andrewpaterson/658-Computer/Pictures/HCP65 Tester.jpg

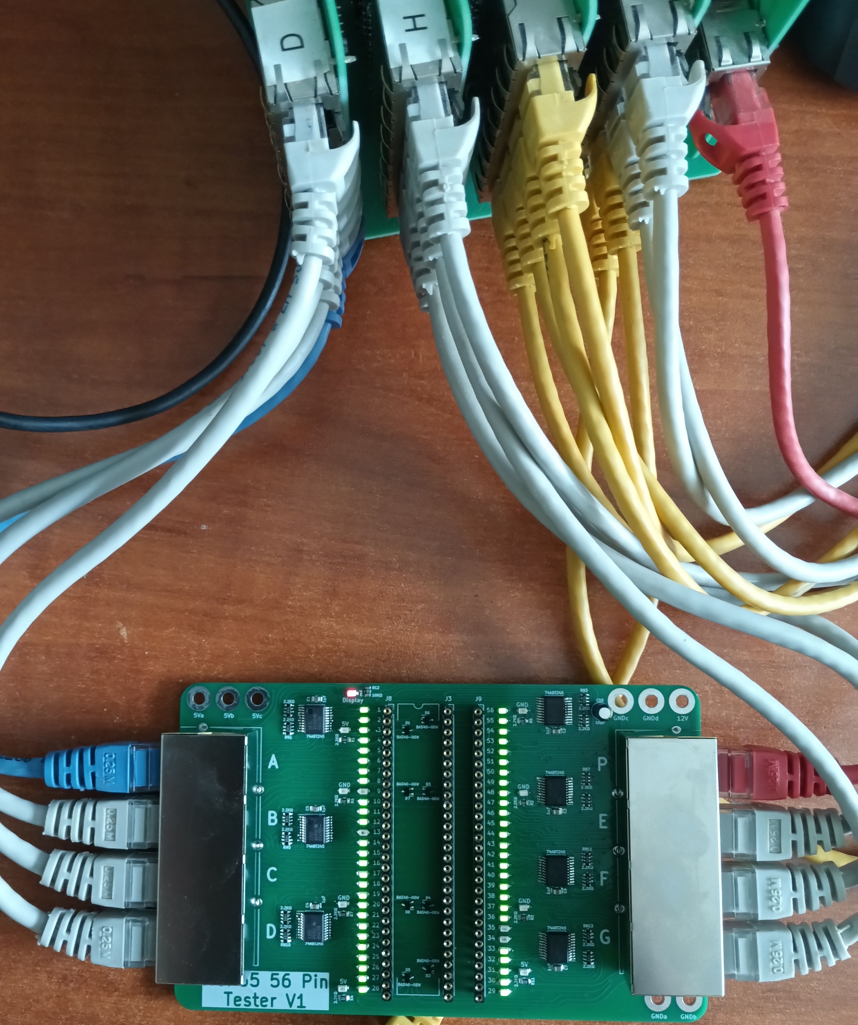
Pictures/HCP65 Tester.jpg
