andrewpaterson/658-Computer/Pictures/Debug Display/Instruction Debug.png

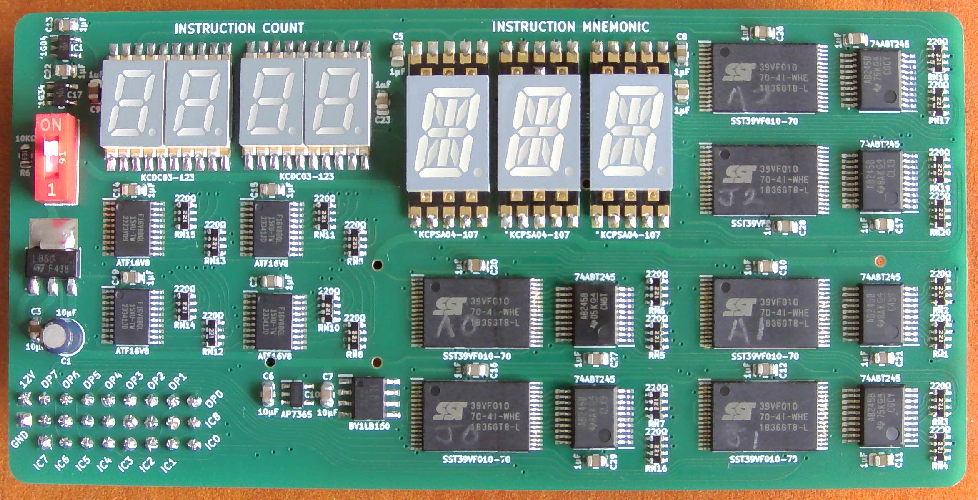
Pictures/Debug Display/Instruction Debug.png
