andrewpaterson/658-Computer/Kicad/Keypad/Keypad Din Pins.txt

brown  - GND
yellow - PL
red    - D0
blue   - CK
white  - VDD

   5V * 3     1 * PL
    white      yellow
     Q * 5 2 4 * CP
      red  *  blue
         GND
         brown
