andrewpaterson/658-Computer/Documents/HCP65/Mainboard Small.png

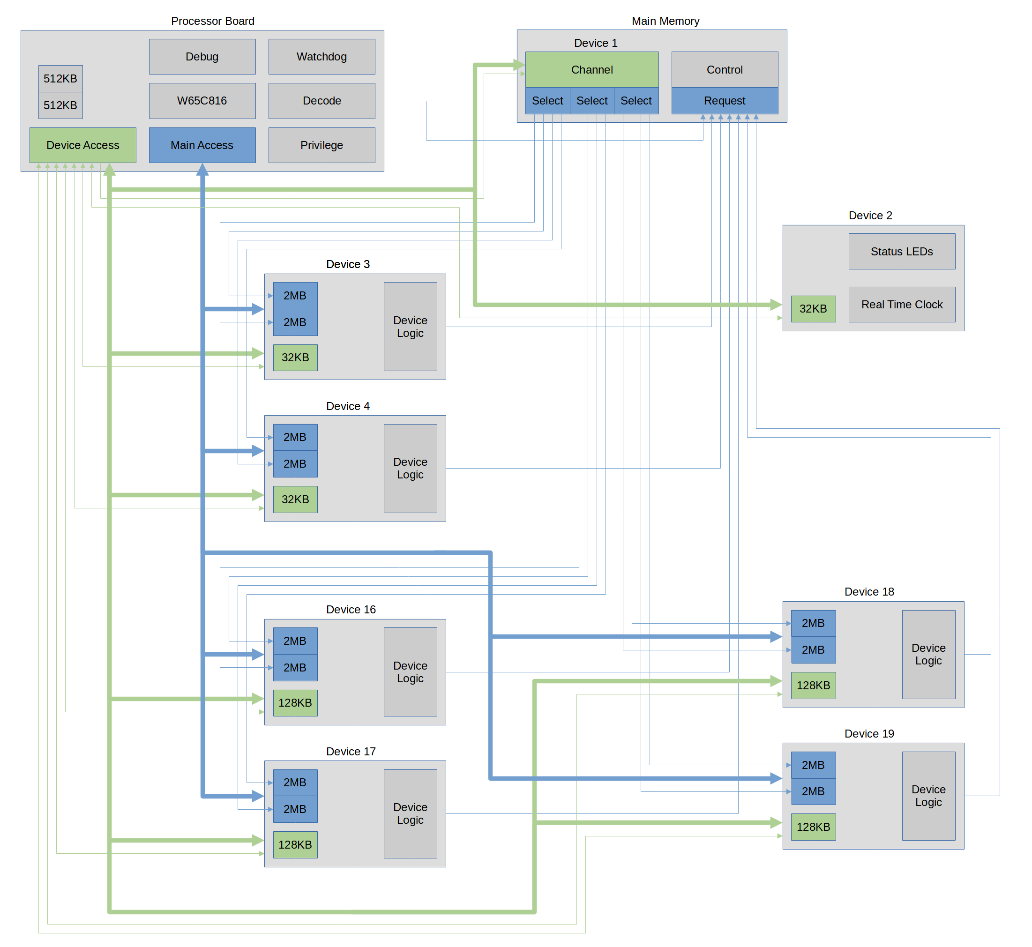
Documents/HCP65/Mainboard Small.png
