andrewpaterson/658-Computer/Documents/NAND ABT.png

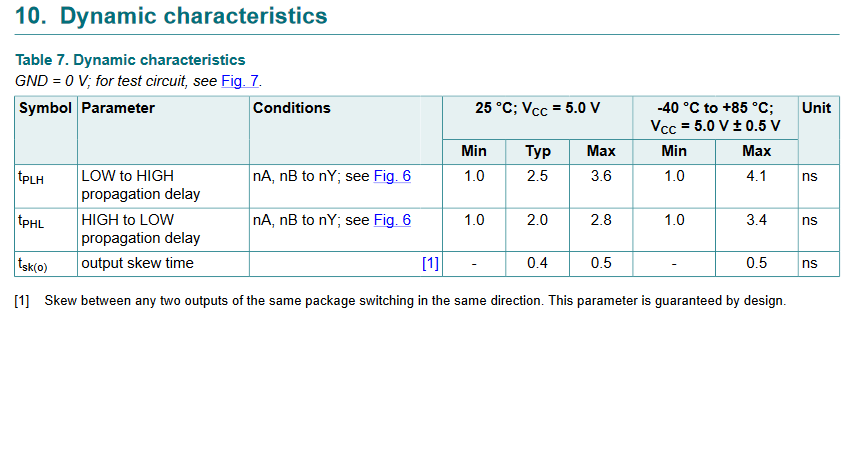
Documents/NAND ABT.png
