andrewpaterson/658-Computer/Documents/NAND AC.png

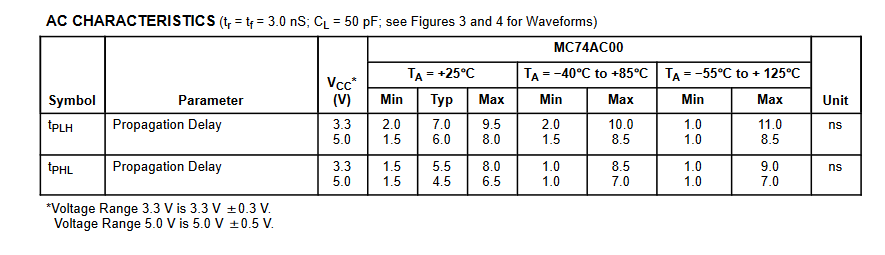
Documents/NAND AC.png
