andrewpaterson/658-Computer/Documents/NAND ACT.png

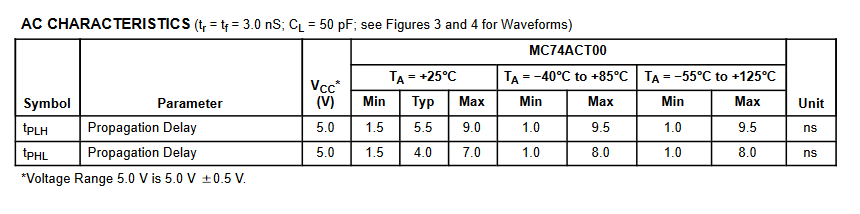
Documents/NAND ACT.png
