andrewpaterson/658-Computer/Documents/NAND AHC and AHCT.png

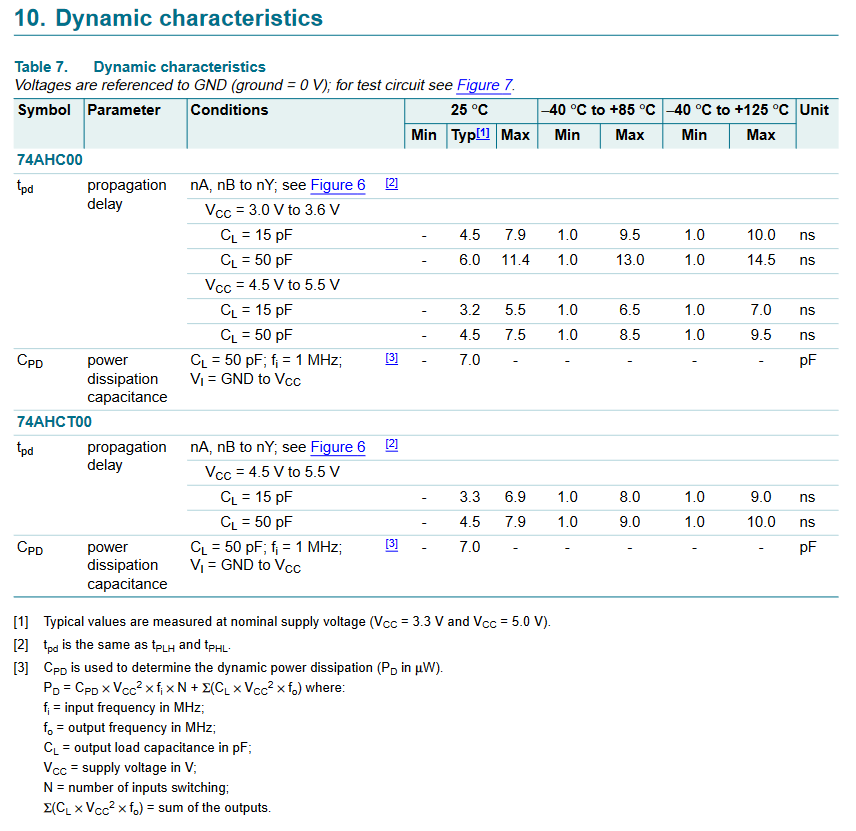
Documents/NAND AHC and AHCT.png
