andrewpaterson/658-Computer/Documents/NAND ALVC.png

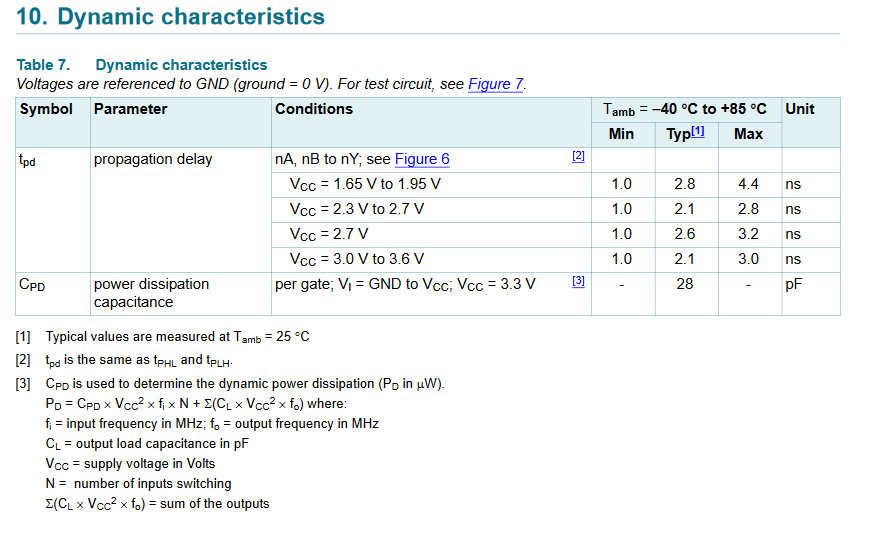
Documents/NAND ALVC.png
