andrewpaterson/658-Computer/Documents/NAND F.png

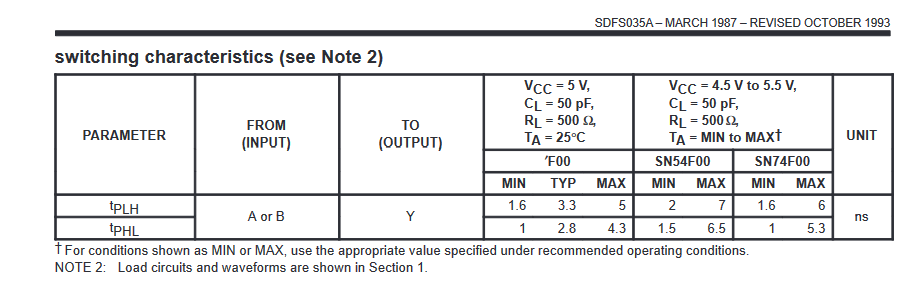
Documents/NAND F.png
