andrewpaterson/658-Computer/Documents/NAND HC and HCT.png

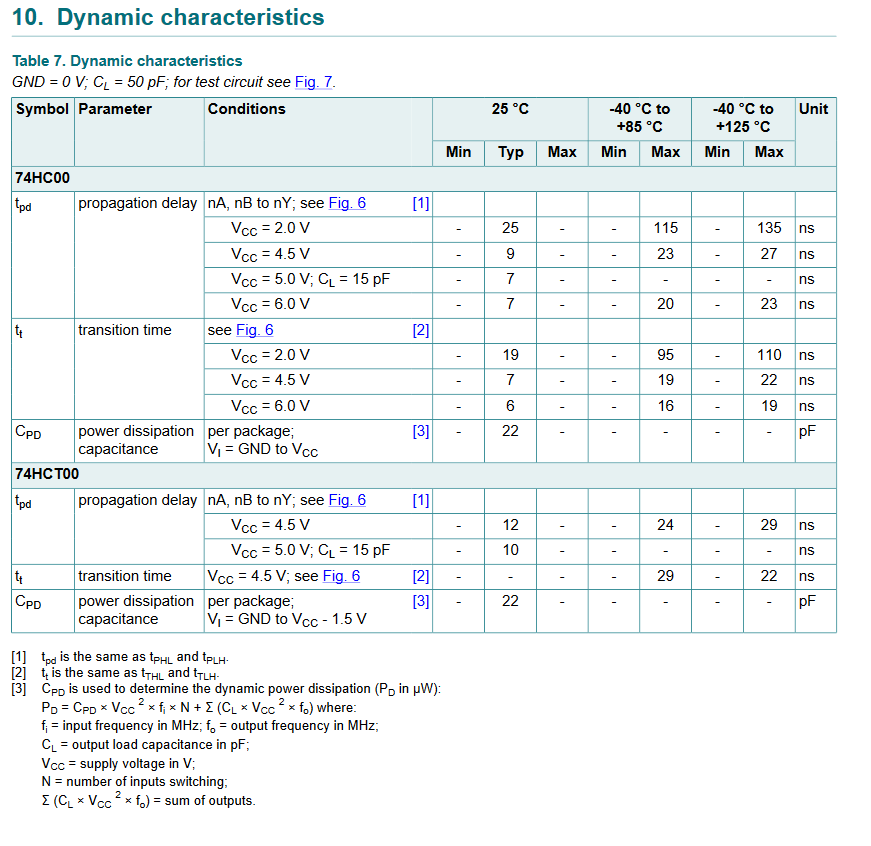
Documents/NAND HC and HCT.png
