andrewpaterson/658-Computer/Documents/NAND LCX.png

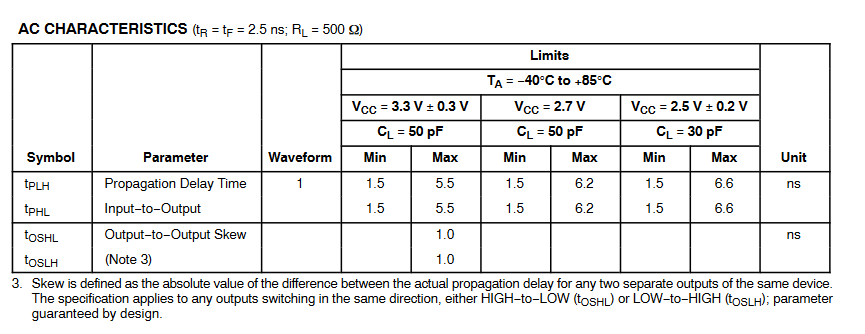
Documents/NAND LCX.png
