andrewpaterson/658-Computer/Documents/NAND LV.png

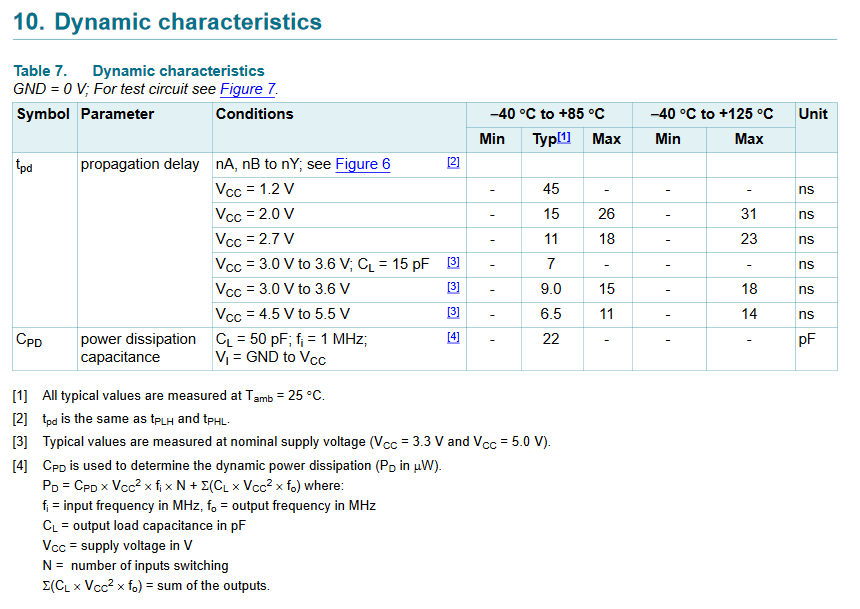
Documents/NAND LV.png
