andrewpaterson/658-Computer/Documents/NAND LVC.png

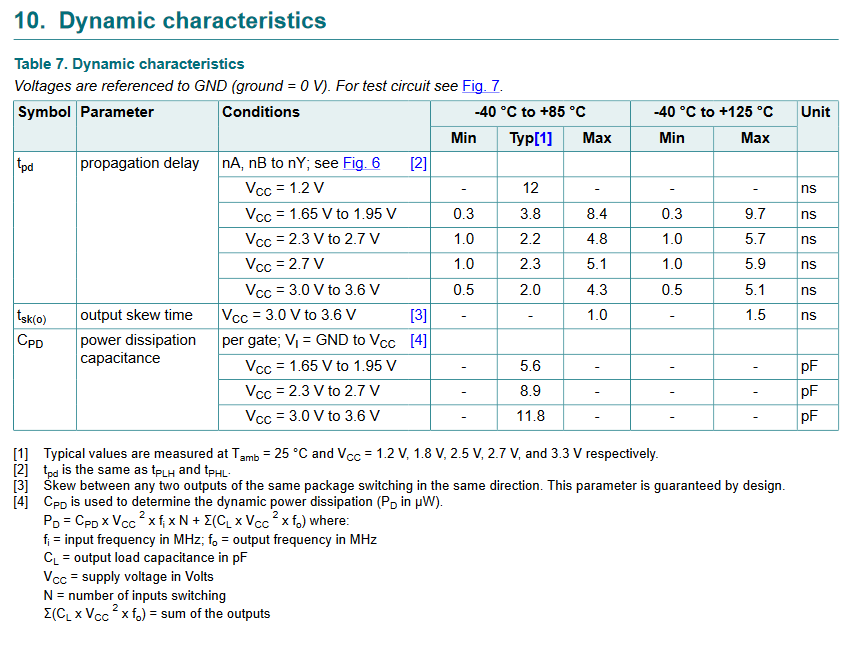
Documents/NAND LVC.png
