andrewpaterson/658-Computer/Documents/NAND VHC.png

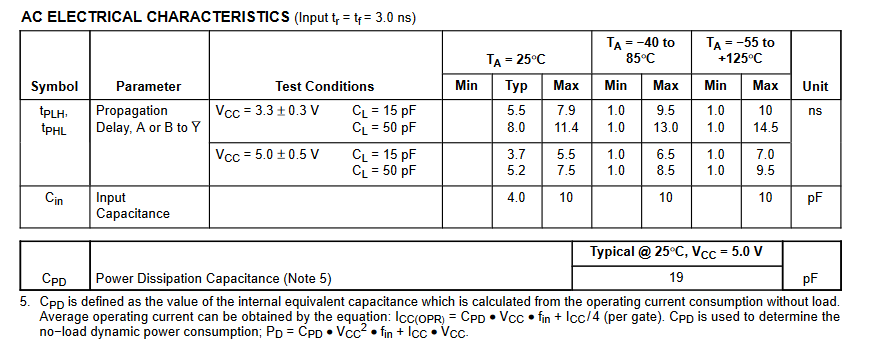
Documents/NAND VHC.png
