andrewpaterson/658-Computer/Documents/NAND VHCT.png

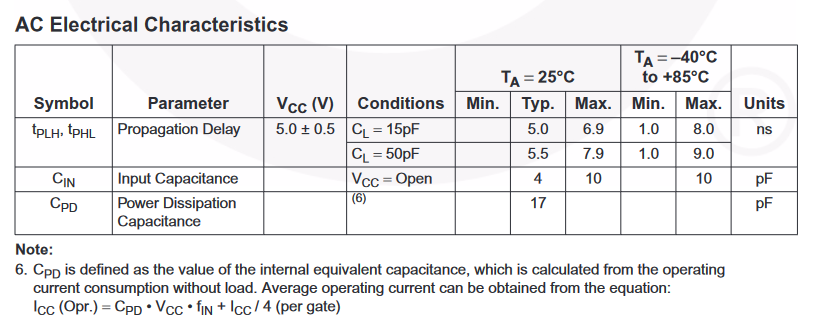
Documents/NAND VHCT.png
