andrewpaterson/658-Computer/Kicad/Computer/Main/Mainboard Small/Mainboard Small - Populated.png

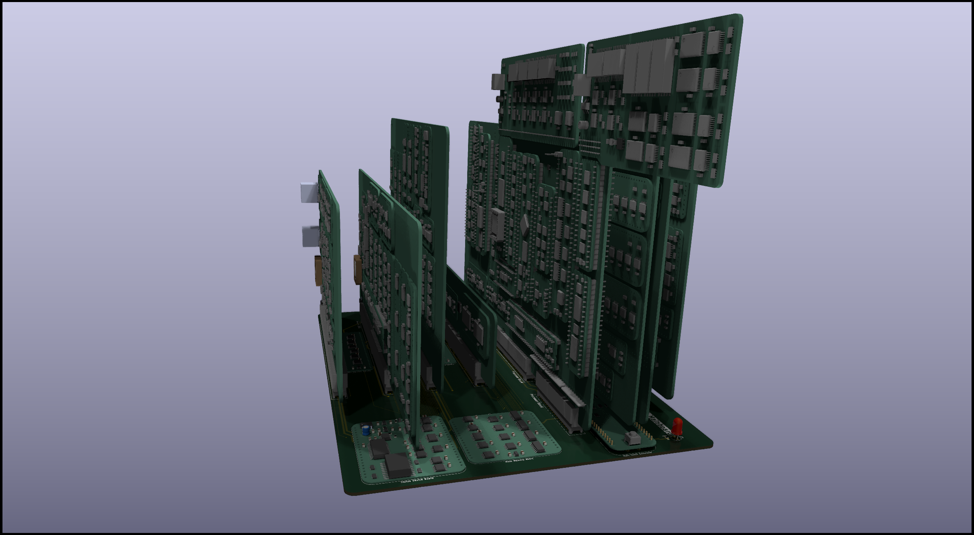
Kicad/Computer/Main/Mainboard Small/Mainboard Small - Populated.png
