andrewpaterson/658-Computer/Pictures/3 Input Or Gare - Source 3V.png

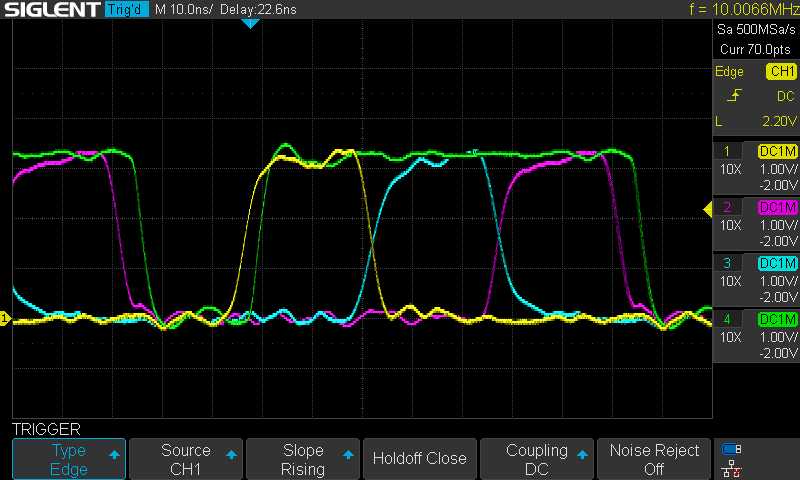
Pictures/3 Input Or Gare - Source 3V.png
