andrewpaterson/658-Computer/Pictures/3 Input Or Gare - Source 5V.png

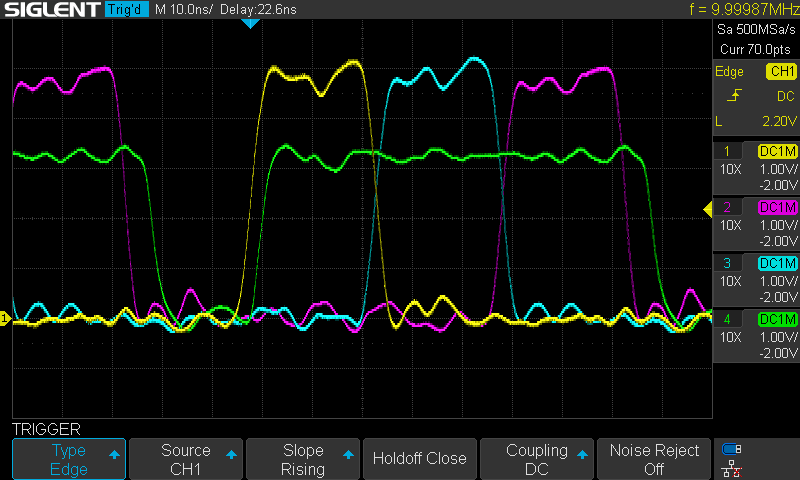
Pictures/3 Input Or Gare - Source 5V.png
