andrewpaterson/658-Computer/Pictures/7 Segment Reader.png

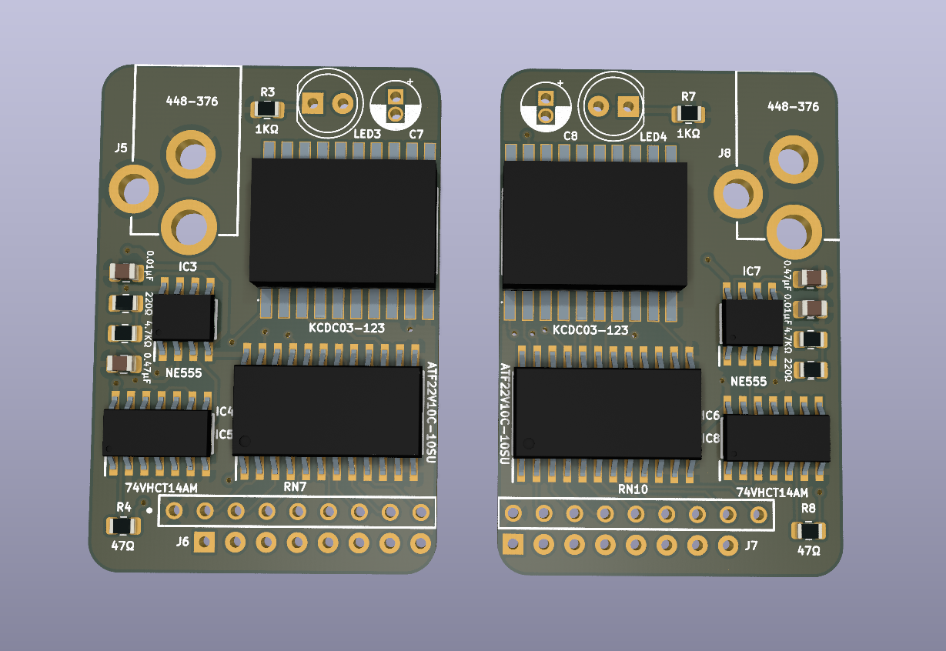
Pictures/7 Segment Reader.png
