andrewpaterson/658-Computer/Pictures/300Hz No Schmitt.png

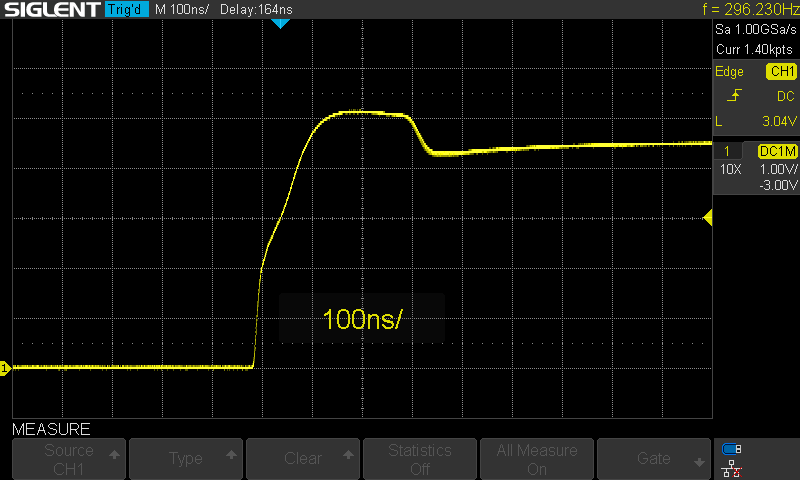
Pictures/300Hz No Schmitt.png
