andrewpaterson/658-Computer/Pictures/300Hz with Schmitt.png

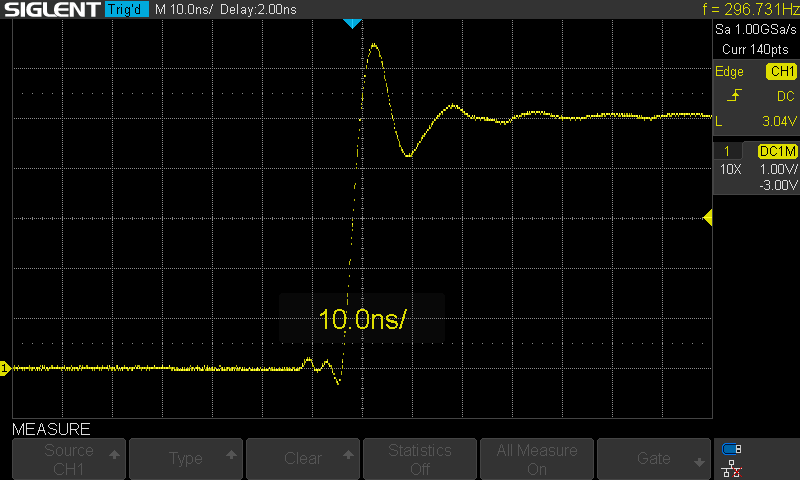
Pictures/300Hz with Schmitt.png
