andrewpaterson/658-Computer/Pictures/300Hz.png

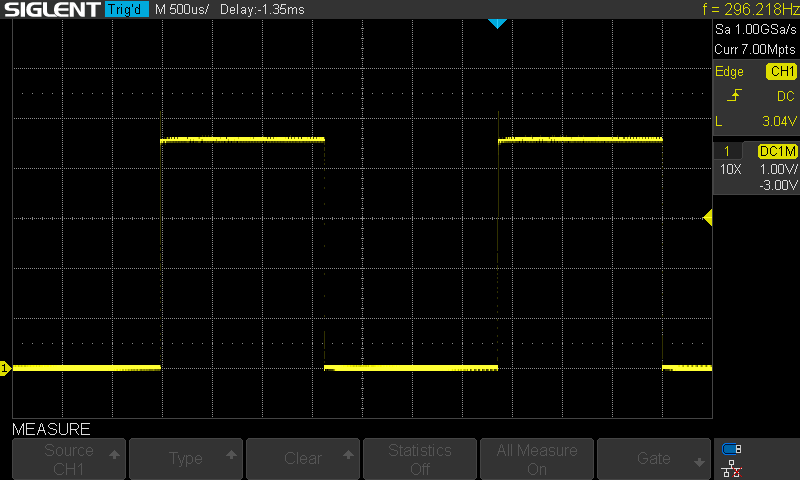
Pictures/300Hz.png
