andrewpaterson/658-Computer/Pictures/400x300 Ref2.png

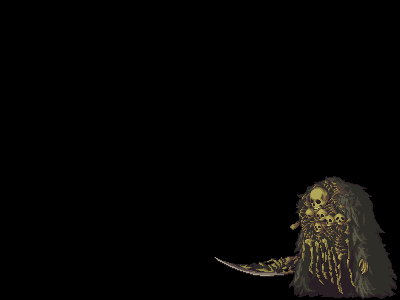
Pictures/400x300 Ref2.png
