andrewpaterson/658-Computer/Pictures/400x300 Ref3.png

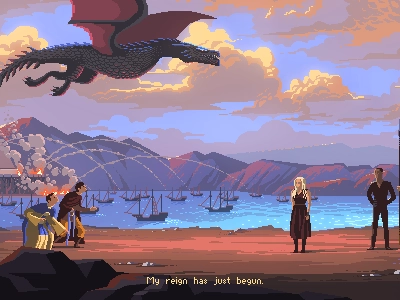
Pictures/400x300 Ref3.png
