andrewpaterson/658-Computer/Pictures/400x300 Ref4.png

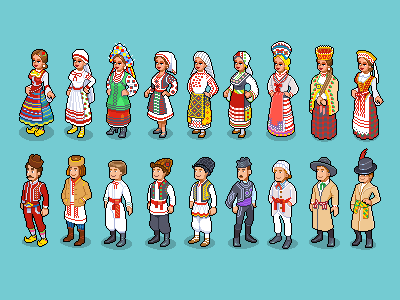
Pictures/400x300 Ref4.png
