andrewpaterson/658-Computer/Pictures/816 Bodge Board V1 - important stuff.png

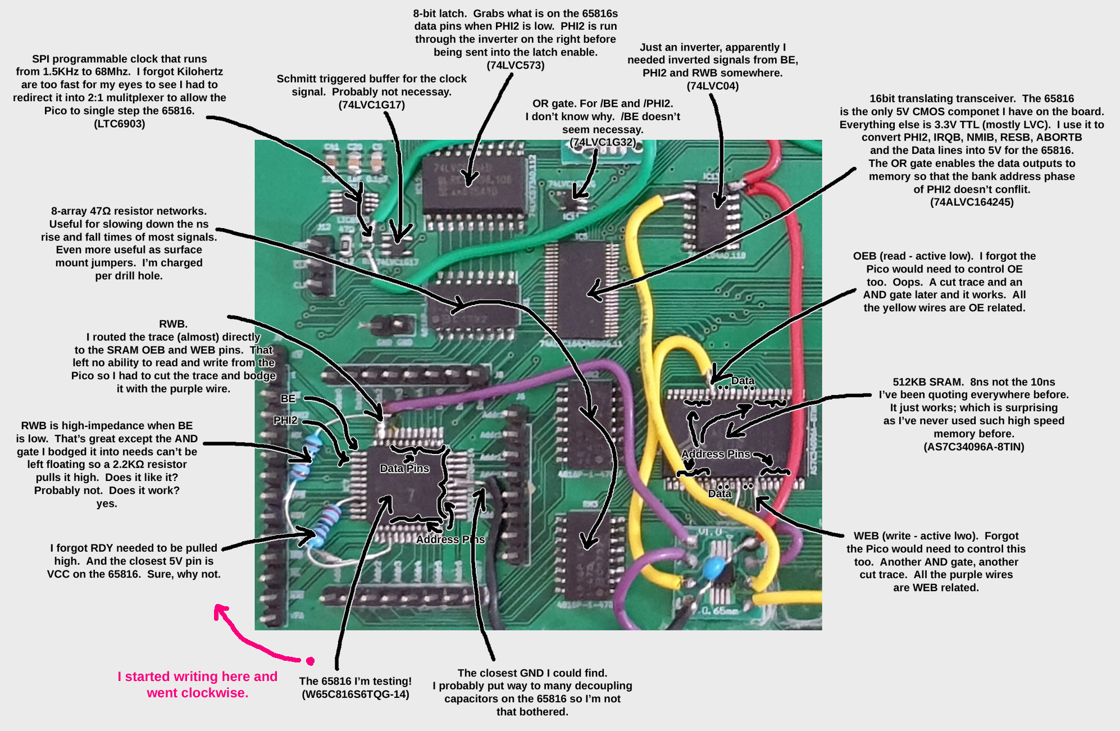
Pictures/816 Bodge Board V1 - important stuff.png
