andrewpaterson/658-Computer/Pictures/816 bodge board V1 running.jpg

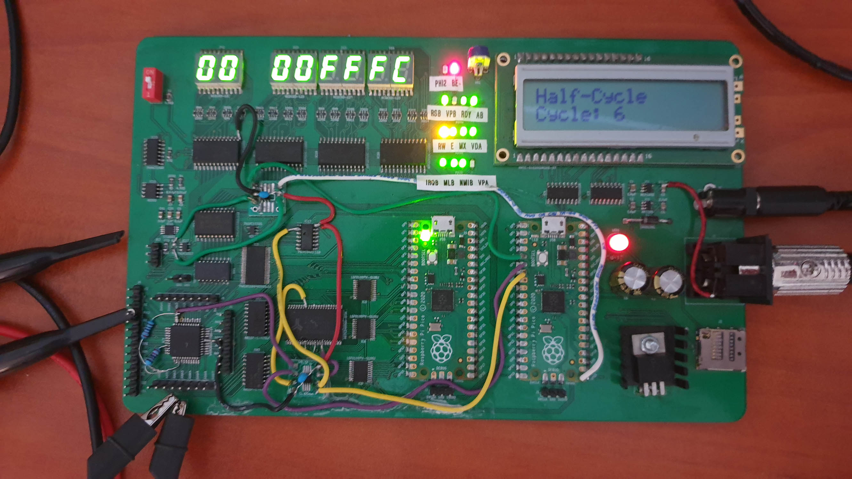
Pictures/816 bodge board V1 running.jpg
