andrewpaterson/658-Computer/Pictures/816 bodge board V1 unpopulated.jpg

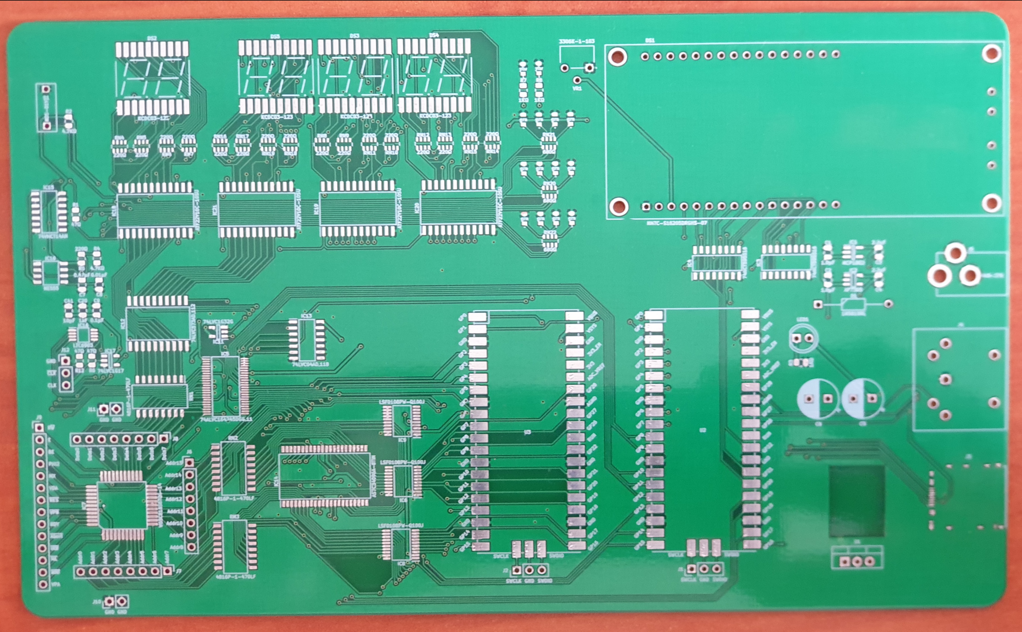
Pictures/816 bodge board V1 unpopulated.jpg
