andrewpaterson/658-Computer/Pictures/20220211_165340.jpg

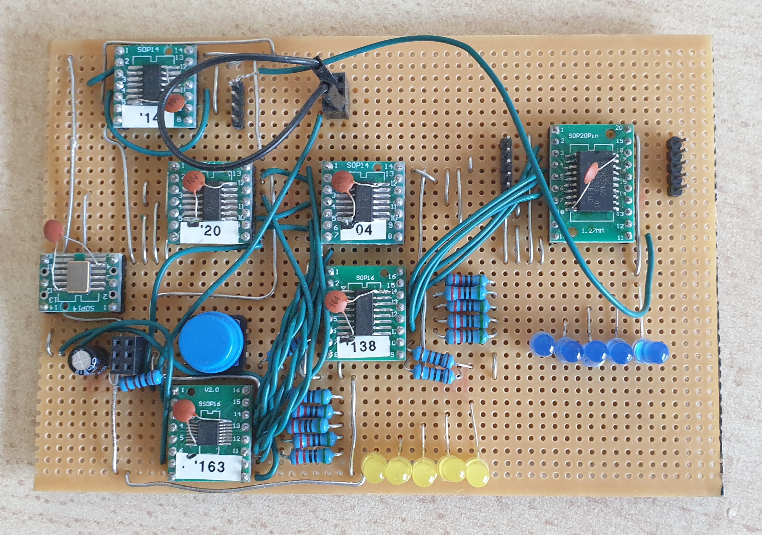
Pictures/20220211_165340.jpg
