andrewpaterson/658-Computer/Pictures/20220607_114405.jpg

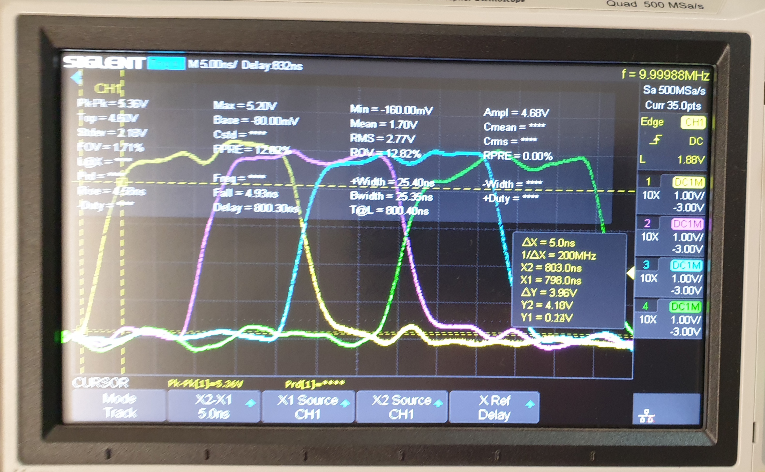
Pictures/20220607_114405.jpg
