andrewpaterson/658-Computer/Pictures/Address Decode.png

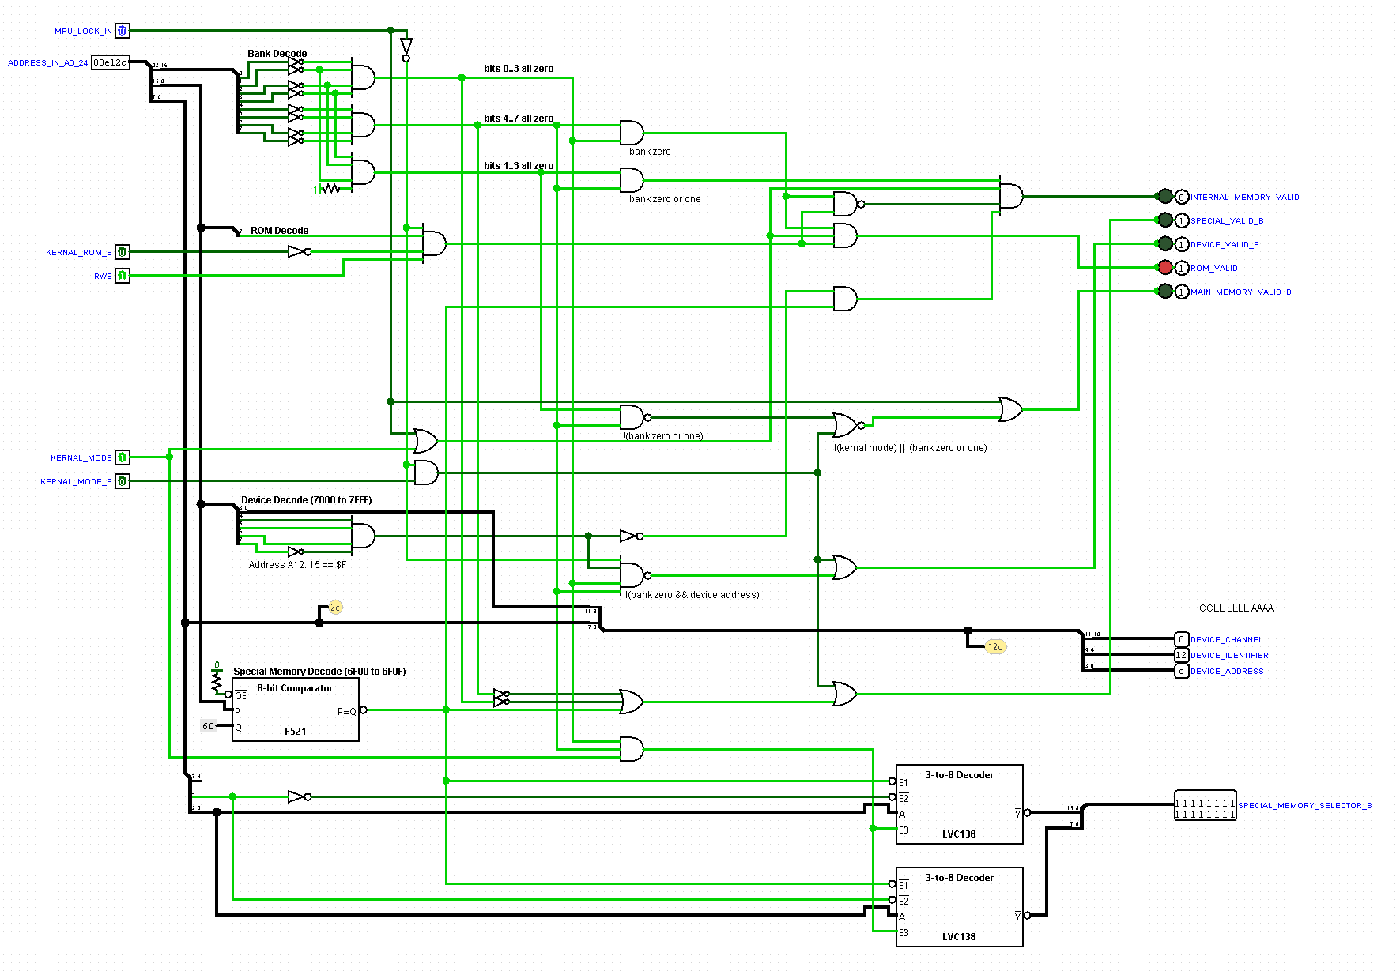
Pictures/Address Decode.png
