andrewpaterson/658-Computer/Pictures/Address Predecode.png

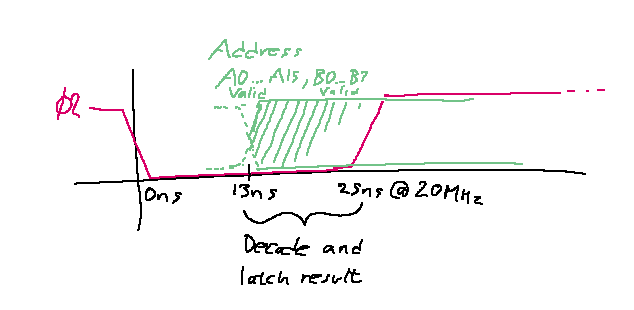
Pictures/Address Predecode.png
