andrewpaterson/658-Computer/Pictures/Apple II/Apple II Rev0 - partially populated.jpg

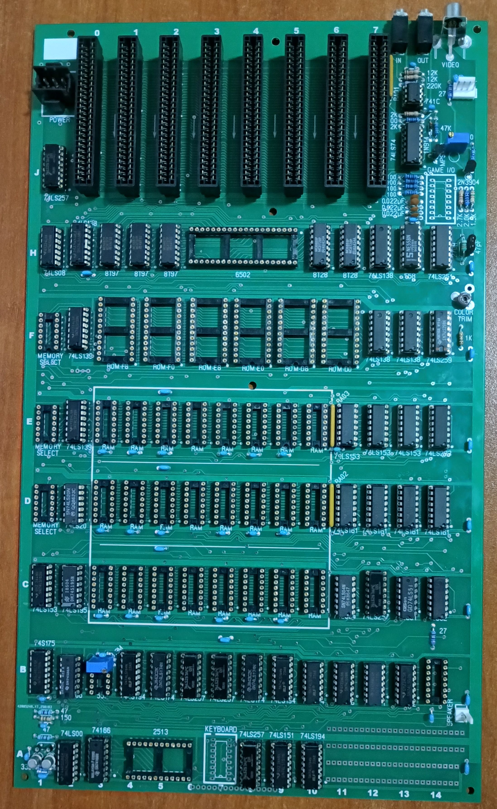
Pictures/Apple II/Apple II Rev0 - partially populated.jpg
