andrewpaterson/658-Computer/Pictures/Audio DAC schematic 2.png

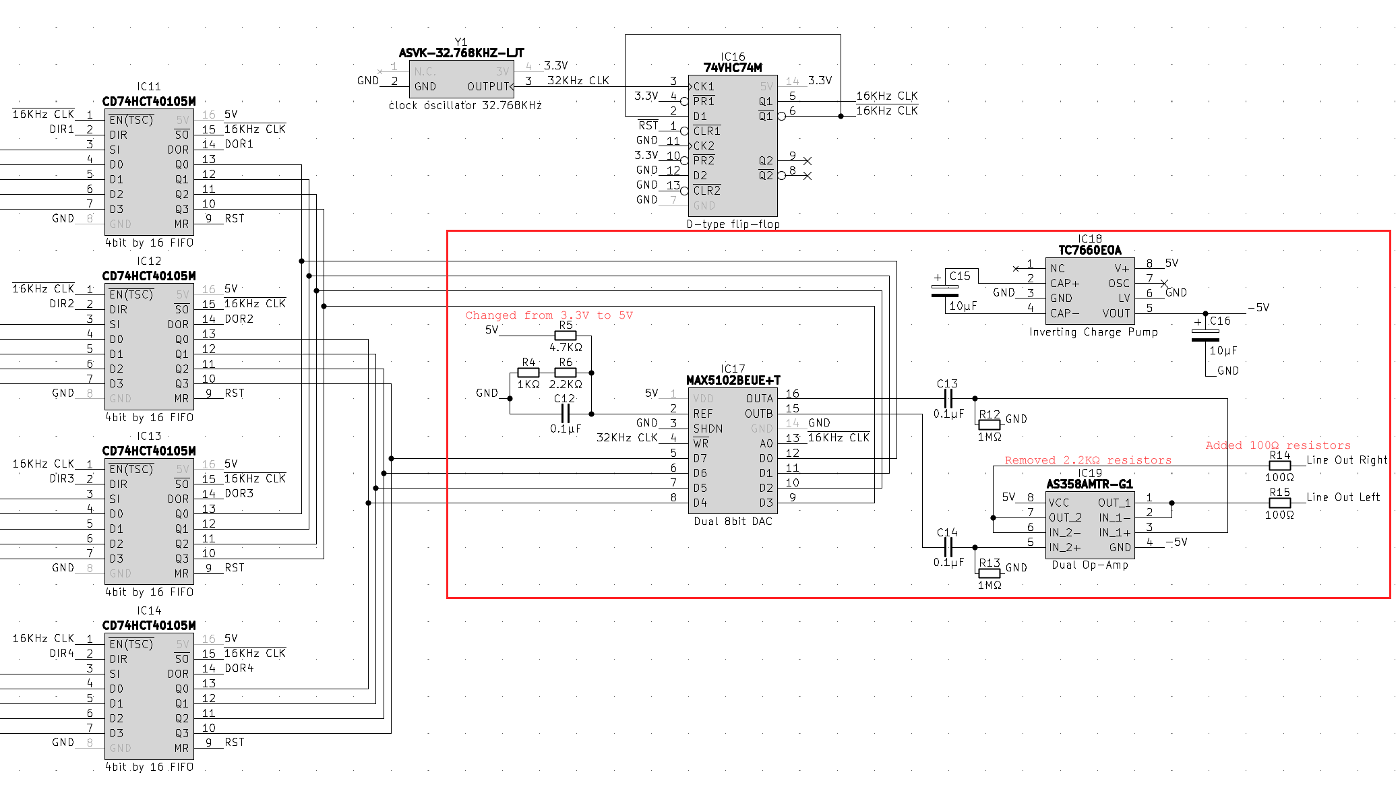
Pictures/Audio DAC schematic 2.png
