andrewpaterson/658-Computer/Pictures/Audio DAC schematic.png

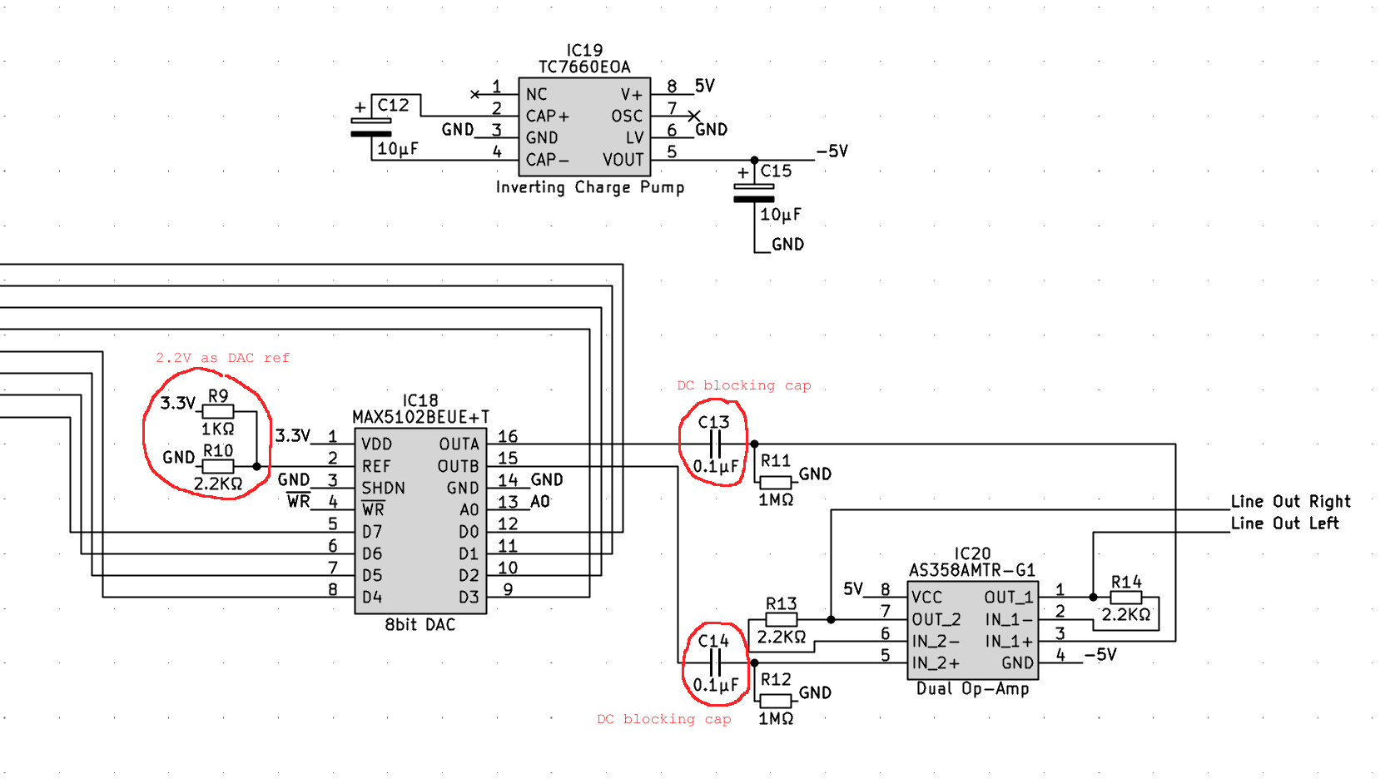
Pictures/Audio DAC schematic.png
