andrewpaterson/658-Computer/Pictures/Audio DAC waveform.jpg

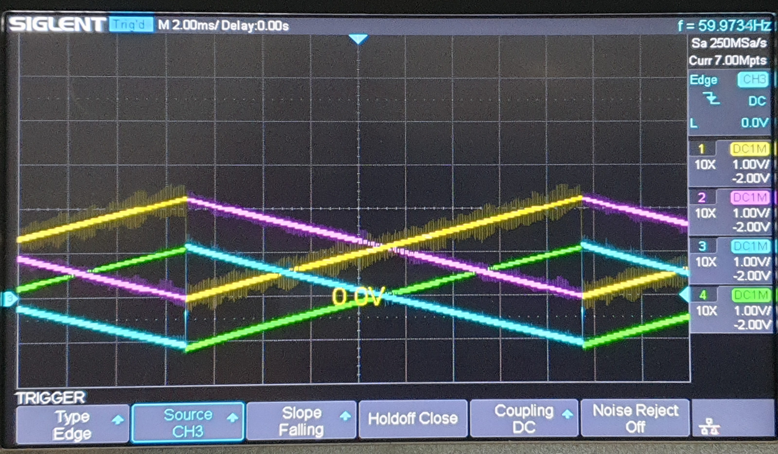
Pictures/Audio DAC waveform.jpg
