andrewpaterson/658-Computer/Pictures/Audo DAC boad.jpg

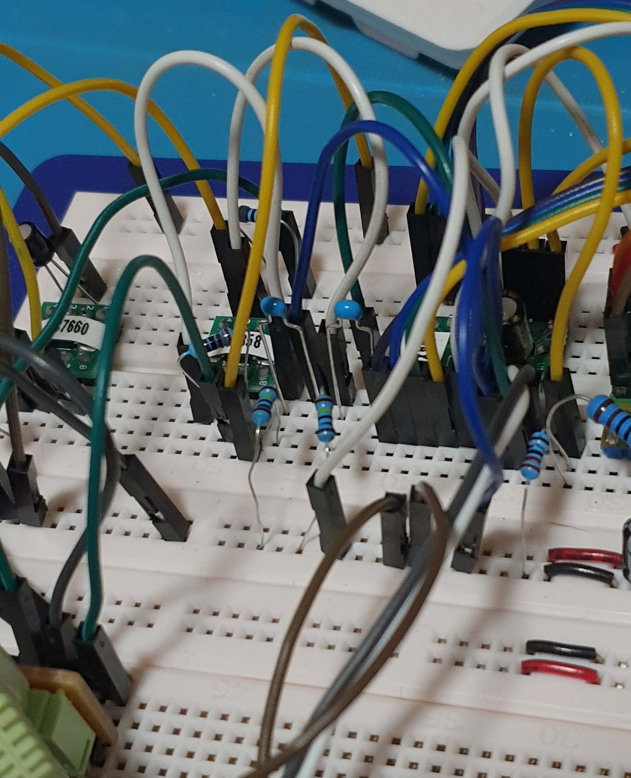
Pictures/Audo DAC boad.jpg
