andrewpaterson/658-Computer/Pictures/Bank is Zero Latch.png

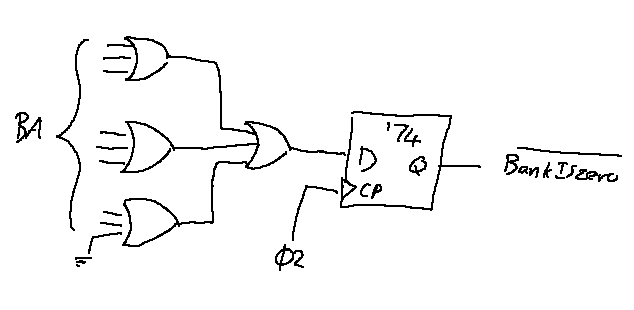
Pictures/Bank is Zero Latch.png
