andrewpaterson/658-Computer/Pictures/Blitter Board.png

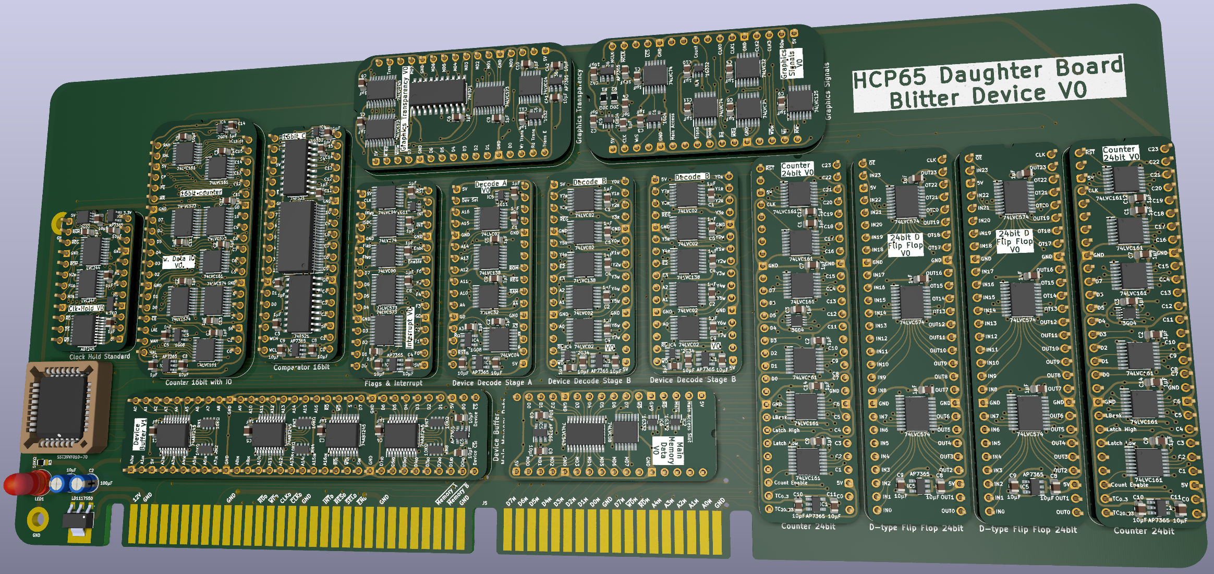
Pictures/Blitter Board.png
