andrewpaterson/658-Computer/Pictures/Block Diagram/Bigger Block Diagram.png

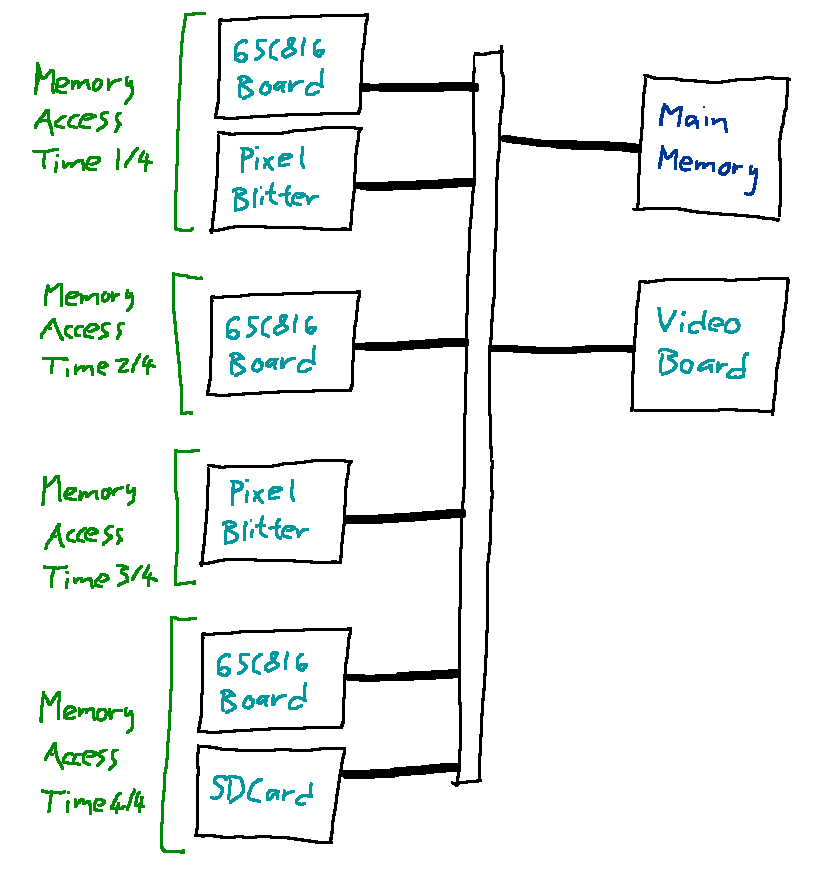
Pictures/Block Diagram/Bigger Block Diagram.png
