andrewpaterson/658-Computer/Pictures/Block Diagram/Sorta Block Diagram.png

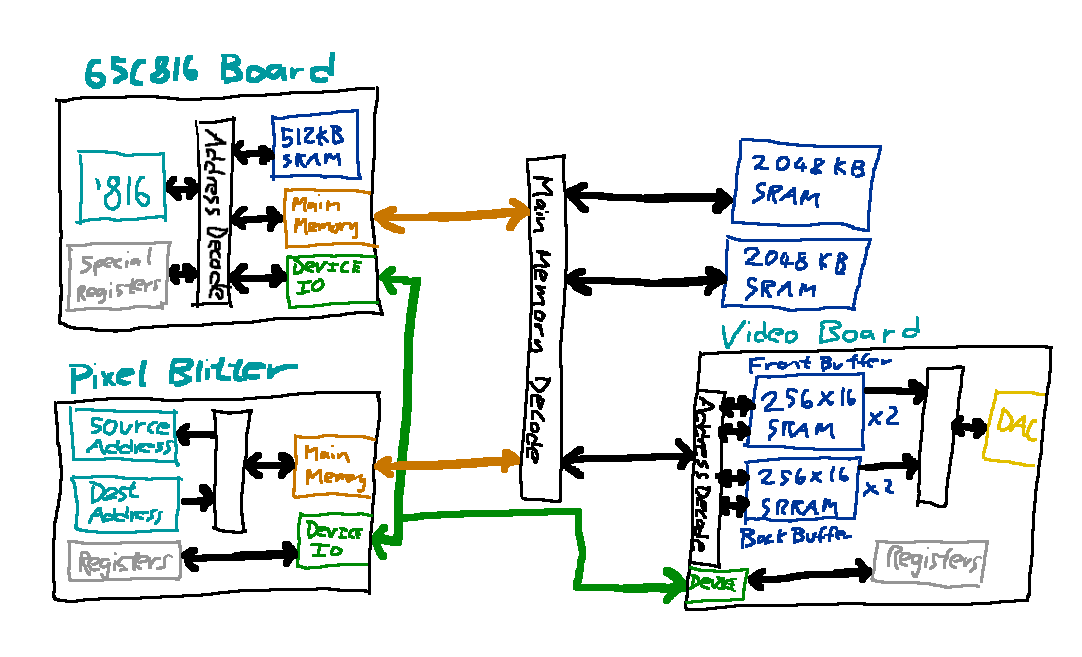
Pictures/Block Diagram/Sorta Block Diagram.png
