andrewpaterson/658-Computer/Pictures/Block Diagram/Timing.png

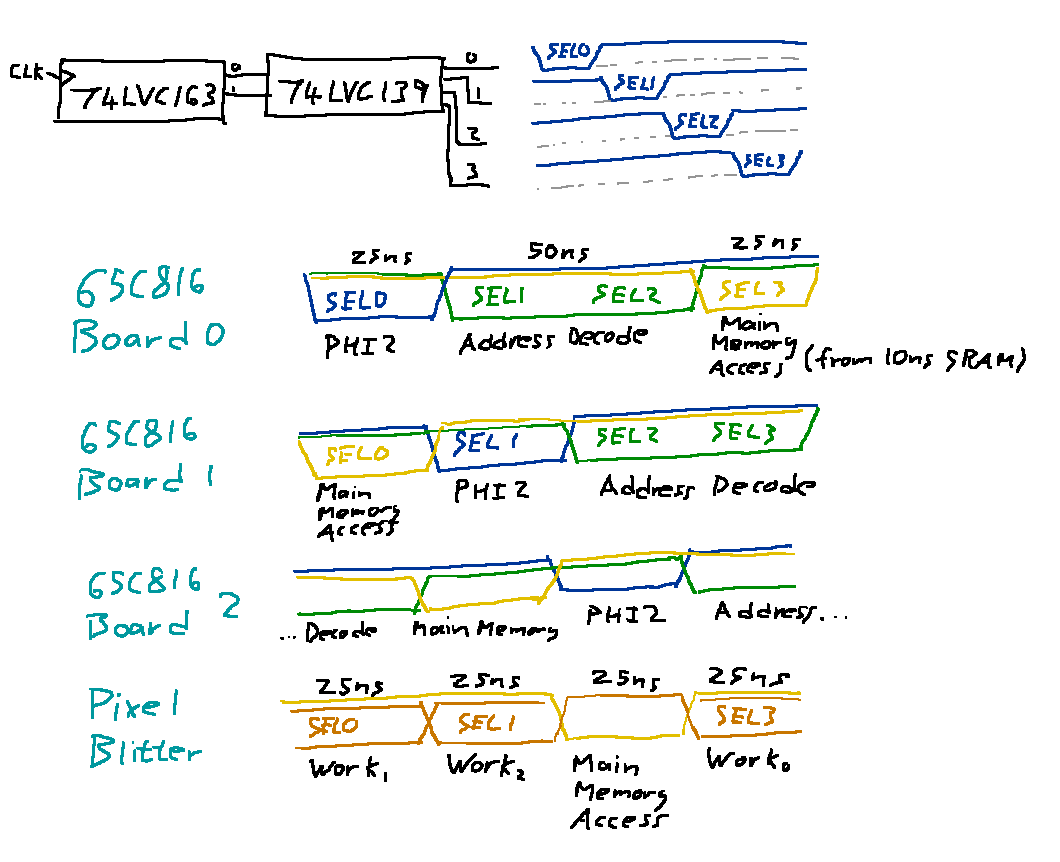
Pictures/Block Diagram/Timing.png
