andrewpaterson/658-Computer/Pictures/Buffered Timer.jpg

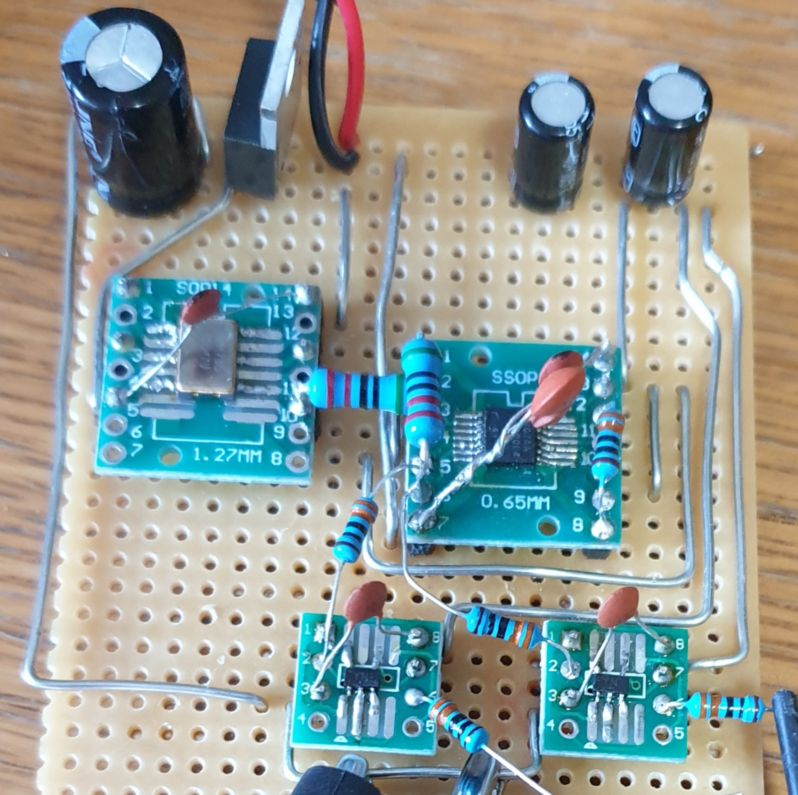
Pictures/Buffered Timer.jpg
