andrewpaterson/658-Computer/Pictures/Calling Conventiion/Function Call.png

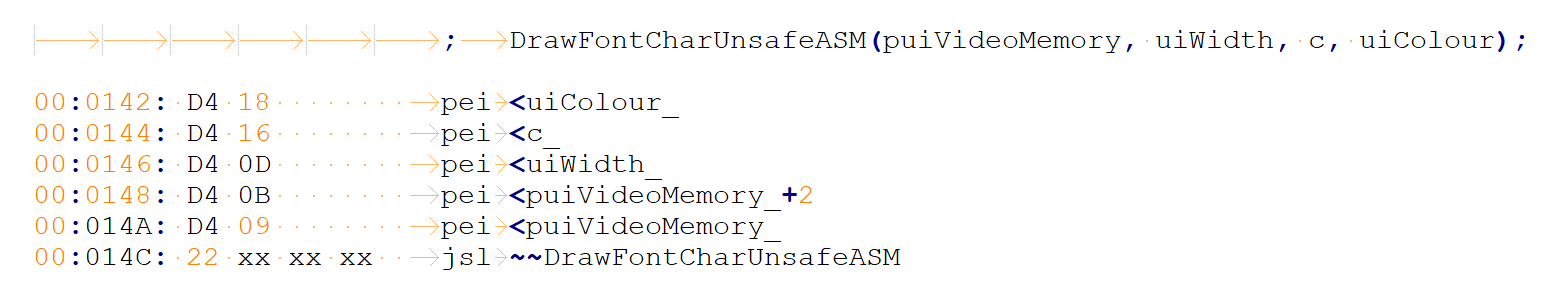
Pictures/Calling Conventiion/Function Call.png
