andrewpaterson/658-Computer/Pictures/Calling Conventiion/Function Cleanup.png

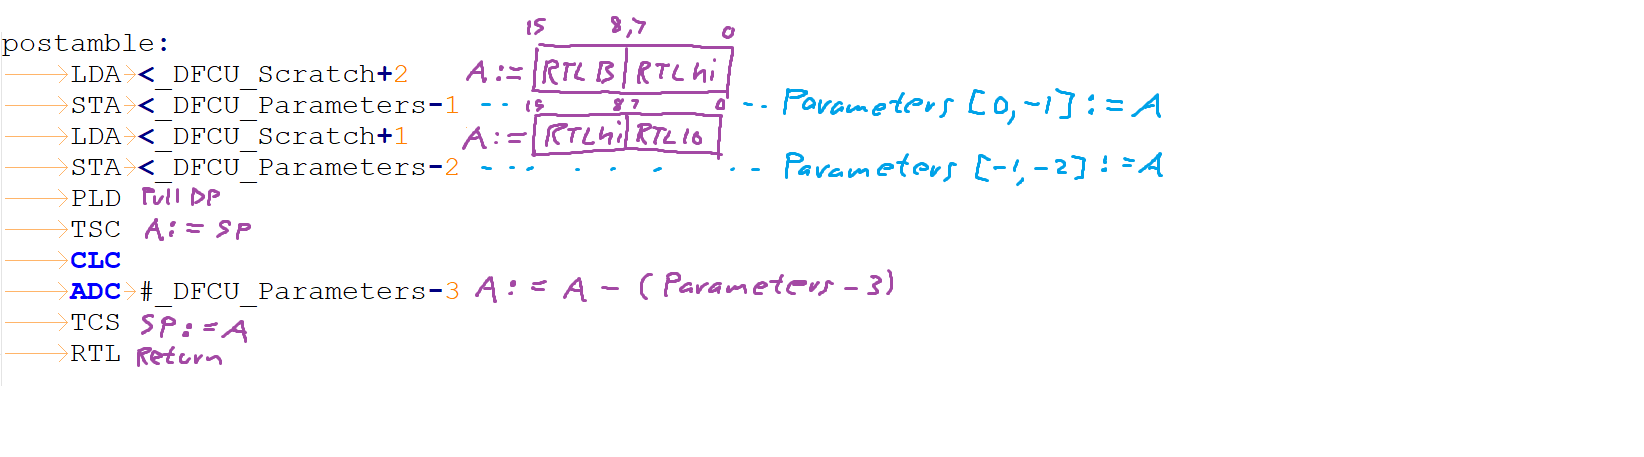
Pictures/Calling Conventiion/Function Cleanup.png
