andrewpaterson/658-Computer/Pictures/Calling Conventiion/Function Definition.png

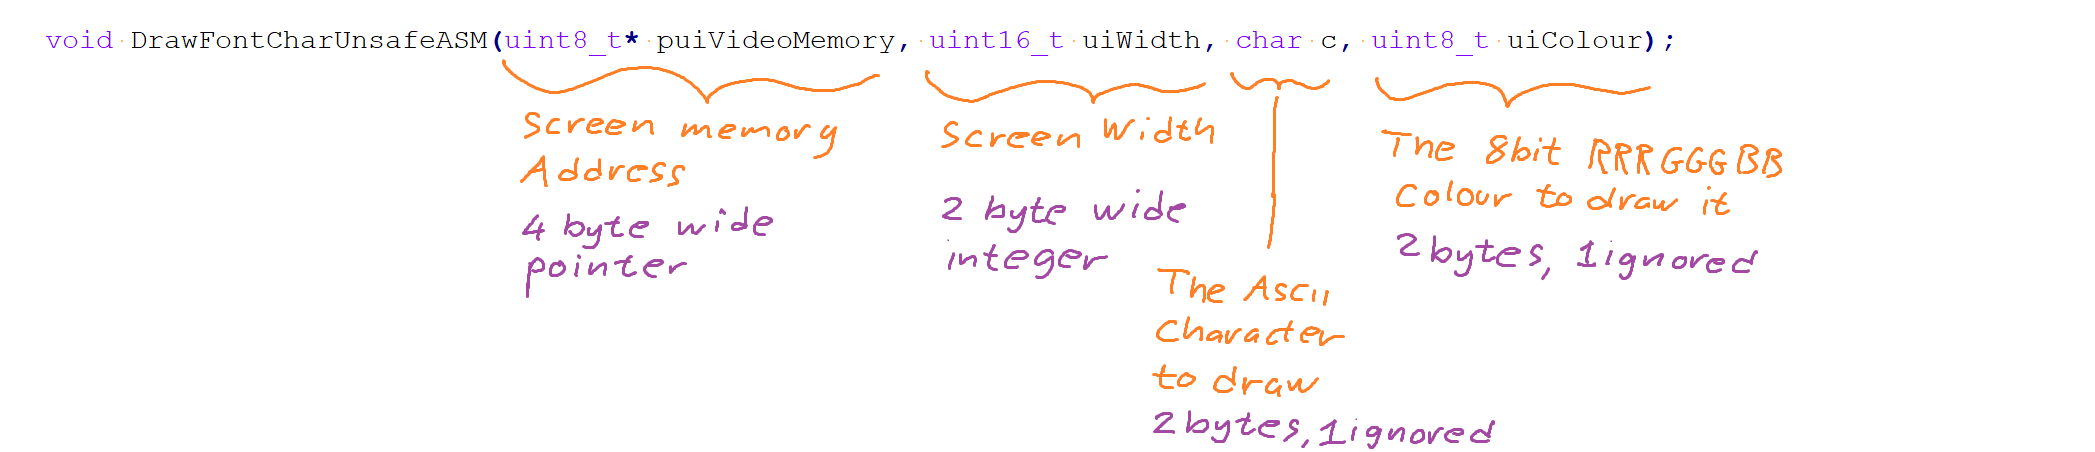
Pictures/Calling Conventiion/Function Definition.png
