andrewpaterson/658-Computer/Pictures/Calling Conventiion/Function Stack After Cleanup.png

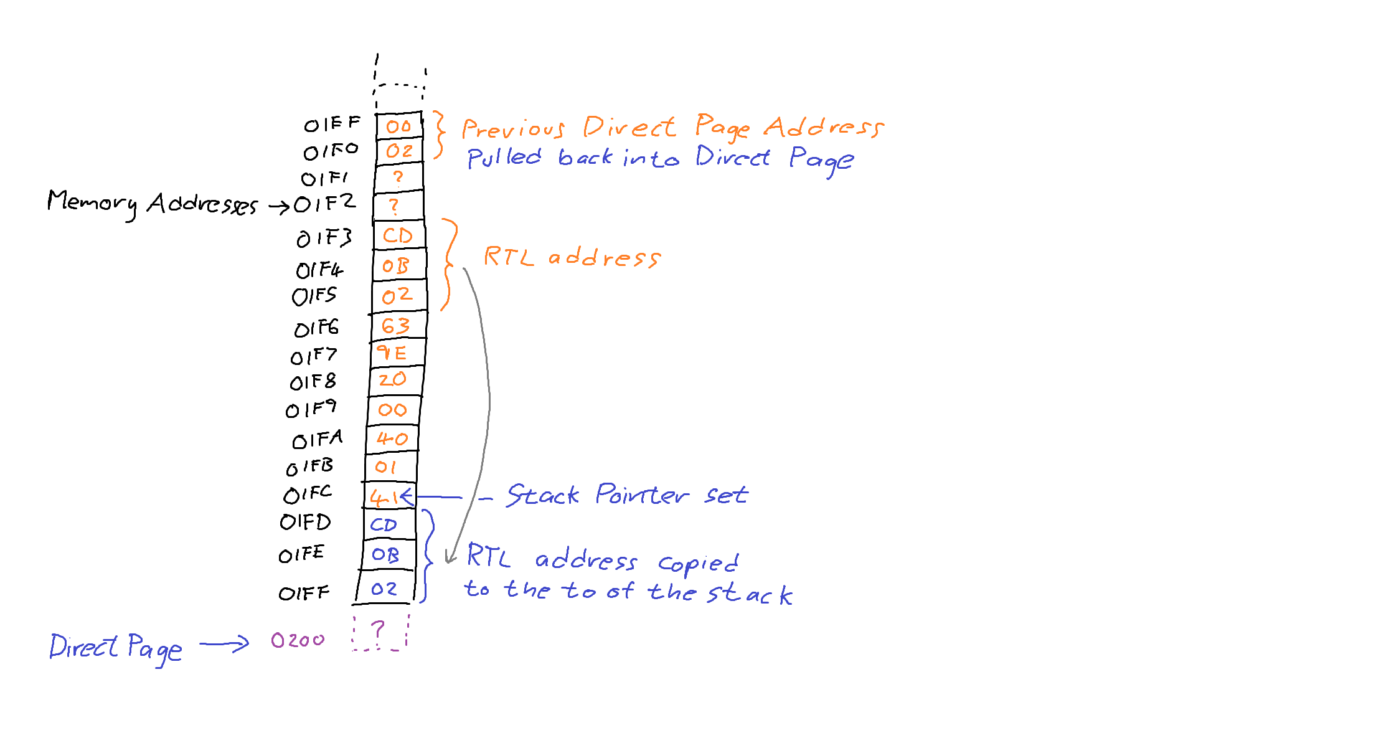
Pictures/Calling Conventiion/Function Stack After Cleanup.png
