andrewpaterson/658-Computer/Pictures/Clock Hold.png

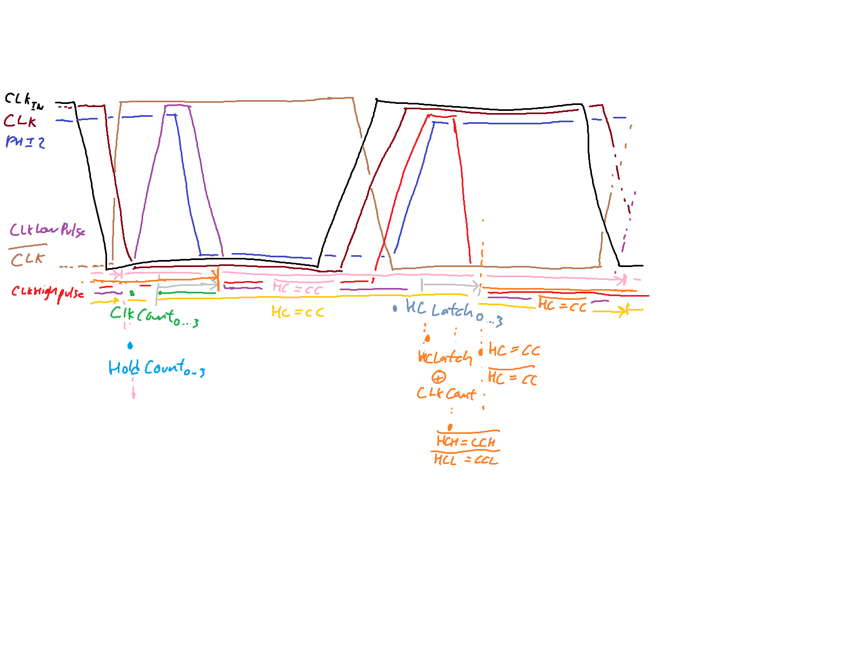
Pictures/Clock Hold.png
