andrewpaterson/658-Computer/Pictures/Coprocessor/Coprocessor Board - Additional.png

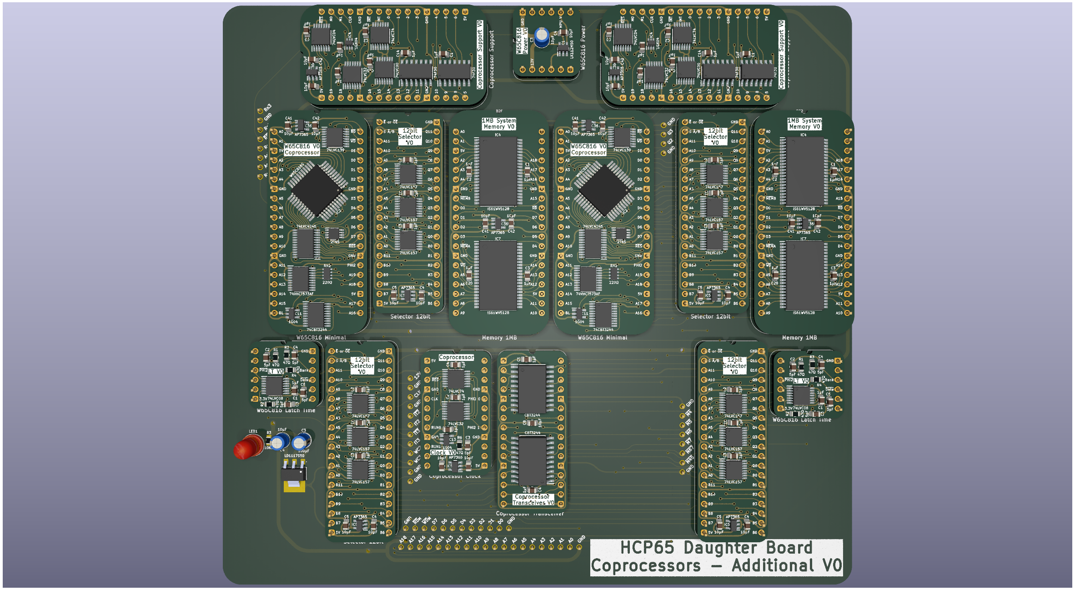
Pictures/Coprocessor/Coprocessor Board - Additional.png
