andrewpaterson/658-Computer/Pictures/EPM570 Programmer PCB.png

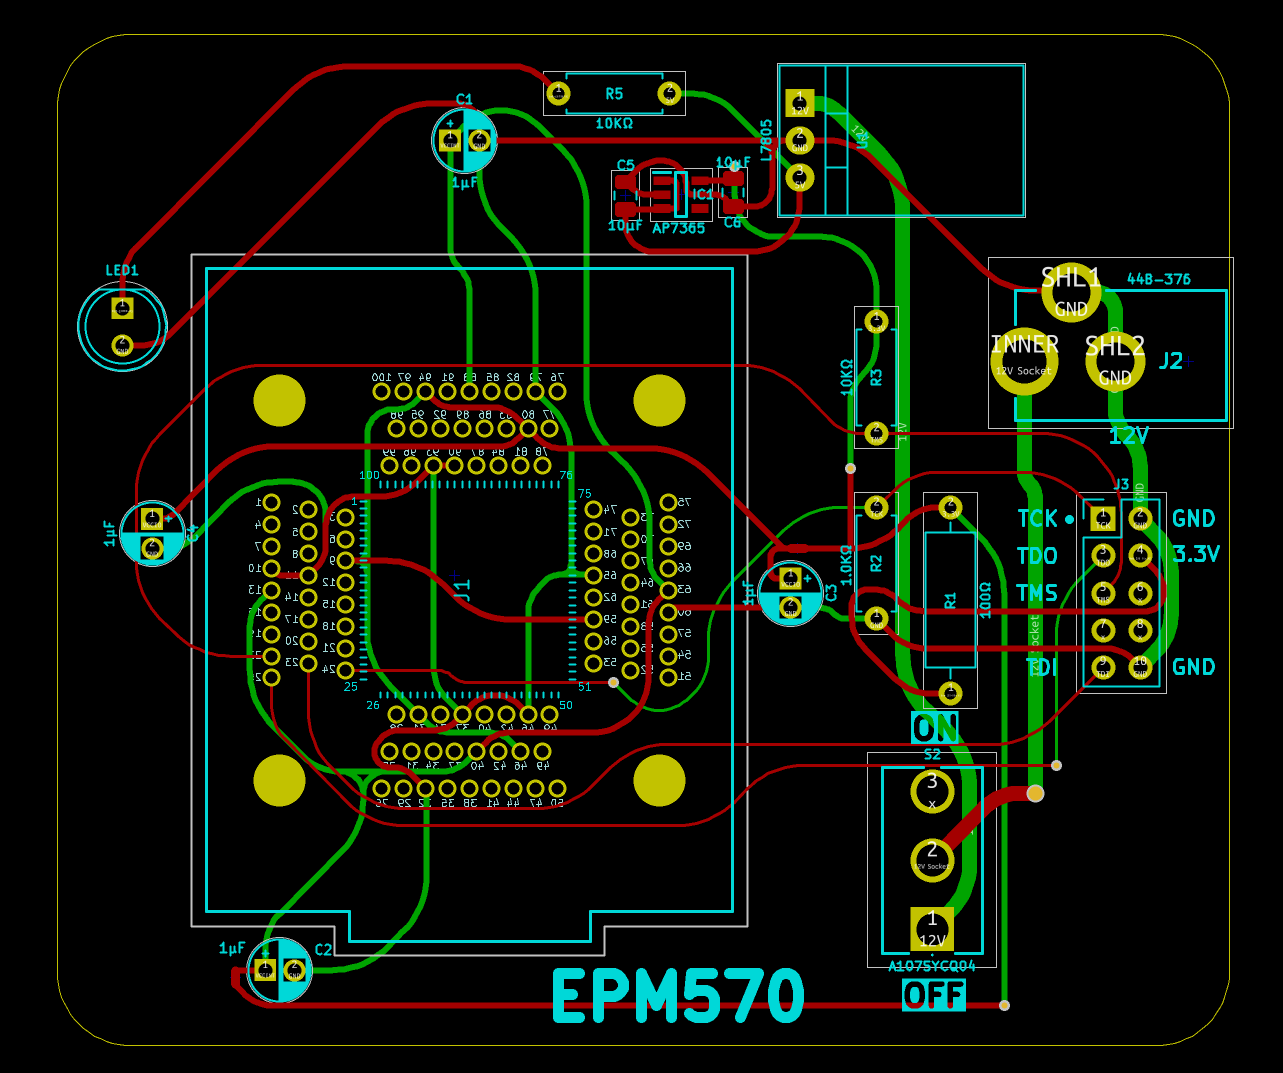
Pictures/EPM570 Programmer PCB.png
