andrewpaterson/658-Computer/Pictures/EPM570 Programmer Schematic.png

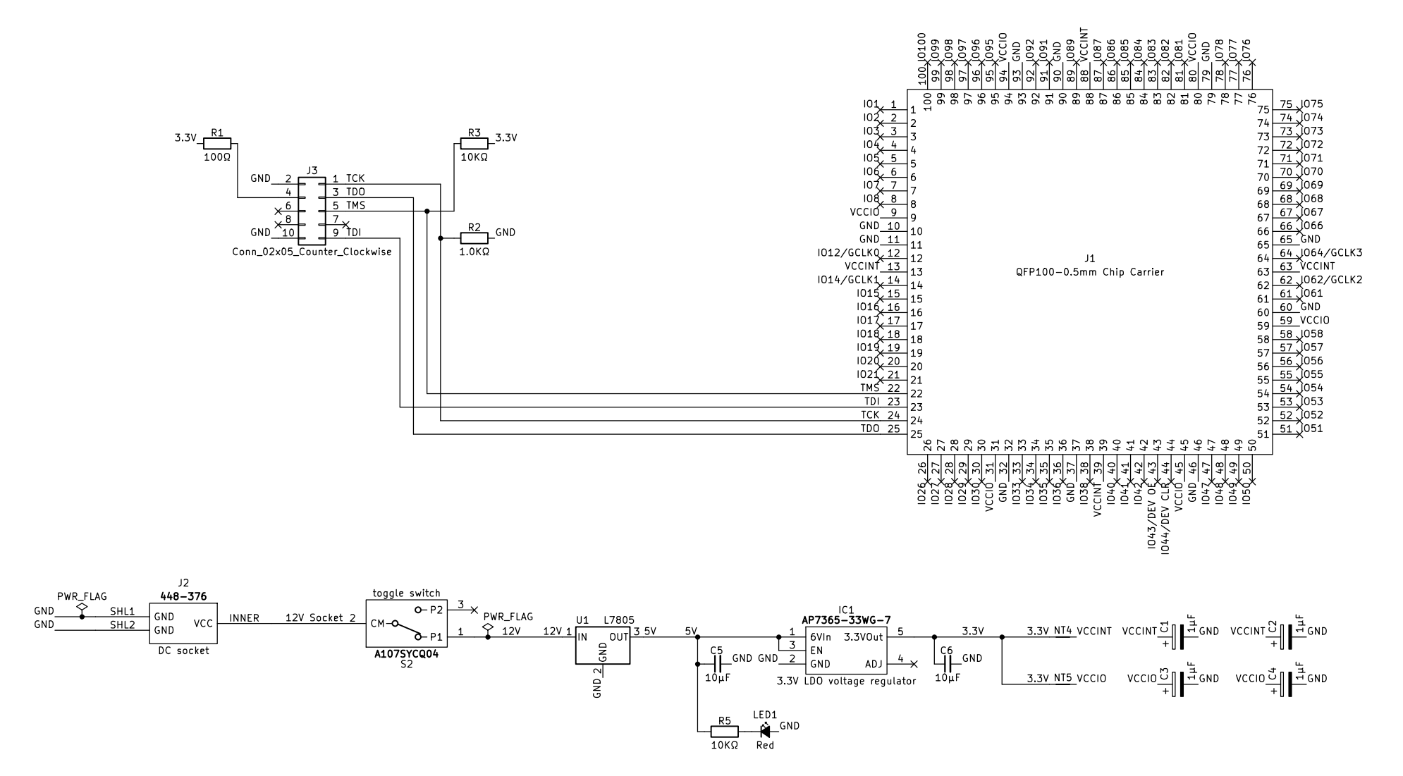
Pictures/EPM570 Programmer Schematic.png
