andrewpaterson/658-Computer/Pictures/EPM570 Programmer.jpg

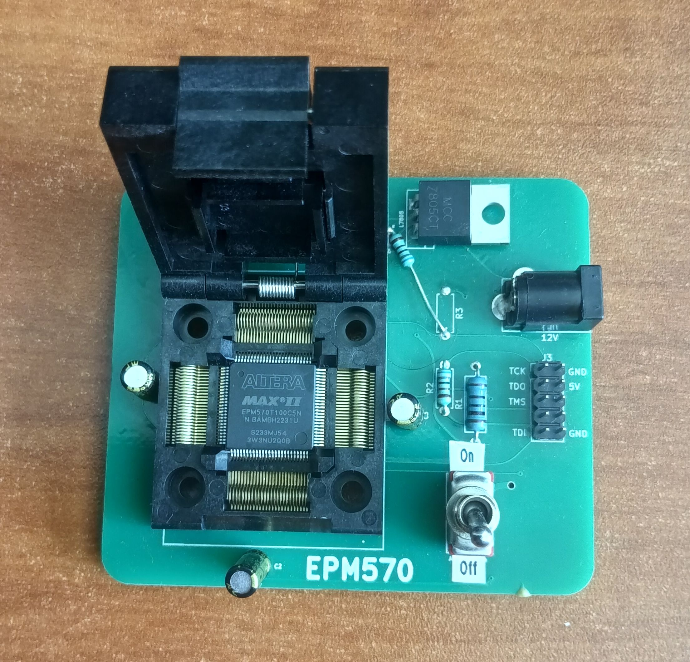
Pictures/EPM570 Programmer.jpg
