andrewpaterson/658-Computer/Pictures/HCP65 MPU NMI/Kernal Mode Entry.png

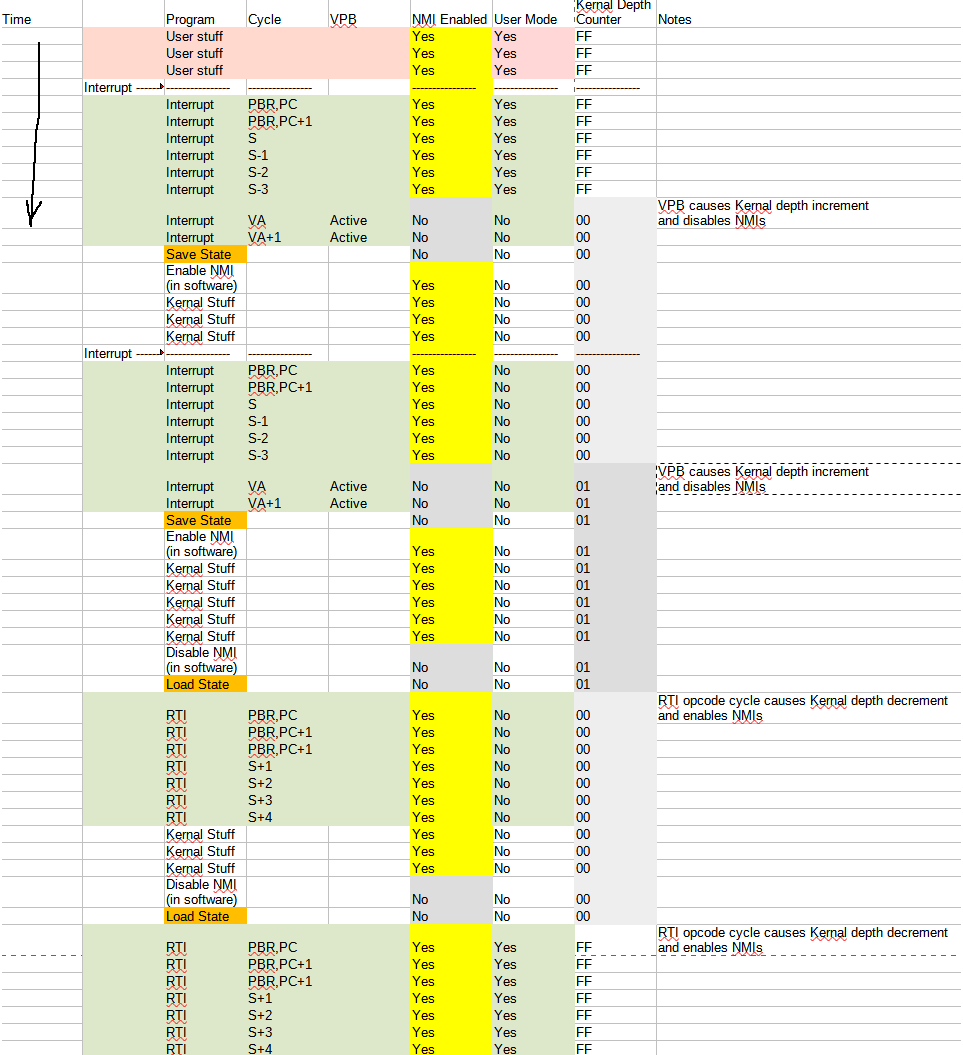
Pictures/HCP65 MPU NMI/Kernal Mode Entry.png
