andrewpaterson/658-Computer/Pictures/HCP65 MPU NMI/MPU NMI DIP render.png

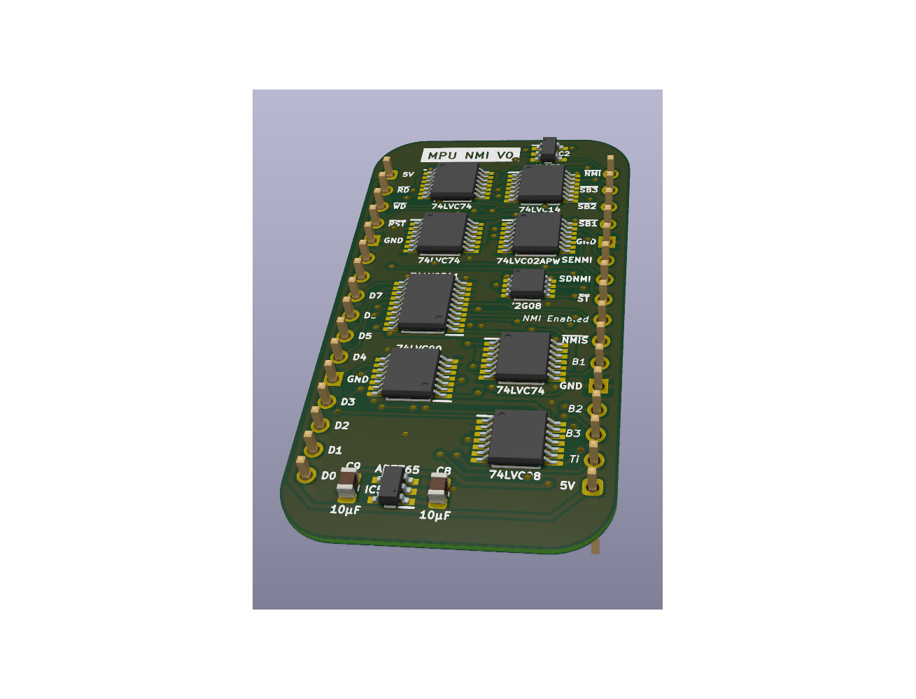
Pictures/HCP65 MPU NMI/MPU NMI DIP render.png
