andrewpaterson/658-Computer/Pictures/HCP65 MPU NMI/NMI Mask.png

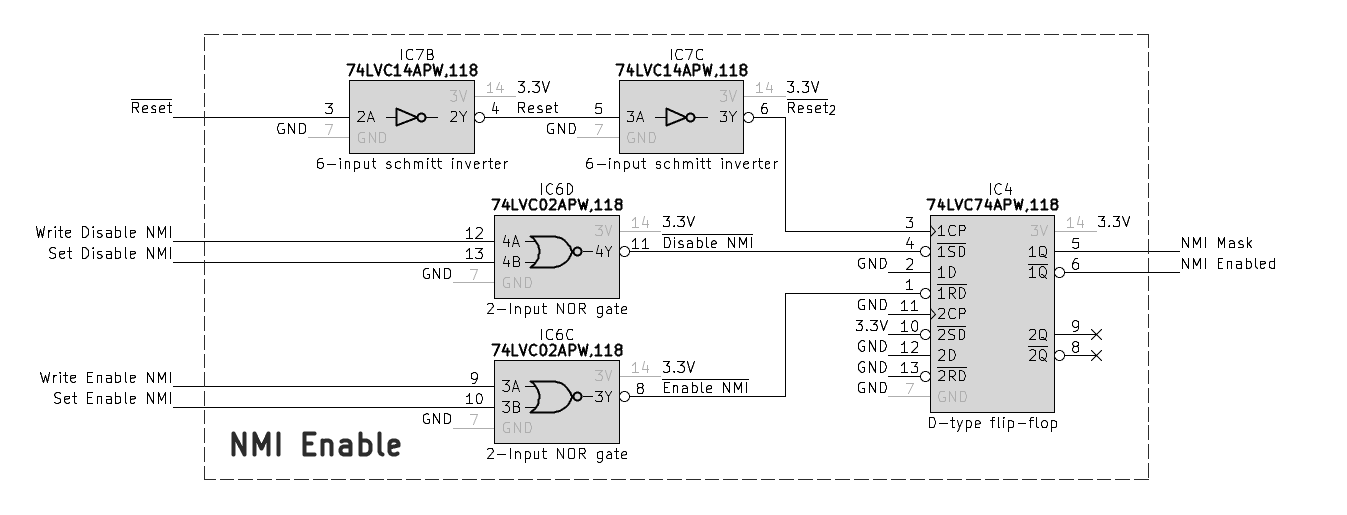
Pictures/HCP65 MPU NMI/NMI Mask.png
