andrewpaterson/658-Computer/Pictures/HCP65 MPU NMI/NMI Signal.png

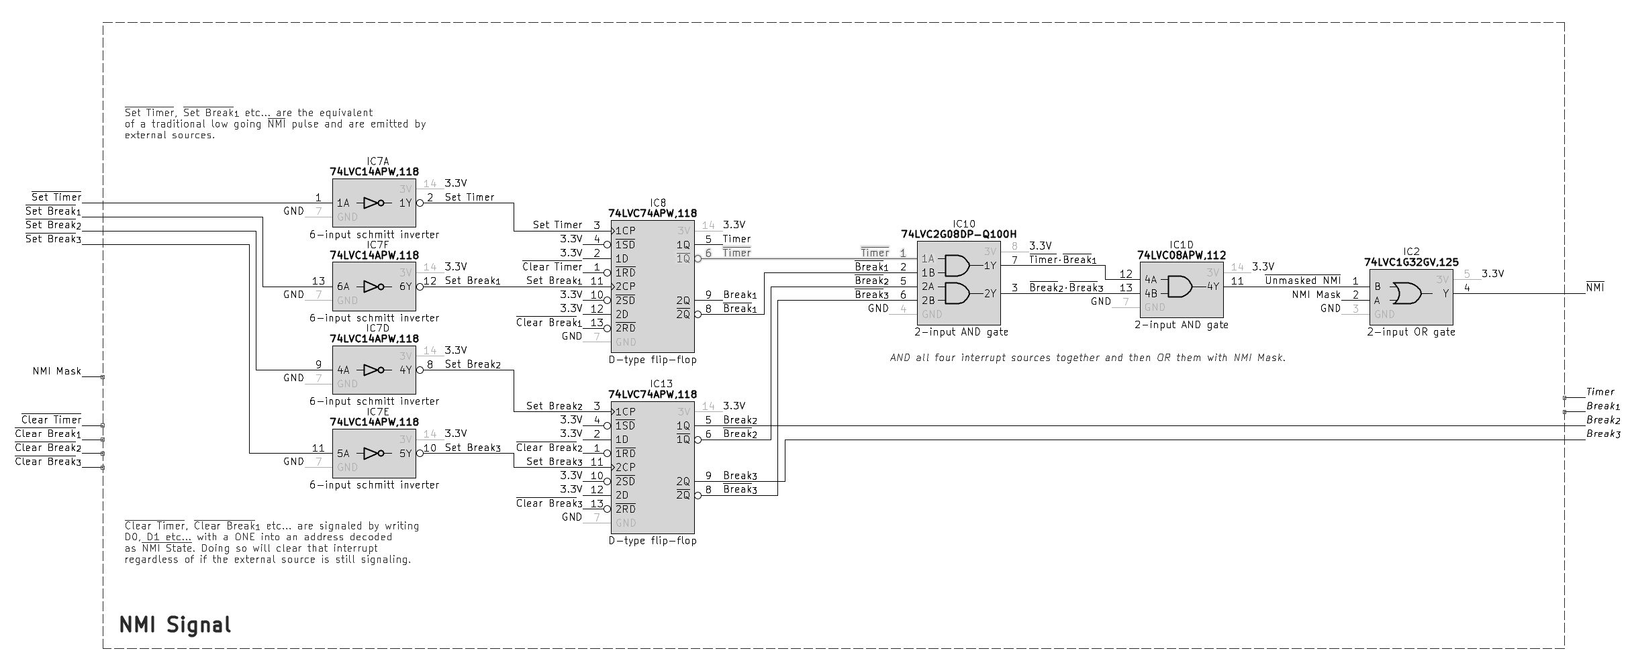
Pictures/HCP65 MPU NMI/NMI Signal.png
