andrewpaterson/658-Computer/Pictures/HCP65 Processor Board.jpg

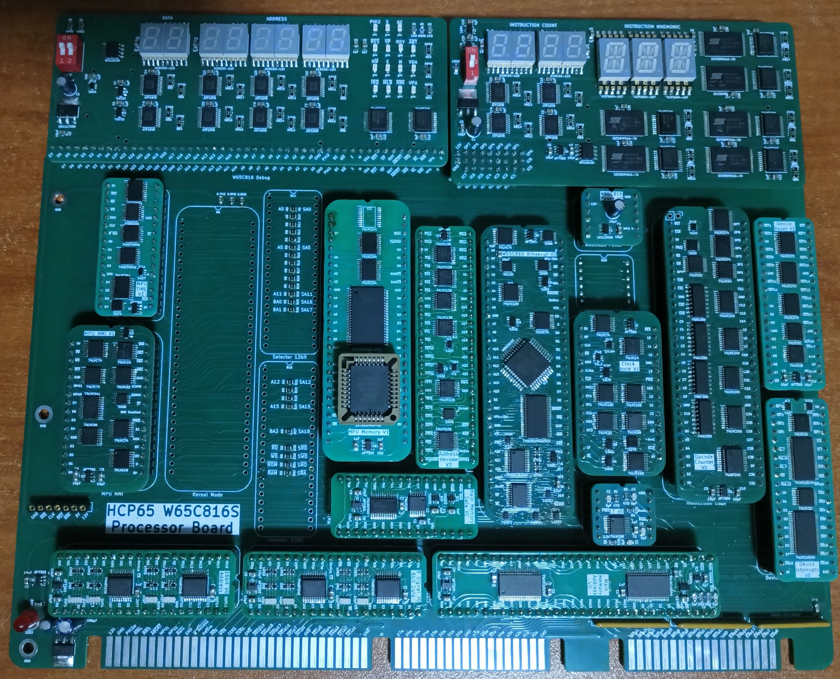
Pictures/HCP65 Processor Board.jpg
