andrewpaterson/658-Computer/Pictures/HCP65.png

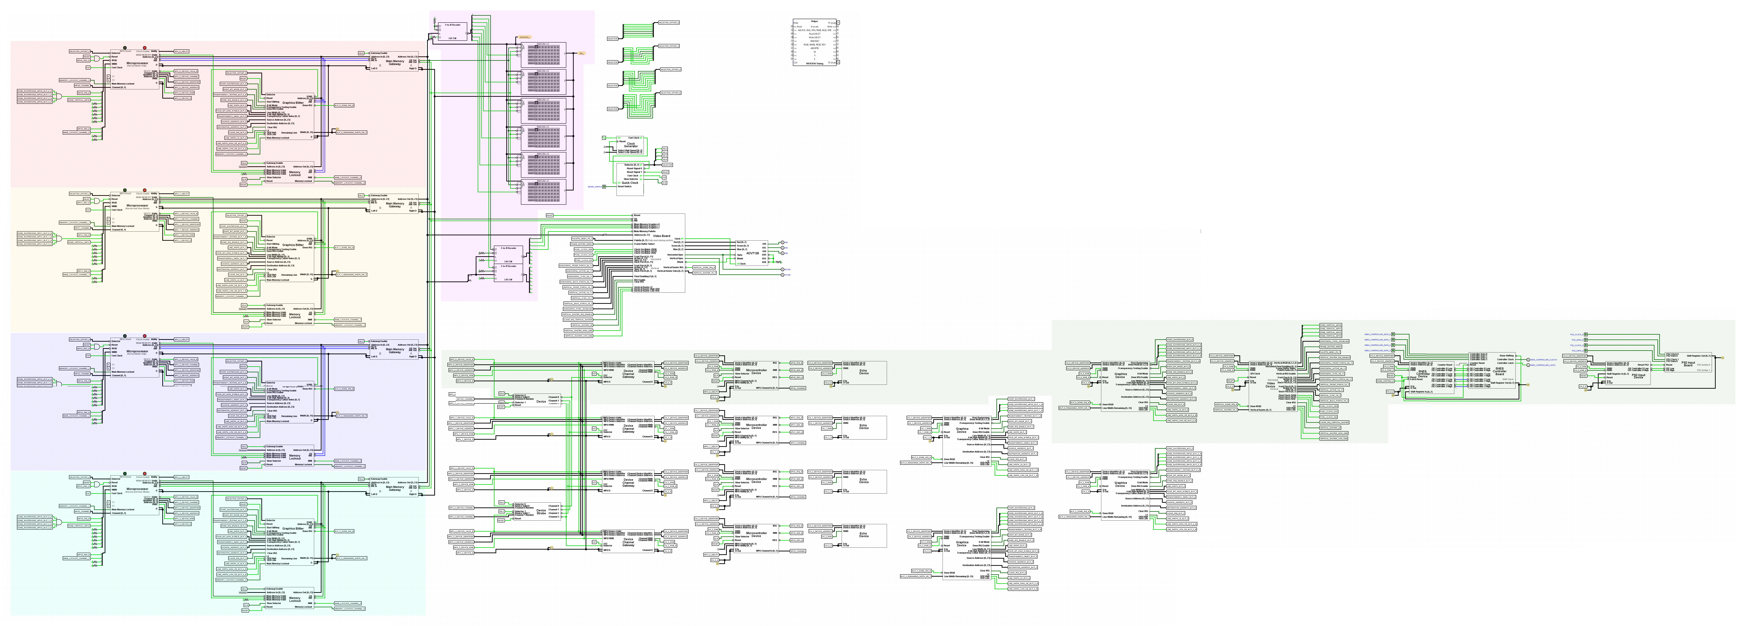
Pictures/HCP65.png
