andrewpaterson/658-Computer/Pictures/LogicimPaths.png

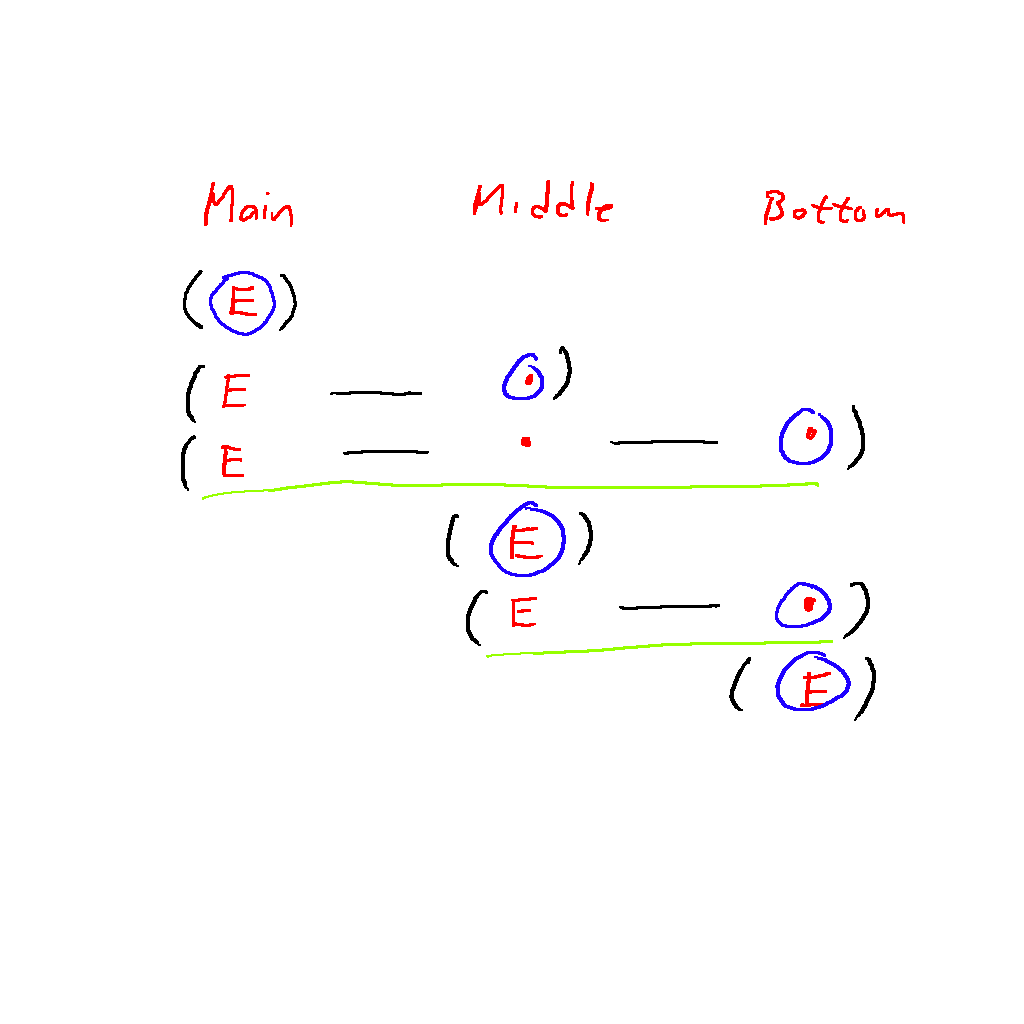
Pictures/LogicimPaths.png
