andrewpaterson/658-Computer/Pictures/LSF0102 Circuit.jpg

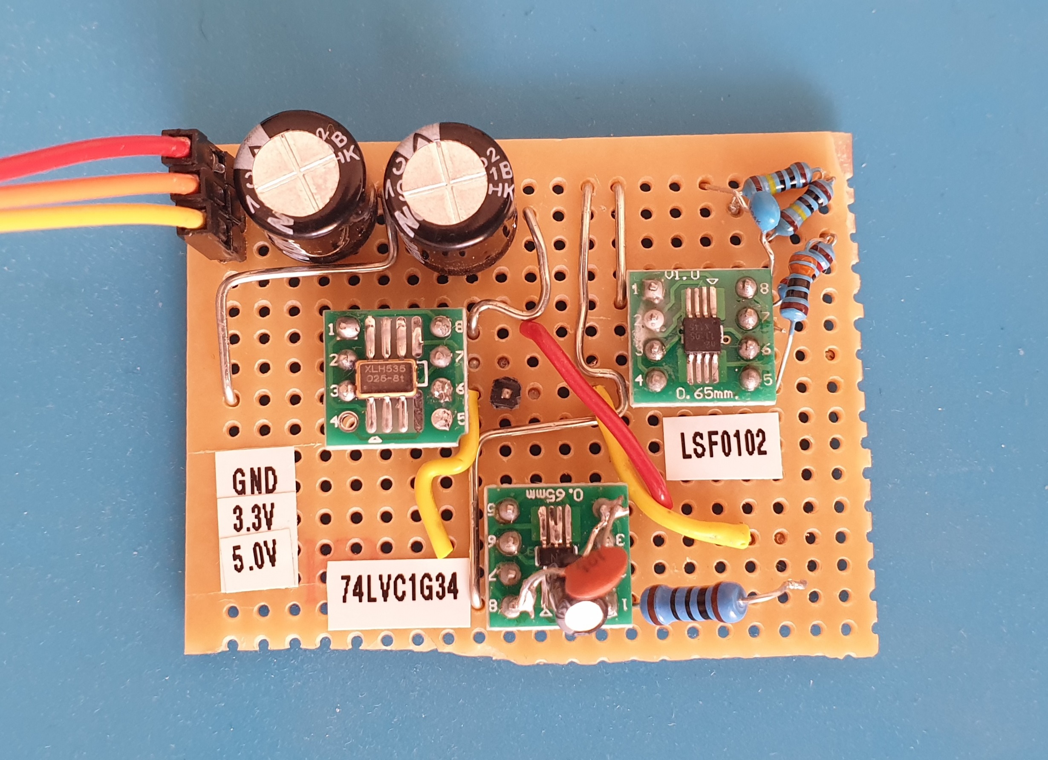
Pictures/LSF0102 Circuit.jpg
