andrewpaterson/658-Computer/Pictures/LSF0102 Connected.png

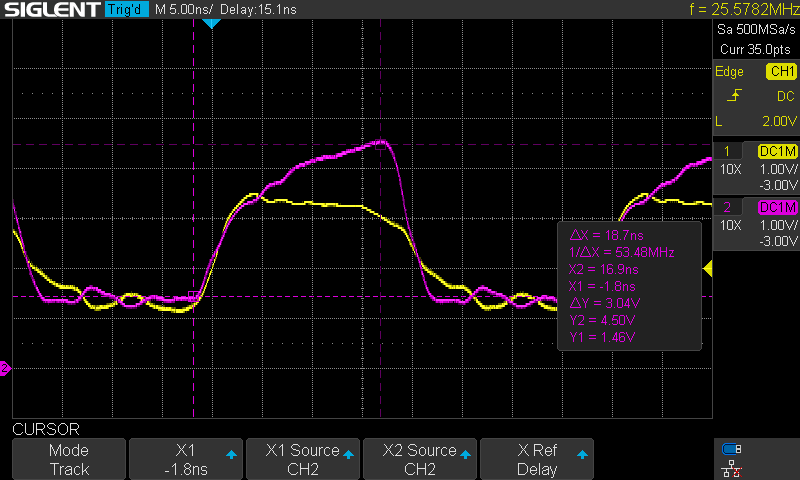
Pictures/LSF0102 Connected.png
