andrewpaterson/658-Computer/Pictures/LSF0102 Disconnected.png

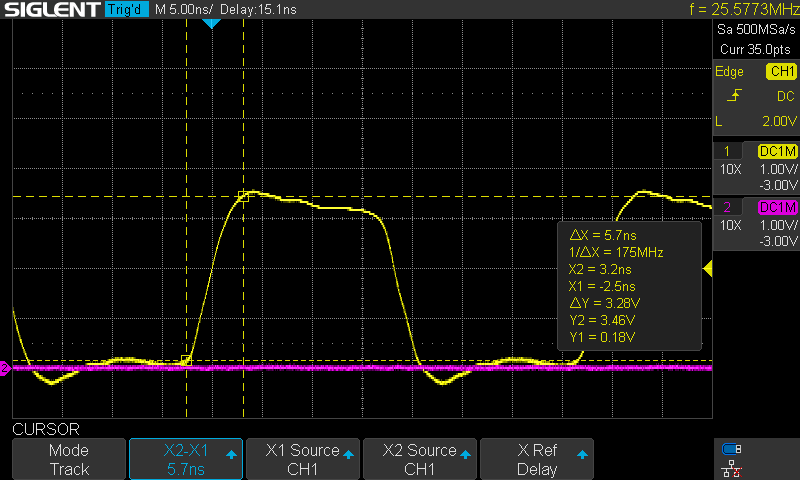
Pictures/LSF0102 Disconnected.png
