andrewpaterson/658-Computer/Pictures/LSF0102.png

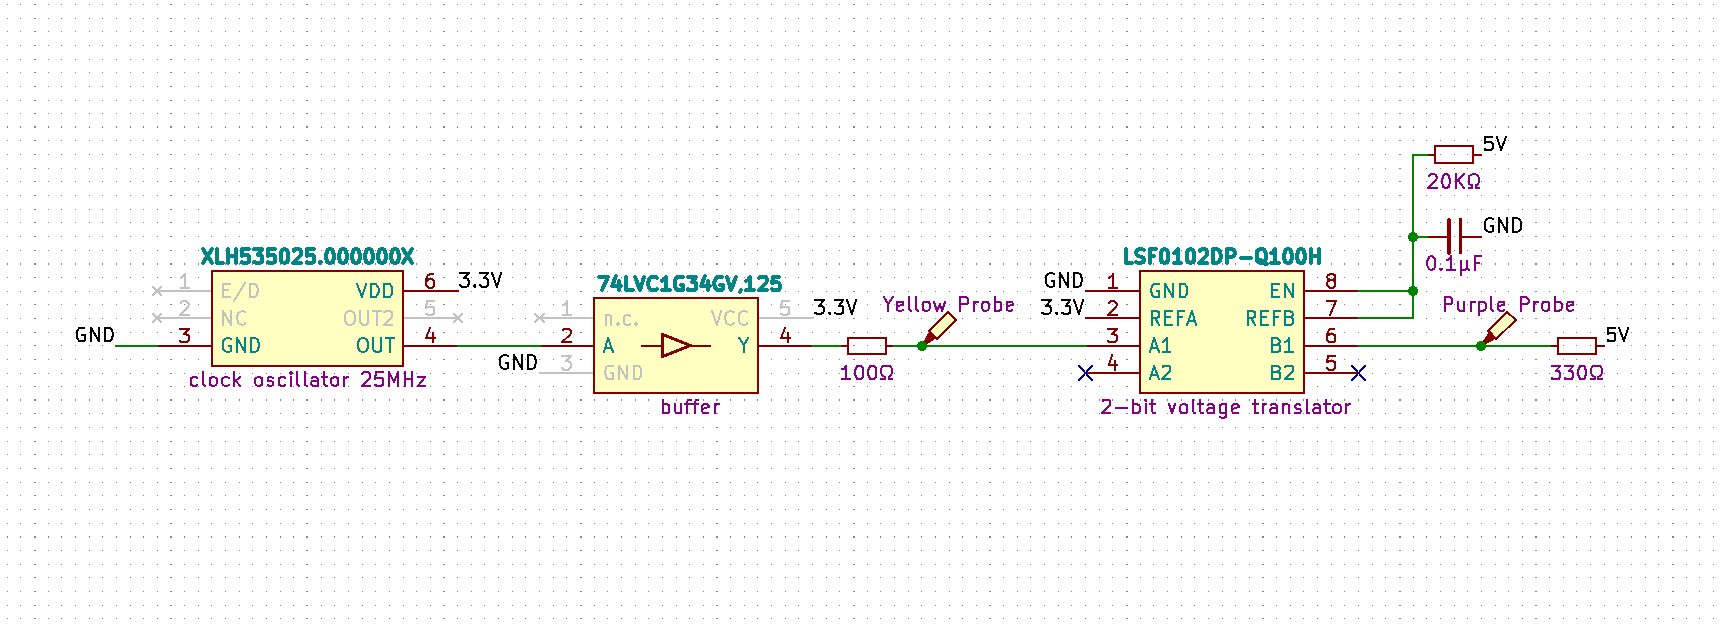
Pictures/LSF0102.png
