andrewpaterson/658-Computer/Pictures/LSF0204.jpg

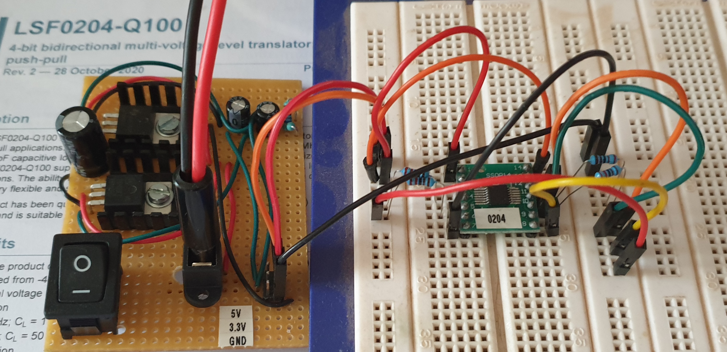
Pictures/LSF0204.jpg
