andrewpaterson/658-Computer/Pictures/LSF0204.png

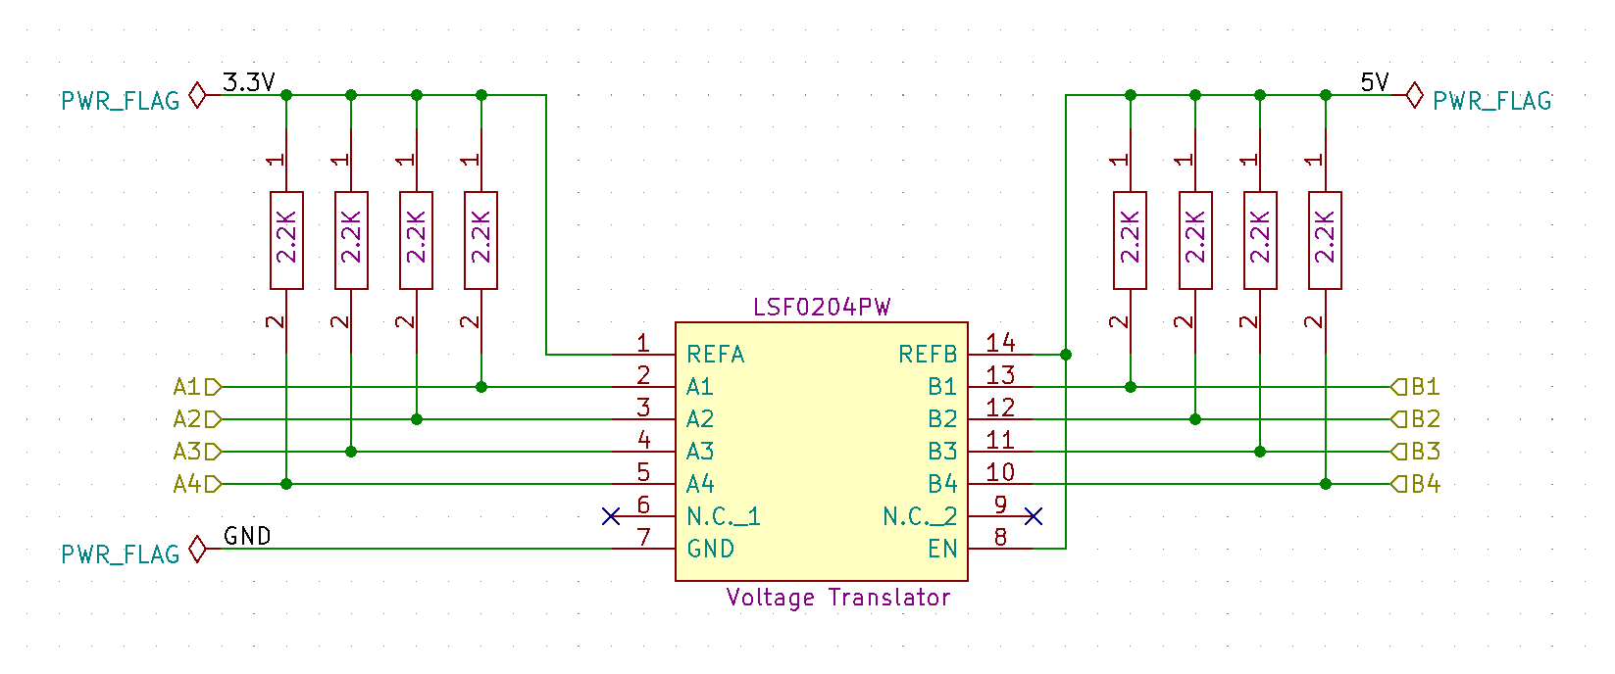
Pictures/LSF0204.png
