andrewpaterson/658-Computer/Pictures/Mainboard Full.png

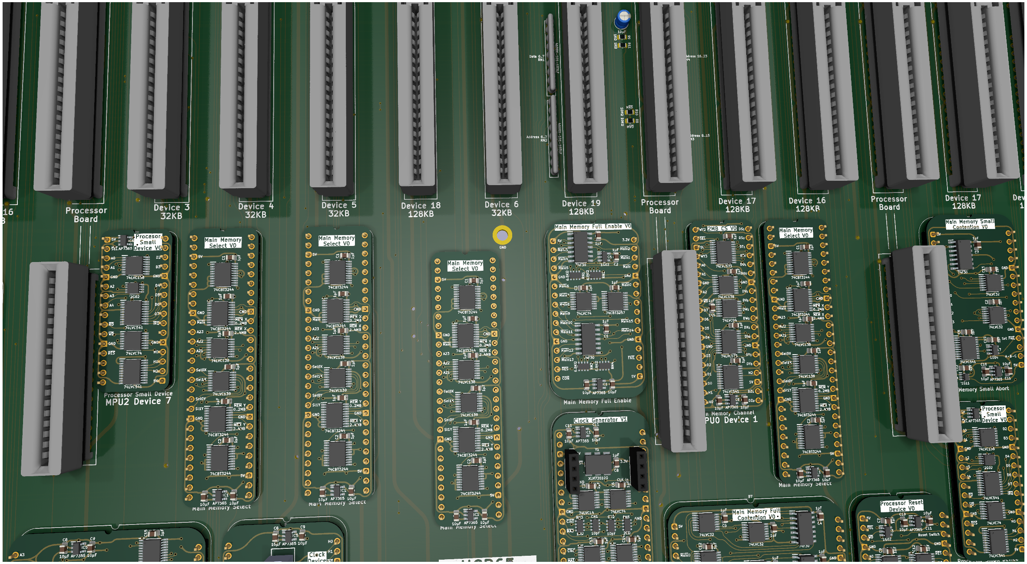
Pictures/Mainboard Full.png
