andrewpaterson/658-Computer/Pictures/Mainboard Small.png

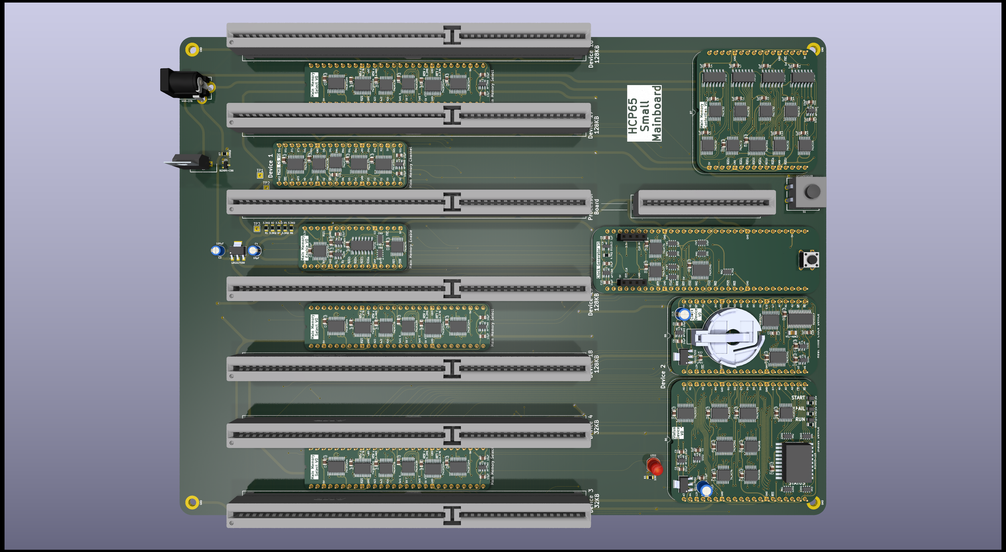
Pictures/Mainboard Small.png
