andrewpaterson/658-Computer/Pictures/Memory Map (Andre)y.png

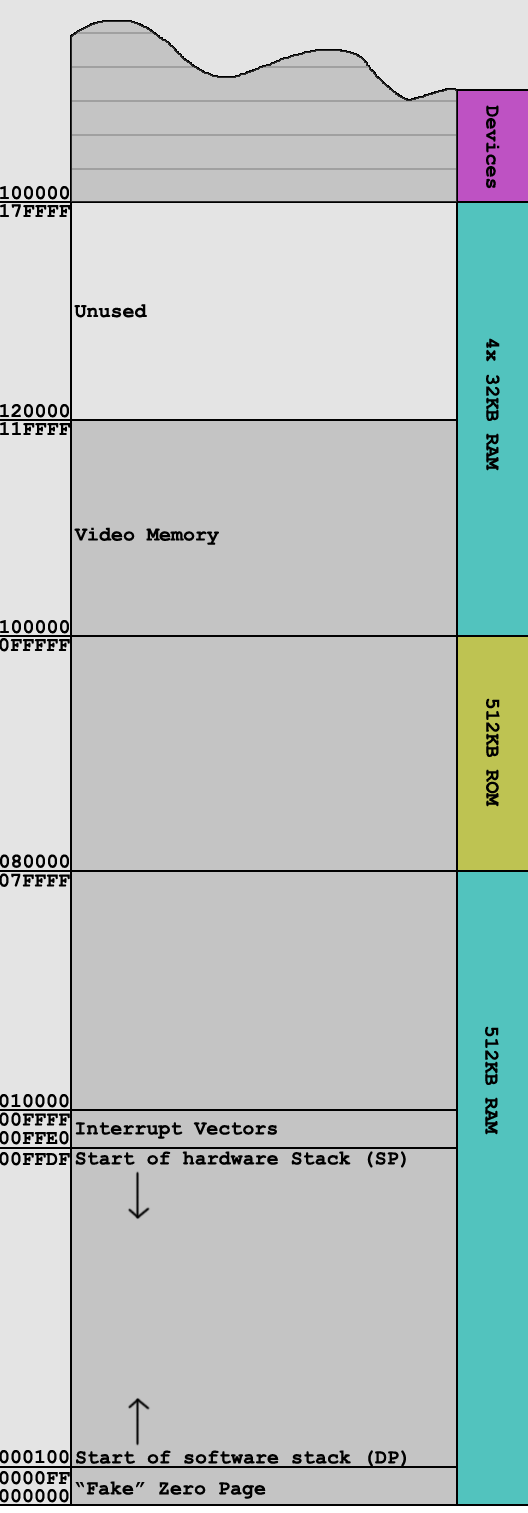
Pictures/Memory Map (Andre)y.png
