andrewpaterson/658-Computer/Pictures/Memory Map.png

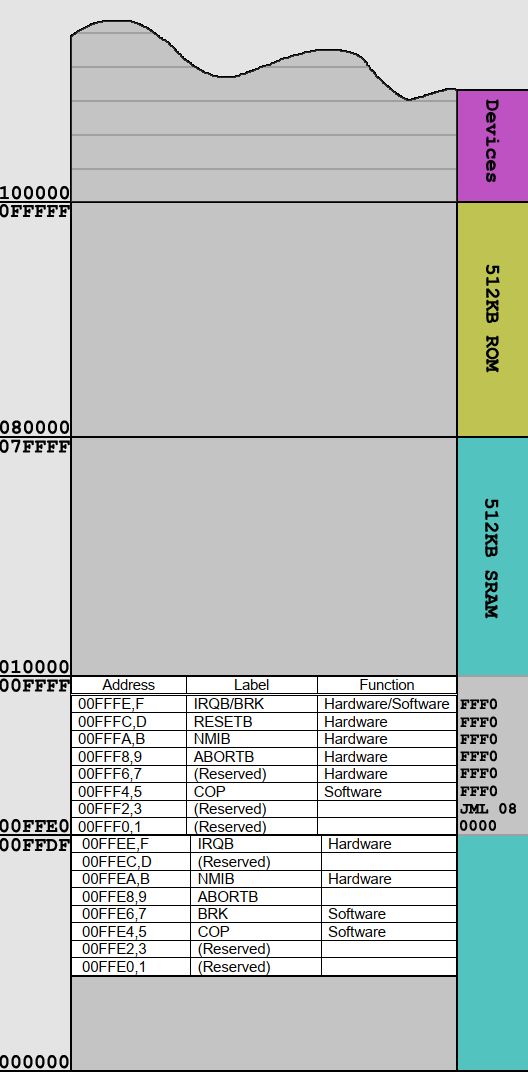
Pictures/Memory Map.png
