andrewpaterson/658-Computer/Pictures/MPU Kernal Only.png

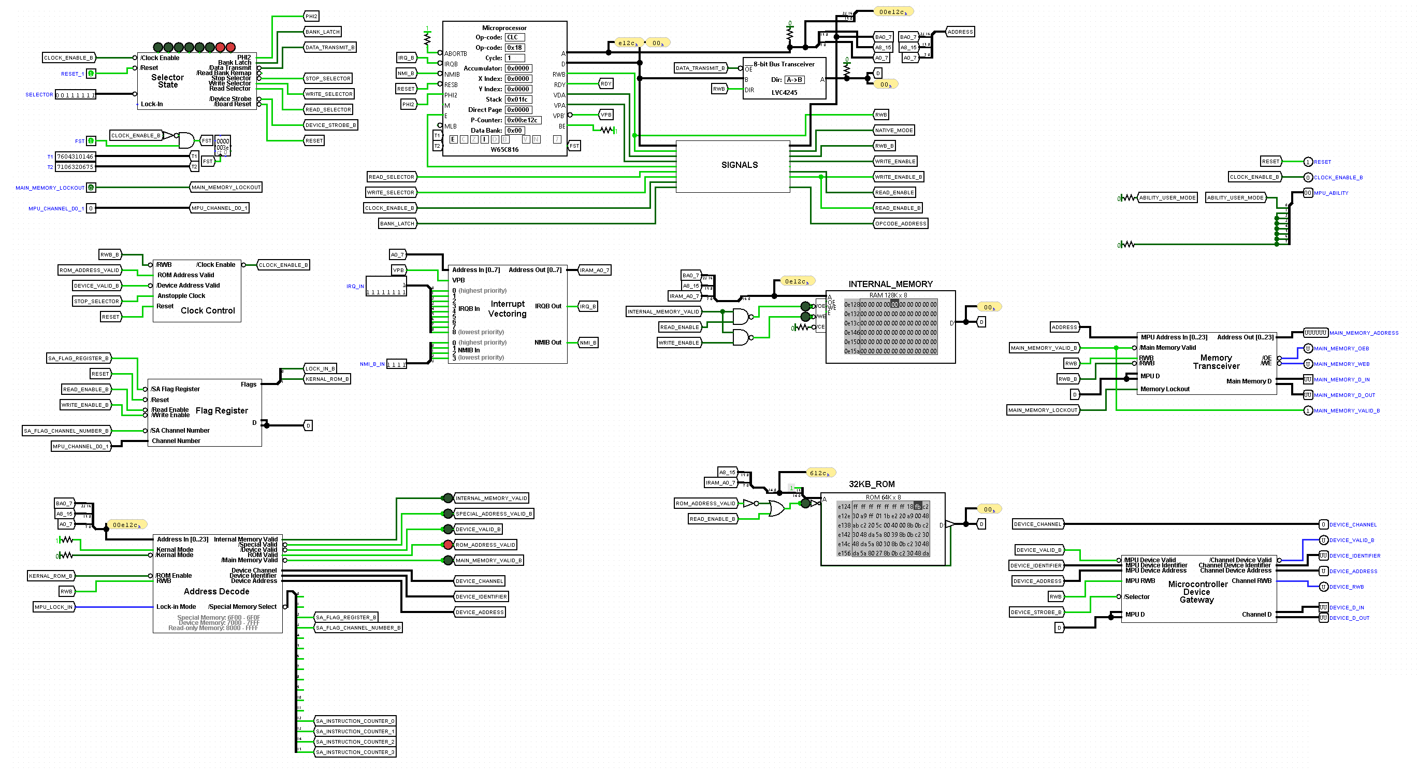
Pictures/MPU Kernal Only.png
