andrewpaterson/658-Computer/Pictures/PHI2 Timing.png

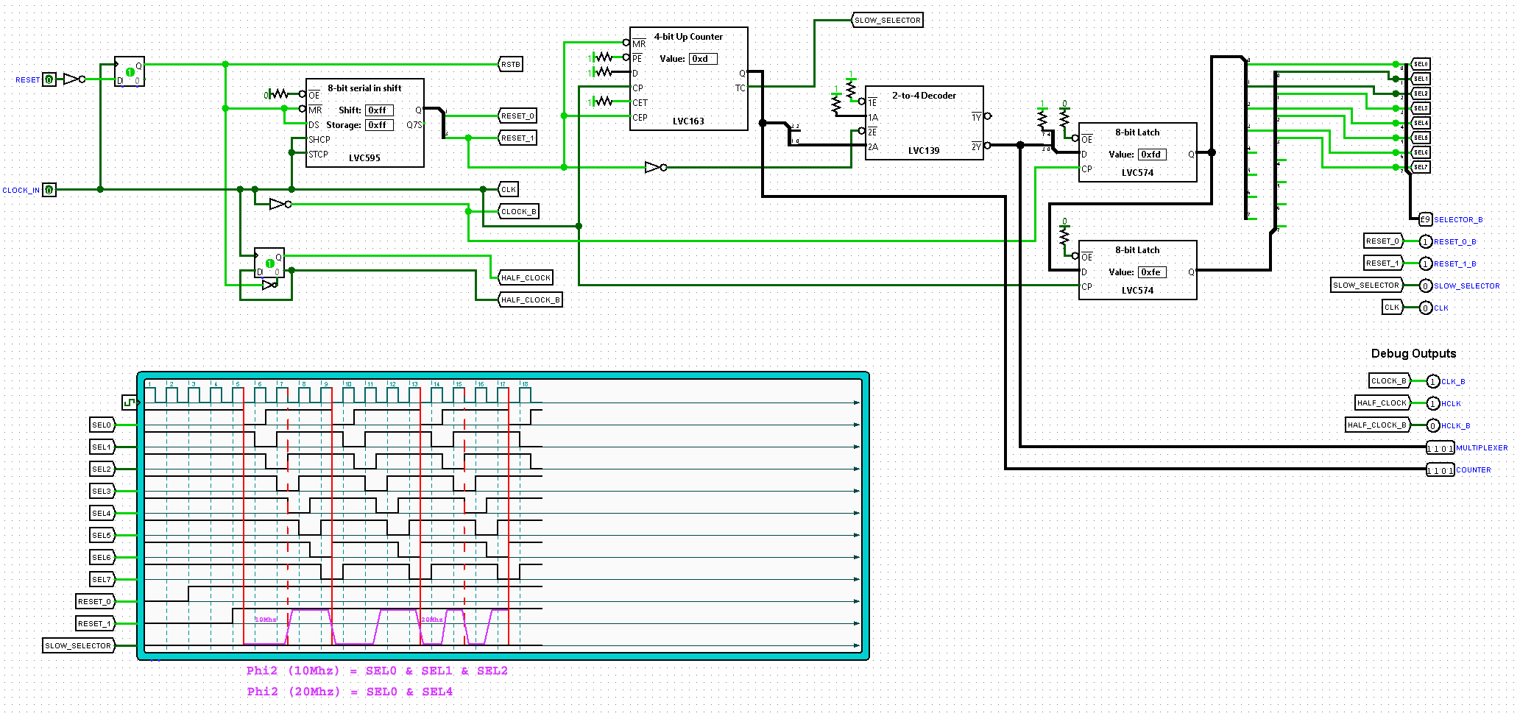
Pictures/PHI2 Timing.png
