andrewpaterson/658-Computer/Pictures/Pico to Pi Connection.png

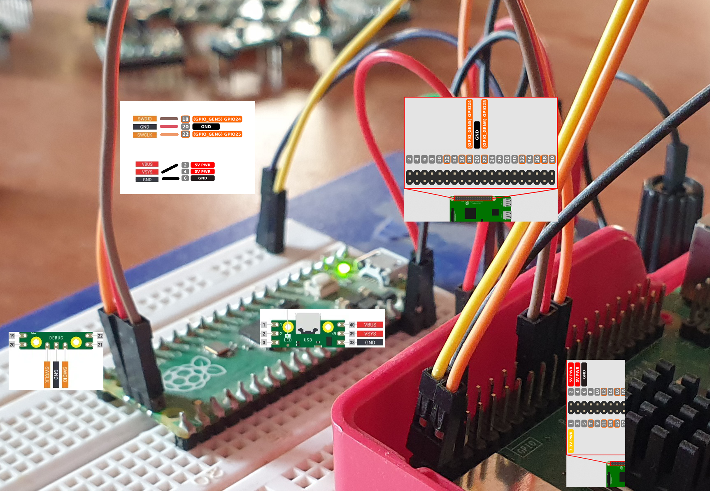
Pictures/Pico to Pi Connection.png
