andrewpaterson/658-Computer/Pictures/Processor Board V2-2.png

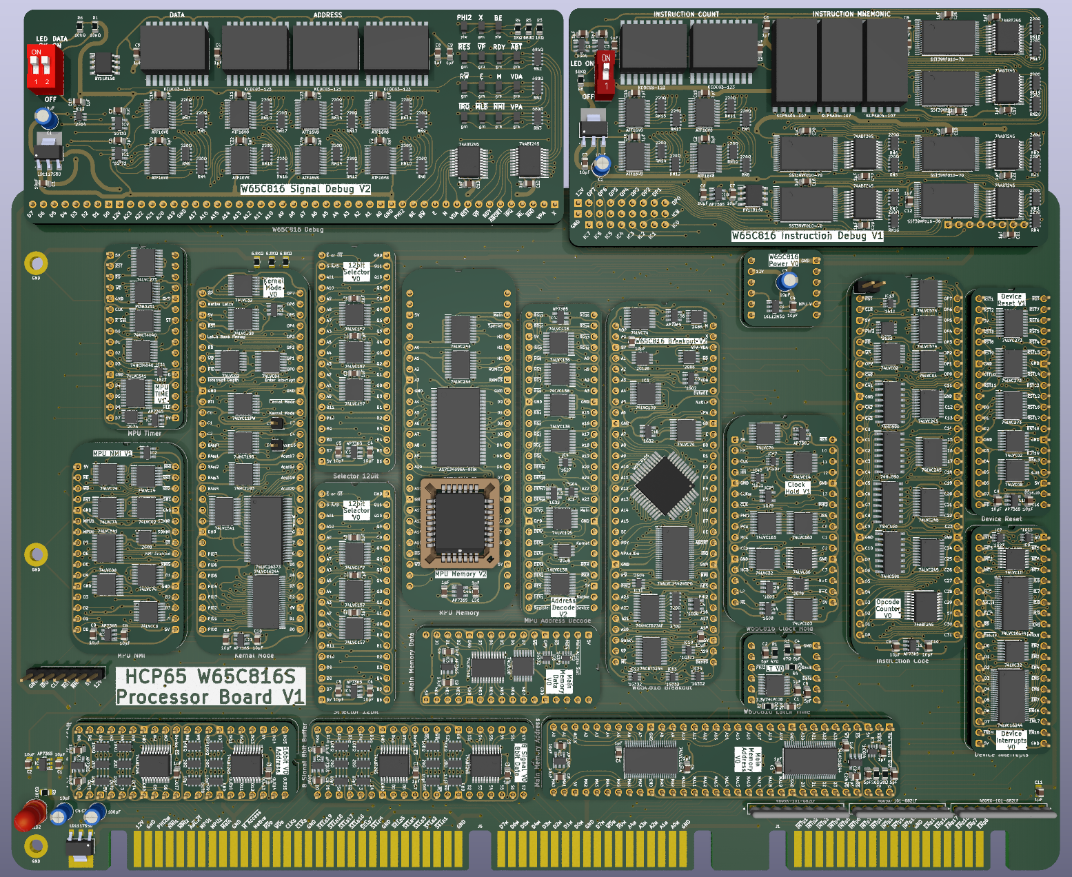
Pictures/Processor Board V2-2.png
