andrewpaterson/658-Computer/Pictures/Putty/Github-New-ssh-key.png

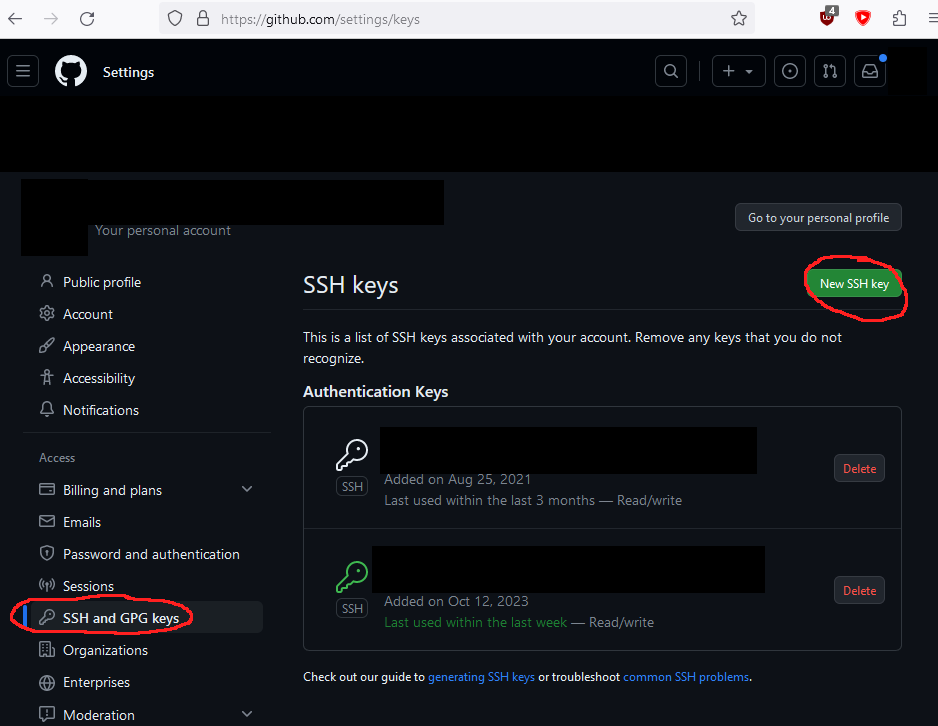
Pictures/Putty/Github-New-ssh-key.png
