andrewpaterson/658-Computer/Pictures/Putty/Github-Paste-key.png

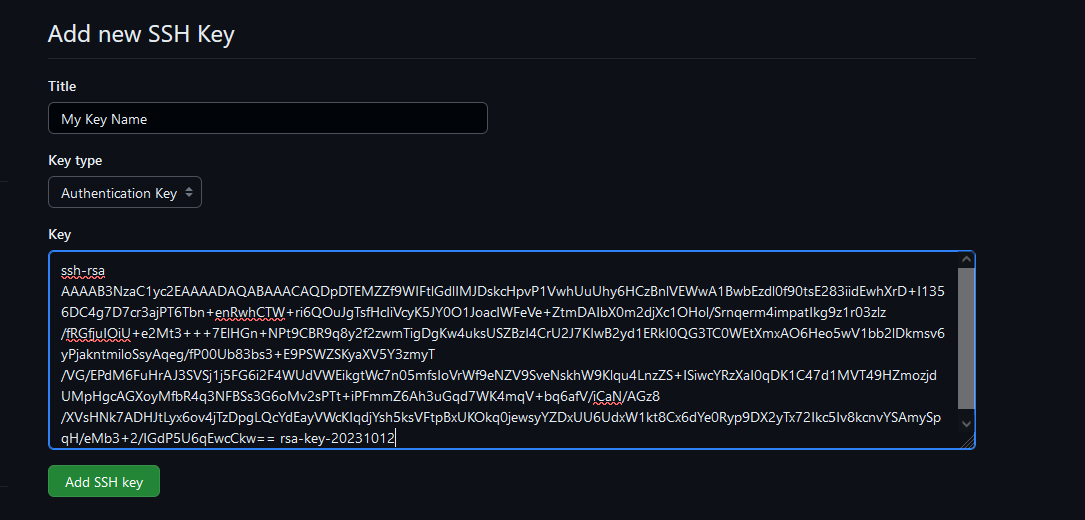
Pictures/Putty/Github-Paste-key.png
