andrewpaterson/658-Computer/Pictures/Putty/Pageant-Add-key.png

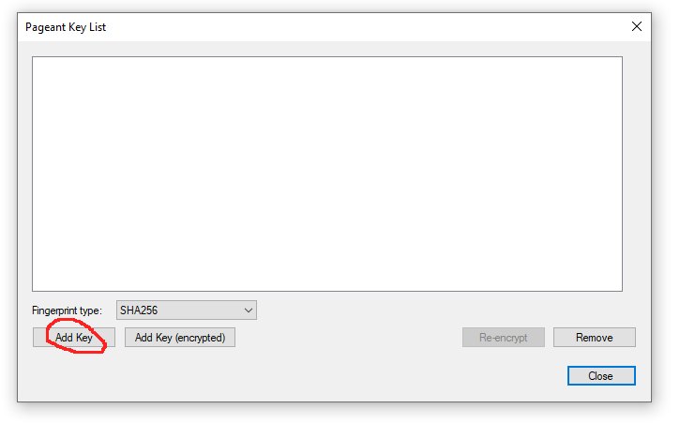
Pictures/Putty/Pageant-Add-key.png
