andrewpaterson/658-Computer/Pictures/Putty/Pageant-done.png

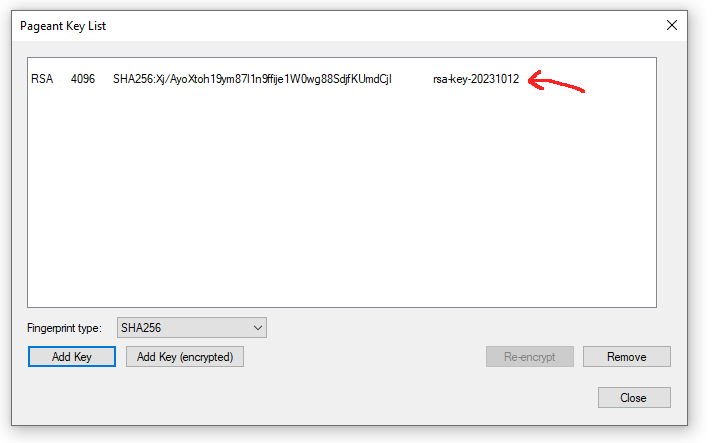
Pictures/Putty/Pageant-done.png
