andrewpaterson/658-Computer/Pictures/Putty/Pageant-Taskbar.png

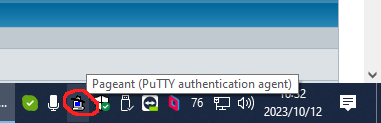
Pictures/Putty/Pageant-Taskbar.png
