andrewpaterson/658-Computer/Pictures/Putty/PuttyGen-Copy-public-key.png

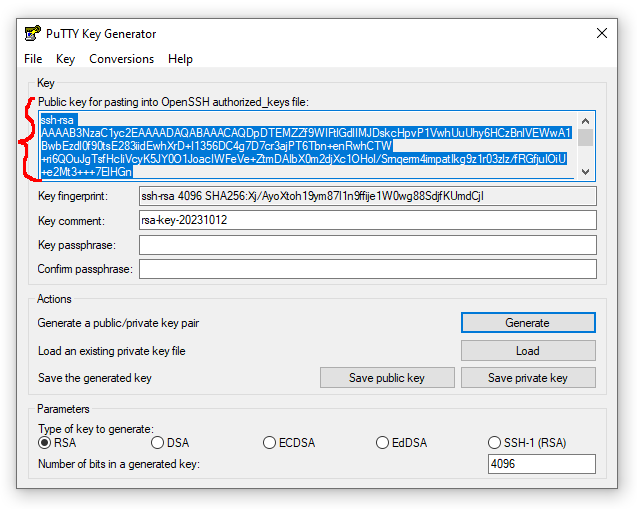
Pictures/Putty/PuttyGen-Copy-public-key.png
