andrewpaterson/658-Computer/Pictures/Putty/PuttyGen-Export-private-key.png

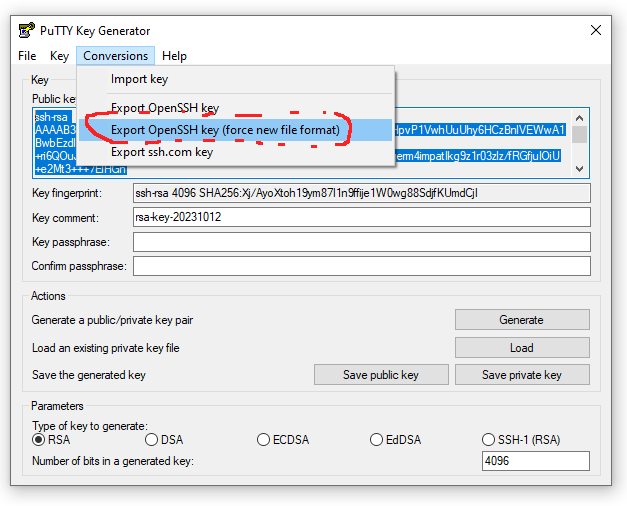
Pictures/Putty/PuttyGen-Export-private-key.png
