andrewpaterson/658-Computer/Pictures/Putty/PuttyGen-Generate.png

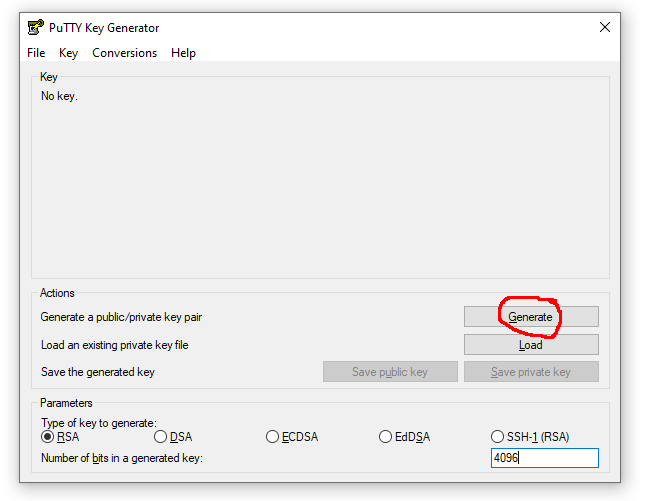
Pictures/Putty/PuttyGen-Generate.png
