andrewpaterson/658-Computer/Pictures/Read Data Hold Time.png

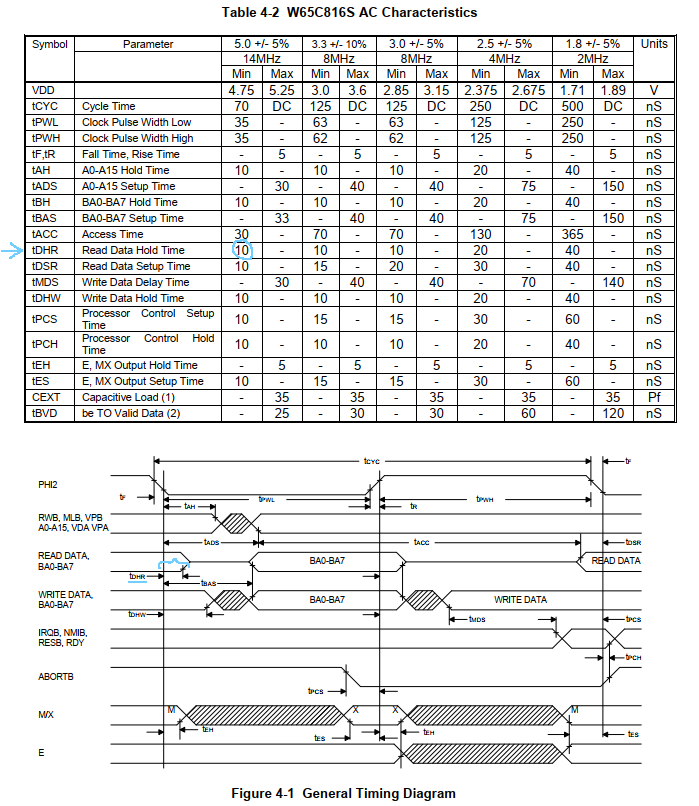
Pictures/Read Data Hold Time.png
