andrewpaterson/658-Computer/Pictures/Read Write 139.png

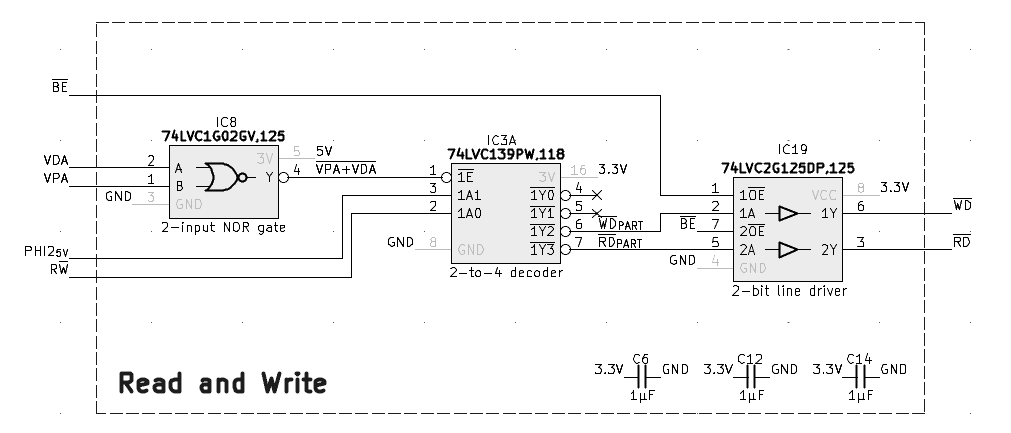
Pictures/Read Write 139.png
