andrewpaterson/658-Computer/Pictures/Reset Long Vector.png

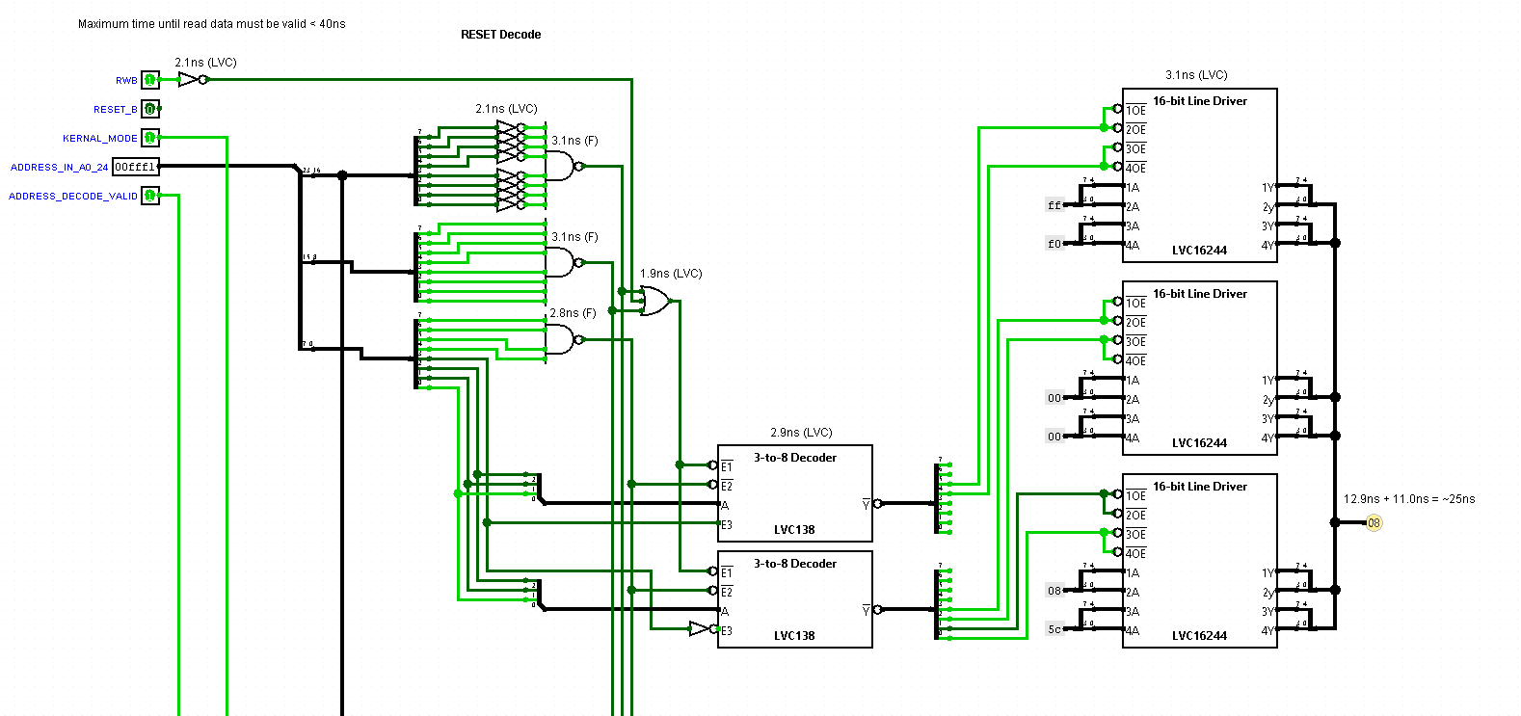
Pictures/Reset Long Vector.png
