andrewpaterson/658-Computer/Pictures/Reset/65C816 Reset.png

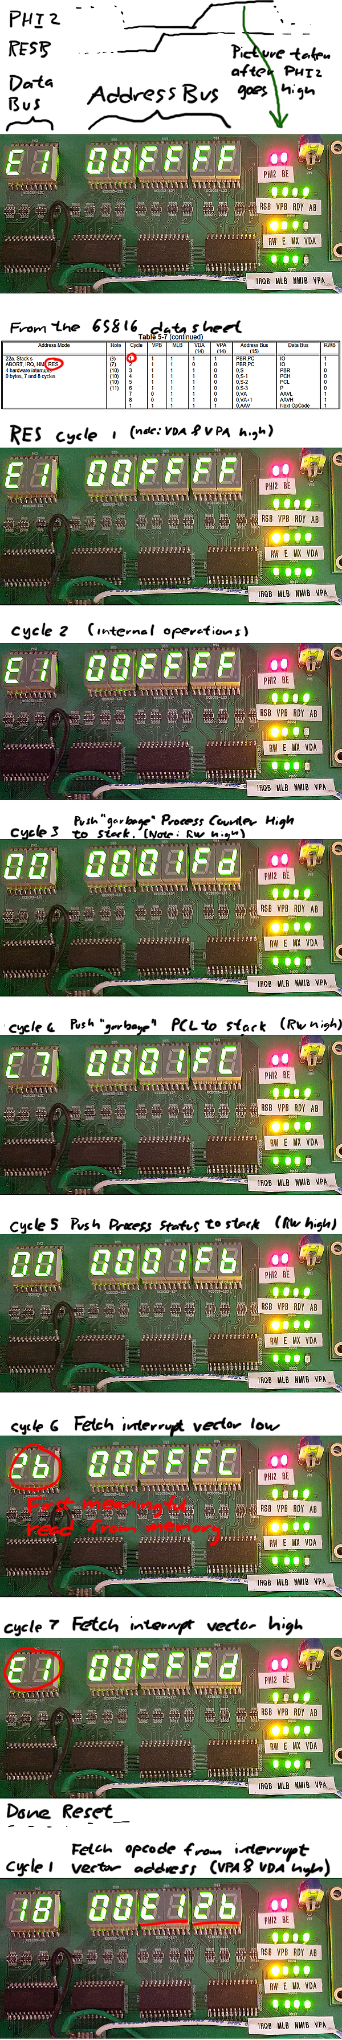
Pictures/Reset/65C816 Reset.png
