andrewpaterson/658-Computer/Pictures/Reset/20230302_093954.jpg

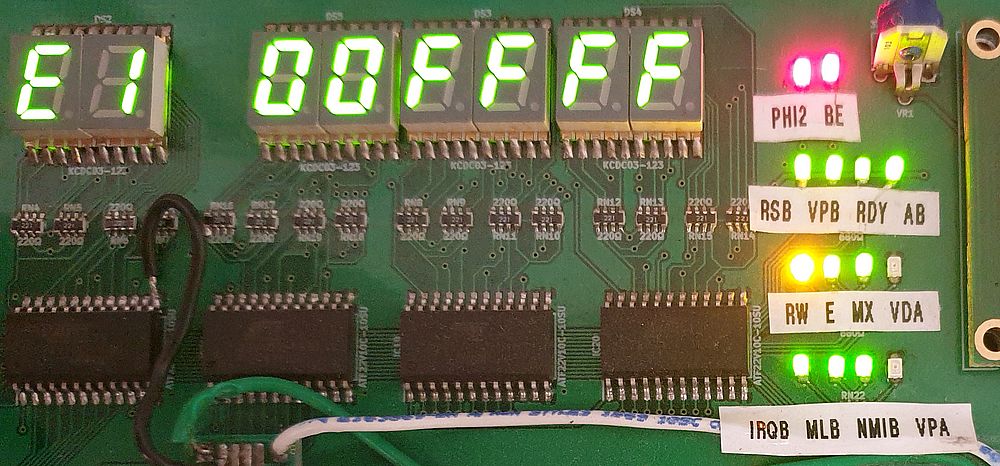
Pictures/Reset/20230302_093954.jpg
