andrewpaterson/658-Computer/Pictures/Reset/20230302_094029.jpg

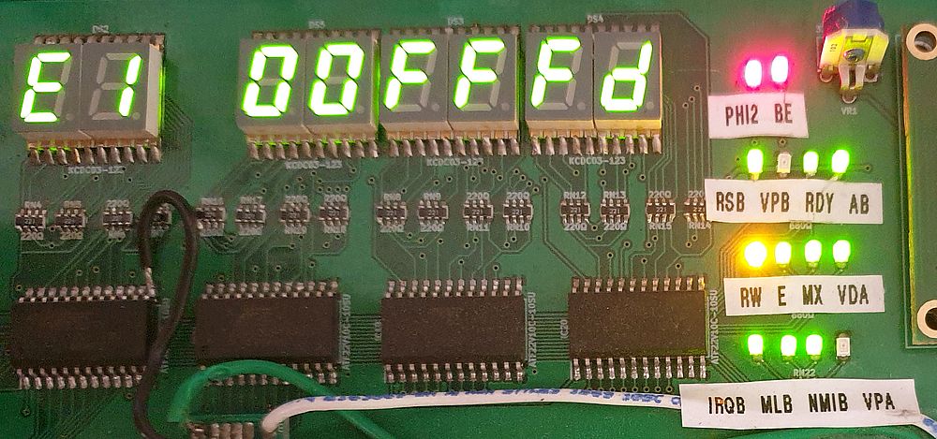
Pictures/Reset/20230302_094029.jpg
