andrewpaterson/658-Computer/Pictures/Reset/20230302_094040.jpg

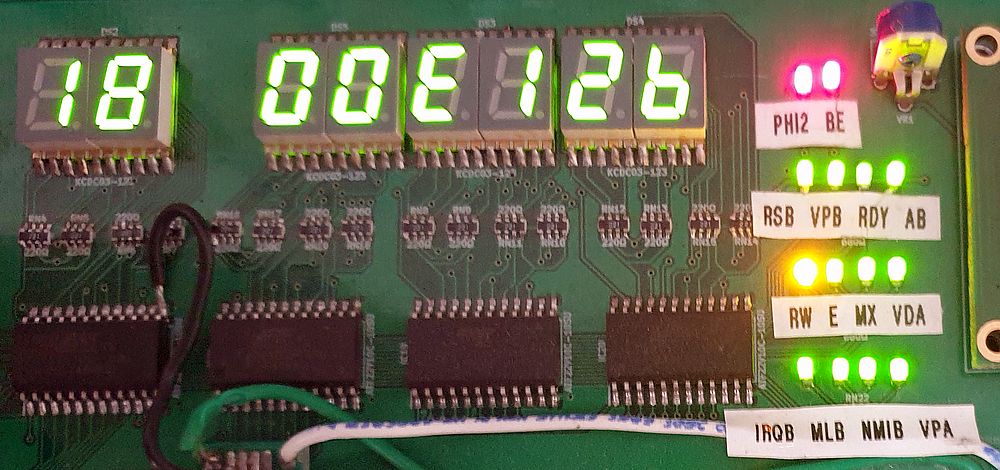
Pictures/Reset/20230302_094040.jpg
