andrewpaterson/658-Computer/Pictures/SD Card Board - back.png

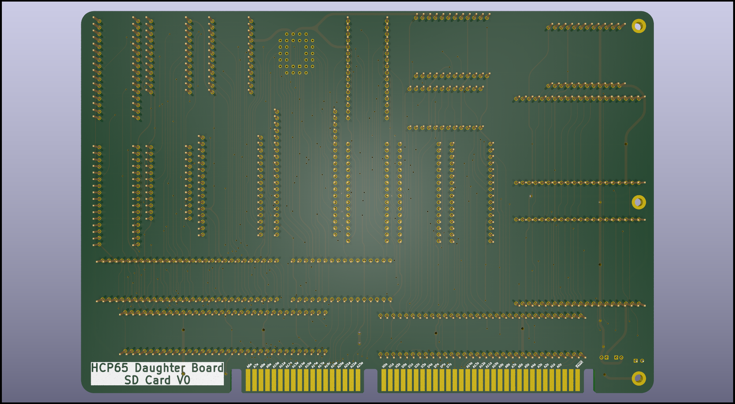
Pictures/SD Card Board - back.png
