andrewpaterson/658-Computer/Pictures/SD Card Board - no mess.png

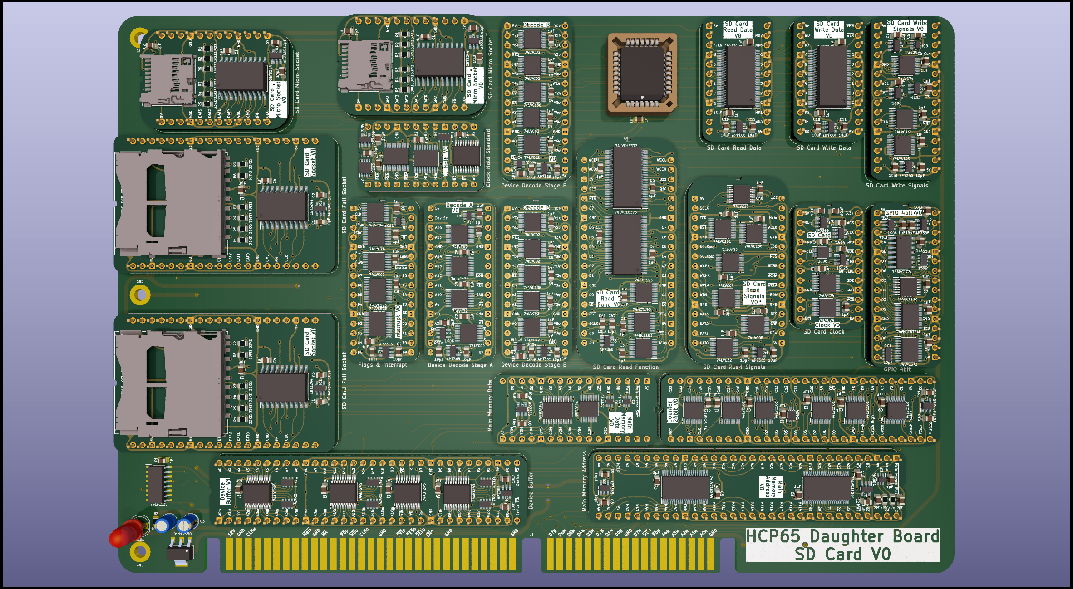
Pictures/SD Card Board - no mess.png
