andrewpaterson/658-Computer/Pictures/SD Card/SD Card Bus Timing.png

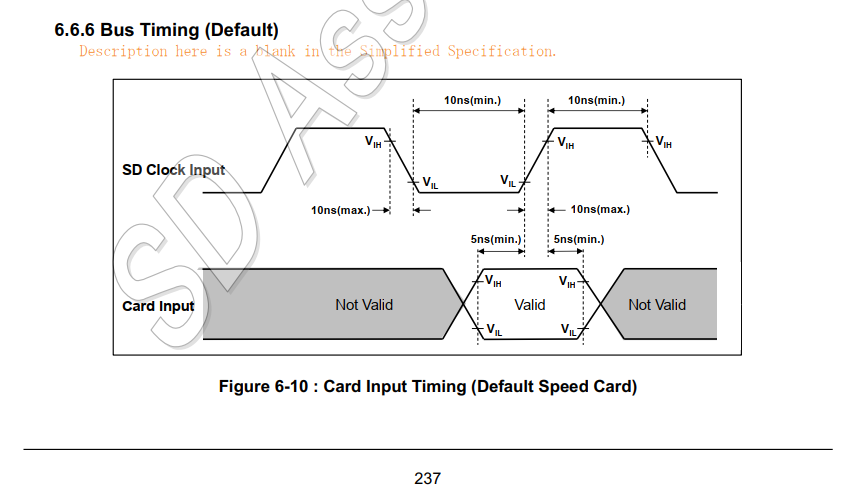
Pictures/SD Card/SD Card Bus Timing.png
