andrewpaterson/658-Computer/Pictures/SD Card/SD Card Cmd8 Detail.png

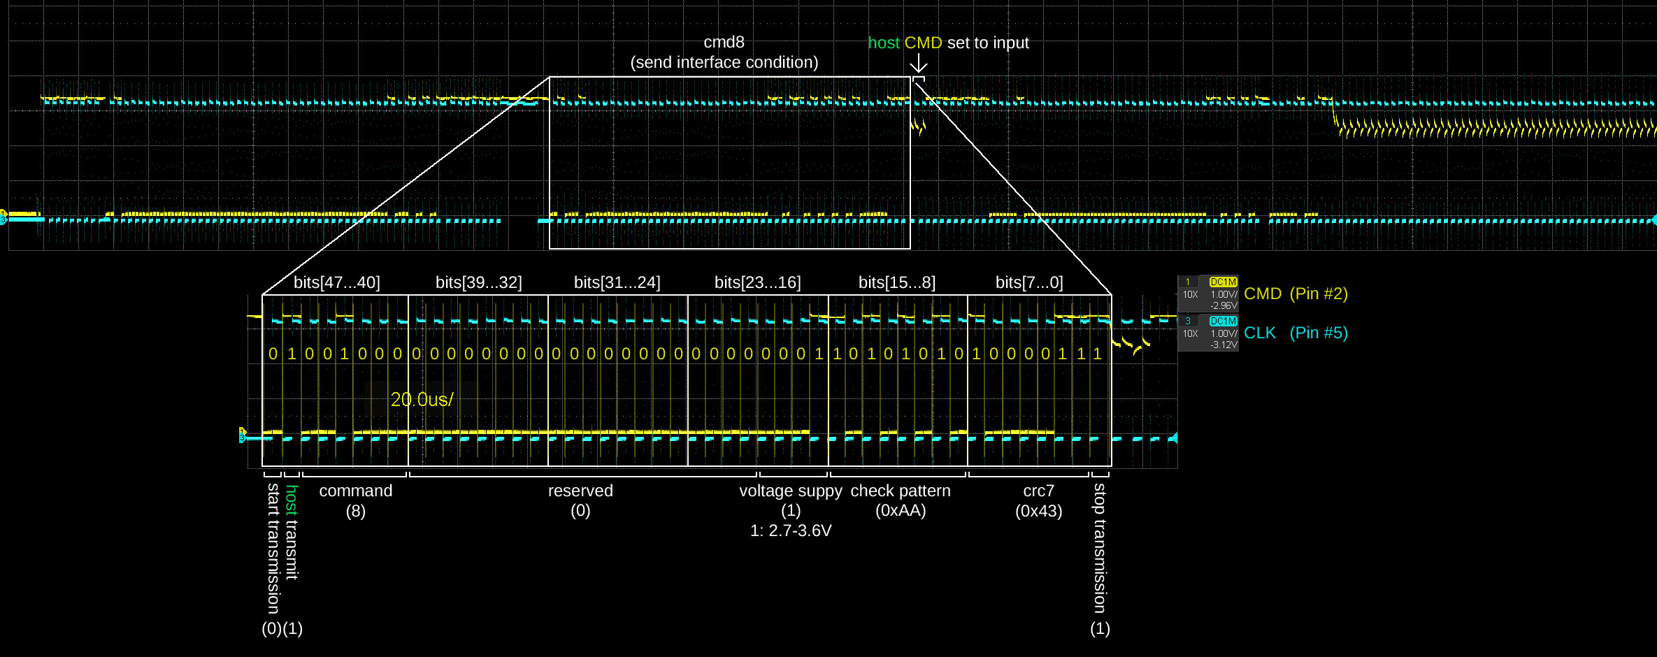
Pictures/SD Card/SD Card Cmd8 Detail.png
