andrewpaterson/658-Computer/Pictures/SD Card/SD Card Command Circuirt CRC Calculated.png

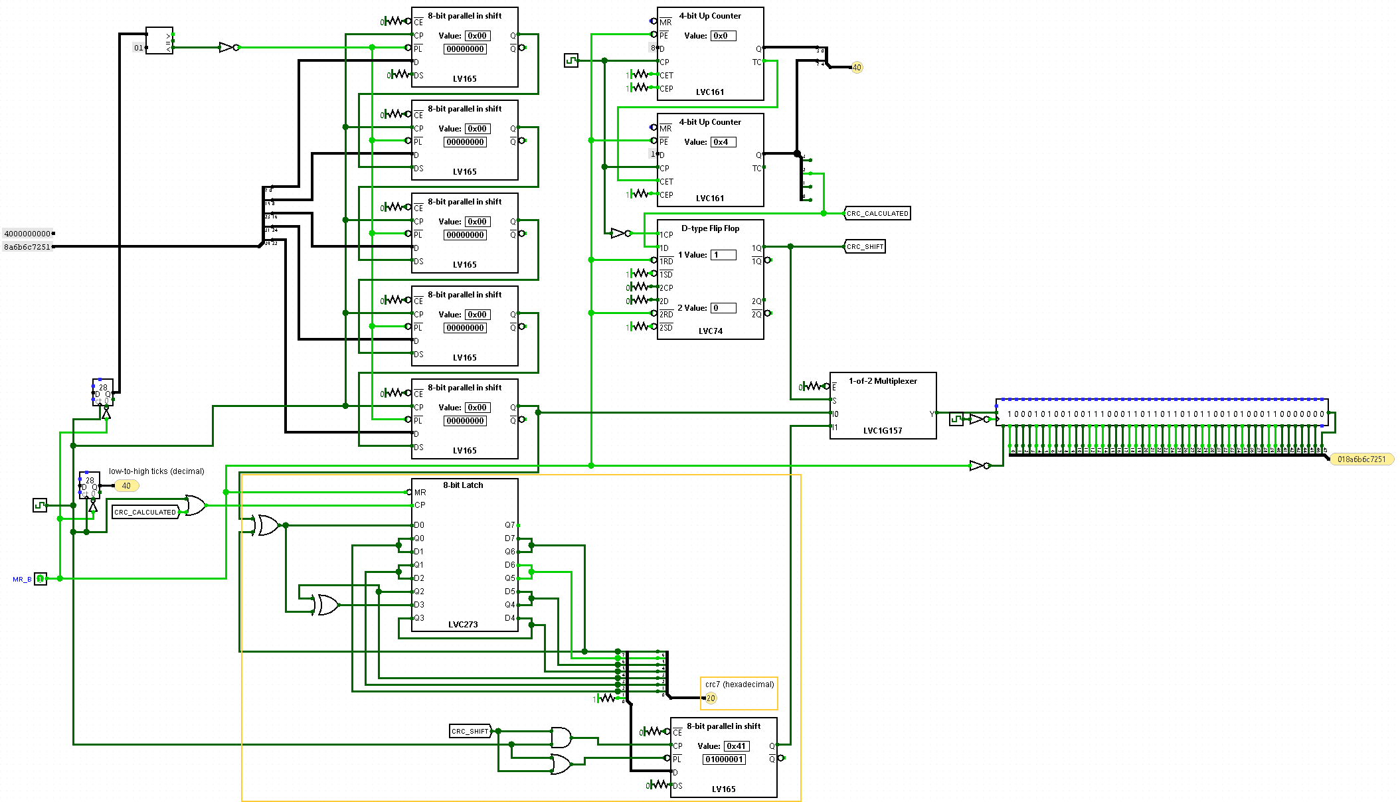
Pictures/SD Card/SD Card Command Circuirt CRC Calculated.png
