andrewpaterson/658-Computer/Pictures/SD Card/SD Card Command Format.png

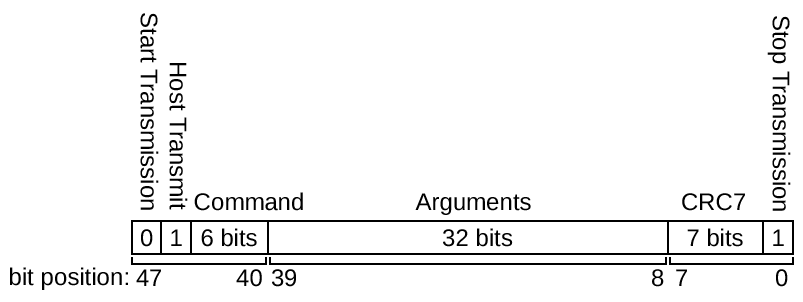
Pictures/SD Card/SD Card Command Format.png
