andrewpaterson/658-Computer/Pictures/SD Card/SD Card Initialistion Flow.png

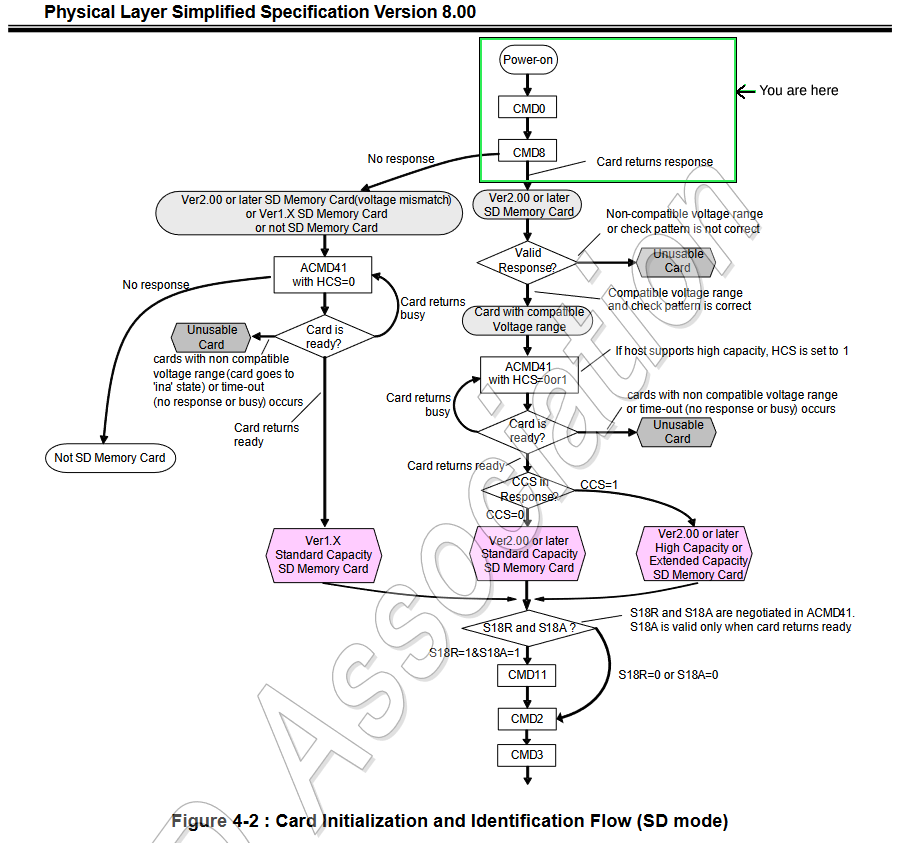
Pictures/SD Card/SD Card Initialistion Flow.png
