andrewpaterson/658-Computer/Pictures/SD Card/SD Card Pins.png

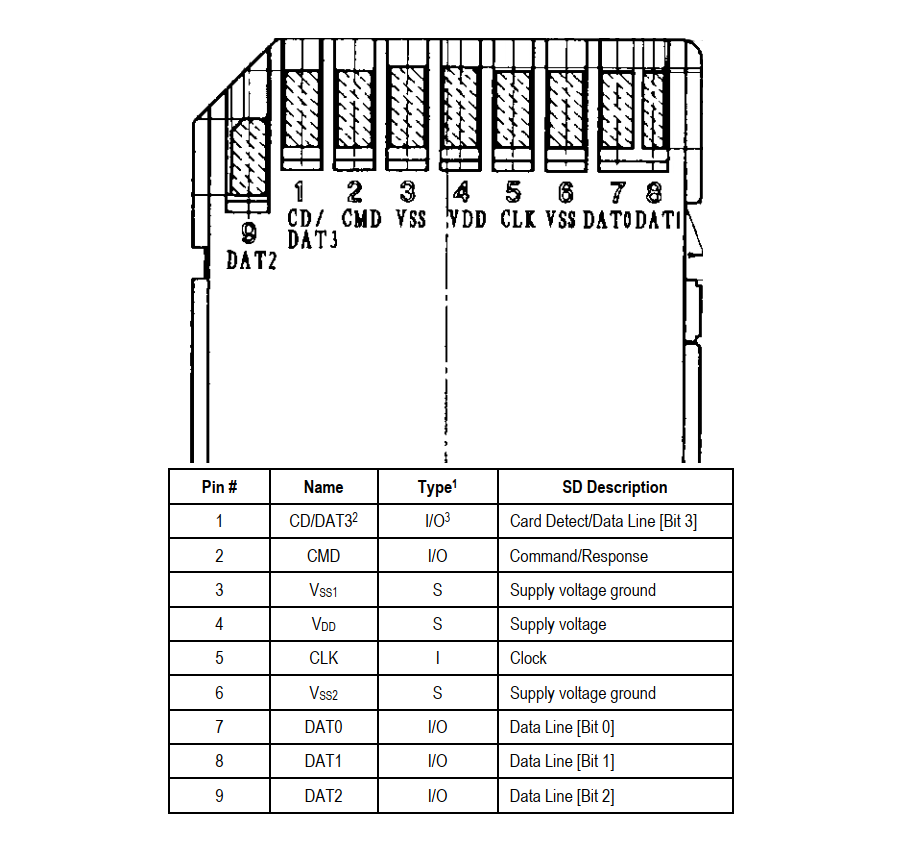
Pictures/SD Card/SD Card Pins.png
