andrewpaterson/658-Computer/Pictures/SD Card/SD Card Read Timing.png

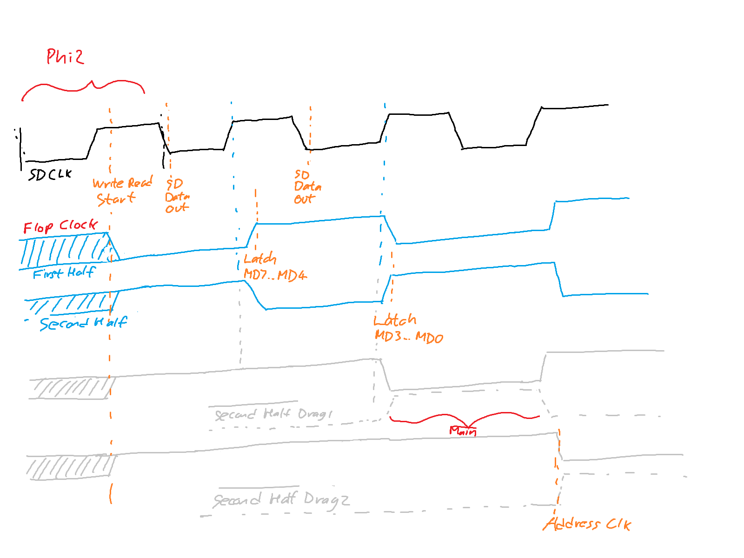
Pictures/SD Card/SD Card Read Timing.png
