andrewpaterson/658-Computer/Pictures/Small Signal Delay/Pic1 Schematic.png

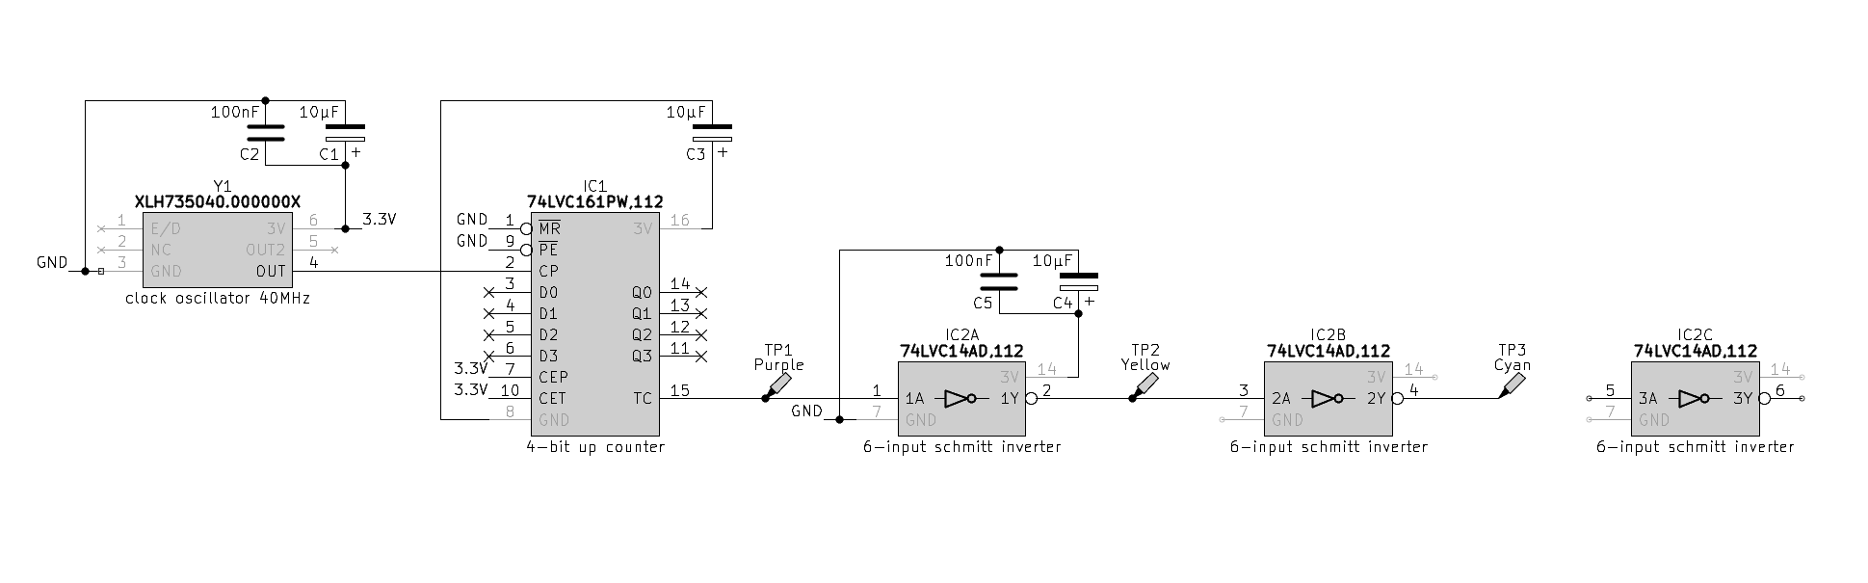
Pictures/Small Signal Delay/Pic1 Schematic.png
