andrewpaterson/658-Computer/Pictures/Small Signal Delay/Pic1 Trace.jpg

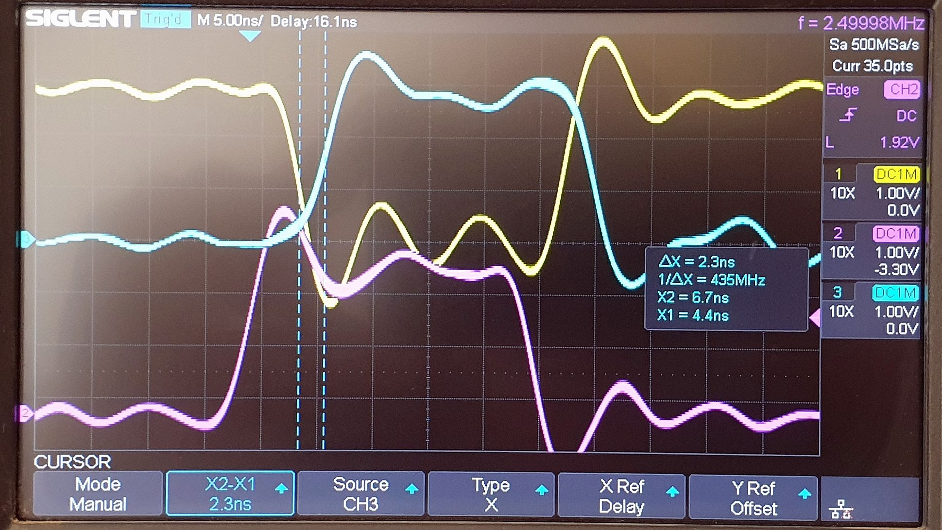
Pictures/Small Signal Delay/Pic1 Trace.jpg
