andrewpaterson/658-Computer/Pictures/Small Signal Delay/Pic2 Trace.jpg

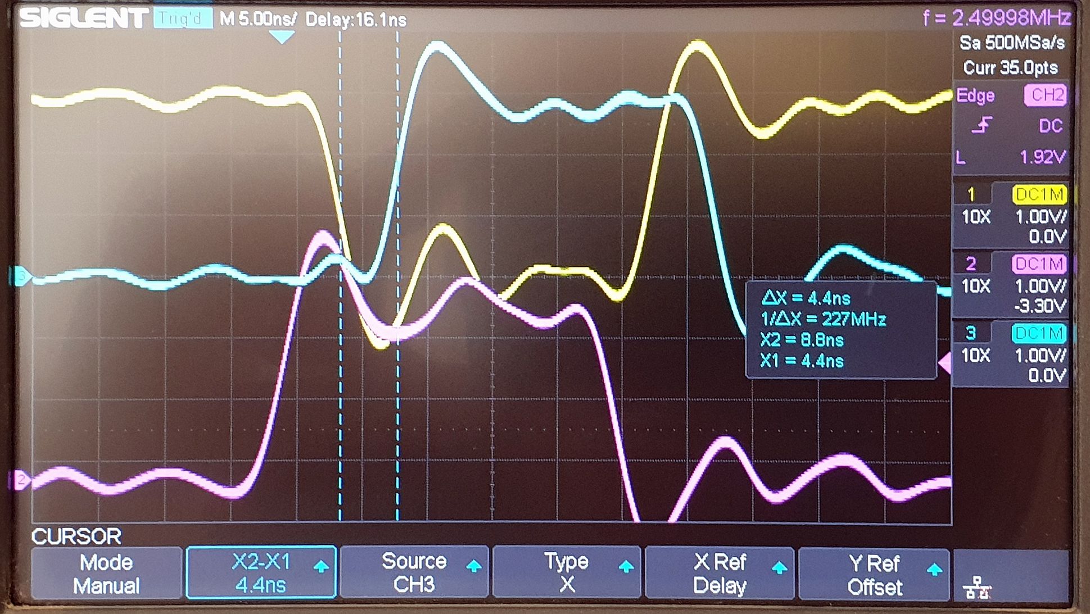
Pictures/Small Signal Delay/Pic2 Trace.jpg
