andrewpaterson/658-Computer/Pictures/Small Signal Delay/Pic3 Trace.jpg

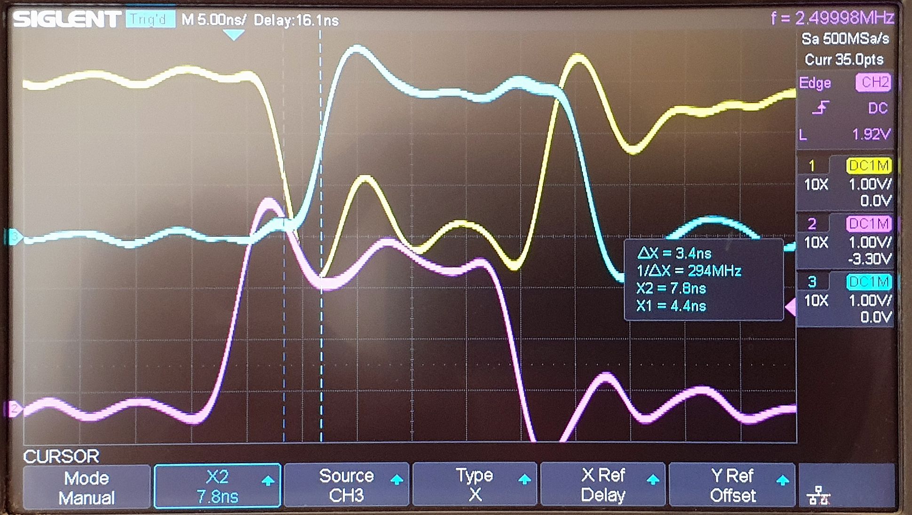
Pictures/Small Signal Delay/Pic3 Trace.jpg
