andrewpaterson/658-Computer/Pictures/Small Signal Delay/Pic4 Trace.jpg

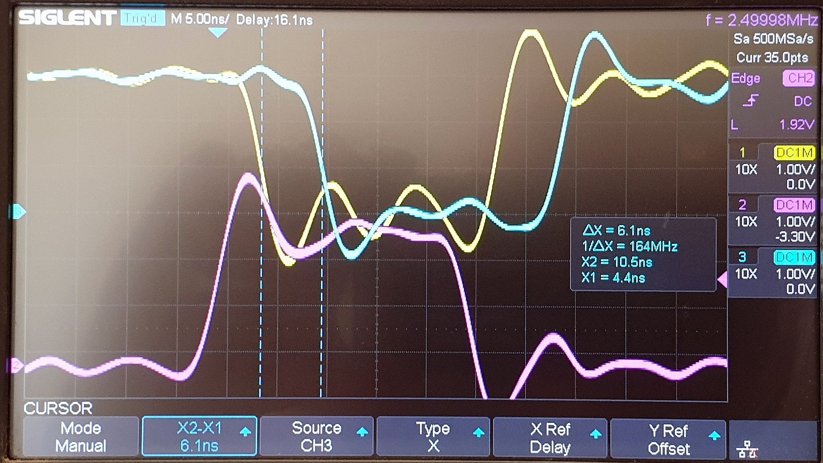
Pictures/Small Signal Delay/Pic4 Trace.jpg
