andrewpaterson/658-Computer/Pictures/Small Signal Delay/Pic5 Trace.jpg

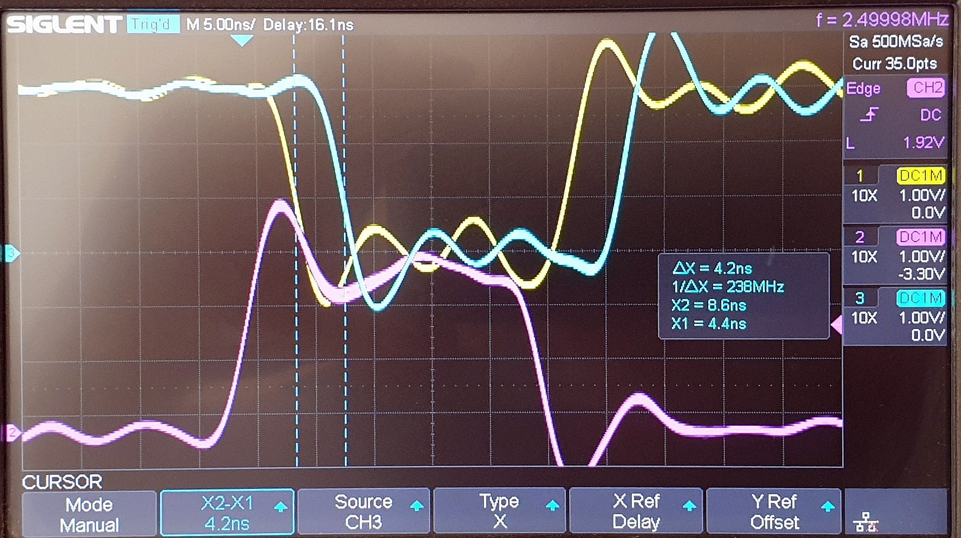
Pictures/Small Signal Delay/Pic5 Trace.jpg
