andrewpaterson/658-Computer/Pictures/Small Signal Delay/Pic6 Breadboard.jpg

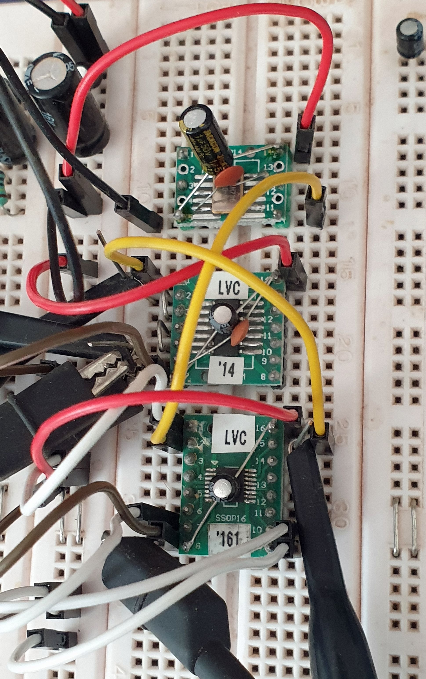
Pictures/Small Signal Delay/Pic6 Breadboard.jpg
