andrewpaterson/658-Computer/Pictures/Small Signal Delay/Pic7 Trace.jpg

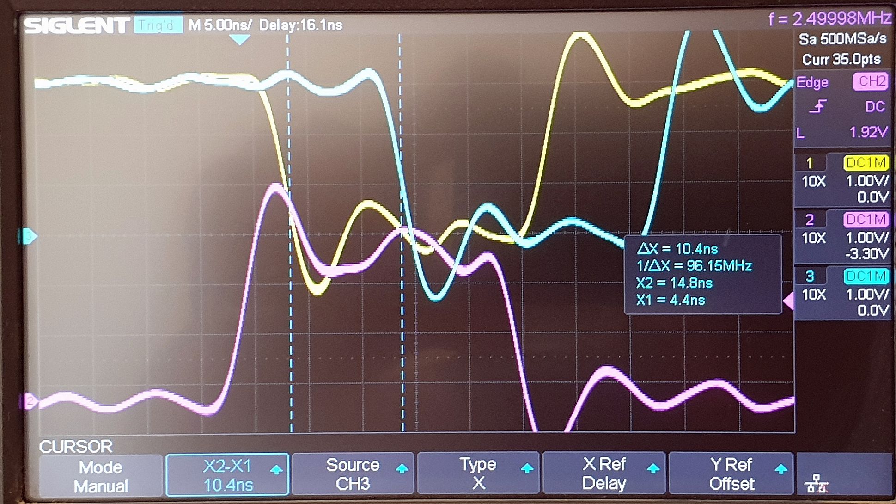
Pictures/Small Signal Delay/Pic7 Trace.jpg
