andrewpaterson/658-Computer/Pictures/SNES Controller.png

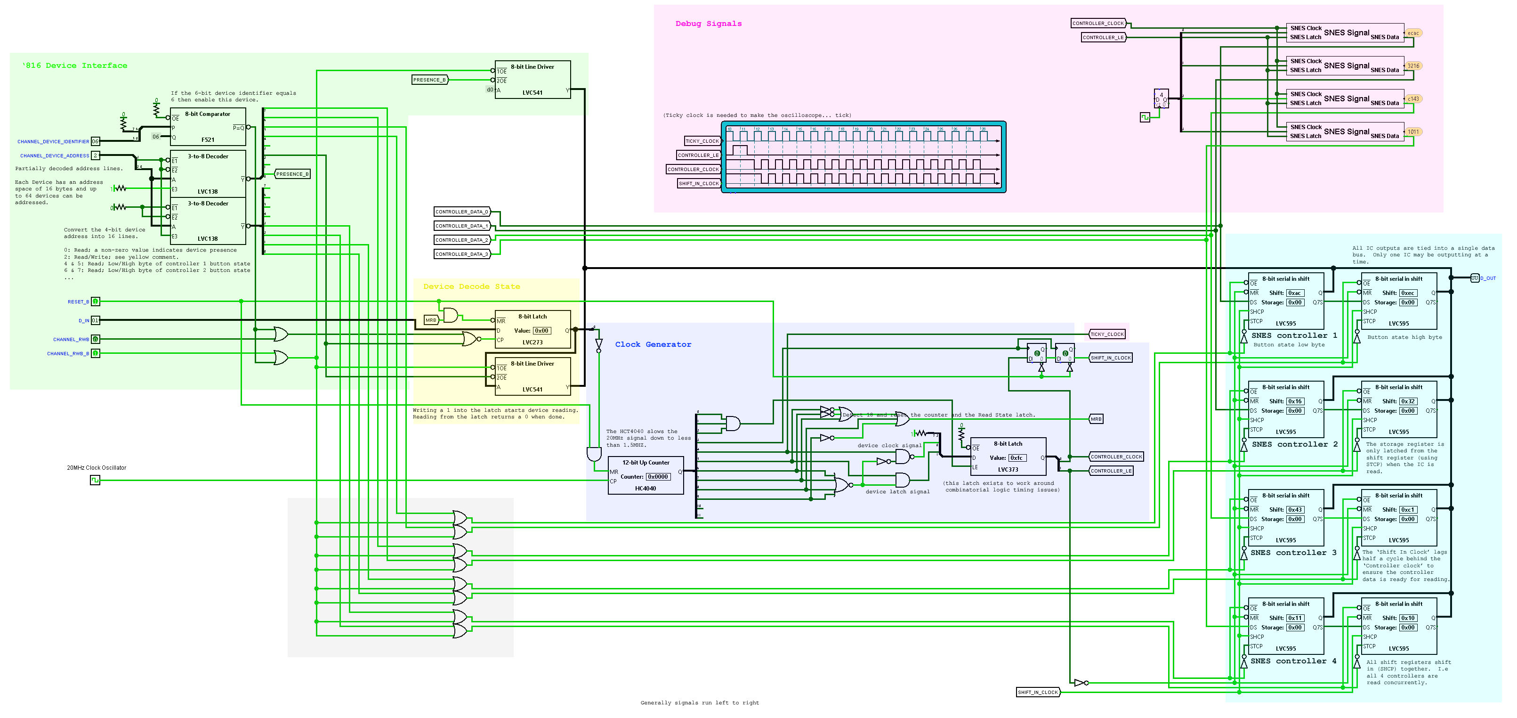
Pictures/SNES Controller.png
