andrewpaterson/658-Computer/Pictures/SO MANY FIFOS.png

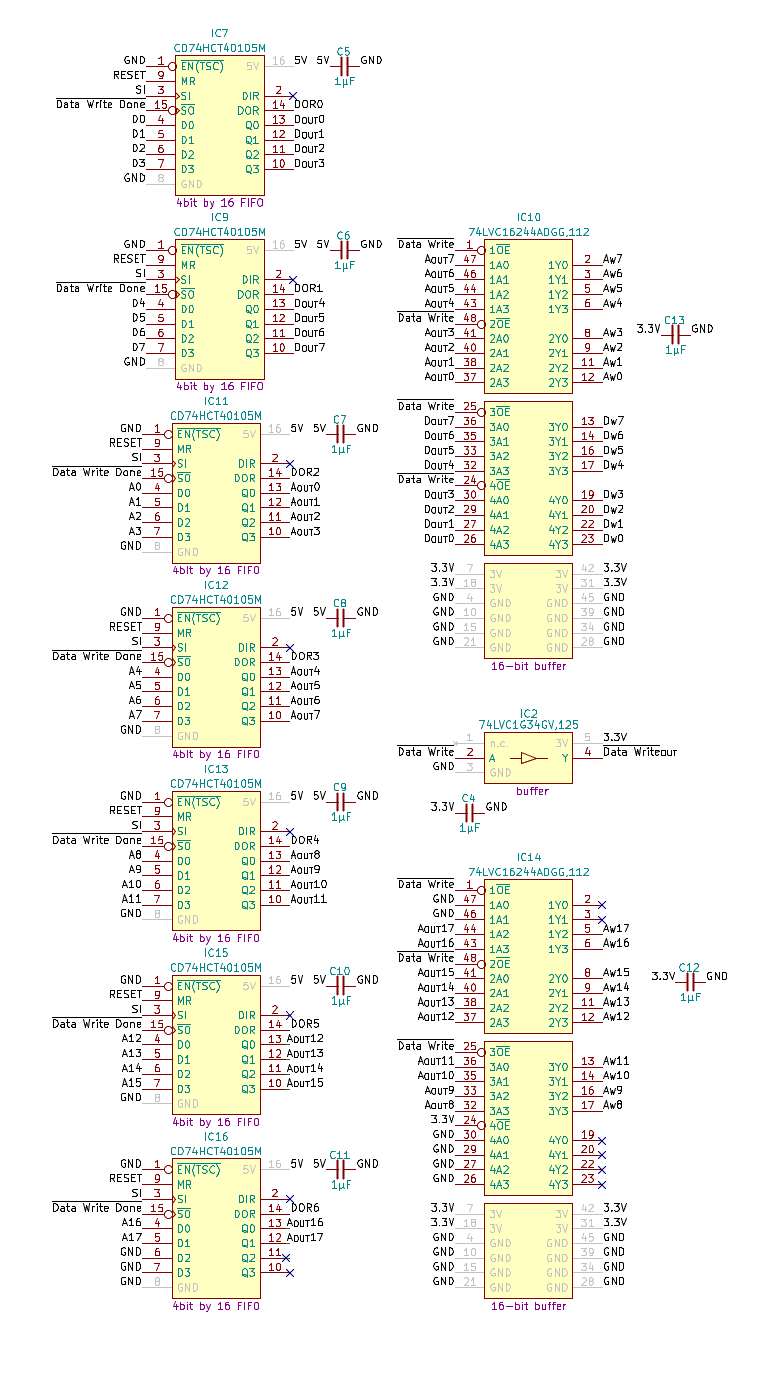
Pictures/SO MANY FIFOS.png
