andrewpaterson/658-Computer/Pictures/Sound Buffer Device.jpg

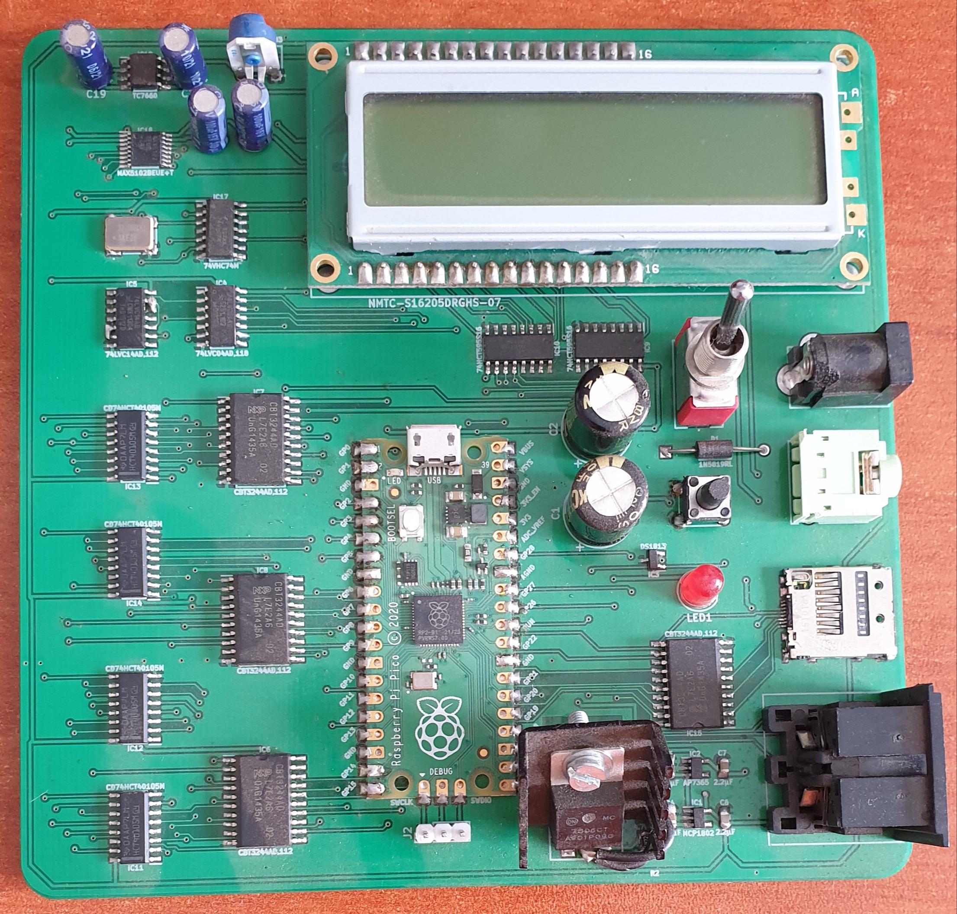
Pictures/Sound Buffer Device.jpg
