andrewpaterson/658-Computer/Pictures/Sprite Stretching 1.png

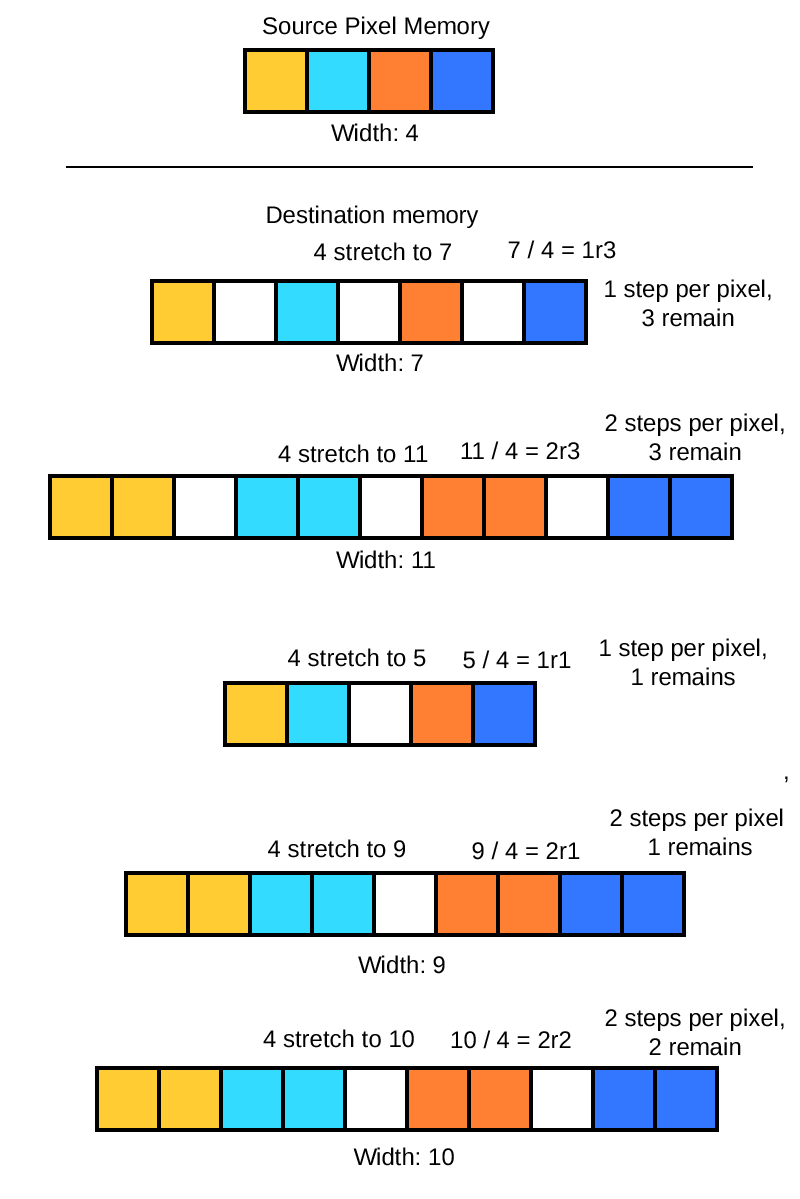
Pictures/Sprite Stretching 1.png
