andrewpaterson/658-Computer/Pictures/Sprite Stretching 2.png

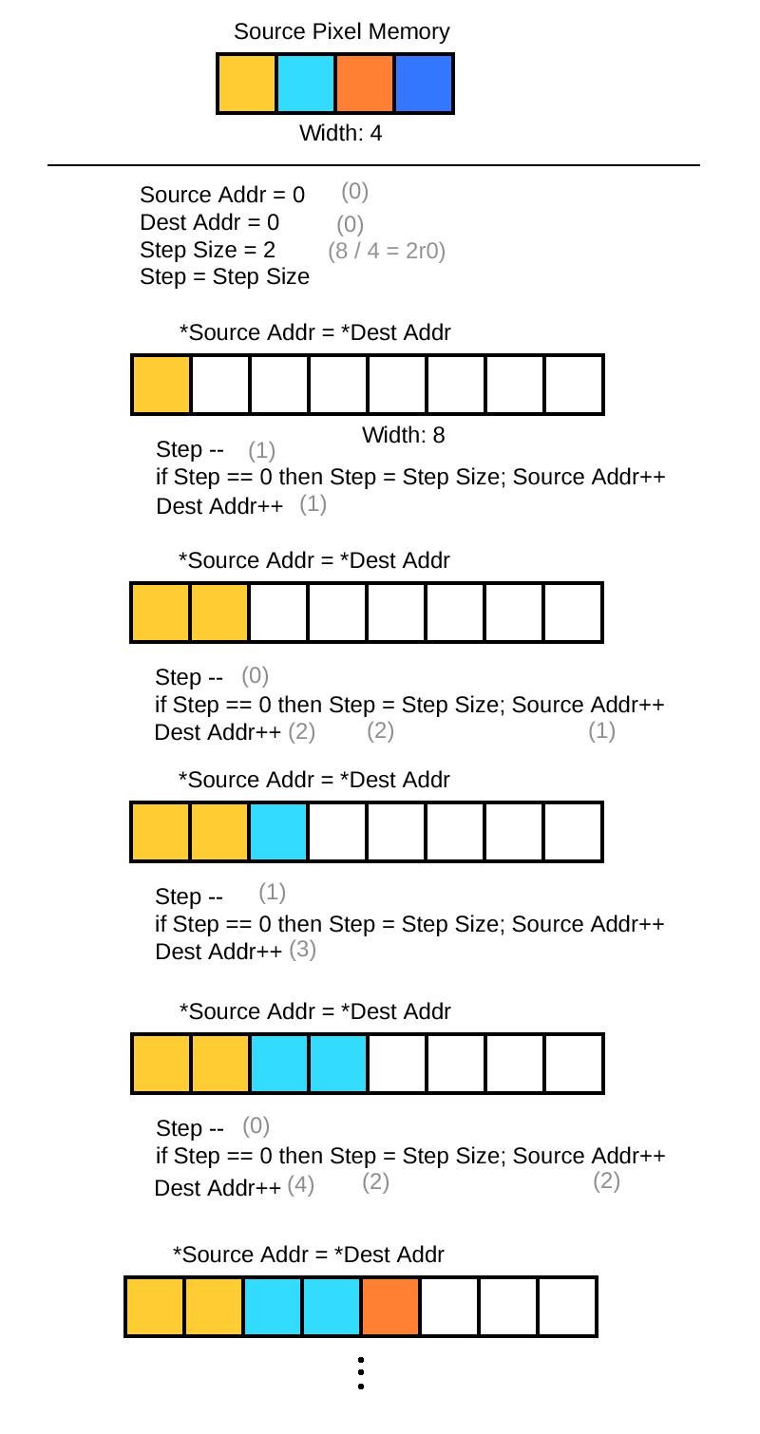
Pictures/Sprite Stretching 2.png
