andrewpaterson/658-Computer/Pictures/Sprite Stretching 3.png

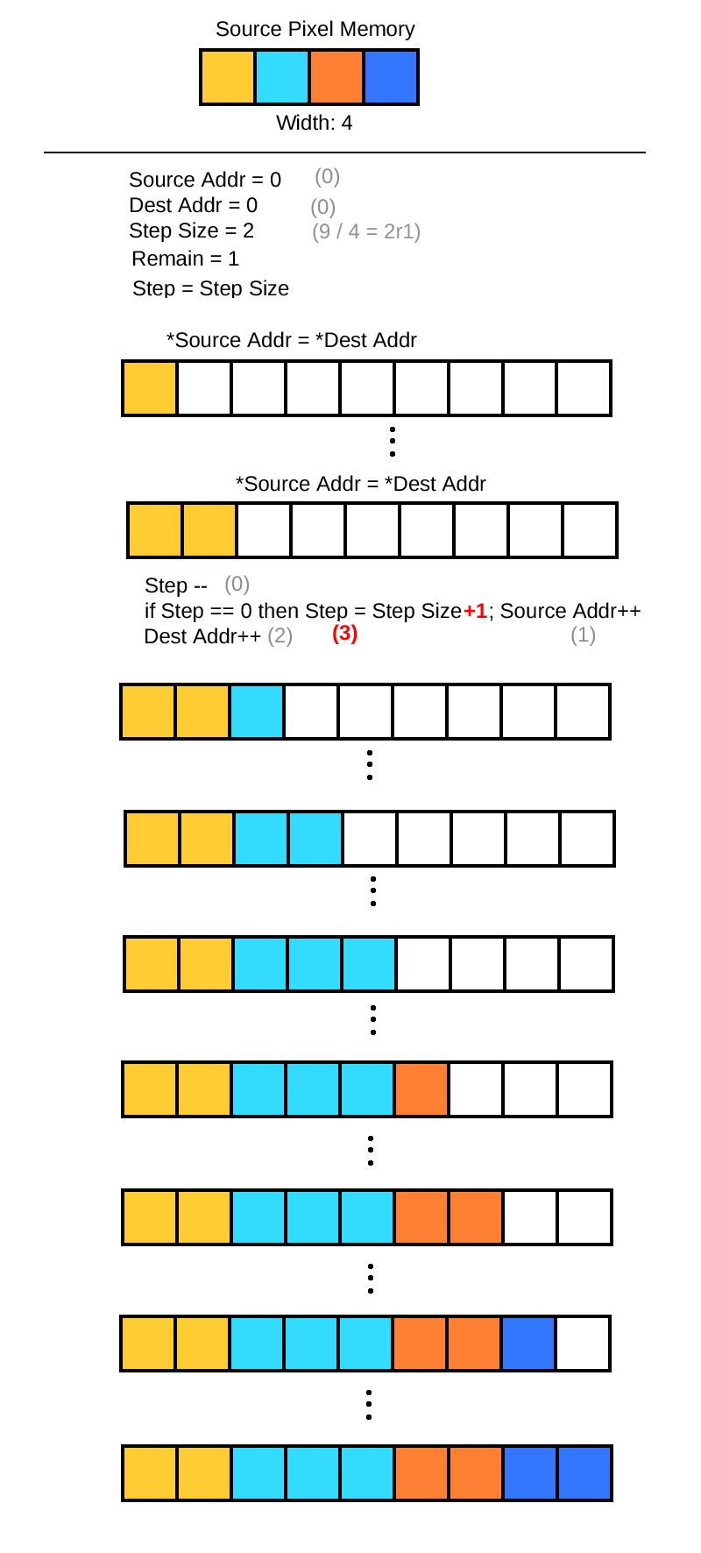
Pictures/Sprite Stretching 3.png
