andrewpaterson/658-Computer/Pictures/Sprite Stretching 5.png

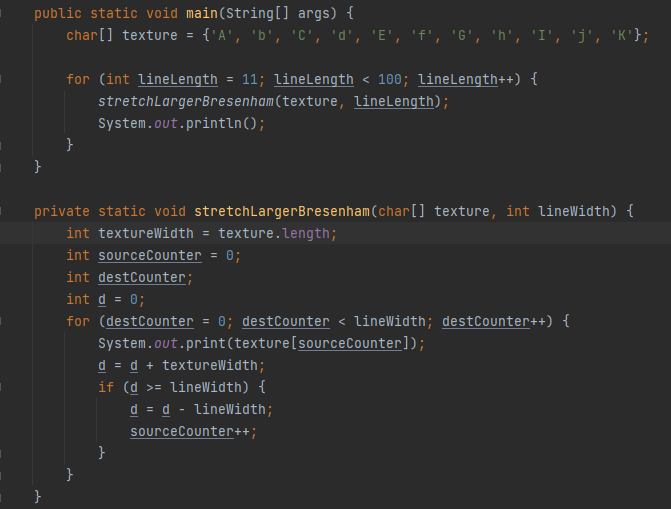
Pictures/Sprite Stretching 5.png
