andrewpaterson/658-Computer/Pictures/Sprite Stretching 7.png

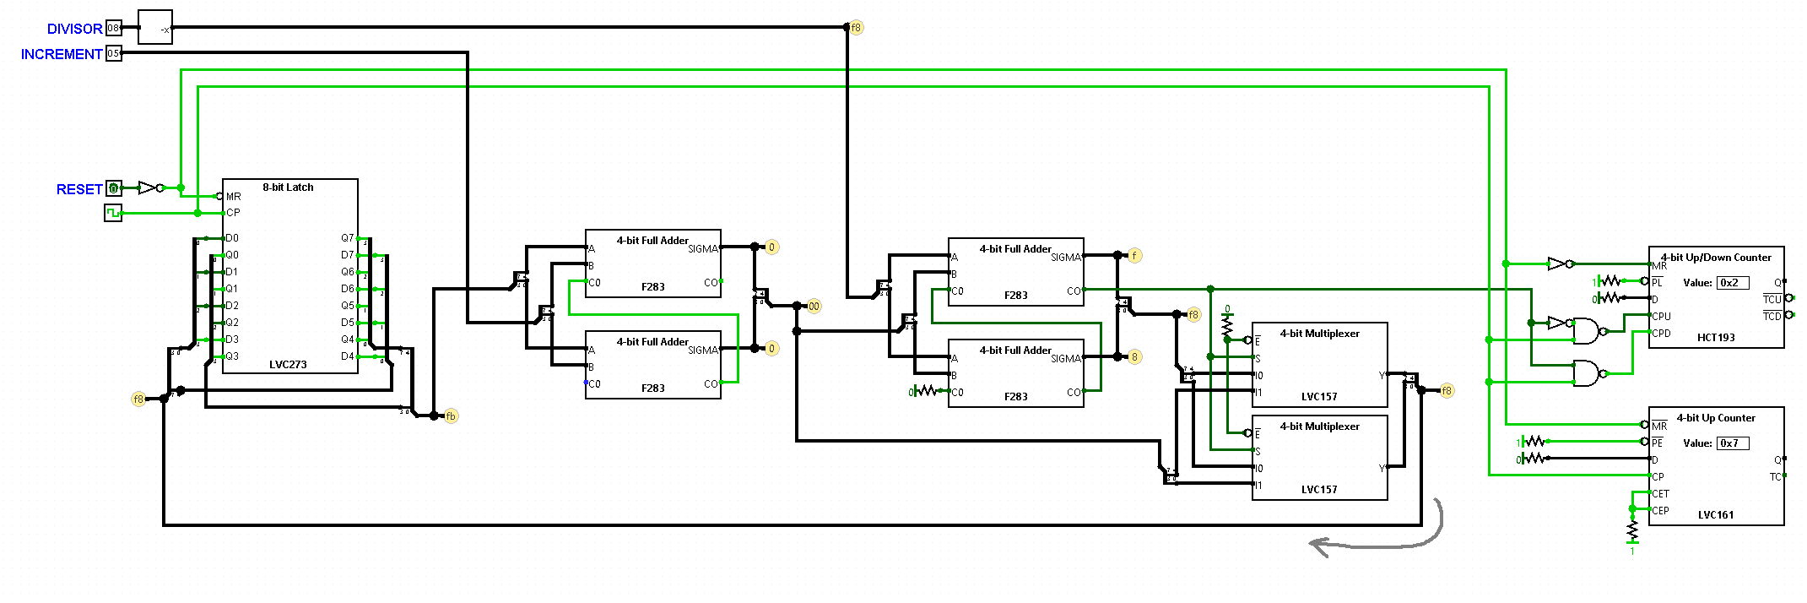
Pictures/Sprite Stretching 7.png
