andrewpaterson/658-Computer/Pictures/Sprite Stretching 8.png

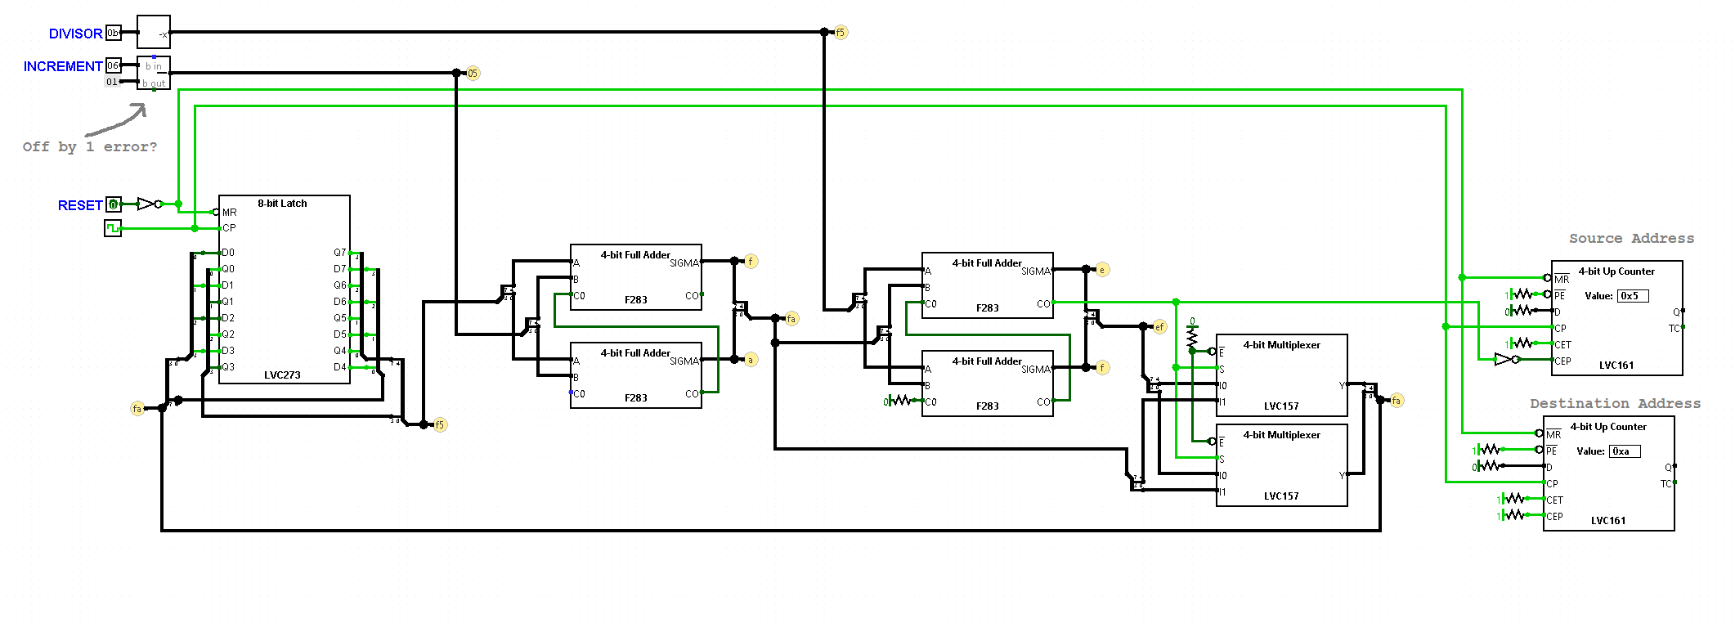
Pictures/Sprite Stretching 8.png
