andrewpaterson/658-Computer/Pictures/Sprite Stretching 9.png

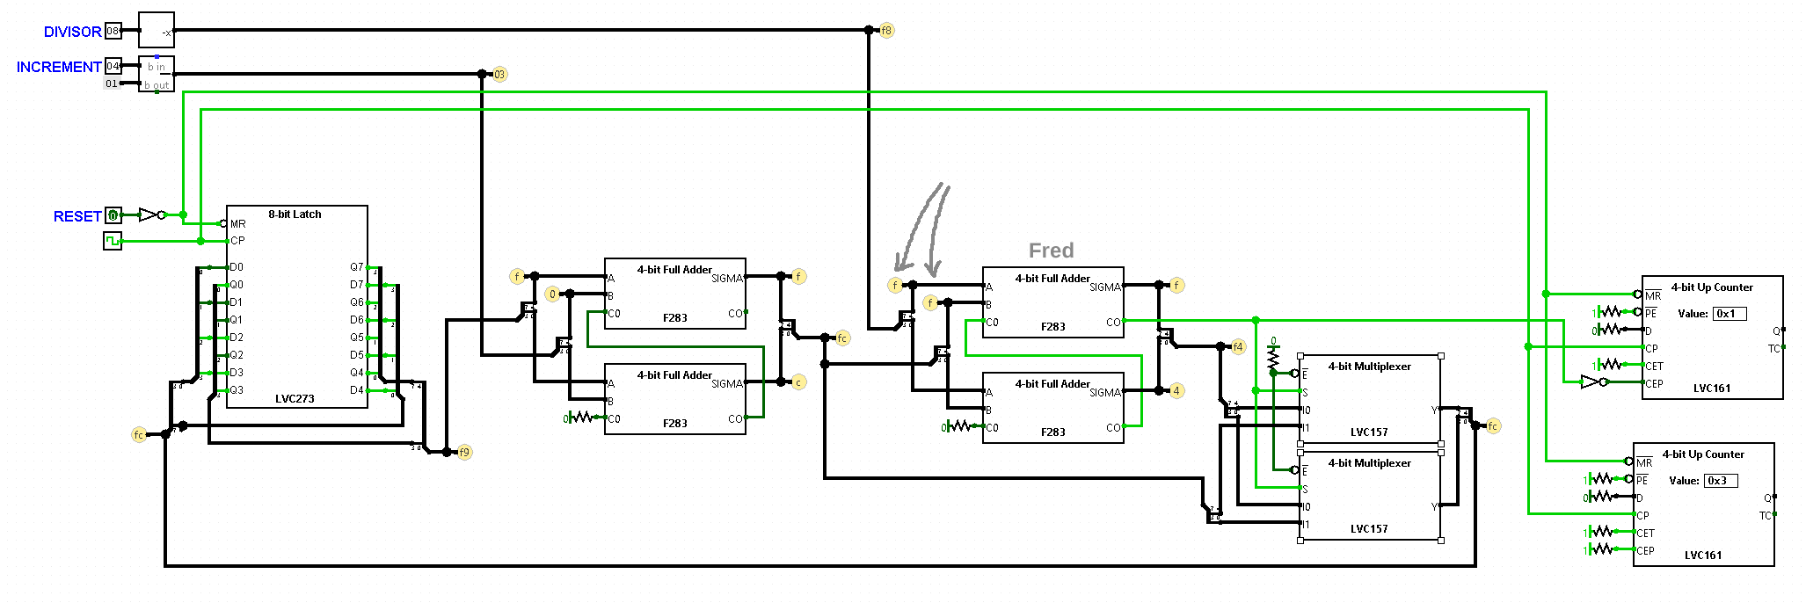
Pictures/Sprite Stretching 9.png
