andrewpaterson/658-Computer/Pictures/Sprite Stretching A.png

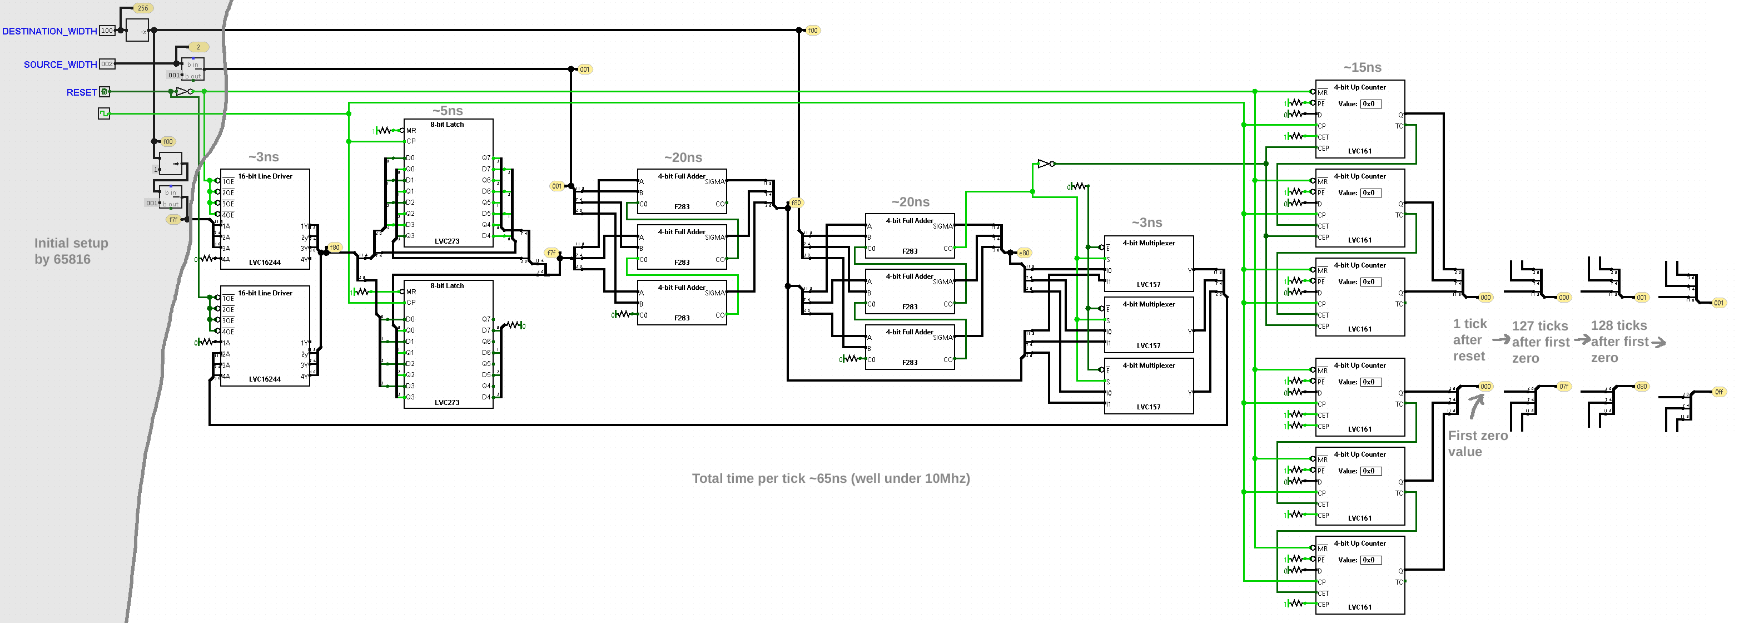
Pictures/Sprite Stretching A.png
