andrewpaterson/658-Computer/Pictures/Sprite Stretching B.png

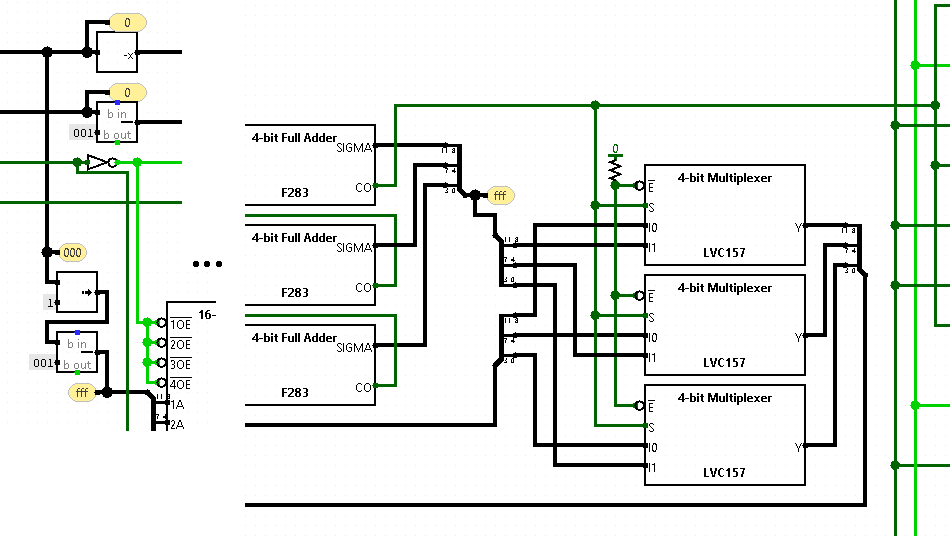
Pictures/Sprite Stretching B.png
