andrewpaterson/658-Computer/Pictures/Sprite Stretching C.png

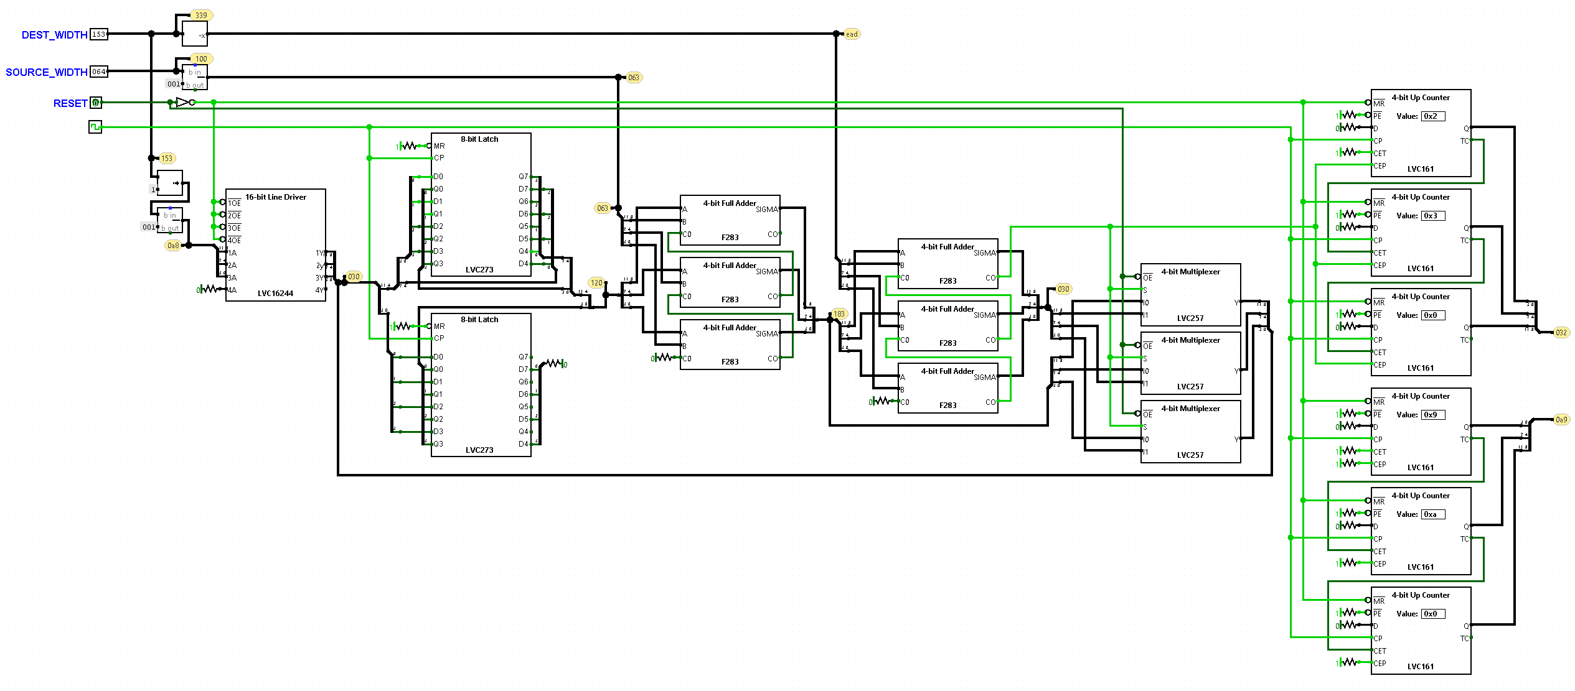
Pictures/Sprite Stretching C.png
