andrewpaterson/658-Computer/Pictures/Stripboard.jpg

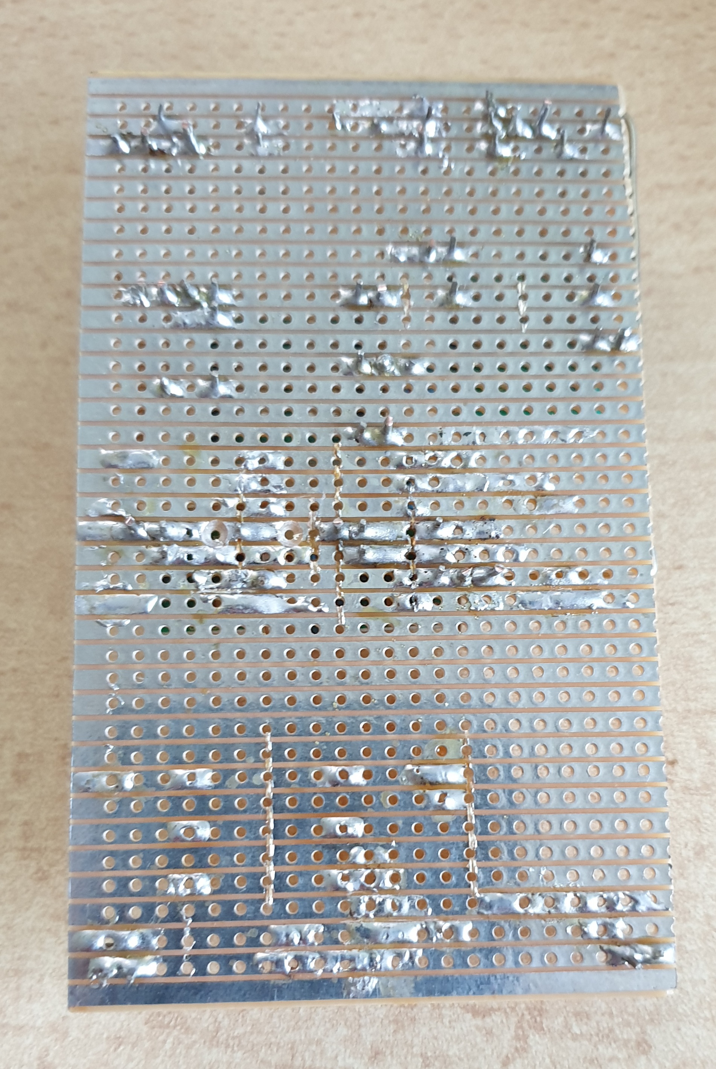
Pictures/Stripboard.jpg
