andrewpaterson/658-Computer/Pictures/Timing.png

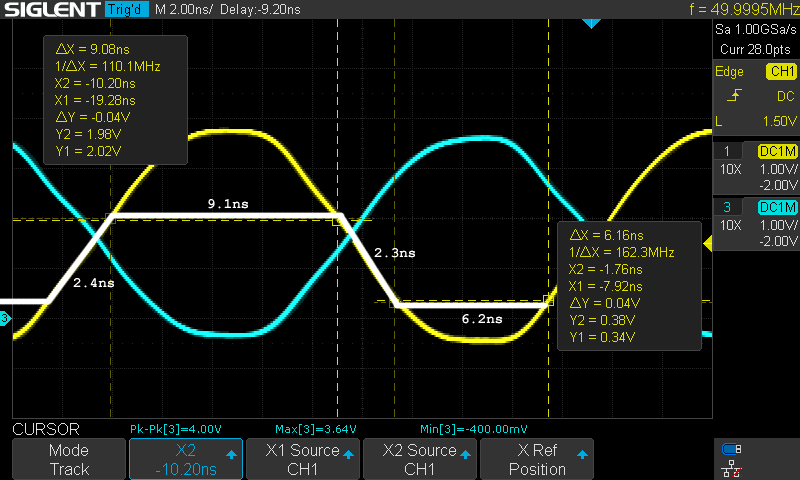
Pictures/Timing.png
