andrewpaterson/658-Computer/Pictures/Tomb Raider 512x384.png

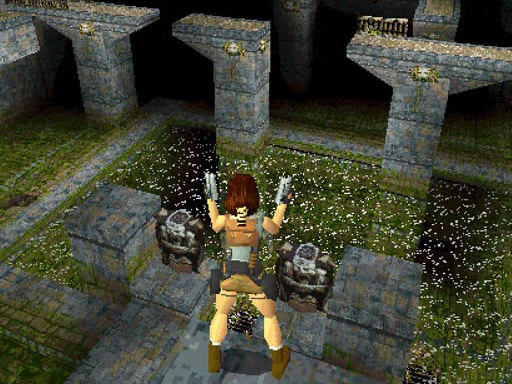
Pictures/Tomb Raider 512x384.png
