andrewpaterson/658-Computer/Pictures/USB Blasters.jpg

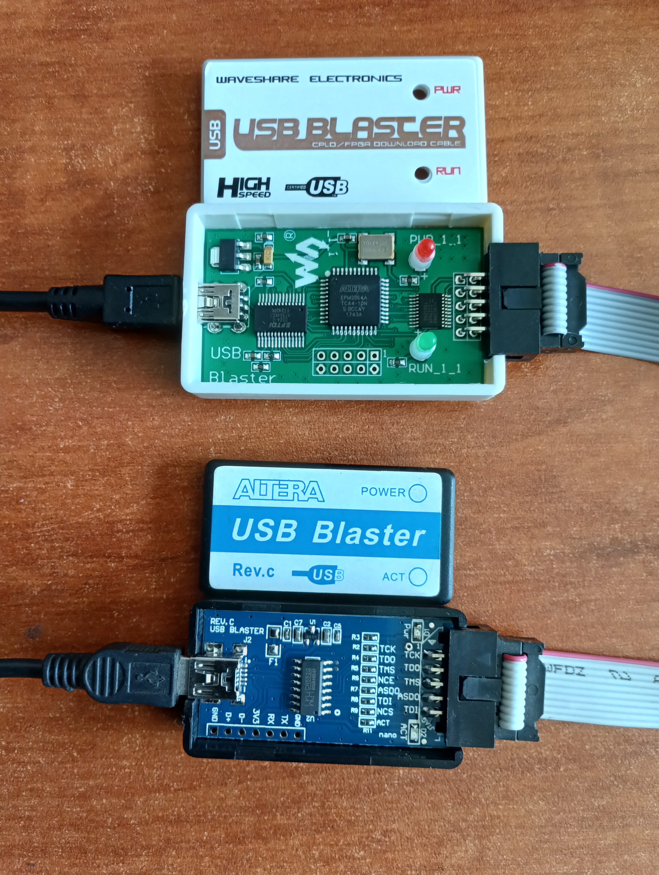
Pictures/USB Blasters.jpg
