andrewpaterson/658-Computer/Pictures/Video Card/Memory Front Copper.png

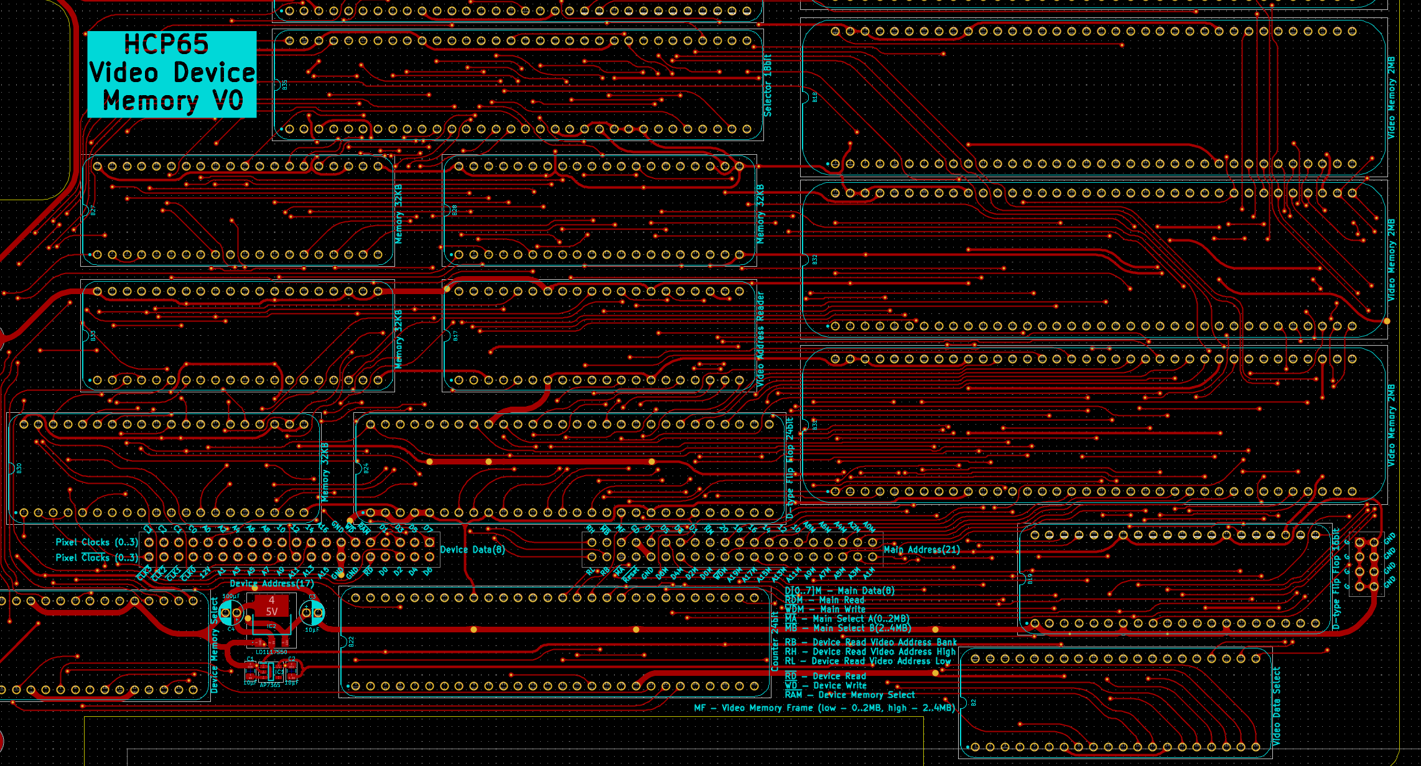
Pictures/Video Card/Memory Front Copper.png
