andrewpaterson/658-Computer/Pictures/Video Card/Memory Render.png

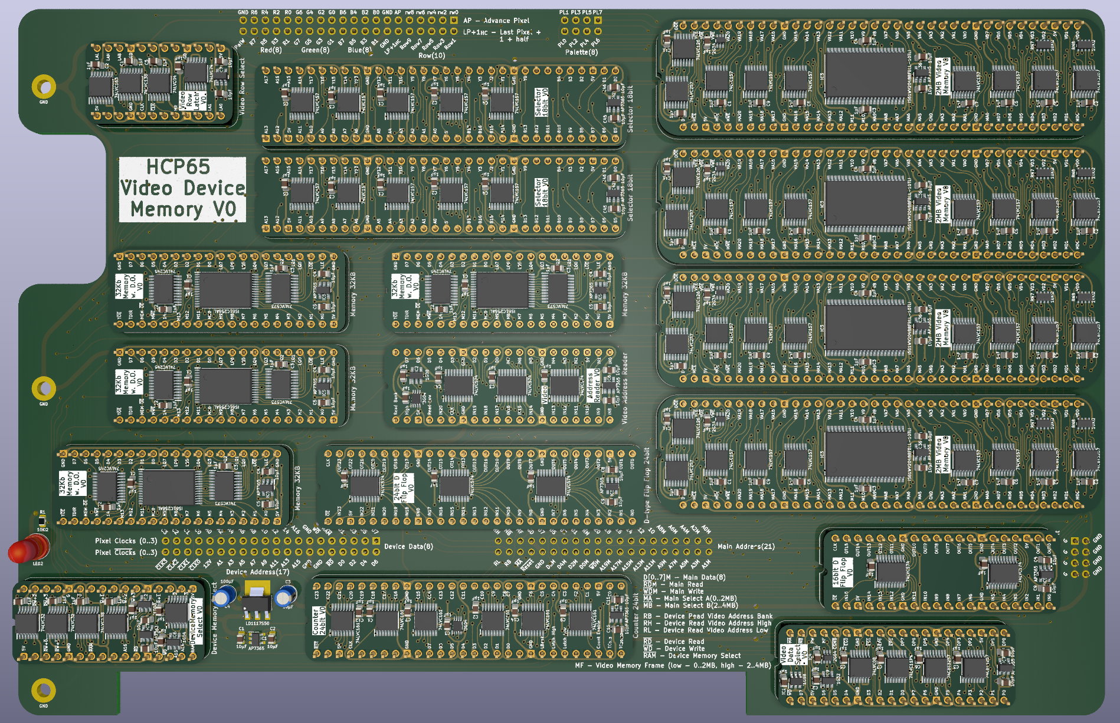
Pictures/Video Card/Memory Render.png
