andrewpaterson/658-Computer/Pictures/Video Card/Signals Front Copper.png

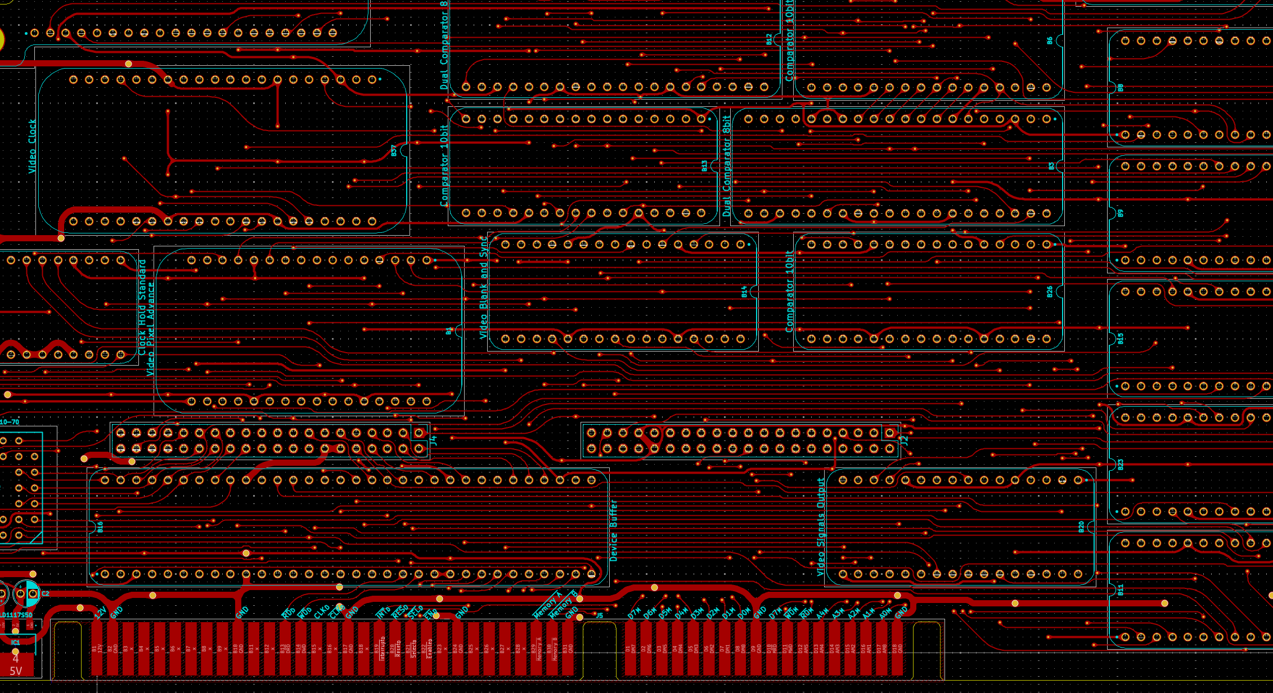
Pictures/Video Card/Signals Front Copper.png
