andrewpaterson/658-Computer/Pictures/Video Card/Signals Render.png

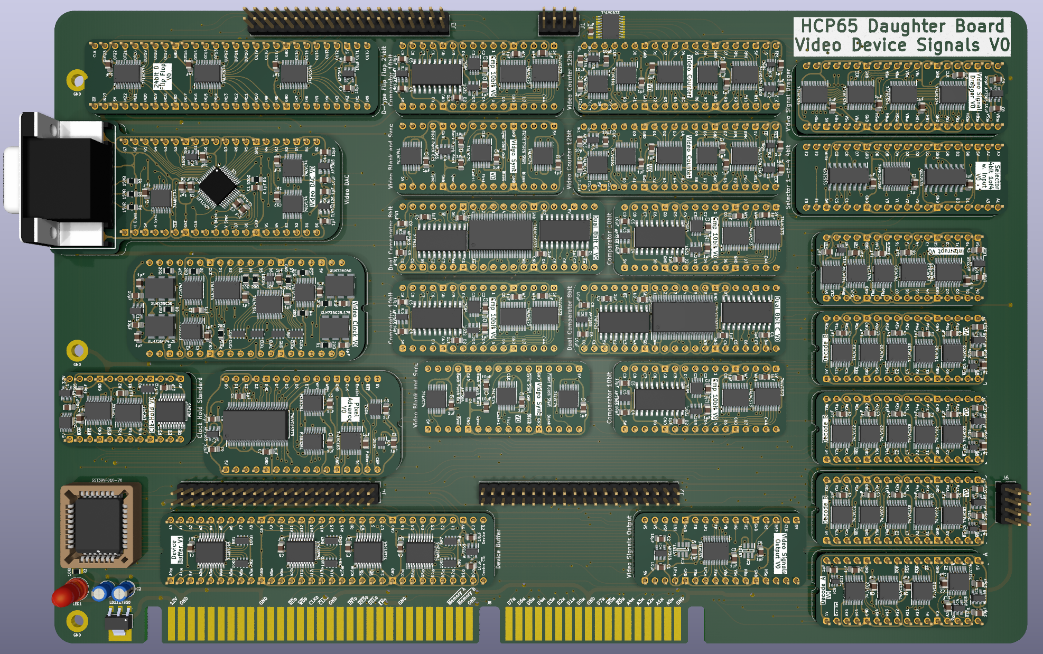
Pictures/Video Card/Signals Render.png
