andrewpaterson/658-Computer/Pictures/Video Write Waiting.png

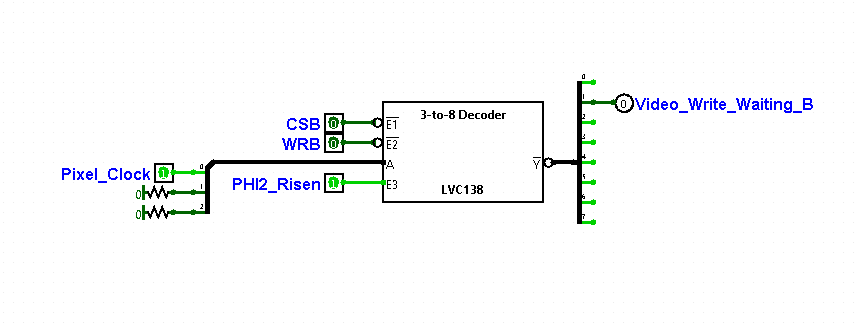
Pictures/Video Write Waiting.png
