andrewpaterson/658-Computer/Pictures/W65C51 Status Register.png

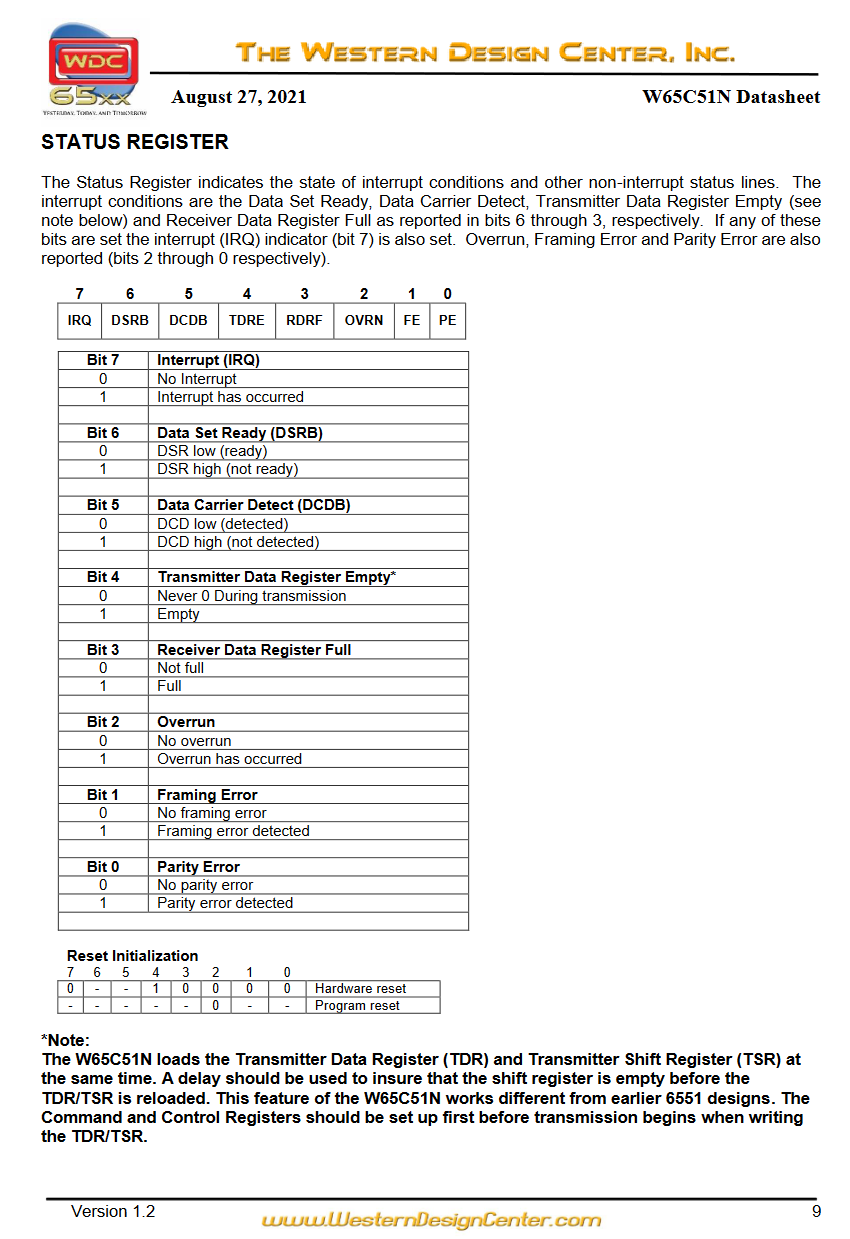
Pictures/W65C51 Status Register.png
