andrewpaterson/658-Computer/Pictures/W65C134.png

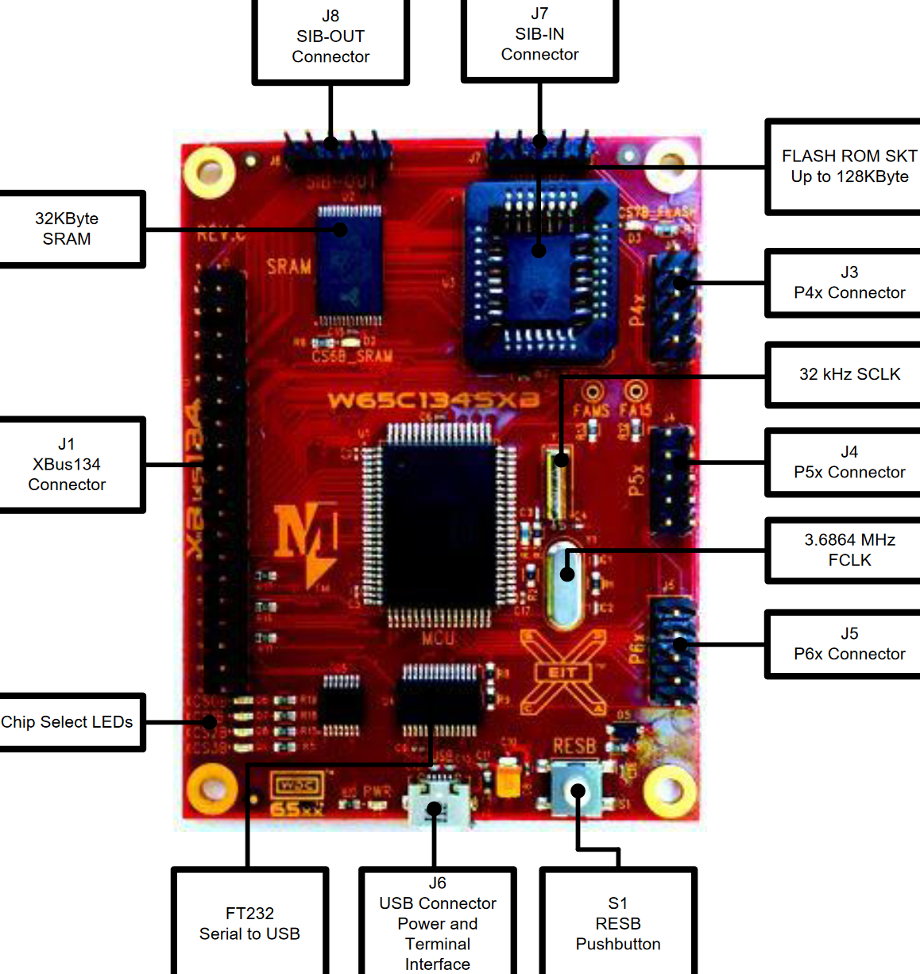
Pictures/W65C134.png
