andrewpaterson/658-Computer/Pictures/W65C265.png

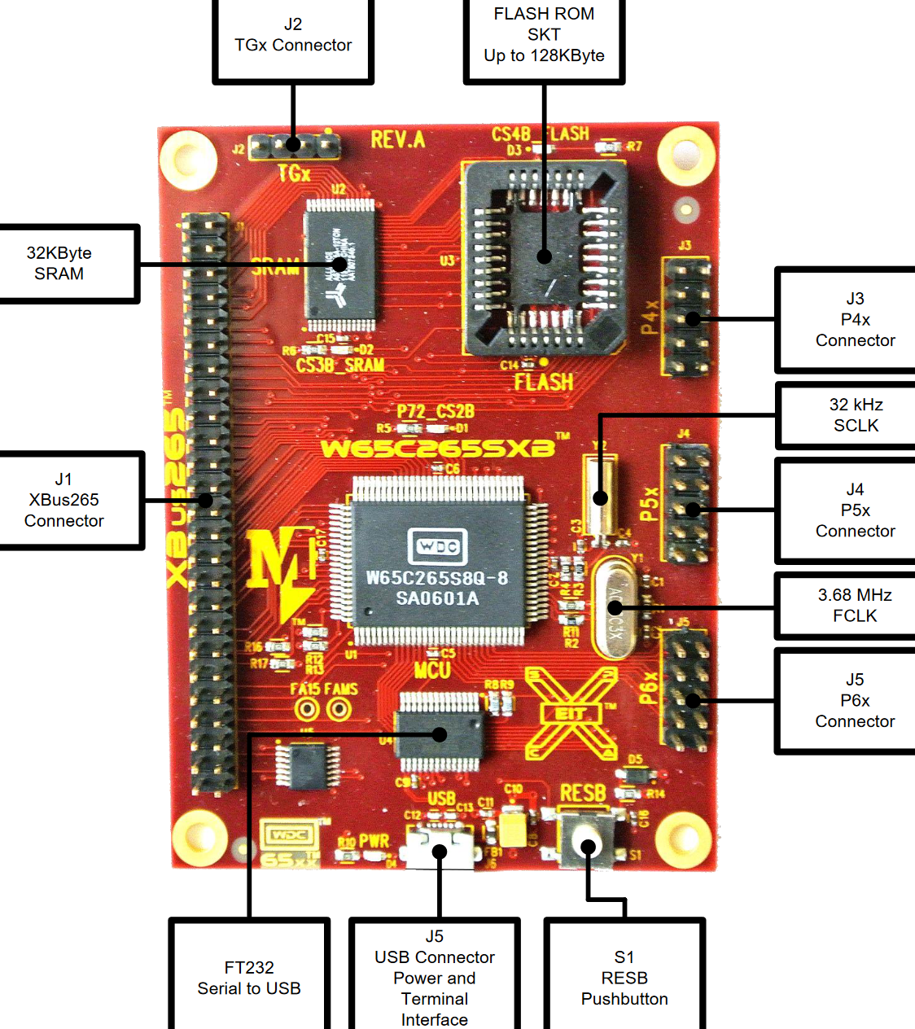
Pictures/W65C265.png
