andrewpaterson/658-Computer/Pictures/W65C816S Footprint.png

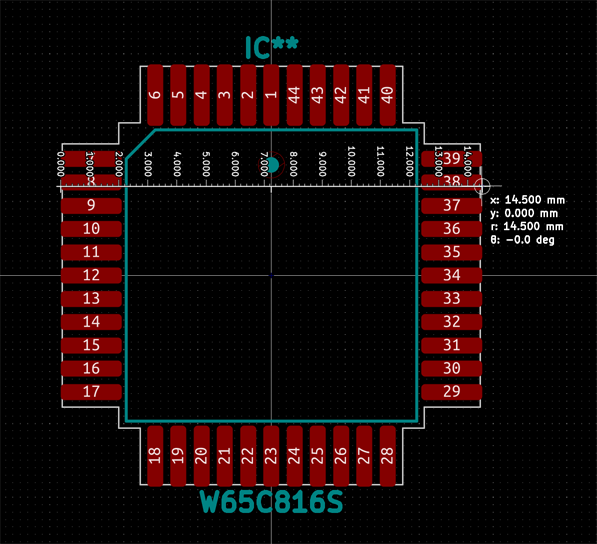
Pictures/W65C816S Footprint.png
