andrewpaterson/658-Computer/Pictures/Zener Protection.png

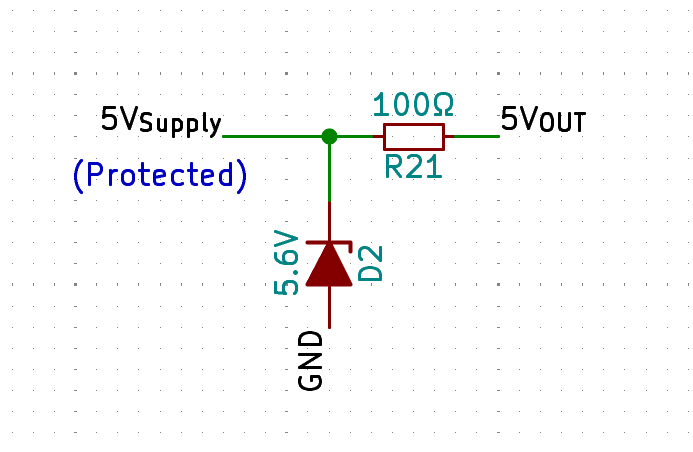
Pictures/Zener Protection.png
