andrewpaterson/658-Computer/W65C64/Addressing Modes.png

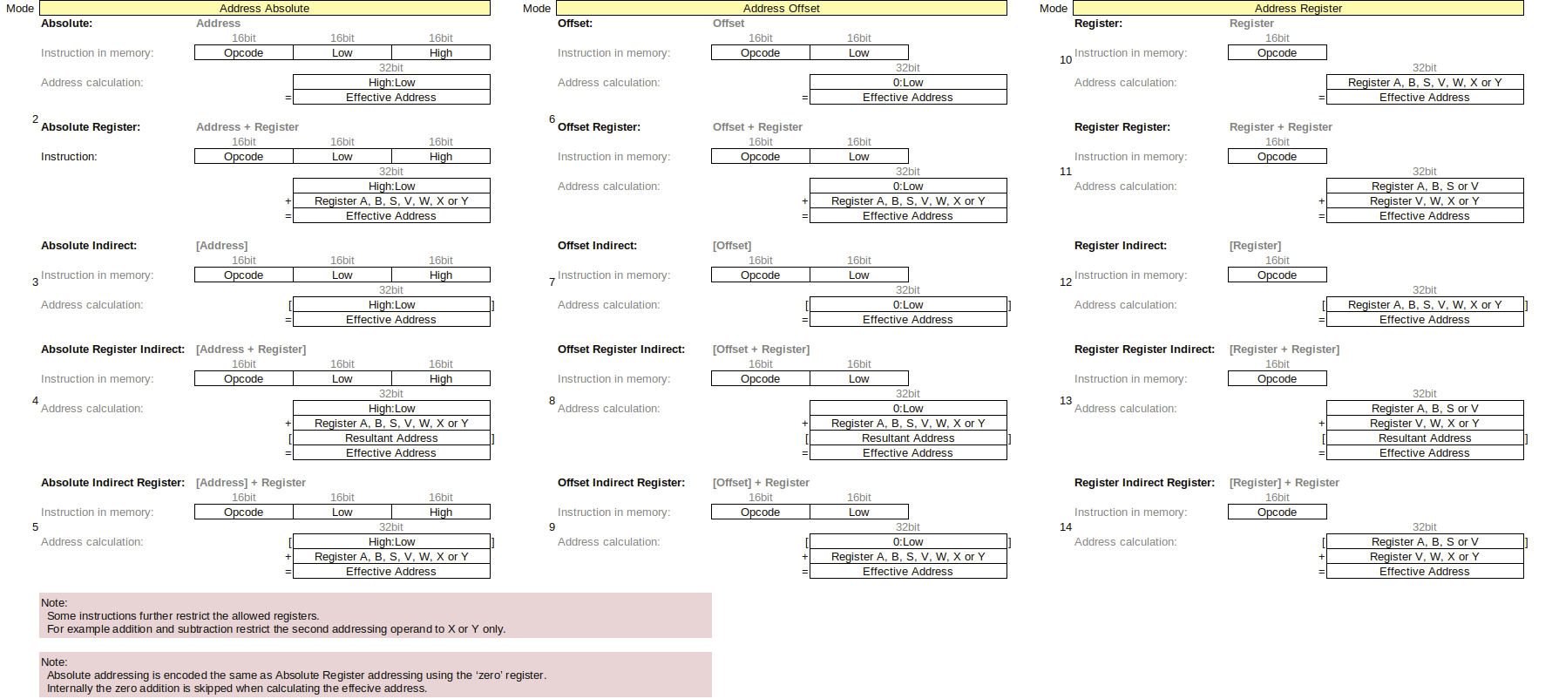
W65C64/Addressing Modes.png
