andrewpaterson/658-Computer/W65C64/Opcode Encoding.png

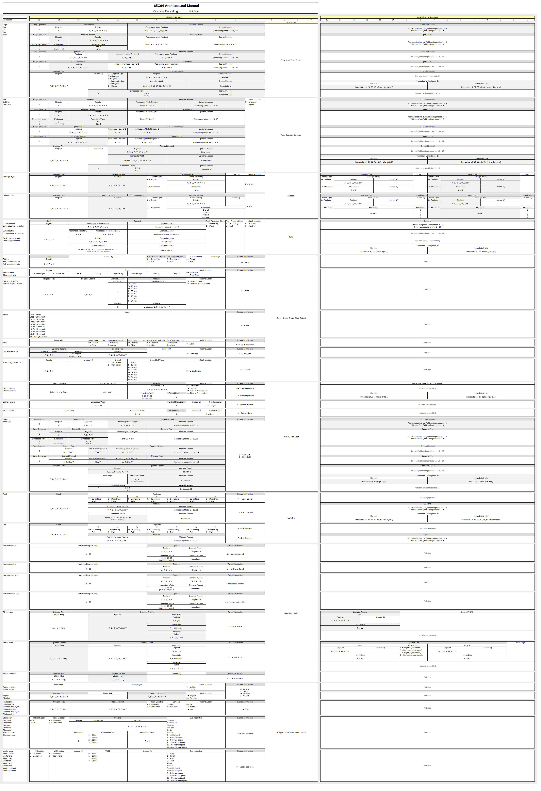
W65C64/Opcode Encoding.png
