andrewpaterson/658-Computer/W65C64/Operand Mode Encoding.png

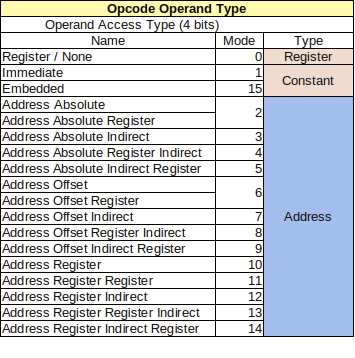
W65C64/Operand Mode Encoding.png
