andrewpaterson/658-Computer/W65C64/Partial Multiplication.png

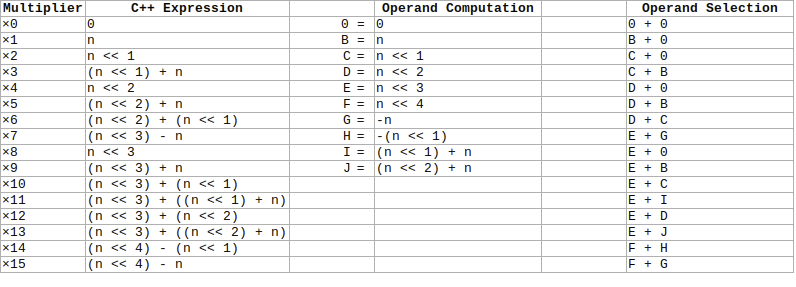
W65C64/Partial Multiplication.png
