andrewpaterson/658-Computer/W65C64/Registers.png

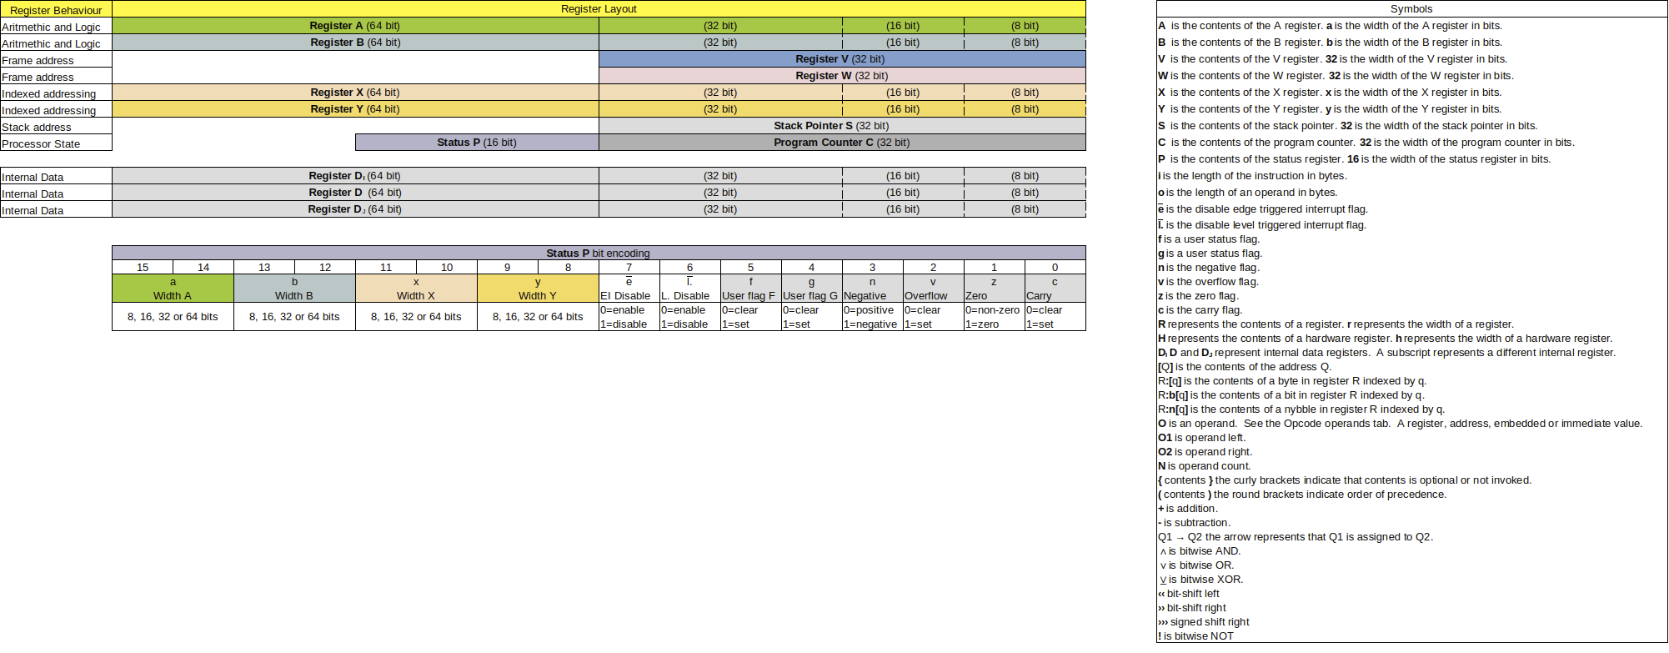
W65C64/Registers.png
