andrewpaterson/658-Computer/W65C64/System Block Diagram.png

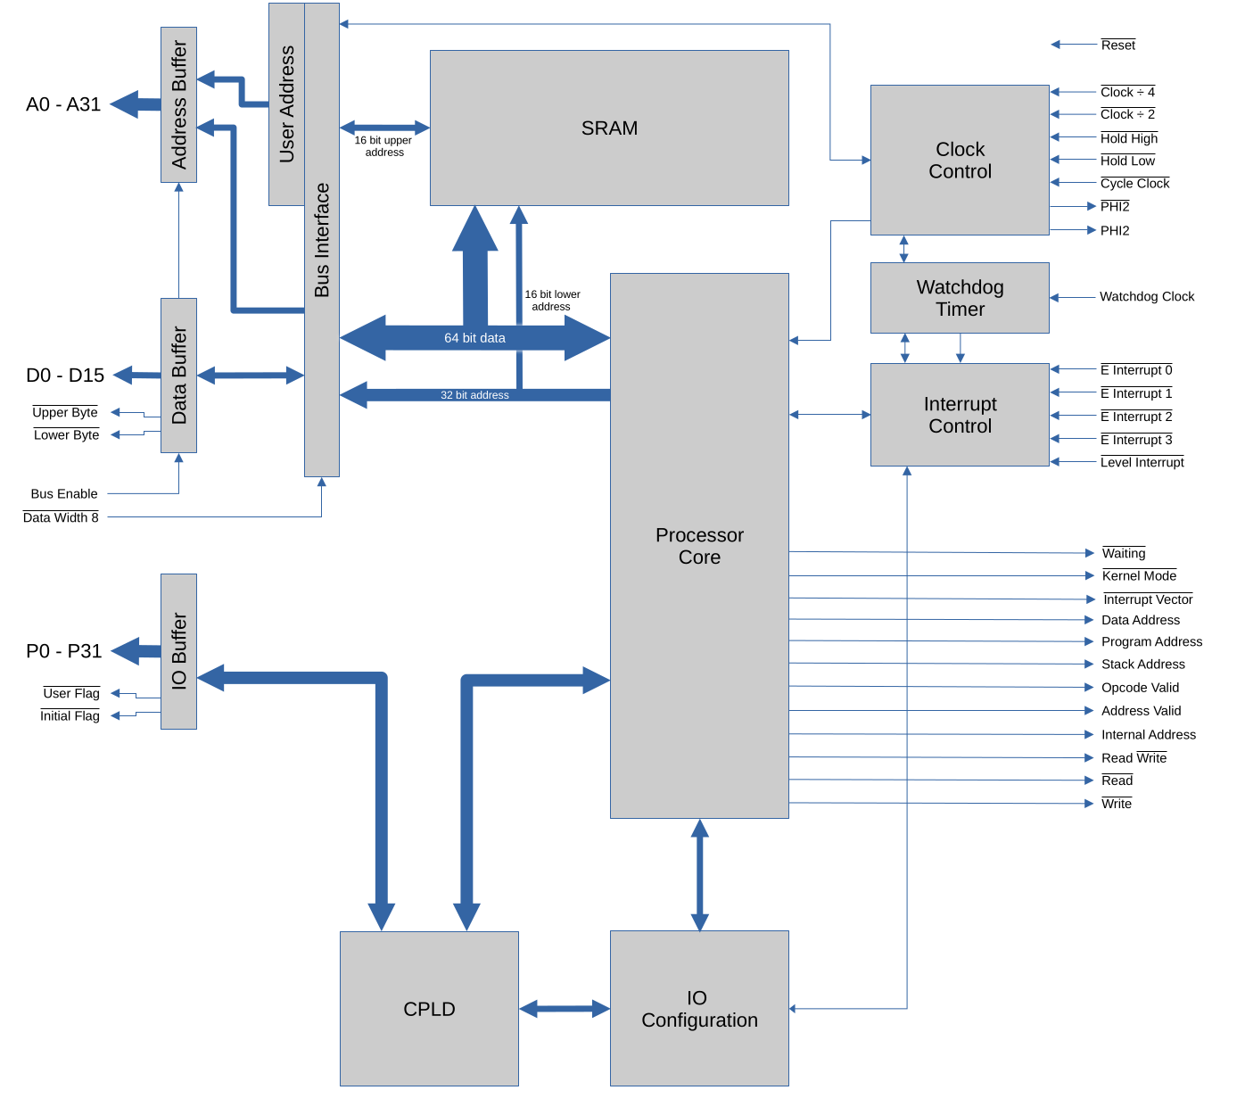
W65C64/System Block Diagram.png
