andrewpaterson/658-Computer/Apple II/Apple II BOM.ods

PART | QUANITTY | Andrew | VENDOR | PART # | COMMENT
2513 | 1 |  |  | GI RO3-2513 | char rom - GI RO3-2513 CGR-001
8T28 | 2 | On Order | UNICORN | 8T28 | transciever(MC6889)
555 | 1 | Hundreds | UNICORN | NE555N | timer
741 | 1 | On Order | UNICORN | LM741N | opamp
74LS00 | 1 |  | UNICORN | 74LS00 | nand gate
74LS02 | 2 | On Order | UNICORN | 74LS02 | nor gate
74LS04 | 1 | 10 | UNICORN | 74LS04 | hex inverter
74LS08 | 2 | On Order | UNICORN | 74LS08 | quad and gate
74LS11 | 1 |  | UNICORN | 74LS11 | 3 input and gate
74LS139 | 2 | On Order | UNICORN | 74LS139 | dual 2-4 decoder
74LS151 | 1 |  | UNICORN | 74LS151 | 8-1 mux
74LS161 | 4 | On Order | UNICORN | 74LS161 | 4 bit counter
74LS174 | 2 | On Order | UNICORN | 74LS174 | HEX d Flip flop
74LS20 | 1 | Hundreds | UNICORN | 74LS20 | dual 4 input NAND gate 296-3669-2-ND
74LS251 | 1 |  | UNICORN | 74LS251 | 8 input mux
74LS257 | 5 | On Order | UNICORN | 74LS257 | 2:1 mux
74LS32 | 1 |  | UNICORN | 74LS32 | quad 2 input or gate
74LS74 | 2 | On Order | UNICORN | 74LS74 | dual D- flip flop
mem sel hdr caps | 3 |  | Digikey | A106-ND | 14 pin cover
memory select headers | 3 |  | Digikey | A102AE-ND | 14 pin header
ROM | 6 | 10 |  |  | pull from scraped Apple Iis or ROM cards
6502 | 1 | On Order | UNICORN | 6502 | processor
74LS259 | 1 |  | UNICORN | 74LS259 | 74LS259(9334) - first version used 74LS259
4116 RAM | 24 | On Order | UNICORN | 4116 | 200ns or faster
74LS138 | 4 | On Order | UNICORN | 74LS138
74LS153 | 4 | On Order | UNICORN | 74LS153
74LS194 | 3 | On Order | UNICORN | 74LS194
74LS283 | 1 |  | UNICORN | 74LS283
74LS51 | 1 |  | UNICORN | 74LS51
74S175 | 1 |  | UNICORN | 74S175 | "S" type quad D- flip flop
558 | 1 | On Order | UNICORN | NE558N | NE558(quad timer)
74166 | 1 | On Order | UNICORN | 74166 | original 74XX series
74S195 | 1 | On Order | UNICORN | 74S195 | "S" type
74S86 | 1 | On Order | UNICORN | 74S86 | "S" type
8T97 | 3 | On Order | UNICORN | 8T97 | driver(Alt-MC6887)
16 pin socket | 63 | On Order | UNICORN | MT16 | machine pin for better reliability than original
14 pin socket | 15 | On Order | UNICORN | MT14
8 pin socket | 2 | On Order | UNICORN | MT8
24 pin socket | 7 | On Order | UNICORN | MT24
40 pin socket | 1 | On Order | UNICORN | MT40
AMP 640500-1 | 1 |  | Digikey | A14206-ND | power connector (only comes in red these days)
casette In/Out | 2 |  | Digikey | CP-3502N-ND | CUI- (I think originals were threaded, these are not)
video 4 pin header | 1 |  | UNICORN | COMH10 | MOLEX KK series - break off length
speaker header | 1 |  | UNICORN | COMH10 | MOLEX KK series - break off length
video jack | 1 |  | Digikey | 902K-ND | keystone #902
50 pin card edge | 8 | On Order |  | 345-050-524-202 | card edge sockets EDAC 345-050-524-202 (green) (395-xx is black)
GAME I/O | 1 |  |  |  | see sockets
keyboard | 1 |  |  |  | see sockets
2N4258 PNP transistor | 2 | On Order |  |  | 2N3906 works if 2n4258 not found
2n3904 transistor | 3 | On Order | UNICORN | 2N3904 | clock/video
MPSA13 darlington trans | 1 | On Order | UNICORN | MPSA13 | speaker
