andrewpaterson/658-Computer/W65C64/65C64 Instruction Architecture.xlsx

Sheet: Pinout
Pin number | Pin name | Electrical | W65C816 | Description
1 | A2 | Output, Hi-Z | A2 | A0 – A31: Address bus.
2 – 5 | A3 – A6 | Output, Hi-Z | A3 – A5
6 | VSS | Power |  | Processor ground voltage.
7 | A7 | Output, Hi-Z | A7
8 | A8 | Output, Hi-Z | A8
9 | VDD | Power |  | Processor positive voltage.
10 | A9 | Output, Hi-Z | A8 – A14
11 – 16 | A8 – A14 | Output, Hi-Z | A15
17 | VSS | Power
18 | A16 | Output, Hi-Z | BA0
19 | A17 | Output, Hi-Z | BA1
20 | VDD | Power
21 | A18 | Output, Hi-Z | BA2
22 – 30 | A19 – A27 | Output, Hi-Z | BA3 – BA7
31 | VSSIO | Power |  | Programmable IO ground voltage.
32 | A28 | Output, Hi-Z
33 | A29 | Output, Hi-Z
34 | VDDIO | Power
35 | A30 | Tri-state
36 | A31 | Tri-state
37 | P0 | Tri-state |  | P0 – P31: Programmable IO pins.
38 – 45 | P1 – P8 | Tri-state
46 | VDD | Power
47 | P9 | Tri-state
48 | P10 | Tri-state
49 | VSS | Power
50 | P11 | Tri-state
51 – 52 | P12 – P13 | Tri-state
53 | VDD | Power
54 | P14 | Tri-state
55 | P15 | Tri-state
56 | VSS | Power
57 | P16 | Tri-state
58 – 72 | P17 – P31 | Tri-state
73 | Clock ÷ 4 | Input |  | Pull low to divide the processor clock by 4.
74 | Clock ÷ 2 | Input |  | Pull low to divide the processor clock by 2, pull both low to divide by 8.
75 | VDDIO | Power |  | Programmable IO positive voltage
76 | Waiting | Output | RDY (output) | Low indicates the processor is stalled.
77 | Interrupt Vector | Output | VPB | Low indicates an interrupt address is being read.
78 | VSSIO | Power
79 | VSS | Power
80 | E Interrupt 3 | Input |  | Pulse low for an edge triggered interrupt.
81 | E Interrupt 2 | Input
82 | VDD | Power
83 | E Interrupt 1 | Input
84 | E Interrupt 0 | Input | NMIB
85 | Reset | Input | RESB | Pull low to hold the processor in reset.
86 | Level Interrupt | Input | IRQB | Pull low for a level triggered interrupt.
87 | PHI2 | Output |  | Inverted actual processor clock output
88 | PHI2 | Output |  | Actual processor clock output (includes clock division and holding).
89 | VSS | Power
90 | Cycle Clock | Input | PHI2 | Processor clock input.
91 | Write | Output, Hi-Z |  | Low indicates a write.
92 | VDD | Power
93 | Read | Output, Hi-Z |  | Low indicates a read. Neither Read nor Write low indicates no bus access.
94 | RWB | Output, Hi-Z | RWB | High indicates a read, low indicates a write.
95 | Internal Address | Output |  | High indicates internal SRAM is being addressed.
96 | Address Valid | Output |  | High indicates an external address is being addressed.
97 | Opcode Valid | Output |  | High indicates an instruction opcode is being read.
98 | Program Address | Output | VPA | High indicates instruction operands are being read.
99 | Stack Address | Output |  | High indicates the stack is being addressed.
100 | Data Address | Output | VDA | High indicates data is being addressed, neither instruction nor stack.
101 | Initial Flag | Output |  | Programmable pin set low on Reset.
102 | User Flag | Output |  | Programmable pin set high on Reset.
103 | Kernel Mode | Output |  | Low indicates the processor is in kernel mode, high indicates user mode.
104 | Bus Enable | Input | BE | Pull low set the pins A0 – A31, D0 – D15, Read, Write and RWB high impedance.
105 | Watchdog Clock | Input |  | Watchdog clock input, typically 32Khz.
106 | Data Width 8 | Input |  | Pull low to set the databus width to 8 bits, pins D8 – D15 are set high impedance.
107 | Hold High | Input | RDY (input) | Hold low to stop the processor clock from transitioning low.
108 | Hold Low | Input |  | Hold high to stop the processor clock from transitioning high.
116 | VSS | Power
119 | VDD | Power
123 | Lower Byte | Output, Hi-Z |  | Low indicates databus pins D0 – D7 are valid.
124 | Upper Byte | Output, Hi-Z |  | Low indicates databus pins D8 – D15 are valid.
125 | VSS | Power
126 | D0 | Tri-state | D0 | D0 – D15: databus.
127 | D1 | Tri-state | D1
128 | VDD | Power
129 | D2 | Tri-state | D2
130 – 142 | D3 – D15 | Tri-state | D3 – D7
143 | A1 | Output, Hi-Z | A1
144 | A0 | Output, Hi-Z | A0

Sheet: Registers
Register Behaviour | Register Layout |  |  |  |  |  |  |  |  |  |  |  |  |  |  |  | Symbols
Aritmethic and Logic | Register A (64 bit) |  |  |  |  |  |  |  | (32 bit) |  |  |  | (16 bit) |  | (8 bit) |  | A is the contents of the A register. a is the width of the A register in bits.
Aritmethic and Logic | Register B (64 bit) |  |  |  |  |  |  |  | (32 bit) |  |  |  | (16 bit) |  | (8 bit) |  | B is the contents of the B register. b is the width of the B register in bits.
Frame address |  |  |  |  |  |  |  |  | Register V (32 bit) |  |  |  |  |  |  |  | V is the contents of the V register. 32 is the width of the V register in bits.
Frame address |  |  |  |  |  |  |  |  | Register W (32 bit) |  |  |  |  |  |  |  | W is the contents of the W register. 32 is the width of the W register in bits.
Indexed addressing | Register X (64 bit) |  |  |  |  |  |  |  | (32 bit) |  |  |  | (16 bit) |  | (8 bit) |  | X is the contents of the X register. x is the width of the X register in bits.
Indexed addressing | Register Y (64 bit) |  |  |  |  |  |  |  | (32 bit) |  |  |  | (16 bit) |  | (8 bit) |  | Y is the contents of the Y register. y is the width of the Y register in bits.
Stack address |  |  |  |  |  |  |  |  | Stack Pointer S (32 bit) |  |  |  |  |  |  |  | S is the contents of the stack pointer. 32 is the width of the stack pointer in bits.
Processor State |  |  |  |  | Status P (16 bit) |  |  |  | Program Counter C (32 bit) |  |  |  |  |  |  |  | C is the contents of the program counter. 32 is the width of the program counter in bits.
 |  |  |  |  |  |  |  |  |  |  |  |  |  |  |  |  | P is the contents of the status register. 16 is the width of the status register in bits.
Internal Data | Register DI (64 bit) |  |  |  |  |  |  |  | (32 bit) |  |  |  | (16 bit) |  | (8 bit) |  | i is the length of the instruction in bytes.
Internal Data | Register D (64 bit) |  |  |  |  |  |  |  | (32 bit) |  |  |  | (16 bit) |  | (8 bit) |  | o is the length of an operand in bytes.
Internal Data | Register DJ (64 bit) |  |  |  |  |  |  |  | (32 bit) |  |  |  | (16 bit) |  | (8 bit) |  | e is the disable edge triggered interrupt flag.
 |  |  |  |  |  |  |  |  |  |  |  |  |  |  |  |  | l. is the disable level triggered interrupt flag.
 |  |  |  |  |  |  |  |  |  |  |  |  |  |  |  |  | f is a user status flag.
 | Status P bit encoding |  |  |  |  |  |  |  |  |  |  |  |  |  |  |  | g is a user status flag.
 | 15 | 14 | 13 | 12 | 11 | 10 | 9 | 8 | 7 | 6 | 5 | 4 | 3 | 2 | 1 | 0 | n is the negative flag.
 | a |  | b |  | x |  | y |  | e | l. | f | g | n | v | z | c | v is the overflow flag.
 | Width A |  | Width B |  | Width X |  | Width Y |  | EI Disable | L. Disable | User flag F | User flag G | Negative | Overflow | Zero | Carry | z is the zero flag.
 | 8, 16, 32 or 64 bits |  | 8, 16, 32 or 64 bits |  | 8, 16, 32 or 64 bits |  | 8, 16, 32 or 64 bits |  | 0=enable | 0=enable | 0=clear | 0=clear | 0=positive | 0=clear | 0=non-zero | 0=clear | c is the carry flag.
 |  |  |  |  |  |  |  |  | 1=disable | 1=disable | 1=set | 1=set | 1=negative | 1=set | 1=zero | 1=set | R represents the contents of a register. r represents the width of a register.
 |  |  |  |  |  |  |  |  |  |  |  |  |  |  |  |  | H represents the contents of a hardware register. h represents the width of a hardware register.
 |  |  |  |  |  |  |  |  |  |  |  |  |  |  |  |  | DI D and DJ represent internal data registers. A subscript represents a different internal register.
 |  |  |  |  |  |  |  |  |  |  |  |  |  |  |  |  | E represents an embedded value
 |  |  |  |  |  |  |  |  |  |  |  |  |  |  |  |  | [Q] is the contents of the address Q.
 |  |  |  |  |  |  |  |  |  |  |  |  |  |  |  |  | R:[q] is the contents of a byte in register R indexed by q.
 |  |  |  |  |  |  |  |  |  |  |  |  |  |  |  |  | R:b[q] is the contents of a bit in register R indexed by q.
 |  |  |  |  |  |  |  |  |  |  |  |  |  |  |  |  | R:n[q] is the contents of a nybble in register R indexed by q.
 |  |  |  |  |  |  |  |  |  |  |  |  |  |  |  |  | O is an operand. See the Opcode operands tab. A register, address, embedded or immediate value.
 |  |  |  |  |  |  |  |  |  |  |  |  |  |  |  |  | O1 is operand left.
 |  |  |  |  |  |  |  |  |  |  |  |  |  |  |  |  | O2 is operand right.
 |  |  |  |  |  |  |  |  |  |  |  |  |  |  |  |  | N is operand count.
 |  |  |  |  |  |  |  |  |  |  |  |  |  |  |  |  | { contents } the curly brackets indicate that contents is optional or not invoked.
 |  |  |  |  |  |  |  |  |  |  |  |  |  |  |  |  | ( contents ) the round brackets indicate order of precedence.
 |  |  |  |  |  |  |  |  |  |  |  |  |  |  |  |  | + is addition.
 |  |  |  |  |  |  |  |  |  |  |  |  |  |  |  |  | - is subtraction.
 |  |  |  |  |  |  |  |  |  |  |  |  |  |  |  |  | Q1 → Q2 the arrow represents that Q1 is assigned to Q2.
 |  |  |  |  |  |  |  |  |  |  |  |  |  |  |  |  | ∧is bitwise AND.
 |  |  |  |  |  |  |  |  |  |  |  |  |  |  |  |  | ∨is bitwise OR.
 |  |  |  |  |  |  |  |  |  |  |  |  |  |  |  |  | ⊻is bitwise XOR.
 |  |  |  |  |  |  |  |  |  |  |  |  |  |  |  |  | ‹‹ bit-shift left
 |  |  |  |  |  |  |  |  |  |  |  |  |  |  |  |  | ›› bit-shift right
 |  |  |  |  |  |  |  |  |  |  |  |  |  |  |  |  | ››› signed shift right
 |  |  |  |  |  |  |  |  |  |  |  |  |  |  |  |  | = is equal (flags only)
 |  |  |  |  |  |  |  |  |  |  |  |  |  |  |  |  | != is not equal (flags only)
 |  |  |  |  |  |  |  |  |  |  |  |  |  |  |  |  | ! is bitwise NOT

Sheet: Instructions
65C64 Architectural Manual
Instruction Set |  |  |  |  |  |  |  | V0.1 Prelim
 | Instruction |  |  |  |  | Instruction class | W65C816 | Behaviour | Flags Affected | Notes
 |  |  | 4 bits | 1 or 2 bits | 1 or 2 bits
 | Instruction Name | Mnemonic | Instruction code | Extend code | Sub code
0 | Copy (zero extend) | cpy | 0 |  | 0 | Logical | lda ldx ldy sta stx sty stz | O2 → O1 | n, z
1 | Copy (sign extend) |  |  |  | 1 |  |  | O2:s → O1 | n, z | Sign or zero extension only applies to the second operand, when it is narrower than the operation (the width of the register operand, or 32 bits without one). The first operand is never extended.
2 | And (zero extend) | and | 1 |  | 0 |  | and | O1 ∧ O2 → O1 | n, z
3 | And (sign extend) |  |  |  | 1 |  |  | O1 ∧ O2:s → O1 | n, z
4 | Or (zero extend) | or | 2 |  | 0 |  | ora tsb | O1 ∨ O2 → O1 | n, z
5 | Or (sign extend) |  |  |  | 1 |  |  | O1 ∨ O2:s → O1 | n, z
6 | Xor (zero extend) | xor | 3 |  | 0 |  | eor | O1 ⊻ O2 → O1 | n, z
7 | Xor (sign extend) |  |  |  | 1 |  |  | O1 ⊻ O2:s → O1 | n, z
8 | Test (zero extend) | tst | 4 |  | 0 |  | bit | O1 ∧ O2 | n, z
9 | Test (sign extend) |  |  |  | 1 |  |  | O1 ∧ O2:s | n, z
10 | Add (unsigned) | add | 5 |  | 0 | Arithmetic | adc inc inx iny | O1 + O2 → O1 | n, v, z, c
11 | Add (signed) |  |  |  | 1 |  |  | O1 + O2:s → O1 | n, v, z, c
12 | Subtract (unsigned) | sub | 6 |  | 0 |  | sbc dec dex dey | O1 - O2 → O1 | n, v, z, c
13 | Subtract (signed) |  |  |  | 1 |  |  | O1 - O2:s → O1 | n, v, z, c
14 | Compare (unsigned) | cmp | 7 |  | 0 |  | cmp cpx cpy | O1 - O2 | n, v, z, c | v is set as by subtract (and c is not borrow), so a signed comparison can branch on n ≠ v (braso (n, v)).
15 | Compare (signed) |  |  |  | 1 |  |  | O1 - O2:s | n, v, z, c
16 | Subcopy bytes | scp | 9 |  | 0 | Logical | tax tay tcd tcs tdc tsc tsx txa | R1:[O1]...R1:[O1+N] → R2:[O2]...R2:[O2+N] | n, z | Copies bytes from the index in the first register to the second register for count bytes, index incrementing. Subcopy ignores the set width of a register. Source bytes past 63 read as 0 and destination bytes past 63 are dropped. n and z are set from the second register at its width.
17 | Subcopy bytes |  |  |  |  |  | txs txy tya tyx tdc xba
18 | Subcopy bits | scb |  |  | 1 |  |  | R1:b[O1]...R1:b[O1+N] → R2:b[O2]...R2:b[O2+N] | n, z | Copies bits from index in first register to second register for count bits, index incrementing. Subcopy ignores the set width of a register. Source bits past 63 read as 0 and destination bits past 63 are dropped. n and z are set from the second register at its width.
19 | Jump absolute | jmp | 10 |  | 0 | Flow | jmp | {P → [S]; S-2 → S}; O2 → C
20 | Jump absolute subroutine | jsr |  |  |  |  | jsr | C+i → C; C→ [S]; S-4 → S; {P → [S]; S-2 → S}; O2 → C |  | The processor status P can be optionally pushed on any stack by the Jump instruction
21 | Jump relative | bra |  |  | 1 |  |  | C+i → C; {P → [S]; S-2 → S}; C + O2 → C |  | The processor count C is taken as the opcode of the next instruction before relative adjustment
22 | Jump relative subroutine | brsr |  |  |  |  |  | C+i → C; C→ [S]; S-4 → S; {P → [S]; S-2 → S}; C + O2 → C
23 | Push processor state | psh |  |  |  | State | php | P → [S]; S-2 → S
24 | Push program count | psh |  |  |  |  |  | C → [S]; S-4 → S
25 | Return | ret | 11 | 0 | 0 | Flow | rts rtl | {S+2 → S; [S] → P}; S+4 → S; [S] → C | n, v, z, c, f, g, a, b, x, y, e, l.
26 | Pull processor state | pul |  |  |  | State | plp | S+2 → S; [S] → P | n, v, z, c, f, g, a, b, x, y, e, l.
27 | Return from interrupt | rti |  |  | 1 | Flow | rti | S+2 → S; [S] → P; S+4 → S; [S] → C | n, v, z, c, f, g, a, b, x, y, e, l. | Subtracts 1 from the interrupt depth. e and l come back with P. The stack can be S, V, W or Y.
28 | Set state bits | sep |  | 1 | 0 | State | sep sec sei | P∨E → P | n, v, z, c, f, g, e, l.
29 | Clear state bits | cep |  |  | 1 |  | rep clc | P∧!E → P | n, v, z, c, f, g, e, l.
30 | Set register width | wth |  |  | 2 |  | rep sep cli clv | O → r | a, b, x, y
31 | Set two register widths | wtth |  |  | 3 |  |  | O2 → r1; O2 → r2 | a, b, x, y
32 | Break | brk |  | 2 |  | Flow | brk cop | C+i → C; C → [S]; S-4 → S; P → [S]; S-2 → S; [vector] → C |  | Vector n (0 to 1023) is at FFFF:F000 + 4n. Adds 1 to the interrupt depth. Unlike an interrupt, brk leaves e and l as they are.
33 | Stop | stp |  | 3 | 0 |  | stp wai | 1 → Clock |  | Without wake bits the processor stops until reset. With wake bits (l, e0 to e3) it waits for one of those interrupts, even a disabled one: an enabled interrupt is taken (with C after stp), a disabled one continues after stp.
34 | Get register width | gwth |  |  | 2 | State |  | 8r → R; {8r - 1 → R} |  | The width in bits, or one less with gwth R, (Q, -1) (see the ror example).
35 | Extend register width | wthx |  |  | 3 |  |  | xR:[O-r...O] → R; O → r
36 | Branch on set | bras | 12 | 0 1 | 1 | Flow | bcs beq bvs bmi | C+i → C; if p {C + O2 → C}
37 | Branch on clear | brac |  |  | 0 |  | bcc bpl bvc bne | C+i → C; if !p {C + O2 → C}
38 | Branch on set and set | brasa |  |  | 2 |  |  | C+i → C; if {p∧p} {C + O2 → C}
39 | Branch on set xor set | braso |  |  | 3 |  |  | C+i → C; if {p⊻p} {C + O2 → C}
40 | Branch always | bra |  |  | 1 |  | bra brl | C+i → C; C + O2 → C
41 | No operation | nop |  |  | 0 |  | nop wdm | wait O2
42 | Branch on equal | brae |  | 2 | 0 |  |  | C+i → C; if (p1 = p2) {C + O2 → C}
43 | Branch on not equal | brane |  |  | 1 |  |  | C+i → C; if (p1 != p2) {C + O2 → C}
44 | Copy Extend (zero extend) | cpyx |  | 3 |  | Logical |  | O2:o → R | n, z | Copy a value of a given width in memory into a register zero extended. With swap the register's low o bits (zero extended when o is wider than the register) are written to memory. A value wider than the register is truncated. n and z are set from the value copied.
45 | Push register to | psh | 13 | 0 |  | State (compound) | pha phx phy phd | {A → [S]; S-a → S}; {B → [S]; S-b → S};… {Y → [S]; S-y → S}; | n, z | Pushed in the order A, B, S, V, W, X, Y, each at its width, with the values from before the stack register moves. n and z are set from the last register pushed.
46 | Pull into register | pul |  | 2 |  |  | pla pld plx ply | {S+a → S; [S] → A}; {S+b → S; [S] → B};… {S+y → S; [S] → Y}; | n, z | Pulled in the order Y, X, W, V, S, B, A (the reverse), each at its width. n and z are set from the last register pulled.
47 | Push operand to | psh |  | 1 |  | State | pea pei per | O2 → [S]; S-o → S |  | An immediate is pushed at its own width; the value at an address is pushed as 32 bits.
48 | Pull into address | pul |  | 3 |  |  |  | S+o → S; [S] → O2 |  | Always pulls 32 bits.
49 | Multiply | mul | 14 | 0 | 0 | Arithmetic (partial) |  | See sheet ‘Multiplication’; {C+i → C} | v, z | W must be assigned 0 initially. A and B are multiplicands. Y contains the result when v is set. Repeat partial multiply whilst v is not set. z set indicates Y is zero. W counts B’s nybbles, two a step, so there is a step for each byte of B. The first step clears Y, and the product is truncated to Y’s width.
50 | Divide | div |  |  | 1 |  |  | See sheet ‘Division’; {C+i → C} | v, z, c | W must be assigned 0 initially. A is the divisor and Y the dividend. B is the top half of the dividend: usually 0, but any value below A divides B and Y together, (B << Y’s width) + Y. Y contains the quotient and B the remainder when v is set. Repeat partial divide whilst v is not set. z set indicates Y is zero. c clear indicates B is zero. W counts Y’s nybbles, one a step. The remainder is truncated to B’s width every step. Dividing by 0 gives quotient nybbles of 15.
51 | Negate | neg |  |  | 2 | Arithmetic |  | 0 - R2:s → R1 | n, z
52 | Absolute | abs |  |  | 3 |  |  | abs(R2:s) → R1 | n, z | n set indicates the register was negative before absolute. Really scraping out cycles at this point (as a support instruction to multiply and divide) so I’m not sure negate or absolute are worth the space.
53 | Find set bit | fsbi |  | 1 | 0 | Logical |  | if c {N+1 → N}; while R:b[N] = 0, N+1 → N | v, c | Scan first register from bit indexed by count register in direction until bit in first is high. Pre-increment count if c set. v set indicates no more bits. c is always set. When nothing is found the count is one past the end: the width in units going up, all ones going down.
54 | Find clear bit | fcbi |  |  |  |  |  | if c {N+1 → N}; while R:b[N] = 1, N+1 → N | v, c | First register index zero (first[0]) is the least significant bit.
55 | Find non-zero nybble | fsny |  |  | 2 |  |  | if c {N+1 → N}; while ∨R:n[N] = 0, N+1 → N | v, c | Scan first register from nybble indexed by count register in direction until any bit in nybble is high.
56 | Find zero nybble | fcny |  |  |  |  |  | if c {N+1 → N}; while ∧R:n[N] = 1, N+1 → N | v, c | Scan first register from nybble indexed by count register in direction until any bit in nybble is low.
57 | Find non-zero byte | fsby |  |  | 3 |  |  | if c {N+1 → N}; while ∨R:[N] = 0, N+1 → N | v, c | Scan first register from byte indexed by count register in direction until any bit in byte is high.
58 | Find zero byte | fcby |  |  |  |  |  | if c {N+1 → N}; while ∧R:[N] = 1, N+1 → N | v, c | Note all examples assume LSB to MSB. The opposite direction is also possible. Scan is only over the width of the bits in the first register.
59 | Shift left | shl |  | 2 |  | Logical | asl | O1 ‹‹ O2 → O1 | z, c, v | c is set to O1:b[o1] after shifting. v is set to O1:b[o1+1] after shifting. A shift of 0 clears c and v.
60 | Shift right | shr |  | 3 |  |  | lsr | O1 ›› O2 → O1 | n, z, c, v | c is set to O1:b[-1] after shifting. v is set to O1:b[-2] after shifting. n is set to O1:b[o1-1] before shifting. A shift of 0 clears c and v.
61 | Block copy | bcpy | 8 | 2 | 0 | Logical (partial) |  | R → [V]; A-1 → A; V+r → V; {C+i → C} | v | Store R into [V]. Increment V, decrement A. v set indicates A is negative after decrement. It never stops early (its stop bits are ignored).
62 | Block and | band |  |  | 2 |  |  | [V] ∧R → [V]; A-1 → A; V+r → V; {C+i → C} | n, v, z | Load [V] into D. And D with R. Store D into [V]. Increment V, decrement A. v set indicates A is negative after decrement. z set indicates D was 0. n indicates D was negative. Every block and vector operation but bcpy repeats (C stays on the opcode) until v is set or, if stopping is allowed, its stop condition (z set, z clear, n set or n clear) holds.
63 | Block test | btst |  |  | 3 |  |  | [V] ∧R; A-1 → A; V+r → V; {C+i → C} | n, v, z | Load [V] into D. And D with R. Increment V, decrement A. v set indicates A is negative after decrement. z set indicates D was 0. n indicates D was negative.
64 | Block or | bor |  |  | 4 |  |  | [V] ∨R → [V]; A-1 → A; V+r → V; {C+i → C} | n, v, z
65 | Block xor | bxor |  |  | 5 |  |  | [V] ⊻R → [V]; A-1 → A; V+r → V; {C+i → C} | n, v, z
66 | Block add | badd |  |  | 6 | Arithmetic (partial) |  | [V] + R → [V]; A-1 → A; V+r → V; {C+i → C} | n, v, z
67 | Block subtract | bsub |  |  | 8 |  |  | [V] - R → [V]; A-1 → A; V+r → V; {C+i → C} | n, v, z | Load [V] into D. Subtract R from D. Store D into [V]. Increment V, decrement A. v set indicates A is negative after decrement. z set indicates D was 0. n indicates D was negative.
68 | Block compare | bcmp |  |  | 10 |  |  | [V] - R; A-1 → A; V+r → V; {C+i → C} | n, v, z | Load [V] into D. Subtract R from D. Increment V, decrement A. v set indicates A is negative after decrement. z set indicates D was 0. n indicates D was negative.
69 | Block precopy | bpcpy |  |  | 12 | Logical (partial) |  | [V]; R → [V]; A-1 → A; V+r → V; {C+i → C} | n, v, z | Load [V] into D. z set indicates D was 0. n indicates D was negative. Store R into [V]. Increment V, decrement A. v set indicates A is negative after decrement.
70 | Block preand | bpand |  |  | 13 |  |  | [V] ∧R → [V]; A-1 → A; V+r → V; {C+i → C} | n, v, z | Load [V] into D. z set indicates D was 0. n indicates D was negative. And D with R. Store D into [V]. Increment V, decrement A. v set indicates A is negative after decrement.
71 | Block preor | bpor |  |  | 14 |  |  | [V] ∨R → [V]; A-1 → A; V+r → V; {C+i → C} | n, v, z
72 | Block prexor | bpxor |  |  | 15 |  |  | [V] ⊻R → [V]; A-1 → A; V+r → V; {C+i → C} | n, v, z
73 | Vector copy | vcpy |  | 3 | 0 | Logical (partial) |  | [W] → [V]; A-1 → A; V+o → V; W+o → W; {C+i → C} | n, v, z | Load [W] into D. Store D into [V]. Increment V, Increment W, decrement A. v set indicates A is negative after decrement. z set indicates D was 0. n indicates D was negative. Like the block operations, it repeats until v is set or an allowed stop condition holds.
74 | Vector invert | vnot |  |  | 1 |  |  | ![W] → [V]; A-1 → A; V+o → V; W+o → W; {C+i → C} | n, v, z | Load [W] into D. Invert D. Store D into [V]. Increment V, Increment W, decrement A. v set indicates A is negative after decrement. z set indicates D was 0. n indicates D was negative.
75 | Vector and | vand |  |  | 2 |  |  | [V] ∧[W] → [V]; A-1 → A; V+o → V; W+o → W; {C+i → C} | n, v, z | Load [W] into DI. Load [V] into DJ. And DI with DJ. Store DJ into [V]. Increment V, increment W, decrement A. v set indicates A is negative after decrement. z set indicates DJ was 0. n indicates DJ was negative.
76 | Vector test | vtst |  |  | 3 |  |  | [V] ∧[W]; A-1 → A; V+o → V; W+o → W; {C+i → C} | n, v, z
77 | Vector or | vor |  |  | 4 |  |  | [V] ∨[W] → [V]; A-1 → A; V+o → V; W+o → W; {C+i → C} | n, v, z
78 | Vector xor | vxor |  |  | 5 |  |  | [V] ⊻[W] → [V]; A-1 → A; V+o → V; W+o → W; {C+i → C} | n, v, z
79 | Vector add | vadd |  |  | 6 | Arithmetic (partial) |  | [V] + [W] → [V]; A-1 → A; V+o → V; W+o → W; {C+i → C} | n, v, z
80 | Vector subtract | vsub |  |  | 8 |  |  | [V] - [W] → [V]; A-1 → A; V+o → V; W+o → W; {C+i → C} | n, v, z
81 | Vector compare | vcmp |  |  | 10 |  |  | [V] - [W]; A-1 → A; V+o → V; W+o → W; {C+i → C} | n, v, z
82 | Vector precopy | vpcpy |  |  | 12 | Logical (partial) |  | [V]; [W] → [V]; A-1 → A; V+o → V; W+o → W; {C+i → C} | n, v, z | Load [W] into DI. Load [V] into DJ. z set indicates DJ was 0. n indicates DJ was negative. Store DI into [V]. Increment V, Increment W, decrement A. v set indicates A is negative after decrement.
83 | Vector preand | vpand |  |  | 13 |  |  | [V] ∧[W] → [V]; A-1 → A; V+o → V; W+o → W; {C+i → C} | n, v, z
84 | Vector preor | vpor |  |  | 14 |  |  | [V] ∨[W] → [V]; A-1 → A; V+o → V; W+o → W; {C+i → C} | n, v, z
85 | Vector prexor | vpxor |  |  | 15 |  |  | [V] ⊻[W] → [V]; A-1 → A; V+o → V; W+o → W; {C+i → C} | n, v, z
86 | Set hardware all | hws | 15 | 0 |  | Hardware |  | R → H
87 | Get hardware all | hwg |  | 1 |  |  |  | H → R
88 | Set hardware bits | hwsp |  | 2 |  |  |  | H∨O2 → H
89 | Clear hardware bits | hwcp |  | 3 |  |  |  | H∧!O2 → H
90 | Bit to status | bist |  | 4 |  | State |  | R:b[N] → p | n, v, z, c, f, g
91 | Status to bit | stab |  | 5 |  |  |  | p → R:b[N]; {p → R:b[N±1] … R:b[N±(count-1)]} |  | With a repeat the flag is written to count bits (a register, or 0 to 63) from bit N up or down. Bits outside 0 to 63 are dropped and the register’s width is ignored; 32 or more bits take a cycle more.
92 | Copy Extend (sign extend) | cpyx |  | 6 |  | Logical |  | O2:o:s → R | n, z | Copy a value of a given width (8, 16 or 32 bits) in memory into a register sign extended. A value wider than the register is truncated. n and z are set from the value copied. There is no sign extending copy into memory; use the zero extending cpyx.
93 | Status to status | stat |  | 7 |  | State |  | p → p | n, v, z, c, f, g
 | Note: Where different instructions appear to have the same bit encodings then somewhere else in the opcode is a distinguishing bit.
 | Note: Branch always and Jump relative are have identical functionality if their operand is an immediate value.
 | Note: The following W65C816 instructions are missing a one-to-one match with the 65C64 They can be sythesised:
 | rol | stat f, c shl A, 1 stab (A, 0), f |  |  |  | Copy carry (c) into user flag (f). Shift A left inserting zero on the right. Copy f into A at bit position 0.
 | ror | stat f, c gwth X, (A, -1) shr A, 1 stab (A, X), f |  |  |  | Copy c into f. Get width of A (in bits -1) into X. Shift A right inserting zero on the left. Copy f into A at bit position X.
 | mvn | vcpy W, V, -1, A, 8 |  |  |  | Copy value in address contained in W to address contained in V, decrement W, decrement V, decrement A and set n from A. Branch if negative is not set back to vcpy.
 | mvp | vcpy W, V, +1, A, 8 |  |  |  | Copy value in address contained in W to address contained in V, increment W, increment V, decrement A and set n from A. Branch if negative is not set back to vcpy.
 | trb | xor A, -1 and [M], A |  |  |  | Assign A with not A. Copy value in memory address M into internal register D, and A with D assign to D, copy D into address M.
 | or they need to be fully implemented in source:
 | cld
 | sed
 | or they are meaningless outside of the W65C816 processor.
 | phb phk plb xce

Sheet: Addressing modes
Mode | Address Absolute |  |  |  |  | Mode | Address Offset |  |  |  |  | Mode | Address Register
2 | Absolute: | Address |  |  |  | 6 | Offset: | Offset |  |  |  | 10 | Register: | Register
 |  | 16bit | 16bit | 16bit |  |  |  | 16bit | 16bit |  |  |  |  | 16bit
 | Instruction in memory: | Opcode | Low | High |  |  | Instruction in memory: | Opcode | Low |  |  |  | Instruction in memory: | Opcode
 |  |  | 32bit |  |  |  |  |  | 32bit |  |  |  |  |  | 32bit
 | Address calculation: |  | High:Low | Addr LW |  |  | Address calculation: |  | 0:Low | Addr LW |  |  | Address calculation: |  | Register A, B, S, V, W, X or Y
 |  | = | Effective Address |  |  |  |  | = | Effective Address |  |  |  |  | = | Effective Address
 | Absolute Register: | Address + Register |  |  |  |  | Offset Register: | Offset + Register |  |  |  | 11 | Register Register: | Register + Register
 |  | 16bit | 16bit | 16bit |  |  |  | 16bit | 16bit |  |  |  |  | 16bit
 | Instruction: | Opcode | Low | High |  |  | Instruction in memory: | Opcode | Low |  |  |  | Instruction in memory: | Opcode
 |  |  | 32bit |  |  |  |  |  | 32bit |  |  |  |  |  | 32bit
 |  |  | High:Low | Addr LW |  |  | Address calculation: |  | 0:Low | Addr LW |  |  | Address calculation: |  | Register A, B, S or V
 |  | + | Register A, B, S, V, W, X or Y |  |  |  |  | + | Register A, B, S, V, W, X or Y |  |  |  |  | + | Register V, W, X or Y
 |  | = | Effective Address |  |  |  |  | = | Effective Address |  |  |  |  | = | Effective Address
3 | Absolute Indirect: | [Address] |  |  |  | 7 | Offset Indirect: | [Offset] |  |  |  | 12 | Register Indirect: | [Register]
 |  | 16bit | 16bit | 16bit |  |  |  | 16bit | 16bit |  |  |  |  | 16bit
 | Instruction in memory: | Opcode | Low | High |  |  | Instruction in memory: | Opcode | Low |  |  |  | Instruction in memory: | Opcode
 |  |  | 32bit |  |  |  |  |  | 32bit |  |  |  |  |  | 32bit
 | Address calculation: | [ | High:Low | Addr LW | ] |  | Address calculation: | [ | 0:Low | Addr LW | ] |  | Address calculation: | [ | Register A, B, S, V, W, X or Y |  | ]
 |  | = | Effective Address |  |  |  |  | = | Effective Address |  |  |  |  | = | Effective Address
4 | Absolute Register Indirect: | [Address + Register] |  |  |  | 8 | Offset Register Indirect: | [Offset + Register] |  |  |  | 13 | Register Register Indirect: | [Register + Register]
 |  | 16bit | 16bit | 16bit |  |  |  | 16bit | 16bit |  |  |  |  | 16bit
 | Instruction in memory: | Opcode | Low | High |  |  | Instruction in memory: | Opcode | Low |  |  |  | Instruction in memory: | Opcode
 |  |  | 32bit |  |  |  |  |  | 32bit |  |  |  |  |  | 32bit
 | Address calculation: |  | High:Low | Addr LW |  |  | Address calculation: |  | 0:Low | Addr LW |  |  | Address calculation: |  | Register A, B, S or V
 |  | + | Register A, B, S, V, W, X or Y |  |  |  |  | + | Register A, B, S, V, W, X or Y |  |  |  |  | + | Register V, W, X or Y
 |  | [ | Resultant Address | Addr LW | ] |  |  | [ | Resultant Address | Addr LW | ] |  |  | [ | Resultant Address | Addr LW | ]
 |  | = | Effective Address |  |  |  |  | = | Effective Address |  |  |  |  | = | Effective Address
5 | Absolute Indirect Register: | [Address] + Register |  |  |  | 9 | Offset Indirect Register: | [Offset] + Register |  |  |  | 14 | Register Indirect Register: | [Register] + Register
 |  | 16bit | 16bit | 16bit |  |  |  | 16bit | 16bit |  |  |  |  | 16bit
 | Instruction in memory: | Opcode | Low | High |  |  | Instruction in memory: | Opcode | Low |  |  |  | Instruction in memory: | Opcode
 |  |  | 32bit |  |  |  |  |  | 32bit |  |  |  |  |  | 32bit
 | Address calculation: | [ | High:Low | Addr LW | ] |  | Address calculation: | [ | 0:Low | Addr LW | ] |  | Address calculation: | [ | Register A, B, S or V |  | ]
 |  | + | Register A, B, S, V, W, X or Y |  |  |  |  | + | Register A, B, S, V, W, X or Y |  |  |  |  | + | Register V, W, X or Y
 |  | = | Effective Address |  |  |  |  | = | Effective Address |  |  |  |  | = | Effective Address
 | Note: Some instructions further restrict the allowed registers. For example addition and subtraction restrict the second addressing operand to X or Y only.
 | Note: Absolute addressing is encoded the same as Absolute Register addressing using the ‘zero’ register. Internally the zero addition is skipped when calculating the effecive address.
 |  | Minimal Addressing Modes
 |  | Encoding | Mode
 | Address Absolute | 0 | 2
 |  | 1 | 3
 |  | 2 | 4
 | Address Offset | 3 | 6
 |  | 4 | 7
 |  | 5 | 8
 | Address Register | 6 | 10
 |  | 7 | 12
 | Note: The minimal addressing modes reduce the 4 bit (full) addressing modes to a selection that map into 3 bits. Minimal adressing modes drop Indrect Register modes and two Register modes.

Sheet: Opcode encoding
 |  |  |  |  |  |  | 65C64 Architectural Manual
 |  |  |  |  |  |  | Opcode Encoding |  | V0.1 Prelim
 | Opcode bit encoding |  |  |  |  |  |  |  |  |  |  |  |  |  |  |  | Operand 16 bit encoding
Instruction | 15 | 14 | 13 | 12 | 11 | 10 | 9 | 8 | 7 | 6 | 5 | 4 | 3 | 2 | 1 | 0 | 15 | 14 | 13 | 12 | 11 | 10 | 9 | 8 | 7 | 6 | 5 | 4 | 3 | 2 | 1 | 0
 |  |  |  |  |  |  |  |  |  |  |  |  | Instruction
Copy | Swap Operands | Operand First |  |  |  | Operand Second |  |  |  |  |  |  | Copy, And, Test, Or, Xor |  |  |  | Operand Second
And | 0 | Register | Register |  |  | Addressing Mode Register |  |  | Operand Access |  |  |  |  |  |  |  | Address absolute low (addressing modes 2 – 5) Address offset (addressing modes 6 – 9)
Or |  | 0 | A, B, S, V, W, X or Y |  |  | None, A, B, S, V, W, X or Y |  |  | Addressing Mode: 2 – 10, 12
Xor
Test | Swap Operands | Operand Second |  |  |  | Operand First |  |  |  |  |  |  |  |  |  |  | Operand First
 | 1 | Register | Register |  |  | Addressing Mode Register |  |  | Operand Access |  |  |  |  |  |  |  | Address absolute low (addressing modes 2 – 5) Address offset (addressing modes 6 – 9)
 |  | 0 | 0, A, B, S, V, W, X or Y |  |  | None, A, B, S, V, W, X or Y |  |  | Addressing Mode: 2 – 10, 12
 | Embedded Value | Embedded | Embedded Value
 | 1 | 1 (implies swap) | -8 to -1
 | 0 |  | 1 to 8
 | Swap Operands | Operand First |  |  | Operand Second |  |  |  |  |  |  |  |  |  |  |  | Operand Second
 | 0 | Register |  |  | Addressing Mode Register 2 |  | Addressing Mode Register 1 |  | Operand Access |  |  |  |  |  |  |  | Not read (addressing modes 11, 13 – 14)
 |  | A, B, S, V, W, X or Y |  |  | V, W, X or Y |  | A, B, S or V |  | Addressing Mode: 11, 13 – 14
 | Swap Operands | Operand Second |  |  | Operand First |  |  |  |  |  |  |  |  |  |  |  | Operand First
 | 1 | Register |  |  | Addressing Mode Register 2 |  | Addressing Mode Register 1 |  | Operand Access |  |  |  |  |  |  |  | Not read (addressing modes 11, 13 – 14)
 |  | 0, A, B, S, V, W, X or Y |  |  | V, W, X or Y |  | A, B, S or V |  | Addressing Mode: 11, 13 – 14
 | Operand First |  |  | Operand Second |  |  |  |  |  |  |  |  |  |  |  |  | Operand Second
 | Register |  |  | Unused (2) | Register Sign | Register |  |  | Operand Access |  |  |  |  |  |  |  | Not read (addressing mode 0)
 | A, B, S, V, W, X or Y |  |  |  | 0 = Unsigned | 0, A, B, S, V, W, X, or Y |  |  | Register: 0
 |  |  |  |  | 1 = Signed
 |  |  |  |  | Immediate Sign | Immediate Width |  |  | Operand Access |  |  |  |  |  |  |  | Immediate Value (mode 1)
 |  |  |  |  | 0 = Unsigned | Unused, 8, 16, 24, 32, 40, 48, 64 |  |  | Immediate: 1 |  |  |  |  |  |  |  | Not read |  |  |  |  |  |  |  | Immediate 8 bits
 |  |  |  |  | 1 = Signed |  |  |  |  |  |  |  |  |  |  |  | Immediate 16, 24, 32, 40, 48, 64 bits (byte 1) |  |  |  |  |  |  |  | Immediate 16, 24, 32, 40, 48, 64 bits (low byte)
 |  |  |  | Embedded Value |  |  |  |  | Operand Access |  |  |  |  |  |  |  | Not read (embedded mode 15)
 |  |  |  | 0 | 1 to 16 |  |  |  | Embedded: 15
 |  |  |  | 1 | -16 to -1
Add | Swap Operands | Operand First |  |  |  | Operand Second |  |  |  |  |  | Sub Instruction | Add, Subtract, Compare |  |  |  | Operand Second
Subtract | 0 | Register | Register |  |  | Addressing Mode Register |  | Operand Access |  |  |  | 0 = Unsigned |  |  |  |  | Address absolute low (addressing modes 2 – 5) Address offset (addressing modes 6 – 9)
Compare |  | 0 | A, B, S, V, W, X or Y |  |  | None, V, X or Y |  | Addressing Mode: 2 – 10, 12 |  |  |  | 1 = Signed
 | Swap Operands | Operand Second |  |  |  | Operand First |  |  |  |  |  |  |  |  |  |  | Operand First
 | 1 | Register | Register |  |  | Addressing Mode Register |  | Operand Access |  |  |  |  |  |  |  |  | Address absolute low (addressing modes 2 – 5) Address offset (addressing modes 6 – 9)
 |  | 0 | 0, A, B, S, V, W, X or Y |  |  | None, V, X or Y |  | Addressing Mode: 2 – 10, 12
 | Embedded Value | Embedded | Embedded Value
 | 0 | 1 (implies swap) | 1 to 8
 | 1 |  | -8 to -1
 | Swap Operands | Operand First |  |  | Operand Second |  |  |  |  |  |  |  |  |  |  |  | Operand Second
 | 0 | Register |  |  | Addr Mode Register 2 | Addressing Mode Register 1 |  | Operand Access |  |  |  |  |  |  |  |  | Not read (addressing modes 11, 13 – 14)
 |  | A, B, S, V, W, X or Y |  |  | X or Y | A, B, S or V |  | Addressing Mode: 11, 13 – 14
 | Swap Operands | Operand Second |  |  | Operand First |  |  |  |  |  |  |  |  |  |  |  | Operand First
 | 1 | Register |  |  | Addr Mode Register 2 | Addressing Mode Register 1 |  | Operand Access |  |  |  |  |  |  |  |  | Not read (addressing modes 11, 13 – 14)
 |  | 0, A, B, S, V, W, X or Y |  |  | X or Y | A, B, S or V |  | Addressing Mode: 11, 13 – 14
 | Operand First |  |  | Operand Second |  |  |  |  |  |  |  |  |  |  |  |  | Operand Second
 | Register |  |  | Unused (2) | Register |  |  | Operand Access |  |  |  |  |  |  |  |  | Not read (addressing modes 11, 13 – 14)
 | A, B, S, V, W, X or Y |  |  |  | 0, A, B, S, V, W, X, or Y |  |  | Register: 0
 |  |  |  |  | Immediate Width |  |  | Operand Access |  |  |  |  |  |  |  |  | Immediate Value (mode 1)
 |  |  |  |  | Unused, 8, 16, 24, 32, 40, 48, 64 |  |  | Immediate: 1 |  |  |  |  |  |  |  |  | Not read |  |  |  |  |  |  |  | Immediate 8 bits
 |  |  |  |  |  |  |  |  |  |  |  |  |  |  |  |  | Immediate 16, 24, 32, 40, 48, 64 bits (byte 1) |  |  |  |  |  |  |  | Immediate 16, 24, 32, 40, 48, 64 bits (low byte)
 |  |  |  | Embedded Value |  |  |  | Operand Access |  |  |  |  |  |  |  |  | Not read (embedded mode 15)
 |  |  |  | 0 | 1 to 8 |  |  | Embedded: 15
 |  |  |  | 1 | -8 to -1
Subcopy bytes | Operand First |  |  | Operand Second |  |  | Operand Widths |  |  |  | Unused (2) | Sub Instruction | Subcopy |  |  |  | Operand First |  |  |  |  |  |  | Unused (2) | Operand Second |  |  |  |  |  |  | Unused (2)
 | Register |  |  | Register |  |  | Width Style | Width (in bytes) |  |  |  | 0 = bytes |  |  |  |  | Index Style | Index (in bytes) |  |  |  |  |  |  | Index Style | Index (in bytes)
 | A, B, S, V, W, X or Y |  |  | A, B, S, V, W, X or Y |  |  | 0 = Register | Register |  |  |  |  |  |  |  |  | 0 = Register | Register |  |  | Unused (8) |  |  |  | 0 = Register | Register |  |  | Unused (8)
 |  |  |  |  |  |  |  | A, B, S, V, W, X or Y |  |  |  |  |  |  |  |  |  | A, B, S, V, W, X or Y |  |  |  |  |  |  |  | A, B, S, V, W, X or Y
 |  |  |  |  |  |  | 1 = Embedded | Embedded |  |  |  |  |  |  |  |  | 1 = Embedded | Embedded |  |  | Unused (8) |  |  |  | 1 = Embedded | Embedded |  |  | Unused (8)
 |  |  |  |  |  |  |  | 1 to 8 |  |  |  |  |  |  |  |  |  | 0 to 7 |  |  |  |  |  |  |  | 0 to 7
Subcopy bits | Operand First |  |  | Operand Second |  | Operand Widths | Operand Widths |  |  |  |  | 1 = bits |  |  |  |  | Operand First |  |  |  |  |  |  | Operand Widths | Operand Second |  |  |  |  |  |  | Operand Widths
 | Register |  |  | Register |  |  | Width Style | Width (in bits) |  |  | Unused (2) |  |  |  |  |  | Index Style | Index (in bits) |  |  |  |  |  | Unused (2) | Index Style | Index (in bits) |  |  |  |  |  | Unused (2)
 | A, B, S, V, W, X or Y |  |  | A, B, S, V, W, X or Y |  |  | 0 = Register | Register |  |  |  |  |  |  |  |  | 0 = Register | Register |  |  | Unused (8) |  |  |  | 0 = Register | Register |  |  | Unused (8)
 |  |  |  |  |  |  |  | A, B, S, V, W, X or Y |  |  |  |  |  |  |  |  |  | A, B, S, V, W, X or Y |  |  |  |  |  |  |  | A, B, S, V, W, X or Y
 |  |  |  |  |  |  | 1 = Embedded | Embedded |  |  |  |  |  |  |  |  | 1 = Embedded | Embedded |  |  |  |  |  | Embedded | 1 = Embedded | Embedded |  |  |  |  |  | Embedded
 |  |  |  |  |  |  |  | 1 to 16 |  |  |  |  |  |  |  |  |  | 0 to 63 |  |  |  |  |  | 0 |  | 0 to 63 |  |  |  |  |  | 0
 |  |  |  |  |  |  |  | 17 to 32 |  |  |  |  |  |  |  |  |  |  |  |  |  |  |  | 1 |  |  |  |  |  |  |  | 0
 |  |  |  |  |  |  |  | 33 to 48 |  |  |  |  |  |  |  |  |  |  |  |  |  |  |  | 0 |  |  |  |  |  |  |  | 1
 |  |  |  |  |  |  |  | 49 to 64 |  |  |  |  |  |  |  |  |  |  |  |  |  |  |  | 1 |  |  |  |  |  |  |  | 1
 | Stack |  | Operand |  |  |  |  |  |  | Push Processor State | Push Program Count | Sub Instruction | Jump |  |  |  | Operand
Jump absolute | Register |  | Addressing Mode Register |  |  | Operand Access |  |  |  | 0 = Do nothing | 0 = Do nothing | 0 = Absolute |  |  |  |  | Address low (addressing modes 2 – 5) Offset (addressing modes 6 – 9)
Jump absolute subroutine | S, V, W or Y |  | 0, A, B, S, V, W, X or Y |  |  | Addressing Mode: 2 – 10, 12 |  |  |  | 1 = Push | 1 = Push | 1 = Relative
Jump relative |  |  | Addr Mode Register 2 | Addressing Mode Register 1 |  | Operand Access |  |  |  |  |  |  |  |  |  |  | Not read (addressing modes 11, 13 – 14)
Jump relative subroutine |  |  | X or Y | A, B, S or V |  | Addressing Mode: 11, 13 – 14
Push processor state |  |  | Register |  |  | Operand Access |  |  |  |  |  |  |  |  |  |  | Not read (addressing mode 0)
Push program count |  |  | A, B, S, V, W, X, or Y |  |  | Register: 0
 |  |  | Immediate Width |  |  | Operand Access |  |  |  |  |  |  |  |  |  |  | Immediate Value (mode 1)
 |  |  | No jump, 8, 16, 24, 32, unused, unused, unused (relative signed, absolute unsigned) |  |  | Immediate: 1 |  |  |  |  |  |  |  |  |  |  | Not read |  |  |  |  |  |  |  | Immediate 8 bits
 |  |  |  |  |  |  |  |  |  |  |  |  |  |  |  |  | Immediate 16, 24, 32 bits (byte 1) |  |  |  |  |  |  |  | Immediate 16, 24, 32 bits (low byte)
 | Stack |  | Unused (16) |  |  |  | Pull Processor State | Pull Program Count | Sub Instruction | Unused (2) | Extend Instruction |  | Return, State, Break, Stop, Extend |  |  |  | Not read
Return | Register |  |  |  |  |  | 0 = Do nothing | 0 = Do nothing | 0 = Return |  | 0 = Return
Return from interrupt | S, V, W or Y |  |  |  |  |  | 1 = Pull | 1 = Pull | 1 = RTI
Pull processor state
 | Status |  | Status |  |  |  |  |  | Sub Instruction |  | Extend Instruction |  |  |  |  |  | Not read
Set state bits | EI Disable (ed) | L.Disable (id) | Flag (f) | Flag (g) | Negative (n) | Overflow (v) | Zero (z) | Carry (c) | 0 = Set State |  | 1 = State
Clear state bits |  |  |  |  |  |  |  |  | 1 = Clear State
 | Register First |  | Register Second |  | Operand Access | Operand |  |  | Sub Instruction
Set register width | A, B, X, Y |  | A, B, X, Y |  | Embedded | Embedded Value |  |  | 2 = Set First Width
Set two register widths |  |  |  |  | 1 | 1 = 8 bits |  |  | 3 = Set First, Second Width
 |  |  |  |  |  | 2 = 16 bits
 |  |  |  |  |  | 3 = 32 bits
 |  |  |  |  |  | 4 = 32 bits
 |  |  |  |  |  | 5 = 64 bits
 |  |  |  |  |  | 6 = 64 bits
 |  |  |  |  |  | 7 = 64 bits
 |  |  |  |  |  | 8 = 64 bits
 |  |  |  |  | Register | Register
 |  |  |  |  | 0 | Unused, A, B, S, V, W, X, or Y
 | Vector |  |  |  |  |  |  |  |  |  | Extend Instruction |  |  |  |  |  | Not read
Break | 1023 = Reset |  |  |  |  |  |  |  |  |  | 2 = Break
 | 1022 = EInterrupt0
 | 1021 = EInterrupt1
 | 1020 = EInterrupt2
 | 1019 = EInterrupt3
 | 1018 = L.Interrupt
 | 1017 = HInterrupt0
 | 1016 = HInterrupt1
 | 1015 = HInterrupt2
 | 0 to 1014 (Software)
 | Unused (8) |  |  | Allow Wake on EInt3 | Allow Wake on EInt2 | Allow Wake on EInt1 | Allow Wake on EInt0 | Allow Wake on L.Int | Sub Instruction |  | Extend Instruction |  |  |  |  |  | Not read
Stop |  |  |  | 0 = Disallow | 0 = Disallow | 0 = Disallow | 0 = Disallow | 0 = Disallow | 0 = Stop |  | 3 = Stop (Kernel only)
 |  |  |  | 1 = Allow | 1 = Allow | 1 = Allow | 1 = Allow | 1 = Allow
 | Operand Second |  |  | Operand First |  |  | Unused (8) |  | Sub Instruction |  | Extend Instruction |  |  |  |  |  | Not read
Get register width | Register (to query) |  | Decrement | Register |  |  |  |  | 2 = Get width |  | 3 = Get Width
 | A, B, X, Y |  | 0 = Do nothing | A, B, S, V, W, X or Y
 |  |  | 1 = Decrement
 | Register |  | Unused (4) |  | Extend | Embedded Value |  |  | Sub Instruction |  | 3 = Extend |  |  |  |  |  | Not read
Extend register width | A, B, X, Y |  |  |  | 0 = Zero extend | 1 = 8 bits |  |  | 3 = Extend width
 |  |  |  |  | 1 = Sign extend | 2 = 16 bits
 |  |  |  |  |  | 3 = 32 bits
 |  |  |  |  |  | 4 = 32 bits
 |  |  |  |  |  | 5 = 64 bits
 |  |  |  |  |  | 6 = 64 bits
 |  |  |  |  |  | 7 = 64 bits
 |  |  |  |  |  | 8 = 64 bits
Branch on set | Status Flag First |  |  | Status Flag Second |  | Operand |  |  | Sub Instruction |  | Extend Instruction |  | Branch, Nop, Copy Extend |  |  |  | Immediate Value (extend instruction)
Branch on clear | 0, 1, c, z, n, v, f or g |  |  | c, z, n or v |  | Embedded Value |  |  | 0 = First Clear |  | 0 = Branch Qualified |  |  |  |  |  | Not read (embedded)
 |  |  |  |  |  | 2, 4, 6, 8, -4, -6, -8, -10 |  |  | 1 = First Set
 |  |  |  |  |  |  |  |  | 2 = (First ∧ Second) Set
 |  |  |  |  |  | Immediate Width |  | Extend Instruction | 3 = (First ⊻ Second) Set |  | 1 = Branch Qualified |  |  |  |  |  | Not read |  |  |  |  |  |  |  | Immediate 8 bits
 |  |  |  |  |  | 8, 16, 24, 32 (always signed) |  | 0 |  |  |  |  |  |  |  |  | Immediate 16, 24, 32 bits (byte 1) |  |  |  |  |  |  |  | Immediate 16, 24, 32 bits (low byte)
Branch always | Embedded Value |  |  |  |  |  |  | Extend Instruction | Unused (2) | Sub Instruction | 1 = Branch Always |  |  |  |  |  | Not read (embedded)
 | -64 to 63 |  |  |  |  |  |  | 1 |  | 0 = Always
No operation | Unused (16) |  |  |  | Embedded Value |  |  | Extend Instruction | Unused (2) | Sub Instruction | 1 = Branch Never |  |  |  |  |  | Not read (embedded)
 |  |  |  |  | 1 to 8 |  |  | 1 |  | 1 = Never
Branch on equal | Status Flag First |  |  | Status Flag Second |  |  | Operand |  | Embedded | Sub Instruction | Extend Instruction |  |  |  |  |  | Immediate Value (extend instruction)
Branch on not equal | c, z, n, v, f or g |  |  | c, z, n, v, f or g |  |  | Embedded Value |  | 1 | 0 = Equal | 2 = Branch Qualified |  |  |  |  |  | Not read (embedded)
 |  |  |  |  |  |  | -8, -4, 4, 8 |  |  | 1 = Not Equal
 |  |  |  |  |  |  | Immediate Width |  | 0 |  |  |  |  |  |  |  | Not read |  |  |  |  |  |  |  | Immediate 8 bits
 |  |  |  |  |  |  | 8, 16, 24, 32 (always signed) |  |  |  |  |  |  |  |  |  | Immediate 16, 24, 32 bits (byte 1) |  |  |  |  |  |  |  | Immediate 16, 24, 32 bits (low byte)
Copy Extend | Swap Operands | Operand First |  | Operand Second |  |  |  |  | Data Width |  | Extend Instruction |  |  |  |  |  | Operand Second
 | 0 | Register |  | Addressing Mode Register |  | Operand Access |  |  | 8, 16, 32, 64 |  | 3 = Copy Extend |  |  |  |  |  | Address absolute low (minimal addressing modes 0 – 2) Address offset (minimal addressing modes 3 – 5)
 |  | A, B, X or Y |  | None, V, X or Y |  | Minimal Addressing Mode: 0 – 7
 | Swap Operands | Operand Second |  | Operand First |  |  |  |  |  |  |  |  |  |  |  |  | Operand First
 | 1 | Register |  | Addressing Mode Register |  | Operand Access |  |  |  |  |  |  |  |  |  |  | Address absolute low (minimal addressing modes 0 – 2) Address offset (minimal addressing modes 3 – 5)
 |  | A, B, X or Y |  | None, V, X or Y |  | Minimal Addressing Mode: 0 – 7
Push | Stack |  |  | Registers |  |  |  |  |  |  | Extend Instruction |  | Push, Pull |  |  |  | Not read (registers)
 | A, B, S, V, W, X or Y |  |  | Y | X | W | V | S | B | A | 0 = Push Register
 |  |  |  | 0 = Do nothing | 0 = Do nothing | 0 = Do nothing | 0 = Do nothing | 0 = Do nothing | 0 = Do nothing | 0 = Do nothing
 |  |  |  | 1 = Push | 1 = Push | 1 = Push | 1 = Push | 1 = Push | 1 = Push | 1 = Push
 |  |  |  | Operand |  |  |  |  |  |  | 1 = Push Operand |  |  |  |  |  | Operand
 |  |  |  | Addressing Mode Register |  |  | Operand Access |  |  |  |  |  |  |  |  |  | Address absolute low (addressing modes 2 – 5) Address offset (addressing modes 6 – 9)
 |  |  |  | 0, A, B, S, V, W, X or Y |  |  | Addressing Mode: 2 – 10, 12
 |  |  |  | Immediate Width |  |  | Operand Access |  |  |  |  |  |  |  |  |  | Immediate Value (mode 1)
 |  |  |  | Unused, 8, 16, 24, 32, 40, 48, 64 (always unsigned) |  |  | Immediate: 1 |  |  |  |  |  |  |  |  |  | Not read |  |  |  |  |  |  |  | Immediate 8 bits
 |  |  |  |  |  |  |  |  |  |  |  |  |  |  |  |  | Immediate 16, 24, 32, 40, 48, 64 bits (byte 1) |  |  |  |  |  |  |  | Immediate 16, 24, 32, 40, 48, 64 bits (low byte)
Pull | Stack |  |  | Registers |  |  |  |  |  |  | 2 = Pull Register |  |  |  |  |  | Not read (registers)
 | A, B, S, V, W, X or Y |  |  | Y | X | W | V | S | B | A
 |  |  |  | 0 = Do nothing | 0 = Do nothing | 0 = Do nothing | 0 = Do nothing | 0 = Do nothing | 0 = Do nothing | 0 = Do nothing
 |  |  |  | 1 = Pull | 1 = Pull | 1 = Pull | 1 = Pull | 1 = Pull | 1 = Pull | 1 = Pull
 |  |  |  | Operand |  |  |  |  |  |  | 3 = Pull Operand |  |  |  |  |  | Operand
 |  |  |  | Addressing Mode Register |  |  | Operand Access |  |  |  |  |  |  |  |  |  | Address absolute low (addressing modes 2 – 5) Address offset (addressing modes 6 – 9)
 |  |  |  | 0, A, B, S, V, W, X or Y |  |  | Addressing Mode: 2 – 10, 12
Hardware set all | Hardware Register Index |  |  |  |  |  | Operand |  |  | Extend Instruction |  |  | Hardware, State, Copy Extend |  |  |  | Not read
 | 0 – 63 |  |  |  |  |  | Register |  | Operand Access | 0 = Hardware Set all
 |  |  |  |  |  |  | A, B, X, or Y |  | Register: 0
 |  |  |  |  |  |  | Immediate Width |  | Operand Access
 |  |  |  |  |  |  | 8, 16, 32, 64 (always unsigned) |  | Immediate: 1
Hardware get all | Hardware Register Index |  |  |  |  |  | Operand |  |  | Extend Instruction |  |  |  |  |  |  | Not read
 | 0 – 63 |  |  |  |  |  | Register |  | Operand Access | 1 = Hardware Get all
 |  |  |  |  |  |  | A, B, X, or Y |  | Register: 0
Hardware set bits | Hardware Register Index |  |  |  |  |  | Operand |  |  | Extend Instruction |  |  |  |  |  |  | Not read
 | 0 – 63 |  |  |  |  |  | Register |  | Operand Access | 2 = Hardware Set bits
 |  |  |  |  |  |  | A, B, X, or Y |  | Register: 0
 |  |  |  |  |  |  | Immediate Width |  | Operand Access
 |  |  |  |  |  |  | 8, 16, 32, 64 (always unsigned) |  | Immediate: 1
Hardware clear bits | Hardware Register Index |  |  |  |  |  | Operand |  |  | Extend Instruction |  |  |  |  |  |  | Not read
 | 0 – 63 |  |  |  |  |  | Register |  | Operand Access | 3 = Hardware Clear bits
 |  |  |  |  |  |  | A, B, X, or Y |  | Register: 0
 |  |  |  |  |  |  | Immediate Width |  | Operand Access
 |  |  |  |  |  |  | 8, 16, 32, 64 (always unsigned) |  | Immediate: 1
Bit to status | Operand First |  |  | Operand Second |  |  |  |  |  | Extend Instruction |  |  |  |  |  |  | Operand Second |  |  |  |  |  | Unused (1024)
 | Status Flag |  |  | Register |  |  | Index Style |  |  | 4 = Bit to status |  |  |  |  |  |  | Index
 | c, z, n, v, f or g |  |  | A, B, S, V, W, X or Y |  |  | Register |  |  |  |  |  |  |  |  |  | Register |  |  | Unused (8)
 |  |  |  |  |  |  | 7 = Register |  |  |  |  |  |  |  |  |  | A, B, S, V, W, X or Y
 |  |  |  |  |  |  | Immediate |  |  |  |  |  |  |  |  |  | Immediate
 |  |  |  |  |  |  | 6 = Immediate |  |  |  |  |  |  |  |  |  | 0 to 63
 |  |  |  |  |  |  | Embedded |  |  |  |  |  |  |  |  |  | Not read (embedded)
 |  |  |  |  |  |  | Index
 |  |  |  |  |  |  | 0, 1, 2, 3, 4 or 5
Status to bit | Operand Second |  |  | Operand First |  |  |  |  |  | Extend Instruction |  |  |  |  |  |  | Operand First |  |  |  |  |  |  |  |  |  |  |  |  |  | Unused (4)
 | Status Flag |  |  | Register |  |  | Index Style |  |  | 5 = Status to bit |  |  |  |  |  |  | Index |  |  |  |  |  | Repeat Style |  | Repeat
 | 0, 1, c, z, n, v, f or g |  |  | A, B, S, V, W, X or Y |  |  | Register |  |  |  |  |  |  |  |  |  | Register |  |  | Unused (8) |  |  | 0 = Register (increment) |  | Register |  |  | Unused (8)
 |  |  |  |  |  |  | 7 = Register |  |  |  |  |  |  |  |  |  | A, B, S, V, W, X or Y |  |  |  |  |  | 1 = Immediate (increment) |  | A, B, S, V, W, X or Y
 |  |  |  |  |  |  |  |  |  |  |  |  |  |  |  |  |  |  |  |  |  |  | 2 = Register (decrement)
 |  |  |  |  |  |  | Immediate |  |  |  |  |  |  |  |  |  | Immediate |  |  |  |  |  | 3 = Immediate (decrement) |  | Immediate
 |  |  |  |  |  |  | 6 = Immediate |  |  |  |  |  |  |  |  |  | 0 to 63 |  |  |  |  |  |  |  | 0 to 63
 |  |  |  |  |  |  | Embedded |  |  |  |  |  |  |  |  |  | Not read (embedded)
 |  |  |  |  |  |  | Index
 |  |  |  |  |  |  | 0, 1, 2, 3, 4 or 5
Copy Extend | Operand First |  | Operand Second |  |  |  |  | Data Width |  | Extend Instruction |  |  |  |  |  |  | Operand Second
 | Register |  | Addressing Mode Register |  | Operand Access |  |  | 8, 16, 32 |  | 6 = Copy Extend |  |  |  |  |  |  | Address absolute low (minimal addressing modes 0 – 2) Address offset (minimal addressing modes 3 – 5)
 | A, B, X or Y |  | None, V, X or Y |  | Minimal Addressing Mode: 0 – 7
Status to status | Operand First |  |  | Operand Second |  |  | Unused (8) |  |  | Extend Instruction |  |  |  |  |  |  | Not read
 | Status Flag |  |  | Status Flag |  |  |  |  |  | 7 = Status to status
 | c, z, n, v, f or g |  |  | c, z, n, v, f or g
Multiply | Unused (8) |  |  | Unused (32) |  |  |  |  | Sub Instruction |  | Extend Instruction |  | Multiply, Divide, Find, Shift |  |  |  | Not read
Divide |  |  |  |  |  |  |  |  | 0 = Multiply |  | 0 = Multiply 0 = Divide 0 = Absolute 0 = Negate
 |  |  |  |  |  |  |  |  | 1 = Divide
Negate | Operand First |  |  | Unused (4) |  | Operand Second |  |  | Sub Instruction |  |  |  |  |  |  |  | Not read
Absolute | A, B, S, V, W, X or Y |  |  |  |  | A, B, S, V, W, X or Y |  |  | 2 = Negate
 |  |  |  |  |  |  |  |  | 3 = Absolute
Find set bit | Operand |  |  | Index |  |  | Count Direction | Compare | Sub Instruction |  | Extend Instruction |  |  |  |  |  | Not read
Find clear bit | A, B, S, V, W, X or Y |  |  | A, B, S, V, W, X or Y |  |  | 0 = Increment | 0 = Zero | 0 = bit |  | 1 = Find
Find non-zero nybble |  |  |  |  |  |  | 1 = Decrement | 1 = Not zero | 1 = crumb
Find zero nybble |  |  |  |  |  |  |  |  | 2 = nybble
Find non-zero byte |  |  |  |  |  |  |  |  | 3 = byte
Find zero byte
Shift left | Swap Operands | Operand First |  |  | Operand Second |  |  |  |  |  | Extend Instruction |  |  |  |  |  | Operand Second
Shift right | 0 | Register | Register |  | Addressing Mode Register |  | Operand Access |  |  |  | 2 = Shift Left 3 = Shift Right |  |  |  |  |  | Address absolute low (addressing modes 2 – 5) Address offset (addressing modes 6 – 9)
 |  | 0 | A, B, S, V |  | None, V, X or Y |  | Addressing Mode: 2 – 10, 12
 | Swap Operands | Operand Second |  |  | Operand First |  |  |  |  |  |  |  |  |  |  |  | Operand First
 | 1 | Register | Register |  | Addressing Mode Register |  | Operand Access |  |  |  |  |  |  |  |  |  | Address absolute low (addressing modes 2 – 5) Address offset (addressing modes 6 – 9)
 |  | 0 | A, B, S, V |  | None, V, X or Y |  | Addressing Mode: 2 – 10, 12
 | Embedded Value | Embedded | Embedded Value
 | 0 | 1 (implies swap) | 1 to 4
 | 1 |  | 5 to 8
 | Swap Operands | Operand First |  | Operand Second |  |  |  |  |  |  |  |  |  |  |  |  | Operand Second
 | 0 | Register |  | Addr Mode Register 2 | Addressing Mode Register 1 |  | Operand Access |  |  |  |  |  |  |  |  |  | Not read (addressing modes 11, 13 – 14)
 |  | A, B, X or Y |  | X or Y | A, B, S or V |  | Addressing Mode: 11, 13 – 14
 | Swap Operands | Operand Second |  | Operand First |  |  |  |  |  |  |  |  |  |  |  |  | Operand First
 | 1 | Register |  | Addr Mode Register 2 | Addressing Mode Register 1 |  | Operand Access |  |  |  |  |  |  |  |  |  | Not read (addressing modes 11, 13 – 14)
 |  | A, B, X or Y |  | X or Y | A, B, S or V |  | Addressing Mode: 11, 13 – 14
 | Operand First |  |  | Operand Second |  |  |  |  |  |  |  |  |  |  |  |  | Operand Second
 | A, B, S, V, W, X or Y |  |  | Register |  |  | Operand Access |  |  |  |  |  |  |  |  |  | Not read (addressing modes 11, 13 – 14)
 |  |  |  | 0, A, B, S, V, W, X, or Y |  |  | Register: 0
 |  |  |  | Unused (4) |  | Immediate Width | Operand Access |  |  |  |  |  |  |  |  |  | Immediate Value (mode 1)
 |  |  |  |  |  | 8, 16 (always unsigned) | Immediate: 1 |  |  |  |  |  |  |  |  |  | Not read |  |  |  |  |  |  |  | Immediate 8 bits
 |  |  |  |  |  |  |  |  |  |  |  |  |  |  |  |  | Immediate 16 bits (high byte) |  |  |  |  |  |  |  | Immediate 16 bits (low byte)
 |  |  |  | Embedded Value |  |  | Operand Access |  |  |  |  |  |  |  |  |  | Not read (embedded mode 15)
 |  |  |  | 0 | 1 to 4 |  | Embedded: 15
 |  |  |  | 1 | 5 to 8
Block copy | V Direction | Allow Stop | Stop Style |  | Operand |  |  | Sub Instruction |  |  |  | Extend Instruction | Block, Vector |  |  |  | Not read
Block and | 0 = Increment | 0 = Run to completion | 0 = Stop on zero |  | B, S, V, W, X or Y |  |  | 0 = Copy |  |  |  | 0 = Block operation
Block test | 1 = Decrement | 1 = Stop on … | 1 = Stop on not zero |  |  |  |  | 1 = Unused
Block or |  |  | 2 = Stop on negative |  |  |  |  | 2 = And
Block xor |  |  | 3 = Stop on not negative |  |  |  |  | 3 = Test
Block add |  |  |  |  |  |  |  | 4 = Or
Block subtract |  |  |  |  |  |  |  | 5 = Xor
Block compare |  |  |  |  |  |  |  | 6 = Add
 |  |  |  |  |  |  |  | 7 = Unused
 |  |  |  |  |  |  |  | 8 = Subtract
 |  |  |  |  |  |  |  | 9 = Unused
 |  |  |  |  |  |  |  | 10 = Compare
 |  |  |  |  |  |  |  | 11 = Unused
 |  |  |  |  |  |  |  | 12 = Read Copy
 |  |  |  |  |  |  |  | 13 = Read And
 |  |  |  |  |  |  |  | 14 = Read Or
 |  |  |  |  |  |  |  | 15 = Read Xor
Vector copy | V Direction | Allow Stop | Stop Style |  | W Direction | Width |  | Sub Instruction |  |  |  | Extend Instruction |  |  |  |  | Not read
Vector invert | 0 = Increment | 0 = Run to completion | 0 = Stop on zero |  | 0 = Increment | 0 = 8 bits |  | 0 = Copy |  |  |  | 1 = Vector operation
Vector and | 1 = Decrement | 1 = Stop on … | 1 = Stop on not zero |  | 1 = Decrement | 1 = 16 bits |  | 1 = Invert
Vector test |  |  | 2 = Stop on negative |  |  | 2 = 32 bits |  | 2 = And
Vector or |  |  | 3 = Stop on not negative |  |  | 3 = 64 bits |  | 3 = Test
Vector xor |  |  |  |  |  |  |  | 4 = Or
Vector add |  |  |  |  |  |  |  | 5 = Xor
Vector subtract |  |  |  |  |  |  |  | 6 = Add
Vector compare |  |  |  |  |  |  |  | 7 = Unused
 |  |  |  |  |  |  |  | 8 = Subtract
 |  |  |  |  |  |  |  | 9 = Unused
 |  |  |  |  |  |  |  | 10 = Compare
 |  |  |  |  |  |  |  | 11 = Unused
 |  |  |  |  |  |  |  | 12 = Read Copy
 |  |  |  |  |  |  |  | 13 = Read And
 |  |  |  |  |  |  |  | 14 = Read Or
 |  |  |  |  |  |  |  | 15 = Read Xor

Sheet: Operand encoding
Opcode Operand Type
Operand Access Type (4 bits)
Name | Mode | Type
Register / None | 0 | Register
Immediate | 1 | Constant
Embedded | 15
Address Absolute | 2 | Address
Address Absolute Register
Address Absolute Indirect | 3
Address Absolute Register Indirect | 4
Address Absolute Indirect Register | 5
Address Offset | 6
Address Offset Register
Address Offset Indirect | 7
Address Offset Register Indirect | 8
Address Offset Indirect Register | 9
Address Register | 10
Address Register Register | 11
Address Register Indirect | 12
Address Register Register Indirect | 13
Address Register Indirect Register | 14

Sheet: Memory map
Address |  | Purpose | Notes
FFFF: | FFFF | Reset | Top of addressable memory. Top of external memory. Reset vector address high byte (3)
FFFF: | FFFE | Reset | Reset vector address byte 2
FFFF: | FFFD | Reset | Reset vector address byte 1
FFFF: | FFFC | Reset | Reset vector address low byte (0). Low level triggered reset
FFFF: | FFF8 | EInterrupt0 | Interrupt vector address. Negative edge triggered interrupt, basically NMIB but there are situations in which it can be masked
FFFF: | FFF4 | EInterrupt1 | …
FFFF: | FFF0 | EInterrupt2 | …
FFFF: | FFEC | EInterrupt3 | …
FFFF: | FFE8 | L.Interrupt | Interrupt vector address. Low level triggered interrupt, an equivalent to IRQB
FFFF: | FFE4 | HInterrupt0 | Hardware triggered interrupt 0.
FFFF: | FFE0 | HInterrupt1
FFFF: | FFDC | HInterrupt2
FFFF: | FFD8 | Soft Interrupt0 | Software triggered interrupt 0.
FFFF: | FFD4 | Soft Interrupt1 | Software triggered interrupt 1.
FFFF: | FFD0 | Soft Interrupt2
 | ...
FFFF: | F000 | Soft Interrupt1014 | Software triggered interrupt 1014.
0100: | 0000 |  | Bottom of external memory
00FF: | FFFF |  | Top of internal memory
 | ...
0040: | FFFF | User bank map | Default user bank map. User bank high byte (1). Default map for process ID FF, bank FF
0040: | FFFE | User bank map | User bank low byte (0)
0040: | FFFD | User bank map | High byte. Default map for process ID FF, bank FE
0040: | FFFC | User bank map | Low byte. Default map for process ID FF, bank FE
 | ...
0020: | 0001 | User bank map | High byte. Default map for process ID 00, bank 00
0020: | 0000 | User bank map | Low byte. Default map for process ID 00, bank 00
 | ...
0001: | FFFF | Stack | Default stack pointer (S). Stack address high byte (3)
0001: | FFFE |  | Stack address byte 2
0001: | FFFD |  | Stack address byte 1
0001: | FFFC |  | Stack address low byte (0)
 | ...
0000: | 0000 |  | Bottom of internal memory

Sheet: Memory bank remapping
Lookup = (Process ID * Bank Width + Bank) * 2 |  |  |  |  |  |  |  |  |  |  |  |  |  | Initial Address on address bus: 02:6FE7 remaps to 05:65E7
Example: | Process ID [1], Bank Width [1024], Bank [2] = (1 * 1024 + 2) * 2 = 1026 * 2 = 2052
 | 16 bit Value in address 2025 → 5
 | Initial Address on address bus: 02:6FE7 remaps to 05:65E7
Example: | Bank Width | 4 | bits | 16 | possible values
 |  | Bank
 | Address | 6 | :23A6
 | Process ID | 4
 | Remap: | 140
 | Remapped Address: | C4 | :23A6
 | Bank → | 0 |  | 1 |  | 2 |  | 3 |  | 4 |  | 5 |  | 6 |  | 7 |  | 8 |  | 9 |  | 10 |  | 11 |  | 12 |  | 13 |  | 14 |  | 15
Process ID | Memory Address | 0 | 1 | 2 | 3 | 4 | 5 | 6 | 7 | 8 | 9 | 10 | 11 | 12 | 13 | 14 | 15 | 16 | 17 | 18 | 19 | 20 | 21 | 22 | 23 | 24 | 25 | 26 | 27 | 28 | 29 | 30 | 31
0 | 0
1 | 32
2 | 64
3 | 96
4 | 128 |  |  |  |  |  |  |  |  |  |  |  |  | C4
5 | 160
6 | 192
7 | 224
8 | 256
9 | 288
10 | 320
11 | 352
12 | 384
13 | 416
14 | 448
15 | 480
16 | 512
17 | 544
18 | 576

Sheet: Hardware registers
Register Index | Register Width | Purpose
0 | 32bit | Get / Set interrupt count depth (> 0 is kernel mode)
1 | none | Reset instruction count
2 | 32bit | Get instruction count low (latches count)
3 | 32bit | Get instruction count high
4 | none | Rest clock tick count
5 | 32bit | Get clock tick count low (latches count)
6 | 32bit | Get clock tick count high
7 | bool | Get / Set Internal SRAM enable
8 | 8bit | Get / Set clock multiplier for internal operations
9 | 8bit | Get / Clear NMI waiting
10 | bool | Get / Set Watchdog timer enable
11 | 16bit | Get / Set watchdog clock rate selector
12 | 32bit | Set CPLD transient fuse
13 | none | Reset all CPLD transient fuses
14 | bool | Get / Set GPIO enable
15 | 32bit | Get GPIO pin values
16 | 8bit | Get / Set Initial flag (include high on invalid address)
17 | bool | Get / Set User flag
18 | 32bit | Get / Set Interrupt vector offset
19 | bool | Get / Set Enabled User Mode Bank remapping
20 | 16bit | Get / Set User Mode Bank width (256 is 16MB, 512 is 32MB etc…)
21 | 32bit | Get / Set memory bank remapping offset
22 | 16bit | Get / Set User process ID
23 | 32bit | Get / Set CPLD bits

Sheet: Example Block Move
 | Address | Instruction | Instruction Width | Left Operand Access | Right Operand Access | Cycles | Comment
 |  |  |  |  |  |  | V is the source address; A is the destination address; W is the number of bytes to copy (a multiple of 8)
 |  |  |  |  |  |  | The loop copies from offset W down to offset 8 (z is set when W reaches 0), so V and A start 8 below the source and destination
Setup:
 | 0 | wth A, 32 | 2 | Register | Embedded 4 | 1 | Set A width to 32 bits (A holds the destination address)
 | 2 | wth B, 64 | 2 | Register | Embedded 8 | 1 | Set B width to 64 bits
 | 4 | pul (A, V, W), S | 2 | Register | Multi Register | 7 | Pull using stack S into registers in order W, V, A. 1 + 2 words each (S aligned)
Loop:
 | 6 | cpy B, V+W | 2 | Register | Address Register Register | 5 | Copy into B the 64 bit value in address V+W. 1 + 4 words
 | 8 | cpy A+W, B | 2 | Register | Address Register Register | 5 | Copy B into address A+W. 1 + 4 words
 | 10 | sub W, 8 | 2 | Register | Embedded 8 | 1 | Decrement W by 8
 | 12 | brac z, -8 | 2 | Status | Embedded -8 | 1 | Branch back to Loop: if zero flag (z) is not set.
Done: | 14
Copies 8 bytes in 12 cycles (5 + 5 + 1 + 1, aligned, 16 bit data bus): 1.50 cycles per byte
 |  |  |  |  |  |  | W is the source address; V is the destination address; A + 1 is the number of 64 bit values to copy
Setup:
 | 0 | wtth (X, Y), 32 | 2 | Multi Register | Embedded 4 | 1
 | 2 | wth A, 32 | 2 | Register | Embedded 4 | 1
 | 4 | pul (A, V, W), S | 2 | Register | Multi Register | 7 | Pull using stack S into registers in order W, V, A. 1 + 2 words each (S aligned)
Loop:
 | 6 | vcpy W, V, +1, A, 64 | 2 | VWA |  | 9 | Copy the 64 bit value in address W into address V. Increment W by 8. Increment V by 8. Decrement A by 1. v is set when A is negative; vcpy repeats until then. 1 + 4 reads + 4 writes
Done: | 8
Copies 8 bytes in 9 cycles (aligned, 16 bit data bus): 1.13 cycles per byte

Sheet: Example VM fetch
Address | Instruction | Instruction Width | Left Operand Access | Right Operand Access | Cycles | Comment
 |  |  |  |  |  | Assume A is 32 but
0 | cpy A, [regPC:16] | 4 | Register | Address Offset | 3 | Load A with 32 bit value in 16 bit address regPC.
4 | shl A, 1 | 2 | Register | Embedded 1 | 1 (2) | Multiply A by 2 (shift left).
6 | add [regPC:16], 1 | 4 | Address Offset | Embedded 1 | 3 | Increment regPC by one
10 | jmp A | 2 | Register |  | 2 | Jump to address in register A.
 |  |  |  |  | 8 | 9 cycles in external memory

Sheet: Example Arithmetic Shift
 | Address | Instruction | Instruction Width | Left Operand Access | Right Operand Access | Cycles | Comment
 |  |  |  |  |  |  | A is the register to be shifted, X is the number of bits to shift.
Setup:
 | 0 | shr A, X | 2 | Register | Register | 2 | Set n if A is negative. Shift A right by X bits. (n is set before A is shifted)
 | 2 | gwth Y, (A, -1) | 2 | Register | Register | 2 | Copy the highest bit index of A (a) into Y.
 | 4 | stab (A, Y, X, -1), n | 4 | Multi Register | Status | 3 | Copy n into A at bit index Y for X bits decrementing Y. 3 cycles if less than 32 bits are repeated, 4 cycles if 32 or more bits.
Done: | 8 |  |  |  |  | 7

Sheet: Multiplication
Multiplier |  | Expression |  | Operand Computation | Operand Selection |  | Instruction | Cyle | Multiplicand | Multiplier | Result | Internal | D0 | D1 | A << 1 | A << 2 | A << 3 | A << 4 | -A | -(A << 1) | (A << 1)+A | (A << 2)+A | Selection | Sum | Y:n[W] + D1 | W == (b * 2) | Complete | Width A | Width B | Width Y
×0 | $0 | 0 | o0 = | 0 | 0 + 0 |  |  |  | A | B | Y | W |  |  | oC | oD | oE | oF | oG | oH | oI | oJ |  |  |  |  | v | a | b | y
×1 | $1 | A | oA = | A | A + 0 | Set A and B to 16 bit width (4 nybbles) | wtth (A, B), 16 |  |  |  |  |  |  |  |  |  |  |  |  |  |  |  |  |  |  |  |  | 2 | 2
×2 | $2 | A << 1 | oC = | A << 1 | C + 0 | Set Y to 32 bit width | wth Y, 32 |  |  |  |  |  |  |  |  |  |  |  |  |  |  |  |  |  |  |  |  | 2 | 2 | 4
×3 | $3 | (A << 1) + A | oD = | A << 2 | C + A | Pull A and B from the stack | pul A, B | all | $6A8 | $7C |  |  |  |  |  |  |  |  |  |  |  |  |  |  |  |  |  | 2 | 2 | 4
×4 | $4 | A << 2 | oE = | A << 3 | D + 0 | Zero W | cpy w, 0 | all | $6A8 | $7C |  | 0 |  |  |  |  |  |  |  |  |  |  |  |  |  |  |  | 2 | 2 | 4
×5 | $5 | (A << 2) + A | oF = | A << 4 | D + A | Multiply cycle 0 (initialisation) | mul A, B, W, Y | 0 | $6A8 | $7C | 0 | 0 | B:n[W] → |  |  |  |  |  |  |  |  |  |  |  |  | 0 |  | 2 | 2 | 4
×6 | $6 | (A << 2) + (A << 1) | oG = | -A | D + C | Multiply cycle 1 (selection and summation) |  | 1 | $6A8 | $7C | 4FE0 | 1 | $C | 4FE0 | D50 | 1AA0 | 3540 | 9270 | F958 | F2B0 | 13F8 | 2148 | 3540 + 1AA0 | 4FE0 | 4FE0 | 0 |  | 2 | 2 | 4
×7 | $7 | (A << 3) - A | oH = | -(A << 1) | E + G | Multiply cycle 0 | mul A, B, W, Y | 0 | $6A8 | $7C | 4FE0 | 1 | B:n[W] → |  |  |  |  |  |  |  |  |  |  |  |  | 0 | 0 | 2 | 2 | 4
×8 | $8 | A << 3 | oI = | (A << 1) + A | E + 0 | Multiply cycle 1 |  | 1 | $6A8 | $7C | 33960 | 2 | $7 | 33960 | D50 | 1AA0 | 3540 | 9270 | F958 | F2B0 | 13F8 | 2148 | 3540 + F958 | 2E98 | 33960 | 0 | 0 | 2 | 2 | 4
×9 | $9 | (A << 3) + A | oJ = | (A << 2) + A | E + A | Multiply cycle 0 | mul A, B, W, Y | 0 | $6A8 | $7C | 33960 | 2 | B:n[W] → |  |  |  |  |  |  |  |  |  |  |  |  | 0 | 0 | 2 | 2 | 4
×10 | $A | (A << 3) + (A << 1) |  |  | E + C | Multiply cycle 1 |  | 1 | $6A8 | $7C | 33960 | 3 | $C | 33960 | D50 | 1AA0 | 3540 | 9270 | F958 | F2B0 | 13F8 | 2148 | 0 + 0 | 0 | 33960 | 0 | 0 | 2 | 2 | 4
×11 | $B | (A << 3) + ((A << 1) + A) |  |  | E + I | Multiply cycle 0 | mul A, B, W, Y | 0 | $6A8 | $7C | 33960 | 3 | B:n[W] → |  |  |  |  |  |  |  |  |  |  |  |  | 0 | 0 | 2 | 2 | 4
×12 | $C | (A << 3) + (A << 2) |  |  | E + D | Multiply cycle 1 |  | 1 | $6A8 | $7C | 33960 | 4 | $7 | 33960 | D50 | 1AA0 | 3540 | 9270 | F958 | F2B0 | 13F8 | 2148 | 0 + 0 | 0 | 33960 | 1 | 1 | 2 | 2 | 4
×13 | $D | (A << 3) + ((A << 2) + A) |  |  | E + J | Return from subroutine | rts | all | $6A8 | $7C | 33960 | 4 |  |  |  |  |  |  |  |  |  |  |  |  |  |  | 1 | 2 | 2 | 4
×14 | $E | (A << 4) - (A << 1) |  |  | F + H
×15 | $F | (A << 4) - A |  |  | F + G

Sheet: Division
Dividend | Divisor | Quotient | Remainder
20 | 1 | 20 | 0
20 | 2 | 10 | 0
20 | 3 | 6 | 2
20 | 4 | 5 | 0
20 | 5 | 4 | 0
20 | 6 | 3 | 2
20 | 7 | 2 | 6
20 | 8 | 2 | 4
20 | 9 | 2 | 2
20 | 10 | 2 | 0
20 | 11 | 1 | 9
20 | 12 | 1 | 8
20 | 13 | 1 | 7
20 | 14 | 1 | 6 |  | 0 | 8 | 7 | r2
20 | 15 | 1 | 5 | 9 | 7 | 8
20 | 16 | 1 | 4
19 | 1 | 19 | 0 |  | 7 | 8 | 5
19 | 2 | 9 | 1
19 | 3 | 6 | 1 |  |  | 6 | 5
19 | 4 | 4 | 3
19 | 5 | 3 | 4
19 | 6 | 3 | 1
19 | 7 | 2 | 5
19 | 8 | 2 | 3
19 | 9 | 2 | 1
19 | 10 | 1 | 9
19 | 11 | 1 | 8
19 | 12 | 1 | 7
19 | 13 | 1 | 6
19 | 14 | 1 | 5
19 | 15 | 1 | 4
19 | 16 | 1 | 3
18 | 1 | 18 | 0
18 | 2 | 9 | 0
18 | 3 | 6 | 0
18 | 4 | 4 | 2
18 | 5 | 3 | 3
18 | 6 | 3 | 0
18 | 7 | 2 | 4
18 | 8 | 2 | 2
18 | 9 | 2 | 0
18 | 10 | 1 | 8
18 | 11 | 1 | 7
18 | 12 | 1 | 6
18 | 13 | 1 | 5
18 | 14 | 1 | 4
18 | 15 | 1 | 3
18 | 16 | 1 | 2
17 | 1 | 17 | 0
17 | 2 | 8 | 1
17 | 3 | 5 | 2
17 | 4 | 4 | 1
17 | 5 | 3 | 2
17 | 6 | 2 | 5
17 | 7 | 2 | 3
17 | 8 | 2 | 1
17 | 9 | 1 | 8
17 | 10 | 1 | 7
17 | 11 | 1 | 6
17 | 12 | 1 | 5
17 | 13 | 1 | 4
17 | 14 | 1 | 3
17 | 15 | 1 | 2
17 | 16 | 1 | 1
16 | 1 | 16 | 0
16 | 2 | 8 | 0
16 | 3 | 5 | 1
16 | 4 | 4 | 0
16 | 5 | 3 | 1
16 | 6 | 2 | 4
16 | 7 | 2 | 2
16 | 8 | 2 | 0
16 | 9 | 1 | 7
16 | 10 | 1 | 6
16 | 11 | 1 | 5
16 | 12 | 1 | 4
16 | 13 | 1 | 3
16 | 14 | 1 | 2
16 | 15 | 1 | 1
16 | 16 | 1 | 0
15 | 1 | 15 | 0
15 | 2 | 7 | 1
15 | 3 | 5 | 0
15 | 4 | 3 | 3
15 | 5 | 3 | 0
15 | 6 | 2 | 3
15 | 7 | 2 | 1
15 | 8 | 1 | 7
15 | 9 | 1 | 6
15 | 10 | 1 | 5
15 | 11 | 1 | 4
15 | 12 | 1 | 3
15 | 13 | 1 | 2
15 | 14 | 1 | 1
15 | 15 | 1 | 0
15 | 16 | 0 | 15
14 | 1 | 14 | 0
14 | 2 | 7 | 0
14 | 3 | 4 | 2
14 | 4 | 3 | 2
14 | 5 | 2 | 4
14 | 6 | 2 | 2
14 | 7 | 2 | 0
14 | 8 | 1 | 6
14 | 9 | 1 | 5
14 | 10 | 1 | 4
14 | 11 | 1 | 3
14 | 12 | 1 | 2
14 | 13 | 1 | 1
14 | 14 | 1 | 0
14 | 15 | 0 | 14
14 | 16 | 0 | 14
13 | 1 | 13 | 0
13 | 2 | 6 | 1
13 | 3 | 4 | 1
13 | 4 | 3 | 1
13 | 5 | 2 | 3
13 | 6 | 2 | 1
13 | 7 | 1 | 6
13 | 8 | 1 | 5
13 | 9 | 1 | 4
13 | 10 | 1 | 3
13 | 11 | 1 | 2
13 | 12 | 1 | 1
13 | 13 | 1 | 0
13 | 14 | 0 | 13
13 | 15 | 0 | 13
13 | 16 | 0 | 13
