andrewpaterson/658-Computer/Apple II/Apple II BOM.png

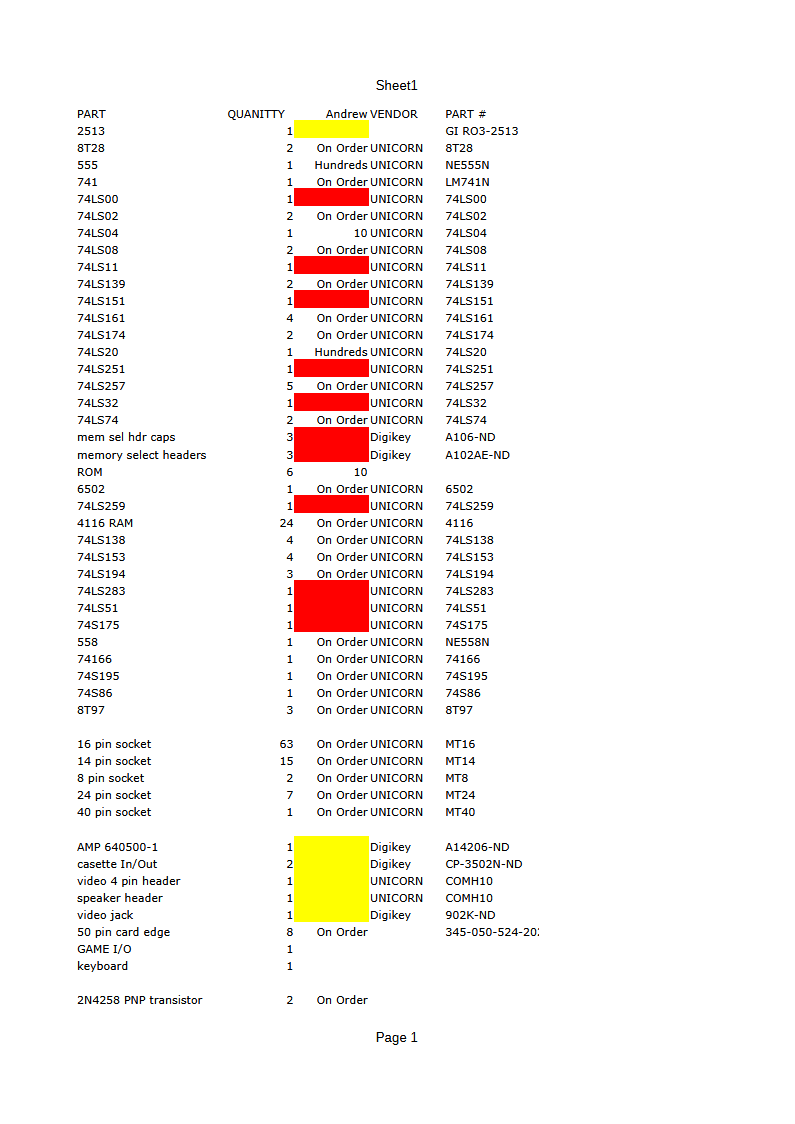
Apple II/Apple II BOM.png
