andrewpaterson/658-Computer/Kicad/Computer/MPU/HCP65 Main Memory Data/Main Memory Data.step

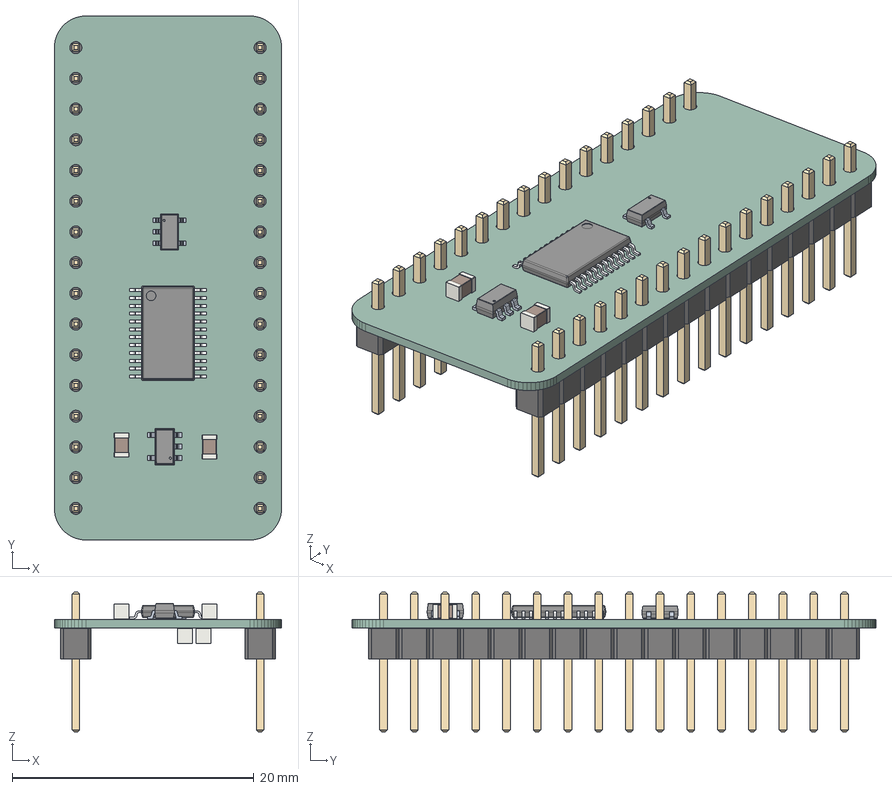
[picture p157: CAD file, 2023-12-05]
Kicad/Computer/MPU/HCP65 Main Memory Data/Main Memory Data.step
18.8 x 43.3 x 11.5 mm
HCP65 Main Memory Data PCB
