andrewpaterson/658-Computer/Kicad/Computer/Component Boards/Address Buffer/Address Buffer.step

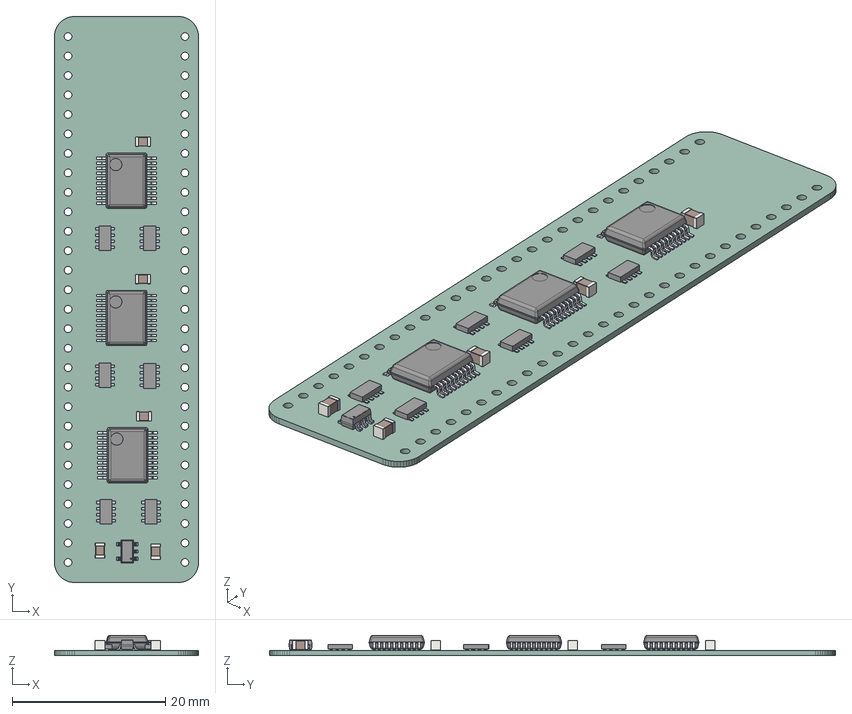
[picture p158: CAD file, 2023-11-19]
Kicad/Computer/Component Boards/Address Buffer/Address Buffer.step
18.8 x 73.8 x 2.63 mm
Address Buffer PCB
