andrewpaterson/658-Computer/Kicad/Computer/Component Boards/GPIO 16bit/GPIO 16bit.step

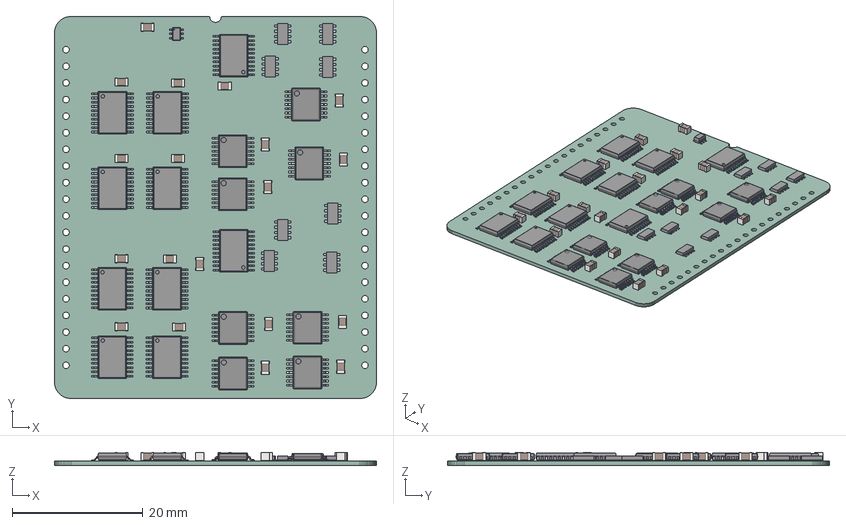
[picture p159: CAD file, 2024-02-10]
Kicad/Computer/Component Boards/GPIO 16bit/GPIO 16bit.step
49.3 x 58.4 x 1.98 mm
GPIO 16bit PCB
