andrewpaterson/658-Computer/Kicad/Computer/Main/Clock Generator/Clock Generator.step

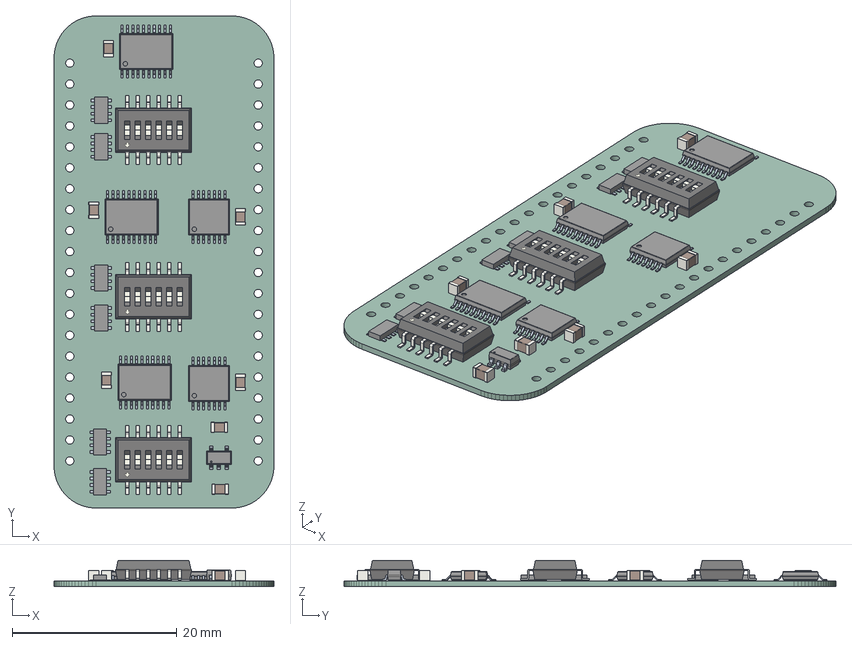
[picture p160: CAD file, 2023-11-19]
Kicad/Computer/Main/Clock Generator/Clock Generator.step
26.7 x 59.7 x 3.18 mm
Clock Hold Select PCB
