andrewpaterson/658-Computer/Kicad/Computer/PS2/PS2 FIFO/PS2 FIFO.step

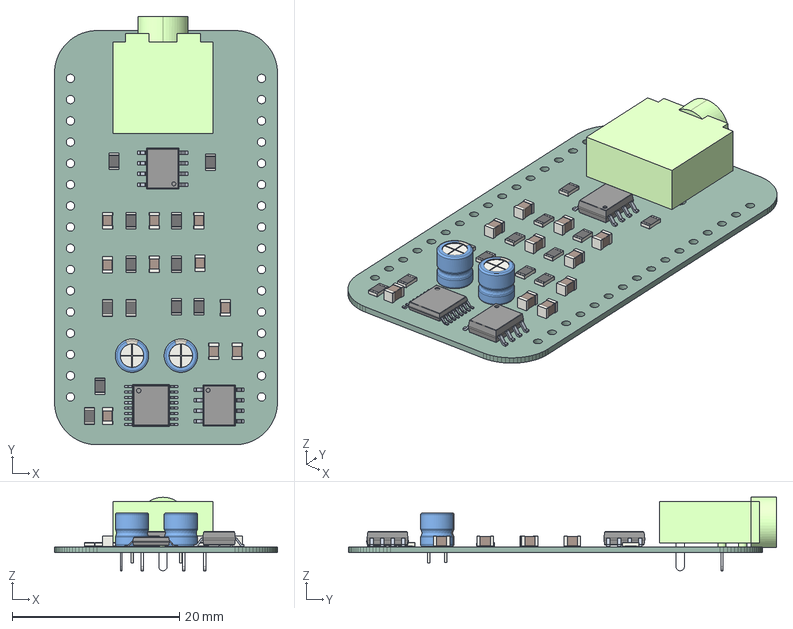
[picture p161: CAD file, 2023-10-10]
Kicad/Computer/PS2/PS2 FIFO/PS2 FIFO.step
26.7 x 51.2 x 8.80 mm
Audio DAC PCB
