andrewpaterson/658-Computer/Kicad/Computer/VIA/VIA Clock Control/VIA Clock Control.step

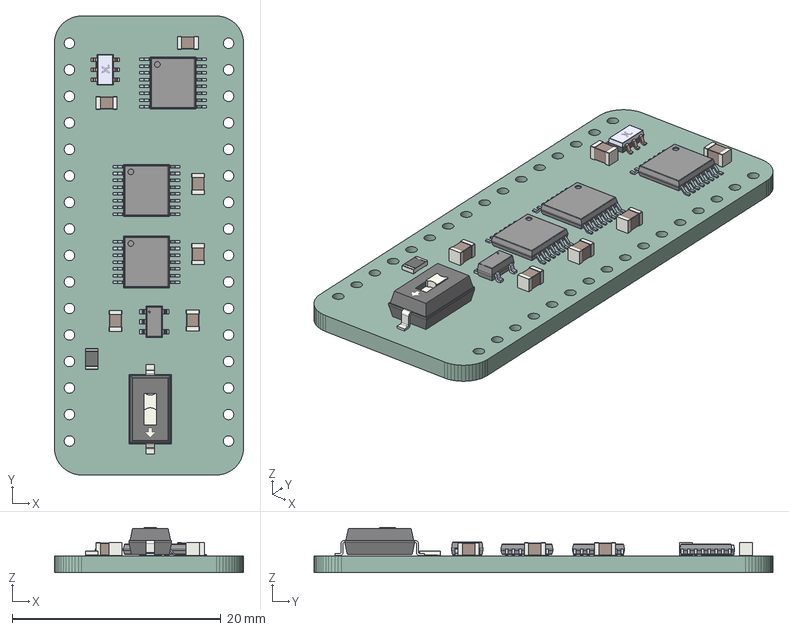
[picture p162: CAD file, 2023-10-23]
Kicad/Computer/VIA/VIA Clock Control/VIA Clock Control.step
18.1 x 44.0 x 4.33 mm
VIA Clock Control PCB
