andrewpaterson/658-Computer/Kicad/Computer/Video/Pixel Doubler/Pixel Doubler.step

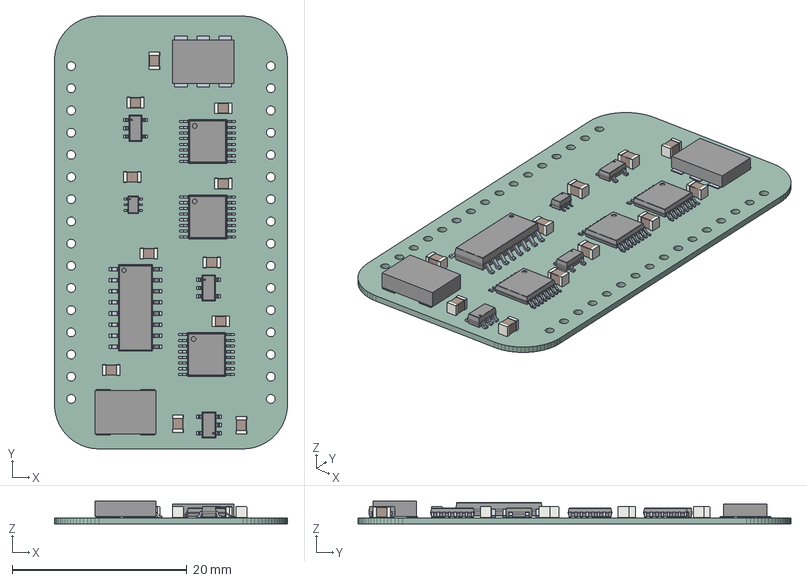
[picture p163: CAD file, 2023-10-11]
Kicad/Computer/Video/Pixel Doubler/Pixel Doubler.step
26.7 x 49.5 x 2.63 mm
Sound Clock PCB
