andrewpaterson/658-Computer/Kicad/Computer/Video/Video Address Counter/Video Address Counter.step

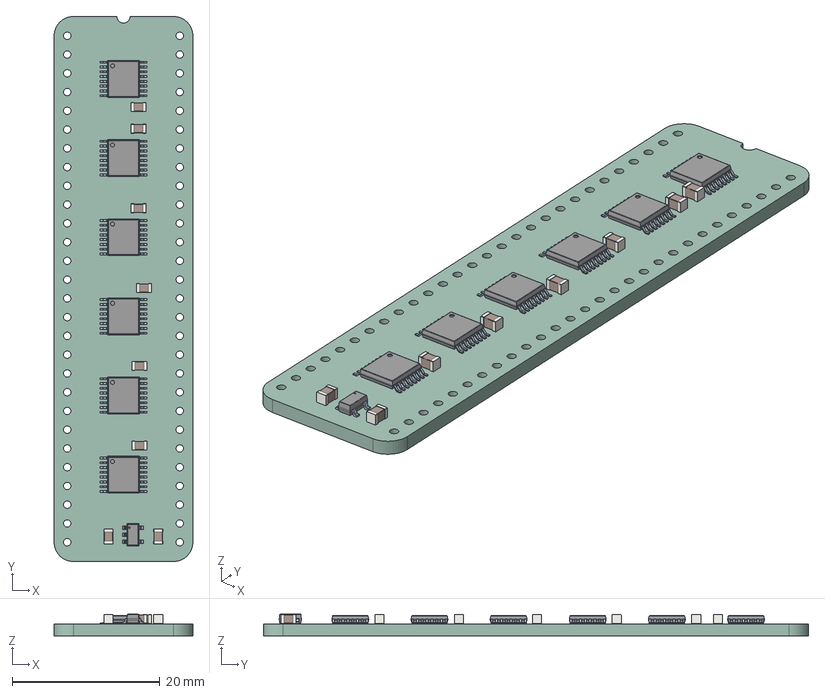
[picture p164: CAD file, 2024-06-30]
Kicad/Computer/Video/Video Address Counter/Video Address Counter.step
18.8 x 73.8 x 2.95 mm
C_0805_2012Metric x 8
ASSEMBLY x 7
Video Address Counter_PCB
