andrewpaterson/658-Computer/(list of files, cad)

Other CAD files:
WDC/SimpleC/main.obj
Test658/Test658Kernal.obj
TestHCP65.0/TestHCP650.obj
WDC/TestASM/TestArithmetic.obj
Test658/Test658User.obj
WDC/TestASM/Test65816.obj
