andrewpaterson/658-Computer/Pictures/816BodgeBoardOperation.png

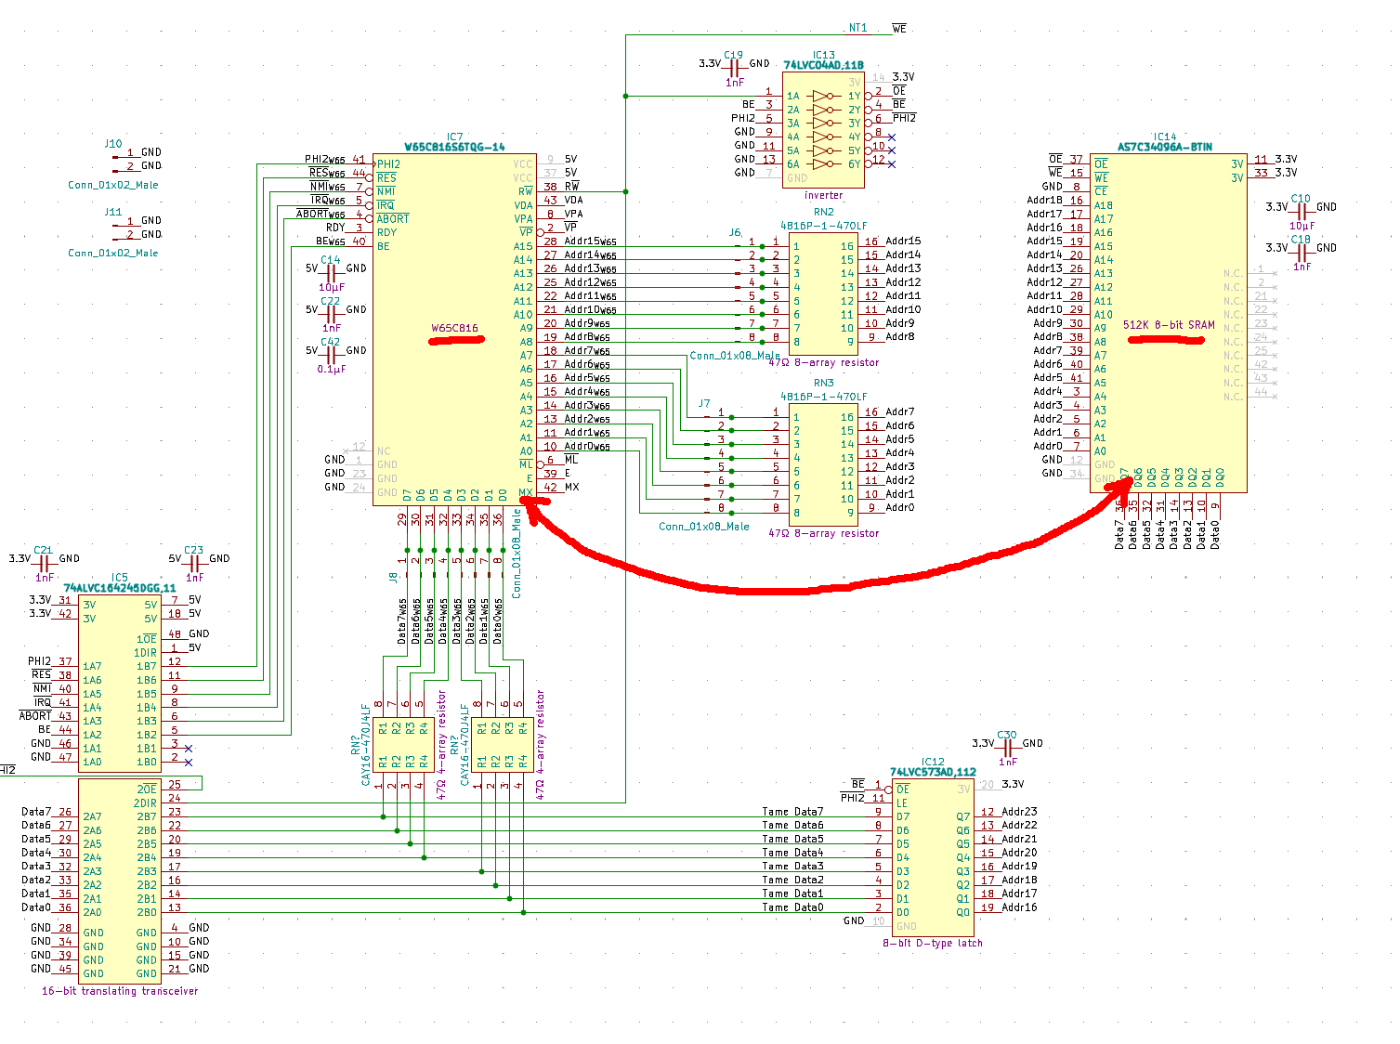
Pictures/816BodgeBoardOperation.png
