andrewpaterson/658-Computer/Pictures/Calling Conventiion/Function Setup.png

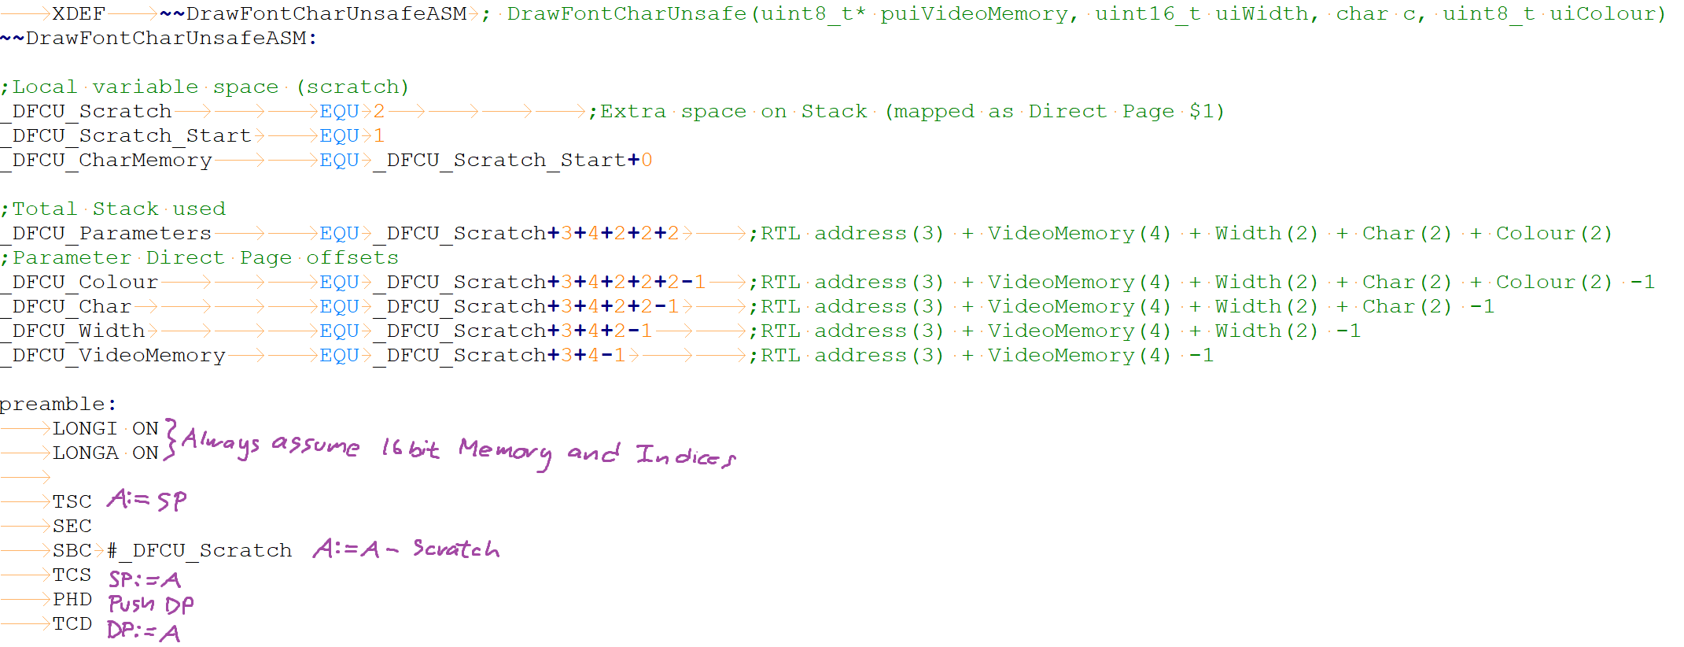
Pictures/Calling Conventiion/Function Setup.png
