andrewpaterson/658-Computer/Pictures/Calling Conventiion/Function Stack after Setup.png

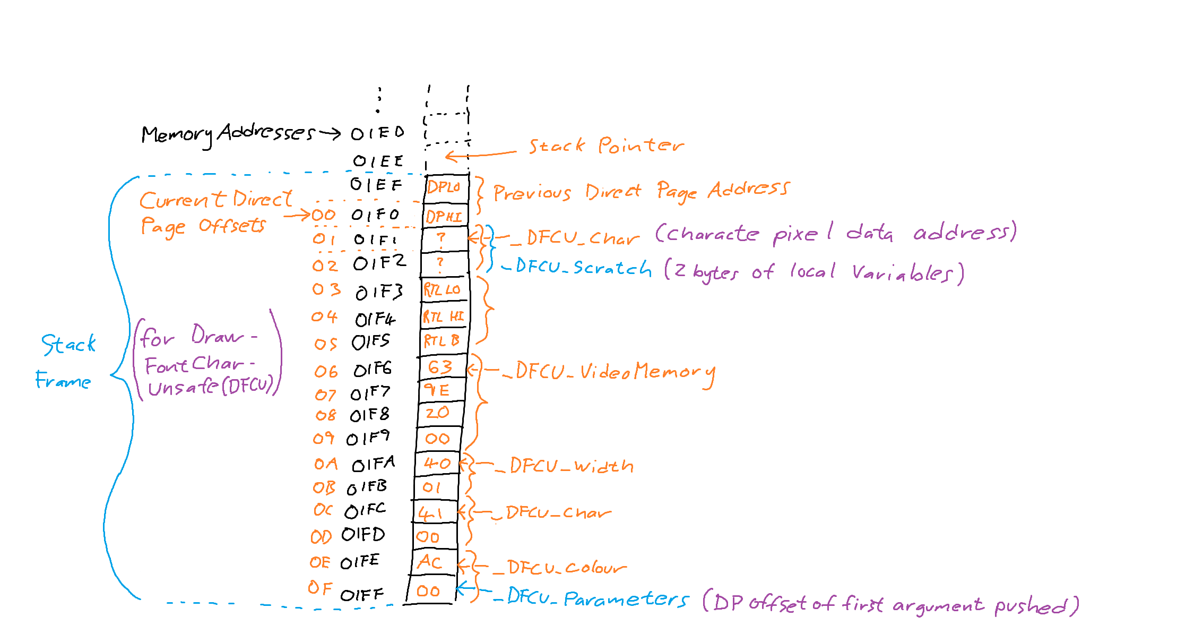
Pictures/Calling Conventiion/Function Stack after Setup.png
