andrewpaterson/658-Computer/Pictures/Calling Conventiion/Function Stack before Setup.png

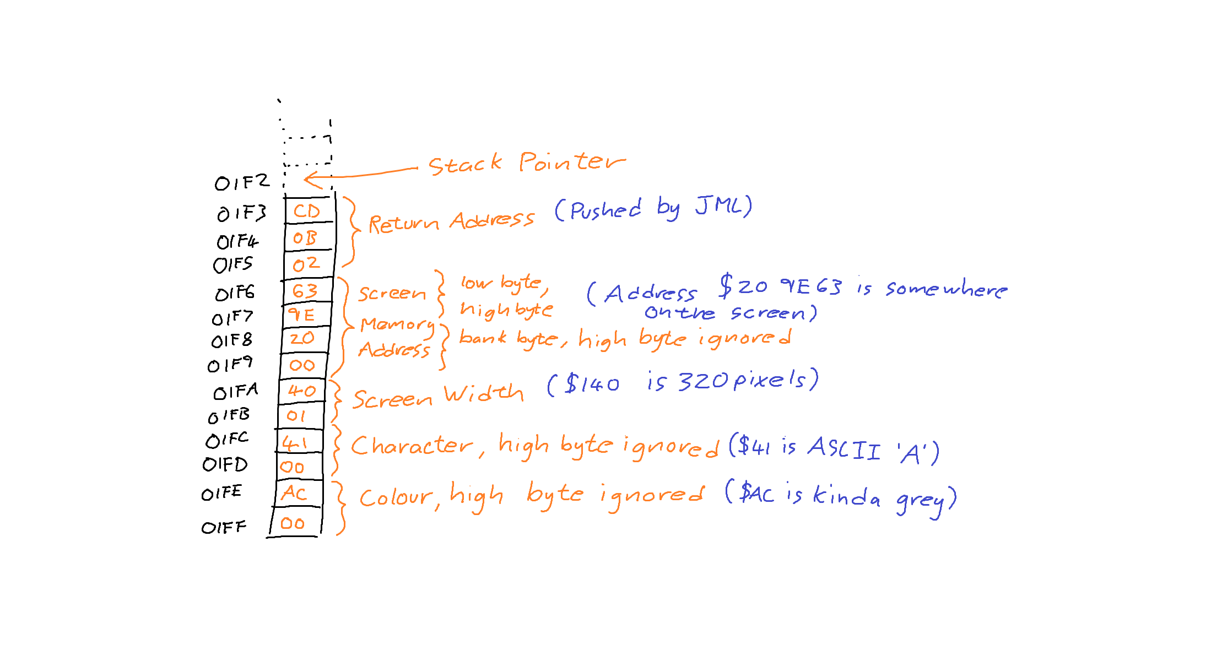
Pictures/Calling Conventiion/Function Stack before Setup.png
