andrewpaterson/658-Computer/Pictures/Calling Conventiion/PEA Instruction.png

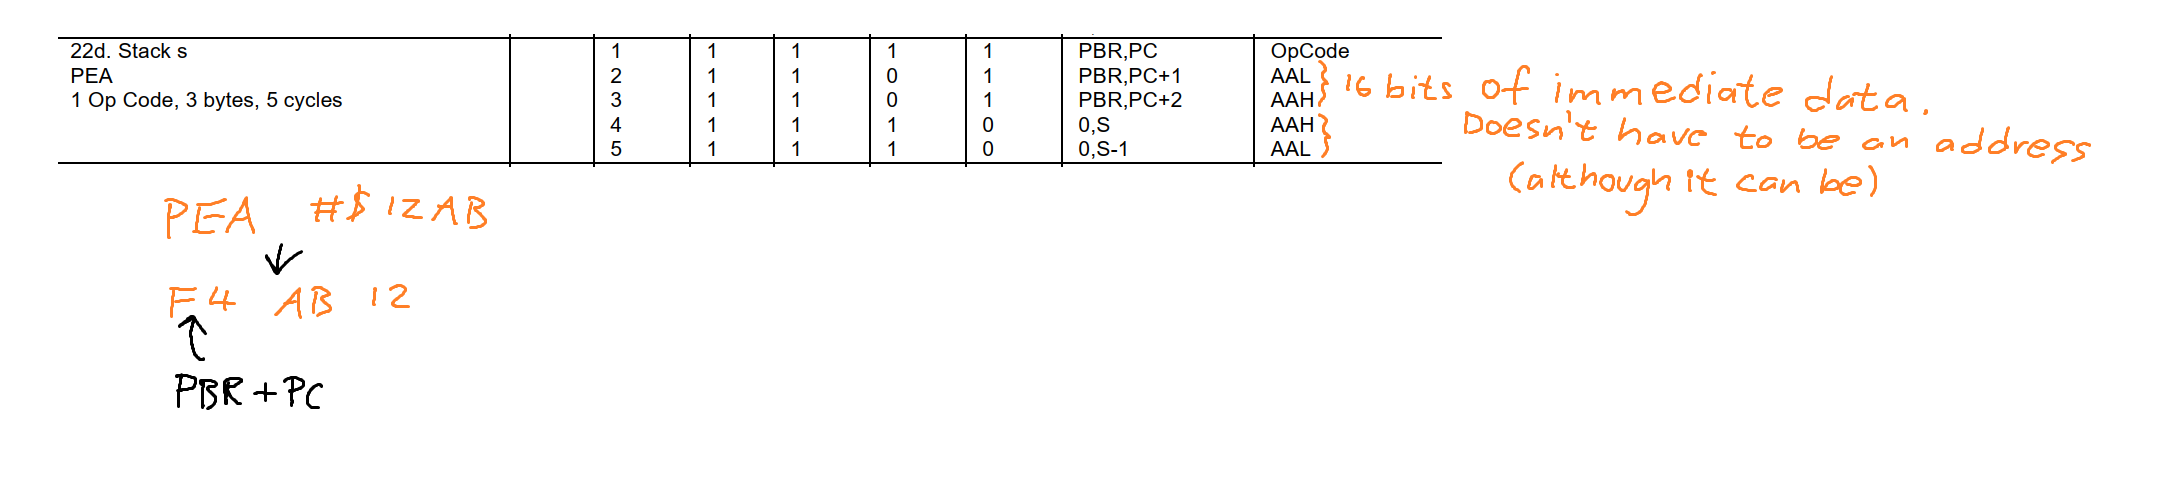
Pictures/Calling Conventiion/PEA Instruction.png
