andrewpaterson/658-Computer/Pictures/Calling Conventiion/PEI Instruction.png

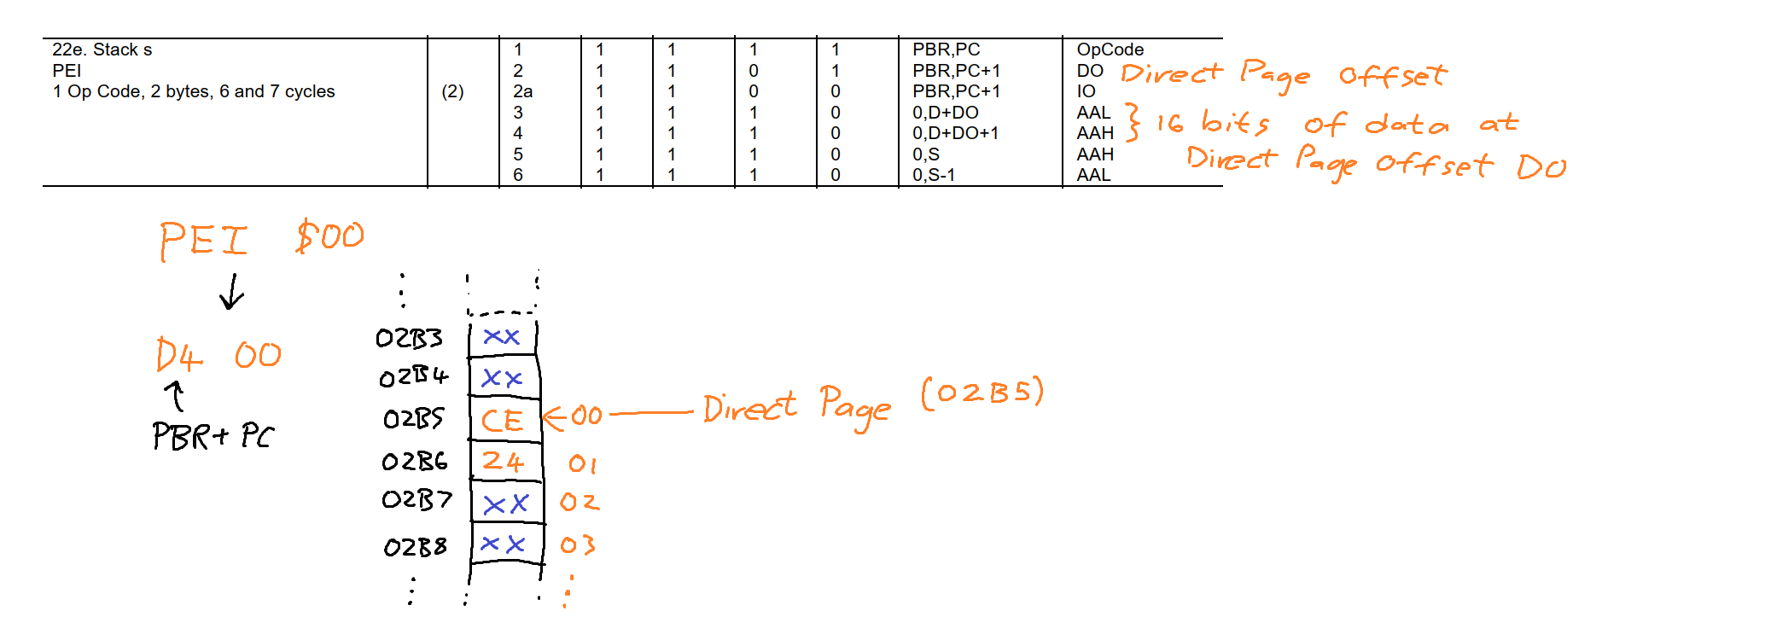
Pictures/Calling Conventiion/PEI Instruction.png
