andrewpaterson/658-Computer/W65C64/Instruction Set - sample.png

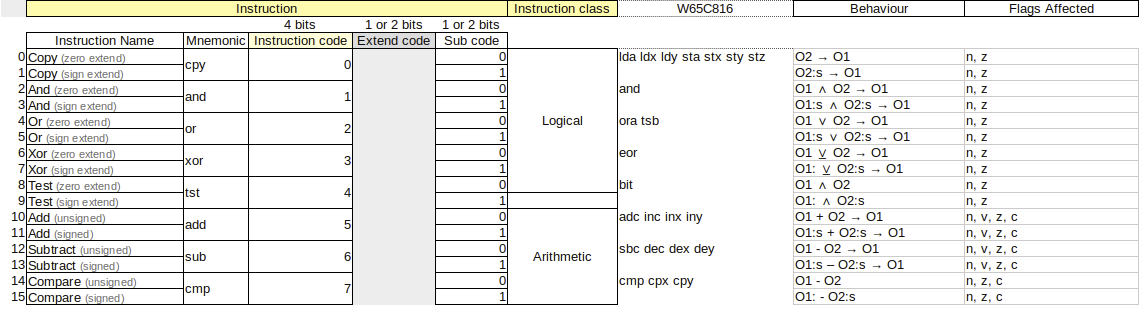
W65C64/Instruction Set - sample.png
