andrewpaterson/658-Computer/W65C64/Instruction Set.png

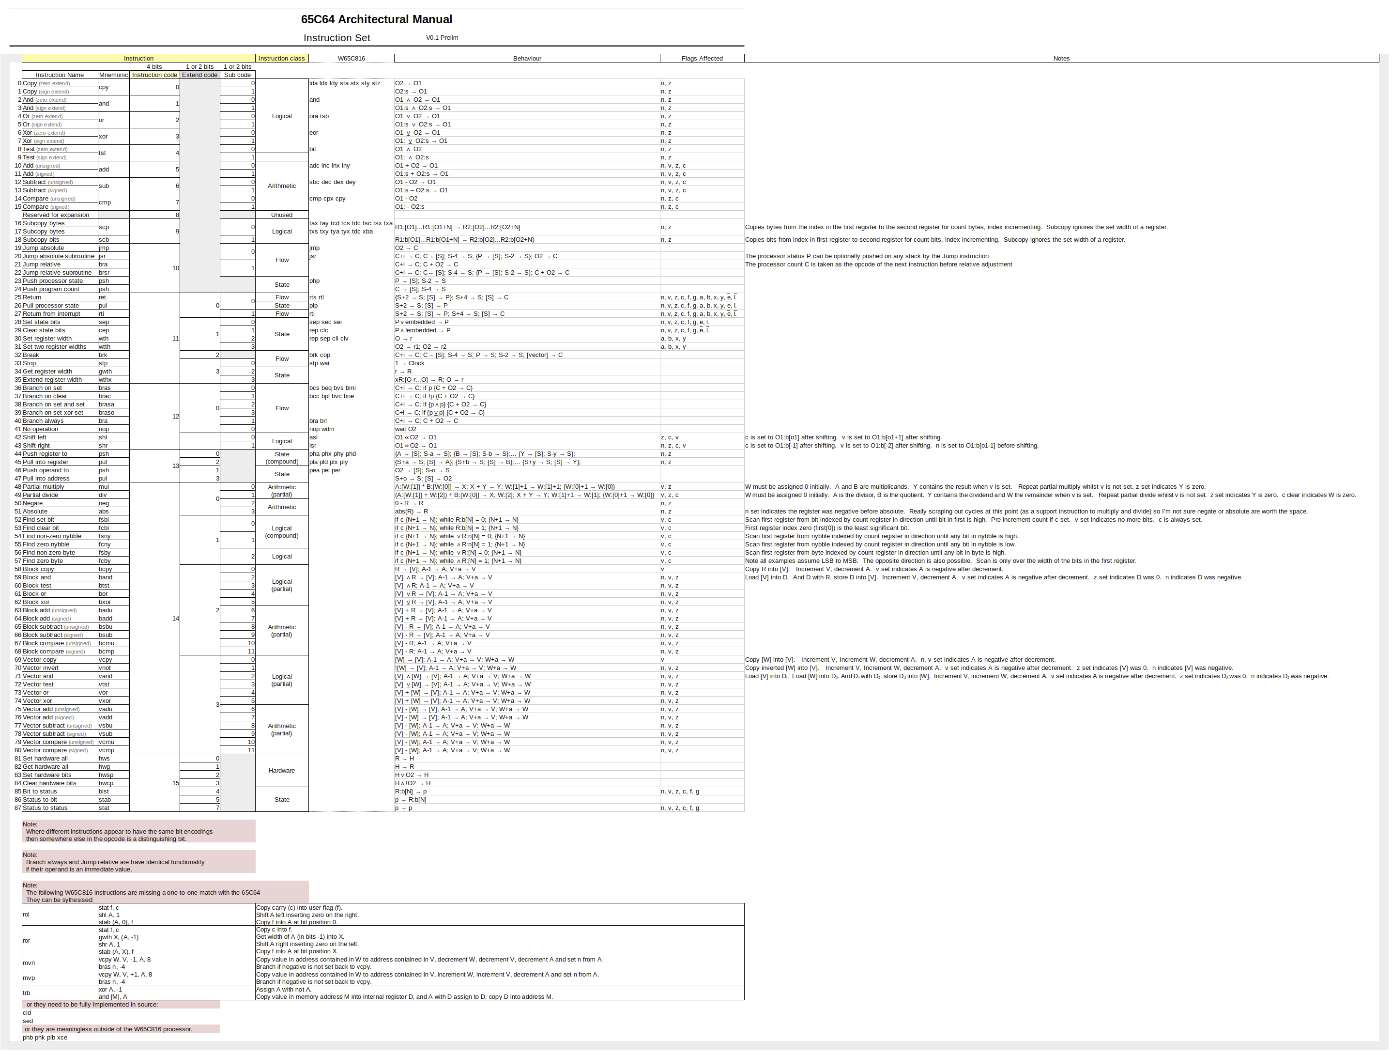
W65C64/Instruction Set.png
