andrewpaterson/658-Computer/Kicad/Pico/40 Pin Tester Initialisation.txt

#Power board
P5a1
PGb1

#Standard power
PGd1
P5c1

#All Power
#0111 1101 1111 1011 1011 0111 1101 1111 1011 1011
O7DFBB7DFBB

#Standard Power
#1111 1101 1111 1011 1011 1111 1101 1111 1011 1011
OFDFBBFDFBB

#Write All
WFFFFFFFFFF
