andrewpaterson/658-Computer/Pictures/Calling Conventiion/PEA Result.png

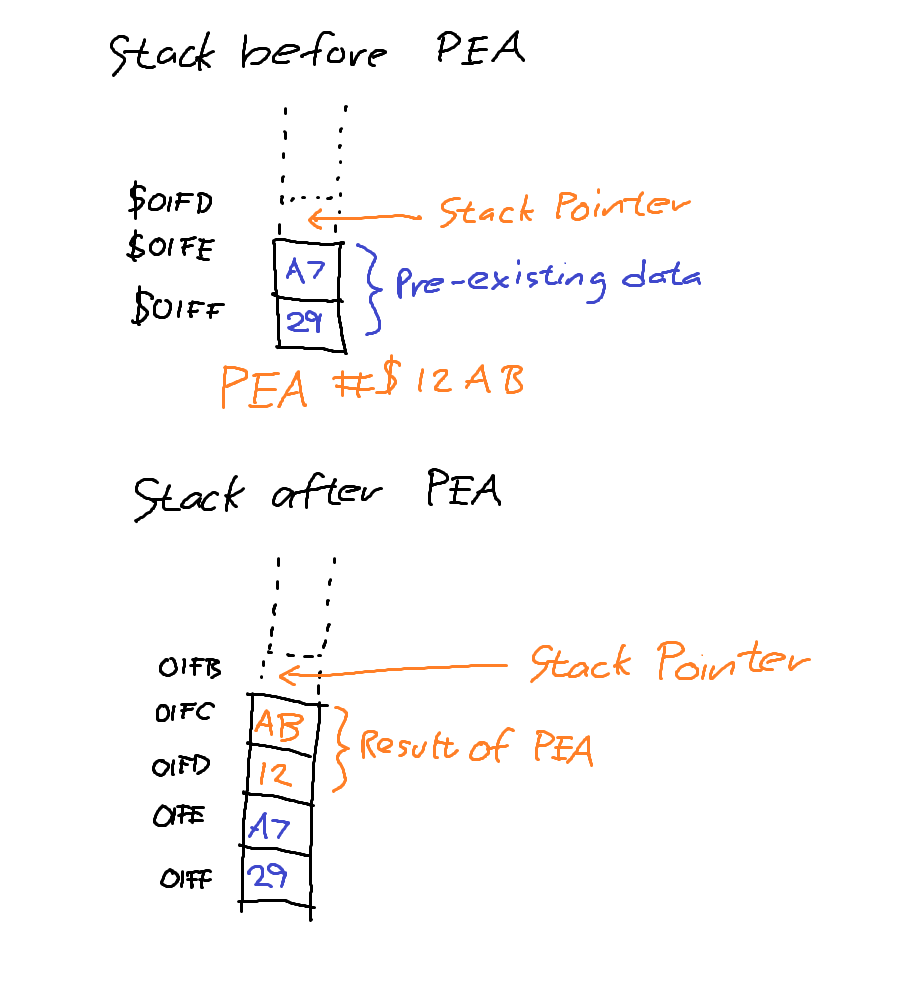
Pictures/Calling Conventiion/PEA Result.png
