andrewpaterson/658-Computer/Pictures/Calling Conventiion/PEI Result.png

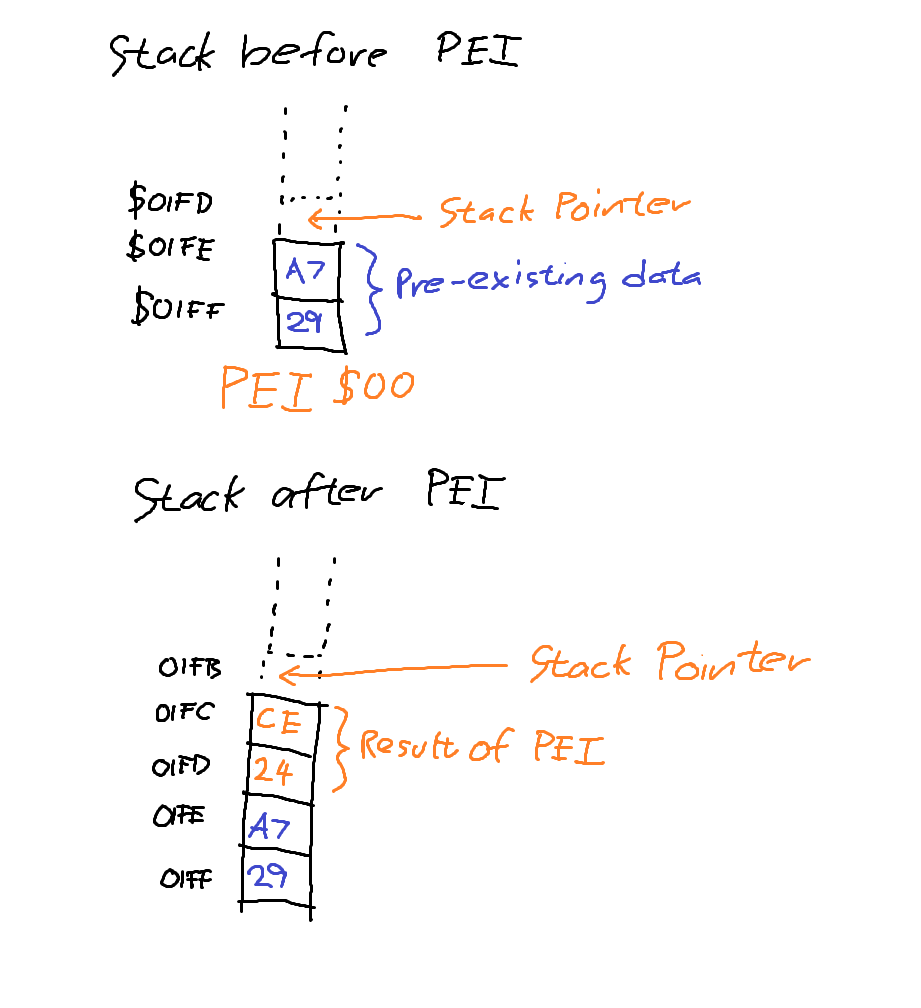
Pictures/Calling Conventiion/PEI Result.png
