andrewpaterson/658-Computer/Logicim/src/net/logicim/test/Todo.txt

Mouse move during click must discard double click
Keyboard shortcuts requiring the edit window must not work when not in the window
Two identical traces in a bus show as a single trace
Update subcircuit view pins should cause subcircuit instances to be recreated
Pin outputs forced editable
Flip component
User error messages
Constants
Probes
Drive strength / pull resistors
Change logic gate
74LVC4245
SRAM
Drag wires on move
