andrewpaterson/658-Computer/Pictures/Debug Display/Front Gerbers.png

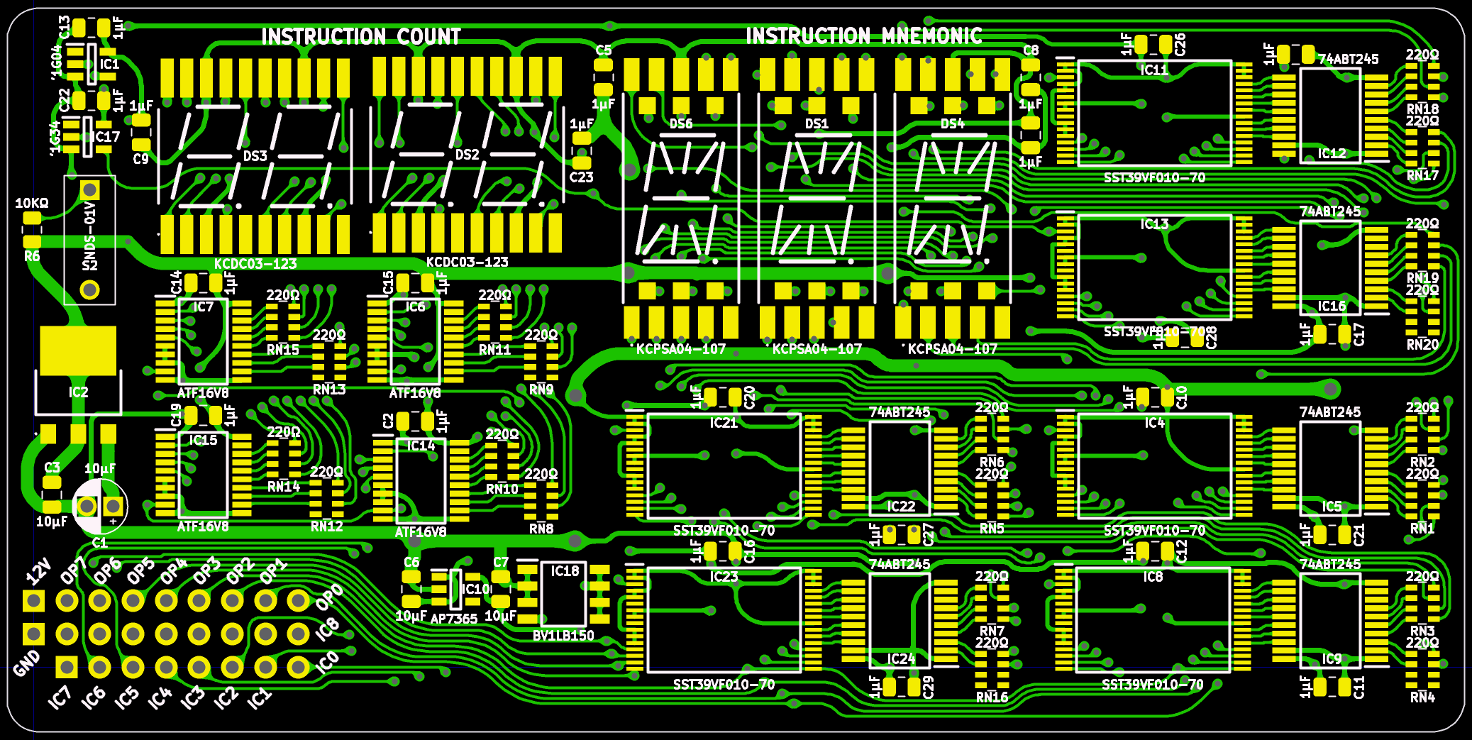
Pictures/Debug Display/Front Gerbers.png
