andrewpaterson/658-Computer/Pictures/Debug Display/Signal Debug.png

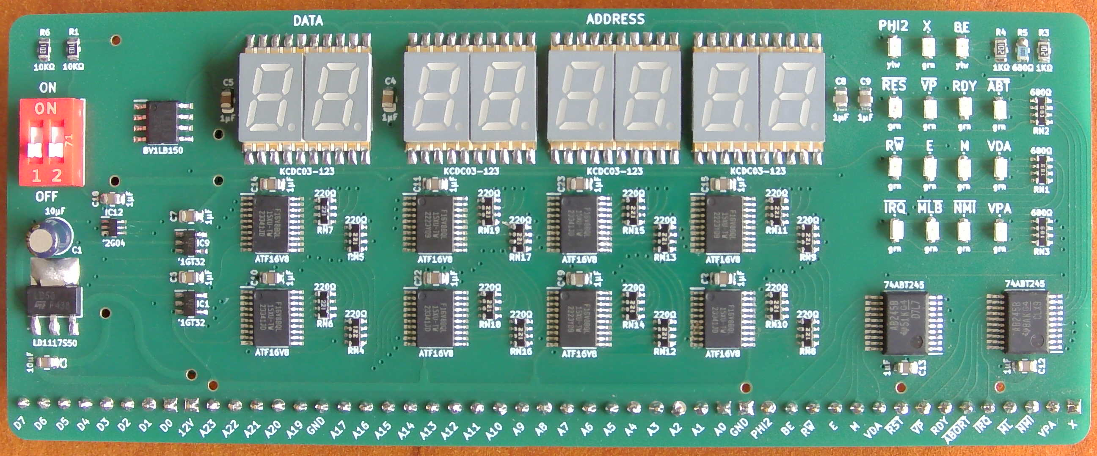
Pictures/Debug Display/Signal Debug.png
