andrewpaterson/658-Computer/Pictures/Video Card/Memory Schematic - BW.pdf

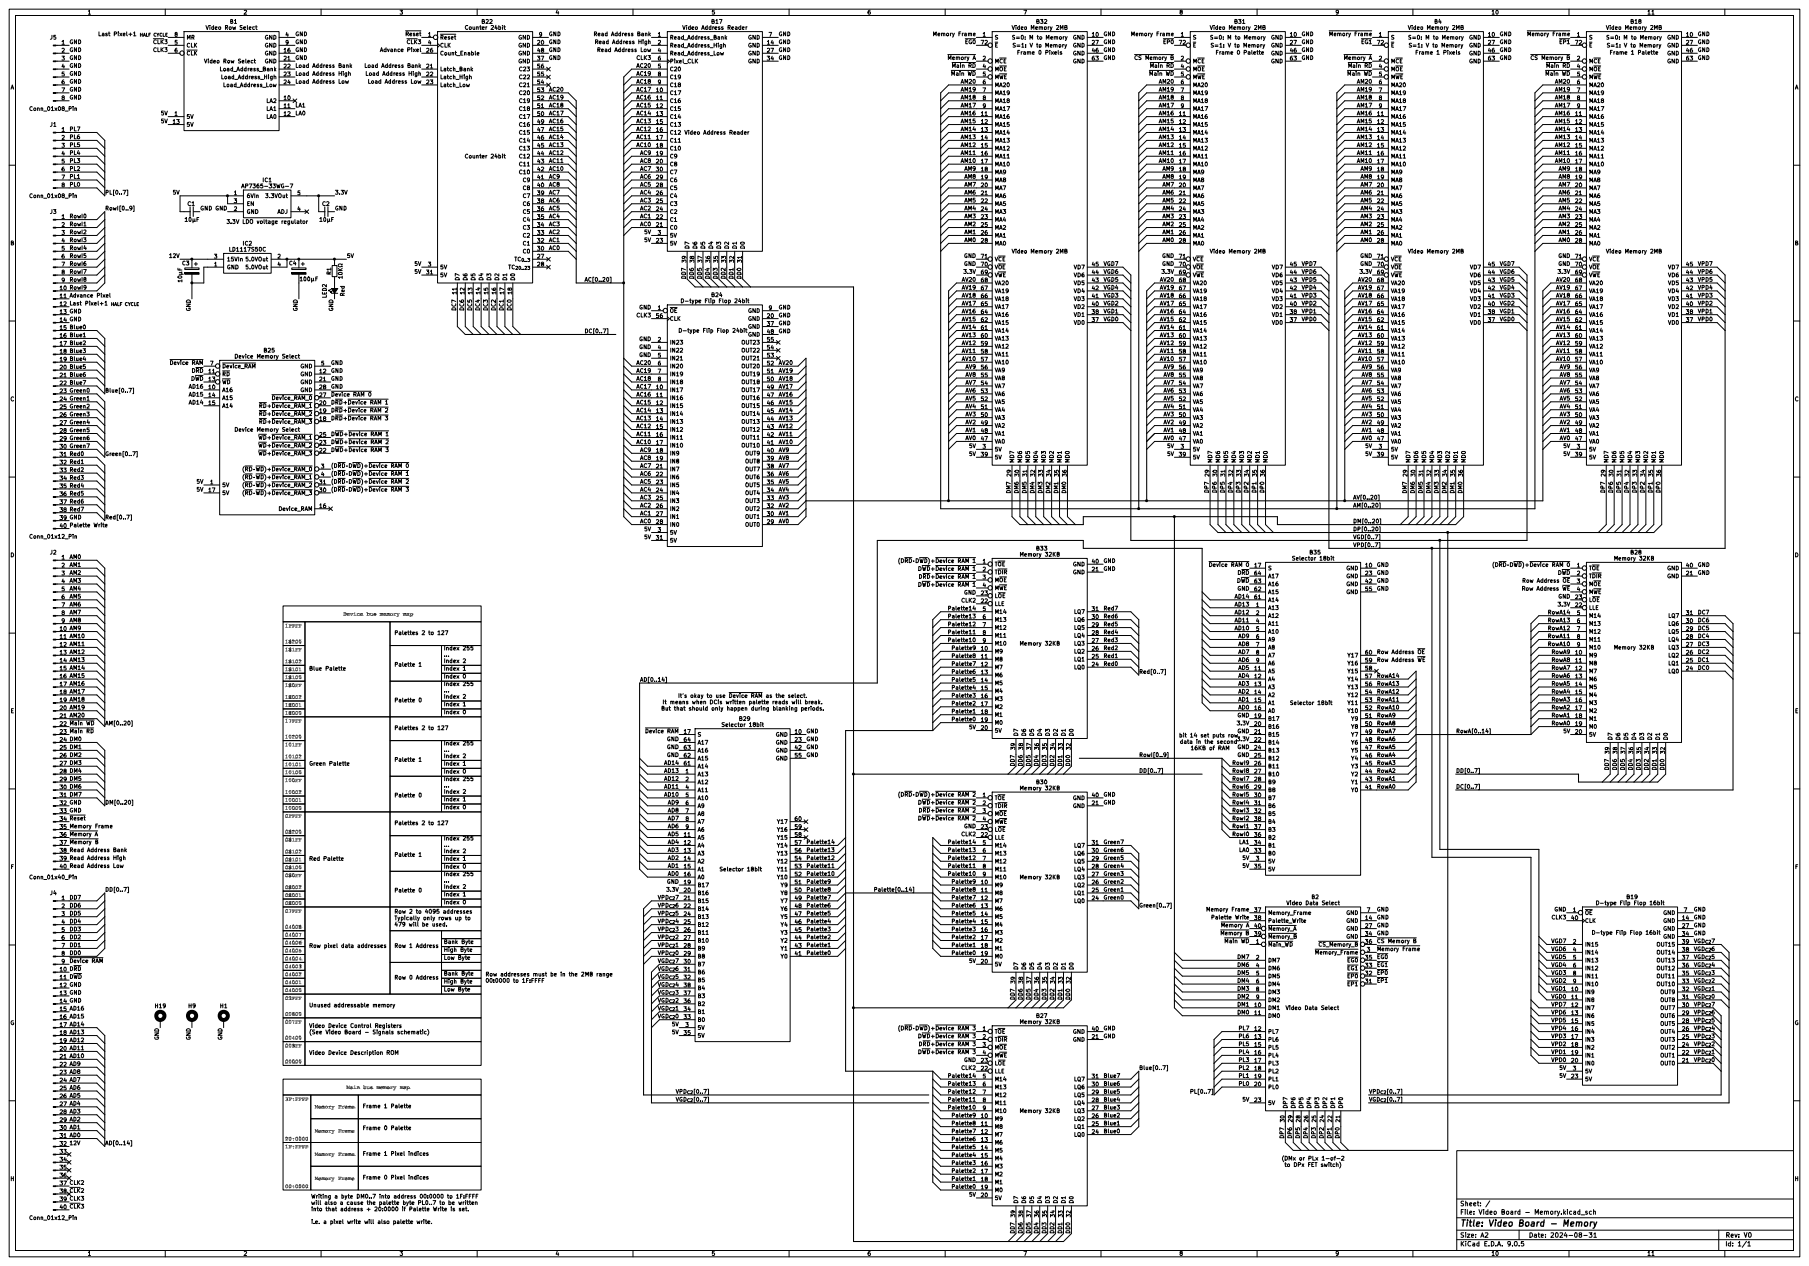
[picture p177: page 1]
