andrewpaterson/658-Computer/Pictures/Video Card/Memory Schematic.pdf

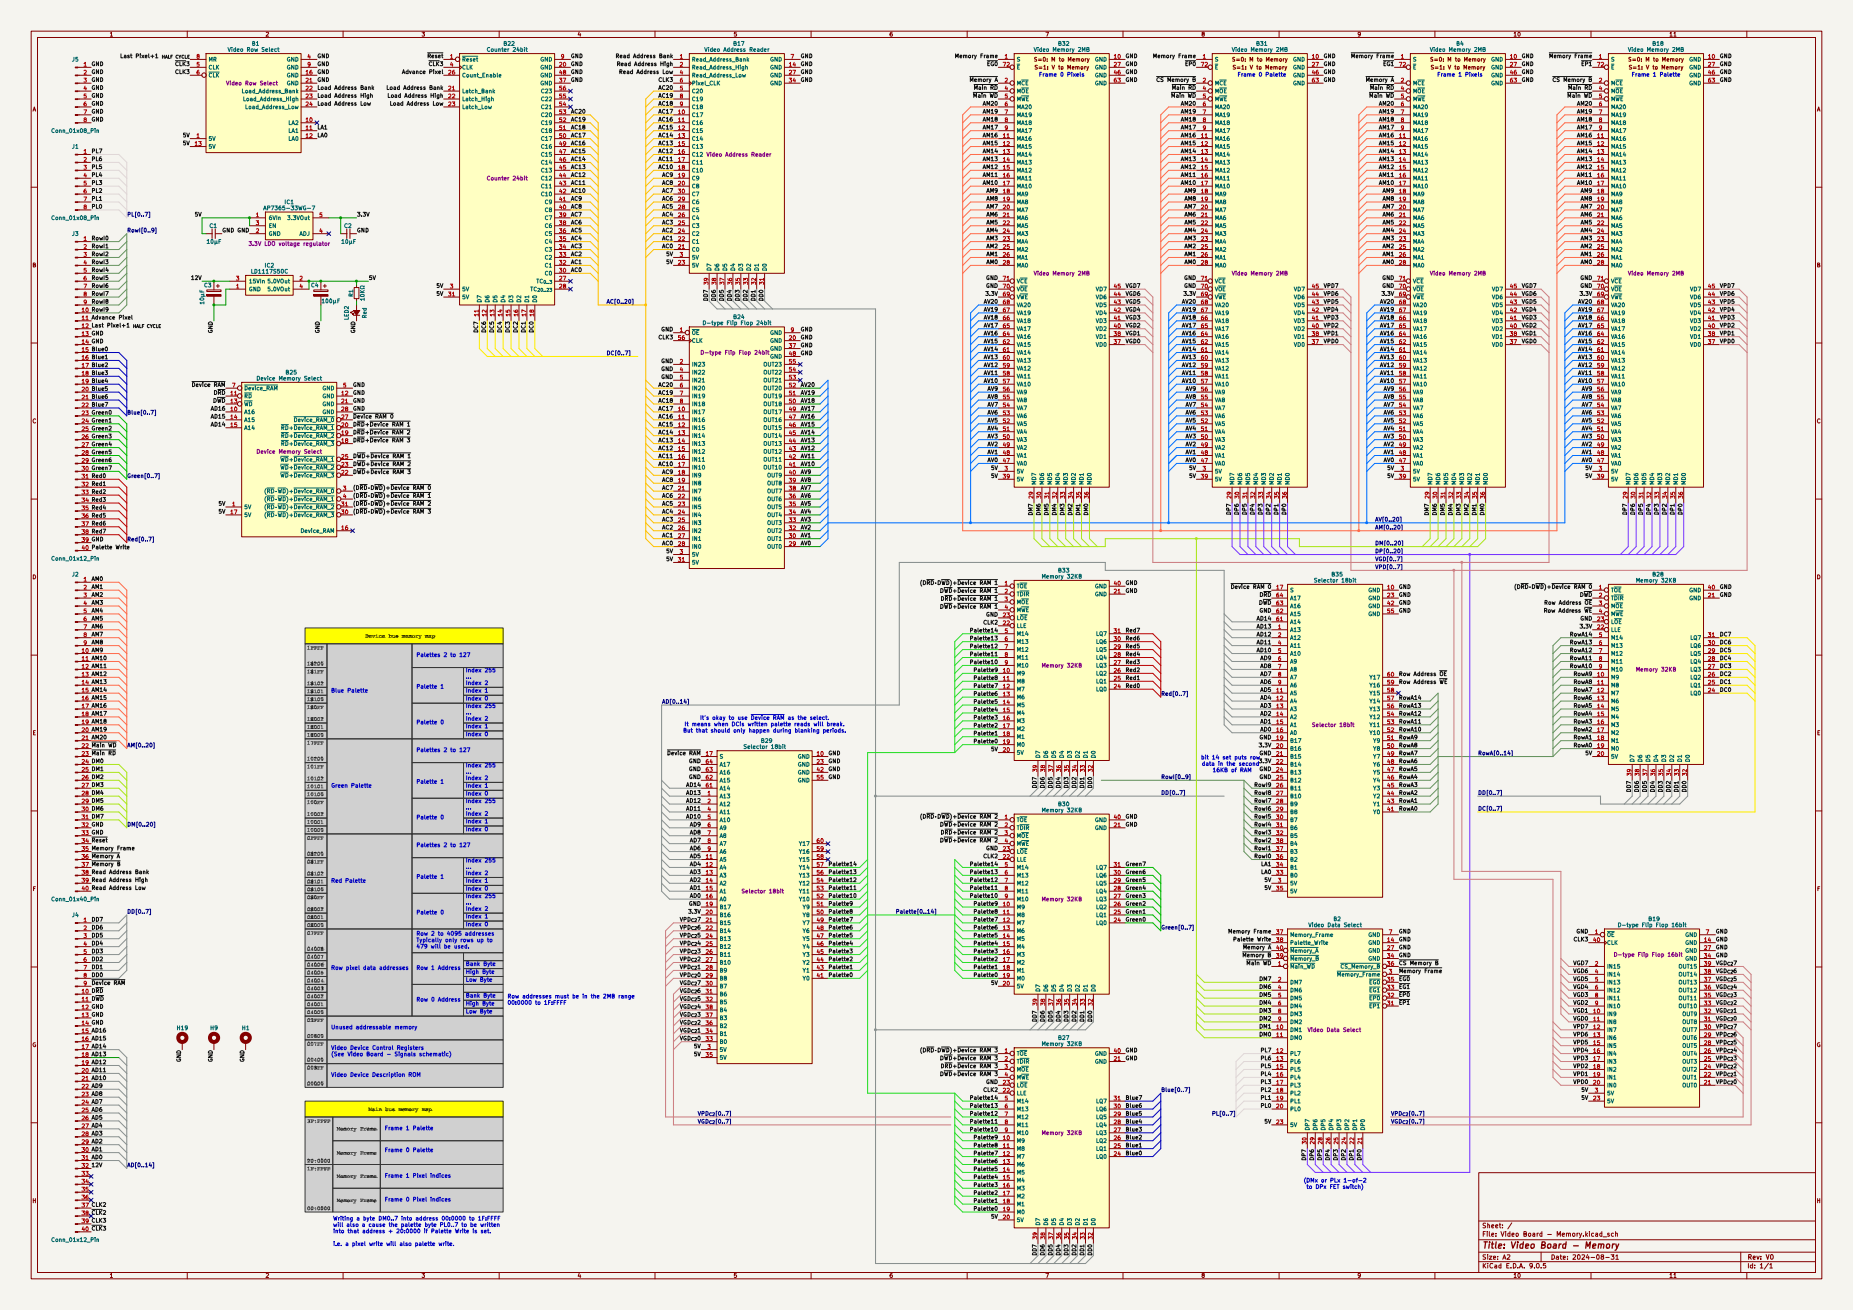
[picture p178: page 1]
