andrewpaterson/658-Computer/Pictures/Video Card/Signals Schematic - BW.pdf

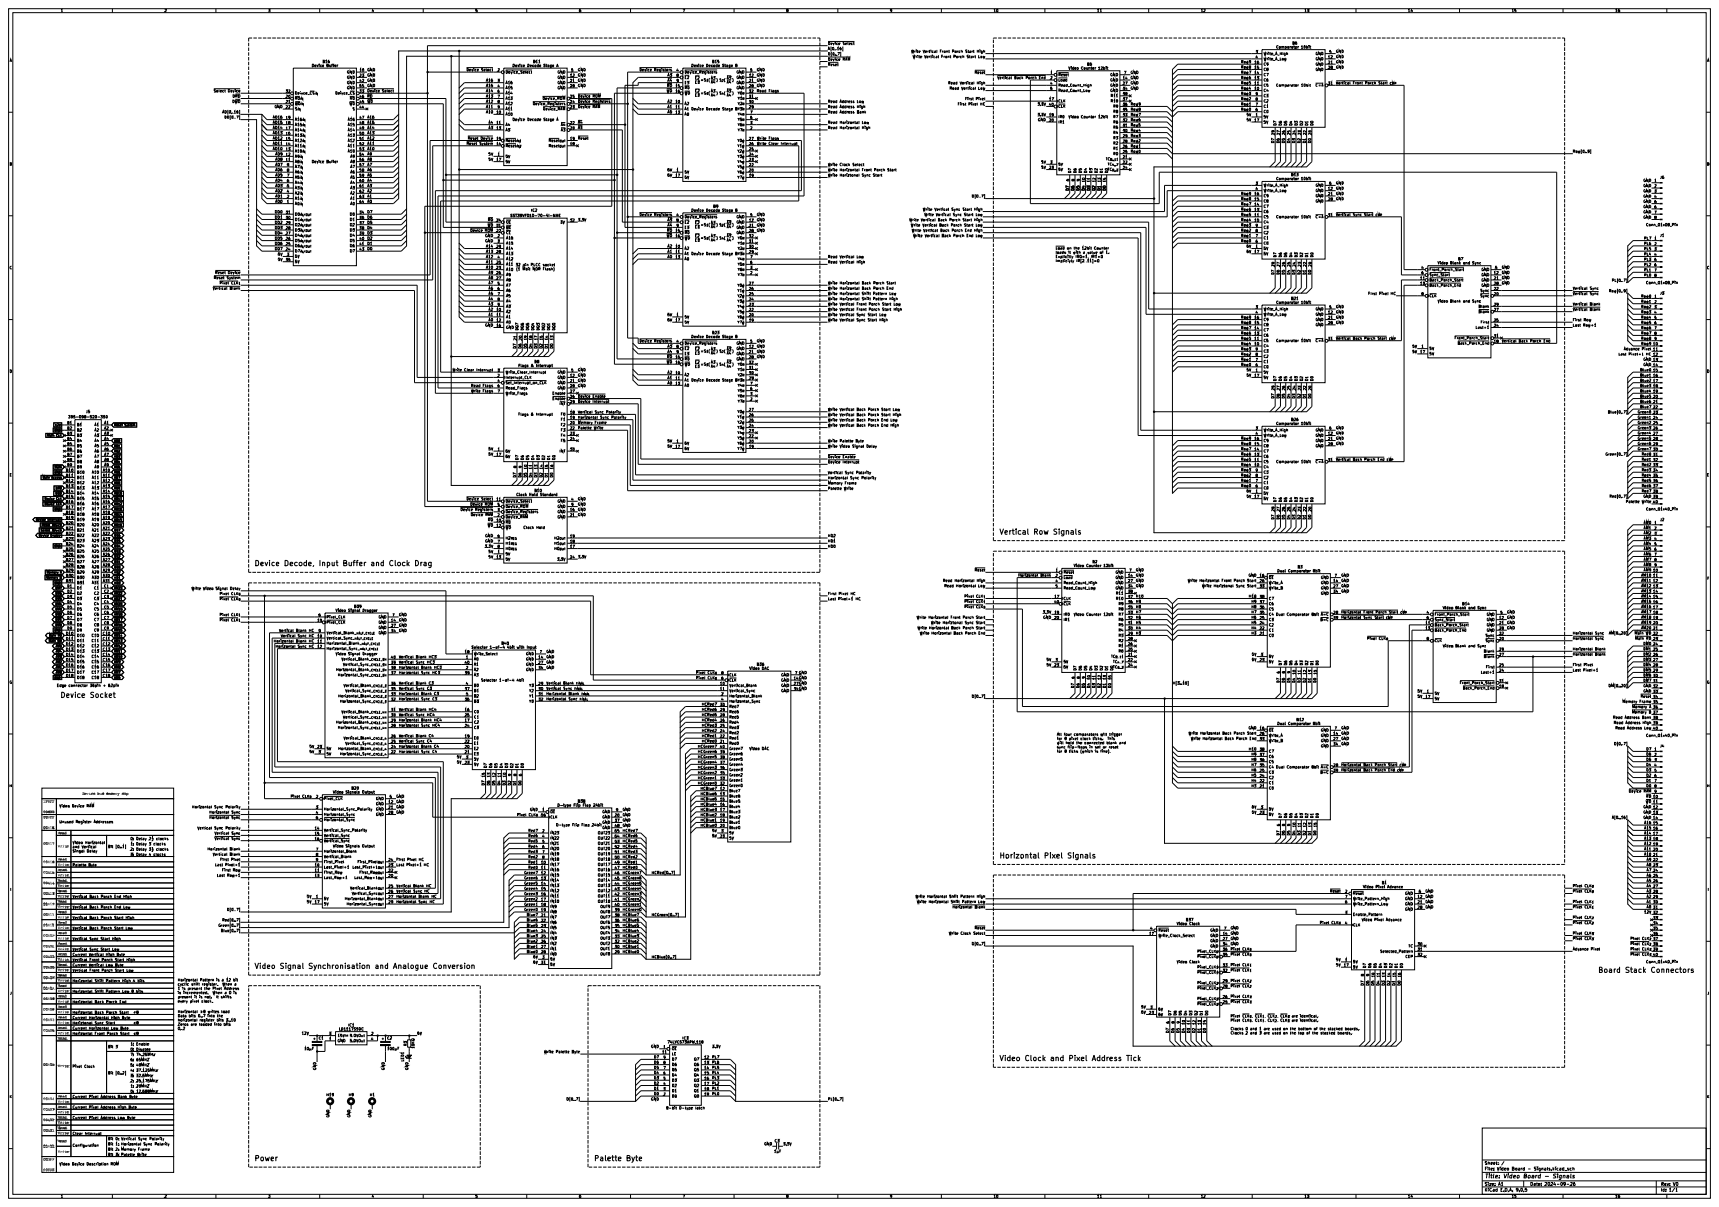
[picture p179: page 1]
