andrewpaterson/658-Computer/Pictures/Video Card/Signals Schematic.pdf

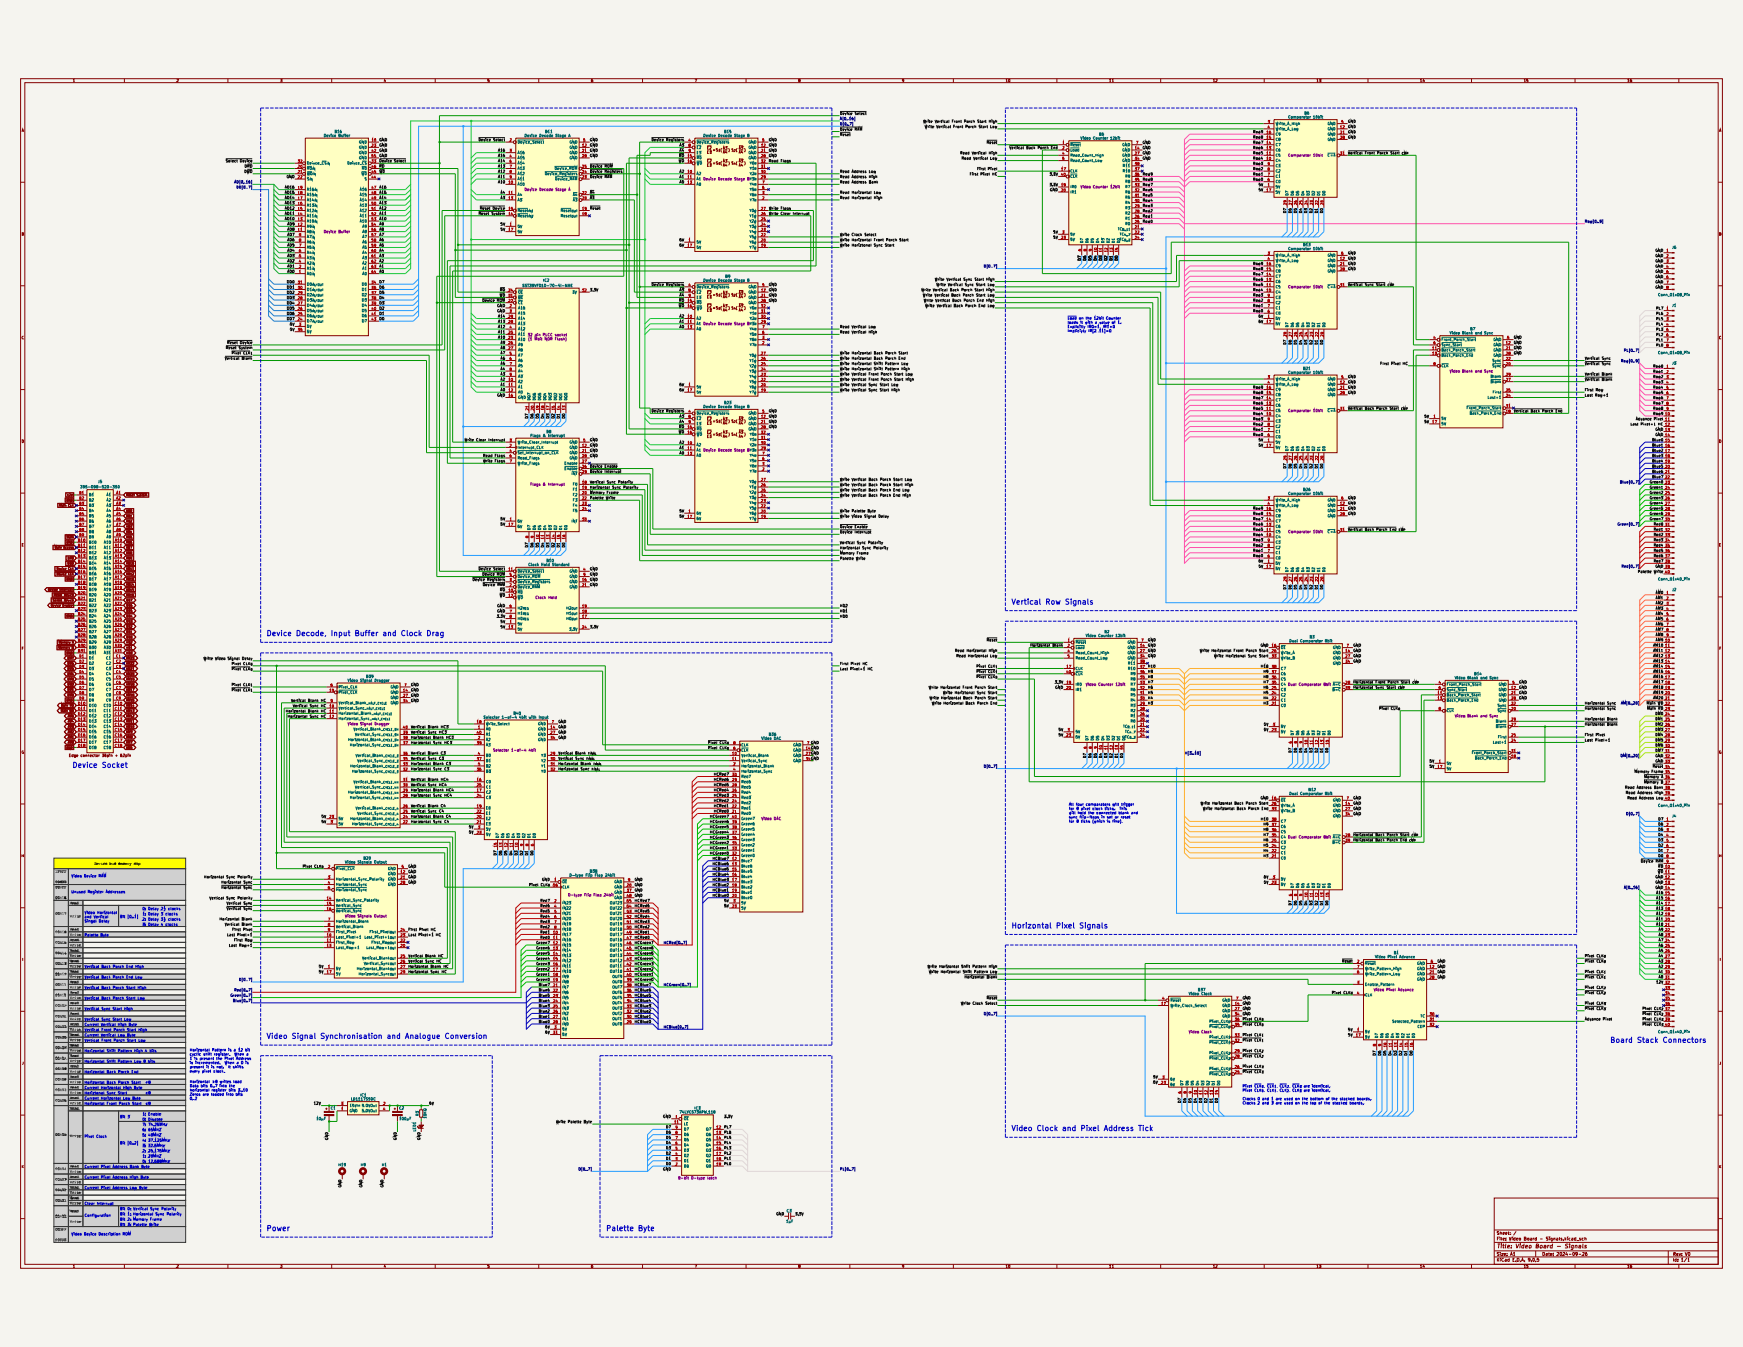
[picture p180: page 1]
