andrewpaterson/658-Computer/Pictures/HCP65 MPU NMI/HCP65 MPU NMI.pdf

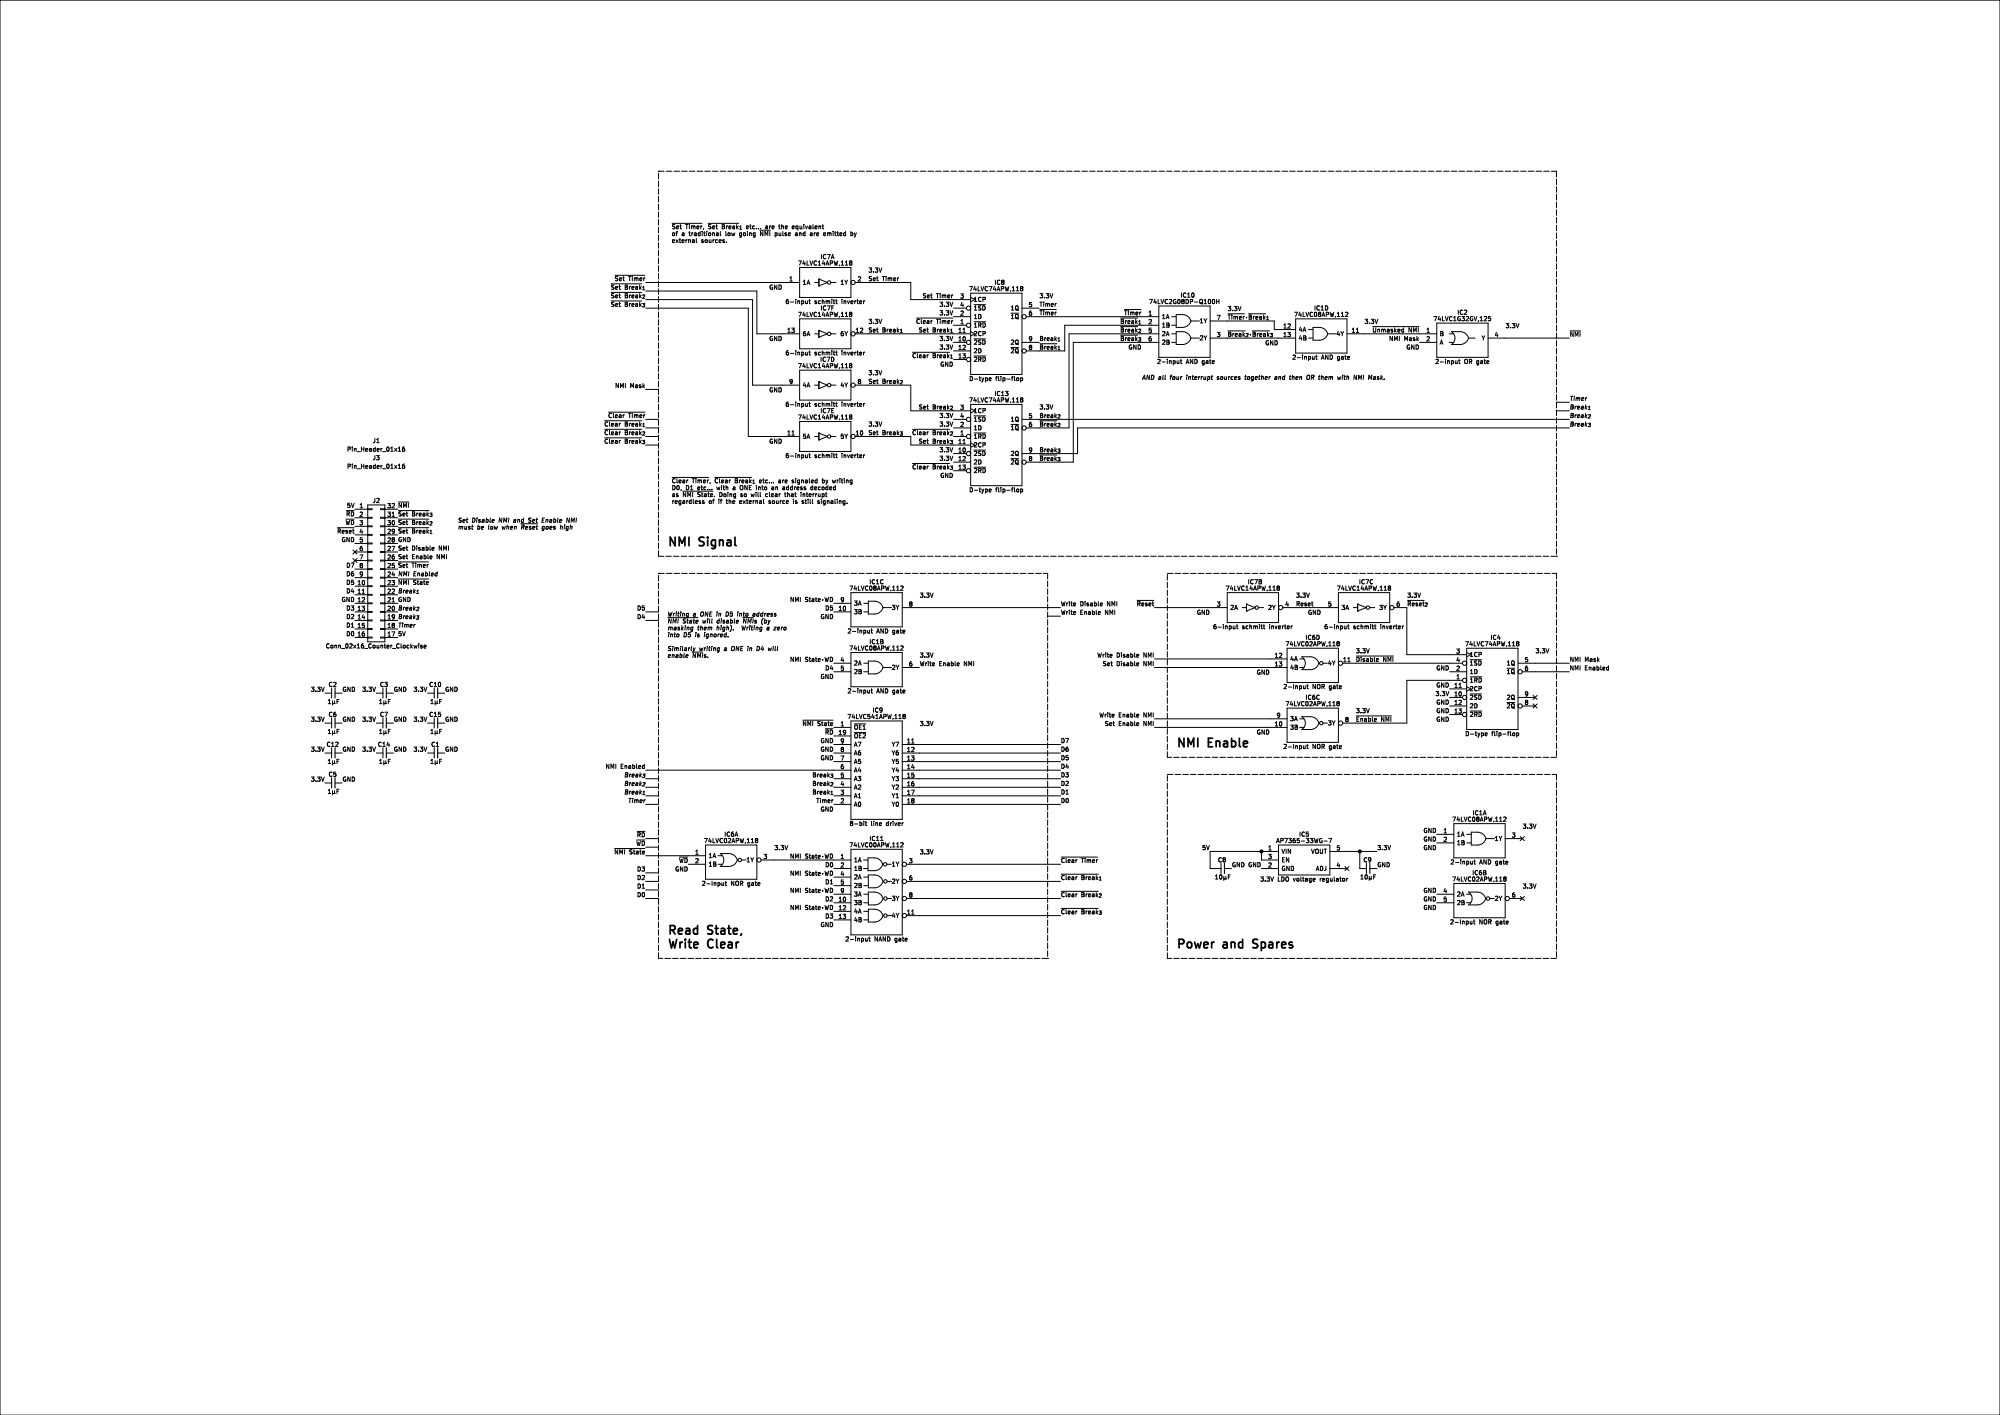
[picture p181: page 1]
