andrewpaterson/658-Computer/Documents/HCP65/Device Decode A/Device Decode Stage A - Grey.pdf

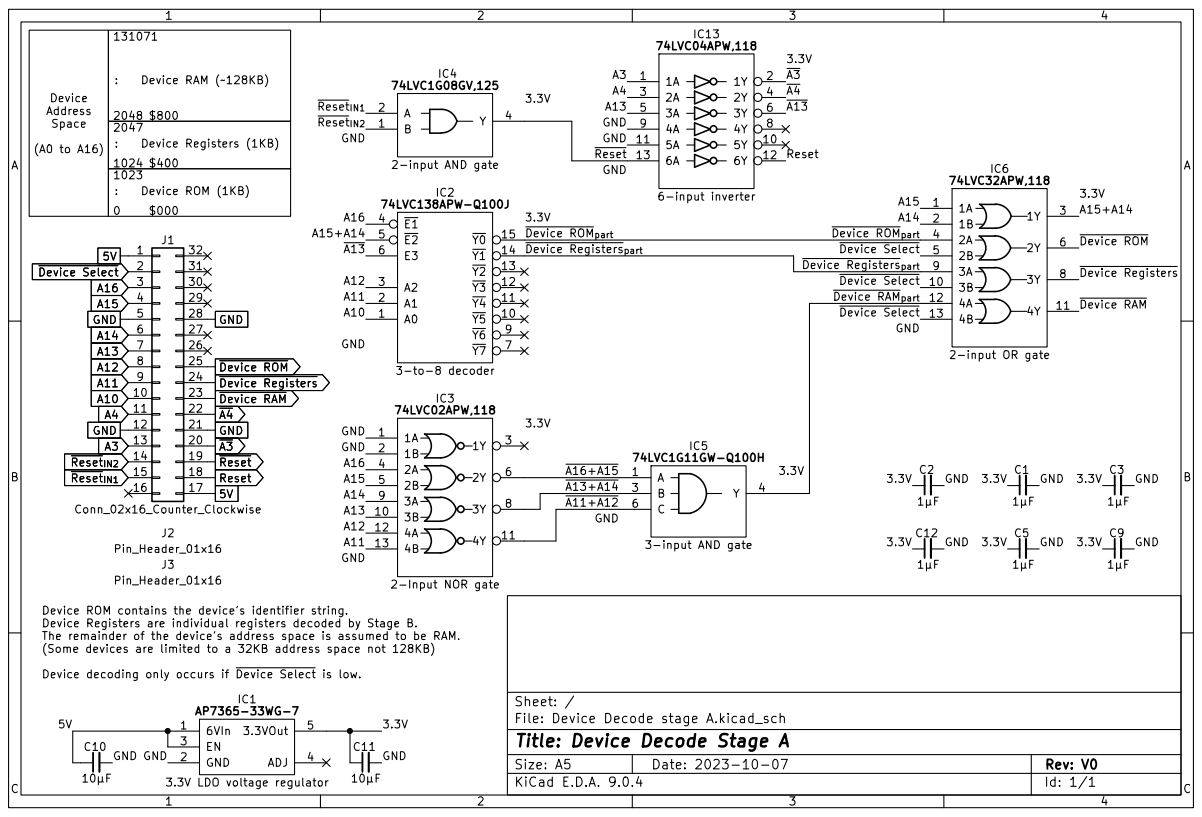
[picture p182: page 1]
