andrewpaterson/658-Computer/Documents/HCP65/Device Decode A/Device Decode Stage A.pdf

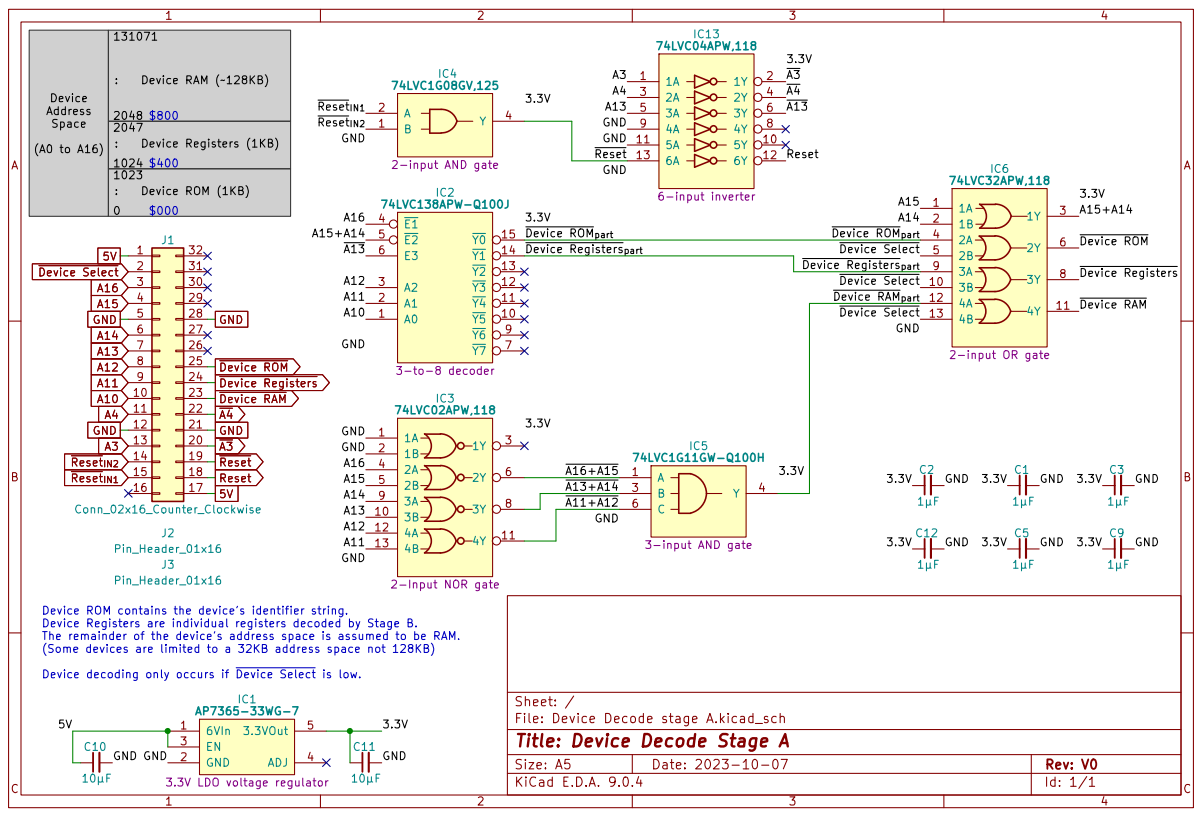
[picture p183: page 1]
