andrewpaterson/658-Computer/Documents/HCP65/Device Decode B/Device Decode Stage B - Grey.pdf

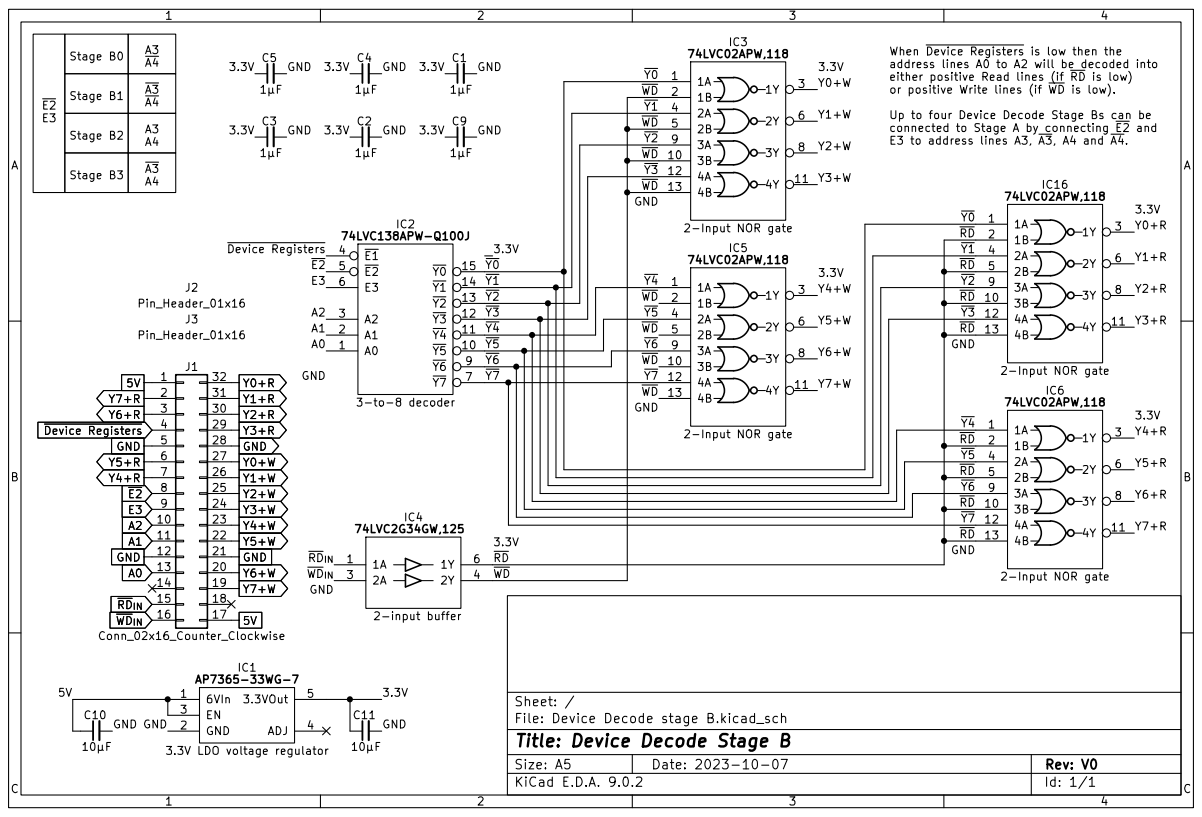
[picture p184: page 1]
