andrewpaterson/658-Computer/Documents/HCP65/Device Decode B/Device Decode Stage B.pdf

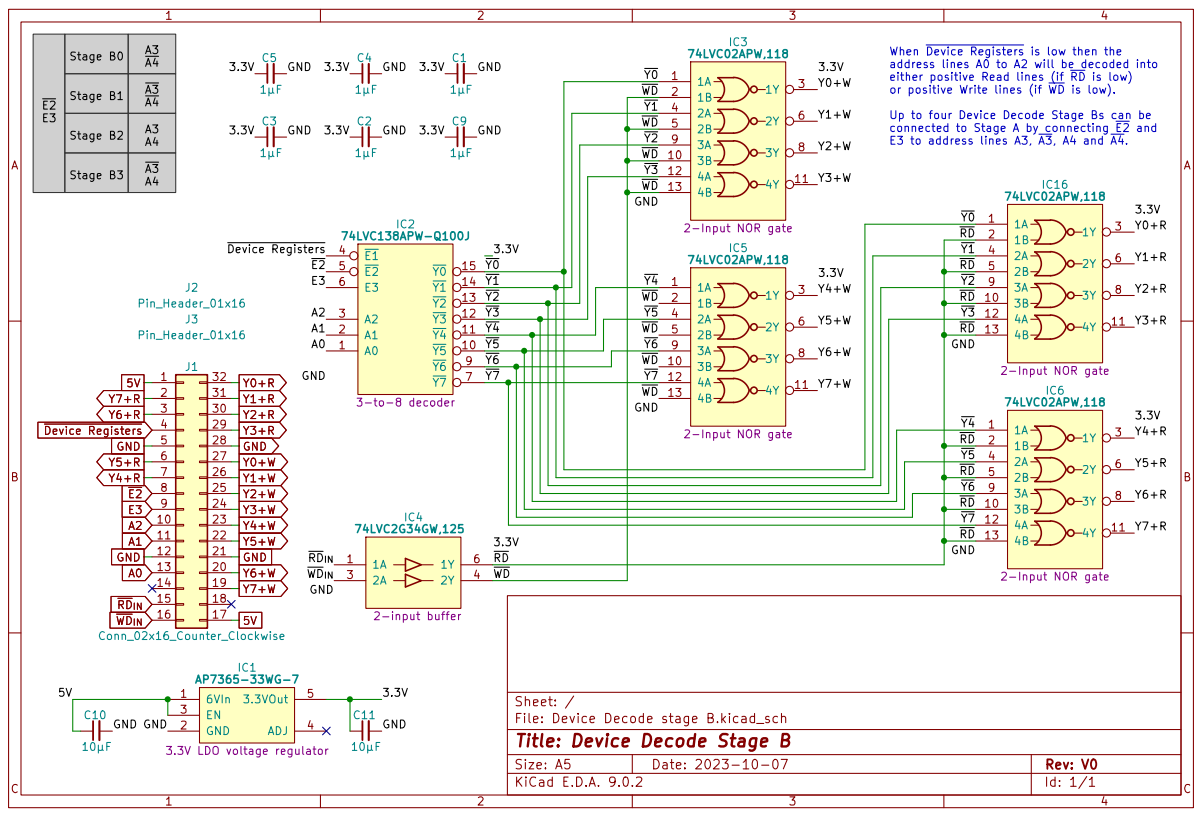
[picture p185: page 1]
