andrewpaterson/658-Computer/(list of files, drawings)

Other design files:
DivideBy3Clock.circ
Kicad/Computer/MPU Breakout/temp-freerouting.dsn
Kicad/Computer/PS2/PS2 Timing/temp-freerouting.dsn
Kicad/Computer/VIA/VIA Board/temp-freerouting.dsn
Kicad/Old/Computer/MPU Breakout/temp-freerouting.dsn
LED Display/LED_Display.circ
logi65816/demo.circ
logi65816/Test.circ
logi65816/W65C816_Default.circ
Logisim/658_Computer.bak.circ
Logisim/658_Computer.circ
Logisim/658_CPU_Evolution2.circ
Logisim/658_Test.circ
Logisim/DataEnable.circ
Logisim/DeviceDecode.circ
Logisim/DivideBy3.circ
Logisim/NotNANDvsOR.circ
Logisim/Simple_65816.circ
Logisim/TimerSwitch.circ
Logisim/Video.circ
