andrewpaterson/658-Computer/Kicad/Computer/Main/Main Memory Channel/Main Memory Channel.kicad_pcb

## KiCad design Kicad/Computer/Main/Main Memory Channel/Main Memory Channel.kicad_pcb (2026-10-31)

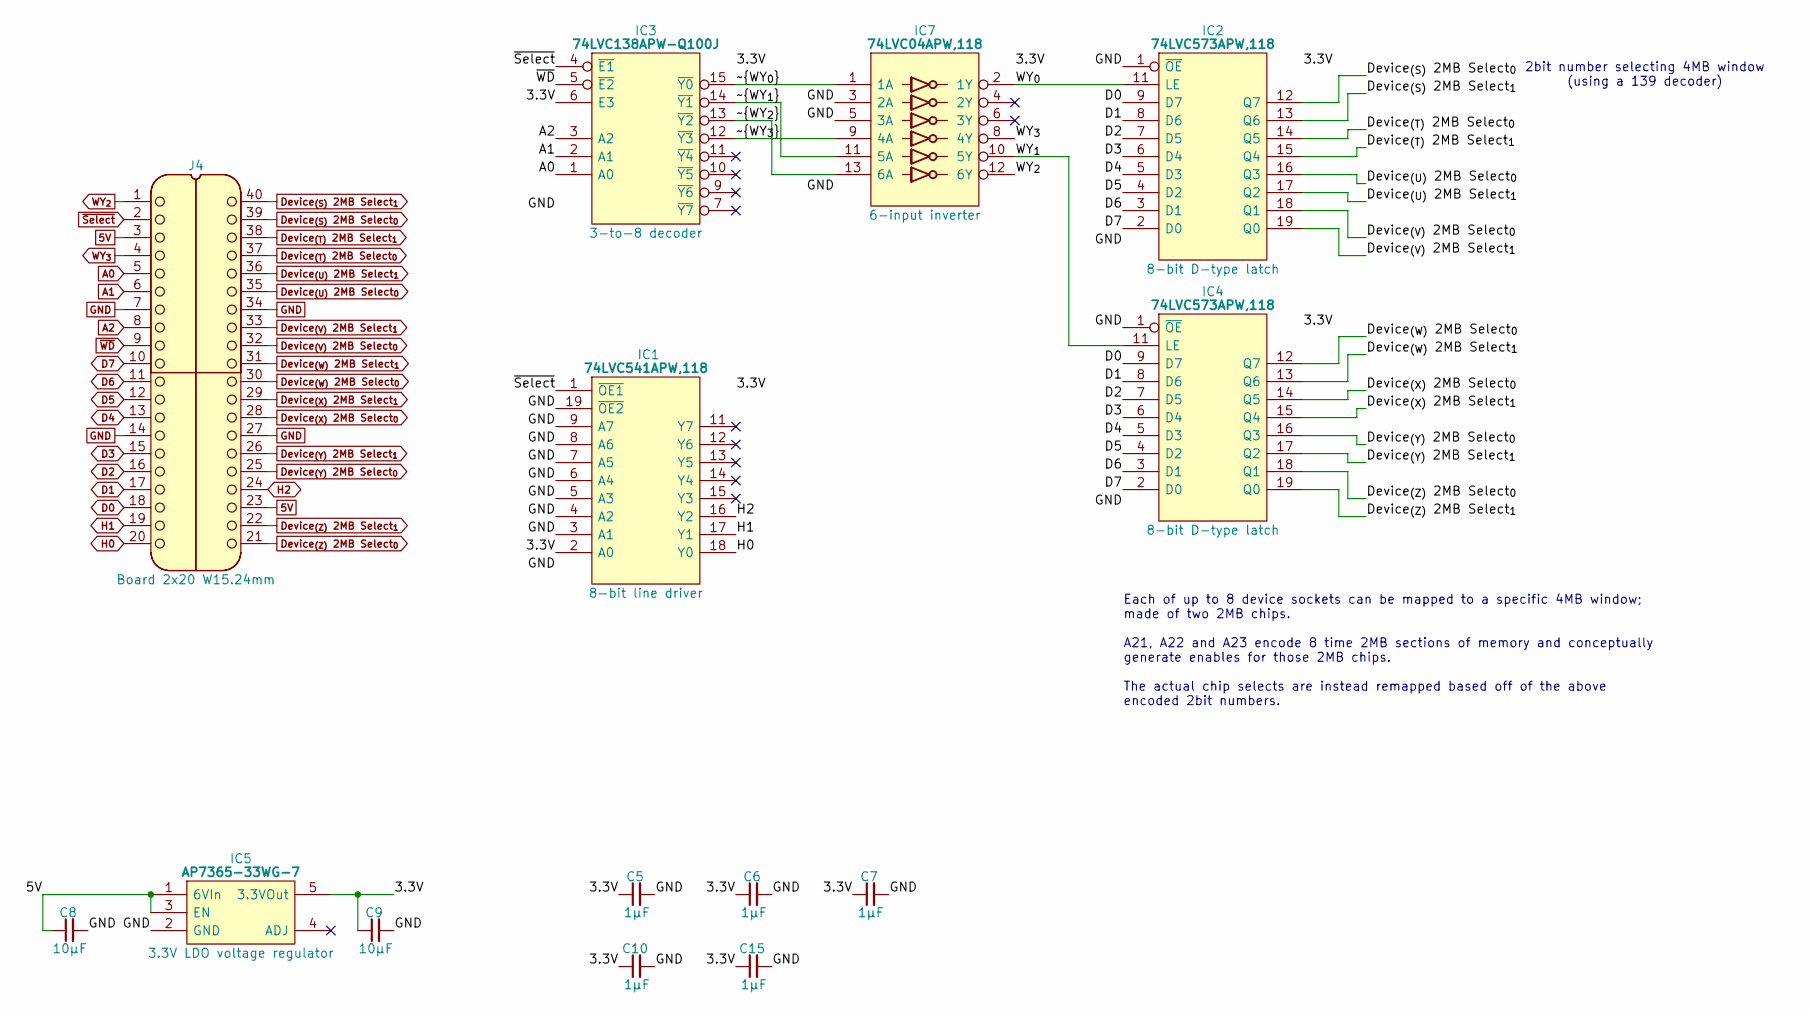
[picture p186: schematic Main Memory Channel.kicad_sch]

Parts:
C5, C6, C7, C10, C15: 1μF; C_0805
C8, C9: 10µF; C_0805
IC1: 74LVC541APW,118; SOP65P640X110-20N; Mouser Part Number 771-74LVC541APW-T
IC2, IC4: 74LVC573APW,118; SOP65P640X110-20N; Mouser Part Number 771-74LVC573APW-T
IC3: 74LVC138APW-Q100J; SOP65P640X110-16N; Mouser Part Number 771-74LVC138APWQ100J
IC5: AP7365-33WG-7; SOT95P285X130-5N; Manufacturer_Part_Number AP7365-33WG-7; Mouser Part Number 621-AP7365-33WG-7
IC7: 74LVC04APW,118; SOP65P640X110-14N; Manufacturer_Part_Number 74LVC04APW,118; Mouser Part Number 771-74LVC04APW-T
J4: Board 2x20 W15.24mm; DIP-40_Board_W15.24mm

Connections:
5V: C8.1, IC5.1 (6VIn), IC5.3 (EN), J4.3, J4.23
/3.3V: C5.1, C6.1, C7.1, C9.1, C10.1, C15.1, IC1.2 (A0), IC1.20 (3V), IC2.20 (3V), IC3.6 (E3), IC3.16 (3V), IC4.20 (3V), IC5.5 (3.3VOut), IC7.14 (3V)
/WY_{0}: IC2.11 (LE), IC7.2 (1Y)
/WY_{1}: IC4.11 (LE), IC7.10 (5Y)
/~WY_{0}: IC3.15 (~Y0), IC7.1 (1A)
/~WY_{1}: IC3.14 (~Y1), IC7.11 (5A)
/~WY_{2}: IC3.13 (~Y2), IC7.13 (6A)
/~WY_{3}: IC3.12 (~Y3), IC7.9 (4A)
A0: IC3.1 (A0), J4.5
A1: IC3.2 (A1), J4.6
A2: IC3.3 (A2), J4.8
D0: IC2.9 (D7), IC4.9 (D7), J4.18
D1: IC2.8 (D6), IC4.8 (D6), J4.17
D2: IC2.7 (D5), IC4.7 (D5), J4.16
D3: IC2.6 (D4), IC4.6 (D4), J4.15
D4: IC2.5 (D3), IC4.5 (D3), J4.13
D5: IC2.4 (D2), IC4.4 (D2), J4.12
D6: IC2.3 (D1), IC4.3 (D1), J4.11
D7: IC2.2 (D0), IC4.2 (D0), J4.10
Device_{(S)} 2MB Select_{0}: IC2.12 (Q7), J4.39
Device_{(S)} 2MB Select_{1}: IC2.13 (Q6), J4.40
Device_{(T)} 2MB Select_{0}: IC2.14 (Q5), J4.37
Device_{(T)} 2MB Select_{1}: IC2.15 (Q4), J4.38
Device_{(U)} 2MB Select_{0}: IC2.16 (Q3), J4.35
Device_{(U)} 2MB Select_{1}: IC2.17 (Q2), J4.36
Device_{(V)} 2MB Select_{0}: IC2.18 (Q1), J4.32
Device_{(V)} 2MB Select_{1}: IC2.19 (Q0), J4.33
Device_{(W)} 2MB Select_{0}: IC4.12 (Q7), J4.30
Device_{(W)} 2MB Select_{1}: IC4.13 (Q6), J4.31
Device_{(X)} 2MB Select_{0}: IC4.14 (Q5), J4.28
Device_{(X)} 2MB Select_{1}: IC4.15 (Q4), J4.29
Device_{(Y)} 2MB Select_{0}: IC4.16 (Q3), J4.25
Device_{(Y)} 2MB Select_{1}: IC4.17 (Q2), J4.26
Device_{(Z)} 2MB Select_{0}: IC4.18 (Q1), J4.21
Device_{(Z)} 2MB Select_{1}: IC4.19 (Q0), J4.22
GND: C5.2, C6.2, C7.2, C8.2, C9.2, C10.2, C15.2, IC1.3 (A1), IC1.4 (A2), IC1.5 (A3), IC1.6 (A4), IC1.7 (A5), IC1.8 (A6), IC1.9 (A7), IC1.10 (GND), IC1.19 (~OE2), IC2.1 (~OE), IC2.10 (GND), IC3.8 (GND), IC4.1 (~OE), IC4.10 (GND), IC5.2 (GND), IC7.3 (2A), IC7.5 (3A), IC7.7 (GND), J4.7, J4.14, J4.27, J4.34
H0: IC1.18 (Y0), J4.20
H1: IC1.17 (Y1), J4.19
H2: IC1.16 (Y2), J4.24
WY_{2}: IC7.12 (6Y), J4.1
WY_{3}: IC7.8 (4Y), J4.4
~Select: IC1.1 (~OE1), IC3.4 (~E1), J4.2
~WD: IC3.5 (~E2), J4.9

Notes on the sheet:
Each of up to 8 device sockets can be mapped to a specific 4MB window; made of two 2MB chips. A21, A22 and A23 encode 8 time 2MB sections of memory and conceptually generate enables for those 2MB chips. The actual chip selects are instead remapped based off of the above encoded 2bit numbers.
2bit number selecting 4MB window (using a 139 decoder)

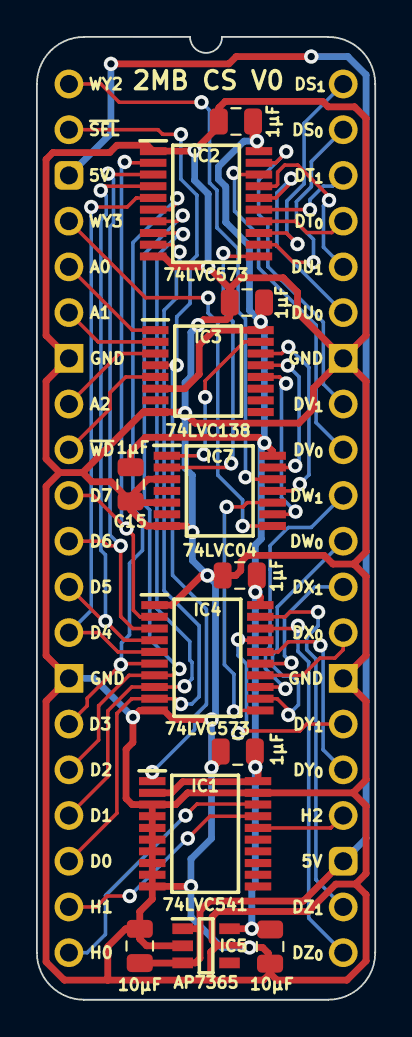
[picture p187: board Main Memory Channel.kicad_pcb from above]

Board: 2 copper layers, 18.8 x 53.5 mm, 14 parts (0 on the bottom side), 43 nets.
