andrewpaterson/658-Computer/Kicad/Computer/Audio/Audio Clock/Audio Clock.kicad_pcb

## KiCad design Kicad/Computer/Audio/Audio Clock/Audio Clock.kicad_pcb (2026-10-31)

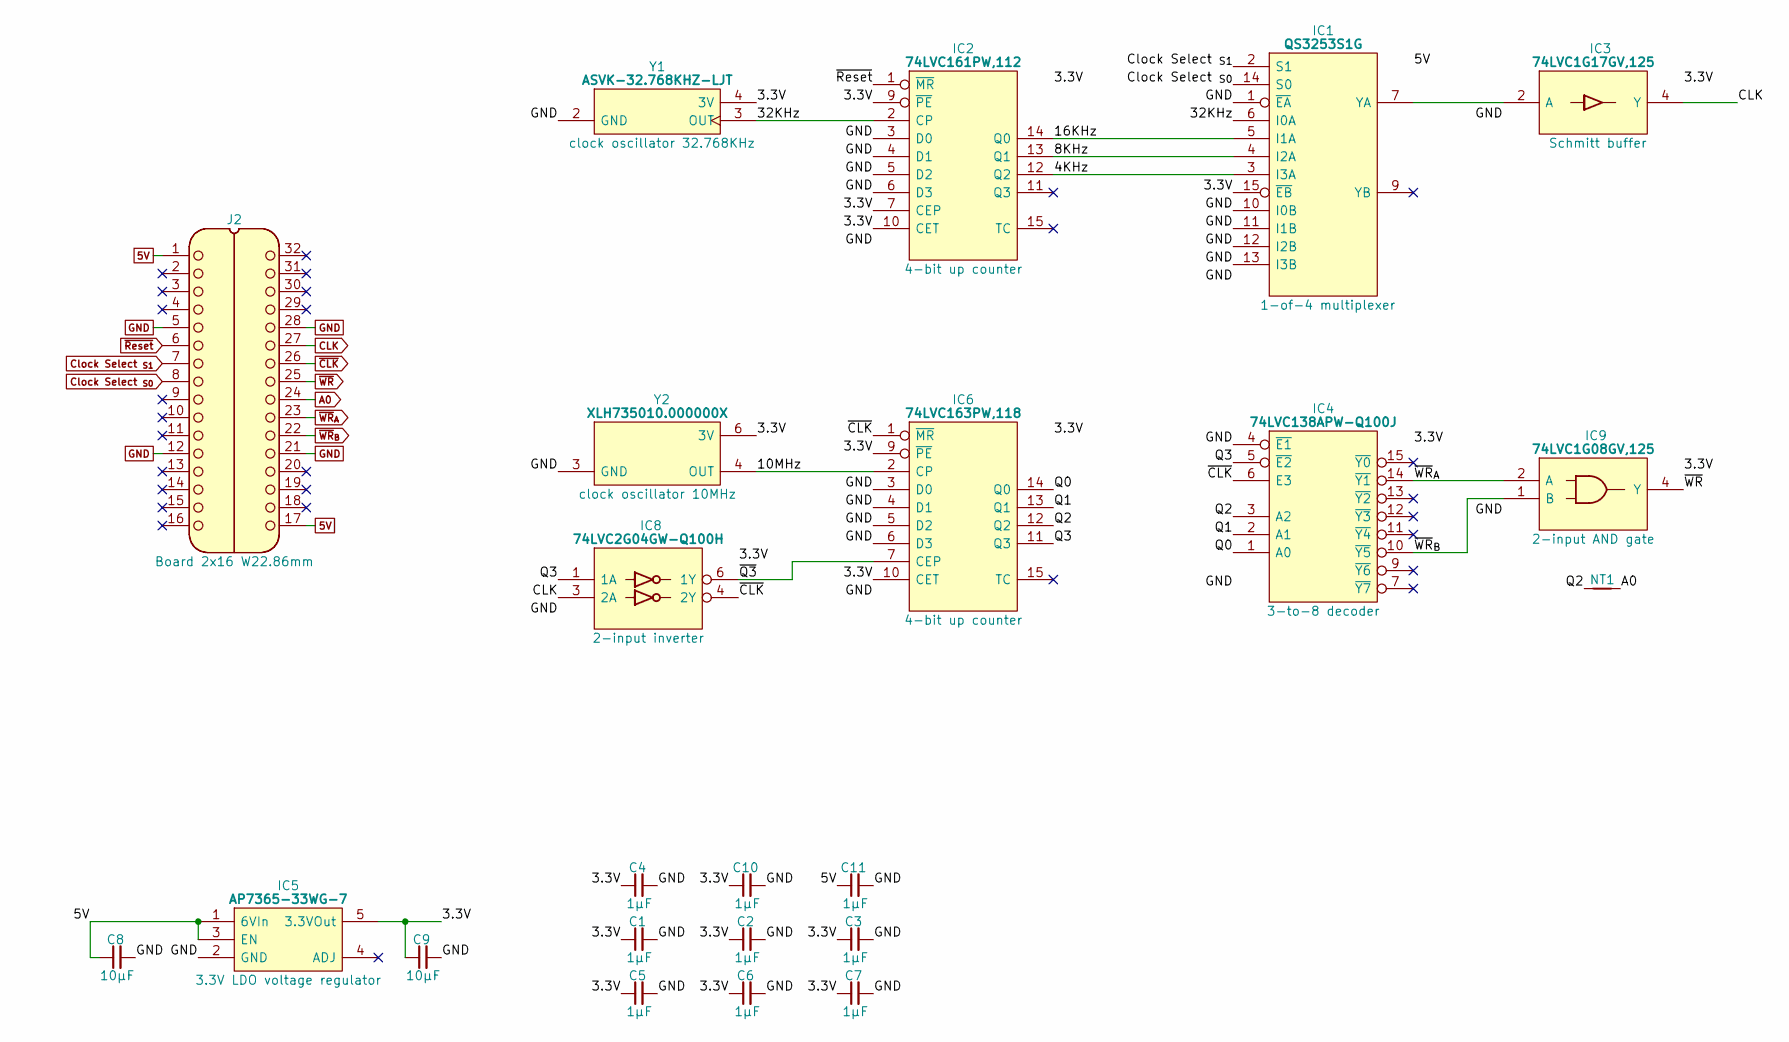
[picture p188: schematic Audio Clock.kicad_sch]

Parts:
C1, C2, C3, C4, C5, C6, C7, C10, C11: 1μF; C_0805
C8, C9: 10µF; C_0805
IC1: QS3253S1G; SOIC127P602X173-16N; Manufacturer_Part_Number QS3253S1G
IC2: 74LVC161PW,112; SOP65P640X110-16N; Mouser Part Number 771-LVC161PW112
IC3: 74LVC1G17GV,125; SOT95P275X110-5N; Manufacturer_Part_Number 74LVC1G17GV,125
IC4: 74LVC138APW-Q100J; SOP65P640X110-16N; Mouser Part Number 771-74LVC138APWQ100J
IC5: AP7365-33WG-7; SOT95P285X130-5N; Manufacturer_Part_Number AP7365-33WG-7; Mouser Part Number 621-AP7365-33WG-7
IC6: 74LVC163PW,118; SOP65P640X110-16N; Mouser Part Number 771-74LVC163PW-T
IC8: 74LVC2G04GW-Q100H; SOP65P210X110-6N; Manufacturer_Part_Number 74LVC2G04GW-Q100H; Mouser Part Number 771-74LVC2G04GWQ100H
IC9: 74LVC1G08GV,125; SOT95P275X110-5N; Manufacturer_Part_Number 74LVC1G08GV,125; Mouser Part Number 771-74LVC1G08GV
J2: Board 2x16 W22.86mm; DIP-32_Board_W22.86mm
NT1: NetTie; NetTie-2_SMD_Pad0.5mm
Y1: ASVK-32.768KHZ-LJT; ASVK32768KHZLJT; Manufacturer_Part_Number ASVK-32.768KHZ-LJT; Mouser Part Number 815-ASVK-32.768KLJT
Y2: XLH735010.000000X; XLH735100000000I; Manufacturer_Part_Number XLH735010.000000X; Mouser Part Number 972-XLH735010000000X

Connections:
5V: C8.1, C11.1, IC1.16 (5V), IC5.1 (6VIn), IC5.3 (EN), J2.1, J2.17
/3.3V: C1.1, C2.1, C3.1, C4.1, C5.1, C6.1, C7.1, C9.1, C10.1, IC1.15 (~EB), IC2.7 (CEP), IC2.9 (~PE), IC2.10 (CET), IC2.16 (3V), IC3.5 (3V), IC4.16 (3V), IC5.5 (3.3VOut), IC6.9 (~PE), IC6.10 (CET), IC6.16 (3V), IC8.5 (3V), IC9.5 (3V), Y1.4 (3V), Y2.6 (3V)
/4KHz: IC1.3 (I3A), IC2.12 (Q2)
/8KHz: IC1.4 (I2A), IC2.13 (Q1)
/10MHz: IC6.2 (CP), Y2.4 (OUT)
/16KHz: IC1.5 (I1A), IC2.14 (Q0)
/32KHz: IC1.6 (I0A), IC2.2 (CP), Y1.3 (OUT)
/Q0: IC4.1 (A0), IC6.14 (Q0)
/Q1: IC4.2 (A1), IC6.13 (Q1)
/Q2: IC4.3 (A2), IC6.12 (Q2), NT1.1
/Q3: IC4.5 (~E2), IC6.11 (Q3), IC8.1 (1A)
/~Q3: IC6.7 (CEP), IC8.6 (1Y)
A0: J2.24, NT1.2
CLK: IC3.4 (Y), IC8.3 (2A), J2.27
Clock Select _{S0}: IC1.14 (S0), J2.8
Clock Select _{S1}: IC1.2 (S1), J2.7
GND: C1.2, C2.2, C3.2, C4.2, C5.2, C6.2, C7.2, C8.2, C9.2, C10.2, C11.2, IC1.1 (~EA), IC1.8 (GND), IC1.10 (I0B), IC1.11 (I1B), IC1.12 (I2B), IC1.13 (I3B), IC2.3 (D0), IC2.4 (D1), IC2.5 (D2), IC2.6 (D3), IC2.8 (GND), IC3.3 (GND), IC4.4 (~E1), IC4.8 (GND), IC5.2 (GND), IC6.3 (D0), IC6.4 (D1), IC6.5 (D2), IC6.6 (D3), IC6.8 (GND), IC8.2 (GND), IC9.3 (GND), J2.5, J2.12, J2.21, J2.28, Y1.2 (GND), Y2.3 (GND)
unnamed: IC1.7 (YA), IC3.2 (A)
~CLK: IC4.6 (E3), IC6.1 (~MR), IC8.4 (2Y), J2.26
~Reset: IC2.1 (~MR), J2.6
~WR: IC9.4 (Y), J2.25
~WR_{A}: IC4.14 (~Y1), IC9.2 (A), J2.23
~WR_{B}: IC4.10 (~Y5), IC9.1 (B), J2.22

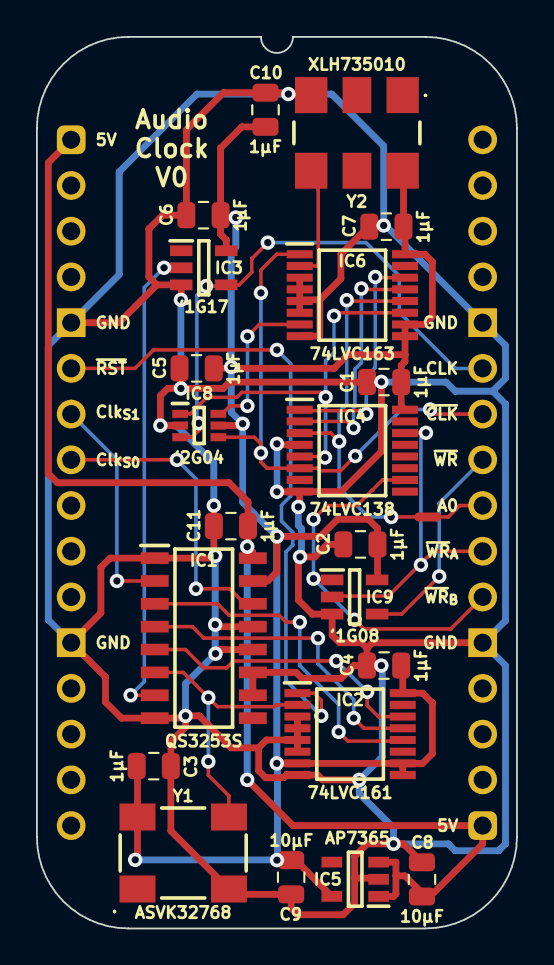
[picture p189: board Audio Clock.kicad_pcb from above]

Board: 2 copper layers, 26.7 x 49.5 mm, 23 parts (0 on the bottom side), 23 nets.
