andrewpaterson/658-Computer/Kicad/Computer/Processor/HCP65 Kernal Mode/HCP65 Kernal Mode.kicad_pcb

## KiCad design Kicad/Computer/Processor/HCP65 Kernal Mode/HCP65 Kernal Mode.kicad_pcb (2026-10-31)

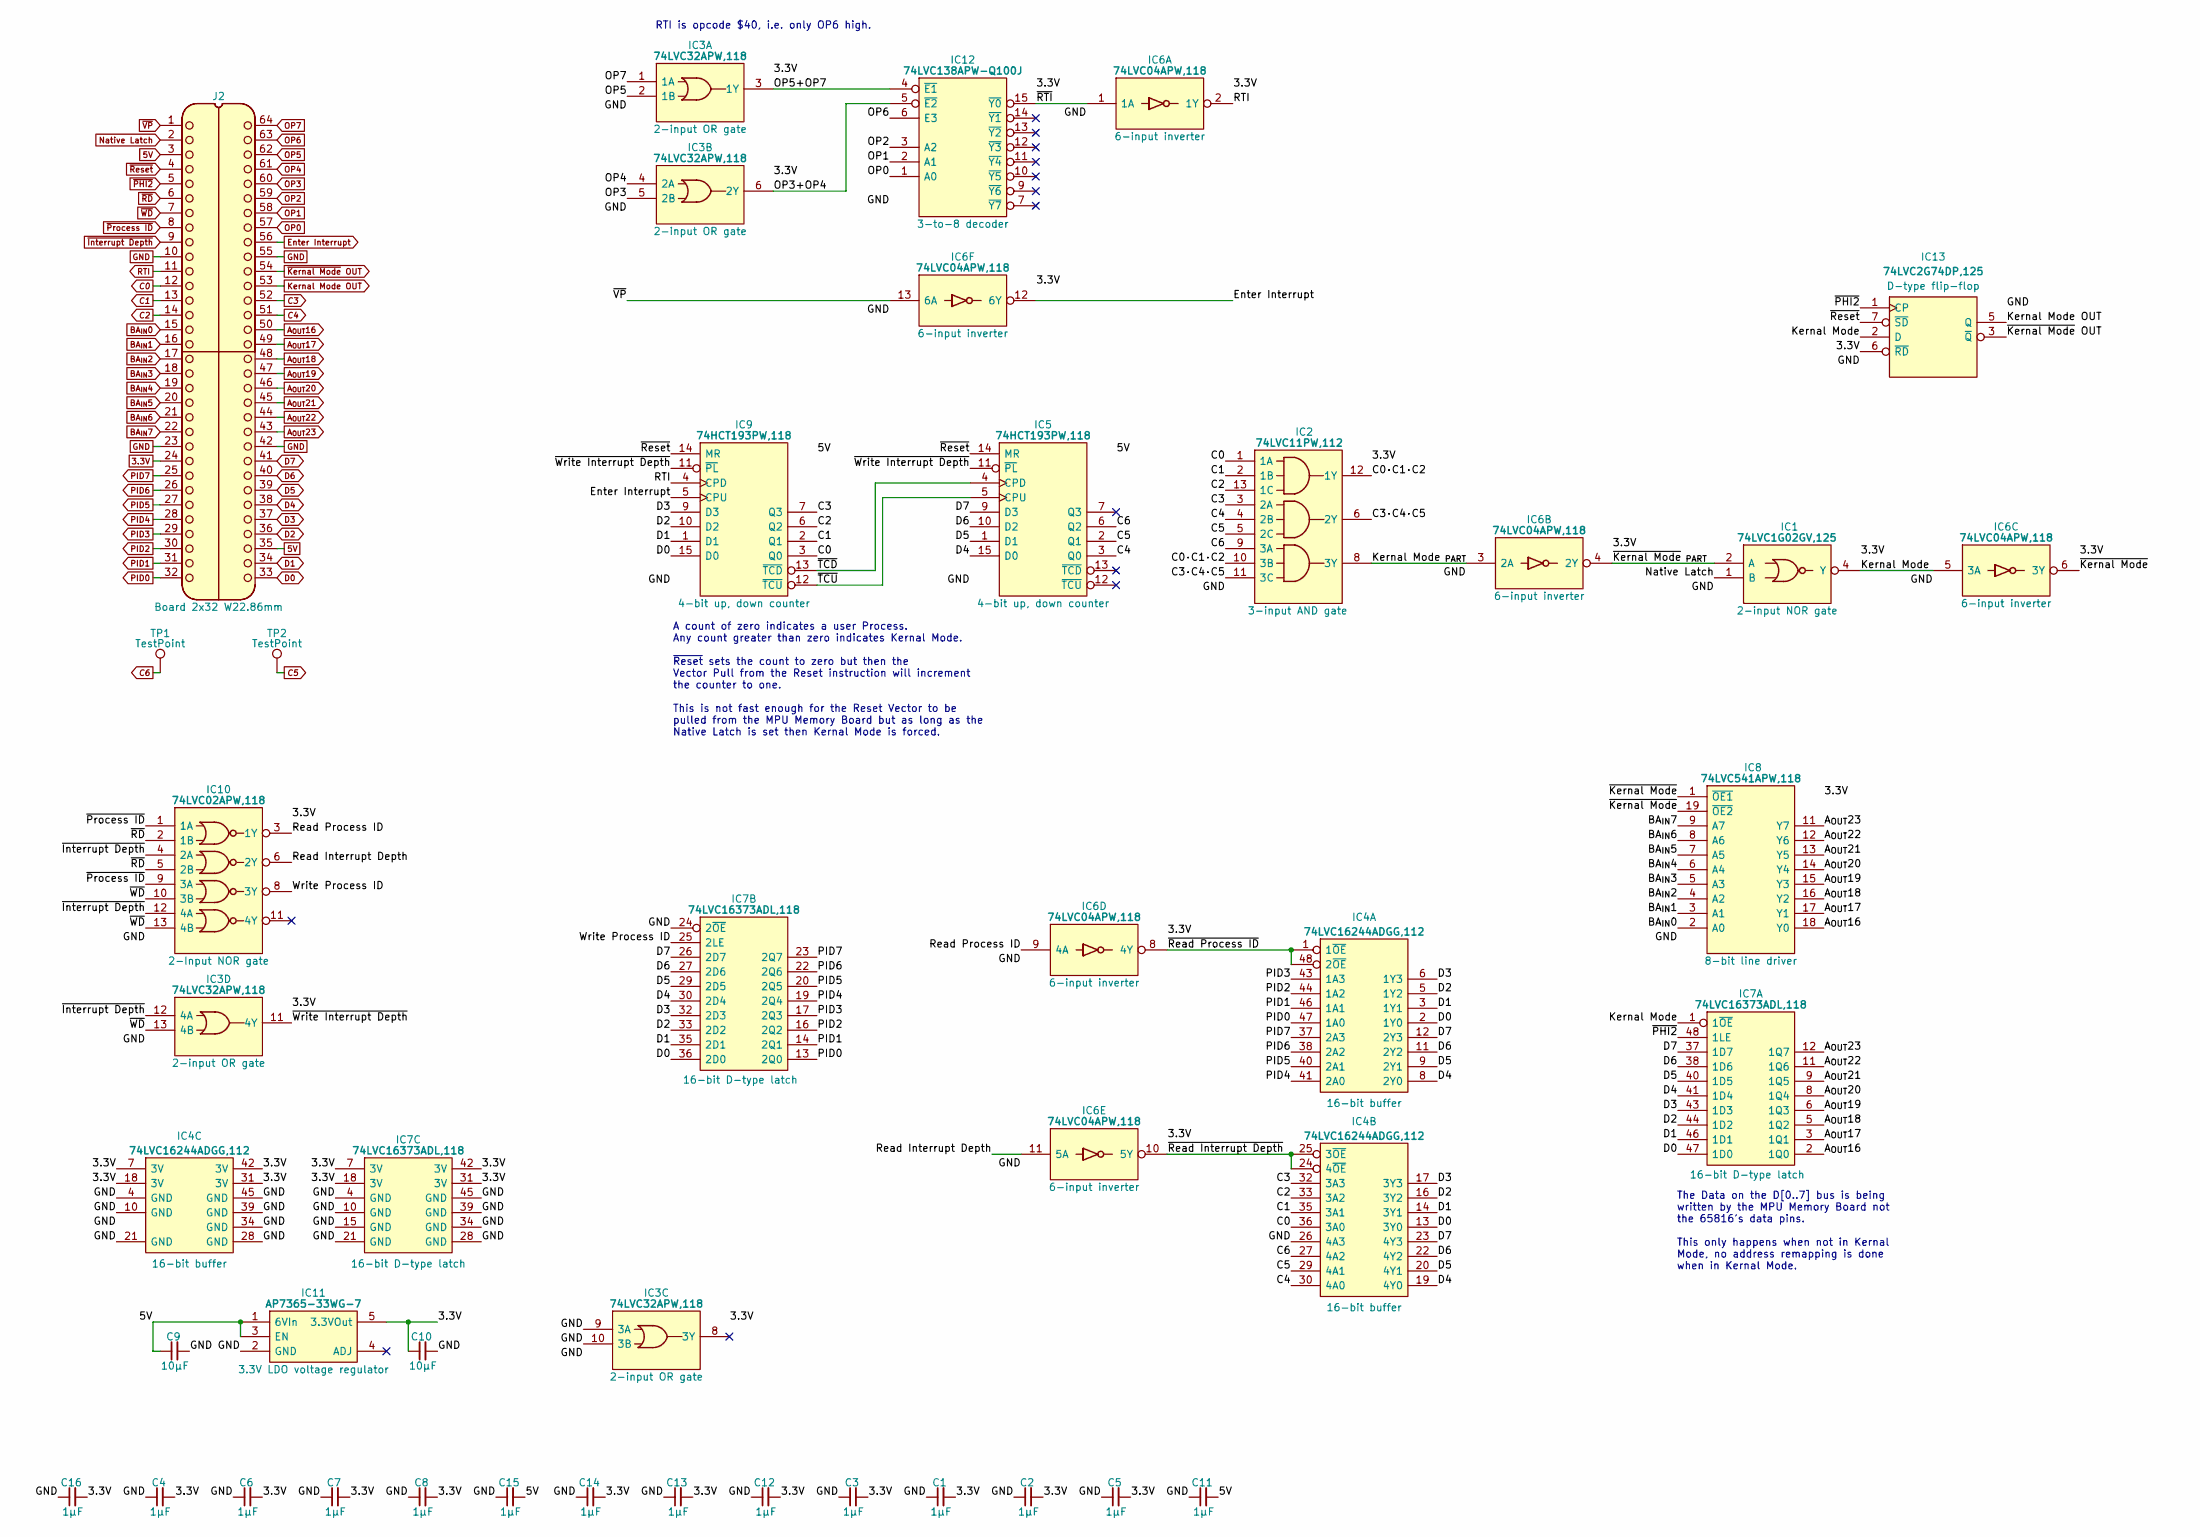
[picture p190: schematic HCP65 Kernal Mode.kicad_sch, Kernal Mode]

Parts:
C1, C2, C3, C4, C5, C6, C7, C8, C11, C12, C13, C14, C15, C16: 1μF; C_0805
C9, C10: 10μF; C_0805
IC1: 74LVC1G02GV,125; SOT95P275X110-5N; Manufacturer_Part_Number 74LVC1G02GV,125; Mouser Part Number 771-LVC1G02GV125
IC2: 74LVC11PW,112; SOP65P640X110-14N; Mouser Part Number 771-LVC11PW112
IC3: 74LVC32APW,118; SOP65P640X110-14N; Manufacturer_Part_Number 74LVC32APW,118; Mouser Part Number 771-74LVC32APW-T
IC4: 74LVC16244ADGG,112; 74LVC16244ADGG112; Manufacturer_Part_Number 74LVC16244ADGG,112; Mouser Part Number 771-74LVC16244DG
IC5, IC9: 74HCT193PW,118; SOP65P640X110-16N; Manufacturer_Part_Number 74HCT193PW,118; Mouser Part Number 771-HCT193PW118
IC6: 74LVC04APW,118; SOP65P640X110-14N; Manufacturer_Part_Number 74LVC04APW,118; Mouser Part Number 771-74LVC04APW-T
IC7: 74LVC16373ADL,118; SOP64P1025X280-48N; Mouser Part Number 771-LVC16373ADL118
IC8: 74LVC541APW,118; SOP65P640X110-20N; Mouser Part Number 771-74LVC541APW-T
IC10: 74LVC02APW,118; SOP65P640X110-14N; Mouser Part Number 771-74LVC02APW-T
IC11: AP7365-33WG-7; SOT95P285X130-5N; Manufacturer_Part_Number AP7365-33WG-7; Mouser Part Number 621-AP7365-33WG-7
IC12: 74LVC138APW-Q100J; SOP65P640X110-16N; Mouser Part Number 771-74LVC138APWQ100J
IC13: 74LVC2G74DP,125; SOP65P400X110-8N; Manufacturer_Part_Number 74LVC2G74DP,125; Mouser Part Number 771-74LVC2G74DP-G
J2: Board 2x32 W22.86mm; DIP-64_Board_W22.86mm
TP1, TP2: TestPoint; PinHeader_1x01_P2.54mm_Vertical

Connections:
3.3V: C1.2, C2.2, C3.2, C4.2, C5.2, C6.2, C7.2, C8.2, C10.1, C12.2, C13.2, C14.2, C16.2, IC1.5 (3V), IC2.14 (3V), IC3.14 (3V), IC4.7 (3V), IC4.18 (3V), IC4.31 (3V), IC4.42 (3V), IC6.14 (3V), IC7.7 (3V), IC7.18 (3V), IC7.31 (3V), IC7.42 (3V), IC8.20 (3V), IC10.14 (3V), IC11.5 (3.3VOut), IC12.16 (3V), IC13.6 (~RD), J2.24
5V: C9.1, C11.2, C15.2, IC5.16 (5V), IC9.16 (5V), IC11.1 (6VIn), IC11.3 (EN), J2.3, J2.35
/C0·C1·C2: IC2.10 (3B), IC2.12 (1Y)
/C3·C4·C5: IC2.6 (2Y), IC2.11 (3C)
/Kernal Mode: IC1.4 (Y), IC6.5 (3A), IC7.1 (1~OE), IC13.2 (D)
/Kernal Mode_{ PART}: IC2.8 (3Y), IC6.3 (2A)
/OP3+OP4: IC3.6 (2Y), IC12.5 (~E2)
/OP5+OP7: IC3.3 (1Y), IC12.4 (~E1)
/Read Interrupt Depth: IC6.11 (5A), IC10.6 (2Y)
/Read Process ID: IC6.9 (4A), IC10.3 (1Y)
/Write Process ID: IC7.25 (2LE), IC10.8 (3Y)
/~Kernal Mode: IC6.6 (3Y), IC8.1 (~OE1), IC8.19 (~OE2)
/~Kernal Mode_{ PART}: IC1.2 (A), IC6.4 (2Y)
/~RTI: IC6.1 (1A), IC12.15 (~Y0)
/~Read Interrupt Depth: IC4.24 (4~OE), IC4.25 (3~OE), IC6.10 (5Y)
/~Read Process ID: IC4.1 (1~OE), IC4.48 (2~OE), IC6.8 (4Y)
/~TCD: IC5.4 (CPD), IC9.13 (~TCD)
/~TCU: IC5.5 (CPU), IC9.12 (~TCU)
/~Write Interrupt Depth: IC3.11 (4Y), IC5.11 (~PL), IC9.11 (~PL)
A_{OUT}16: IC7.2 (1Q0), IC8.18 (Y0), J2.50
A_{OUT}17: IC7.3 (1Q1), IC8.17 (Y1), J2.49
A_{OUT}18: IC7.5 (1Q2), IC8.16 (Y2), J2.48
A_{OUT}19: IC7.6 (1Q3), IC8.15 (Y3), J2.47
A_{OUT}20: IC7.8 (1Q4), IC8.14 (Y4), J2.46
A_{OUT}21: IC7.9 (1Q5), IC8.13 (Y5), J2.45
A_{OUT}22: IC7.11 (1Q6), IC8.12 (Y6), J2.44
A_{OUT}23: IC7.12 (1Q7), IC8.11 (Y7), J2.43
BA_{IN}0: IC8.2 (A0), J2.15
BA_{IN}1: IC8.3 (A1), J2.16
BA_{IN}2: IC8.4 (A2), J2.17
BA_{IN}3: IC8.5 (A3), J2.18
BA_{IN}4: IC8.6 (A4), J2.19
BA_{IN}5: IC8.7 (A5), J2.20
BA_{IN}6: IC8.8 (A6), J2.21
BA_{IN}7: IC8.9 (A7), J2.22
C0: IC2.1 (1A), IC4.36 (3A0), IC9.3 (Q0), J2.12
C1: IC2.2 (1B), IC4.35 (3A1), IC9.2 (Q1), J2.13
C2: IC2.13 (1C), IC4.33 (3A2), IC9.6 (Q2), J2.14
C3: IC2.3 (2A), IC4.32 (3A3), IC9.7 (Q3), J2.52
C4: IC2.4 (2B), IC4.30 (4A0), IC5.3 (Q0), J2.51
C5: IC2.5 (2C), IC4.29 (4A1), IC5.2 (Q1), TP2.1 (1_1)
C6: IC2.9 (3A), IC4.27 (4A2), IC5.6 (Q2), TP1.1 (1_1)
D0: IC4.2 (1Y0), IC4.13 (3Y0), IC7.36 (2D0), IC7.47 (1D0), IC9.15 (D0), J2.33
D1: IC4.3 (1Y1), IC4.14 (3Y1), IC7.35 (2D1), IC7.46 (1D1), IC9.1 (D1), J2.34
D2: IC4.5 (1Y2), IC4.16 (3Y2), IC7.33 (2D2), IC7.44 (1D2), IC9.10 (D2), J2.36
D3: IC4.6 (1Y3), IC4.17 (3Y3), IC7.32 (2D3), IC7.43 (1D3), IC9.9 (D3), J2.37
D4: IC4.8 (2Y0), IC4.19 (4Y0), IC5.15 (D0), IC7.30 (2D4), IC7.41 (1D4), J2.38
D5: IC4.9 (2Y1), IC4.20 (4Y1), IC5.1 (D1), IC7.29 (2D5), IC7.40 (1D5), J2.39
D6: IC4.11 (2Y2), IC4.22 (4Y2), IC5.10 (D2), IC7.27 (2D6), IC7.38 (1D6), J2.40
D7: IC4.12 (2Y3), IC4.23 (4Y3), IC5.9 (D3), IC7.26 (2D7), IC7.37 (1D7), J2.41
Enter Interrupt: IC6.12 (6Y), IC9.5 (CPU), J2.56
GND: C1.1, C2.1, C3.1, C4.1, C5.1, C6.1, C7.1, C8.1, C9.2, C10.2, C11.1, C12.1, C13.1, C14.1, C15.1, C16.1, IC1.3 (GND), IC2.7 (GND), IC3.7 (GND), IC3.9 (3A), IC3.10 (3B), IC4.4 (GND), IC4.10 (GND), IC4.15 (GND), IC4.21 (GND), IC4.26 (4A3), IC4.28 (GND), IC4.34 (GND), IC4.39 (GND), IC4.45 (GND), IC5.8 (GND), IC6.7 (GND), IC7.4 (GND), IC7.10 (GND), IC7.15 (GND), IC7.21 (GND), IC7.24 (2~OE), IC7.28 (GND), IC7.34 (GND), IC7.39 (GND), IC7.45 (GND), IC8.10 (GND), IC9.8 (GND), IC10.7 (GND), IC11.2 (GND), IC12.8 (GND), IC13.4 (GND), IC13.8 (3V), J2.10, J2.23, J2.42, J2.55
Kernal Mode OUT: IC13.5 (Q), J2.53
Native Latch: IC1.1 (B), J2.2
OP0: IC12.1 (A0), J2.57
OP1: IC12.2 (A1), J2.58
OP2: IC12.3 (A2), J2.59
OP3: IC3.5 (2B), J2.60
OP4: IC3.4 (2A), J2.61
OP5: IC3.2 (1B), J2.62
OP6: IC12.6 (E3), J2.63
OP7: IC3.1 (1A), J2.64
PID0: IC4.47 (1A0), IC7.13 (2Q0), J2.32
PID1: IC4.46 (1A1), IC7.14 (2Q1), J2.31
PID2: IC4.44 (1A2), IC7.16 (2Q2), J2.30
PID3: IC4.43 (1A3), IC7.17 (2Q3), J2.29
PID4: IC4.41 (2A0), IC7.19 (2Q4), J2.28
PID5: IC4.40 (2A1), IC7.20 (2Q5), J2.27
PID6: IC4.38 (2A2), IC7.22 (2Q6), J2.26
PID7: IC4.37 (2A3), IC7.23 (2Q7), J2.25
RTI: IC6.2 (1Y), IC9.4 (CPD), J2.11
~Interrupt Depth: IC3.12 (4A), IC10.4 (2A), IC10.12 (4A), J2.9
~Kernal Mode OUT: IC13.3 (~Q), J2.54
~PHI2: IC7.48 (1LE), IC13.1 (CP), J2.5
~Process ID: IC10.1 (1A), IC10.9 (3A), J2.8
~RD: IC10.2 (1B), IC10.5 (2B), J2.6
~Reset: IC5.14 (MR), IC9.14 (MR), IC13.7 (~SD), J2.4
~VP: IC6.13 (6A), J2.1
~WD: IC3.13 (4B), IC10.10 (3B), IC10.13 (4B), J2.7

Notes on the sheet:
RTI is opcode $40, i.e. only OP6 high.
The Data on the D[0..7] bus is being written by the MPU Memory Board not the 65816's data pins. This only happens when not in Kernal Mode, no address remapping is done when in Kernal Mode.
A count of zero indicates a user Process. Any count greater than zero indicates Kernal Mode. ~{Reset} sets the count to zero but then the Vector Pull from the Reset instruction will increment the counter to one. This is not fast enough for the Reset Vector to be pulled from the MPU Memory Board but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

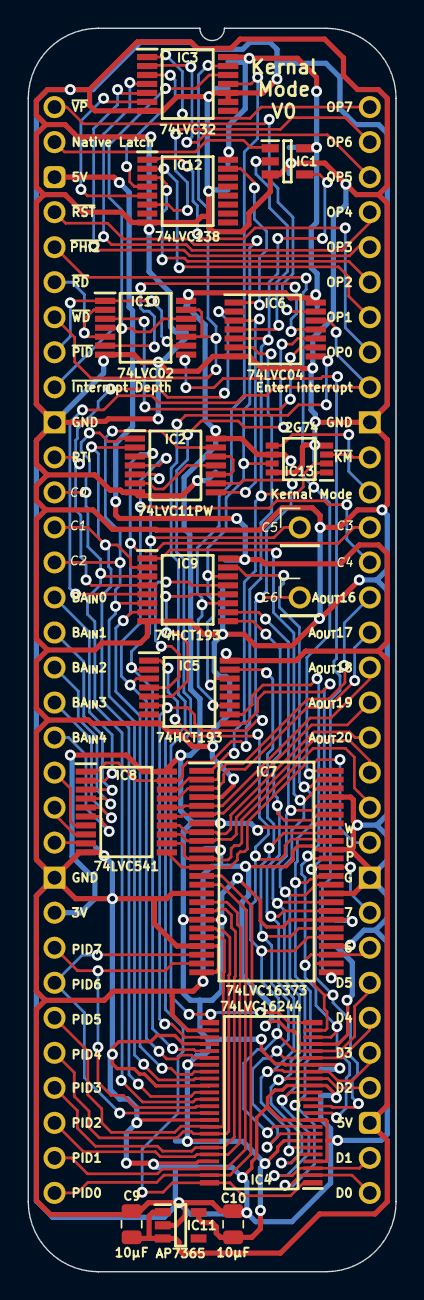
[picture p191: board HCP65 Kernal Mode.kicad_pcb from above]

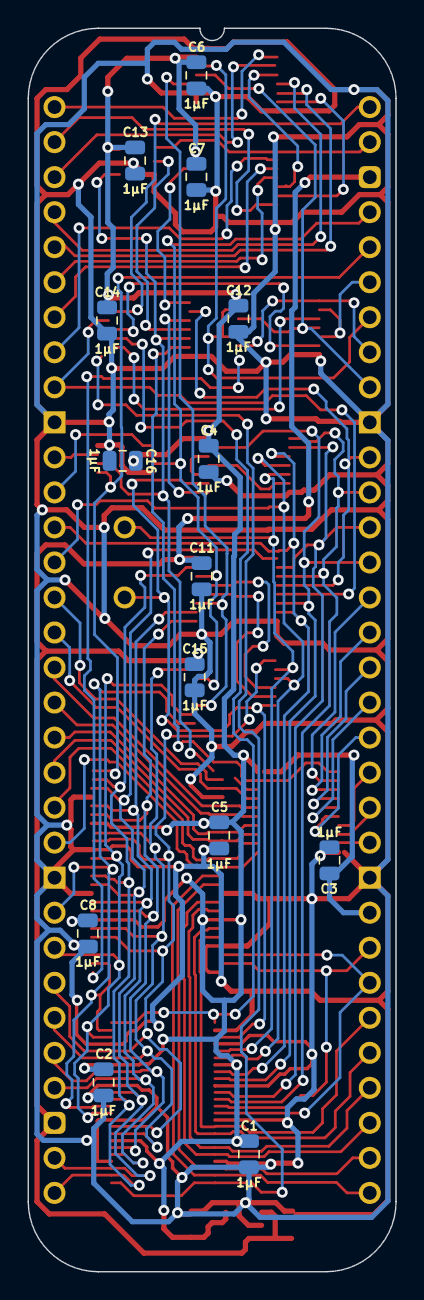
[picture p192: board HCP65 Kernal Mode.kicad_pcb from below]

Board: 2 copper layers, 26.7 x 90.2 mm, 32 parts (14 on the bottom side), 79 nets.
