andrewpaterson/658-Computer/Kicad/W65C64/W65C64.kicad_pcb

## KiCad design Kicad/W65C64/W65C64.kicad_pcb (2026-09-09)

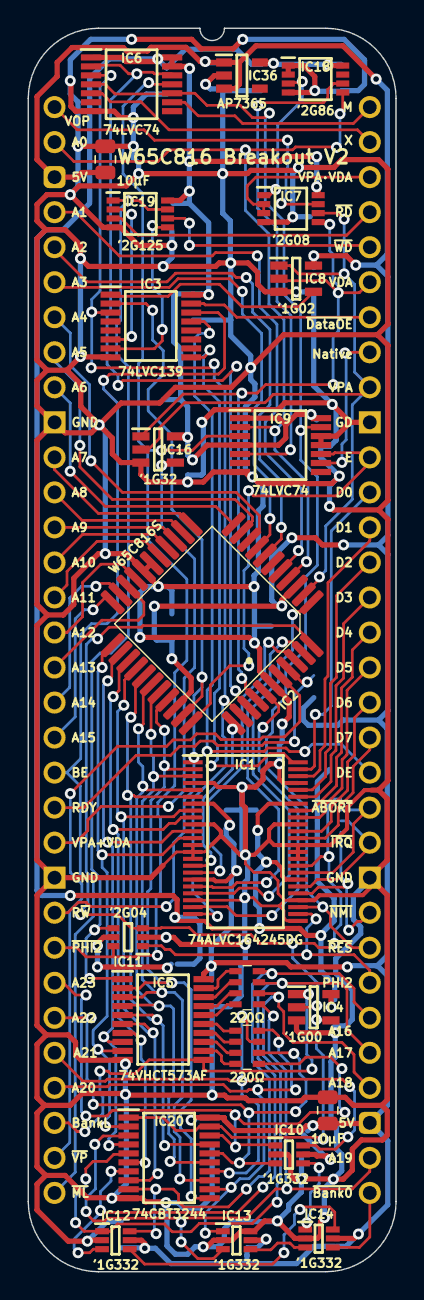
[picture p193: board W65C64.kicad_pcb from above]

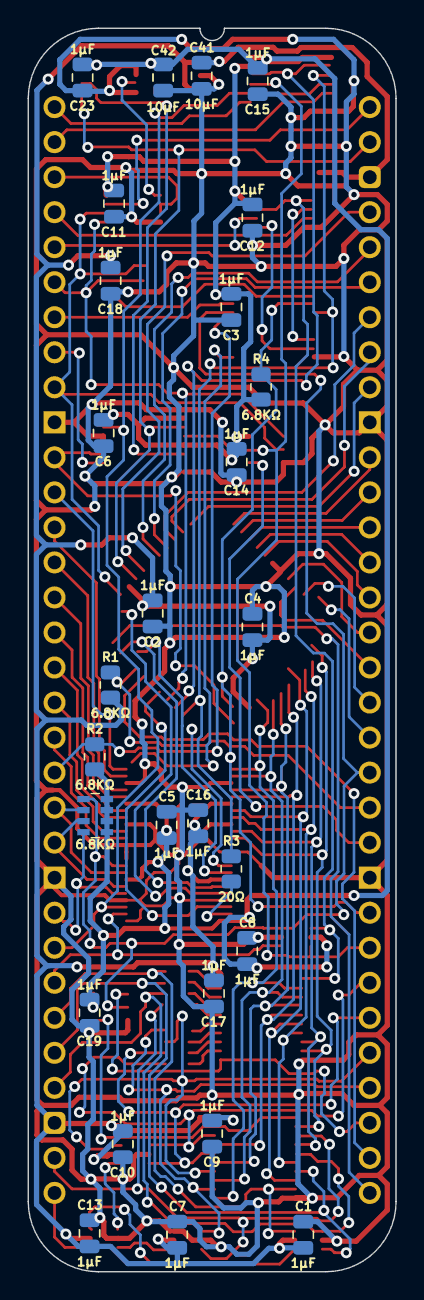
[picture p194: board W65C64.kicad_pcb from below]

Board: 2 copper layers, 26.7 x 90.2 mm, 51 parts (27 on the bottom side), 96 nets.

Parts:
C1, C2, C3, C4, C5, C6, C7, C8, C9, C10, C11, C12, C13, C14, C15, C16, C17, C18, C19, C23: 1μF; C_0805
C20, C21, C41, C42: 10μF; C_0805
IC1: 74ALVC164245DGG,11; SOP50P810X120-48N
IC2: W65C816S6TQG-14; W65C816 PLCC 0.8mm 44 Pin
IC3: 74LVC139PW,118; SOP65P640X110-16N
IC4: 74LVC1G00GV,125; SOT95P275X110-5N
IC5: 74VHCT573AFT; SOP65P640X120-20N
IC6, IC9: 74LVC74APW,118; SOP65P640X110-14N
IC7: 74LVC2G08DP-Q100H; SOP65P400X110-8N
IC8: 74LVC1G02GV,125; SOT95P275X110-5N
IC10, IC12, IC13, IC14: SN74LVC1G332DCKRG4; SOT65P210X110-6N
IC11: 74LVC2G04GW-Q100H; SOP65P210X110-6N
IC16: 74LVC1G32GV,125; SOT95P275X110-5N
IC18: 74LVC2G86DP,125; SOP65P400X110-8N
IC19: 74LVC2G125DP,125; SOP65P400X110-8N
IC20: SN74CBT3244CPWR; SOP65P640X120-20N
IC36: AP7365-33WG-7; SOT95P285X130-5N
J7: Board 2x32 W22.86mm; DIP-64_Board_W22.86mm
R1, R2, R4: 6.8KΩ; R_0805
R3: 20Ω; R_0805
RN1, RN2: CAY16-221J4LF; CAY16-F4
RN4: CAY16-472J4LF; CAY16-F4

Connections:
5V: C1.1, C2.1, C4.1, C7.1, C9.1, C10.1, C13.1, C16.1, C17.1, C18.1, C20.1, C21.1, C41.1, IC1.7 (5V), IC1.18 (5V), IC2.9 (VCC), IC2.37 (VCC), IC5.20 (5V), IC8.5 (3V), IC10.5 (3V), IC12.5 (3V), IC13.5 (3V), IC14.5 (3V), IC20.20 (5V), IC36.1 (6VIn), IC36.3 (EN), J7.3, J7.35, R1.1
/3.3V: C3.1, C5.1, C6.1, C8.1, C11.1, C12.1, C14.1, C15.1, C19.1, C23.1, C42.1, IC1.24 (2DIR), IC1.31 (3V), IC1.42 (3V), IC3.16 (3V), IC4.5 (3V), IC6.1 (~1RD), IC6.13 (~2RD), IC6.14 (3V), IC7.8 (3V), IC9.1 (~1RD), IC9.4 (~1SD), IC9.14 (3V), IC11.5 (3V), IC16.5 (3V), IC18.8 (VCC), IC19.8 (VCC), IC36.5 (3.3VOut), R2.1, R4.1, RN4.1 (R1), RN4.2 (R2), RN4.3 (R3), RN4.4 (R4)
/A0_{CHANGE}: IC7.1 (1A), IC18.3 (2Y)
/A0_{PREV}: IC9.5 (1Q), IC18.6 (2B)
/BA0+BA1+BA2: IC12.4 (Y), IC14.6 (C)
/BA3+BA4: IC13.4 (Y), IC14.3 (B)
/BA5+BA6+BA7: IC10.4 (Y), IC14.1 (A)
/BE_{5V}: IC1.16 (2B2), IC2.40 (BE)
/D0_{65}: IC1.2 (1B0), IC2.36 (D0), IC5.2 (D0), IC20.11 (2A1)
/D0_{VHC}: IC5.19 (Q0), RN2.1 (R1)
/D1_{65}: IC1.3 (1B1), IC2.35 (D1), IC5.3 (D1), IC20.13 (2A2)
/D1_{VHC}: IC5.18 (Q1), RN2.2 (R2)
/D2_{65}: IC1.5 (1B2), IC2.34 (D2), IC5.4 (D2), IC20.15 (2A3)
/D2_{VHC}: IC5.17 (Q2), RN2.3 (R3)
/D3_{65}: IC1.6 (1B3), IC2.33 (D3), IC5.5 (D3), IC20.17 (2A4)
/D3_{VHC}: IC5.16 (Q3), RN2.4 (R4)
/D4_{65}: IC1.8 (1B4), IC2.32 (D4), IC5.6 (D4), IC20.8 (1A4)
/D4_{VHC}: IC5.15 (Q4), RN1.1 (R1)
/D5_{65}: IC1.9 (1B5), IC2.31 (D5), IC5.7 (D5), IC20.6 (1A3)
/D5_{VHC}: IC5.14 (Q5), RN1.2 (R2)
/D6_{65}: IC1.11 (1B6), IC2.30 (D6), IC5.8 (D6), IC20.4 (1A2)
/D6_{VHC}: IC5.13 (Q6), RN1.3 (R3)
/D7_{65}: IC1.12 (1B7), IC2.29 (D7), IC5.9 (D7), IC20.2 (1A1)
/D7_{VHC}: IC5.12 (Q7), RN1.4 (R4)
/FET ~OE: IC4.4 (Y), IC20.1 (1~OE), IC20.19 (2~OE)
/MX: IC2.42 (MX), IC6.2 (1D), IC6.12 (2D)
/PHI2_{5V}: IC2.41 (PHI2), IC3.3 (1A1), IC6.3 (1CP), R3.2
/~ABORT_{5V}: IC1.17 (2B3), IC2.4 (~ABORT)
/~BE: IC5.1 (~OE), IC11.4 (2Y), IC19.1 (1~OE), IC19.7 (2~OE)
/~DE: IC1.48 (1~OE), IC3.9 (~2Y3)
/~IRQ_{5V}: IC1.19 (2B4), IC2.5 (~IRQ)
/~NMI_{5V}: IC1.20 (2B5), IC2.7 (~NMI)
/~RD_{PART}: IC3.7 (~1Y3), IC19.5 (2A)
/~RES_{5V}: IC1.22 (2B6), IC2.44 (~RES)
/~VPA+VDA: IC3.1 (~1E), IC8.4 (Y)
/~WD_{PART}: IC3.6 (~1Y2), IC19.2 (1A)
A0: IC2.10 (A0), IC9.2 (1D), IC18.5 (2A), J7.2
A1: IC2.11 (A1), J7.4
A2: IC2.13 (A2), J7.5
A3: IC2.14 (A3), J7.6
A4: IC2.15 (A4), J7.7
A5: IC2.16 (A5), J7.8
A6: IC2.17 (A6), J7.9
A7: IC2.18 (A7), J7.11
A8: IC2.19 (A8), J7.12
A9: IC2.20 (A9), J7.13
A10: IC2.21 (A10), J7.14
A11: IC2.22 (A11), J7.15
A12: IC2.25 (A12), J7.16
A13: IC2.26 (A13), J7.17
A14: IC2.27 (A14), J7.18
A15: IC2.28 (A15), J7.19
Address Valid: IC16.4 (Y), J7.22
BA0: IC12.6 (C), IC20.9 (2B1), J7.38, RN2.8 (R1)
BA1: IC12.3 (B), IC20.7 (2B2), J7.37, RN2.7 (R2)
BA2: IC12.1 (A), IC20.5 (2B3), J7.36, RN2.6 (R3)
BA3: IC13.3 (B), IC20.3 (2B4), J7.34, RN2.5 (R4)
BA4: IC13.1 (A), IC20.12 (1B4), J7.29, RN1.8 (R1)
BA5: IC10.6 (C), IC20.14 (1B3), J7.28, RN1.7 (R2)
BA6: IC10.3 (B), IC20.16 (1B2), J7.27, RN1.6 (R3)
BA7: IC10.1 (A), IC20.18 (1B1), J7.26, RN1.5 (R4)
BE: IC1.33 (2A2), IC3.14 (2A0), IC4.2 (A), IC11.3 (2A), J7.20, RN4.5 (R4)
Bank Latch: IC4.1 (B), IC5.11 (LE), J7.30
D0: IC1.47 (1A0), J7.53
D1: IC1.46 (1A1), J7.52
D2: IC1.44 (1A2), J7.51
D3: IC1.43 (1A3), J7.50
D4: IC1.41 (1A4), J7.49
D5: IC1.40 (1A5), J7.48
D6: IC1.38 (1A6), J7.47
D7: IC1.37 (1A7), J7.46
DE: IC3.13 (2A1), J7.45, R2.2
E: IC2.39 (E), IC9.10 (~2SD), J7.54
GND: C1.2, C2.2, C3.2, C4.2, C5.2, C6.2, C7.2, C8.2, C9.2, C10.2, C11.2, C12.2, C13.2, C14.2, C15.2, C16.2, C17.2, C18.2, C19.2, C20.2, C21.2, C23.2, C41.2, C42.2, IC1.4 (GND), IC1.10 (GND), IC1.13 (2B0), IC1.14 (2B1), IC1.15 (GND), IC1.21 (GND), IC1.25 (2~OE), IC1.28 (GND), IC1.34 (GND), IC1.35 (2A1), IC1.36 (2A0), IC1.39 (GND), IC1.45 (GND), IC2.1 (GND), IC2.23 (GND), IC2.24 (GND), IC3.8 (GND), IC4.3 (GND), IC5.10 (GND), IC6.7 (GND), IC7.4 (GND), IC8.3 (GND), IC9.7 (GND), IC9.11 (2CP), IC9.12 (2D), IC10.2 (GND), IC11.2 (GND), IC12.2 (GND), IC13.2 (GND), IC13.6 (C), IC14.2 (GND), IC16.3 (GND), IC18.1 (1A), IC18.2 (1B), IC18.4 (GND), IC19.4 (GND), IC20.10 (GND), IC36.2 (GND), J7.10, J7.23, J7.42, J7.55
M: IC6.9 (2Q), J7.64
Native Latch: IC9.9 (2Q), J7.57
unnamed: IC1.23 (2B7), R3.1
Opcode Valid: IC7.7 (1Y), J7.1
PHI2: IC1.26 (2A7), IC11.1 (1A), J7.39
RDY: IC2.3 (RDY), J7.21, R1.2
R~W: IC1.1 (1DIR), IC2.38 (R~W), IC3.2 (1A0), J7.24, R4.2
VDA: IC2.43 (VDA), IC7.5 (2A), IC8.2 (A), IC16.1 (B), J7.59
VPA: IC2.8 (VPA), IC7.6 (2B), IC8.1 (B), IC16.2 (A), J7.56
VPA·VDA: IC7.2 (1B), IC7.3 (2Y), J7.62
X: IC6.5 (1Q), J7.63
~ABORT: IC1.32 (2A3), J7.44, RN4.6 (R3)
~BANK 0: IC14.4 (Y), J7.33
~Data Output: IC3.15 (~2E), J7.58
~IRQ: IC1.30 (2A4), J7.43, RN4.7 (R2)
~ML: IC2.6 (~ML), J7.32
~NMI: IC1.29 (2A5), J7.41, RN4.8 (R1)
~PHI2: IC6.11 (2CP), IC9.3 (1CP), IC11.6 (1Y), J7.25
~RD: IC19.3 (2Y), J7.61
~Reset: IC1.27 (2A6), IC6.4 (~1SD), IC6.10 (~2SD), IC9.13 (~2RD), J7.40
~VP: IC2.2 (~VP), J7.31
~WD: IC19.6 (1Y), J7.60
