andrewpaterson/658-Computer/Kicad/Pico/GPIO Address Decode/GPIO Address Decode.kicad_pcb

## KiCad design Kicad/Pico/GPIO Address Decode/GPIO Address Decode.kicad_pcb (2026-08-24)

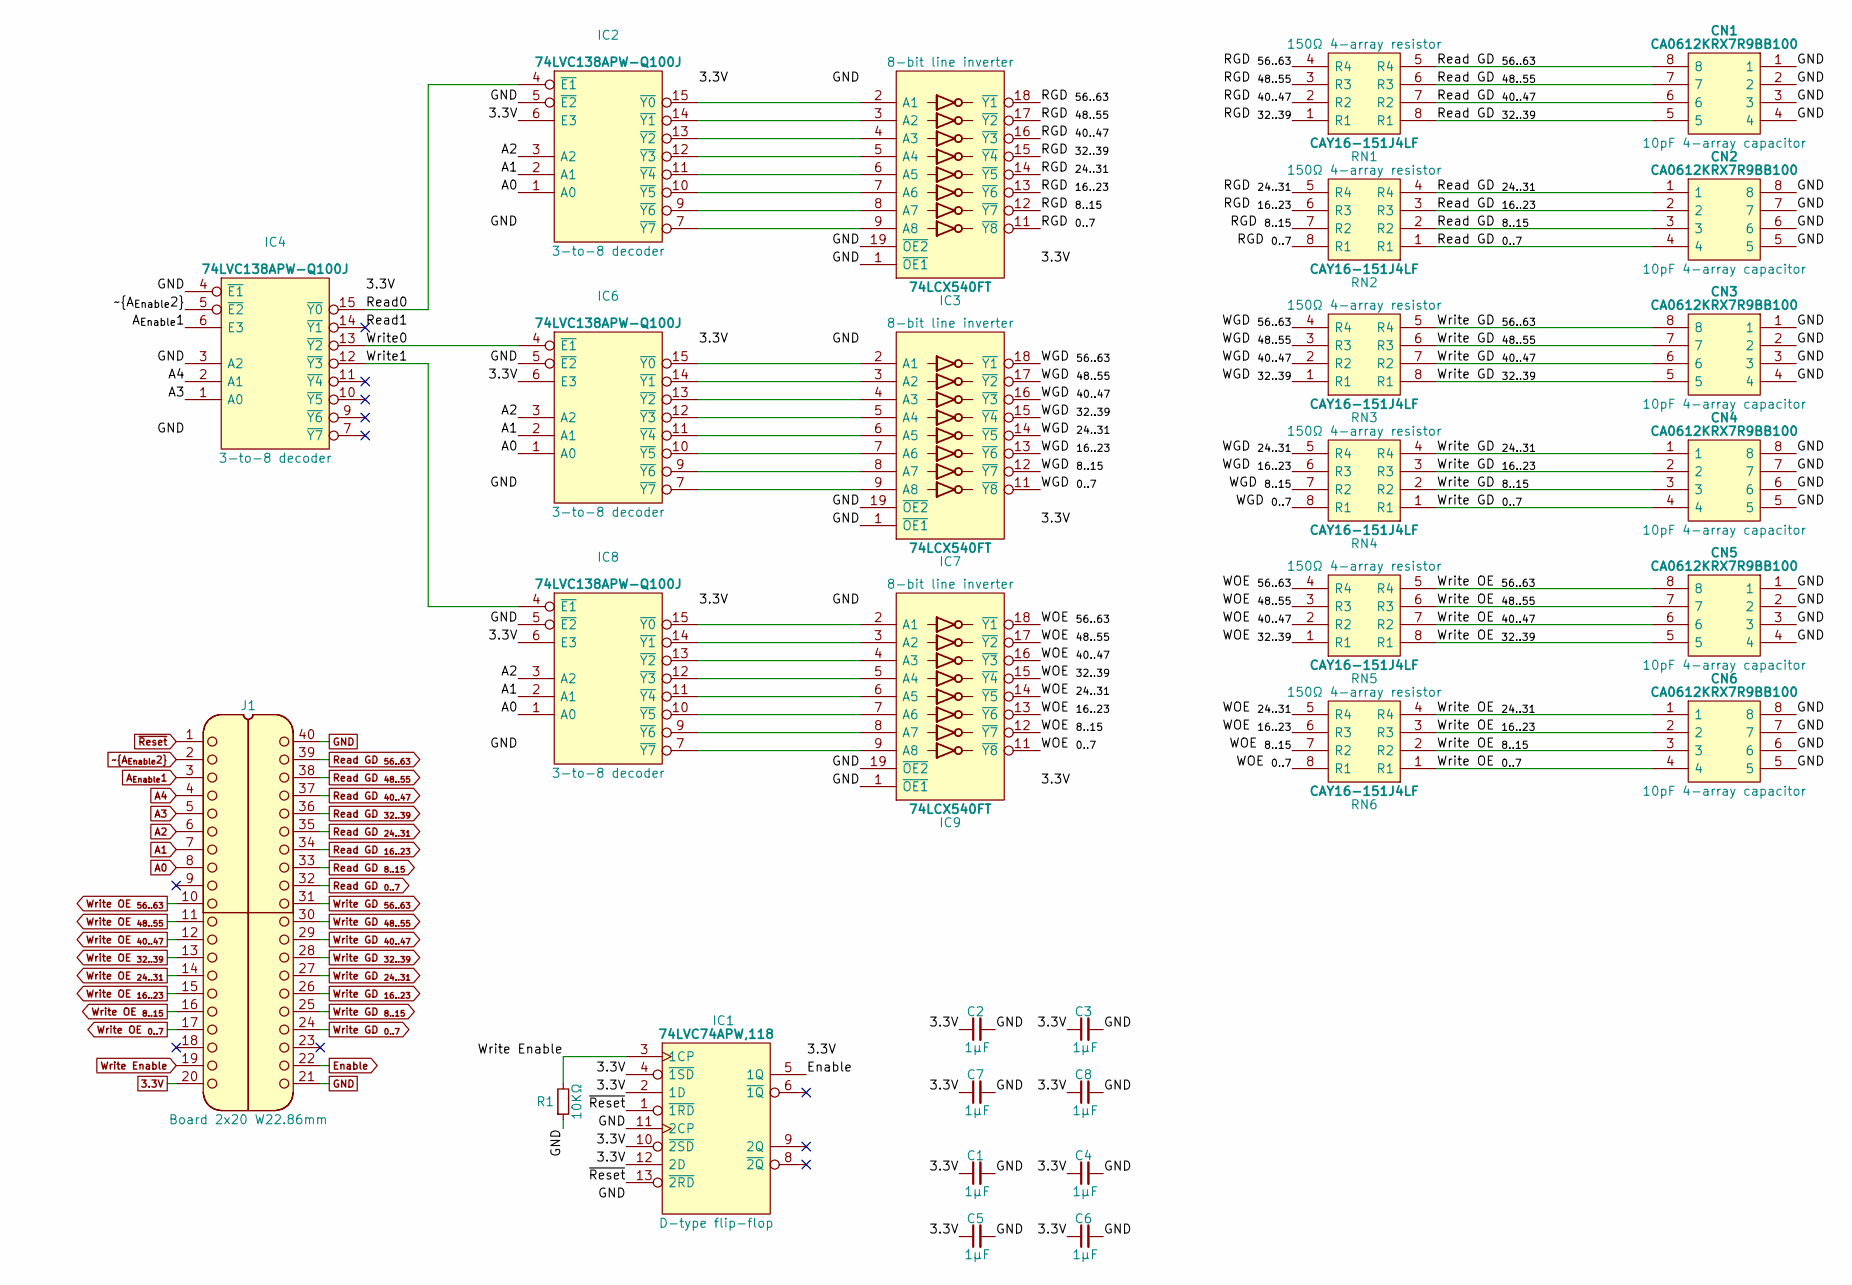
[picture p195: schematic GPIO Address Decode.kicad_sch]

Parts:
C1, C2, C3, C4, C5, C6, C7, C8: 1μF; C_0805
CN1, CN2, CN3, CN4, CN5, CN6: CA0612KRX7R9BB100; Manufacturer_Part_Number CA0612KRX7R9BB102; Mouser Part Number 603-CA612KRX7R9BB102
IC1: 74LVC74APW,118; SOP65P640X110-14N; Mouser Part Number 771-74LVC74APW-T
IC2, IC4, IC6, IC8: 74LVC138APW-Q100J; SOP65P640X110-16N; Mouser Part Number 771-74LVC138APWQ100J
IC3, IC7, IC9: 74LCX540FT; SOP65P640X120-20N; Manufacturer_Part_Number 74LCX540FT; Mouser Part Number 757-74LCX540FT
J1: Board 2x20 W22.86mm; DIP-40_Board_W22.86mm
R1: 10KΩ; R_0805
RN1, RN2, RN3, RN4, RN5, RN6: CAY16-151J4LF; CAY16-J4; Manufacturer_Part_Number CAY16-151J4LF; Mouser Part Number 652-CAY16-151J4LF

Connections:
3.3V: C1.1, C2.1, C3.1, C4.1, C5.1, C6.1, C7.1, C8.1, IC1.2 (1D), IC1.4 (~1SD), IC1.10 (~2SD), IC1.12 (2D), IC1.14 (3V), IC2.6 (E3), IC2.16 (3V), IC3.20 (3V), IC4.16 (3V), IC6.6 (E3), IC6.16 (3V), IC7.20 (3V), IC8.6 (E3), IC8.16 (3V), IC9.20 (3V), J1.20
/RGD _{0..7}: IC3.11 (~Y8), RN2.8 (R1)
/RGD _{8..15}: IC3.12 (~Y7), RN2.7 (R2)
/RGD _{16..23}: IC3.13 (~Y6), RN2.6 (R3)
/RGD _{24..31}: IC3.14 (~Y5), RN2.5 (R4)
/RGD _{32..39}: IC3.15 (~Y4), RN1.1 (R1)
/RGD _{40..47}: IC3.16 (~Y3), RN1.2 (R2)
/RGD _{48..55}: IC3.17 (~Y2), RN1.3 (R3)
/RGD _{56..63}: IC3.18 (~Y1), RN1.4 (R4)
/Read0: IC2.4 (~E1), IC4.15 (~Y0)
/Read1: IC4.14 (~Y1)
/WGD _{0..7}: IC7.11 (~Y8), RN4.8 (R1)
/WGD _{8..15}: IC7.12 (~Y7), RN4.7 (R2)
/WGD _{16..23}: IC7.13 (~Y6), RN4.6 (R3)
/WGD _{24..31}: IC7.14 (~Y5), RN4.5 (R4)
/WGD _{32..39}: IC7.15 (~Y4), RN3.1 (R1)
/WGD _{40..47}: IC7.16 (~Y3), RN3.2 (R2)
/WGD _{48..55}: IC7.17 (~Y2), RN3.3 (R3)
/WGD _{56..63}: IC7.18 (~Y1), RN3.4 (R4)
/WOE _{0..7}: IC9.11 (~Y8), RN6.8 (R1)
/WOE _{8..15}: IC9.12 (~Y7), RN6.7 (R2)
/WOE _{16..23}: IC9.13 (~Y6), RN6.6 (R3)
/WOE _{24..31}: IC9.14 (~Y5), RN6.5 (R4)
/WOE _{32..39}: IC9.15 (~Y4), RN5.1 (R1)
/WOE _{40..47}: IC9.16 (~Y3), RN5.2 (R2)
/WOE _{48..55}: IC9.17 (~Y2), RN5.3 (R3)
/WOE _{56..63}: IC9.18 (~Y1), RN5.4 (R4)
/Write0: IC4.13 (~Y2), IC6.4 (~E1)
/Write1: IC4.12 (~Y3), IC8.4 (~E1)
A0: IC2.1 (A0), IC6.1 (A0), IC8.1 (A0), J1.8
A1: IC2.2 (A1), IC6.2 (A1), IC8.2 (A1), J1.7
A2: IC2.3 (A2), IC6.3 (A2), IC8.3 (A2), J1.6
A3: IC4.1 (A0), J1.5
A4: IC4.2 (A1), J1.4
A_{Enable}1: IC4.6 (E3), J1.3
Enable: IC1.5 (1Q), J1.22
GND: C1.2, C2.2, C3.2, C4.2, C5.2, C6.2, C7.2, C8.2, CN1.1, CN1.2, CN1.3, CN1.4, CN2.5, CN2.6, CN2.7, CN2.8, CN3.1, CN3.2, CN3.3, CN3.4, CN4.5, CN4.6, CN4.7, CN4.8, CN5.1, CN5.2, CN5.3, CN5.4, CN6.5, CN6.6, CN6.7, CN6.8, IC1.7 (GND), IC1.11 (2CP), IC2.5 (~E2), IC2.8 (GND), IC3.1 (~OE1), IC3.10 (GND), IC3.19 (~OE2), IC4.3 (A2), IC4.4 (~E1), IC4.8 (GND), IC6.5 (~E2), IC6.8 (GND), IC7.1 (~OE1), IC7.10 (GND), IC7.19 (~OE2), IC8.5 (~E2), IC8.8 (GND), IC9.1 (~OE1), IC9.10 (GND), IC9.19 (~OE2), J1.21, J1.40, R1.1
unnamed: IC2.15 (~Y0), IC3.2 (A1)
unnamed: IC2.14 (~Y1), IC3.3 (A2)
unnamed: IC2.13 (~Y2), IC3.4 (A3)
unnamed: IC2.12 (~Y3), IC3.5 (A4)
unnamed: IC2.11 (~Y4), IC3.6 (A5)
unnamed: IC2.10 (~Y5), IC3.7 (A6)
unnamed: IC2.9 (~Y6), IC3.8 (A7)
unnamed: IC2.7 (~Y7), IC3.9 (A8)
unnamed: IC6.15 (~Y0), IC7.2 (A1)
unnamed: IC6.14 (~Y1), IC7.3 (A2)
unnamed: IC6.13 (~Y2), IC7.4 (A3)
unnamed: IC6.12 (~Y3), IC7.5 (A4)
unnamed: IC6.11 (~Y4), IC7.6 (A5)
unnamed: IC6.10 (~Y5), IC7.7 (A6)
unnamed: IC6.9 (~Y6), IC7.8 (A7)
unnamed: IC6.7 (~Y7), IC7.9 (A8)
unnamed: IC8.15 (~Y0), IC9.2 (A1)
unnamed: IC8.14 (~Y1), IC9.3 (A2)
unnamed: IC8.13 (~Y2), IC9.4 (A3)
unnamed: IC8.12 (~Y3), IC9.5 (A4)
unnamed: IC8.11 (~Y4), IC9.6 (A5)
unnamed: IC8.10 (~Y5), IC9.7 (A6)
unnamed: IC8.9 (~Y6), IC9.8 (A7)
unnamed: IC8.7 (~Y7), IC9.9 (A8)
Read GD _{0..7}: CN2.4, J1.32, RN2.1 (R1)
Read GD _{8..15}: CN2.3, J1.33, RN2.2 (R2)
Read GD _{16..23}: CN2.2, J1.34, RN2.3 (R3)
Read GD _{24..31}: CN2.1, J1.35, RN2.4 (R4)
Read GD _{32..39}: CN1.5, J1.36, RN1.8 (R1)
Read GD _{40..47}: CN1.6, J1.37, RN1.7 (R2)
Read GD _{48..55}: CN1.7, J1.38, RN1.6 (R3)
Read GD _{56..63}: CN1.8, J1.39, RN1.5 (R4)
Write Enable: IC1.3 (1CP), J1.19, R1.2
Write GD _{0..7}: CN4.4, J1.24, RN4.1 (R1)
Write GD _{8..15}: CN4.3, J1.25, RN4.2 (R2)
Write GD _{16..23}: CN4.2, J1.26, RN4.3 (R3)
Write GD _{24..31}: CN4.1, J1.27, RN4.4 (R4)
Write GD _{32..39}: CN3.5, J1.28, RN3.8 (R1)
Write GD _{40..47}: CN3.6, J1.29, RN3.7 (R2)
Write GD _{48..55}: CN3.7, J1.30, RN3.6 (R3)
Write GD _{56..63}: CN3.8, J1.31, RN3.5 (R4)
Write OE _{0..7}: CN6.4, J1.17, RN6.1 (R1)
Write OE _{8..15}: CN6.3, J1.16, RN6.2 (R2)
Write OE _{16..23}: CN6.2, J1.15, RN6.3 (R3)
Write OE _{24..31}: CN6.1, J1.14, RN6.4 (R4)
Write OE _{32..39}: CN5.5, J1.13, RN5.8 (R1)
Write OE _{40..47}: CN5.6, J1.12, RN5.7 (R2)
Write OE _{48..55}: CN5.7, J1.11, RN5.6 (R3)
Write OE _{56..63}: CN5.8, J1.10, RN5.5 (R4)
~A_{Enable2}: IC4.5 (~E2), J1.2
~Reset: IC1.1 (~1RD), IC1.13 (~2RD), J1.1

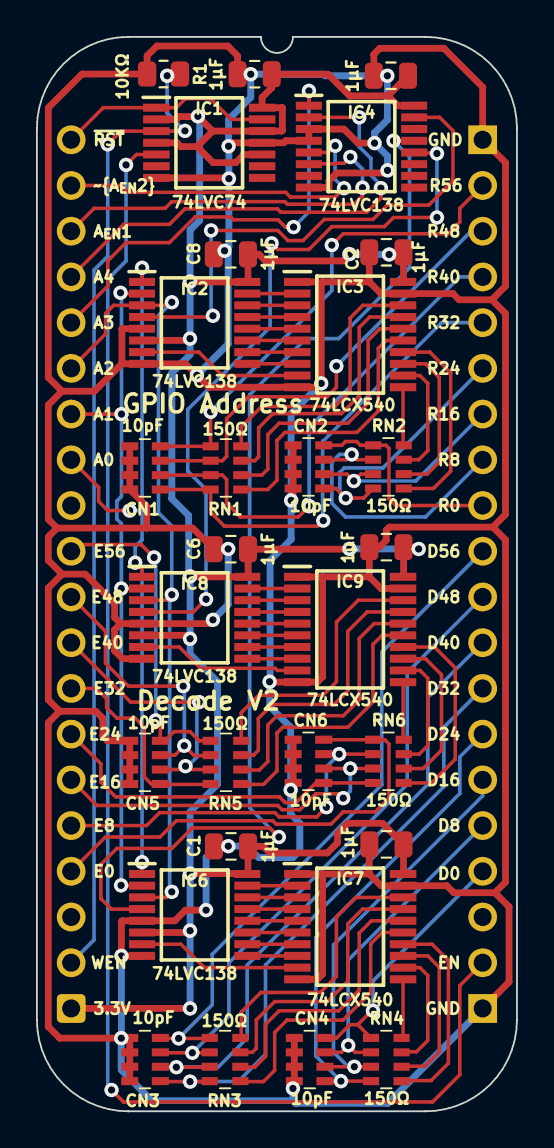
[picture p196: board GPIO Address Decode.kicad_pcb from above]

Board: 2 copper layers, 26.7 x 59.7 mm, 30 parts (0 on the bottom side), 87 nets.
