andrewpaterson/658-Computer/Kicad/Pico/SDRAM/SDRAM.kicad_pcb

## KiCad design Kicad/Pico/SDRAM/SDRAM.kicad_pcb (2026-08-24)

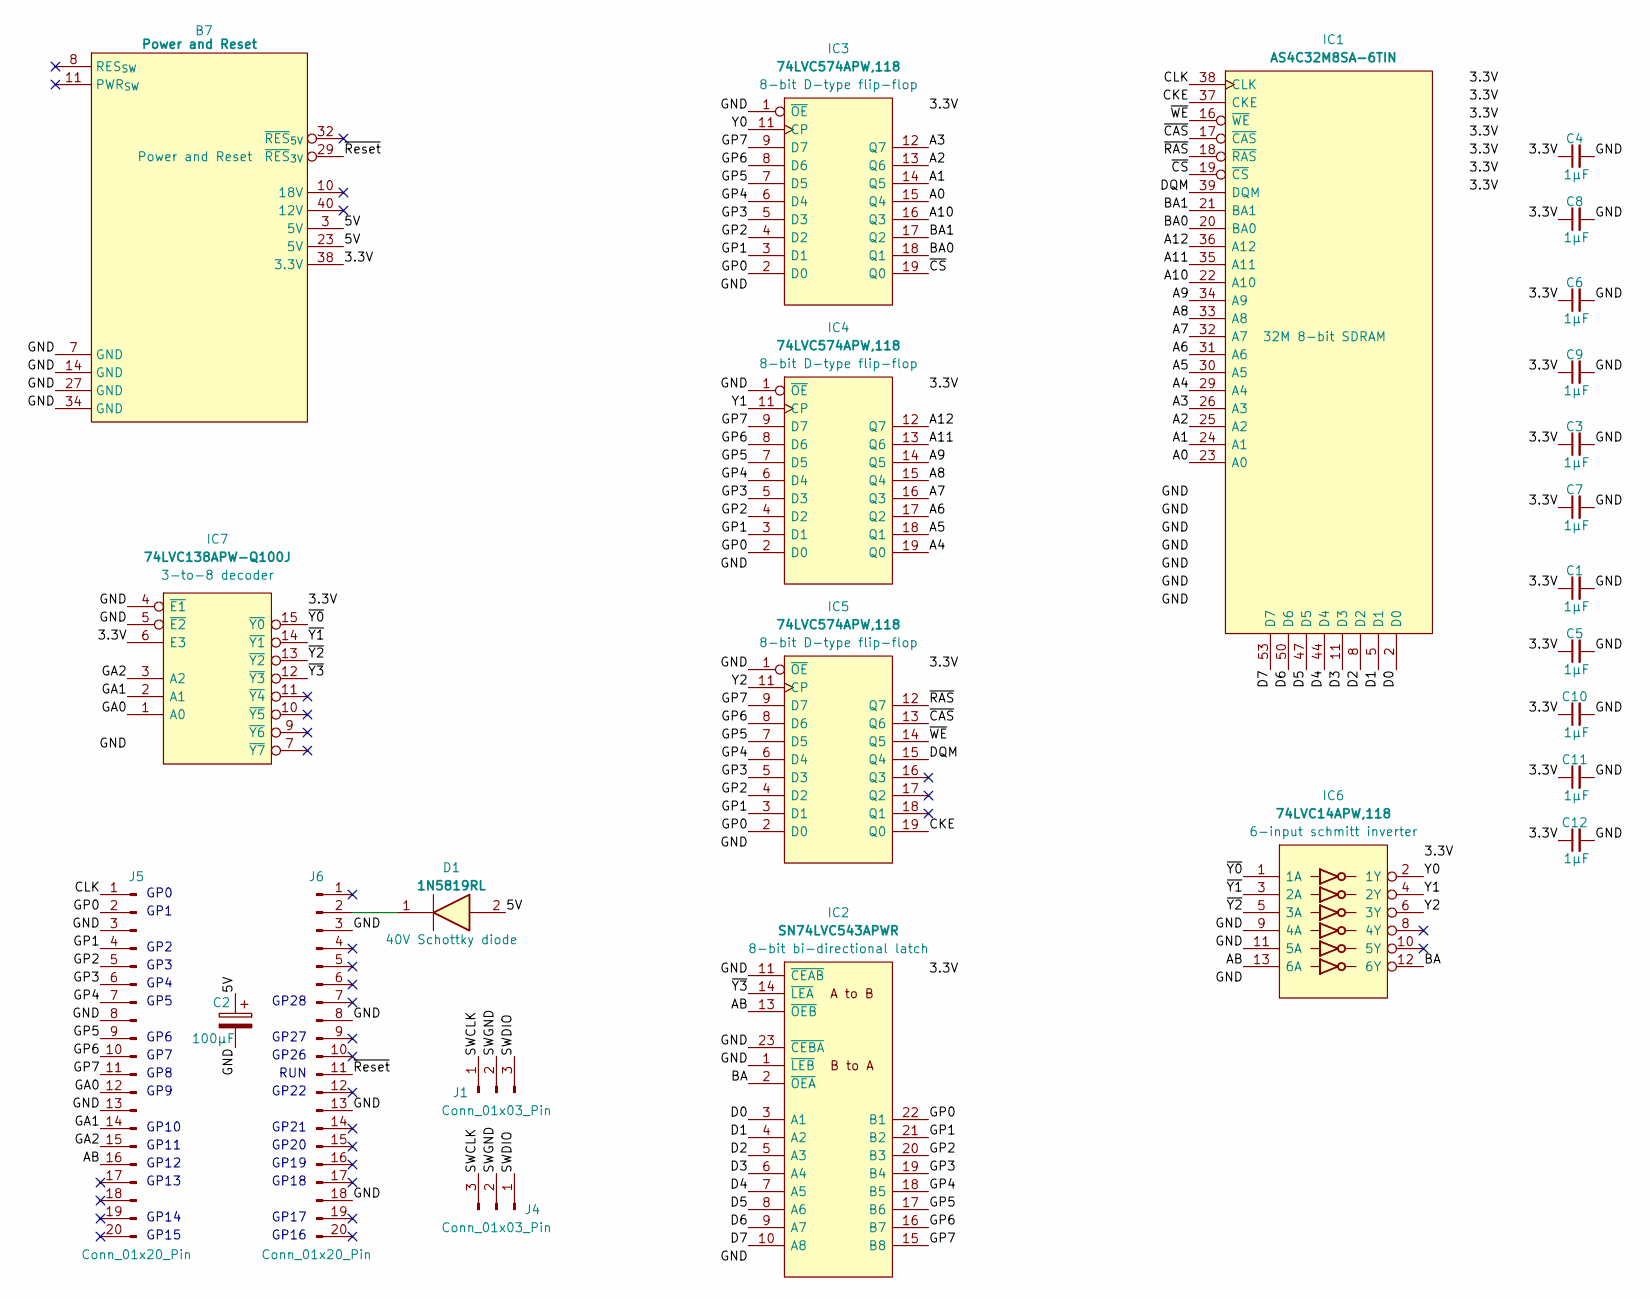
[picture p197: schematic SDRAM.kicad_sch, SDRAM Test Board]

Parts:
B7: Power and Reset; HCP65_Power_and_Reset
C1, C3, C4, C5, C6, C7, C8, C9, C10, C11, C12: 1μF; C_0805
C2: 100μF; CP_Radial_D6.3mm_P2.50mm
D1: 1N5819RL; DIOAD1414W86L464D238; Manufacturer_Part_Number 1N5819RL; Mouser Part Number 511-1N5819-TR
IC1: AS4C32M8SA-6TIN; SOP80P1176X120-54N; Manufacturer_Part_Number AS4C32M8SA-6TIN
IC2: SN74LVC543APWR; SOP65P640X120-24N; Mouser Part Number 595-SN74LVC543APWR
IC3, IC4, IC5: 74LVC574APW,118; SOP65P640X110-20N; Manufacturer_Part_Number 74LVC574APW,118; Mouser Part Number 771-74LVC574APW-T
IC6: 74LVC14APW,118; SOP65P640X110-14N; Manufacturer_Part_Number 74LVC14APW,118; Mouser Part Number 771-74LVC14APW-T
IC7: 74LVC138APW-Q100J; SOP65P640X110-16N; Mouser Part Number 771-74LVC138APWQ100J
J1: Conn_01x03_Pin; PinSocket_1x03_P2.54mm_Vertical
J4: Conn_01x03_Pin; PinHeader_1x03_P2.54mm_Horizontal
J5, J6: Conn_01x20_Pin; PinSocket_1x20_P2.54mm_Vertical

Connections:
/3.3V: B7.38 (3.3V), C1.1, C3.1, C4.1, C5.1, C6.1, C7.1, C8.1, C9.1, C10.1, C11.1, C12.1, IC1.1 (3V), IC1.3 (VDDQ), IC1.9 (VDDQ), IC1.14 (3V), IC1.27 (3V), IC1.43 (VDDQ), IC1.49 (VDDQ), IC2.24 (3V), IC3.20 (3V), IC4.20 (3V), IC5.20 (3V), IC6.14 (3V), IC7.6 (E3), IC7.16 (3V)
/5V: B7.3 (5V), B7.23 (5V), C2.1, D1.2
/A0: IC1.23 (A0), IC3.15 (Q4)
/A1: IC1.24 (A1), IC3.14 (Q5)
/A2: IC1.25 (A2), IC3.13 (Q6)
/A3: IC1.26 (A3), IC3.12 (Q7)
/A4: IC1.29 (A4), IC4.19 (Q0)
/A5: IC1.30 (A5), IC4.18 (Q1)
/A6: IC1.31 (A6), IC4.17 (Q2)
/A7: IC1.32 (A7), IC4.16 (Q3)
/A8: IC1.33 (A8), IC4.15 (Q4)
/A9: IC1.34 (A9), IC4.14 (Q5)
/A10: IC1.22 (A10), IC3.16 (Q3)
/A11: IC1.35 (A11), IC4.13 (Q6)
/A12: IC1.36 (A12), IC4.12 (Q7)
/AB: IC2.13 (~OEB), IC6.13 (6A), J5.16
/BA: IC2.2 (~OEA), IC6.12 (6Y)
/BA0: IC1.20 (BA0), IC3.18 (Q1)
/BA1: IC1.21 (BA1), IC3.17 (Q2)
/CKE: IC1.37 (CKE), IC5.19 (Q0)
/CLK: IC1.38 (CLK), J5.1
/D0: IC1.2 (D0), IC2.3 (A1)
/D1: IC1.5 (D1), IC2.4 (A2)
/D2: IC1.8 (D2), IC2.5 (A3)
/D3: IC1.11 (D3), IC2.6 (A4)
/D4: IC1.44 (D4), IC2.7 (A5)
/D5: IC1.47 (D5), IC2.8 (A6)
/D6: IC1.50 (D6), IC2.9 (A7)
/D7: IC1.53 (D7), IC2.10 (A8)
/DQM: IC1.39 (DQM), IC5.15 (Q4)
/GA0: IC7.1 (A0), J5.12
/GA1: IC7.2 (A1), J5.14
/GA2: IC7.3 (A2), J5.15
/GND: B7.7 (GND), B7.14 (GND), B7.27 (GND), B7.34 (GND), C1.2, C2.2, C3.2, C4.2, C5.2, C6.2, C7.2, C8.2, C9.2, C10.2, C11.2, C12.2, IC1.6 (VSSQ), IC1.12 (VSSQ), IC1.28 (GND), IC1.41 (GND), IC1.46 (VSSQ), IC1.52 (VSSQ), IC1.54 (GND), IC2.1 (~LEB), IC2.11 (~CEAB), IC2.12 (GND), IC2.23 (~CEBA), IC3.1 (~OE), IC3.10 (GND), IC4.1 (~OE), IC4.10 (GND), IC5.1 (~OE), IC5.10 (GND), IC6.7 (GND), IC6.9 (4A), IC6.11 (5A), IC7.4 (~E1), IC7.5 (~E2), IC7.8 (GND), J5.3, J5.8, J5.13, J6.3, J6.8, J6.13, J6.18
/GP0: IC2.22 (B1), IC3.2 (D0), IC4.2 (D0), IC5.2 (D0), J5.2
/GP1: IC2.21 (B2), IC3.3 (D1), IC4.3 (D1), IC5.3 (D1), J5.4
/GP2: IC2.20 (B3), IC3.4 (D2), IC4.4 (D2), IC5.4 (D2), J5.5
/GP3: IC2.19 (B4), IC3.5 (D3), IC4.5 (D3), IC5.5 (D3), J5.6
/GP4: IC2.18 (B5), IC3.6 (D4), IC4.6 (D4), IC5.6 (D4), J5.7
/GP5: IC2.17 (B6), IC3.7 (D5), IC4.7 (D5), IC5.7 (D5), J5.9
/GP6: IC2.16 (B7), IC3.8 (D6), IC4.8 (D6), IC5.8 (D6), J5.10
/GP7: IC2.15 (B8), IC3.9 (D7), IC4.9 (D7), IC5.9 (D7), J5.11
/SWCLK: J1.1, J4.3
/SWDIO: J1.3, J4.1
/SWGND: J1.2, J4.2
/Y0: IC3.11 (CP), IC6.2 (1Y)
/Y1: IC4.11 (CP), IC6.4 (2Y)
/Y2: IC5.11 (CP), IC6.6 (3Y)
/~CAS: IC1.17 (~CAS), IC5.13 (Q6)
/~CS: IC1.19 (~CS), IC3.19 (Q0)
/~RAS: IC1.18 (~RAS), IC5.12 (Q7)
/~Reset: B7.29 (~RES_{3V}), J6.11
/~WE: IC1.16 (~WE), IC5.14 (Q5)
/~Y0: IC6.1 (1A), IC7.15 (~Y0)
/~Y1: IC6.3 (2A), IC7.14 (~Y1)
/~Y2: IC6.5 (3A), IC7.13 (~Y2)
/~Y3: IC2.14 (~LEA), IC7.12 (~Y3)
unnamed: D1.1, J6.2

Notes on the sheet:
GP15
GP7
GP27
GP5
GP11
GP26
GP8
GP28
GP16
GP22
GP14
GP4
GP21
GP20
GP9
GP12
GP17
GP3
RUN
GP10
GP1
GP18
GP2
GP6
GP13
GP0
GP19

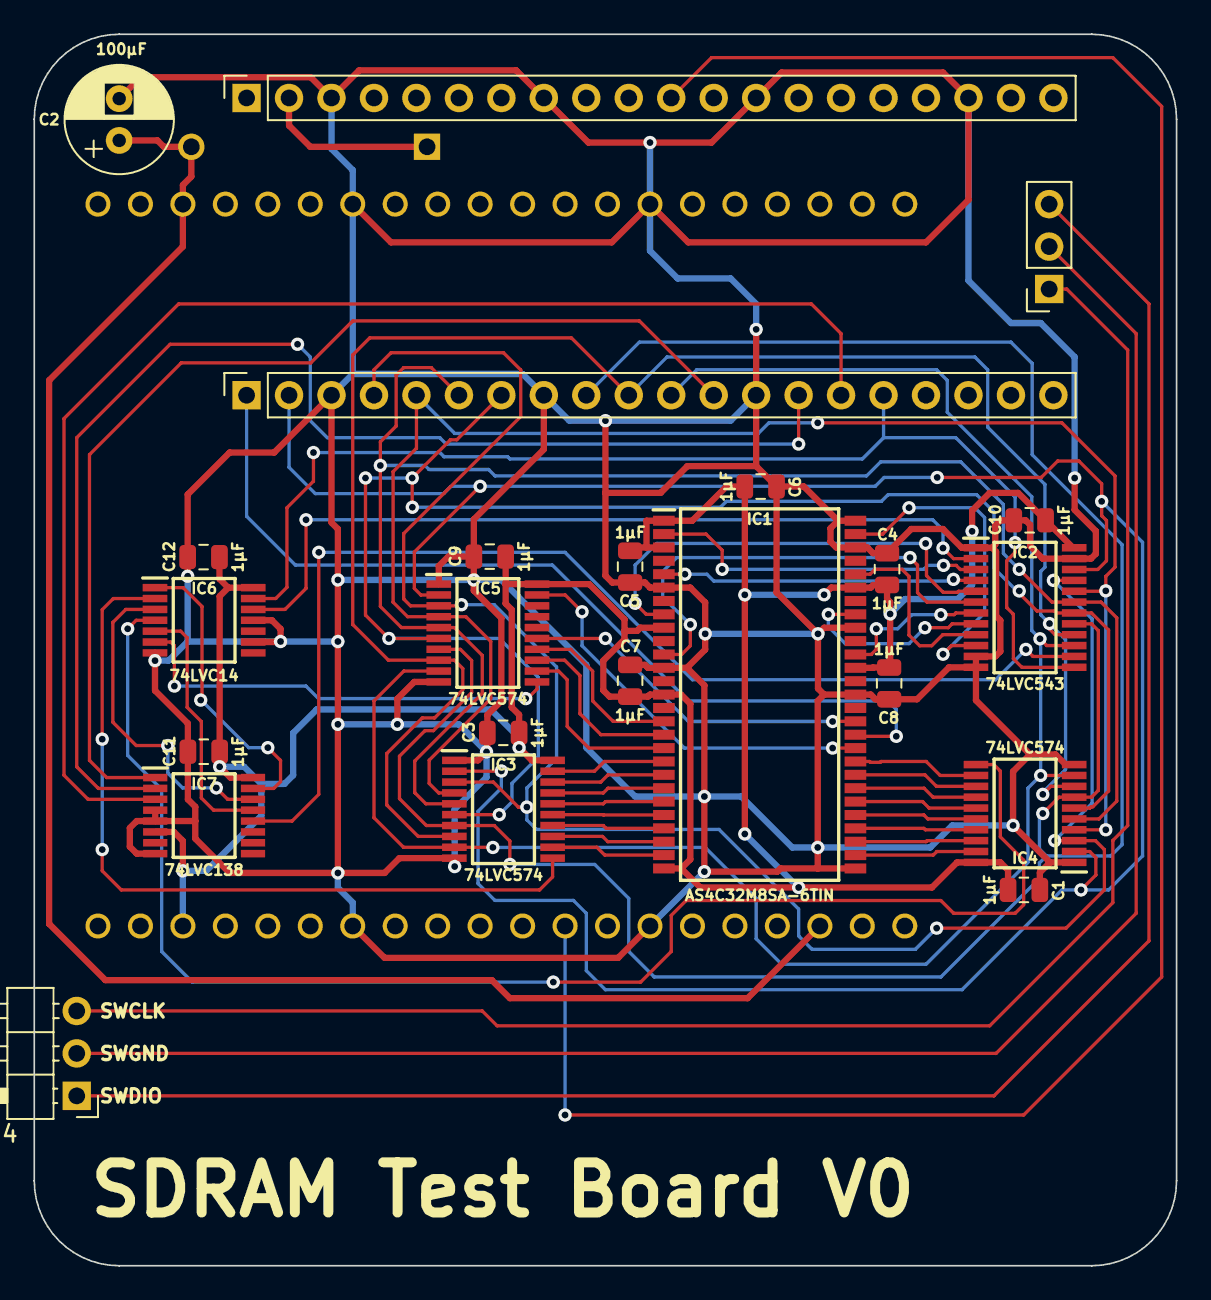
[picture p198: board SDRAM.kicad_pcb from above]

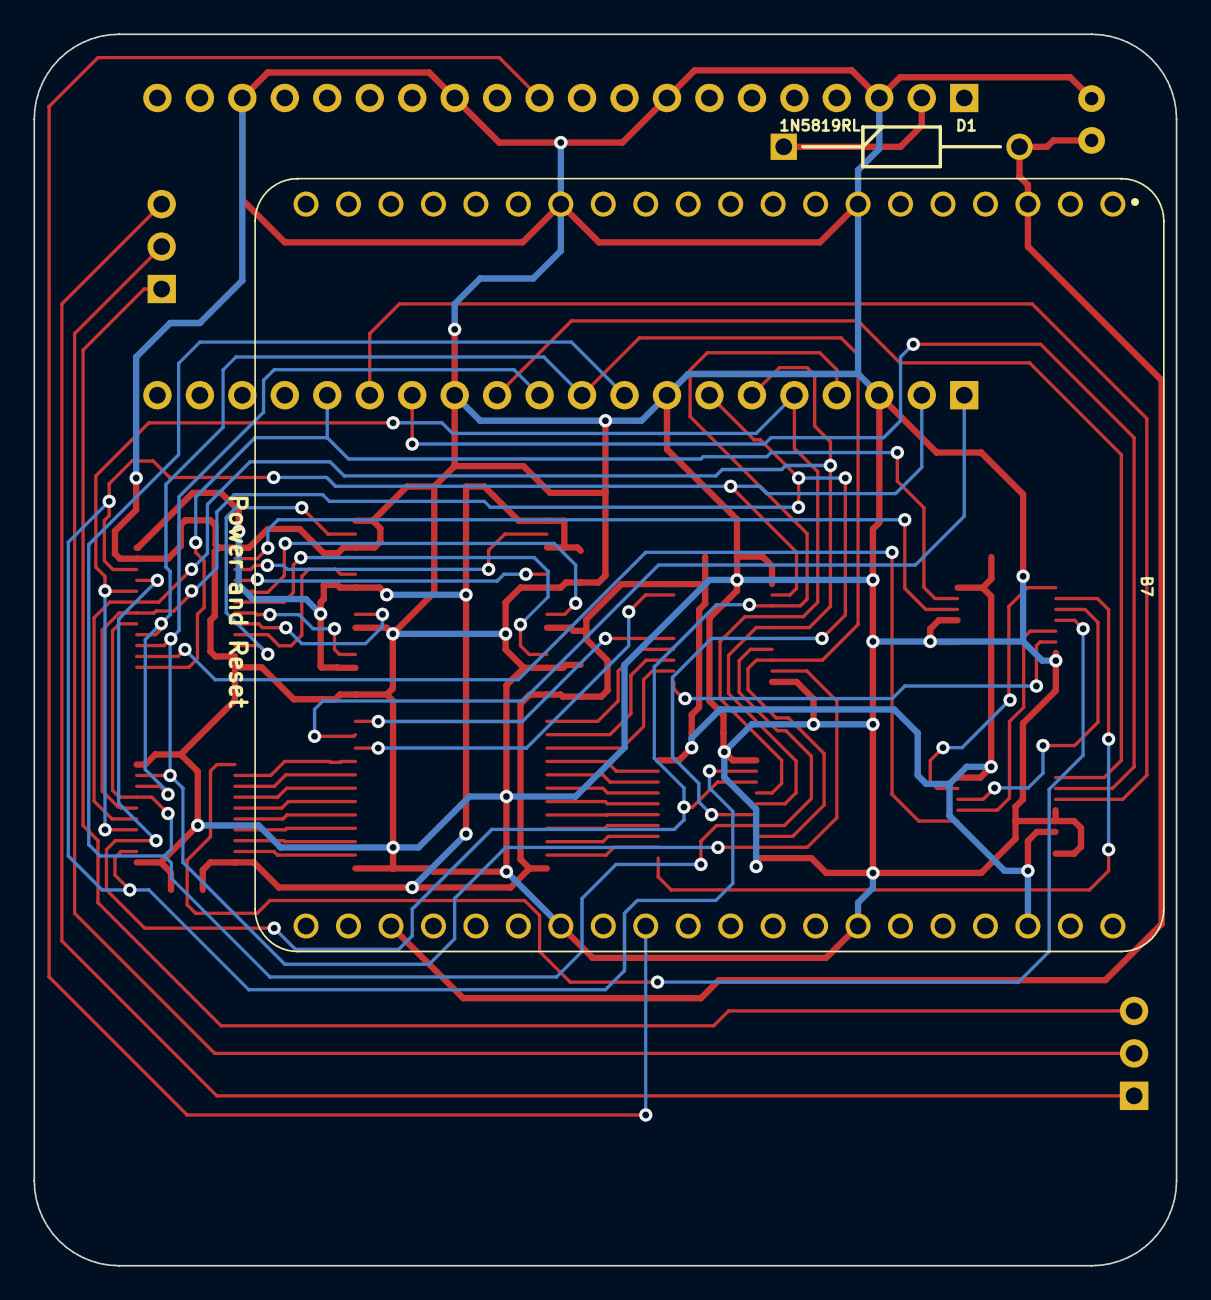
[picture p199: board SDRAM.kicad_pcb from below]

Board: 2 copper layers, 68.3 x 73.7 mm, 25 parts (2 on the bottom side), 58 nets.
