andrewpaterson/658-Computer/Kicad/Pico/GPIO Controller Board/GPIO Controller Board.kicad_pcb

## KiCad design Kicad/Pico/GPIO Controller Board/GPIO Controller Board.kicad_pcb (2026-07-19)

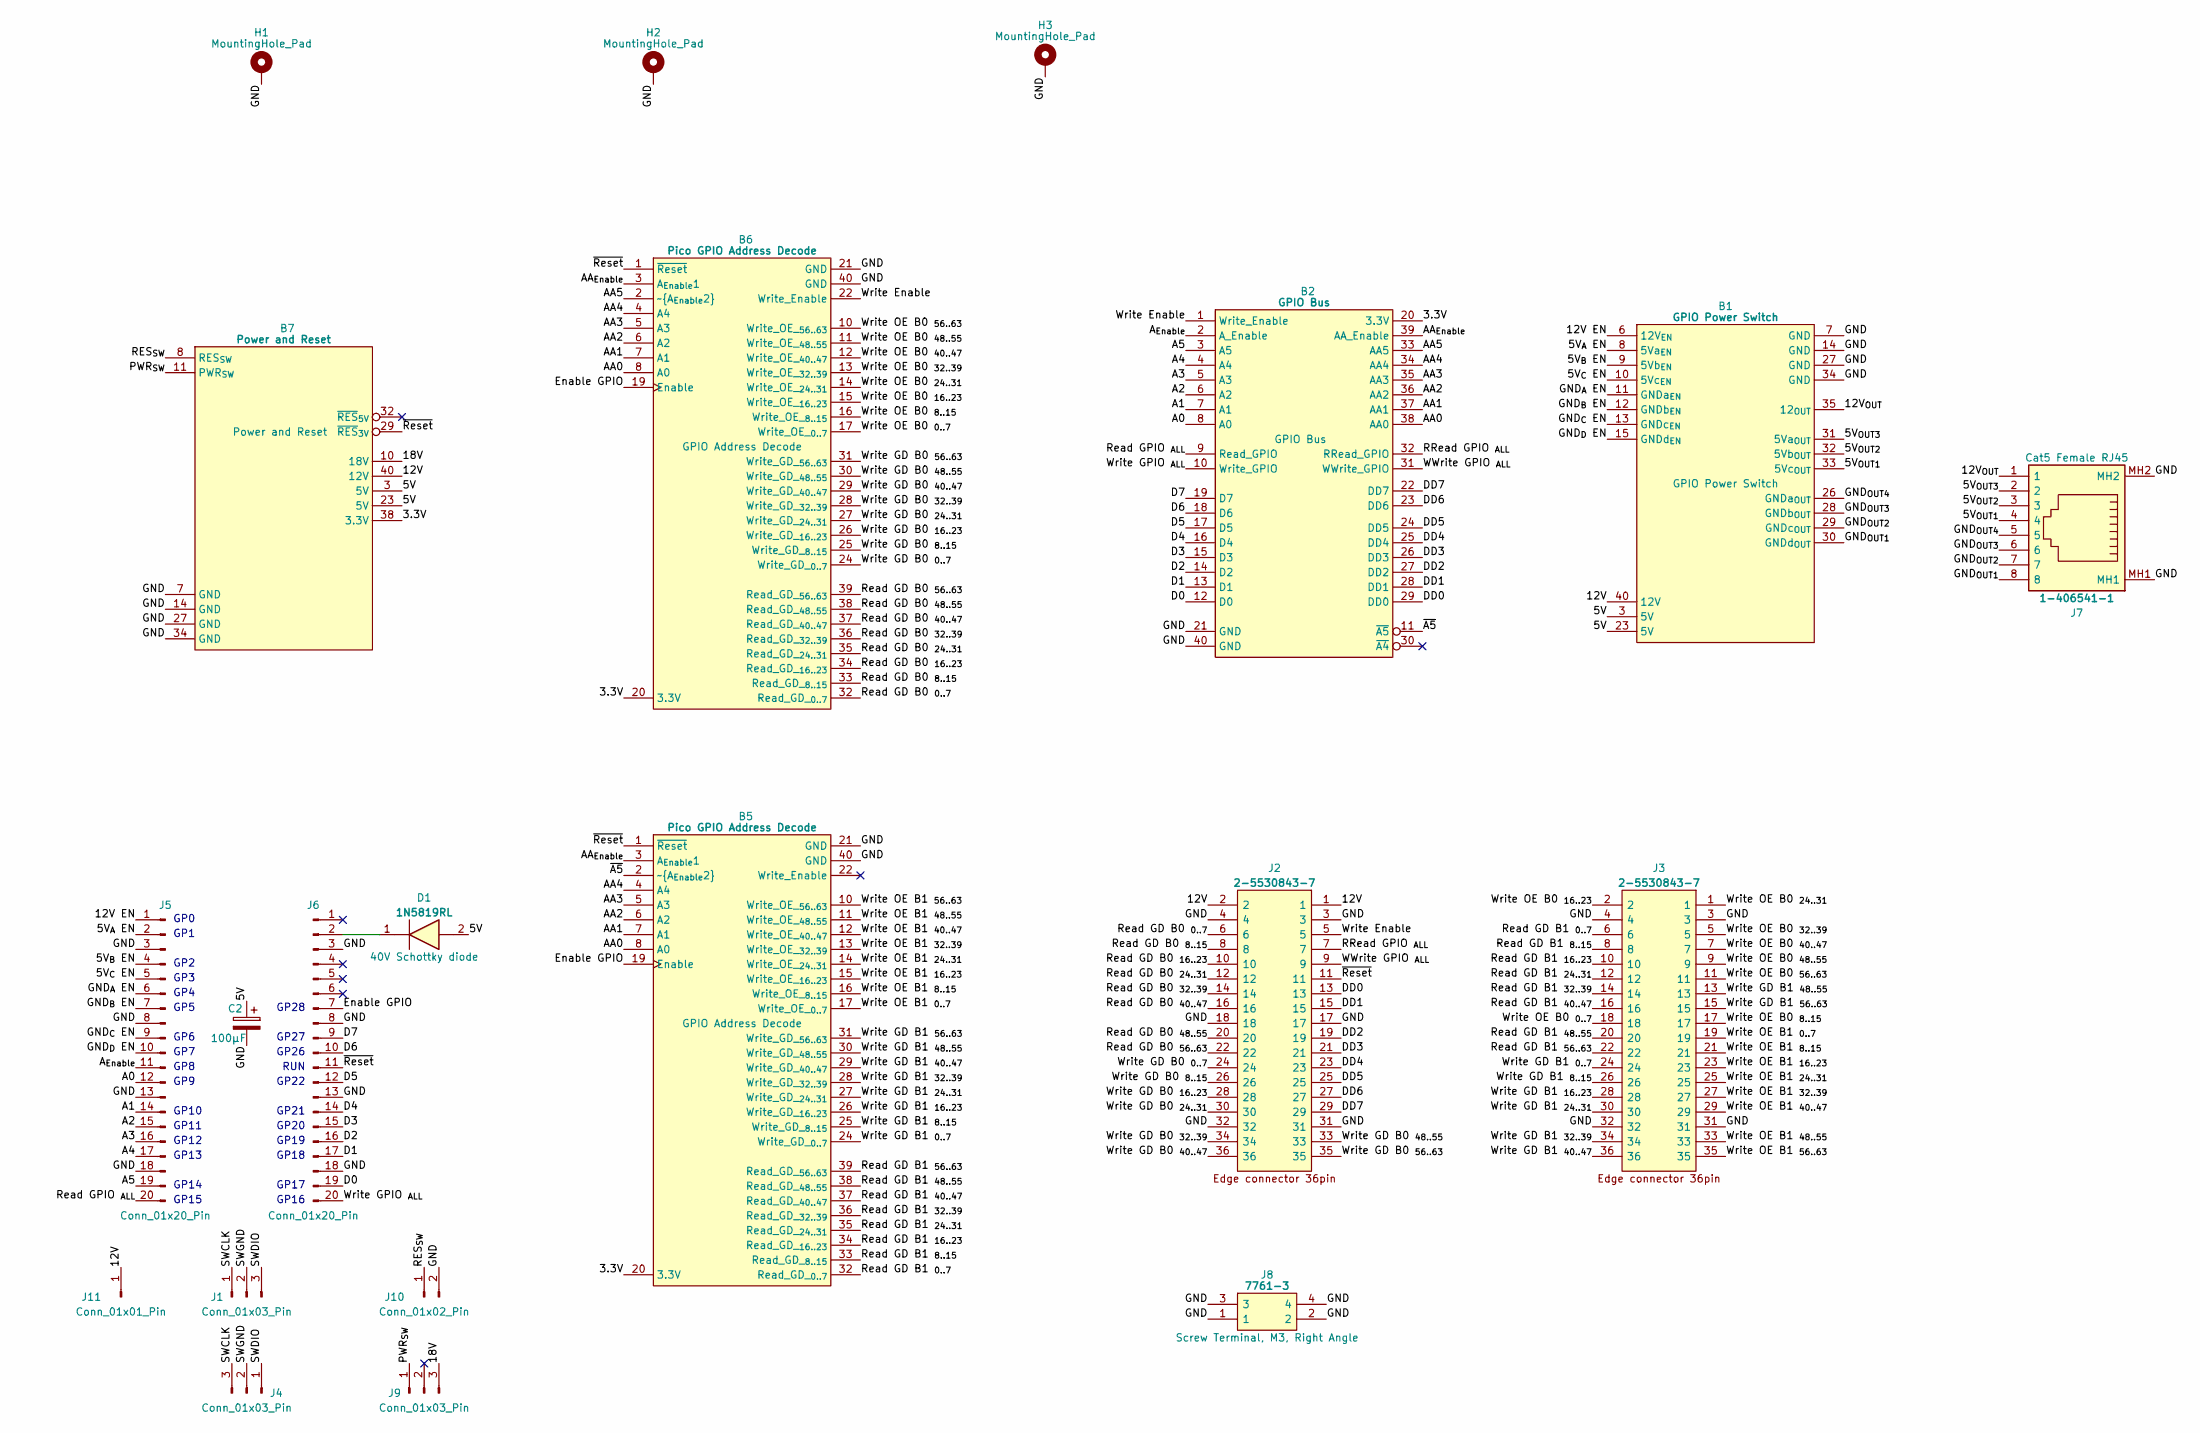
[picture p200: schematic GPIO Controller Board.kicad_sch]

Parts:
B1: GPIO Power Switch; HCP65_GPIO_Power_Switch
B2: GPIO Bus; HCP65_GPIO_Bus
B5, B6: Pico GPIO Address Decode; HCP65_GPIO_Address_Decode
B7: Power and Reset; HCP65_Power_and_Reset
C2: 100μF; CP_Radial_D6.3mm_P2.50mm
D1: 1N5819RL; DIOAD1414W86L464D238; Manufacturer_Part_Number 1N5819RL; Mouser Part Number 511-1N5819-TR
H1, H2, H3: MountingHole_Pad; MountingHole_3.2mm_M3_Pad
J1: Conn_01x03_Pin; PinSocket_1x03_P2.54mm_Vertical
J2, J3: 2-5530843-7; 36pin Edge Connector; Manufacturer_Part_Number 2-5530843-7; Mouser Part Number 571-2-5530843-7
J4: Conn_01x03_Pin; PinHeader_1x03_P2.54mm_Horizontal
J5, J6: Conn_01x20_Pin; PinSocket_1x20_P2.54mm_Vertical
J7: 1-406541-1; 1-406541-1_1; Manufacturer_Part_Number 1-406541-1; Mouser Part Number 571-1-406541-1
J8: 7761-3; 77613; Manufacturer_Part_Number 7761-3
J9: Conn_01x03_Pin; PinHeader_1x03_P2.54mm_Vertical
J10: Conn_01x02_Pin; PinHeader_1x02_P2.54mm_Vertical
J11: Conn_01x01_Pin; PinSocket_1x01_P2.54mm_Vertical

Connections:
/3.3V: B2.20 (3.3V), B5.20 (3.3V), B6.20 (3.3V), B7.38 (3.3V)
/5V: B1.3 (5V), B1.23 (5V), B7.3 (5V), B7.23 (5V), C2.1, D1.2
/5V_{A} EN: B1.8 (5Va_{EN}), J5.2
/5V_{B} EN: B1.9 (5Vb_{EN}), J5.4
/5V_{C} EN: B1.10 (5Vc_{EN}), J5.5
/5V_{OUT1}: B1.33 (5Vc_{OUT}), J7.4
/5V_{OUT2}: B1.32 (5Vb_{OUT}), J7.3
/5V_{OUT3}: B1.31 (5Va_{OUT}), J7.2
/12V: B1.40 (12V), B7.40 (12V), J2.1, J2.2, J11.1
/12V EN: B1.6 (12V_{EN}), J5.1
/12V_{OUT}: B1.35 (12_{OUT}), J7.1
/18V: B7.10 (18V), J9.3
/A0: B2.8 (A0), J5.12
/A1: B2.7 (A1), J5.14
/A2: B2.6 (A2), J5.15
/A3: B2.5 (A3), J5.16
/A4: B2.4 (A4), J5.17
/A5: B2.3 (A5), J5.19
/AA0: B2.38 (AA0), B5.8 (A0), B6.8 (A0)
/AA1: B2.37 (AA1), B5.7 (A1), B6.7 (A1)
/AA2: B2.36 (AA2), B5.6 (A2), B6.6 (A2)
/AA3: B2.35 (AA3), B5.5 (A3), B6.5 (A3)
/AA4: B2.34 (AA4), B5.4 (A4), B6.4 (A4)
/AA5: B2.33 (AA5), B6.2 (~A_{Enable2})
/AA_{Enable}: B2.39 (AA_Enable), B5.3 (A_{Enable}1), B6.3 (A_{Enable}1)
/A_{Enable}: B2.2 (A_Enable), J5.11
/D0: B2.12 (D0), J6.19
/D1: B2.13 (D1), J6.17
/D2: B2.14 (D2), J6.16
/D3: B2.15 (D3), J6.15
/D4: B2.16 (D4), J6.14
/D5: B2.17 (D5), J6.12
/D6: B2.18 (D6), J6.10
/D7: B2.19 (D7), J6.9
/DD0: B2.29 (DD0), J2.13
/DD1: B2.28 (DD1), J2.15
/DD2: B2.27 (DD2), J2.19
/DD3: B2.26 (DD3), J2.21
/DD4: B2.25 (DD4), J2.23
/DD5: B2.24 (DD5), J2.25
/DD6: B2.23 (DD6), J2.27
/DD7: B2.22 (DD7), J2.29
/Enable GPIO: B5.19 (Enable), B6.19 (Enable), J6.7
/GND: B1.7 (GND), B1.14 (GND), B1.27 (GND), B1.34 (GND), B2.21 (GND), B2.40 (GND), B5.21 (GND), B5.40 (GND), B6.21 (GND), B6.40 (GND), B7.7 (GND), B7.14 (GND), B7.27 (GND), B7.34 (GND), C2.2, H1.1, H2.1, H3.1, J2.3, J2.4, J2.17, J2.18, J2.31, J2.32, J3.3, J3.4, J3.31, J3.32, J5.3, J5.8, J5.13, J5.18, J6.3, J6.8, J6.13, J6.18, J7.MH1, J7.MH2, J8.1, J8.2, J8.3, J8.4, J10.2
/GND_{A} EN: B1.11 (GNDa_{EN}), J5.6
/GND_{B} EN: B1.12 (GNDb_{EN}), J5.7
/GND_{C} EN: B1.13 (GNDc_{EN}), J5.9
/GND_{D} EN: B1.15 (GNDd_{EN}), J5.10
/GND_{OUT1}: B1.30 (GNDd_{OUT}), J7.8
/GND_{OUT2}: B1.29 (GNDc_{OUT}), J7.7
/GND_{OUT3}: B1.28 (GNDb_{OUT}), J7.6
/GND_{OUT4}: B1.26 (GNDa_{OUT}), J7.5
/PWR_{SW}: B7.11 (PWR_{SW}), J9.1
/RES_{SW}: B7.8 (RES_{SW}), J10.1
/RRead GPIO _{ALL}: B2.32 (RRead_GPIO), J2.7
/Read GD B0 _{0..7}: B6.32 (Read_GD__{0..7}), J2.6
/Read GD B0 _{8..15}: B6.33 (Read_GD__{8..15}), J2.8
/Read GD B0 _{16..23}: B6.34 (Read_GD__{16..23}), J2.10
/Read GD B0 _{24..31}: B6.35 (Read_GD__{24..31}), J2.12
/Read GD B0 _{32..39}: B6.36 (Read_GD__{32..39}), J2.14
/Read GD B0 _{40..47}: B6.37 (Read_GD__{40..47}), J2.16
/Read GD B0 _{48..55}: B6.38 (Read_GD__{48..55}), J2.20
/Read GD B0 _{56..63}: B6.39 (Read_GD__{56..63}), J2.22
/Read GD B1 _{0..7}: B5.32 (Read_GD__{0..7}), J3.6
/Read GD B1 _{8..15}: B5.33 (Read_GD__{8..15}), J3.8
/Read GD B1 _{16..23}: B5.34 (Read_GD__{16..23}), J3.10
/Read GD B1 _{24..31}: B5.35 (Read_GD__{24..31}), J3.12
/Read GD B1 _{32..39}: B5.36 (Read_GD__{32..39}), J3.14
/Read GD B1 _{40..47}: B5.37 (Read_GD__{40..47}), J3.16
/Read GD B1 _{48..55}: B5.38 (Read_GD__{48..55}), J3.20
/Read GD B1 _{56..63}: B5.39 (Read_GD__{56..63}), J3.22
/Read GPIO _{ALL}: B2.9 (Read_GPIO), J5.20
/SWCLK: J1.1, J4.3
/SWDIO: J1.3, J4.1
/SWGND: J1.2, J4.2
/WWrite GPIO _{ALL}: B2.31 (WWrite_GPIO), J2.9
/Write Enable: B2.1 (Write_Enable), B6.22 (Write_Enable), J2.5
/Write GD B0 _{0..7}: B6.24 (Write_GD__{0..7}), J2.24
/Write GD B0 _{8..15}: B6.25 (Write_GD__{8..15}), J2.26
/Write GD B0 _{16..23}: B6.26 (Write_GD__{16..23}), J2.28
/Write GD B0 _{24..31}: B6.27 (Write_GD__{24..31}), J2.30
/Write GD B0 _{32..39}: B6.28 (Write_GD__{32..39}), J2.34
/Write GD B0 _{40..47}: B6.29 (Write_GD__{40..47}), J2.36
/Write GD B0 _{48..55}: B6.30 (Write_GD__{48..55}), J2.33
/Write GD B0 _{56..63}: B6.31 (Write_GD__{56..63}), J2.35
/Write GD B1 _{0..7}: B5.24 (Write_GD__{0..7}), J3.24
/Write GD B1 _{8..15}: B5.25 (Write_GD__{8..15}), J3.26
/Write GD B1 _{16..23}: B5.26 (Write_GD__{16..23}), J3.28
/Write GD B1 _{24..31}: B5.27 (Write_GD__{24..31}), J3.30
/Write GD B1 _{32..39}: B5.28 (Write_GD__{32..39}), J3.34
/Write GD B1 _{40..47}: B5.29 (Write_GD__{40..47}), J3.36
/Write GD B1 _{48..55}: B5.30 (Write_GD__{48..55}), J3.13
/Write GD B1 _{56..63}: B5.31 (Write_GD__{56..63}), J3.15
/Write GPIO _{ALL}: B2.10 (Write_GPIO), J6.20
/Write OE B0 _{0..7}: B6.17 (Write_OE__{0..7}), J3.18
/Write OE B0 _{8..15}: B6.16 (Write_OE__{8..15}), J3.17
/Write OE B0 _{16..23}: B6.15 (Write_OE__{16..23}), J3.2
/Write OE B0 _{24..31}: B6.14 (Write_OE__{24..31}), J3.1
/Write OE B0 _{32..39}: B6.13 (Write_OE__{32..39}), J3.5
/Write OE B0 _{40..47}: B6.12 (Write_OE__{40..47}), J3.7
/Write OE B0 _{48..55}: B6.11 (Write_OE__{48..55}), J3.9
/Write OE B0 _{56..63}: B6.10 (Write_OE__{56..63}), J3.11
/Write OE B1 _{0..7}: B5.17 (Write_OE__{0..7}), J3.19
/Write OE B1 _{8..15}: B5.16 (Write_OE__{8..15}), J3.21
/Write OE B1 _{16..23}: B5.15 (Write_OE__{16..23}), J3.23
/Write OE B1 _{24..31}: B5.14 (Write_OE__{24..31}), J3.25
/Write OE B1 _{32..39}: B5.13 (Write_OE__{32..39}), J3.27
/Write OE B1 _{40..47}: B5.12 (Write_OE__{40..47}), J3.29
/Write OE B1 _{48..55}: B5.11 (Write_OE__{48..55}), J3.33
/Write OE B1 _{56..63}: B5.10 (Write_OE__{56..63}), J3.35
/~A5: B2.11 (~A5), B5.2 (~A_{Enable2})
/~Reset: B5.1 (~Reset), B6.1 (~Reset), B7.29 (~RES_{3V}), J2.11, J6.11
unnamed: D1.1, J6.2

Notes on the sheet:
GP15
GP7
GP27
GP5
GP11
GP26
GP8
GP28
GP16
GP22
GP14
GP4
GP21
GP20
GP9
GP12
GP17
GP3
RUN
GP10
GP1
GP18
GP2
GP6
GP13
GP0
GP19

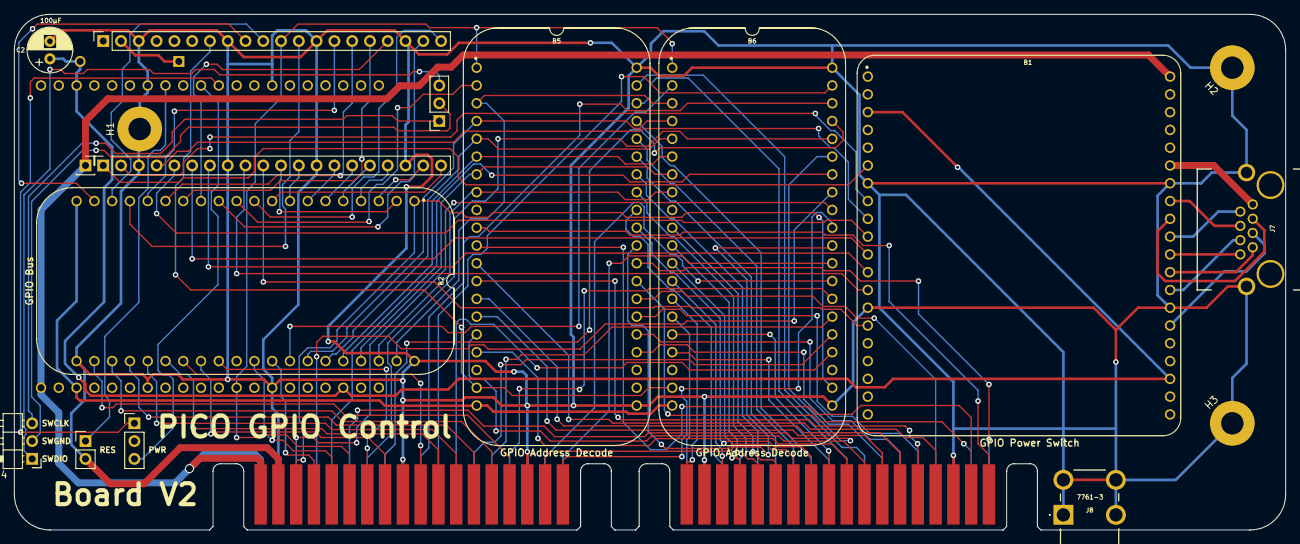
[picture p201: board GPIO Controller Board.kicad_pcb from above]

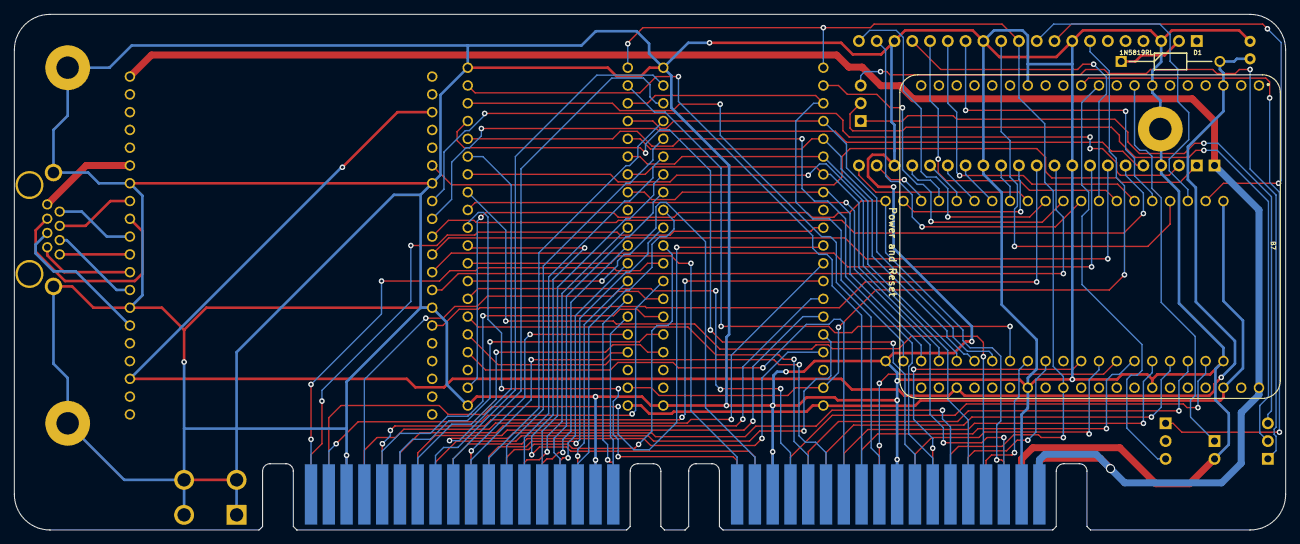
[picture p202: board GPIO Controller Board.kicad_pcb from below]

Board: 2 copper layers, 181.6 x 73.7 mm, 21 parts (2 on the bottom side), 113 nets.
