andrewpaterson/658-Computer/Kicad/Pico/HCP65 64 Pin Tester/HCP65 64 Pin Tester.kicad_pcb

## KiCad design Kicad/Pico/HCP65 64 Pin Tester/HCP65 64 Pin Tester.kicad_pcb (2026-07-19)

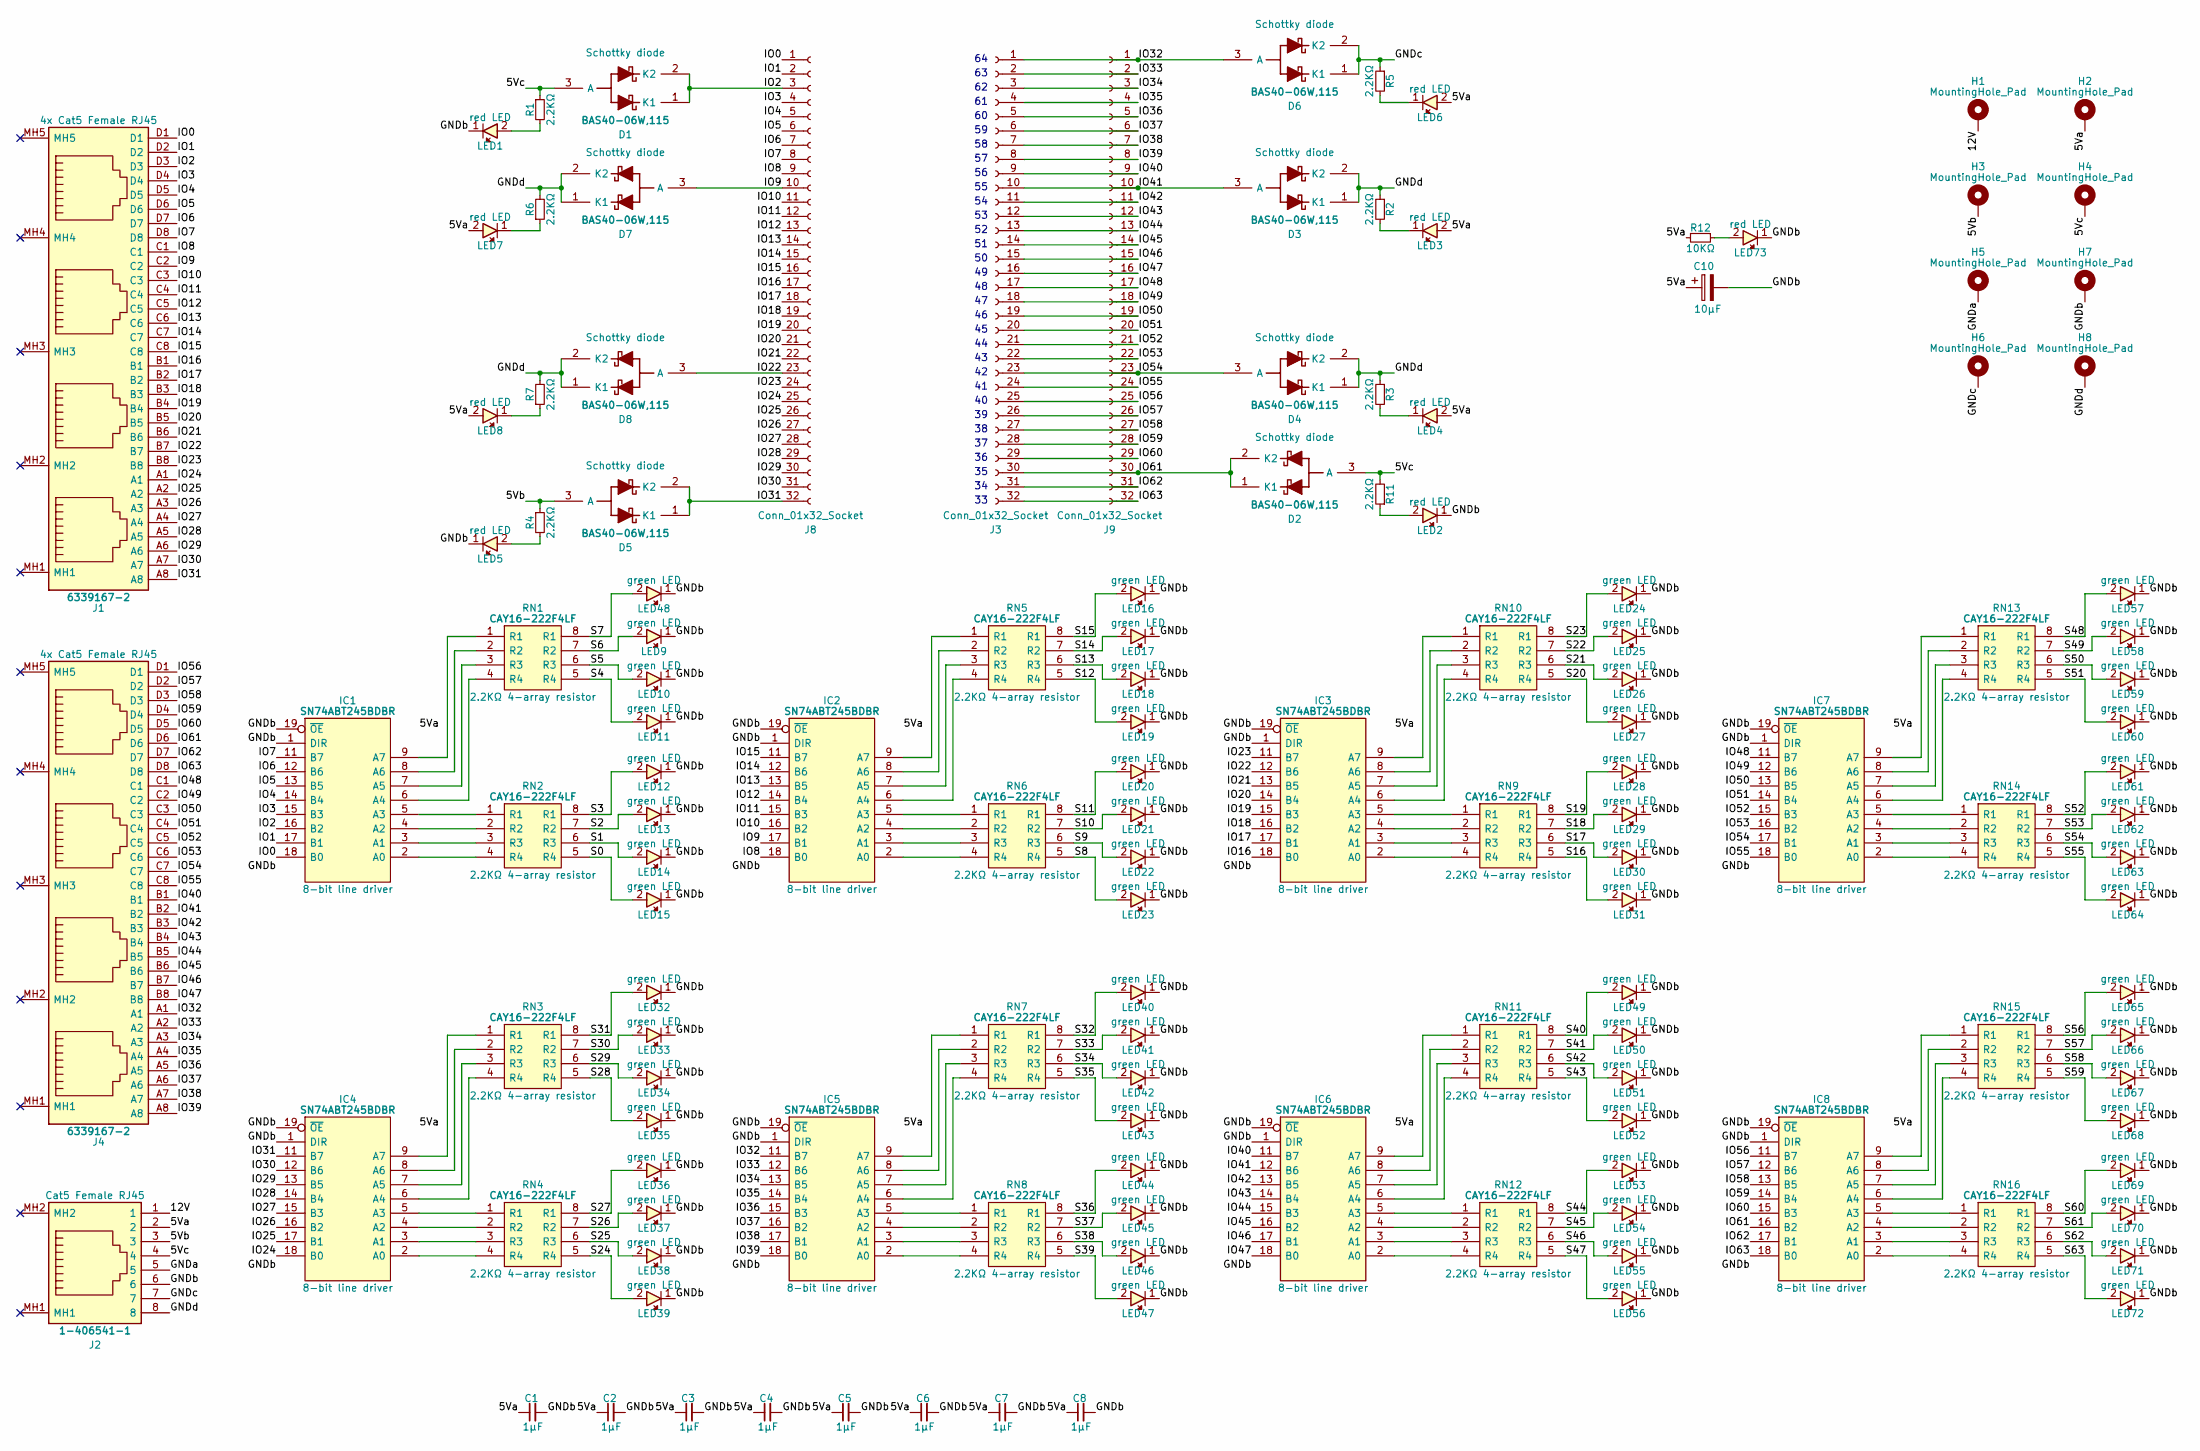
[picture p203: schematic HCP65 64 Pin Tester.kicad_sch, HCP65 64pin Component Tester]

Parts:
C1, C2, C3, C4, C5, C6, C7, C8: 1μF; C_0805
C10: 10μF; CP_Radial_D4.0mm_P2.00mm
D1, D2, D3, D4, D5, D6, D7, D8: BAS40-06W,115; SOT65P210X110-3N; Manufacturer_Part_Number BAS40-06W,115; Mouser Part Number 771-BAS40-06W115
H1, H2, H3, H4, H5, H6, H7, H8: MountingHole_Pad; MountingHole_3.2mm_M3_Pad
IC1, IC2, IC3, IC4, IC5, IC6, IC7, IC8: SN74ABT245BDBR; SOP65P780X200-20N; Manufacturer_Part_Number SN74ABT245BDBR; Mouser Part Number 595-SN74ABT245BDBR
J1, J4: 6339167-2; 63391672; Manufacturer_Part_Number 6339167-2; Mouser Part Number 571-6339167-2
J2: 1-406541-1; 1-406541-1_1; Manufacturer_Part_Number 1-406541-1; Mouser Part Number 571-1-406541-1
J3, J8, J9: Conn_01x32_Socket; PinSocket_1x32_P2.54mm_Vertical
LED1, LED2, LED3, LED4, LED5, LED6, LED7, LED8, LED73: 150224SS73100; 150224SS73100A; Manufacturer_Part_Number 150224SS73100; Mouser Part Number 710-150224SS73100
LED9, LED10, LED11, LED12, LED13, LED14, LED15, LED16, LED17, LED18, LED19, LED20, LED21, LED22, LED23, LED24, LED25, LED26, LED27, LED28, LED29, LED30, LED31, LED32, LED33, LED34, LED35, LED36, LED37, LED38, LED39, LED40, LED41, LED42, LED43, LED44, LED45, LED46, LED47, LED48, LED49, LED50, LED51, LED52, LED53, LED54, LED55, LED56, LED57, LED58, LED59, LED60, LED61, LED62, LED63, LED64, LED65, LED66, LED67, LED68, LED69, LED70, LED71, LED72: 150224VS73100A; Manufacturer_Part_Number 150224VS73100A; Mouser Part Number 710-150224VS73100A
R1, R2, R3, R4, R5, R6, R7, R11: 2.2KΩ; R_0805
R12: 10KΩ; R_0805
RN1, RN2, RN3, RN4, RN5, RN6, RN7, RN8, RN9, RN10, RN11, RN12, RN13, RN14, RN15, RN16: CAY16-222F4LF; CAY16-J4; Manufacturer_Part_Number CAY16-222F4LF; Mouser Part Number 652-CAY16-2201F4LF

Connections:
/5Va: C1.1, C2.1, C3.1, C4.1, C5.1, C6.1, C7.1, C8.1, C10.1, H2.1, IC1.20 (5V), IC2.20 (5V), IC3.20 (5V), IC4.20 (5V), IC5.20 (5V), IC6.20 (5V), IC7.20 (5V), IC8.20 (5V), J2.2, LED3.2, LED4.2, LED6.2, LED7.2, LED8.2, R12.1
/5Vb: D5.3 (A), H3.1, J2.3, R4.1
/5Vc: D1.3 (A), D2.3 (A), H4.1, J2.4, R1.1, R11.2
/12V: H1.1, J2.1
/GNDa: H5.1, J2.5
/GNDb: C1.2, C2.2, C3.2, C4.2, C5.2, C6.2, C7.2, C8.2, C10.2, H7.1, IC1.1 (DIR), IC1.10 (GND), IC1.19 (~OE), IC2.1 (DIR), IC2.10 (GND), IC2.19 (~OE), IC3.1 (DIR), IC3.10 (GND), IC3.19 (~OE), IC4.1 (DIR), IC4.10 (GND), IC4.19 (~OE), IC5.1 (DIR), IC5.10 (GND), IC5.19 (~OE), IC6.1 (DIR), IC6.10 (GND), IC6.19 (~OE), IC7.1 (DIR), IC7.10 (GND), IC7.19 (~OE), IC8.1 (DIR), IC8.10 (GND), IC8.19 (~OE), J2.6, LED1.1, LED2.1, LED5.1, LED9.1, LED10.1, LED11.1, LED12.1, LED13.1, LED14.1, LED15.1, LED16.1, LED17.1, LED18.1, LED19.1, LED20.1, LED21.1, LED22.1, LED23.1, LED24.1, LED25.1, LED26.1, LED27.1, LED28.1, LED29.1, LED30.1, LED31.1, LED32.1, LED33.1, LED34.1, LED35.1, LED36.1, LED37.1, LED38.1, LED39.1, LED40.1, LED41.1, LED42.1, LED43.1, LED44.1, LED45.1, LED46.1, LED47.1, LED48.1, LED49.1, LED50.1, LED51.1, LED52.1, LED53.1, LED54.1, LED55.1, LED56.1, LED57.1, LED58.1, LED59.1, LED60.1, LED61.1, LED62.1, LED63.1, LED64.1, LED65.1, LED66.1, LED67.1, LED68.1, LED69.1, LED70.1, LED71.1, LED72.1, LED73.1
/GNDc: D6.1 (K1), D6.2 (K2), H6.1, J2.7, R5.1
/GNDd: D3.1 (K1), D3.2 (K2), D4.1 (K1), D4.2 (K2), D7.1 (K1), D7.2 (K2), D8.1 (K1), D8.2 (K2), H8.1, J2.8, R2.1, R3.1, R6.2, R7.2
/IO0: IC1.18 (B0), J1.D1, J8.1
/IO1: IC1.17 (B1), J1.D2, J8.2
/IO2: D1.1 (K1), D1.2 (K2), IC1.16 (B2), J1.D3, J8.3
/IO3: IC1.15 (B3), J1.D4, J8.4
/IO4: IC1.14 (B4), J1.D5, J8.5
/IO5: IC1.13 (B5), J1.D6, J8.6
/IO6: IC1.12 (B6), J1.D7, J8.7
/IO7: IC1.11 (B7), J1.D8, J8.8
/IO8: IC2.18 (B0), J1.C1, J8.9
/IO9: D7.3 (A), IC2.17 (B1), J1.C2, J8.10
/IO10: IC2.16 (B2), J1.C3, J8.11
/IO11: IC2.15 (B3), J1.C4, J8.12
/IO12: IC2.14 (B4), J1.C5, J8.13
/IO13: IC2.13 (B5), J1.C6, J8.14
/IO14: IC2.12 (B6), J1.C7, J8.15
/IO15: IC2.11 (B7), J1.C8, J8.16
/IO16: IC3.18 (B0), J1.B1, J8.17
/IO17: IC3.17 (B1), J1.B2, J8.18
/IO18: IC3.16 (B2), J1.B3, J8.19
/IO19: IC3.15 (B3), J1.B4, J8.20
/IO20: IC3.14 (B4), J1.B5, J8.21
/IO21: IC3.13 (B5), J1.B6, J8.22
/IO22: D8.3 (A), IC3.12 (B6), J1.B7, J8.23
/IO23: IC3.11 (B7), J1.B8, J8.24
/IO24: IC4.18 (B0), J1.A1, J8.25
/IO25: IC4.17 (B1), J1.A2, J8.26
/IO26: IC4.16 (B2), J1.A3, J8.27
/IO27: IC4.15 (B3), J1.A4, J8.28
/IO28: IC4.14 (B4), J1.A5, J8.29
/IO29: IC4.13 (B5), J1.A6, J8.30
/IO30: IC4.12 (B6), J1.A7, J8.31
/IO31: D5.1 (K1), D5.2 (K2), IC4.11 (B7), J1.A8, J8.32
/IO32: D6.3 (A), IC5.11 (B7), J3.1, J4.A1, J9.1
/IO33: IC5.12 (B6), J3.2, J4.A2, J9.2
/IO34: IC5.13 (B5), J3.3, J4.A3, J9.3
/IO35: IC5.14 (B4), J3.4, J4.A4, J9.4
/IO36: IC5.15 (B3), J3.5, J4.A5, J9.5
/IO37: IC5.16 (B2), J3.6, J4.A6, J9.6
/IO38: IC5.17 (B1), J3.7, J4.A7, J9.7
/IO39: IC5.18 (B0), J3.8, J4.A8, J9.8
/IO40: IC6.11 (B7), J3.9, J4.B1, J9.9
/IO41: D3.3 (A), IC6.12 (B6), J3.10, J4.B2, J9.10
/IO42: IC6.13 (B5), J3.11, J4.B3, J9.11
/IO43: IC6.14 (B4), J3.12, J4.B4, J9.12
/IO44: IC6.15 (B3), J3.13, J4.B5, J9.13
/IO45: IC6.16 (B2), J3.14, J4.B6, J9.14
/IO46: IC6.17 (B1), J3.15, J4.B7, J9.15
/IO47: IC6.18 (B0), J3.16, J4.B8, J9.16
/IO48: IC7.11 (B7), J3.17, J4.C1, J9.17
/IO49: IC7.12 (B6), J3.18, J4.C2, J9.18
/IO50: IC7.13 (B5), J3.19, J4.C3, J9.19
/IO51: IC7.14 (B4), J3.20, J4.C4, J9.20
/IO52: IC7.15 (B3), J3.21, J4.C5, J9.21
/IO53: IC7.16 (B2), J3.22, J4.C6, J9.22
/IO54: D4.3 (A), IC7.17 (B1), J3.23, J4.C7, J9.23
/IO55: IC7.18 (B0), J3.24, J4.C8, J9.24
/IO56: IC8.11 (B7), J3.25, J4.D1, J9.25
/IO57: IC8.12 (B6), J3.26, J4.D2, J9.26
/IO58: IC8.13 (B5), J3.27, J4.D3, J9.27
/IO59: IC8.14 (B4), J3.28, J4.D4, J9.28
/IO60: IC8.15 (B3), J3.29, J4.D5, J9.29
/IO61: D2.1 (K1), D2.2 (K2), IC8.16 (B2), J3.30, J4.D6, J9.30
/IO62: IC8.17 (B1), J3.31, J4.D7, J9.31
/IO63: IC8.18 (B0), J3.32, J4.D8, J9.32
/S0: LED15.2, RN2.5 (R4)
/S1: LED14.2, RN2.6 (R3)
/S2: LED13.2, RN2.7 (R2)
/S3: LED12.2, RN2.8 (R1)
/S4: LED11.2, RN1.5 (R4)
/S5: LED10.2, RN1.6 (R3)
/S6: LED9.2, RN1.7 (R2)
/S7: LED48.2, RN1.8 (R1)
/S8: LED23.2, RN6.5 (R4)
/S9: LED22.2, RN6.6 (R3)
/S10: LED21.2, RN6.7 (R2)
/S11: LED20.2, RN6.8 (R1)
/S12: LED19.2, RN5.5 (R4)
/S13: LED18.2, RN5.6 (R3)
/S14: LED17.2, RN5.7 (R2)
/S15: LED16.2, RN5.8 (R1)
/S16: LED31.2, RN9.5 (R4)
/S17: LED30.2, RN9.6 (R3)
/S18: LED29.2, RN9.7 (R2)
/S19: LED28.2, RN9.8 (R1)
/S20: LED27.2, RN10.5 (R4)
/S21: LED26.2, RN10.6 (R3)
/S22: LED25.2, RN10.7 (R2)
/S23: LED24.2, RN10.8 (R1)
/S24: LED39.2, RN4.5 (R4)
/S25: LED38.2, RN4.6 (R3)
/S26: LED37.2, RN4.7 (R2)
/S27: LED36.2, RN4.8 (R1)
/S28: LED35.2, RN3.5 (R4)
/S29: LED34.2, RN3.6 (R3)
/S30: LED33.2, RN3.7 (R2)
/S31: LED32.2, RN3.8 (R1)
/S32: LED40.2, RN7.8 (R1)
/S33: LED41.2, RN7.7 (R2)
/S34: LED42.2, RN7.6 (R3)
/S35: LED43.2, RN7.5 (R4)
/S36: LED44.2, RN8.8 (R1)
/S37: LED45.2, RN8.7 (R2)
/S38: LED46.2, RN8.6 (R3)
/S39: LED47.2, RN8.5 (R4)
/S40: LED49.2, RN11.8 (R1)
/S41: LED50.2, RN11.7 (R2)
/S42: LED51.2, RN11.6 (R3)
/S43: LED52.2, RN11.5 (R4)
/S44: LED53.2, RN12.8 (R1)
/S45: LED54.2, RN12.7 (R2)
/S46: LED55.2, RN12.6 (R3)
/S47: LED56.2, RN12.5 (R4)
/S48: LED57.2, RN13.8 (R1)
/S49: LED58.2, RN13.7 (R2)
/S50: LED59.2, RN13.6 (R3)
/S51: LED60.2, RN13.5 (R4)
/S52: LED61.2, RN14.8 (R1)
/S53: LED62.2, RN14.7 (R2)
/S54: LED63.2, RN14.6 (R3)
/S55: LED64.2, RN14.5 (R4)
/S56: LED65.2, RN15.8 (R1)
/S57: LED66.2, RN15.7 (R2)
/S58: LED67.2, RN15.6 (R3)
/S59: LED68.2, RN15.5 (R4)
/S60: LED69.2, RN16.8 (R1)
/S61: LED70.2, RN16.7 (R2)
/S62: LED71.2, RN16.6 (R3)
/S63: LED72.2, RN16.5 (R4)
unnamed: IC1.2 (A0), RN2.4 (R4)
unnamed: IC1.3 (A1), RN2.3 (R3)
unnamed: IC1.4 (A2), RN2.2 (R2)
unnamed: IC1.5 (A3), RN2.1 (R1)
unnamed: IC1.6 (A4), RN1.4 (R4)
unnamed: IC1.7 (A5), RN1.3 (R3)
unnamed: IC1.8 (A6), RN1.2 (R2)
unnamed: IC1.9 (A7), RN1.1 (R1)
unnamed: IC2.2 (A0), RN6.4 (R4)
unnamed: IC2.3 (A1), RN6.3 (R3)
unnamed: IC2.4 (A2), RN6.2 (R2)
unnamed: IC2.5 (A3), RN6.1 (R1)
unnamed: IC2.6 (A4), RN5.4 (R4)
unnamed: IC2.7 (A5), RN5.3 (R3)
unnamed: IC2.8 (A6), RN5.2 (R2)
unnamed: IC2.9 (A7), RN5.1 (R1)
unnamed: IC3.2 (A0), RN9.4 (R4)
unnamed: IC3.3 (A1), RN9.3 (R3)
unnamed: IC3.4 (A2), RN9.2 (R2)
unnamed: IC3.5 (A3), RN9.1 (R1)
unnamed: IC3.6 (A4), RN10.4 (R4)
unnamed: IC3.7 (A5), RN10.3 (R3)
unnamed: IC3.8 (A6), RN10.2 (R2)
unnamed: IC3.9 (A7), RN10.1 (R1)
unnamed: IC4.2 (A0), RN4.4 (R4)
unnamed: IC4.3 (A1), RN4.3 (R3)
unnamed: IC4.4 (A2), RN4.2 (R2)
unnamed: IC4.5 (A3), RN4.1 (R1)
unnamed: IC4.6 (A4), RN3.4 (R4)
unnamed: IC4.7 (A5), RN3.3 (R3)
unnamed: IC4.8 (A6), RN3.2 (R2)
unnamed: IC4.9 (A7), RN3.1 (R1)
unnamed: IC5.2 (A0), RN8.4 (R4)
unnamed: IC5.3 (A1), RN8.3 (R3)
unnamed: IC5.4 (A2), RN8.2 (R2)
unnamed: IC5.5 (A3), RN8.1 (R1)
unnamed: IC5.6 (A4), RN7.4 (R4)
unnamed: IC5.7 (A5), RN7.3 (R3)
unnamed: IC5.8 (A6), RN7.2 (R2)
unnamed: IC5.9 (A7), RN7.1 (R1)
unnamed: IC6.2 (A0), RN12.4 (R4)
unnamed: IC6.3 (A1), RN12.3 (R3)
unnamed: IC6.4 (A2), RN12.2 (R2)
unnamed: IC6.5 (A3), RN12.1 (R1)
unnamed: IC6.6 (A4), RN11.4 (R4)
unnamed: IC6.7 (A5), RN11.3 (R3)
unnamed: IC6.8 (A6), RN11.2 (R2)
unnamed: IC6.9 (A7), RN11.1 (R1)
unnamed: IC7.2 (A0), RN14.4 (R4)
unnamed: IC7.3 (A1), RN14.3 (R3)
unnamed: IC7.4 (A2), RN14.2 (R2)
unnamed: IC7.5 (A3), RN14.1 (R1)
unnamed: IC7.6 (A4), RN13.4 (R4)
unnamed: IC7.7 (A5), RN13.3 (R3)
unnamed: IC7.8 (A6), RN13.2 (R2)
unnamed: IC7.9 (A7), RN13.1 (R1)
unnamed: IC8.2 (A0), RN16.4 (R4)
unnamed: IC8.3 (A1), RN16.3 (R3)
unnamed: IC8.4 (A2), RN16.2 (R2)
unnamed: IC8.5 (A3), RN16.1 (R1)
unnamed: IC8.6 (A4), RN15.4 (R4)
unnamed: IC8.7 (A5), RN15.3 (R3)
unnamed: IC8.8 (A6), RN15.2 (R2)
unnamed: IC8.9 (A7), RN15.1 (R1)
unnamed: LED1.2, R1.2
unnamed: LED2.2, R11.1
unnamed: LED3.1, R2.2
unnamed: LED4.1, R3.2
unnamed: LED5.2, R4.2
unnamed: LED6.1, R5.2
unnamed: LED7.1, R6.1
unnamed: LED8.1, R7.1
unnamed: LED73.2, R12.2

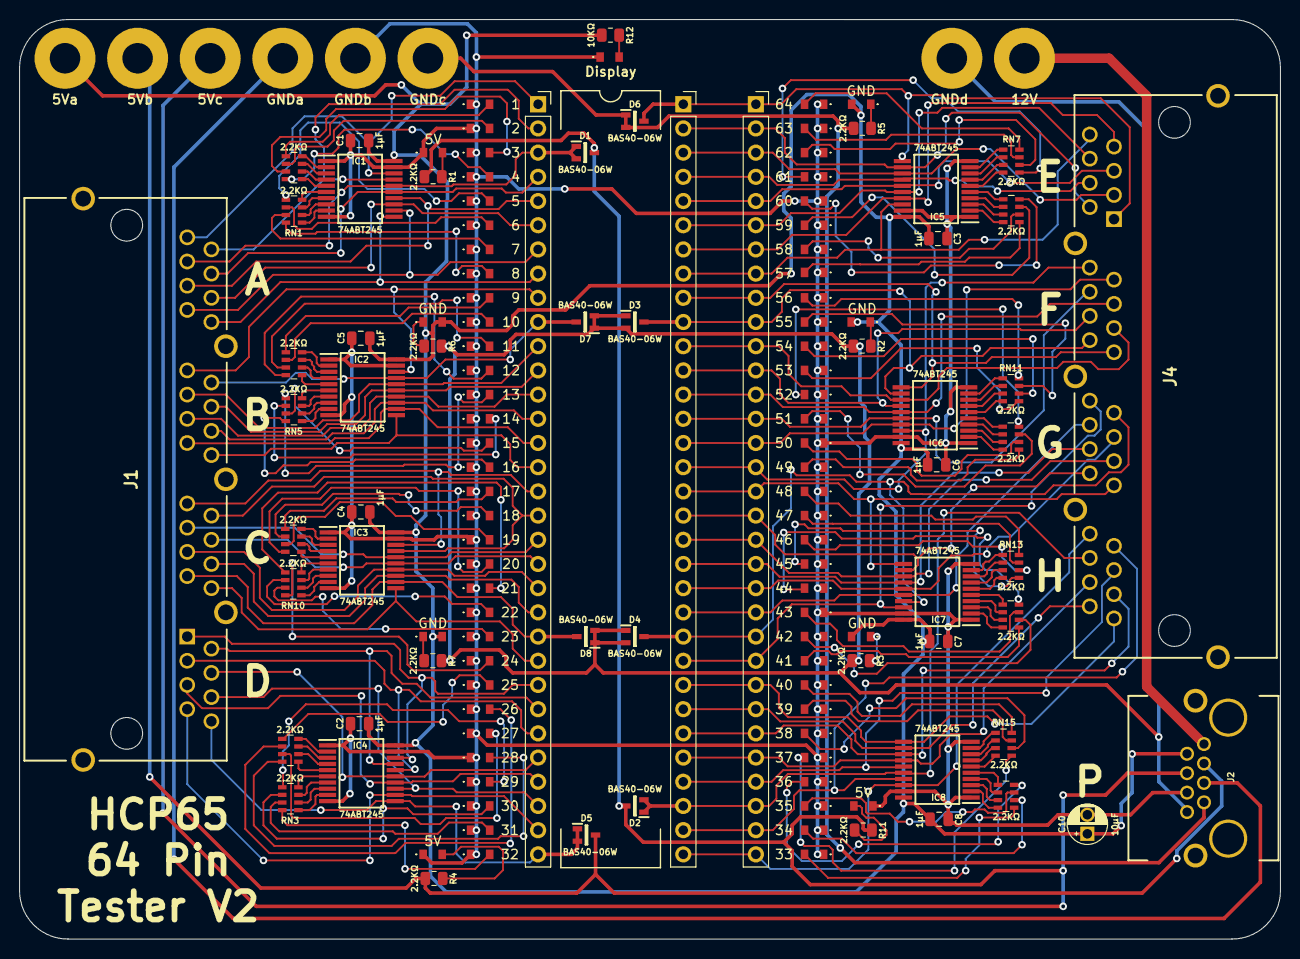
[picture p204: board HCP65 64 Pin Tester.kicad_pcb from above]

Board: 2 copper layers, 132.4 x 96.5 mm, 137 parts (0 on the bottom side), 209 nets.
