andrewpaterson/658-Computer/Kicad/Pico/GPIO Bus/GPIO Bus.kicad_pcb

## KiCad design Kicad/Pico/GPIO Bus/GPIO Bus.kicad_pcb (2026-07-19)

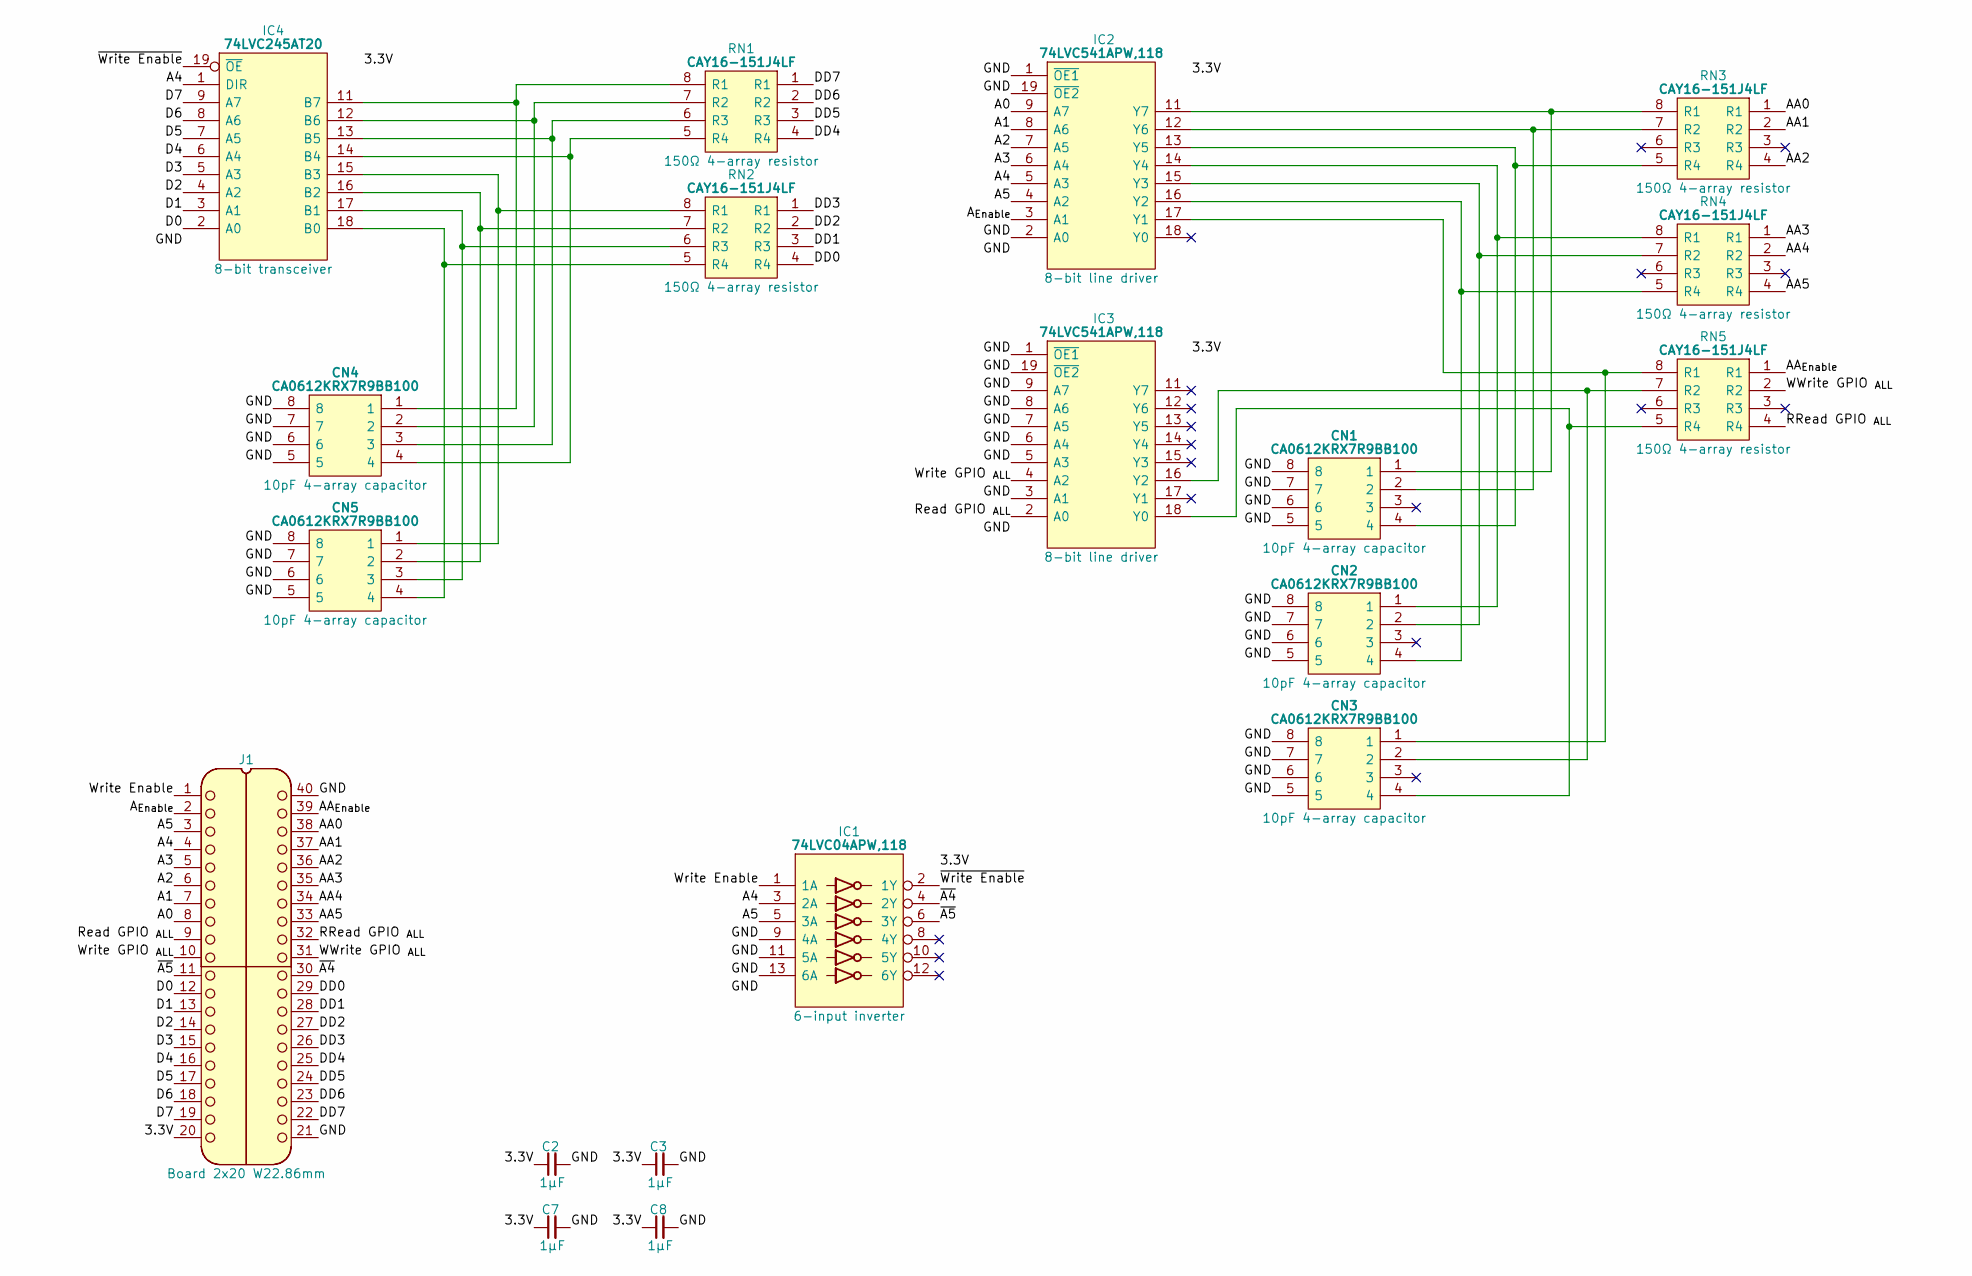
[picture p205: schematic GPIO Bus.kicad_sch]

Parts:
C2, C3, C7, C8: 1μF; C_0805
CN1, CN2, CN3, CN4, CN5: CA0612KRX7R9BB100; Manufacturer_Part_Number CA0612KRX7R9BB102; Mouser Part Number 603-CA612KRX7R9BB102
IC1: 74LVC04APW,118; SOP65P640X110-14N; Manufacturer_Part_Number 74LVC04APW,118; Mouser Part Number 771-74LVC04APW-T
IC2, IC3: 74LVC541APW,118; SOP65P640X110-20N; Mouser Part Number 771-74LVC541APW-T
IC4: 74LVC245AT20; SOP65P640X120-20N; Manufacturer_Part_Number 74LVC245AT20-13; Mouser Part Number 621-74LVC245AT20-13
J1: Board 2x20 W22.86mm; DIP-40_Board_W22.86mm
RN1, RN2, RN3, RN4, RN5: CAY16-151J4LF; CAY16-J4; Manufacturer_Part_Number CAY16-151J4LF; Mouser Part Number 652-CAY16-151J4LF

Connections:
/3.3V: C2.1, C3.1, C7.1, C8.1, IC1.14 (3V), IC2.20 (3V), IC3.20 (3V), IC4.20 (3V), J1.20
/A0: IC2.9 (A7), J1.8
/A1: IC2.8 (A6), J1.7
/A2: IC2.7 (A5), J1.6
/A3: IC2.6 (A4), J1.5
/A4: IC1.3 (2A), IC2.5 (A3), IC4.1 (DIR), J1.4
/A5: IC1.5 (3A), IC2.4 (A2), J1.3
/AA0: J1.38, RN3.1 (R1)
/AA1: J1.37, RN3.2 (R2)
/AA2: J1.36, RN3.4 (R4)
/AA3: J1.35, RN4.1 (R1)
/AA4: J1.34, RN4.2 (R2)
/AA5: J1.33, RN4.4 (R4)
/AA_{Enable}: J1.39, RN5.1 (R1)
/A_{Enable}: IC2.3 (A1), J1.2
/D0: IC4.2 (A0), J1.12
/D1: IC4.3 (A1), J1.13
/D2: IC4.4 (A2), J1.14
/D3: IC4.5 (A3), J1.15
/D4: IC4.6 (A4), J1.16
/D5: IC4.7 (A5), J1.17
/D6: IC4.8 (A6), J1.18
/D7: IC4.9 (A7), J1.19
/DD0: J1.29, RN2.4 (R4)
/DD1: J1.28, RN2.3 (R3)
/DD2: J1.27, RN2.2 (R2)
/DD3: J1.26, RN2.1 (R1)
/DD4: J1.25, RN1.4 (R4)
/DD5: J1.24, RN1.3 (R3)
/DD6: J1.23, RN1.2 (R2)
/DD7: J1.22, RN1.1 (R1)
/GND: C2.2, C3.2, C7.2, C8.2, CN1.5, CN1.6, CN1.7, CN1.8, CN2.5, CN2.6, CN2.7, CN2.8, CN3.5, CN3.6, CN3.7, CN3.8, CN4.5, CN4.6, CN4.7, CN4.8, CN5.5, CN5.6, CN5.7, CN5.8, IC1.7 (GND), IC1.9 (4A), IC1.11 (5A), IC1.13 (6A), IC2.1 (~OE1), IC2.2 (A0), IC2.10 (GND), IC2.19 (~OE2), IC3.1 (~OE1), IC3.3 (A1), IC3.5 (A3), IC3.6 (A4), IC3.7 (A5), IC3.8 (A6), IC3.9 (A7), IC3.10 (GND), IC3.19 (~OE2), IC4.10 (GND), J1.21, J1.40
/RRead GPIO _{ALL}: J1.32, RN5.4 (R4)
/Read GPIO _{ALL}: IC3.2 (A0), J1.9
/WWrite GPIO _{ALL}: J1.31, RN5.2 (R2)
/Write Enable: IC1.1 (1A), J1.1
/Write GPIO _{ALL}: IC3.4 (A2), J1.10
/~A4: IC1.4 (2Y), J1.30
/~A5: IC1.6 (3Y), J1.11
/~Write Enable: IC1.2 (1Y), IC4.19 (~OE)
unnamed: CN3.1, IC2.17 (Y1), RN5.8 (R1)
unnamed: CN2.4, IC2.16 (Y2), RN4.5 (R4)
unnamed: CN2.2, IC2.15 (Y3), RN4.7 (R2)
unnamed: CN2.1, IC2.14 (Y4), RN4.8 (R1)
unnamed: CN1.4, IC2.13 (Y5), RN3.5 (R4)
unnamed: CN1.2, IC2.12 (Y6), RN3.7 (R2)
unnamed: CN1.1, IC2.11 (Y7), RN3.8 (R1)
unnamed: CN3.4, IC3.18 (Y0), RN5.5 (R4)
unnamed: CN3.2, IC3.16 (Y2), RN5.7 (R2)
unnamed: CN5.4, IC4.18 (B0), RN2.5 (R4)
unnamed: CN5.3, IC4.17 (B1), RN2.6 (R3)
unnamed: CN5.2, IC4.16 (B2), RN2.7 (R2)
unnamed: CN5.1, IC4.15 (B3), RN2.8 (R1)
unnamed: CN4.4, IC4.14 (B4), RN1.5 (R4)
unnamed: CN4.3, IC4.13 (B5), RN1.6 (R3)
unnamed: CN4.2, IC4.12 (B6), RN1.7 (R2)
unnamed: CN4.1, IC4.11 (B7), RN1.8 (R1)

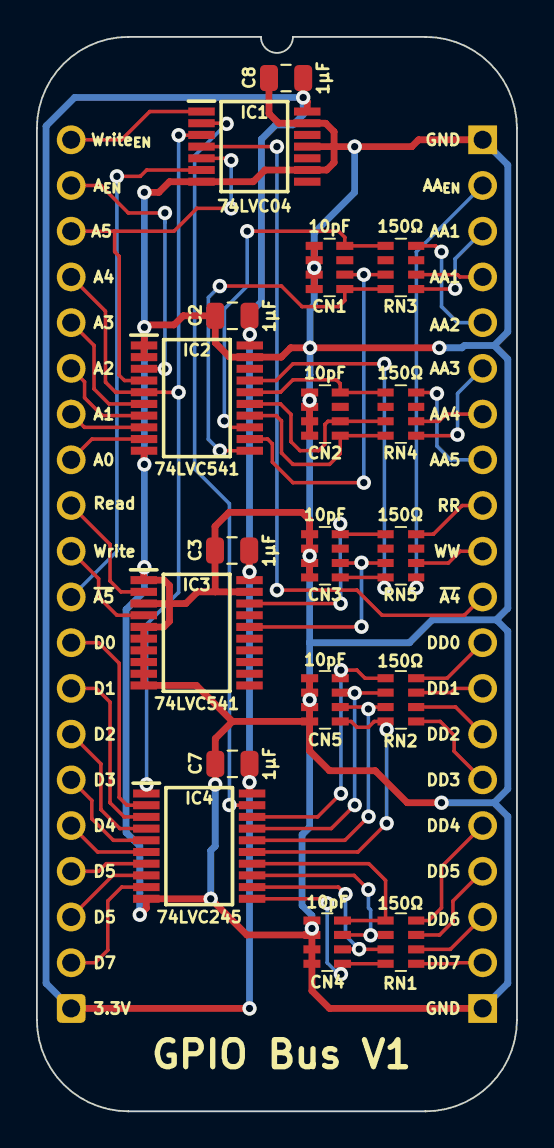
[picture p206: board GPIO Bus.kicad_pcb from above]

Board: 2 copper layers, 26.7 x 59.7 mm, 19 parts (0 on the bottom side), 57 nets.
