andrewpaterson/658-Computer/Kicad/Pico/GPIO 32bit Board/GPIO 32bit Board.kicad_pcb

## KiCad design Kicad/Pico/GPIO 32bit Board/GPIO 32bit Board.kicad_pcb (2026-07-12)

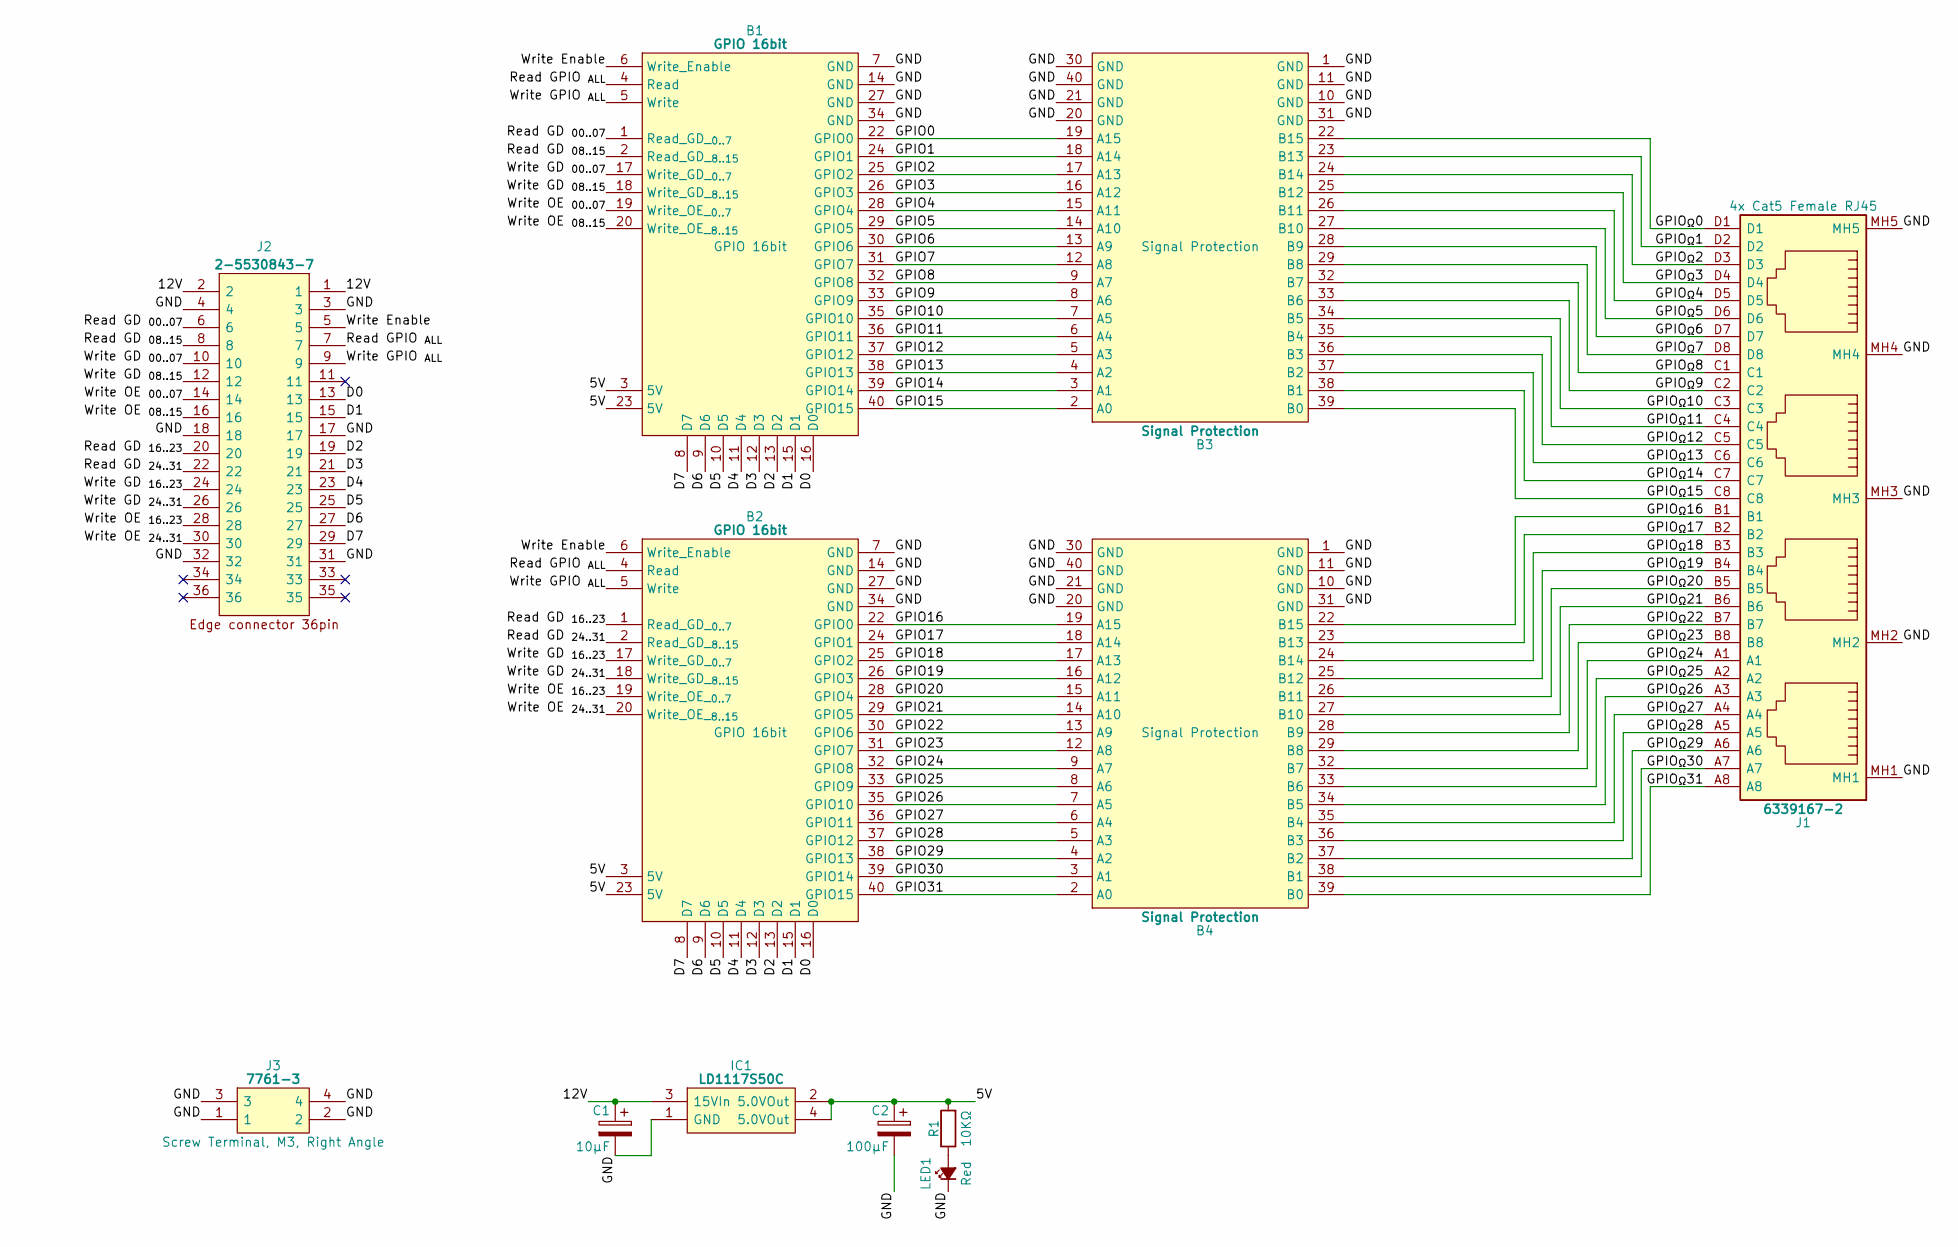
[picture p207: schematic GPIO 32bit Board.kicad_sch]

Parts:
B1, B2: GPIO 16bit; HCP65_GPIO_16bit
B3, B4: Signal Protection; HCP65_Signal_Protection
C1: 10μF; CP_Radial_D4.0mm_P2.00mm
C2: 100μF; CP_Radial_D4.0mm_P2.00mm
IC1: LD1117S50C; LD1117S33C; Manufacturer_Part_Number LD1117S50C
J1: 6339167-2; 63391672; Manufacturer_Part_Number 6339167-2; Mouser Part Number 571-6339167-2
J2: 2-5530843-7; 36pin Edge Connector; Manufacturer_Part_Number 2-5530843-7; Mouser Part Number 571-2-5530843-7
J3: 7761-3; 77613; Manufacturer_Part_Number 7761-3
LED1: Red; LED_D5.0mm
R1: 10KΩ; R_Axial_DIN0204_L3.6mm_D1.6mm_P5.08mm_Horizontal

Connections:
/5V: B1.3 (5V), B1.23 (5V), B2.3 (5V), B2.23 (5V), C2.1, IC1.2 (5.0VOut), IC1.4 (5.0VOut), R1.2
/12V: C1.1, IC1.3 (15VIn), J2.1, J2.2
/D0: B1.16 (D0), B2.16 (D0), J2.13
/D1: B1.15 (D1), B2.15 (D1), J2.15
/D2: B1.13 (D2), B2.13 (D2), J2.19
/D3: B1.12 (D3), B2.12 (D3), J2.21
/D4: B1.11 (D4), B2.11 (D4), J2.23
/D5: B1.10 (D5), B2.10 (D5), J2.25
/D6: B1.9 (D6), B2.9 (D6), J2.27
/D7: B1.8 (D7), B2.8 (D7), J2.29
/GND: B1.7 (GND), B1.14 (GND), B1.27 (GND), B1.34 (GND), B2.7 (GND), B2.14 (GND), B2.27 (GND), B2.34 (GND), B3.1 (GND), B3.10 (GND), B3.11 (GND), B3.20 (GND), B3.21 (GND), B3.30 (GND), B3.31 (GND), B3.40 (GND), B4.1 (GND), B4.10 (GND), B4.11 (GND), B4.20 (GND), B4.21 (GND), B4.30 (GND), B4.31 (GND), B4.40 (GND), C1.2, C2.2, IC1.1 (GND), J1.MH1, J1.MH2, J1.MH3, J1.MH4, J1.MH5, J2.3, J2.4, J2.17, J2.18, J2.31, J2.32, J3.1, J3.2, J3.3, J3.4, LED1.1 (K)
/GPIO0: B1.22 (GPIO0), B3.19 (A15)
/GPIO1: B1.24 (GPIO1), B3.18 (A14)
/GPIO2: B1.25 (GPIO2), B3.17 (A13)
/GPIO3: B1.26 (GPIO3), B3.16 (A12)
/GPIO4: B1.28 (GPIO4), B3.15 (A11)
/GPIO5: B1.29 (GPIO5), B3.14 (A10)
/GPIO6: B1.30 (GPIO6), B3.13 (A9)
/GPIO7: B1.31 (GPIO7), B3.12 (A8)
/GPIO8: B1.32 (GPIO8), B3.9 (A7)
/GPIO9: B1.33 (GPIO9), B3.8 (A6)
/GPIO10: B1.35 (GPIO10), B3.7 (A5)
/GPIO11: B1.36 (GPIO11), B3.6 (A4)
/GPIO12: B1.37 (GPIO12), B3.5 (A3)
/GPIO13: B1.38 (GPIO13), B3.4 (A2)
/GPIO14: B1.39 (GPIO14), B3.3 (A1)
/GPIO15: B1.40 (GPIO15), B3.2 (A0)
/GPIO16: B2.22 (GPIO0), B4.19 (A15)
/GPIO17: B2.24 (GPIO1), B4.18 (A14)
/GPIO18: B2.25 (GPIO2), B4.17 (A13)
/GPIO19: B2.26 (GPIO3), B4.16 (A12)
/GPIO20: B2.28 (GPIO4), B4.15 (A11)
/GPIO21: B2.29 (GPIO5), B4.14 (A10)
/GPIO22: B2.30 (GPIO6), B4.13 (A9)
/GPIO23: B2.31 (GPIO7), B4.12 (A8)
/GPIO24: B2.32 (GPIO8), B4.9 (A7)
/GPIO25: B2.33 (GPIO9), B4.8 (A6)
/GPIO26: B2.35 (GPIO10), B4.7 (A5)
/GPIO27: B2.36 (GPIO11), B4.6 (A4)
/GPIO28: B2.37 (GPIO12), B4.5 (A3)
/GPIO29: B2.38 (GPIO13), B4.4 (A2)
/GPIO30: B2.39 (GPIO14), B4.3 (A1)
/GPIO31: B2.40 (GPIO15), B4.2 (A0)
/GPIO_{Ω}0: B3.22 (B15), J1.D1
/GPIO_{Ω}1: B3.23 (B13), J1.D2
/GPIO_{Ω}2: B3.24 (B14), J1.D3
/GPIO_{Ω}3: B3.25 (B12), J1.D4
/GPIO_{Ω}4: B3.26 (B11), J1.D5
/GPIO_{Ω}5: B3.27 (B10), J1.D6
/GPIO_{Ω}6: B3.28 (B9), J1.D7
/GPIO_{Ω}7: B3.29 (B8), J1.D8
/GPIO_{Ω}8: B3.32 (B7), J1.C1
/GPIO_{Ω}9: B3.33 (B6), J1.C2
/GPIO_{Ω}10: B3.34 (B5), J1.C3
/GPIO_{Ω}11: B3.35 (B4), J1.C4
/GPIO_{Ω}12: B3.36 (B3), J1.C5
/GPIO_{Ω}13: B3.37 (B2), J1.C6
/GPIO_{Ω}14: B3.38 (B1), J1.C7
/GPIO_{Ω}15: B3.39 (B0), J1.C8
/GPIO_{Ω}16: B4.22 (B15), J1.B1
/GPIO_{Ω}17: B4.23 (B13), J1.B2
/GPIO_{Ω}18: B4.24 (B14), J1.B3
/GPIO_{Ω}19: B4.25 (B12), J1.B4
/GPIO_{Ω}20: B4.26 (B11), J1.B5
/GPIO_{Ω}21: B4.27 (B10), J1.B6
/GPIO_{Ω}22: B4.28 (B9), J1.B7
/GPIO_{Ω}23: B4.29 (B8), J1.B8
/GPIO_{Ω}24: B4.32 (B7), J1.A1
/GPIO_{Ω}25: B4.33 (B6), J1.A2
/GPIO_{Ω}26: B4.34 (B5), J1.A3
/GPIO_{Ω}27: B4.35 (B4), J1.A4
/GPIO_{Ω}28: B4.36 (B3), J1.A5
/GPIO_{Ω}29: B4.37 (B2), J1.A6
/GPIO_{Ω}30: B4.38 (B1), J1.A7
/GPIO_{Ω}31: B4.39 (B0), J1.A8
/Read GD _{00..07}: B1.1 (Read_GD__{0..7}), J2.6
/Read GD _{08..15}: B1.2 (Read_GD__{8..15}), J2.8
/Read GD _{16..23}: B2.1 (Read_GD__{0..7}), J2.20
/Read GD _{24..31}: B2.2 (Read_GD__{8..15}), J2.22
/Read GPIO _{ALL}: B1.4 (Read), B2.4 (Read), J2.7
/Write Enable: B1.6 (Write_Enable), B2.6 (Write_Enable), J2.5
/Write GD _{00..07}: B1.17 (Write_GD__{0..7}), J2.10
/Write GD _{08..15}: B1.18 (Write_GD__{8..15}), J2.12
/Write GD _{16..23}: B2.17 (Write_GD__{0..7}), J2.24
/Write GD _{24..31}: B2.18 (Write_GD__{8..15}), J2.26
/Write GPIO _{ALL}: B1.5 (Write), B2.5 (Write), J2.9
/Write OE _{00..07}: B1.19 (Write_OE__{0..7}), J2.14
/Write OE _{08..15}: B1.20 (Write_OE__{8..15}), J2.16
/Write OE _{16..23}: B2.19 (Write_OE__{0..7}), J2.28
/Write OE _{24..31}: B2.20 (Write_OE__{8..15}), J2.30
unnamed: LED1.2 (A), R1.1

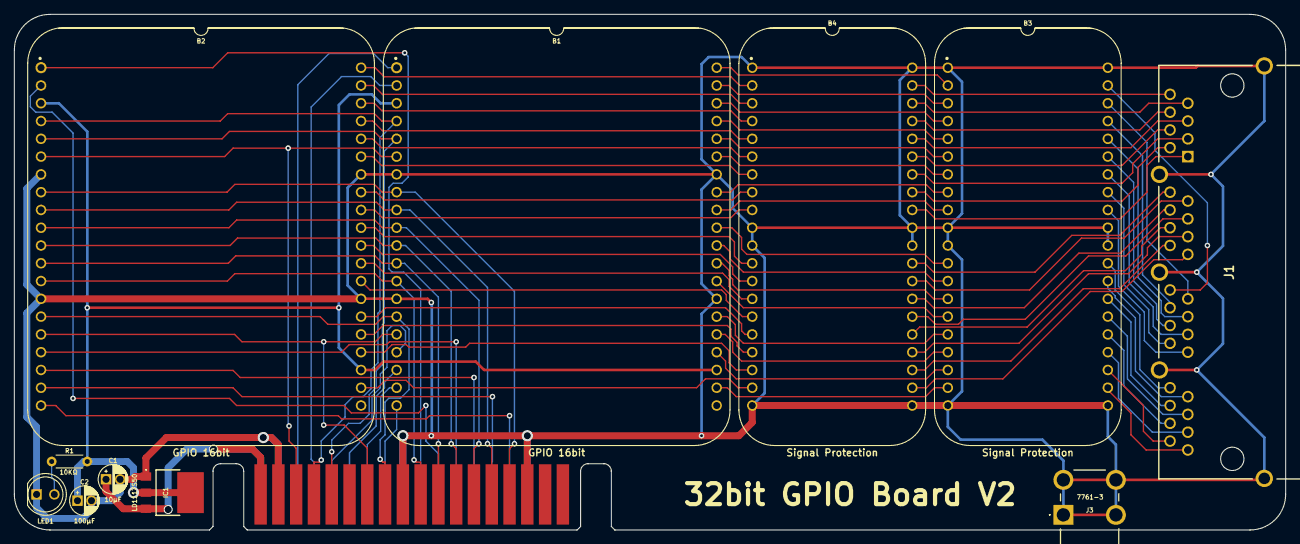
[picture p208: board GPIO 32bit Board.kicad_pcb from above]

Board: 2 copper layers, 181.6 x 73.7 mm, 12 parts (0 on the bottom side), 91 nets.
