andrewpaterson/658-Computer/Kicad/Computer/Component Boards/GPIO 16bit/GPIO 16bit.kicad_pcb

## KiCad design Kicad/Computer/Component Boards/GPIO 16bit/GPIO 16bit.kicad_pcb (2026-07-12)

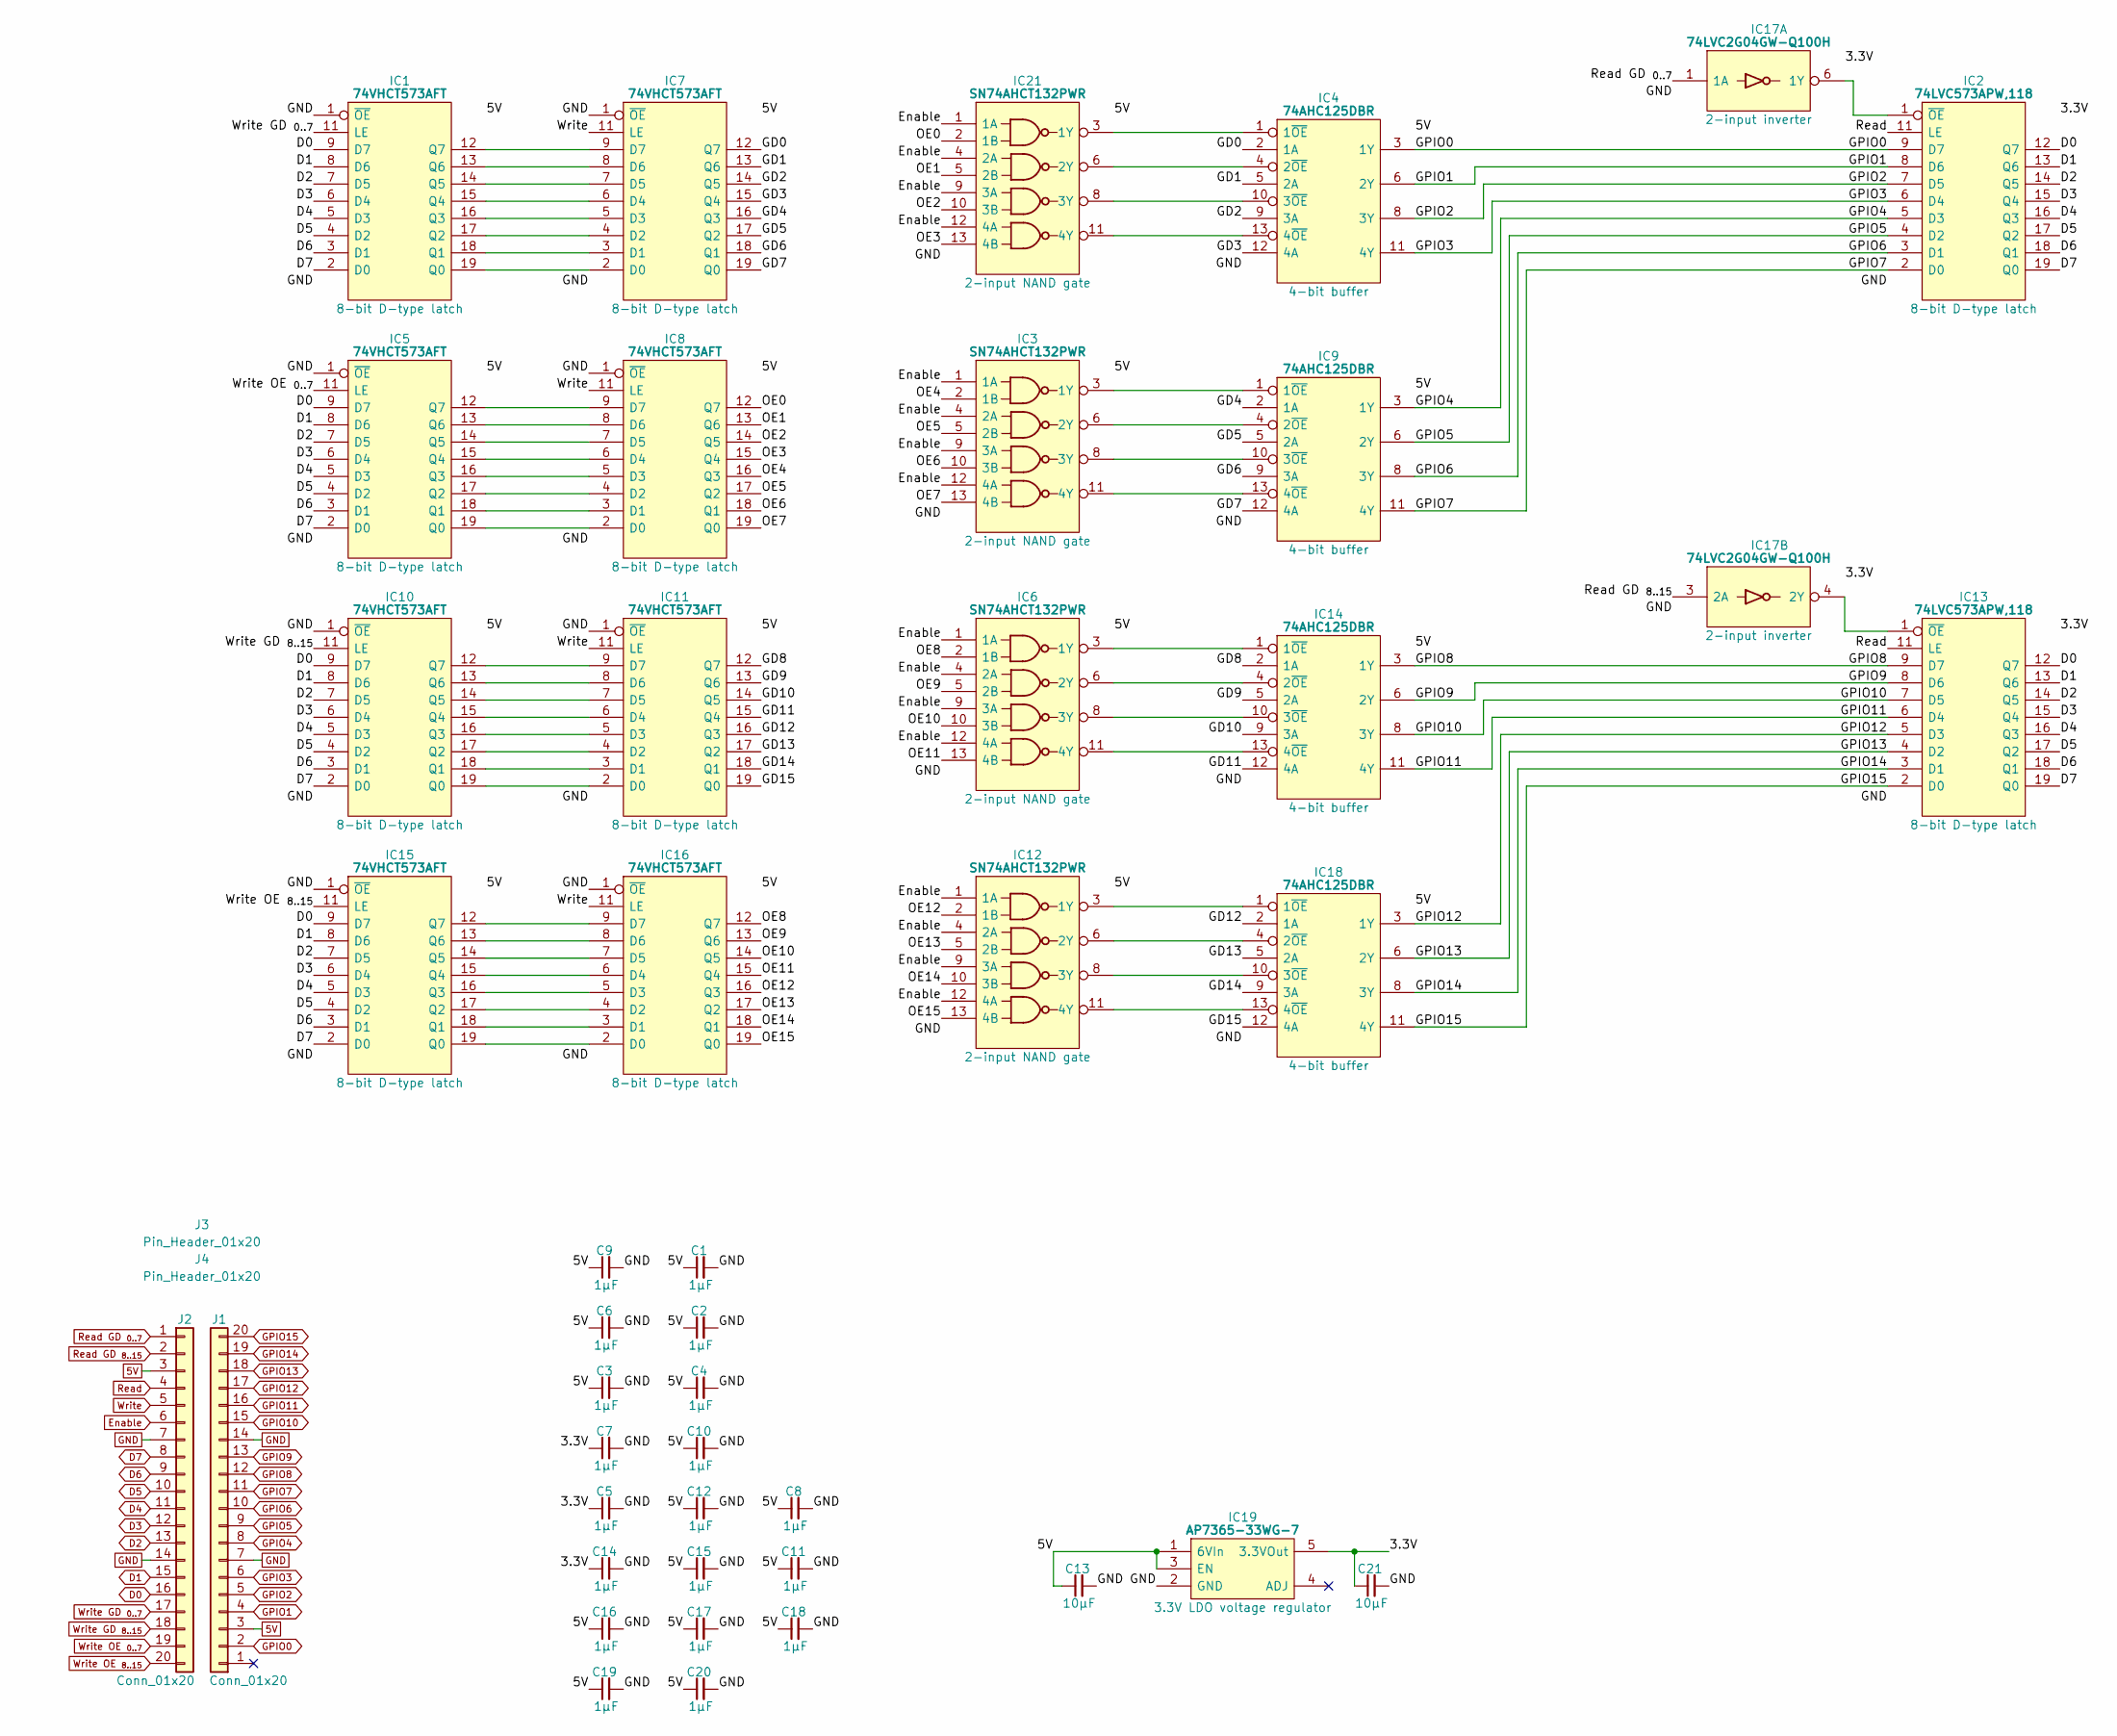
[picture p209: schematic GPIO 16bit.kicad_sch]

Parts:
C1, C2, C3, C4, C5, C6, C7, C8, C9, C10, C11, C12, C14, C15, C16, C17, C18, C19, C20: 1μF; C_0805
C13, C21: 10µF; C_0805
IC1, IC5, IC7, IC8, IC10, IC11, IC15, IC16: 74VHCT573AFT; SOP65P640X120-20N; Manufacturer_Part_Number 74VHCT573AFT; Mouser Part Number N/A
IC2, IC13: 74LVC573APW,118; SOP65P640X110-20N; Mouser Part Number 771-74LVC573APW-T
IC3, IC6, IC12, IC21: SN74AHCT132PWR; SOP65P640X120-14N; Manufacturer_Part_Number SN74AHCT132PWR; Mouser Part Number 595-SN74AHCT132PWR
IC4, IC9, IC14, IC18: 74AHC125DBR; SOP65P780X200-14N; Manufacturer_Part_Number SN74AHC125DBR; Mouser Part Number 595-SN74AHC125DBR
IC17: 74LVC2G04GW-Q100H; SOP65P210X110-6N; Manufacturer_Part_Number 74LVC2G04GW-Q100H; Mouser Part Number 771-74LVC2G04GWQ100H
IC19: AP7365-33WG-7; SOT95P285X130-5N; Manufacturer_Part_Number AP7365-33WG-7; Mouser Part Number 621-AP7365-33WG-7
J1, J2: Conn_01x20; SIP_20_Pins
J3, J4: Pin_Header_01x20; PinHeader_1x20_P2.54mm_Vertical

Connections:
5V: C1.1, C2.1, C3.1, C4.1, C6.1, C8.1, C9.1, C10.1, C11.1, C12.1, C13.1, C15.1, C16.1, C17.1, C18.1, C19.1, C20.1, IC1.20 (5V), IC3.14 (5V), IC4.14 (VCC), IC5.20 (5V), IC6.14 (5V), IC7.20 (5V), IC8.20 (5V), IC9.14 (VCC), IC10.20 (5V), IC11.20 (5V), IC12.14 (5V), IC14.14 (VCC), IC15.20 (5V), IC16.20 (5V), IC18.14 (VCC), IC19.1 (6VIn), IC19.3 (EN), IC21.14 (5V), J1.3, J2.3
/3.3V: C5.1, C7.1, C14.1, C21.1, IC2.20 (3V), IC13.20 (3V), IC17.5 (3V), IC19.5 (3.3VOut)
/GD0: IC4.2 (1A), IC7.12 (Q7)
/GD1: IC4.5 (2A), IC7.13 (Q6)
/GD2: IC4.9 (3A), IC7.14 (Q5)
/GD3: IC4.12 (4A), IC7.15 (Q4)
/GD4: IC7.16 (Q3), IC9.2 (1A)
/GD5: IC7.17 (Q2), IC9.5 (2A)
/GD6: IC7.18 (Q1), IC9.9 (3A)
/GD7: IC7.19 (Q0), IC9.12 (4A)
/GD8: IC11.12 (Q7), IC14.2 (1A)
/GD9: IC11.13 (Q6), IC14.5 (2A)
/GD10: IC11.14 (Q5), IC14.9 (3A)
/GD11: IC11.15 (Q4), IC14.12 (4A)
/GD12: IC11.16 (Q3), IC18.2 (1A)
/GD13: IC11.17 (Q2), IC18.5 (2A)
/GD14: IC11.18 (Q1), IC18.9 (3A)
/GD15: IC11.19 (Q0), IC18.12 (4A)
/OE0: IC8.12 (Q7), IC21.2 (1B)
/OE1: IC8.13 (Q6), IC21.5 (2B)
/OE2: IC8.14 (Q5), IC21.10 (3B)
/OE3: IC8.15 (Q4), IC21.13 (4B)
/OE4: IC3.2 (1B), IC8.16 (Q3)
/OE5: IC3.5 (2B), IC8.17 (Q2)
/OE6: IC3.10 (3B), IC8.18 (Q1)
/OE7: IC3.13 (4B), IC8.19 (Q0)
/OE8: IC6.2 (1B), IC16.12 (Q7)
/OE9: IC6.5 (2B), IC16.13 (Q6)
/OE10: IC6.10 (3B), IC16.14 (Q5)
/OE11: IC6.13 (4B), IC16.15 (Q4)
/OE12: IC12.2 (1B), IC16.16 (Q3)
/OE13: IC12.5 (2B), IC16.17 (Q2)
/OE14: IC12.10 (3B), IC16.18 (Q1)
/OE15: IC12.13 (4B), IC16.19 (Q0)
D0: IC1.9 (D7), IC2.12 (Q7), IC5.9 (D7), IC10.9 (D7), IC13.12 (Q7), IC15.9 (D7), J2.16
D1: IC1.8 (D6), IC2.13 (Q6), IC5.8 (D6), IC10.8 (D6), IC13.13 (Q6), IC15.8 (D6), J2.15
D2: IC1.7 (D5), IC2.14 (Q5), IC5.7 (D5), IC10.7 (D5), IC13.14 (Q5), IC15.7 (D5), J2.13
D3: IC1.6 (D4), IC2.15 (Q4), IC5.6 (D4), IC10.6 (D4), IC13.15 (Q4), IC15.6 (D4), J2.12
D4: IC1.5 (D3), IC2.16 (Q3), IC5.5 (D3), IC10.5 (D3), IC13.16 (Q3), IC15.5 (D3), J2.11
D5: IC1.4 (D2), IC2.17 (Q2), IC5.4 (D2), IC10.4 (D2), IC13.17 (Q2), IC15.4 (D2), J2.10
D6: IC1.3 (D1), IC2.18 (Q1), IC5.3 (D1), IC10.3 (D1), IC13.18 (Q1), IC15.3 (D1), J2.9
D7: IC1.2 (D0), IC2.19 (Q0), IC5.2 (D0), IC10.2 (D0), IC13.19 (Q0), IC15.2 (D0), J2.8
Enable: IC3.1 (1A), IC3.4 (2A), IC3.9 (3A), IC3.12 (4A), IC6.1 (1A), IC6.4 (2A), IC6.9 (3A), IC6.12 (4A), IC12.1 (1A), IC12.4 (2A), IC12.9 (3A), IC12.12 (4A), IC21.1 (1A), IC21.4 (2A), IC21.9 (3A), IC21.12 (4A), J2.6
GND: C1.2, C2.2, C3.2, C4.2, C5.2, C6.2, C7.2, C8.2, C9.2, C10.2, C11.2, C12.2, C13.2, C14.2, C15.2, C16.2, C17.2, C18.2, C19.2, C20.2, C21.2, IC1.1 (~OE), IC1.10 (GND), IC2.10 (GND), IC3.7 (GND), IC4.7 (GND), IC5.1 (~OE), IC5.10 (GND), IC6.7 (GND), IC7.1 (~OE), IC7.10 (GND), IC8.1 (~OE), IC8.10 (GND), IC9.7 (GND), IC10.1 (~OE), IC10.10 (GND), IC11.1 (~OE), IC11.10 (GND), IC12.7 (GND), IC13.10 (GND), IC14.7 (GND), IC15.1 (~OE), IC15.10 (GND), IC16.1 (~OE), IC16.10 (GND), IC17.2 (GND), IC18.7 (GND), IC19.2 (GND), IC21.7 (GND), J1.7, J1.14, J2.7, J2.14
GPIO0: IC2.9 (D7), IC4.3 (1Y), J1.2
GPIO1: IC2.8 (D6), IC4.6 (2Y), J1.4
GPIO2: IC2.7 (D5), IC4.8 (3Y), J1.5
GPIO3: IC2.6 (D4), IC4.11 (4Y), J1.6
GPIO4: IC2.5 (D3), IC9.3 (1Y), J1.8
GPIO5: IC2.4 (D2), IC9.6 (2Y), J1.9
GPIO6: IC2.3 (D1), IC9.8 (3Y), J1.10
GPIO7: IC2.2 (D0), IC9.11 (4Y), J1.11
GPIO8: IC13.9 (D7), IC14.3 (1Y), J1.12
GPIO9: IC13.8 (D6), IC14.6 (2Y), J1.13
GPIO10: IC13.7 (D5), IC14.8 (3Y), J1.15
GPIO11: IC13.6 (D4), IC14.11 (4Y), J1.16
GPIO12: IC13.5 (D3), IC18.3 (1Y), J1.17
GPIO13: IC13.4 (D2), IC18.6 (2Y), J1.18
GPIO14: IC13.3 (D1), IC18.8 (3Y), J1.19
GPIO15: IC13.2 (D0), IC18.11 (4Y), J1.20
unnamed: IC1.19 (Q0), IC7.2 (D0)
unnamed: IC1.18 (Q1), IC7.3 (D1)
unnamed: IC1.17 (Q2), IC7.4 (D2)
unnamed: IC1.16 (Q3), IC7.5 (D3)
unnamed: IC1.15 (Q4), IC7.6 (D4)
unnamed: IC1.14 (Q5), IC7.7 (D5)
unnamed: IC1.13 (Q6), IC7.8 (D6)
unnamed: IC1.12 (Q7), IC7.9 (D7)
unnamed: IC3.3 (1Y), IC9.1 (1~OE)
unnamed: IC3.6 (2Y), IC9.4 (2~OE)
unnamed: IC3.8 (3Y), IC9.10 (3~OE)
unnamed: IC3.11 (4Y), IC9.13 (4~OE)
unnamed: IC5.19 (Q0), IC8.2 (D0)
unnamed: IC5.18 (Q1), IC8.3 (D1)
unnamed: IC5.17 (Q2), IC8.4 (D2)
unnamed: IC5.16 (Q3), IC8.5 (D3)
unnamed: IC5.15 (Q4), IC8.6 (D4)
unnamed: IC5.14 (Q5), IC8.7 (D5)
unnamed: IC5.13 (Q6), IC8.8 (D6)
unnamed: IC5.12 (Q7), IC8.9 (D7)
unnamed: IC10.19 (Q0), IC11.2 (D0)
unnamed: IC10.18 (Q1), IC11.3 (D1)
unnamed: IC10.17 (Q2), IC11.4 (D2)
unnamed: IC10.16 (Q3), IC11.5 (D3)
unnamed: IC10.15 (Q4), IC11.6 (D4)
unnamed: IC10.14 (Q5), IC11.7 (D5)
unnamed: IC10.13 (Q6), IC11.8 (D6)
unnamed: IC10.12 (Q7), IC11.9 (D7)
unnamed: IC12.3 (1Y), IC18.1 (1~OE)
unnamed: IC12.6 (2Y), IC18.4 (2~OE)
unnamed: IC12.8 (3Y), IC18.10 (3~OE)
unnamed: IC12.11 (4Y), IC18.13 (4~OE)
unnamed: IC13.1 (~OE), IC17.4 (2Y)
unnamed: IC6.3 (1Y), IC14.1 (1~OE)
unnamed: IC6.6 (2Y), IC14.4 (2~OE)
unnamed: IC6.8 (3Y), IC14.10 (3~OE)
unnamed: IC6.11 (4Y), IC14.13 (4~OE)
unnamed: IC15.19 (Q0), IC16.2 (D0)
unnamed: IC15.18 (Q1), IC16.3 (D1)
unnamed: IC15.17 (Q2), IC16.4 (D2)
unnamed: IC15.16 (Q3), IC16.5 (D3)
unnamed: IC15.15 (Q4), IC16.6 (D4)
unnamed: IC15.14 (Q5), IC16.7 (D5)
unnamed: IC15.13 (Q6), IC16.8 (D6)
unnamed: IC15.12 (Q7), IC16.9 (D7)
unnamed: IC2.1 (~OE), IC17.6 (1Y)
unnamed: IC4.1 (1~OE), IC21.3 (1Y)
unnamed: IC4.4 (2~OE), IC21.6 (2Y)
unnamed: IC4.10 (3~OE), IC21.8 (3Y)
unnamed: IC4.13 (4~OE), IC21.11 (4Y)
Read: IC2.11 (LE), IC13.11 (LE), J2.4
Read GD _{0..7}: IC17.1 (1A), J2.1
Read GD _{8..15}: IC17.3 (2A), J2.2
Write: IC7.11 (LE), IC8.11 (LE), IC11.11 (LE), IC16.11 (LE), J2.5
Write GD _{0..7}: IC1.11 (LE), J2.17
Write GD _{8..15}: IC10.11 (LE), J2.18
Write OE _{0..7}: IC5.11 (LE), J2.19
Write OE _{8..15}: IC15.11 (LE), J2.20

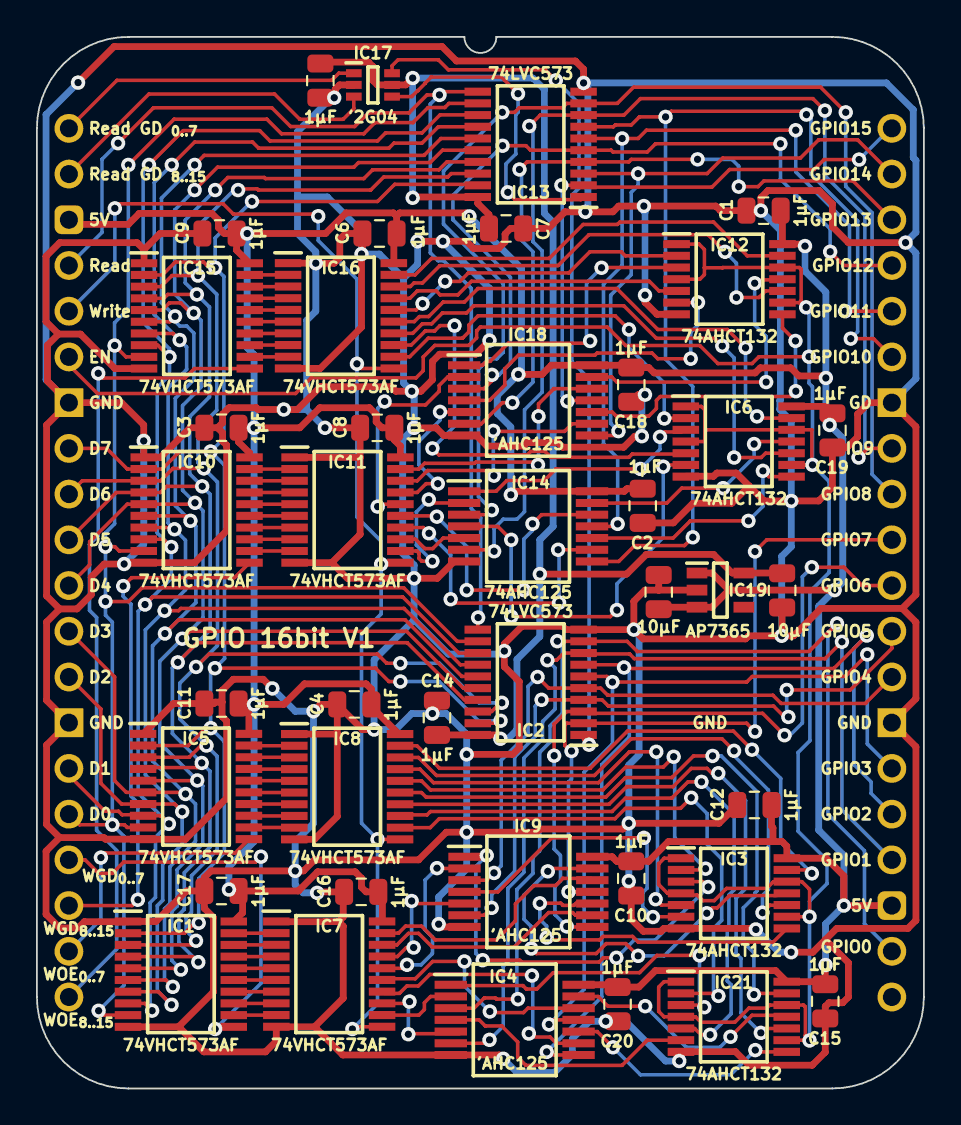
[picture p210: board GPIO 16bit.kicad_pcb from above]

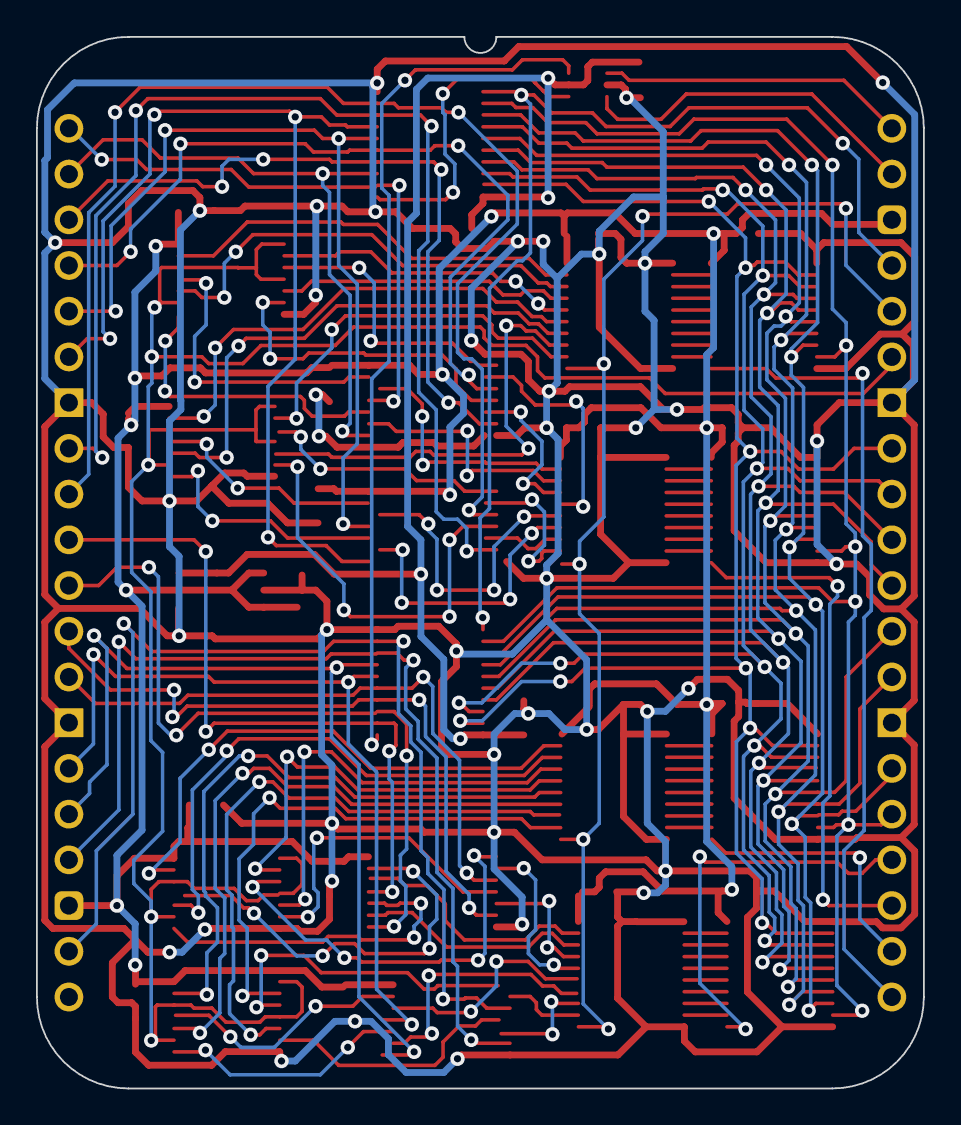
[picture p211: board GPIO 16bit.kicad_pcb from below]

Board: 2 copper layers, 49.3 x 58.4 mm, 45 parts (4 on the bottom side), 118 nets.
