andrewpaterson/658-Computer/Kicad/Pico/HCP65 Wide Analyser/HCP65 Wide Analyser.kicad_pcb

## KiCad design Kicad/Pico/HCP65 Wide Analyser/HCP65 Wide Analyser.kicad_pcb (2026-07-01)

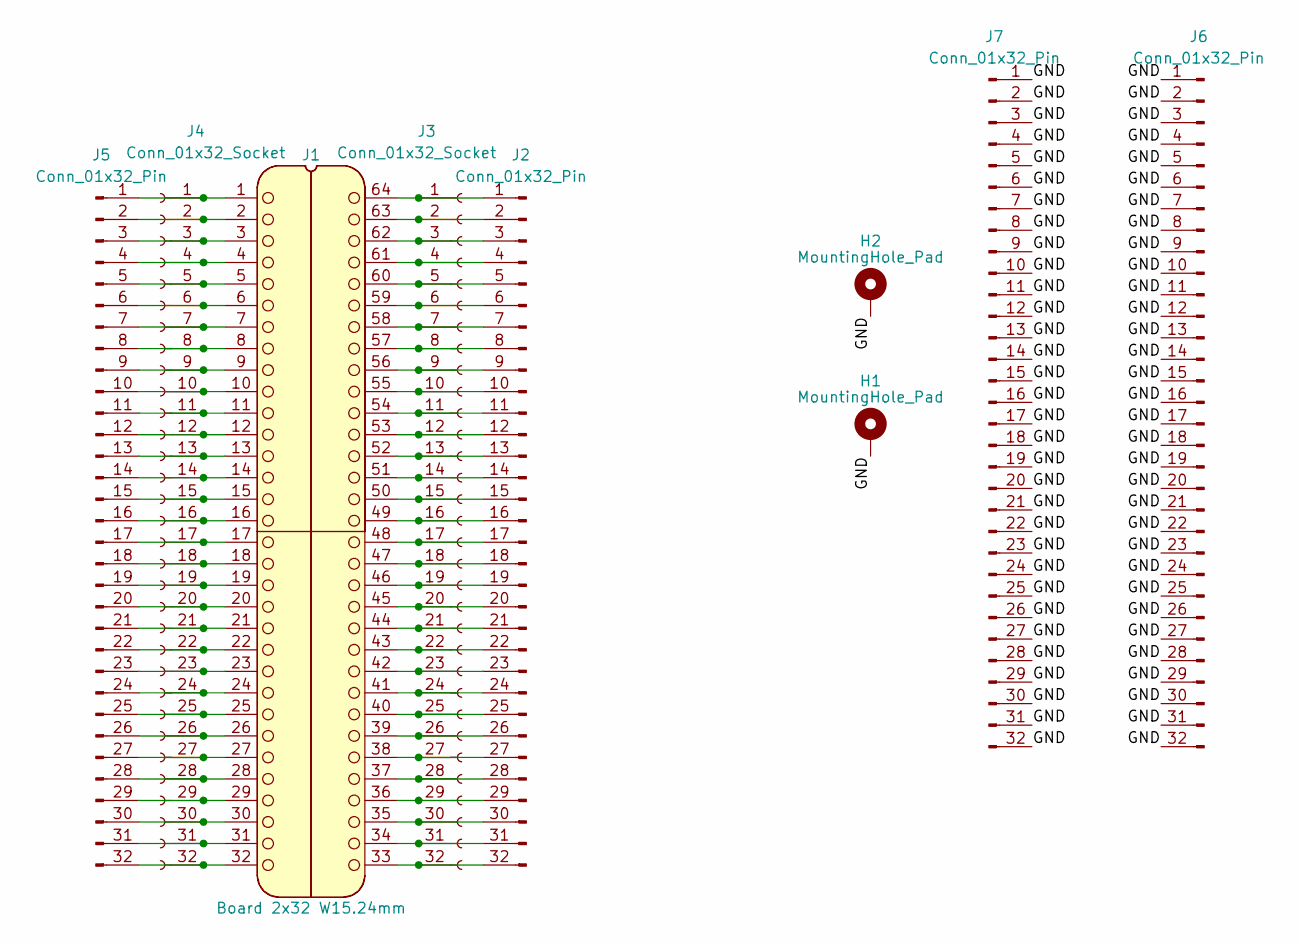
[picture p212: schematic HCP65 Wide Analyser.kicad_sch, Wide Logic Analyser Extension]

Parts:
H1, H2: MountingHole_Pad; MountingHole_3.2mm_M3_Pad
J1: Board 2x32 W15.24mm; DIP-64_Board_W22.86mm_Nak
J2, J5, J6, J7: Conn_01x32_Pin; PinHeader_1x32_P2.54mm_Vertical
J3, J4: Conn_01x32_Socket; PinSocket_1x32_P2.54mm_Vertical

Connections:
/GND: H1.1, H2.1, J6.1, J6.2, J6.3, J6.4, J6.5, J6.6, J6.7, J6.8, J6.9, J6.10, J6.11, J6.12, J6.13, J6.14, J6.15, J6.16, J6.17, J6.18, J6.19, J6.20, J6.21, J6.22, J6.23, J6.24, J6.25, J6.26, J6.27, J6.28, J6.29, J6.30, J6.31, J6.32, J7.1, J7.2, J7.3, J7.4, J7.5, J7.6, J7.7, J7.8, J7.9, J7.10, J7.11, J7.12, J7.13, J7.14, J7.15, J7.16, J7.17, J7.18, J7.19, J7.20, J7.21, J7.22, J7.23, J7.24, J7.25, J7.26, J7.27, J7.28, J7.29, J7.30, J7.31, J7.32
unnamed: J1.64, J2.1, J3.1
unnamed: J1.63, J2.2, J3.2
unnamed: J1.62, J2.3, J3.3
unnamed: J1.61, J2.4, J3.4
unnamed: J1.60, J2.5, J3.5
unnamed: J1.59, J2.6, J3.6
unnamed: J1.58, J2.7, J3.7
unnamed: J1.57, J2.8, J3.8
unnamed: J1.56, J2.9, J3.9
unnamed: J1.55, J2.10, J3.10
unnamed: J1.54, J2.11, J3.11
unnamed: J1.53, J2.12, J3.12
unnamed: J1.52, J2.13, J3.13
unnamed: J1.51, J2.14, J3.14
unnamed: J1.50, J2.15, J3.15
unnamed: J1.49, J2.16, J3.16
unnamed: J1.48, J2.17, J3.17
unnamed: J1.47, J2.18, J3.18
unnamed: J1.46, J2.19, J3.19
unnamed: J1.45, J2.20, J3.20
unnamed: J1.44, J2.21, J3.21
unnamed: J1.43, J2.22, J3.22
unnamed: J1.42, J2.23, J3.23
unnamed: J1.41, J2.24, J3.24
unnamed: J1.40, J2.25, J3.25
unnamed: J1.39, J2.26, J3.26
unnamed: J1.38, J2.27, J3.27
unnamed: J1.37, J2.28, J3.28
unnamed: J1.36, J2.29, J3.29
unnamed: J1.35, J2.30, J3.30
unnamed: J1.34, J2.31, J3.31
unnamed: J1.33, J2.32, J3.32
unnamed: J1.1, J4.1, J5.1
unnamed: J1.2, J4.2, J5.2
unnamed: J1.3, J4.3, J5.3
unnamed: J1.4, J4.4, J5.4
unnamed: J1.5, J4.5, J5.5
unnamed: J1.6, J4.6, J5.6
unnamed: J1.7, J4.7, J5.7
unnamed: J1.8, J4.8, J5.8
unnamed: J1.9, J4.9, J5.9
unnamed: J1.10, J4.10, J5.10
unnamed: J1.11, J4.11, J5.11
unnamed: J1.12, J4.12, J5.12
unnamed: J1.13, J4.13, J5.13
unnamed: J1.14, J4.14, J5.14
unnamed: J1.15, J4.15, J5.15
unnamed: J1.16, J4.16, J5.16
unnamed: J1.17, J4.17, J5.17
unnamed: J1.18, J4.18, J5.18
unnamed: J1.19, J4.19, J5.19
unnamed: J1.20, J4.20, J5.20
unnamed: J1.21, J4.21, J5.21
unnamed: J1.22, J4.22, J5.22
unnamed: J1.23, J4.23, J5.23
unnamed: J1.24, J4.24, J5.24
unnamed: J1.25, J4.25, J5.25
unnamed: J1.26, J4.26, J5.26
unnamed: J1.27, J4.27, J5.27
unnamed: J1.28, J4.28, J5.28
unnamed: J1.29, J4.29, J5.29
unnamed: J1.30, J4.30, J5.30
unnamed: J1.31, J4.31, J5.31
unnamed: J1.32, J4.32, J5.32

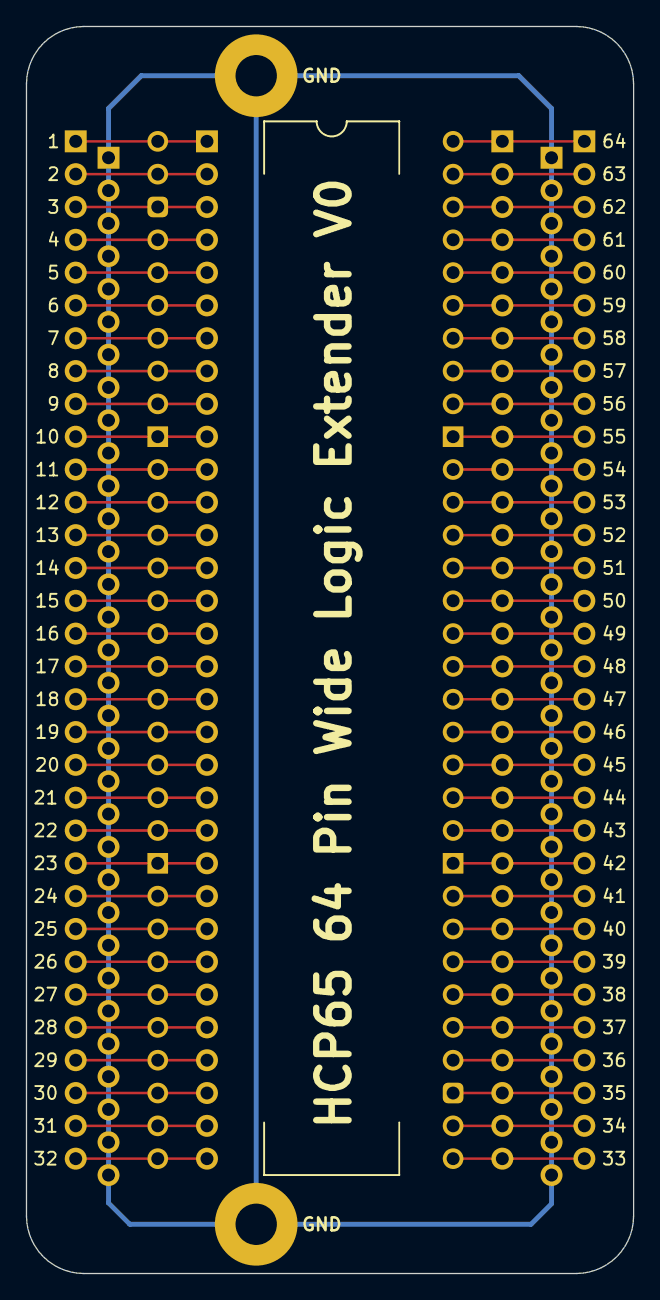
[picture p213: board HCP65 Wide Analyser.kicad_pcb from above]

Board: 2 copper layers, 47.0 x 96.5 mm, 9 parts (0 on the bottom side), 65 nets.
