andrewpaterson/658-Computer/Kicad/Computer/Graphics/Graphics Board/Graphics Board.kicad_pcb

## KiCad design Kicad/Computer/Graphics/Graphics Board/Graphics Board.kicad_pcb (2026-07-01)

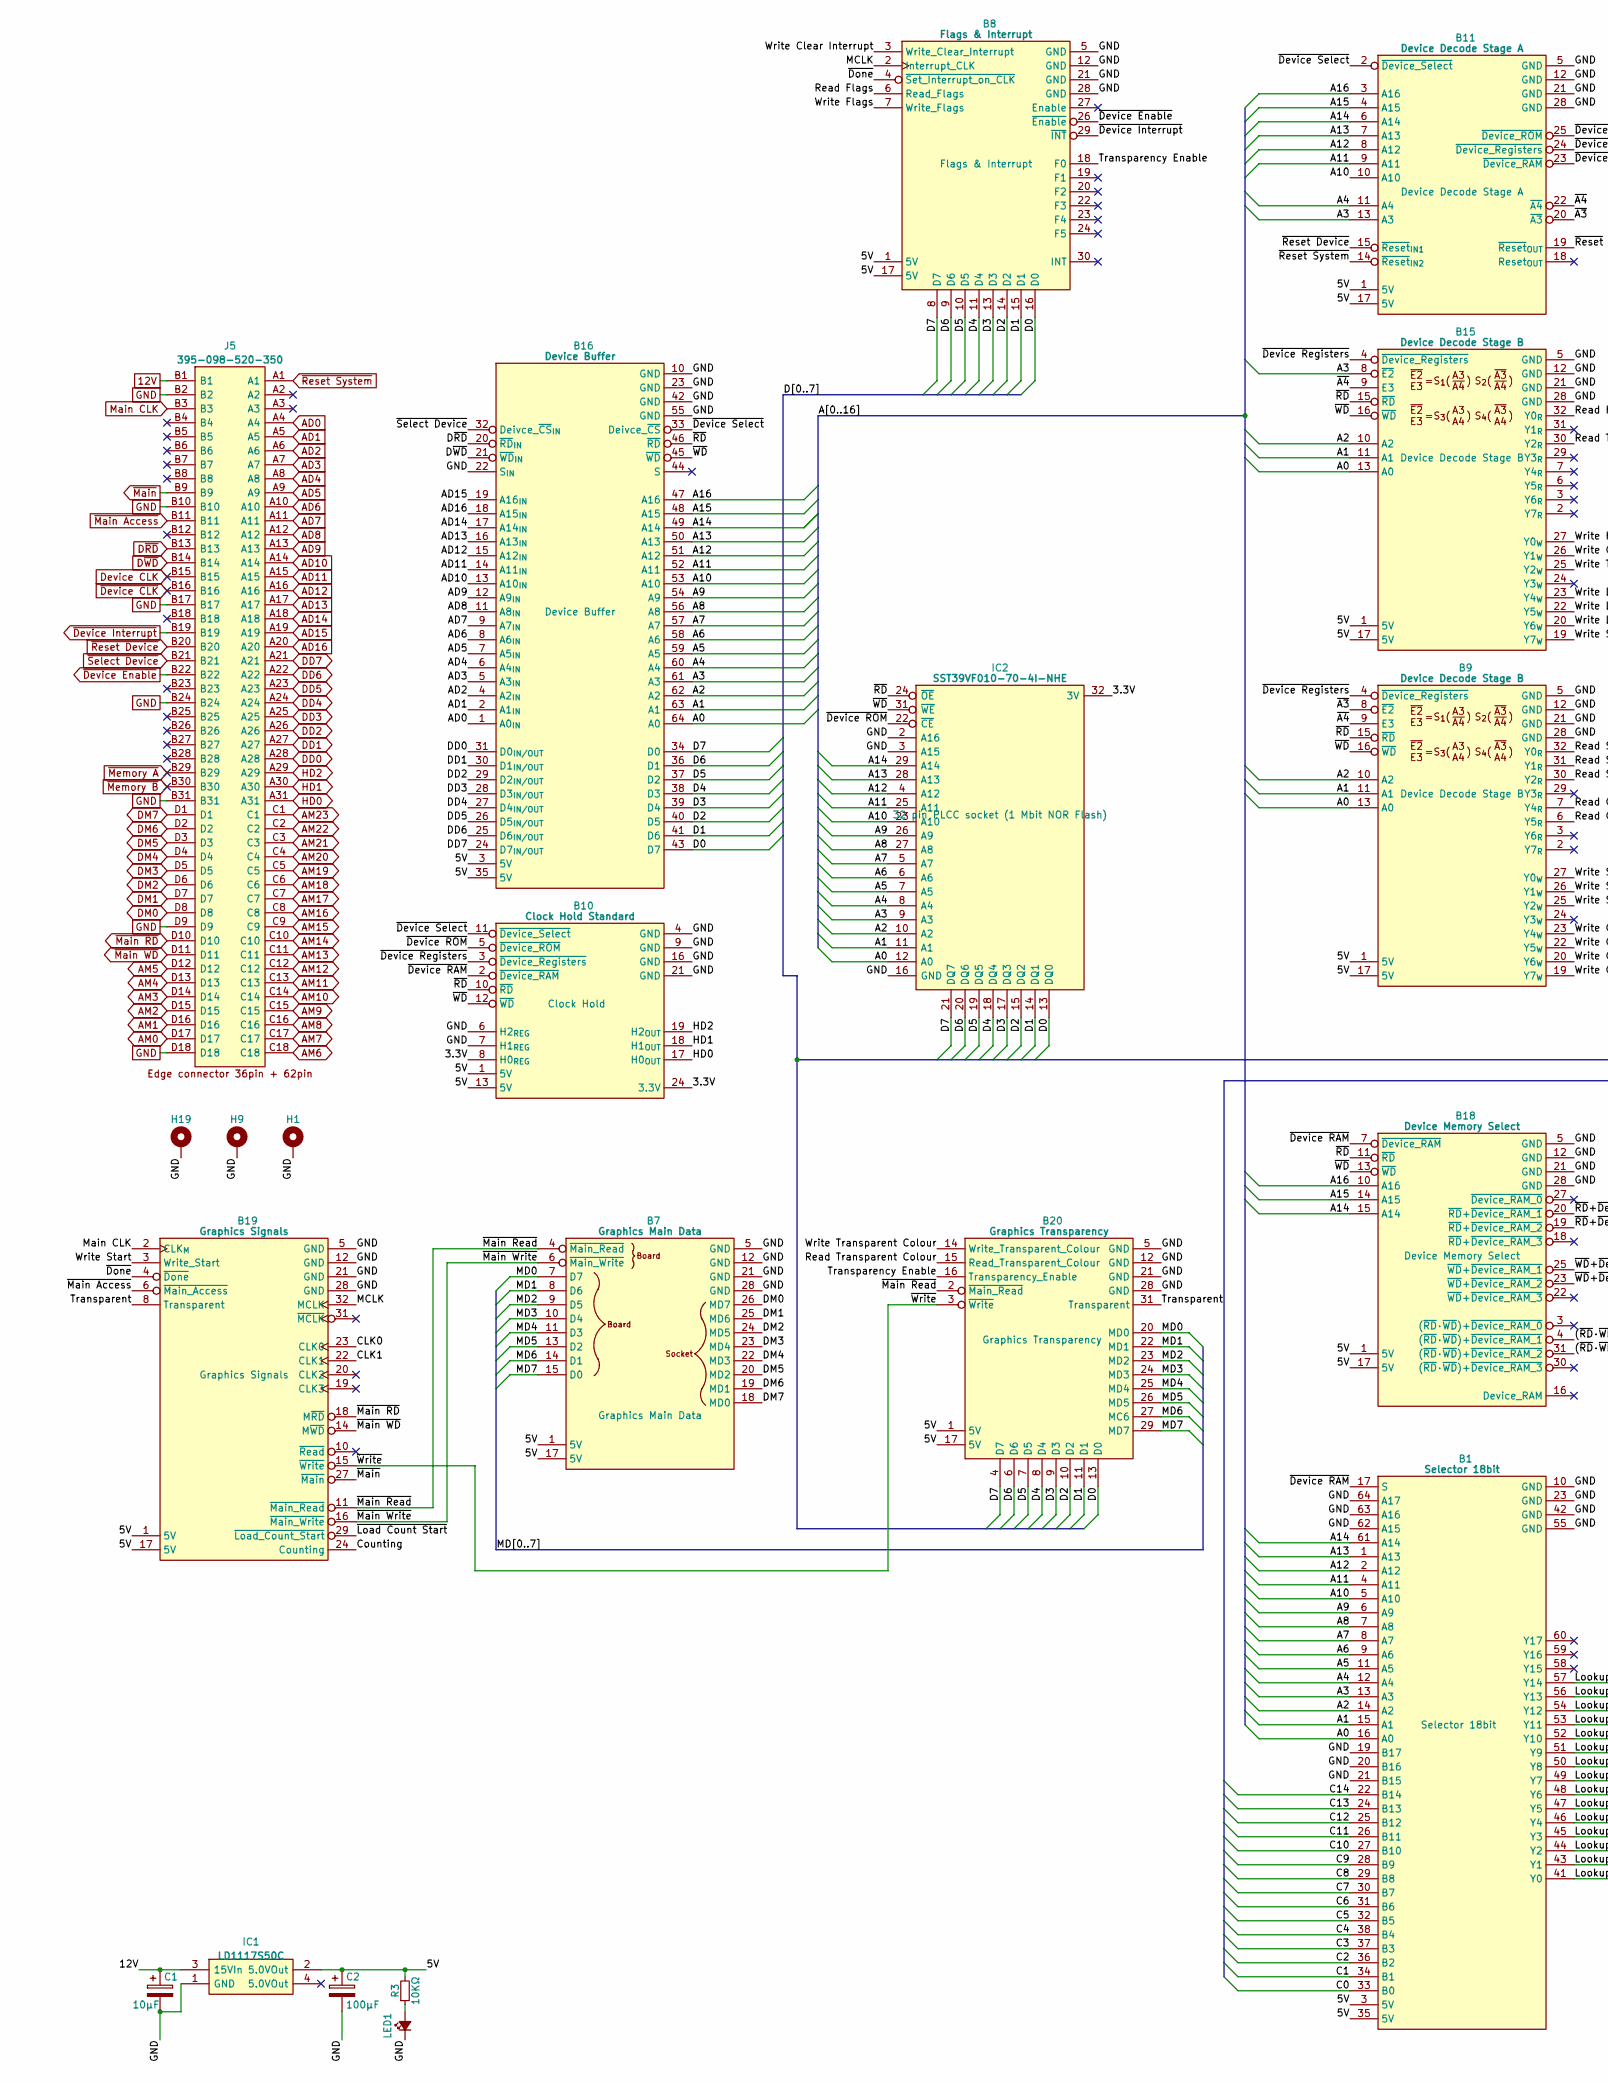
[picture p214: schematic Graphics Board.kicad_sch, part in row 1, column 1]

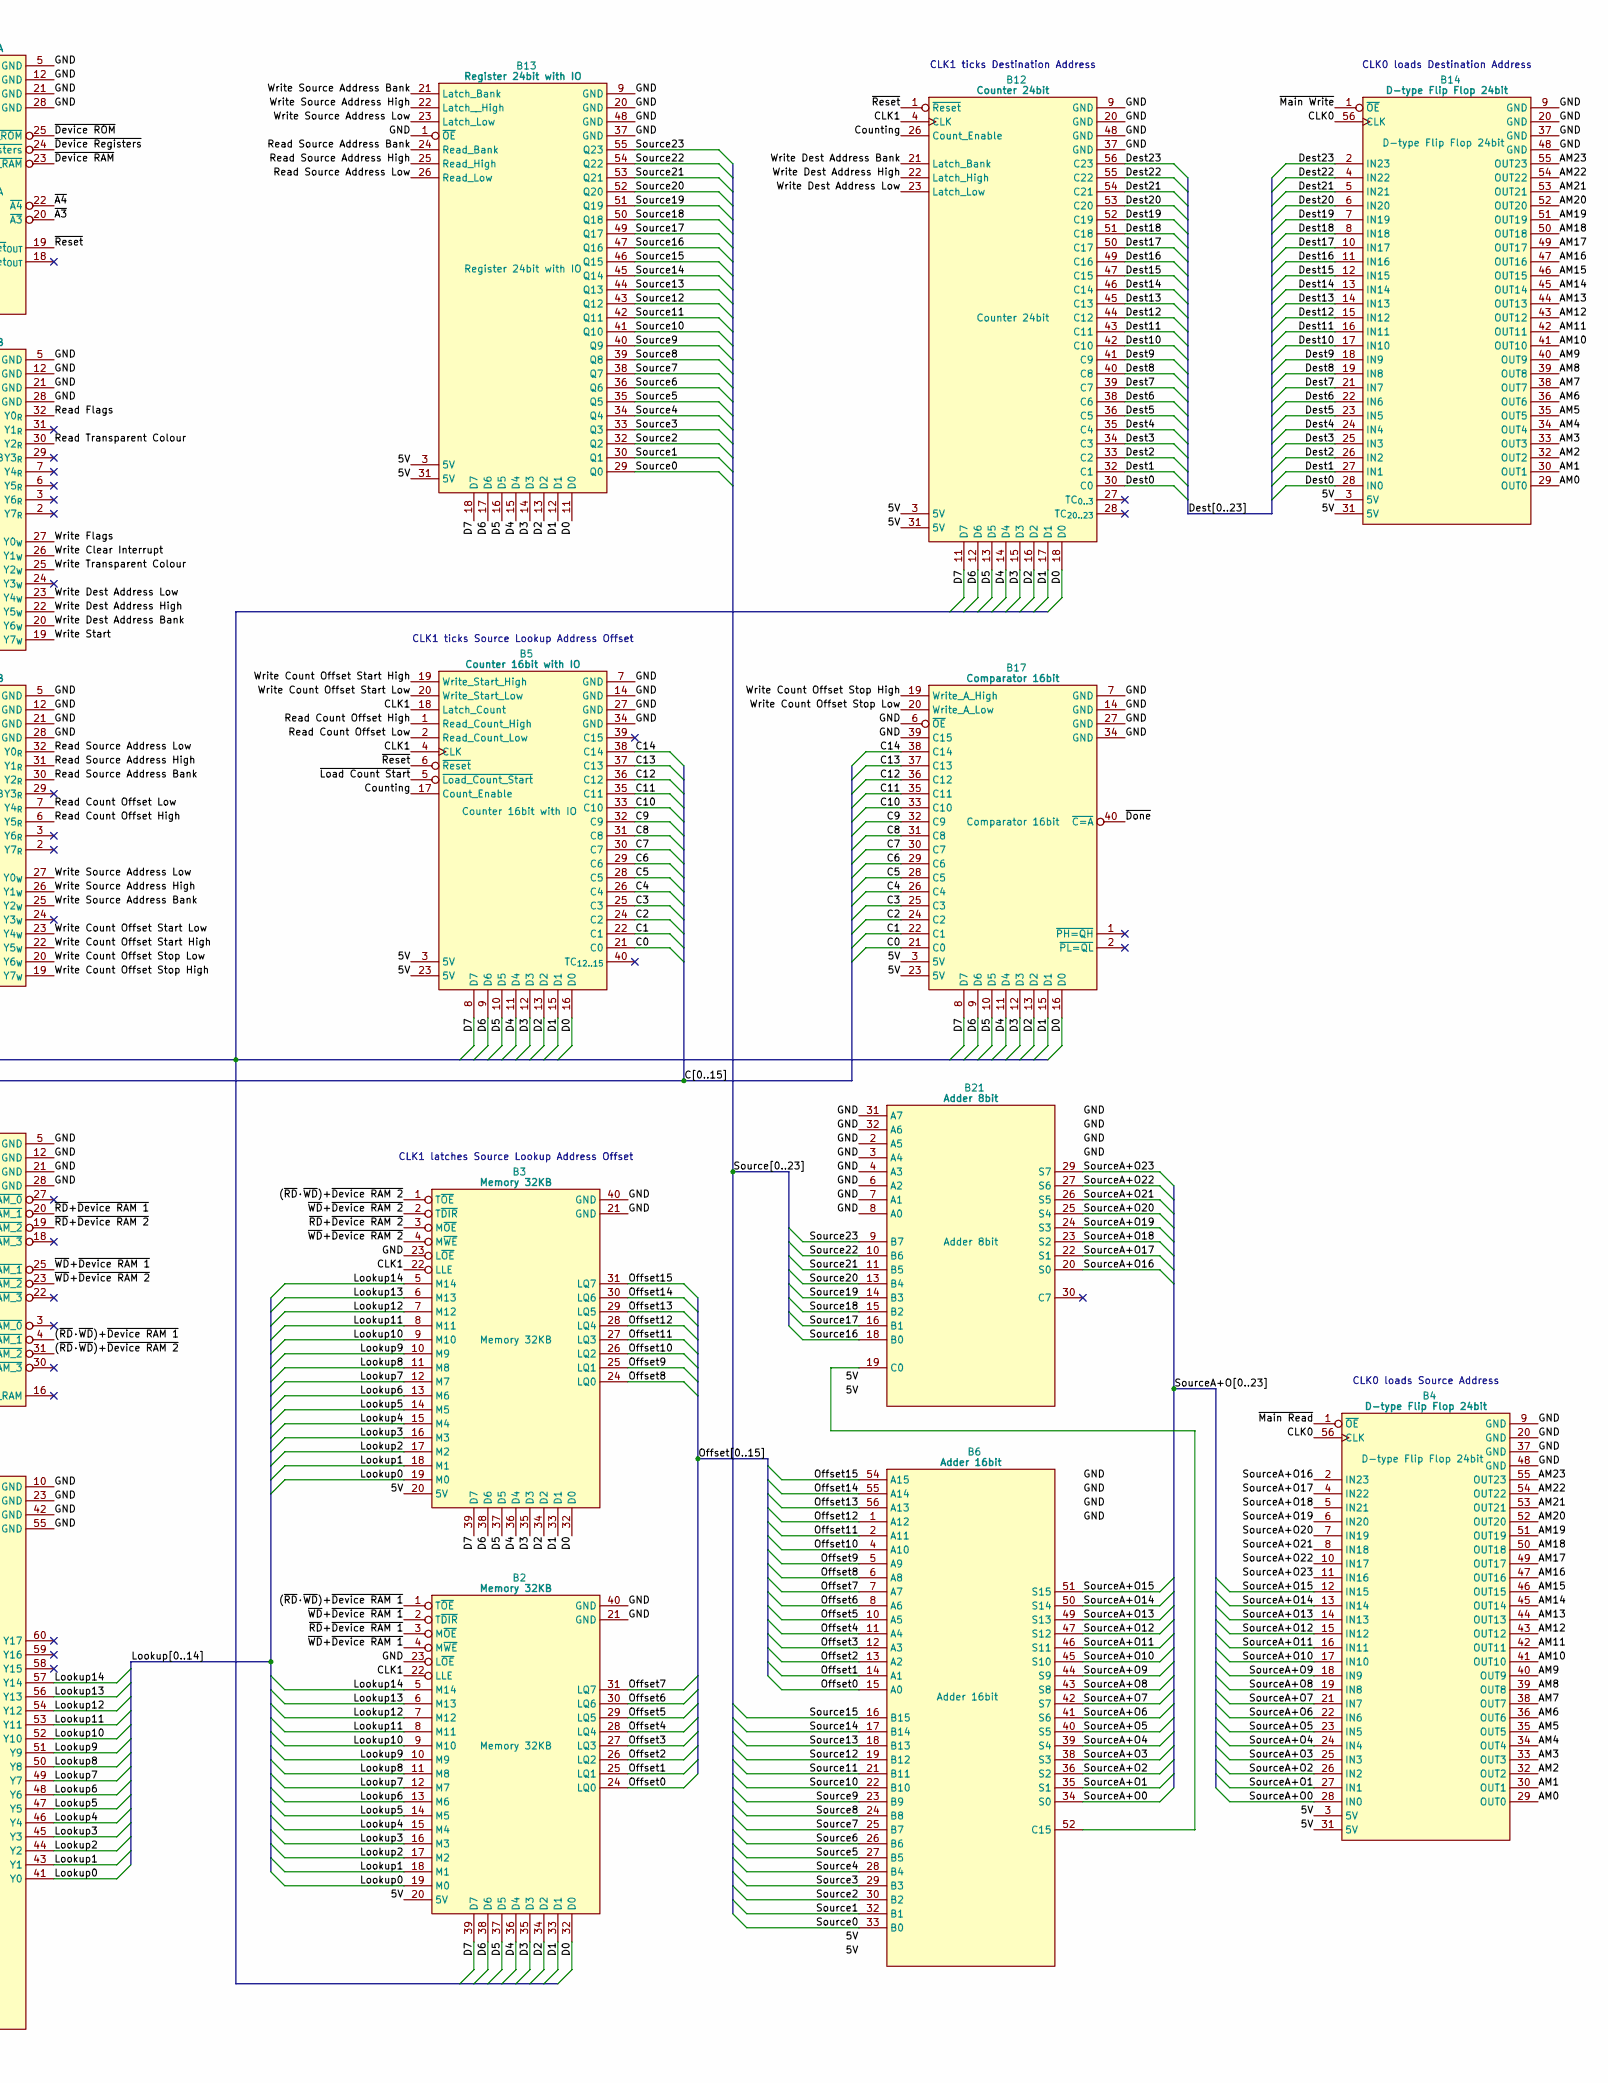
[picture p215: schematic Graphics Board.kicad_sch, part in row 1, column 2]

Parts:
B1: Selector 18bit; HCP65_Selector_18bit
B2, B3: Memory 32KB; HCP65_Memory_32KB_With_Latch
B4, B14: D-type Flip Flop 24bit; HCP65_D_Flip_Flop_24bit
B5: Counter 16bit with IO; HCP65_Counter_16bit_DIO
B6: Adder 16bit; HCP65_Adder_16bit
B7: Graphics Main Data; HCP65_Graphics_Main_Data
B8: Flags & Interrupt; HCP65_Flags_Interrupt
B9, B15: Device Decode Stage B; HCP65_Device_Decode_Stage_B
B10: Clock Hold Standard; HCP65_Clock_Hold_Standard
B11: Device Decode Stage A; HCP65_Device_Decode_Stage_A
B12: Counter 24bit; HCP65_Counter_24bit
B13: Register 24bit with IO; HCP65_Register_24bit_DIO
B16: Device Buffer; HCP65_Device_Buffer
B17: Comparator 16bit; HCP65_Comparator_16bit
B18: Device Memory Select; HCP65_Video_Device_RAM_Select
B19: Graphics Signals; HCP65_Graphics_Signals
B20: Graphics Transparency; HCP65_Graphics_Transparency
B21: Adder 8bit; HCP65_Adder_8bit
C1: 10μF; CP_Radial_D4.0mm_P2.00mm
C2: 100μF; CP_Radial_D4.0mm_P2.00mm
H1, H9, H19: MountingHole_Pad; HCP65_MountingHole_M3_
IC1: LD1117S50C; LD1117S33C; Manufacturer_Part_Number LD1117S50C
IC2: SST39VF010-70-4I-NHE; 5408803224008; Manufacturer_Part_Number SST39VF010-70-4I-NHE
J5: 395-098-520-350; 98pin Edge Connector; Manufacturer_Part_Number 395-098-520-350; Mouser Part Number 587-395-098-520-350
LED1: LED; LED_D5.0mm
R3: 10KΩ; R_0805

Connections:
12V: C1.1, IC1.3 (15VIn), J5.B1
/3.3V: B10.8 (H0_{REG}), B10.24 (3.3V), IC2.32 (3V)
/5V: B1.3 (5V), B1.35 (5V), B2.20 (5V), B3.20 (5V), B4.3 (5V), B4.31 (5V), B5.3 (5V), B5.23 (5V), B6.3 (5V), B6.31 (5V), B7.1 (5V), B7.17 (5V), B8.1 (5V), B8.17 (5V), B9.1 (5V), B9.17 (5V), B10.1 (5V), B10.13 (5V), B11.1 (5V), B11.17 (5V), B12.3 (5V), B12.31 (5V), B13.3 (5V), B13.31 (5V), B14.3 (5V), B14.31 (5V), B15.1 (5V), B15.17 (5V), B16.3 (5V), B16.35 (5V), B17.3 (5V), B17.23 (5V), B18.1 (5V), B18.17 (5V), B19.1 (5V), B19.17 (5V), B20.1 (5V), B20.17 (5V), B21.1 (5V), B21.17 (5V), C2.1, IC1.2 (5.0VOut), R3.2
/(~RD·~WD)+~Device RAM 1: B2.1 (T~OE), B18.4 ((~RD·~WD)+~Device_RAM_1)
/(~RD·~WD)+~Device RAM 2: B3.1 (T~OE), B18.31 ((~RD·~WD)+~Device_RAM_2)
/A0: B1.16 (A0), B9.13 (A0), B15.13 (A0), B16.64 (A0), IC2.12 (A0)
/A1: B1.15 (A1), B9.11 (A1), B15.11 (A1), B16.63 (A1), IC2.11 (A1)
/A2: B1.14 (A2), B9.10 (A2), B15.10 (A2), B16.62 (A2), IC2.10 (A2)
/A3: B1.13 (A3), B11.13 (A3), B15.8 (~E2), B16.61 (A3), IC2.9 (A3)
/A4: B1.12 (A4), B11.11 (A4), B16.60 (A4), IC2.8 (A4)
/A5: B1.11 (A5), B16.59 (A5), IC2.7 (A5)
/A6: B1.9 (A6), B16.58 (A6), IC2.6 (A6)
/A7: B1.8 (A7), B16.57 (A7), IC2.5 (A7)
/A8: B1.7 (A8), B16.56 (A8), IC2.27 (A8)
/A9: B1.6 (A9), B16.54 (A9), IC2.26 (A9)
/A10: B1.5 (A10), B11.10 (A10), B16.53 (A10), IC2.23 (A10)
/A11: B1.4 (A11), B11.9 (A11), B16.52 (A11), IC2.25 (A11)
/A12: B1.2 (A12), B11.8 (A12), B16.51 (A12), IC2.4 (A12)
/A13: B1.1 (A13), B11.7 (A13), B16.50 (A13), IC2.28 (A13)
/A14: B1.61 (A14), B11.6 (A14), B16.49 (A14), B18.15 (A14), IC2.29 (A14)
/A15: B11.4 (A15), B16.48 (A15), B18.14 (A15)
/A16: B11.3 (A16), B16.47 (A16), B18.10 (A16)
/C0: B1.33 (B0), B5.21 (C0), B17.21 (C0)
/C1: B1.34 (B1), B5.22 (C1), B17.22 (C1)
/C2: B1.36 (B2), B5.24 (C2), B17.24 (C2)
/C3: B1.37 (B3), B5.25 (C3), B17.25 (C3)
/C4: B1.38 (B4), B5.26 (C4), B17.26 (C4)
/C5: B1.32 (B5), B5.28 (C5), B17.28 (C5)
/C6: B1.31 (B6), B5.29 (C6), B17.29 (C6)
/C7: B1.30 (B7), B5.30 (C7), B17.30 (C7)
/C8: B1.29 (B8), B5.31 (C8), B17.31 (C8)
/C9: B1.28 (B9), B5.32 (C9), B17.32 (C9)
/C10: B1.27 (B10), B5.33 (C10), B17.33 (C10)
/C11: B1.26 (B11), B5.35 (C11), B17.35 (C11)
/C12: B1.25 (B12), B5.36 (C12), B17.36 (C12)
/C13: B1.24 (B13), B5.37 (C13), B17.37 (C13)
/C14: B1.22 (B14), B5.38 (C14), B17.38 (C14)
/CLK0: B4.56 (CLK), B14.56 (CLK), B19.23 (CLK0)
/CLK1: B2.22 (LLE), B3.22 (LLE), B5.4 (CLK), B5.18 (Latch_Count), B12.4 (CLK), B19.22 (CLK1)
/Counting: B5.17 (Count_Enable), B12.26 (Count_Enable), B19.24 (Counting)
/D0: B2.32 (D0), B3.32 (D0), B5.16 (D0), B8.16 (D0), B12.18 (D0), B13.11 (D0), B16.43 (D7), B17.16 (D0), B20.13 (D0), IC2.13 (DQ0)
/D1: B2.33 (D1), B3.33 (D1), B5.15 (D1), B8.15 (D1), B12.17 (D1), B13.12 (D1), B16.41 (D6), B17.15 (D1), B20.11 (D1), IC2.14 (DQ1)
/D2: B2.34 (D2), B3.34 (D2), B5.13 (D2), B8.14 (D2), B12.16 (D2), B13.13 (D2), B16.40 (D5), B17.13 (D2), B20.10 (D2), IC2.15 (DQ2)
/D3: B2.35 (D3), B3.35 (D3), B5.12 (D3), B8.13 (D3), B12.15 (D3), B13.14 (D3), B16.39 (D4), B17.12 (D3), B20.9 (D3), IC2.17 (DQ3)
/D4: B2.36 (D4), B3.36 (D4), B5.11 (D4), B8.11 (D4), B12.14 (D4), B13.15 (D4), B16.38 (D3), B17.11 (D4), B20.8 (D4), IC2.18 (DQ4)
/D5: B2.37 (D5), B3.37 (D5), B5.10 (D5), B8.10 (D5), B12.13 (D5), B13.16 (D5), B16.37 (D2), B17.10 (D5), B20.7 (D5), IC2.19 (DQ5)
/D6: B2.38 (D6), B3.38 (D6), B5.9 (D6), B8.9 (D6), B12.12 (D6), B13.17 (D6), B16.36 (D1), B17.9 (D6), B20.6 (D6), IC2.20 (DQ6)
/D7: B2.39 (D7), B3.39 (D7), B5.8 (D7), B8.8 (D7), B12.11 (D7), B13.18 (D7), B16.34 (D0), B17.8 (D7), B20.4 (D7), IC2.21 (DQ7)
/Dest0: B12.30 (C0), B14.28 (IN0)
/Dest1: B12.32 (C1), B14.27 (IN1)
/Dest2: B12.33 (C2), B14.26 (IN2)
/Dest3: B12.34 (C3), B14.25 (IN3)
/Dest4: B12.35 (C4), B14.24 (IN4)
/Dest5: B12.36 (C5), B14.23 (IN5)
/Dest6: B12.38 (C6), B14.22 (IN6)
/Dest7: B12.39 (C7), B14.21 (IN7)
/Dest8: B12.40 (C8), B14.19 (IN8)
/Dest9: B12.41 (C9), B14.18 (IN9)
/Dest10: B12.42 (C10), B14.17 (IN10)
/Dest11: B12.43 (C11), B14.16 (IN11)
/Dest12: B12.44 (C12), B14.15 (IN12)
/Dest13: B12.45 (C13), B14.14 (IN13)
/Dest14: B12.46 (C14), B14.13 (IN14)
/Dest15: B12.47 (C15), B14.12 (IN15)
/Dest16: B12.49 (C16), B14.11 (IN16)
/Dest17: B12.50 (C17), B14.10 (IN17)
/Dest18: B12.51 (C18), B14.8 (IN18)
/Dest19: B12.52 (C19), B14.7 (IN19)
/Dest20: B12.53 (C20), B14.6 (IN20)
/Dest21: B12.54 (C21), B14.5 (IN21)
/Dest22: B12.55 (C22), B14.4 (IN22)
/Dest23: B12.56 (C23), B14.2 (IN23)
/Lookup0: B1.41 (Y0), B2.19 (M0), B3.19 (M0)
/Lookup1: B1.43 (Y1), B2.18 (M1), B3.18 (M1)
/Lookup2: B1.44 (Y2), B2.17 (M2), B3.17 (M2)
/Lookup3: B1.45 (Y3), B2.16 (M3), B3.16 (M3)
/Lookup4: B1.46 (Y4), B2.15 (M4), B3.15 (M4)
/Lookup5: B1.47 (Y5), B2.14 (M5), B3.14 (M5)
/Lookup6: B1.48 (Y6), B2.13 (M6), B3.13 (M6)
/Lookup7: B1.49 (Y7), B2.12 (M7), B3.12 (M7)
/Lookup8: B1.50 (Y8), B2.11 (M8), B3.11 (M8)
/Lookup9: B1.51 (Y9), B2.10 (M9), B3.10 (M9)
/Lookup10: B1.52 (Y10), B2.9 (M10), B3.9 (M10)
/Lookup11: B1.53 (Y11), B2.8 (M11), B3.8 (M11)
/Lookup12: B1.54 (Y12), B2.7 (M12), B3.7 (M12)
/Lookup13: B1.56 (Y13), B2.6 (M13), B3.6 (M13)
/Lookup14: B1.57 (Y14), B2.5 (M14), B3.5 (M14)
/MCLK: B8.2 (Interrupt_CLK), B19.32 (MCLK)
/MD0: B7.7 (D7), B20.20 (MD0)
/MD1: B7.8 (D6), B20.22 (MD1)
/MD2: B7.9 (D5), B20.23 (MD2)
/MD3: B7.10 (D4), B20.24 (MD3)
/MD4: B7.11 (D3), B20.25 (MD4)
/MD5: B7.13 (D2), B20.26 (MD5)
/MD6: B7.14 (D1), B20.27 (MC6)
/MD7: B7.15 (D0), B20.29 (MD7)
/Offset0: B2.24 (LQ0), B6.15 (A0)
/Offset1: B2.25 (LQ1), B6.14 (A1)
/Offset2: B2.26 (LQ2), B6.13 (A2)
/Offset3: B2.27 (LQ3), B6.12 (A3)
/Offset4: B2.28 (LQ4), B6.11 (A4)
/Offset5: B2.29 (LQ5), B6.10 (A5)
/Offset6: B2.30 (LQ6), B6.8 (A6)
/Offset7: B2.31 (LQ7), B6.7 (A7)
/Offset8: B3.24 (LQ0), B6.6 (A8)
/Offset9: B3.25 (LQ1), B6.5 (A9)
/Offset10: B3.26 (LQ2), B6.4 (A10)
/Offset11: B3.27 (LQ3), B6.2 (A11)
/Offset12: B3.28 (LQ4), B6.1 (A12)
/Offset13: B3.29 (LQ5), B6.56 (A13)
/Offset14: B3.30 (LQ6), B6.55 (A14)
/Offset15: B3.31 (LQ7), B6.54 (A15)
/Read Count Offset High: B5.1 (Read_Count_High), B9.6 (Y5_{R})
/Read Count Offset Low: B5.2 (Read_Count_Low), B9.7 (Y4_{R})
/Read Flags: B8.6 (Read_Flags), B15.32 (Y0_{R})
/Read Source Address Bank: B9.30 (Y2_{R}), B13.24 (Read_Bank)
/Read Source Address High: B9.31 (Y1_{R}), B13.25 (Read_High)
/Read Source Address Low: B9.32 (Y0_{R}), B13.26 (Read_Low)
/Read Transparent Colour: B15.30 (Y2_{R}), B20.15 (Read_Transparent_Colour)
/Source0: B6.33 (B0), B13.29 (Q0)
/Source1: B6.32 (B1), B13.30 (Q1)
/Source2: B6.30 (B2), B13.32 (Q2)
/Source3: B6.29 (B3), B13.33 (Q3)
/Source4: B6.28 (B4), B13.34 (Q4)
/Source5: B6.27 (B5), B13.35 (Q5)
/Source6: B6.26 (B6), B13.36 (Q6)
/Source7: B6.25 (B7), B13.38 (Q7)
/Source8: B6.24 (B8), B13.39 (Q8)
/Source9: B6.23 (B9), B13.40 (Q9)
/Source10: B6.22 (B10), B13.41 (Q10)
/Source11: B6.21 (B11), B13.42 (Q11)
/Source12: B6.19 (B12), B13.43 (Q12)
/Source13: B6.18 (B13), B13.44 (Q13)
/Source14: B6.17 (B14), B13.45 (Q14)
/Source15: B6.16 (B15), B13.46 (Q15)
/Source16: B13.47 (Q16), B21.18 (B0)
/Source17: B13.49 (Q17), B21.16 (B1)
/Source18: B13.50 (Q18), B21.15 (B2)
/Source19: B13.51 (Q19), B21.14 (B3)
/Source20: B13.52 (Q20), B21.13 (B4)
/Source21: B13.53 (Q21), B21.11 (B5)
/Source22: B13.54 (Q22), B21.10 (B6)
/Source23: B13.55 (Q23), B21.9 (B7)
/SourceA+O0: B4.28 (IN0), B6.34 (S0)
/SourceA+O1: B4.27 (IN1), B6.35 (S1)
/SourceA+O2: B4.26 (IN2), B6.36 (S2)
/SourceA+O3: B4.25 (IN3), B6.38 (S3)
/SourceA+O4: B4.24 (IN4), B6.39 (S4)
/SourceA+O5: B4.23 (IN5), B6.40 (S5)
/SourceA+O6: B4.22 (IN6), B6.41 (S6)
/SourceA+O7: B4.21 (IN7), B6.42 (S7)
/SourceA+O8: B4.19 (IN8), B6.43 (S8)
/SourceA+O9: B4.18 (IN9), B6.44 (S9)
/SourceA+O10: B4.17 (IN10), B6.45 (S10)
/SourceA+O11: B4.16 (IN11), B6.46 (S11)
/SourceA+O12: B4.15 (IN12), B6.47 (S12)
/SourceA+O13: B4.14 (IN13), B6.49 (S13)
/SourceA+O14: B4.13 (IN14), B6.50 (S14)
/SourceA+O15: B4.12 (IN15), B6.51 (S15)
/SourceA+O16: B4.2 (IN23), B21.20 (S0)
/SourceA+O17: B4.4 (IN22), B21.22 (S1)
/SourceA+O18: B4.5 (IN21), B21.23 (S2)
/SourceA+O19: B4.6 (IN20), B21.24 (S3)
/SourceA+O20: B4.7 (IN19), B21.25 (S4)
/SourceA+O21: B4.8 (IN18), B21.26 (S5)
/SourceA+O22: B4.10 (IN17), B21.27 (S6)
/SourceA+O23: B4.11 (IN16), B21.29 (S7)
/Transparency Enable: B8.18 (F0), B20.16 (Transparency_Enable)
/Transparent: B19.8 (Transparent), B20.31 (Transparent)
/Write Clear Interrupt: B8.3 (Write_Clear_Interrupt), B15.26 (Y1_{W})
/Write Count Offset Start High: B5.19 (Write_Start_High), B9.22 (Y5_{W})
/Write Count Offset Start Low: B5.20 (Write_Start_Low), B9.23 (Y4_{W})
/Write Count Offset Stop High: B9.19 (Y7_{W}), B17.19 (Write_A_High)
/Write Count Offset Stop Low: B9.20 (Y6_{W}), B17.20 (Write_A_Low)
/Write Dest Address Bank: B12.21 (Latch_Bank), B15.20 (Y6_{W})
/Write Dest Address High: B12.22 (Latch_High), B15.22 (Y5_{W})
/Write Dest Address Low: B12.23 (Latch_Low), B15.23 (Y4_{W})
/Write Flags: B8.7 (Write_Flags), B15.27 (Y0_{W})
/Write Source Address Bank: B9.25 (Y2_{W}), B13.21 (Latch_Bank)
/Write Source Address High: B9.26 (Y1_{W}), B13.22 (Latch__High)
/Write Source Address Low: B9.27 (Y0_{W}), B13.23 (Latch_Low)
/Write Start: B15.19 (Y7_{W}), B19.3 (Write_Start)
/Write Transparent Colour: B15.25 (Y2_{W}), B20.14 (Write_Transparent_Colour)
/~A3: B9.8 (~E2), B11.20 (~A3)
/~A4: B9.9 (E3), B11.22 (~A4), B15.9 (E3)
/~Device RAM: B1.17 (S), B10.2 (~Device_RAM), B11.23 (~Device_RAM), B18.7 (~Device_RAM)
/~Device ROM: B10.5 (~Device_ROM), B11.25 (~Device_ROM), IC2.22 (~CE)
/~Device Registers: B9.4 (~Device_Registers), B10.3 (~Device_Registers), B11.24 (~Device_Registers), B15.4 (~Device_Registers)
/~Device Select: B10.11 (~Device_Select), B11.2 (~Device_Select), B16.33 (Deivce_~CS)
/~Done: B8.4 (~Set_Interrupt_on_CLK), B17.40 (~C=A), B19.4 (~Done)
/~Load Count Start: B5.5 (~Load_Count_Start), B19.29 (~Load_Count_Start)
/~Main Read: B4.1 (~OE), B7.4 (~Main_Read), B19.11 (~Main_Read), B20.2 (~Main_Read)
/~Main Write: B7.6 (~Main_Write), B14.1 (~OE), B19.16 (~Main_Write)
/~RD: B9.15 (~RD), B10.10 (~RD), B15.15 (~RD), B16.46 (~RD), B18.11 (~RD), IC2.24 (~OE)
/~RD+~Device RAM 1: B2.3 (M~OE), B18.20 (~RD+~Device_RAM_1)
/~RD+~Device RAM 2: B3.3 (M~OE), B18.19 (~RD+~Device_RAM_2)
/~Reset: B5.6 (~Reset), B11.19 (~Reset_{OUT}), B12.1 (~Reset)
/~WD: B9.16 (~WD), B10.12 (~WD), B15.16 (~WD), B16.45 (~WD), B18.13 (~WD), IC2.31 (~WE)
/~WD+~Device RAM 1: B2.2 (T~DIR), B2.4 (M~WE), B18.25 (~WD+~Device_RAM_1)
/~WD+~Device RAM 2: B3.2 (T~DIR), B3.4 (M~WE), B18.23 (~WD+~Device_RAM_2)
/~Write: B19.15 (~Write), B20.3 (~Write)
AD0: B16.1 (A0_{IN}), J5.A4
AD1: B16.2 (A1_{IN}), J5.A5
AD2: B16.4 (A2_{IN}), J5.A6
AD3: B16.5 (A3_{IN}), J5.A7
AD4: B16.6 (A4_{IN}), J5.A8
AD5: B16.7 (A5_{IN}), J5.A9
AD6: B16.8 (A6_{IN}), J5.A10
AD7: B16.9 (A7_{IN}), J5.A11
AD8: B16.11 (A8_{IN}), J5.A12
AD9: B16.12 (A9_{IN}), J5.A13
AD10: B16.13 (A10_{IN}), J5.A14
AD11: B16.14 (A11_{IN}), J5.A15
AD12: B16.15 (A12_{IN}), J5.A16
AD13: B16.16 (A13_{IN}), J5.A17
AD14: B16.17 (A14_{IN}), J5.A18
AD15: B16.19 (A16_{IN}), J5.A19
AD16: B16.18 (A15_{IN}), J5.A20
AM0: B4.29 (OUT0), B14.29 (OUT0), J5.D17
AM1: B4.30 (OUT1), B14.30 (OUT1), J5.D16
AM2: B4.32 (OUT2), B14.32 (OUT2), J5.D15
AM3: B4.33 (OUT3), B14.33 (OUT3), J5.D14
AM4: B4.34 (OUT4), B14.34 (OUT4), J5.D13
AM5: B4.35 (OUT5), B14.35 (OUT5), J5.D12
AM6: B4.36 (OUT6), B14.36 (OUT6), J5.C18
AM7: B4.38 (OUT7), B14.38 (OUT7), J5.C17
AM8: B4.39 (OUT8), B14.39 (OUT8), J5.C16
AM9: B4.40 (OUT9), B14.40 (OUT9), J5.C15
AM10: B4.41 (OUT10), B14.41 (OUT10), J5.C14
AM11: B4.42 (OUT11), B14.42 (OUT11), J5.C13
AM12: B4.43 (OUT12), B14.43 (OUT12), J5.C12
AM13: B4.44 (OUT13), B14.44 (OUT13), J5.C11
AM14: B4.45 (OUT14), B14.45 (OUT14), J5.C10
AM15: B4.46 (OUT15), B14.46 (OUT15), J5.C9
AM16: B4.47 (OUT16), B14.47 (OUT16), J5.C8
AM17: B4.49 (OUT17), B14.49 (OUT17), J5.C7
AM18: B4.50 (OUT18), B14.50 (OUT18), J5.C6
AM19: B4.51 (OUT19), B14.51 (OUT19), J5.C5
AM20: B4.52 (OUT20), B14.52 (OUT20), J5.C4
AM21: B4.53 (OUT21), B14.53 (OUT21), J5.C3
AM22: B4.54 (OUT22), B14.54 (OUT22), J5.C2
AM23: B4.55 (OUT23), B14.55 (OUT23), J5.C1
DD0: B16.31 (D0_{IN/OUT}), J5.A28
DD1: B16.30 (D1_{IN/OUT}), J5.A27
DD2: B16.29 (D2_{IN/OUT}), J5.A26
DD3: B16.28 (D3_{IN/OUT}), J5.A25
DD4: B16.27 (D4_{IN/OUT}), J5.A24
DD5: B16.26 (D5_{IN/OUT}), J5.A23
DD6: B16.25 (D6_{IN/OUT}), J5.A22
DD7: B16.24 (D7_{IN/OUT}), J5.A21
DM0: B7.26 (MD7), J5.D8
DM1: B7.25 (MD6), J5.D7
DM2: B7.24 (MD5), J5.D6
DM3: B7.23 (MD4), J5.D5
DM4: B7.22 (MD3), J5.D4
DM5: B7.20 (MD2), J5.D3
DM6: B7.19 (MD1), J5.D2
DM7: B7.18 (MD0), J5.D1
Device CLK: J5.B15
D~RD: B16.20 (~RD_{IN}), J5.B13
D~WD: B16.21 (~WD_{IN}), J5.B14
GND: B1.10 (GND), B1.19 (B17), B1.20 (B16), B1.21 (B15), B1.23 (GND), B1.42 (GND), B1.55 (GND), B1.62 (A15), B1.63 (A16), B1.64 (A17), B2.21 (GND), B2.23 (L~OE), B2.40 (GND), B3.21 (GND), B3.23 (L~OE), B3.40 (GND), B4.9 (GND), B4.20 (GND), B4.37 (GND), B4.48 (GND), B5.7 (GND), B5.14 (GND), B5.27 (GND), B5.34 (GND), B6.9 (GND), B6.20 (GND), B6.37 (GND), B6.48 (GND), B7.5 (GND), B7.12 (GND), B7.21 (GND), B7.28 (GND), B8.5 (GND), B8.12 (GND), B8.21 (GND), B8.28 (GND), B9.5 (GND), B9.12 (GND), B9.21 (GND), B9.28 (GND), B10.4 (GND), B10.6 (H2_{REG}), B10.7 (H1_{REG}), B10.9 (GND), B10.16 (GND), B10.21 (GND), B11.5 (GND), B11.12 (GND), B11.21 (GND), B11.28 (GND), B12.9 (GND), B12.20 (GND), B12.37 (GND), B12.48 (GND), B13.1 (~OE), B13.9 (GND), B13.20 (GND), B13.37 (GND), B13.48 (GND), B14.9 (GND), B14.20 (GND), B14.37 (GND), B14.48 (GND), B15.5 (GND), B15.12 (GND), B15.21 (GND), B15.28 (GND), B16.10 (GND), B16.22 (S_{IN}), B16.23 (GND), B16.42 (GND), B16.55 (GND), B17.6 (~OE), B17.7 (GND), B17.14 (GND), B17.27 (GND), B17.34 (GND), B17.39 (C15), B18.5 (GND), B18.12 (GND), B18.21 (GND), B18.28 (GND), B19.5 (GND), B19.12 (GND), B19.21 (GND), B19.28 (GND), B20.5 (GND), B20.12 (GND), B20.21 (GND), B20.28 (GND), B21.2 (A5), B21.3 (A4), B21.4 (A3), B21.5 (GND), B21.6 (A2), B21.7 (A1), B21.8 (A0), B21.12 (GND), B21.21 (GND), B21.28 (GND), B21.31 (A7), B21.32 (A6), C1.2, C2.2, H1.1 (GND), H9.1 (GND), H19.1 (GND), IC1.1 (GND), IC2.2 (A16), IC2.3 (A15), IC2.16 (GND), J5.B2, J5.B10, J5.B17, J5.B24, J5.B31, J5.D9, J5.D18, LED1.1 (K)
HD0: B10.17 (H0_{OUT}), J5.A31
HD1: B10.18 (H1_{OUT}), J5.A30
HD2: B10.19 (H2_{OUT}), J5.A29
Main CLK: B19.2 (CLK_{M}), J5.B3
unnamed: B6.52 (C15), B21.19 (C0)
unnamed: LED1.2 (A), R3.1
~Device CLK: J5.B16
~Device Enable: B8.26 (~Enable), J5.B22
~Device Interrupt: B8.29 (~INT), J5.B19
~Main Access: B19.6 (~Main_Access), J5.B11
~Main RD: B19.18 (M~RD), J5.D10
~Main WD: B19.14 (M~WD), J5.D11
~Main: B19.27 (~Main), J5.B9
~Memory A: J5.B29
~Memory B: J5.B30
~Reset Device: B11.15 (~Reset_{IN1}), J5.B20
~Reset System: B11.14 (~Reset_{IN2}), J5.A1
~Select Device: B16.32 (Deivce_~CS_{IN}), J5.B21

Notes on the sheet:
CLK1 ticks Source Lookup Address Offset
CLK0 loads Destination Address
CLK1 ticks Destination Address
CLK0 loads Source Address
CLK1 latches Source Lookup Address Offset

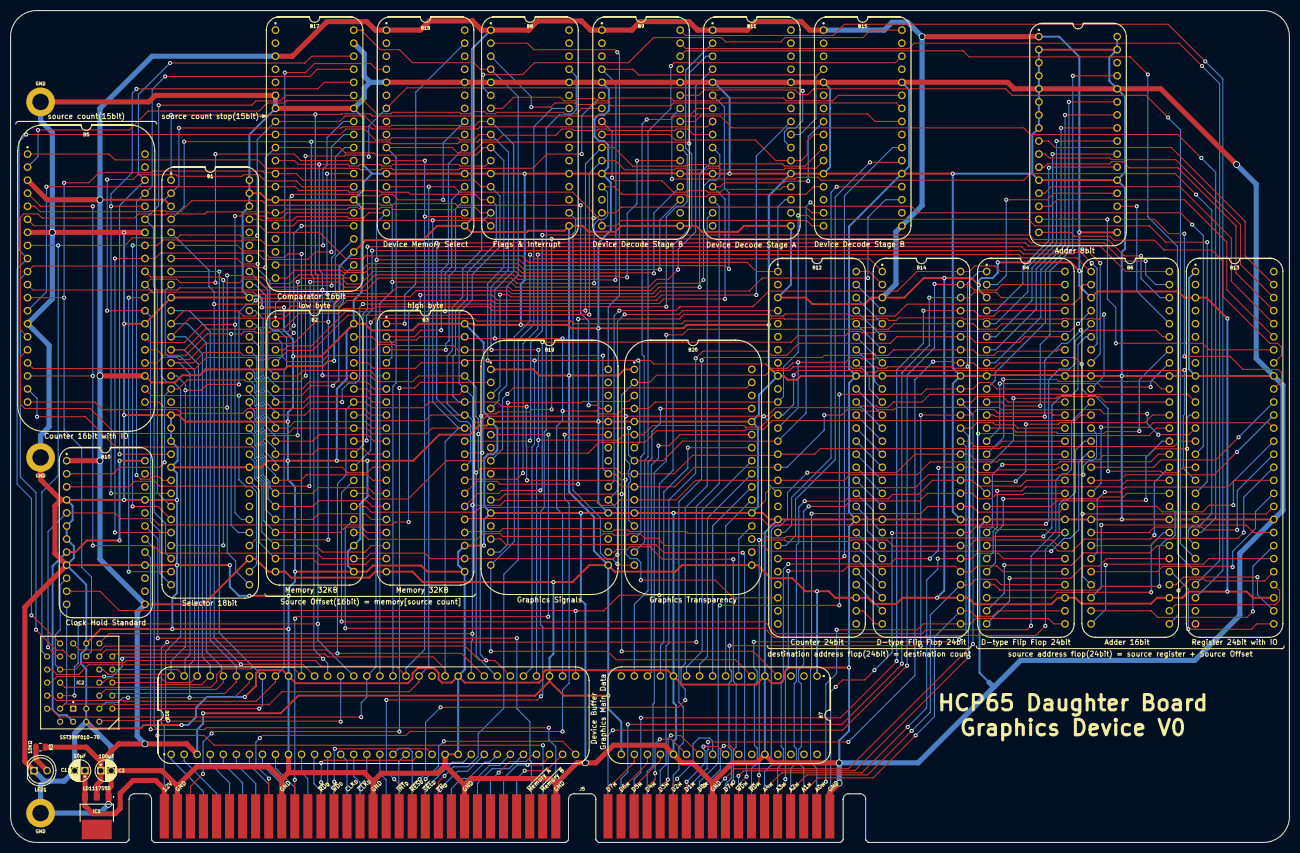
[picture p216: board Graphics Board.kicad_pcb from above]

Board: 2 copper layers, 248.9 x 161.9 mm, 31 parts (0 on the bottom side), 276 nets.
