andrewpaterson/658-Computer/Kicad/Computer/Power/Power and Reset/Power and Reset.kicad_pcb

## KiCad design Kicad/Computer/Power/Power and Reset/Power and Reset.kicad_pcb (2026-07-01)

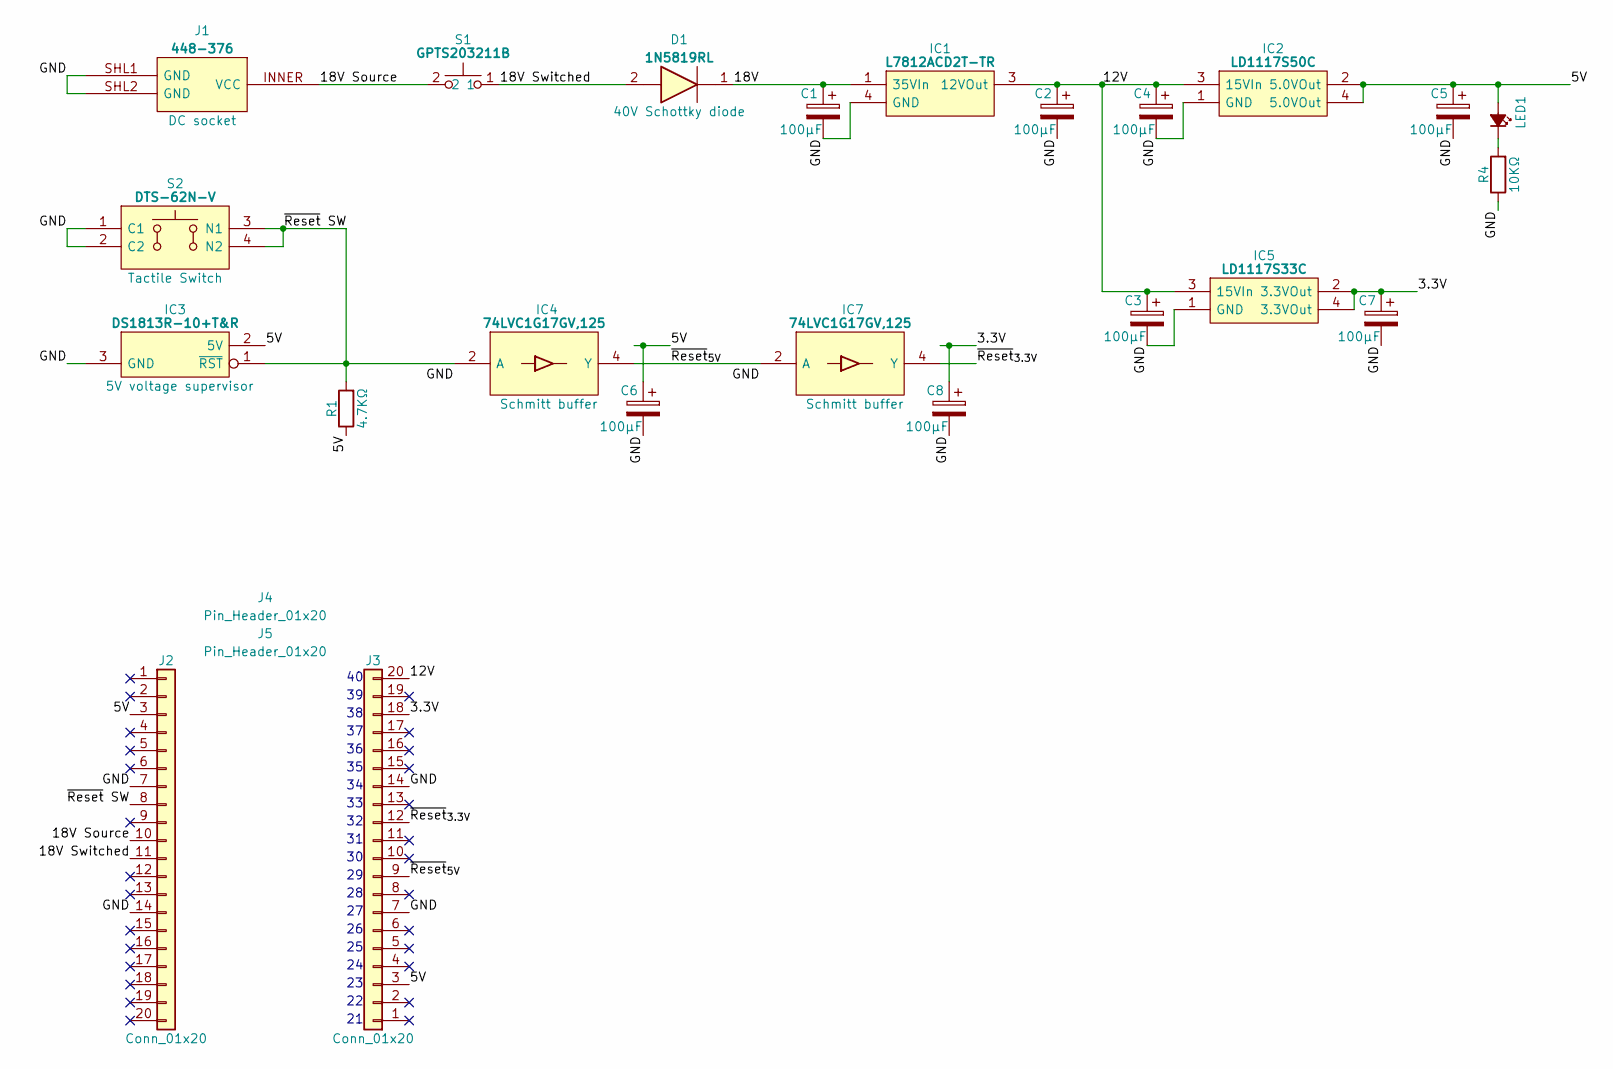
[picture p217: schematic Power and Reset.kicad_sch]

Parts:
C1, C2, C3, C4, C5, C6, C7, C8: 100μF; CP_Radial_D6.3mm_P2.50mm
D1: 1N5819RL; DIOAD1414W86L464D238; Manufacturer_Part_Number 1N5819RL; Mouser Part Number 511-1N5819-TR
IC1: L7812ACD2T-TR; TO254P1542X460-3N; Manufacturer_Part_Number L7812ACD2T-TR
IC2: LD1117S50C; LD1117S33C; Manufacturer_Part_Number LD1117S50C
IC3: DS1813R-10+T&R; SOT95P237X112-3N; Mouser Part Number 700-DS1813R-10T&R
IC4, IC7: 74LVC1G17GV,125; SOT95P275X110-5N; Manufacturer_Part_Number 74LVC1G17GV,125
IC5: LD1117S33C; Manufacturer_Part_Number LD1117S33C
J1: 448-376; 448376; Manufacturer_Part_Number 448-376
J2, J3: Conn_01x20; SIP_20_Pins
J4, J5: Pin_Header_01x20; PinHeader_1x20_P2.54mm_Vertical
LED1: LED_Small_Filled; LED_D5.0mm
R1: 4.7KΩ; R_Axial_DIN0204_L3.6mm_D1.6mm_P5.08mm_Horizontal
R4: 10KΩ; R_Axial_DIN0204_L3.6mm_D1.6mm_P5.08mm_Horizontal
S1: GPTS203211B; Manufacturer_Part_Number GPTS203211B; Mouser Part Number 629-GPTS203211B
S2: DTS-62N-V; DTS62NV; Manufacturer_Part_Number DTS-62N-V; Mouser Part Number 113-DTS-62N-V

Connections:
/3.3V: C7.1, C8.1, IC5.2 (3.3VOut), IC5.4 (3.3VOut), IC7.5 (3V), J3.18
/5V: C5.1, C6.1, IC2.2 (5.0VOut), IC2.4 (5.0VOut), IC3.2 (5V), IC4.5 (3V), J2.3, J3.3, LED1.2 (A), R1.1
/12V: C2.1, C3.1, C4.1, IC1.3 (12VOut), IC2.3 (15VIn), IC5.3 (15VIn), J3.20
/18V: C1.1, D1.1, IC1.1 (35VIn)
/18V Source: J1.INNER (VCC), J2.10, S1.2
/18V Switched: D1.2, J2.11, S1.1
/GND: C1.2, C2.2, C3.2, C4.2, C5.2, C6.2, C7.2, C8.2, IC1.4 (GND), IC2.1 (GND), IC3.3 (GND), IC4.3 (GND), IC5.1 (GND), IC7.3 (GND), J1.SHL1 (GND), J1.SHL2 (GND), J2.7, J2.14, J3.7, J3.14, R4.1, S2.1 (C1), S2.2 (C2)
/~Reset SW: IC3.1 (~RST), IC4.2 (A), J2.8, R1.2, S2.3 (N1), S2.4 (N2)
/~Reset_{3.3V}: IC7.4 (Y), J3.12
/~Reset_{5V}: IC4.4 (Y), IC7.2 (A), J3.9
unnamed: LED1.1 (K), R4.2

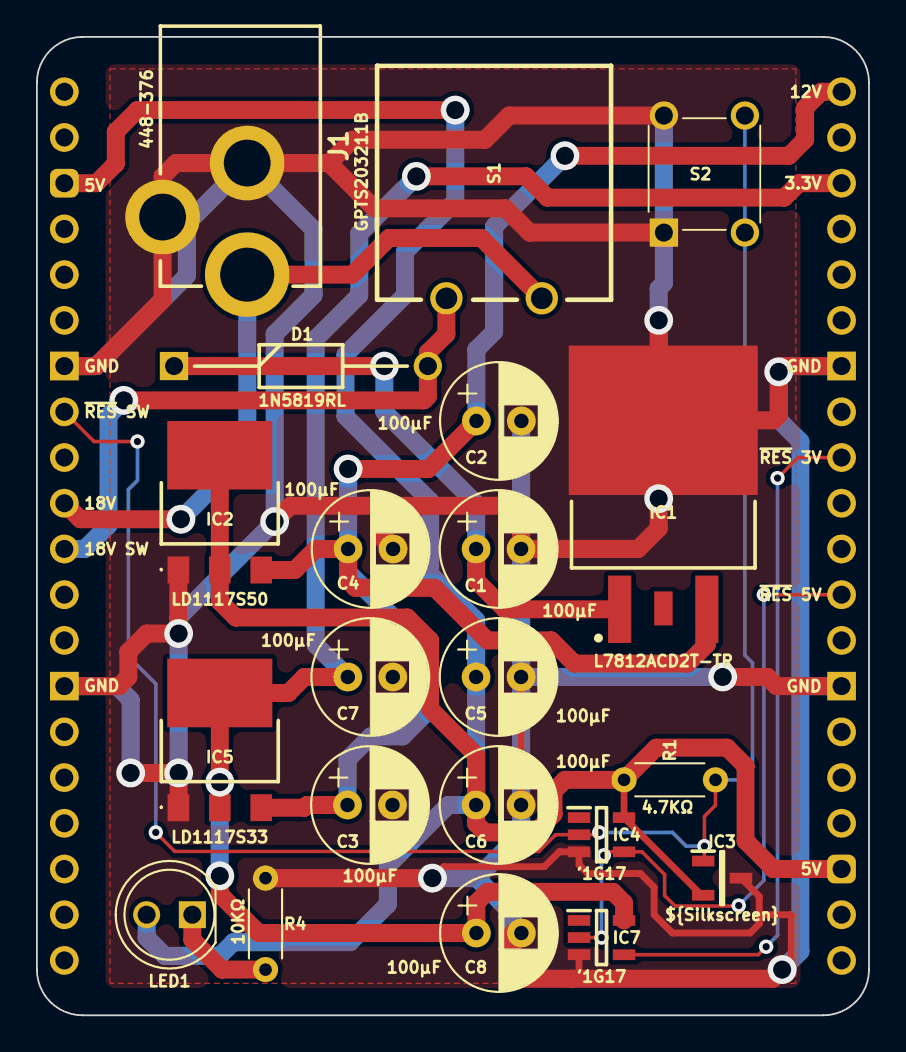
[picture p218: board Power and Reset.kicad_pcb from above]

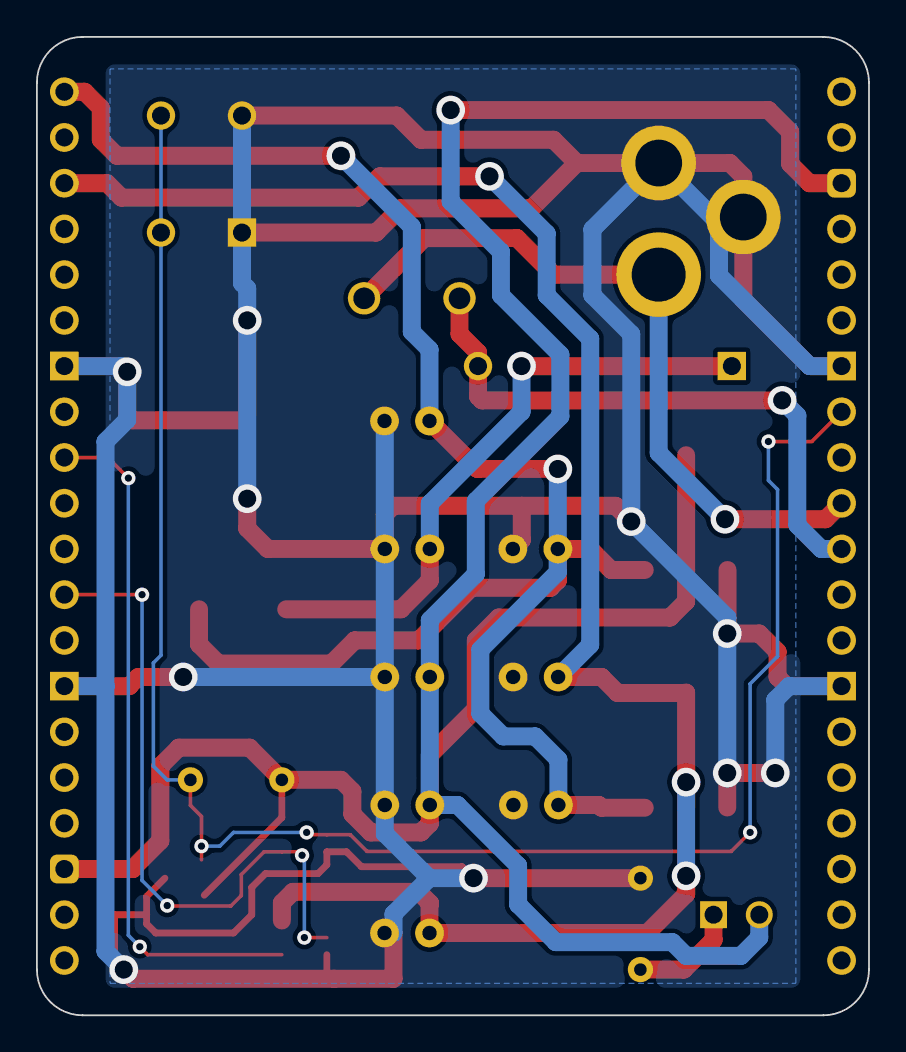
[picture p219: board Power and Reset.kicad_pcb from below]

Board: 2 copper layers, 46.2 x 54.4 mm, 25 parts (2 on the bottom side), 11 nets.
