andrewpaterson/658-Computer/Kicad/Computer/Processor/Clock Hold V1 to V2/Clock Hold V1 to V2.kicad_pcb

## KiCad design Kicad/Computer/Processor/Clock Hold V1 to V2/Clock Hold V1 to V2.kicad_pcb (2026-04-28)

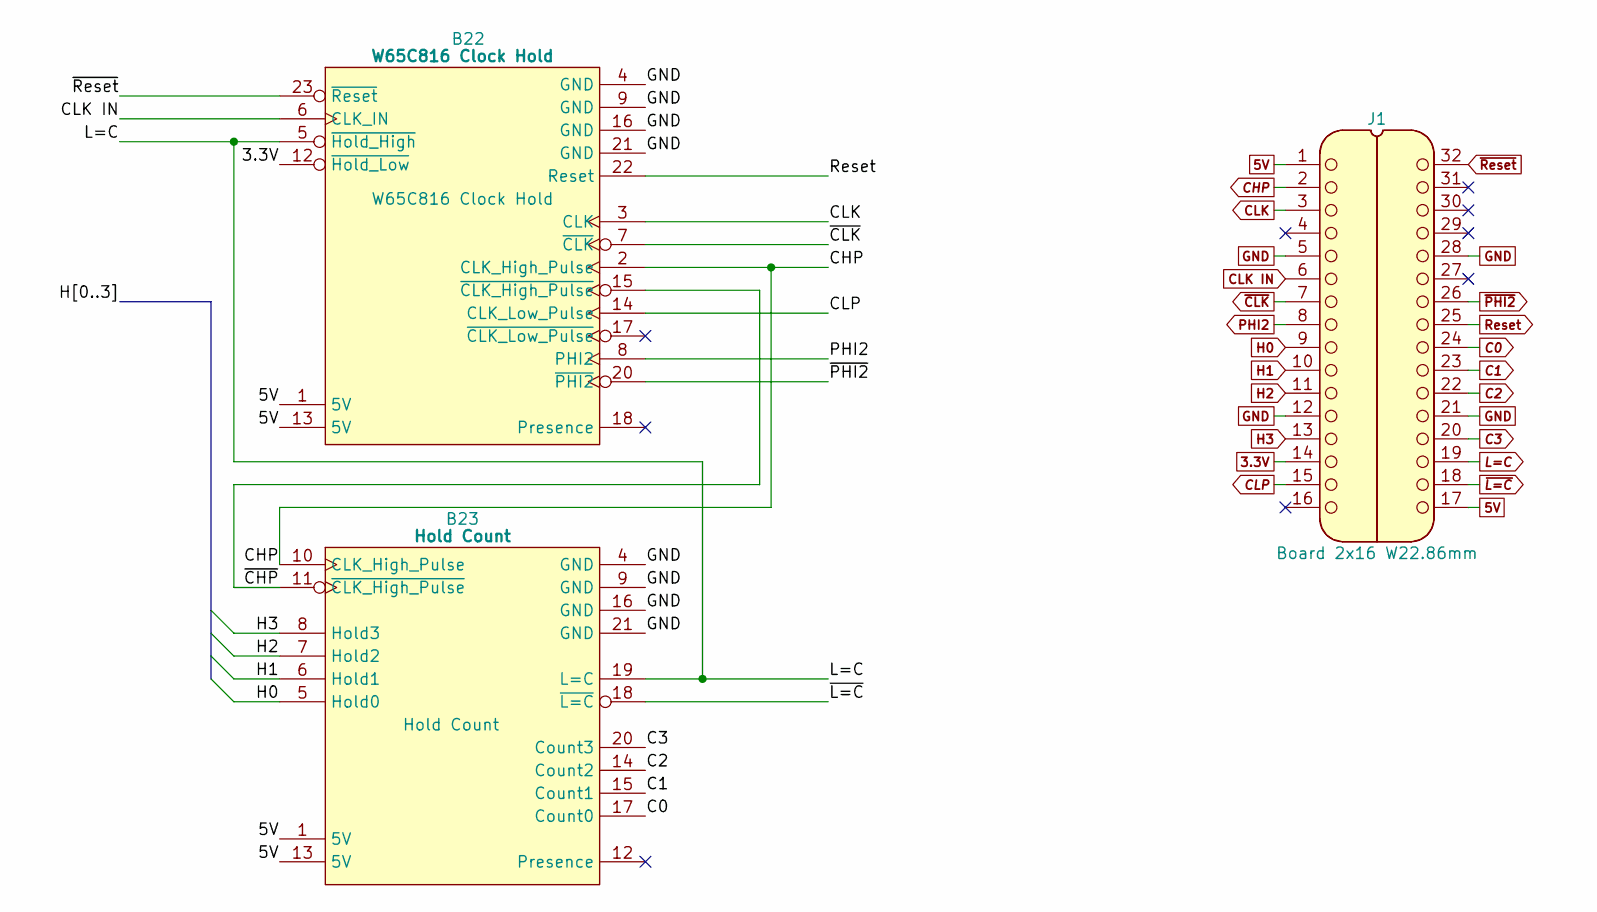
[picture p220: schematic Clock Hold V1 to V2.kicad_sch, W65C816 Clock Hold]

Parts:
B22: W65C816 Clock Hold; HCP65_W65C816_Clock_Hold
B23: Hold Count; HCP65_Hold_Count
J1: Board 2x16 W22.86mm; DIP-32_Board_W22.86mm_Nak

Connections:
3.3V: B22.12 (~Hold_Low), J1.14
5V: B22.1 (5V), B22.13 (5V), B23.1 (5V), B23.13 (5V), J1.1, J1.17
/~CHP: B22.15 (~CLK_High_Pulse), B23.11 (~CLK_High_Pulse)
C0: B23.17 (Count0), J1.24
C1: B23.15 (Count1), J1.23
C2: B23.14 (Count2), J1.22
C3: B23.20 (Count3), J1.20
CHP: B22.2 (CLK_High_Pulse), B23.10 (CLK_High_Pulse), J1.2
CLK: B22.3 (CLK), J1.3
CLK IN: B22.6 (CLK_IN), J1.6
CLP: B22.14 (CLK_Low_Pulse), J1.15
GND: B22.4 (GND), B22.9 (GND), B22.16 (GND), B22.21 (GND), B23.4 (GND), B23.9 (GND), B23.16 (GND), B23.21 (GND), J1.5, J1.12, J1.21, J1.28
H0: B23.5 (Hold0), J1.9
H1: B23.6 (Hold1), J1.10
H2: B23.7 (Hold2), J1.11
H3: B23.8 (Hold3), J1.13
L=C: B22.5 (~Hold_High), B23.19 (L=C), J1.19
PHI2: B22.8 (PHI2), J1.8
Reset: B22.22 (Reset), J1.25
~CLK: B22.7 (~CLK), J1.7
~L=C: B23.18 (~L=C), J1.18
~PHI2: B22.20 (~PHI2), J1.26
~Reset: B22.23 (~Reset), J1.32

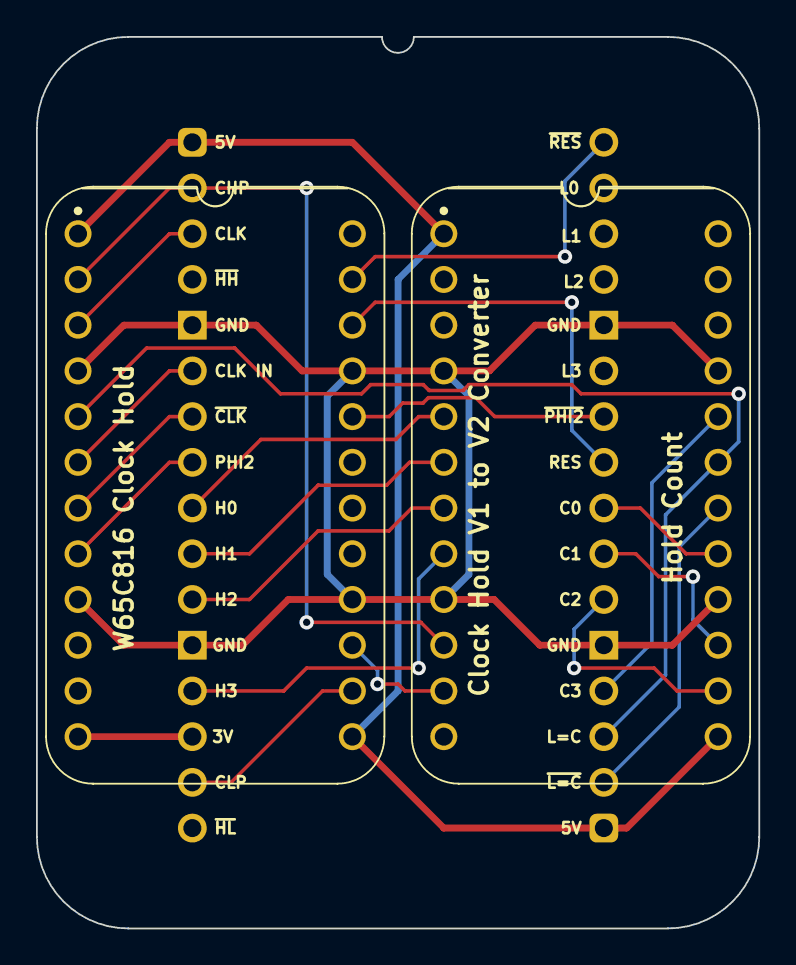
[picture p221: board Clock Hold V1 to V2.kicad_pcb from above]

Board: 2 copper layers, 40.1 x 49.5 mm, 3 parts (0 on the bottom side), 23 nets.
