andrewpaterson/658-Computer/Kicad/Computer/Processor/W65C816 Clock Hold/W65C816 Clock Hold.kicad_pcb

## KiCad design Kicad/Computer/Processor/W65C816 Clock Hold/W65C816 Clock Hold.kicad_pcb (2026-04-28)

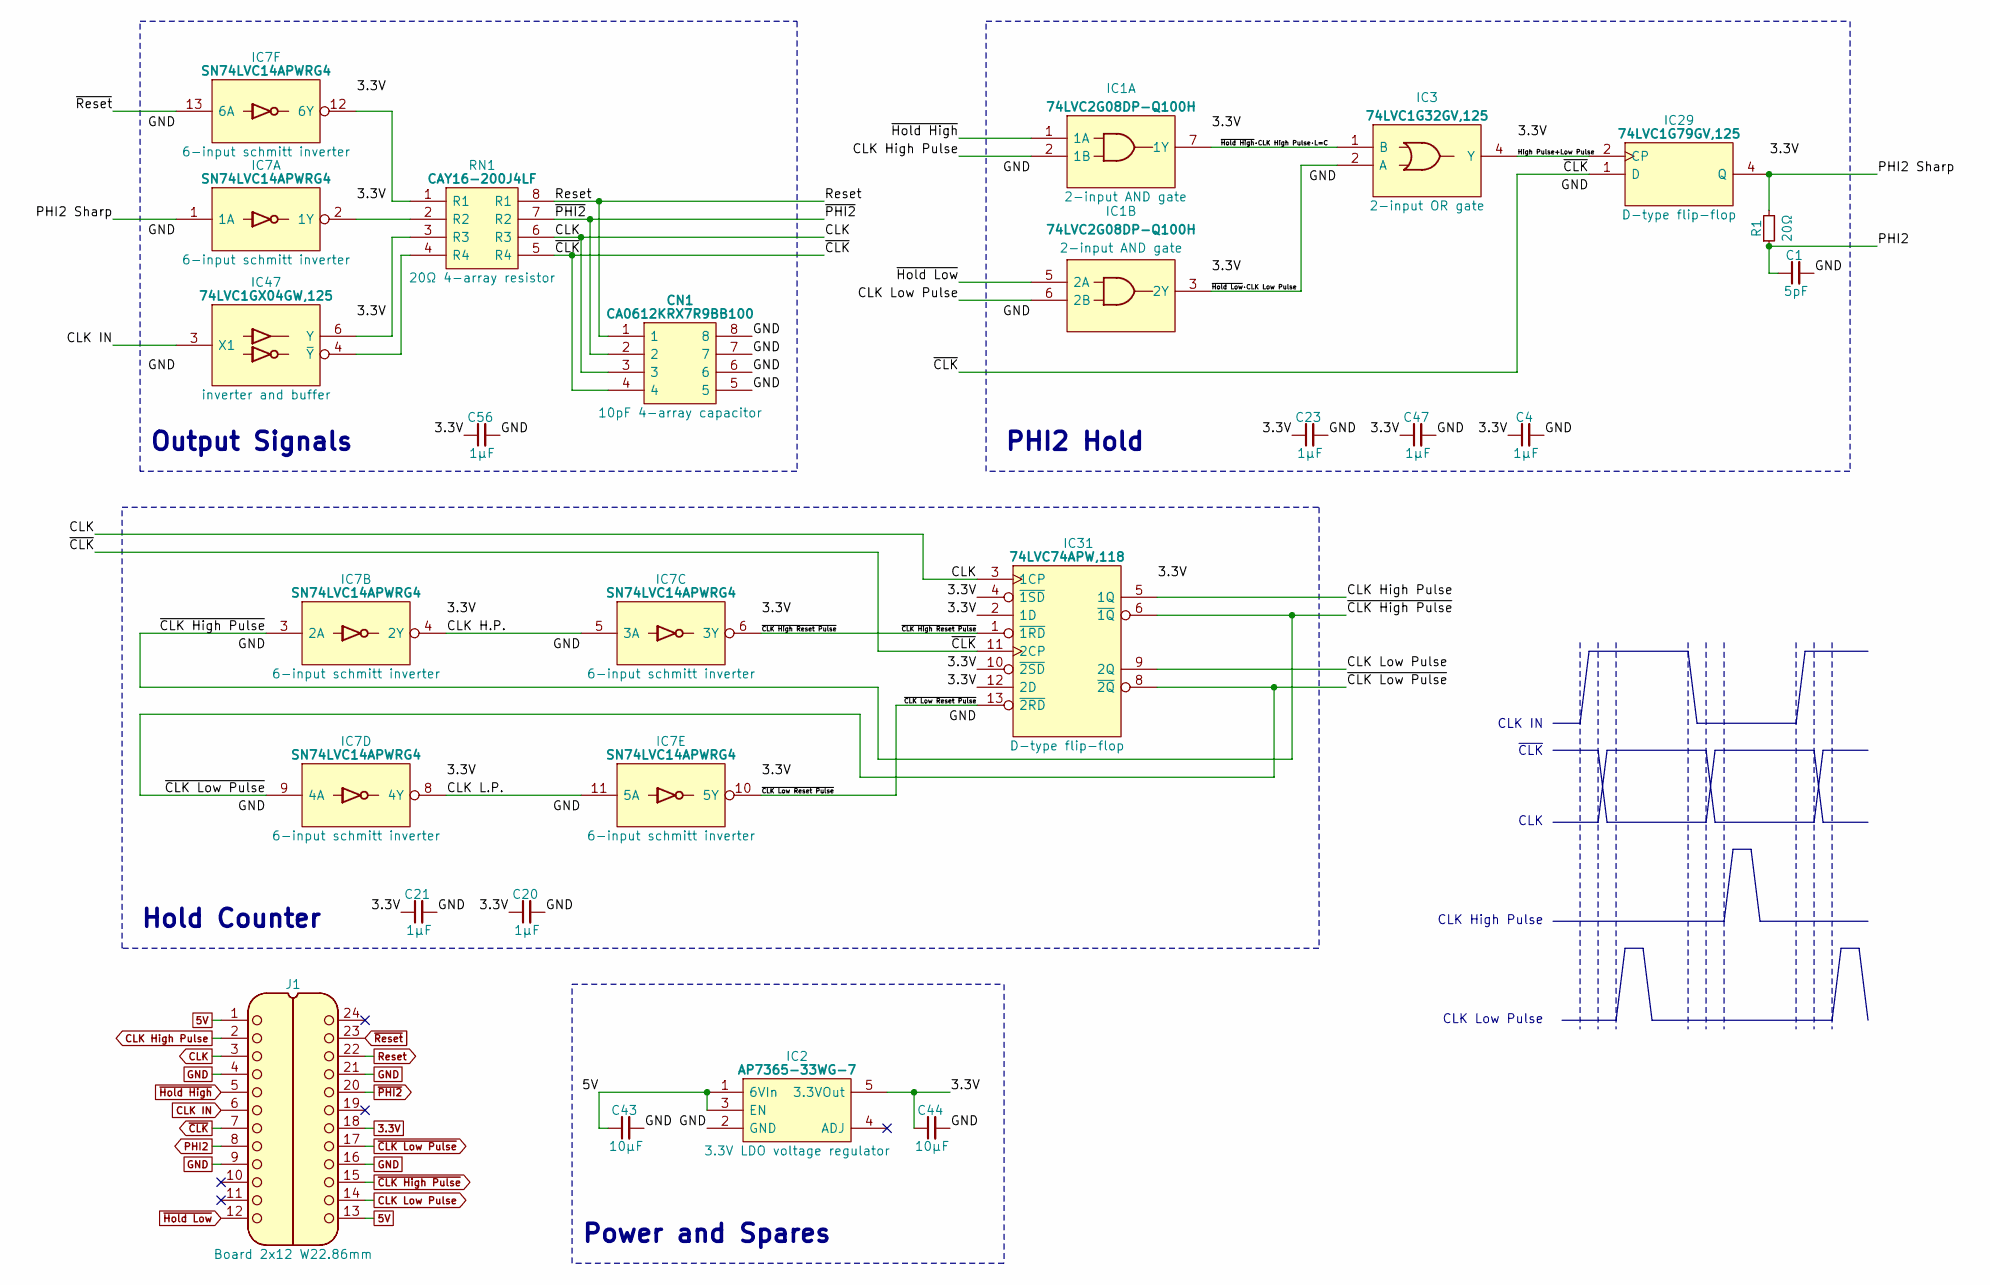
[picture p222: schematic W65C816 Clock Hold.kicad_sch]

Parts:
C1: 5pF; C_0805
C4, C20, C21, C23, C47, C56: 1μF; C_0805
C43, C44: 10μF; C_0805
CN1: CA0612KRX7R9BB100; Manufacturer_Part_Number CA0612KRX7R9BB102; Mouser Part Number 603-CA612KRX7R9BB102
IC1: 74LVC2G08DP-Q100H; SOP65P400X110-8N; Manufacturer_Part_Number 74LVC2G08DP-Q100H; Mouser Part Number 771-74LVC2G08DPQ100H
IC2: AP7365-33WG-7; SOT95P285X130-5N; Manufacturer_Part_Number AP7365-33WG-7; Mouser Part Number 621-AP7365-33WG-7
IC3: 74LVC1G32GV,125; SOT95P275X110-5N; Manufacturer_Part_Number 74LVC1G32GV,125; Mouser Part Number 771-LVC1G32GV125
IC7: SN74LVC14APWRG4; SOP65P640X110-14N; Manufacturer_Part_Number SN74LVC14APWRG4; Mouser Part Number SN74LVC14APWRG4
IC29: 74LVC1G79GV,125; SOT95P275X110-5N; Mouser Part Number 771-LVC1G79GV125
IC31: 74LVC74APW,118; SOP65P640X110-14N; Mouser Part Number 771-74LVC74APW-T
IC47: 74LVC1GX04GW,125; SOP65P210X110-6N; Manufacturer_Part_Number 74LVC1GX04GW,125; Mouser Part Number 771-74LVC1GX04GW-G
J1: Board 2x12 W22.86mm; DIP-24_Board_W15.24mm
R1: 20Ω; R_0805
RN1: CAY16-200J4LF; CAY16-F4; Manufacturer_Part_Number CAY16-331J4LF; Mouser Part Number 652-CAY16-331J4LF

Connections:
3.3V: C4.1, C20.1, C21.1, C23.1, C44.1, C47.1, C56.1, IC1.8 (3V), IC2.5 (3.3VOut), IC3.5 (3V), IC7.14 (3V), IC29.5 (3V), IC31.2 (1D), IC31.4 (~1SD), IC31.10 (~2SD), IC31.12 (2D), IC31.14 (3V), IC47.5 (3V), J1.18
5V: C43.1, IC2.1 (6VIn), IC2.3 (EN), J1.1, J1.13
/CLK H.P.: IC7.4 (2Y), IC7.5 (3A)
/CLK L.P.: IC7.8 (4Y), IC7.11 (5A)
/High Pulse+Low Pulse: IC3.4 (Y), IC29.2 (CP)
/PHI2 Sharp: IC7.1 (1A), IC29.4 (Q), R1.2
/~CLK High Reset Pulse: IC7.6 (3Y), IC31.1 (~1RD)
/~CLK Low Reset Pulse: IC7.10 (5Y), IC31.13 (~2RD)
/~Hold High·CLK High Pulse·L=C: IC1.7 (1Y), IC3.1 (B)
/~Hold Low·CLK Low Pulse: IC1.3 (2Y), IC3.2 (A)
CLK: CN1.3, IC31.3 (1CP), J1.3, RN1.6 (R3)
CLK High Pulse: IC1.2 (1B), IC31.5 (1Q), J1.2
CLK IN: IC47.3 (X1), J1.6
CLK Low Pulse: IC1.6 (2B), IC31.9 (2Q), J1.14
GND: C1.2, C4.2, C20.2, C21.2, C23.2, C43.2, C44.2, C47.2, C56.2, CN1.5, CN1.6, CN1.7, CN1.8, IC1.4 (GND), IC2.2 (GND), IC3.3 (GND), IC7.7 (GND), IC29.3 (GND), IC31.7 (GND), IC47.2 (GND), J1.4, J1.9, J1.16, J1.21
unnamed: IC7.2 (1Y), RN1.2 (R2)
unnamed: IC7.12 (6Y), RN1.1 (R1)
unnamed: IC47.6 (Y), RN1.3 (R3)
unnamed: IC47.4 (~Y), RN1.4 (R4)
PHI2: C1.1, J1.8, R1.1
Reset: CN1.1, J1.22, RN1.8 (R1)
~CLK High Pulse: IC7.3 (2A), IC31.6 (~1Q), J1.15
~CLK Low Pulse: IC7.9 (4A), IC31.8 (~2Q), J1.17
~CLK: CN1.4, IC29.1 (D), IC31.11 (2CP), J1.7, RN1.5 (R4)
~Hold High: IC1.1 (1A), J1.5
~Hold Low: IC1.5 (2A), J1.12
~PHI2: CN1.2, J1.20, RN1.7 (R2)
~Reset: IC7.13 (6A), J1.23

Notes on the sheet:
CLK IN
Output Signals
CLK High Pulse
Power and Spares
CLK
PHI2 Hold
~{CLK}
CLK Low Pulse
Hold Counter

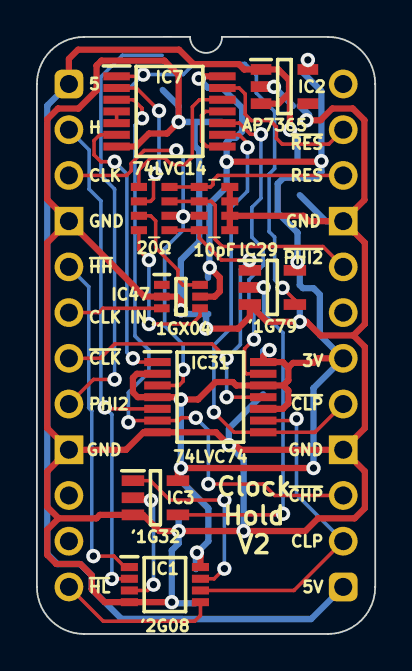
[picture p223: board W65C816 Clock Hold.kicad_pcb from above]

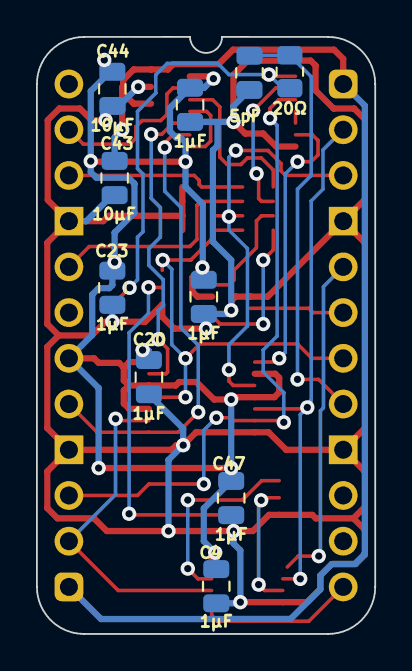
[picture p224: board W65C816 Clock Hold.kicad_pcb from below]

Board: 2 copper layers, 18.8 x 33.2 mm, 20 parts (10 on the bottom side), 28 nets.
