andrewpaterson/658-Computer/Kicad/Computer/Main/Status Device/Status Device.kicad_pcb

## KiCad design Kicad/Computer/Main/Status Device/Status Device.kicad_pcb (2026-03-22)

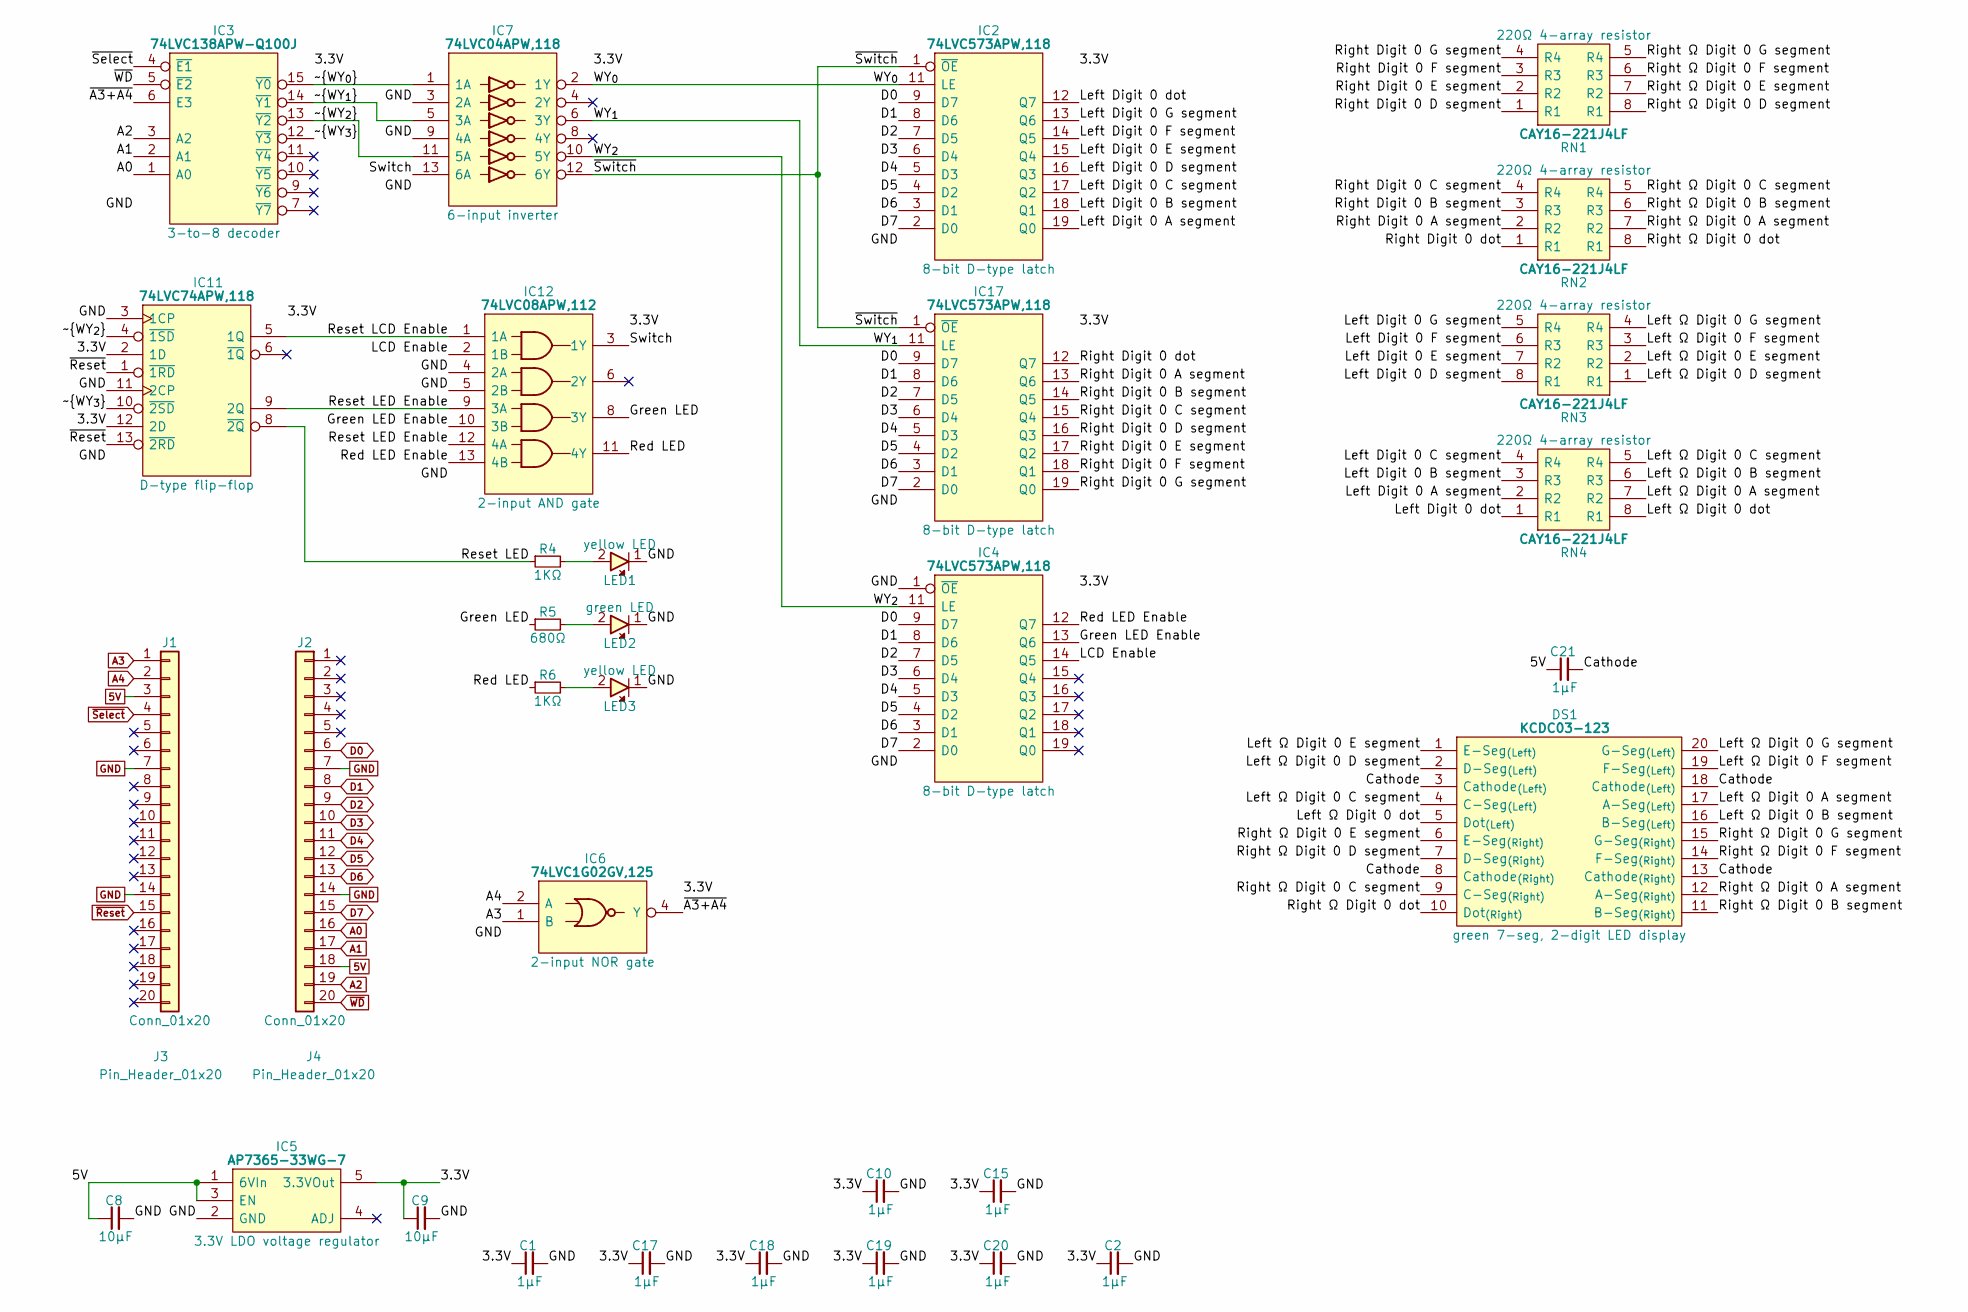
[picture p232: schematic Status Device.kicad_sch]

Parts:
C1, C2, C10, C15, C17, C18, C19, C20: 1μF; C_0805
C8, C9: 10µF; C_0805
C21: 1µF; C_0805
DS1: KCDC03-123; KCDC03123; Manufacturer_Part_Number KCDC03-123; Mouser Part Number N/A
IC2, IC4, IC17: 74LVC573APW,118; SOP65P640X110-20N; Mouser Part Number 771-74LVC573APW-T
IC3: 74LVC138APW-Q100J; SOP65P640X110-16N; Mouser Part Number 771-74LVC138APWQ100J
IC5: AP7365-33WG-7; SOT95P285X130-5N; Manufacturer_Part_Number AP7365-33WG-7; Mouser Part Number 621-AP7365-33WG-7
IC6: 74LVC1G02GV,125; SOT95P275X110-5N; Manufacturer_Part_Number 74LVC1G02GV,125; Mouser Part Number 771-LVC1G02GV125
IC7: 74LVC04APW,118; SOP65P640X110-14N; Manufacturer_Part_Number 74LVC04APW,118; Mouser Part Number 771-74LVC04APW-T
IC11: 74LVC74APW,118; SOP65P640X110-14N; Mouser Part Number 771-74LVC74APW-T
IC12: 74LVC08APW,112; SOP65P640X110-14N; Manufacturer_Part_Number 74LVC08APW,112; Mouser Part Number 771-74LVC08APW
J1, J2: Conn_01x20; SIP_20_Pins
J3, J4: Pin_Header_01x20; PinHeader_1x20_P2.54mm_Vertical
LED1, LED3: 150224YS73100A; 150224BS73100A
LED2: 150224VS73100A; Manufacturer_Part_Number 150224VS73100A; Mouser Part Number 710-150224VS73100A
R4, R6: 1KΩ; R_0805
R5: 680Ω; R_0805
RN1, RN2, RN3, RN4: CAY16-221J4LF; CAY16-F4; Manufacturer_Part_Number CAY16-221J4LF; Mouser Part Number 652-CAY16-221J4LF

Connections:
5V: C8.1, C21.1, IC5.1 (6VIn), IC5.3 (EN), J1.3, J2.18
/3.3V: C1.1, C2.1, C9.1, C10.1, C15.1, C17.1, C18.1, C19.1, C20.1, IC2.20 (3V), IC3.16 (3V), IC4.20 (3V), IC5.5 (3.3VOut), IC6.5 (3V), IC7.14 (3V), IC11.2 (1D), IC11.12 (2D), IC11.14 (3V), IC12.14 (3V), IC17.20 (3V)
/Cathode: C21.2, DS1.3 (Cathode_{(Left)}), DS1.8 (Cathode_{(Right)}), DS1.13 (Cathode_{(Right)}), DS1.18 (Cathode_{(Left)})
/Green LED: IC12.8 (3Y), R5.1
/Green LED Enable: IC4.13 (Q6), IC12.10 (3B)
/LCD Enable: IC4.14 (Q5), IC12.2 (1B)
/Left Digit 0 A segment: IC2.19 (Q0), RN4.2 (R2)
/Left Digit 0 B segment: IC2.18 (Q1), RN4.3 (R3)
/Left Digit 0 C segment: IC2.17 (Q2), RN4.4 (R4)
/Left Digit 0 D segment: IC2.16 (Q3), RN3.8 (R1)
/Left Digit 0 E segment: IC2.15 (Q4), RN3.7 (R2)
/Left Digit 0 F segment: IC2.14 (Q5), RN3.6 (R3)
/Left Digit 0 G segment: IC2.13 (Q6), RN3.5 (R4)
/Left Digit 0 dot: IC2.12 (Q7), RN4.1 (R1)
/Left Ω Digit 0 A segment: DS1.17 (A-Seg_{(Left)}), RN4.7 (R2)
/Left Ω Digit 0 B segment: DS1.16 (B-Seg_{(Left)}), RN4.6 (R3)
/Left Ω Digit 0 C segment: DS1.4 (C-Seg_{(Left)}), RN4.5 (R4)
/Left Ω Digit 0 D segment: DS1.2 (D-Seg_{(Left)}), RN3.1 (R1)
/Left Ω Digit 0 E segment: DS1.1 (E-Seg_{(Left)}), RN3.2 (R2)
/Left Ω Digit 0 F segment: DS1.19 (F-Seg_{(Left)}), RN3.3 (R3)
/Left Ω Digit 0 G segment: DS1.20 (G-Seg_{(Left)}), RN3.4 (R4)
/Left Ω Digit 0 dot: DS1.5 (Dot_{(Left)}), RN4.8 (R1)
/Red LED: IC12.11 (4Y), R6.1
/Red LED Enable: IC4.12 (Q7), IC12.13 (4B)
/Reset LCD Enable: IC11.5 (1Q), IC12.1 (1A)
/Reset LED: IC11.8 (~2Q), R4.1
/Reset LED Enable: IC11.9 (2Q), IC12.9 (3A), IC12.12 (4A)
/Right Digit 0 A segment: IC17.13 (Q6), RN2.2 (R2)
/Right Digit 0 B segment: IC17.14 (Q5), RN2.3 (R3)
/Right Digit 0 C segment: IC17.15 (Q4), RN2.4 (R4)
/Right Digit 0 D segment: IC17.16 (Q3), RN1.1 (R1)
/Right Digit 0 E segment: IC17.17 (Q2), RN1.2 (R2)
/Right Digit 0 F segment: IC17.18 (Q1), RN1.3 (R3)
/Right Digit 0 G segment: IC17.19 (Q0), RN1.4 (R4)
/Right Digit 0 dot: IC17.12 (Q7), RN2.1 (R1)
/Right Ω Digit 0 A segment: DS1.12 (A-Seg_{(Right)}), RN2.7 (R2)
/Right Ω Digit 0 B segment: DS1.11 (B-Seg_{(Right)}), RN2.6 (R3)
/Right Ω Digit 0 C segment: DS1.9 (C-Seg_{(Right)}), RN2.5 (R4)
/Right Ω Digit 0 D segment: DS1.7 (D-Seg_{(Right)}), RN1.8 (R1)
/Right Ω Digit 0 E segment: DS1.6 (E-Seg_{(Right)}), RN1.7 (R2)
/Right Ω Digit 0 F segment: DS1.14 (F-Seg_{(Right)}), RN1.6 (R3)
/Right Ω Digit 0 G segment: DS1.15 (G-Seg_{(Right)}), RN1.5 (R4)
/Right Ω Digit 0 dot: DS1.10 (Dot_{(Right)}), RN2.8 (R1)
/Switch: IC7.13 (6A), IC12.3 (1Y)
/WY_{0}: IC2.11 (LE), IC7.2 (1Y)
/WY_{1}: IC7.6 (3Y), IC17.11 (LE)
/WY_{2}: IC4.11 (LE), IC7.10 (5Y)
/~A3+A4: IC3.6 (E3), IC6.4 (Y)
/~Switch: IC2.1 (~OE), IC7.12 (6Y), IC17.1 (~OE)
/~WY_{0}: IC3.15 (~Y0), IC7.1 (1A)
/~WY_{1}: IC3.14 (~Y1), IC7.5 (3A)
/~WY_{2}: IC3.13 (~Y2), IC7.11 (5A), IC11.4 (~1SD)
/~WY_{3}: IC3.12 (~Y3), IC11.10 (~2SD)
A0: IC3.1 (A0), J2.16
A1: IC3.2 (A1), J2.17
A2: IC3.3 (A2), J2.19
A3: IC6.1 (B), J1.1
A4: IC6.2 (A), J1.2
D0: IC2.9 (D7), IC4.9 (D7), IC17.9 (D7), J2.6
D1: IC2.8 (D6), IC4.8 (D6), IC17.8 (D6), J2.8
D2: IC2.7 (D5), IC4.7 (D5), IC17.7 (D5), J2.9
D3: IC2.6 (D4), IC4.6 (D4), IC17.6 (D4), J2.10
D4: IC2.5 (D3), IC4.5 (D3), IC17.5 (D3), J2.11
D5: IC2.4 (D2), IC4.4 (D2), IC17.4 (D2), J2.12
D6: IC2.3 (D1), IC4.3 (D1), IC17.3 (D1), J2.13
D7: IC2.2 (D0), IC4.2 (D0), IC17.2 (D0), J2.15
GND: C1.2, C2.2, C8.2, C9.2, C10.2, C15.2, C17.2, C18.2, C19.2, C20.2, IC2.10 (GND), IC3.8 (GND), IC4.1 (~OE), IC4.10 (GND), IC5.2 (GND), IC6.3 (GND), IC7.3 (2A), IC7.7 (GND), IC7.9 (4A), IC11.3 (1CP), IC11.7 (GND), IC11.11 (2CP), IC12.4 (2A), IC12.5 (2B), IC12.7 (GND), IC17.10 (GND), J1.7, J1.14, J2.7, J2.14, LED1.1, LED2.1, LED3.1
unnamed: LED1.2, R4.2
unnamed: LED2.2, R5.2
unnamed: LED3.2, R6.2
~Reset: IC11.1 (~1RD), IC11.13 (~2RD), J1.15
~Select: IC3.4 (~E1), J1.4
~WD: IC3.5 (~E2), J2.20

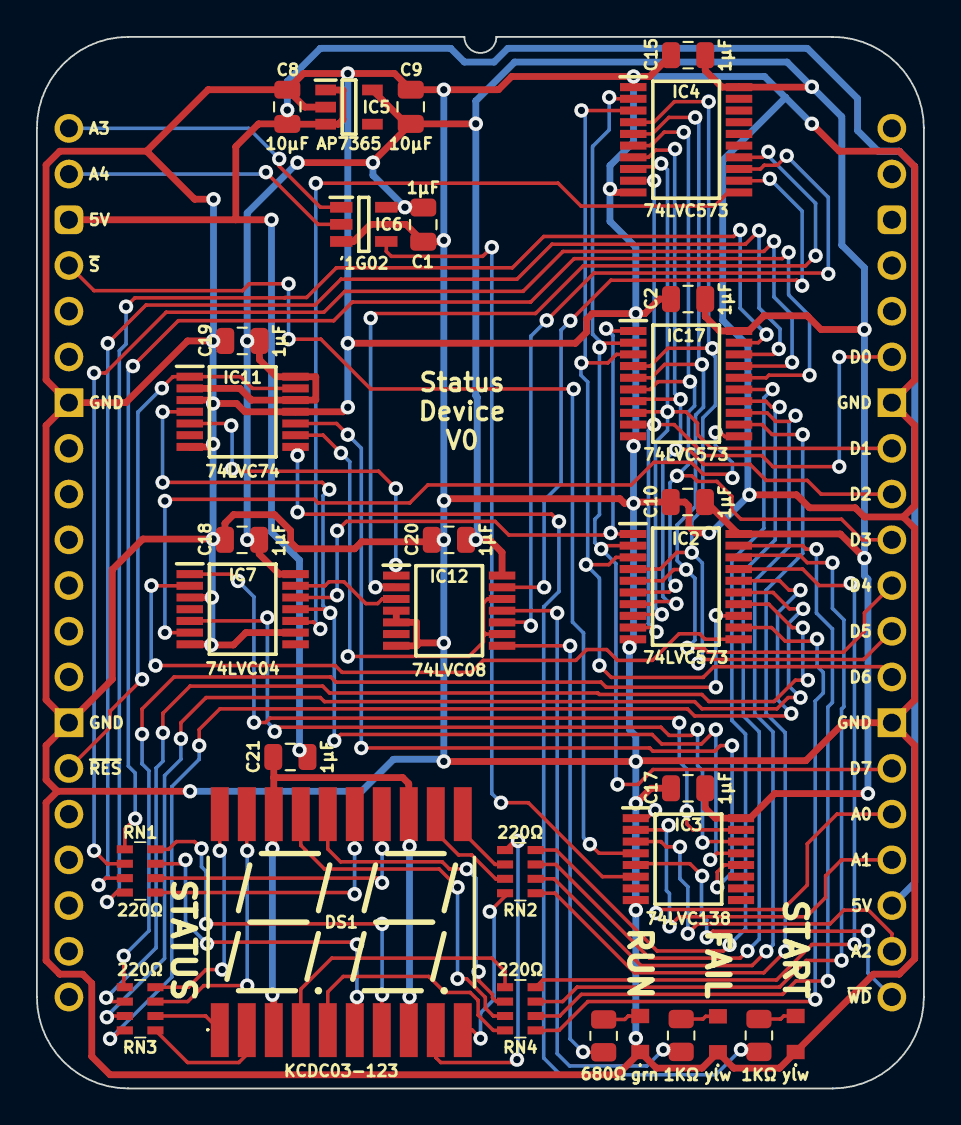
[picture p233: board Status Device.kicad_pcb from above]

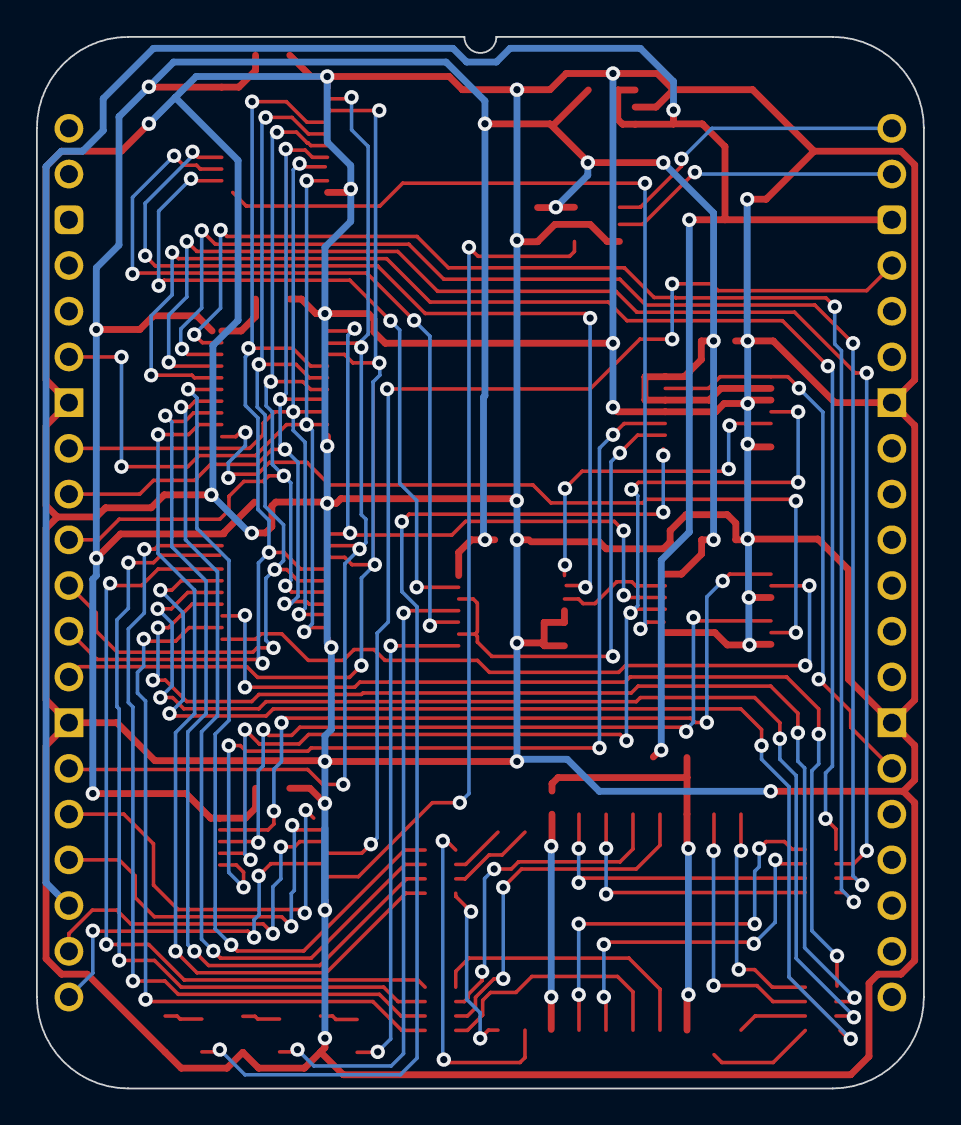
[picture p234: board Status Device.kicad_pcb from below]

Board: 2 copper layers, 49.3 x 58.4 mm, 35 parts (2 on the bottom side), 73 nets.
