andrewpaterson/658-Computer/Kicad/Computer/UART/UART Signals/UART Signals.kicad_pcb

## KiCad design Kicad/Computer/UART/UART Signals/UART Signals.kicad_pcb (2026-03-04)

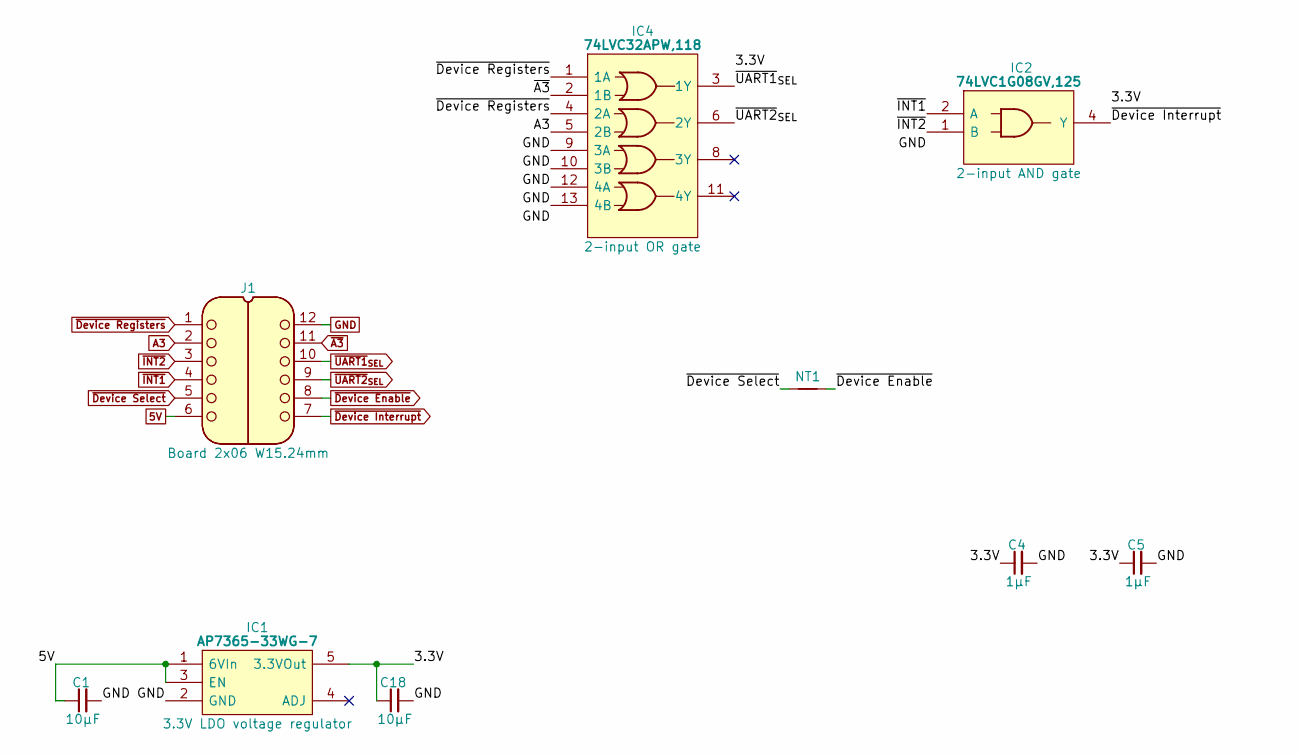
[picture p235: schematic UART Signals.kicad_sch]

Parts:
C1, C18: 10µF; C_0805
C4, C5: 1μF; C_0805
IC1: AP7365-33WG-7; SOT95P285X130-5N; Manufacturer_Part_Number AP7365-33WG-7; Mouser Part Number 621-AP7365-33WG-7
IC2: 74LVC1G08GV,125; SOT95P275X110-5N; Manufacturer_Part_Number 74LVC1G08GV,125; Mouser Part Number 771-74LVC1G08GV
IC4: 74LVC32APW,118; SOP65P640X110-14N; Manufacturer_Part_Number 74LVC32APW,118; Mouser Part Number 771-74LVC32APW-T
J1: Board 2x06 W15.24mm; DIP-12_Board_W15.24mm_Alt
NT1: NetTie; NetTie-2_SMD_Pad0.5mm

Connections:
5V: C1.1, IC1.1 (6VIn), IC1.3 (EN), J1.6
/3.3V: C4.1, C5.1, C18.1, IC1.5 (3.3VOut), IC2.5 (3V), IC4.14 (3V)
A3: IC4.5 (2B), J1.2
GND: C1.2, C4.2, C5.2, C18.2, IC1.2 (GND), IC2.3 (GND), IC4.7 (GND), IC4.9 (3A), IC4.10 (3B), IC4.12 (4A), IC4.13 (4B), J1.12
~A3: IC4.2 (1B), J1.11
~Device Enable: J1.8, NT1.2
~Device Interrupt: IC2.4 (Y), J1.7
~Device Registers: IC4.1 (1A), IC4.4 (2A), J1.1
~Device Select: J1.5, NT1.1
~INT1: IC2.2 (A), J1.4
~INT2: IC2.1 (B), J1.3
~UART1_{SEL}: IC4.3 (1Y), J1.10
~UART2_{SEL}: IC4.6 (2Y), J1.9

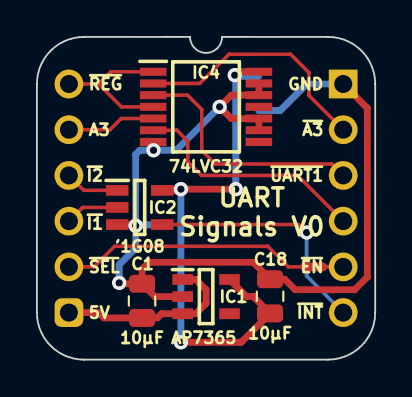
[picture p236: board UART Signals.kicad_pcb from above]

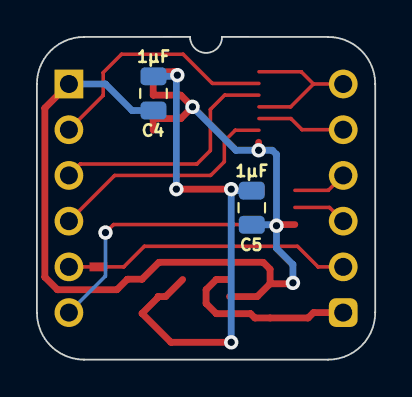
[picture p237: board UART Signals.kicad_pcb from below]

Board: 2 copper layers, 18.8 x 17.9 mm, 9 parts (2 on the bottom side), 13 nets.
