andrewpaterson/658-Computer/Kicad/Computer/UART/UART Board/UART Board.kicad_pcb

## KiCad design Kicad/Computer/UART/UART Board/UART Board.kicad_pcb (2026-03-04)

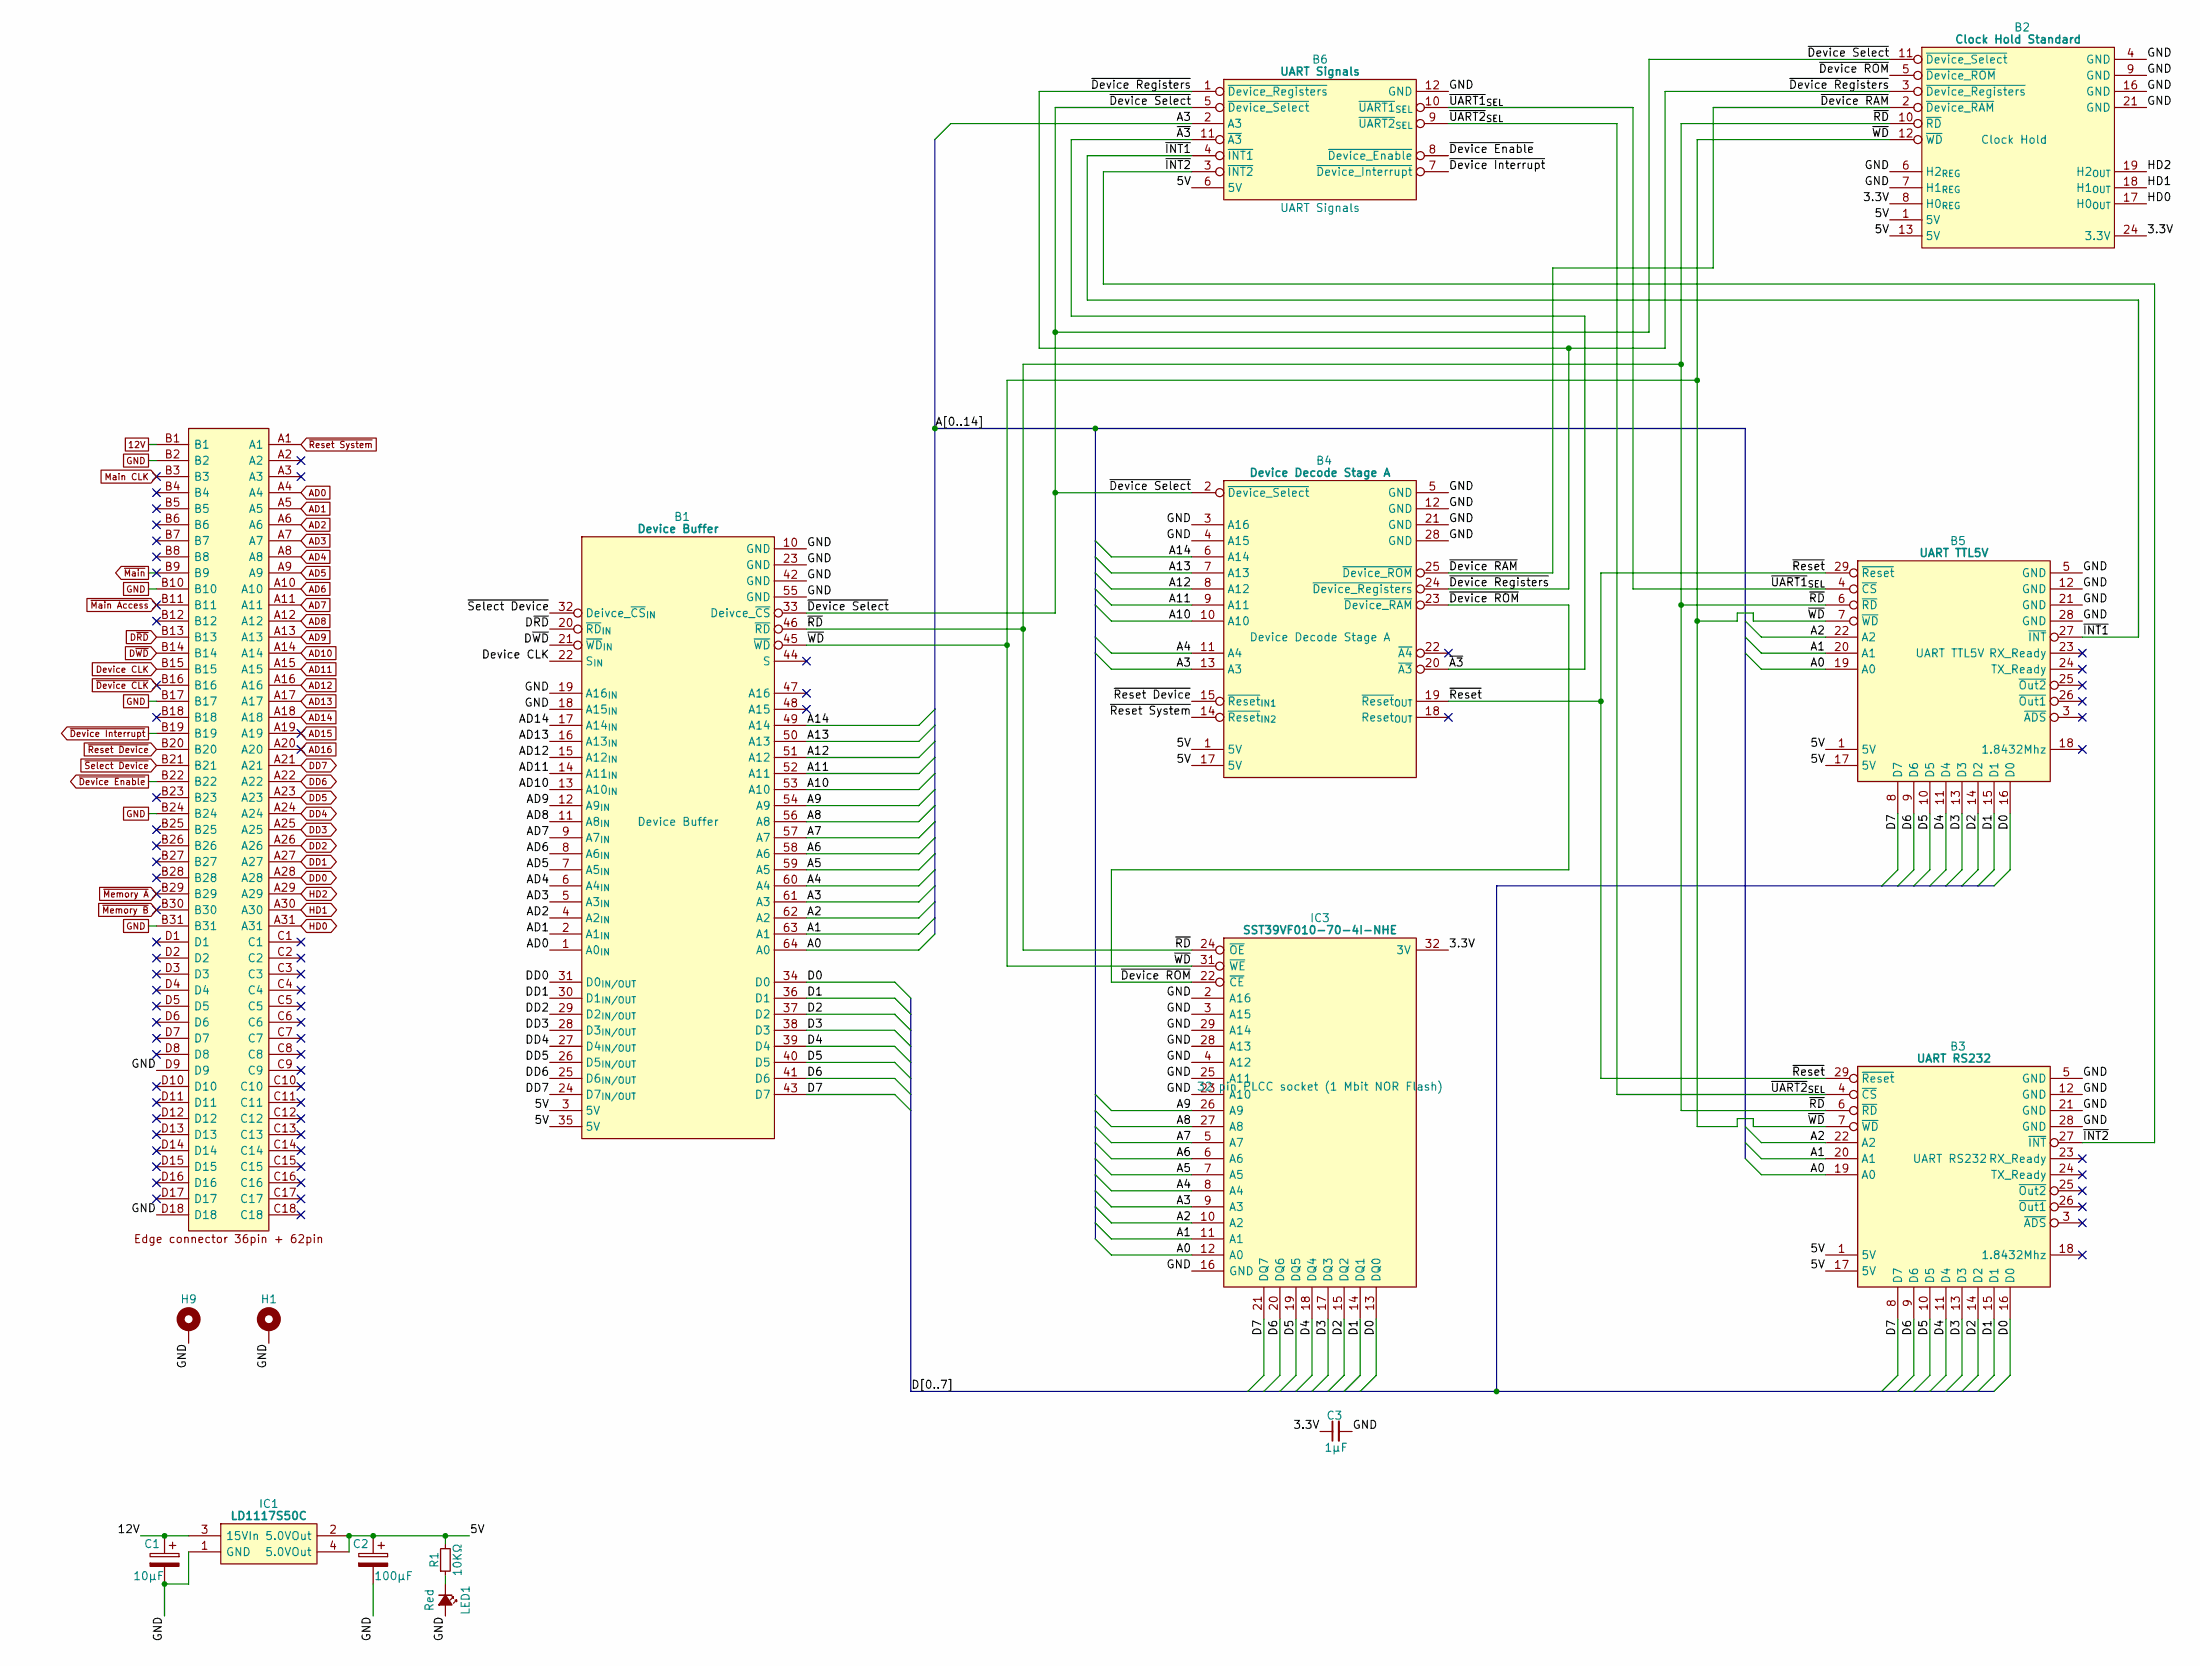
[picture p238: schematic UART Board.kicad_sch, HCP65 UART Board]

Parts:
B1: Device Buffer; HCP65_Device_Buffer
B2: Clock Hold Standard; HCP65_Clock_Hold_Standard
B3: UART RS232; HCP65_RS232_UART
B4: Device Decode Stage A; HCP65_Device_Decode_Stage_A
B5: UART TTL5V; HCP65_TTL5V_UART
B6: UART Signals; HCP65_UART_Signals
C1: 10μF; CP_Radial_D4.0mm_P2.00mm
C2: 100μF; CP_Radial_D4.0mm_P2.00mm
C3: 1μF; C_0805
H1, H9: MountingHole_Pad; HCP65_MountingHole_M3_
IC1: LD1117S50C; LD1117S33C; Manufacturer_Part_Number LD1117S50C
IC3: SST39VF010-70-4I-NHE; 5408803224008; Manufacturer_Part_Number SST39VF010-70-4I-NHE
J5: 395-098-520-350; 98pin Edge Connector; Manufacturer_Part_Number 395-098-520-350; Mouser Part Number 587-395-098-520-350
LED1: Red; LED_D5.0mm
R1: 10KΩ; R_0805

Connections:
12V: C1.1, IC1.3 (15VIn), J5.B1
/3.3V: B2.8 (H0_{REG}), B2.24 (3.3V), C3.1, IC3.32 (3V)
/5V: B1.3 (5V), B1.35 (5V), B2.1 (5V), B2.13 (5V), B3.1 (5V), B3.17 (5V), B4.1 (5V), B4.17 (5V), B5.1 (5V), B5.17 (5V), B6.6 (5V), C2.1, IC1.2 (5.0VOut), IC1.4 (5.0VOut), R1.2
/A0: B1.64 (A0), B3.19 (A0), B5.19 (A0), IC3.12 (A0)
/A1: B1.63 (A1), B3.20 (A1), B5.20 (A1), IC3.11 (A1)
/A2: B1.62 (A2), B3.22 (A2), B5.22 (A2), IC3.10 (A2)
/A3: B1.61 (A3), B4.13 (A3), B6.2 (A3), IC3.9 (A3)
/A4: B1.60 (A4), B4.11 (A4), IC3.8 (A4)
/A5: B1.59 (A5), IC3.7 (A5)
/A6: B1.58 (A6), IC3.6 (A6)
/A7: B1.57 (A7), IC3.5 (A7)
/A8: B1.56 (A8), IC3.27 (A8)
/A9: B1.54 (A9), IC3.26 (A9)
/A10: B1.53 (A10), B4.10 (A10)
/A11: B1.52 (A11), B4.9 (A11)
/A12: B1.51 (A12), B4.8 (A12)
/A13: B1.50 (A13), B4.7 (A13)
/A14: B1.49 (A14), B4.6 (A14)
/D0: B1.34 (D0), B3.16 (D0), B5.16 (D0), IC3.13 (DQ0)
/D1: B1.36 (D1), B3.15 (D1), B5.15 (D1), IC3.14 (DQ1)
/D2: B1.37 (D2), B3.14 (D2), B5.14 (D2), IC3.15 (DQ2)
/D3: B1.38 (D3), B3.13 (D3), B5.13 (D3), IC3.17 (DQ3)
/D4: B1.39 (D4), B3.11 (D4), B5.11 (D4), IC3.18 (DQ4)
/D5: B1.40 (D5), B3.10 (D5), B5.10 (D5), IC3.19 (DQ5)
/D6: B1.41 (D6), B3.9 (D6), B5.9 (D6), IC3.20 (DQ6)
/D7: B1.43 (D7), B3.8 (D7), B5.8 (D7), IC3.21 (DQ7)
/~A3: B4.20 (~A3), B6.11 (~A3)
/~Device RAM: B2.2 (~Device_RAM), B4.25 (~Device_ROM)
/~Device ROM: B2.5 (~Device_ROM), B4.23 (~Device_RAM), IC3.22 (~CE)
/~Device Registers: B2.3 (~Device_Registers), B4.24 (~Device_Registers), B6.1 (~Device_Registers)
/~Device Select: B1.33 (Deivce_~CS), B2.11 (~Device_Select), B4.2 (~Device_Select), B6.5 (~Device_Select)
/~INT1: B5.27 (~INT), B6.4 (~INT1)
/~INT2: B3.27 (~INT), B6.3 (~INT2)
/~RD: B1.46 (~RD), B2.10 (~RD), B3.6 (~RD), B5.6 (~RD), IC3.24 (~OE)
/~Reset: B3.29 (~Reset), B4.19 (~Reset_{OUT}), B5.29 (~Reset)
/~UART1_{SEL}: B5.4 (~CS), B6.10 (~UART1_{SEL})
/~UART2_{SEL}: B3.4 (~CS), B6.9 (~UART2_{SEL})
/~WD: B1.45 (~WD), B2.12 (~WD), B3.7 (~WD), B5.7 (~WD), IC3.31 (~WE)
AD0: B1.1 (A0_{IN}), J5.A4
AD1: B1.2 (A1_{IN}), J5.A5
AD2: B1.4 (A2_{IN}), J5.A6
AD3: B1.5 (A3_{IN}), J5.A7
AD4: B1.6 (A4_{IN}), J5.A8
AD5: B1.7 (A5_{IN}), J5.A9
AD6: B1.8 (A6_{IN}), J5.A10
AD7: B1.9 (A7_{IN}), J5.A11
AD8: B1.11 (A8_{IN}), J5.A12
AD9: B1.12 (A9_{IN}), J5.A13
AD10: B1.13 (A10_{IN}), J5.A14
AD11: B1.14 (A11_{IN}), J5.A15
AD12: B1.15 (A12_{IN}), J5.A16
AD13: B1.16 (A13_{IN}), J5.A17
AD14: B1.17 (A14_{IN}), J5.A18
AD15: J5.A19
AD16: J5.A20
DD0: B1.31 (D0_{IN/OUT}), J5.A28
DD1: B1.30 (D1_{IN/OUT}), J5.A27
DD2: B1.29 (D2_{IN/OUT}), J5.A26
DD3: B1.28 (D3_{IN/OUT}), J5.A25
DD4: B1.27 (D4_{IN/OUT}), J5.A24
DD5: B1.26 (D5_{IN/OUT}), J5.A23
DD6: B1.25 (D6_{IN/OUT}), J5.A22
DD7: B1.24 (D7_{IN/OUT}), J5.A21
Device CLK: B1.22 (S_{IN}), J5.B15
D~RD: B1.20 (~RD_{IN}), J5.B13
D~WD: B1.21 (~WD_{IN}), J5.B14
GND: B1.10 (GND), B1.18 (A15_{IN}), B1.19 (A16_{IN}), B1.23 (GND), B1.42 (GND), B1.55 (GND), B2.4 (GND), B2.6 (H2_{REG}), B2.7 (H1_{REG}), B2.9 (GND), B2.16 (GND), B2.21 (GND), B3.5 (GND), B3.12 (GND), B3.21 (GND), B3.28 (GND), B4.3 (A16), B4.4 (A15), B4.5 (GND), B4.12 (GND), B4.21 (GND), B4.28 (GND), B5.5 (GND), B5.12 (GND), B5.21 (GND), B5.28 (GND), B6.12 (GND), C1.2, C2.2, C3.2, H1.1 (GND), H9.1 (GND), IC1.1 (GND), IC3.2 (A16), IC3.3 (A15), IC3.4 (A12), IC3.16 (GND), IC3.23 (A10), IC3.25 (A11), IC3.28 (A13), IC3.29 (A14), J5.B2, J5.B10, J5.B17, J5.B24, J5.B31, J5.D9, J5.D18, LED1.2 (A)
HD0: B2.17 (H0_{OUT}), J5.A31
HD1: B2.18 (H1_{OUT}), J5.A30
HD2: B2.19 (H2_{OUT}), J5.A29
Main CLK: J5.B3
unnamed: LED1.1 (K), R1.1
~Device CLK: J5.B16
~Device Enable: B6.8 (~Device_Enable), J5.B22
~Device Interrupt: B6.7 (~Device_Interrupt), J5.B19
~Main Access: J5.B11
~Main: J5.B9
~Memory A: J5.B29
~Memory B: J5.B30
~Reset Device: B4.15 (~Reset_{IN1}), J5.B20
~Reset System: B4.14 (~Reset_{IN2}), J5.A1
~Select Device: B1.32 (Deivce_~CS_{IN}), J5.B21

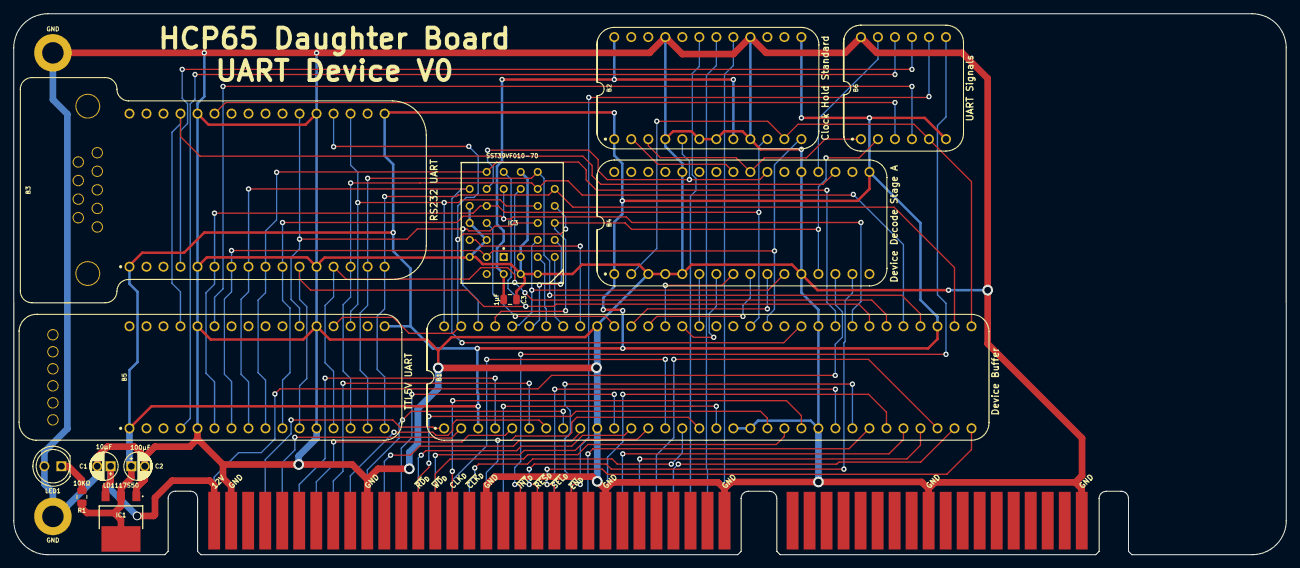
[picture p239: board UART Board.kicad_pcb from above]

Board: 2 copper layers, 190.0 x 80.8 mm, 16 parts (0 on the bottom side), 74 nets.
