andrewpaterson/658-Computer/Kicad/Boards/Blank/Board 2x36 W22.86/Board 2x36 W22.86.kicad_pcb

## KiCad design Kicad/Boards/Blank/Board 2x36 W22.86/Board 2x36 W22.86.kicad_pcb (2026-03-04)

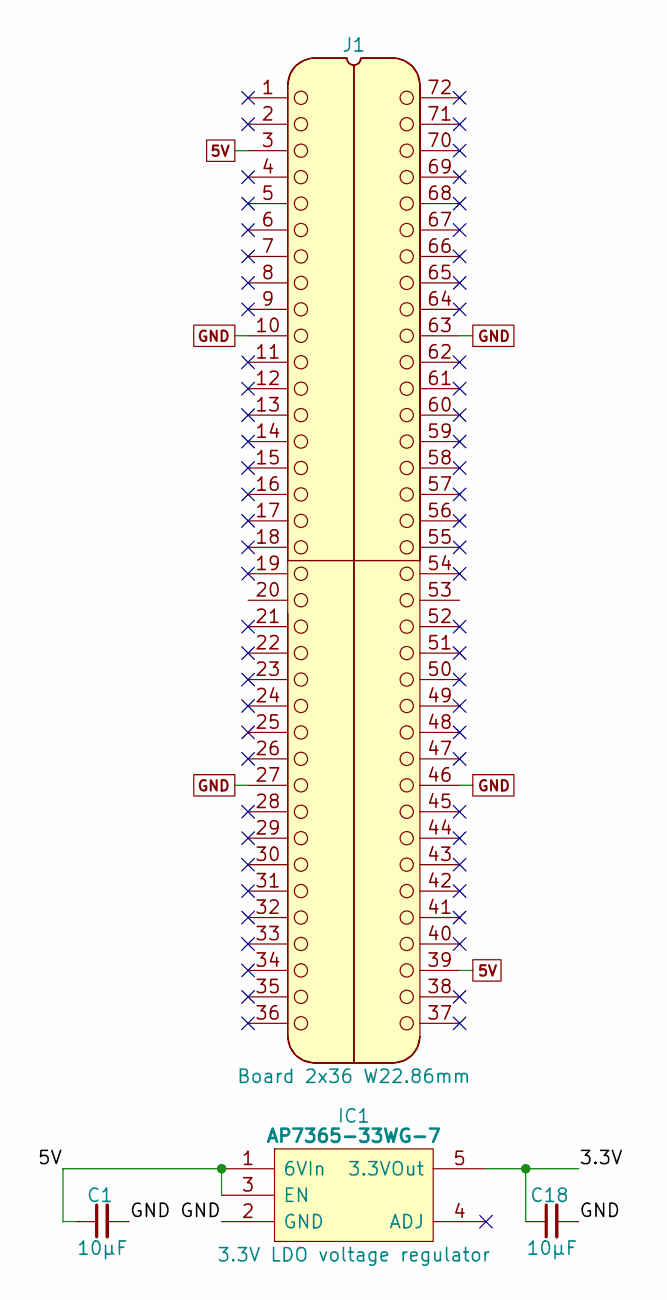
[picture p242: schematic Board 2x36 W22.86.kicad_sch, Board 2x36 W22.86mm]

Parts:
C1, C18: 10µF; C_0805
IC1: AP7365-33WG-7; SOT95P285X130-5N; Manufacturer_Part_Number AP7365-33WG-7; Mouser Part Number 621-AP7365-33WG-7
J1: Board 2x36 W22.86mm; DIP-72_Board_W22.86mm

Connections:
5V: C1.1, IC1.1 (6VIn), IC1.3 (EN), J1.3, J1.39
/3.3V: C18.1, IC1.5 (3.3VOut)
GND: C1.2, C18.2, IC1.2 (GND), J1.10, J1.27, J1.46, J1.63

Board: 2 copper layers, 4 parts (0 on the bottom side), 3 nets, no tracks yet.
