andrewpaterson/658-Computer/Kicad/Computer/Async FIFO Write/Asyncronous Write FIFO.kicad_sch

## KiCad design Kicad/Computer/Async FIFO Write/Asyncronous Write FIFO.kicad_sch (2024-06-30)

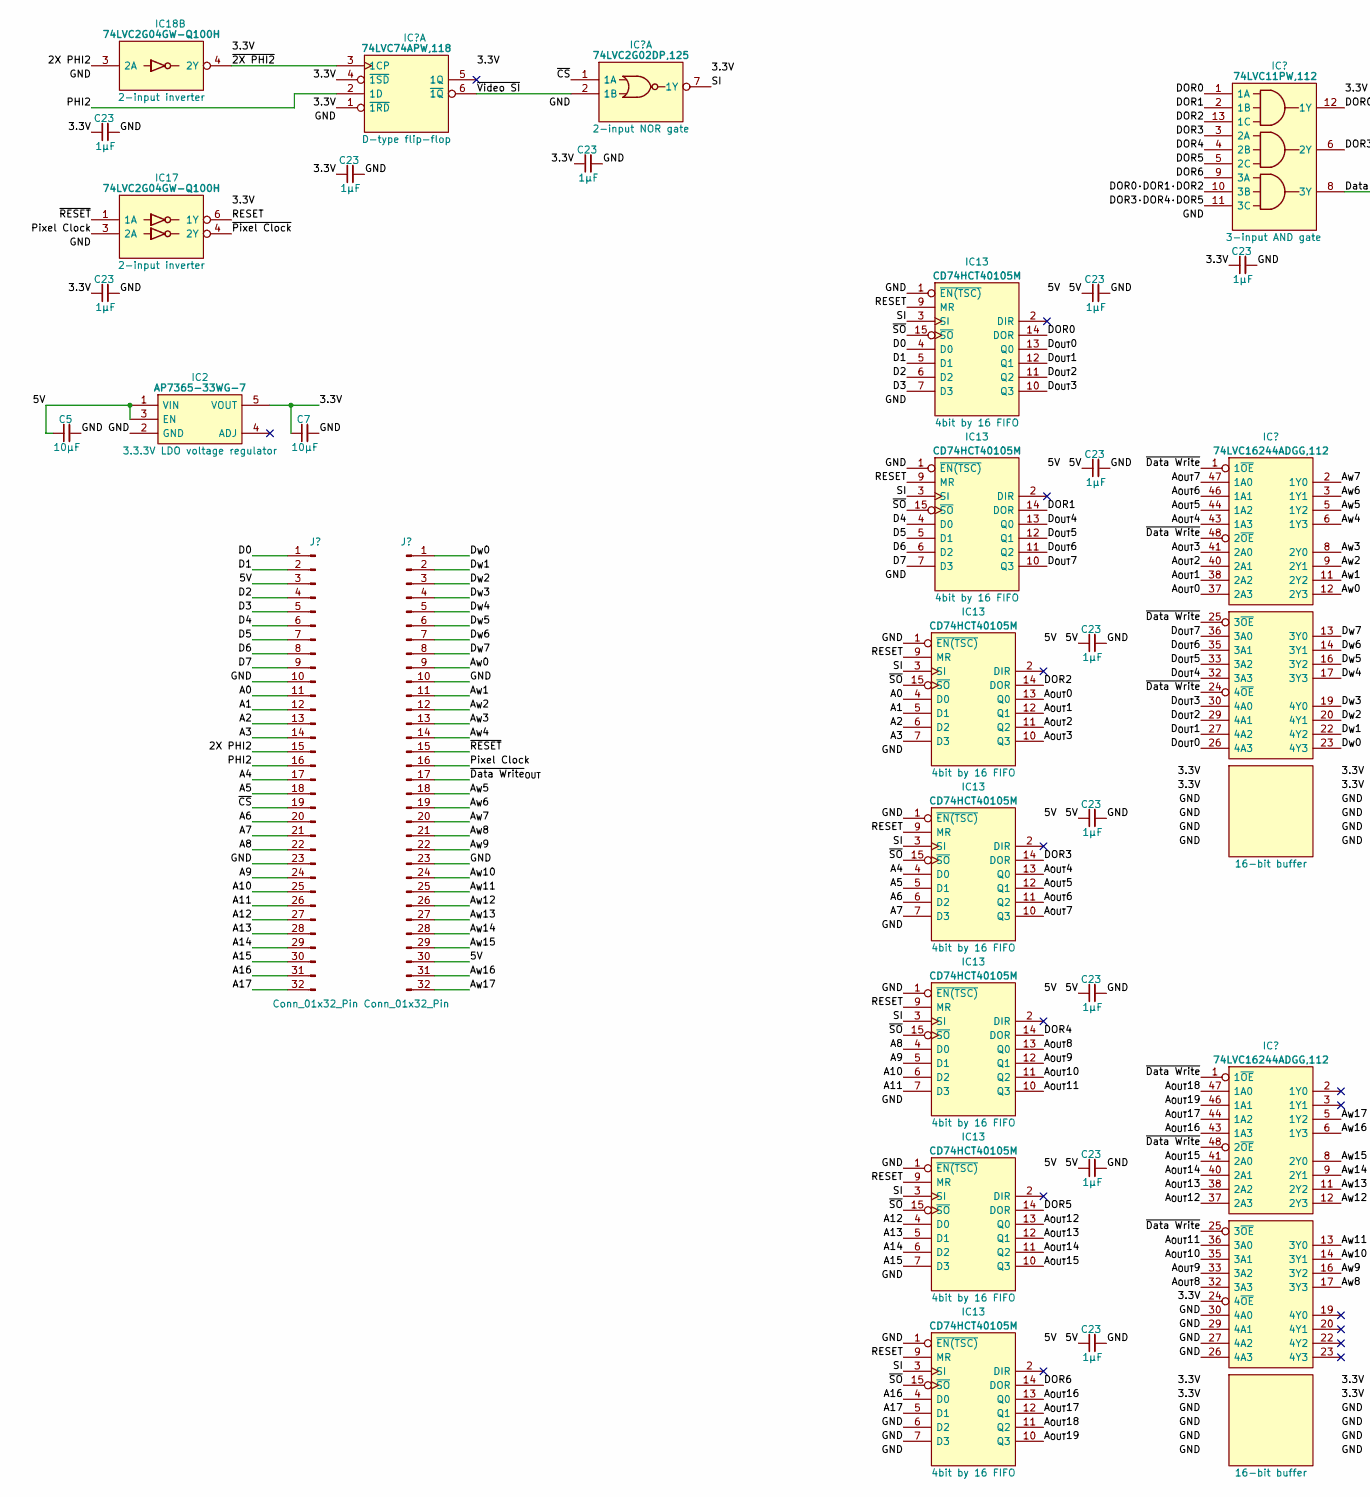
[picture p251: schematic Asyncronous Write FIFO.kicad_sch, part in row 1, column 1]

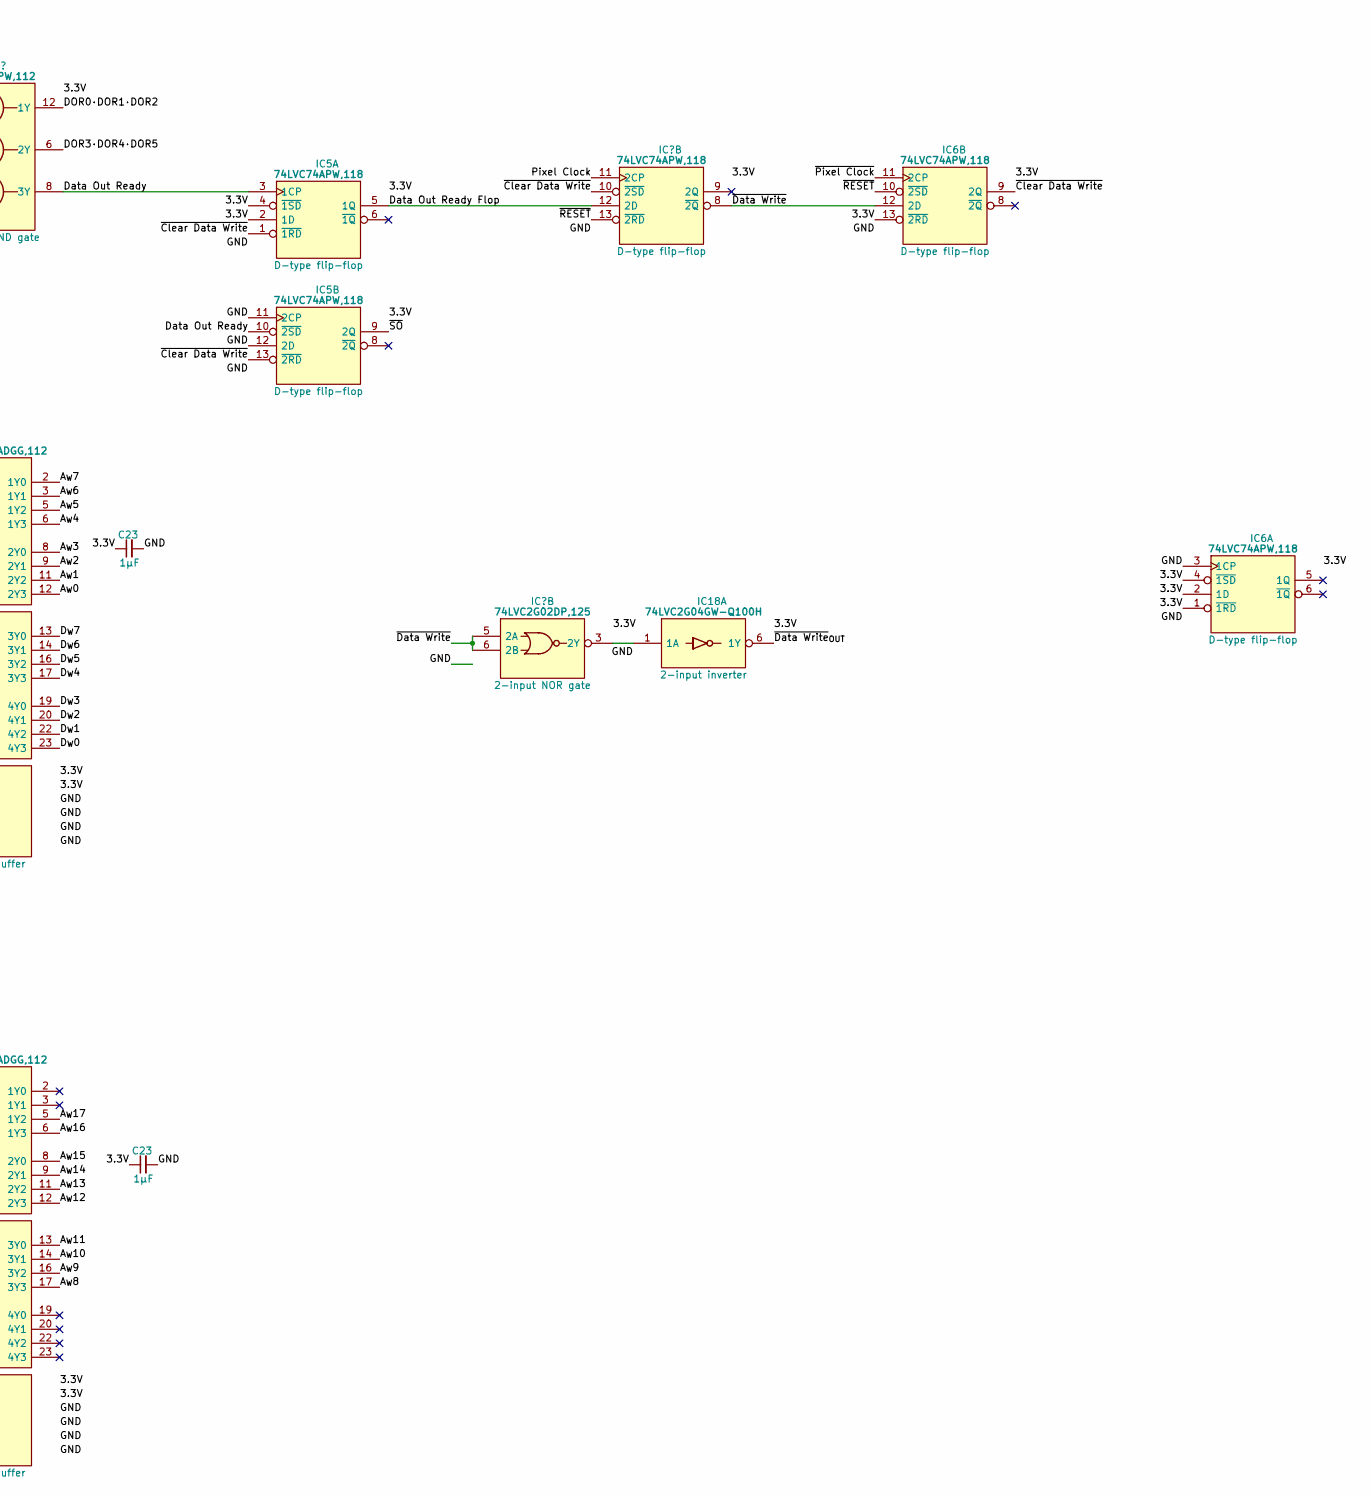
[picture p252: schematic Asyncronous Write FIFO.kicad_sch, part in row 1, column 2]

Parts:
C5, C7: 10µF; C_0805
C23: 1μF; C_0805
IC1: 74LVC11PW,112; SOP65P640X110-14N; Mouser Part Number 771-LVC11PW112
IC2: AP7365-33WG-7; SOT95P285X130-5N; Manufacturer_Part_Number AP7365-33WG-7; Mouser Part Number 621-AP7365-33WG-7
IC3, IC5, IC6: 74LVC74APW,118; SOP65P640X110-14N; Mouser Part Number 771-74LVC74APW-T
IC4: 74LVC2G02DP,125; SOP65P400X110-8N; Mouser Part Number 771-LVC2G02DP125
IC10, IC14: 74LVC16244ADGG,112; 74LVC16244ADGG112; Manufacturer_Part_Number 74LVC16244ADGG,112; Mouser Part Number 771-74LVC16244DG
IC13: CD74HCT40105M; SOIC127P600X175-16N; Manufacturer_Part_Number CD74HCT40105M; Mouser Part Number 595-CD74HCT40105M
IC17, IC18: 74LVC2G04GW-Q100H; SOP65P210X110-6N; Manufacturer_Part_Number 74LVC2G04GW-Q100H; Mouser Part Number 771-74LVC2G04GWQ100H
J1, J2: Conn_01x32_Pin; PinHeader_1x32_P2.54mm_Vertical

Connections:
2X PHI2: IC18.3 (2A), J1.15
3.3V: C7.1, C23.1, IC1.14 (3V), IC2.5 (VOUT), IC3.1 (~1RD), IC3.4 (~1SD), IC3.14 (3V), IC4.8 (3V), IC5.2 (1D), IC5.4 (~1SD), IC5.14 (3V), IC6.1 (~1RD), IC6.2 (1D), IC6.4 (~1SD), IC6.13 (~2RD), IC6.14 (3V), IC10.7 (3V), IC10.18 (3V), IC10.31 (3V), IC10.42 (3V), IC14.7 (3V), IC14.18 (3V), IC14.24 (4~OE), IC14.31 (3V), IC14.42 (3V), IC17.5 (3V), IC18.5 (3V)
5V: C5.1, C23.1, IC2.1 (VIN), IC2.3 (EN), IC13.16 (5V), J1.3, J2.30
A0: IC13.4 (D0), J1.11
A1: IC13.5 (D1), J1.12
A2: IC13.6 (D2), J1.13
A3: IC13.7 (D3), J1.14
A4: IC13.4 (D0), J1.17
A5: IC13.5 (D1), J1.18
A6: IC13.6 (D2), J1.20
A7: IC13.7 (D3), J1.21
A8: IC13.4 (D0), J1.22
A9: IC13.5 (D1), J1.24
A10: IC13.6 (D2), J1.25
A11: IC13.7 (D3), J1.26
A12: IC13.4 (D0), J1.27
A13: IC13.5 (D1), J1.28
A14: IC13.6 (D2), J1.29
A15: IC13.7 (D3), J1.30
A16: IC13.4 (D0), J1.31
A17: IC13.5 (D1), J1.32
A_{OUT}0: IC10.37 (2A3), IC13.13 (Q0)
A_{OUT}1: IC10.38 (2A2), IC13.12 (Q1)
A_{OUT}2: IC10.40 (2A1), IC13.11 (Q2)
A_{OUT}3: IC10.41 (2A0), IC13.10 (Q3)
A_{OUT}4: IC10.43 (1A3), IC13.13 (Q0)
A_{OUT}5: IC10.44 (1A2), IC13.12 (Q1)
A_{OUT}6: IC10.46 (1A1), IC13.11 (Q2)
A_{OUT}7: IC10.47 (1A0), IC13.10 (Q3)
A_{OUT}8: IC13.13 (Q0), IC14.32 (3A3)
A_{OUT}9: IC13.12 (Q1), IC14.33 (3A2)
A_{OUT}10: IC13.11 (Q2), IC14.35 (3A1)
A_{OUT}11: IC13.10 (Q3), IC14.36 (3A0)
A_{OUT}12: IC13.13 (Q0), IC14.37 (2A3)
A_{OUT}13: IC13.12 (Q1), IC14.38 (2A2)
A_{OUT}14: IC13.11 (Q2), IC14.40 (2A1)
A_{OUT}15: IC13.10 (Q3), IC14.41 (2A0)
A_{OUT}16: IC13.13 (Q0), IC14.43 (1A3)
A_{OUT}17: IC13.12 (Q1), IC14.44 (1A2)
A_{OUT}18: IC13.11 (Q2), IC14.47 (1A0)
A_{OUT}19: IC13.10 (Q3), IC14.46 (1A1)
A_{W}0: IC10.12 (2Y3), J2.9
A_{W}1: IC10.11 (2Y2), J2.11
A_{W}2: IC10.9 (2Y1), J2.12
A_{W}3: IC10.8 (2Y0), J2.13
A_{W}4: IC10.6 (1Y3), J2.14
A_{W}5: IC10.5 (1Y2), J2.18
A_{W}6: IC10.3 (1Y1), J2.19
A_{W}7: IC10.2 (1Y0), J2.20
A_{W}8: IC14.17 (3Y3), J2.21
A_{W}9: IC14.16 (3Y2), J2.22
A_{W}10: IC14.14 (3Y1), J2.24
A_{W}11: IC14.13 (3Y0), J2.25
A_{W}12: IC14.12 (2Y3), J2.26
A_{W}13: IC14.11 (2Y2), J2.27
A_{W}14: IC14.9 (2Y1), J2.28
A_{W}15: IC14.8 (2Y0), J2.29
A_{W}16: IC14.6 (1Y3), J2.31
A_{W}17: IC14.5 (1Y2), J2.32
D0: IC13.4 (D0), J1.1
D1: IC13.5 (D1), J1.2
D2: IC13.6 (D2), J1.4
D3: IC13.7 (D3), J1.5
D4: IC13.4 (D0), J1.6
D5: IC13.5 (D1), J1.7
D6: IC13.6 (D2), J1.8
D7: IC13.7 (D3), J1.9
DOR0: IC1.1 (1A), IC13.14 (DOR)
DOR0·DOR1·DOR2: IC1.10 (3B), IC1.12 (1Y)
DOR1: IC1.2 (1B), IC13.14 (DOR)
DOR2: IC1.13 (1C), IC13.14 (DOR)
DOR3: IC1.3 (2A), IC13.14 (DOR)
DOR3·DOR4·DOR5: IC1.6 (2Y), IC1.11 (3C)
DOR4: IC1.4 (2B), IC13.14 (DOR)
DOR5: IC1.5 (2C), IC13.14 (DOR)
DOR6: IC1.9 (3A), IC13.14 (DOR)
D_{OUT}0: IC10.26 (4A3), IC13.13 (Q0)
D_{OUT}1: IC10.27 (4A2), IC13.12 (Q1)
D_{OUT}2: IC10.29 (4A1), IC13.11 (Q2)
D_{OUT}3: IC10.30 (4A0), IC13.10 (Q3)
D_{OUT}4: IC10.32 (3A3), IC13.13 (Q0)
D_{OUT}5: IC10.33 (3A2), IC13.12 (Q1)
D_{OUT}6: IC10.35 (3A1), IC13.11 (Q2)
D_{OUT}7: IC10.36 (3A0), IC13.10 (Q3)
D_{W}0: IC10.23 (4Y3), J2.1
D_{W}1: IC10.22 (4Y2), J2.2
D_{W}2: IC10.20 (4Y1), J2.3
D_{W}3: IC10.19 (4Y0), J2.4
D_{W}4: IC10.17 (3Y3), J2.5
D_{W}5: IC10.16 (3Y2), J2.6
D_{W}6: IC10.14 (3Y1), J2.7
D_{W}7: IC10.13 (3Y0), J2.8
Data Out Ready: IC1.8 (3Y), IC5.3 (1CP), IC5.10 (~2SD)
Data Out Ready Flop: IC3.12 (2D), IC5.5 (1Q)
GND: C5.2, C7.2, C23.2, IC1.7 (GND), IC2.2 (GND), IC3.7 (GND), IC4.4 (GND), IC5.7 (GND), IC5.11 (2CP), IC5.12 (2D), IC6.3 (1CP), IC6.7 (GND), IC10.4 (GND), IC10.10 (GND), IC10.15 (GND), IC10.21 (GND), IC10.28 (GND), IC10.34 (GND), IC10.39 (GND), IC10.45 (GND), IC13.1 (~EN(TSC)), IC13.6 (D2), IC13.7 (D3), IC13.8 (GND), IC14.4 (GND), IC14.10 (GND), IC14.15 (GND), IC14.21 (GND), IC14.26 (4A3), IC14.27 (4A2), IC14.28 (GND), IC14.29 (4A1), IC14.30 (4A0), IC14.34 (GND), IC14.39 (GND), IC14.45 (GND), IC17.2 (GND), IC18.2 (GND), J1.10, J1.23, J2.10, J2.23
unnamed: IC4.3 (2Y), IC18.1 (1A)
PHI2: IC3.2 (1D), J1.16
Pixel Clock: IC3.11 (2CP), IC17.3 (2A), J2.16
RESET: IC13.9 (MR), IC17.6 (1Y)
SI: IC4.7 (1Y), IC13.3 (SI)
~2X PHI2: IC3.3 (1CP), IC18.4 (2Y)
~CS: IC4.1 (1A), J1.19
~Clear Data Write: IC3.10 (~2SD), IC5.1 (~1RD), IC5.13 (~2RD), IC6.9 (2Q)
~Data Write: IC3.8 (~2Q), IC4.5 (2A), IC4.6 (2B), IC6.12 (2D), IC10.1 (1~OE), IC10.24 (4~OE), IC10.25 (3~OE), IC10.48 (2~OE), IC14.1 (1~OE), IC14.25 (3~OE), IC14.48 (2~OE)
~Data Write_{OUT}: IC18.6 (1Y), J2.17
~Pixel Clock: IC6.11 (2CP), IC17.4 (2Y)
~RESET: IC3.13 (~2RD), IC6.10 (~2SD), IC17.1 (1A), J2.15
~SO: IC5.9 (2Q), IC13.15 (~SO)
~Video SI: IC3.6 (~1Q), IC4.2 (1B)
