andrewpaterson/658-Computer/Kicad/Computer/Async FIFO Write/Asyncronous Write PHI2 Hold.kicad_sch

## KiCad design Kicad/Computer/Async FIFO Write/Asyncronous Write PHI2 Hold.kicad_sch (2024-06-30)

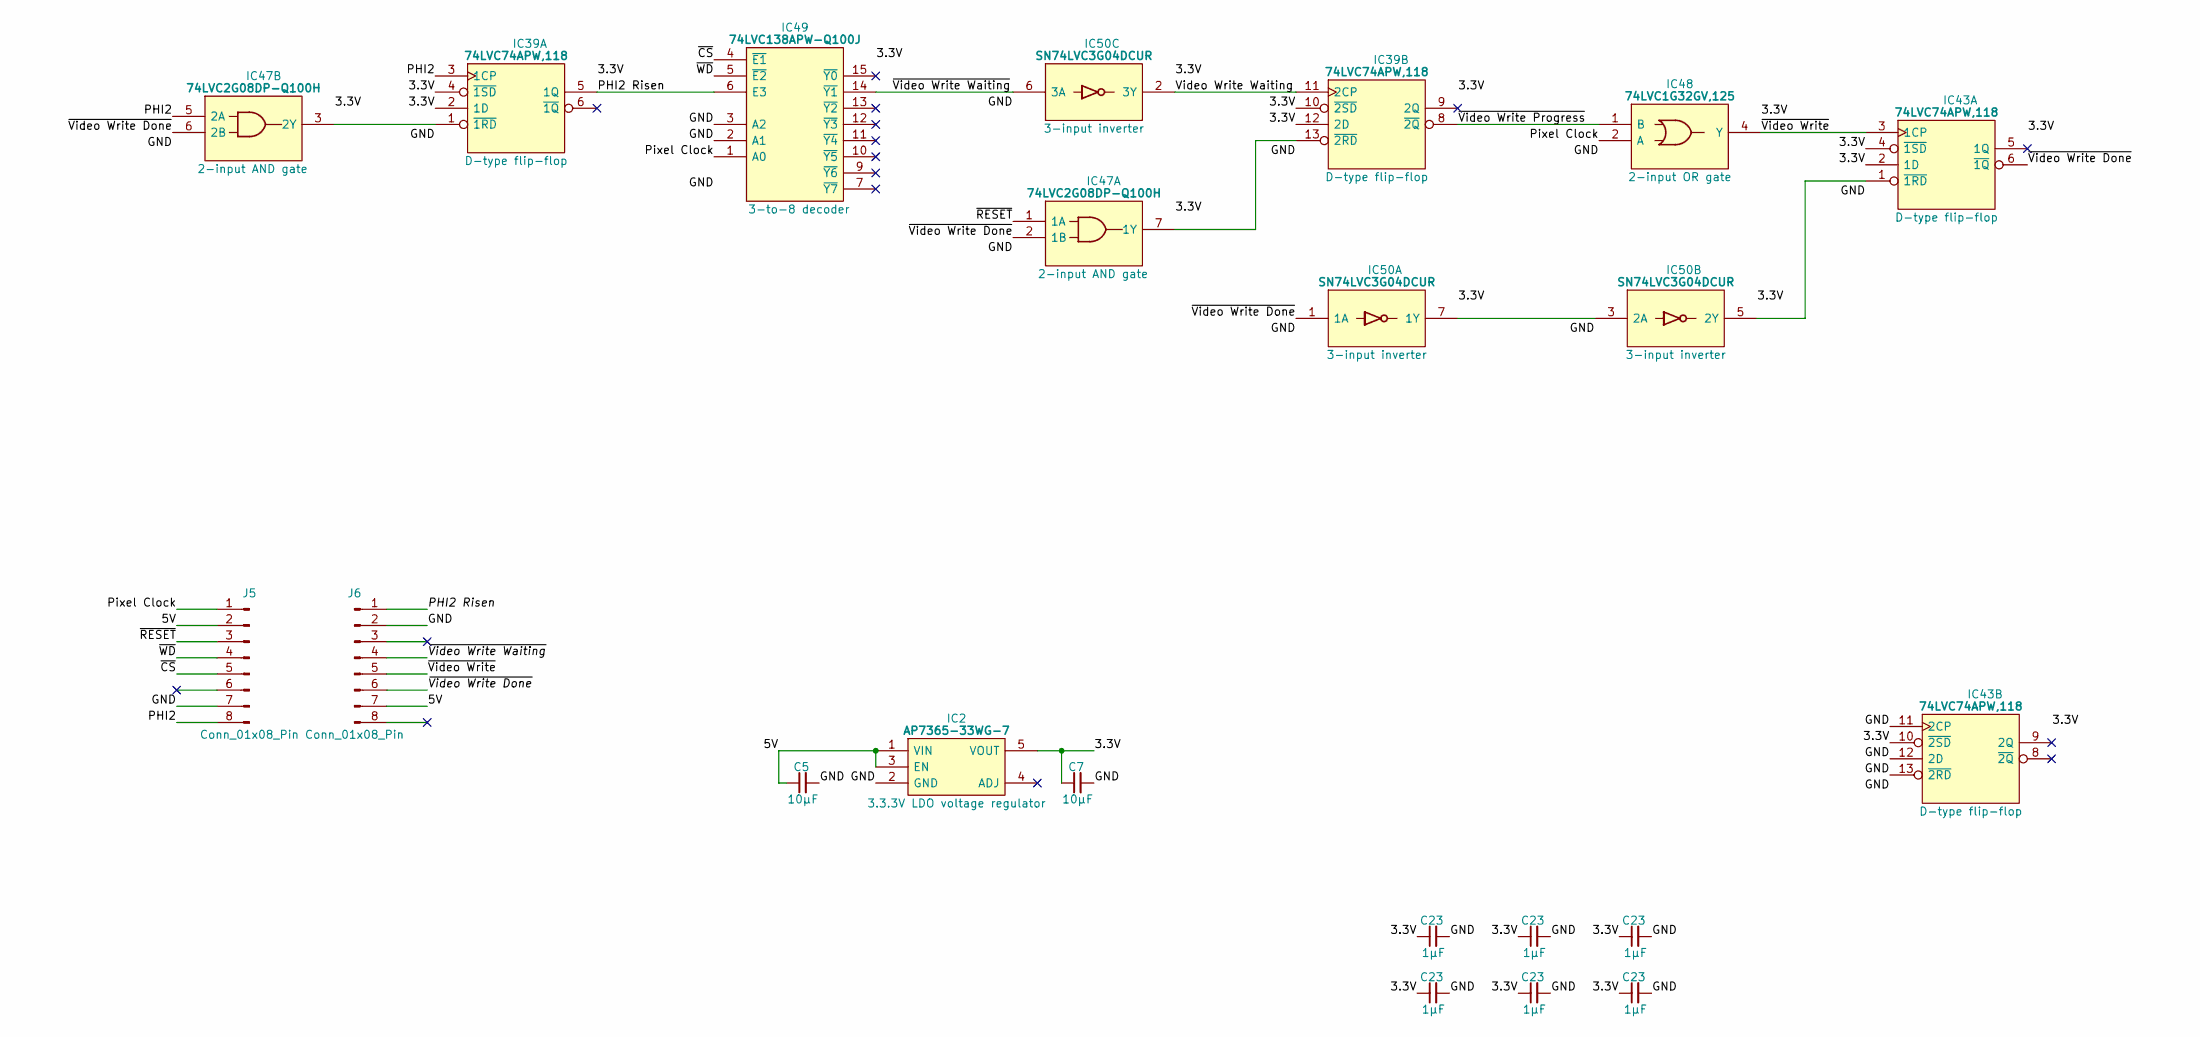
[picture p253: schematic Asyncronous Write PHI2 Hold.kicad_sch]

Parts:
C5, C7: 10µF; C_0805
C23: 1μF; C_0805
IC2: AP7365-33WG-7; SOT95P285X130-5N; Manufacturer_Part_Number AP7365-33WG-7; Mouser Part Number 621-AP7365-33WG-7
IC39, IC43: 74LVC74APW,118; SOP65P640X110-14N; Mouser Part Number 771-74LVC74APW-T
IC47: 74LVC2G08DP-Q100H; SOP65P400X110-8N; Manufacturer_Part_Number 74LVC2G08DP-Q100H; Mouser Part Number 771-74LVC2G08DPQ100H
IC48: 74LVC1G32GV,125; SOT95P275X110-5N; Manufacturer_Part_Number 74LVC1G32GV,125; Mouser Part Number 771-LVC1G32GV125
IC49: 74LVC138APW-Q100J; SOP65P640X110-16N; Mouser Part Number 771-74LVC138APWQ100J
IC50: SN74LVC3G04DCUR; SOP50P310X90-8N; Manufacturer_Part_Number SN74LVC3G04DCUR; Mouser Part Number 595-SN74LVC3G04DCUR
J5, J6: Conn_01x08_Pin; PinHeader_1x08_P2.54mm_Vertical

Connections:
3.3V: C7.1, C23.1, IC2.5 (VOUT), IC39.2 (1D), IC39.4 (~1SD), IC39.10 (~2SD), IC39.12 (2D), IC39.14 (3V), IC43.2 (1D), IC43.4 (~1SD), IC43.10 (~2SD), IC43.14 (3V), IC47.8 (3V), IC48.5 (3V), IC49.16 (3V), IC50.8 (3V)
5V: C5.1, IC2.1 (VIN), IC2.3 (EN), J5.2, J6.7
GND: C5.2, C7.2, C23.2, IC2.2 (GND), IC39.7 (GND), IC43.7 (GND), IC43.11 (2CP), IC43.12 (2D), IC43.13 (~2RD), IC47.4 (GND), IC48.3 (GND), IC49.2 (A1), IC49.3 (A2), IC49.8 (GND), IC50.4 (GND), J5.7, J6.2
unnamed: IC39.1 (~1RD), IC47.3 (2Y)
unnamed: IC39.13 (~2RD), IC47.7 (1Y)
unnamed: IC43.1 (~1RD), IC50.5 (2Y)
unnamed: IC50.3 (2A), IC50.7 (1Y)
PHI2: IC39.3 (1CP), IC47.5 (2A), J5.8
PHI2 Risen: IC39.5 (1Q), IC49.6 (E3), J6.1
Pixel Clock: IC48.2 (A), IC49.1 (A0), J5.1
Video Write Waiting: IC39.11 (2CP), IC50.2 (3Y)
~CS: IC49.4 (~E1), J5.5
~RESET: IC47.1 (1A), J5.3
~Video Write Done: IC43.6 (~1Q), IC47.2 (1B), IC47.6 (2B), IC50.1 (1A), J6.6
~Video Write Progress: IC39.8 (~2Q), IC48.1 (B)
~Video Write Waiting: IC49.14 (~Y1), IC50.6 (3A), J6.4
~Video Write: IC43.3 (1CP), IC48.4 (Y), J6.5
~WD: IC49.5 (~E2), J5.4
