andrewpaterson/658-Computer/Kicad/Computer/MPU Breakout/Address Decode Board.kicad_sch

## KiCad design Kicad/Computer/MPU Breakout/Address Decode Board.kicad_sch (2023-11-14)

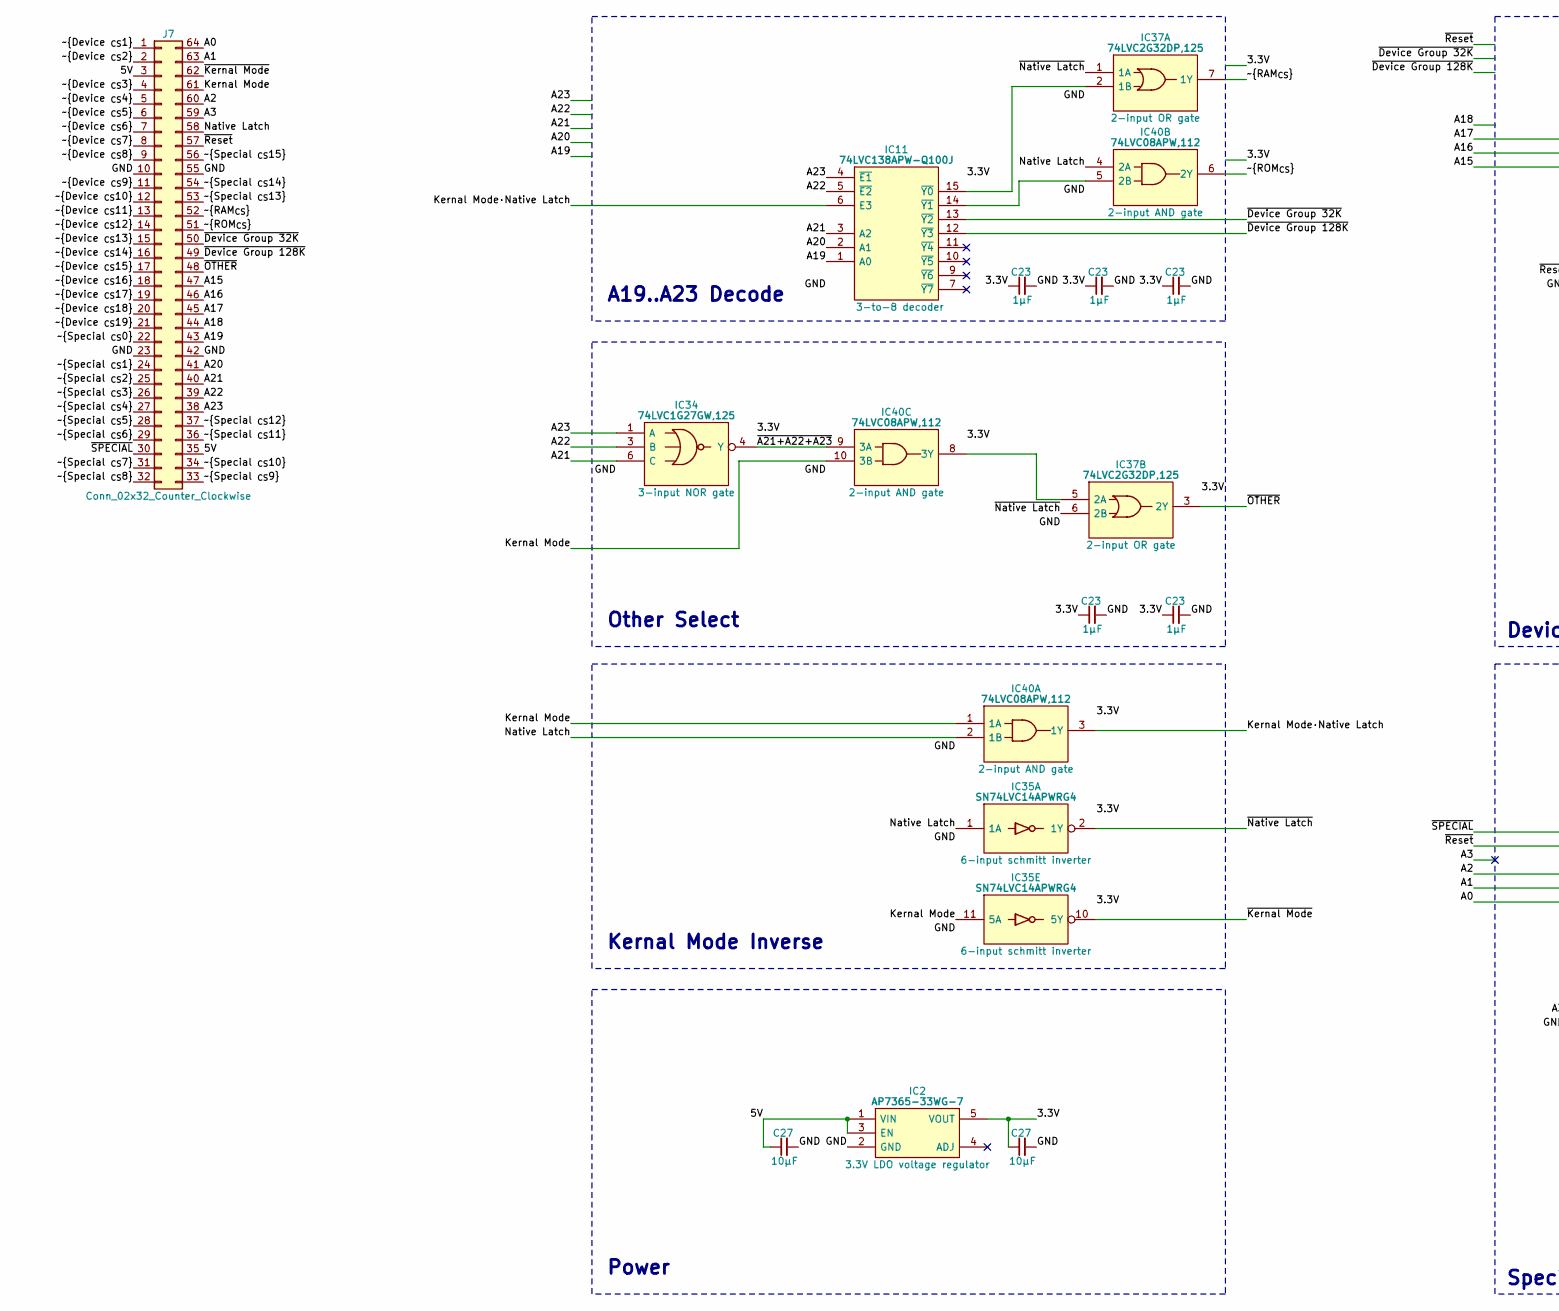
[picture p254: schematic Address Decode Board.kicad_sch, part in row 1, column 1]

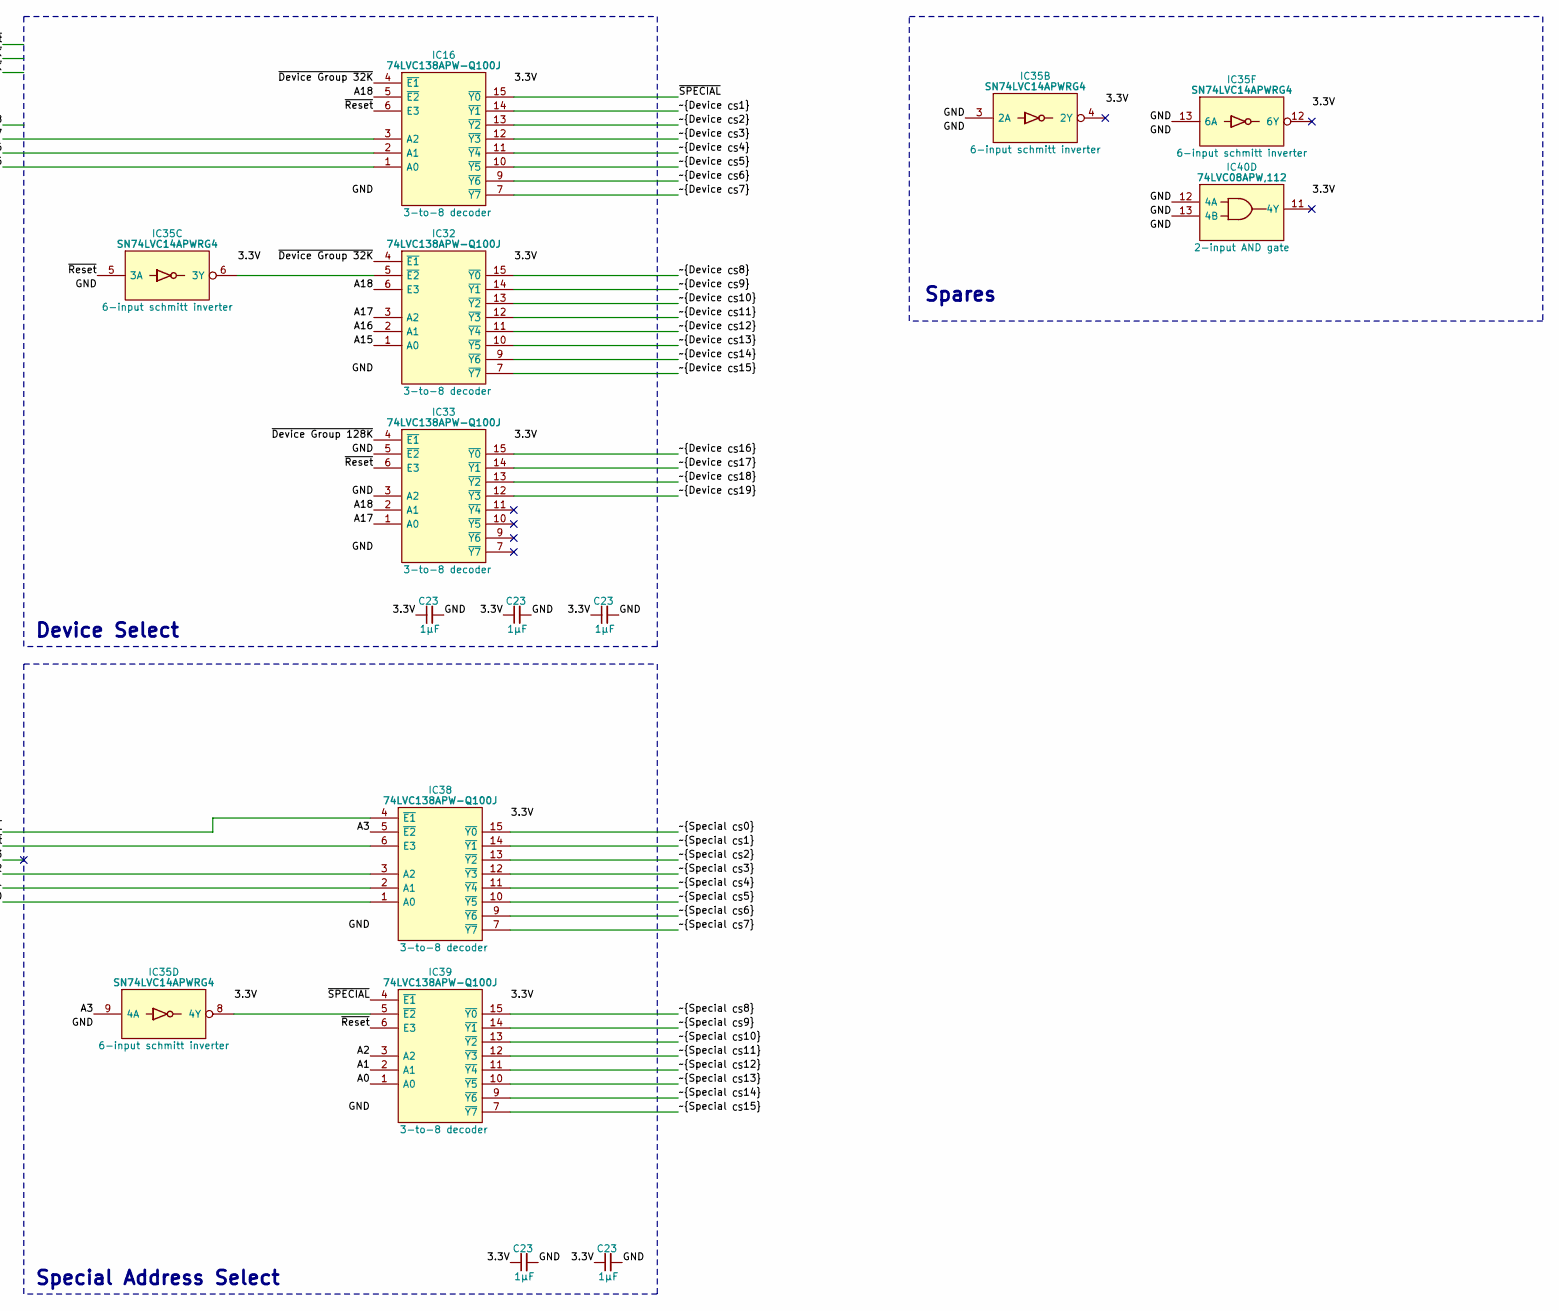
[picture p255: schematic Address Decode Board.kicad_sch, part in row 1, column 2]

Parts:
C23: 1μF; C_0805
C27: 10μF; C_0805
IC2: AP7365-33WG-7; SOT95P285X130-5N; Manufacturer_Part_Number AP7365-33WG-7; Mouser Part Number 621-AP7365-33WG-7
IC11, IC16, IC32, IC33, IC38, IC39: 74LVC138APW-Q100J; SOP65P640X110-16N; Mouser Part Number 771-74LVC138APWQ100J
IC34: 74LVC1G27GW,125; SOP65P210X110-6N; Mouser Part Number 771-74LVC1G27GW125
IC35: SN74LVC14APWRG4; SOP65P640X110-14N; Manufacturer_Part_Number SN74LVC14APWRG4; Mouser Part Number SN74LVC14APWRG4
IC37: 74LVC2G32DP,125; SOP65P400X110-8N; Manufacturer_Part_Number 74LVC2G32DP,125; Mouser Part Number 771-LVC2G32DP125
IC40: 74LVC08APW,112; SOP65P640X110-14N; Manufacturer_Part_Number 74LVC08APW,112; Mouser Part Number 771-74LVC08APW
J7: Conn_02x32_Counter_Clockwise; DIP-64_Board_W22.86mm

Connections:
3.3V: C23.1, C27.1, IC2.5 (VOUT), IC11.16 (3V), IC16.16 (3V), IC32.16 (3V), IC33.16 (3V), IC34.5 (3V), IC35.14 (3V), IC37.8 (VCC), IC38.16 (3V), IC39.16 (3V), IC40.14 (3V)
5V: C27.1, IC2.1 (VIN), IC2.3 (EN), J7.3, J7.35
A0: IC38.1 (A0), IC39.1 (A0), J7.64
A1: IC38.2 (A1), IC39.2 (A1), J7.63
A2: IC38.3 (A2), IC39.3 (A2), J7.60
A3: IC35.9 (4A), IC38.5 (~E2), J7.59
A15: IC16.1 (A0), IC32.1 (A0), J7.47
A16: IC16.2 (A1), IC32.2 (A1), J7.46
A17: IC16.3 (A2), IC32.3 (A2), IC33.1 (A0), J7.45
A18: IC16.5 (~E2), IC32.6 (E3), IC33.2 (A1), J7.44
A19: IC11.1 (A0), J7.43
A20: IC11.2 (A1), J7.41
A21: IC11.3 (A2), IC34.6 (C), J7.40
A22: IC11.5 (~E2), IC34.3 (B), J7.39
A23: IC11.4 (~E1), IC34.1 (A), J7.38
GND: C23.2, C27.2, IC2.2 (GND), IC11.8 (GND), IC16.8 (GND), IC32.8 (GND), IC33.3 (A2), IC33.5 (~E2), IC33.8 (GND), IC34.2 (GND), IC35.3 (2A), IC35.7 (GND), IC35.13 (6A), IC37.4 (GND), IC38.8 (GND), IC39.8 (GND), IC40.7 (GND), IC40.12 (4A), IC40.13 (4B), J7.10, J7.23, J7.42, J7.55
Kernal Mode: IC35.11 (5A), IC40.1 (1A), IC40.10 (3B), J7.61
Kernal Mode·Native Latch: IC11.6 (E3), IC40.3 (1Y)
Native Latch: IC35.1 (1A), IC40.2 (1B), IC40.4 (2A), J7.58
unnamed: IC11.14 (~Y1), IC40.5 (2B)
unnamed: IC11.15 (~Y0), IC37.2 (1B)
unnamed: IC32.5 (~E2), IC35.6 (3Y)
unnamed: IC35.8 (4Y), IC39.5 (~E2)
unnamed: IC37.5 (2A), IC40.8 (3Y)
~A21+A22+A23: IC34.4 (Y), IC40.9 (3A)
~Device Group 32K: IC11.13 (~Y2), IC16.4 (~E1), IC32.4 (~E1), J7.50
~Device Group 128K: IC11.12 (~Y3), IC33.4 (~E1), J7.49
~Device _{CS1}: IC16.14 (~Y1), J7.1
~Device _{CS2}: IC16.13 (~Y2), J7.2
~Device _{CS3}: IC16.12 (~Y3), J7.4
~Device _{CS4}: IC16.11 (~Y4), J7.5
~Device _{CS5}: IC16.10 (~Y5), J7.6
~Device _{CS6}: IC16.9 (~Y6), J7.7
~Device _{CS7}: IC16.7 (~Y7), J7.8
~Device _{CS8}: IC32.15 (~Y0), J7.9
~Device _{CS9}: IC32.14 (~Y1), J7.11
~Device _{CS10}: IC32.13 (~Y2), J7.12
~Device _{CS11}: IC32.12 (~Y3), J7.13
~Device _{CS12}: IC32.11 (~Y4), J7.14
~Device _{CS13}: IC32.10 (~Y5), J7.15
~Device _{CS14}: IC32.9 (~Y6), J7.16
~Device _{CS15}: IC32.7 (~Y7), J7.17
~Device _{CS16}: IC33.15 (~Y0), J7.18
~Device _{CS17}: IC33.14 (~Y1), J7.19
~Device _{CS18}: IC33.13 (~Y2), J7.20
~Device _{CS19}: IC33.12 (~Y3), J7.21
~Kernal Mode: IC35.10 (5Y), J7.62
~Native Latch: IC35.2 (1Y), IC37.1 (1A), IC37.6 (2B)
~OTHER: IC37.3 (2Y), J7.48
~RAM_{CS}: IC37.7 (1Y), J7.52
~ROM_{CS}: IC40.6 (2Y), J7.51
~Reset: IC16.6 (E3), IC33.6 (E3), IC35.5 (3A), IC38.6 (E3), IC39.6 (E3), J7.57
~SPECIAL: IC16.15 (~Y0), IC38.4 (~E1), IC39.4 (~E1), J7.30
~Special _{CS0}: IC38.15 (~Y0), J7.22
~Special _{CS1}: IC38.14 (~Y1), J7.24
~Special _{CS2}: IC38.13 (~Y2), J7.25
~Special _{CS3}: IC38.12 (~Y3), J7.26
~Special _{CS4}: IC38.11 (~Y4), J7.27
~Special _{CS5}: IC38.10 (~Y5), J7.28
~Special _{CS6}: IC38.9 (~Y6), J7.29
~Special _{CS7}: IC38.7 (~Y7), J7.31
~Special _{CS8}: IC39.15 (~Y0), J7.32
~Special _{CS9}: IC39.14 (~Y1), J7.33
~Special _{CS10}: IC39.13 (~Y2), J7.34
~Special _{CS11}: IC39.12 (~Y3), J7.36
~Special _{CS12}: IC39.11 (~Y4), J7.37
~Special _{CS13}: IC39.10 (~Y5), J7.53
~Special _{CS14}: IC39.9 (~Y6), J7.54
~Special _{CS15}: IC39.7 (~Y7), J7.56

Notes on the sheet:
Spares
A19..A23 Decode
Device Select
Special Address Select
Kernal Mode Inverse
Power
Other Select
