andrewpaterson/658-Computer/Kicad/Computer/MPU Breakout/Clock Control Board.kicad_sch

## KiCad design Kicad/Computer/MPU Breakout/Clock Control Board.kicad_sch (2023-11-14)

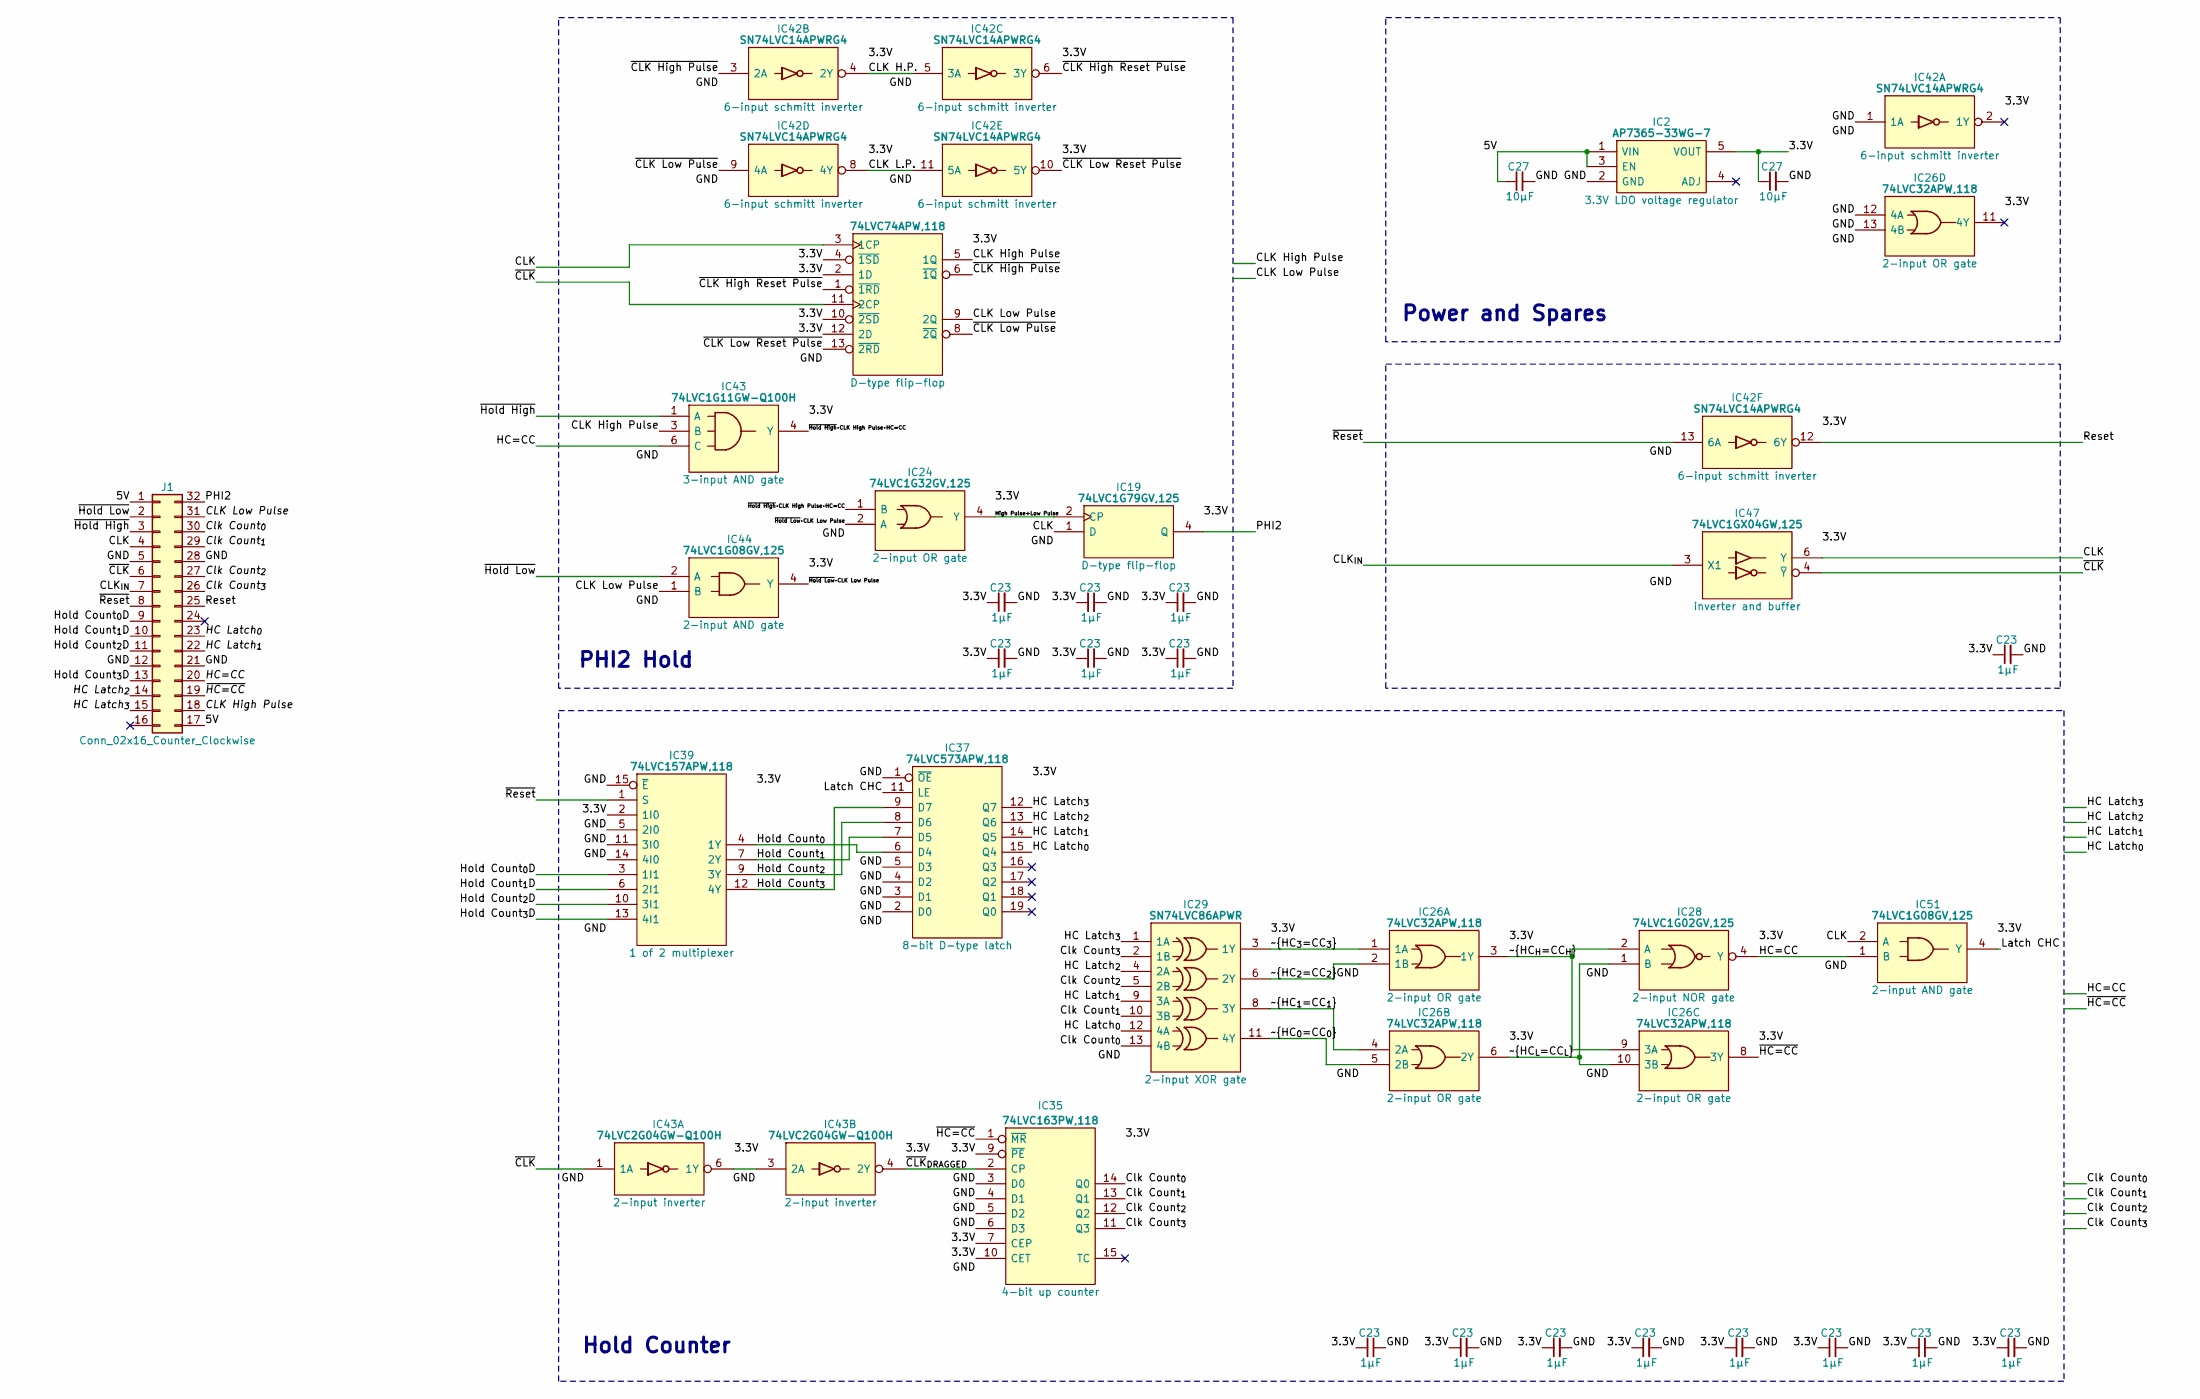
[picture p256: schematic Clock Control Board.kicad_sch]

Parts:
C23: 1μF; C_0805
C27: 10μF; C_0805
IC2: AP7365-33WG-7; SOT95P285X130-5N; Manufacturer_Part_Number AP7365-33WG-7; Mouser Part Number 621-AP7365-33WG-7
IC7: 74LVC74APW,118; SOP65P640X110-14N; Mouser Part Number 771-74LVC74APW-T
IC19: 74LVC1G79GV,125; SOT95P275X110-5N; Mouser Part Number 771-LVC1G79GV125
IC24: 74LVC1G32GV,125; SOT95P275X110-5N; Manufacturer_Part_Number 74LVC1G32GV,125; Mouser Part Number 771-LVC1G32GV125
IC26: 74LVC32APW,118; SOP65P640X110-14N; Manufacturer_Part_Number 74LVC32APW,118; Mouser Part Number 771-74LVC32APW-T
IC28: 74LVC1G02GV,125; SOT95P275X110-5N; Manufacturer_Part_Number 74LVC1G02GV,125; Mouser Part Number 771-LVC1G02GV125
IC29: SN74LVC86APWR; SOP65P640X120-14N; Manufacturer_Part_Number SN74LVC86APWR; Mouser Part Number 595-SN74LVC86APWR
IC35: 74LVC163PW,118; SOP65P640X110-16N; Mouser Part Number 771-74LVC163PW-T
IC37: 74LVC573APW,118; SOP65P640X110-20N; Mouser Part Number 771-74LVC573APW-T
IC39: 74LVC157APW,118; SOP65P640X110-16N; Mouser Part Number 771-74LVC157APW-T
IC42: SN74LVC14APWRG4; SOP65P640X110-14N; Manufacturer_Part_Number SN74LVC14APWRG4; Mouser Part Number SN74LVC14APWRG4
IC43: 74LVC2G04GW-Q100H; SOP65P210X110-6N; Manufacturer_Part_Number 74LVC2G04GW-Q100H; Mouser Part Number 771-74LVC2G04GWQ100H
IC44, IC51: 74LVC1G08GV,125; SOT95P275X110-5N; Manufacturer_Part_Number 74LVC1G08GV,125; Mouser Part Number 771-74LVC1G08GV
IC47: 74LVC1GX04GW,125; SOP65P210X110-6N; Manufacturer_Part_Number 74LVC1GX04GW,125; Mouser Part Number 771-74LVC1GX04GW-G
J1: Conn_02x16_Counter_Clockwise; DIP-32_Board_W22.86mm

Connections:
3.3V: C23.1, C27.1, IC2.5 (VOUT), IC7.2 (1D), IC7.4 (~1SD), IC7.10 (~2SD), IC7.12 (2D), IC7.14 (3V), IC19.5 (3V), IC24.5 (3V), IC26.14 (3V), IC28.5 (3V), IC29.14 (3V), IC35.7 (CEP), IC35.9 (~PE), IC35.10 (CET), IC35.16 (3V), IC37.20 (3V), IC39.2 (1I0), IC39.16 (3V), IC42.14 (3V), IC43.5 (3V), IC44.5 (3V), IC47.5 (3V), IC51.5 (3V)
5V: C27.1, IC2.1 (VIN), IC2.3 (EN), J1.1, J1.17
CLK: IC7.3 (1CP), IC19.1 (D), IC47.6 (Y), IC51.2 (A), J1.4
CLK H.P.: IC42.4 (2Y), IC42.5 (3A)
CLK High Pulse: IC7.5 (1Q), IC43.3 (B), J1.18
CLK L.P.: IC42.8 (4Y), IC42.11 (5A)
CLK Low Pulse: IC7.9 (2Q), IC44.1 (B), J1.31
CLK_{IN}: IC47.3 (X1), J1.7
Clk Count_{0}: IC29.13 (4B), IC35.14 (Q0), J1.30
Clk Count_{1}: IC29.10 (3B), IC35.13 (Q1), J1.29
Clk Count_{2}: IC29.5 (2B), IC35.12 (Q2), J1.27
Clk Count_{3}: IC29.2 (1B), IC35.11 (Q3), J1.26
GND: C23.2, C27.2, IC2.2 (GND), IC7.7 (GND), IC19.3 (GND), IC24.3 (GND), IC26.7 (GND), IC26.12 (4A), IC26.13 (4B), IC28.3 (GND), IC29.7 (GND), IC35.3 (D0), IC35.4 (D1), IC35.5 (D2), IC35.6 (D3), IC35.8 (GND), IC37.1 (~OE), IC37.2 (D0), IC37.3 (D1), IC37.4 (D2), IC37.5 (D3), IC37.10 (GND), IC39.5 (2I0), IC39.8 (GND), IC39.11 (3I0), IC39.14 (4I0), IC39.15 (~E), IC42.1 (1A), IC42.7 (GND), IC43.2 (GND), IC44.3 (GND), IC47.2 (GND), IC51.3 (GND), J1.5, J1.12, J1.21, J1.28
HC Latch_{0}: IC29.12 (4A), IC37.15 (Q4), J1.23
HC Latch_{1}: IC29.9 (3A), IC37.14 (Q5), J1.22
HC Latch_{2}: IC29.4 (2A), IC37.13 (Q6), J1.14
HC Latch_{3}: IC29.1 (1A), IC37.12 (Q7), J1.15
HC=CC: IC28.4 (Y), IC43.6 (C), IC51.1 (B), J1.20
High Pulse+Low Pulse: IC19.2 (CP), IC24.4 (Y)
Hold Count_{0}: IC37.6 (D4), IC39.4 (1Y)
Hold Count_{0}D: IC39.3 (1I1), J1.9
Hold Count_{1}: IC37.7 (D5), IC39.7 (2Y)
Hold Count_{1}D: IC39.6 (2I1), J1.10
Hold Count_{2}: IC37.8 (D6), IC39.9 (3Y)
Hold Count_{2}D: IC39.10 (3I1), J1.11
Hold Count_{3}: IC37.9 (D7), IC39.12 (4Y)
Hold Count_{3}D: IC39.13 (4I1), J1.13
Latch CHC: IC37.11 (LE), IC51.4 (Y)
unnamed: IC43.3 (B), IC43.6 (C)
PHI2: IC19.4 (Q), J1.32
Reset: IC42.12 (6Y), J1.25
~CLK High Pulse: IC7.6 (~1Q), IC42.3 (2A)
~CLK High Reset Pulse: IC7.1 (~1RD), IC42.6 (3Y)
~CLK Low Pulse: IC7.8 (~2Q), IC42.9 (4A)
~CLK Low Reset Pulse: IC7.13 (~2RD), IC42.10 (5Y)
~CLK: IC7.11 (2CP), IC43.1 (A), IC47.4 (~Y), J1.6
~CLK_{DRAGGED}: IC35.2 (CP), IC43.4 (Y)
~HC=CC: IC26.8 (3Y), IC35.1 (~MR), J1.19
~HC_{0=CC_{0}}: IC26.5 (2B), IC29.11 (4Y)
~HC_{1=CC_{1}}: IC26.4 (2A), IC29.8 (3Y)
~HC_{2=CC_{2}}: IC26.2 (1B), IC29.6 (2Y)
~HC_{3=CC_{3}}: IC26.1 (1A), IC29.3 (1Y)
~HC_{H=CC_{H}}: IC26.3 (1Y), IC26.9 (3A), IC28.2 (A)
~HC_{L=CC_{L}}: IC26.6 (2Y), IC26.10 (3B), IC28.1 (B)
~Hold High: IC43.1 (A), J1.3
~Hold High·CLK High Pulse·HC=CC: IC24.1 (B), IC43.4 (Y)
~Hold Low: IC44.2 (A), J1.2
~Hold Low·CLK Low Pulse: IC24.2 (A), IC44.4 (Y)
~Reset: IC39.1 (S), IC42.13 (6A), J1.8

Notes on the sheet:
Hold Counter
PHI2 Hold
Power and Spares
