andrewpaterson/658-Computer/Kicad/Computer/MPU Breakout/Memory Board.kicad_sch

## KiCad design Kicad/Computer/MPU Breakout/Memory Board.kicad_sch (2023-10-27)

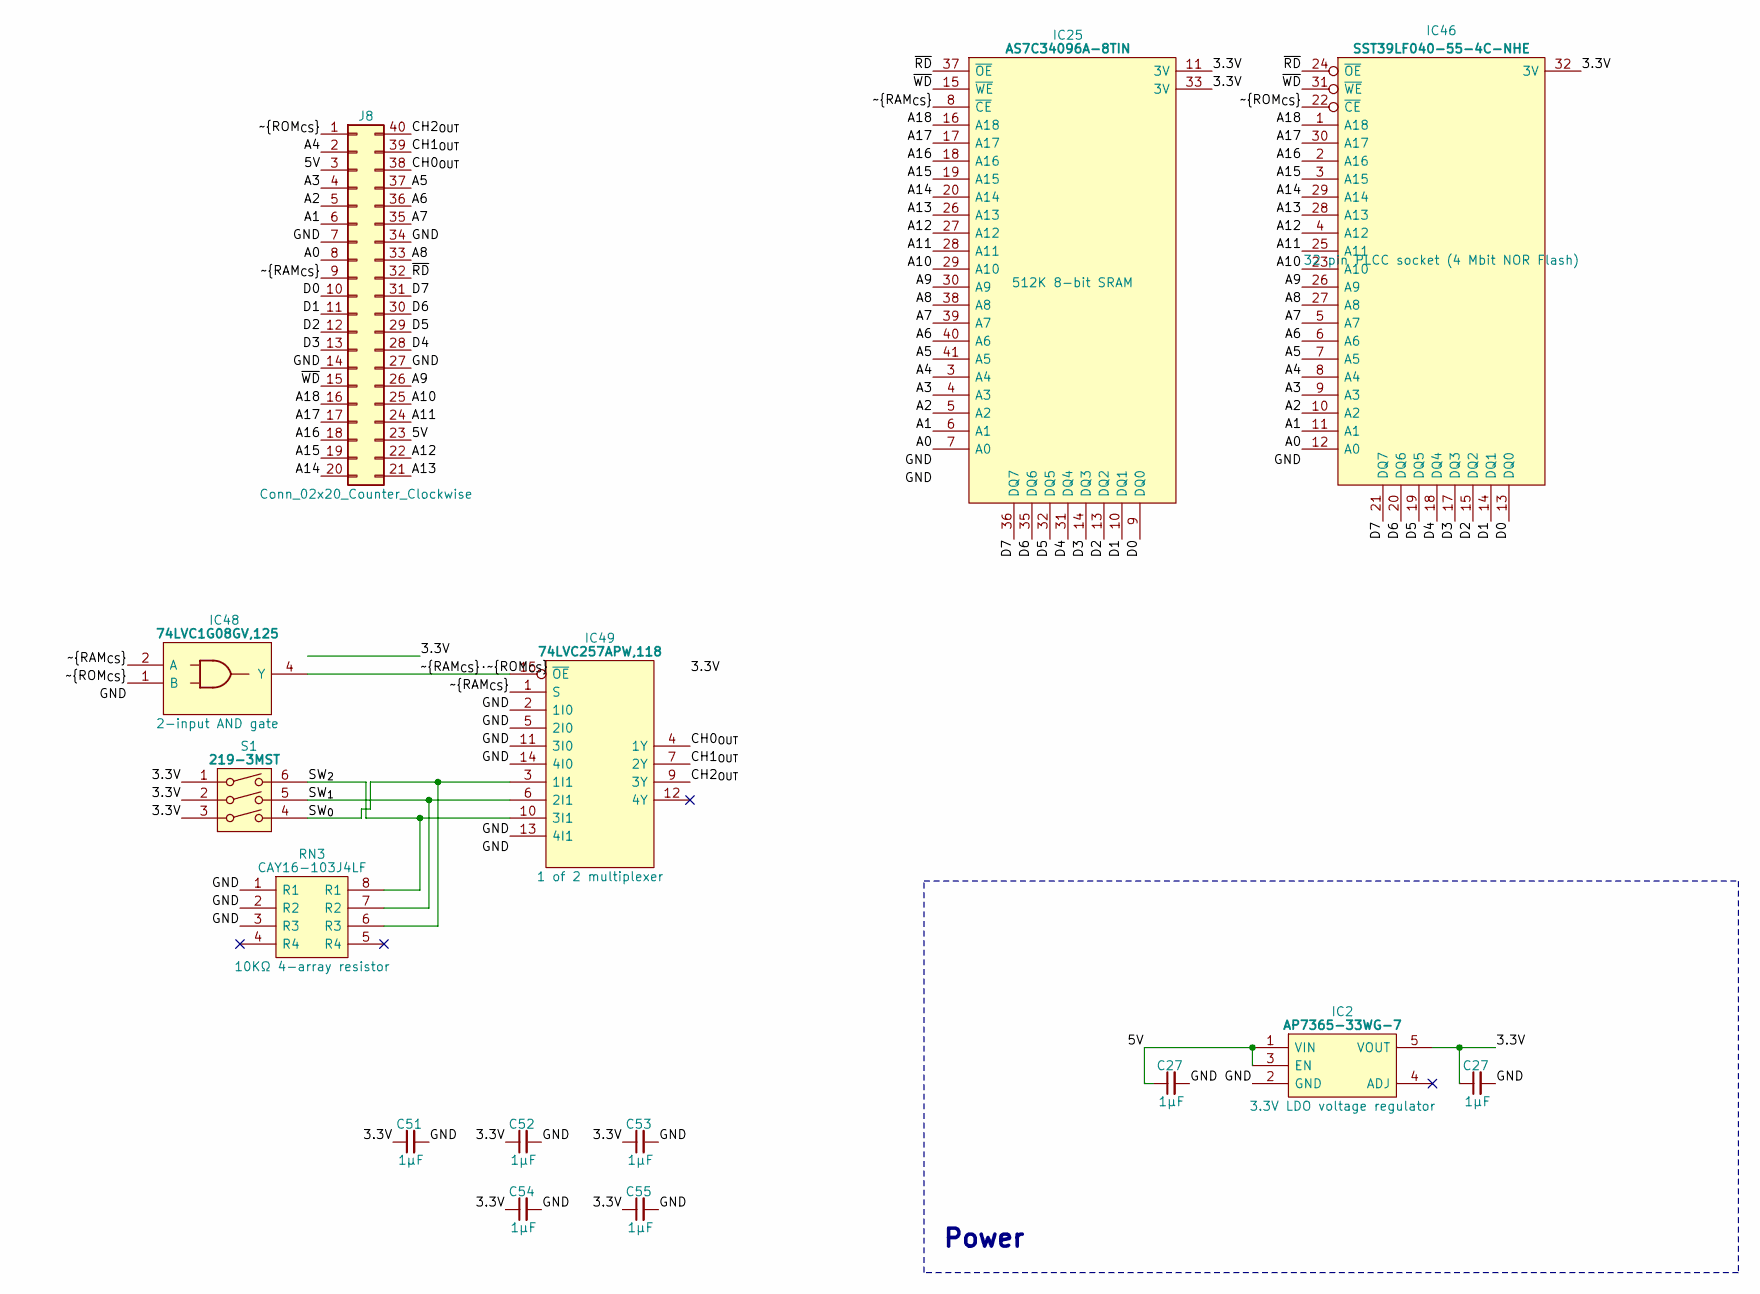
[picture p257: schematic Memory Board.kicad_sch]

Parts:
C27, C51, C52, C53, C54, C55: 1μF; C_0805
IC2: AP7365-33WG-7; SOT95P285X130-5N; Manufacturer_Part_Number AP7365-33WG-7; Mouser Part Number 621-AP7365-33WG-7
IC25: AS7C34096A-8TIN; SOP80P1176X120-44N; Manufacturer_Part_Number AS7C34096A-8TIN; Mouser Part Number 913-AS7C34096A-8TIN
IC46: SST39LF040-55-4C-NHE; 5408803224008; Manufacturer_Part_Number SST39LF040-55-4C-NHE
IC48: 74LVC1G08GV,125; SOT95P275X110-5N; Manufacturer_Part_Number 74LVC1G08GV,125; Mouser Part Number 771-74LVC1G08GV
IC49: 74LVC257APW,118; SOP65P640X110-16N; Mouser Part Number 771-74LVC257APW-T
J8: Conn_02x20_Counter_Clockwise; DIP-40_Board_W22.86mm
RN3: CAY16-103J4LF; CAY16-J4; Manufacturer_Part_Number CAY16-103J4LF; Mouser Part Number 652-CAY16-103J4LF
S1: 219-3MST; SOIC127P844X265-6N; Manufacturer_Part_Number 218-6LPST; Mouser Part Number 774-2186LPST

Connections:
3.3V: C27.1, C51.1, C52.1, C53.1, C54.1, C55.1, IC2.5 (VOUT), IC25.11 (3V), IC25.33 (3V), IC46.32 (3V), IC48.5 (3V), IC49.16 (3V), S1.1, S1.2, S1.3
5V: C27.1, IC2.1 (VIN), IC2.3 (EN), J8.3, J8.23
A0: IC25.7 (A0), IC46.12 (A0), J8.8
A1: IC25.6 (A1), IC46.11 (A1), J8.6
A2: IC25.5 (A2), IC46.10 (A2), J8.5
A3: IC25.4 (A3), IC46.9 (A3), J8.4
A4: IC25.3 (A4), IC46.8 (A4), J8.2
A5: IC25.41 (A5), IC46.7 (A5), J8.37
A6: IC25.40 (A6), IC46.6 (A6), J8.36
A7: IC25.39 (A7), IC46.5 (A7), J8.35
A8: IC25.38 (A8), IC46.27 (A8), J8.33
A9: IC25.30 (A9), IC46.26 (A9), J8.26
A10: IC25.29 (A10), IC46.23 (A10), J8.25
A11: IC25.28 (A11), IC46.25 (A11), J8.24
A12: IC25.27 (A12), IC46.4 (A12), J8.22
A13: IC25.26 (A13), IC46.28 (A13), J8.21
A14: IC25.20 (A14), IC46.29 (A14), J8.20
A15: IC25.19 (A15), IC46.3 (A15), J8.19
A16: IC25.18 (A16), IC46.2 (A16), J8.18
A17: IC25.17 (A17), IC46.30 (A17), J8.17
A18: IC25.16 (A18), IC46.1 (A18), J8.16
CH0_{OUT}: IC49.4 (1Y), J8.38
CH1_{OUT}: IC49.7 (2Y), J8.39
CH2_{OUT}: IC49.9 (3Y), J8.40
D0: IC25.9 (DQ0), IC46.13 (DQ0), J8.10
D1: IC25.10 (DQ1), IC46.14 (DQ1), J8.11
D2: IC25.13 (DQ2), IC46.15 (DQ2), J8.12
D3: IC25.14 (DQ3), IC46.17 (DQ3), J8.13
D4: IC25.31 (DQ4), IC46.18 (DQ4), J8.28
D5: IC25.32 (DQ5), IC46.19 (DQ5), J8.29
D6: IC25.35 (DQ6), IC46.20 (DQ6), J8.30
D7: IC25.36 (DQ7), IC46.21 (DQ7), J8.31
GND: C27.2, C51.2, C52.2, C53.2, C54.2, C55.2, IC2.2 (GND), IC25.12 (GND), IC25.34 (GND), IC46.16 (GND), IC48.3 (GND), IC49.2 (1I0), IC49.5 (2I0), IC49.8 (GND), IC49.11 (3I0), IC49.13 (4I1), IC49.14 (4I0), J8.7, J8.14, J8.27, J8.34, RN3.1 (R1), RN3.2 (R2), RN3.3 (R3)
SW_{0}: IC49.3 (1I1), RN3.6 (R3), S1.4
SW_{1}: IC49.6 (2I1), RN3.7 (R2), S1.5
SW_{2}: IC49.10 (3I1), RN3.8 (R1), S1.6
~RAM_{CS}: IC25.8 (~CE), IC48.2 (A), IC49.1 (S), J8.9
~RAM_{CS}·~ROM_{CS}: IC48.4 (Y), IC49.15 (~OE)
~RD: IC25.37 (~OE), IC46.24 (~OE), J8.32
~ROM_{CS}: IC46.22 (~CE), IC48.1 (B), J8.1
~WD: IC25.15 (~WE), IC46.31 (~WE), J8.15

Notes on the sheet:
Power
