andrewpaterson/658-Computer/Kicad/Computer/MPU Breakout/W65C816 Breakout Board.kicad_sch

## KiCad design Kicad/Computer/MPU Breakout/W65C816 Breakout Board.kicad_sch (2023-11-14)

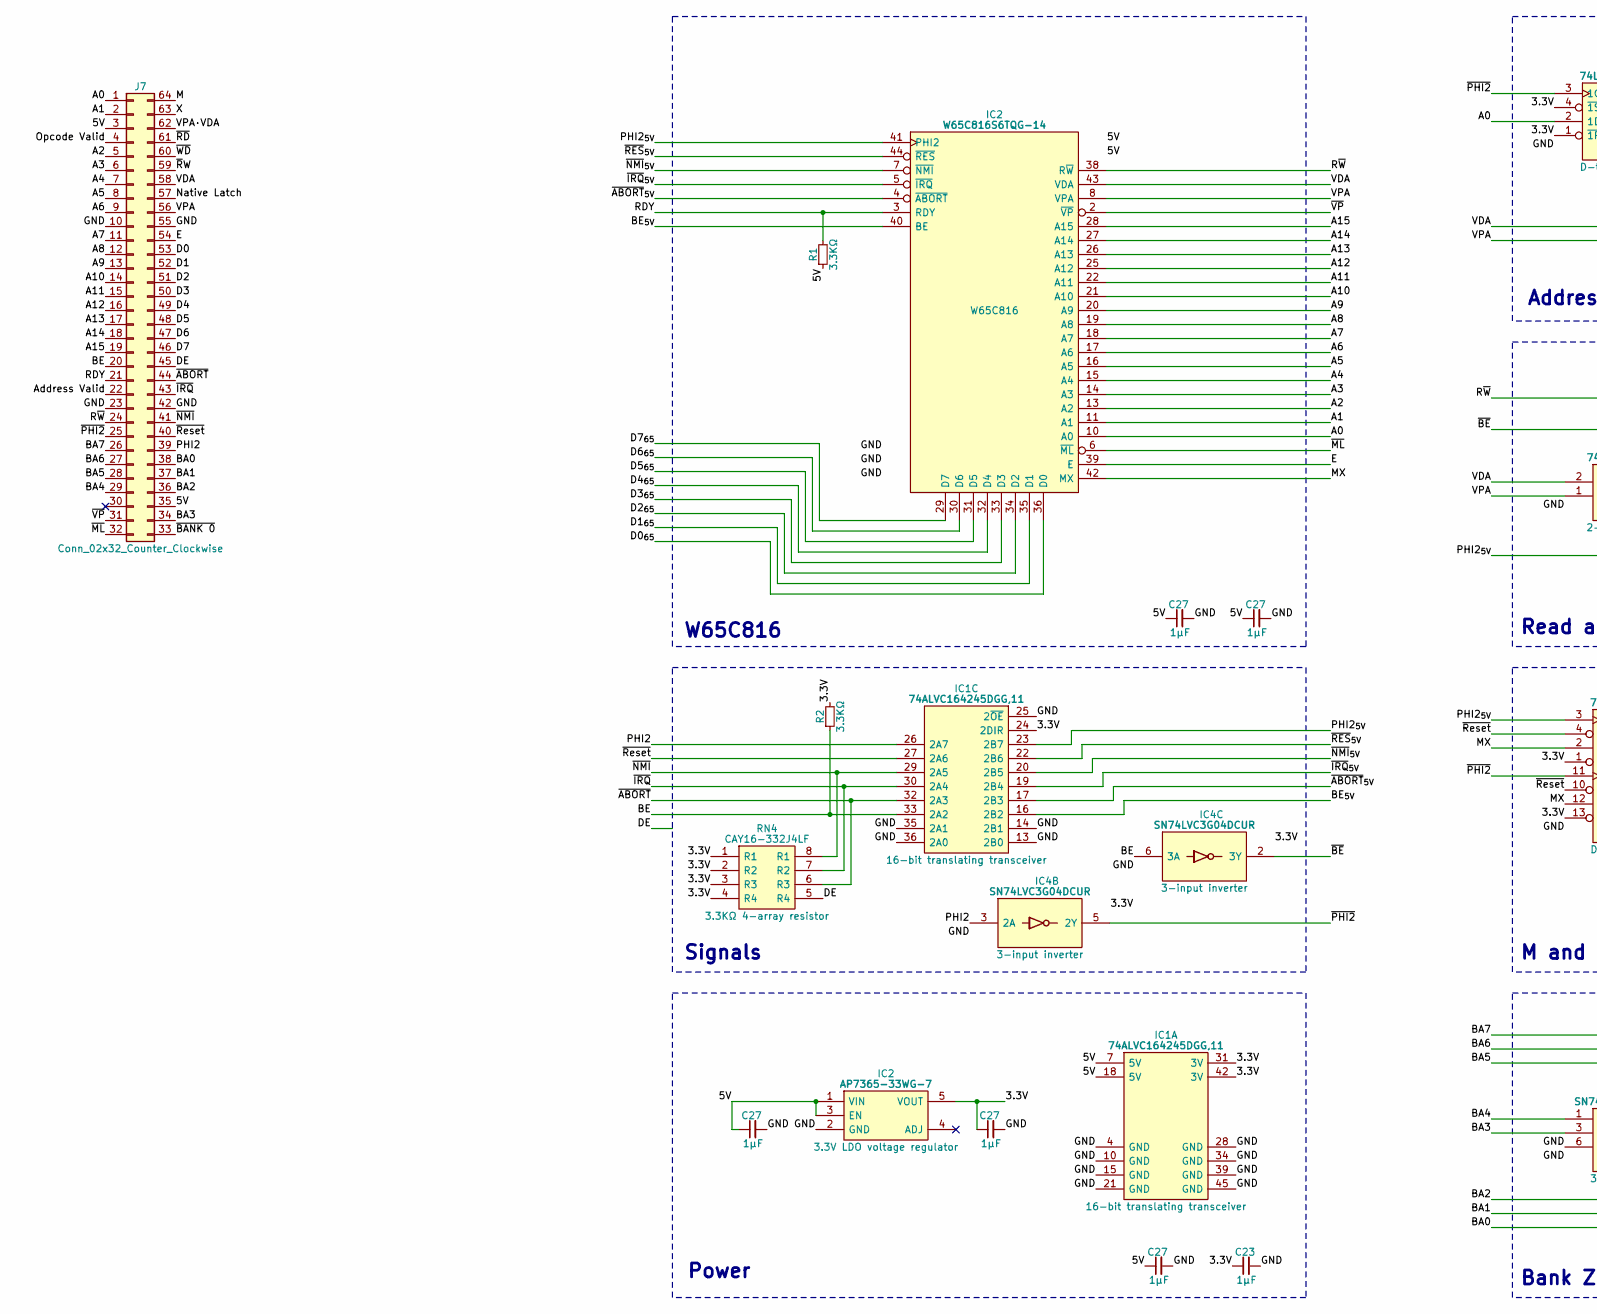
[picture p258: schematic W65C816 Breakout Board.kicad_sch, part in row 1, column 1]

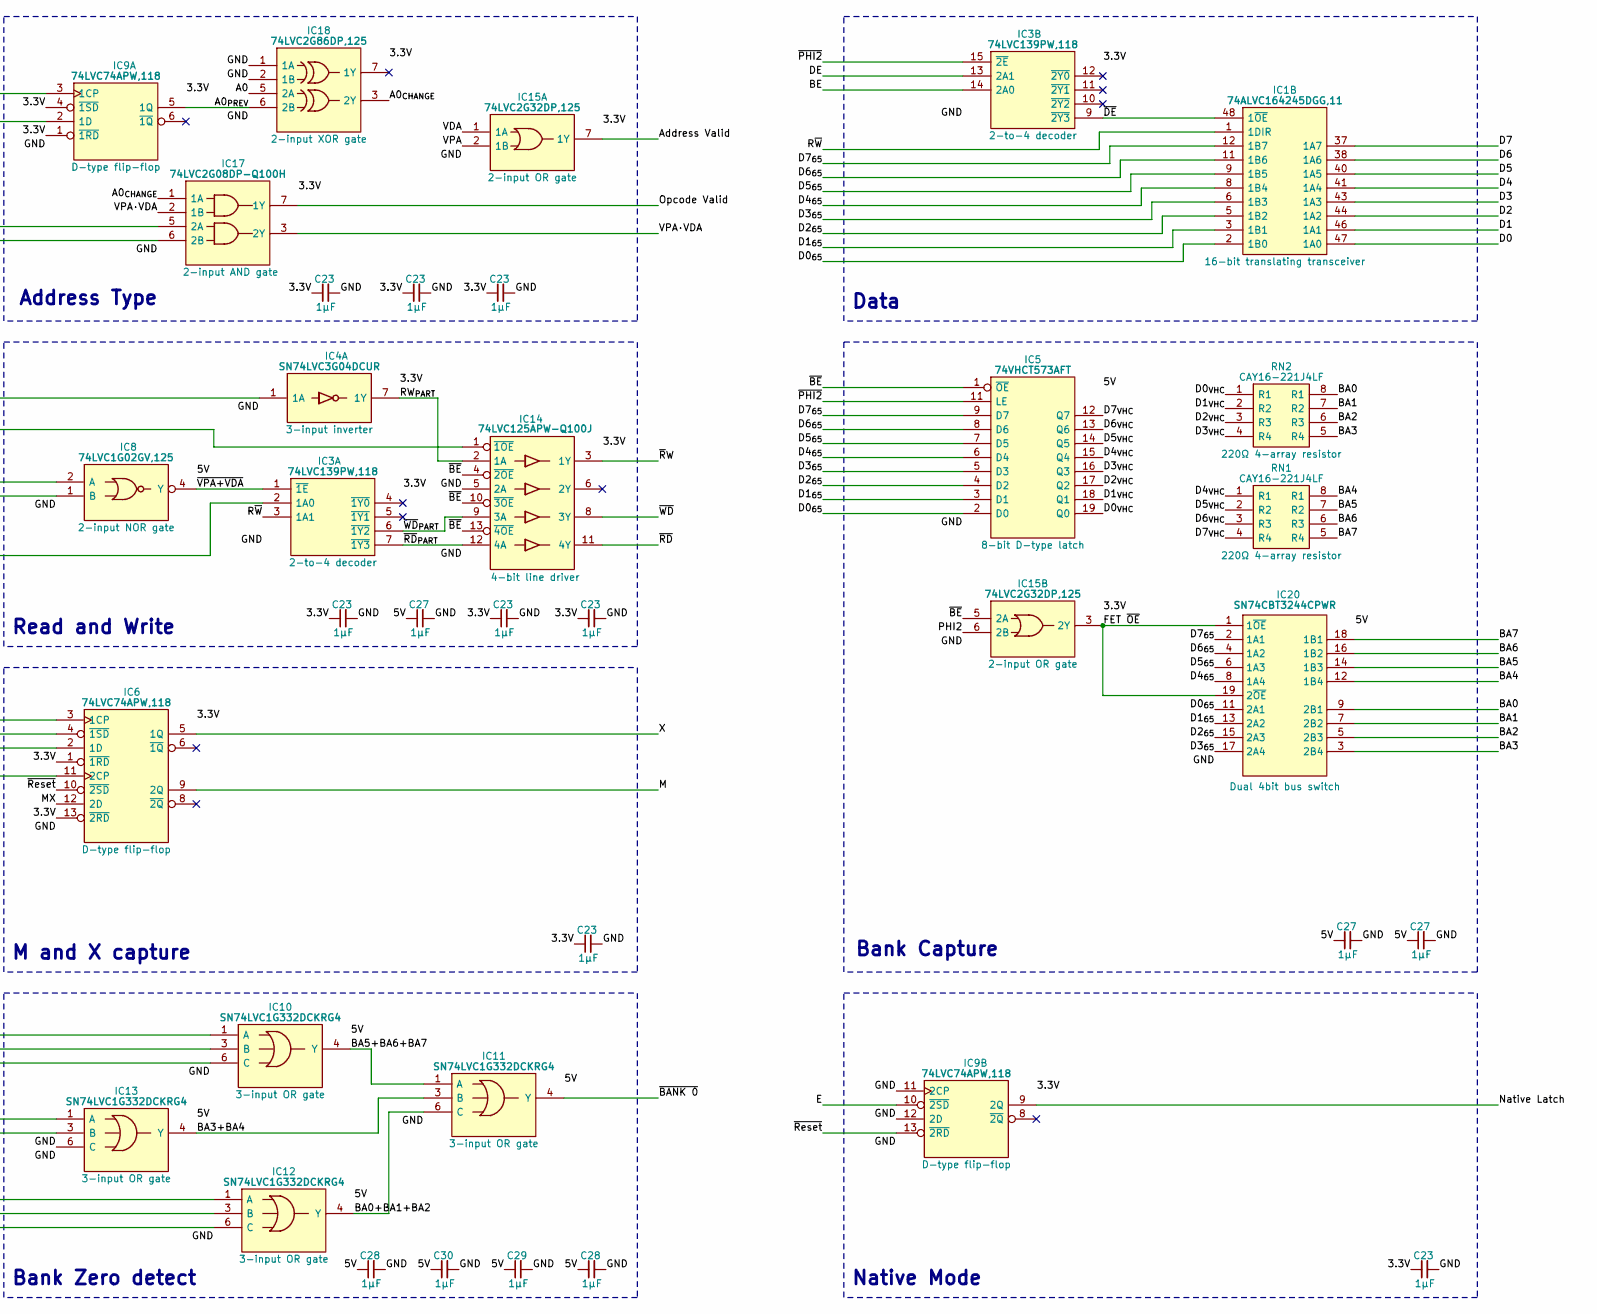
[picture p259: schematic W65C816 Breakout Board.kicad_sch, part in row 1, column 2]

Parts:
C23, C27, C28, C29, C30: 1μF; C_0805
IC1: 74ALVC164245DGG,11; SOP50P810X120-48N; Mouser Part Number 771-74ALVC164245
IC2: W65C816S6TQG-14; W65C816 PLCC 0.8mm 44 Pin; Mouser Part Number 955-W65C816S6TQG-14
IC3: 74LVC139PW,118; SOP65P640X110-16N
IC4: SN74LVC3G04DCUR; SOP50P310X90-8N; Manufacturer_Part_Number SN74LVC3G04DCUR; Mouser Part Number 595-SN74LVC3G04DCUR
IC5: 74VHCT573AFT; SOP65P640X120-20N; Manufacturer_Part_Number 74VHCT573AFT; Mouser Part Number N/A
IC6, IC9: 74LVC74APW,118; SOP65P640X110-14N; Mouser Part Number 771-74LVC74APW-T
IC8: 74LVC1G02GV,125; SOT95P275X110-5N; Manufacturer_Part_Number 74LVC1G02GV,125; Mouser Part Number 771-LVC1G02GV125
IC10, IC11, IC12, IC13: SN74LVC1G332DCKRG4; SOT65P210X110-6N; Mouser Part Number 595-LVC1G332DCKRG4
IC14: 74LVC125APW-Q100J; SOP65P640X110-14N; Manufacturer_Part_Number 74LVC125APW-Q100J; Mouser Part Number 771-74LVC125APWQ100J
IC15: 74LVC2G32DP,125; SOP65P400X110-8N; Manufacturer_Part_Number 74LVC2G32DP,125; Mouser Part Number 771-LVC2G32DP125
IC17: 74LVC2G08DP-Q100H; SOP65P400X110-8N; Manufacturer_Part_Number 74LVC2G08DP-Q100H; Mouser Part Number 771-74LVC2G08DPQ100H
IC18: 74LVC2G86DP,125; SOP65P400X110-8N; Manufacturer_Part_Number 74LVC2G86DP,125; Mouser Part Number 771-LVC2G86DP125
IC20: SN74CBT3244CPWR; SOP65P640X120-20N; Manufacturer_Part_Number SN74CBT3244CPWR; Mouser Part Number 595-SN74CBT3244CPWR
J7: Conn_02x32_Counter_Clockwise; DIP-64_Board_W22.86mm
R1, R2: 3.3KΩ; R_0805
RN1, RN2: CAY16-221J4LF; CAY1647R0F4LF; Manufacturer_Part_Number CAY16-221J4LF; Mouser Part Number 652-CAY16-221J4LF
RN4: CAY16-332J4LF; CAY16332J4LF

Connections:
3.3V: C23.1, C27.1, IC1.24 (2DIR), IC1.31 (3V), IC1.42 (3V), IC2.5 (VOUT), IC3.16 (3V), IC4.8 (3V), IC6.1 (~1RD), IC6.13 (~2RD), IC6.14 (3V), IC9.1 (~1RD), IC9.4 (~1SD), IC9.14 (3V), IC14.14 (3V), IC15.8 (VCC), IC17.8 (3V), IC18.8 (VCC), R2.2, RN4.1 (R1), RN4.2 (R2), RN4.3 (R3), RN4.4 (R4)
5V: C27.1, C28.1, C29.1, C30.1, IC1.7 (5V), IC1.18 (5V), IC2.1 (VIN), IC2.3 (EN), IC2.9 (VCC), IC2.37 (VCC), IC5.20 (5V), IC8.5 (3V), IC10.5 (3V), IC11.5 (3V), IC12.5 (3V), IC13.5 (3V), IC20.20 (5V), J7.3, J7.35, R1.1
A0: IC2.10 (A0), IC9.2 (1D), IC18.5 (2A), J7.1
A0_{CHANGE}: IC17.1 (1A), IC18.3 (2Y)
A0_{PREV}: IC9.5 (1Q), IC18.6 (2B)
A1: IC2.11 (A1), J7.2
A2: IC2.13 (A2), J7.5
A3: IC2.14 (A3), J7.6
A4: IC2.15 (A4), J7.7
A5: IC2.16 (A5), J7.8
A6: IC2.17 (A6), J7.9
A7: IC2.18 (A7), J7.11
A8: IC2.19 (A8), J7.12
A9: IC2.20 (A9), J7.13
A10: IC2.21 (A10), J7.14
A11: IC2.22 (A11), J7.15
A12: IC2.25 (A12), J7.16
A13: IC2.26 (A13), J7.17
A14: IC2.27 (A14), J7.18
A15: IC2.28 (A15), J7.19
Address Valid: IC15.7 (1Y), J7.22
BA0: IC12.6 (C), IC20.9 (2B1), J7.38, RN2.8 (R1)
BA0+BA1+BA2: IC11.6 (C), IC12.4 (Y)
BA1: IC12.3 (B), IC20.7 (2B2), J7.37, RN2.7 (R2)
BA2: IC12.1 (A), IC20.5 (2B3), J7.36, RN2.6 (R3)
BA3: IC13.3 (B), IC20.3 (2B4), J7.34, RN2.5 (R4)
BA3+BA4: IC11.3 (B), IC13.4 (Y)
BA4: IC13.1 (A), IC20.12 (1B4), J7.29, RN1.8 (R1)
BA5: IC10.6 (C), IC20.14 (1B3), J7.28, RN1.7 (R2)
BA5+BA6+BA7: IC10.4 (Y), IC11.1 (A)
BA6: IC10.3 (B), IC20.16 (1B2), J7.27, RN1.6 (R3)
BA7: IC10.1 (A), IC20.18 (1B1), J7.26, RN1.5 (R4)
BE: IC1.33 (2A2), IC3.14 (2A0), IC4.6 (3A), J7.20, R2.1
BE_{5V}: IC1.16 (2B2), IC2.40 (BE)
D0: IC1.47 (1A0), J7.53
D0_{65}: IC1.2 (1B0), IC2.36 (D0), IC5.2 (D0), IC20.11 (2A1)
D0_{VHC}: IC5.19 (Q0), RN2.1 (R1)
D1: IC1.46 (1A1), J7.52
D1_{65}: IC1.3 (1B1), IC2.35 (D1), IC5.3 (D1), IC20.13 (2A2)
D1_{VHC}: IC5.18 (Q1), RN2.2 (R2)
D2: IC1.44 (1A2), J7.51
D2_{65}: IC1.5 (1B2), IC2.34 (D2), IC5.4 (D2), IC20.15 (2A3)
D2_{VHC}: IC5.17 (Q2), RN2.3 (R3)
D3: IC1.43 (1A3), J7.50
D3_{65}: IC1.6 (1B3), IC2.33 (D3), IC5.5 (D3), IC20.17 (2A4)
D3_{VHC}: IC5.16 (Q3), RN2.4 (R4)
D4: IC1.41 (1A4), J7.49
D4_{65}: IC1.8 (1B4), IC2.32 (D4), IC5.6 (D4), IC20.8 (1A4)
D4_{VHC}: IC5.15 (Q4), RN1.1 (R1)
D5: IC1.40 (1A5), J7.48
D5_{65}: IC1.9 (1B5), IC2.31 (D5), IC5.7 (D5), IC20.6 (1A3)
D5_{VHC}: IC5.14 (Q5), RN1.2 (R2)
D6: IC1.38 (1A6), J7.47
D6_{65}: IC1.11 (1B6), IC2.30 (D6), IC5.8 (D6), IC20.4 (1A2)
D6_{VHC}: IC5.13 (Q6), RN1.3 (R3)
D7: IC1.37 (1A7), J7.46
D7_{65}: IC1.12 (1B7), IC2.29 (D7), IC5.9 (D7), IC20.2 (1A1)
D7_{VHC}: IC5.12 (Q7), RN1.4 (R4)
DE: IC3.13 (2A1), J7.45, RN4.5 (R4)
E: IC2.39 (E), IC9.10 (~2SD), J7.54
FET ~OE: IC15.3 (2Y), IC20.1 (1~OE), IC20.19 (2~OE)
GND: C23.2, C27.2, C28.2, C29.2, C30.2, IC1.4 (GND), IC1.10 (GND), IC1.13 (2B0), IC1.14 (2B1), IC1.15 (GND), IC1.21 (GND), IC1.25 (2~OE), IC1.28 (GND), IC1.34 (GND), IC1.35 (2A1), IC1.36 (2A0), IC1.39 (GND), IC1.45 (GND), IC2.1 (VIN), IC2.2 (GND), IC2.23 (GND), IC2.24 (GND), IC3.8 (GND), IC4.4 (GND), IC5.10 (GND), IC6.7 (GND), IC8.3 (GND), IC9.7 (GND), IC9.11 (2CP), IC9.12 (2D), IC10.2 (GND), IC11.2 (GND), IC12.2 (GND), IC13.2 (GND), IC13.6 (C), IC14.5 (2A), IC14.7 (GND), IC15.4 (GND), IC17.4 (GND), IC18.1 (1A), IC18.2 (1B), IC18.4 (GND), IC20.10 (GND), J7.10, J7.23, J7.42, J7.55
M: IC6.9 (2Q), J7.64
MX: IC2.42 (MX), IC6.2 (1D), IC6.12 (2D)
Native Latch: IC9.9 (2Q), J7.57
Opcode Valid: IC17.7 (1Y), J7.4
PHI2: IC1.26 (2A7), IC4.3 (2A), IC15.6 (2B), J7.39
PHI2_{5V}: IC1.23 (2B7), IC2.41 (PHI2), IC3.2 (1A0), IC6.3 (1CP)
RDY: IC2.3 (EN), J7.21, R1.2
RW_{PART}: IC4.7 (1Y), IC14.2 (1A)
R~W: IC1.1 (1DIR), IC2.38 (R~W), IC3.3 (1A1), IC4.1 (1A), J7.24
VDA: IC2.43 (VDA), IC8.2 (A), IC15.1 (1A), IC17.5 (2A), J7.58
VPA: IC2.8 (VPA), IC8.1 (B), IC15.2 (1B), IC17.6 (2B), J7.56
VPA·VDA: IC17.2 (1B), IC17.3 (2Y), J7.62
X: IC6.5 (1Q), J7.63
~ABORT: IC1.32 (2A3), J7.44, RN4.6 (R3)
~ABORT_{5V}: IC1.17 (2B3), IC2.4 (ADJ)
~BANK 0: IC11.4 (Y), J7.33
~BE: IC4.2 (3Y), IC5.1 (~OE), IC14.1 (~1OE), IC14.4 (~2OE), IC14.10 (~3OE), IC14.13 (~4OE), IC15.5 (2A)
~DE: IC1.48 (1~OE), IC3.9 (~2Y3)
~IRQ: IC1.30 (2A4), J7.43, RN4.7 (R2)
~IRQ_{5V}: IC1.19 (2B4), IC2.5 (VOUT)
~ML: IC2.6 (~ML), J7.32
~NMI: IC1.29 (2A5), J7.41, RN4.8 (R1)
~NMI_{5V}: IC1.20 (2B5), IC2.7 (~NMI)
~PHI2: IC3.15 (~2E), IC4.5 (2Y), IC5.11 (LE), IC6.11 (2CP), IC9.3 (1CP), J7.25
~RD: IC14.11 (4Y), J7.61
~RD_{PART}: IC3.7 (~1Y3), IC14.12 (4A)
~RES_{5V}: IC1.22 (2B6), IC2.44 (~RES)
~Reset: IC1.27 (2A6), IC6.4 (~1SD), IC6.10 (~2SD), IC9.13 (~2RD), J7.40
~RW: IC14.3 (1Y), J7.59
~VPA+VDA: IC3.1 (~1E), IC8.4 (Y)
~VP: IC2.2 (GND), J7.31
~WD: IC14.8 (3Y), J7.60
~WD_{PART}: IC3.6 (~1Y2), IC14.9 (3A)

Notes on the sheet:
Data
Bank Zero detect
Read and Write
Bank Capture
Address Type
M and X capture
Power
W65C816
Native Mode
Signals
