andrewpaterson/658-Computer/Kicad/Computer/Standard PCB/Standard PCB.kicad_sch

## KiCad design Kicad/Computer/Standard PCB/Standard PCB.kicad_sch (2023-11-26)

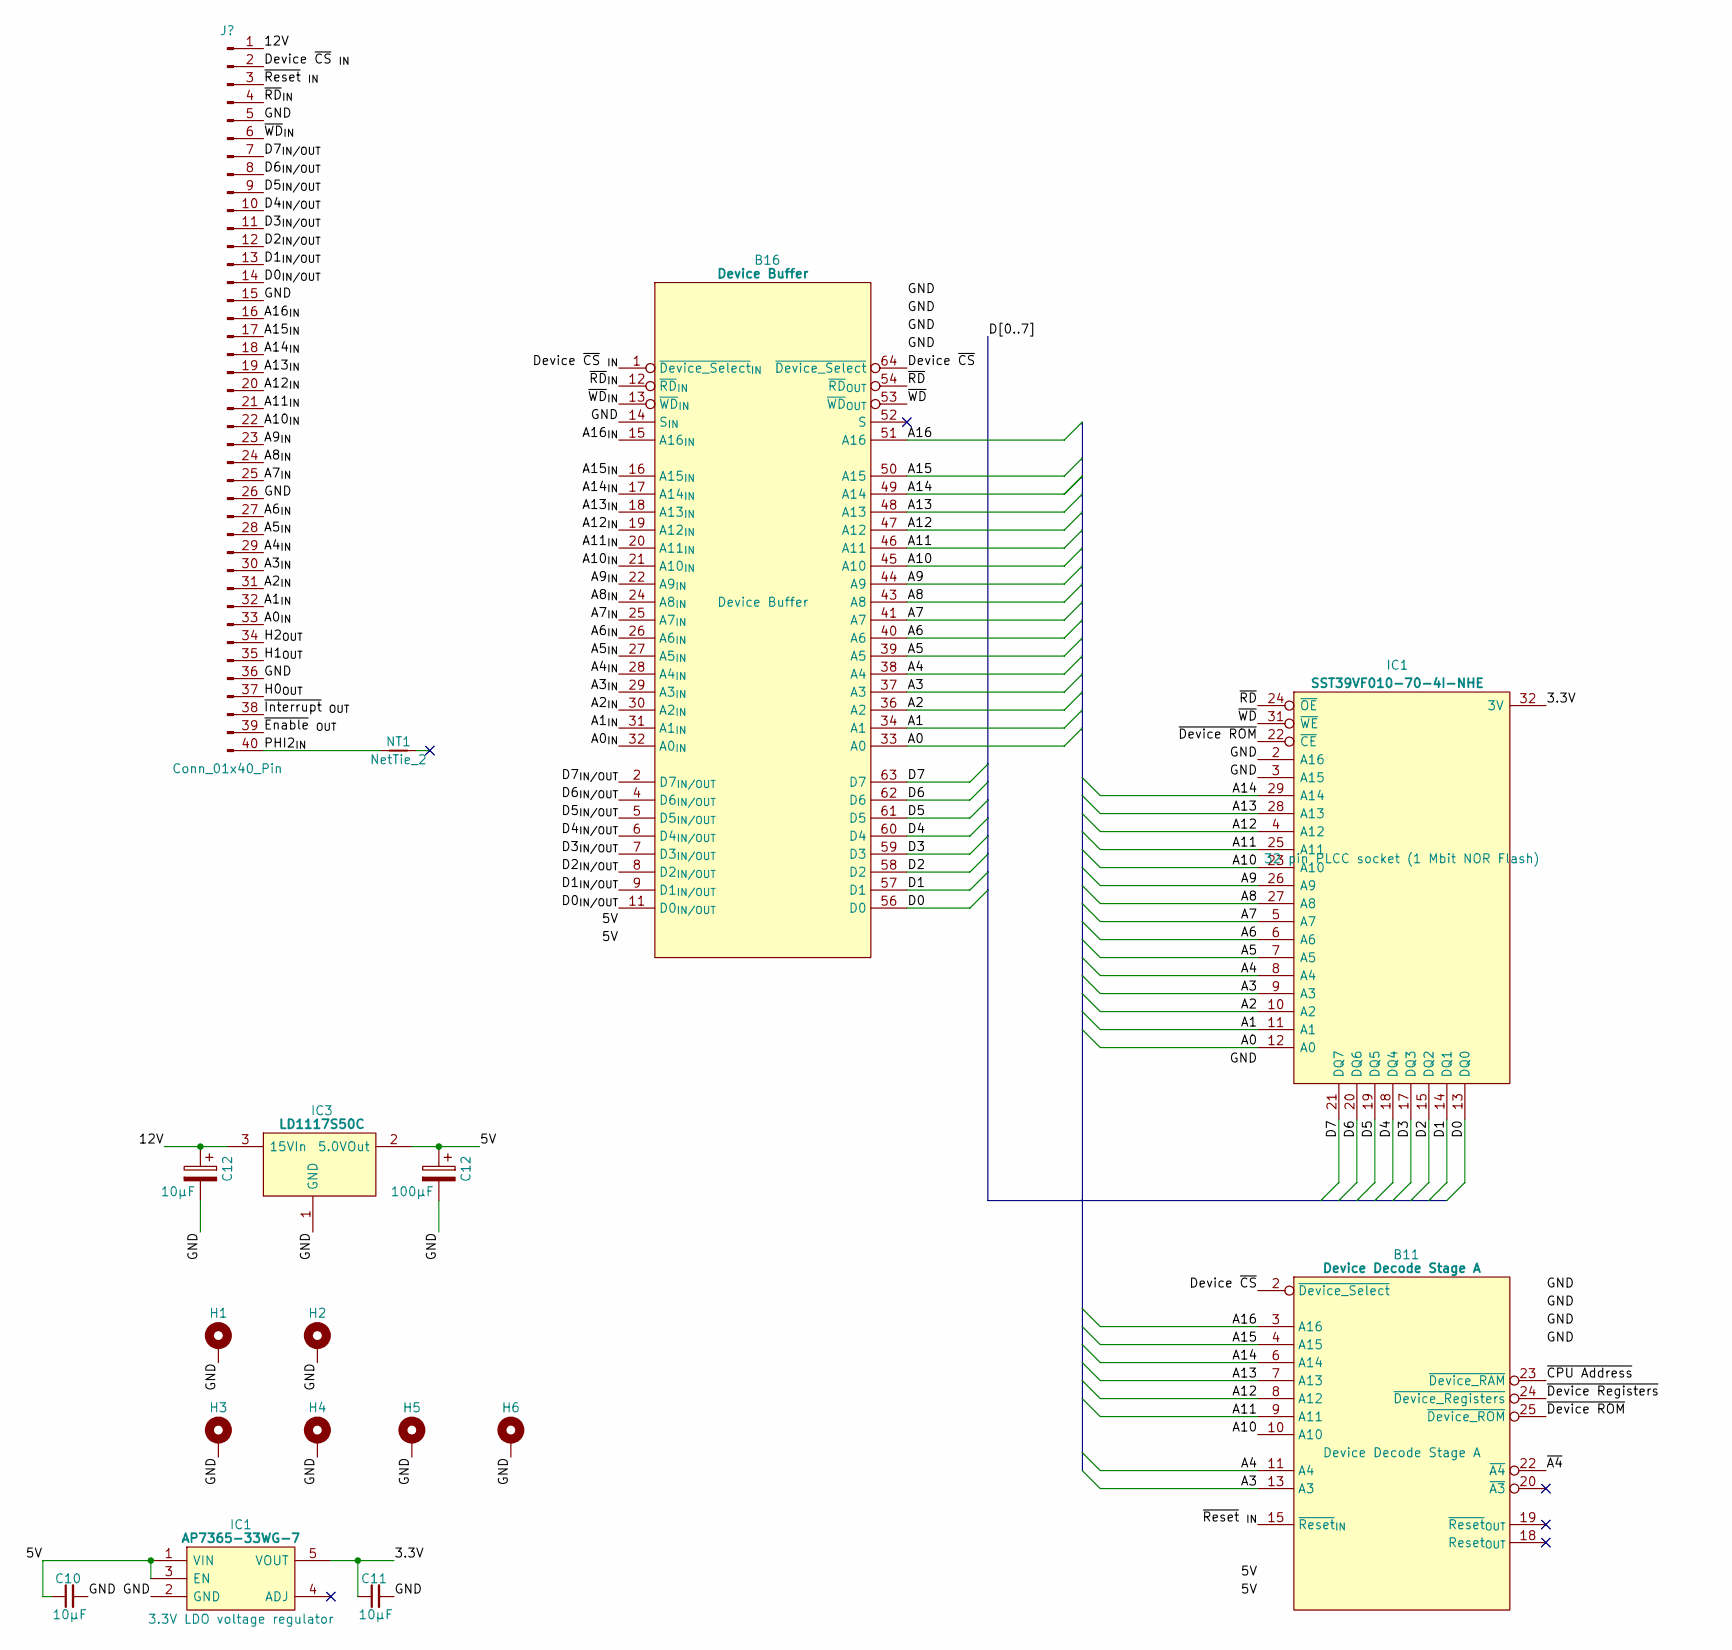
[picture p260: schematic Standard PCB.kicad_sch]

Parts:
B11: Device Decode Stage A; HCP65_Device_Decode_Stage_A
B16: Device Buffer; HCP65_Device_Buffer
C10, C11: 10µF; C_0805
C12: C_Polarized; CP_Radial_D4.0mm_P2.00mm
H1, H2, H3, H4, H5, H6: MountingHole_Pad; HCP65_MountingHole_M3_
IC1: AP7365-33WG-7; SOT95P285X130-5N; Manufacturer_Part_Number AP7365-33WG-7; Mouser Part Number 621-AP7365-33WG-7
IC3: LD1117S50C; LD1117S33C; Manufacturer_Part_Number LD1117S50C
J1: Conn_01x40_Pin; PinHeader_1x40_P2.54mm_Vertical
NT1: NetTie_2; NetTie-2_SMD_Pad0.5mm

Connections:
3.3V: C11.1, IC1.5 (A7), IC1.32 (3V)
5V: B11.1 (5V), B11.17 (5V), B16.3 (5V), B16.35 (5V), C10.1, C12.1, IC1.1 (N.C.), IC1.3 (A15), IC3.2 (5.0VOut)
12V: C12.1, IC3.3 (15VIn), J1.1
A0: B16.33 (A0), IC1.12 (A0)
A0_{IN}: B16.32 (A0_{IN}), J1.33
A1: B16.34 (A1), IC1.11 (A1)
A1_{IN}: B16.31 (A1_{IN}), J1.32
A2: B16.36 (A2), IC1.10 (A2)
A2_{IN}: B16.30 (A2_{IN}), J1.31
A3: B11.13 (A3), B16.37 (A3), IC1.9 (A3)
A3_{IN}: B16.29 (A3_{IN}), J1.30
A4: B11.11 (A4), B16.38 (A4), IC1.8 (A4)
A4_{IN}: B16.28 (A4_{IN}), J1.29
A5: B16.39 (A5), IC1.7 (A5)
A5_{IN}: B16.27 (A5_{IN}), J1.28
A6: B16.40 (A6), IC1.6 (A6)
A6_{IN}: B16.26 (A6_{IN}), J1.27
A7: B16.41 (A7), IC1.5 (A7)
A7_{IN}: B16.25 (A7_{IN}), J1.25
A8: B16.43 (A8), IC1.27 (A8)
A8_{IN}: B16.24 (A8_{IN}), J1.24
A9: B16.44 (A9), IC1.26 (A9)
A9_{IN}: B16.22 (A9_{IN}), J1.23
A10: B11.10 (A10), B16.45 (A10), IC1.23 (A10)
A10_{IN}: B16.21 (A10_{IN}), J1.22
A11: B11.9 (A11), B16.46 (A11), IC1.25 (A11)
A11_{IN}: B16.20 (A11_{IN}), J1.21
A12: B11.8 (A12), B16.47 (A12), IC1.4 (A12)
A12_{IN}: B16.19 (A12_{IN}), J1.20
A13: B11.7 (A13), B16.48 (A13), IC1.28 (A13)
A13_{IN}: B16.18 (A13_{IN}), J1.19
A14: B11.6 (A14), B16.49 (A14), IC1.29 (A14)
A14_{IN}: B16.17 (A14_{IN}), J1.18
A15: B11.4 (A15), B16.50 (A15)
A15_{IN}: B16.16 (A15_{IN}), J1.17
A16: B11.3 (A16), B16.51 (A16)
A16_{IN}: B16.15 (A16_{IN}), J1.16
D0: B16.56 (D0), IC1.13 (DQ0)
D0_{IN/OUT}: B16.11 (D0_{IN/OUT}), J1.14
D1: B16.57 (D1), IC1.14 (DQ1)
D1_{IN/OUT}: B16.9 (D1_{IN/OUT}), J1.13
D2: B16.58 (D2), IC1.15 (DQ2)
D2_{IN/OUT}: B16.8 (D2_{IN/OUT}), J1.12
D3: B16.59 (D3), IC1.17 (DQ3)
D3_{IN/OUT}: B16.7 (D3_{IN/OUT}), J1.11
D4: B16.60 (D4), IC1.18 (DQ4)
D4_{IN/OUT}: B16.6 (D4_{IN/OUT}), J1.10
D5: B16.61 (D5), IC1.19 (DQ5)
D5_{IN/OUT}: B16.5 (D5_{IN/OUT}), J1.9
D6: B16.62 (D6), IC1.20 (DQ6)
D6_{IN/OUT}: B16.4 (D6_{IN/OUT}), J1.8
D7: B16.63 (D7), IC1.21 (DQ7)
D7_{IN/OUT}: B16.2 (D7_{IN/OUT}), J1.7
Device ~CS: B11.2 (~Device_Select), B16.64 (~Device_Select)
Device ~CS _{IN}: B16.1 (~Device_Select_{IN}), J1.2
GND: B11.5 (GND), B11.12 (GND), B11.21 (GND), B11.28 (GND), B16.10 (GND), B16.14 (S_{IN}), B16.23 (GND), B16.42 (GND), B16.55 (GND), C10.2, C11.2, C12.2, H1.1, H2.1, H3.1, H4.1, H5.1, H6.1, IC1.2 (A16), IC1.3 (A15), IC1.16 (GND), IC3.1 (GND), J1.5, J1.15, J1.26, J1.36
H0_{OUT}: J1.37
H1_{OUT}: J1.35
H2_{OUT}: J1.34
PHI2_{IN}: J1.40, NT1.1
~A4: B11.22 (~A4)
~CPU Address: B11.23 (~Device_RAM)
~Device ROM: B11.25 (~Device_ROM), IC1.22 (~CE)
~Device Registers: B11.24 (~Device_Registers)
~Enable _{OUT}: J1.39
~Interrupt _{OUT}: J1.38
~RD: B16.54 (~RD_{OUT}), IC1.24 (~OE)
~RD_{IN}: B16.12 (~RD_{IN}), J1.4
~Reset _{IN}: B11.15 (~Reset_{IN}), J1.3
~WD: B16.53 (~WD_{OUT}), IC1.31 (~WE)
~WD_{IN}: B16.13 (~WD_{IN}), J1.6
