andrewpaterson/658-Computer/Kicad/Computer/VIA Device/W65C22 Breakout Board.kicad_sch

## KiCad design Kicad/Computer/VIA Device/W65C22 Breakout Board.kicad_sch (2023-10-03)

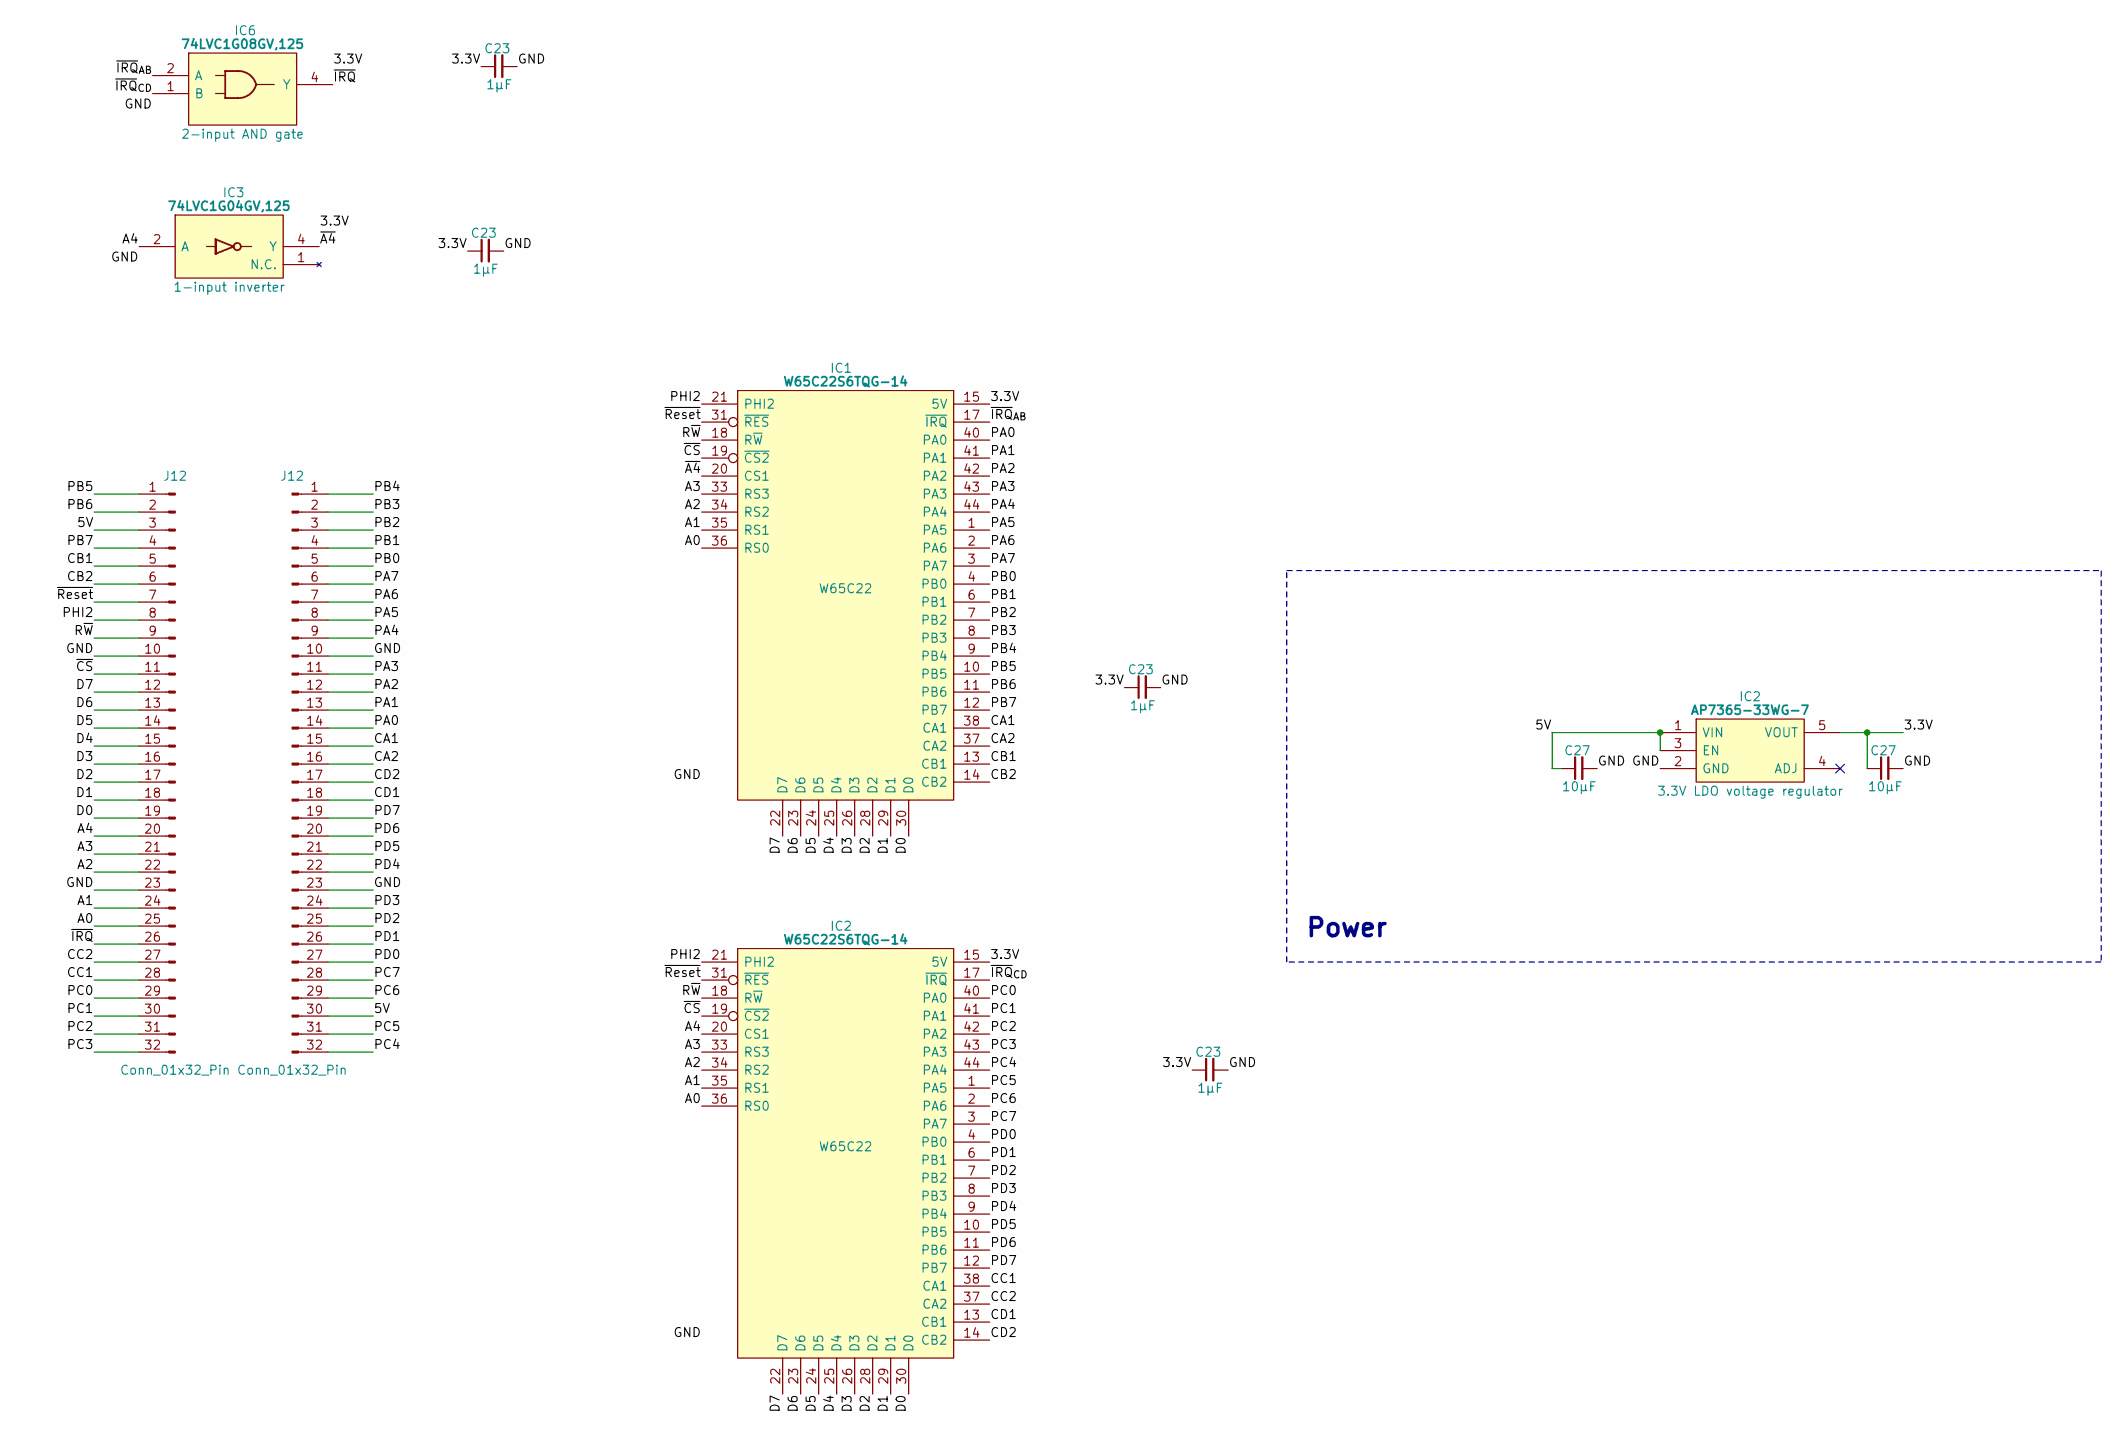
[picture p263: schematic W65C22 Breakout Board.kicad_sch]

Parts:
C23: 1μF; C_0805
C27: 10μF; C_0805
IC1: W65C22S6TQG-14; QFP80P1320X1320X270-44N; Mouser Part Number 955-W65C22S6TQG-14
IC2: AP7365-33WG-7; SOT95P285X130-5N; Manufacturer_Part_Number AP7365-33WG-7; Mouser Part Number 621-AP7365-33WG-7
IC3: 74LVC1G04GV,125; SOT95P275X110-5N; Manufacturer_Part_Number 74LVC1G04GV,125; Mouser Part Number 771-74LVC1G04GV
IC6: 74LVC1G08GV,125; SOT95P275X110-5N; Manufacturer_Part_Number 74LVC1G08GV,125; Mouser Part Number 771-74LVC1G08GV
J12: Conn_01x32_Pin; PinHeader_1x32_P2.54mm_Vertical

Connections:
3.3V: C23.1, C27.1, IC1.15 (5V), IC2.5 (N.C.), IC2.15 (5V), IC3.5 (3V), IC6.5 (3V)
5V: C27.1, IC2.1 (PA5), IC2.3 (PA7), J12.3, J12.30
A0: IC1.36 (RS0), IC2.36 (RS0), J12.25
A1: IC1.35 (RS1), IC2.35 (RS1), J12.24
A2: IC1.34 (RS2), IC2.34 (RS2), J12.22
A3: IC1.33 (RS3), IC2.33 (RS3), J12.21
A4: IC2.20 (CS1), IC3.2 (A), J12.20
CA1: IC1.38 (CA1), J12.15
CA2: IC1.37 (CA2), J12.16
CB1: IC1.13 (CB1), J12.5
CB2: IC1.14 (CB2), J12.6
CC1: IC2.38 (CA1), J12.28
CC2: IC2.37 (CA2), J12.27
CD1: IC2.13 (CB1), J12.18
CD2: IC2.14 (CB2), J12.17
D0: IC1.30 (D0), IC2.30 (D0), J12.19
D1: IC1.29 (D1), IC2.29 (D1), J12.18
D2: IC1.28 (D2), IC2.28 (D2), J12.17
D3: IC1.26 (D3), IC2.26 (D3), J12.16
D4: IC1.25 (D4), IC2.25 (D4), J12.15
D5: IC1.24 (D5), IC2.24 (D5), J12.14
D6: IC1.23 (D6), IC2.23 (D6), J12.13
D7: IC1.22 (D7), IC2.22 (D7), J12.12
GND: C23.2, C27.2, IC1.39 (GND), IC2.2 (PA6), IC2.39 (GND), IC3.3 (GND), IC6.3 (GND), J12.10, J12.23
PA0: IC1.40 (PA0), J12.14
PA1: IC1.41 (PA1), J12.13
PA2: IC1.42 (PA2), J12.12
PA3: IC1.43 (PA3), J12.11
PA4: IC1.44 (PA4), J12.9
PA5: IC1.1 (PA5), J12.8
PA6: IC1.2 (PA6), J12.7
PA7: IC1.3 (PA7), J12.6
PB0: IC1.4 (PB0), J12.5
PB1: IC1.6 (PB1), J12.4
PB2: IC1.7 (PB2), J12.3
PB3: IC1.8 (PB3), J12.2
PB4: IC1.9 (PB4), J12.1
PB5: IC1.10 (PB5), J12.1
PB6: IC1.11 (PB6), J12.2
PB7: IC1.12 (PB7), J12.4
PC0: IC2.40 (PA0), J12.29
PC1: IC2.41 (PA1), J12.30
PC2: IC2.42 (PA2), J12.31
PC3: IC2.43 (PA3), J12.32
PC4: IC2.44 (PA4), J12.32
PC5: IC2.1 (PA5), J12.31
PC6: IC2.2 (PA6), J12.29
PC7: IC2.3 (PA7), J12.28
PD0: IC2.4 (PB0), J12.27
PD1: IC2.6 (PB1), J12.26
PD2: IC2.7 (PB2), J12.25
PD3: IC2.8 (PB3), J12.24
PD4: IC2.9 (PB4), J12.22
PD5: IC2.10 (PB5), J12.21
PD6: IC2.11 (PB6), J12.20
PD7: IC2.12 (PB7), J12.19
PHI2: IC1.21 (PHI2), IC2.21 (PHI2), J12.8
R~W: IC1.18 (R~W), IC2.18 (R~W), J12.9
~A4: IC1.20 (CS1), IC3.4 (Y)
~CS: IC1.19 (~CS2), IC2.19 (~CS2), J12.11
~IRQ: IC6.4 (Y), J12.26
~IRQ_{AB}: IC1.17 (~IRQ), IC6.2 (A)
~IRQ_{CD}: IC2.17 (~IRQ), IC6.1 (B)
~Reset: IC1.31 (~RES), IC2.31 (~RES), J12.7

Notes on the sheet:
Power
