andrewpaterson/658-Computer/Kicad/Desk Lamp/Battery Charger/Battery Charger.kicad_sch

## KiCad design Kicad/Desk Lamp/Battery Charger/Battery Charger.kicad_sch (2024-05-20)

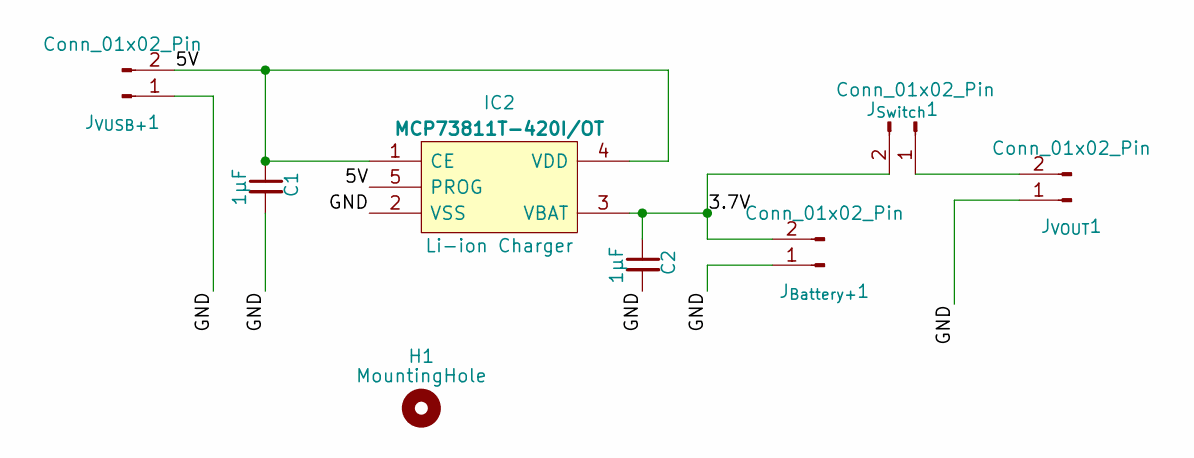
[picture p264: schematic Battery Charger.kicad_sch]

Parts:
C1, C2: 1μF; C_0805
H1: MountingHole; MountingHole_3.2mm_M3
IC2: MCP73811T-420I/OT; SOT95P270X145-5N; Manufacturer_Part_Number MCP73811T-420I/OT; Mouser Part Number 579-MCP73811T-420IOT
J_{Battery+}1: Conn_01x02_Pin; PinHeader_1x02_P2.54mm_Vertical
J_{Switch}1: Conn_01x02_Pin; PinHeader_1x02_P2.54mm_Vertical
J_{VOUT}1: Conn_01x02_Pin; PinHeader_1x02_P2.54mm_Vertical
J_{VUSB+}1: Conn_01x02_Pin; PinHeader_1x02_P2.54mm_Vertical

Connections:
3.7V: C2.1, IC2.3 (VBAT), J_{Battery+}1.2, J_{Switch}1.2
5V: C1.1, IC2.1 (CE), IC2.4 (VDD), IC2.5 (PROG), J_{VUSB+}1.2
GND: C1.2, C2.2, IC2.2 (VSS), J_{Battery+}1.1, J_{VOUT}1.1, J_{VUSB+}1.1
unnamed: J_{Switch}1.1, J_{VOUT}1.2
