andrewpaterson/658-Computer/Kicad/Desk Lamp/Lamp LED/Lamp LED.kicad_sch

## KiCad design Kicad/Desk Lamp/Lamp LED/Lamp LED.kicad_sch (2024-05-20)

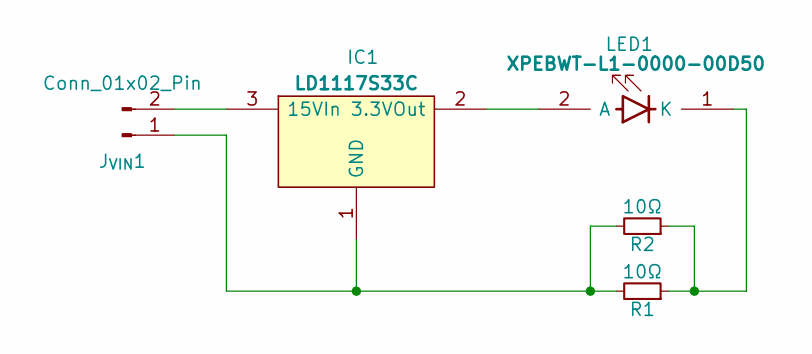
[picture p265: schematic Lamp LED.kicad_sch]

Parts:
IC1: LD1117S33C; Manufacturer_Part_Number LD1117S33C
J_{VIN}1: Conn_01x02_Pin; PinHeader_1x02_P2.54mm_Vertical
LED1: XPEBWT-L1-0000-00D50; XPEBWTL1000000D50; Mouser Part Number 941-XPEBWTL1000D50
R1, R2: 10Ω; R_0805

Connections:
unnamed: IC1.1 (GND), J_{VIN}1.1, R1.2, R2.2
unnamed: IC1.2 (3.3VOut), LED1.2 (A)
unnamed: IC1.3 (15VIn), J_{VIN}1.2
unnamed: LED1.1 (K), R1.1, R2.1
