andrewpaterson/658-Computer/Kicad/Desk Lamp/USB Connector/USB Connector.kicad_sch

## KiCad design Kicad/Desk Lamp/USB Connector/USB Connector.kicad_sch (2024-05-20)

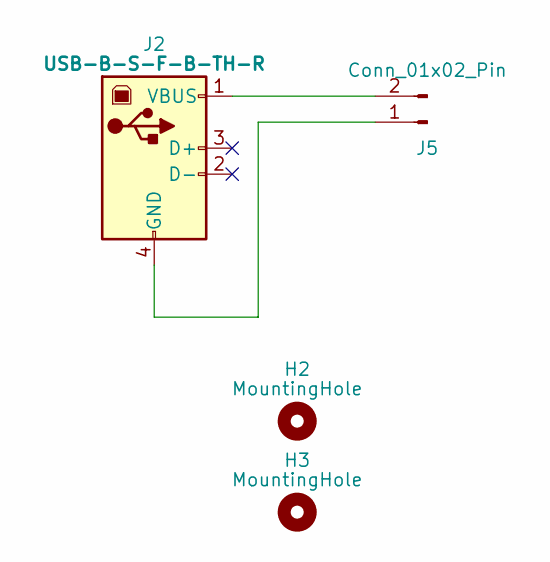
[picture p266: schematic USB Connector.kicad_sch]

Parts:
H2, H3: MountingHole; MountingHole_2.5mm
J2: USB-B-S-F-B-TH-R; USBBSFBTHR; Manufacturer_Part_Number USB-B-S-F-B-TH-R; Mouser Part Number 200-USBBSFBTHR
J5: Conn_01x02_Pin; PinHeader_1x02_P2.54mm_Vertical

Connections:
unnamed: J2.1 (VBUS), J5.2
unnamed: J2.4 (GND), J5.1
