andrewpaterson/658-Computer/Kicad/Programmers/EPM7032S Programmer/EPM7032S Programmer.kicad_sch

## KiCad design Kicad/Programmers/EPM7032S Programmer/EPM7032S Programmer.kicad_sch (2025-06-08)

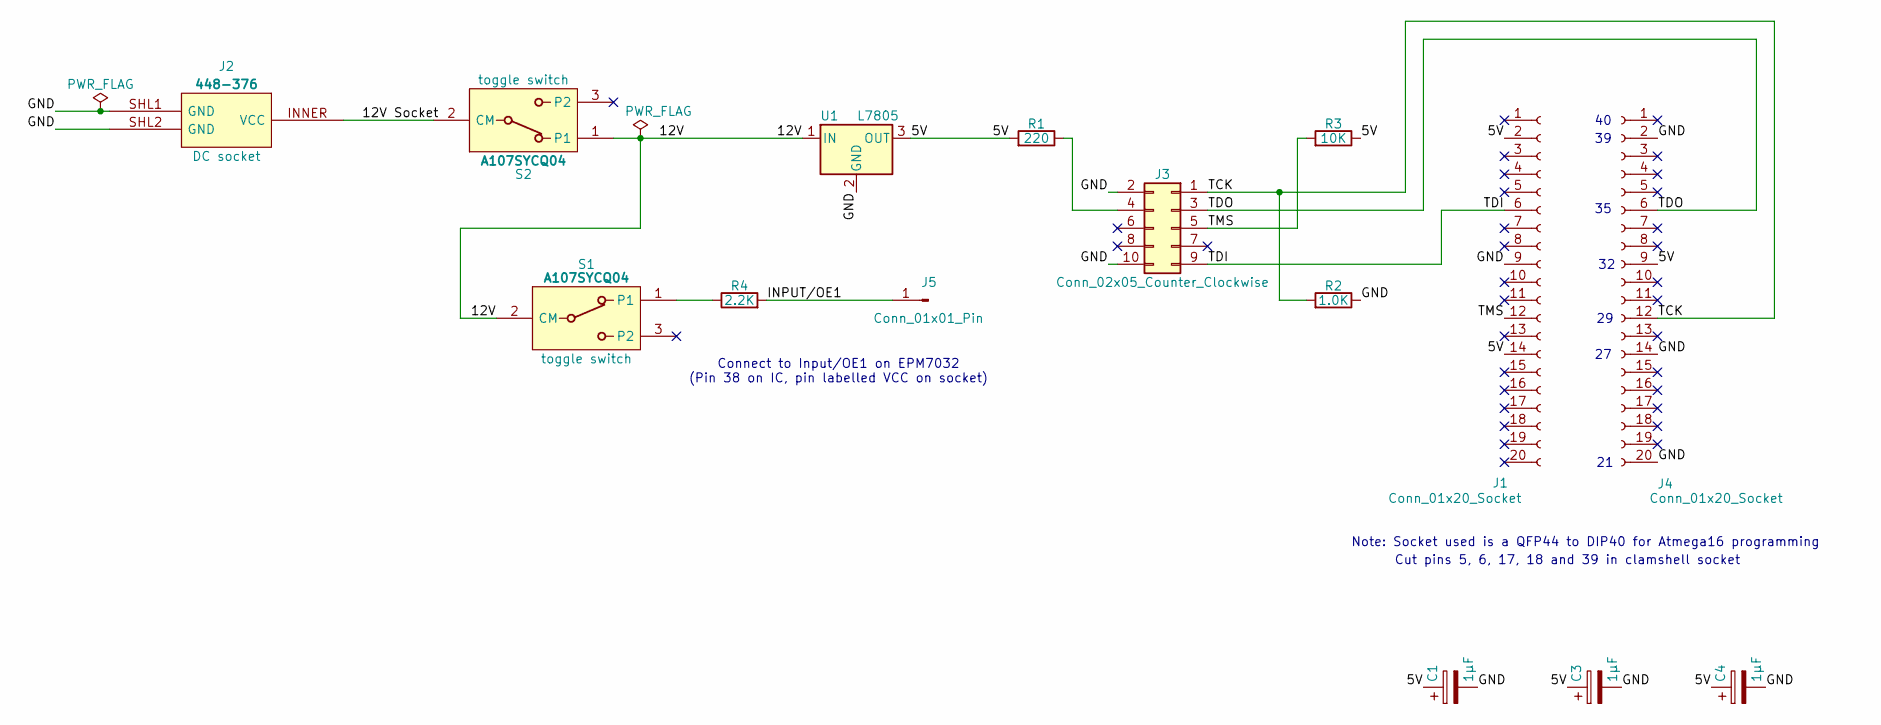
[picture p268: schematic EPM7032S Programmer.kicad_sch]

Parts:
C1, C3, C4: 1μF; CP_Radial_D4.0mm_P2.00mm
J1, J4: Conn_01x20_Socket; PinSocket_1x20_P2.54mm_Vertical
J2: 448-376; 448376; Manufacturer_Part_Number 448-376
J3: Conn_02x05_Counter_Clockwise; PinHeader_2x05_P2.54mm_Vertical
J5: Conn_01x01_Pin; PinHeader_1x01_P2.54mm_Vertical
R1: 220; R_Axial_DIN0309_L9.0mm_D3.2mm_P12.70mm_Horizontal
R2: 1.0K; R_Axial_DIN0207_L6.3mm_D2.5mm_P7.62mm_Horizontal
R3: 10K; R_Axial_DIN0207_L6.3mm_D2.5mm_P7.62mm_Horizontal
R4: 2.2K; R_Axial_DIN0207_L6.3mm_D2.5mm_P7.62mm_Horizontal
S1, S2: A107SYCQ04; Manufacturer_Part_Number A107SYCQ04; Mouser Part Number 506-5-1825137-1
U1: L7805; TO-220-3_Vertical

Connections:
5V: C1.1, C3.1, C4.1, J1.2, J1.14, J4.9, R1.2, R3.1, U1.3 (OUT)
12V: S1.2 (CM), S2.1, U1.1 (IN)
12V Socket: J2.INNER (VCC), S2.2 (CM)
GND: C1.2, C3.2, C4.2, J1.9, J2.SHL1 (GND), J2.SHL2 (GND), J3.2, J3.10, J4.2, J4.14, J4.20, R2.1, U1.2 (GND)
INPUT/OE1: J5.1, R4.2
unnamed: J3.4, R1.1
unnamed: R4.1, S1.1
TCK: J3.1, J4.12, R2.2
TDI: J1.6, J3.9
TDO: J3.3, J4.6
TMS: J1.12, J3.5, R3.2

Notes on the sheet:
Note: Socket used is a QFP44 to DIP40 for Atmega16 programming
Connect to Input/OE1 on EPM7032 (Pin 38 on IC, pin labelled VCC on socket)
Cut pins 5, 6, 17, 18 and 39 in clamshell socket
