andrewpaterson/658-Computer/Kicad/Programmers/EPM7160S Programmer/EPM7160S Programmer.kicad_sch

## KiCad design Kicad/Programmers/EPM7160S Programmer/EPM7160S Programmer.kicad_sch (2025-06-08)

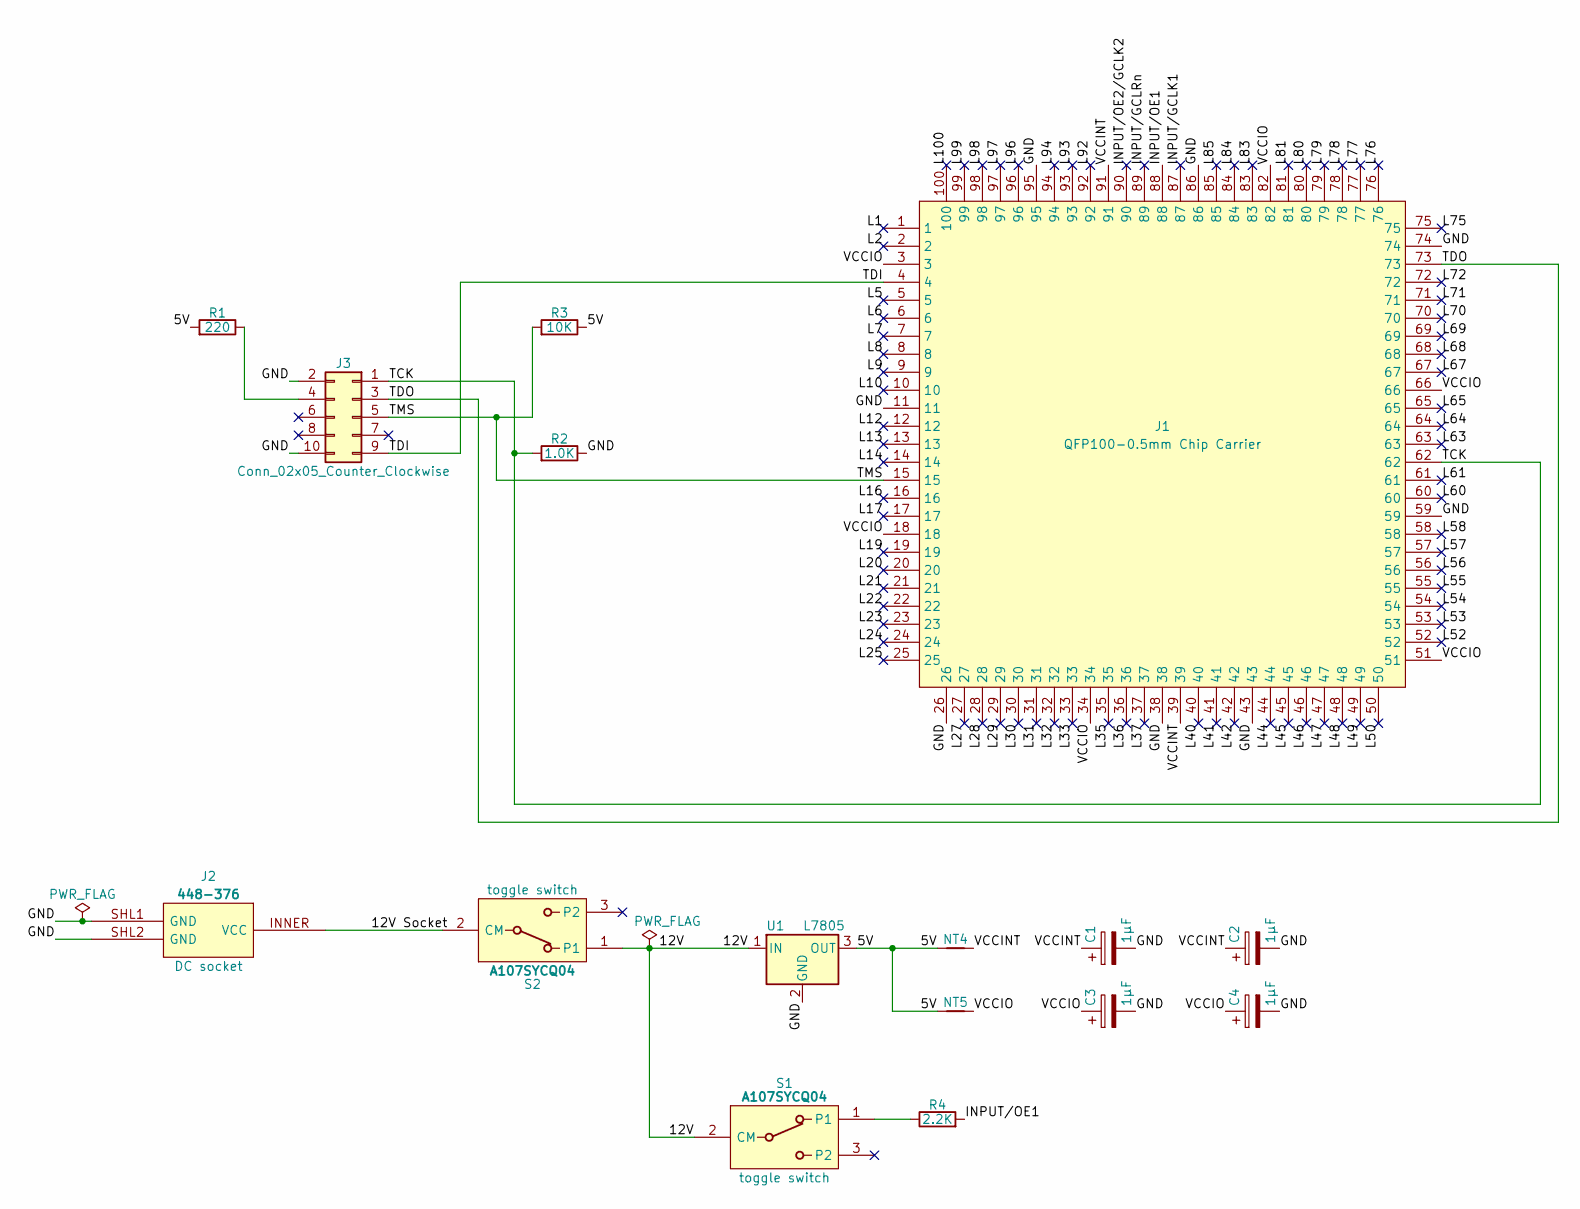
[picture p269: schematic EPM7160S Programmer.kicad_sch]

Parts:
C1, C2, C3, C4: 1μF; CP_Radial_D4.0mm_P2.00mm
J1: AllSocket-QFP-100-14X14-0.5-Clamshell
J2: 448-376; 448376; Manufacturer_Part_Number 448-376
J3: Conn_02x05_Counter_Clockwise; PinHeader_2x05_P2.54mm_Vertical
NT4, NT5: NetTie_2; NetTie-2_SMD_Pad0.5mm
R1: 220; R_Axial_DIN0309_L9.0mm_D3.2mm_P12.70mm_Horizontal
R2: 1.0K; R_Axial_DIN0207_L6.3mm_D2.5mm_P7.62mm_Horizontal
R3: 10K; R_Axial_DIN0207_L6.3mm_D2.5mm_P7.62mm_Horizontal
R4: 2.2K; R_Axial_DIN0207_L6.3mm_D2.5mm_P7.62mm_Horizontal
S1, S2: A107SYCQ04; Manufacturer_Part_Number A107SYCQ04; Mouser Part Number 506-5-1825137-1
U1: L7805; TO-220-3_Vertical

Connections:
5V: NT4.1, NT5.1, R1.2, R3.1, U1.3 (OUT)
12V: S1.2 (CM), S2.1, U1.1 (IN)
12V Socket: J2.INNER (VCC), S2.2 (CM)
GND: C1.2, C2.2, C3.2, C4.2, J1.11, J1.26, J1.38, J1.43, J1.59, J1.74, J1.86, J1.95, J2.SHL1 (GND), J2.SHL2 (GND), J3.2, J3.10, R2.1, U1.2 (GND)
INPUT/GCLK1: J1.87
INPUT/GCLRn: J1.89
INPUT/OE1: J1.88, R4.2
INPUT/OE2/GCLK2: J1.90
L1: J1.1
L2: J1.2
L5: J1.5
L6: J1.6
L7: J1.7
L8: J1.8
L9: J1.9
L10: J1.10
L12: J1.12
L13: J1.13
L14: J1.14
L16: J1.16
L17: J1.17
L19: J1.19
L20: J1.20
L21: J1.21
L22: J1.22
L23: J1.23
L24: J1.24
L25: J1.25
L27: J1.27
L28: J1.28
L29: J1.29
L30: J1.30
L31: J1.31
L32: J1.32
L33: J1.33
L35: J1.35
L36: J1.36
L37: J1.37
L40: J1.40
L41: J1.41
L42: J1.42
L44: J1.44
L45: J1.45
L46: J1.46
L47: J1.47
L48: J1.48
L49: J1.49
L50: J1.50
L52: J1.52
L53: J1.53
L54: J1.54
L55: J1.55
L56: J1.56
L57: J1.57
L58: J1.58
L60: J1.60
L61: J1.61
L63: J1.63
L64: J1.64
L65: J1.65
L67: J1.67
L68: J1.68
L69: J1.69
L70: J1.70
L71: J1.71
L72: J1.72
L75: J1.75
L76: J1.76
L77: J1.77
L78: J1.78
L79: J1.79
L80: J1.80
L81: J1.81
L83: J1.83
L84: J1.84
L85: J1.85
L92: J1.92
L93: J1.93
L94: J1.94
L96: J1.96
L97: J1.97
L98: J1.98
L99: J1.99
L100: J1.100
unnamed: J3.4, R1.1
unnamed: R4.1, S1.1
TCK: J1.62, J3.1, R2.2
TDI: J1.4, J3.9
TDO: J1.73, J3.3
TMS: J1.15, J3.5, R3.2
VCCINT: C1.1, C2.1, J1.39, J1.91, NT4.2
VCCIO: C3.1, C4.1, J1.3, J1.18, J1.34, J1.51, J1.66, J1.82, NT5.2
