andrewpaterson/658-Computer/Kicad/Tester/Bus Tester/Left_Handed_Bus 7_Segment.kicad_sch

## KiCad design Kicad/Tester/Bus Tester/Left_Handed_Bus 7_Segment.kicad_sch (2024-11-29)

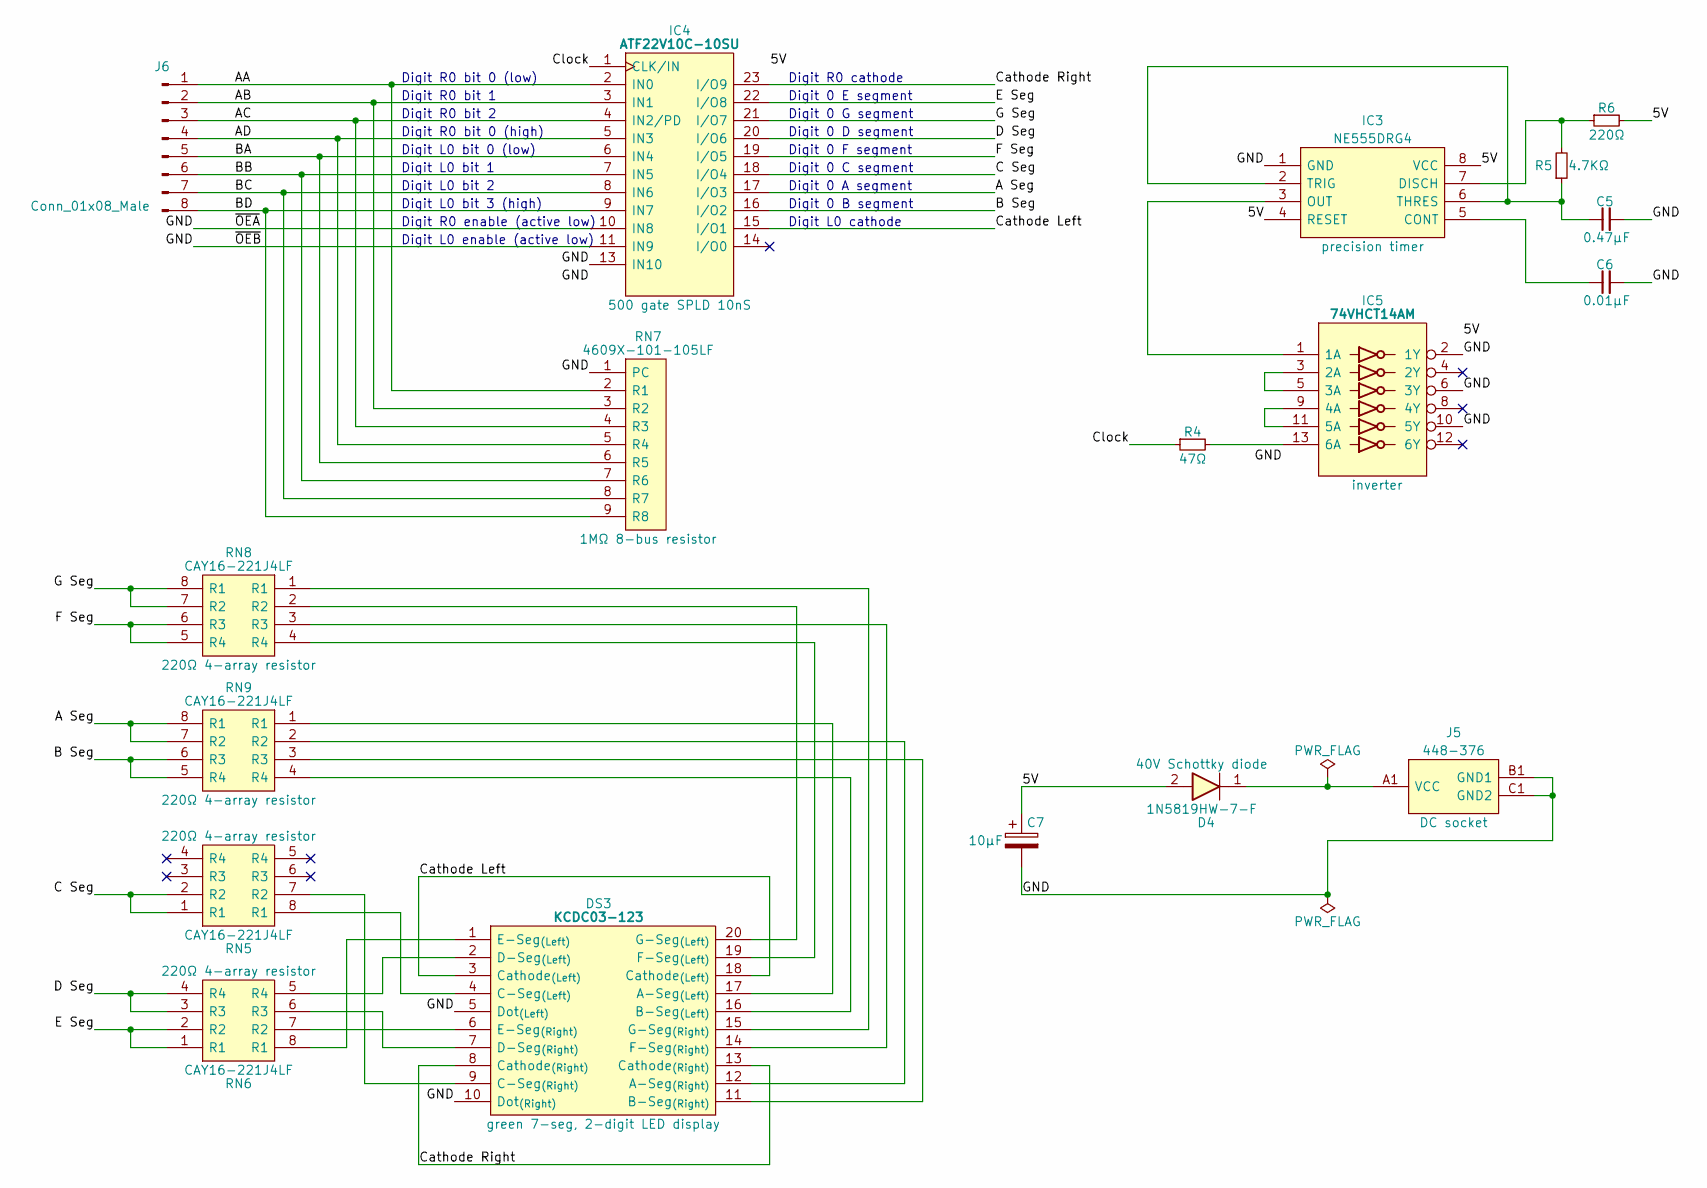
[picture p270: schematic Left_Handed_Bus 7_Segment.kicad_sch]

Parts:
C5, C6: C_0805
C7: C_Polarized; CP_Radial_D4.0mm_P1.50mm
D4: 1N5819HW-7-F; SOD3716X145N; Manufacturer_Part_Number 1N5819HW-7-F; Mouser Part Number 621-1N5819HW-F
DS3: KCDC03-123; KCDC03123; Manufacturer_Part_Number KCDC03-123; Mouser Part Number N/A
IC3: NE555DRG4; SOIC127P600X175-8N; Mouser Part Number 595-NE555DRG4
IC4: ATF22V10C-10SU; SOIC127P1032X265-24N; Manufacturer_Part_Number ATF22V10C-10SU; Mouser Part Number 556-ATF22V10C-10SU
IC5: 74VHCT14AM; SOIC127P600X175-14N; Manufacturer_Part_Number 74VHCT14AM; Mouser Part Number 512-74VHCT14AM
J5: 448-376; 448376; Manufacturer_Part_Number 448-376
J6: Conn_01x08_Male; PinHeader_1x08_P2.54mm_Vertical
R4, R5, R6: R_0805
RN5, RN6, RN8, RN9: CAY16-221J4LF; CAY1647R0F4LF; Manufacturer_Part_Number CAY16-221J4LF; Mouser Part Number 652-CAY16-221J4LF
RN7: 4609X-101-105LF; 4609X; Manufacturer_Part_Number 4609X-101-105LF; Mouser Part Number 652-4609X-1LF-1M

Connections:
5V: C7.1, D4.2, IC3.4 (RESET), IC3.8 (VCC), IC4.24 (5V), IC5.14 (5V), R6.2
A Seg: IC4.17 (I/O3), RN9.7 (R2), RN9.8 (R1)
AA: IC4.2 (IN0), J6.1, RN7.2 (R1)
AB: IC4.3 (IN1), J6.2, RN7.3 (R2)
AC: IC4.4 (IN2/PD), J6.3, RN7.4 (R3)
AD: IC4.5 (IN3), J6.4, RN7.5 (R4)
B Seg: IC4.16 (I/O2), RN9.5 (R4), RN9.6 (R3)
BA: IC4.6 (IN4), J6.5, RN7.6 (R5)
BB: IC4.7 (IN5), J6.6, RN7.7 (R6)
BC: IC4.8 (IN6), J6.7, RN7.8 (R7)
BD: IC4.9 (IN7), J6.8, RN7.9 (R8)
C Seg: IC4.18 (I/O4), RN5.1 (R1), RN5.2 (R2)
Cathode Left: DS3.3 (Cathode_{(Left)}), DS3.18 (Cathode_{(Left)}), IC4.15 (I/O1)
Cathode Right: DS3.8 (Cathode_{(Right)}), DS3.13 (Cathode_{(Right)}), IC4.23 (I/O9)
Clock: IC4.1 (CLK/IN), R4.1
D Seg: IC4.20 (I/O6), RN6.3 (R3), RN6.4 (R4)
E Seg: IC4.22 (I/O8), RN6.1 (R1), RN6.2 (R2)
F Seg: IC4.19 (I/O5), RN8.5 (R4), RN8.6 (R3)
G Seg: IC4.21 (I/O7), RN8.7 (R2), RN8.8 (R1)
GND: C5.2, C6.2, C7.2, DS3.5 (Dot_{(Left)}), DS3.10 (Dot_{(Right)}), IC3.1 (GND), IC4.10 (IN8), IC4.11 (IN9), IC4.12 (GND), IC4.13 (IN10), IC5.2 (1Y), IC5.6 (3Y), IC5.7 (GND), IC5.10 (5Y), J5.B1 (GND1), J5.C1 (GND2), RN7.1 (PC)
unnamed: C5.1, IC3.2 (TRIG), IC3.6 (THRES), R5.1
unnamed: C6.1, IC3.5 (CONT)
unnamed: D4.1, J5.A1 (VCC)
unnamed: DS3.1 (E-Seg_{(Left)}), RN6.8 (R1)
unnamed: DS3.2 (D-Seg_{(Left)}), RN6.5 (R4)
unnamed: DS3.4 (C-Seg_{(Left)}), RN5.8 (R1)
unnamed: DS3.6 (E-Seg_{(Right)}), RN6.7 (R2)
unnamed: DS3.7 (D-Seg_{(Right)}), RN6.6 (R3)
unnamed: DS3.9 (C-Seg_{(Right)}), RN5.7 (R2)
unnamed: DS3.11 (B-Seg_{(Right)}), RN9.3 (R3)
unnamed: DS3.12 (A-Seg_{(Right)}), RN9.2 (R2)
unnamed: DS3.14 (F-Seg_{(Right)}), RN8.3 (R3)
unnamed: DS3.15 (G-Seg_{(Right)}), RN8.1 (R1)
unnamed: DS3.16 (B-Seg_{(Left)}), RN9.4 (R4)
unnamed: DS3.17 (A-Seg_{(Left)}), RN9.1 (R1)
unnamed: DS3.19 (F-Seg_{(Left)}), RN8.4 (R4)
unnamed: DS3.20 (G-Seg_{(Left)}), RN8.2 (R2)
unnamed: IC3.3 (OUT), IC5.1 (1A)
unnamed: IC3.7 (DISCH), R5.2, R6.1
unnamed: IC5.3 (2A), IC5.5 (3A)
unnamed: IC5.9 (4A), IC5.11 (5A)
unnamed: IC5.13 (6A), R4.2

Notes on the sheet:
Digit R0 bit 0 (low)
Digit 0 A segment
Digit R0 bit 1
Digit L0 enable (active low)
Digit L0 cathode
Digit 0 D segment
Digit 0 F segment
Digit L0 bit 3 (high)
Digit 0 G segment
Digit L0 bit 0 (low)
Digit R0 enable (active low)
Digit L0 bit 1
Digit 0 B segment
Digit R0 bit 2
Digit R0 bit 0 (high)
Digit 0 E segment
Digit L0 bit 2
Digit 0 C segment
Digit R0 cathode
