andrewpaterson/658-Computer/Kicad/Tester/Bus Tester/Left_Handed_Bus.kicad_sch

## KiCad design Kicad/Tester/Bus Tester/Left_Handed_Bus.kicad_sch (2024-11-29)

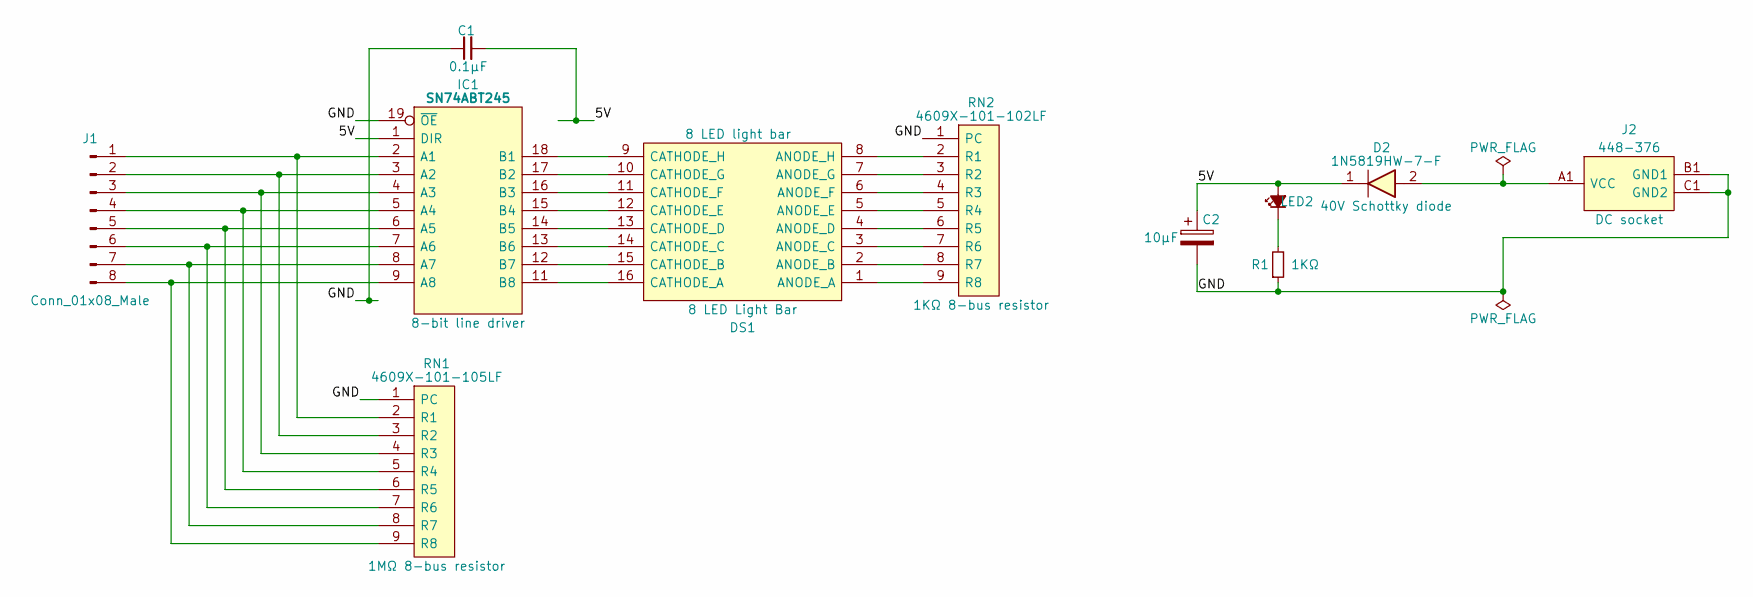
[picture p271: schematic Left_Handed_Bus.kicad_sch]

Parts:
C1: C_0805
C2: C_Polarized; CP_Radial_D4.0mm_P1.50mm
D2: 1N5819HW-7-F; SOD3716X145N; Manufacturer_Part_Number 1N5819HW-7-F; Mouser Part Number 621-1N5819HW-F
DS1: 8 LED Light Bar; DIP8LEDBAR; Manufacturer_Part_Number HDSP-4830; Mouser Part Number 630-HDSP-4830
IC1: SN74ABT245; SOP65P780X200-20N; Manufacturer_Part_Number SN74ABT245BDBR; Mouser Part Number 595-SN74ABT245BDBR
J1: Conn_01x08_Male; PinHeader_1x08_P2.54mm_Vertical
J2: 448-376; 448376; Manufacturer_Part_Number 448-376
LED2: LED_Small_Filled; LED_D5.0mm
R1: R_0805
RN1: 4609X-101-105LF; 4609X; Manufacturer_Part_Number 4609X-101-105LF; Mouser Part Number 652-4609X-1LF-1M
RN2: 4609X-101-102LF; 4609X; Manufacturer_Part_Number 4609X-101-102LF; Mouser Part Number 652-4609X-1LF-1K

Connections:
5V: C1.2, C2.1, D2.1, IC1.1 (DIR), IC1.20 (5V), LED2.2 (A)
GND: C1.1, C2.2, IC1.10 (GND), IC1.19 (~OE), J2.B1 (GND1), J2.C1 (GND2), R1.1, RN1.1 (PC), RN2.1 (PC)
unnamed: D2.2, J2.A1 (VCC)
unnamed: DS1.1 (ANODE_A), RN2.9 (R8)
unnamed: DS1.2 (ANODE_B), RN2.8 (R7)
unnamed: DS1.3 (ANODE_C), RN2.7 (R6)
unnamed: DS1.4 (ANODE_D), RN2.6 (R5)
unnamed: DS1.5 (ANODE_E), RN2.5 (R4)
unnamed: DS1.6 (ANODE_F), RN2.4 (R3)
unnamed: DS1.7 (ANODE_G), RN2.3 (R2)
unnamed: DS1.8 (ANODE_H), RN2.2 (R1)
unnamed: DS1.9 (CATHODE_H), IC1.18 (B1)
unnamed: DS1.10 (CATHODE_G), IC1.17 (B2)
unnamed: DS1.11 (CATHODE_F), IC1.16 (B3)
unnamed: DS1.12 (CATHODE_E), IC1.15 (B4)
unnamed: DS1.13 (CATHODE_D), IC1.14 (B5)
unnamed: DS1.14 (CATHODE_C), IC1.13 (B6)
unnamed: DS1.15 (CATHODE_B), IC1.12 (B7)
unnamed: DS1.16 (CATHODE_A), IC1.11 (B8)
unnamed: IC1.2 (A1), J1.1, RN1.2 (R1)
unnamed: IC1.3 (A2), J1.2, RN1.3 (R2)
unnamed: IC1.4 (A3), J1.3, RN1.4 (R3)
unnamed: IC1.5 (A4), J1.4, RN1.5 (R4)
unnamed: IC1.6 (A5), J1.5, RN1.6 (R5)
unnamed: IC1.7 (A6), J1.6, RN1.7 (R6)
unnamed: IC1.8 (A7), J1.7, RN1.8 (R7)
unnamed: IC1.9 (A8), J1.8, RN1.9 (R8)
unnamed: LED2.1 (K), R1.2
