andrewpaterson/658-Computer/Kicad/Tester/LCD 14 Segment Tester/LCD 14 Segment Tester.kicad_sch

## KiCad design Kicad/Tester/LCD 14 Segment Tester/LCD 14 Segment Tester.kicad_sch (2025-06-27)

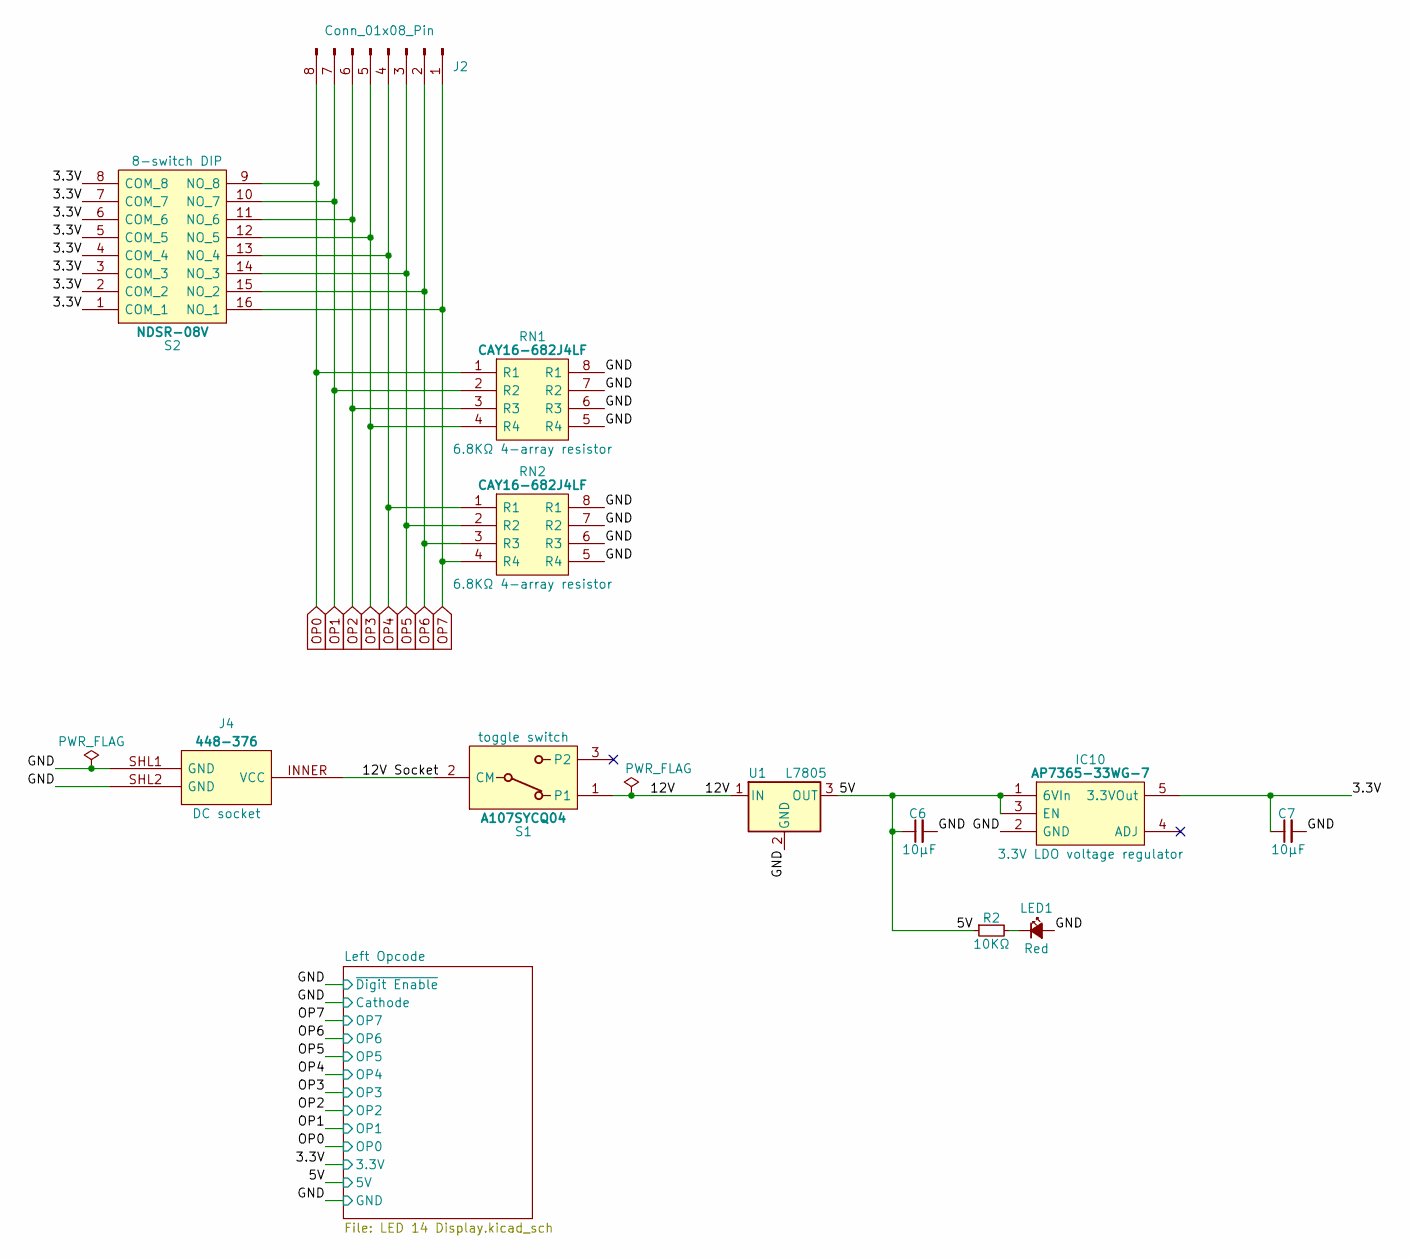
[picture p272: schematic LCD 14 Segment Tester.kicad_sch]

Parts:
C6, C7: 10µF; C_0805
IC10: AP7365-33WG-7; SOT95P285X130-5N; Manufacturer_Part_Number AP7365-33WG-7; Mouser Part Number 621-AP7365-33WG-7
J2: Conn_01x08_Pin; PinHeader_1x08_P2.54mm_Vertical
J4: 448-376; 448376; Manufacturer_Part_Number 448-376
LED1: Red; LED_D5.0mm
R2: 10KΩ; R_0805
RN1, RN2: CAY16-682J4LF; CAY16-J4
S1: A107SYCQ04; Manufacturer_Part_Number A107SYCQ04; Mouser Part Number 506-5-1825137-1
S2: NDSR-08V; DIPS762W77P254L2168H585Q16N; Manufacturer_Part_Number NDSR-08-V
U1: L7805; TO-220-3_Vertical

Connections:
3.3V: C7.1, IC10.5 (3.3VOut), S2.1 (COM_1), S2.2 (COM_2), S2.3 (COM_3), S2.4 (COM_4), S2.5 (COM_5), S2.6 (COM_6), S2.7 (COM_7), S2.8 (COM_8)
5V: C6.1, IC10.1 (6VIn), IC10.3 (EN), R2.1, U1.3 (OUT)
12V: S1.1, U1.1 (IN)
12V Socket: J4.INNER (VCC), S1.2 (CM)
GND: C6.2, C7.2, IC10.2 (GND), J4.SHL1 (GND), J4.SHL2 (GND), LED1.2 (A), RN1.5 (R4), RN1.6 (R3), RN1.7 (R2), RN1.8 (R1), RN2.5 (R4), RN2.6 (R3), RN2.7 (R2), RN2.8 (R1), U1.2 (GND)
unnamed: LED1.1 (K), R2.2
OP0: J2.8, RN1.1 (R1), S2.9 (NO_8)
OP1: J2.7, RN1.2 (R2), S2.10 (NO_7)
OP2: J2.6, RN1.3 (R3), S2.11 (NO_6)
OP3: J2.5, RN1.4 (R4), S2.12 (NO_5)
OP4: J2.4, RN2.1 (R1), S2.13 (NO_4)
OP5: J2.3, RN2.2 (R2), S2.14 (NO_3)
OP6: J2.2, RN2.3 (R3), S2.15 (NO_2)
OP7: J2.1, RN2.4 (R4), S2.16 (NO_1)
