andrewpaterson/658-Computer/Kicad/Tester/LCD Bus Reader/LCD Bus Reader.kicad_sch

## KiCad design Kicad/Tester/LCD Bus Reader/LCD Bus Reader.kicad_sch (2024-05-20)

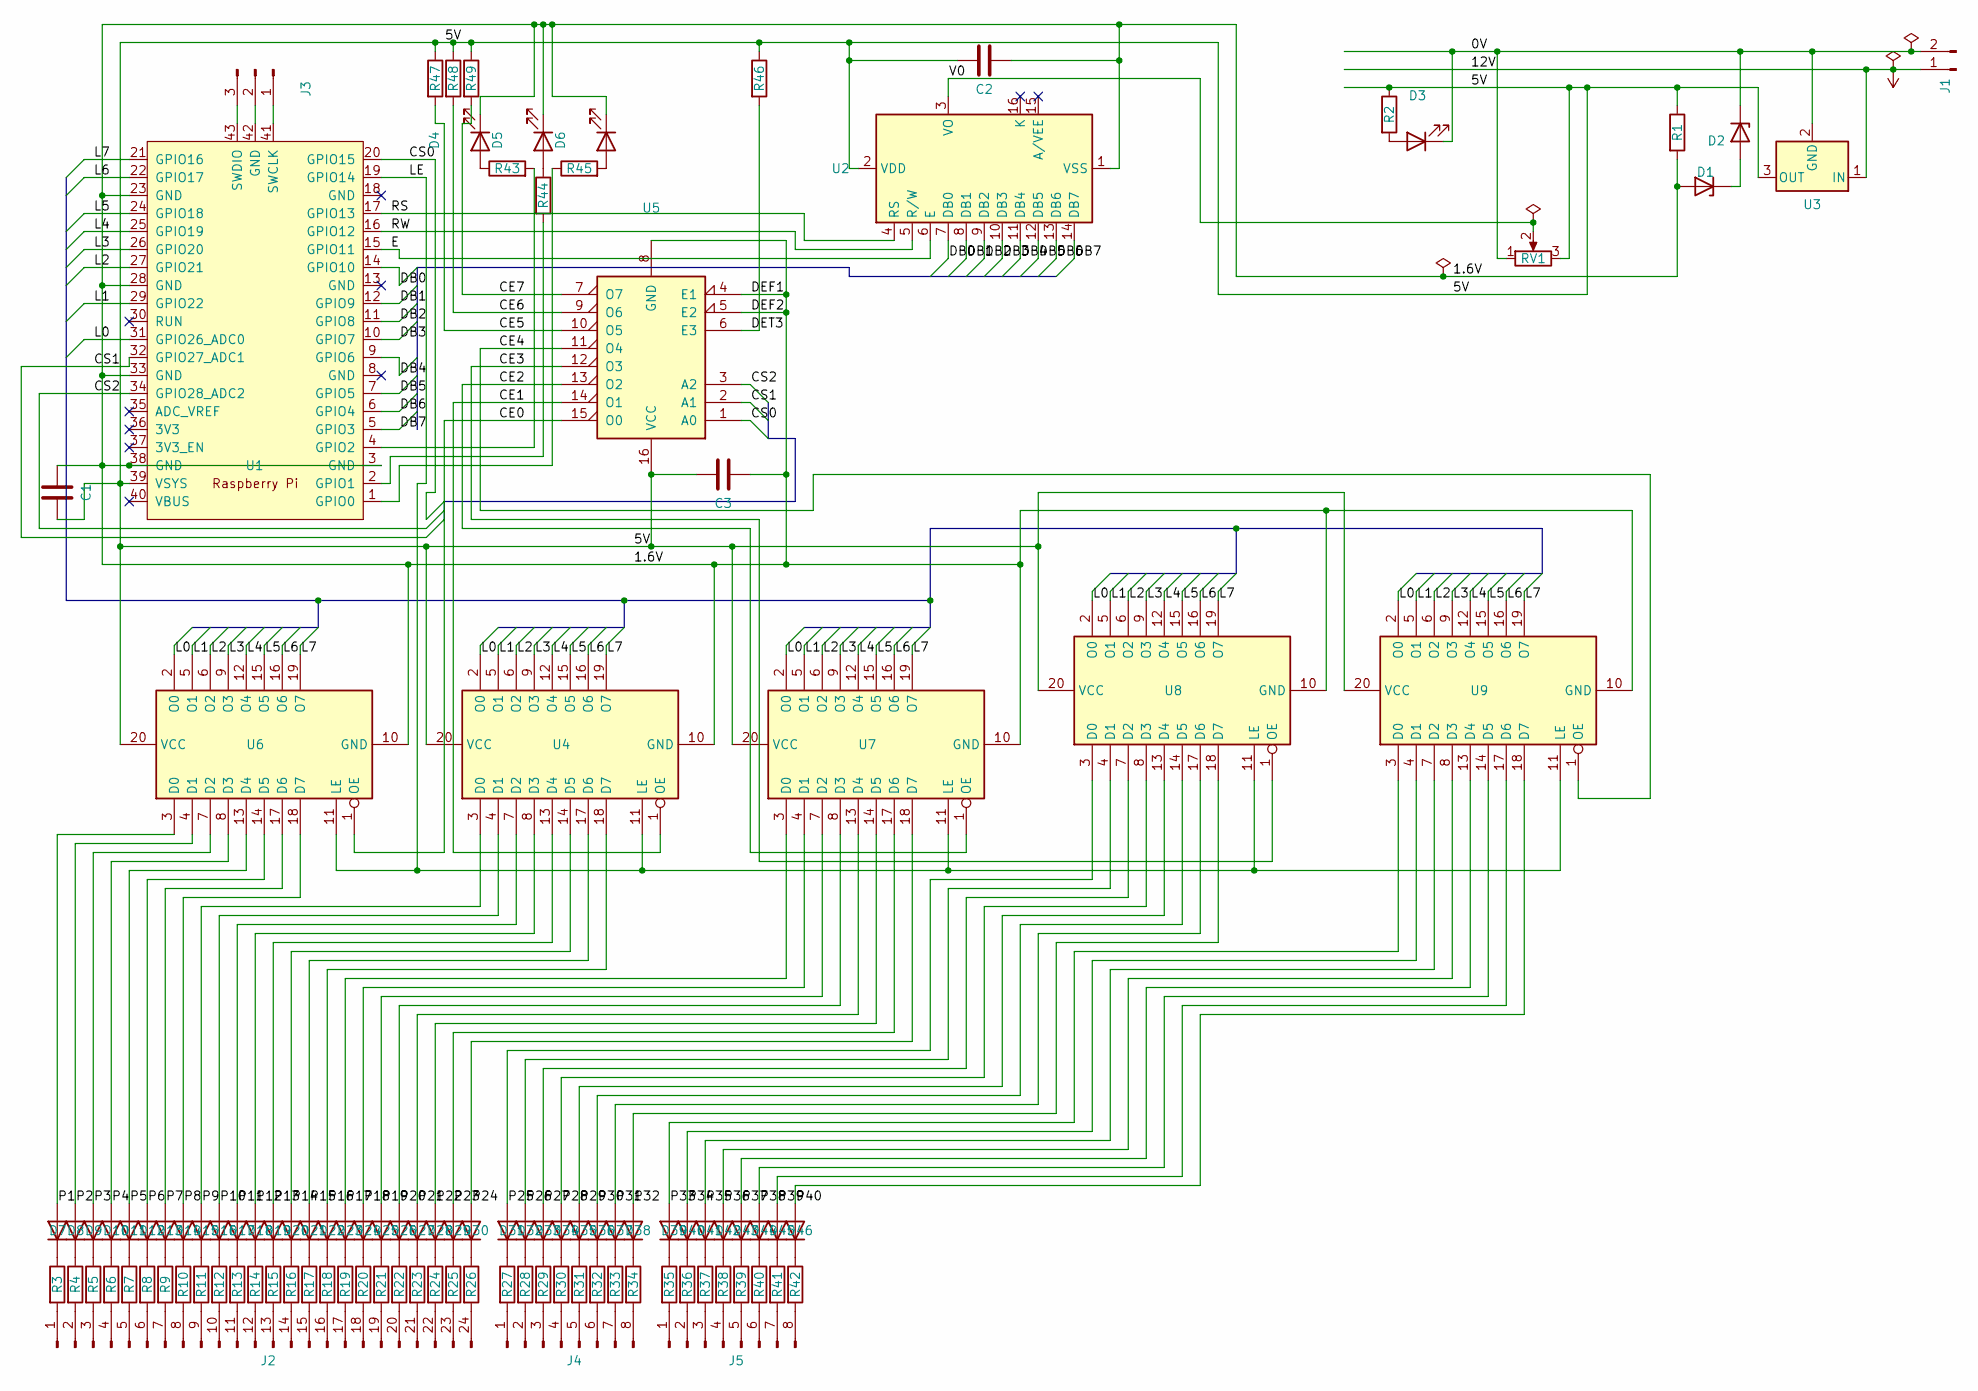
[picture p274: schematic LCD Bus Reader.kicad_sch]

Parts:
C1, C2, C3: (no value)
D1, D2, D3, D4, D5, D6, D7, D8, D9, D10, D11, D12, D13, D14, D15, D16, D17, D18, D19, D20, D21, D22, D23, D24, D25, D26, D27, D28, D29, D30, D31, D32, D33, D34, D35, D36, D37, D38, D39, D40, D41, D42, D43, D44, D45, D46: (no value)
J1, J2, J3, J4, J5: (no value)
R1, R2, R3, R4, R5, R6, R7, R8, R9, R10, R11, R12, R13, R14, R15, R16, R17, R18, R19, R20, R21, R22, R23, R24, R25, R26, R27, R28, R29, R30, R31, R32, R33, R34, R35, R36, R37, R38, R39, R40, R41, R42, R43, R44, R45, R46, R47, R48, R49: (no value)
RV1: (no value)
U1, U2, U3, U4, U5, U6, U7, U8, U9: (no value)

Connections:
0V: D2.1 (K), D3.1 (K), J1.2, RV1.1, U3.2 (GND)
1.6V: C1.2, C2.2, C3.2, D1.2 (A), D4.1 (K), D5.1 (K), D6.1 (K), R1.2, U1.3 (GND), U1.23 (GND), U1.28 (GND), U1.33 (GND), U1.38 (GND), U2.1 (VSS), U4.10 (GND), U5.4 (E1), U5.5 (E2), U5.8 (GND), U6.10 (GND), U7.10 (GND), U8.10 (GND), U9.10 (GND)
5V: C1.1, C2.1, C3.1, R1.1, R2.1, R46.1, R47.1, R48.1, R49.1, RV1.3, U1.39 (VSYS), U2.2 (VDD), U3.3 (OUT), U4.20 (VCC), U5.16 (VCC), U6.20 (VCC), U7.20 (VCC), U8.20 (VCC), U9.20 (VCC)
12V: J1.1, U3.1 (IN)
CE0: U5.15 (O0), U6.1 (OE)
CE1: U4.1 (OE), U5.14 (O1)
CE2: U5.13 (O2), U7.1 (OE)
CE3: U5.12 (O3), U8.1 (OE)
CE4: U5.11 (O4), U9.1 (OE)
CE5: R47.2, U5.10 (O5)
CE6: R48.2, U5.9 (O6)
CE7: R49.2, U5.7 (O7)
CS0: U1.20 (GPIO15), U5.1 (A0)
CS1: U1.32 (GPIO27_ADC1), U5.2 (A1)
CS2: U1.34 (GPIO28_ADC2), U5.3 (A2)
DB0: U1.14 (GPIO10), U2.7 (DB0)
DB1: U1.12 (GPIO9), U2.8 (DB1)
DB2: U1.11 (GPIO8), U2.9 (DB2)
DB3: U1.10 (GPIO7), U2.10 (DB3)
DB4: U1.9 (GPIO6), U2.11 (DB4)
DB5: U1.7 (GPIO5), U2.12 (DB5)
DB6: U1.6 (GPIO4), U2.13 (DB6)
DB7: U1.5 (GPIO3), U2.14 (DB7)
DET3: R46.2, U5.6 (E3)
E: U1.15 (GPIO11), U2.6 (E)
L0: U1.31 (GPIO26_ADC0), U4.2 (O0), U6.2 (O0), U7.2 (O0), U8.2 (O0), U9.2 (O0)
L1: U1.29 (GPIO22), U4.5 (O1), U6.5 (O1), U7.5 (O1), U8.5 (O1), U9.5 (O1)
L2: U1.27 (GPIO21), U4.6 (O2), U6.6 (O2), U7.6 (O2), U8.6 (O2), U9.6 (O2)
L3: U1.26 (GPIO20), U4.9 (O3), U6.9 (O3), U7.9 (O3), U8.9 (O3), U9.9 (O3)
L4: U1.25 (GPIO19), U4.12 (O4), U6.12 (O4), U7.12 (O4), U8.12 (O4), U9.12 (O4)
L5: U1.24 (GPIO18), U4.15 (O5), U6.15 (O5), U7.15 (O5), U8.15 (O5), U9.15 (O5)
L6: U1.22 (GPIO17), U4.16 (O6), U6.16 (O6), U7.16 (O6), U8.16 (O6), U9.16 (O6)
L7: U1.21 (GPIO16), U4.19 (O7), U6.19 (O7), U7.19 (O7), U8.19 (O7), U9.19 (O7)
LE: U1.19 (GPIO14), U4.11 (LE), U6.11 (LE), U7.11 (LE), U8.11 (LE), U9.11 (LE)
unnamed: D1.1 (K), D2.2 (A)
unnamed: D3.2 (A), R2.2
unnamed: D4.2 (A), R43.1
unnamed: D5.2 (A), R44.1
unnamed: D6.2 (A), R45.2
unnamed: D7.1 (K), R3.1
unnamed: D8.1 (K), R4.1
unnamed: D9.1 (K), R5.1
unnamed: D10.1 (K), R6.1
unnamed: D11.1 (K), R7.1
unnamed: D12.1 (K), R8.1
unnamed: D13.1 (K), R9.1
unnamed: D14.1 (K), R10.1
unnamed: D15.1 (K), R11.1
unnamed: D16.1 (K), R12.1
unnamed: D17.1 (K), R13.1
unnamed: D18.1 (K), R14.1
unnamed: D19.1 (K), R15.1
unnamed: D20.1 (K), R16.1
unnamed: D21.1 (K), R17.1
unnamed: D22.1 (K), R18.1
unnamed: D23.1 (K), R19.1
unnamed: D24.1 (K), R20.1
unnamed: D25.1 (K), R21.1
unnamed: D26.1 (K), R22.1
unnamed: D27.1 (K), R23.1
unnamed: D28.1 (K), R24.1
unnamed: D29.1 (K), R25.1
unnamed: D30.1 (K), R26.1
unnamed: D31.1 (K), R27.1
unnamed: D32.1 (K), R28.1
unnamed: D33.1 (K), R29.1
unnamed: D34.1 (K), R30.1
unnamed: D35.1 (K), R31.1
unnamed: D36.1 (K), R32.1
unnamed: D37.1 (K), R33.1
unnamed: D38.1 (K), R34.1
unnamed: D39.1 (K), R35.1
unnamed: D40.1 (K), R36.1
unnamed: D41.1 (K), R37.1
unnamed: D42.1 (K), R38.1
unnamed: D43.1 (K), R39.1
unnamed: D44.1 (K), R40.1
unnamed: D45.1 (K), R41.1
unnamed: D46.1 (K), R42.1
unnamed: J2.1, R3.2
unnamed: J2.2, R4.2
unnamed: J2.3, R5.2
unnamed: J2.4, R6.2
unnamed: J2.5, R7.2
unnamed: J2.6, R8.2
unnamed: J2.7, R9.2
unnamed: J2.8, R10.2
unnamed: J2.9, R11.2
unnamed: J2.10, R12.2
unnamed: J2.11, R13.2
unnamed: J2.12, R14.2
unnamed: J2.13, R15.2
unnamed: J2.14, R16.2
unnamed: J2.15, R17.2
unnamed: J2.16, R18.2
unnamed: J2.17, R19.2
unnamed: J2.18, R20.2
unnamed: J2.19, R21.2
unnamed: J2.20, R22.2
unnamed: J2.21, R23.2
unnamed: J2.22, R24.2
unnamed: J2.23, R25.2
unnamed: J2.24, R26.2
unnamed: J3.1, U1.41 (SWCLK)
unnamed: J3.2, U1.42 (GND)
unnamed: J3.3, U1.43 (SWDIO)
unnamed: J4.1, R27.2
unnamed: J4.2, R28.2
unnamed: J4.3, R29.2
unnamed: J4.4, R30.2
unnamed: J4.5, R31.2
unnamed: J4.6, R32.2
unnamed: J4.7, R33.2
unnamed: J4.8, R34.2
unnamed: J5.1, R35.2
unnamed: J5.2, R36.2
unnamed: J5.3, R37.2
unnamed: J5.4, R38.2
unnamed: J5.5, R39.2
unnamed: J5.6, R40.2
unnamed: J5.7, R41.2
unnamed: J5.8, R42.2
unnamed: R43.2, U1.4 (GPIO2)
unnamed: R44.2, U1.2 (GPIO1)
unnamed: R45.1, U1.1 (GPIO0)
P1: D7.2 (A), U6.3 (D0)
P2: D8.2 (A), U6.4 (D1)
P3: D9.2 (A), U6.7 (D2)
P4: D10.2 (A), U6.8 (D3)
P5: D11.2 (A), U6.13 (D4)
P6: D12.2 (A), U6.14 (D5)
P7: D13.2 (A), U6.17 (D6)
P8: D14.2 (A), U6.18 (D7)
P9: D15.2 (A), U4.3 (D0)
P10: D16.2 (A), U4.4 (D1)
P11: D17.2 (A), U4.7 (D2)
P12: D18.2 (A), U4.8 (D3)
P13: D19.2 (A), U4.13 (D4)
P14: D20.2 (A), U4.14 (D5)
P15: D21.2 (A), U4.17 (D6)
P16: D22.2 (A), U4.18 (D7)
P17: D23.2 (A), U7.3 (D0)
P18: D24.2 (A), U7.4 (D1)
P19: D25.2 (A), U7.7 (D2)
P20: D26.2 (A), U7.8 (D3)
P21: D27.2 (A), U7.13 (D4)
P22: D28.2 (A), U7.14 (D5)
P23: D29.2 (A), U7.17 (D6)
P24: D30.2 (A), U7.18 (D7)
P25: D31.2 (A), U8.3 (D0)
P26: D32.2 (A), U8.4 (D1)
P27: D33.2 (A), U8.7 (D2)
P28: D34.2 (A), U8.8 (D3)
P29: D35.2 (A), U8.13 (D4)
P30: D36.2 (A), U8.14 (D5)
P31: D37.2 (A), U8.17 (D6)
P32: D38.2 (A), U8.18 (D7)
P33: D39.2 (A), U9.3 (D0)
P34: D40.2 (A), U9.4 (D1)
P35: D41.2 (A), U9.7 (D2)
P36: D42.2 (A), U9.8 (D3)
P37: D43.2 (A), U9.13 (D4)
P38: D44.2 (A), U9.14 (D5)
P39: D45.2 (A), U9.17 (D6)
P40: D46.2 (A), U9.18 (D7)
RS: U1.17 (GPIO13), U2.4 (RS)
RW: U1.16 (GPIO12), U2.5 (R/W)
V0: RV1.2, U2.3 (VO)
