andrewpaterson/658-Computer/Kicad/Tester/LCD Dual 7 Segment Tester/LCD Dual 7 Segment Tester.kicad_sch

## KiCad design Kicad/Tester/LCD Dual 7 Segment Tester/LCD Dual 7 Segment Tester.kicad_sch (2025-06-27)

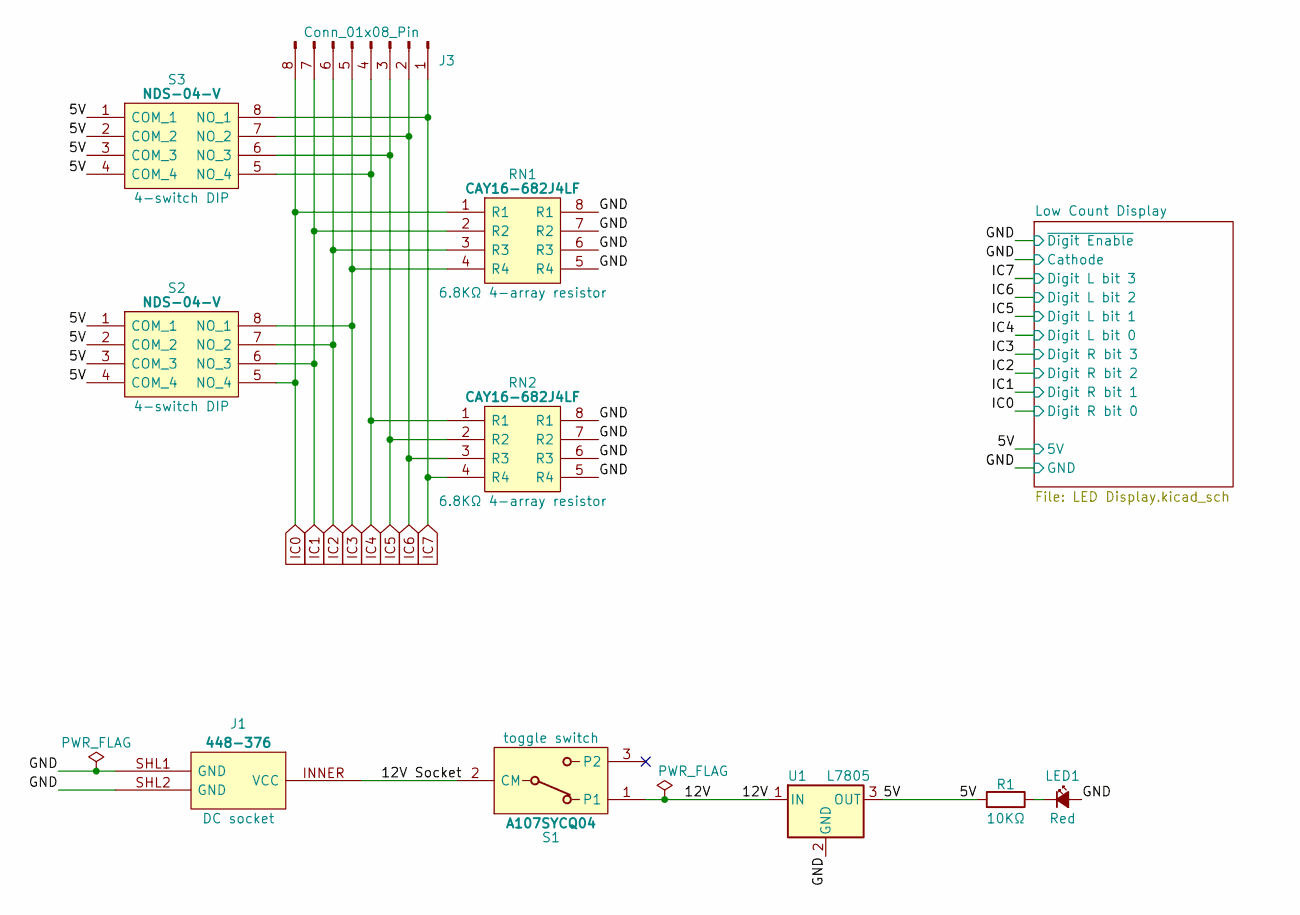
[picture p275: schematic LCD Dual 7 Segment Tester.kicad_sch]

Parts:
J1: 448-376; 448376; Manufacturer_Part_Number 448-376
J3: Conn_01x08_Pin; PinHeader_1x08_P2.54mm_Vertical
LED1: Red; LED_D5.0mm
R1: 10KΩ; R_DIN_P7.62mm
RN1, RN2: CAY16-682J4LF; CAY16-J4
S1: A107SYCQ04; Manufacturer_Part_Number A107SYCQ04; Mouser Part Number 506-5-1825137-1
S2, S3: NDS-04-V; NDS04V; Manufacturer_Part_Number NDS-04-V; Mouser Part Number 642-DS04
U1: L7805; TO-220-3_Vertical

Connections:
5V: R1.2, S2.1 (COM_1), S2.2 (COM_2), S2.3 (COM_3), S2.4 (COM_4), S3.1 (COM_1), S3.2 (COM_2), S3.3 (COM_3), S3.4 (COM_4), U1.3 (OUT)
12V: S1.1, U1.1 (IN)
12V Socket: J1.INNER (VCC), S1.2 (CM)
GND: J1.SHL1 (GND), J1.SHL2 (GND), LED1.2 (A), RN1.5 (R4), RN1.6 (R3), RN1.7 (R2), RN1.8 (R1), RN2.5 (R4), RN2.6 (R3), RN2.7 (R2), RN2.8 (R1), U1.2 (GND)
IC0: J3.8, RN1.1 (R1), S2.5 (NO_4)
IC1: J3.7, RN1.2 (R2), S2.6 (NO_3)
IC2: J3.6, RN1.3 (R3), S2.7 (NO_2)
IC3: J3.5, RN1.4 (R4), S2.8 (NO_1)
IC4: J3.4, RN2.1 (R1), S3.5 (NO_4)
IC5: J3.3, RN2.2 (R2), S3.6 (NO_3)
IC6: J3.2, RN2.3 (R3), S3.7 (NO_2)
IC7: J3.1, RN2.4 (R4), S3.8 (NO_1)
unnamed: LED1.1 (K), R1.1
