andrewpaterson/658-Computer/Kicad/Tester/ROM 2316 to 2716/ROM 2316 to 2716.kicad_sch

## KiCad design Kicad/Tester/ROM 2316 to 2716/ROM 2316 to 2716.kicad_sch (2025-06-25)

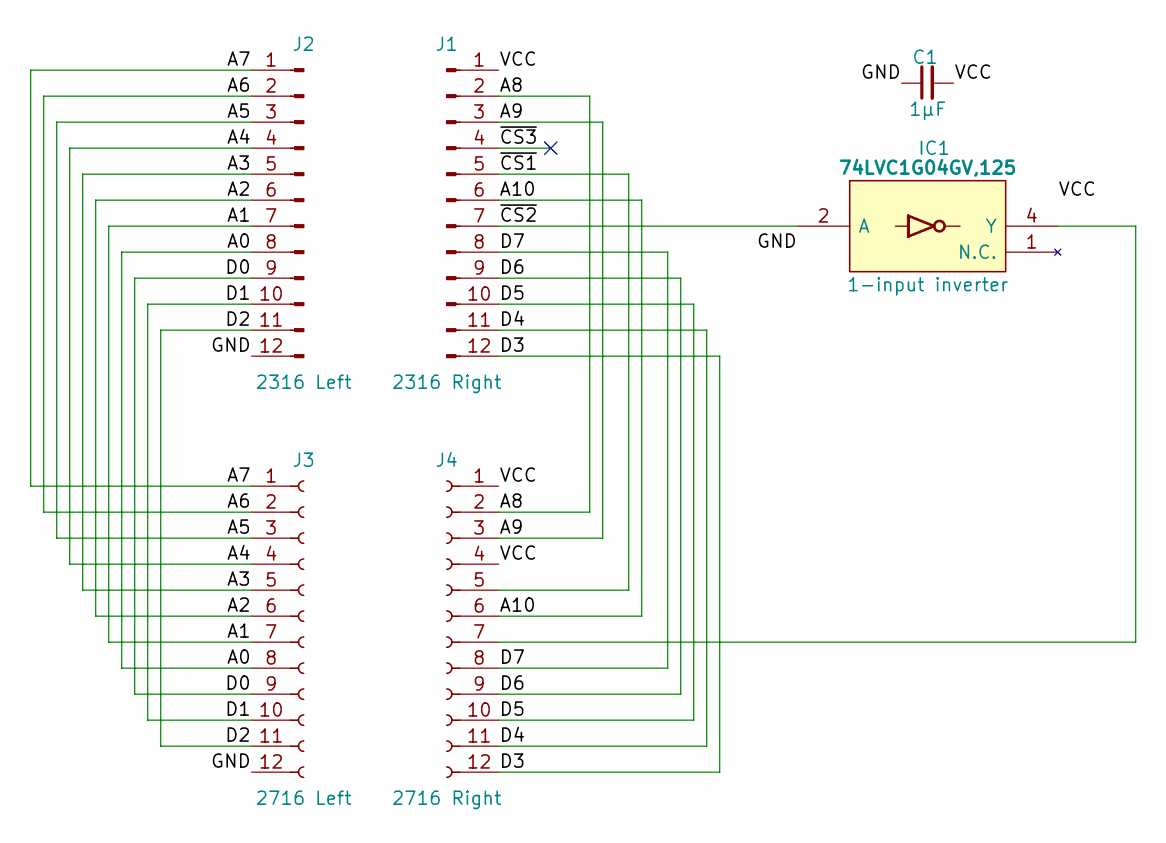
[picture p277: schematic ROM 2316 to 2716.kicad_sch]

Parts:
C1: 1μF; C_0805
IC1: 74LVC1G04GV,125; SOT95P275X110-5N; Manufacturer_Part_Number 74LVC1G04GV,125; Mouser Part Number 771-74LVC1G04GV
J1: 2316 Right; Pin_1x12_P2.54mm_Vertical
J2: 2316 Left; Pin_1x12_P2.54mm_Vertical
J3: 2716 Left; Pin_1x12_P2.54mm_Vertical
J4: 2716 Right; Pin_1x12_P2.54mm_Vertical

Connections:
A0: J2.8, J3.8
A1: J2.7, J3.7
A2: J2.6, J3.6
A3: J2.5, J3.5
A4: J2.4, J3.4
A5: J2.3, J3.3
A6: J2.2, J3.2
A7: J2.1, J3.1
A8: J1.2, J4.2
A9: J1.3, J4.3
A10: J1.6, J4.6
D0: J2.9, J3.9
D1: J2.10, J3.10
D2: J2.11, J3.11
D3: J1.12, J4.12
D4: J1.11, J4.11
D5: J1.10, J4.10
D6: J1.9, J4.9
D7: J1.8, J4.8
GND: C1.1, IC1.3 (GND), J2.12, J3.12
unnamed: IC1.4 (Y), J4.7
VCC: C1.2, IC1.5 (3V), J1.1, J4.1, J4.4
~CS1: J1.5, J4.5
~CS2: IC1.2 (A), J1.7
~CS3: J1.4
