andrewpaterson/658-Computer/Kicad/Tester/Signal Tester Left/Signal Tester Left.kicad_sch

## KiCad design Kicad/Tester/Signal Tester Left/Signal Tester Left.kicad_sch (2024-11-29)

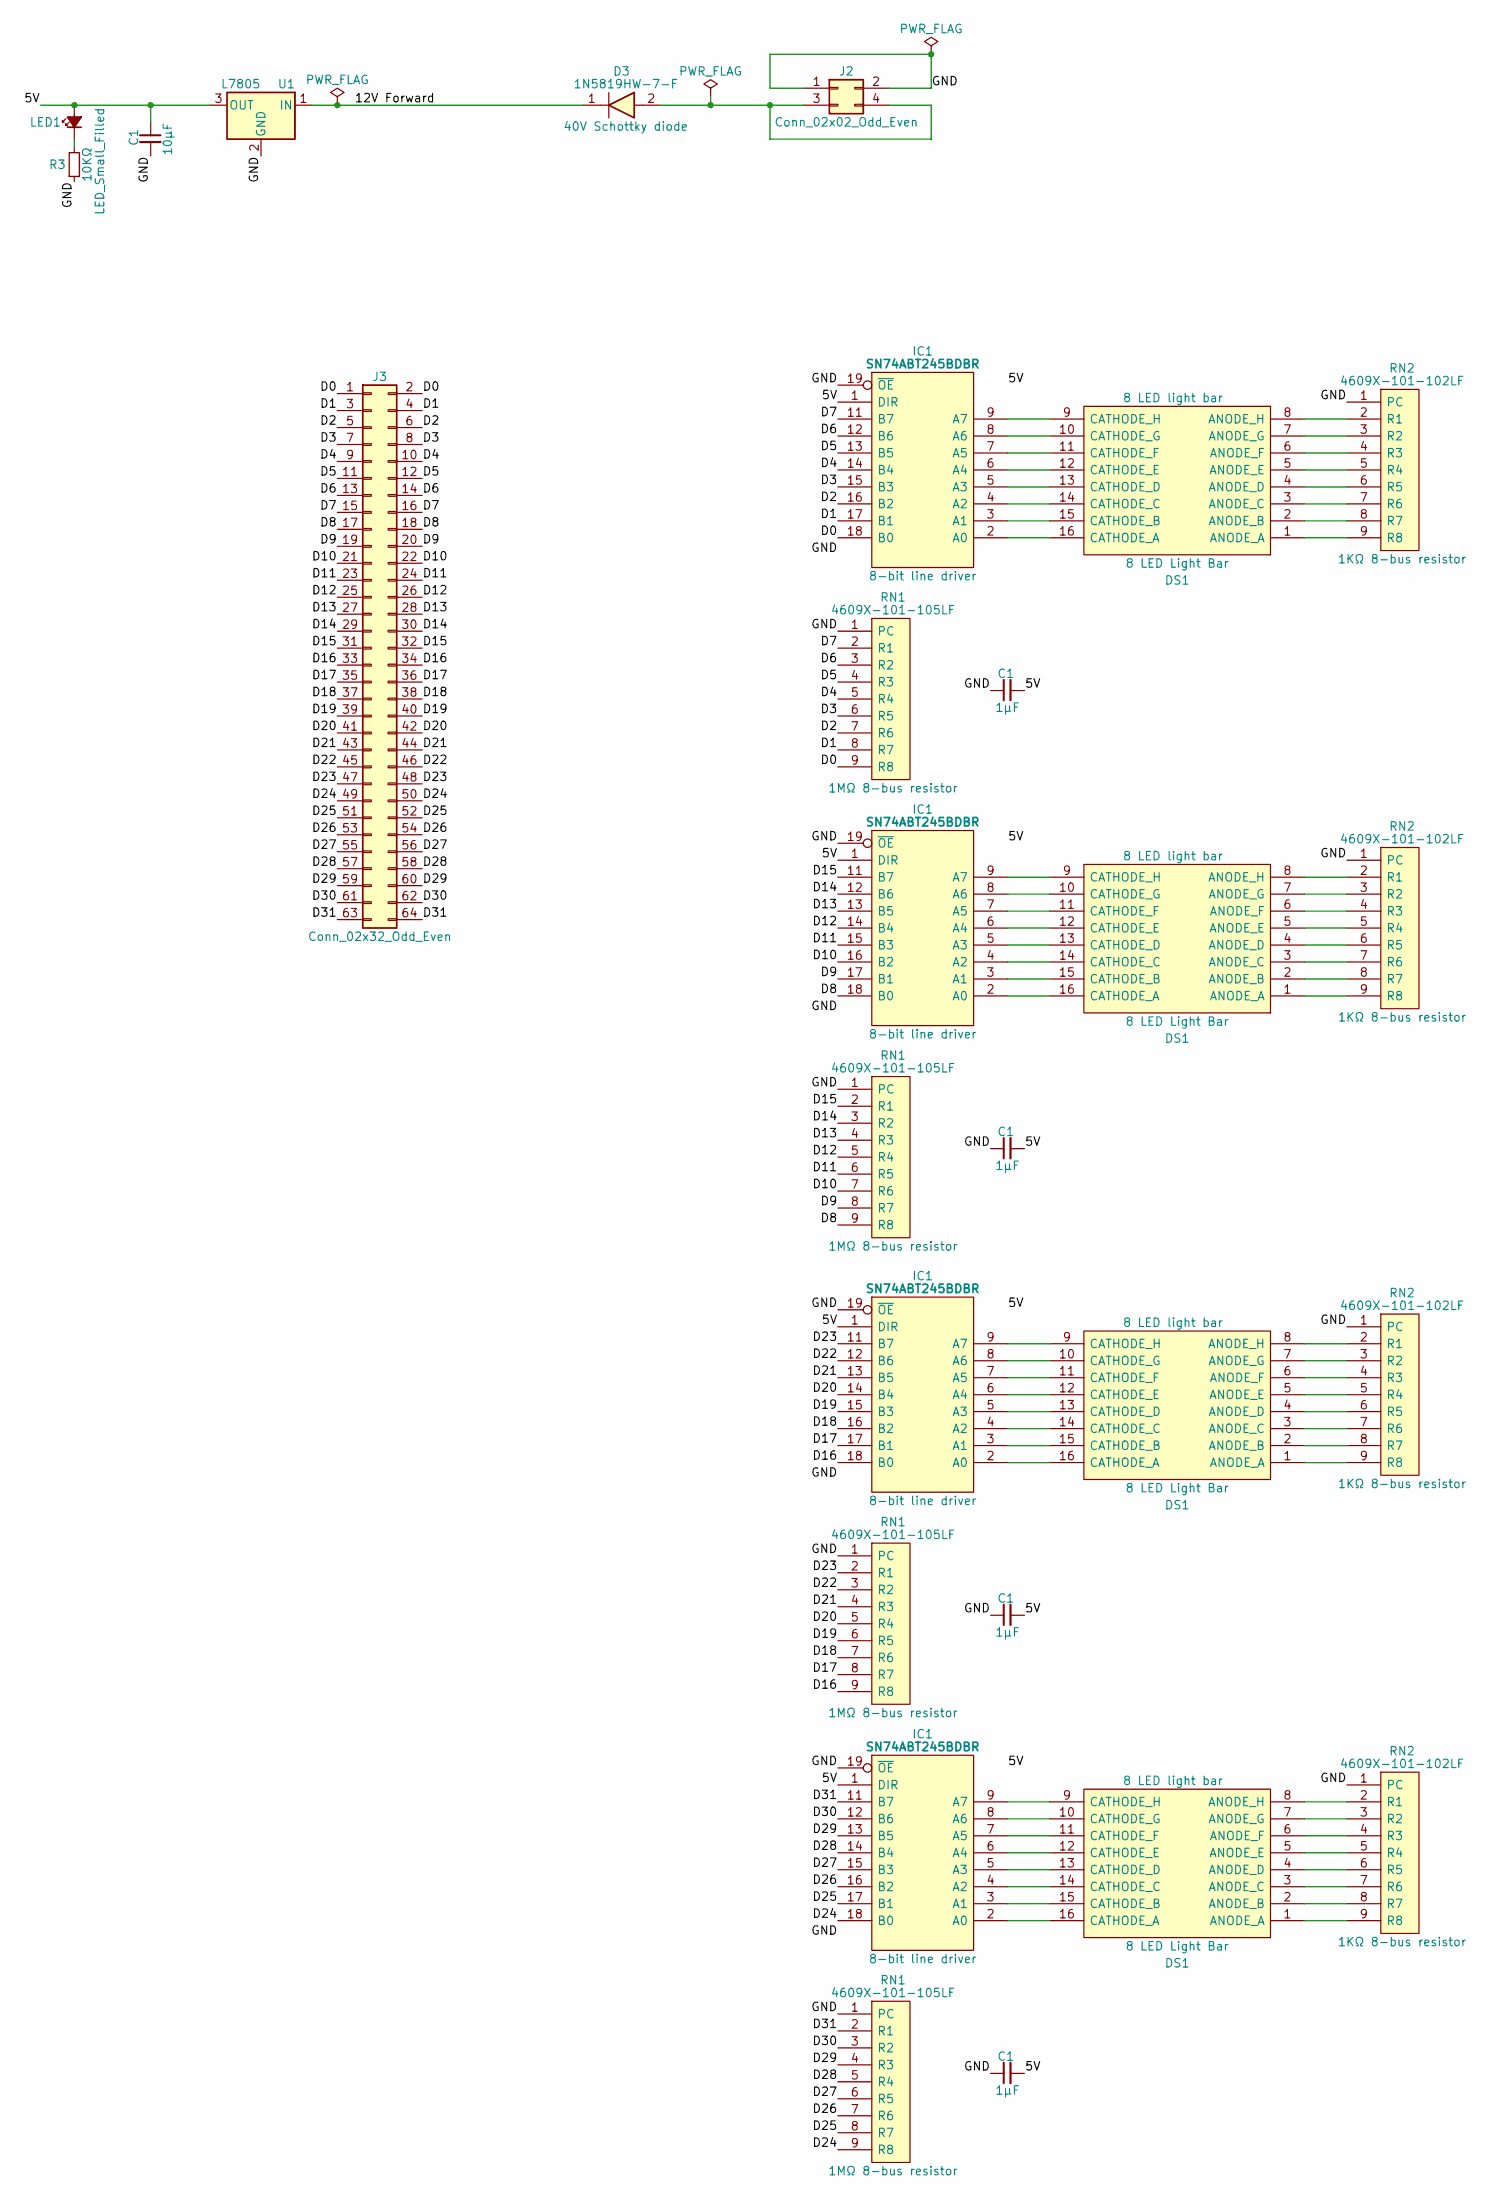
[picture p278: schematic Signal Tester Left.kicad_sch]

Parts:
C1: 1μF; C_0805
D3: 1N5819HW-7-F; SOD3716X145N; Manufacturer_Part_Number 1N5819HW-7-F; Mouser Part Number 621-1N5819HW-F
DS1: 8 LED Light Bar; DIP8LEDBAR; Manufacturer_Part_Number HDSP-4830; Mouser Part Number 630-HDSP-4830
IC1: SN74ABT245BDBR; SOP65P780X200-20N; Manufacturer_Part_Number SN74ABT245BDBR; Mouser Part Number 595-SN74ABT245BDBR
J2: Conn_02x02_Odd_Even; PinSocket_2x02_P2.54mm_Vertical
J3: Conn_02x32_Odd_Even; PinHeader_2x32_P2.54mm_Vertical
LED1: LED_Small_Filled; LED_D5.0mm
R3: 10KΩ; R_0805
RN1: 4609X-101-105LF; 4609X; Manufacturer_Part_Number 4609X-101-105LF; Mouser Part Number 652-4609X-1LF-1M
RN2: 4609X-101-102LF; 4609X; Manufacturer_Part_Number 4609X-101-102LF; Mouser Part Number 652-4609X-1LF-1K
U1: L7805; TO-220-3_Vertical

Connections:
5V: C1.1, C1.2, IC1.1 (DIR), IC1.20 (5V), LED1.2 (A), U1.3 (OUT)
12V Forward: D3.1, U1.1 (IN)
D0: IC1.18 (B0), J3.1, J3.2, RN1.9 (R8)
D1: IC1.17 (B1), J3.3, J3.4, RN1.8 (R7)
D2: IC1.16 (B2), J3.5, J3.6, RN1.7 (R6)
D3: IC1.15 (B3), J3.7, J3.8, RN1.6 (R5)
D4: IC1.14 (B4), J3.9, J3.10, RN1.5 (R4)
D5: IC1.13 (B5), J3.11, J3.12, RN1.4 (R3)
D6: IC1.12 (B6), J3.13, J3.14, RN1.3 (R2)
D7: IC1.11 (B7), J3.15, J3.16, RN1.2 (R1)
D8: IC1.18 (B0), J3.17, J3.18, RN1.9 (R8)
D9: IC1.17 (B1), J3.19, J3.20, RN1.8 (R7)
D10: IC1.16 (B2), J3.21, J3.22, RN1.7 (R6)
D11: IC1.15 (B3), J3.23, J3.24, RN1.6 (R5)
D12: IC1.14 (B4), J3.25, J3.26, RN1.5 (R4)
D13: IC1.13 (B5), J3.27, J3.28, RN1.4 (R3)
D14: IC1.12 (B6), J3.29, J3.30, RN1.3 (R2)
D15: IC1.11 (B7), J3.31, J3.32, RN1.2 (R1)
D16: IC1.18 (B0), J3.33, J3.34, RN1.9 (R8)
D17: IC1.17 (B1), J3.35, J3.36, RN1.8 (R7)
D18: IC1.16 (B2), J3.37, J3.38, RN1.7 (R6)
D19: IC1.15 (B3), J3.39, J3.40, RN1.6 (R5)
D20: IC1.14 (B4), J3.41, J3.42, RN1.5 (R4)
D21: IC1.13 (B5), J3.43, J3.44, RN1.4 (R3)
D22: IC1.12 (B6), J3.45, J3.46, RN1.3 (R2)
D23: IC1.11 (B7), J3.47, J3.48, RN1.2 (R1)
D24: IC1.18 (B0), J3.49, J3.50, RN1.9 (R8)
D25: IC1.17 (B1), J3.51, J3.52, RN1.8 (R7)
D26: IC1.16 (B2), J3.53, J3.54, RN1.7 (R6)
D27: IC1.15 (B3), J3.55, J3.56, RN1.6 (R5)
D28: IC1.14 (B4), J3.57, J3.58, RN1.5 (R4)
D29: IC1.13 (B5), J3.59, J3.60, RN1.4 (R3)
D30: IC1.12 (B6), J3.61, J3.62, RN1.3 (R2)
D31: IC1.11 (B7), J3.63, J3.64, RN1.2 (R1)
GND: C1.1, C1.2, IC1.10 (GND), IC1.19 (~OE), J2.1, J2.2, R3.1, RN1.1 (PC), RN2.1 (PC), U1.2 (GND)
unnamed: D3.2, J2.3, J2.4
unnamed: DS1.1 (ANODE_A), RN2.9 (R8)
unnamed: DS1.2 (ANODE_B), RN2.8 (R7)
unnamed: DS1.3 (ANODE_C), RN2.7 (R6)
unnamed: DS1.4 (ANODE_D), RN2.6 (R5)
unnamed: DS1.5 (ANODE_E), RN2.5 (R4)
unnamed: DS1.6 (ANODE_F), RN2.4 (R3)
unnamed: DS1.7 (ANODE_G), RN2.3 (R2)
unnamed: DS1.8 (ANODE_H), RN2.2 (R1)
unnamed: DS1.9 (CATHODE_H), IC1.9 (A7)
unnamed: DS1.10 (CATHODE_G), IC1.8 (A6)
unnamed: DS1.11 (CATHODE_F), IC1.7 (A5)
unnamed: DS1.12 (CATHODE_E), IC1.6 (A4)
unnamed: DS1.13 (CATHODE_D), IC1.5 (A3)
unnamed: DS1.14 (CATHODE_C), IC1.4 (A2)
unnamed: DS1.15 (CATHODE_B), IC1.3 (A1)
unnamed: DS1.16 (CATHODE_A), IC1.2 (A0)
unnamed: LED1.1 (K), R3.2
