andrewpaterson/658-Computer/Kicad/Video Monitor/LED Address 4x4/LED Address 4x4.kicad_sch

## KiCad design Kicad/Video Monitor/LED Address 4x4/LED Address 4x4.kicad_sch (2024-08-18)

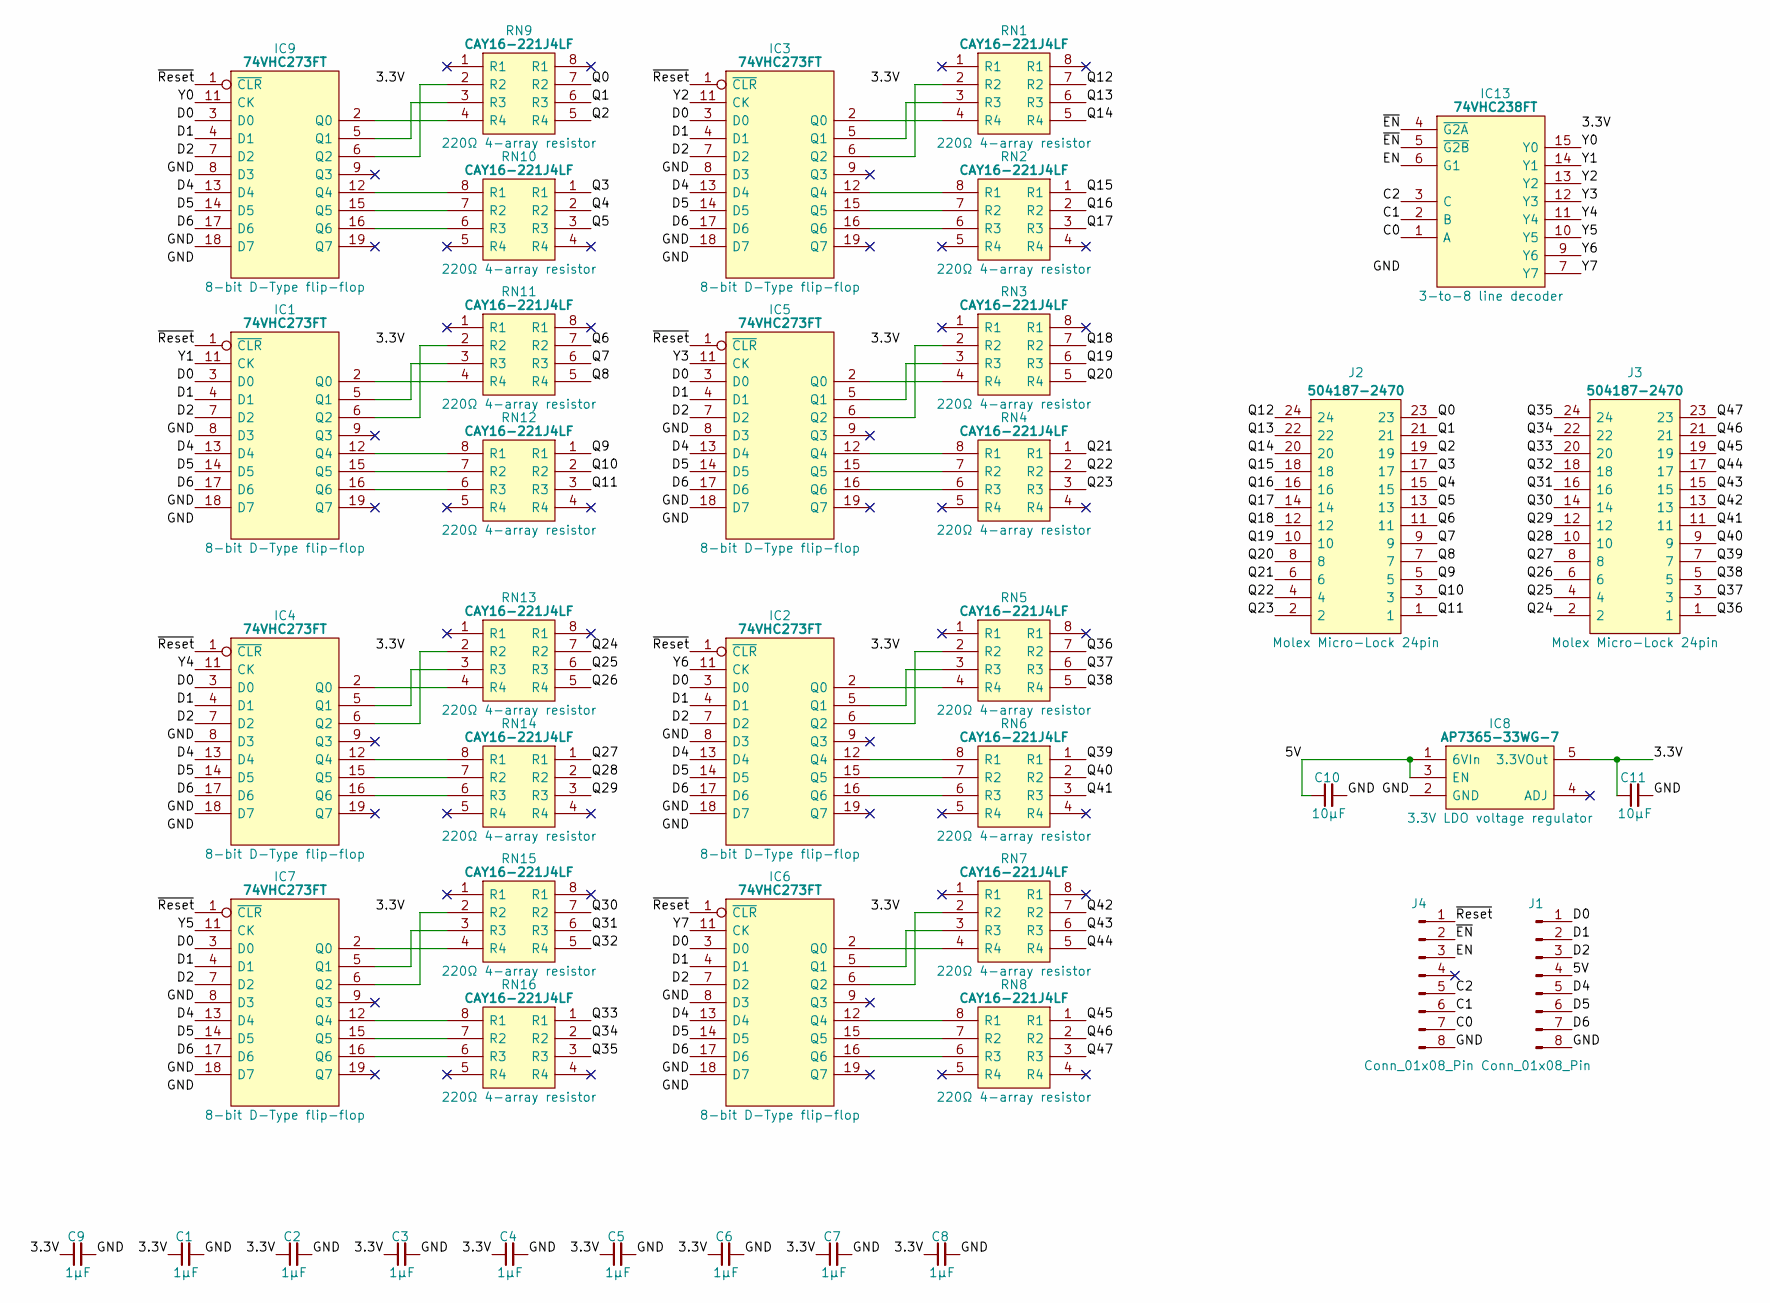
[picture p280: schematic LED Address 4x4.kicad_sch]

Parts:
C1, C2, C3, C4, C5, C6, C7, C8, C9: 1μF; C_0805
C10, C11: 10µF; C_0805
IC1, IC2, IC3, IC4, IC5, IC6, IC7, IC9: 74VHC273FT; SOP65P640X110-20N; Manufacturer_Part_Number 74VHC273FT
IC8: AP7365-33WG-7; SOT95P285X130-5N; Manufacturer_Part_Number AP7365-33WG-7; Mouser Part Number 621-AP7365-33WG-7
IC13: 74VHC238FT; SOP65P640X120-16N; Mouser Part Number 757-74VHC238FT
J1, J4: Conn_01x08_Pin; PinSocket_1x08_P2.54mm_Vertical
J2, J3: 504187-2470; 5041872470; Manufacturer_Part_Number 504187-2470; Mouser Part Number 538-504187-2470
RN1, RN2, RN3, RN4, RN5, RN6, RN7, RN8, RN9, RN10, RN11, RN12, RN13, RN14, RN15, RN16: CAY16-221J4LF; CAY16-F4; Manufacturer_Part_Number CAY16-221J4LF; Mouser Part Number 652-CAY16-221J4LF

Connections:
3.3V: C1.1, C2.1, C3.1, C4.1, C5.1, C6.1, C7.1, C8.1, C9.1, C11.1, IC1.20 (5V), IC2.20 (5V), IC3.20 (5V), IC4.20 (5V), IC5.20 (5V), IC6.20 (5V), IC7.20 (5V), IC8.5 (3.3VOut), IC9.20 (5V), IC13.16 (5V)
5V: C10.1, IC8.1 (6VIn), IC8.3 (EN), J1.4
C0: IC13.1 (A), J4.7
C1: IC13.2 (B), J4.6
C2: IC13.3 (C), J4.5
D0: IC1.3 (D0), IC2.3 (D0), IC3.3 (D0), IC4.3 (D0), IC5.3 (D0), IC6.3 (D0), IC7.3 (D0), IC9.3 (D0), J1.1
D1: IC1.4 (D1), IC2.4 (D1), IC3.4 (D1), IC4.4 (D1), IC5.4 (D1), IC6.4 (D1), IC7.4 (D1), IC9.4 (D1), J1.2
D2: IC1.7 (D2), IC2.7 (D2), IC3.7 (D2), IC4.7 (D2), IC5.7 (D2), IC6.7 (D2), IC7.7 (D2), IC9.7 (D2), J1.3
D4: IC1.13 (D4), IC2.13 (D4), IC3.13 (D4), IC4.13 (D4), IC5.13 (D4), IC6.13 (D4), IC7.13 (D4), IC9.13 (D4), J1.5
D5: IC1.14 (D5), IC2.14 (D5), IC3.14 (D5), IC4.14 (D5), IC5.14 (D5), IC6.14 (D5), IC7.14 (D5), IC9.14 (D5), J1.6
D6: IC1.17 (D6), IC2.17 (D6), IC3.17 (D6), IC4.17 (D6), IC5.17 (D6), IC6.17 (D6), IC7.17 (D6), IC9.17 (D6), J1.7
EN: IC13.6 (G1), J4.3
GND: C1.2, C2.2, C3.2, C4.2, C5.2, C6.2, C7.2, C8.2, C9.2, C10.2, C11.2, IC1.8 (D3), IC1.10 (GND), IC1.18 (D7), IC2.8 (D3), IC2.10 (GND), IC2.18 (D7), IC3.8 (D3), IC3.10 (GND), IC3.18 (D7), IC4.8 (D3), IC4.10 (GND), IC4.18 (D7), IC5.8 (D3), IC5.10 (GND), IC5.18 (D7), IC6.8 (D3), IC6.10 (GND), IC6.18 (D7), IC7.8 (D3), IC7.10 (GND), IC7.18 (D7), IC8.2 (GND), IC9.8 (D3), IC9.10 (GND), IC9.18 (D7), IC13.8 (GND), J1.8, J4.8
unnamed: IC1.2 (Q0), RN11.4 (R4)
unnamed: IC1.5 (Q1), RN11.3 (R3)
unnamed: IC1.6 (Q2), RN11.2 (R2)
unnamed: IC1.12 (Q4), RN12.8 (R1)
unnamed: IC1.15 (Q5), RN12.7 (R2)
unnamed: IC1.16 (Q6), RN12.6 (R3)
unnamed: IC2.2 (Q0), RN5.4 (R4)
unnamed: IC2.5 (Q1), RN5.3 (R3)
unnamed: IC2.6 (Q2), RN5.2 (R2)
unnamed: IC2.12 (Q4), RN6.8 (R1)
unnamed: IC2.15 (Q5), RN6.7 (R2)
unnamed: IC2.16 (Q6), RN6.6 (R3)
unnamed: IC3.2 (Q0), RN1.4 (R4)
unnamed: IC3.5 (Q1), RN1.3 (R3)
unnamed: IC3.6 (Q2), RN1.2 (R2)
unnamed: IC3.12 (Q4), RN2.8 (R1)
unnamed: IC3.15 (Q5), RN2.7 (R2)
unnamed: IC3.16 (Q6), RN2.6 (R3)
unnamed: IC4.2 (Q0), RN13.4 (R4)
unnamed: IC4.5 (Q1), RN13.3 (R3)
unnamed: IC4.6 (Q2), RN13.2 (R2)
unnamed: IC4.12 (Q4), RN14.8 (R1)
unnamed: IC4.15 (Q5), RN14.7 (R2)
unnamed: IC4.16 (Q6), RN14.6 (R3)
unnamed: IC5.2 (Q0), RN3.4 (R4)
unnamed: IC5.5 (Q1), RN3.3 (R3)
unnamed: IC5.6 (Q2), RN3.2 (R2)
unnamed: IC5.12 (Q4), RN4.8 (R1)
unnamed: IC5.15 (Q5), RN4.7 (R2)
unnamed: IC5.16 (Q6), RN4.6 (R3)
unnamed: IC6.2 (Q0), RN7.4 (R4)
unnamed: IC6.5 (Q1), RN7.3 (R3)
unnamed: IC6.6 (Q2), RN7.2 (R2)
unnamed: IC6.12 (Q4), RN8.8 (R1)
unnamed: IC6.15 (Q5), RN8.7 (R2)
unnamed: IC6.16 (Q6), RN8.6 (R3)
unnamed: IC7.2 (Q0), RN15.4 (R4)
unnamed: IC7.5 (Q1), RN15.3 (R3)
unnamed: IC7.6 (Q2), RN15.2 (R2)
unnamed: IC7.12 (Q4), RN16.8 (R1)
unnamed: IC7.15 (Q5), RN16.7 (R2)
unnamed: IC7.16 (Q6), RN16.6 (R3)
unnamed: IC9.2 (Q0), RN9.4 (R4)
unnamed: IC9.5 (Q1), RN9.3 (R3)
unnamed: IC9.6 (Q2), RN9.2 (R2)
unnamed: IC9.12 (Q4), RN10.8 (R1)
unnamed: IC9.15 (Q5), RN10.7 (R2)
unnamed: IC9.16 (Q6), RN10.6 (R3)
Q0: J2.23, RN9.7 (R2)
Q1: J2.21, RN9.6 (R3)
Q2: J2.19, RN9.5 (R4)
Q3: J2.17, RN10.1 (R1)
Q4: J2.15, RN10.2 (R2)
Q5: J2.13, RN10.3 (R3)
Q6: J2.11, RN11.7 (R2)
Q7: J2.9, RN11.6 (R3)
Q8: J2.7, RN11.5 (R4)
Q9: J2.5, RN12.1 (R1)
Q10: J2.3, RN12.2 (R2)
Q11: J2.1, RN12.3 (R3)
Q12: J2.24, RN1.7 (R2)
Q13: J2.22, RN1.6 (R3)
Q14: J2.20, RN1.5 (R4)
Q15: J2.18, RN2.1 (R1)
Q16: J2.16, RN2.2 (R2)
Q17: J2.14, RN2.3 (R3)
Q18: J2.12, RN3.7 (R2)
Q19: J2.10, RN3.6 (R3)
Q20: J2.8, RN3.5 (R4)
Q21: J2.6, RN4.1 (R1)
Q22: J2.4, RN4.2 (R2)
Q23: J2.2, RN4.3 (R3)
Q24: J3.2, RN13.7 (R2)
Q25: J3.4, RN13.6 (R3)
Q26: J3.6, RN13.5 (R4)
Q27: J3.8, RN14.1 (R1)
Q28: J3.10, RN14.2 (R2)
Q29: J3.12, RN14.3 (R3)
Q30: J3.14, RN15.7 (R2)
Q31: J3.16, RN15.6 (R3)
Q32: J3.18, RN15.5 (R4)
Q33: J3.20, RN16.1 (R1)
Q34: J3.22, RN16.2 (R2)
Q35: J3.24, RN16.3 (R3)
Q36: J3.1, RN5.7 (R2)
Q37: J3.3, RN5.6 (R3)
Q38: J3.5, RN5.5 (R4)
Q39: J3.7, RN6.1 (R1)
Q40: J3.9, RN6.2 (R2)
Q41: J3.11, RN6.3 (R3)
Q42: J3.13, RN7.7 (R2)
Q43: J3.15, RN7.6 (R3)
Q44: J3.17, RN7.5 (R4)
Q45: J3.19, RN8.1 (R1)
Q46: J3.21, RN8.2 (R2)
Q47: J3.23, RN8.3 (R3)
Y0: IC9.11 (CK), IC13.15 (Y0)
Y1: IC1.11 (CK), IC13.14 (Y1)
Y2: IC3.11 (CK), IC13.13 (Y2)
Y3: IC5.11 (CK), IC13.12 (Y3)
Y4: IC4.11 (CK), IC13.11 (Y4)
Y5: IC7.11 (CK), IC13.10 (Y5)
Y6: IC2.11 (CK), IC13.9 (Y6)
Y7: IC6.11 (CK), IC13.7 (Y7)
~EN: IC13.4 (~G2A), IC13.5 (~G2B), J4.2
~Reset: IC1.1 (~CLR), IC2.1 (~CLR), IC3.1 (~CLR), IC4.1 (~CLR), IC5.1 (~CLR), IC6.1 (~CLR), IC7.1 (~CLR), IC9.1 (~CLR), J4.1
