andrewpaterson/658-Computer/Kicad/Video Monitor/LED Panel 4x4/LED Panel 4x4.kicad_sch

## KiCad design Kicad/Video Monitor/LED Panel 4x4/LED Panel 4x4.kicad_sch (2024-08-19)

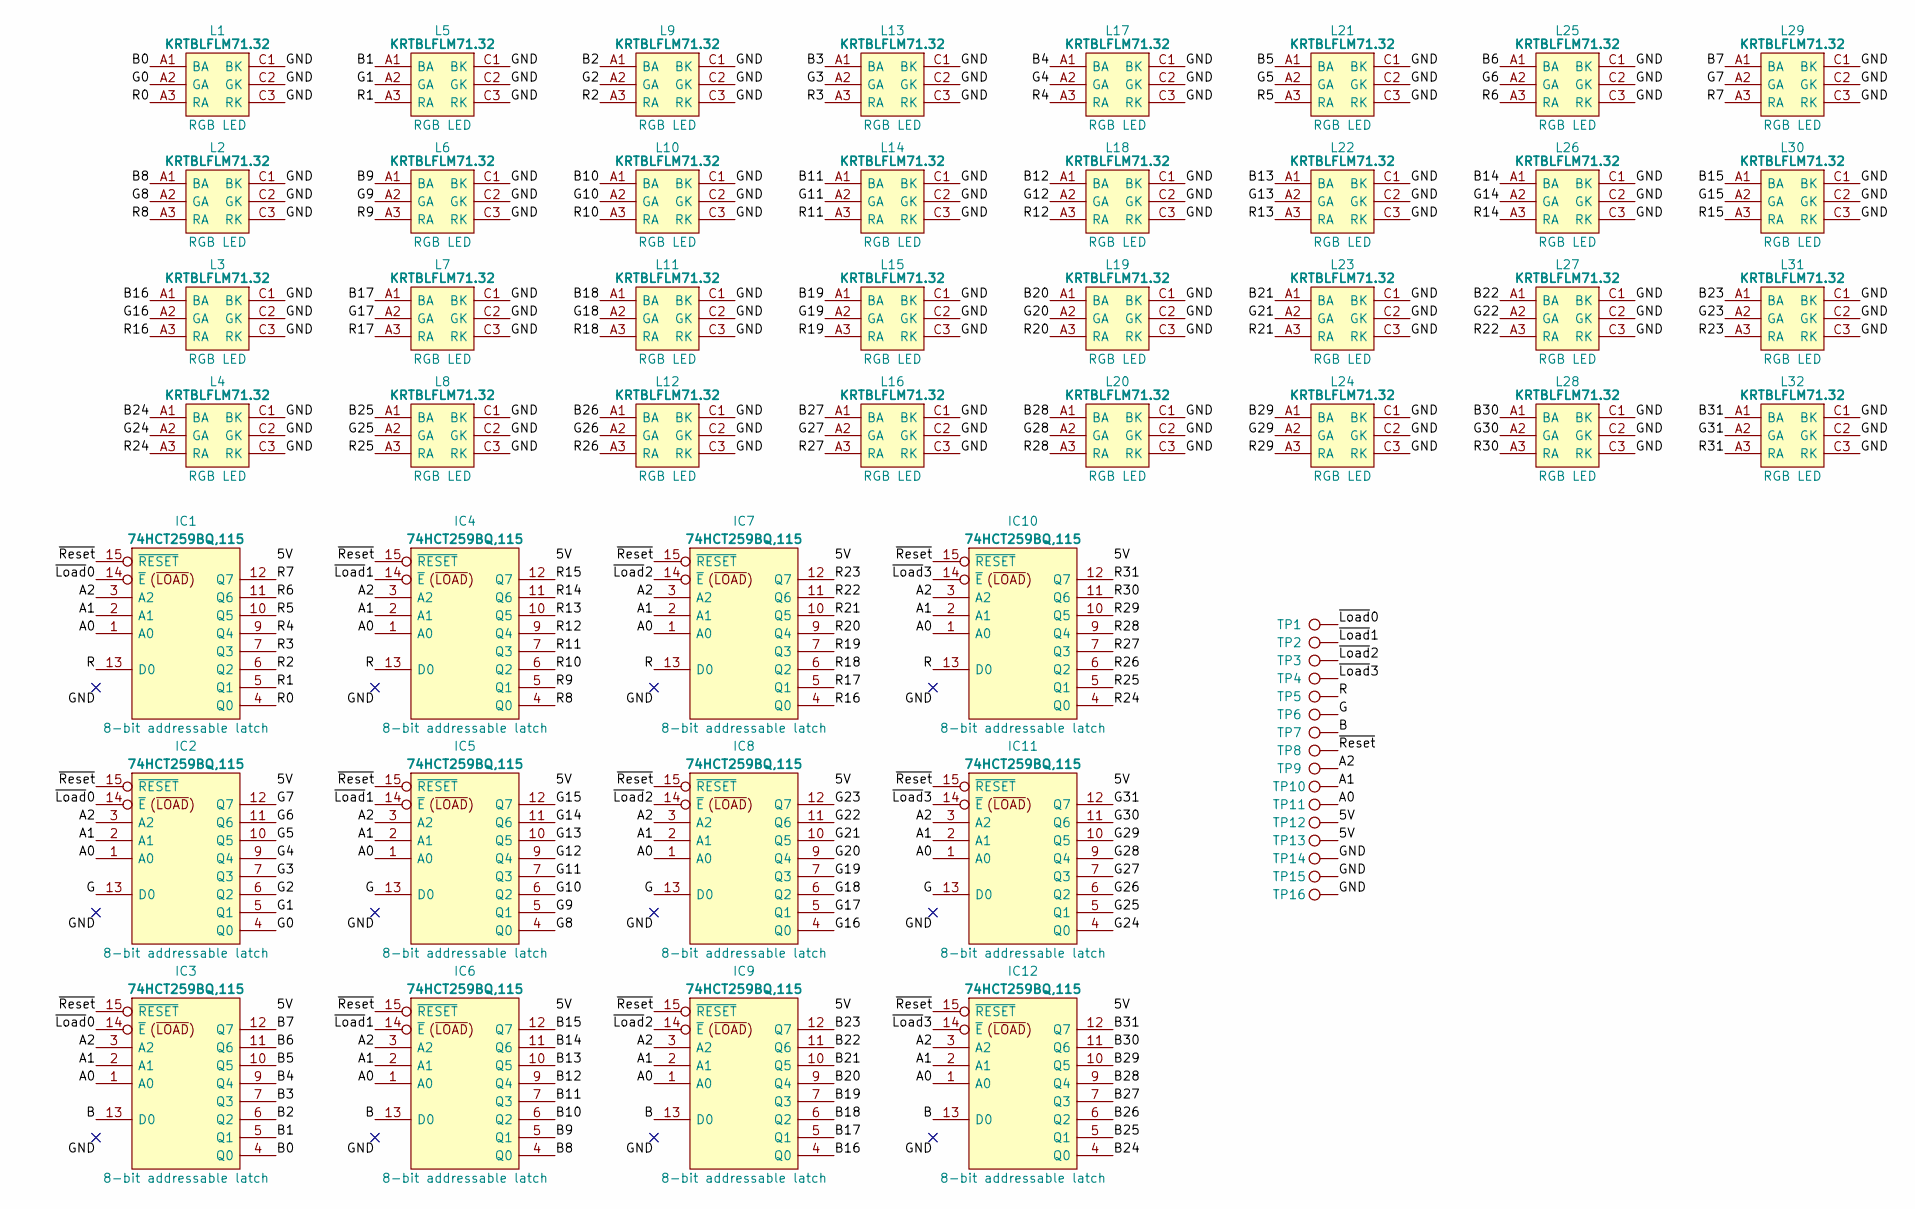
[picture p281: schematic LED Panel 4x4.kicad_sch]

Parts:
IC1, IC2, IC3, IC4, IC5, IC6, IC7, IC8, IC9, IC10, IC11, IC12: 74HCT259BQ,115; 74HCT259BQ115; Manufacturer_Part_Number 74HCT259BQ,115; Mouser Part Number 771-74HCT259BQ115
L1, L2, L3, L4, L5, L6, L7, L8, L9, L10, L11, L12, L13, L14, L15, L16, L17, L18, L19, L20, L21, L22, L23, L24, L25, L26, L27, L28, L29, L30, L31, L32: KRTBLFLM71.32; KRTBLFLM7132TXUYEVVTAUDPRXTUKY; Manufacturer_Part_Number KRTBLFLM71.32-TXUY-EV+VTAU-DP+RXTU-KY
TP1, TP2, TP3, TP4, TP5, TP6, TP7, TP8, TP9, TP10, TP11, TP12, TP13, TP14, TP15, TP16: TestPoint; Point_D1.0mm_Drill0.5mm

Connections:
5V: IC1.16 (5V), IC2.16 (5V), IC3.16 (5V), IC4.16 (5V), IC5.16 (5V), IC6.16 (5V), IC7.16 (5V), IC8.16 (5V), IC9.16 (5V), IC10.16 (5V), IC11.16 (5V), IC12.16 (5V), TP12.1, TP13.1
A0: IC1.1 (A0), IC2.1 (A0), IC3.1 (A0), IC4.1 (A0), IC5.1 (A0), IC6.1 (A0), IC7.1 (A0), IC8.1 (A0), IC9.1 (A0), IC10.1 (A0), IC11.1 (A0), IC12.1 (A0), TP11.1
A1: IC1.2 (A1), IC2.2 (A1), IC3.2 (A1), IC4.2 (A1), IC5.2 (A1), IC6.2 (A1), IC7.2 (A1), IC8.2 (A1), IC9.2 (A1), IC10.2 (A1), IC11.2 (A1), IC12.2 (A1), TP10.1
A2: IC1.3 (A2), IC2.3 (A2), IC3.3 (A2), IC4.3 (A2), IC5.3 (A2), IC6.3 (A2), IC7.3 (A2), IC8.3 (A2), IC9.3 (A2), IC10.3 (A2), IC11.3 (A2), IC12.3 (A2), TP9.1
B: IC3.13 (D0), IC6.13 (D0), IC9.13 (D0), IC12.13 (D0), TP7.1
B0: IC3.4 (Q0), L1.A1 (BA)
B1: IC3.5 (Q1), L5.A1 (BA)
B2: IC3.6 (Q2), L9.A1 (BA)
B3: IC3.7 (Q3), L13.A1 (BA)
B4: IC3.9 (Q4), L17.A1 (BA)
B5: IC3.10 (Q5), L21.A1 (BA)
B6: IC3.11 (Q6), L25.A1 (BA)
B7: IC3.12 (Q7), L29.A1 (BA)
B8: IC6.4 (Q0), L2.A1 (BA)
B9: IC6.5 (Q1), L6.A1 (BA)
B10: IC6.6 (Q2), L10.A1 (BA)
B11: IC6.7 (Q3), L14.A1 (BA)
B12: IC6.9 (Q4), L18.A1 (BA)
B13: IC6.10 (Q5), L22.A1 (BA)
B14: IC6.11 (Q6), L26.A1 (BA)
B15: IC6.12 (Q7), L30.A1 (BA)
B16: IC9.4 (Q0), L3.A1 (BA)
B17: IC9.5 (Q1), L7.A1 (BA)
B18: IC9.6 (Q2), L11.A1 (BA)
B19: IC9.7 (Q3), L15.A1 (BA)
B20: IC9.9 (Q4), L19.A1 (BA)
B21: IC9.10 (Q5), L23.A1 (BA)
B22: IC9.11 (Q6), L27.A1 (BA)
B23: IC9.12 (Q7), L31.A1 (BA)
B24: IC12.4 (Q0), L4.A1 (BA)
B25: IC12.5 (Q1), L8.A1 (BA)
B26: IC12.6 (Q2), L12.A1 (BA)
B27: IC12.7 (Q3), L16.A1 (BA)
B28: IC12.9 (Q4), L20.A1 (BA)
B29: IC12.10 (Q5), L24.A1 (BA)
B30: IC12.11 (Q6), L28.A1 (BA)
B31: IC12.12 (Q7), L32.A1 (BA)
G: IC2.13 (D0), IC5.13 (D0), IC8.13 (D0), IC11.13 (D0), TP6.1
G0: IC2.4 (Q0), L1.A2 (GA)
G1: IC2.5 (Q1), L5.A2 (GA)
G2: IC2.6 (Q2), L9.A2 (GA)
G3: IC2.7 (Q3), L13.A2 (GA)
G4: IC2.9 (Q4), L17.A2 (GA)
G5: IC2.10 (Q5), L21.A2 (GA)
G6: IC2.11 (Q6), L25.A2 (GA)
G7: IC2.12 (Q7), L29.A2 (GA)
G8: IC5.4 (Q0), L2.A2 (GA)
G9: IC5.5 (Q1), L6.A2 (GA)
G10: IC5.6 (Q2), L10.A2 (GA)
G11: IC5.7 (Q3), L14.A2 (GA)
G12: IC5.9 (Q4), L18.A2 (GA)
G13: IC5.10 (Q5), L22.A2 (GA)
G14: IC5.11 (Q6), L26.A2 (GA)
G15: IC5.12 (Q7), L30.A2 (GA)
G16: IC8.4 (Q0), L3.A2 (GA)
G17: IC8.5 (Q1), L7.A2 (GA)
G18: IC8.6 (Q2), L11.A2 (GA)
G19: IC8.7 (Q3), L15.A2 (GA)
G20: IC8.9 (Q4), L19.A2 (GA)
G21: IC8.10 (Q5), L23.A2 (GA)
G22: IC8.11 (Q6), L27.A2 (GA)
G23: IC8.12 (Q7), L31.A2 (GA)
G24: IC11.4 (Q0), L4.A2 (GA)
G25: IC11.5 (Q1), L8.A2 (GA)
G26: IC11.6 (Q2), L12.A2 (GA)
G27: IC11.7 (Q3), L16.A2 (GA)
G28: IC11.9 (Q4), L20.A2 (GA)
G29: IC11.10 (Q5), L24.A2 (GA)
G30: IC11.11 (Q6), L28.A2 (GA)
G31: IC11.12 (Q7), L32.A2 (GA)
GND: IC1.8 (GND), IC2.8 (GND), IC3.8 (GND), IC4.8 (GND), IC5.8 (GND), IC6.8 (GND), IC7.8 (GND), IC8.8 (GND), IC9.8 (GND), IC10.8 (GND), IC11.8 (GND), IC12.8 (GND), L1.C1 (BK), L1.C2 (GK), L1.C3 (RK), L2.C1 (BK), L2.C2 (GK), L2.C3 (RK), L3.C1 (BK), L3.C2 (GK), L3.C3 (RK), L4.C1 (BK), L4.C2 (GK), L4.C3 (RK), L5.C1 (BK), L5.C2 (GK), L5.C3 (RK), L6.C1 (BK), L6.C2 (GK), L6.C3 (RK), L7.C1 (BK), L7.C2 (GK), L7.C3 (RK), L8.C1 (BK), L8.C2 (GK), L8.C3 (RK), L9.C1 (BK), L9.C2 (GK), L9.C3 (RK), L10.C1 (BK), L10.C2 (GK), L10.C3 (RK), L11.C1 (BK), L11.C2 (GK), L11.C3 (RK), L12.C1 (BK), L12.C2 (GK), L12.C3 (RK), L13.C1 (BK), L13.C2 (GK), L13.C3 (RK), L14.C1 (BK), L14.C2 (GK), L14.C3 (RK), L15.C1 (BK), L15.C2 (GK), L15.C3 (RK), L16.C1 (BK), L16.C2 (GK), L16.C3 (RK), L17.C1 (BK), L17.C2 (GK), L17.C3 (RK), L18.C1 (BK), L18.C2 (GK), L18.C3 (RK), L19.C1 (BK), L19.C2 (GK), L19.C3 (RK), L20.C1 (BK), L20.C2 (GK), L20.C3 (RK), L21.C1 (BK), L21.C2 (GK), L21.C3 (RK), L22.C1 (BK), L22.C2 (GK), L22.C3 (RK), L23.C1 (BK), L23.C2 (GK), L23.C3 (RK), L24.C1 (BK), L24.C2 (GK), L24.C3 (RK), L25.C1 (BK), L25.C2 (GK), L25.C3 (RK), L26.C1 (BK), L26.C2 (GK), L26.C3 (RK), L27.C1 (BK), L27.C2 (GK), L27.C3 (RK), L28.C1 (BK), L28.C2 (GK), L28.C3 (RK), L29.C1 (BK), L29.C2 (GK), L29.C3 (RK), L30.C1 (BK), L30.C2 (GK), L30.C3 (RK), L31.C1 (BK), L31.C2 (GK), L31.C3 (RK), L32.C1 (BK), L32.C2 (GK), L32.C3 (RK), TP14.1, TP15.1, TP16.1
R: IC1.13 (D0), IC4.13 (D0), IC7.13 (D0), IC10.13 (D0), TP5.1
R0: IC1.4 (Q0), L1.A3 (RA)
R1: IC1.5 (Q1), L5.A3 (RA)
R2: IC1.6 (Q2), L9.A3 (RA)
R3: IC1.7 (Q3), L13.A3 (RA)
R4: IC1.9 (Q4), L17.A3 (RA)
R5: IC1.10 (Q5), L21.A3 (RA)
R6: IC1.11 (Q6), L25.A3 (RA)
R7: IC1.12 (Q7), L29.A3 (RA)
R8: IC4.4 (Q0), L2.A3 (RA)
R9: IC4.5 (Q1), L6.A3 (RA)
R10: IC4.6 (Q2), L10.A3 (RA)
R11: IC4.7 (Q3), L14.A3 (RA)
R12: IC4.9 (Q4), L18.A3 (RA)
R13: IC4.10 (Q5), L22.A3 (RA)
R14: IC4.11 (Q6), L26.A3 (RA)
R15: IC4.12 (Q7), L30.A3 (RA)
R16: IC7.4 (Q0), L3.A3 (RA)
R17: IC7.5 (Q1), L7.A3 (RA)
R18: IC7.6 (Q2), L11.A3 (RA)
R19: IC7.7 (Q3), L15.A3 (RA)
R20: IC7.9 (Q4), L19.A3 (RA)
R21: IC7.10 (Q5), L23.A3 (RA)
R22: IC7.11 (Q6), L27.A3 (RA)
R23: IC7.12 (Q7), L31.A3 (RA)
R24: IC10.4 (Q0), L4.A3 (RA)
R25: IC10.5 (Q1), L8.A3 (RA)
R26: IC10.6 (Q2), L12.A3 (RA)
R27: IC10.7 (Q3), L16.A3 (RA)
R28: IC10.9 (Q4), L20.A3 (RA)
R29: IC10.10 (Q5), L24.A3 (RA)
R30: IC10.11 (Q6), L28.A3 (RA)
R31: IC10.12 (Q7), L32.A3 (RA)
~Load0: IC1.14 (~E), IC2.14 (~E), IC3.14 (~E), TP1.1
~Load1: IC4.14 (~E), IC5.14 (~E), IC6.14 (~E), TP2.1
~Load2: IC7.14 (~E), IC8.14 (~E), IC9.14 (~E), TP3.1
~Load3: IC10.14 (~E), IC11.14 (~E), IC12.14 (~E), TP4.1
~Reset: IC1.15 (~RESET), IC2.15 (~RESET), IC3.15 (~RESET), IC4.15 (~RESET), IC5.15 (~RESET), IC6.15 (~RESET), IC7.15 (~RESET), IC8.15 (~RESET), IC9.15 (~RESET), IC10.15 (~RESET), IC11.15 (~RESET), IC12.15 (~RESET), TP8.1
