andrewpaterson/658-Computer/Kicad/Boards/Pins/Board 2x12 W15.24/Board 2x12 W15.24.kicad_sch

## KiCad design Kicad/Boards/Pins/Board 2x12 W15.24/Board 2x12 W15.24.kicad_sch (2025-09-29)

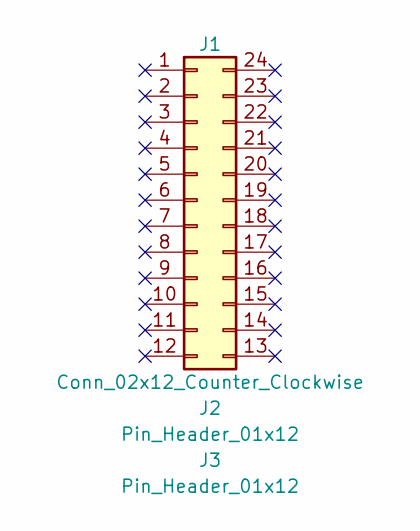
[picture p284: schematic Board 2x12 W15.24.kicad_sch]

Parts:
J1: Conn_02x12_Counter_Clockwise
J2, J3: Pin_Header_01x12; PinHeader_1x12_P2.54mm_Vertical
