andrewpaterson/658-Computer/Kicad/Computer/Blitter/Blitter Board/Blitter Board.kicad_sch

## KiCad design Kicad/Computer/Blitter/Blitter Board/Blitter Board.kicad_sch (2025-10-12)

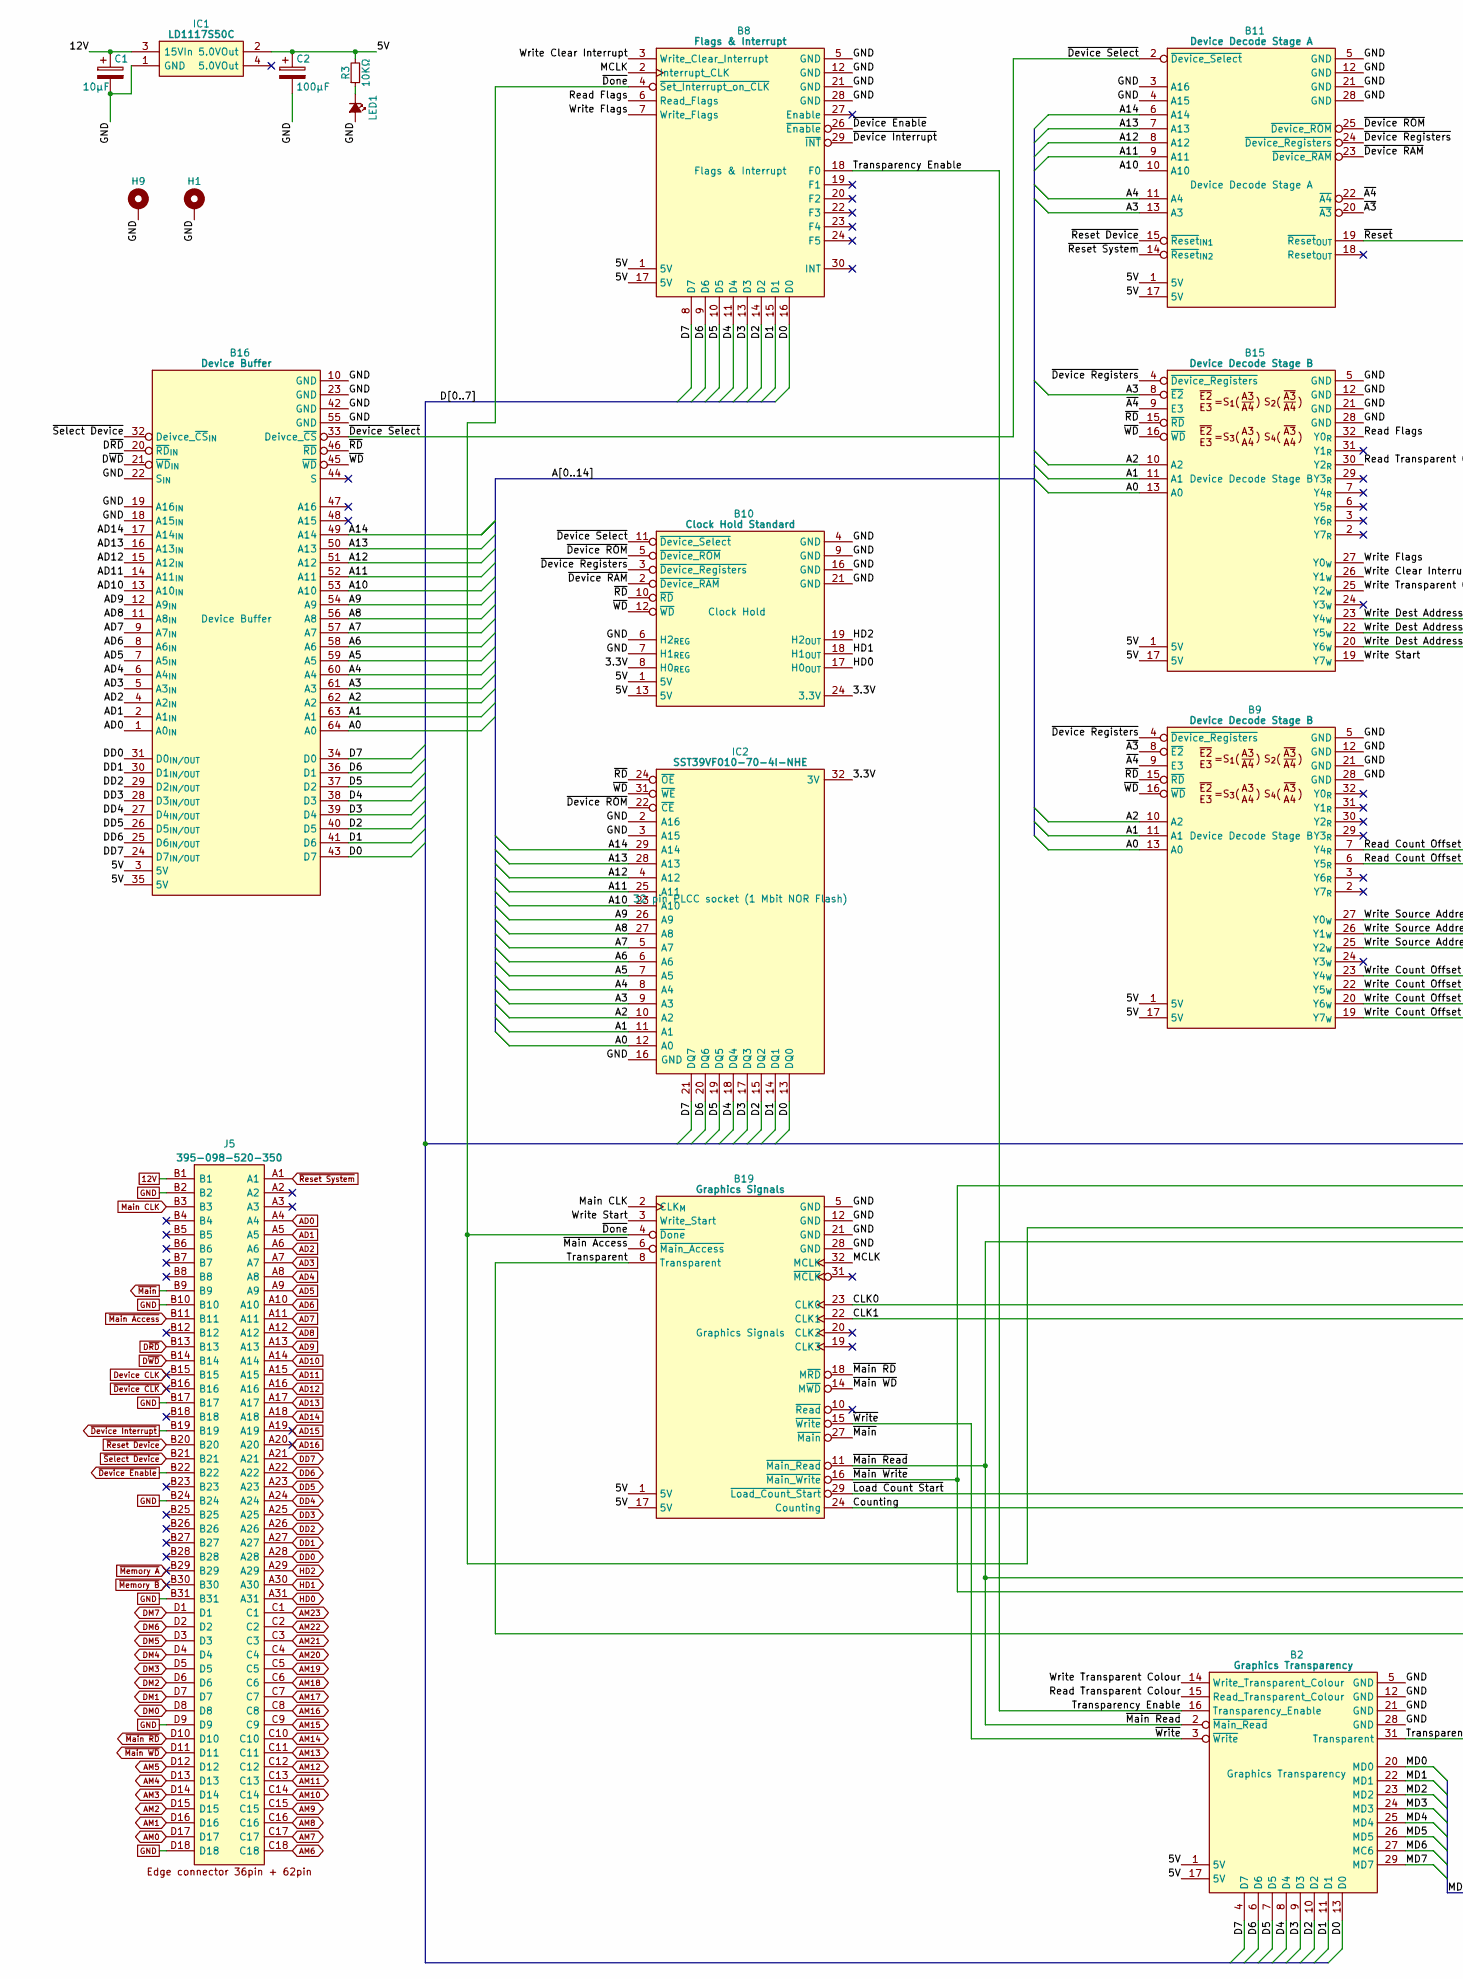
[picture p286: schematic Blitter Board.kicad_sch, part in row 1, column 1]

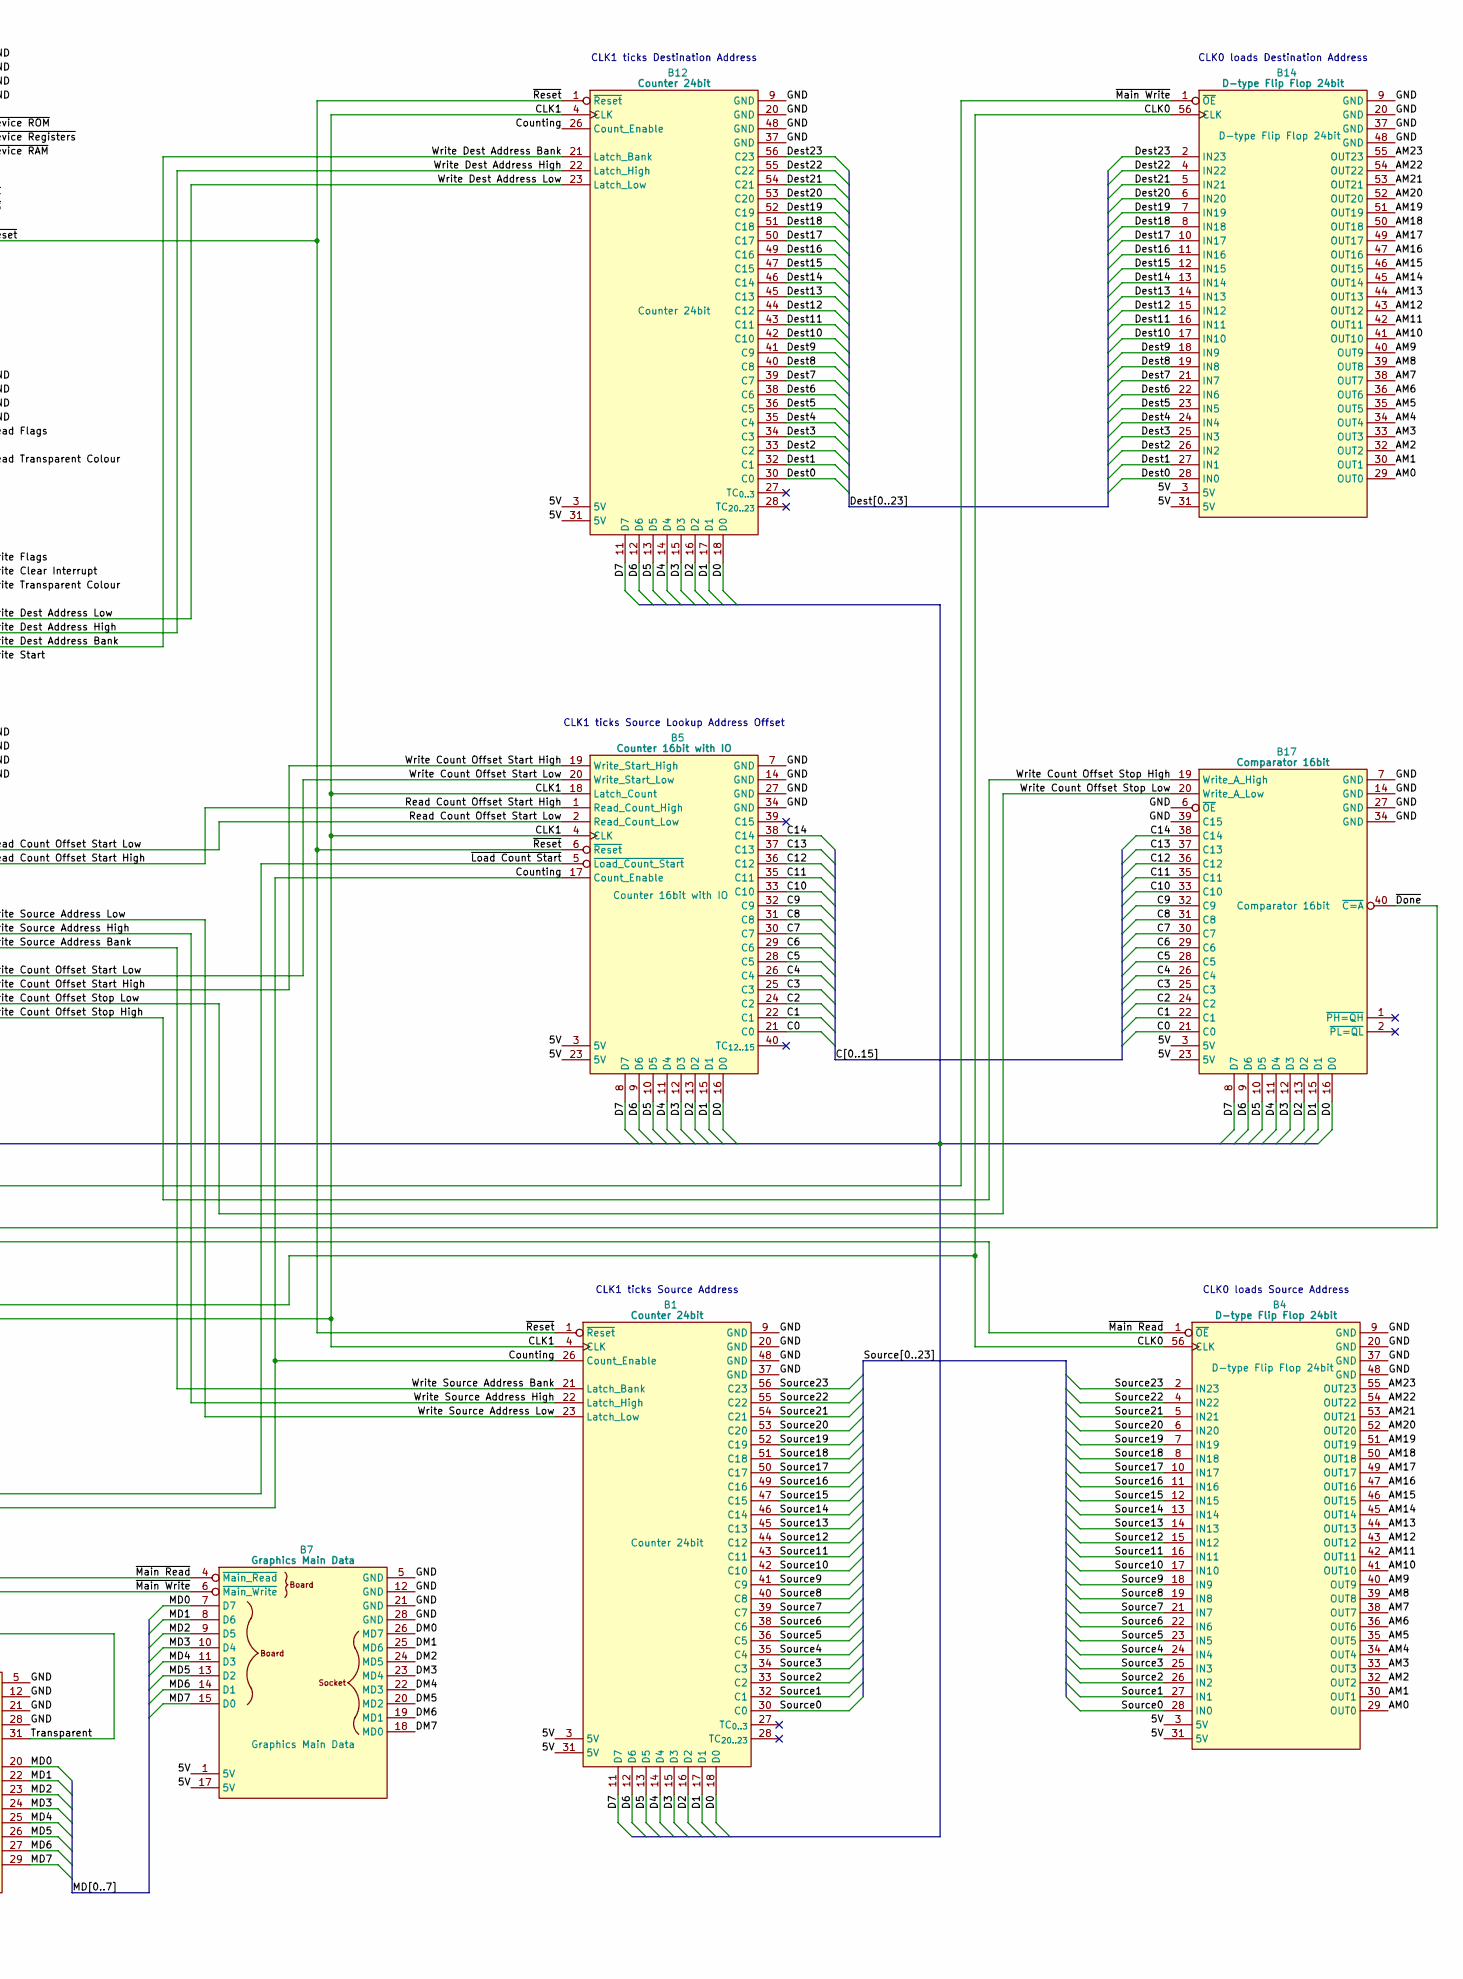
[picture p287: schematic Blitter Board.kicad_sch, part in row 1, column 2]

Parts:
B1, B12: Counter 24bit; HCP65_Counter_24bit
B2: Graphics Transparency; HCP65_Graphics_Transparency
B4, B14: D-type Flip Flop 24bit; HCP65_D_Flip_Flop_24bit
B5: Counter 16bit with IO; HCP65_Counter_16bit_DIO
B7: Graphics Main Data; HCP65_Graphics_Main_Data
B8: Flags & Interrupt; HCP65_Flags_Interrupt
B9, B15: Device Decode Stage B; HCP65_Device_Decode_Stage_B
B10: Clock Hold Standard; HCP65_Clock_Hold_Standard
B11: Device Decode Stage A; HCP65_Device_Decode_Stage_A
B16: Device Buffer; HCP65_Device_Buffer
B17: Comparator 16bit; HCP65_Comparator_16bit
B19: Graphics Signals; HCP65_Graphics_Signals
C1: 10μF; CP_Radial_D4.0mm_P2.00mm
C2: 100μF; CP_Radial_D4.0mm_P2.00mm
H1, H9: MountingHole_Pad; HCP65_MountingHole_M3_
IC1: LD1117S50C; LD1117S33C; Manufacturer_Part_Number LD1117S50C
IC2: SST39VF010-70-4I-NHE; 5408803224008; Manufacturer_Part_Number SST39VF010-70-4I-NHE
J5: 395-098-520-350; 98pin Edge Connector; Manufacturer_Part_Number 395-098-520-350; Mouser Part Number 587-395-098-520-350
LED1: LED; LED_D5.0mm
R3: 10KΩ; R_0805

Connections:
3.3V: B10.8 (H0_{REG}), B10.24 (3.3V), IC2.32 (3V)
5V: B1.3 (5V), B1.31 (5V), B2.1 (5V), B2.17 (5V), B4.3 (5V), B4.31 (5V), B5.3 (5V), B5.23 (5V), B7.1 (5V), B7.17 (5V), B8.1 (5V), B8.17 (5V), B9.1 (5V), B9.17 (5V), B10.1 (5V), B10.13 (5V), B11.1 (5V), B11.17 (5V), B12.3 (5V), B12.31 (5V), B14.3 (5V), B14.31 (5V), B15.1 (5V), B15.17 (5V), B16.3 (5V), B16.35 (5V), B17.3 (5V), B17.23 (5V), B19.1 (5V), B19.17 (5V), C2.1, IC1.2 (5.0VOut), R3.2
12V: C1.1, IC1.3 (15VIn), J5.B1
A0: B9.13 (A0), B15.13 (A0), B16.64 (A0), IC2.12 (A0)
A1: B9.11 (A1), B15.11 (A1), B16.63 (A1), IC2.11 (A1)
A2: B9.10 (A2), B15.10 (A2), B16.62 (A2), IC2.10 (A2)
A3: B11.13 (A3), B15.8 (~E2), B16.61 (A3), IC2.9 (A3)
A4: B11.11 (A4), B16.60 (A4), IC2.8 (A4)
A5: B16.59 (A5), IC2.7 (A5)
A6: B16.58 (A6), IC2.6 (A6)
A7: B16.57 (A7), IC2.5 (A7)
A8: B16.56 (A8), IC2.27 (A8)
A9: B16.54 (A9), IC2.26 (A9)
A10: B11.10 (A10), B16.53 (A10), IC2.23 (A10)
A11: B11.9 (A11), B16.52 (A11), IC2.25 (A11)
A12: B11.8 (A12), B16.51 (A12), IC2.4 (A12)
A13: B11.7 (A13), B16.50 (A13), IC2.28 (A13)
A14: B11.6 (A14), B16.49 (A14), IC2.29 (A14)
AD0: B16.1 (A0_{IN}), J5.A4
AD1: B16.2 (A1_{IN}), J5.A5
AD2: B16.4 (A2_{IN}), J5.A6
AD3: B16.5 (A3_{IN}), J5.A7
AD4: B16.6 (A4_{IN}), J5.A8
AD5: B16.7 (A5_{IN}), J5.A9
AD6: B16.8 (A6_{IN}), J5.A10
AD7: B16.9 (A7_{IN}), J5.A11
AD8: B16.11 (A8_{IN}), J5.A12
AD9: B16.12 (A9_{IN}), J5.A13
AD10: B16.13 (A10_{IN}), J5.A14
AD11: B16.14 (A11_{IN}), J5.A15
AD12: B16.15 (A12_{IN}), J5.A16
AD13: B16.16 (A13_{IN}), J5.A17
AD14: B16.17 (A14_{IN}), J5.A18
AD15: J5.A19
AD16: J5.A20
AM0: B4.29 (OUT0), B14.29 (OUT0), J5.D17
AM1: B4.30 (OUT1), B14.30 (OUT1), J5.D16
AM2: B4.32 (OUT2), B14.32 (OUT2), J5.D15
AM3: B4.33 (OUT3), B14.33 (OUT3), J5.D14
AM4: B4.34 (OUT4), B14.34 (OUT4), J5.D13
AM5: B4.35 (OUT5), B14.35 (OUT5), J5.D12
AM6: B4.36 (OUT6), B14.36 (OUT6), J5.C18
AM7: B4.38 (OUT7), B14.38 (OUT7), J5.C17
AM8: B4.39 (OUT8), B14.39 (OUT8), J5.C16
AM9: B4.40 (OUT9), B14.40 (OUT9), J5.C15
AM10: B4.41 (OUT10), B14.41 (OUT10), J5.C14
AM11: B4.42 (OUT11), B14.42 (OUT11), J5.C13
AM12: B4.43 (OUT12), B14.43 (OUT12), J5.C12
AM13: B4.44 (OUT13), B14.44 (OUT13), J5.C11
AM14: B4.45 (OUT14), B14.45 (OUT14), J5.C10
AM15: B4.46 (OUT15), B14.46 (OUT15), J5.C9
AM16: B4.47 (OUT16), B14.47 (OUT16), J5.C8
AM17: B4.49 (OUT17), B14.49 (OUT17), J5.C7
AM18: B4.50 (OUT18), B14.50 (OUT18), J5.C6
AM19: B4.51 (OUT19), B14.51 (OUT19), J5.C5
AM20: B4.52 (OUT20), B14.52 (OUT20), J5.C4
AM21: B4.53 (OUT21), B14.53 (OUT21), J5.C3
AM22: B4.54 (OUT22), B14.54 (OUT22), J5.C2
AM23: B4.55 (OUT23), B14.55 (OUT23), J5.C1
C0: B5.21 (C0), B17.21 (C0)
C1: B5.22 (C1), B17.22 (C1)
C2: B5.24 (C2), B17.24 (C2)
C3: B5.25 (C3), B17.25 (C3)
C4: B5.26 (C4), B17.26 (C4)
C5: B5.28 (C5), B17.28 (C5)
C6: B5.29 (C6), B17.29 (C6)
C7: B5.30 (C7), B17.30 (C7)
C8: B5.31 (C8), B17.31 (C8)
C9: B5.32 (C9), B17.32 (C9)
C10: B5.33 (C10), B17.33 (C10)
C11: B5.35 (C11), B17.35 (C11)
C12: B5.36 (C12), B17.36 (C12)
C13: B5.37 (C13), B17.37 (C13)
C14: B5.38 (C14), B17.38 (C14)
CLK0: B4.56 (CLK), B14.56 (CLK), B19.23 (CLK0)
CLK1: B1.4 (CLK), B5.4 (CLK), B5.18 (Latch_Count), B12.4 (CLK), B19.22 (CLK1)
Counting: B1.26 (Count_Enable), B5.17 (Count_Enable), B12.26 (Count_Enable), B19.24 (Counting)
D0: B1.18 (D0), B2.13 (D0), B5.16 (D0), B8.16 (D0), B12.18 (D0), B16.43 (D7), B17.16 (D0), IC2.13 (DQ0)
D1: B1.17 (D1), B2.11 (D1), B5.15 (D1), B8.15 (D1), B12.17 (D1), B16.41 (D6), B17.15 (D1), IC2.14 (DQ1)
D2: B1.16 (D2), B2.10 (D2), B5.13 (D2), B8.14 (D2), B12.16 (D2), B16.40 (D5), B17.13 (D2), IC2.15 (DQ2)
D3: B1.15 (D3), B2.9 (D3), B5.12 (D3), B8.13 (D3), B12.15 (D3), B16.39 (D4), B17.12 (D3), IC2.17 (DQ3)
D4: B1.14 (D4), B2.8 (D4), B5.11 (D4), B8.11 (D4), B12.14 (D4), B16.38 (D3), B17.11 (D4), IC2.18 (DQ4)
D5: B1.13 (D5), B2.7 (D5), B5.10 (D5), B8.10 (D5), B12.13 (D5), B16.37 (D2), B17.10 (D5), IC2.19 (DQ5)
D6: B1.12 (D6), B2.6 (D6), B5.9 (D6), B8.9 (D6), B12.12 (D6), B16.36 (D1), B17.9 (D6), IC2.20 (DQ6)
D7: B1.11 (D7), B2.4 (D7), B5.8 (D7), B8.8 (D7), B12.11 (D7), B16.34 (D0), B17.8 (D7), IC2.21 (DQ7)
DD0: B16.31 (D0_{IN/OUT}), J5.A28
DD1: B16.30 (D1_{IN/OUT}), J5.A27
DD2: B16.29 (D2_{IN/OUT}), J5.A26
DD3: B16.28 (D3_{IN/OUT}), J5.A25
DD4: B16.27 (D4_{IN/OUT}), J5.A24
DD5: B16.26 (D5_{IN/OUT}), J5.A23
DD6: B16.25 (D6_{IN/OUT}), J5.A22
DD7: B16.24 (D7_{IN/OUT}), J5.A21
DM0: B7.26 (MD7), J5.D8
DM1: B7.25 (MD6), J5.D7
DM2: B7.24 (MD5), J5.D6
DM3: B7.23 (MD4), J5.D5
DM4: B7.22 (MD3), J5.D4
DM5: B7.20 (MD2), J5.D3
DM6: B7.19 (MD1), J5.D2
DM7: B7.18 (MD0), J5.D1
Dest0: B12.30 (C0), B14.28 (IN0)
Dest1: B12.32 (C1), B14.27 (IN1)
Dest2: B12.33 (C2), B14.26 (IN2)
Dest3: B12.34 (C3), B14.25 (IN3)
Dest4: B12.35 (C4), B14.24 (IN4)
Dest5: B12.36 (C5), B14.23 (IN5)
Dest6: B12.38 (C6), B14.22 (IN6)
Dest7: B12.39 (C7), B14.21 (IN7)
Dest8: B12.40 (C8), B14.19 (IN8)
Dest9: B12.41 (C9), B14.18 (IN9)
Dest10: B12.42 (C10), B14.17 (IN10)
Dest11: B12.43 (C11), B14.16 (IN11)
Dest12: B12.44 (C12), B14.15 (IN12)
Dest13: B12.45 (C13), B14.14 (IN13)
Dest14: B12.46 (C14), B14.13 (IN14)
Dest15: B12.47 (C15), B14.12 (IN15)
Dest16: B12.49 (C16), B14.11 (IN16)
Dest17: B12.50 (C17), B14.10 (IN17)
Dest18: B12.51 (C18), B14.8 (IN18)
Dest19: B12.52 (C19), B14.7 (IN19)
Dest20: B12.53 (C20), B14.6 (IN20)
Dest21: B12.54 (C21), B14.5 (IN21)
Dest22: B12.55 (C22), B14.4 (IN22)
Dest23: B12.56 (C23), B14.2 (IN23)
Device CLK: J5.B15
D~RD: B16.20 (~RD_{IN}), J5.B13
D~WD: B16.21 (~WD_{IN}), J5.B14
GND: B1.9 (GND), B1.20 (GND), B1.37 (GND), B1.48 (GND), B2.5 (GND), B2.12 (GND), B2.21 (GND), B2.28 (GND), B4.9 (GND), B4.20 (GND), B4.37 (GND), B4.48 (GND), B5.7 (GND), B5.14 (GND), B5.27 (GND), B5.34 (GND), B7.5 (GND), B7.12 (GND), B7.21 (GND), B7.28 (GND), B8.5 (GND), B8.12 (GND), B8.21 (GND), B8.28 (GND), B9.5 (GND), B9.12 (GND), B9.21 (GND), B9.28 (GND), B10.4 (GND), B10.6 (H2_{REG}), B10.7 (H1_{REG}), B10.9 (GND), B10.16 (GND), B10.21 (GND), B11.3 (A16), B11.4 (A15), B11.5 (GND), B11.12 (GND), B11.21 (GND), B11.28 (GND), B12.9 (GND), B12.20 (GND), B12.37 (GND), B12.48 (GND), B14.9 (GND), B14.20 (GND), B14.37 (GND), B14.48 (GND), B15.5 (GND), B15.12 (GND), B15.21 (GND), B15.28 (GND), B16.10 (GND), B16.18 (A15_{IN}), B16.19 (A16_{IN}), B16.22 (S_{IN}), B16.23 (GND), B16.42 (GND), B16.55 (GND), B17.6 (~OE), B17.7 (GND), B17.14 (GND), B17.27 (GND), B17.34 (GND), B17.39 (C15), B19.5 (GND), B19.12 (GND), B19.21 (GND), B19.28 (GND), C1.2, C2.2, H1.1, H9.1, IC1.1 (GND), IC2.2 (A16), IC2.3 (A15), IC2.16 (GND), J5.B2, J5.B10, J5.B17, J5.B24, J5.B31, J5.D9, J5.D18, LED1.2 (A)
HD0: B10.17 (H0_{OUT}), J5.A31
HD1: B10.18 (H1_{OUT}), J5.A30
HD2: B10.19 (H2_{OUT}), J5.A29
MCLK: B8.2 (Interrupt_CLK), B19.32 (MCLK)
MD0: B2.20 (MD0), B7.7 (D7)
MD1: B2.22 (MD1), B7.8 (D6)
MD2: B2.23 (MD2), B7.9 (D5)
MD3: B2.24 (MD3), B7.10 (D4)
MD4: B2.25 (MD4), B7.11 (D3)
MD5: B2.26 (MD5), B7.13 (D2)
MD6: B2.27 (MC6), B7.14 (D1)
MD7: B2.29 (MD7), B7.15 (D0)
Main CLK: B19.2 (CLK_{M}), J5.B3
unnamed: LED1.1 (K), R3.1
Read Count Offset Start High: B5.1 (Read_Count_High), B9.6 (Y5_{R})
Read Count Offset Start Low: B5.2 (Read_Count_Low), B9.7 (Y4_{R})
Read Flags: B8.6 (Read_Flags), B15.32 (Y0_{R})
Read Transparent Colour: B2.15 (Read_Transparent_Colour), B15.30 (Y2_{R})
Source0: B1.30 (C0), B4.28 (IN0)
Source1: B1.32 (C1), B4.27 (IN1)
Source2: B1.33 (C2), B4.26 (IN2)
Source3: B1.34 (C3), B4.25 (IN3)
Source4: B1.35 (C4), B4.24 (IN4)
Source5: B1.36 (C5), B4.23 (IN5)
Source6: B1.38 (C6), B4.22 (IN6)
Source7: B1.39 (C7), B4.21 (IN7)
Source8: B1.40 (C8), B4.19 (IN8)
Source9: B1.41 (C9), B4.18 (IN9)
Source10: B1.42 (C10), B4.17 (IN10)
Source11: B1.43 (C11), B4.16 (IN11)
Source12: B1.44 (C12), B4.15 (IN12)
Source13: B1.45 (C13), B4.14 (IN13)
Source14: B1.46 (C14), B4.13 (IN14)
Source15: B1.47 (C15), B4.12 (IN15)
Source16: B1.49 (C16), B4.11 (IN16)
Source17: B1.50 (C17), B4.10 (IN17)
Source18: B1.51 (C18), B4.8 (IN18)
Source19: B1.52 (C19), B4.7 (IN19)
Source20: B1.53 (C20), B4.6 (IN20)
Source21: B1.54 (C21), B4.5 (IN21)
Source22: B1.55 (C22), B4.4 (IN22)
Source23: B1.56 (C23), B4.2 (IN23)
Transparency Enable: B2.16 (Transparency_Enable), B8.18 (F0)
Transparent: B2.31 (Transparent), B19.8 (Transparent)
Write Clear Interrupt: B8.3 (Write_Clear_Interrupt), B15.26 (Y1_{W})
Write Count Offset Start High: B5.19 (Write_Start_High), B9.22 (Y5_{W})
Write Count Offset Start Low: B5.20 (Write_Start_Low), B9.23 (Y4_{W})
Write Count Offset Stop High: B9.19 (Y7_{W}), B17.19 (Write_A_High)
Write Count Offset Stop Low: B9.20 (Y6_{W}), B17.20 (Write_A_Low)
Write Dest Address Bank: B12.21 (Latch_Bank), B15.20 (Y6_{W})
Write Dest Address High: B12.22 (Latch_High), B15.22 (Y5_{W})
Write Dest Address Low: B12.23 (Latch_Low), B15.23 (Y4_{W})
Write Flags: B8.7 (Write_Flags), B15.27 (Y0_{W})
Write Source Address Bank: B1.21 (Latch_Bank), B9.25 (Y2_{W})
Write Source Address High: B1.22 (Latch_High), B9.26 (Y1_{W})
Write Source Address Low: B1.23 (Latch_Low), B9.27 (Y0_{W})
Write Start: B15.19 (Y7_{W}), B19.3 (Write_Start)
Write Transparent Colour: B2.14 (Write_Transparent_Colour), B15.25 (Y2_{W})
~A3: B9.8 (~E2), B11.20 (~A3)
~A4: B9.9 (E3), B11.22 (~A4), B15.9 (E3)
~Device CLK: J5.B16
~Device Enable: B8.26 (~Enable), J5.B22
~Device Interrupt: B8.29 (~INT), J5.B19
~Device RAM: B10.2 (~Device_RAM), B11.23 (~Device_RAM)
~Device ROM: B10.5 (~Device_ROM), B11.25 (~Device_ROM), IC2.22 (~CE)
~Device Registers: B9.4 (~Device_Registers), B10.3 (~Device_Registers), B11.24 (~Device_Registers), B15.4 (~Device_Registers)
~Device Select: B10.11 (~Device_Select), B11.2 (~Device_Select), B16.33 (Deivce_~CS)
~Done: B8.4 (~Set_Interrupt_on_CLK), B17.40 (~C=A), B19.4 (~Done)
~Load Count Start: B5.5 (~Load_Count_Start), B19.29 (~Load_Count_Start)
~Main Access: B19.6 (~Main_Access), J5.B11
~Main RD: B19.18 (M~RD), J5.D10
~Main Read: B2.2 (~Main_Read), B4.1 (~OE), B7.4 (~Main_Read), B19.11 (~Main_Read)
~Main WD: B19.14 (M~WD), J5.D11
~Main Write: B7.6 (~Main_Write), B14.1 (~OE), B19.16 (~Main_Write)
~Main: B19.27 (~Main), J5.B9
~Memory A: J5.B29
~Memory B: J5.B30
~RD: B9.15 (~RD), B10.10 (~RD), B15.15 (~RD), B16.46 (~RD), IC2.24 (~OE)
~Reset Device: B11.15 (~Reset_{IN1}), J5.B20
~Reset System: B11.14 (~Reset_{IN2}), J5.A1
~Reset: B1.1 (~Reset), B5.6 (~Reset), B11.19 (~Reset_{OUT}), B12.1 (~Reset)
~Select Device: B16.32 (Deivce_~CS_{IN}), J5.B21
~WD: B9.16 (~WD), B10.12 (~WD), B15.16 (~WD), B16.45 (~WD), IC2.31 (~WE)
~Write: B2.3 (~Write), B19.15 (~Write)

Notes on the sheet:
CLK1 ticks Source Lookup Address Offset
CLK0 loads Destination Address
CLK1 ticks Destination Address
CLK1 ticks Source Address
CLK0 loads Source Address
