andrewpaterson/658-Computer/Kicad/Computer/Coprocessor/Coprocessor Board - Additional/Coprocessor Board - Additional.kicad_sch

## KiCad design Kicad/Computer/Coprocessor/Coprocessor Board - Additional/Coprocessor Board - Additional.kicad_sch (2026-01-28)

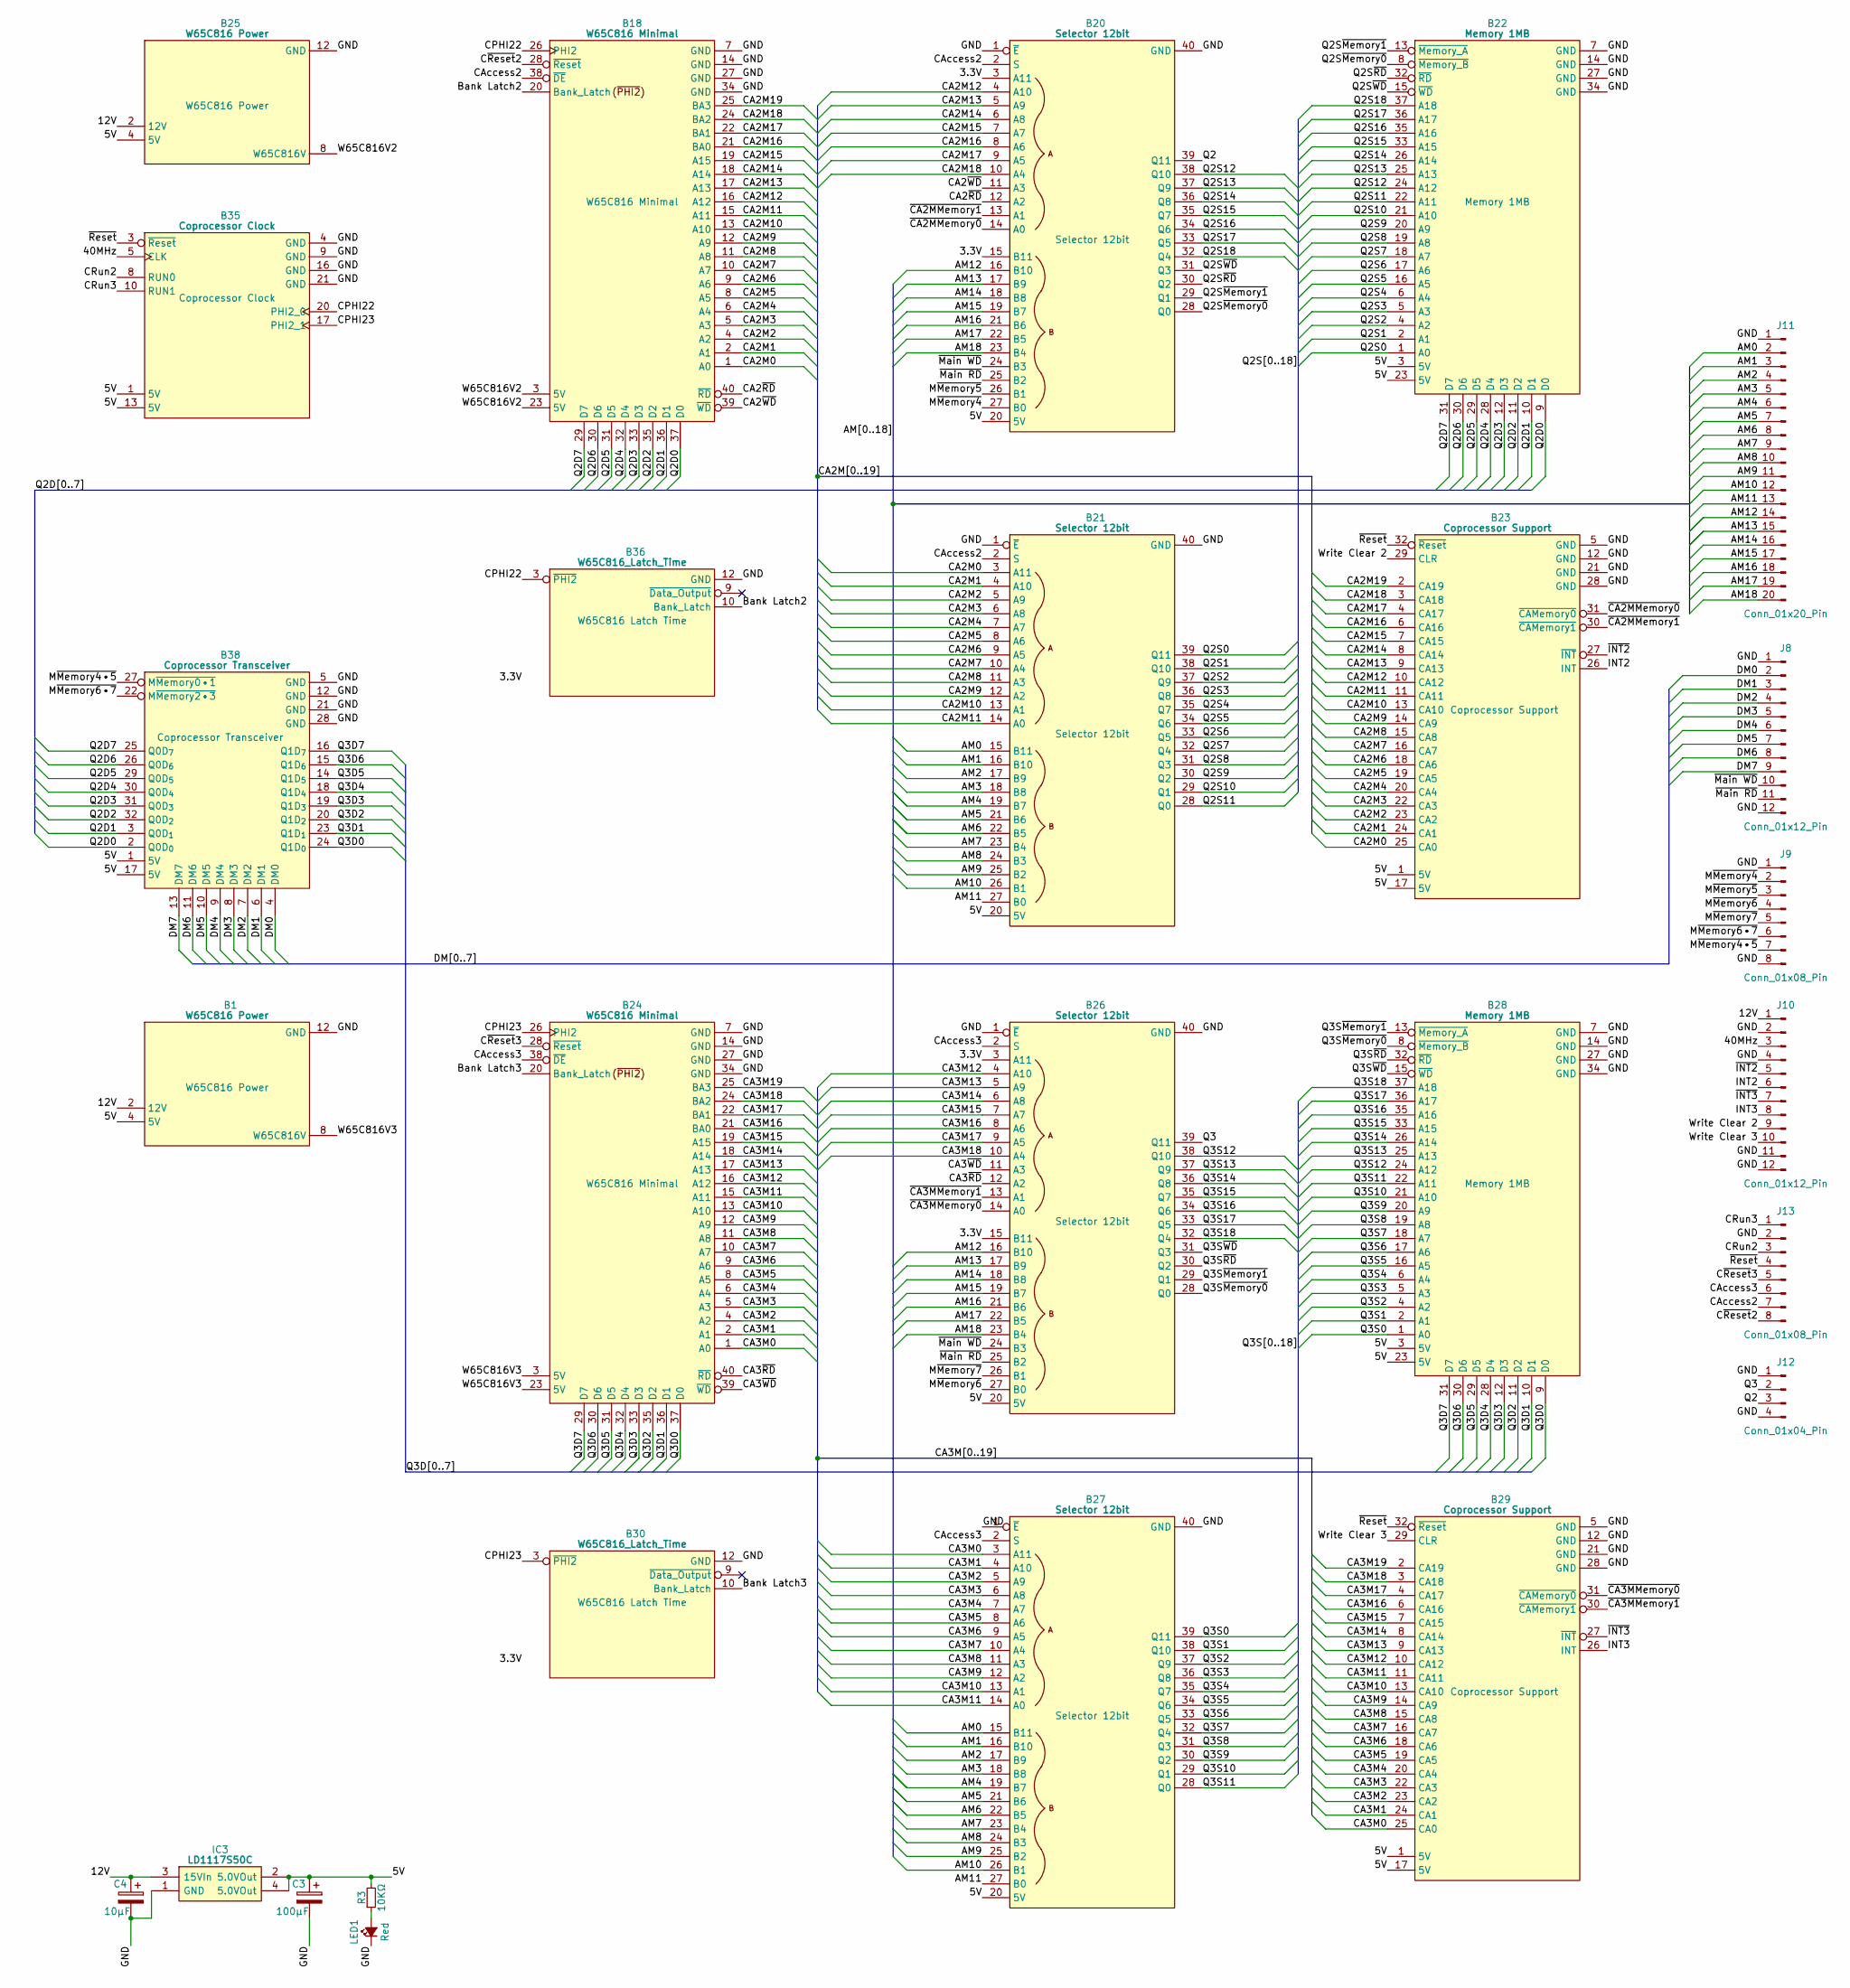
[picture p288: schematic Coprocessor Board - Additional.kicad_sch]

Parts:
B1, B25: W65C816 Power; HCP65_W65C816_Power
B18, B24: W65C816 Minimal; HCP65_W65C816_Minimal
B20, B21, B26, B27: Selector 12bit; HCP65_Selector_12bit
B22, B28: Memory 1MB; HCP65_Memory_1MB
B23, B29: Coprocessor Support; HCP65_Coprocessor_Support
B30, B36: W65C816_Latch_Time; HCP65_W65C816_Latch_Time
B35: Coprocessor Clock; HCP65_Coprocessor_Clock
B38: Coprocessor Transceiver; HCP65_Coprocessor_Transceiver
C3: 100μF; CP_Radial_D4.0mm_P2.00mm
C4: 10μF; CP_Radial_D4.0mm_P2.00mm
IC3: LD1117S50C; LD1117S33C; Manufacturer_Part_Number LD1117S50C
J8, J10: Conn_01x12_Pin; PinHeader_1x12_P2.54mm_Vertical
J9, J13: Conn_01x08_Pin; PinHeader_1x08_P2.54mm_Vertical
J11: Conn_01x20_Pin; PinHeader_1x20_P2.54mm_Vertical
J12: Conn_01x04_Pin; PinHeader_1x04_P2.54mm_Vertical
LED1: Red; LED_D5.0mm
R3: 10KΩ; R_0805

Connections:
3.3V: B20.3 (A11), B20.15 (B11), B26.3 (A11), B26.15 (B11), B30.6 (3.3V), B36.6 (3.3V)
5V: B1.4 (5V), B20.20 (5V), B21.20 (5V), B22.3 (5V), B22.23 (5V), B23.1 (5V), B23.17 (5V), B25.4 (5V), B26.20 (5V), B27.20 (5V), B28.3 (5V), B28.23 (5V), B29.1 (5V), B29.17 (5V), B35.1 (5V), B35.13 (5V), B38.1 (5V), B38.17 (5V), C3.1, IC3.2 (5.0VOut), IC3.4 (5.0VOut), R3.2
12V: B1.2 (12V), B25.2 (12V), C4.1, IC3.3 (15VIn), J10.1
40MHz: B35.5 (CLK), J10.3
AM0: B21.15 (B11), B27.15 (B11), J11.2
AM1: B21.16 (B10), B27.16 (B10), J11.3
AM2: B21.17 (B9), B27.17 (B9), J11.4
AM3: B21.18 (B8), B27.18 (B8), J11.5
AM4: B21.19 (B7), B27.19 (B7), J11.6
AM5: B21.21 (B6), B27.21 (B6), J11.7
AM6: B21.22 (B5), B27.22 (B5), J11.8
AM7: B21.23 (B4), B27.23 (B4), J11.9
AM8: B21.24 (B3), B27.24 (B3), J11.10
AM9: B21.25 (B2), B27.25 (B2), J11.11
AM10: B21.26 (B1), B27.26 (B1), J11.12
AM11: B21.27 (B0), B27.27 (B0), J11.13
AM12: B20.16 (B10), B26.16 (B10), J11.14
AM13: B20.17 (B9), B26.17 (B9), J11.15
AM14: B20.18 (B8), B26.18 (B8), J11.16
AM15: B20.19 (B7), B26.19 (B7), J11.17
AM16: B20.21 (B6), B26.21 (B6), J11.18
AM17: B20.22 (B5), B26.22 (B5), J11.19
AM18: B20.23 (B4), B26.23 (B4), J11.20
Bank Latch2: B18.20 (Bank_Latch), B36.10 (Bank_Latch)
Bank Latch3: B24.20 (Bank_Latch), B30.10 (Bank_Latch)
CA2M0: B18.1 (A0), B21.3 (A11), B23.25 (CA0)
CA2M1: B18.2 (A1), B21.4 (A10), B23.24 (CA1)
CA2M2: B18.4 (A2), B21.5 (A9), B23.23 (CA2)
CA2M3: B18.5 (A3), B21.6 (A8), B23.22 (CA3)
CA2M4: B18.6 (A4), B21.7 (A7), B23.20 (CA4)
CA2M5: B18.8 (A5), B21.8 (A6), B23.19 (CA5)
CA2M6: B18.9 (A6), B21.9 (A5), B23.18 (CA6)
CA2M7: B18.10 (A7), B21.10 (A4), B23.16 (CA7)
CA2M8: B18.11 (A8), B21.11 (A3), B23.15 (CA8)
CA2M9: B18.12 (A9), B21.12 (A2), B23.14 (CA9)
CA2M10: B18.13 (A10), B21.13 (A1), B23.13 (CA10)
CA2M11: B18.15 (A11), B21.14 (A0), B23.11 (CA11)
CA2M12: B18.16 (A12), B20.4 (A10), B23.10 (CA12)
CA2M13: B18.17 (A13), B20.5 (A9), B23.9 (CA13)
CA2M14: B18.18 (A14), B20.6 (A8), B23.8 (CA14)
CA2M15: B18.19 (A15), B20.7 (A7), B23.7 (CA15)
CA2M16: B18.21 (BA0), B20.8 (A6), B23.6 (CA16)
CA2M17: B18.22 (BA1), B20.9 (A5), B23.4 (CA17)
CA2M18: B18.24 (BA2), B20.10 (A4), B23.3 (CA18)
CA2M19: B18.25 (BA3), B23.2 (CA19)
CA2~RD: B18.40 (~RD), B20.12 (A2)
CA2~WD: B18.39 (~WD), B20.11 (A3)
CA3M0: B24.1 (A0), B27.3 (A11), B29.25 (CA0)
CA3M1: B24.2 (A1), B27.4 (A10), B29.24 (CA1)
CA3M2: B24.4 (A2), B27.5 (A9), B29.23 (CA2)
CA3M3: B24.5 (A3), B27.6 (A8), B29.22 (CA3)
CA3M4: B24.6 (A4), B27.7 (A7), B29.20 (CA4)
CA3M5: B24.8 (A5), B27.8 (A6), B29.19 (CA5)
CA3M6: B24.9 (A6), B27.9 (A5), B29.18 (CA6)
CA3M7: B24.10 (A7), B27.10 (A4), B29.16 (CA7)
CA3M8: B24.11 (A8), B27.11 (A3), B29.15 (CA8)
CA3M9: B24.12 (A9), B27.12 (A2), B29.14 (CA9)
CA3M10: B24.13 (A10), B27.13 (A1), B29.13 (CA10)
CA3M11: B24.15 (A11), B27.14 (A0), B29.11 (CA11)
CA3M12: B24.16 (A12), B26.4 (A10), B29.10 (CA12)
CA3M13: B24.17 (A13), B26.5 (A9), B29.9 (CA13)
CA3M14: B24.18 (A14), B26.6 (A8), B29.8 (CA14)
CA3M15: B24.19 (A15), B26.7 (A7), B29.7 (CA15)
CA3M16: B24.21 (BA0), B26.8 (A6), B29.6 (CA16)
CA3M17: B24.22 (BA1), B26.9 (A5), B29.4 (CA17)
CA3M18: B24.24 (BA2), B26.10 (A4), B29.3 (CA18)
CA3M19: B24.25 (BA3), B29.2 (CA19)
CA3~RD: B24.40 (~RD), B26.12 (A2)
CA3~WD: B24.39 (~WD), B26.11 (A3)
CAccess2: B18.38 (~DE), B20.2 (S), B21.2 (S), J13.7
CAccess3: B24.38 (~DE), B26.2 (S), B27.2 (S), J13.6
CPHI22: B18.26 (PHI2), B35.20 (PHI2_0), B36.3 (~PHI2)
CPHI23: B24.26 (PHI2), B30.3 (~PHI2), B35.17 (PHI2_1)
CRun2: B35.8 (RUN0), J13.3
CRun3: B35.10 (RUN1), J13.1
C~Reset2: B18.28 (~Reset), J13.8
C~Reset3: B24.28 (~Reset), J13.5
DM0: B38.4 (DM0), J8.2
DM1: B38.6 (DM1), J8.3
DM2: B38.7 (DM2), J8.4
DM3: B38.8 (DM3), J8.5
DM4: B38.9 (DM4), J8.6
DM5: B38.10 (DM5), J8.7
DM6: B38.11 (DM6), J8.8
DM7: B38.13 (DM7), J8.9
GND: B1.12 (GND), B18.7 (GND), B18.14 (GND), B18.27 (GND), B18.34 (GND), B20.1 (~E), B20.40 (GND), B21.1 (~E), B21.40 (GND), B22.7 (GND), B22.14 (GND), B22.27 (GND), B22.34 (GND), B23.5 (GND), B23.12 (GND), B23.21 (GND), B23.28 (GND), B24.7 (GND), B24.14 (GND), B24.27 (GND), B24.34 (GND), B25.12 (GND), B26.1 (~E), B26.40 (GND), B27.1 (~E), B27.40 (GND), B28.7 (GND), B28.14 (GND), B28.27 (GND), B28.34 (GND), B29.5 (GND), B29.12 (GND), B29.21 (GND), B29.28 (GND), B30.12 (GND), B35.4 (GND), B35.9 (GND), B35.16 (GND), B35.21 (GND), B36.12 (GND), B38.5 (GND), B38.12 (GND), B38.21 (GND), B38.28 (GND), C3.2, C4.2, IC3.1 (GND), J8.1, J8.12, J9.1, J9.8, J10.2, J10.4, J10.11, J10.12, J11.1, J12.1, J12.4, J13.2, LED1.1 (K)
INT2: B23.26 (INT), J10.6
INT3: B29.26 (INT), J10.8
M~Memory4: B20.27 (B0), J9.2
M~Memory4•5: B38.27 (M~Memory0•1), J9.7
M~Memory5: B20.26 (B1), J9.3
M~Memory6: B26.27 (B0), J9.4
M~Memory6•7: B38.22 (M~Memory2•3), J9.6
M~Memory7: B26.26 (B1), J9.5
unnamed: LED1.2 (A), R3.1
Q2: B20.39 (Q11), J12.3
Q2D0: B18.37 (D0), B22.9 (D0), B38.2 (Q0D_{0})
Q2D1: B18.36 (D1), B22.10 (D1), B38.3 (Q0D_{1})
Q2D2: B18.35 (D2), B22.11 (D2), B38.32 (Q0D_{2})
Q2D3: B18.33 (D3), B22.12 (D3), B38.31 (Q0D_{3})
Q2D4: B18.32 (D4), B22.28 (D4), B38.30 (Q0D_{4})
Q2D5: B18.31 (D5), B22.29 (D5), B38.29 (Q0D_{5})
Q2D6: B18.30 (D6), B22.30 (D6), B38.26 (Q0D_{6})
Q2D7: B18.29 (D7), B22.31 (D7), B38.25 (Q0D_{7})
Q2S0: B21.39 (Q11), B22.1 (A0)
Q2S1: B21.38 (Q10), B22.2 (A1)
Q2S2: B21.37 (Q9), B22.4 (A2)
Q2S3: B21.36 (Q8), B22.5 (A3)
Q2S4: B21.35 (Q7), B22.6 (A4)
Q2S5: B21.34 (Q6), B22.16 (A5)
Q2S6: B21.33 (Q5), B22.17 (A6)
Q2S7: B21.32 (Q4), B22.18 (A7)
Q2S8: B21.31 (Q3), B22.19 (A8)
Q2S9: B21.30 (Q2), B22.20 (A9)
Q2S10: B21.29 (Q1), B22.21 (A10)
Q2S11: B21.28 (Q0), B22.22 (A11)
Q2S12: B20.38 (Q10), B22.24 (A12)
Q2S13: B20.37 (Q9), B22.25 (A13)
Q2S14: B20.36 (Q8), B22.26 (A14)
Q2S15: B20.35 (Q7), B22.33 (A15)
Q2S16: B20.34 (Q6), B22.35 (A16)
Q2S17: B20.33 (Q5), B22.36 (A17)
Q2S18: B20.32 (Q4), B22.37 (A18)
Q2S~Memory0: B20.28 (Q0), B22.8 (~Memory_B)
Q2S~Memory1: B20.29 (Q1), B22.13 (~Memory_A)
Q2S~RD: B20.30 (Q2), B22.32 (~RD)
Q2S~WD: B20.31 (Q3), B22.15 (~WD)
Q3: B26.39 (Q11), J12.2
Q3D0: B24.37 (D0), B28.9 (D0), B38.24 (Q1D_{0})
Q3D1: B24.36 (D1), B28.10 (D1), B38.23 (Q1D_{1})
Q3D2: B24.35 (D2), B28.11 (D2), B38.20 (Q1D_{2})
Q3D3: B24.33 (D3), B28.12 (D3), B38.19 (Q1D_{3})
Q3D4: B24.32 (D4), B28.28 (D4), B38.18 (Q1D_{4})
Q3D5: B24.31 (D5), B28.29 (D5), B38.14 (Q1D_{5})
Q3D6: B24.30 (D6), B28.30 (D6), B38.15 (Q1D_{6})
Q3D7: B24.29 (D7), B28.31 (D7), B38.16 (Q1D_{7})
Q3S0: B27.39 (Q11), B28.1 (A0)
Q3S1: B27.38 (Q10), B28.2 (A1)
Q3S2: B27.37 (Q9), B28.4 (A2)
Q3S3: B27.36 (Q8), B28.5 (A3)
Q3S4: B27.35 (Q7), B28.6 (A4)
Q3S5: B27.34 (Q6), B28.16 (A5)
Q3S6: B27.33 (Q5), B28.17 (A6)
Q3S7: B27.32 (Q4), B28.18 (A7)
Q3S8: B27.31 (Q3), B28.19 (A8)
Q3S9: B27.30 (Q2), B28.20 (A9)
Q3S10: B27.29 (Q1), B28.21 (A10)
Q3S11: B27.28 (Q0), B28.22 (A11)
Q3S12: B26.38 (Q10), B28.24 (A12)
Q3S13: B26.37 (Q9), B28.25 (A13)
Q3S14: B26.36 (Q8), B28.26 (A14)
Q3S15: B26.35 (Q7), B28.33 (A15)
Q3S16: B26.34 (Q6), B28.35 (A16)
Q3S17: B26.33 (Q5), B28.36 (A17)
Q3S18: B26.32 (Q4), B28.37 (A18)
Q3S~Memory0: B26.28 (Q0), B28.8 (~Memory_B)
Q3S~Memory1: B26.29 (Q1), B28.13 (~Memory_A)
Q3S~RD: B26.30 (Q2), B28.32 (~RD)
Q3S~WD: B26.31 (Q3), B28.15 (~WD)
W65C816V2: B18.3 (5V), B18.23 (5V), B25.8 (W65C816V)
W65C816V3: B1.8 (W65C816V), B24.3 (5V), B24.23 (5V)
Write Clear 2: B23.29 (CLR), J10.9
Write Clear 3: B29.29 (CLR), J10.10
~CA2MMemory0: B20.14 (A0), B23.31 (~CAMemory0)
~CA2MMemory1: B20.13 (A1), B23.30 (~CAMemory1)
~CA3MMemory0: B26.14 (A0), B29.31 (~CAMemory0)
~CA3MMemory1: B26.13 (A1), B29.30 (~CAMemory1)
~INT2: B23.27 (~INT), J10.5
~INT3: B29.27 (~INT), J10.7
~Main RD: B20.25 (B2), B26.25 (B2), J8.11
~Main WD: B20.24 (B3), B26.24 (B3), J8.10
~Reset: B23.32 (~Reset), B29.32 (~Reset), B35.3 (~Reset), J13.4
