andrewpaterson/658-Computer/Kicad/Computer/Coprocessor/Coprocessor Board - Main/Coprocessor Board - Main.kicad_sch

## KiCad design Kicad/Computer/Coprocessor/Coprocessor Board - Main/Coprocessor Board - Main.kicad_sch (2026-03-03)

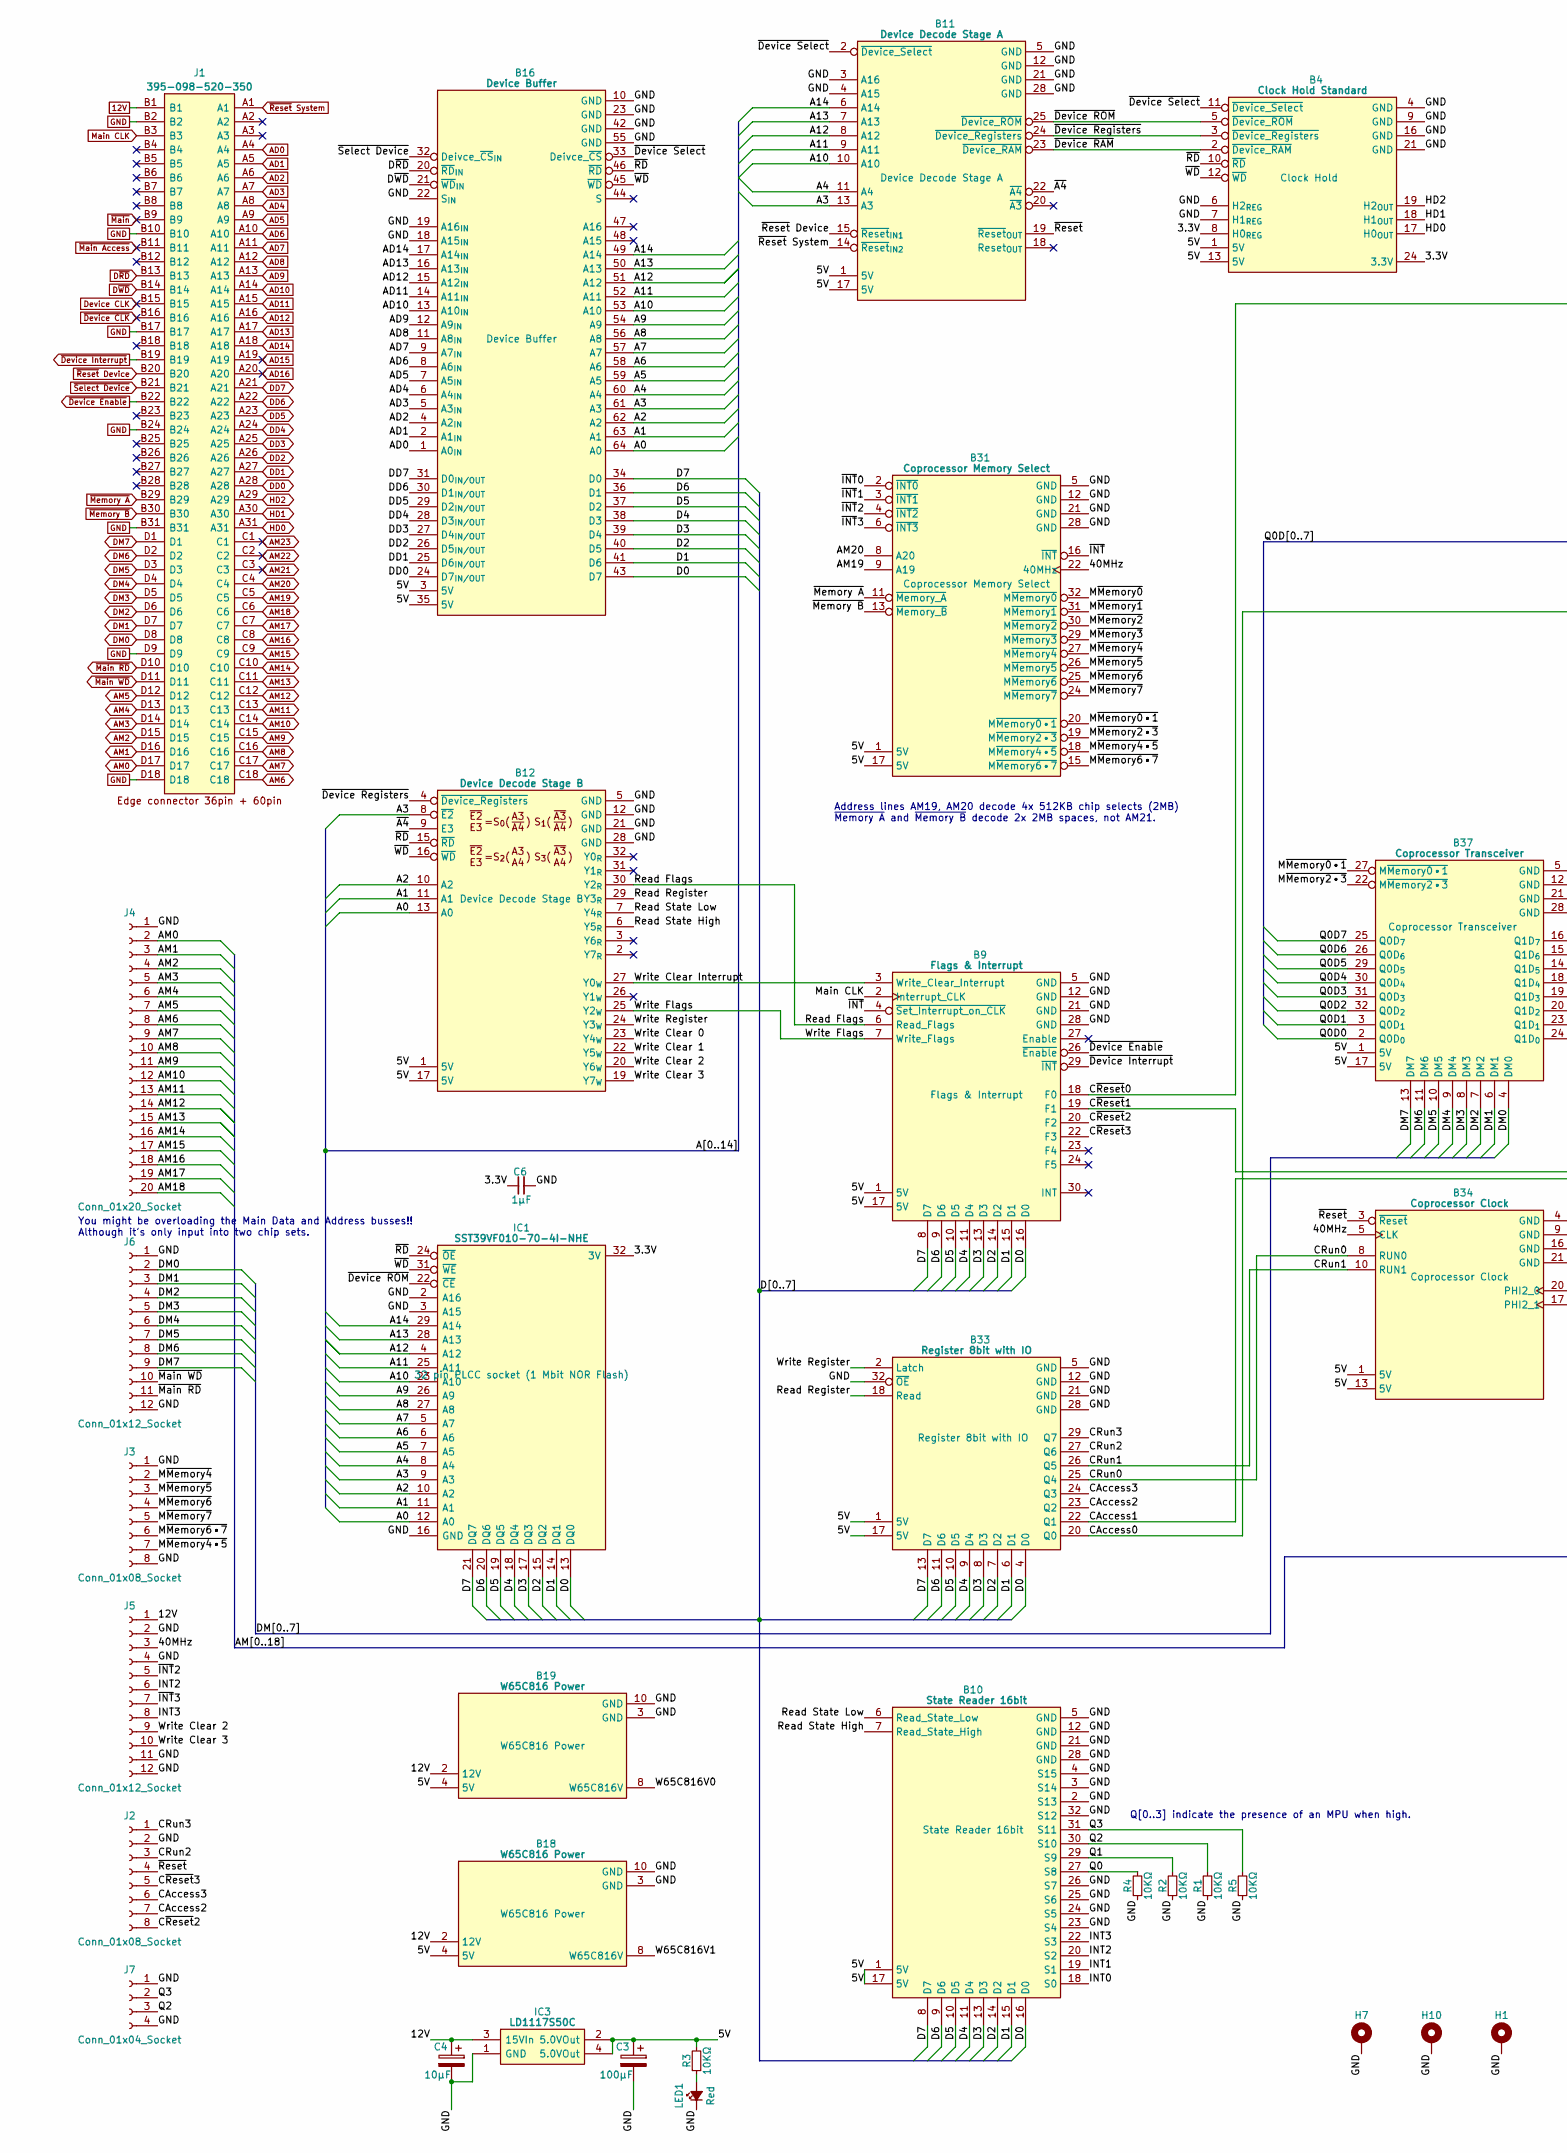
[picture p289: schematic Coprocessor Board - Main.kicad_sch, part in row 1, column 1]

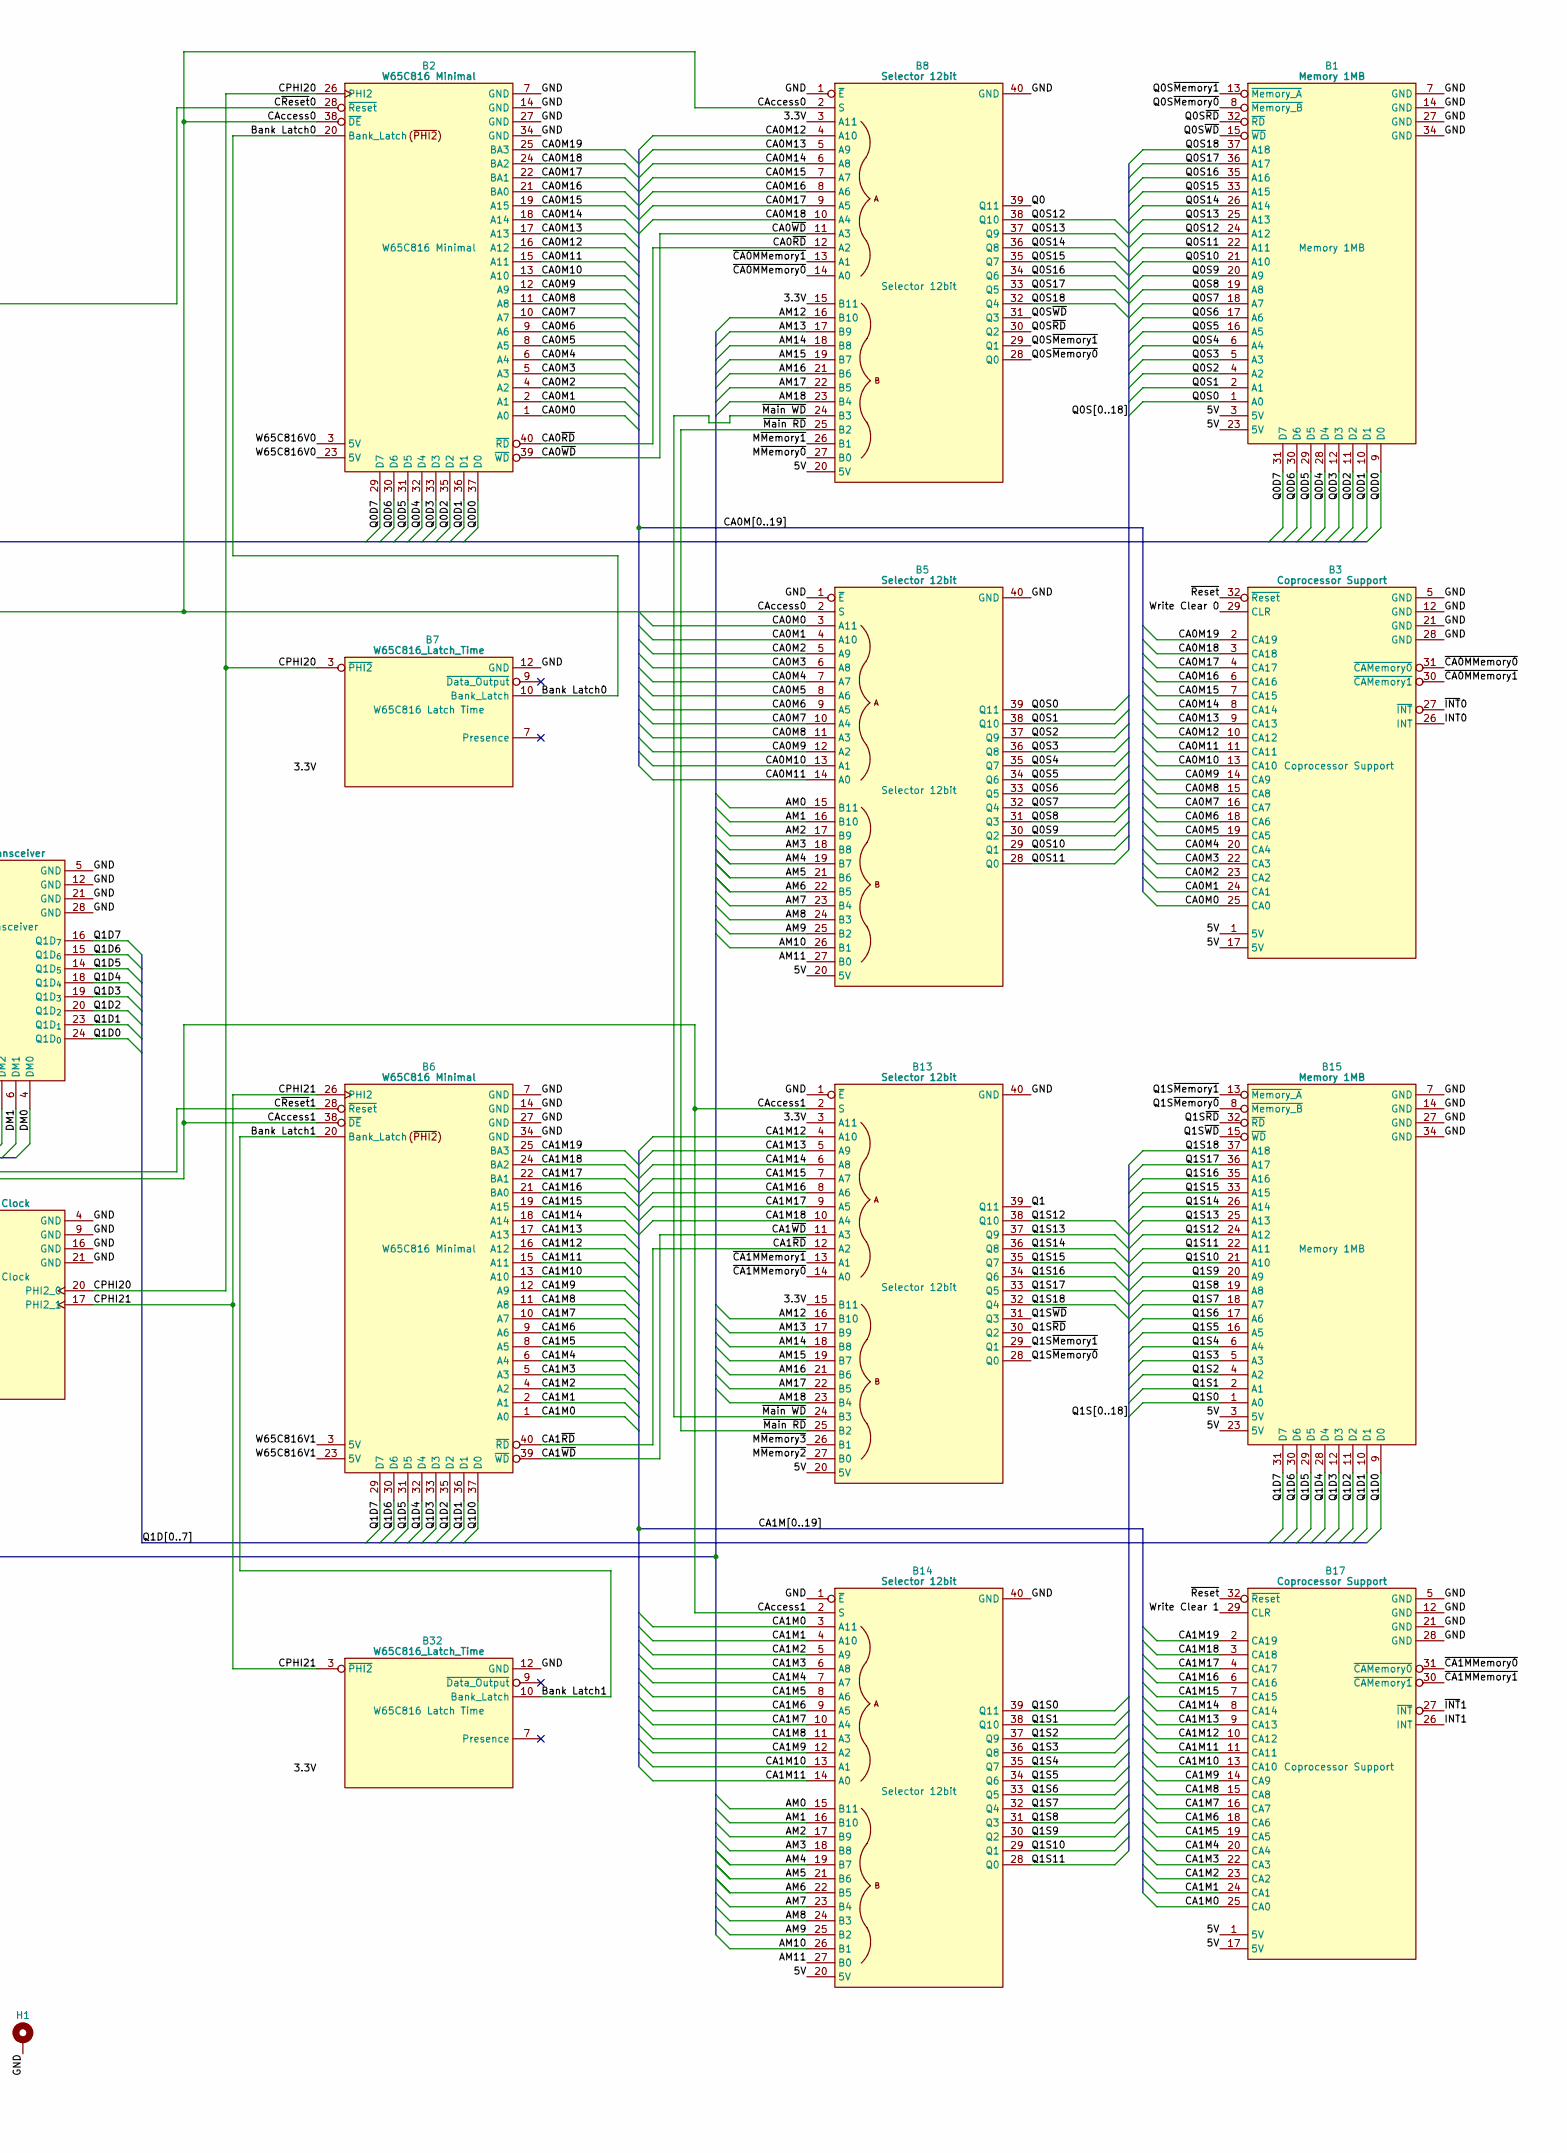
[picture p290: schematic Coprocessor Board - Main.kicad_sch, part in row 1, column 2]

Parts:
B1, B15: Memory 1MB; HCP65_Memory_1MB
B2, B6: W65C816 Minimal; HCP65_W65C816_Minimal
B3, B17: Coprocessor Support; HCP65_Coprocessor_Support
B4: Clock Hold Standard; HCP65_Clock_Hold_Standard
B5, B8, B13, B14: Selector 12bit; HCP65_Selector_12bit
B7, B32: W65C816_Latch_Time; HCP65_W65C816_Latch_Time
B9: Flags & Interrupt; HCP65_Flags_Interrupt
B10: State Reader 16bit; HCP65_State_Reader_16bit
B11: Device Decode Stage A; HCP65_Device_Decode_Stage_A
B12: Device Decode Stage B; HCP65_Device_Decode_Stage_B
B16: Device Buffer; HCP65_Device_Buffer
B18, B19: W65C816 Power; HCP65_W65C816_Power
B31: Coprocessor Memory Select; HCP65_Coprocessor_Memory_Select
B33: Register 8bit with IO; HCP65_Register_8bit_with_IO
B34: Coprocessor Clock; HCP65_Coprocessor_Clock
B37: Coprocessor Transceiver; HCP65_Coprocessor_Transceiver
C3: 100μF; CP_Radial_D4.0mm_P2.00mm
C4: 10μF; CP_Radial_D4.0mm_P2.00mm
C6: 1μF; C_0805
H1, H7, H10: MountingHole_Pad; HCP65_MountingHole_M3_
IC1: SST39VF010-70-4I-NHE; 5408803224008; Manufacturer_Part_Number SST39VF010-70-4I-NHE
IC3: LD1117S50C; LD1117S33C; Manufacturer_Part_Number LD1117S50C
J1: 395-098-520-350; 98pin Edge Connector; Manufacturer_Part_Number 395-098-520-350; Mouser Part Number 587-395-098-520-350
J2, J3: Conn_01x08_Socket; PinSocket_1x08_P2.54mm_Vertical
J4: Conn_01x20_Socket; PinSocket_1x20_P2.54mm_Vertical
J5, J6: Conn_01x12_Socket; PinSocket_1x12_P2.54mm_Vertical
J7: Conn_01x04_Socket; PinSocket_1x04_P2.54mm_Vertical
LED1: Red; LED_D5.0mm
R1, R2, R3, R4, R5: 10KΩ; R_0805

Connections:
3.3V: B4.8 (H0_{REG}), B4.24 (3.3V), B7.6 (3.3V), B8.3 (A11), B8.15 (B11), B13.3 (A11), B13.15 (B11), B32.6 (3.3V), C6.1, IC1.32 (3V)
5V: B1.3 (5V), B1.23 (5V), B3.1 (5V), B3.17 (5V), B4.1 (5V), B4.13 (5V), B5.20 (5V), B8.20 (5V), B9.1 (5V), B9.17 (5V), B10.1 (5V), B10.17 (5V), B11.1 (5V), B11.17 (5V), B12.1 (5V), B12.17 (5V), B13.20 (5V), B14.20 (5V), B15.3 (5V), B15.23 (5V), B16.3 (5V), B16.35 (5V), B17.1 (5V), B17.17 (5V), B18.4 (5V), B19.4 (5V), B31.1 (5V), B31.17 (5V), B33.1 (5V), B33.17 (5V), B34.1 (5V), B34.13 (5V), B37.1 (5V), B37.17 (5V), C3.1, IC3.2 (5.0VOut), IC3.4 (5.0VOut), R3.2
12V: B18.2 (12V), B19.2 (12V), C4.1, IC3.3 (15VIn), J1.B1, J5.1
40MHz: B31.22 (40MHz), B34.5 (CLK), J5.3
A0: B12.13 (A0), B16.64 (A0), IC1.12 (A0)
A1: B12.11 (A1), B16.63 (A1), IC1.11 (A1)
A2: B12.10 (A2), B16.62 (A2), IC1.10 (A2)
A3: B11.13 (A3), B12.8 (~E2), B16.61 (A3), IC1.9 (A3)
A4: B11.11 (A4), B16.60 (A4), IC1.8 (A4)
A5: B16.59 (A5), IC1.7 (A5)
A6: B16.58 (A6), IC1.6 (A6)
A7: B16.57 (A7), IC1.5 (A7)
A8: B16.56 (A8), IC1.27 (A8)
A9: B16.54 (A9), IC1.26 (A9)
A10: B11.10 (A10), B16.53 (A10), IC1.23 (A10)
A11: B11.9 (A11), B16.52 (A11), IC1.25 (A11)
A12: B11.8 (A12), B16.51 (A12), IC1.4 (A12)
A13: B11.7 (A13), B16.50 (A13), IC1.28 (A13)
A14: B11.6 (A14), B16.49 (A14), IC1.29 (A14)
AD0: B16.1 (A0_{IN}), J1.A4
AD1: B16.2 (A1_{IN}), J1.A5
AD2: B16.4 (A2_{IN}), J1.A6
AD3: B16.5 (A3_{IN}), J1.A7
AD4: B16.6 (A4_{IN}), J1.A8
AD5: B16.7 (A5_{IN}), J1.A9
AD6: B16.8 (A6_{IN}), J1.A10
AD7: B16.9 (A7_{IN}), J1.A11
AD8: B16.11 (A8_{IN}), J1.A12
AD9: B16.12 (A9_{IN}), J1.A13
AD10: B16.13 (A10_{IN}), J1.A14
AD11: B16.14 (A11_{IN}), J1.A15
AD12: B16.15 (A12_{IN}), J1.A16
AD13: B16.16 (A13_{IN}), J1.A17
AD14: B16.17 (A14_{IN}), J1.A18
AD15: J1.A19
AD16: J1.A20
AM0: B5.15 (B11), B14.15 (B11), J1.D17, J4.2
AM1: B5.16 (B10), B14.16 (B10), J1.D16, J4.3
AM2: B5.17 (B9), B14.17 (B9), J1.D15, J4.4
AM3: B5.18 (B8), B14.18 (B8), J1.D14, J4.5
AM4: B5.19 (B7), B14.19 (B7), J1.D13, J4.6
AM5: B5.21 (B6), B14.21 (B6), J1.D12, J4.7
AM6: B5.22 (B5), B14.22 (B5), J1.C18, J4.8
AM7: B5.23 (B4), B14.23 (B4), J1.C17, J4.9
AM8: B5.24 (B3), B14.24 (B3), J1.C16, J4.10
AM9: B5.25 (B2), B14.25 (B2), J1.C15, J4.11
AM10: B5.26 (B1), B14.26 (B1), J1.C14, J4.12
AM11: B5.27 (B0), B14.27 (B0), J1.C13, J4.13
AM12: B8.16 (B10), B13.16 (B10), J1.C12, J4.14
AM13: B8.17 (B9), B13.17 (B9), J1.C11, J4.15
AM14: B8.18 (B8), B13.18 (B8), J1.C10, J4.16
AM15: B8.19 (B7), B13.19 (B7), J1.C9, J4.17
AM16: B8.21 (B6), B13.21 (B6), J1.C8, J4.18
AM17: B8.22 (B5), B13.22 (B5), J1.C7, J4.19
AM18: B8.23 (B4), B13.23 (B4), J1.C6, J4.20
AM19: B31.9 (A19), J1.C5
AM20: B31.8 (A20), J1.C4
AM21: J1.C3
AM22: J1.C2
AM23: J1.C1
Bank Latch0: B2.20 (Bank_Latch), B7.10 (Bank_Latch)
Bank Latch1: B6.20 (Bank_Latch), B32.10 (Bank_Latch)
CA0M0: B2.1 (A0), B3.25 (CA0), B5.3 (A11)
CA0M1: B2.2 (A1), B3.24 (CA1), B5.4 (A10)
CA0M2: B2.4 (A2), B3.23 (CA2), B5.5 (A9)
CA0M3: B2.5 (A3), B3.22 (CA3), B5.6 (A8)
CA0M4: B2.6 (A4), B3.20 (CA4), B5.7 (A7)
CA0M5: B2.8 (A5), B3.19 (CA5), B5.8 (A6)
CA0M6: B2.9 (A6), B3.18 (CA6), B5.9 (A5)
CA0M7: B2.10 (A7), B3.16 (CA7), B5.10 (A4)
CA0M8: B2.11 (A8), B3.15 (CA8), B5.11 (A3)
CA0M9: B2.12 (A9), B3.14 (CA9), B5.12 (A2)
CA0M10: B2.13 (A10), B3.13 (CA10), B5.13 (A1)
CA0M11: B2.15 (A11), B3.11 (CA11), B5.14 (A0)
CA0M12: B2.16 (A12), B3.10 (CA12), B8.4 (A10)
CA0M13: B2.17 (A13), B3.9 (CA13), B8.5 (A9)
CA0M14: B2.18 (A14), B3.8 (CA14), B8.6 (A8)
CA0M15: B2.19 (A15), B3.7 (CA15), B8.7 (A7)
CA0M16: B2.21 (BA0), B3.6 (CA16), B8.8 (A6)
CA0M17: B2.22 (BA1), B3.4 (CA17), B8.9 (A5)
CA0M18: B2.24 (BA2), B3.3 (CA18), B8.10 (A4)
CA0M19: B2.25 (BA3), B3.2 (CA19)
CA0~RD: B2.40 (~RD), B8.12 (A2)
CA0~WD: B2.39 (~WD), B8.11 (A3)
CA1M0: B6.1 (A0), B14.3 (A11), B17.25 (CA0)
CA1M1: B6.2 (A1), B14.4 (A10), B17.24 (CA1)
CA1M2: B6.4 (A2), B14.5 (A9), B17.23 (CA2)
CA1M3: B6.5 (A3), B14.6 (A8), B17.22 (CA3)
CA1M4: B6.6 (A4), B14.7 (A7), B17.20 (CA4)
CA1M5: B6.8 (A5), B14.8 (A6), B17.19 (CA5)
CA1M6: B6.9 (A6), B14.9 (A5), B17.18 (CA6)
CA1M7: B6.10 (A7), B14.10 (A4), B17.16 (CA7)
CA1M8: B6.11 (A8), B14.11 (A3), B17.15 (CA8)
CA1M9: B6.12 (A9), B14.12 (A2), B17.14 (CA9)
CA1M10: B6.13 (A10), B14.13 (A1), B17.13 (CA10)
CA1M11: B6.15 (A11), B14.14 (A0), B17.11 (CA11)
CA1M12: B6.16 (A12), B13.4 (A10), B17.10 (CA12)
CA1M13: B6.17 (A13), B13.5 (A9), B17.9 (CA13)
CA1M14: B6.18 (A14), B13.6 (A8), B17.8 (CA14)
CA1M15: B6.19 (A15), B13.7 (A7), B17.7 (CA15)
CA1M16: B6.21 (BA0), B13.8 (A6), B17.6 (CA16)
CA1M17: B6.22 (BA1), B13.9 (A5), B17.4 (CA17)
CA1M18: B6.24 (BA2), B13.10 (A4), B17.3 (CA18)
CA1M19: B6.25 (BA3), B17.2 (CA19)
CA1~RD: B6.40 (~RD), B13.12 (A2)
CA1~WD: B6.39 (~WD), B13.11 (A3)
CAccess0: B2.38 (~DE), B5.2 (S), B8.2 (S), B33.20 (Q0)
CAccess1: B6.38 (~DE), B13.2 (S), B14.2 (S), B33.22 (Q1)
CAccess2: B33.23 (Q2), J2.7
CAccess3: B33.24 (Q3), J2.6
CPHI20: B2.26 (PHI2), B7.3 (~PHI2), B34.20 (PHI2_0)
CPHI21: B6.26 (PHI2), B32.3 (~PHI2), B34.17 (PHI2_1)
CRun0: B33.25 (Q4), B34.8 (RUN0)
CRun1: B33.26 (Q5), B34.10 (RUN1)
CRun2: B33.27 (Q6), J2.3
CRun3: B33.29 (Q7), J2.1
C~Reset0: B2.28 (~Reset), B9.18 (F0)
C~Reset1: B6.28 (~Reset), B9.19 (F1)
C~Reset2: B9.20 (F2), J2.8
C~Reset3: B9.22 (F3), J2.5
D0: B9.16 (D0), B10.16 (D0), B16.43 (D7), B33.4 (D0), IC1.13 (DQ0)
D1: B9.15 (D1), B10.15 (D1), B16.41 (D6), B33.6 (D1), IC1.14 (DQ1)
D2: B9.14 (D2), B10.14 (D2), B16.40 (D5), B33.7 (D2), IC1.15 (DQ2)
D3: B9.13 (D3), B10.13 (D3), B16.39 (D4), B33.8 (D3), IC1.17 (DQ3)
D4: B9.11 (D4), B10.11 (D4), B16.38 (D3), B33.9 (D4), IC1.18 (DQ4)
D5: B9.10 (D5), B10.10 (D5), B16.37 (D2), B33.10 (D5), IC1.19 (DQ5)
D6: B9.9 (D6), B10.9 (D6), B16.36 (D1), B33.11 (D6), IC1.20 (DQ6)
D7: B9.8 (D7), B10.8 (D7), B16.34 (D0), B33.13 (D7), IC1.21 (DQ7)
DD0: B16.24 (D7_{IN/OUT}), J1.A28
DD1: B16.25 (D6_{IN/OUT}), J1.A27
DD2: B16.26 (D5_{IN/OUT}), J1.A26
DD3: B16.27 (D4_{IN/OUT}), J1.A25
DD4: B16.28 (D3_{IN/OUT}), J1.A24
DD5: B16.29 (D2_{IN/OUT}), J1.A23
DD6: B16.30 (D1_{IN/OUT}), J1.A22
DD7: B16.31 (D0_{IN/OUT}), J1.A21
DM0: B37.4 (DM0), J1.D8, J6.2
DM1: B37.6 (DM1), J1.D7, J6.3
DM2: B37.7 (DM2), J1.D6, J6.4
DM3: B37.8 (DM3), J1.D5, J6.5
DM4: B37.9 (DM4), J1.D4, J6.6
DM5: B37.10 (DM5), J1.D3, J6.7
DM6: B37.11 (DM6), J1.D2, J6.8
DM7: B37.13 (DM7), J1.D1, J6.9
Device CLK: J1.B15
D~RD: B16.20 (~RD_{IN}), J1.B13
D~WD: B16.21 (~WD_{IN}), J1.B14
GND: B1.7 (GND), B1.14 (GND), B1.27 (GND), B1.34 (GND), B2.7 (GND), B2.14 (GND), B2.27 (GND), B2.34 (GND), B3.5 (GND), B3.12 (GND), B3.21 (GND), B3.28 (GND), B4.4 (GND), B4.6 (H2_{REG}), B4.7 (H1_{REG}), B4.9 (GND), B4.16 (GND), B4.21 (GND), B5.1 (~E), B5.40 (GND), B6.7 (GND), B6.14 (GND), B6.27 (GND), B6.34 (GND), B7.12 (GND), B8.1 (~E), B8.40 (GND), B9.5 (GND), B9.12 (GND), B9.21 (GND), B9.28 (GND), B10.2 (S13), B10.3 (S14), B10.4 (S15), B10.5 (GND), B10.12 (GND), B10.21 (GND), B10.23 (S4), B10.24 (S5), B10.25 (S6), B10.26 (S7), B10.28 (GND), B10.32 (S12), B11.3 (A16), B11.4 (A15), B11.5 (GND), B11.12 (GND), B11.21 (GND), B11.28 (GND), B12.5 (GND), B12.12 (GND), B12.21 (GND), B12.28 (GND), B13.1 (~E), B13.40 (GND), B14.1 (~E), B14.40 (GND), B15.7 (GND), B15.14 (GND), B15.27 (GND), B15.34 (GND), B16.10 (GND), B16.18 (A15_{IN}), B16.19 (A16_{IN}), B16.22 (S_{IN}), B16.23 (GND), B16.42 (GND), B16.55 (GND), B17.5 (GND), B17.12 (GND), B17.21 (GND), B17.28 (GND), B18.3 (GND), B18.10 (GND), B19.3 (GND), B19.10 (GND), B31.5 (GND), B31.12 (GND), B31.21 (GND), B31.28 (GND), B32.12 (GND), B33.5 (GND), B33.12 (GND), B33.21 (GND), B33.28 (GND), B33.32 (~OE), B34.4 (GND), B34.9 (GND), B34.16 (GND), B34.21 (GND), B37.5 (GND), B37.12 (GND), B37.21 (GND), B37.28 (GND), C3.2, C4.2, C6.2, H1.1, H7.1, H10.1, IC1.2 (A16), IC1.3 (A15), IC1.16 (GND), IC3.1 (GND), J1.B2, J1.B10, J1.B17, J1.B24, J1.B31, J1.D9, J1.D18, J2.2, J3.1, J3.8, J4.1, J5.2, J5.4, J5.11, J5.12, J6.1, J6.12, J7.1, J7.4, LED1.1 (K), R1.1, R2.1, R4.1, R5.1
HD0: B4.17 (H0_{OUT}), J1.A31
HD1: B4.18 (H1_{OUT}), J1.A30
HD2: B4.19 (H2_{OUT}), J1.A29
INT0: B3.26 (INT), B10.18 (S0)
INT1: B10.19 (S1), B17.26 (INT)
INT2: B10.20 (S2), J5.6
INT3: B10.22 (S3), J5.8
Main CLK: B9.2 (Interrupt_CLK), J1.B3
M~Memory0: B8.27 (B0), B31.32 (M~Memory0)
M~Memory0•1: B31.20 (M~Memory0•1), B37.27 (M~Memory0•1)
M~Memory1: B8.26 (B1), B31.31 (M~Memory1)
M~Memory2: B13.27 (B0), B31.30 (M~Memory2)
M~Memory2•3: B31.19 (M~Memory2•3), B37.22 (M~Memory2•3)
M~Memory3: B13.26 (B1), B31.29 (M~Memory3)
M~Memory4: B31.27 (M~Memory4), J3.2
M~Memory4•5: B31.18 (M~Memory4•5), J3.7
M~Memory5: B31.26 (M~Memory5), J3.3
M~Memory6: B31.25 (M~Memory6), J3.4
M~Memory6•7: B31.15 (M~Memory6•7), J3.6
M~Memory7: B31.24 (M~Memory7), J3.5
unnamed: LED1.2 (A), R3.1
Q0: B8.39 (Q11), B10.27 (S8), R4.2
Q0D0: B1.9 (D0), B2.37 (D0), B37.2 (Q0D_{0})
Q0D1: B1.10 (D1), B2.36 (D1), B37.3 (Q0D_{1})
Q0D2: B1.11 (D2), B2.35 (D2), B37.32 (Q0D_{2})
Q0D3: B1.12 (D3), B2.33 (D3), B37.31 (Q0D_{3})
Q0D4: B1.28 (D4), B2.32 (D4), B37.30 (Q0D_{4})
Q0D5: B1.29 (D5), B2.31 (D5), B37.29 (Q0D_{5})
Q0D6: B1.30 (D6), B2.30 (D6), B37.26 (Q0D_{6})
Q0D7: B1.31 (D7), B2.29 (D7), B37.25 (Q0D_{7})
Q0S0: B1.1 (A0), B5.39 (Q11)
Q0S1: B1.2 (A1), B5.38 (Q10)
Q0S2: B1.4 (A2), B5.37 (Q9)
Q0S3: B1.5 (A3), B5.36 (Q8)
Q0S4: B1.6 (A4), B5.35 (Q7)
Q0S5: B1.16 (A5), B5.34 (Q6)
Q0S6: B1.17 (A6), B5.33 (Q5)
Q0S7: B1.18 (A7), B5.32 (Q4)
Q0S8: B1.19 (A8), B5.31 (Q3)
Q0S9: B1.20 (A9), B5.30 (Q2)
Q0S10: B1.21 (A10), B5.29 (Q1)
Q0S11: B1.22 (A11), B5.28 (Q0)
Q0S12: B1.24 (A12), B8.38 (Q10)
Q0S13: B1.25 (A13), B8.37 (Q9)
Q0S14: B1.26 (A14), B8.36 (Q8)
Q0S15: B1.33 (A15), B8.35 (Q7)
Q0S16: B1.35 (A16), B8.34 (Q6)
Q0S17: B1.36 (A17), B8.33 (Q5)
Q0S18: B1.37 (A18), B8.32 (Q4)
Q0S~Memory0: B1.8 (~Memory_B), B8.28 (Q0)
Q0S~Memory1: B1.13 (~Memory_A), B8.29 (Q1)
Q0S~RD: B1.32 (~RD), B8.30 (Q2)
Q0S~WD: B1.15 (~WD), B8.31 (Q3)
Q1: B10.29 (S9), B13.39 (Q11), R2.2
Q1D0: B6.37 (D0), B15.9 (D0), B37.24 (Q1D_{0})
Q1D1: B6.36 (D1), B15.10 (D1), B37.23 (Q1D_{1})
Q1D2: B6.35 (D2), B15.11 (D2), B37.20 (Q1D_{2})
Q1D3: B6.33 (D3), B15.12 (D3), B37.19 (Q1D_{3})
Q1D4: B6.32 (D4), B15.28 (D4), B37.18 (Q1D_{4})
Q1D5: B6.31 (D5), B15.29 (D5), B37.14 (Q1D_{5})
Q1D6: B6.30 (D6), B15.30 (D6), B37.15 (Q1D_{6})
Q1D7: B6.29 (D7), B15.31 (D7), B37.16 (Q1D_{7})
Q1S0: B14.39 (Q11), B15.1 (A0)
Q1S1: B14.38 (Q10), B15.2 (A1)
Q1S2: B14.37 (Q9), B15.4 (A2)
Q1S3: B14.36 (Q8), B15.5 (A3)
Q1S4: B14.35 (Q7), B15.6 (A4)
Q1S5: B14.34 (Q6), B15.16 (A5)
Q1S6: B14.33 (Q5), B15.17 (A6)
Q1S7: B14.32 (Q4), B15.18 (A7)
Q1S8: B14.31 (Q3), B15.19 (A8)
Q1S9: B14.30 (Q2), B15.20 (A9)
Q1S10: B14.29 (Q1), B15.21 (A10)
Q1S11: B14.28 (Q0), B15.22 (A11)
Q1S12: B13.38 (Q10), B15.24 (A12)
Q1S13: B13.37 (Q9), B15.25 (A13)
Q1S14: B13.36 (Q8), B15.26 (A14)
Q1S15: B13.35 (Q7), B15.33 (A15)
Q1S16: B13.34 (Q6), B15.35 (A16)
Q1S17: B13.33 (Q5), B15.36 (A17)
Q1S18: B13.32 (Q4), B15.37 (A18)
Q1S~Memory0: B13.28 (Q0), B15.8 (~Memory_B)
Q1S~Memory1: B13.29 (Q1), B15.13 (~Memory_A)
Q1S~RD: B13.30 (Q2), B15.32 (~RD)
Q1S~WD: B13.31 (Q3), B15.15 (~WD)
Q2: B10.30 (S10), J7.3, R1.2
Q3: B10.31 (S11), J7.2, R5.2
Read Flags: B9.6 (Read_Flags), B12.30 (Y2_{R})
Read Register: B12.29 (Y3_{R}), B33.18 (Read)
Read State High: B10.7 (Read_State_High), B12.6 (Y5_{R})
Read State Low: B10.6 (Read_State_Low), B12.7 (Y4_{R})
W65C816V0: B2.3 (5V), B2.23 (5V), B19.8 (W65C816V)
W65C816V1: B6.3 (5V), B6.23 (5V), B18.8 (W65C816V)
Write Clear 0: B3.29 (CLR), B12.23 (Y4_{W})
Write Clear 1: B12.22 (Y5_{W}), B17.29 (CLR)
Write Clear 2: B12.20 (Y6_{W}), J5.9
Write Clear 3: B12.19 (Y7_{W}), J5.10
Write Clear Interrupt: B9.3 (Write_Clear_Interrupt), B12.27 (Y0_{W})
Write Flags: B9.7 (Write_Flags), B12.25 (Y2_{W})
Write Register: B12.24 (Y3_{W}), B33.2 (Latch)
~A4: B11.22 (~A4), B12.9 (E3)
~CA0MMemory0: B3.31 (~CAMemory0), B8.14 (A0)
~CA0MMemory1: B3.30 (~CAMemory1), B8.13 (A1)
~CA1MMemory0: B13.14 (A0), B17.31 (~CAMemory0)
~CA1MMemory1: B13.13 (A1), B17.30 (~CAMemory1)
~Device CLK: J1.B16
~Device Enable: B9.26 (~Enable), J1.B22
~Device Interrupt: B9.29 (~INT), J1.B19
~Device RAM: B4.2 (~Device_RAM), B11.23 (~Device_RAM)
~Device ROM: B4.5 (~Device_ROM), B11.25 (~Device_ROM), IC1.22 (~CE)
~Device Registers: B4.3 (~Device_Registers), B11.24 (~Device_Registers), B12.4 (~Device_Registers)
~Device Select: B4.11 (~Device_Select), B11.2 (~Device_Select), B16.33 (Deivce_~CS)
~INT: B9.4 (~Set_Interrupt_on_CLK), B31.16 (~INT)
~INT0: B3.27 (~INT), B31.2 (~INT0)
~INT1: B17.27 (~INT), B31.3 (~INT1)
~INT2: B31.4 (~INT2), J5.5
~INT3: B31.6 (~INT3), J5.7
~Main Access: J1.B11
~Main RD: B8.25 (B2), B13.25 (B2), J1.D10, J6.11
~Main WD: B8.24 (B3), B13.24 (B3), J1.D11, J6.10
~Main: J1.B9
~Memory A: B31.11 (~Memory_A), J1.B29
~Memory B: B31.13 (~Memory_B), J1.B30
~RD: B4.10 (~RD), B12.15 (~RD), B16.46 (~RD), IC1.24 (~OE)
~Reset: B3.32 (~Reset), B11.19 (~Reset_{OUT}), B17.32 (~Reset), B34.3 (~Reset), J2.4
~Reset Device: B11.15 (~Reset_{IN1}), J1.B20
~Reset System: B11.14 (~Reset_{IN2}), J1.A1
~Select Device: B16.32 (Deivce_~CS_{IN}), J1.B21
~WD: B4.12 (~WD), B12.16 (~WD), B16.45 (~WD), IC1.31 (~WE)

Notes on the sheet:
Q[0..3] indicate the presence of an MPU when high.
You might be overloading the Main Data and Address busses!! Although it's only input into two chip sets.
Address lines AM19, AM20 decode 4x 512KB chip selects (2MB) ~{Memory A} and ~{Memory B} decode 2x 2MB spaces, not AM21.
