andrewpaterson/658-Computer/Kicad/Computer/Coprocessor/Coprocessor Memory Select/Coprocessor Memory Select.kicad_sch

## KiCad design Kicad/Computer/Coprocessor/Coprocessor Memory Select/Coprocessor Memory Select.kicad_sch (2026-01-24)

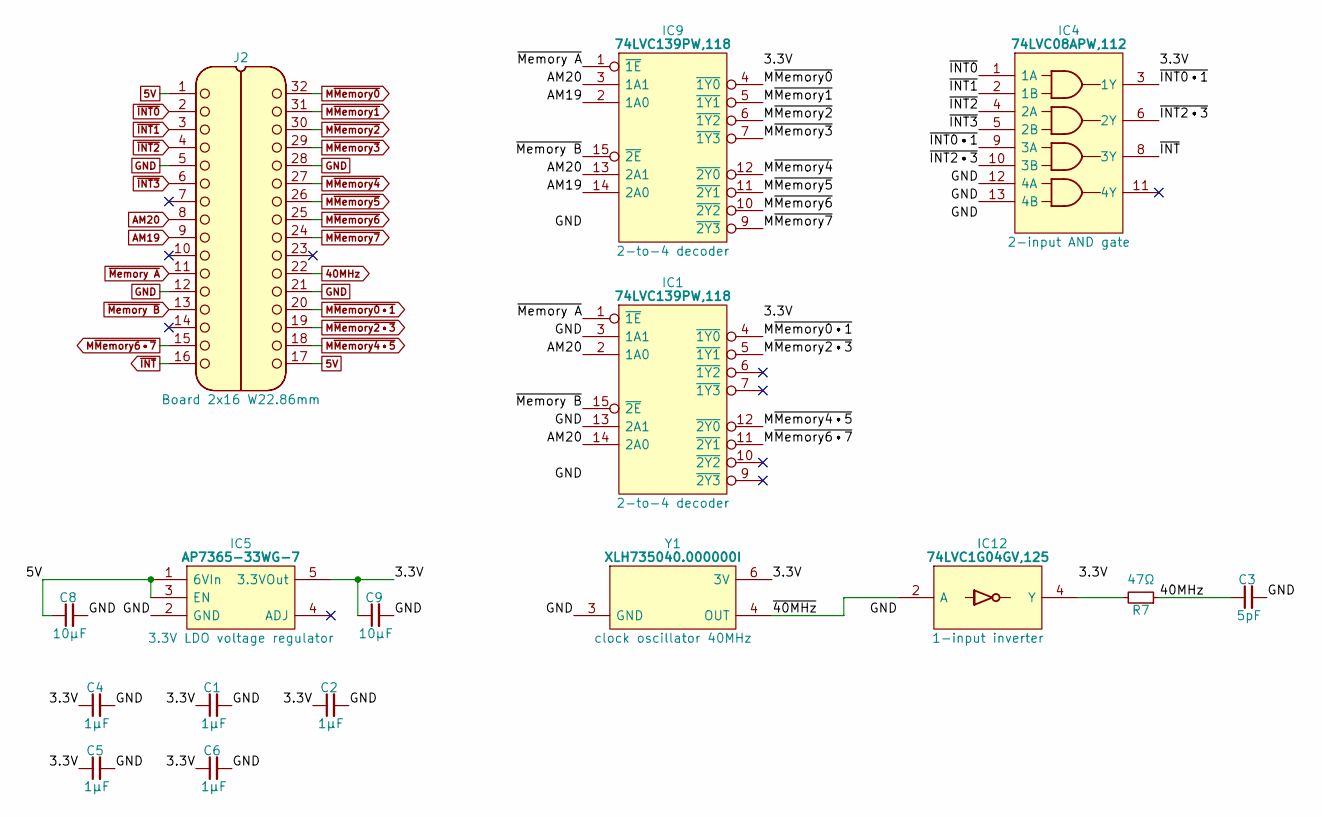
[picture p292: schematic Coprocessor Memory Select.kicad_sch]

Parts:
C1, C2, C4, C5, C6: 1μF; C_0805
C3: 5pF; C_0805
C8, C9: 10µF; C_0805
IC1, IC9: 74LVC139PW,118; SOP65P640X110-16N; Mouser Part Number 771-74LVC139PW-T
IC4: 74LVC08APW,112; SOP65P640X110-14N; Manufacturer_Part_Number 74LVC08APW,112; Mouser Part Number 771-74LVC08APW
IC5: AP7365-33WG-7; SOT95P285X130-5N; Manufacturer_Part_Number AP7365-33WG-7; Mouser Part Number 621-AP7365-33WG-7
IC12: 74LVC1G04GV,125; SOT95P275X110-5N; Manufacturer_Part_Number 74LVC1G04GV,125; Mouser Part Number 771-74LVC1G04GV
J2: Board 2x16 W22.86mm; DIP-32_Board_W22.86mm
R7: 47Ω; R_0805
Y1: XLH735040.000000I; XLH736074250000I; Manufacturer_Part_Number XLH735040.000000I; Mouser Part Number 972-LH735040.000000I

Connections:
3.3V: C1.1, C2.1, C4.1, C5.1, C6.1, C9.1, IC1.16 (3V), IC4.14 (3V), IC5.5 (3.3VOut), IC9.16 (3V), IC12.5 (3V), Y1.6 (3V)
5V: C8.1, IC5.1 (6VIn), IC5.3 (EN), J2.1, J2.17
40MHz: C3.1, J2.22, R7.1
AM19: IC9.2 (1A0), IC9.14 (2A0), J2.9
AM20: IC1.2 (1A0), IC1.14 (2A0), IC9.3 (1A1), IC9.13 (2A1), J2.8
GND: C1.2, C2.2, C3.2, C4.2, C5.2, C6.2, C8.2, C9.2, IC1.3 (1A1), IC1.8 (GND), IC1.13 (2A1), IC4.7 (GND), IC4.12 (4A), IC4.13 (4B), IC5.2 (GND), IC9.8 (GND), IC12.3 (GND), J2.5, J2.12, J2.21, J2.28, Y1.3 (GND)
M~Memory0: IC9.4 (~1Y0), J2.32
M~Memory0•1: IC1.4 (~1Y0), J2.20
M~Memory1: IC9.5 (~1Y1), J2.31
M~Memory2: IC9.6 (~1Y2), J2.30
M~Memory2•3: IC1.5 (~1Y1), J2.19
M~Memory3: IC9.7 (~1Y3), J2.29
M~Memory4: IC9.12 (~2Y0), J2.27
M~Memory4•5: IC1.12 (~2Y0), J2.18
M~Memory5: IC9.11 (~2Y1), J2.26
M~Memory6: IC9.10 (~2Y2), J2.25
M~Memory6•7: IC1.11 (~2Y1), J2.15
M~Memory7: IC9.9 (~2Y3), J2.24
unnamed: IC12.4 (Y), R7.2
~40MHz: IC12.2 (A), Y1.4 (OUT)
~INT0: IC4.1 (1A), J2.2
~INT0•1: IC4.3 (1Y), IC4.9 (3A)
~INT1: IC4.2 (1B), J2.3
~INT2: IC4.4 (2A), J2.4
~INT2•3: IC4.6 (2Y), IC4.10 (3B)
~INT3: IC4.5 (2B), J2.6
~INT: IC4.8 (3Y), J2.16
~Memory A: IC1.1 (~1E), IC9.1 (~1E), J2.11
~Memory B: IC1.15 (~2E), IC9.15 (~2E), J2.13
