andrewpaterson/658-Computer/Kicad/Computer/Coprocessor/Coprocessor Support/Coprocessor Support.kicad_sch

## KiCad design Kicad/Computer/Coprocessor/Coprocessor Support/Coprocessor Support.kicad_sch (2026-01-24)

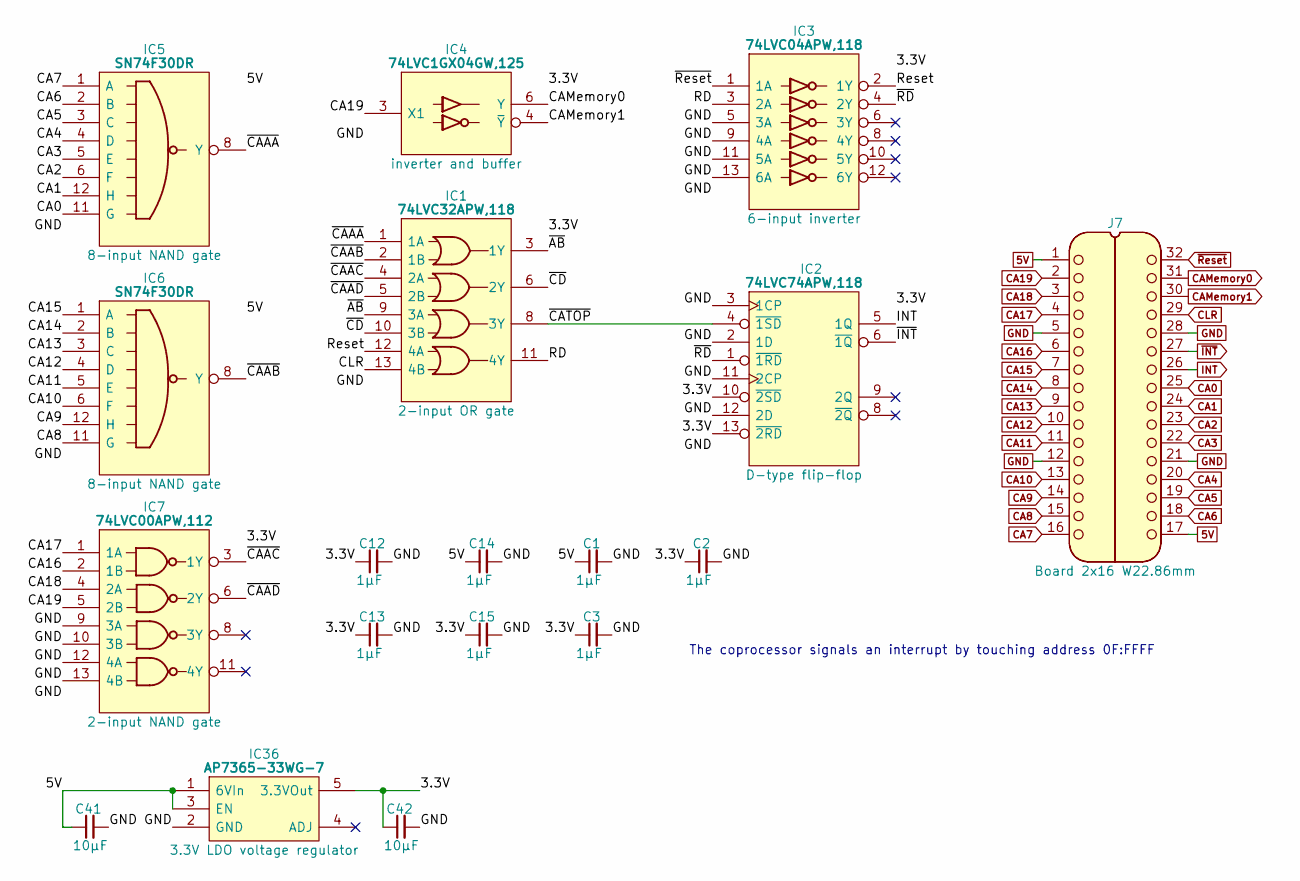
[picture p293: schematic Coprocessor Support.kicad_sch]

Parts:
C1, C2, C3, C12, C13, C14, C15: 1µF; C_0805
C41, C42: 10μF; C_0805
IC1: 74LVC32APW,118; SOP65P640X110-14N; Manufacturer_Part_Number 74LVC32APW,118; Mouser Part Number 771-74LVC32APW-T
IC2: 74LVC74APW,118; SOP65P640X110-14N; Mouser Part Number 771-74LVC74APW-T
IC3: 74LVC04APW,118; SOP65P640X110-14N; Manufacturer_Part_Number 74LVC04APW,118; Mouser Part Number 771-74LVC04APW-T
IC4: 74LVC1GX04GW,125; SOP65P210X110-6N; Manufacturer_Part_Number 74LVC1GX04GW,125; Mouser Part Number 771-74LVC1GX04GW-G
IC5, IC6: SN74F30DR; SOIC127P600X175-14N; Manufacturer_Part_Number SN74F30DR; Mouser Part Number 595-SN74F30DR
IC7: 74LVC00APW,112; SOP65P640X110-14N; Mouser Part Number 771-74LVC00APW
IC36: AP7365-33WG-7; SOT95P285X130-5N; Manufacturer_Part_Number AP7365-33WG-7; Mouser Part Number 621-AP7365-33WG-7
J7: Board 2x16 W22.86mm; DIP-32_Board_W22.86mm

Connections:
3.3V: C2.1, C3.1, C12.1, C13.1, C15.1, C42.1, IC1.14 (3V), IC2.10 (~2SD), IC2.13 (~2RD), IC2.14 (3V), IC3.14 (3V), IC4.5 (3V), IC7.14 (3V), IC36.5 (3.3VOut)
5V: C1.1, C14.1, C41.1, IC5.14 (5V), IC6.14 (5V), IC36.1 (6VIn), IC36.3 (EN), J7.1, J7.17
CA0: IC5.11 (G), J7.25
CA1: IC5.12 (H), J7.24
CA2: IC5.6 (F), J7.23
CA3: IC5.5 (E), J7.22
CA4: IC5.4 (D), J7.20
CA5: IC5.3 (C), J7.19
CA6: IC5.2 (B), J7.18
CA7: IC5.1 (A), J7.16
CA8: IC6.11 (G), J7.15
CA9: IC6.12 (H), J7.14
CA10: IC6.6 (F), J7.13
CA11: IC6.5 (E), J7.11
CA12: IC6.4 (D), J7.10
CA13: IC6.3 (C), J7.9
CA14: IC6.2 (B), J7.8
CA15: IC6.1 (A), J7.7
CA16: IC7.2 (1B), J7.6
CA17: IC7.1 (1A), J7.4
CA18: IC7.4 (2A), J7.3
CA19: IC4.3 (X1), IC7.5 (2B), J7.2
CAMemory0: IC4.6 (Y), J7.31
CAMemory1: IC4.4 (~Y), J7.30
CLR: IC1.13 (4B), J7.29
GND: C1.2, C2.2, C3.2, C12.2, C13.2, C14.2, C15.2, C41.2, C42.2, IC1.7 (GND), IC2.2 (1D), IC2.3 (1CP), IC2.7 (GND), IC2.11 (2CP), IC2.12 (2D), IC3.5 (3A), IC3.7 (GND), IC3.9 (4A), IC3.11 (5A), IC3.13 (6A), IC4.2 (GND), IC5.7 (GND), IC6.7 (GND), IC7.7 (GND), IC7.9 (3A), IC7.10 (3B), IC7.12 (4A), IC7.13 (4B), IC36.2 (GND), J7.5, J7.12, J7.21, J7.28
INT: IC2.5 (1Q), J7.26
RD: IC1.11 (4Y), IC3.3 (2A)
Reset: IC1.12 (4A), IC3.2 (1Y)
~AB: IC1.3 (1Y), IC1.9 (3A)
~CAAA: IC1.1 (1A), IC5.8 (Y)
~CAAB: IC1.2 (1B), IC6.8 (Y)
~CAAC: IC1.4 (2A), IC7.3 (1Y)
~CAAD: IC1.5 (2B), IC7.6 (2Y)
~CATOP: IC1.8 (3Y), IC2.4 (~1SD)
~CD: IC1.6 (2Y), IC1.10 (3B)
~INT: IC2.6 (~1Q), J7.27
~RD: IC2.1 (~1RD), IC3.4 (2Y)
~Reset: IC3.1 (1A), J7.32

Notes on the sheet:
The coprocessor signals an interrupt by touching address 0F:FFFF
