andrewpaterson/658-Computer/Kicad/Computer/LCD/LCD Board/LCD Board.kicad_sch

## KiCad design Kicad/Computer/LCD/LCD Board/LCD Board.kicad_sch (2025-10-10)

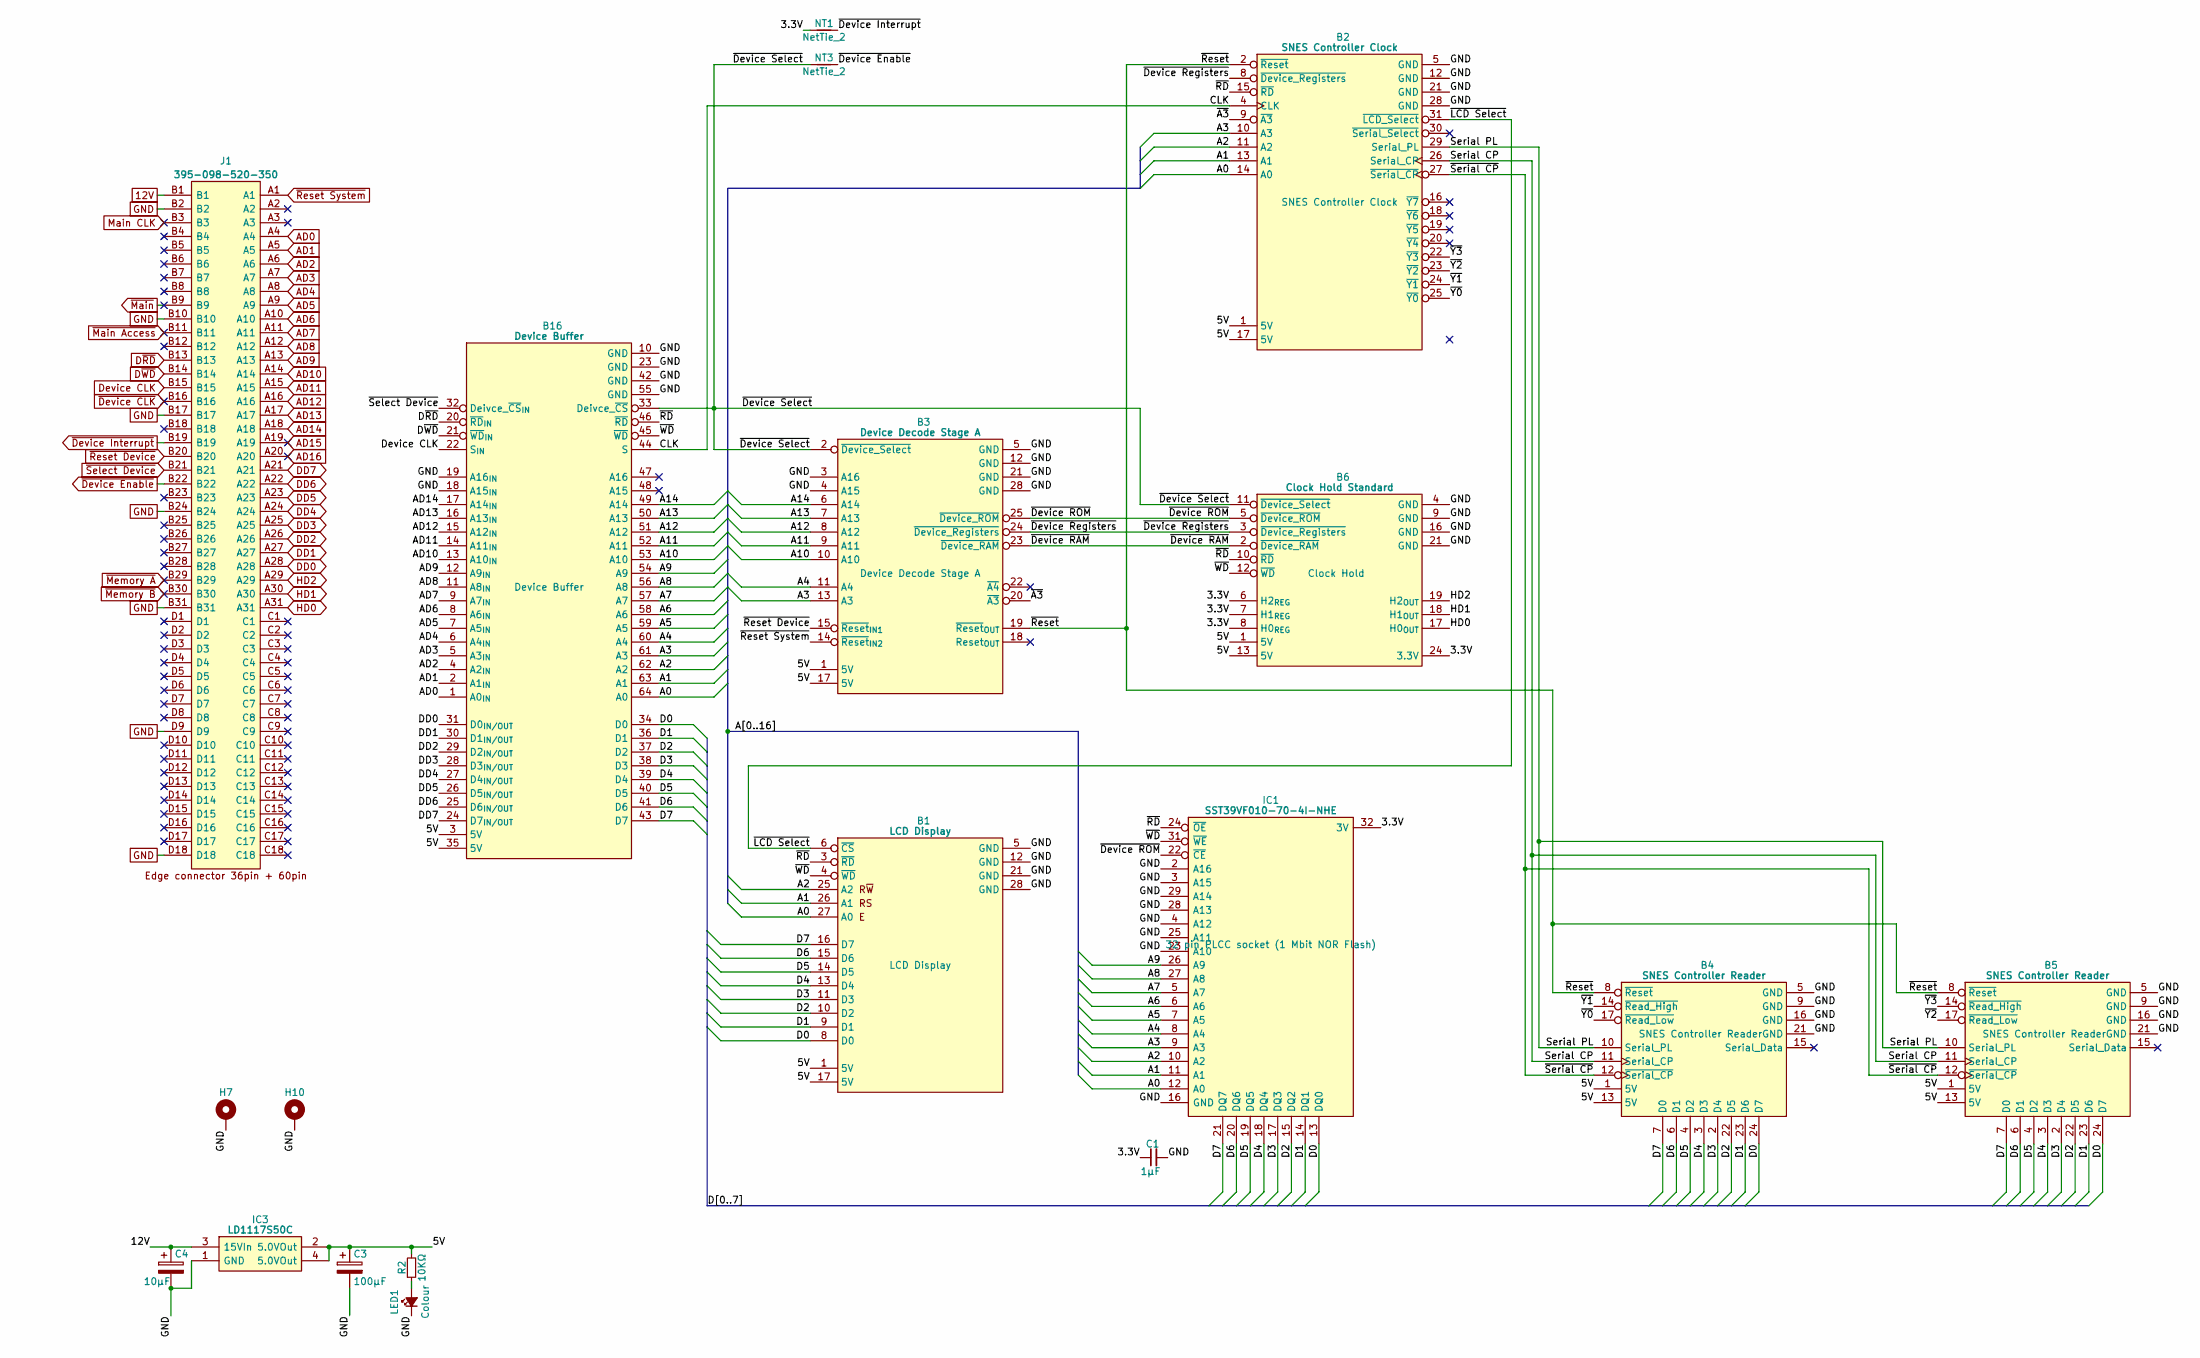
[picture p295: schematic LCD Board.kicad_sch]

Parts:
B1: LCD Display; HCP65_LCD_Display
B2: SNES Controller Clock; HCP65_SNES_Controller_Clock
B3: Device Decode Stage A; HCP65_Device_Decode_Stage_A
B4, B5: SNES Controller Reader; HCP65_SNES_Controller_Reader
B6: Clock Hold Standard; HCP65_Clock_Hold_Standard
B16: Device Buffer; HCP65_Device_Buffer
C1: 1µF; C_0805
C3: 100μF; CP_Radial_D4.0mm_P2.00mm
C4: 10μF; CP_Radial_D4.0mm_P2.00mm
H7, H10: MountingHole_Pad; HCP65_MountingHole_M3_
IC1: SST39VF010-70-4I-NHE; 5408803224008; Manufacturer_Part_Number SST39VF010-70-4I-NHE
IC3: LD1117S50C; LD1117S33C; Manufacturer_Part_Number LD1117S50C
J1: 395-098-520-350; 98pin Edge Connector; Manufacturer_Part_Number 395-098-520-350; Mouser Part Number 587-395-098-520-350
LED1: Colour; LED_D5.0mm
NT1, NT3: NetTie_2; NetTie-2_SMD_Pad0.5mm
R2: 10KΩ; R_0805

Connections:
3.3V: B6.6 (H2_{REG}), B6.7 (H1_{REG}), B6.8 (H0_{REG}), B6.24 (3.3V), C1.1, IC1.32 (3V), NT1.2
5V: B1.1 (5V), B1.17 (5V), B2.1 (5V), B2.17 (5V), B3.1 (5V), B3.17 (5V), B4.1 (5V), B4.13 (5V), B5.1 (5V), B5.13 (5V), B6.1 (5V), B6.13 (5V), B16.3 (5V), B16.35 (5V), C3.1, IC3.2 (5.0VOut), IC3.4 (5.0VOut), R2.2
12V: C4.1, IC3.3 (15VIn), J1.B1
A0: B1.27 (A0), B2.14 (A0), B16.64 (A0), IC1.12 (A0)
A1: B1.26 (A1), B2.13 (A1), B16.63 (A1), IC1.11 (A1)
A2: B1.25 (A2), B2.11 (A2), B16.62 (A2), IC1.10 (A2)
A3: B2.10 (A3), B3.13 (A3), B16.61 (A3), IC1.9 (A3)
A4: B3.11 (A4), B16.60 (A4), IC1.8 (A4)
A5: B16.59 (A5), IC1.7 (A5)
A6: B16.58 (A6), IC1.6 (A6)
A7: B16.57 (A7), IC1.5 (A7)
A8: B16.56 (A8), IC1.27 (A8)
A9: B16.54 (A9), IC1.26 (A9)
A10: B3.10 (A10), B16.53 (A10)
A11: B3.9 (A11), B16.52 (A11)
A12: B3.8 (A12), B16.51 (A12)
A13: B3.7 (A13), B16.50 (A13)
A14: B3.6 (A14), B16.49 (A14)
AD0: B16.1 (A0_{IN}), J1.A4
AD1: B16.2 (A1_{IN}), J1.A5
AD2: B16.4 (A2_{IN}), J1.A6
AD3: B16.5 (A3_{IN}), J1.A7
AD4: B16.6 (A4_{IN}), J1.A8
AD5: B16.7 (A5_{IN}), J1.A9
AD6: B16.8 (A6_{IN}), J1.A10
AD7: B16.9 (A7_{IN}), J1.A11
AD8: B16.11 (A8_{IN}), J1.A12
AD9: B16.12 (A9_{IN}), J1.A13
AD10: B16.13 (A10_{IN}), J1.A14
AD11: B16.14 (A11_{IN}), J1.A15
AD12: B16.15 (A12_{IN}), J1.A16
AD13: B16.16 (A13_{IN}), J1.A17
AD14: B16.17 (A14_{IN}), J1.A18
AD15: J1.A19
AD16: J1.A20
CLK: B2.4 (CLK), B16.44 (S)
D0: B1.8 (D0), B4.24 (D7), B5.24 (D7), B16.34 (D0), IC1.13 (DQ0)
D1: B1.9 (D1), B4.23 (D6), B5.23 (D6), B16.36 (D1), IC1.14 (DQ1)
D2: B1.10 (D2), B4.22 (D5), B5.22 (D5), B16.37 (D2), IC1.15 (DQ2)
D3: B1.11 (D3), B4.2 (D4), B5.2 (D4), B16.38 (D3), IC1.17 (DQ3)
D4: B1.13 (D4), B4.3 (D3), B5.3 (D3), B16.39 (D4), IC1.18 (DQ4)
D5: B1.14 (D5), B4.4 (D2), B5.4 (D2), B16.40 (D5), IC1.19 (DQ5)
D6: B1.15 (D6), B4.6 (D1), B5.6 (D1), B16.41 (D6), IC1.20 (DQ6)
D7: B1.16 (D7), B4.7 (D0), B5.7 (D0), B16.43 (D7), IC1.21 (DQ7)
DD0: B16.31 (D0_{IN/OUT}), J1.A28
DD1: B16.30 (D1_{IN/OUT}), J1.A27
DD2: B16.29 (D2_{IN/OUT}), J1.A26
DD3: B16.28 (D3_{IN/OUT}), J1.A25
DD4: B16.27 (D4_{IN/OUT}), J1.A24
DD5: B16.26 (D5_{IN/OUT}), J1.A23
DD6: B16.25 (D6_{IN/OUT}), J1.A22
DD7: B16.24 (D7_{IN/OUT}), J1.A21
Device CLK: B16.22 (S_{IN}), J1.B15
D~RD: B16.20 (~RD_{IN}), J1.B13
D~WD: B16.21 (~WD_{IN}), J1.B14
GND: B1.5 (GND), B1.12 (GND), B1.21 (GND), B1.28 (GND), B2.5 (GND), B2.12 (GND), B2.21 (GND), B2.28 (GND), B3.3 (A16), B3.4 (A15), B3.5 (GND), B3.12 (GND), B3.21 (GND), B3.28 (GND), B4.5 (GND), B4.9 (GND), B4.16 (GND), B4.21 (GND), B5.5 (GND), B5.9 (GND), B5.16 (GND), B5.21 (GND), B6.4 (GND), B6.9 (GND), B6.16 (GND), B6.21 (GND), B16.10 (GND), B16.18 (A15_{IN}), B16.19 (A16_{IN}), B16.23 (GND), B16.42 (GND), B16.55 (GND), C1.2, C3.2, C4.2, H7.1, H10.1, IC1.2 (A16), IC1.3 (A15), IC1.4 (A12), IC1.16 (GND), IC1.23 (A10), IC1.25 (A11), IC1.28 (A13), IC1.29 (A14), IC3.1 (GND), J1.B2, J1.B10, J1.B17, J1.B24, J1.B31, J1.D9, J1.D18, LED1.1 (K)
HD0: B6.17 (H0_{OUT}), J1.A31
HD1: B6.18 (H1_{OUT}), J1.A30
HD2: B6.19 (H2_{OUT}), J1.A29
Main CLK: J1.B3
unnamed: LED1.2 (A), R2.1
Serial CP: B2.26 (Serial_CP), B4.11 (Serial_CP), B5.11 (Serial_CP)
Serial PL: B2.29 (Serial_PL), B4.10 (Serial_PL), B5.10 (Serial_PL)
~A3: B2.9 (~A3), B3.20 (~A3)
~Device CLK: J1.B16
~Device Enable: J1.B22, NT3.1
~Device Interrupt: J1.B19, NT1.1
~Device RAM: B3.23 (~Device_RAM), B6.2 (~Device_RAM)
~Device ROM: B3.25 (~Device_ROM), B6.5 (~Device_ROM), IC1.22 (~CE)
~Device Registers: B2.8 (~Device_Registers), B3.24 (~Device_Registers), B6.3 (~Device_Registers)
~Device Select: B3.2 (~Device_Select), B6.11 (~Device_Select), B16.33 (Deivce_~CS), NT3.2
~LCD Select: B1.6 (~CS), B2.31 (~LCD_Select)
~Main Access: J1.B11
~Main: J1.B9
~Memory A: J1.B29
~Memory B: J1.B30
~RD: B1.3 (~RD), B2.15 (~RD), B6.10 (~RD), B16.46 (~RD), IC1.24 (~OE)
~Reset Device: B3.15 (~Reset_{IN1}), J1.B20
~Reset System: B3.14 (~Reset_{IN2}), J1.A1
~Reset: B2.2 (~Reset), B3.19 (~Reset_{OUT}), B4.8 (~Reset), B5.8 (~Reset)
~Select Device: B16.32 (Deivce_~CS_{IN}), J1.B21
~Serial CP: B2.27 (~Serial_CP), B4.12 (~Serial_CP), B5.12 (~Serial_CP)
~WD: B1.4 (~WD), B6.12 (~WD), B16.45 (~WD), IC1.31 (~WE)
~Y0: B2.25 (~Y0), B4.17 (~Read_Low)
~Y1: B2.24 (~Y1), B4.14 (~Read_High)
~Y2: B2.23 (~Y2), B5.17 (~Read_Low)
~Y3: B2.22 (~Y3), B5.14 (~Read_High)
