andrewpaterson/658-Computer/Kicad/Computer/LCD/LCD Display/LCD Display.kicad_sch

## KiCad design Kicad/Computer/LCD/LCD Display/LCD Display.kicad_sch (2026-01-13)

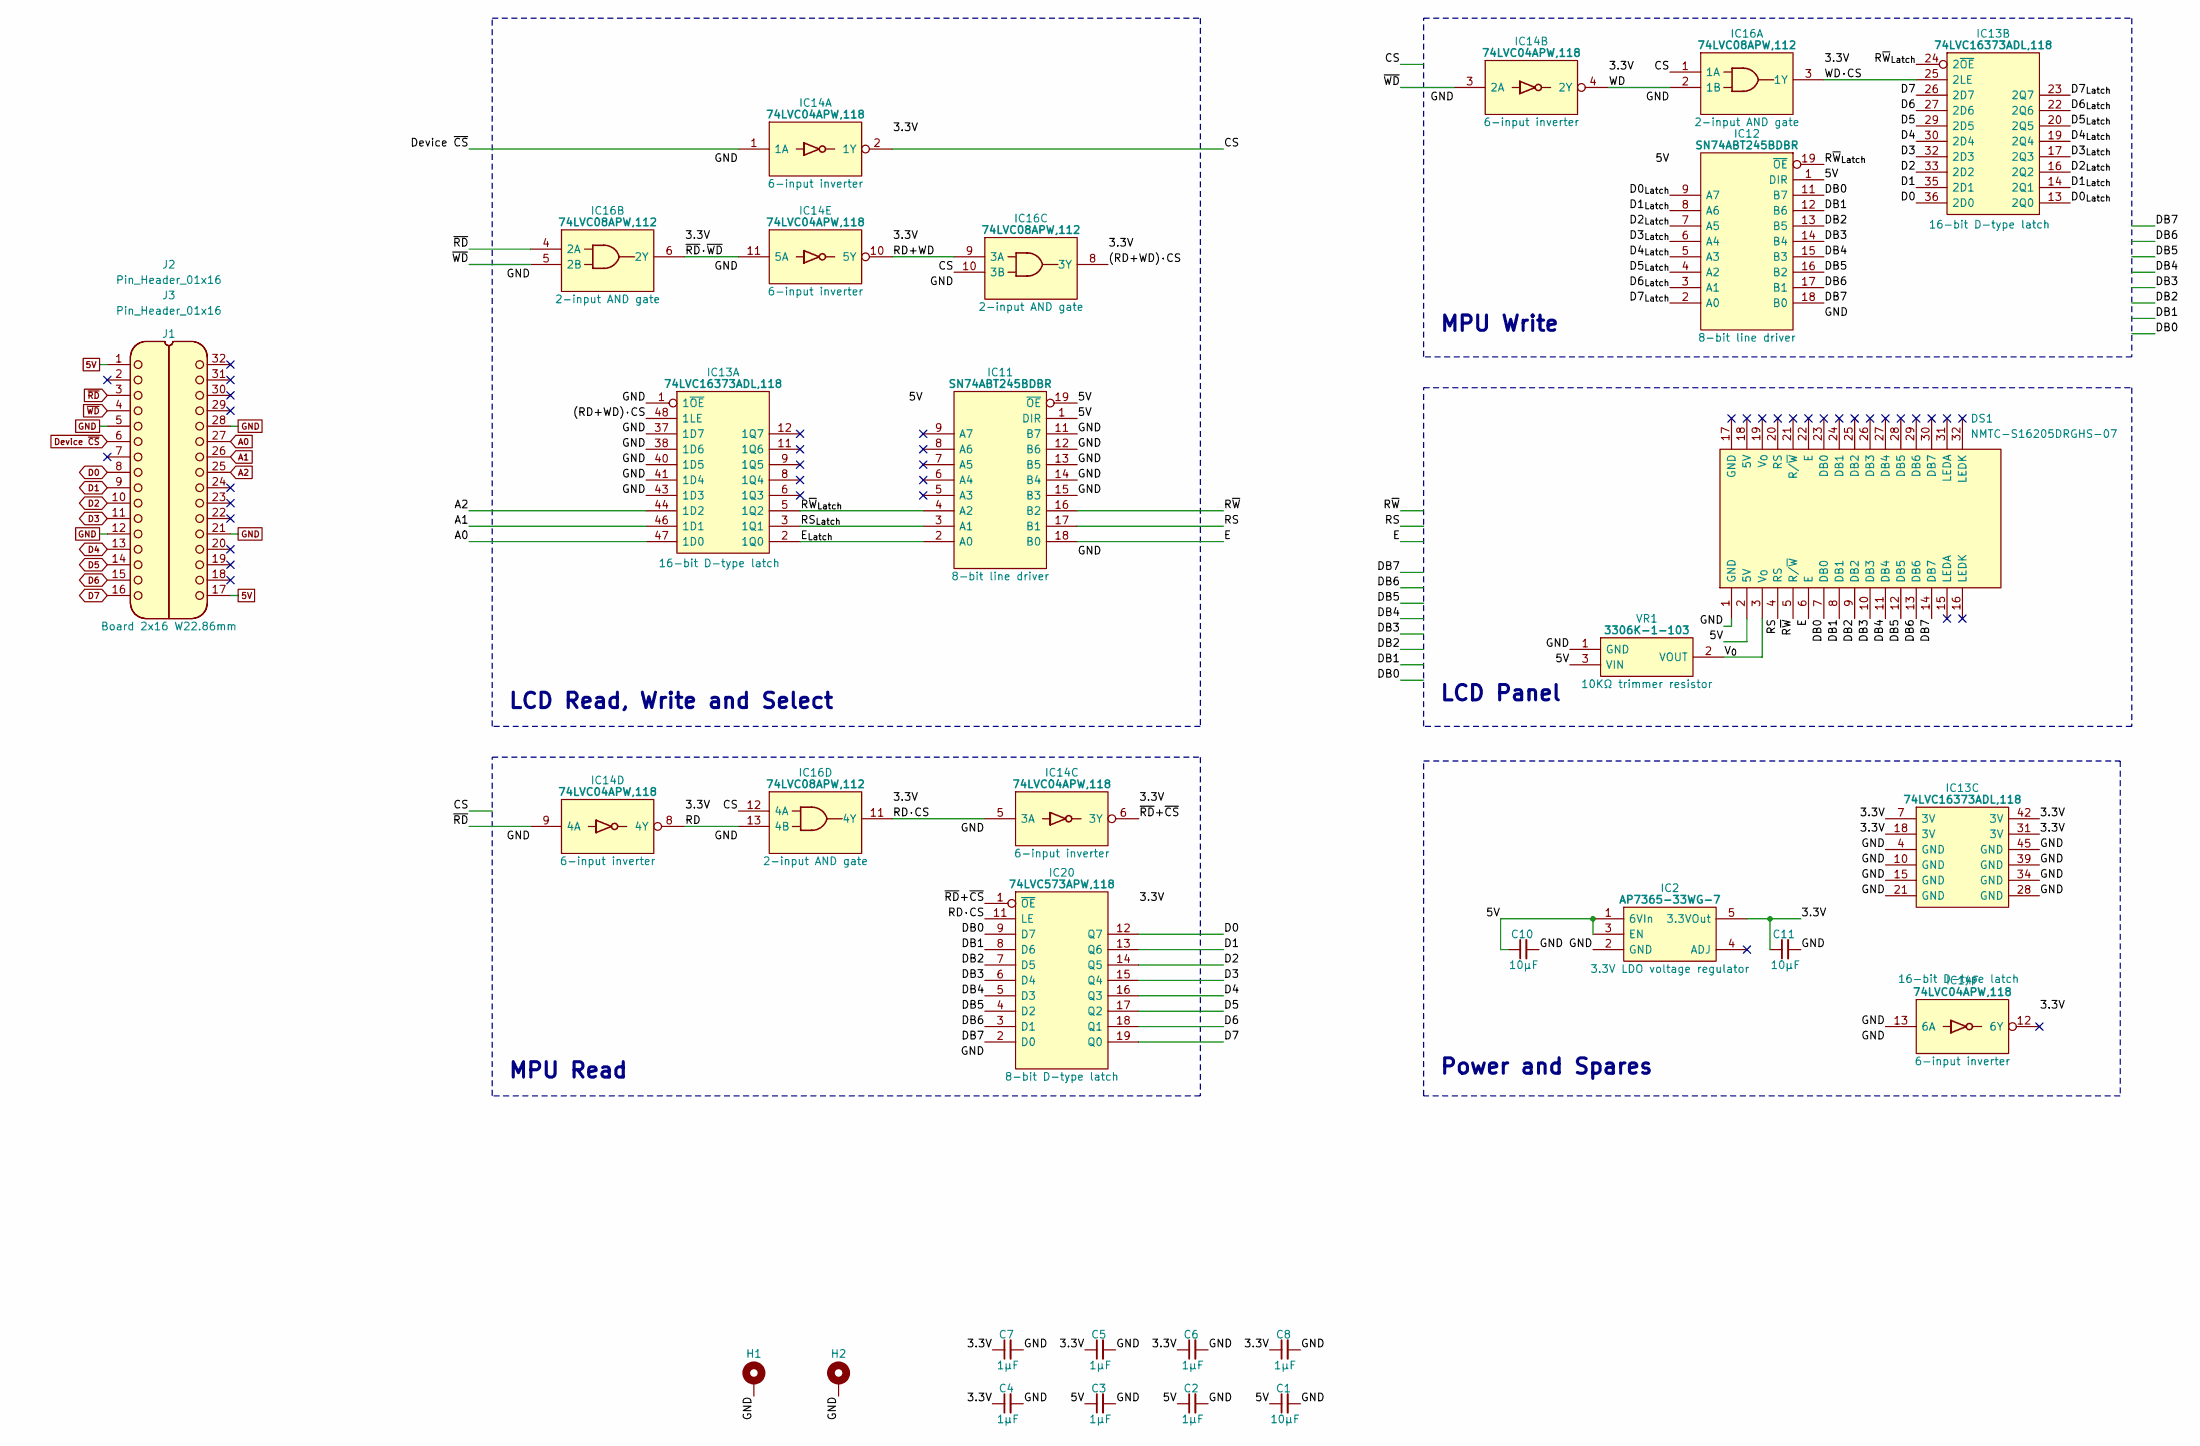
[picture p296: schematic LCD Display.kicad_sch]

Parts:
C1, C10, C11: 10μF; C_0805
C2, C3, C4, C5, C6, C7, C8: 1μF; C_0805
DS1: NMTC-S16205DRGHS-07; NMTCS16205DRGHS07_1; Mouser Part Number 668-NC-S16205DRGHS
H1, H2: MountingHole_Pad; HCP65_MountingHole_M3_
IC2: AP7365-33WG-7; SOT95P285X130-5N; Manufacturer_Part_Number AP7365-33WG-7; Mouser Part Number 621-AP7365-33WG-7
IC11, IC12: SN74ABT245BDBR; SOP65P780X200-20N; Manufacturer_Part_Number SN74ABT245BDBR; Mouser Part Number 595-SN74ABT245BDBR
IC13: 74LVC16373ADL,118; SOP64P1025X280-48N; Mouser Part Number 771-LVC16373ADL118
IC14: 74LVC04APW,118; SOP65P640X110-14N; Manufacturer_Part_Number 74LVC04APW,118; Mouser Part Number 771-74LVC04APW-T
IC16: 74LVC08APW,112; SOP65P640X110-14N; Manufacturer_Part_Number 74LVC08APW,112; Mouser Part Number 771-74LVC08APW
IC20: 74LVC573APW,118; SOP65P640X110-20N; Mouser Part Number 771-74LVC573APW-T
J1: Board 2x16 W22.86mm; DIP-32_Board_W22.86mm_Nak
J2, J3: Pin_Header_01x16; PinHeader_1x16_P2.54mm_Vertical
VR1: 3306K-1-103; 3306K1103; Manufacturer_Part_Number 3306K-1-103; Mouser Part Number 652-3306K-1-103

Connections:
3.3V: C4.1, C5.1, C6.1, C7.1, C8.1, C11.1, IC2.5 (3.3VOut), IC13.7 (3V), IC13.18 (3V), IC13.31 (3V), IC13.42 (3V), IC14.14 (3V), IC16.14 (3V), IC20.20 (3V)
5V: C1.1, C2.1, C3.1, C10.1, DS1.2 (5V), IC2.1 (6VIn), IC2.3 (EN), IC11.1 (DIR), IC11.19 (~OE), IC11.20 (5V), IC12.1 (DIR), IC12.20 (5V), J1.1, J1.17, VR1.3 (VIN)
(RD+WD)·CS: IC13.48 (1LE), IC16.8 (3Y)
A0: IC13.47 (1D0), J1.27
A1: IC13.46 (1D1), J1.26
A2: IC13.44 (1D2), J1.25
CS: IC14.2 (1Y), IC16.1 (1A), IC16.10 (3B), IC16.12 (4A)
D0: IC13.36 (2D0), IC20.12 (Q7), J1.8
D0_{Latch}: IC12.9 (A7), IC13.13 (2Q0)
D1: IC13.35 (2D1), IC20.13 (Q6), J1.9
D1_{Latch}: IC12.8 (A6), IC13.14 (2Q1)
D2: IC13.33 (2D2), IC20.14 (Q5), J1.10
D2_{Latch}: IC12.7 (A5), IC13.16 (2Q2)
D3: IC13.32 (2D3), IC20.15 (Q4), J1.11
D3_{Latch}: IC12.6 (A4), IC13.17 (2Q3)
D4: IC13.30 (2D4), IC20.16 (Q3), J1.13
D4_{Latch}: IC12.5 (A3), IC13.19 (2Q4)
D5: IC13.29 (2D5), IC20.17 (Q2), J1.14
D5_{Latch}: IC12.4 (A2), IC13.20 (2Q5)
D6: IC13.27 (2D6), IC20.18 (Q1), J1.15
D6_{Latch}: IC12.3 (A1), IC13.22 (2Q6)
D7: IC13.26 (2D7), IC20.19 (Q0), J1.16
D7_{Latch}: IC12.2 (A0), IC13.23 (2Q7)
DB0: DS1.7 (DB0), IC12.11 (B7), IC20.9 (D7)
DB1: DS1.8 (DB1), IC12.12 (B6), IC20.8 (D6)
DB2: DS1.9 (DB2), IC12.13 (B5), IC20.7 (D5)
DB3: DS1.10 (DB3), IC12.14 (B4), IC20.6 (D4)
DB4: DS1.11 (DB4), IC12.15 (B3), IC20.5 (D3)
DB5: DS1.12 (DB5), IC12.16 (B2), IC20.4 (D2)
DB6: DS1.13 (DB6), IC12.17 (B1), IC20.3 (D1)
DB7: DS1.14 (DB7), IC12.18 (B0), IC20.2 (D0)
Device ~CS: IC14.1 (1A), J1.6
E: DS1.6 (E), IC11.18 (B0)
E_{Latch}: IC11.2 (A0), IC13.2 (1Q0)
GND: C1.2, C2.2, C3.2, C4.2, C5.2, C6.2, C7.2, C8.2, C10.2, C11.2, DS1.1 (GND), H1.1, H2.1, IC2.2 (GND), IC11.10 (GND), IC11.11 (B7), IC11.12 (B6), IC11.13 (B5), IC11.14 (B4), IC11.15 (B3), IC12.10 (GND), IC13.1 (1~OE), IC13.4 (GND), IC13.10 (GND), IC13.15 (GND), IC13.21 (GND), IC13.28 (GND), IC13.34 (GND), IC13.37 (1D7), IC13.38 (1D6), IC13.39 (GND), IC13.40 (1D5), IC13.41 (1D4), IC13.43 (1D3), IC13.45 (GND), IC14.7 (GND), IC14.13 (6A), IC16.7 (GND), IC20.10 (GND), J1.5, J1.12, J1.21, J1.28, VR1.1 (GND)
RD: IC14.8 (4Y), IC16.13 (4B)
RD+WD: IC14.10 (5Y), IC16.9 (3A)
RD·CS: IC14.5 (3A), IC16.11 (4Y), IC20.11 (LE)
RS: DS1.4 (RS), IC11.17 (B1)
RS_{Latch}: IC11.3 (A1), IC13.3 (1Q1)
R~W: DS1.5 (R/~W), IC11.16 (B2)
R~W_{Latch}: IC11.4 (A2), IC12.19 (~OE), IC13.5 (1Q2), IC13.24 (2~OE)
V_{0}: DS1.3 (V_{O}), VR1.2 (VOUT)
WD: IC14.4 (2Y), IC16.2 (1B)
WD·CS: IC13.25 (2LE), IC16.3 (1Y)
~RD: IC14.9 (4A), IC16.4 (2A), J1.3
~RD+~CS: IC14.6 (3Y), IC20.1 (~OE)
~RD·~WD: IC14.11 (5A), IC16.6 (2Y)
~WD: IC14.3 (2A), IC16.5 (2B), J1.4

Notes on the sheet:
MPU Read
LCD Read, Write and Select
MPU Write
LCD Panel
Power and Spares
