andrewpaterson/658-Computer/Kicad/Computer/PS2/PS2 Board/PS2 Board.kicad_sch

## KiCad design Kicad/Computer/PS2/PS2 Board/PS2 Board.kicad_sch (2026-01-30)

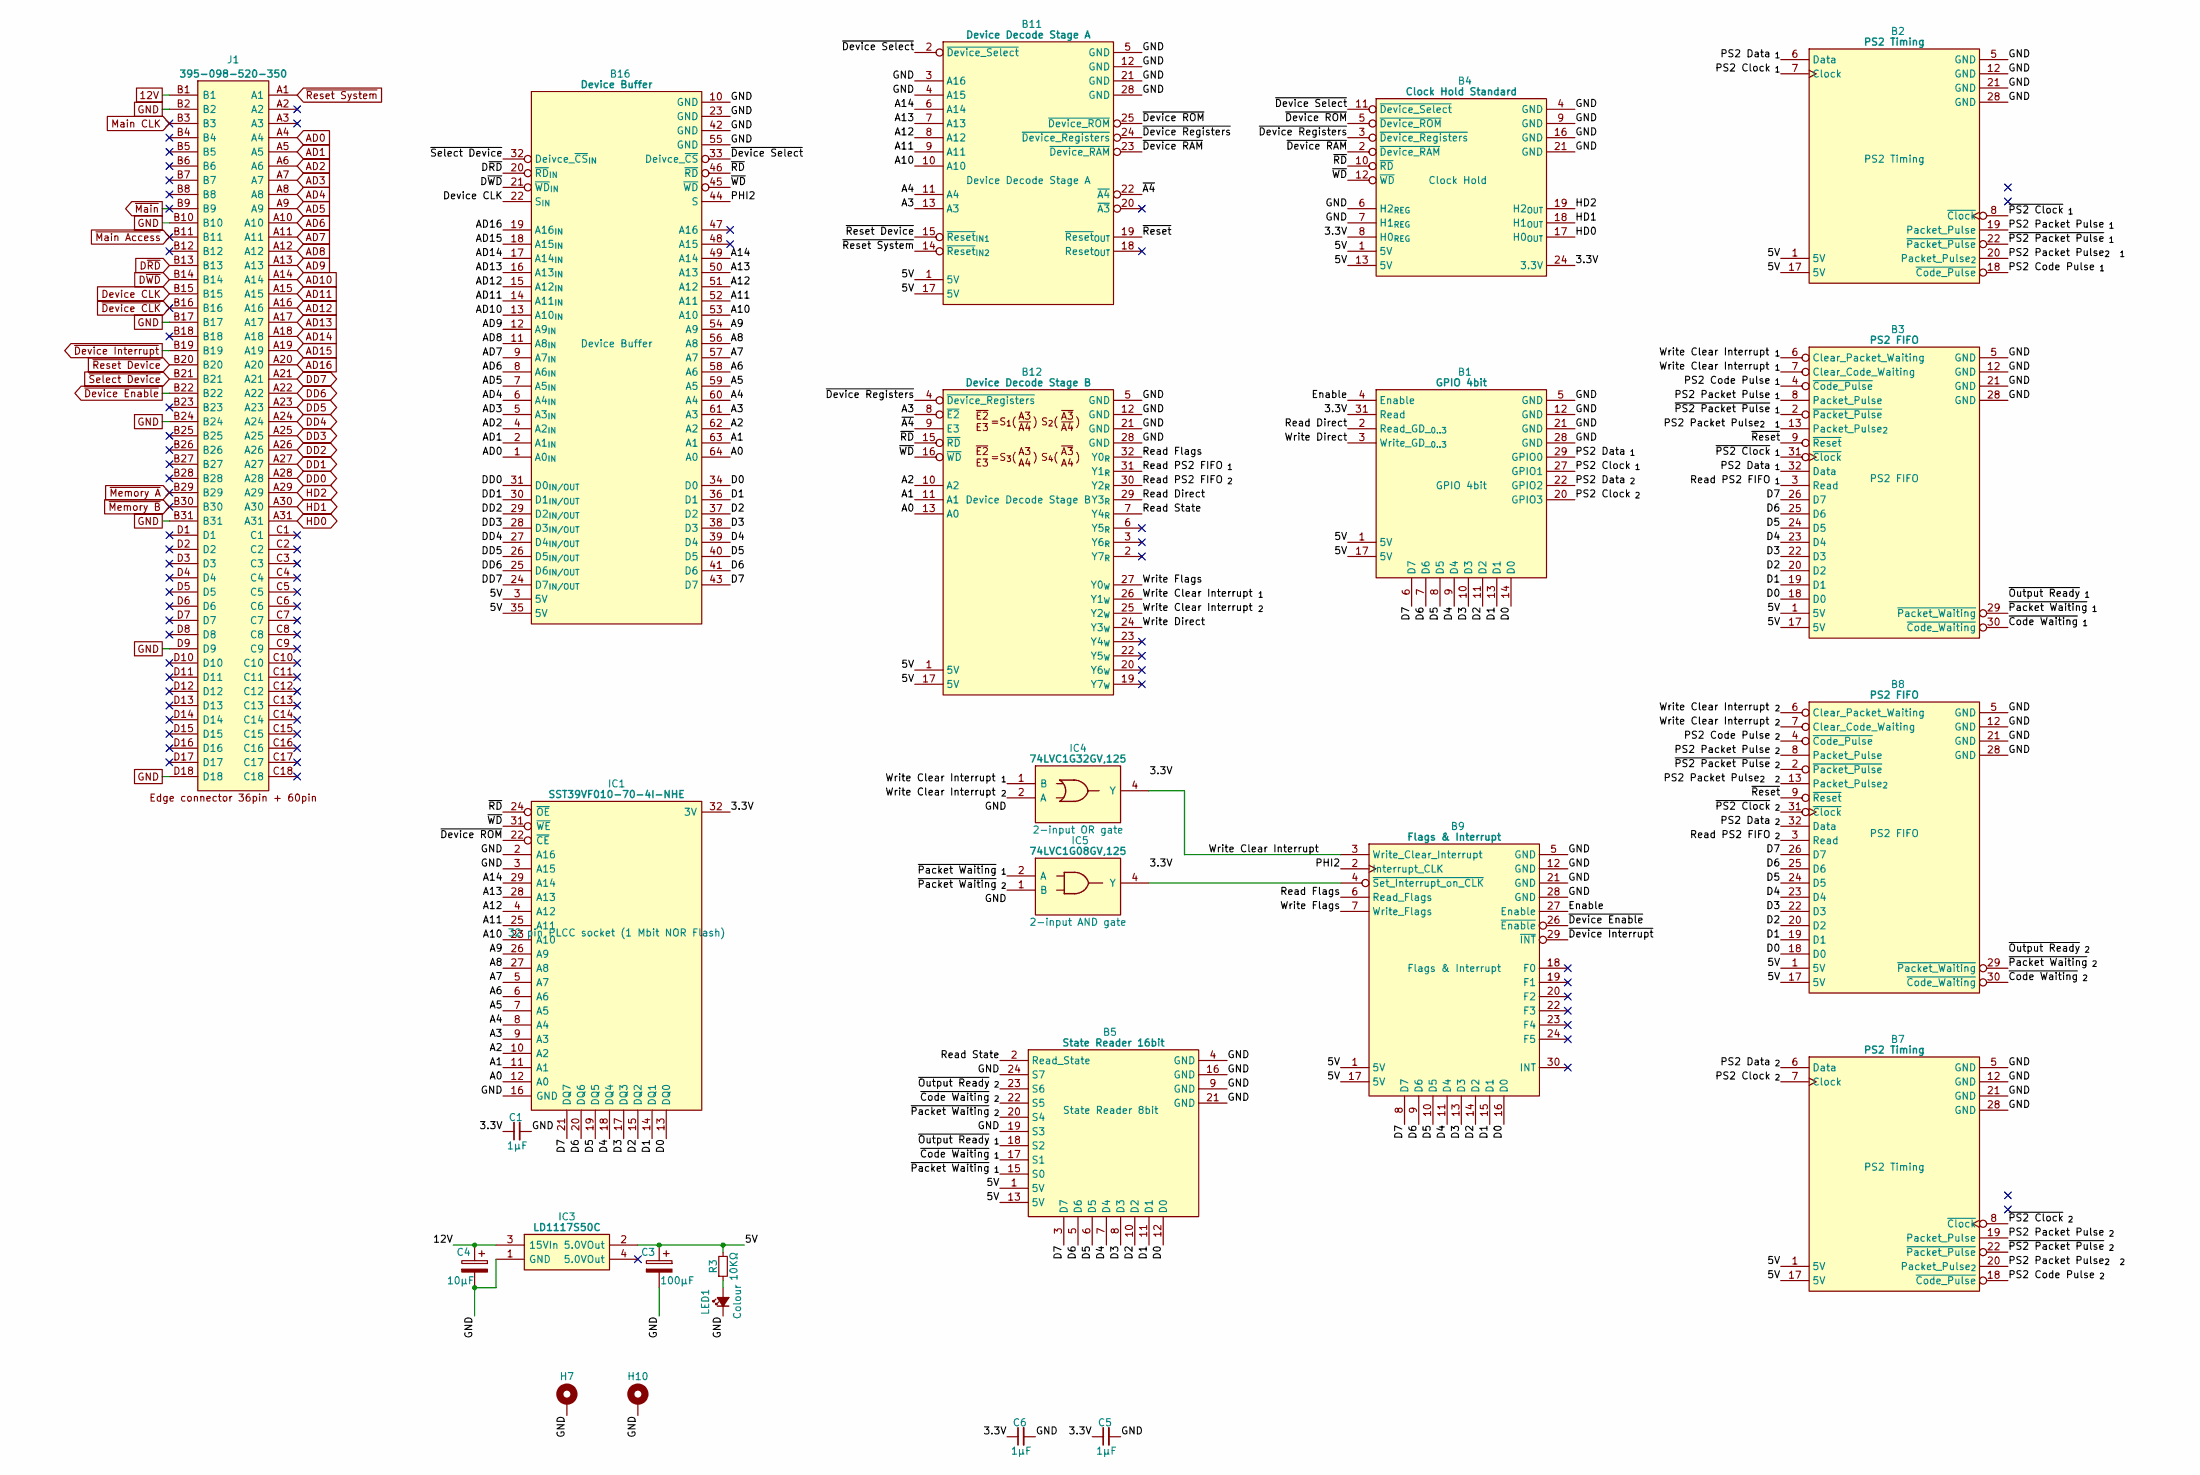
[picture p300: schematic PS2 Board.kicad_sch]

Parts:
B1: GPIO 4bit; HCP65_GPIO_4bit
B2, B7: PS2 Timing; HCP65_PS2_Timing
B3, B8: PS2 FIFO; HCP65_PS2_FIFO
B4: Clock Hold Standard; HCP65_Clock_Hold_Standard
B5: State Reader 16bit; HCP65_State_Reader_8bit
B9: Flags & Interrupt; HCP65_Flags_Interrupt
B11: Device Decode Stage A; HCP65_Device_Decode_Stage_A
B12: Device Decode Stage B; HCP65_Device_Decode_Stage_B
B16: Device Buffer; HCP65_Device_Buffer
C1, C5, C6: 1μF; C_0805
C3: 100μF; CP_Radial_D4.0mm_P2.00mm
C4: 10μF; CP_Radial_D4.0mm_P2.00mm
H7, H10: MountingHole_Pad; HCP65_MountingHole_M3_
IC1: SST39VF010-70-4I-NHE; 5408803224008; Manufacturer_Part_Number SST39VF010-70-4I-NHE
IC3: LD1117S50C; LD1117S33C; Manufacturer_Part_Number LD1117S50C
IC4: 74LVC1G32GV,125; SOT95P275X110-5N; Manufacturer_Part_Number 74LVC1G32GV,125; Mouser Part Number 771-LVC1G32GV125
IC5: 74LVC1G08GV,125; SOT95P275X110-5N; Manufacturer_Part_Number 74LVC1G08GV,125; Mouser Part Number 771-74LVC1G08GV
J1: 395-098-520-350; 98pin Edge Connector; Manufacturer_Part_Number 395-098-520-350; Mouser Part Number 587-395-098-520-350
LED1: Colour; LED_D5.0mm
R3: 10KΩ; R_0805

Connections:
3.3V: B1.31 (Read), B4.8 (H0_{REG}), B4.24 (3.3V), C1.1, C5.1, C6.1, IC1.32 (3V), IC4.5 (3V), IC5.5 (3V)
5V: B1.1 (5V), B1.17 (5V), B2.1 (5V), B2.17 (5V), B3.1 (5V), B3.17 (5V), B4.1 (5V), B4.13 (5V), B5.1 (5V), B5.13 (5V), B7.1 (5V), B7.17 (5V), B8.1 (5V), B8.17 (5V), B9.1 (5V), B9.17 (5V), B11.1 (5V), B11.17 (5V), B12.1 (5V), B12.17 (5V), B16.3 (5V), B16.35 (5V), C3.1, IC3.2 (5.0VOut), R3.2
12V: C4.1, IC3.3 (15VIn), J1.B1
A0: B12.13 (A0), B16.64 (A0), IC1.12 (A0)
A1: B12.11 (A1), B16.63 (A1), IC1.11 (A1)
A2: B12.10 (A2), B16.62 (A2), IC1.10 (A2)
A3: B11.13 (A3), B12.8 (~E2), B16.61 (A3), IC1.9 (A3)
A4: B11.11 (A4), B16.60 (A4), IC1.8 (A4)
A5: B16.59 (A5), IC1.7 (A5)
A6: B16.58 (A6), IC1.6 (A6)
A7: B16.57 (A7), IC1.5 (A7)
A8: B16.56 (A8), IC1.27 (A8)
A9: B16.54 (A9), IC1.26 (A9)
A10: B11.10 (A10), B16.53 (A10), IC1.23 (A10)
A11: B11.9 (A11), B16.52 (A11), IC1.25 (A11)
A12: B11.8 (A12), B16.51 (A12), IC1.4 (A12)
A13: B11.7 (A13), B16.50 (A13), IC1.28 (A13)
A14: B11.6 (A14), B16.49 (A14), IC1.29 (A14)
AD0: B16.1 (A0_{IN}), J1.A4
AD1: B16.2 (A1_{IN}), J1.A5
AD2: B16.4 (A2_{IN}), J1.A6
AD3: B16.5 (A3_{IN}), J1.A7
AD4: B16.6 (A4_{IN}), J1.A8
AD5: B16.7 (A5_{IN}), J1.A9
AD6: B16.8 (A6_{IN}), J1.A10
AD7: B16.9 (A7_{IN}), J1.A11
AD8: B16.11 (A8_{IN}), J1.A12
AD9: B16.12 (A9_{IN}), J1.A13
AD10: B16.13 (A10_{IN}), J1.A14
AD11: B16.14 (A11_{IN}), J1.A15
AD12: B16.15 (A12_{IN}), J1.A16
AD13: B16.16 (A13_{IN}), J1.A17
AD14: B16.17 (A14_{IN}), J1.A18
AD15: B16.18 (A15_{IN}), J1.A19
AD16: B16.19 (A16_{IN}), J1.A20
D0: B1.14 (D0), B3.18 (D0), B5.12 (D0), B8.18 (D0), B9.16 (D0), B16.34 (D0), IC1.13 (DQ0)
D1: B1.13 (D1), B3.19 (D1), B5.11 (D1), B8.19 (D1), B9.15 (D1), B16.36 (D1), IC1.14 (DQ1)
D2: B1.11 (D2), B3.20 (D2), B5.10 (D2), B8.20 (D2), B9.14 (D2), B16.37 (D2), IC1.15 (DQ2)
D3: B1.10 (D3), B3.22 (D3), B5.8 (D3), B8.22 (D3), B9.13 (D3), B16.38 (D3), IC1.17 (DQ3)
D4: B1.9 (D4), B3.23 (D4), B5.7 (D4), B8.23 (D4), B9.11 (D4), B16.39 (D4), IC1.18 (DQ4)
D5: B1.8 (D5), B3.24 (D5), B5.6 (D5), B8.24 (D5), B9.10 (D5), B16.40 (D5), IC1.19 (DQ5)
D6: B1.7 (D6), B3.25 (D6), B5.5 (D6), B8.25 (D6), B9.9 (D6), B16.41 (D6), IC1.20 (DQ6)
D7: B1.6 (D7), B3.26 (D7), B5.3 (D7), B8.26 (D7), B9.8 (D7), B16.43 (D7), IC1.21 (DQ7)
DD0: B16.31 (D0_{IN/OUT}), J1.A28
DD1: B16.30 (D1_{IN/OUT}), J1.A27
DD2: B16.29 (D2_{IN/OUT}), J1.A26
DD3: B16.28 (D3_{IN/OUT}), J1.A25
DD4: B16.27 (D4_{IN/OUT}), J1.A24
DD5: B16.26 (D5_{IN/OUT}), J1.A23
DD6: B16.25 (D6_{IN/OUT}), J1.A22
DD7: B16.24 (D7_{IN/OUT}), J1.A21
Device CLK: B16.22 (S_{IN}), J1.B15
D~RD: B16.20 (~RD_{IN}), J1.B13
D~WD: B16.21 (~WD_{IN}), J1.B14
Enable: B1.4 (Enable), B9.27 (Enable)
GND: B1.5 (GND), B1.12 (GND), B1.21 (GND), B1.28 (GND), B2.5 (GND), B2.12 (GND), B2.21 (GND), B2.28 (GND), B3.5 (GND), B3.12 (GND), B3.21 (GND), B3.28 (GND), B4.4 (GND), B4.6 (H2_{REG}), B4.7 (H1_{REG}), B4.9 (GND), B4.16 (GND), B4.21 (GND), B5.4 (GND), B5.9 (GND), B5.16 (GND), B5.19 (S3), B5.21 (GND), B5.24 (S7), B7.5 (GND), B7.12 (GND), B7.21 (GND), B7.28 (GND), B8.5 (GND), B8.12 (GND), B8.21 (GND), B8.28 (GND), B9.5 (GND), B9.12 (GND), B9.21 (GND), B9.28 (GND), B11.3 (A16), B11.4 (A15), B11.5 (GND), B11.12 (GND), B11.21 (GND), B11.28 (GND), B12.5 (GND), B12.12 (GND), B12.21 (GND), B12.28 (GND), B16.10 (GND), B16.23 (GND), B16.42 (GND), B16.55 (GND), C1.2, C3.2, C4.2, C5.2, C6.2, H7.1, H10.1, IC1.2 (A16), IC1.3 (A15), IC1.16 (GND), IC3.1 (GND), IC4.3 (GND), IC5.3 (GND), J1.B2, J1.B10, J1.B17, J1.B24, J1.B31, J1.D9, J1.D18, LED1.1 (K)
HD0: B4.17 (H0_{OUT}), J1.A31
HD1: B4.18 (H1_{OUT}), J1.A30
HD2: B4.19 (H2_{OUT}), J1.A29
Main CLK: J1.B3
unnamed: B9.4 (~Set_Interrupt_on_CLK), IC5.4 (Y)
unnamed: LED1.2 (A), R3.1
PHI2: B9.2 (Interrupt_CLK), B16.44 (S)
PS2 Clock_{ 1}: B1.27 (GPIO1), B2.7 (Clock)
PS2 Clock_{ 2}: B1.20 (GPIO3), B7.7 (Clock)
PS2 Code Pulse_{ 1}: B2.18 (~Code_Pulse), B3.4 (~Code_Pulse)
PS2 Code Pulse_{ 2}: B7.18 (~Code_Pulse), B8.4 (~Code_Pulse)
PS2 Data_{ 1}: B1.29 (GPIO0), B2.6 (Data), B3.32 (Data)
PS2 Data_{ 2}: B1.22 (GPIO2), B7.6 (Data), B8.32 (Data)
PS2 Packet Pulse_{2} _{ 1}: B2.20 (Packet_Pulse_{2}), B3.13 (Packet_Pulse_{2})
PS2 Packet Pulse_{2} _{ 2}: B7.20 (Packet_Pulse_{2}), B8.13 (Packet_Pulse_{2})
PS2 Packet Pulse_{ 1}: B2.19 (Packet_Pulse), B3.8 (Packet_Pulse)
PS2 Packet Pulse_{ 2}: B7.19 (Packet_Pulse), B8.8 (Packet_Pulse)
Read Direct: B1.2 (Read_GD__{0..3}), B12.29 (Y3_{R})
Read Flags: B9.6 (Read_Flags), B12.32 (Y0_{R})
Read PS2 FIFO_{ 1}: B3.3 (Read), B12.31 (Y1_{R})
Read PS2 FIFO_{ 2}: B8.3 (Read), B12.30 (Y2_{R})
Read State: B5.2 (Read_State), B12.7 (Y4_{R})
Write Clear Interrupt: B9.3 (Write_Clear_Interrupt), IC4.4 (Y)
Write Clear Interrupt _{1}: B3.6 (Clear_Packet_Waiting), B3.7 (Clear_Code_Waiting), B12.26 (Y1_{W}), IC4.1 (B)
Write Clear Interrupt _{2}: B8.6 (Clear_Packet_Waiting), B8.7 (Clear_Code_Waiting), B12.25 (Y2_{W}), IC4.2 (A)
Write Direct: B1.3 (Write_GD__{0..3}), B12.24 (Y3_{W})
Write Flags: B9.7 (Write_Flags), B12.27 (Y0_{W})
~A4: B11.22 (~A4), B12.9 (E3)
~Code Waiting_{ 1}: B3.30 (~Code_Waiting), B5.17 (S1)
~Code Waiting_{ 2}: B5.22 (S5), B8.30 (~Code_Waiting)
~Device CLK: J1.B16
~Device Enable: B9.26 (~Enable), J1.B22
~Device Interrupt: B9.29 (~INT), J1.B19
~Device RAM: B4.2 (~Device_RAM), B11.23 (~Device_RAM)
~Device ROM: B4.5 (~Device_ROM), B11.25 (~Device_ROM), IC1.22 (~CE)
~Device Registers: B4.3 (~Device_Registers), B11.24 (~Device_Registers), B12.4 (~Device_Registers)
~Device Select: B4.11 (~Device_Select), B11.2 (~Device_Select), B16.33 (Deivce_~CS)
~Main Access: J1.B11
~Main: J1.B9
~Memory A: J1.B29
~Memory B: J1.B30
~Output Ready_{ 1}: B3.27 (Output_Ready), B5.18 (S2)
~Output Ready_{ 2}: B5.23 (S6), B8.27 (Output_Ready)
~PS2 Clock_{ 1}: B2.8 (~Clock), B3.31 (~Clock)
~PS2 Clock_{ 2}: B7.8 (~Clock), B8.31 (~Clock)
~PS2 Packet Pulse_{ 1}: B2.22 (~Packet_Pulse), B3.2 (~Packet_Pulse)
~PS2 Packet Pulse_{ 2}: B7.22 (~Packet_Pulse), B8.2 (~Packet_Pulse)
~Packet Waiting_{ 1}: B3.29 (~Packet_Waiting), B5.15 (S0), IC5.2 (A)
~Packet Waiting_{ 2}: B5.20 (S4), B8.29 (~Packet_Waiting), IC5.1 (B)
~RD: B4.10 (~RD), B12.15 (~RD), B16.46 (~RD), IC1.24 (~OE)
~Reset Device: B11.15 (~Reset_{IN1}), J1.B20
~Reset System: B11.14 (~Reset_{IN2}), J1.A1
~Reset: B3.9 (~Reset), B8.9 (~Reset), B11.19 (~Reset_{OUT})
~Select Device: B16.32 (Deivce_~CS_{IN}), J1.B21
~WD: B4.12 (~WD), B12.16 (~WD), B16.45 (~WD), IC1.31 (~WE)
