andrewpaterson/658-Computer/Kicad/Computer/SD Card/SD Card Clock/SD Card Clock.kicad_sch

## KiCad design Kicad/Computer/SD Card/SD Card Clock/SD Card Clock.kicad_sch (2026-01-14)

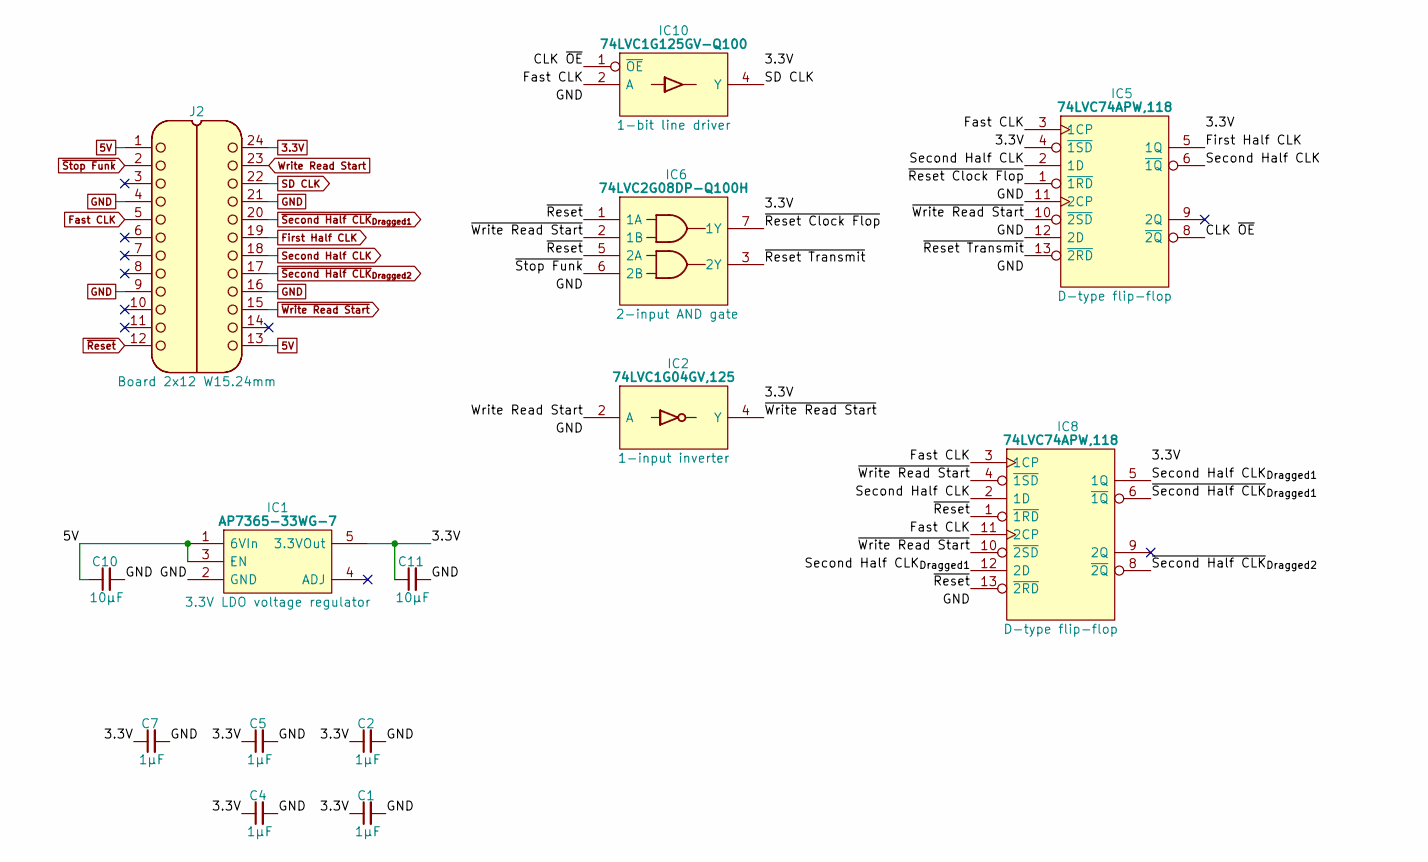
[picture p305: schematic SD Card Clock.kicad_sch]

Parts:
C1, C2, C4, C5, C7: 1μF; C_0805
C10, C11: 10µF; C_0805
IC1: AP7365-33WG-7; SOT95P285X130-5N; Manufacturer_Part_Number AP7365-33WG-7; Mouser Part Number 621-AP7365-33WG-7
IC2: 74LVC1G04GV,125; SOT95P275X110-5N; Manufacturer_Part_Number 74LVC1G04GV,125; Mouser Part Number 771-74LVC1G04GV
IC5, IC8: 74LVC74APW,118; SOP65P640X110-14N; Mouser Part Number 771-74LVC74APW-T
IC6: 74LVC2G08DP-Q100H; SOP65P400X110-8N; Manufacturer_Part_Number 74LVC2G08DP-Q100H; Mouser Part Number 771-74LVC2G08DPQ100H
IC10: 74LVC1G125GV-Q100; SOT95P275X110-5N; Mouser Part Number 771-74LVC1G125GVQ100
J2: Board 2x12 W15.24mm; DIP-24_Board_W15.24mm

Connections:
3.3V: C1.1, C2.1, C4.1, C5.1, C7.1, C11.1, IC1.5 (3.3VOut), IC2.5 (3V), IC5.4 (~1SD), IC5.14 (3V), IC6.8 (3V), IC8.14 (3V), IC10.5 (3V), J2.24
5V: C10.1, IC1.1 (6VIn), IC1.3 (EN), J2.1, J2.13
CLK ~OE: IC5.8 (~2Q), IC10.1 (~OE)
Fast CLK: IC5.3 (1CP), IC8.3 (1CP), IC8.11 (2CP), IC10.2 (A), J2.5
First Half CLK: IC5.5 (1Q), J2.19
GND: C1.2, C2.2, C4.2, C5.2, C7.2, C10.2, C11.2, IC1.2 (GND), IC2.3 (GND), IC5.7 (GND), IC5.11 (2CP), IC5.12 (2D), IC6.4 (GND), IC8.7 (GND), IC10.3 (GND), J2.4, J2.9, J2.16, J2.21
SD CLK: IC10.4 (Y), J2.22
Second Half CLK: IC5.2 (1D), IC5.6 (~1Q), IC8.2 (1D), J2.18
Second Half CLK_{Dragged1}: IC8.5 (1Q), IC8.12 (2D)
Write Read Start: IC2.2 (A), J2.23
~Reset Clock Flop: IC5.1 (~1RD), IC6.7 (1Y)
~Reset Transmit: IC5.13 (~2RD), IC6.3 (2Y)
~Reset: IC6.1 (1A), IC6.5 (2A), IC8.1 (~1RD), IC8.13 (~2RD), J2.12
~Second Half CLK_{Dragged1}: IC8.6 (~1Q), J2.20
~Second Half CLK_{Dragged2}: IC8.8 (~2Q), J2.17
~Stop Funk: IC6.6 (2B), J2.2
~Write Read Start: IC2.4 (Y), IC5.10 (~2SD), IC6.2 (1B), IC8.4 (~1SD), IC8.10 (~2SD), J2.15
