andrewpaterson/658-Computer/Kicad/Computer/SD Card/SD Card Full Socket/SD Card Full Socket.kicad_sch

## KiCad design Kicad/Computer/SD Card/SD Card Full Socket/SD Card Full Socket.kicad_sch (2026-01-14)

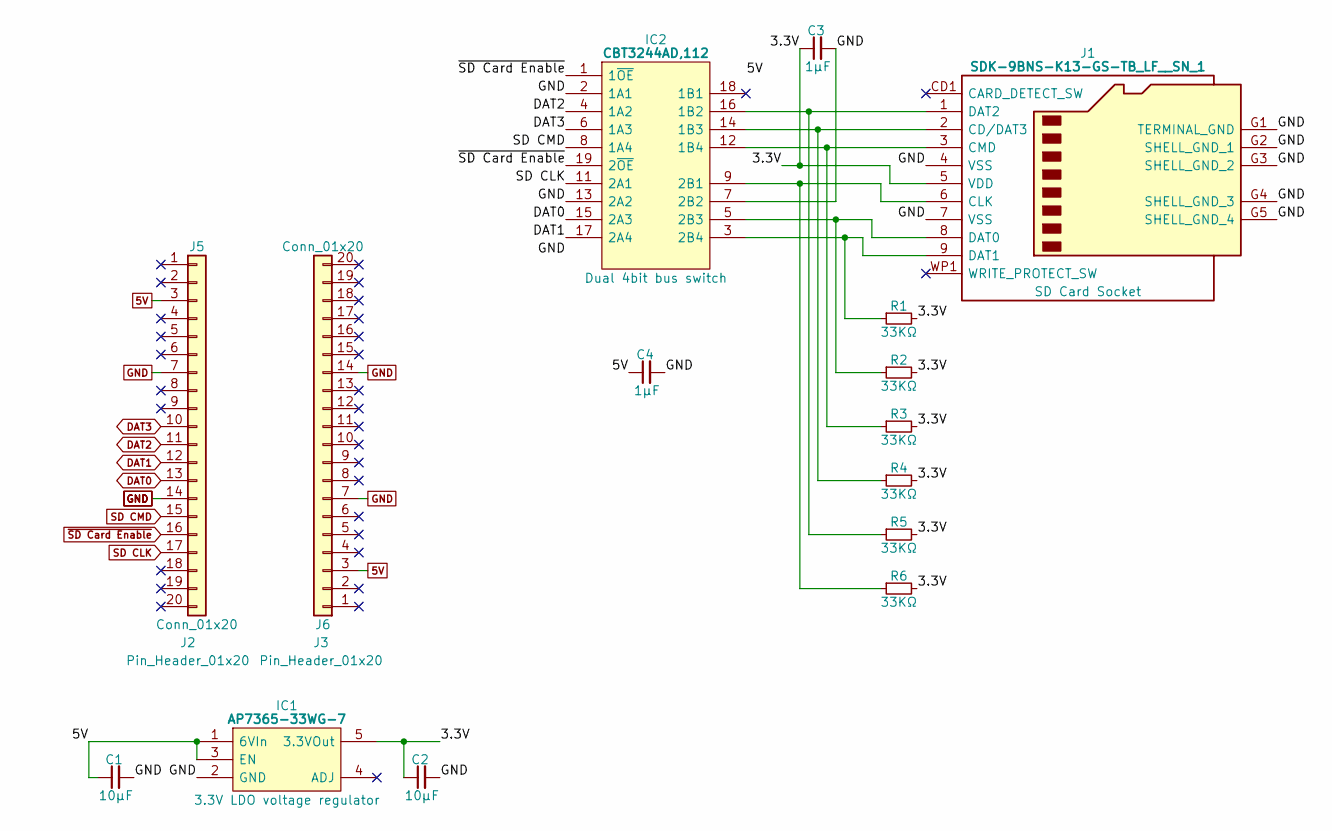
[picture p306: schematic SD Card Full Socket.kicad_sch]

Parts:
C1, C2: 10μF; C_0805
C3, C4: 1μF; C_0805
IC1: AP7365-33WG-7; SOT95P285X130-5N; Manufacturer_Part_Number AP7365-33WG-7; Mouser Part Number 621-AP7365-33WG-7
IC2: CBT3244AD,112; SOIC127P1032X265-20N; Manufacturer_Part_Number CBT3244AD,112; Mouser Part Number 771-CBT3244AD
J1: SDK-9BNS-K13-GS-TB_LF__SN_1; SDK9BNSK13GSTBLFSN1; Manufacturer_Part_Number SDK-9BNS-K13-GS-TB(LF)(SN)1
J2, J3: Pin_Header_01x20; PinHeader_1x20_P2.54mm_Vertical
J5, J6: Conn_01x20; SIP_20_Pins
R1, R2, R3, R4, R5, R6: 33KΩ; R_0805

Connections:
3.3V: C2.1, C3.1, IC1.5 (3.3VOut), J1.5 (VDD), R1.2, R2.2, R3.2, R4.2, R5.2, R6.2
5V: C1.1, C4.1, IC1.1 (6VIn), IC1.3 (EN), IC2.20 (5V), J5.3, J6.3
DAT0: IC2.15 (2A3), J5.13
DAT1: IC2.17 (2A4), J5.12
DAT2: IC2.4 (1A2), J5.11
DAT3: IC2.6 (1A3), J5.10
GND: C1.2, C2.2, C3.2, C4.2, IC1.2 (GND), IC2.2 (1A1), IC2.7 (2B2), IC2.10 (GND), IC2.13 (2A2), J1.4 (VSS), J1.7 (VSS), J1.G1 (TERMINAL_GND), J1.G2 (SHELL_GND_1), J1.G3 (SHELL_GND_2), J1.G4 (SHELL_GND_3), J1.G5 (SHELL_GND_4), J5.7, J5.14, J6.7, J6.14
unnamed: IC2.3 (2B4), J1.9 (DAT1), R1.1
unnamed: IC2.5 (2B3), J1.8 (DAT0), R2.1
unnamed: IC2.9 (2B1), J1.6 (CLK), R6.1
unnamed: IC2.12 (1B4), J1.3 (CMD), R3.1
unnamed: IC2.14 (1B3), J1.2 (CD/DAT3), R4.1
unnamed: IC2.16 (1B2), J1.1 (DAT2), R5.1
SD CLK: IC2.11 (2A1), J5.17
SD CMD: IC2.8 (1A4), J5.15
~SD Card Enable: IC2.1 (1~OE), IC2.19 (2~OE), J5.16
