andrewpaterson/658-Computer/Kicad/Computer/SD Card/SD Card Micro Socket/SD Card Micro Socket.kicad_sch

## KiCad design Kicad/Computer/SD Card/SD Card Micro Socket/SD Card Micro Socket.kicad_sch (2026-03-03)

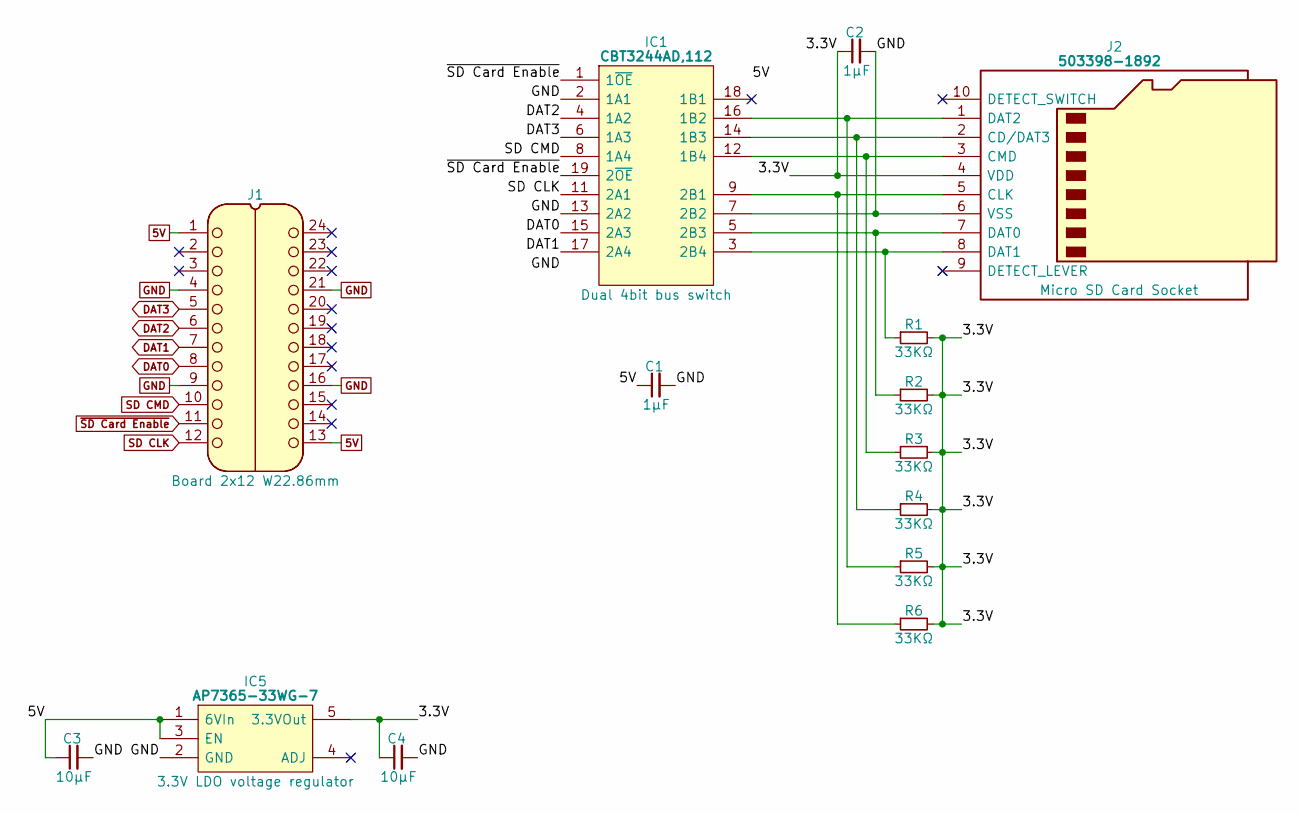
[picture p307: schematic SD Card Micro Socket.kicad_sch]

Parts:
C1, C2: 1μF; C_0805
C3, C4: 10µF; C_0805
IC1: CBT3244AD,112; SOIC127P1032X265-20N; Manufacturer_Part_Number CBT3244AD,112; Mouser Part Number 771-CBT3244AD
IC5: AP7365-33WG-7; SOT95P285X130-5N; Manufacturer_Part_Number AP7365-33WG-7; Mouser Part Number 621-AP7365-33WG-7
J1: Board 2x12 W22.86mm; DIP-24_Board_W22.86mm
J2: 503398-1892; Mouser2 Part Number 538-503398-1892
R1, R2, R3, R4, R5, R6: 33KΩ; R_0805

Connections:
3.3V: C2.1, C4.1, IC5.5 (3.3VOut), J2.4 (VDD), R1.2, R2.2, R3.2, R4.2, R5.2, R6.2
5V: C1.1, C3.1, IC1.20 (5V), IC5.1 (6VIn), IC5.3 (EN), J1.1, J1.13
DAT0: IC1.15 (2A3), J1.8
DAT1: IC1.17 (2A4), J1.7
DAT2: IC1.4 (1A2), J1.6
DAT3: IC1.6 (1A3), J1.5
GND: C1.2, C2.2, C3.2, C4.2, IC1.2 (1A1), IC1.7 (2B2), IC1.10 (GND), IC1.13 (2A2), IC5.2 (GND), J1.4, J1.9, J1.16, J1.21, J2.6 (VSS)
unnamed: IC1.3 (2B4), J2.8 (DAT1), R1.1
unnamed: IC1.5 (2B3), J2.7 (DAT0), R2.1
unnamed: IC1.9 (2B1), J2.5 (CLK), R6.1
unnamed: IC1.12 (1B4), J2.3 (CMD), R3.1
unnamed: IC1.14 (1B3), J2.2 (CD/DAT3), R4.1
unnamed: IC1.16 (1B2), J2.1 (DAT2), R5.1
SD CLK: IC1.11 (2A1), J1.12
SD CMD: IC1.8 (1A4), J1.10
~SD Card Enable: IC1.1 (1~OE), IC1.19 (2~OE), J1.11
