andrewpaterson/658-Computer/Kicad/Computer/SD Card/SD Card Read Function/SD Card Read Function.kicad_sch

## KiCad design Kicad/Computer/SD Card/SD Card Read Function/SD Card Read Function.kicad_sch (2026-01-14)

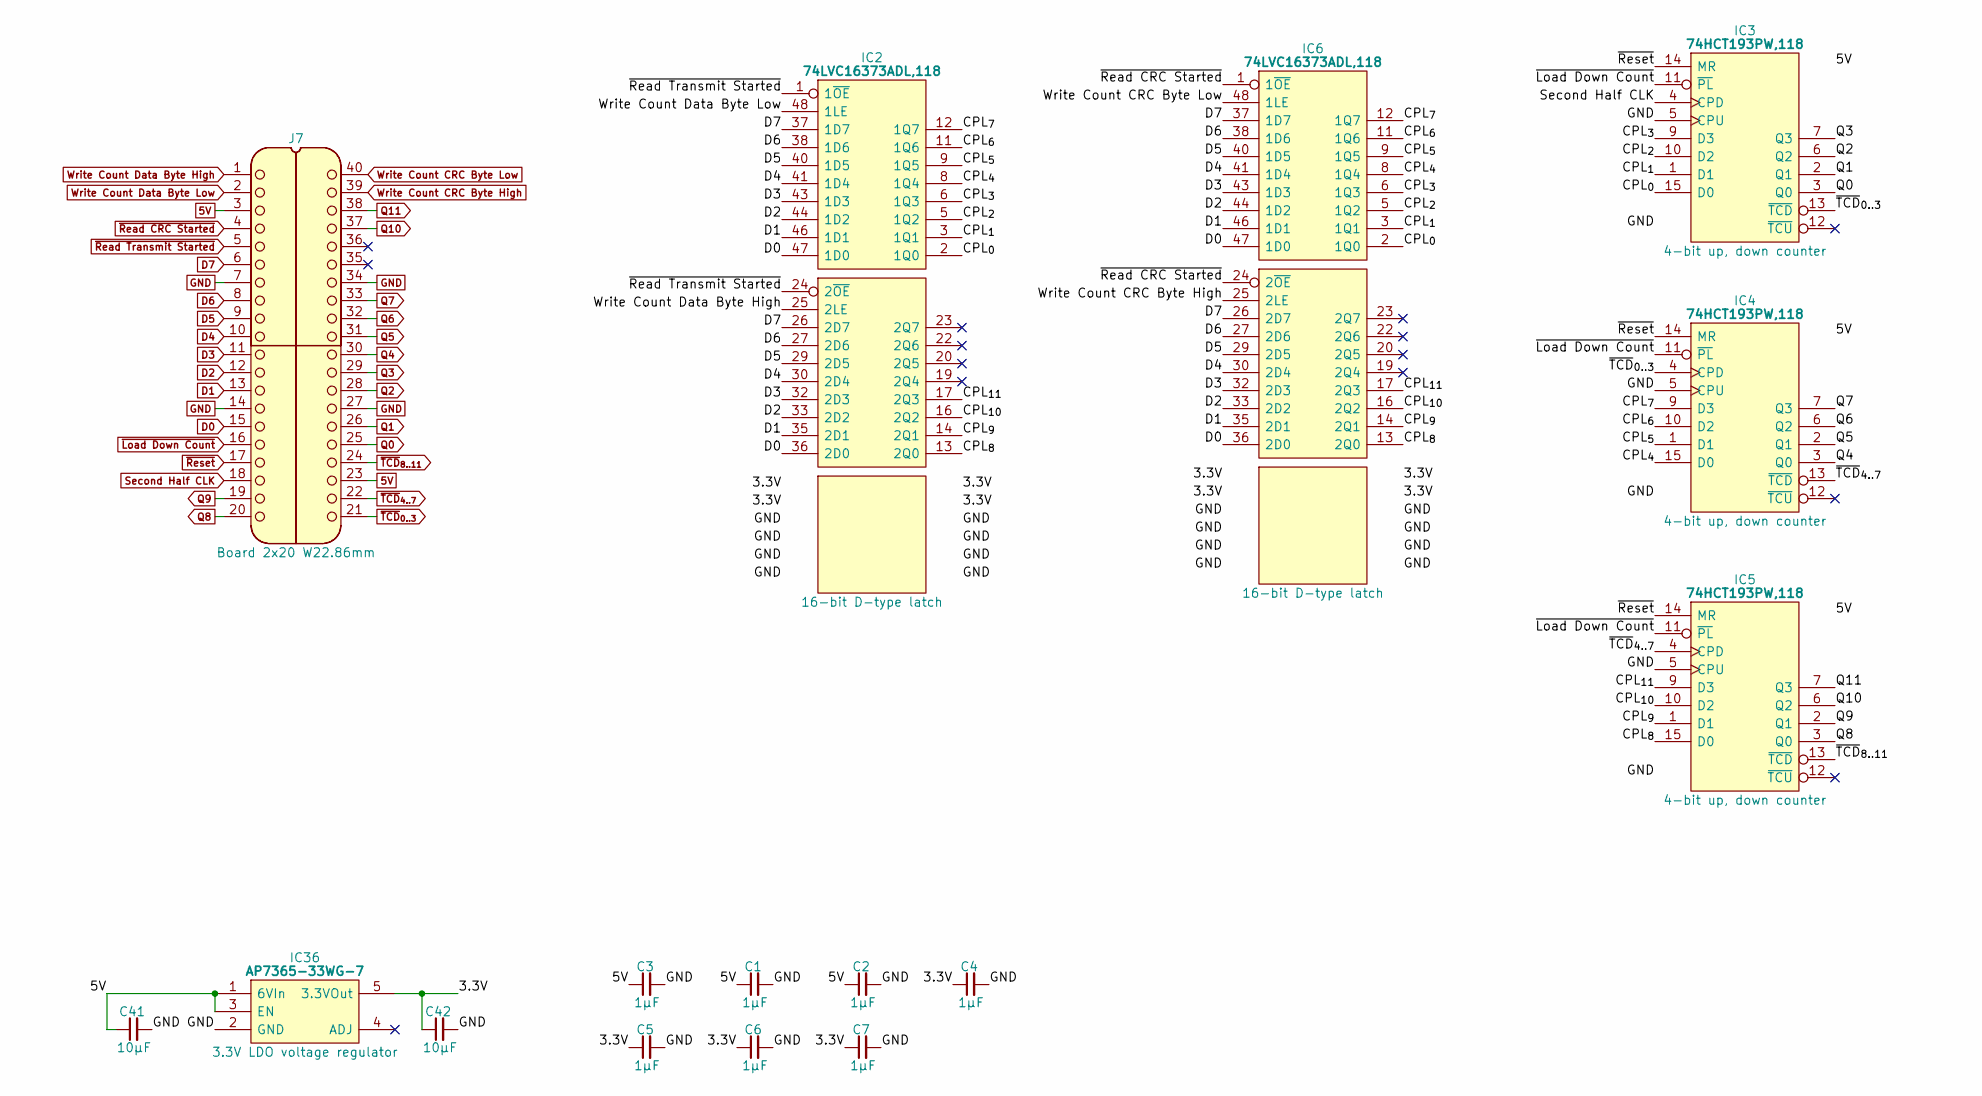
[picture p309: schematic SD Card Read Function.kicad_sch]

Parts:
C1, C2, C3, C4, C5, C6, C7: 1μF; C_0805
C41, C42: 10μF; C_0805
IC2, IC6: 74LVC16373ADL,118; SOP64P1025X280-48N; Mouser Part Number 771-LVC16373ADL118
IC3, IC4, IC5: 74HCT193PW,118; SOP65P640X110-16N; Manufacturer_Part_Number 74HCT193PW,118; Mouser Part Number 771-HCT193PW118
IC36: AP7365-33WG-7; SOT95P285X130-5N; Manufacturer_Part_Number AP7365-33WG-7; Mouser Part Number 621-AP7365-33WG-7
J7: Board 2x20 W22.86mm; DIP-40_Board_W22.86mm

Connections:
3.3V: C4.1, C5.1, C6.1, C7.1, C42.1, IC2.7 (3V), IC2.18 (3V), IC2.31 (3V), IC2.42 (3V), IC6.7 (3V), IC6.18 (3V), IC6.31 (3V), IC6.42 (3V), IC36.5 (3.3VOut)
5V: C1.1, C2.1, C3.1, C41.1, IC3.16 (5V), IC4.16 (5V), IC5.16 (5V), IC36.1 (6VIn), IC36.3 (EN), J7.3, J7.23
CPL_{0}: IC2.2 (1Q0), IC3.15 (D0), IC6.2 (1Q0)
CPL_{1}: IC2.3 (1Q1), IC3.1 (D1), IC6.3 (1Q1)
CPL_{2}: IC2.5 (1Q2), IC3.10 (D2), IC6.5 (1Q2)
CPL_{3}: IC2.6 (1Q3), IC3.9 (D3), IC6.6 (1Q3)
CPL_{4}: IC2.8 (1Q4), IC4.15 (D0), IC6.8 (1Q4)
CPL_{5}: IC2.9 (1Q5), IC4.1 (D1), IC6.9 (1Q5)
CPL_{6}: IC2.11 (1Q6), IC4.10 (D2), IC6.11 (1Q6)
CPL_{7}: IC2.12 (1Q7), IC4.9 (D3), IC6.12 (1Q7)
CPL_{8}: IC2.13 (2Q0), IC5.15 (D0), IC6.13 (2Q0)
CPL_{9}: IC2.14 (2Q1), IC5.1 (D1), IC6.14 (2Q1)
CPL_{10}: IC2.16 (2Q2), IC5.10 (D2), IC6.16 (2Q2)
CPL_{11}: IC2.17 (2Q3), IC5.9 (D3), IC6.17 (2Q3)
D0: IC2.36 (2D0), IC2.47 (1D0), IC6.36 (2D0), IC6.47 (1D0), J7.15
D1: IC2.35 (2D1), IC2.46 (1D1), IC6.35 (2D1), IC6.46 (1D1), J7.13
D2: IC2.33 (2D2), IC2.44 (1D2), IC6.33 (2D2), IC6.44 (1D2), J7.12
D3: IC2.32 (2D3), IC2.43 (1D3), IC6.32 (2D3), IC6.43 (1D3), J7.11
D4: IC2.30 (2D4), IC2.41 (1D4), IC6.30 (2D4), IC6.41 (1D4), J7.10
D5: IC2.29 (2D5), IC2.40 (1D5), IC6.29 (2D5), IC6.40 (1D5), J7.9
D6: IC2.27 (2D6), IC2.38 (1D6), IC6.27 (2D6), IC6.38 (1D6), J7.8
D7: IC2.26 (2D7), IC2.37 (1D7), IC6.26 (2D7), IC6.37 (1D7), J7.6
GND: C1.2, C2.2, C3.2, C4.2, C5.2, C6.2, C7.2, C41.2, C42.2, IC2.4 (GND), IC2.10 (GND), IC2.15 (GND), IC2.21 (GND), IC2.28 (GND), IC2.34 (GND), IC2.39 (GND), IC2.45 (GND), IC3.5 (CPU), IC3.8 (GND), IC4.5 (CPU), IC4.8 (GND), IC5.5 (CPU), IC5.8 (GND), IC6.4 (GND), IC6.10 (GND), IC6.15 (GND), IC6.21 (GND), IC6.28 (GND), IC6.34 (GND), IC6.39 (GND), IC6.45 (GND), IC36.2 (GND), J7.7, J7.14, J7.27, J7.34
Q0: IC3.3 (Q0), J7.25
Q1: IC3.2 (Q1), J7.26
Q2: IC3.6 (Q2), J7.28
Q3: IC3.7 (Q3), J7.29
Q4: IC4.3 (Q0), J7.30
Q5: IC4.2 (Q1), J7.31
Q6: IC4.6 (Q2), J7.32
Q7: IC4.7 (Q3), J7.33
Q8: IC5.3 (Q0), J7.20
Q9: IC5.2 (Q1), J7.19
Q10: IC5.6 (Q2), J7.37
Q11: IC5.7 (Q3), J7.38
Second Half CLK: IC3.4 (CPD), J7.18
Write Count CRC Byte High: IC6.25 (2LE), J7.39
Write Count CRC Byte Low: IC6.48 (1LE), J7.40
Write Count Data Byte High: IC2.25 (2LE), J7.1
Write Count Data Byte Low: IC2.48 (1LE), J7.2
~Load Down Count: IC3.11 (~PL), IC4.11 (~PL), IC5.11 (~PL), J7.16
~Read CRC Started: IC6.1 (1~OE), IC6.24 (2~OE), J7.4
~Read Transmit Started: IC2.1 (1~OE), IC2.24 (2~OE), J7.5
~Reset: IC3.14 (MR), IC4.14 (MR), IC5.14 (MR), J7.17
~TCD_{0..3}: IC3.13 (~TCD), IC4.4 (CPD), J7.21
~TCD_{4..7}: IC4.13 (~TCD), IC5.4 (CPD), J7.22
~TCD_{8..11}: IC5.13 (~TCD), J7.24
