andrewpaterson/658-Computer/Kicad/Computer/SNES/SNES Controller Clock/SNES Controller Clock.kicad_sch

## KiCad design Kicad/Computer/SNES/SNES Controller Clock/SNES Controller Clock.kicad_sch (2026-01-14)

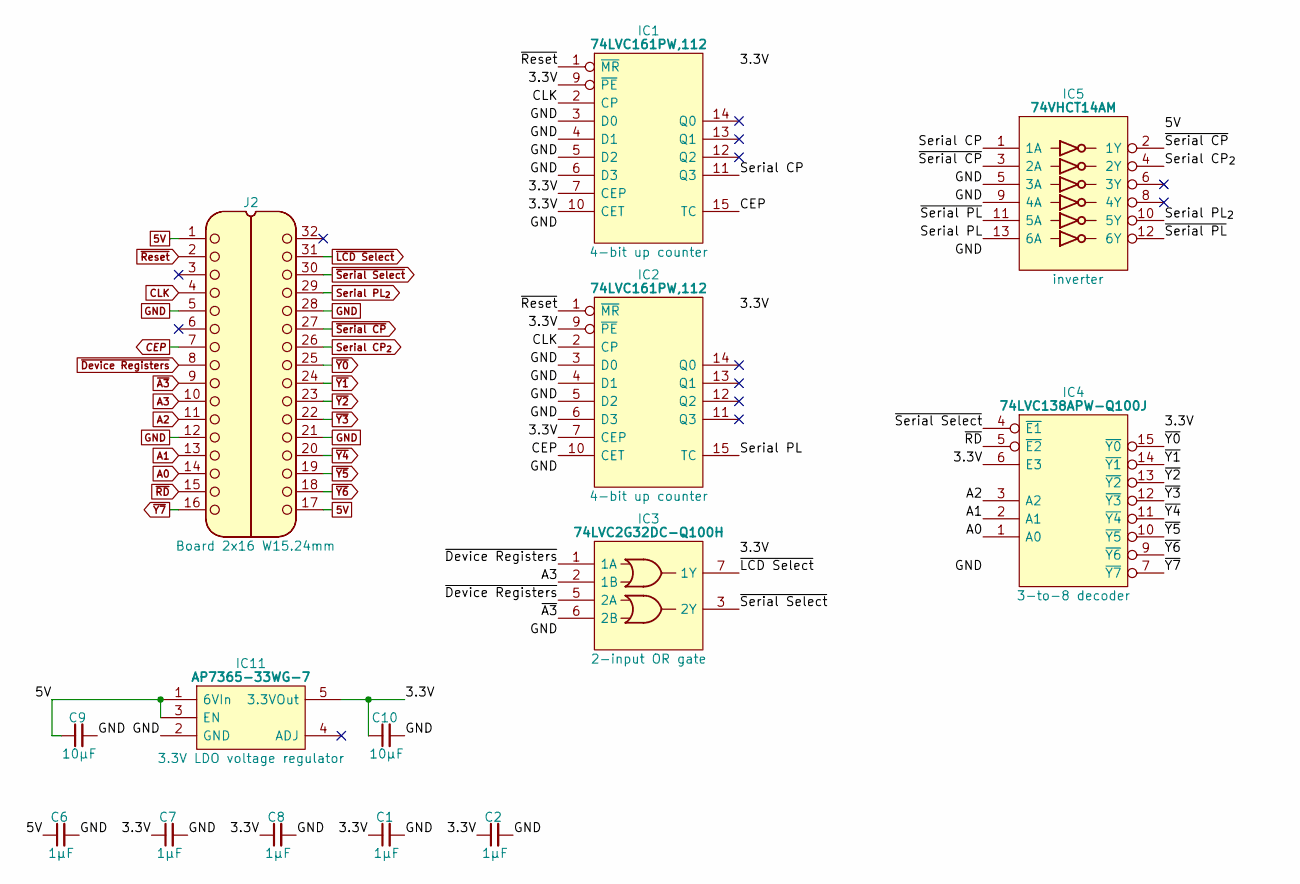
[picture p312: schematic SNES Controller Clock.kicad_sch]

Parts:
C1, C2, C6, C7, C8: 1μF; C_0805
C9, C10: 10μF; C_0805
IC1, IC2: 74LVC161PW,112; SOP65P640X110-16N; Mouser Part Number 771-LVC161PW112
IC3: 74LVC2G32DC-Q100H; SOP50P310X100-8N; Mouser Part Number 771-74LVC2G32DCQ100H
IC4: 74LVC138APW-Q100J; SOP65P640X110-16N; Mouser Part Number 771-74LVC138APWQ100J
IC5: 74VHCT14AM; SOIC127P600X175-14N; Manufacturer_Part_Number 74VHCT14AM; Mouser Part Number 512-74VHCT14AM
IC11: AP7365-33WG-7; SOT95P285X130-5N; Manufacturer_Part_Number AP7365-33WG-7; Mouser Part Number 621-AP7365-33WG-7
J2: Board 2x16 W15.24mm; DIP-32_Board_W15.24mm

Connections:
3.3V: C1.1, C2.1, C7.1, C8.1, C10.1, IC1.7 (CEP), IC1.9 (~PE), IC1.10 (CET), IC1.16 (3V), IC2.7 (CEP), IC2.9 (~PE), IC2.16 (3V), IC3.8 (VCC), IC4.6 (E3), IC4.16 (3V), IC11.5 (3.3VOut)
5V: C6.1, C9.1, IC5.14 (5V), IC11.1 (6VIn), IC11.3 (EN), J2.1, J2.17
A0: IC4.1 (A0), J2.14
A1: IC4.2 (A1), J2.13
A2: IC4.3 (A2), J2.11
A3: IC3.2 (1B), J2.10
CEP: IC1.15 (TC), IC2.10 (CET), J2.7
CLK: IC1.2 (CP), IC2.2 (CP), J2.4
GND: C1.2, C2.2, C6.2, C7.2, C8.2, C9.2, C10.2, IC1.3 (D0), IC1.4 (D1), IC1.5 (D2), IC1.6 (D3), IC1.8 (GND), IC2.3 (D0), IC2.4 (D1), IC2.5 (D2), IC2.6 (D3), IC2.8 (GND), IC3.4 (GND), IC4.8 (GND), IC5.5 (3A), IC5.7 (GND), IC5.9 (4A), IC11.2 (GND), J2.5, J2.12, J2.21, J2.28
Serial CP: IC1.11 (Q3), IC5.1 (1A)
Serial CP_{2}: IC5.4 (2Y), J2.26
Serial PL: IC2.15 (TC), IC5.13 (6A)
Serial PL_{2}: IC5.10 (5Y), J2.29
~A3: IC3.6 (2B), J2.9
~Device Registers: IC3.1 (1A), IC3.5 (2A), J2.8
~LCD Select: IC3.7 (1Y), J2.31
~RD: IC4.5 (~E2), J2.15
~Reset: IC1.1 (~MR), IC2.1 (~MR), J2.2
~Serial CP: IC5.2 (1Y), IC5.3 (2A), J2.27
~Serial PL: IC5.11 (5A), IC5.12 (6Y)
~Serial Select: IC3.3 (2Y), IC4.4 (~E1), J2.30
~Y0: IC4.15 (~Y0), J2.25
~Y1: IC4.14 (~Y1), J2.24
~Y2: IC4.13 (~Y2), J2.23
~Y3: IC4.12 (~Y3), J2.22
~Y4: IC4.11 (~Y4), J2.20
~Y5: IC4.10 (~Y5), J2.19
~Y6: IC4.9 (~Y6), J2.18
~Y7: IC4.7 (~Y7), J2.16
