andrewpaterson/658-Computer/Kicad/Computer/Video/Address Selector 24bit/Address Selector 24bit.kicad_sch

## KiCad design Kicad/Computer/Video/Address Selector 24bit/Address Selector 24bit.kicad_sch (2024-01-22)

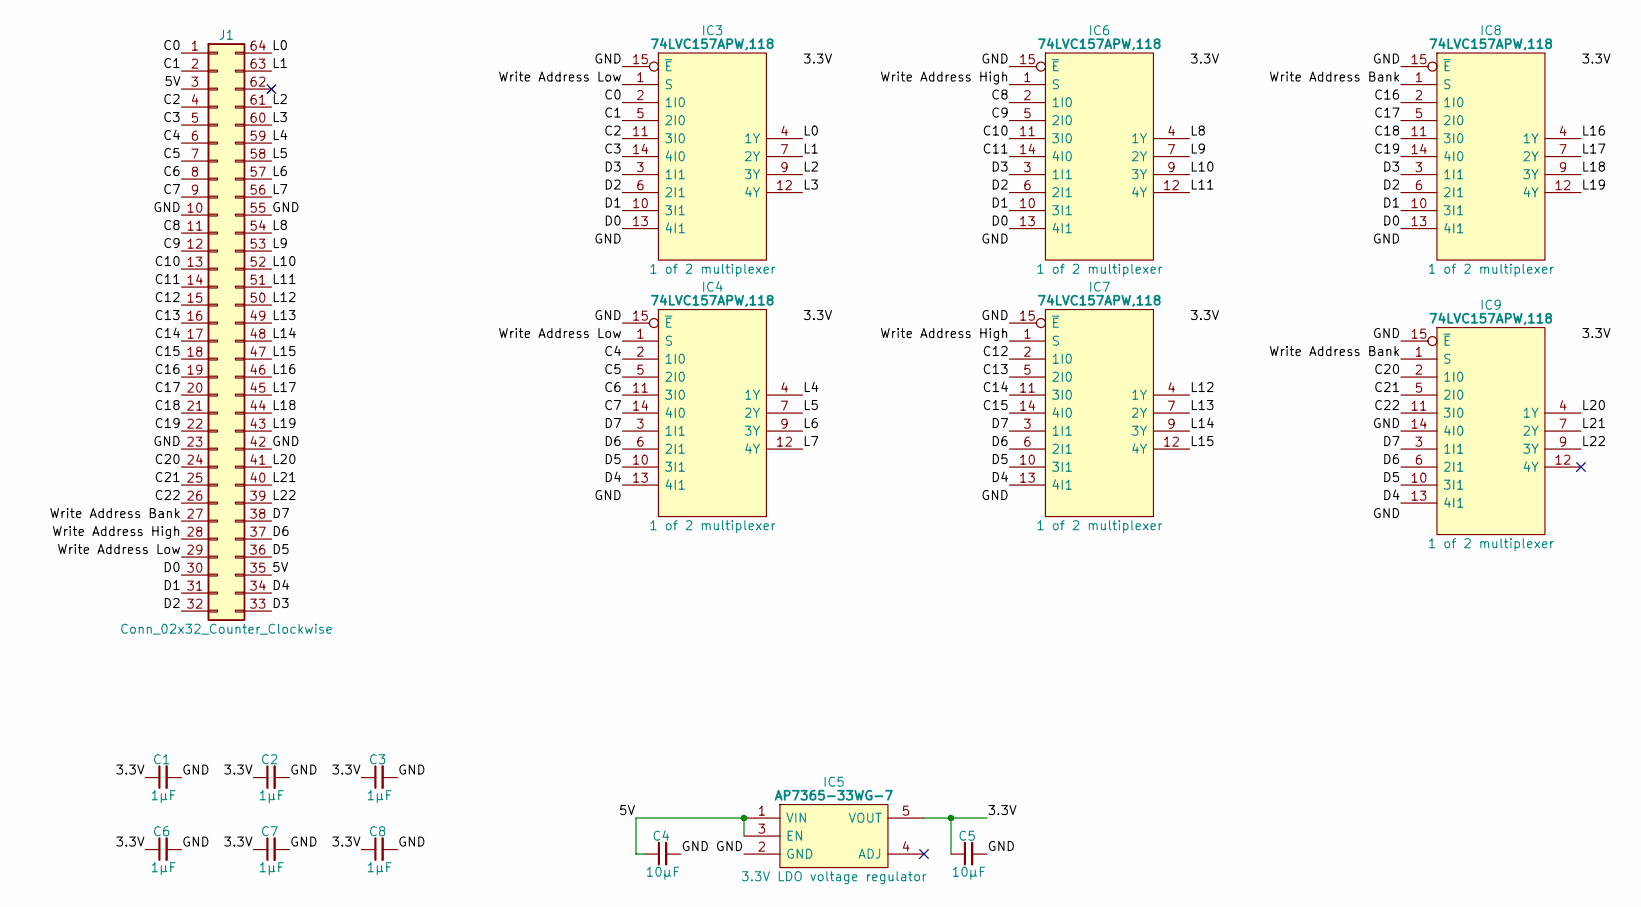
[picture p317: schematic Address Selector 24bit.kicad_sch]

Parts:
C1, C2, C3, C6, C7, C8: 1μF; C_0805
C4, C5: 10µF; C_0805
IC3, IC4, IC6, IC7, IC8, IC9: 74LVC157APW,118; SOP65P640X110-16N; Mouser Part Number 771-74LVC157APW-T
IC5: AP7365-33WG-7; SOT95P285X130-5N; Manufacturer_Part_Number AP7365-33WG-7; Mouser Part Number 621-AP7365-33WG-7
J1: Conn_02x32_Counter_Clockwise; DIP-64_Board_W15.24mm

Connections:
3.3V: C1.1, C2.1, C3.1, C5.1, C6.1, C7.1, C8.1, IC3.16 (3V), IC4.16 (3V), IC5.5 (VOUT), IC6.16 (3V), IC7.16 (3V), IC8.16 (3V), IC9.16 (3V)
5V: C4.1, IC5.1 (VIN), IC5.3 (EN), J1.3, J1.35
C0: IC3.2 (1I0), J1.1
C1: IC3.5 (2I0), J1.2
C2: IC3.11 (3I0), J1.4
C3: IC3.14 (4I0), J1.5
C4: IC4.2 (1I0), J1.6
C5: IC4.5 (2I0), J1.7
C6: IC4.11 (3I0), J1.8
C7: IC4.14 (4I0), J1.9
C8: IC6.2 (1I0), J1.11
C9: IC6.5 (2I0), J1.12
C10: IC6.11 (3I0), J1.13
C11: IC6.14 (4I0), J1.14
C12: IC7.2 (1I0), J1.15
C13: IC7.5 (2I0), J1.16
C14: IC7.11 (3I0), J1.17
C15: IC7.14 (4I0), J1.18
C16: IC8.2 (1I0), J1.19
C17: IC8.5 (2I0), J1.20
C18: IC8.11 (3I0), J1.21
C19: IC8.14 (4I0), J1.22
C20: IC9.2 (1I0), J1.24
C21: IC9.5 (2I0), J1.25
C22: IC9.11 (3I0), J1.26
D0: IC3.13 (4I1), IC6.13 (4I1), IC8.13 (4I1), J1.30
D1: IC3.10 (3I1), IC6.10 (3I1), IC8.10 (3I1), J1.31
D2: IC3.6 (2I1), IC6.6 (2I1), IC8.6 (2I1), J1.32
D3: IC3.3 (1I1), IC6.3 (1I1), IC8.3 (1I1), J1.33
D4: IC4.13 (4I1), IC7.13 (4I1), IC9.13 (4I1), J1.34
D5: IC4.10 (3I1), IC7.10 (3I1), IC9.10 (3I1), J1.36
D6: IC4.6 (2I1), IC7.6 (2I1), IC9.6 (2I1), J1.37
D7: IC4.3 (1I1), IC7.3 (1I1), IC9.3 (1I1), J1.38
GND: C1.2, C2.2, C3.2, C4.2, C5.2, C6.2, C7.2, C8.2, IC3.8 (GND), IC3.15 (~E), IC4.8 (GND), IC4.15 (~E), IC5.2 (GND), IC6.8 (GND), IC6.15 (~E), IC7.8 (GND), IC7.15 (~E), IC8.8 (GND), IC8.15 (~E), IC9.8 (GND), IC9.14 (4I0), IC9.15 (~E), J1.10, J1.23, J1.42, J1.55
L0: IC3.4 (1Y), J1.64
L1: IC3.7 (2Y), J1.63
L2: IC3.9 (3Y), J1.61
L3: IC3.12 (4Y), J1.60
L4: IC4.4 (1Y), J1.59
L5: IC4.7 (2Y), J1.58
L6: IC4.9 (3Y), J1.57
L7: IC4.12 (4Y), J1.56
L8: IC6.4 (1Y), J1.54
L9: IC6.7 (2Y), J1.53
L10: IC6.9 (3Y), J1.52
L11: IC6.12 (4Y), J1.51
L12: IC7.4 (1Y), J1.50
L13: IC7.7 (2Y), J1.49
L14: IC7.9 (3Y), J1.48
L15: IC7.12 (4Y), J1.47
L16: IC8.4 (1Y), J1.46
L17: IC8.7 (2Y), J1.45
L18: IC8.9 (3Y), J1.44
L19: IC8.12 (4Y), J1.43
L20: IC9.4 (1Y), J1.41
L21: IC9.7 (2Y), J1.40
L22: IC9.9 (3Y), J1.39
Write Address Bank: IC8.1 (S), IC9.1 (S), J1.27
Write Address High: IC6.1 (S), IC7.1 (S), J1.28
Write Address Low: IC3.1 (S), IC4.1 (S), J1.29
