andrewpaterson/658-Computer/Kicad/Computer/Video/Video Blank and Sync/Video Blank and Sync.kicad_sch

## KiCad design Kicad/Computer/Video/Video Blank and Sync/Video Blank and Sync.kicad_sch (2026-01-15)

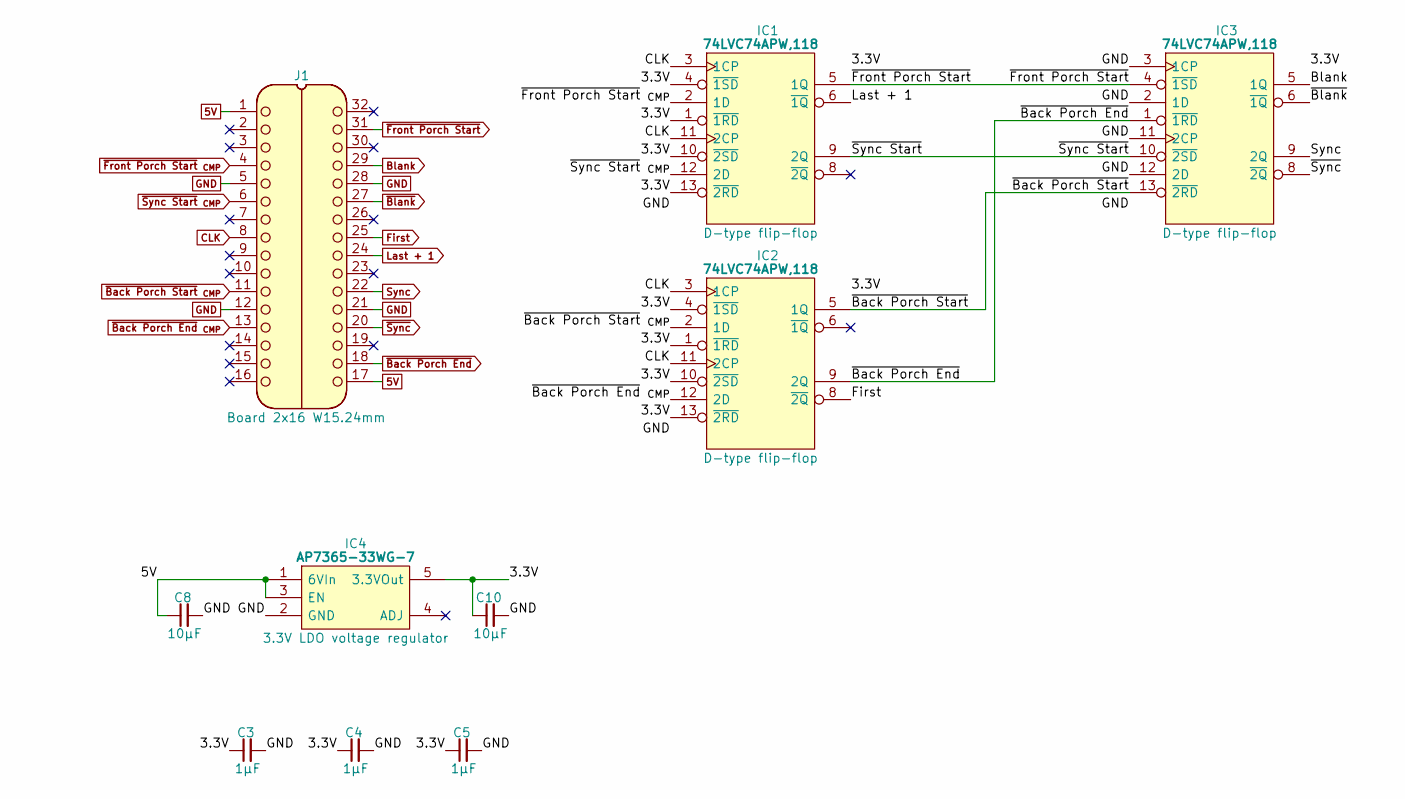
[picture p319: schematic Video Blank and Sync.kicad_sch]

Parts:
C3, C4, C5: 1μF; C_0805
C8, C10: 10µF; C_0805
IC1, IC2, IC3: 74LVC74APW,118; SOP65P640X110-14N; Mouser Part Number 771-74LVC74APW-T
IC4: AP7365-33WG-7; SOT95P285X130-5N; Manufacturer_Part_Number AP7365-33WG-7; Mouser Part Number 621-AP7365-33WG-7
J1: Board 2x16 W15.24mm; DIP-32_Board_W15.24mm

Connections:
3.3V: C3.1, C4.1, C5.1, C10.1, IC1.1 (~1RD), IC1.4 (~1SD), IC1.10 (~2SD), IC1.13 (~2RD), IC1.14 (3V), IC2.1 (~1RD), IC2.4 (~1SD), IC2.10 (~2SD), IC2.13 (~2RD), IC2.14 (3V), IC3.14 (3V), IC4.5 (3.3VOut)
5V: C8.1, IC4.1 (6VIn), IC4.3 (EN), J1.1, J1.17
Blank: IC3.5 (1Q), J1.29
CLK: IC1.3 (1CP), IC1.11 (2CP), IC2.3 (1CP), IC2.11 (2CP), J1.8
First: IC2.8 (~2Q), J1.25
GND: C3.2, C4.2, C5.2, C8.2, C10.2, IC1.7 (GND), IC2.7 (GND), IC3.2 (1D), IC3.3 (1CP), IC3.7 (GND), IC3.11 (2CP), IC3.12 (2D), IC4.2 (GND), J1.5, J1.12, J1.21, J1.28
Last + 1: IC1.6 (~1Q), J1.24
Sync: IC3.9 (2Q), J1.22
~Back Porch End: IC2.9 (2Q), IC3.1 (~1RD), J1.18
~Back Porch End _{CMP}: IC2.12 (2D), J1.13
~Back Porch Start: IC2.5 (1Q), IC3.13 (~2RD)
~Back Porch Start _{CMP}: IC2.2 (1D), J1.11
~Blank: IC3.6 (~1Q), J1.27
~Front Porch Start: IC1.5 (1Q), IC3.4 (~1SD), J1.31
~Front Porch Start _{CMP}: IC1.2 (1D), J1.4
~Sync Start: IC1.9 (2Q), IC3.10 (~2SD)
~Sync Start _{CMP}: IC1.12 (2D), J1.6
~Sync: IC3.8 (~2Q), J1.20
