andrewpaterson/658-Computer/Kicad/Computer/Video/Video Board - Memory/Video Board - Memory.kicad_sch

## KiCad design Kicad/Computer/Video/Video Board - Memory/Video Board - Memory.kicad_sch (2026-01-20)

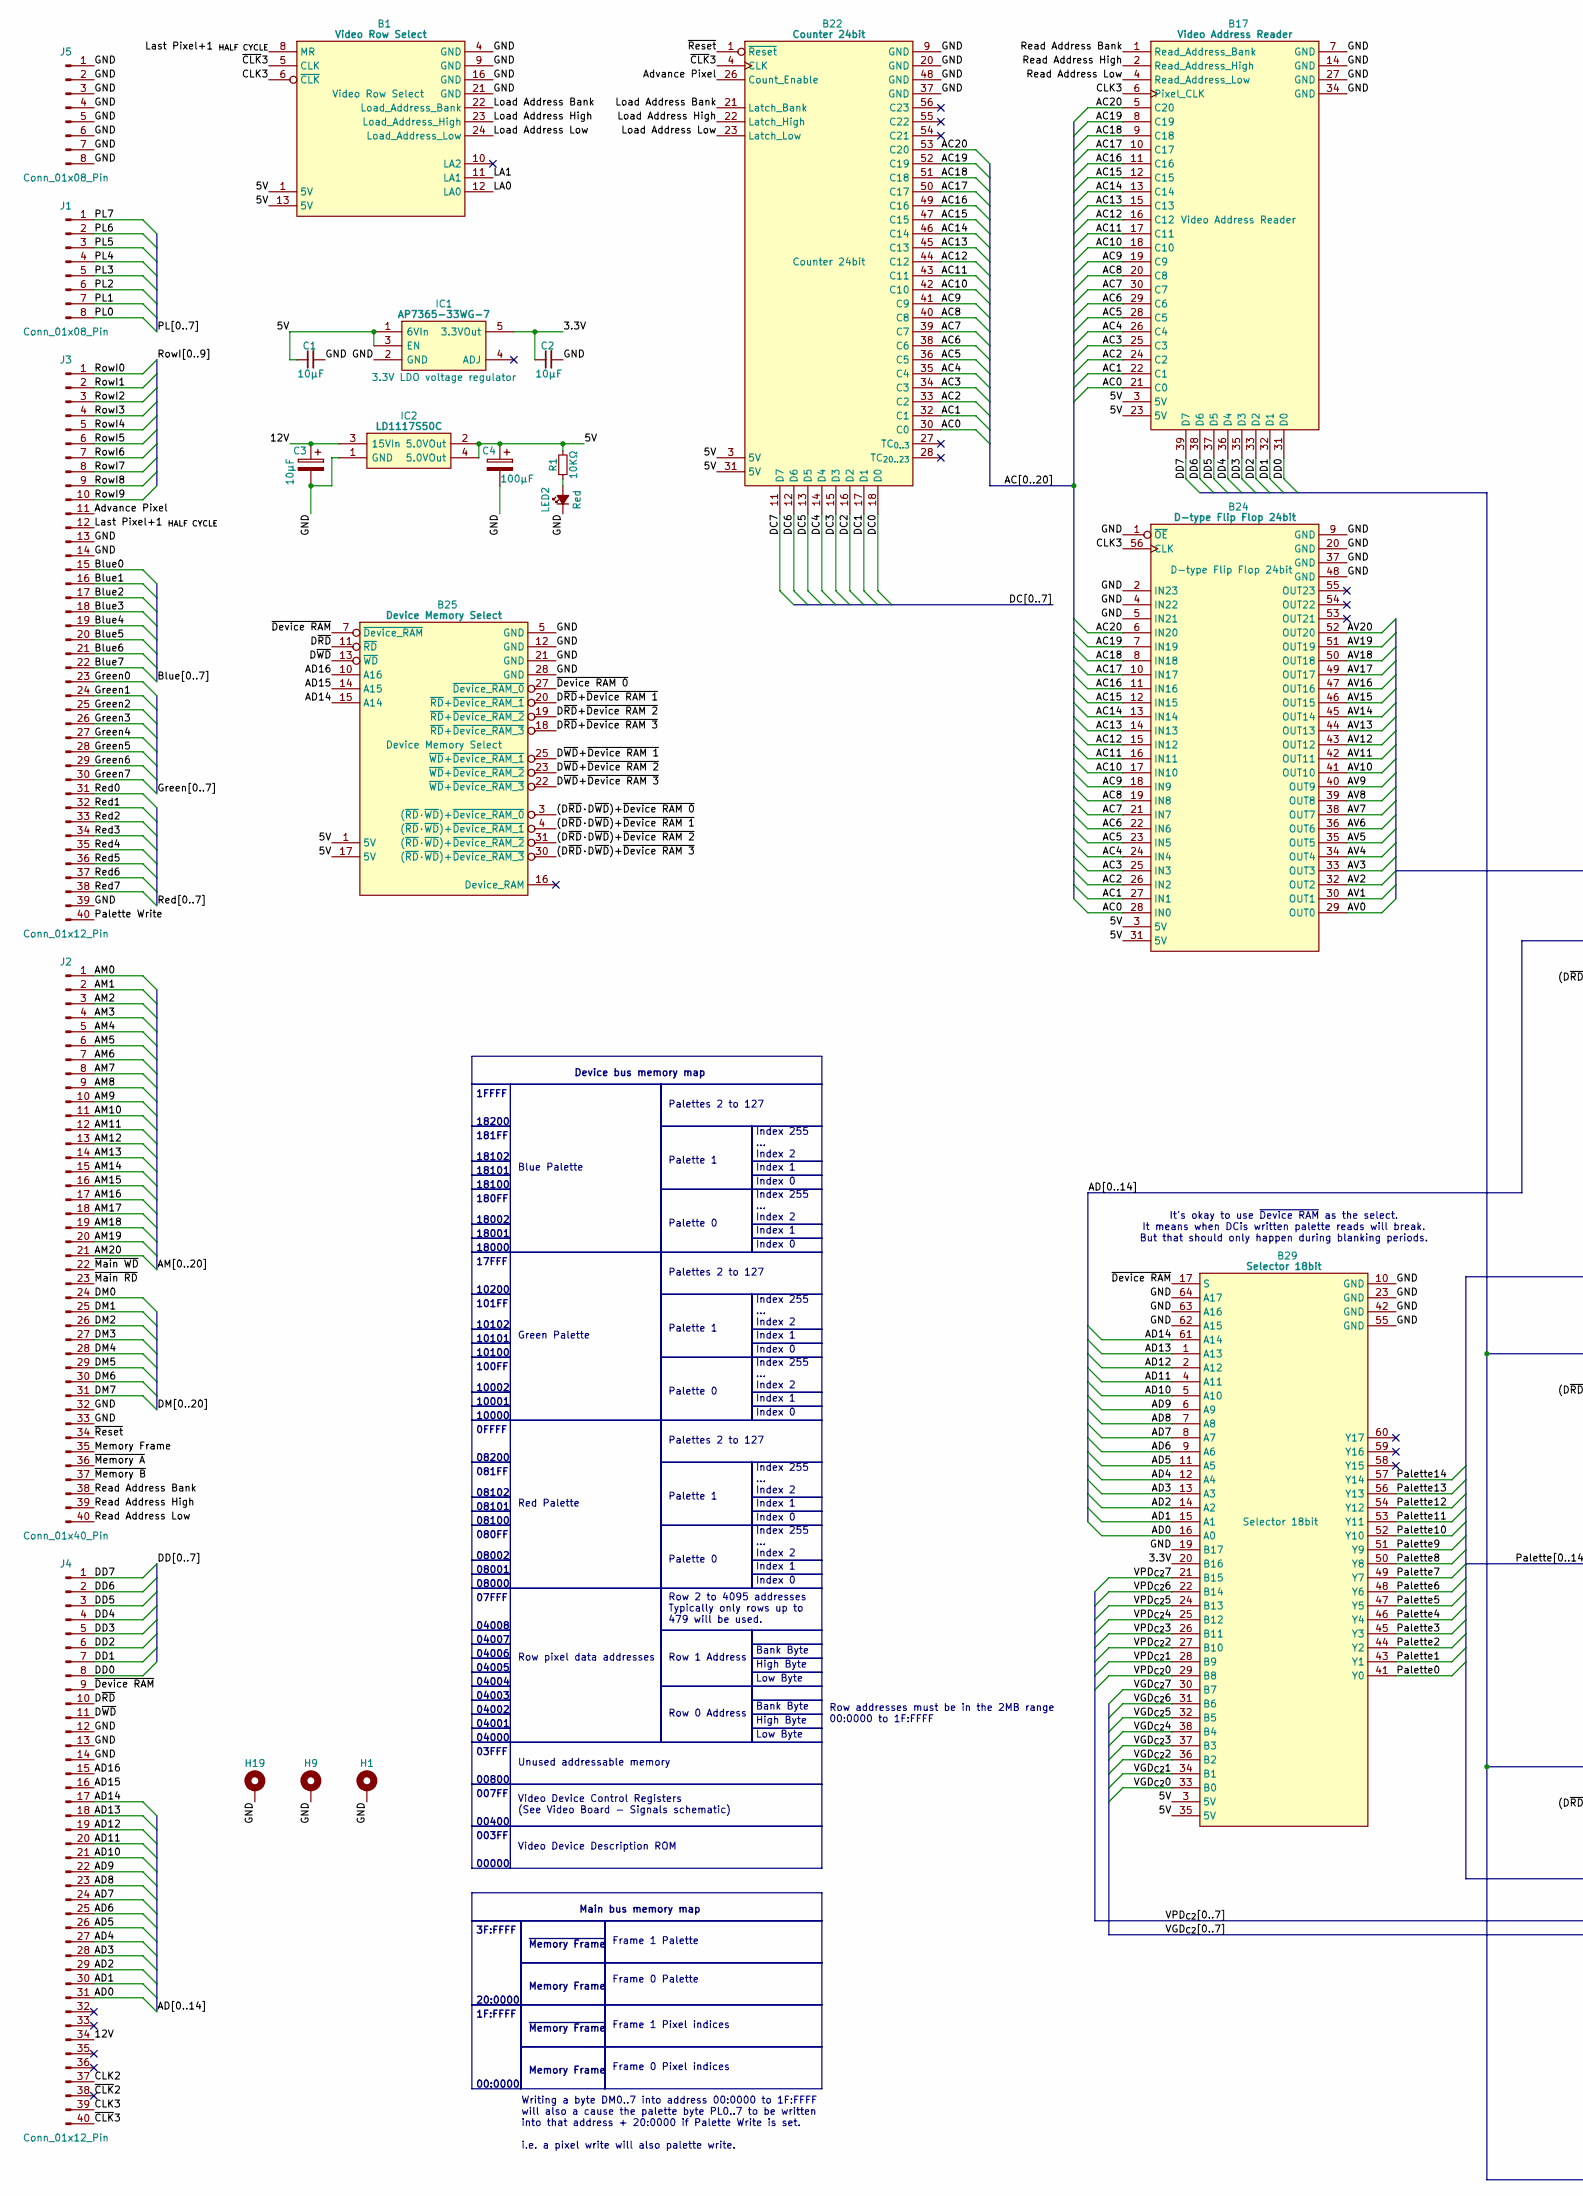
[picture p320: schematic Video Board - Memory.kicad_sch, part in row 1, column 1]

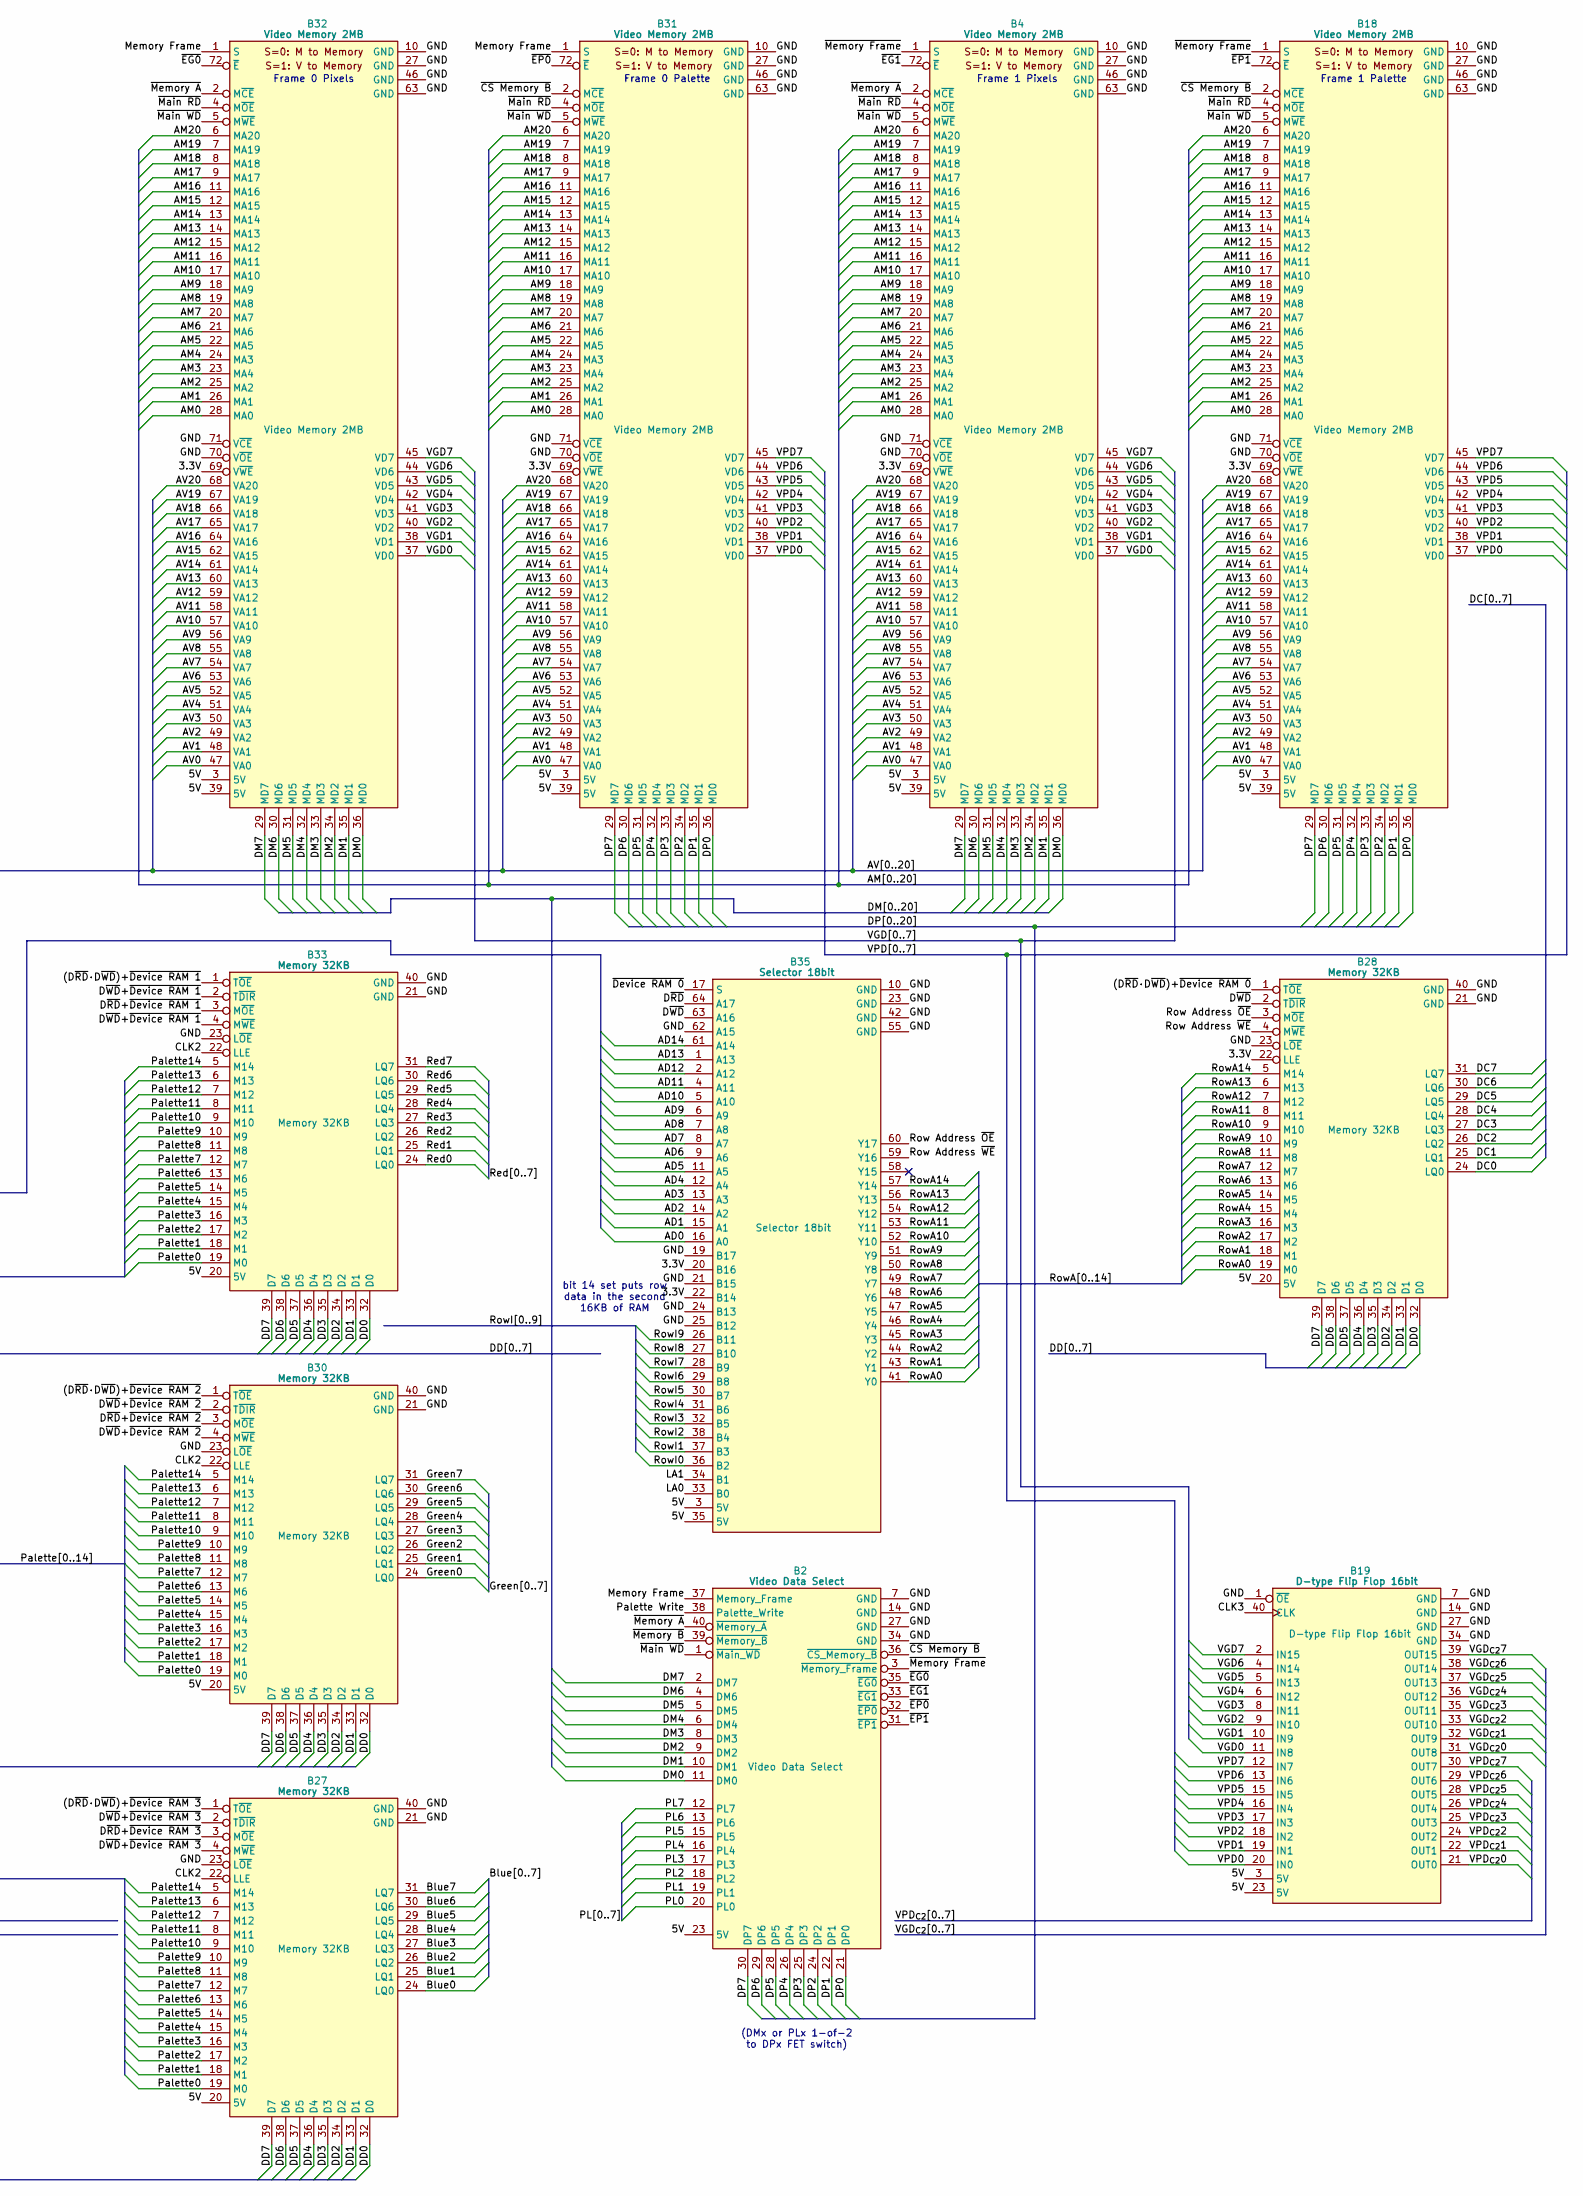
[picture p321: schematic Video Board - Memory.kicad_sch, part in row 1, column 2]

Parts:
B1: Video Row Select; HCP65_Video_Row_Select
B2: Video Data Select; HCP65_Video_Data_Select
B4, B18, B31, B32: Video Memory 2MB; HCP65_Video_Memory_2MB
B17: Video Address Reader; HCP65_Video_Address_Reader
B19: D-type Flip Flop 16bit; HCP65_D_Flip_Flop_16bit
B22: Counter 24bit; HCP65_Counter_24bit
B24: D-type Flip Flop 24bit; HCP65_D_Flip_Flop_24bit
B25: Device Memory Select; HCP65_Video_Device_RAM_Select
B27, B28, B30, B33: Memory 32KB; HCP65_Memory_32KB_With_Latch
B29, B35: Selector 18bit; HCP65_Selector_18bit
C1, C2: 10µF; C_0805
C3: 10μF; CP_Radial_D4.0mm_P2.00mm
C4: 100μF; CP_Radial_D4.0mm_P2.00mm
H1, H9, H19: MountingHole_Pad; HCP65_MountingHole_M3_
IC1: AP7365-33WG-7; SOT95P285X130-5N; Manufacturer_Part_Number AP7365-33WG-7; Mouser Part Number 621-AP7365-33WG-7
IC2: LD1117S50C; LD1117S33C; Manufacturer_Part_Number LD1117S50C
J1, J5: Conn_01x08_Pin; PinSocket_2x04_P2.54mm_Vertical
J2: Conn_01x40_Pin; PinSocket_2x20_P2.54mm_Vertical
J3, J4: Conn_01x12_Pin; PinSocket_2x20_P2.54mm_Vertical
LED2: Red; LED_D5.0mm
R1: 10KΩ; R_0805

Connections:
3.3V: B4.69 (V~WE), B18.69 (V~WE), B28.22 (LLE), B29.20 (B16), B31.69 (V~WE), B32.69 (V~WE), B35.20 (B16), B35.22 (B14), C2.1, IC1.5 (3.3VOut)
5V: B1.1 (5V), B1.13 (5V), B2.23 (5V), B4.3 (5V), B4.39 (5V), B17.3 (5V), B17.23 (5V), B18.3 (5V), B18.39 (5V), B19.3 (5V), B19.23 (5V), B22.3 (5V), B22.31 (5V), B24.3 (5V), B24.31 (5V), B25.1 (5V), B25.17 (5V), B27.20 (5V), B28.20 (5V), B29.3 (5V), B29.35 (5V), B30.20 (5V), B31.3 (5V), B31.39 (5V), B32.3 (5V), B32.39 (5V), B33.20 (5V), B35.3 (5V), B35.35 (5V), C1.1, C4.1, IC1.1 (6VIn), IC1.3 (EN), IC2.2 (5.0VOut), IC2.4 (5.0VOut), R1.2
12V: C3.1, IC2.3 (15VIn), J4.34
(D~RD·D~WD)+~Device RAM 0: B25.3 ((~RD·~WD)+~Device_RAM_0), B28.1 (T~OE)
(D~RD·D~WD)+~Device RAM 1: B25.4 ((~RD·~WD)+~Device_RAM_1), B33.1 (T~OE)
(D~RD·D~WD)+~Device RAM 2: B25.31 ((~RD·~WD)+~Device_RAM_2), B30.1 (T~OE)
(D~RD·D~WD)+~Device RAM 3: B25.30 ((~RD·~WD)+~Device_RAM_3), B27.1 (T~OE)
AC0: B17.21 (C0), B22.30 (C0), B24.28 (IN0)
AC1: B17.22 (C1), B22.32 (C1), B24.27 (IN1)
AC2: B17.24 (C2), B22.33 (C2), B24.26 (IN2)
AC3: B17.25 (C3), B22.34 (C3), B24.25 (IN3)
AC4: B17.26 (C4), B22.35 (C4), B24.24 (IN4)
AC5: B17.28 (C5), B22.36 (C5), B24.23 (IN5)
AC6: B17.29 (C6), B22.38 (C6), B24.22 (IN6)
AC7: B17.30 (C7), B22.39 (C7), B24.21 (IN7)
AC8: B17.20 (C8), B22.40 (C8), B24.19 (IN8)
AC9: B17.19 (C9), B22.41 (C9), B24.18 (IN9)
AC10: B17.18 (C10), B22.42 (C10), B24.17 (IN10)
AC11: B17.17 (C11), B22.43 (C11), B24.16 (IN11)
AC12: B17.16 (C12), B22.44 (C12), B24.15 (IN12)
AC13: B17.15 (C13), B22.45 (C13), B24.14 (IN13)
AC14: B17.13 (C14), B22.46 (C14), B24.13 (IN14)
AC15: B17.12 (C15), B22.47 (C15), B24.12 (IN15)
AC16: B17.11 (C16), B22.49 (C16), B24.11 (IN16)
AC17: B17.10 (C17), B22.50 (C17), B24.10 (IN17)
AC18: B17.9 (C18), B22.51 (C18), B24.8 (IN18)
AC19: B17.8 (C19), B22.52 (C19), B24.7 (IN19)
AC20: B17.5 (C20), B22.53 (C20), B24.6 (IN20)
AD0: B29.16 (A0), B35.16 (A0), J4.31
AD1: B29.15 (A1), B35.15 (A1), J4.30
AD2: B29.14 (A2), B35.14 (A2), J4.29
AD3: B29.13 (A3), B35.13 (A3), J4.28
AD4: B29.12 (A4), B35.12 (A4), J4.27
AD5: B29.11 (A5), B35.11 (A5), J4.26
AD6: B29.9 (A6), B35.9 (A6), J4.25
AD7: B29.8 (A7), B35.8 (A7), J4.24
AD8: B29.7 (A8), B35.7 (A8), J4.23
AD9: B29.6 (A9), B35.6 (A9), J4.22
AD10: B29.5 (A10), B35.5 (A10), J4.21
AD11: B29.4 (A11), B35.4 (A11), J4.20
AD12: B29.2 (A12), B35.2 (A12), J4.19
AD13: B29.1 (A13), B35.1 (A13), J4.18
AD14: B25.15 (A14), B29.61 (A14), B35.61 (A14), J4.17
AD15: B25.14 (A15), J4.16
AD16: B25.10 (A16), J4.15
AM0: B4.28 (MA0), B18.28 (MA0), B31.28 (MA0), B32.28 (MA0), J2.1
AM1: B4.26 (MA1), B18.26 (MA1), B31.26 (MA1), B32.26 (MA1), J2.2
AM2: B4.25 (MA2), B18.25 (MA2), B31.25 (MA2), B32.25 (MA2), J2.3
AM3: B4.23 (MA4), B18.23 (MA4), B31.23 (MA4), B32.23 (MA4), J2.4
AM4: B4.24 (MA3), B18.24 (MA3), B31.24 (MA3), B32.24 (MA3), J2.5
AM5: B4.22 (MA5), B18.22 (MA5), B31.22 (MA5), B32.22 (MA5), J2.6
AM6: B4.21 (MA6), B18.21 (MA6), B31.21 (MA6), B32.21 (MA6), J2.7
AM7: B4.20 (MA7), B18.20 (MA7), B31.20 (MA7), B32.20 (MA7), J2.8
AM8: B4.19 (MA8), B18.19 (MA8), B31.19 (MA8), B32.19 (MA8), J2.9
AM9: B4.18 (MA9), B18.18 (MA9), B31.18 (MA9), B32.18 (MA9), J2.10
AM10: B4.17 (MA10), B18.17 (MA10), B31.17 (MA10), B32.17 (MA10), J2.11
AM11: B4.16 (MA11), B18.16 (MA11), B31.16 (MA11), B32.16 (MA11), J2.12
AM12: B4.15 (MA12), B18.15 (MA12), B31.15 (MA12), B32.15 (MA12), J2.13
AM13: B4.14 (MA13), B18.14 (MA13), B31.14 (MA13), B32.14 (MA13), J2.14
AM14: B4.13 (MA14), B18.13 (MA14), B31.13 (MA14), B32.13 (MA14), J2.15
AM15: B4.12 (MA15), B18.12 (MA15), B31.12 (MA15), B32.12 (MA15), J2.16
AM16: B4.11 (MA16), B18.11 (MA16), B31.11 (MA16), B32.11 (MA16), J2.17
AM17: B4.9 (MA17), B18.9 (MA17), B31.9 (MA17), B32.9 (MA17), J2.18
AM18: B4.8 (MA18), B18.8 (MA18), B31.8 (MA18), B32.8 (MA18), J2.19
AM19: B4.7 (MA19), B18.7 (MA19), B31.7 (MA19), B32.7 (MA19), J2.20
AM20: B4.6 (MA20), B18.6 (MA20), B31.6 (MA20), B32.6 (MA20), J2.21
AV0: B4.47 (VA0), B18.47 (VA0), B24.29 (OUT0), B31.47 (VA0), B32.47 (VA0)
AV1: B4.48 (VA1), B18.48 (VA1), B24.30 (OUT1), B31.48 (VA1), B32.48 (VA1)
AV2: B4.49 (VA2), B18.49 (VA2), B24.32 (OUT2), B31.49 (VA2), B32.49 (VA2)
AV3: B4.50 (VA3), B18.50 (VA3), B24.33 (OUT3), B31.50 (VA3), B32.50 (VA3)
AV4: B4.51 (VA4), B18.51 (VA4), B24.34 (OUT4), B31.51 (VA4), B32.51 (VA4)
AV5: B4.52 (VA5), B18.52 (VA5), B24.35 (OUT5), B31.52 (VA5), B32.52 (VA5)
AV6: B4.53 (VA6), B18.53 (VA6), B24.36 (OUT6), B31.53 (VA6), B32.53 (VA6)
AV7: B4.54 (VA7), B18.54 (VA7), B24.38 (OUT7), B31.54 (VA7), B32.54 (VA7)
AV8: B4.55 (VA8), B18.55 (VA8), B24.39 (OUT8), B31.55 (VA8), B32.55 (VA8)
AV9: B4.56 (VA9), B18.56 (VA9), B24.40 (OUT9), B31.56 (VA9), B32.56 (VA9)
AV10: B4.57 (VA10), B18.57 (VA10), B24.41 (OUT10), B31.57 (VA10), B32.57 (VA10)
AV11: B4.58 (VA11), B18.58 (VA11), B24.42 (OUT11), B31.58 (VA11), B32.58 (VA11)
AV12: B4.59 (VA12), B18.59 (VA12), B24.43 (OUT12), B31.59 (VA12), B32.59 (VA12)
AV13: B4.60 (VA13), B18.60 (VA13), B24.44 (OUT13), B31.60 (VA13), B32.60 (VA13)
AV14: B4.61 (VA14), B18.61 (VA14), B24.45 (OUT14), B31.61 (VA14), B32.61 (VA14)
AV15: B4.62 (VA15), B18.62 (VA15), B24.46 (OUT15), B31.62 (VA15), B32.62 (VA15)
AV16: B4.64 (VA16), B18.64 (VA16), B24.47 (OUT16), B31.64 (VA16), B32.64 (VA16)
AV17: B4.65 (VA17), B18.65 (VA17), B24.49 (OUT17), B31.65 (VA17), B32.65 (VA17)
AV18: B4.66 (VA18), B18.66 (VA18), B24.50 (OUT18), B31.66 (VA18), B32.66 (VA18)
AV19: B4.67 (VA19), B18.67 (VA19), B24.51 (OUT19), B31.67 (VA19), B32.67 (VA19)
AV20: B4.68 (VA20), B18.68 (VA20), B24.52 (OUT20), B31.68 (VA20), B32.68 (VA20)
Advance Pixel: B22.26 (Count_Enable), J3.11
Blue0: B27.24 (LQ0), J3.15
Blue1: B27.25 (LQ1), J3.16
Blue2: B27.26 (LQ2), J3.17
Blue3: B27.27 (LQ3), J3.18
Blue4: B27.28 (LQ4), J3.19
Blue5: B27.29 (LQ5), J3.20
Blue6: B27.30 (LQ6), J3.21
Blue7: B27.31 (LQ7), J3.22
CLK2: B27.22 (LLE), B30.22 (LLE), B33.22 (LLE), J4.37
CLK3: B1.6 (~CLK), B17.6 (Pixel_CLK), B19.40 (CLK), B24.56 (CLK), J4.39
DC0: B22.18 (D0), B28.24 (LQ0)
DC1: B22.17 (D1), B28.25 (LQ1)
DC2: B22.16 (D2), B28.26 (LQ2)
DC3: B22.15 (D3), B28.27 (LQ3)
DC4: B22.14 (D4), B28.28 (LQ4)
DC5: B22.13 (D5), B28.29 (LQ5)
DC6: B22.12 (D6), B28.30 (LQ6)
DC7: B22.11 (D7), B28.31 (LQ7)
DD0: B17.31 (D0), B27.32 (D0), B28.32 (D0), B30.32 (D0), B33.32 (D0), J4.8
DD1: B17.32 (D1), B27.33 (D1), B28.33 (D1), B30.33 (D1), B33.33 (D1), J4.7
DD2: B17.33 (D2), B27.34 (D2), B28.34 (D2), B30.34 (D2), B33.34 (D2), J4.6
DD3: B17.35 (D3), B27.35 (D3), B28.35 (D3), B30.35 (D3), B33.35 (D3), J4.5
DD4: B17.36 (D4), B27.36 (D4), B28.36 (D4), B30.36 (D4), B33.36 (D4), J4.4
DD5: B17.37 (D5), B27.37 (D5), B28.37 (D5), B30.37 (D5), B33.37 (D5), J4.3
DD6: B17.38 (D6), B27.38 (D6), B28.38 (D6), B30.38 (D6), B33.38 (D6), J4.2
DD7: B17.39 (D7), B27.39 (D7), B28.39 (D7), B30.39 (D7), B33.39 (D7), J4.1
DM0: B2.11 (DM0), B4.36 (MD0), B32.36 (MD0), J2.24
DM1: B2.10 (DM1), B4.35 (MD1), B32.35 (MD1), J2.25
DM2: B2.9 (DM2), B4.34 (MD2), B32.34 (MD2), J2.26
DM3: B2.8 (DM3), B4.33 (MD3), B32.33 (MD3), J2.27
DM4: B2.6 (DM4), B4.32 (MD4), B32.32 (MD4), J2.28
DM5: B2.5 (DM5), B4.31 (MD5), B32.31 (MD5), J2.29
DM6: B2.4 (DM6), B4.30 (MD6), B32.30 (MD6), J2.30
DM7: B2.2 (DM7), B4.29 (MD7), B32.29 (MD7), J2.31
DP0: B2.21 (DP0), B18.36 (MD0), B31.36 (MD0)
DP1: B2.22 (DP1), B18.35 (MD1), B31.35 (MD1)
DP2: B2.24 (DP2), B18.34 (MD2), B31.34 (MD2)
DP3: B2.25 (DP3), B18.33 (MD3), B31.33 (MD3)
DP4: B2.26 (DP4), B18.32 (MD4), B31.32 (MD4)
DP5: B2.28 (DP5), B18.31 (MD5), B31.31 (MD5)
DP6: B2.29 (DP6), B18.30 (MD6), B31.30 (MD6)
DP7: B2.30 (DP7), B18.29 (MD7), B31.29 (MD7)
D~RD: B25.11 (~RD), B35.64 (A17), J4.10
D~RD+~Device RAM 1: B25.20 (~RD+~Device_RAM_1), B33.3 (M~OE)
D~RD+~Device RAM 2: B25.19 (~RD+~Device_RAM_2), B30.3 (M~OE)
D~RD+~Device RAM 3: B25.18 (~RD+~Device_RAM_3), B27.3 (M~OE)
D~WD: B25.13 (~WD), B28.2 (T~DIR), B35.63 (A16), J4.11
D~WD+~Device RAM 1: B25.25 (~WD+~Device_RAM_1), B33.2 (T~DIR), B33.4 (M~WE)
D~WD+~Device RAM 2: B25.23 (~WD+~Device_RAM_2), B30.2 (T~DIR), B30.4 (M~WE)
D~WD+~Device RAM 3: B25.22 (~WD+~Device_RAM_3), B27.2 (T~DIR), B27.4 (M~WE)
GND: B1.4 (GND), B1.9 (GND), B1.16 (GND), B1.21 (GND), B2.7 (GND), B2.14 (GND), B2.27 (GND), B2.34 (GND), B4.10 (GND), B4.27 (GND), B4.46 (GND), B4.63 (GND), B4.70 (V~OE), B4.71 (V~CE), B17.7 (GND), B17.14 (GND), B17.27 (GND), B17.34 (GND), B18.10 (GND), B18.27 (GND), B18.46 (GND), B18.63 (GND), B18.70 (V~OE), B18.71 (V~CE), B19.1 (~OE), B19.7 (GND), B19.14 (GND), B19.27 (GND), B19.34 (GND), B22.9 (GND), B22.20 (GND), B22.37 (GND), B22.48 (GND), B24.1 (~OE), B24.2 (IN23), B24.4 (IN22), B24.5 (IN21), B24.9 (GND), B24.20 (GND), B24.37 (GND), B24.48 (GND), B25.5 (GND), B25.12 (GND), B25.21 (GND), B25.28 (GND), B27.21 (GND), B27.23 (L~OE), B27.40 (GND), B28.21 (GND), B28.23 (L~OE), B28.40 (GND), B29.10 (GND), B29.19 (B17), B29.23 (GND), B29.42 (GND), B29.55 (GND), B29.62 (A15), B29.63 (A16), B29.64 (A17), B30.21 (GND), B30.23 (L~OE), B30.40 (GND), B31.10 (GND), B31.27 (GND), B31.46 (GND), B31.63 (GND), B31.70 (V~OE), B31.71 (V~CE), B32.10 (GND), B32.27 (GND), B32.46 (GND), B32.63 (GND), B32.70 (V~OE), B32.71 (V~CE), B33.21 (GND), B33.23 (L~OE), B33.40 (GND), B35.10 (GND), B35.19 (B17), B35.21 (B15), B35.23 (GND), B35.24 (B13), B35.25 (B12), B35.42 (GND), B35.55 (GND), B35.62 (A15), C1.2, C2.2, C3.2, C4.2, H1.1, H9.1, H19.1, IC1.2 (GND), IC2.1 (GND), J2.32, J2.33, J3.13, J3.14, J3.39, J4.12, J4.13, J4.14, J5.1, J5.2, J5.3, J5.4, J5.5, J5.6, J5.7, J5.8, LED2.1 (K)
Green0: B30.24 (LQ0), J3.23
Green1: B30.25 (LQ1), J3.24
Green2: B30.26 (LQ2), J3.25
Green3: B30.27 (LQ3), J3.26
Green4: B30.28 (LQ4), J3.27
Green5: B30.29 (LQ5), J3.28
Green6: B30.30 (LQ6), J3.29
Green7: B30.31 (LQ7), J3.30
LA0: B1.12 (LA0), B35.33 (B0)
LA1: B1.11 (LA1), B35.34 (B1)
Last Pixel+1 _{HALF CYCLE}: B1.8 (MR), J3.12
Load Address Bank: B1.22 (Load_Address_Bank), B22.21 (Latch_Bank)
Load Address High: B1.23 (Load_Address_High), B22.22 (Latch_High)
Load Address Low: B1.24 (Load_Address_Low), B22.23 (Latch_Low)
Memory Frame: B2.37 (Memory_Frame), B31.1 (S), B32.1 (S), J2.35
unnamed: LED2.2 (A), R1.1
PL0: B2.20 (PL0), J1.8
PL1: B2.19 (PL1), J1.7
PL2: B2.18 (PL2), J1.6
PL3: B2.17 (PL3), J1.5
PL4: B2.16 (PL4), J1.4
PL5: B2.15 (PL5), J1.3
PL6: B2.13 (PL6), J1.2
PL7: B2.12 (PL7), J1.1
Palette0: B27.19 (M0), B29.41 (Y0), B30.19 (M0), B33.19 (M0)
Palette1: B27.18 (M1), B29.43 (Y1), B30.18 (M1), B33.18 (M1)
Palette2: B27.17 (M2), B29.44 (Y2), B30.17 (M2), B33.17 (M2)
Palette3: B27.16 (M3), B29.45 (Y3), B30.16 (M3), B33.16 (M3)
Palette4: B27.15 (M4), B29.46 (Y4), B30.15 (M4), B33.15 (M4)
Palette5: B27.14 (M5), B29.47 (Y5), B30.14 (M5), B33.14 (M5)
Palette6: B27.13 (M6), B29.48 (Y6), B30.13 (M6), B33.13 (M6)
Palette7: B27.12 (M7), B29.49 (Y7), B30.12 (M7), B33.12 (M7)
Palette8: B27.11 (M8), B29.50 (Y8), B30.11 (M8), B33.11 (M8)
Palette9: B27.10 (M9), B29.51 (Y9), B30.10 (M9), B33.10 (M9)
Palette10: B27.9 (M10), B29.52 (Y10), B30.9 (M10), B33.9 (M10)
Palette11: B27.8 (M11), B29.53 (Y11), B30.8 (M11), B33.8 (M11)
Palette12: B27.7 (M12), B29.54 (Y12), B30.7 (M12), B33.7 (M12)
Palette13: B27.6 (M13), B29.56 (Y13), B30.6 (M13), B33.6 (M13)
Palette14: B27.5 (M14), B29.57 (Y14), B30.5 (M14), B33.5 (M14)
Palette Write: B2.38 (Palette_Write), J3.40
Read Address Bank: B17.1 (Read_Address_Bank), J2.38
Read Address High: B17.2 (Read_Address_High), J2.39
Read Address Low: B17.4 (Read_Address_Low), J2.40
Red0: B33.24 (LQ0), J3.31
Red1: B33.25 (LQ1), J3.32
Red2: B33.26 (LQ2), J3.33
Red3: B33.27 (LQ3), J3.34
Red4: B33.28 (LQ4), J3.35
Red5: B33.29 (LQ5), J3.36
Red6: B33.30 (LQ6), J3.37
Red7: B33.31 (LQ7), J3.38
Row Address ~OE: B28.3 (M~OE), B35.60 (Y17)
Row Address ~WE: B28.4 (M~WE), B35.59 (Y16)
RowA0: B28.19 (M0), B35.41 (Y0)
RowA1: B28.18 (M1), B35.43 (Y1)
RowA2: B28.17 (M2), B35.44 (Y2)
RowA3: B28.16 (M3), B35.45 (Y3)
RowA4: B28.15 (M4), B35.46 (Y4)
RowA5: B28.14 (M5), B35.47 (Y5)
RowA6: B28.13 (M6), B35.48 (Y6)
RowA7: B28.12 (M7), B35.49 (Y7)
RowA8: B28.11 (M8), B35.50 (Y8)
RowA9: B28.10 (M9), B35.51 (Y9)
RowA10: B28.9 (M10), B35.52 (Y10)
RowA11: B28.8 (M11), B35.53 (Y11)
RowA12: B28.7 (M12), B35.54 (Y12)
RowA13: B28.6 (M13), B35.56 (Y13)
RowA14: B28.5 (M14), B35.57 (Y14)
RowI0: B35.36 (B2), J3.1
RowI1: B35.37 (B3), J3.2
RowI2: B35.38 (B4), J3.3
RowI3: B35.32 (B5), J3.4
RowI4: B35.31 (B6), J3.5
RowI5: B35.30 (B7), J3.6
RowI6: B35.29 (B8), J3.7
RowI7: B35.28 (B9), J3.8
RowI8: B35.27 (B10), J3.9
RowI9: B35.26 (B11), J3.10
VGD0: B4.37 (VD0), B19.11 (IN8), B32.37 (VD0)
VGD1: B4.38 (VD1), B19.10 (IN9), B32.38 (VD1)
VGD2: B4.40 (VD2), B19.9 (IN10), B32.40 (VD2)
VGD3: B4.41 (VD3), B19.8 (IN11), B32.41 (VD3)
VGD4: B4.42 (VD4), B19.6 (IN12), B32.42 (VD4)
VGD5: B4.43 (VD5), B19.5 (IN13), B32.43 (VD5)
VGD6: B4.44 (VD6), B19.4 (IN14), B32.44 (VD6)
VGD7: B4.45 (VD7), B19.2 (IN15), B32.45 (VD7)
VGD_{C2}0: B19.31 (OUT8), B29.33 (B0)
VGD_{C2}1: B19.32 (OUT9), B29.34 (B1)
VGD_{C2}2: B19.33 (OUT10), B29.36 (B2)
VGD_{C2}3: B19.35 (OUT11), B29.37 (B3)
VGD_{C2}4: B19.36 (OUT12), B29.38 (B4)
VGD_{C2}5: B19.37 (OUT13), B29.32 (B5)
VGD_{C2}6: B19.38 (OUT14), B29.31 (B6)
VGD_{C2}7: B19.39 (OUT15), B29.30 (B7)
VPD0: B18.37 (VD0), B19.20 (IN0), B31.37 (VD0)
VPD1: B18.38 (VD1), B19.19 (IN1), B31.38 (VD1)
VPD2: B18.40 (VD2), B19.18 (IN2), B31.40 (VD2)
VPD3: B18.41 (VD3), B19.17 (IN3), B31.41 (VD3)
VPD4: B18.42 (VD4), B19.16 (IN4), B31.42 (VD4)
VPD5: B18.43 (VD5), B19.15 (IN5), B31.43 (VD5)
VPD6: B18.44 (VD6), B19.13 (IN6), B31.44 (VD6)
VPD7: B18.45 (VD7), B19.12 (IN7), B31.45 (VD7)
VPD_{C2}0: B19.21 (OUT0), B29.29 (B8)
VPD_{C2}1: B19.22 (OUT1), B29.28 (B9)
VPD_{C2}2: B19.24 (OUT2), B29.27 (B10)
VPD_{C2}3: B19.25 (OUT3), B29.26 (B11)
VPD_{C2}4: B19.26 (OUT4), B29.25 (B12)
VPD_{C2}5: B19.28 (OUT5), B29.24 (B13)
VPD_{C2}6: B19.29 (OUT6), B29.22 (B14)
VPD_{C2}7: B19.30 (OUT7), B29.21 (B15)
~CLK2: J4.38
~CLK3: B1.5 (CLK), B22.4 (CLK), J4.40
~CS Memory B: B2.36 (~CS_Memory_B), B18.2 (M~CE), B31.2 (M~CE)
~Device RAM 0: B25.27 (~Device_RAM_0), B35.17 (S)
~Device RAM: B25.7 (~Device_RAM), B29.17 (S), J4.9
~EG0: B2.35 (~EG0), B32.72 (~E)
~EG1: B2.33 (~EG1), B4.72 (~E)
~EP0: B2.32 (~EP0), B31.72 (~E)
~EP1: B2.31 (~EP1), B18.72 (~E)
~Main RD: B4.4 (M~OE), B18.4 (M~OE), B31.4 (M~OE), B32.4 (M~OE), J2.23
~Main WD: B2.1 (~Main_WD), B4.5 (M~WE), B18.5 (M~WE), B31.5 (M~WE), B32.5 (M~WE), J2.22
~Memory A: B2.40 (~Memory_A), B4.2 (M~CE), B32.2 (M~CE), J2.36
~Memory B: B2.39 (~Memory_B), J2.37
~Memory Frame: B2.3 (~Memory_Frame), B4.1 (S), B18.1 (S)
~Reset: B22.1 (~Reset), J2.34

Notes on the sheet:
181FF
18001
Palettes 2 to 127
Index 1
10000
Palette 0
10001
03FFF
Index 0
(DMx or PLx 1-of-2 to DPx FET switch)
00400
18002
08002
Video Device Control Registers (See Video Board - Signals schematic)
Memory Frame
08101
Frame 1 Palette
bit 14 set puts row data in the second 16KB of RAM
It's okay to use ~{Device RAM} as the select. It means when DCis written palette reads will break. But that should only happen during blanking periods.
180FF
Main bus memory map
04003
Frame 0 Palette
Palette 1
18101
04001
3F:FFFF
04008
Frame 1 Pixel indices
Row 0 Address
Frame 0 Pixel indices
Device bus memory map
Green Palette
1F:FFFF
101FF
Row addresses must be in the 2MB range 00:0000 to 1F:FFFF
Index 255 ... Index 2
Unused addressable memory
100FF
High Byte
Row 1 Address
Row 2 to 4095 addresses Typically only rows up to 479 will be used.
1FFFF
Blue Palette
04002
Writing a byte DM0..7 into address 00:0000 to 1F:FFFF will also a cause the palette byte PL0..7 to be written into that address + 20:0000 if Palette Write is set. i.e. a pixel write will also palette write.
081FF
Bank Byte
10200
10002
~{Memory Frame}
20:0000
Row pixel data addresses
18000
04007
08001
18200
17FFF
08200
10101
04005
Frame 1 Pixels
04004
18100
07FFF
007FF
Red Palette
04006
Video Device Description ROM
00800
08100
Frame 0 Pixels
003FF
00:0000
08000
08102
Low Byte
0FFFF
10100
00000
080FF
18102
04000
10102
