andrewpaterson/658-Computer/Kicad/Computer/Video/Video Board - Signals/Video Board - Signals.kicad_sch

## KiCad design Kicad/Computer/Video/Video Board - Signals/Video Board - Signals.kicad_sch (2026-01-27)

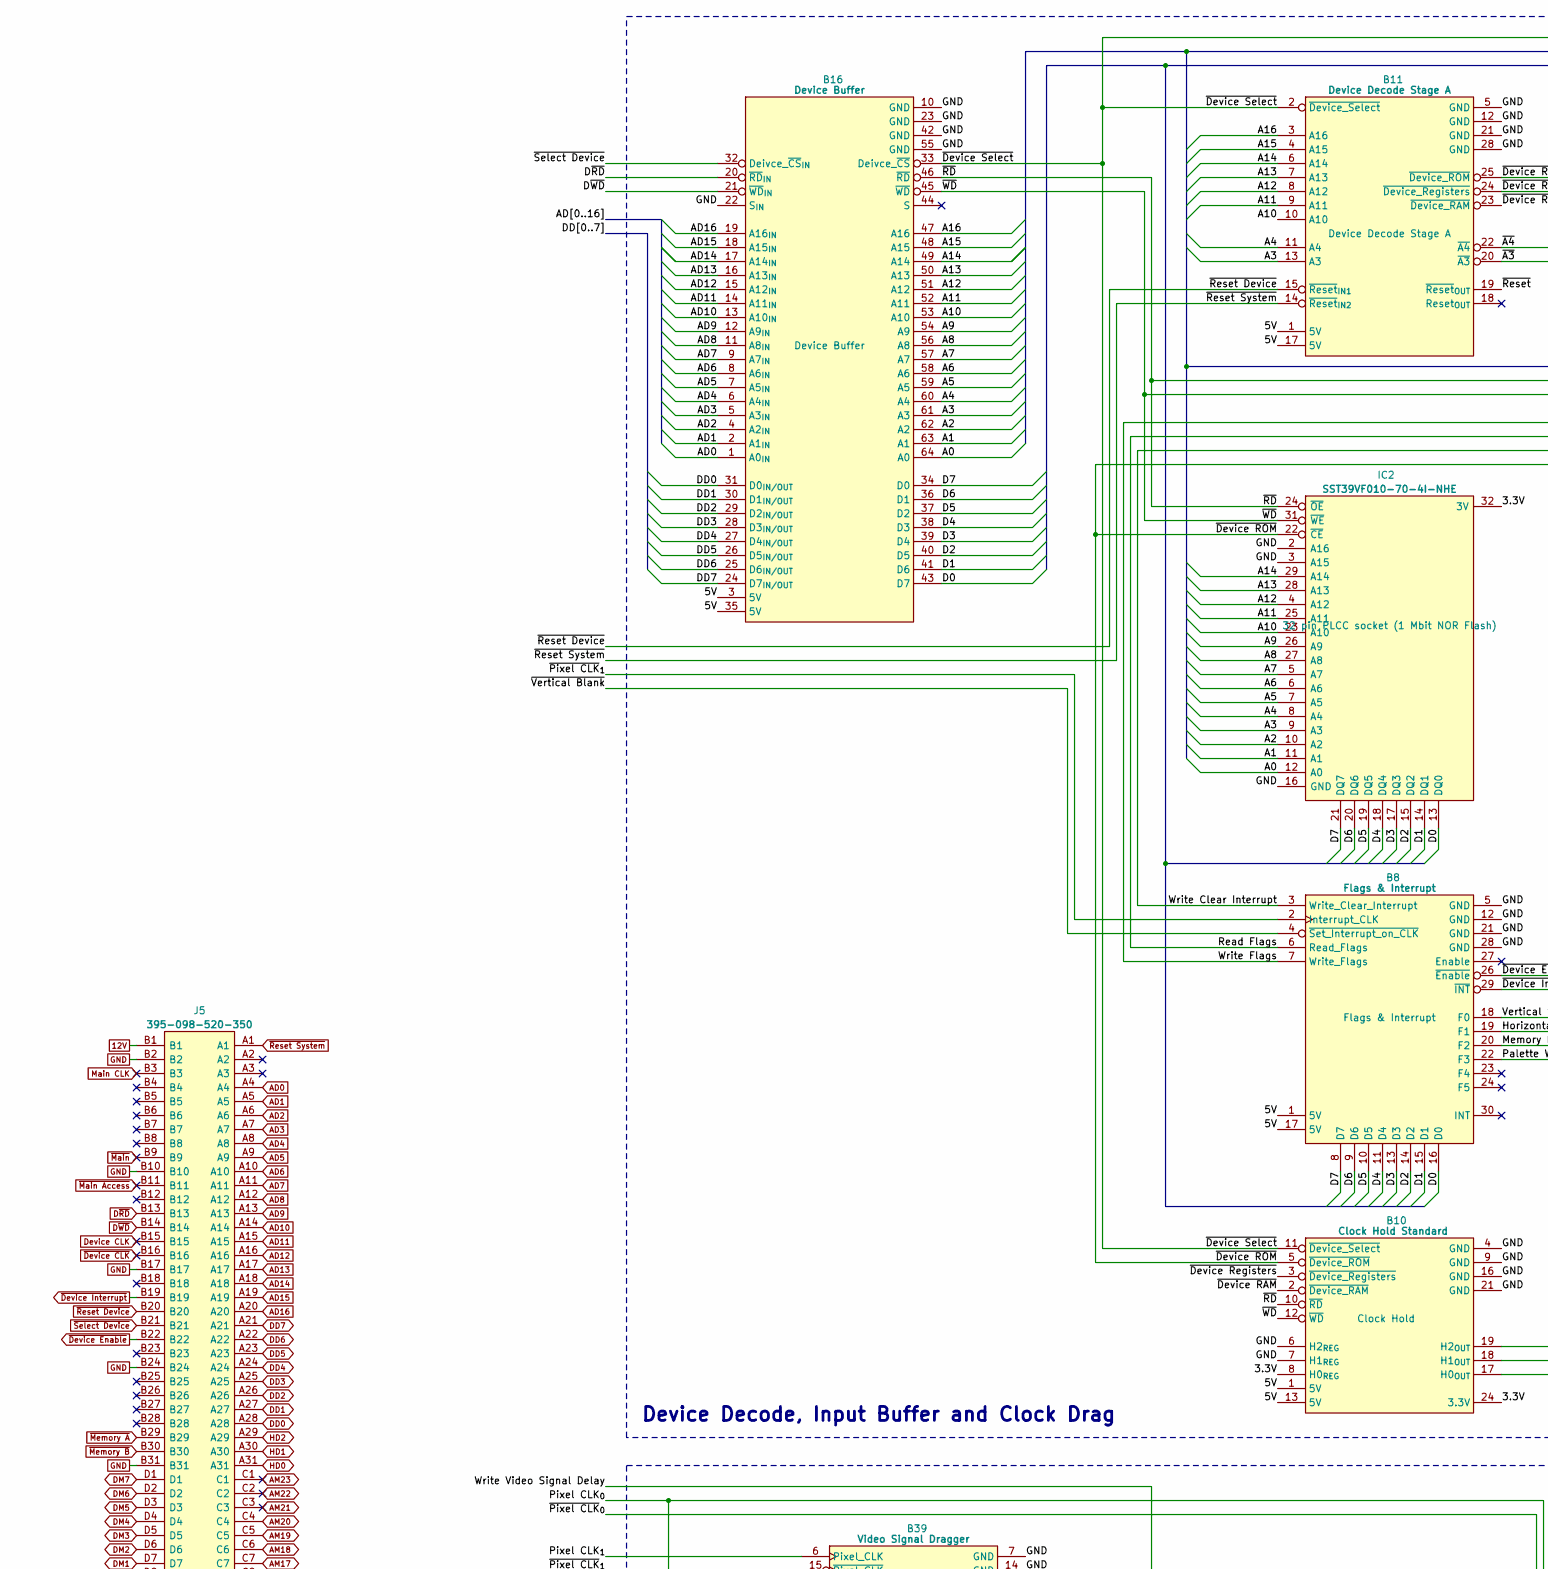
[picture p322: schematic Video Board - Signals.kicad_sch, part in row 1, column 1]

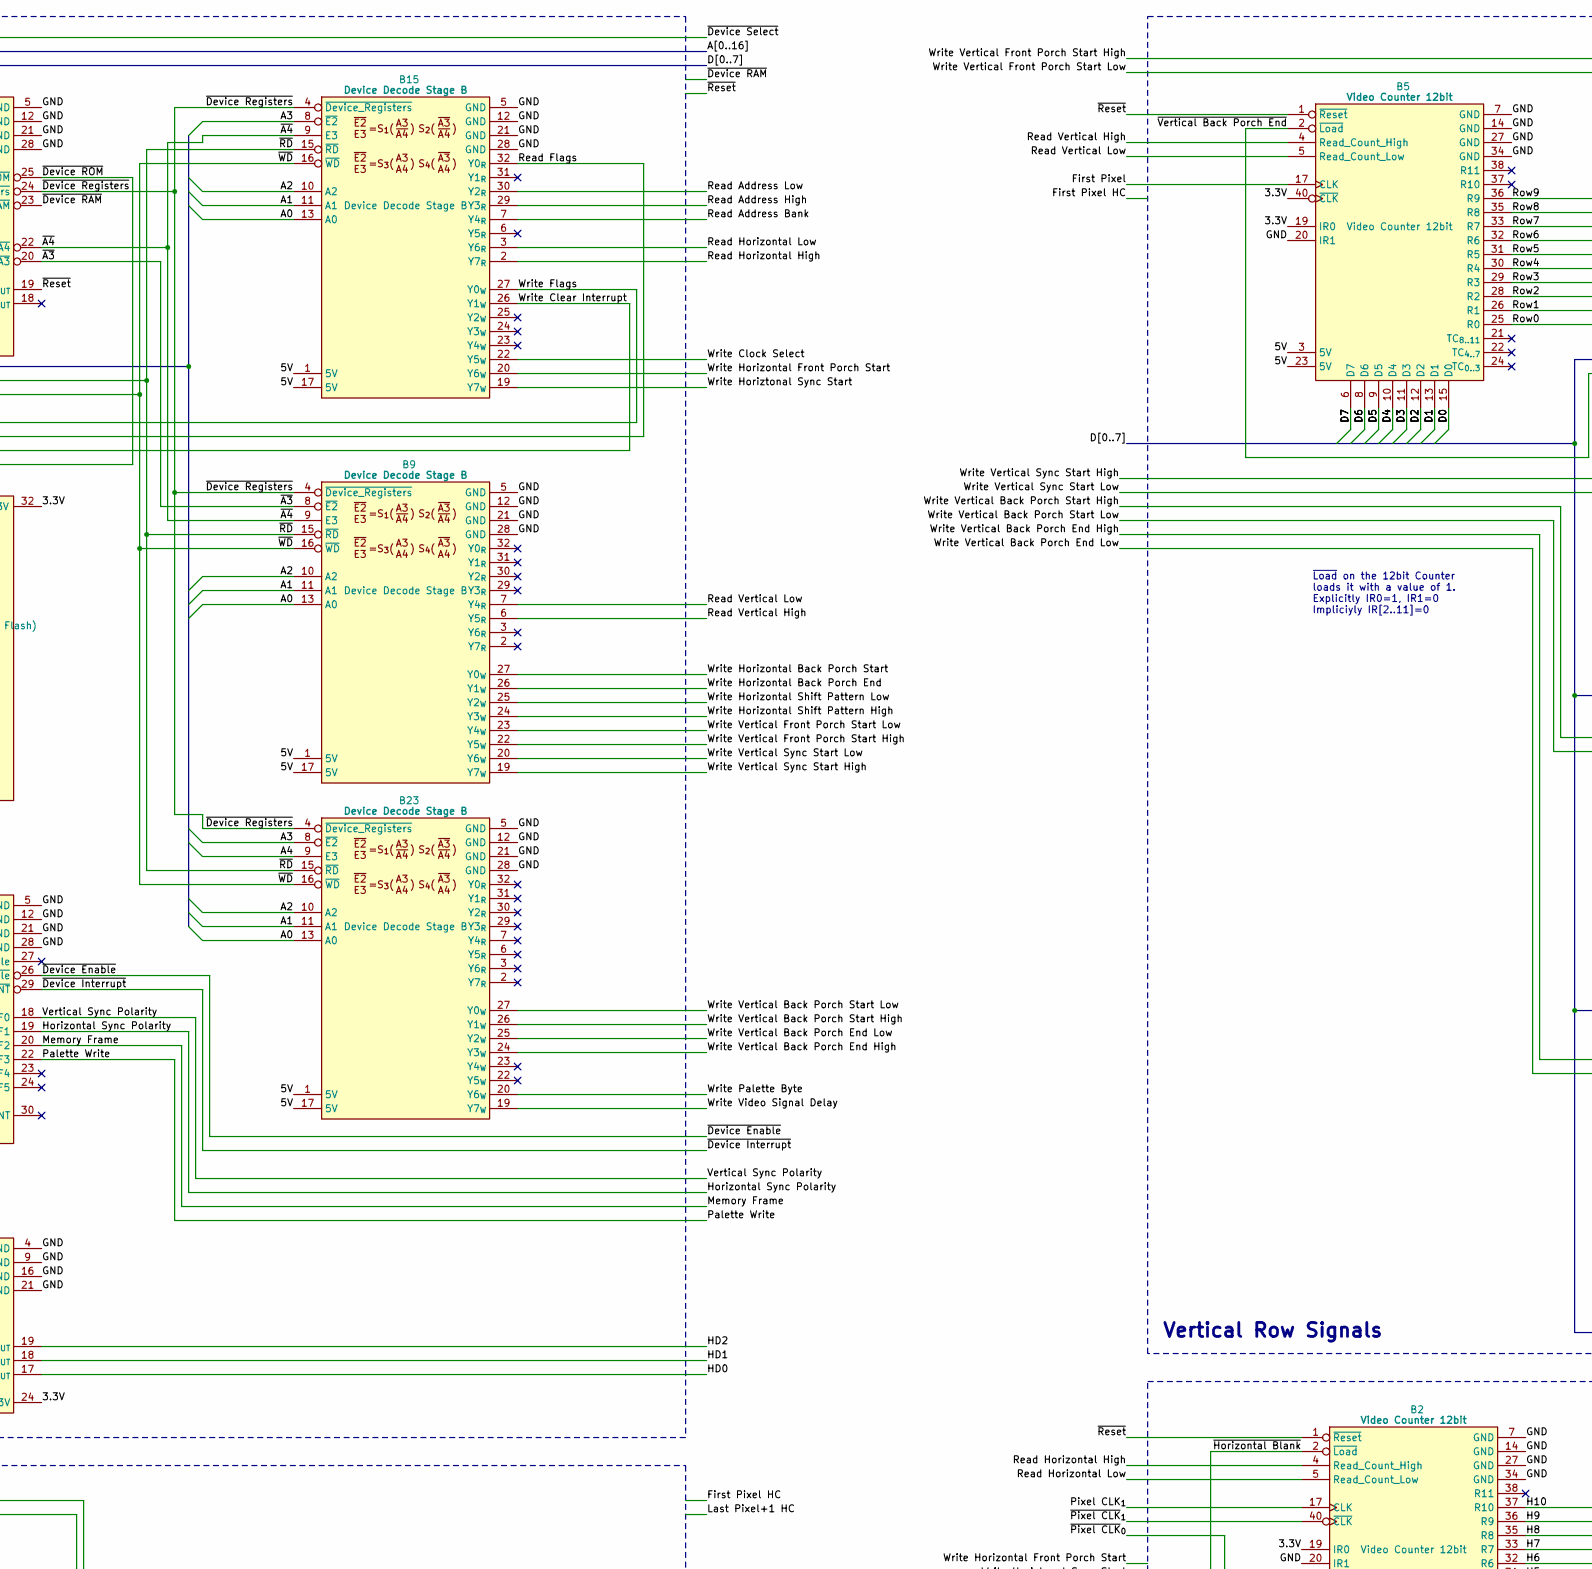
[picture p323: schematic Video Board - Signals.kicad_sch, part in row 1, column 2]

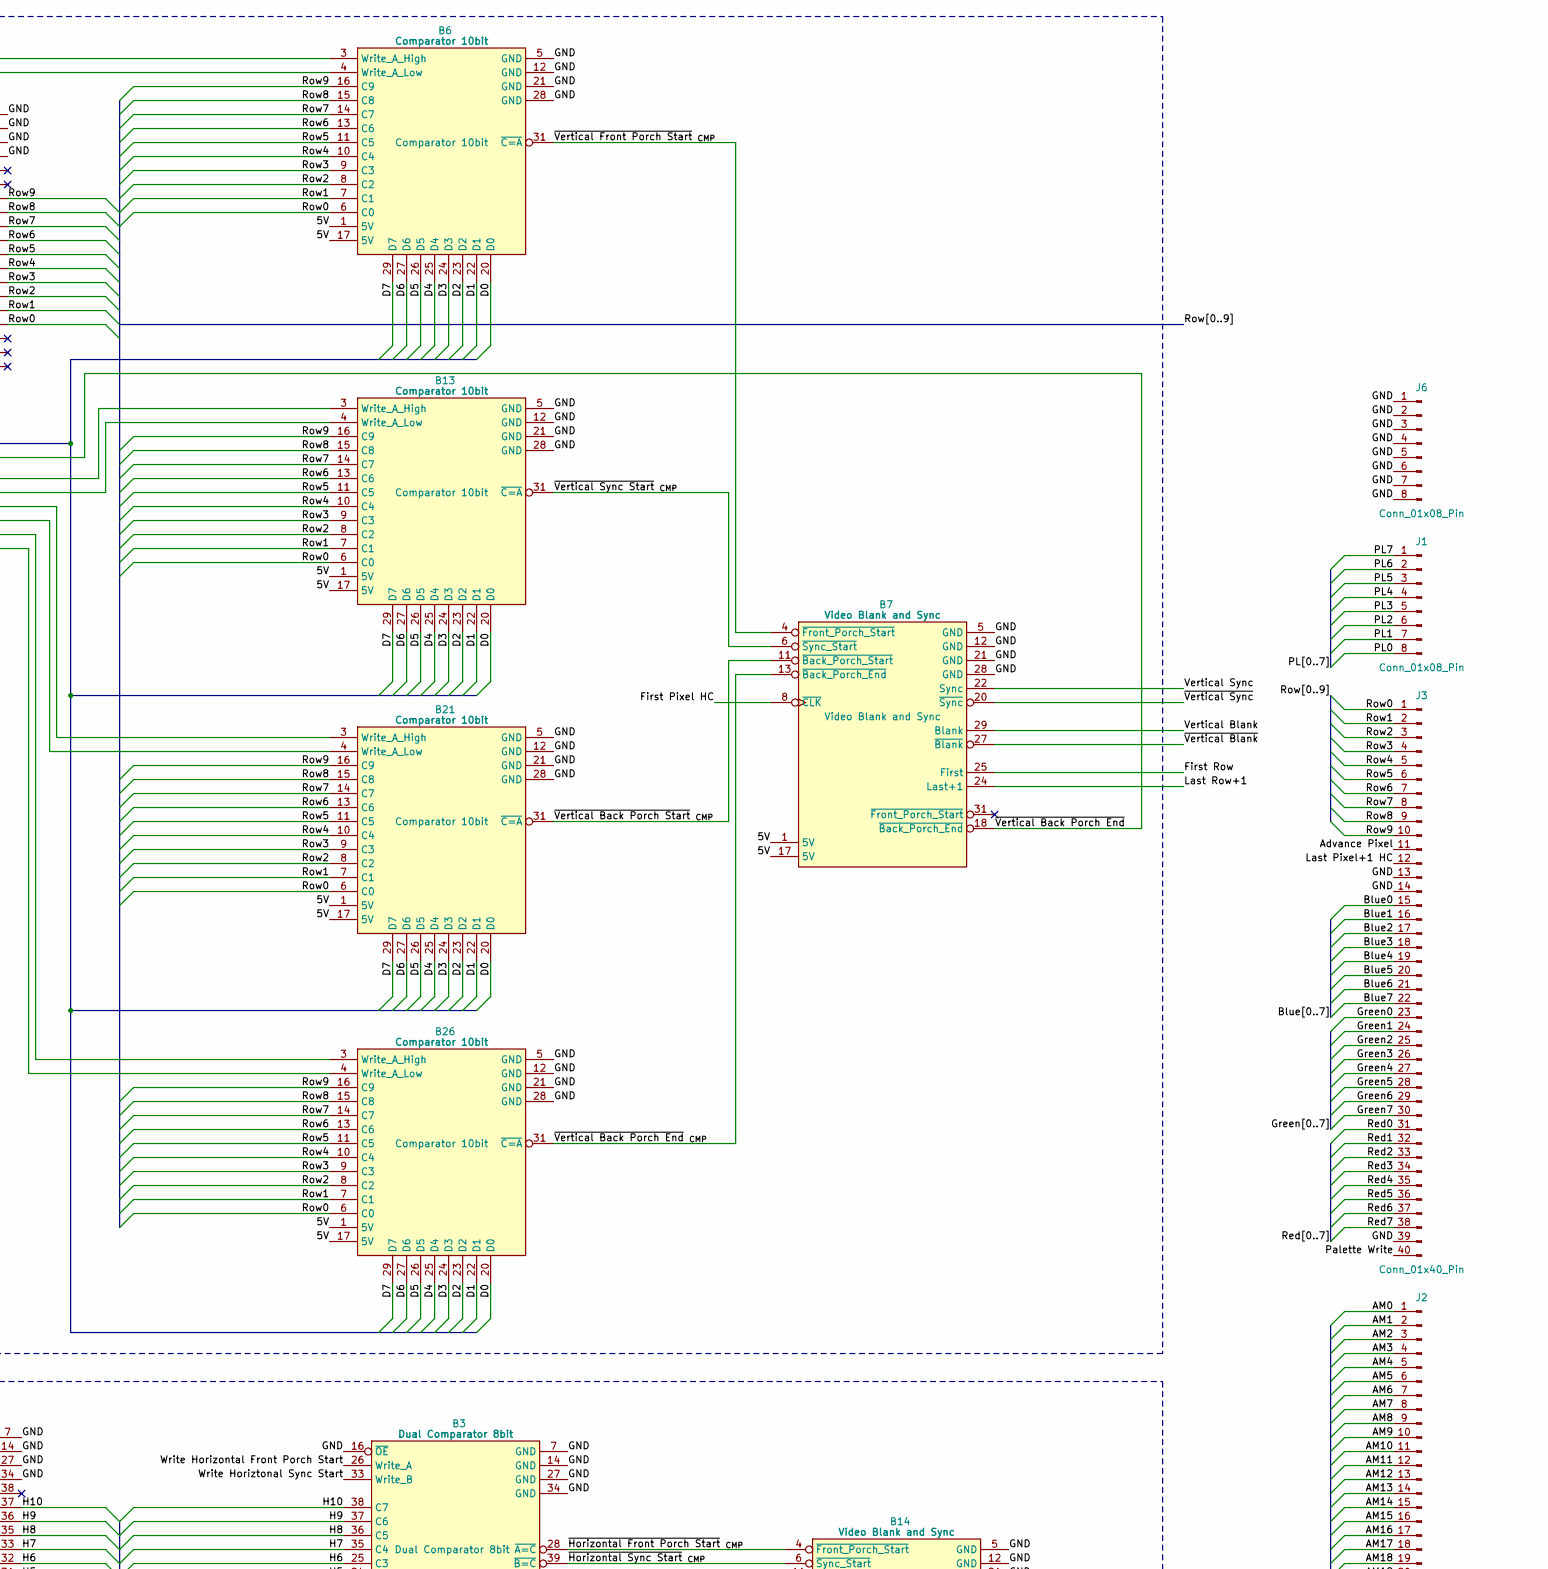
[picture p324: schematic Video Board - Signals.kicad_sch, part in row 1, column 3]

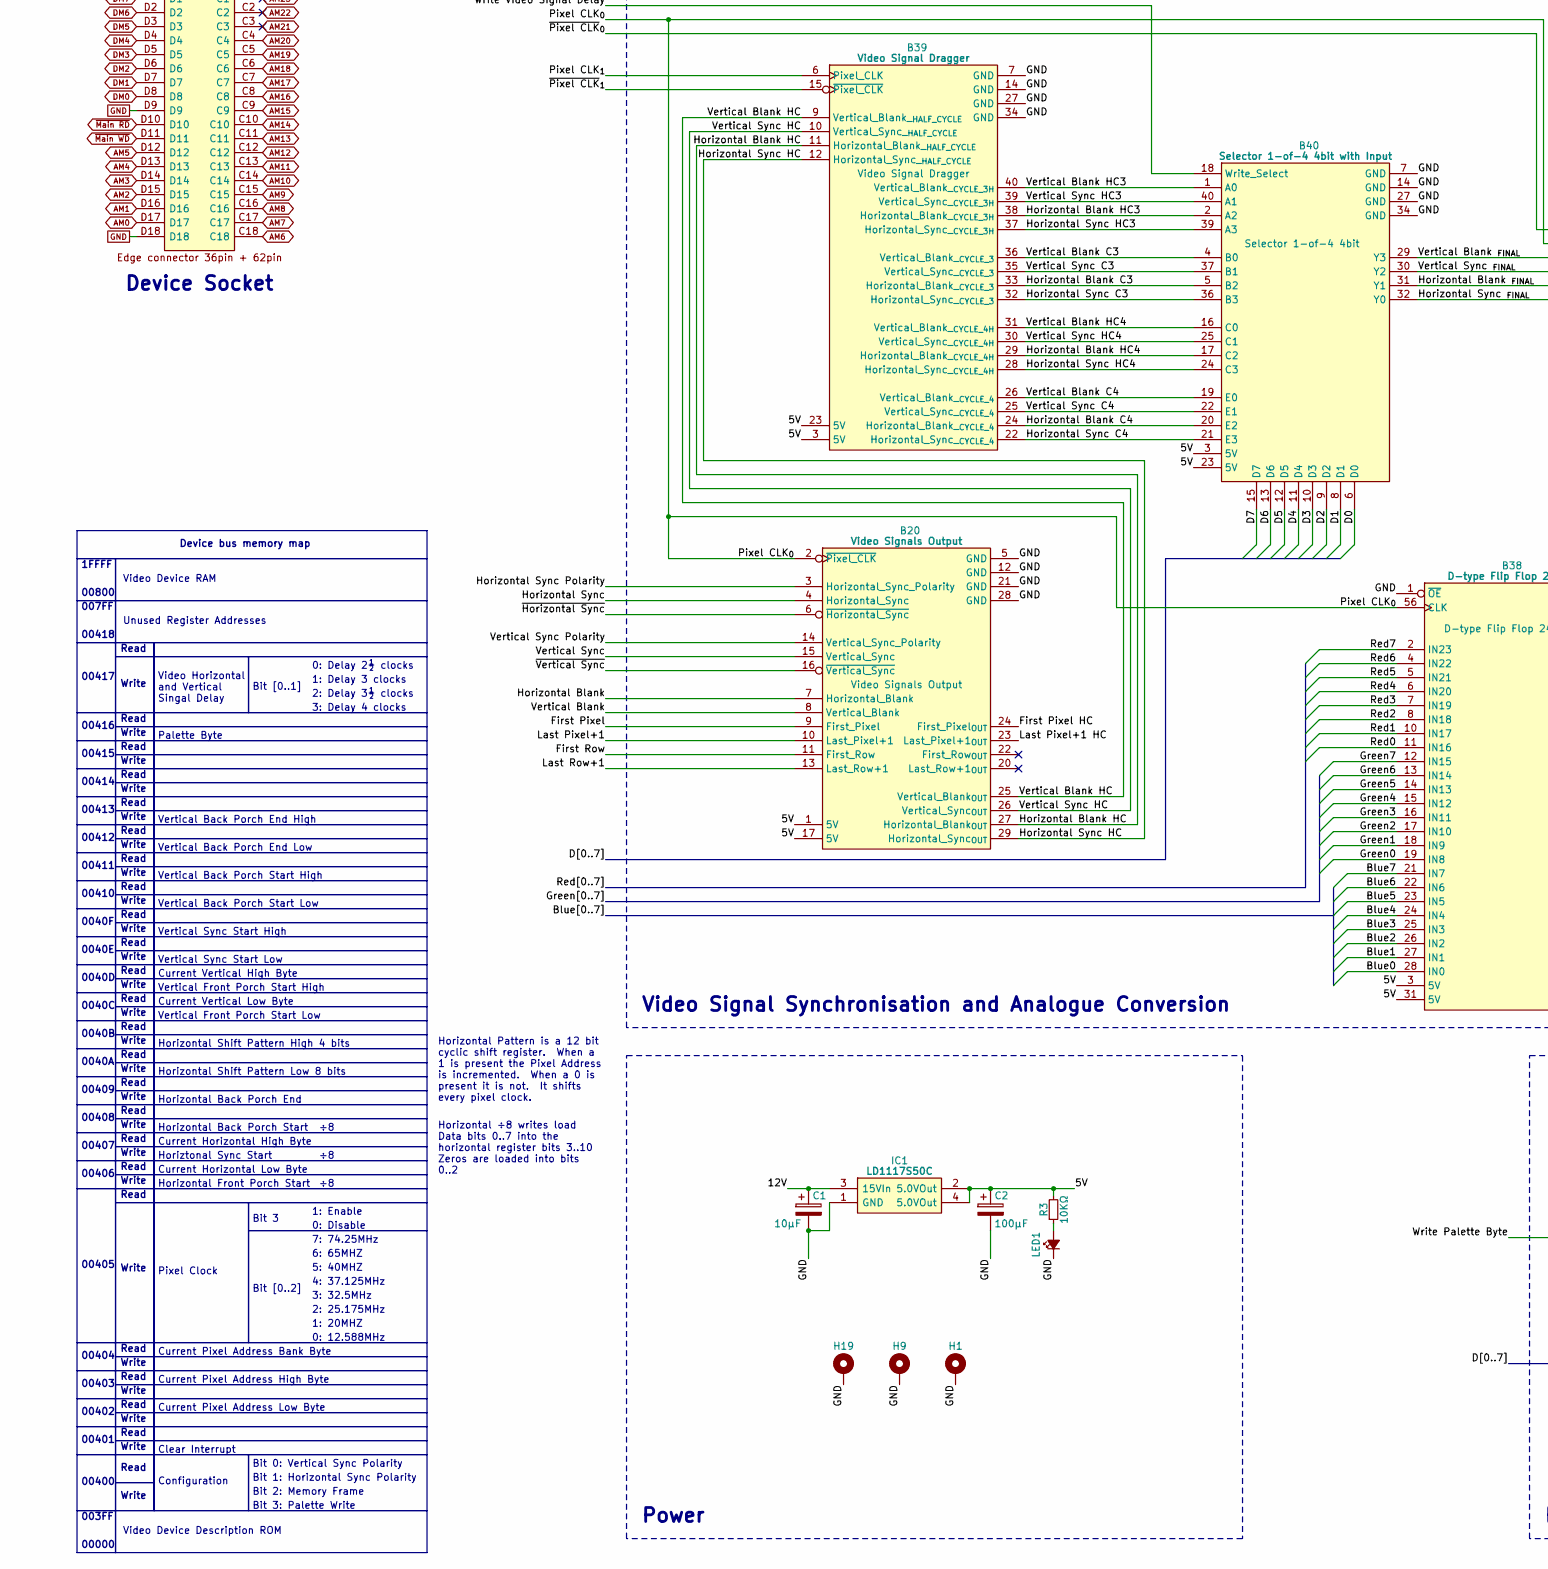
[picture p325: schematic Video Board - Signals.kicad_sch, part in row 2, column 1]

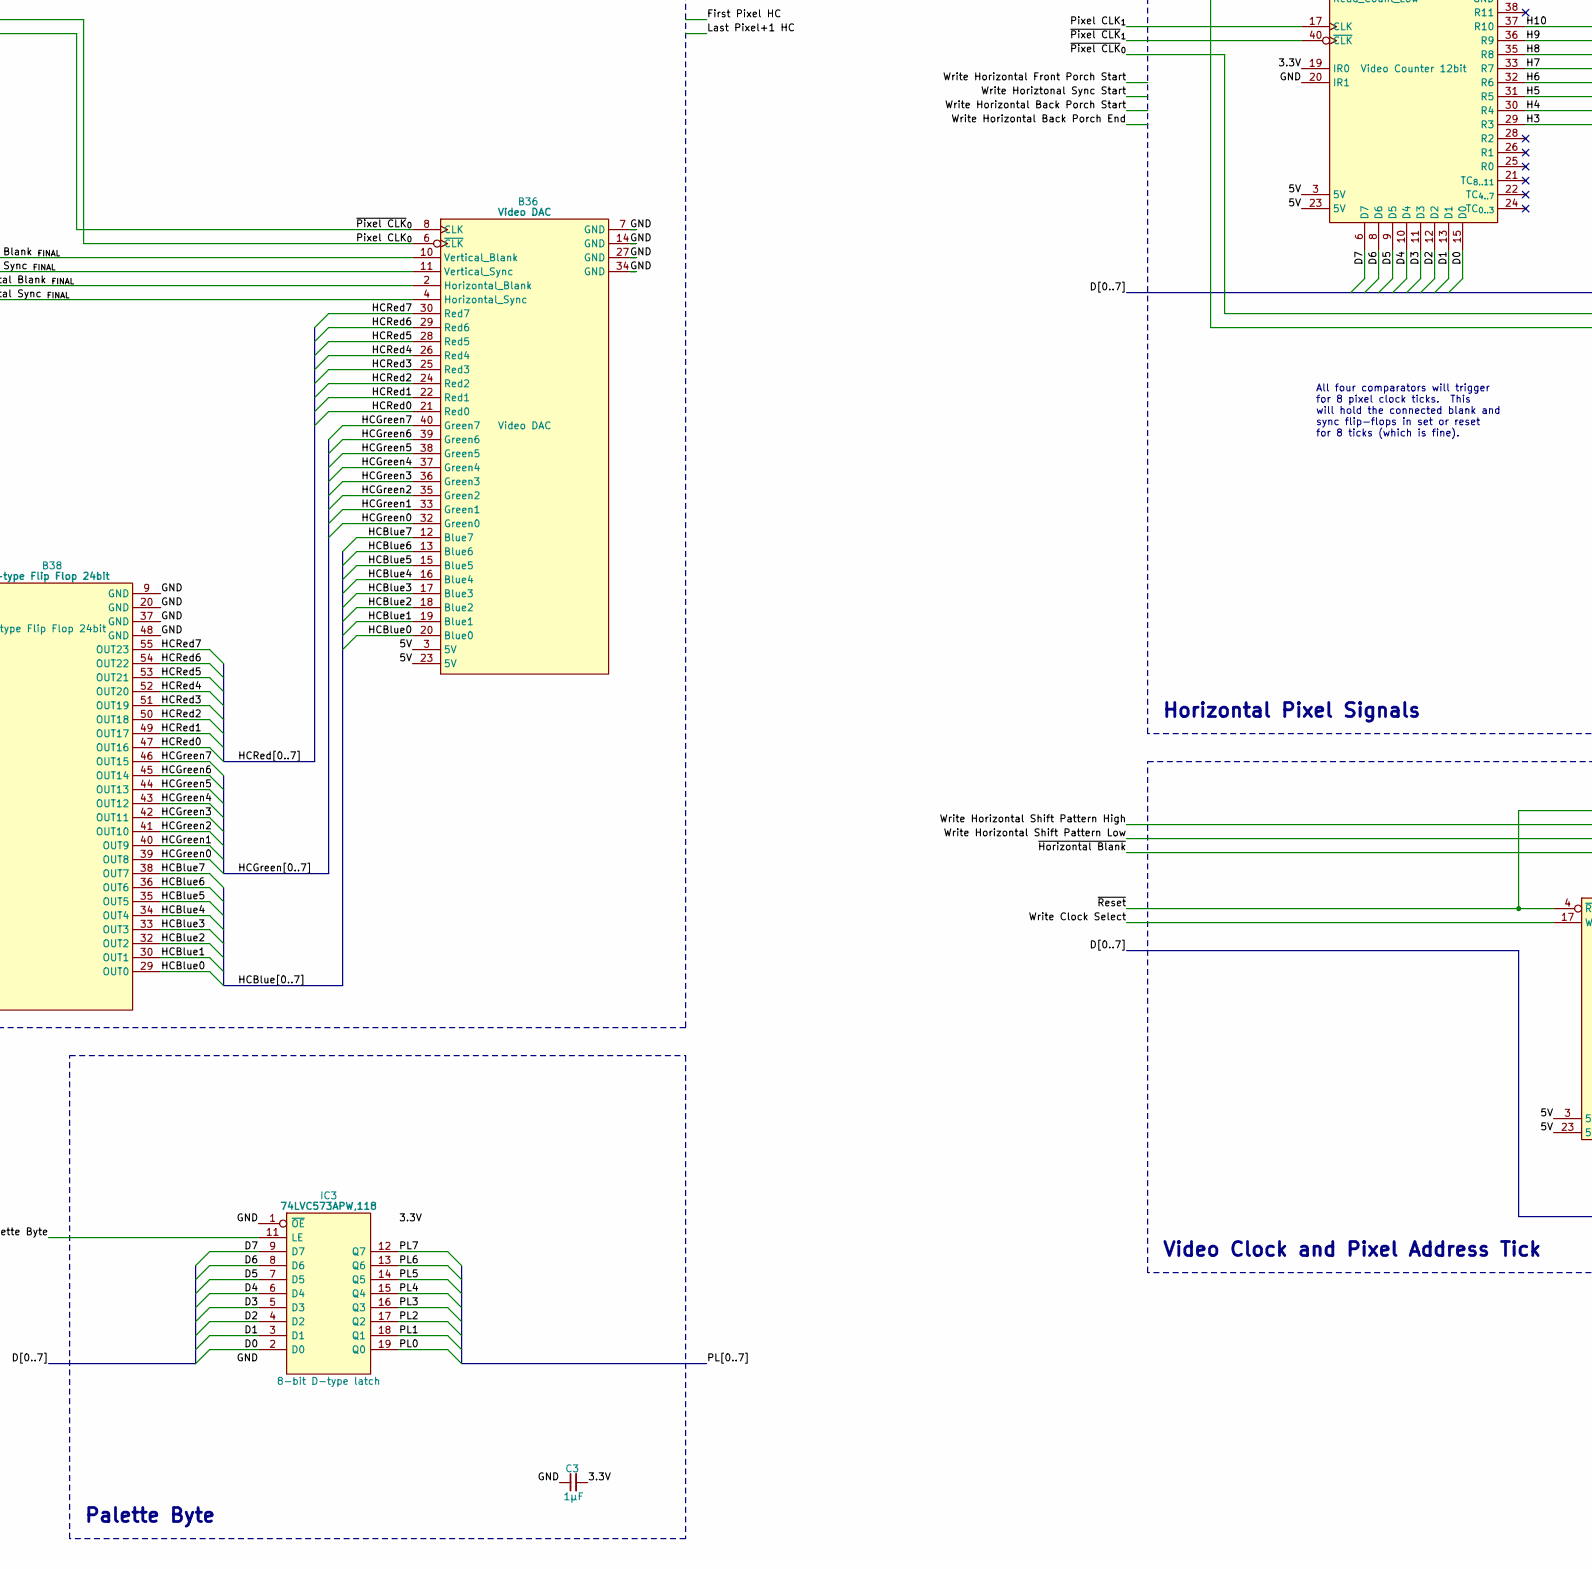
[picture p326: schematic Video Board - Signals.kicad_sch, part in row 2, column 2]

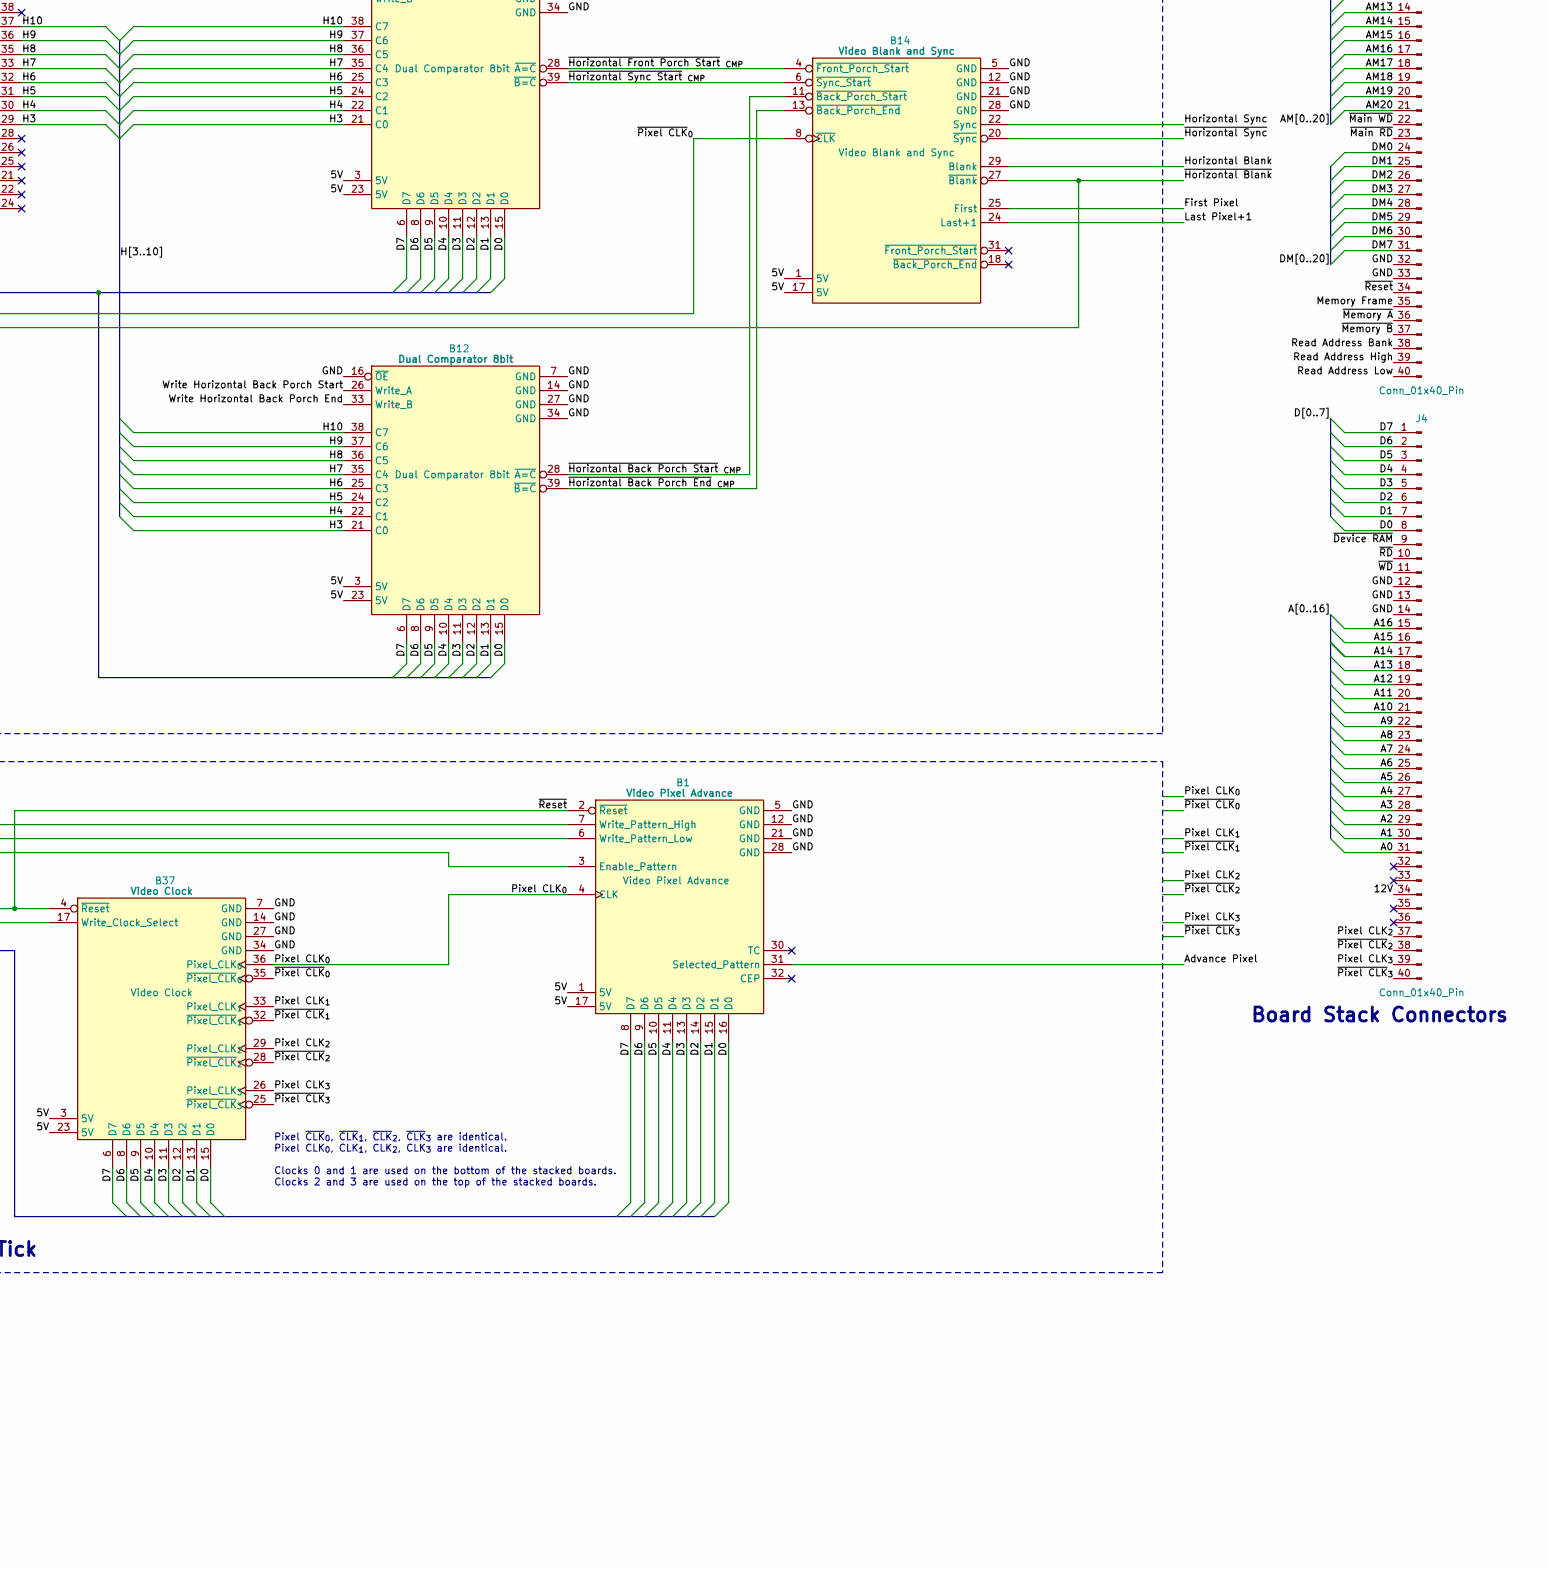
[picture p327: schematic Video Board - Signals.kicad_sch, part in row 2, column 3]

Parts:
B1: Video Pixel Advance; HCP65_Video_Pixel_Advance
B2, B5: Video Counter 12bit; HCP65_Video_Counter_12bit
B3, B12: Dual Comparator 8bit; HCP65_Dual_Comparator_8bit
B6, B13, B21, B26: Comparator 10bit; HCP65_Comparator_10bit
B7, B14: Video Blank and Sync; HCP65_Video_Blank_and_Sync
B8: Flags & Interrupt; HCP65_Flags_Interrupt
B9, B15, B23: Device Decode Stage B; HCP65_Device_Decode_Stage_B
B10: Clock Hold Standard; HCP65_Clock_Hold_Standard
B11: Device Decode Stage A; HCP65_Device_Decode_Stage_A
B16: Device Buffer; HCP65_Device_Buffer
B20: Video Signals Output; HCP65_Video_Output_Signals
B36: Video DAC; HCP65_Video_DAC
B37: Video Clock; HCP65_Video_Clock
B38: D-type Flip Flop 24bit; HCP65_D_Flip_Flop_24bit
B39: Video Signal Dragger; HCP65_Video_Signal_Dragger
B40: Selector 1-of-4 4bit with Input; HCP65_Selector_1_of_4_4bit_with_Input
C1: 10μF; CP_Radial_D4.0mm_P2.00mm
C2: 100μF; CP_Radial_D4.0mm_P2.00mm
C3: 1μF; C_0805
H1, H9, H19: MountingHole_Pad; HCP65_MountingHole_M3_
IC1: LD1117S50C; LD1117S33C; Manufacturer_Part_Number LD1117S50C
IC2: SST39VF010-70-4I-NHE; 5408803224008; Manufacturer_Part_Number SST39VF010-70-4I-NHE
IC3: 74LVC573APW,118; SOP65P640X110-20N; Mouser Part Number 771-74LVC573APW-T
J1, J6: Conn_01x08_Pin; PinHeader_2x04_P2.54mm_Vertical
J2, J3, J4: Conn_01x40_Pin; PinHeader_2x20_P2.54mm_Vertical
J5: 395-098-520-350; 98pin Edge Connector; Manufacturer_Part_Number 395-098-520-350; Mouser Part Number 587-395-098-520-350
LED1: LED; LED_D5.0mm
R3: 10KΩ; R_0805

Connections:
3.3V: B2.19 (IR0), B5.19 (IR0), B5.40 (~CLK), B10.8 (H0_{REG}), B10.24 (3.3V), C3.2, IC2.32 (3V), IC3.20 (3V)
5V: B1.1 (5V), B1.17 (5V), B2.3 (5V), B2.23 (5V), B3.3 (5V), B3.23 (5V), B5.3 (5V), B5.23 (5V), B6.1 (5V), B6.17 (5V), B7.1 (5V), B7.17 (5V), B8.1 (5V), B8.17 (5V), B9.1 (5V), B9.17 (5V), B10.1 (5V), B10.13 (5V), B11.1 (5V), B11.17 (5V), B12.3 (5V), B12.23 (5V), B13.1 (5V), B13.17 (5V), B14.1 (5V), B14.17 (5V), B15.1 (5V), B15.17 (5V), B16.3 (5V), B16.35 (5V), B20.1 (5V), B20.17 (5V), B21.1 (5V), B21.17 (5V), B23.1 (5V), B23.17 (5V), B26.1 (5V), B26.17 (5V), B36.3 (5V), B36.23 (5V), B37.3 (5V), B37.23 (5V), B38.3 (5V), B38.31 (5V), B39.3 (5V), B39.23 (5V), B40.3 (5V), B40.23 (5V), C2.1, IC1.2 (5.0VOut), IC1.4 (5.0VOut), R3.2
12V: C1.1, IC1.3 (15VIn), J4.34, J5.B1
A0: B9.13 (A0), B15.13 (A0), B16.64 (A0), B23.13 (A0), IC2.12 (A0), J4.31
A1: B9.11 (A1), B15.11 (A1), B16.63 (A1), B23.11 (A1), IC2.11 (A1), J4.30
A2: B9.10 (A2), B15.10 (A2), B16.62 (A2), B23.10 (A2), IC2.10 (A2), J4.29
A3: B11.13 (A3), B15.8 (~E2), B16.61 (A3), B23.8 (~E2), IC2.9 (A3), J4.28
A4: B11.11 (A4), B16.60 (A4), B23.9 (E3), IC2.8 (A4), J4.27
A5: B16.59 (A5), IC2.7 (A5), J4.26
A6: B16.58 (A6), IC2.6 (A6), J4.25
A7: B16.57 (A7), IC2.5 (A7), J4.24
A8: B16.56 (A8), IC2.27 (A8), J4.23
A9: B16.54 (A9), IC2.26 (A9), J4.22
A10: B11.10 (A10), B16.53 (A10), IC2.23 (A10), J4.21
A11: B11.9 (A11), B16.52 (A11), IC2.25 (A11), J4.20
A12: B11.8 (A12), B16.51 (A12), IC2.4 (A12), J4.19
A13: B11.7 (A13), B16.50 (A13), IC2.28 (A13), J4.18
A14: B11.6 (A14), B16.49 (A14), IC2.29 (A14), J4.17
A15: B11.4 (A15), B16.48 (A15), J4.16
A16: B11.3 (A16), B16.47 (A16), J4.15
AD0: B16.1 (A0_{IN}), J5.A4
AD1: B16.2 (A1_{IN}), J5.A5
AD2: B16.4 (A2_{IN}), J5.A6
AD3: B16.5 (A3_{IN}), J5.A7
AD4: B16.6 (A4_{IN}), J5.A8
AD5: B16.7 (A5_{IN}), J5.A9
AD6: B16.8 (A6_{IN}), J5.A10
AD7: B16.9 (A7_{IN}), J5.A11
AD8: B16.11 (A8_{IN}), J5.A12
AD9: B16.12 (A9_{IN}), J5.A13
AD10: B16.13 (A10_{IN}), J5.A14
AD11: B16.14 (A11_{IN}), J5.A15
AD12: B16.15 (A12_{IN}), J5.A16
AD13: B16.16 (A13_{IN}), J5.A17
AD14: B16.17 (A14_{IN}), J5.A18
AD15: B16.18 (A15_{IN}), J5.A19
AD16: B16.19 (A16_{IN}), J5.A20
AM0: J2.1, J5.D17
AM1: J2.2, J5.D16
AM2: J2.3, J5.D15
AM3: J2.4, J5.D14
AM4: J2.5, J5.D13
AM5: J2.6, J5.D12
AM6: J2.7, J5.C18
AM7: J2.8, J5.C17
AM8: J2.9, J5.C16
AM9: J2.10, J5.C15
AM10: J2.11, J5.C14
AM11: J2.12, J5.C13
AM12: J2.13, J5.C12
AM13: J2.14, J5.C11
AM14: J2.15, J5.C10
AM15: J2.16, J5.C9
AM16: J2.17, J5.C8
AM17: J2.18, J5.C7
AM18: J2.19, J5.C6
AM19: J2.20, J5.C5
AM20: J2.21, J5.C4
AM21: J5.C3
AM22: J5.C2
AM23: J5.C1
Advance Pixel: B1.31 (Selected_Pattern), J3.11
Blue0: B38.28 (IN0), J3.15
Blue1: B38.27 (IN1), J3.16
Blue2: B38.26 (IN2), J3.17
Blue3: B38.25 (IN3), J3.18
Blue4: B38.24 (IN4), J3.19
Blue5: B38.23 (IN5), J3.20
Blue6: B38.22 (IN6), J3.21
Blue7: B38.21 (IN7), J3.22
D0: B1.16 (D0), B2.15 (D0), B3.15 (D0), B5.15 (D0), B6.20 (D0), B8.16 (D0), B12.15 (D0), B13.20 (D0), B16.43 (D7), B21.20 (D0), B26.20 (D0), B37.15 (D0), B40.6 (D0), IC2.13 (DQ0), IC3.2 (D0), J4.8
D1: B1.15 (D1), B2.13 (D1), B3.13 (D1), B5.13 (D1), B6.22 (D1), B8.15 (D1), B12.13 (D1), B13.22 (D1), B16.41 (D6), B21.22 (D1), B26.22 (D1), B37.13 (D1), B40.8 (D1), IC2.14 (DQ1), IC3.3 (D1), J4.7
D2: B1.14 (D2), B2.12 (D2), B3.12 (D2), B5.12 (D2), B6.23 (D2), B8.14 (D2), B12.12 (D2), B13.23 (D2), B16.40 (D5), B21.23 (D2), B26.23 (D2), B37.12 (D2), B40.9 (D2), IC2.15 (DQ2), IC3.4 (D2), J4.6
D3: B1.13 (D3), B2.11 (D3), B3.11 (D3), B5.11 (D3), B6.24 (D3), B8.13 (D3), B12.11 (D3), B13.24 (D3), B16.39 (D4), B21.24 (D3), B26.24 (D3), B37.11 (D3), B40.10 (D3), IC2.17 (DQ3), IC3.5 (D3), J4.5
D4: B1.11 (D4), B2.10 (D4), B3.10 (D4), B5.10 (D4), B6.25 (D4), B8.11 (D4), B12.10 (D4), B13.25 (D4), B16.38 (D3), B21.25 (D4), B26.25 (D4), B37.10 (D4), B40.11 (D4), IC2.18 (DQ4), IC3.6 (D4), J4.4
D5: B1.10 (D5), B2.9 (D5), B3.9 (D5), B5.9 (D5), B6.26 (D5), B8.10 (D5), B12.9 (D5), B13.26 (D5), B16.37 (D2), B21.26 (D5), B26.26 (D5), B37.9 (D5), B40.12 (D5), IC2.19 (DQ5), IC3.7 (D5), J4.3
D6: B1.9 (D6), B2.8 (D6), B3.8 (D6), B5.8 (D6), B6.27 (D6), B8.9 (D6), B12.8 (D6), B13.27 (D6), B16.36 (D1), B21.27 (D6), B26.27 (D6), B37.8 (D6), B40.13 (D6), IC2.20 (DQ6), IC3.8 (D6), J4.2
D7: B1.8 (D7), B2.6 (D7), B3.6 (D7), B5.6 (D7), B6.29 (D7), B8.8 (D7), B12.6 (D7), B13.29 (D7), B16.34 (D0), B21.29 (D7), B26.29 (D7), B37.6 (D7), B40.15 (D7), IC2.21 (DQ7), IC3.9 (D7), J4.1
DD0: B16.31 (D0_{IN/OUT}), J5.A28
DD1: B16.30 (D1_{IN/OUT}), J5.A27
DD2: B16.29 (D2_{IN/OUT}), J5.A26
DD3: B16.28 (D3_{IN/OUT}), J5.A25
DD4: B16.27 (D4_{IN/OUT}), J5.A24
DD5: B16.26 (D5_{IN/OUT}), J5.A23
DD6: B16.25 (D6_{IN/OUT}), J5.A22
DD7: B16.24 (D7_{IN/OUT}), J5.A21
DM0: J2.24, J5.D8
DM1: J2.25, J5.D7
DM2: J2.26, J5.D6
DM3: J2.27, J5.D5
DM4: J2.28, J5.D4
DM5: J2.29, J5.D3
DM6: J2.30, J5.D2
DM7: J2.31, J5.D1
Device CLK: J5.B15
D~RD: B16.20 (~RD_{IN}), J5.B13
D~WD: B16.21 (~WD_{IN}), J5.B14
First Pixel: B5.17 (CLK), B14.25 (First), B20.9 (First_Pixel)
First Pixel HC: B7.8 (~CLK), B20.24 (First_Pixel_{OUT})
First Row: B7.25 (First), B20.11 (First_Row)
GND: B1.5 (GND), B1.12 (GND), B1.21 (GND), B1.28 (GND), B2.7 (GND), B2.14 (GND), B2.20 (IR1), B2.27 (GND), B2.34 (GND), B3.7 (GND), B3.14 (GND), B3.16 (~OE), B3.27 (GND), B3.34 (GND), B5.7 (GND), B5.14 (GND), B5.20 (IR1), B5.27 (GND), B5.34 (GND), B6.5 (GND), B6.12 (GND), B6.21 (GND), B6.28 (GND), B7.5 (GND), B7.12 (GND), B7.21 (GND), B7.28 (GND), B8.5 (GND), B8.12 (GND), B8.21 (GND), B8.28 (GND), B9.5 (GND), B9.12 (GND), B9.21 (GND), B9.28 (GND), B10.4 (GND), B10.6 (H2_{REG}), B10.7 (H1_{REG}), B10.9 (GND), B10.16 (GND), B10.21 (GND), B11.5 (GND), B11.12 (GND), B11.21 (GND), B11.28 (GND), B12.7 (GND), B12.14 (GND), B12.16 (~OE), B12.27 (GND), B12.34 (GND), B13.5 (GND), B13.12 (GND), B13.21 (GND), B13.28 (GND), B14.5 (GND), B14.12 (GND), B14.21 (GND), B14.28 (GND), B15.5 (GND), B15.12 (GND), B15.21 (GND), B15.28 (GND), B16.10 (GND), B16.22 (S_{IN}), B16.23 (GND), B16.42 (GND), B16.55 (GND), B20.5 (GND), B20.12 (GND), B20.21 (GND), B20.28 (GND), B21.5 (GND), B21.12 (GND), B21.21 (GND), B21.28 (GND), B23.5 (GND), B23.12 (GND), B23.21 (GND), B23.28 (GND), B26.5 (GND), B26.12 (GND), B26.21 (GND), B26.28 (GND), B36.7 (GND), B36.14 (GND), B36.27 (GND), B36.34 (GND), B37.7 (GND), B37.14 (GND), B37.27 (GND), B37.34 (GND), B38.1 (~OE), B38.9 (GND), B38.20 (GND), B38.37 (GND), B38.48 (GND), B39.7 (GND), B39.14 (GND), B39.27 (GND), B39.34 (GND), B40.7 (GND), B40.14 (GND), B40.27 (GND), B40.34 (GND), C1.2, C2.2, C3.1, H1.1, H9.1, H19.1, IC1.1 (GND), IC2.2 (A16), IC2.3 (A15), IC2.16 (GND), IC3.1 (~OE), IC3.10 (GND), J2.32, J2.33, J3.13, J3.14, J3.39, J4.12, J4.13, J4.14, J5.B2, J5.B10, J5.B17, J5.B24, J5.B31, J5.D9, J5.D18, J6.1, J6.2, J6.3, J6.4, J6.5, J6.6, J6.7, J6.8, LED1.1 (K)
Green0: B38.19 (IN8), J3.23
Green1: B38.18 (IN9), J3.24
Green2: B38.17 (IN10), J3.25
Green3: B38.16 (IN11), J3.26
Green4: B38.15 (IN12), J3.27
Green5: B38.14 (IN13), J3.28
Green6: B38.13 (IN14), J3.29
Green7: B38.12 (IN15), J3.30
H3: B2.29 (R3), B3.21 (C0), B12.21 (C0)
H4: B2.30 (R4), B3.22 (C1), B12.22 (C1)
H5: B2.31 (R5), B3.24 (C2), B12.24 (C2)
H6: B2.32 (R6), B3.25 (C3), B12.25 (C3)
H7: B2.33 (R7), B3.35 (C4), B12.35 (C4)
H8: B2.35 (R8), B3.36 (C5), B12.36 (C5)
H9: B2.36 (R9), B3.37 (C6), B12.37 (C6)
H10: B2.37 (R10), B3.38 (C7), B12.38 (C7)
HCBlue0: B36.20 (Blue0), B38.29 (OUT0)
HCBlue1: B36.19 (Blue1), B38.30 (OUT1)
HCBlue2: B36.18 (Blue2), B38.32 (OUT2)
HCBlue3: B36.17 (Blue3), B38.33 (OUT3)
HCBlue4: B36.16 (Blue4), B38.34 (OUT4)
HCBlue5: B36.15 (Blue5), B38.35 (OUT5)
HCBlue6: B36.13 (Blue6), B38.36 (OUT6)
HCBlue7: B36.12 (Blue7), B38.38 (OUT7)
HCGreen0: B36.32 (Green0), B38.39 (OUT8)
HCGreen1: B36.33 (Green1), B38.40 (OUT9)
HCGreen2: B36.35 (Green2), B38.41 (OUT10)
HCGreen3: B36.36 (Green3), B38.42 (OUT11)
HCGreen4: B36.37 (Green4), B38.43 (OUT12)
HCGreen5: B36.38 (Green5), B38.44 (OUT13)
HCGreen6: B36.39 (Green6), B38.45 (OUT14)
HCGreen7: B36.40 (Green7), B38.46 (OUT15)
HCRed0: B36.21 (Red0), B38.47 (OUT16)
HCRed1: B36.22 (Red1), B38.49 (OUT17)
HCRed2: B36.24 (Red2), B38.50 (OUT18)
HCRed3: B36.25 (Red3), B38.51 (OUT19)
HCRed4: B36.26 (Red4), B38.52 (OUT20)
HCRed5: B36.28 (Red5), B38.53 (OUT21)
HCRed6: B36.29 (Red6), B38.54 (OUT22)
HCRed7: B36.30 (Red7), B38.55 (OUT23)
HD0: B10.17 (H0_{OUT}), J5.A31
HD1: B10.18 (H1_{OUT}), J5.A30
HD2: B10.19 (H2_{OUT}), J5.A29
Horizontal Blank: B14.29 (Blank), B20.7 (Horizontal_Blank)
Horizontal Blank C3: B39.33 (Horizontal_Blank__{CYCLE_3}), B40.5 (B2)
Horizontal Blank C4: B39.24 (Horizontal_Blank__{CYCLE_4}), B40.20 (E2)
Horizontal Blank HC: B20.27 (Horizontal_Blank_{OUT}), B39.11 (Horizontal_Blank__{HALF_CYCLE})
Horizontal Blank HC3: B39.38 (Horizontal_Blank__{CYCLE_3H}), B40.2 (A2)
Horizontal Blank HC4: B39.29 (Horizontal_Blank__{CYCLE_4H}), B40.17 (C2)
Horizontal Blank _{FINAL}: B36.2 (Horizontal_Blank), B40.31 (Y1)
Horizontal Sync: B14.22 (Sync), B20.4 (Horizontal_Sync)
Horizontal Sync C3: B39.32 (Horizontal_Sync__{CYCLE_3}), B40.36 (B3)
Horizontal Sync C4: B39.22 (Horizontal_Sync__{CYCLE_4}), B40.21 (E3)
Horizontal Sync HC: B20.29 (Horizontal_Sync_{OUT}), B39.12 (Horizontal_Sync__{HALF_CYCLE})
Horizontal Sync HC3: B39.37 (Horizontal_Sync__{CYCLE_3H}), B40.39 (A3)
Horizontal Sync HC4: B39.28 (Horizontal_Sync__{CYCLE_4H}), B40.24 (C3)
Horizontal Sync Polarity: B8.19 (F1), B20.3 (Horizontal_Sync_Polarity)
Horizontal Sync _{FINAL}: B36.4 (Horizontal_Sync), B40.32 (Y0)
Last Pixel+1: B14.24 (Last+1), B20.10 (Last_Pixel+1)
Last Pixel+1 HC: B20.23 (Last_Pixel+1_{OUT}), J3.12
Last Row+1: B7.24 (Last+1), B20.13 (Last_Row+1)
Main CLK: J5.B3
Memory Frame: B8.20 (F2), J2.35
unnamed: LED1.2 (A), R3.1
PL0: IC3.19 (Q0), J1.8
PL1: IC3.18 (Q1), J1.7
PL2: IC3.17 (Q2), J1.6
PL3: IC3.16 (Q3), J1.5
PL4: IC3.15 (Q4), J1.4
PL5: IC3.14 (Q5), J1.3
PL6: IC3.13 (Q6), J1.2
PL7: IC3.12 (Q7), J1.1
Palette Write: B8.22 (F3), J3.40
Pixel CLK_{0}: B1.4 (CLK), B20.2 (~Pixel_CLK), B36.6 (~CLK), B37.36 (Pixel_CLK_{0}), B38.56 (CLK)
Pixel CLK_{1}: B2.17 (CLK), B37.33 (Pixel_CLK_{1}), B39.6 (Pixel_CLK)
Pixel CLK_{2}: B37.29 (Pixel_CLK_{2}), J4.37
Pixel CLK_{3}: B37.26 (Pixel_CLK_{3}), J4.39
Read Address Bank: B15.7 (Y4_{R}), J2.38
Read Address High: B15.29 (Y3_{R}), J2.39
Read Address Low: B15.30 (Y2_{R}), J2.40
Read Flags: B8.6 (Read_Flags), B15.32 (Y0_{R})
Read Horizontal High: B2.4 (Read_Count_High), B15.2 (Y7_{R})
Read Horizontal Low: B2.5 (Read_Count_Low), B15.3 (Y6_{R})
Read Vertical High: B5.4 (Read_Count_High), B9.6 (Y5_{R})
Read Vertical Low: B5.5 (Read_Count_Low), B9.7 (Y4_{R})
Red0: B38.11 (IN16), J3.31
Red1: B38.10 (IN17), J3.32
Red2: B38.8 (IN18), J3.33
Red3: B38.7 (IN19), J3.34
Red4: B38.6 (IN20), J3.35
Red5: B38.5 (IN21), J3.36
Red6: B38.4 (IN22), J3.37
Red7: B38.2 (IN23), J3.38
Row0: B5.25 (R0), B6.6 (C0), B13.6 (C0), B21.6 (C0), B26.6 (C0), J3.1
Row1: B5.26 (R1), B6.7 (C1), B13.7 (C1), B21.7 (C1), B26.7 (C1), J3.2
Row2: B5.28 (R2), B6.8 (C2), B13.8 (C2), B21.8 (C2), B26.8 (C2), J3.3
Row3: B5.29 (R3), B6.9 (C3), B13.9 (C3), B21.9 (C3), B26.9 (C3), J3.4
Row4: B5.30 (R4), B6.10 (C4), B13.10 (C4), B21.10 (C4), B26.10 (C4), J3.5
Row5: B5.31 (R5), B6.11 (C5), B13.11 (C5), B21.11 (C5), B26.11 (C5), J3.6
Row6: B5.32 (R6), B6.13 (C6), B13.13 (C6), B21.13 (C6), B26.13 (C6), J3.7
Row7: B5.33 (R7), B6.14 (C7), B13.14 (C7), B21.14 (C7), B26.14 (C7), J3.8
Row8: B5.35 (R8), B6.15 (C8), B13.15 (C8), B21.15 (C8), B26.15 (C8), J3.9
Row9: B5.36 (R9), B6.16 (C9), B13.16 (C9), B21.16 (C9), B26.16 (C9), J3.10
Vertical Blank: B7.29 (Blank), B20.8 (Vertical_Blank)
Vertical Blank C3: B39.36 (Vertical_Blank__{CYCLE_3}), B40.4 (B0)
Vertical Blank C4: B39.26 (Vertical_Blank__{CYCLE_4}), B40.19 (E0)
Vertical Blank HC: B20.25 (Vertical_Blank_{OUT}), B39.9 (Vertical_Blank__{HALF_CYCLE})
Vertical Blank HC3: B39.40 (Vertical_Blank__{CYCLE_3H}), B40.1 (A0)
Vertical Blank HC4: B39.31 (Vertical_Blank__{CYCLE_4H}), B40.16 (C0)
Vertical Blank _{FINAL}: B36.10 (Vertical_Blank), B40.29 (Y3)
Vertical Sync: B7.22 (Sync), B20.15 (Vertical_Sync)
Vertical Sync C3: B39.35 (Vertical_Sync__{CYCLE_3}), B40.37 (B1)
Vertical Sync C4: B39.25 (Vertical_Sync__{CYCLE_4}), B40.22 (E1)
Vertical Sync HC: B20.26 (Vertical_Sync_{OUT}), B39.10 (Vertical_Sync__{HALF_CYCLE})
Vertical Sync HC3: B39.39 (Vertical_Sync__{CYCLE_3H}), B40.40 (A1)
Vertical Sync HC4: B39.30 (Vertical_Sync__{CYCLE_4H}), B40.25 (C1)
Vertical Sync Polarity: B8.18 (F0), B20.14 (Vertical_Sync_Polarity)
Vertical Sync _{FINAL}: B36.11 (Vertical_Sync), B40.30 (Y2)
Write Clear Interrupt: B8.3 (Write_Clear_Interrupt), B15.26 (Y1_{W})
Write Clock Select: B15.22 (Y5_{W}), B37.17 (Write_Clock_Select)
Write Flags: B8.7 (Write_Flags), B15.27 (Y0_{W})
Write Horizontal Back Porch End: B9.26 (Y1_{W}), B12.33 (Write_B)
Write Horizontal Back Porch Start: B9.27 (Y0_{W}), B12.26 (Write_A)
Write Horizontal Front Porch Start: B3.26 (Write_A), B15.20 (Y6_{W})
Write Horizontal Shift Pattern High: B1.7 (Write_Pattern_High), B9.24 (Y3_{W})
Write Horizontal Shift Pattern Low: B1.6 (Write_Pattern_Low), B9.25 (Y2_{W})
Write Horiztonal Sync Start: B3.33 (Write_B), B15.19 (Y7_{W})
Write Palette Byte: B23.20 (Y6_{W}), IC3.11 (LE)
Write Vertical Back Porch End High: B23.24 (Y3_{W}), B26.3 (Write_A_High)
Write Vertical Back Porch End Low: B23.25 (Y2_{W}), B26.4 (Write_A_Low)
Write Vertical Back Porch Start High: B21.3 (Write_A_High), B23.26 (Y1_{W})
Write Vertical Back Porch Start Low: B21.4 (Write_A_Low), B23.27 (Y0_{W})
Write Vertical Front Porch Start High: B6.3 (Write_A_High), B9.22 (Y5_{W})
Write Vertical Front Porch Start Low: B6.4 (Write_A_Low), B9.23 (Y4_{W})
Write Vertical Sync Start High: B9.19 (Y7_{W}), B13.3 (Write_A_High)
Write Vertical Sync Start Low: B9.20 (Y6_{W}), B13.4 (Write_A_Low)
Write Video Signal Delay: B23.19 (Y7_{W}), B40.18 (Write_Select)
~A3: B9.8 (~E2), B11.20 (~A3)
~A4: B9.9 (E3), B11.22 (~A4), B15.9 (E3)
~Device CLK: J5.B16
~Device Enable: B8.26 (~Enable), J5.B22
~Device Interrupt: B8.29 (~INT), J5.B19
~Device RAM: B10.2 (~Device_RAM), B11.23 (~Device_RAM), J4.9
~Device ROM: B10.5 (~Device_ROM), B11.25 (~Device_ROM), IC2.22 (~CE)
~Device Registers: B9.4 (~Device_Registers), B10.3 (~Device_Registers), B11.24 (~Device_Registers), B15.4 (~Device_Registers), B23.4 (~Device_Registers)
~Device Select: B10.11 (~Device_Select), B11.2 (~Device_Select), B16.33 (Deivce_~CS)
~Horizontal Back Porch End _{CMP}: B12.39 (~B=C), B14.13 (~Back_Porch_End)
~Horizontal Back Porch Start _{CMP}: B12.28 (~A=C), B14.11 (~Back_Porch_Start)
~Horizontal Blank: B1.3 (Enable_Pattern), B2.2 (~Load), B14.27 (~Blank)
~Horizontal Front Porch Start _{CMP}: B3.28 (~A=C), B14.4 (~Front_Porch_Start)
~Horizontal Sync Start _{CMP}: B3.39 (~B=C), B14.6 (~Sync_Start)
~Horizontal Sync: B14.20 (~Sync), B20.6 (~Horizontal_Sync)
~Main Access: J5.B11
~Main RD: J2.23, J5.D10
~Main WD: J2.22, J5.D11
~Main: J5.B9
~Memory A: J2.36, J5.B29
~Memory B: J2.37, J5.B30
~Pixel CLK_{0}: B14.8 (~CLK), B36.8 (CLK), B37.35 (~Pixel_CLK_{0})
~Pixel CLK_{1}: B2.40 (~CLK), B8.2 (Interrupt_CLK), B37.32 (~Pixel_CLK_{1}), B39.15 (~Pixel_CLK)
~Pixel CLK_{2}: B37.28 (~Pixel_CLK_{2}), J4.38
~Pixel CLK_{3}: B37.25 (~Pixel_CLK_{3}), J4.40
~RD: B9.15 (~RD), B10.10 (~RD), B15.15 (~RD), B16.46 (~RD), B23.15 (~RD), IC2.24 (~OE), J4.10
~Reset Device: B11.15 (~Reset_{IN1}), J5.B20
~Reset System: B11.14 (~Reset_{IN2}), J5.A1
~Reset: B1.2 (~Reset), B2.1 (~Reset), B5.1 (~Reset), B11.19 (~Reset_{OUT}), B37.4 (~Reset), J2.34
~Select Device: B16.32 (Deivce_~CS_{IN}), J5.B21
~Vertical Back Porch End: B5.2 (~Load), B7.18 (~Back_Porch_End)
~Vertical Back Porch End _{CMP}: B7.13 (~Back_Porch_End), B26.31 (~C=A)
~Vertical Back Porch Start _{CMP}: B7.11 (~Back_Porch_Start), B21.31 (~C=A)
~Vertical Blank: B7.27 (~Blank), B8.4 (~Set_Interrupt_on_CLK)
~Vertical Front Porch Start _{CMP}: B6.31 (~C=A), B7.4 (~Front_Porch_Start)
~Vertical Sync Start _{CMP}: B7.6 (~Sync_Start), B13.31 (~C=A)
~Vertical Sync: B7.20 (~Sync), B20.16 (~Vertical_Sync)
~WD: B9.16 (~WD), B10.12 (~WD), B15.16 (~WD), B16.45 (~WD), B23.16 (~WD), IC2.31 (~WE), J4.11

Notes on the sheet:
Bit [0..2]
Video Device Description ROM
Write
00404
007FF
00414
00411
Read
Horizontal Back Porch End
Pixel Clock
00400
Horizontal Pixel Signals
00401
Horizontal Pattern is a 12 bit cyclic shift register. When a 1 is present the Pixel Address is incremented. When a 0 is present it is not. It shifts every pixel clock.
0040A
Current Horizontal Low Byte
0040E
Device Socket
Configuration
1: Delay 3 clocks
00406
Video Clock and Pixel Address Tick
0: Delay 2½ clocks
3: Delay 4 clocks
Vertical Front Porch Start High
3: 32.5MHz
Video Horizontal and Vertical Singal Delay
Current Pixel Address Low Byte
Vertical Row Signals
Horiztonal Sync Start
Current Pixel Address High Byte
00413
2: Delay 3½ clocks
Pixel ~{CLK}_{0}, ~{CLK}_{1}, ~{CLK}_{2}, ~{CLK}_{3} are identical. Pixel CLK_{0}, CLK_{1}, CLK_{2}, CLK_{3} are identical. Clocks 0 and 1 are used on the bottom of the stacked boards. Clocks 2 and 3 are used on the top of the stacked boards.
Vertical Sync Start High
00407
1: Enable
Vertical Sync Start Low
1FFFF
Current Vertical Low Byte
1: 20MHZ
Power
003FF
Video Signal Synchronisation and Analogue Conversion
00412
Clear Interrupt
6: 65MHZ
Palette Byte
~{Load} on the 12bit Counter loads it with a value of 1. Explicitly IR0=1, IR1=0 Impliciyly IR[2..11]=0
00418
Board Stack Connectors
0040F
Horizontal ÷8 writes load Data bits 0..7 into the horizontal register bits 3..10 Zeros are loaded into bits 0..2
Video Device RAM
Bit 0: Vertical Sync Polarity
Horizontal Shift Pattern High 4 bits
Device bus memory map
00403
Vertical Front Porch Start Low
0040B
00409
Horizontal Back Porch Start
00402
Vertical Back Porch Start Low
00000
00800
Current Vertical High Byte
Bit 3: Palette Write
Current Horizontal High Byte
2: 25.175MHz
Vertical Back Porch Start High
Device Decode, Input Buffer and Clock Drag
Bit 1: Horizontal Sync Polarity
All four comparators will trigger for 8 pixel clock ticks. This will hold the connected blank and sync flip-flops in set or reset for 8 ticks (which is fine).
00410
0: 12.588MHz
00416
5: 40MHZ
Vertical Back Porch End Low
Current Pixel Address Bank Byte
7: 74.25MHz
0: Disable
00415
Unused Register Addresses
0040D
Bit [0..1]
0040C
00417
00405
Bit 3
Horizontal Front Porch Start
Vertical Back Porch End High
Bit 2: Memory Frame
Horizontal Shift Pattern Low 8 bits
00408
4: 37.125MHz
