andrewpaterson/658-Computer/Kicad/Computer/Video/Video Clock/Video Clock.kicad_sch

## KiCad design Kicad/Computer/Video/Video Clock/Video Clock.kicad_sch (2026-01-15)

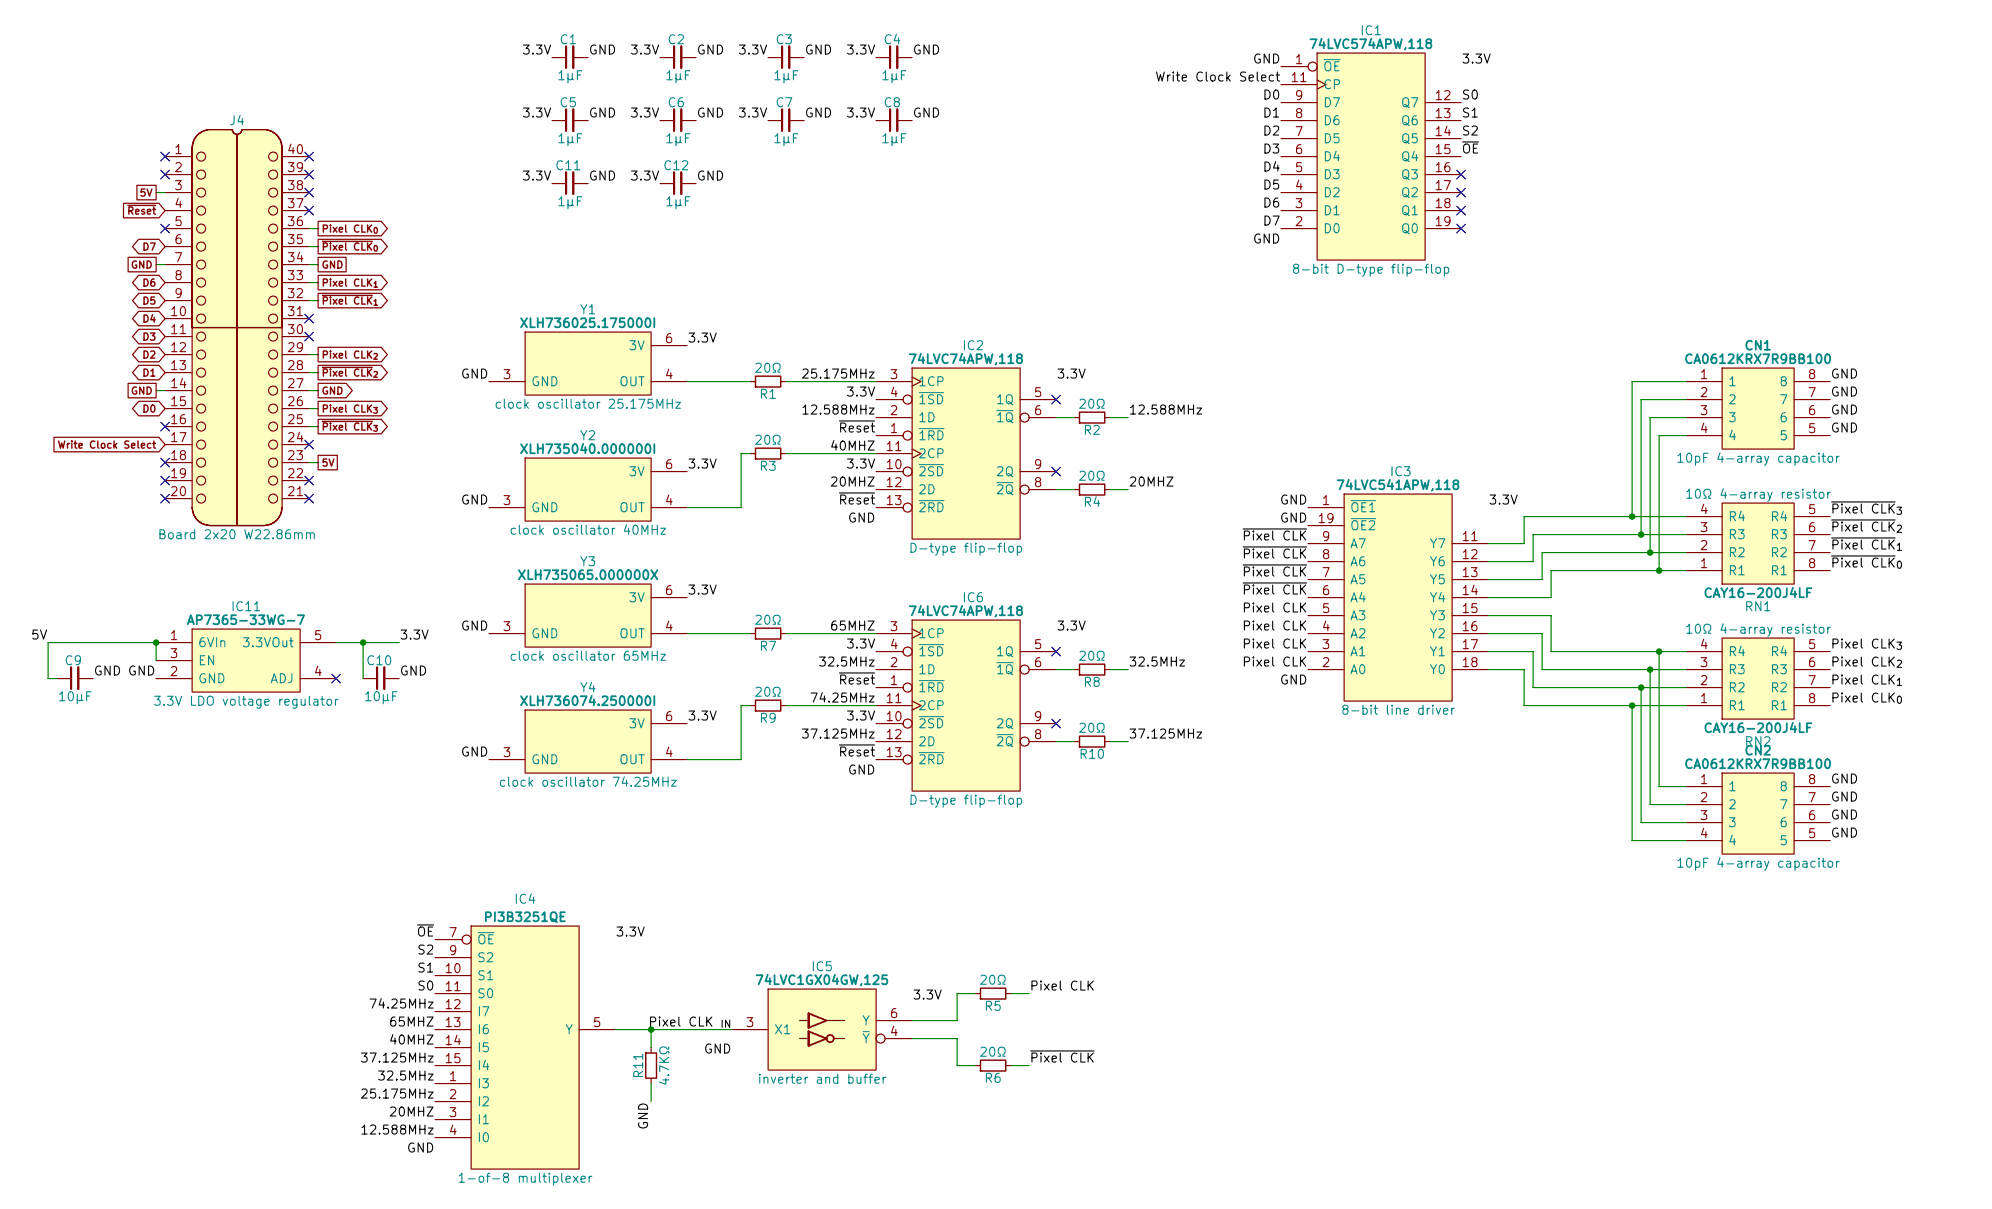
[picture p328: schematic Video Clock.kicad_sch]

Parts:
C1, C2, C3, C4, C5, C6, C7, C8, C11, C12: 1μF; C_0805
C9, C10: 10μF; C_0805
CN1, CN2: CA0612KRX7R9BB100; Manufacturer_Part_Number CA0612KRX7R9BB102; Mouser Part Number 603-CA612KRX7R9BB102
IC1: 74LVC574APW,118; SOP65P640X110-20N; Manufacturer_Part_Number 74LVC574APW,118; Mouser Part Number 771-74LVC574APW-T
IC2, IC6: 74LVC74APW,118; SOP65P640X110-14N; Mouser Part Number 771-74LVC74APW-T
IC3: 74LVC541APW,118; SOP65P640X110-20N; Mouser Part Number 771-74LVC541APW-T
IC4: PI3B3251QE; SOP64P599X175-16N; Manufacturer_Part_Number PI3B3251QE; Mouser Part Number 729-PI3B3251QE
IC5: 74LVC1GX04GW,125; SOP65P210X110-6N; Manufacturer_Part_Number 74LVC1GX04GW,125; Mouser Part Number 771-74LVC1GX04GW-G
IC11: AP7365-33WG-7; SOT95P285X130-5N; Manufacturer_Part_Number AP7365-33WG-7; Mouser Part Number 621-AP7365-33WG-7
J4: Board 2x20 W22.86mm; DIP-40_Board_W22.86mm
R1, R2, R3, R4, R5, R6, R7, R8, R9, R10: 20Ω; R_0805
R11: 4.7KΩ; R_0805
RN1, RN2: CAY16-200J4LF; CAY16-F4; Manufacturer_Part_Number CAY16-331J4LF; Mouser Part Number 652-CAY16-331J4LF
Y1: XLH736025.175000I; XLH736074250000I; Manufacturer_Part_Number XLH736025.175000I; Mouser Part Number 972-LH736025.175000I
Y2: XLH735040.000000I; XLH736074250000I; Manufacturer_Part_Number XLH735040.000000I; Mouser Part Number 972-LH735040.000000I
Y3: XLH735065.000000X; XLH735065000000X; Manufacturer_Part_Number XLH735065.000000X; Mouser Part Number 972-XLH735065000000X
Y4: XLH736074.250000I; XLH736074250000I; Manufacturer_Part_Number XLH736074.250000I; Mouser Part Number 972-XLH736074250000I

Connections:
3.3V: C1.1, C2.1, C3.1, C4.1, C5.1, C6.1, C7.1, C8.1, C10.1, C11.1, C12.1, IC1.20 (3V), IC2.4 (~1SD), IC2.10 (~2SD), IC2.14 (3V), IC3.20 (3V), IC4.16 (3V), IC5.5 (3V), IC6.4 (~1SD), IC6.10 (~2SD), IC6.14 (3V), IC11.5 (3.3VOut), Y1.6 (3V), Y2.6 (3V), Y3.6 (3V), Y4.6 (3V)
5V: C9.1, IC11.1 (6VIn), IC11.3 (EN), J4.3, J4.23
12.588MHz: IC2.2 (1D), IC4.4 (I0), R2.2
20MHZ: IC2.12 (2D), IC4.3 (I1), R4.2
25.175MHz: IC2.3 (1CP), IC4.2 (I2), R1.2
32.5MHz: IC4.1 (I3), IC6.2 (1D), R8.2
37.125MHz: IC4.15 (I4), IC6.12 (2D), R10.2
40MHZ: IC2.11 (2CP), IC4.14 (I5), R3.2
65MHZ: IC4.13 (I6), IC6.3 (1CP), R7.2
74.25MHz: IC4.12 (I7), IC6.11 (2CP), R9.2
D0: IC1.9 (D7), J4.15
D1: IC1.8 (D6), J4.13
D2: IC1.7 (D5), J4.12
D3: IC1.6 (D4), J4.11
D4: IC1.5 (D3), J4.10
D5: IC1.4 (D2), J4.9
D6: IC1.3 (D1), J4.8
D7: IC1.2 (D0), J4.6
GND: C1.2, C2.2, C3.2, C4.2, C5.2, C6.2, C7.2, C8.2, C9.2, C10.2, C11.2, C12.2, CN1.5, CN1.6, CN1.7, CN1.8, CN2.5, CN2.6, CN2.7, CN2.8, IC1.1 (~OE), IC1.10 (GND), IC2.7 (GND), IC3.1 (~OE1), IC3.10 (GND), IC3.19 (~OE2), IC4.8 (GND), IC5.2 (GND), IC6.7 (GND), IC11.2 (GND), J4.7, J4.14, J4.27, J4.34, R11.2, Y1.3 (GND), Y2.3 (GND), Y3.3 (GND), Y4.3 (GND)
unnamed: CN1.1, IC3.11 (Y7), RN1.4 (R4)
unnamed: CN1.2, IC3.12 (Y6), RN1.3 (R3)
unnamed: CN1.3, IC3.13 (Y5), RN1.2 (R2)
unnamed: CN1.4, IC3.14 (Y4), RN1.1 (R1)
unnamed: CN2.1, IC3.15 (Y3), RN2.4 (R4)
unnamed: CN2.2, IC3.16 (Y2), RN2.3 (R3)
unnamed: CN2.3, IC3.17 (Y1), RN2.2 (R2)
unnamed: CN2.4, IC3.18 (Y0), RN2.1 (R1)
unnamed: IC2.6 (~1Q), R2.1
unnamed: IC2.8 (~2Q), R4.1
unnamed: IC5.4 (~Y), R6.1
unnamed: IC5.6 (Y), R5.1
unnamed: IC6.6 (~1Q), R8.1
unnamed: IC6.8 (~2Q), R10.1
unnamed: R1.1, Y1.4 (OUT)
unnamed: R3.1, Y2.4 (OUT)
unnamed: R7.1, Y3.4 (OUT)
unnamed: R9.1, Y4.4 (OUT)
Pixel CLK: IC3.2 (A0), IC3.3 (A1), IC3.4 (A2), IC3.5 (A3), R5.2
Pixel CLK _{IN}: IC4.5 (Y), IC5.3 (X1), R11.1
Pixel CLK_{0}: J4.36, RN2.8 (R1)
Pixel CLK_{1}: J4.33, RN2.7 (R2)
Pixel CLK_{2}: J4.29, RN2.6 (R3)
Pixel CLK_{3}: J4.26, RN2.5 (R4)
S0: IC1.12 (Q7), IC4.11 (S0)
S1: IC1.13 (Q6), IC4.10 (S1)
S2: IC1.14 (Q5), IC4.9 (S2)
Write Clock Select: IC1.11 (CP), J4.17
~OE: IC1.15 (Q4), IC4.7 (~OE)
~Pixel CLK: IC3.6 (A4), IC3.7 (A5), IC3.8 (A6), IC3.9 (A7), R6.2
~Pixel CLK_{0}: J4.35, RN1.8 (R1)
~Pixel CLK_{1}: J4.32, RN1.7 (R2)
~Pixel CLK_{2}: J4.28, RN1.6 (R3)
~Pixel CLK_{3}: J4.25, RN1.5 (R4)
~Reset: IC2.1 (~1RD), IC2.13 (~2RD), IC6.1 (~1RD), IC6.13 (~2RD), J4.4
