andrewpaterson/658-Computer/Kicad/Computer/Video/Video Data Select/Video Data Select.kicad_sch

## KiCad design Kicad/Computer/Video/Video Data Select/Video Data Select.kicad_sch (2026-01-15)

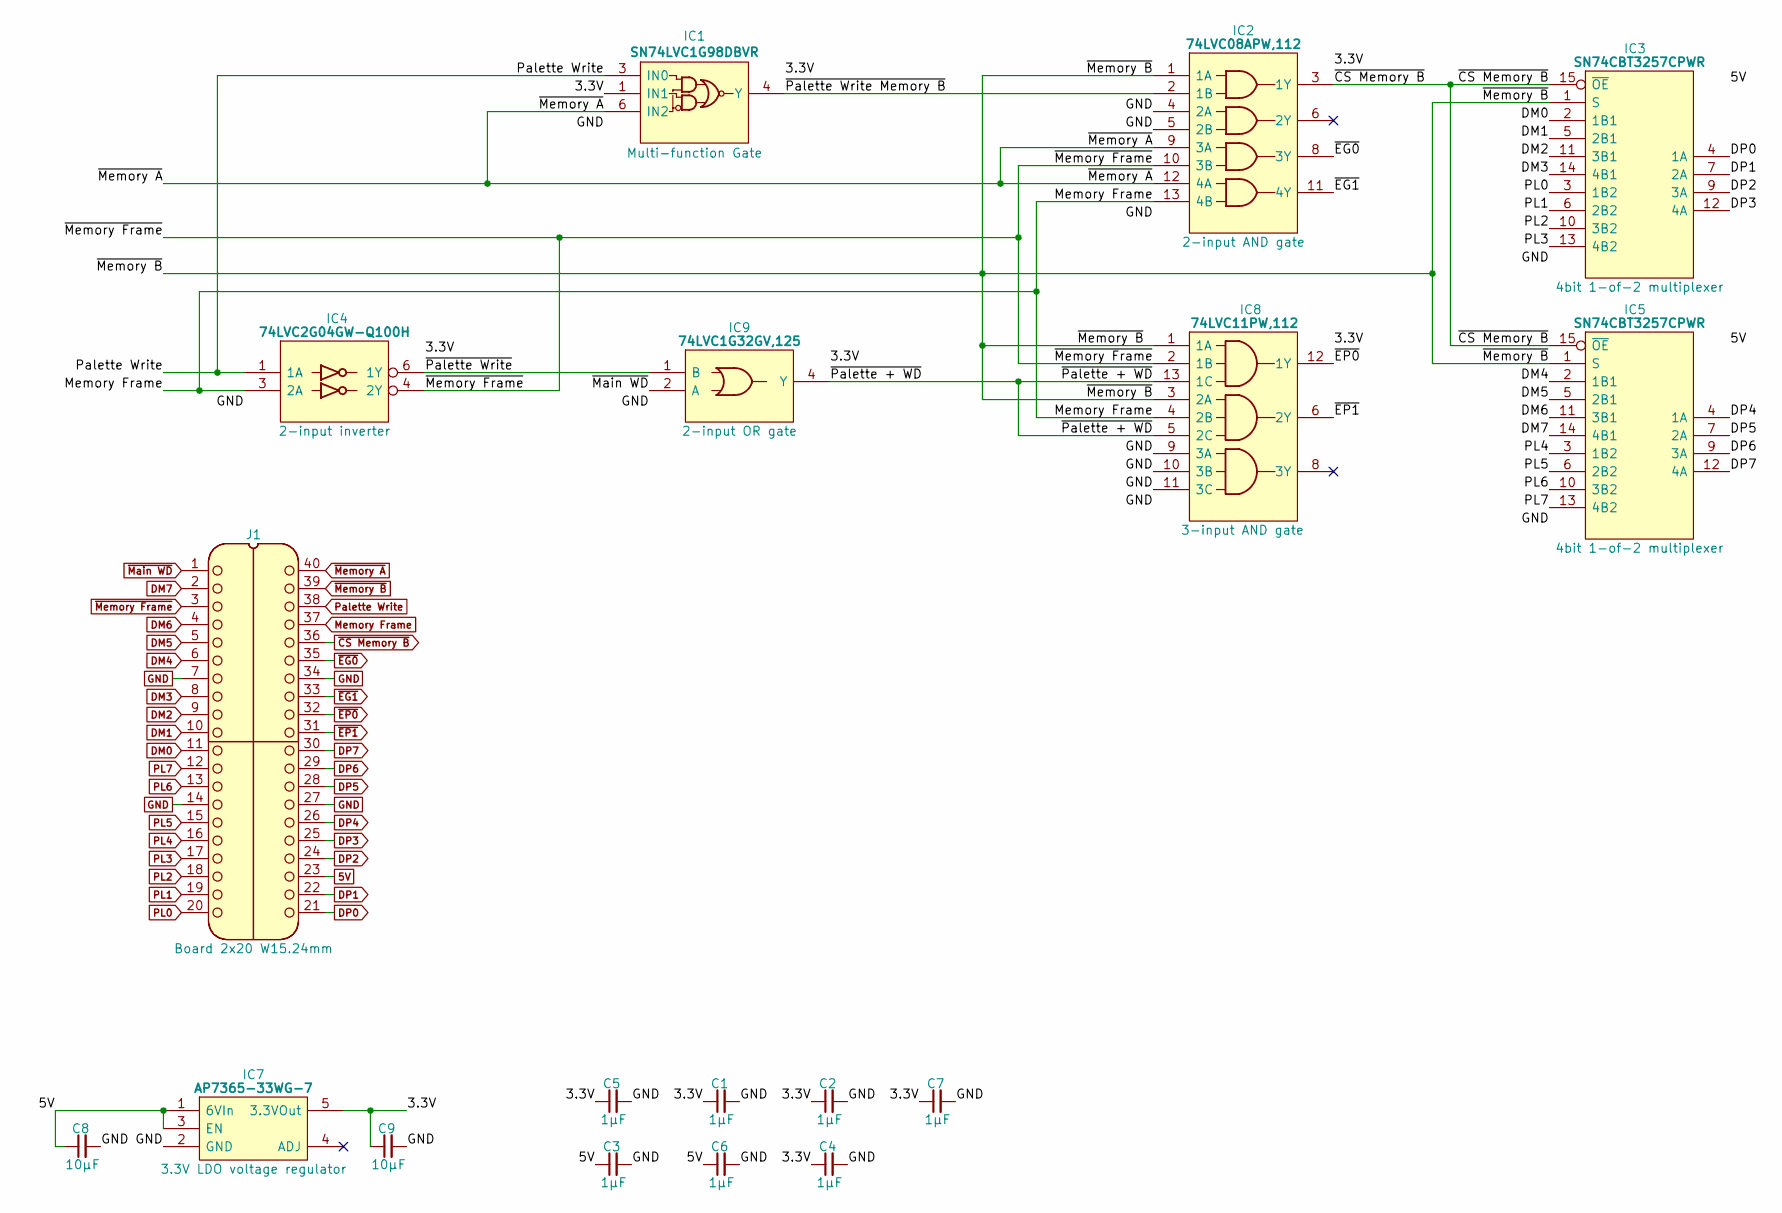
[picture p331: schematic Video Data Select.kicad_sch]

Parts:
C1, C2, C3, C4, C5, C6, C7: 1μF; C_0805
C8, C9: 10μF; C_0805
IC1: SN74LVC1G98DBVR; SOT95P280X145-6N; Manufacturer_Part_Number SN74LVC1G98DBVR; Mouser Part Number 595-SN74LVC1G98DBVR
IC2: 74LVC08APW,112; SOP65P640X110-14N; Manufacturer_Part_Number 74LVC08APW,112; Mouser Part Number 771-74LVC08APW
IC3, IC5: SN74CBT3257CPWR; SOP65P640X120-16N; Manufacturer_Part_Number SN74CBT3257CPWR; Mouser Part Number 595-SN74CBT3257CPWR
IC4: 74LVC2G04GW-Q100H; SOP65P210X110-6N; Manufacturer_Part_Number 74LVC2G04GW-Q100H; Mouser Part Number 771-74LVC2G04GWQ100H
IC7: AP7365-33WG-7; SOT95P285X130-5N; Manufacturer_Part_Number AP7365-33WG-7; Mouser Part Number 621-AP7365-33WG-7
IC8: 74LVC11PW,112; SOP65P640X110-14N; Mouser Part Number 771-LVC11PW112
IC9: 74LVC1G32GV,125; SOT95P275X110-5N; Manufacturer_Part_Number 74LVC1G32GV,125; Mouser Part Number 771-LVC1G32GV125
J1: Board 2x20 W15.24mm; DIP-40_Board_W15.24mm

Connections:
3.3V: C1.1, C2.1, C4.1, C5.1, C7.1, C9.1, IC1.1 (IN1), IC1.5 (3V), IC2.14 (3V), IC4.5 (3V), IC7.5 (3.3VOut), IC8.14 (3V), IC9.5 (3V)
5V: C3.1, C6.1, C8.1, IC3.16 (5V), IC5.16 (5V), IC7.1 (6VIn), IC7.3 (EN), J1.23
DM0: IC3.2 (1B1), J1.11
DM1: IC3.5 (2B1), J1.10
DM2: IC3.11 (3B1), J1.9
DM3: IC3.14 (4B1), J1.8
DM4: IC5.2 (1B1), J1.6
DM5: IC5.5 (2B1), J1.5
DM6: IC5.11 (3B1), J1.4
DM7: IC5.14 (4B1), J1.2
DP0: IC3.4 (1A), J1.21
DP1: IC3.7 (2A), J1.22
DP2: IC3.9 (3A), J1.24
DP3: IC3.12 (4A), J1.25
DP4: IC5.4 (1A), J1.26
DP5: IC5.7 (2A), J1.28
DP6: IC5.9 (3A), J1.29
DP7: IC5.12 (4A), J1.30
GND: C1.2, C2.2, C3.2, C4.2, C5.2, C6.2, C7.2, C8.2, C9.2, IC1.2 (GND), IC2.4 (2A), IC2.5 (2B), IC2.7 (GND), IC3.8 (GND), IC4.2 (GND), IC5.8 (GND), IC7.2 (GND), IC8.7 (GND), IC8.9 (3A), IC8.10 (3B), IC8.11 (3C), IC9.3 (GND), J1.7, J1.14, J1.27, J1.34
Memory Frame: IC2.13 (4B), IC4.3 (2A), IC8.4 (2B), J1.37
PL0: IC3.3 (1B2), J1.20
PL1: IC3.6 (2B2), J1.19
PL2: IC3.10 (3B2), J1.18
PL3: IC3.13 (4B2), J1.17
PL4: IC5.3 (1B2), J1.16
PL5: IC5.6 (2B2), J1.15
PL6: IC5.10 (3B2), J1.13
PL7: IC5.13 (4B2), J1.12
Palette Write: IC1.3 (IN0), IC4.1 (1A), J1.38
~CS Memory B: IC2.3 (1Y), IC3.15 (~OE), IC5.15 (~OE), J1.36
~EG0: IC2.8 (3Y), J1.35
~EG1: IC2.11 (4Y), J1.33
~EP0: IC8.12 (1Y), J1.32
~EP1: IC8.6 (2Y), J1.31
~Main WD: IC9.2 (A), J1.1
~Memory A: IC1.6 (IN2), IC2.9 (3A), IC2.12 (4A), J1.40
~Memory B: IC2.1 (1A), IC3.1 (S), IC5.1 (S), IC8.1 (1A), IC8.3 (2A), J1.39
~Memory Frame: IC2.10 (3B), IC4.4 (2Y), IC8.2 (1B), J1.3
~Palette + WD: IC8.5 (2C), IC8.13 (1C), IC9.4 (Y)
~Palette Write Memory B: IC1.4 (Y), IC2.2 (1B)
~Palette Write: IC4.6 (1Y), IC9.1 (B)
