andrewpaterson/658-Computer/Kicad/Computer/Video/Video Device RAM Select/Video Device RAM Select.kicad_sch

## KiCad design Kicad/Computer/Video/Video Device RAM Select/Video Device RAM Select.kicad_sch (2026-01-15)

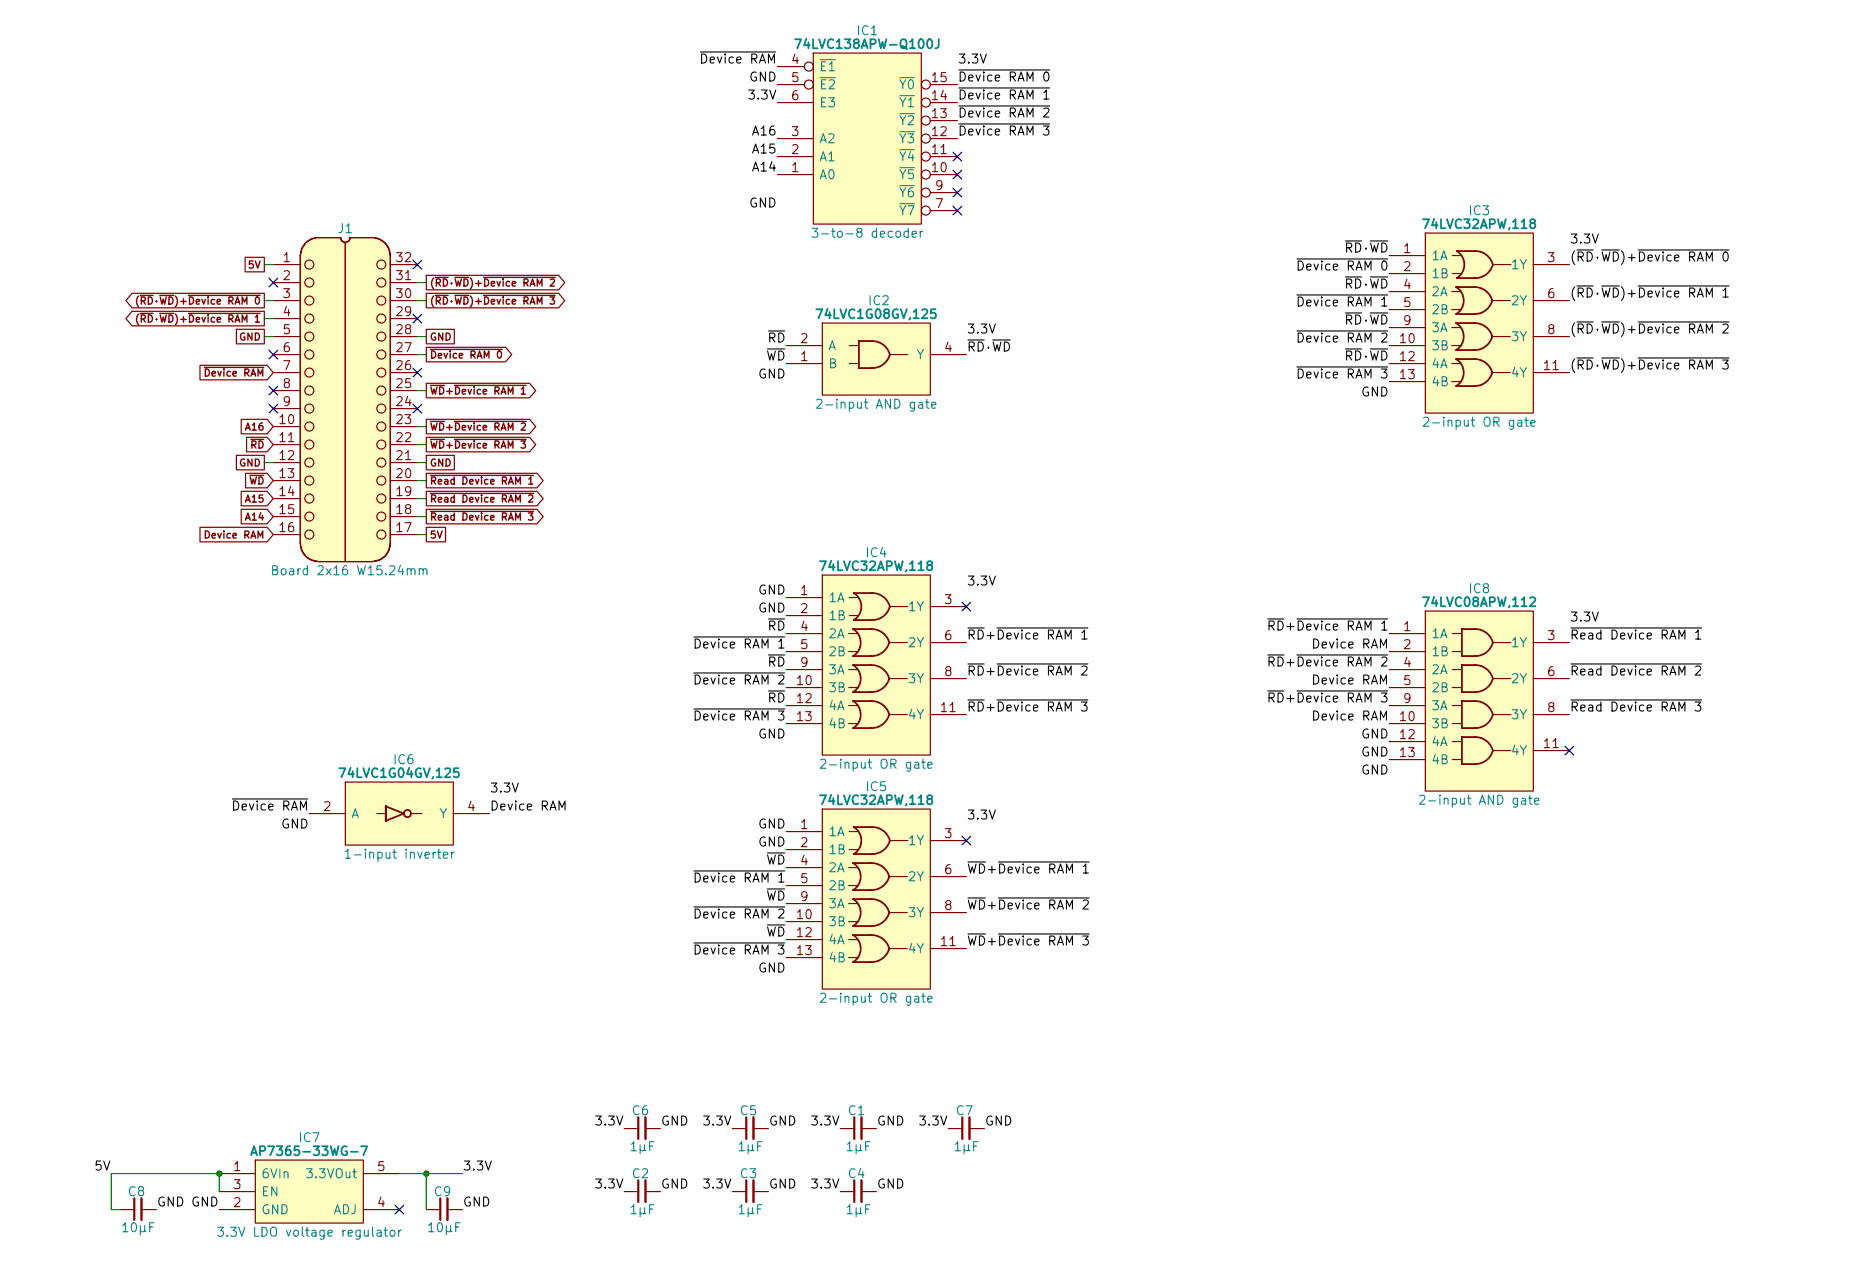
[picture p332: schematic Video Device RAM Select.kicad_sch]

Parts:
C1, C2, C3, C4, C5, C6, C7: 1μF; C_0805
C8, C9: 10µF; C_0805
IC1: 74LVC138APW-Q100J; SOP65P640X110-16N; Mouser Part Number 771-74LVC138APWQ100J
IC2: 74LVC1G08GV,125; SOT95P275X110-5N; Manufacturer_Part_Number 74LVC1G08GV,125; Mouser Part Number 771-74LVC1G08GV
IC3, IC4, IC5: 74LVC32APW,118; SOP65P640X110-14N; Manufacturer_Part_Number 74LVC32APW,118; Mouser Part Number 771-74LVC32APW-T
IC6: 74LVC1G04GV,125; SOT95P275X110-5N; Manufacturer_Part_Number 74LVC1G04GV,125; Mouser Part Number 771-74LVC1G04GV
IC7: AP7365-33WG-7; SOT95P285X130-5N; Manufacturer_Part_Number AP7365-33WG-7; Mouser Part Number 621-AP7365-33WG-7
IC8: 74LVC08APW,112; SOP65P640X110-14N; Manufacturer_Part_Number 74LVC08APW,112; Mouser Part Number 771-74LVC08APW
J1: Board 2x16 W15.24mm; DIP-32_Board_W15.24mm

Connections:
3.3V: C1.1, C2.1, C3.1, C4.1, C5.1, C6.1, C7.1, C9.1, IC1.6 (E3), IC1.16 (3V), IC2.5 (3V), IC3.14 (3V), IC4.14 (3V), IC5.14 (3V), IC6.5 (3V), IC7.5 (3.3VOut), IC8.14 (3V)
5V: C8.1, IC7.1 (6VIn), IC7.3 (EN), J1.1, J1.17
(~RD·~WD)+~Device RAM 0: IC3.3 (1Y), J1.3
(~RD·~WD)+~Device RAM 1: IC3.6 (2Y), J1.4
(~RD·~WD)+~Device RAM 2: IC3.8 (3Y), J1.31
(~RD·~WD)+~Device RAM 3: IC3.11 (4Y), J1.30
A14: IC1.1 (A0), J1.15
A15: IC1.2 (A1), J1.14
A16: IC1.3 (A2), J1.10
Device RAM: IC6.4 (Y), IC8.2 (1B), IC8.5 (2B), IC8.10 (3B), J1.16
GND: C1.2, C2.2, C3.2, C4.2, C5.2, C6.2, C7.2, C8.2, C9.2, IC1.5 (~E2), IC1.8 (GND), IC2.3 (GND), IC3.7 (GND), IC4.1 (1A), IC4.2 (1B), IC4.7 (GND), IC5.1 (1A), IC5.2 (1B), IC5.7 (GND), IC6.3 (GND), IC7.2 (GND), IC8.7 (GND), IC8.12 (4A), IC8.13 (4B), J1.5, J1.12, J1.21, J1.28
~Device RAM 0: IC1.15 (~Y0), IC3.2 (1B), J1.27
~Device RAM 1: IC1.14 (~Y1), IC3.5 (2B), IC4.5 (2B), IC5.5 (2B)
~Device RAM 2: IC1.13 (~Y2), IC3.10 (3B), IC4.10 (3B), IC5.10 (3B)
~Device RAM 3: IC1.12 (~Y3), IC3.13 (4B), IC4.13 (4B), IC5.13 (4B)
~Device RAM: IC1.4 (~E1), IC6.2 (A), J1.7
~RD: IC2.2 (A), IC4.4 (2A), IC4.9 (3A), IC4.12 (4A), J1.11
~RD+~Device RAM 1: IC4.6 (2Y), IC8.1 (1A)
~RD+~Device RAM 2: IC4.8 (3Y), IC8.4 (2A)
~RD+~Device RAM 3: IC4.11 (4Y), IC8.9 (3A)
~RD·~WD: IC2.4 (Y), IC3.1 (1A), IC3.4 (2A), IC3.9 (3A), IC3.12 (4A)
~Read Device RAM 1: IC8.3 (1Y), J1.20
~Read Device RAM 2: IC8.6 (2Y), J1.19
~Read Device RAM 3: IC8.8 (3Y), J1.18
~WD: IC2.1 (B), IC5.4 (2A), IC5.9 (3A), IC5.12 (4A), J1.13
~WD+~Device RAM 1: IC5.6 (2Y), J1.25
~WD+~Device RAM 2: IC5.8 (3Y), J1.23
~WD+~Device RAM 3: IC5.11 (4Y), J1.22
