andrewpaterson/658-Computer/Kicad/Computer/Video/Video Memory 2MB/Video Memory 2MB.kicad_sch

## KiCad design Kicad/Computer/Video/Video Memory 2MB/Video Memory 2MB.kicad_sch (2026-01-15)

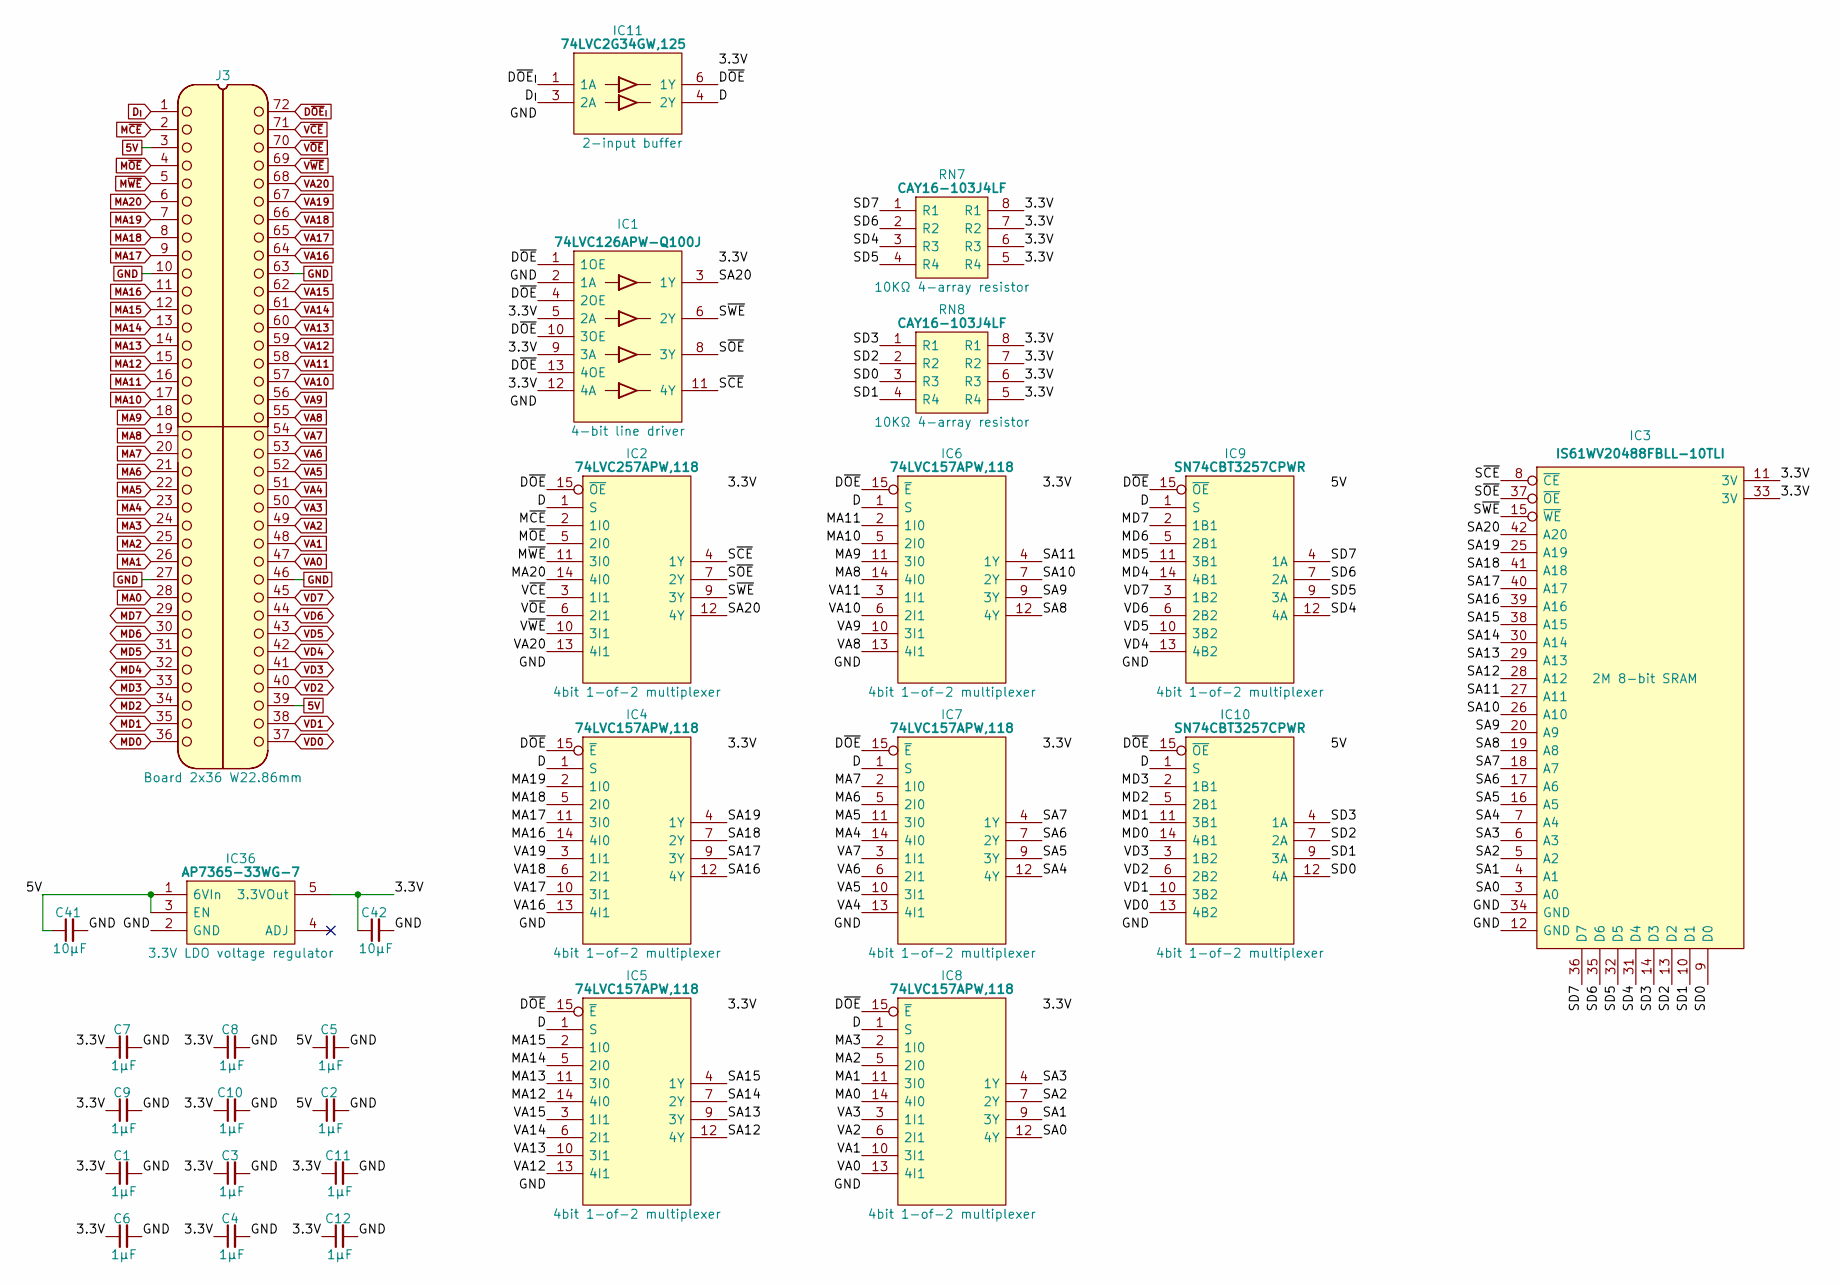
[picture p333: schematic Video Memory 2MB.kicad_sch]

Parts:
C1, C2, C3, C4, C5, C6, C7, C8, C9, C10, C11, C12: 1μF; C_0805
C41, C42: 10μF; C_0805
IC1: 74LVC126APW-Q100J; SOP65P640X110-14N; Mouser Part Number 771-74LVC126APW-Q100J
IC2: 74LVC257APW,118; SOP65P640X110-16N; Manufacturer_Part_Number 74LVC257APW,118; Mouser Part Number 771-74LVC257APW-T
IC3: IS61WV20488FBLL-10TLI; SOP80P1176X120-44N; Mouser Part Number 870-61W20488FBLL10TI
IC4, IC5, IC6, IC7, IC8: 74LVC157APW,118; SOP65P640X110-16N; Manufacturer_Part_Number 74LVC157APW,118; Mouser Part Number 771-74LVC157APW-T
IC9, IC10: SN74CBT3257CPWR; SOP65P640X120-16N; Manufacturer_Part_Number SN74CBT3257CPWR; Mouser Part Number 595-SN74CBT3257CPWR
IC11: 74LVC2G34GW,125; 74LVC2G34GW125; Manufacturer_Part_Number 74LVC2G34GW,125; Mouser Part Number 771-LVC2G34GW125
IC36: AP7365-33WG-7; SOT95P285X130-5N; Manufacturer_Part_Number AP7365-33WG-7; Mouser Part Number 621-AP7365-33WG-7
J3: Board 2x36 W22.86mm; DIP-72_Board_W22.86mm
RN7, RN8: CAY16-103J4LF; CAY16-J4; Manufacturer_Part_Number CAY16-103J4LF; Mouser Part Number 652-CAY16-103J4LF

Connections:
3.3V: C1.1, C3.1, C4.1, C6.1, C7.1, C8.1, C9.1, C10.1, C11.1, C12.1, C42.1, IC1.5 (2A), IC1.9 (3A), IC1.12 (4A), IC1.14 (3V), IC2.16 (3V), IC3.11 (3V), IC3.33 (3V), IC4.16 (3V), IC5.16 (3V), IC6.16 (3V), IC7.16 (3V), IC8.16 (3V), IC11.5 (3V), IC36.5 (3.3VOut), RN7.5 (R4), RN7.6 (R3), RN7.7 (R2), RN7.8 (R1), RN8.5 (R4), RN8.6 (R3), RN8.7 (R2), RN8.8 (R1)
5V: C2.1, C5.1, C41.1, IC9.16 (5V), IC10.16 (5V), IC36.1 (6VIn), IC36.3 (EN), J3.3, J3.39
D: IC2.1 (S), IC4.1 (S), IC5.1 (S), IC6.1 (S), IC7.1 (S), IC8.1 (S), IC9.1 (S), IC10.1 (S), IC11.4 (2Y)
D_{I}: IC11.3 (2A), J3.1
D~OE: IC1.1 (1OE), IC1.4 (2OE), IC1.10 (3OE), IC1.13 (4OE), IC2.15 (~OE), IC4.15 (~E), IC5.15 (~E), IC6.15 (~E), IC7.15 (~E), IC8.15 (~E), IC9.15 (~OE), IC10.15 (~OE), IC11.6 (1Y)
D~OE_{I}: IC11.1 (1A), J3.72
GND: C1.2, C2.2, C3.2, C4.2, C5.2, C6.2, C7.2, C8.2, C9.2, C10.2, C11.2, C12.2, C41.2, C42.2, IC1.2 (1A), IC1.7 (GND), IC2.8 (GND), IC3.12 (GND), IC3.34 (GND), IC4.8 (GND), IC5.8 (GND), IC6.8 (GND), IC7.8 (GND), IC8.8 (GND), IC9.8 (GND), IC10.8 (GND), IC11.2 (GND), IC36.2 (GND), J3.10, J3.27, J3.46, J3.63
MA0: IC8.14 (4I0), J3.28
MA1: IC8.11 (3I0), J3.26
MA2: IC8.5 (2I0), J3.25
MA3: IC8.2 (1I0), J3.24
MA4: IC7.14 (4I0), J3.23
MA5: IC7.11 (3I0), J3.22
MA6: IC7.5 (2I0), J3.21
MA7: IC7.2 (1I0), J3.20
MA8: IC6.14 (4I0), J3.19
MA9: IC6.11 (3I0), J3.18
MA10: IC6.5 (2I0), J3.17
MA11: IC6.2 (1I0), J3.16
MA12: IC5.14 (4I0), J3.15
MA13: IC5.11 (3I0), J3.14
MA14: IC5.5 (2I0), J3.13
MA15: IC5.2 (1I0), J3.12
MA16: IC4.14 (4I0), J3.11
MA17: IC4.11 (3I0), J3.9
MA18: IC4.5 (2I0), J3.8
MA19: IC4.2 (1I0), J3.7
MA20: IC2.14 (4I0), J3.6
MD0: IC10.14 (4B1), J3.36
MD1: IC10.11 (3B1), J3.35
MD2: IC10.5 (2B1), J3.34
MD3: IC10.2 (1B1), J3.33
MD4: IC9.14 (4B1), J3.32
MD5: IC9.11 (3B1), J3.31
MD6: IC9.5 (2B1), J3.30
MD7: IC9.2 (1B1), J3.29
M~CE: IC2.2 (1I0), J3.2
M~OE: IC2.5 (2I0), J3.4
M~WE: IC2.11 (3I0), J3.5
SA0: IC3.3 (A0), IC8.12 (4Y)
SA1: IC3.4 (A1), IC8.9 (3Y)
SA2: IC3.5 (A2), IC8.7 (2Y)
SA3: IC3.6 (A3), IC8.4 (1Y)
SA4: IC3.7 (A4), IC7.12 (4Y)
SA5: IC3.16 (A5), IC7.9 (3Y)
SA6: IC3.17 (A6), IC7.7 (2Y)
SA7: IC3.18 (A7), IC7.4 (1Y)
SA8: IC3.19 (A8), IC6.12 (4Y)
SA9: IC3.20 (A9), IC6.9 (3Y)
SA10: IC3.26 (A10), IC6.7 (2Y)
SA11: IC3.27 (A11), IC6.4 (1Y)
SA12: IC3.28 (A12), IC5.12 (4Y)
SA13: IC3.29 (A13), IC5.9 (3Y)
SA14: IC3.30 (A14), IC5.7 (2Y)
SA15: IC3.38 (A15), IC5.4 (1Y)
SA16: IC3.39 (A16), IC4.12 (4Y)
SA17: IC3.40 (A17), IC4.9 (3Y)
SA18: IC3.41 (A18), IC4.7 (2Y)
SA19: IC3.25 (A19), IC4.4 (1Y)
SA20: IC1.3 (1Y), IC2.12 (4Y), IC3.42 (A20)
SD0: IC3.9 (D0), IC10.12 (4A), RN8.3 (R3)
SD1: IC3.10 (D1), IC10.9 (3A), RN8.4 (R4)
SD2: IC3.13 (D2), IC10.7 (2A), RN8.2 (R2)
SD3: IC3.14 (D3), IC10.4 (1A), RN8.1 (R1)
SD4: IC3.31 (D4), IC9.12 (4A), RN7.3 (R3)
SD5: IC3.32 (D5), IC9.9 (3A), RN7.4 (R4)
SD6: IC3.35 (D6), IC9.7 (2A), RN7.2 (R2)
SD7: IC3.36 (D7), IC9.4 (1A), RN7.1 (R1)
S~CE: IC1.11 (4Y), IC2.4 (1Y), IC3.8 (~CE)
S~OE: IC1.8 (3Y), IC2.7 (2Y), IC3.37 (~OE)
S~WE: IC1.6 (2Y), IC2.9 (3Y), IC3.15 (~WE)
VA0: IC8.13 (4I1), J3.47
VA1: IC8.10 (3I1), J3.48
VA2: IC8.6 (2I1), J3.49
VA3: IC8.3 (1I1), J3.50
VA4: IC7.13 (4I1), J3.51
VA5: IC7.10 (3I1), J3.52
VA6: IC7.6 (2I1), J3.53
VA7: IC7.3 (1I1), J3.54
VA8: IC6.13 (4I1), J3.55
VA9: IC6.10 (3I1), J3.56
VA10: IC6.6 (2I1), J3.57
VA11: IC6.3 (1I1), J3.58
VA12: IC5.13 (4I1), J3.59
VA13: IC5.10 (3I1), J3.60
VA14: IC5.6 (2I1), J3.61
VA15: IC5.3 (1I1), J3.62
VA16: IC4.13 (4I1), J3.64
VA17: IC4.10 (3I1), J3.65
VA18: IC4.6 (2I1), J3.66
VA19: IC4.3 (1I1), J3.67
VA20: IC2.13 (4I1), J3.68
VD0: IC10.13 (4B2), J3.37
VD1: IC10.10 (3B2), J3.38
VD2: IC10.6 (2B2), J3.40
VD3: IC10.3 (1B2), J3.41
VD4: IC9.13 (4B2), J3.42
VD5: IC9.10 (3B2), J3.43
VD6: IC9.6 (2B2), J3.44
VD7: IC9.3 (1B2), J3.45
V~CE: IC2.3 (1I1), J3.71
V~OE: IC2.6 (2I1), J3.70
V~WE: IC2.10 (3I1), J3.69
