andrewpaterson/658-Computer/Kicad/Computer/Video/Video Pixel Advance/Video Pixel Advance.kicad_sch

## KiCad design Kicad/Computer/Video/Video Pixel Advance/Video Pixel Advance.kicad_sch (2026-01-15)

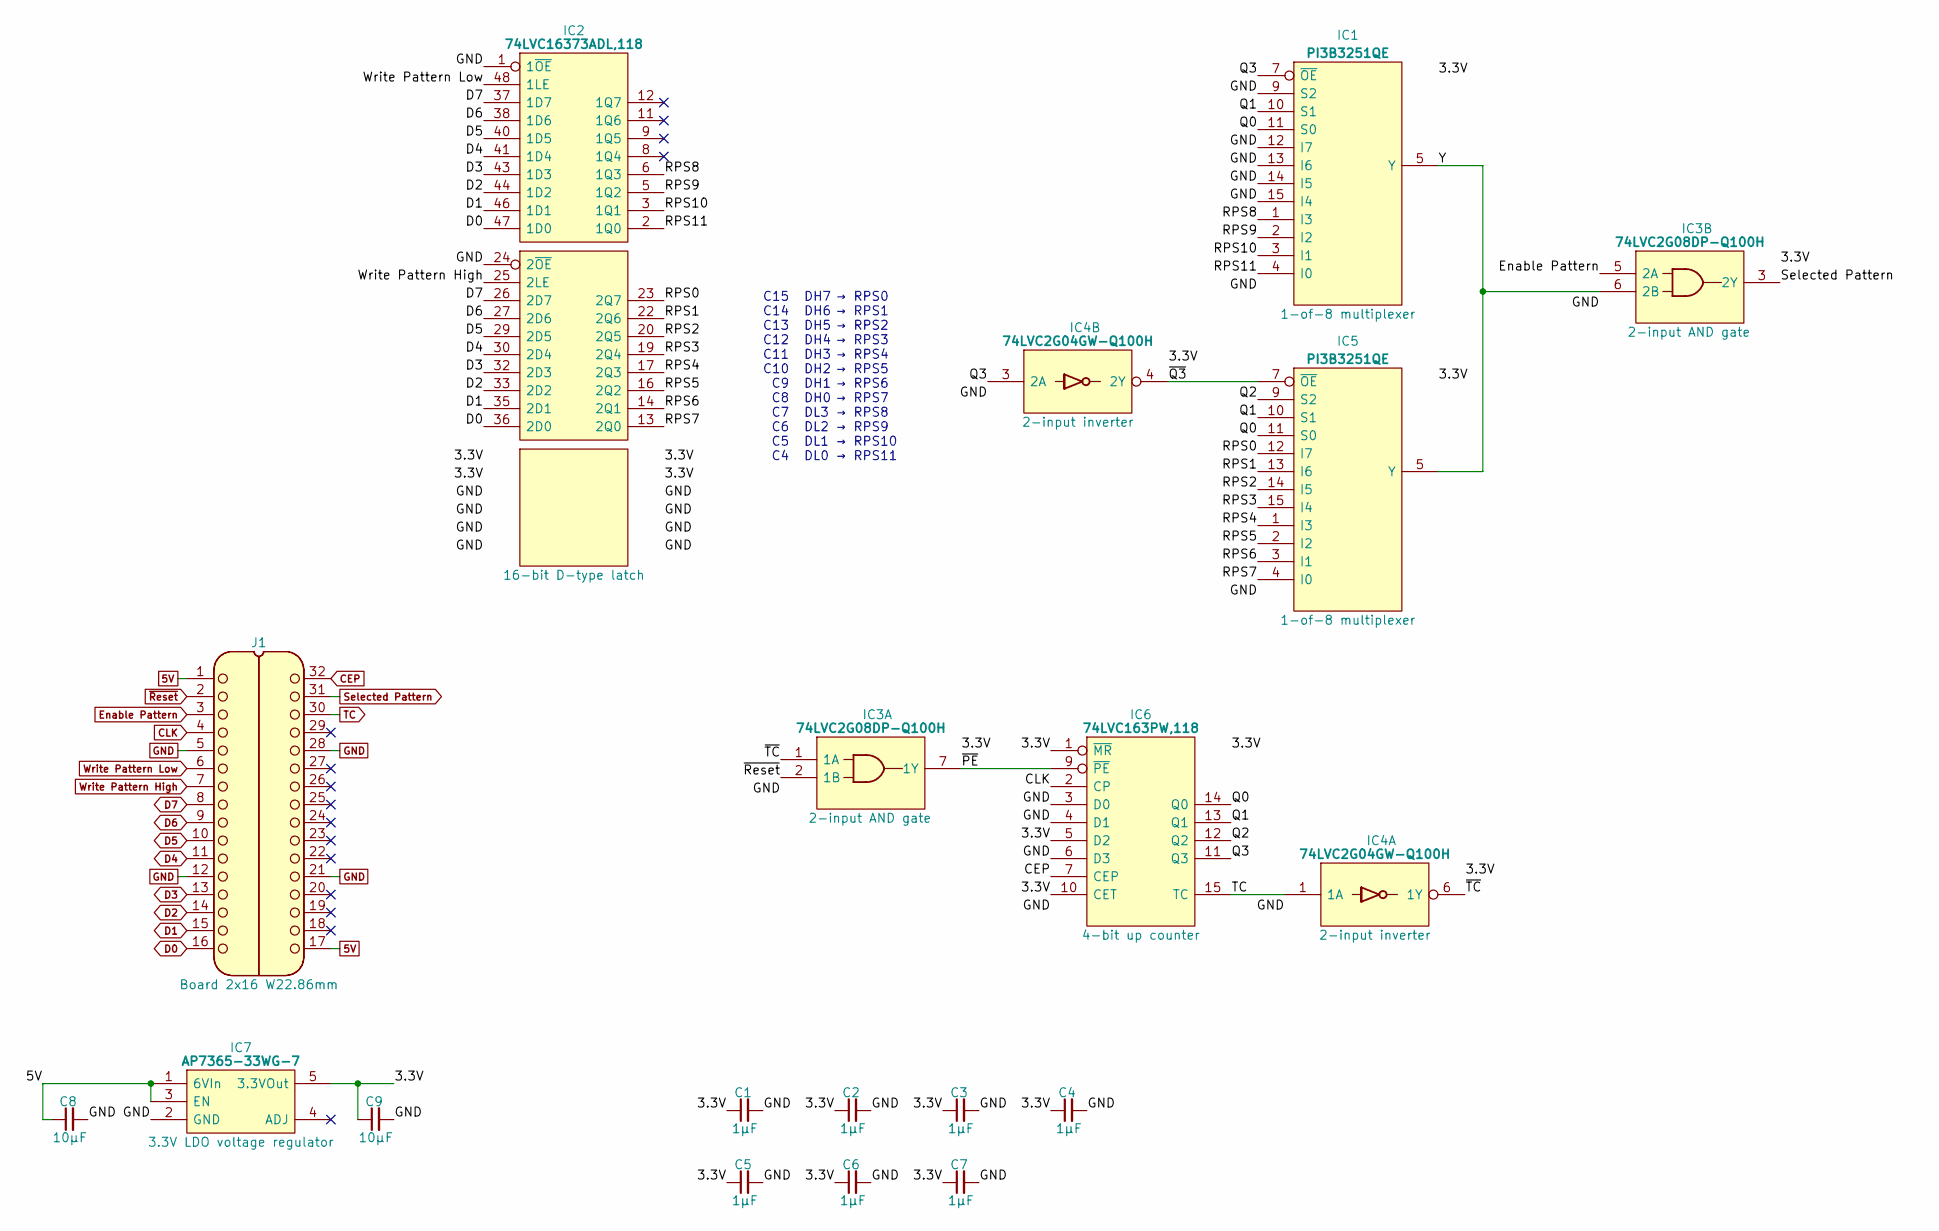
[picture p334: schematic Video Pixel Advance.kicad_sch]

Parts:
C1, C2, C3, C4, C5, C6, C7: 1μF; C_0805
C8, C9: 10µF; C_0805
IC1, IC5: PI3B3251QE; SOP64P599X175-16N; Manufacturer_Part_Number PI3B3251QE; Mouser Part Number 729-PI3B3251QE
IC2: 74LVC16373ADL,118; SOP64P1025X280-48N; Mouser Part Number 771-LVC16373ADL118
IC3: 74LVC2G08DP-Q100H; SOP65P400X110-8N; Manufacturer_Part_Number 74LVC2G08DP-Q100H; Mouser Part Number 771-74LVC2G08DPQ100H
IC4: 74LVC2G04GW-Q100H; SOP65P210X110-6N; Manufacturer_Part_Number 74LVC2G04GW-Q100H; Mouser Part Number 771-74LVC2G04GWQ100H
IC6: 74LVC163PW,118; SOP65P640X110-16N; Mouser Part Number 771-74LVC163PW-T
IC7: AP7365-33WG-7; SOT95P285X130-5N; Manufacturer_Part_Number AP7365-33WG-7; Mouser Part Number 621-AP7365-33WG-7
J1: Board 2x16 W22.86mm; DIP-32_Board_W22.86mm

Connections:
3.3V: C1.1, C2.1, C3.1, C4.1, C5.1, C6.1, C7.1, C9.1, IC1.16 (3V), IC2.7 (3V), IC2.18 (3V), IC2.31 (3V), IC2.42 (3V), IC3.8 (3V), IC4.5 (3V), IC5.16 (3V), IC6.1 (~MR), IC6.5 (D2), IC6.10 (CET), IC6.16 (3V), IC7.5 (3.3VOut)
5V: C8.1, IC7.1 (6VIn), IC7.3 (EN), J1.1, J1.17
CEP: IC6.7 (CEP), J1.32
CLK: IC6.2 (CP), J1.4
D0: IC2.36 (2D0), IC2.47 (1D0), J1.16
D1: IC2.35 (2D1), IC2.46 (1D1), J1.15
D2: IC2.33 (2D2), IC2.44 (1D2), J1.14
D3: IC2.32 (2D3), IC2.43 (1D3), J1.13
D4: IC2.30 (2D4), IC2.41 (1D4), J1.11
D5: IC2.29 (2D5), IC2.40 (1D5), J1.10
D6: IC2.27 (2D6), IC2.38 (1D6), J1.9
D7: IC2.26 (2D7), IC2.37 (1D7), J1.8
Enable Pattern: IC3.5 (2A), J1.3
GND: C1.2, C2.2, C3.2, C4.2, C5.2, C6.2, C7.2, C8.2, C9.2, IC1.8 (GND), IC1.9 (S2), IC1.12 (I7), IC1.13 (I6), IC1.14 (I5), IC1.15 (I4), IC2.1 (1~OE), IC2.4 (GND), IC2.10 (GND), IC2.15 (GND), IC2.21 (GND), IC2.24 (2~OE), IC2.28 (GND), IC2.34 (GND), IC2.39 (GND), IC2.45 (GND), IC3.4 (GND), IC4.2 (GND), IC5.8 (GND), IC6.3 (D0), IC6.4 (D1), IC6.6 (D3), IC6.8 (GND), IC7.2 (GND), J1.5, J1.12, J1.21, J1.28
Q0: IC1.11 (S0), IC5.11 (S0), IC6.14 (Q0)
Q1: IC1.10 (S1), IC5.10 (S1), IC6.13 (Q1)
Q2: IC5.9 (S2), IC6.12 (Q2)
Q3: IC1.7 (~OE), IC4.3 (2A), IC6.11 (Q3)
RPS0: IC2.23 (2Q7), IC5.12 (I7)
RPS1: IC2.22 (2Q6), IC5.13 (I6)
RPS2: IC2.20 (2Q5), IC5.14 (I5)
RPS3: IC2.19 (2Q4), IC5.15 (I4)
RPS4: IC2.17 (2Q3), IC5.1 (I3)
RPS5: IC2.16 (2Q2), IC5.2 (I2)
RPS6: IC2.14 (2Q1), IC5.3 (I1)
RPS7: IC2.13 (2Q0), IC5.4 (I0)
RPS8: IC1.1 (I3), IC2.6 (1Q3)
RPS9: IC1.2 (I2), IC2.5 (1Q2)
RPS10: IC1.3 (I1), IC2.3 (1Q1)
RPS11: IC1.4 (I0), IC2.2 (1Q0)
Selected Pattern: IC3.3 (2Y), J1.31
TC: IC4.1 (1A), IC6.15 (TC), J1.30
Write Pattern High: IC2.25 (2LE), J1.7
Write Pattern Low: IC2.48 (1LE), J1.6
Y: IC1.5 (Y), IC3.6 (2B), IC5.5 (Y)
~PE: IC3.7 (1Y), IC6.9 (~PE)
~Q3: IC4.4 (2Y), IC5.7 (~OE)
~Reset: IC3.2 (1B), J1.2
~TC: IC3.1 (1A), IC4.6 (1Y)

Notes on the sheet:
C15 C14 C13 C12 C11 C10 C9 C8 C7 C6 C5 C4
DH7 DH6 DH5 DH4 DH3 DH2 DH1 DH0 DL3 DL2 DL1 DL0
→ RPS0 → RPS1 → RPS2 → RPS3 → RPS4 → RPS5 → RPS6 → RPS7 → RPS8 → RPS9 → RPS10 → RPS11
