andrewpaterson/658-Computer/Kicad/Computer/Video/Video Row Latch/Video Row Latch.kicad_sch

## KiCad design Kicad/Computer/Video/Video Row Latch/Video Row Latch.kicad_sch (2026-01-15)

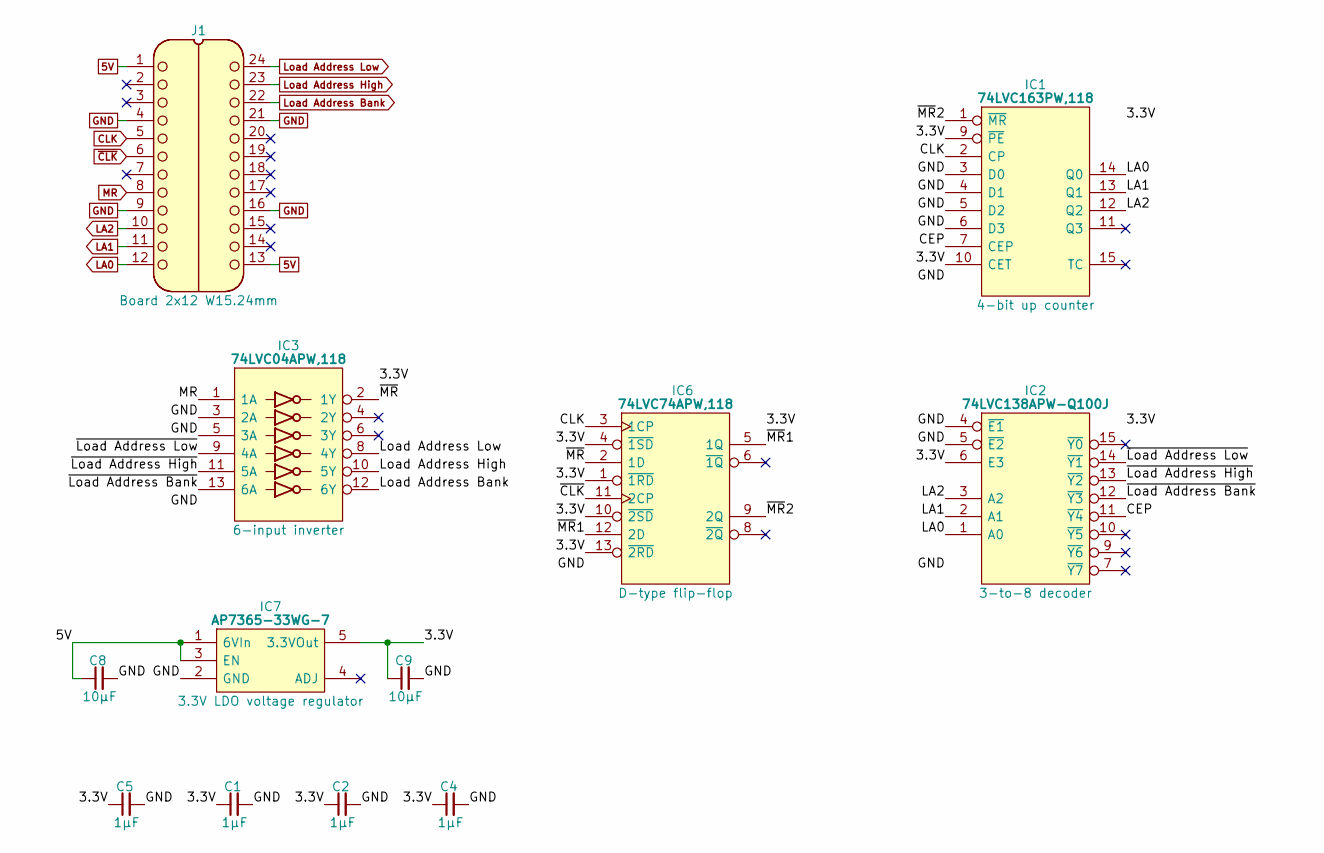
[picture p335: schematic Video Row Latch.kicad_sch]

Parts:
C1, C2, C4, C5: 1μF; C_0805
C8, C9: 10μF; C_0805
IC1: 74LVC163PW,118; SOP65P640X110-16N; Mouser Part Number 771-74LVC163PW-T
IC2: 74LVC138APW-Q100J; SOP65P640X110-16N; Mouser Part Number 771-74LVC138APWQ100J
IC3: 74LVC04APW,118; SOP65P640X110-14N; Manufacturer_Part_Number 74LVC04APW,118; Mouser Part Number 771-74LVC04APW-T
IC6: 74LVC74APW,118; SOP65P640X110-14N; Mouser Part Number 771-74LVC74APW-T
IC7: AP7365-33WG-7; SOT95P285X130-5N; Manufacturer_Part_Number AP7365-33WG-7; Mouser Part Number 621-AP7365-33WG-7
J1: Board 2x12 W15.24mm; DIP-24_Board_W15.24mm

Connections:
3.3V: C1.1, C2.1, C4.1, C5.1, C9.1, IC1.9 (~PE), IC1.10 (CET), IC1.16 (3V), IC2.6 (E3), IC2.16 (3V), IC3.14 (3V), IC6.1 (~1RD), IC6.4 (~1SD), IC6.10 (~2SD), IC6.13 (~2RD), IC6.14 (3V), IC7.5 (3.3VOut)
5V: C8.1, IC7.1 (6VIn), IC7.3 (EN), J1.1, J1.13
CEP: IC1.7 (CEP), IC2.11 (~Y4)
CLK: IC1.2 (CP), IC6.3 (1CP), J1.5
GND: C1.2, C2.2, C4.2, C5.2, C8.2, C9.2, IC1.3 (D0), IC1.4 (D1), IC1.5 (D2), IC1.6 (D3), IC1.8 (GND), IC2.4 (~E1), IC2.5 (~E2), IC2.8 (GND), IC3.3 (2A), IC3.5 (3A), IC3.7 (GND), IC6.7 (GND), IC7.2 (GND), J1.4, J1.9, J1.16, J1.21
LA0: IC1.14 (Q0), IC2.1 (A0), J1.12
LA1: IC1.13 (Q1), IC2.2 (A1), J1.11
LA2: IC1.12 (Q2), IC2.3 (A2), J1.10
Load Address Bank: IC3.12 (6Y), J1.22
Load Address High: IC3.10 (5Y), J1.23
Load Address Low: IC3.8 (4Y), J1.24
MR: IC3.1 (1A), J1.8
~CLK: IC6.11 (2CP), J1.6
~Load Address Bank: IC2.12 (~Y3), IC3.13 (6A)
~Load Address High: IC2.13 (~Y2), IC3.11 (5A)
~Load Address Low: IC2.14 (~Y1), IC3.9 (4A)
~MR: IC3.2 (1Y), IC6.2 (1D)
~MR1: IC6.5 (1Q), IC6.12 (2D)
~MR2: IC1.1 (~MR), IC6.9 (2Q)
