andrewpaterson/658-Computer/Kicad/Computer/Video/Video Signal Dragger/Video Signal Dragger.kicad_sch

## KiCad design Kicad/Computer/Video/Video Signal Dragger/Video Signal Dragger.kicad_sch (2026-01-15)

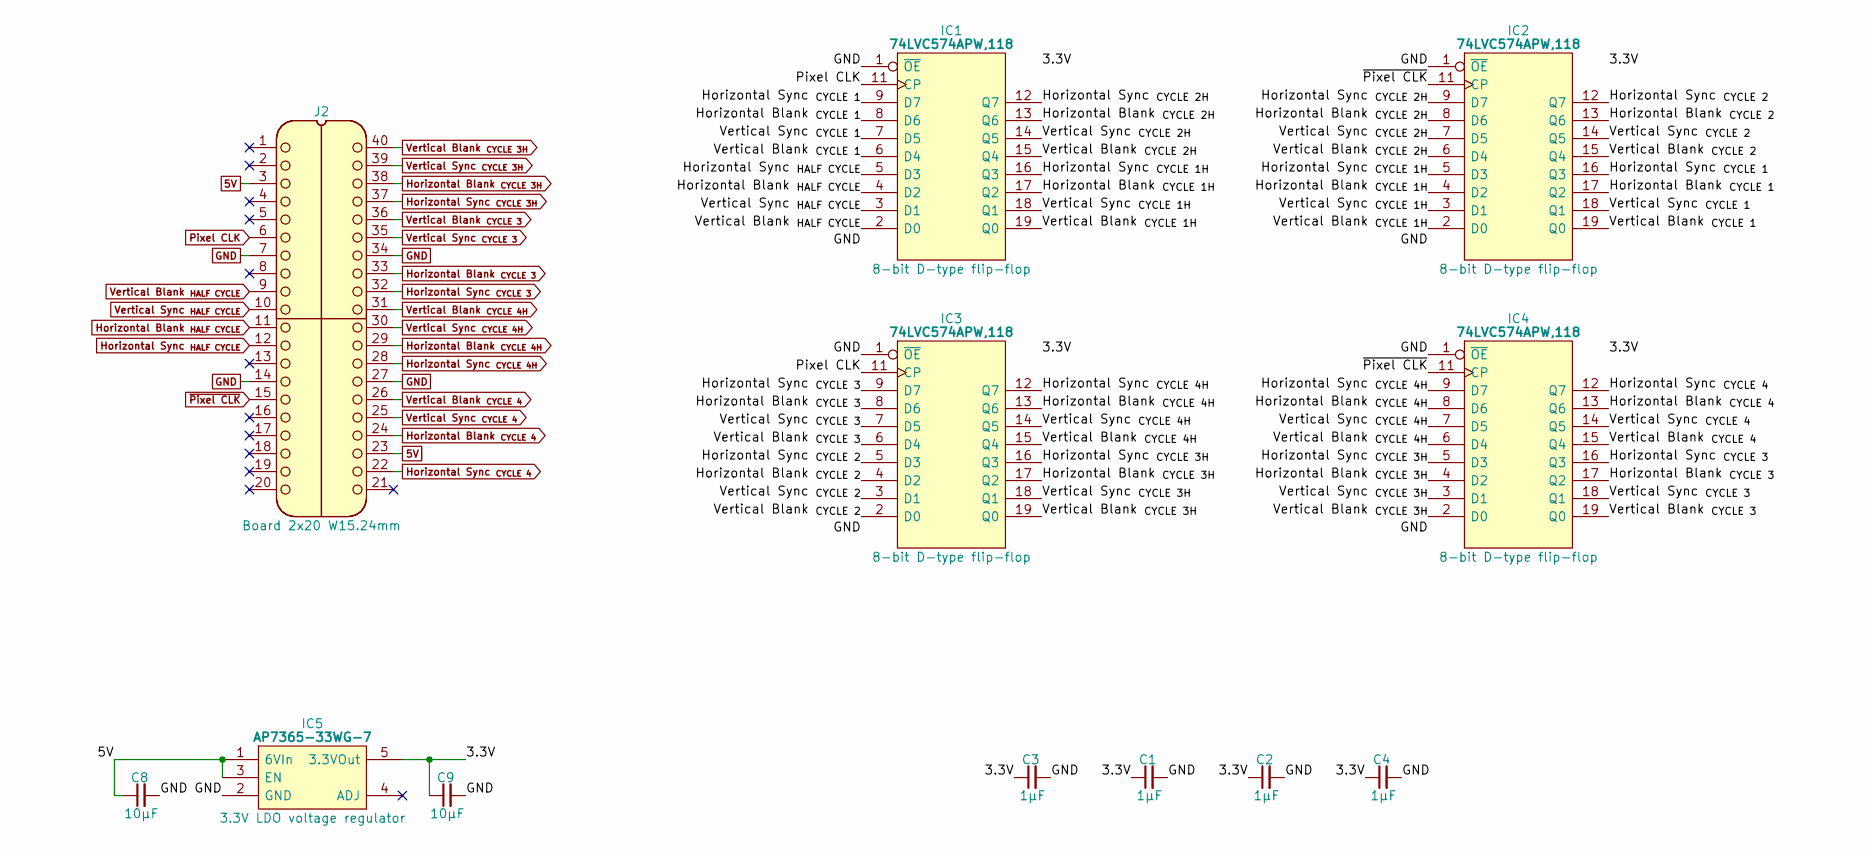
[picture p336: schematic Video Signal Dragger.kicad_sch]

Parts:
C1, C2, C3, C4: 1μF; C_0805
C8, C9: 10µF; C_0805
IC1, IC2, IC3, IC4: 74LVC574APW,118; SOP65P640X110-20N; Manufacturer_Part_Number 74LVC574APW,118; Mouser Part Number 771-74LVC574APW-T
IC5: AP7365-33WG-7; SOT95P285X130-5N; Manufacturer_Part_Number AP7365-33WG-7; Mouser Part Number 621-AP7365-33WG-7
J2: Board 2x20 W15.24mm; DIP-40_Board_W15.24mm

Connections:
3.3V: C1.1, C2.1, C3.1, C4.1, C9.1, IC1.20 (3V), IC2.20 (3V), IC3.20 (3V), IC4.20 (3V), IC5.5 (3.3VOut)
5V: C8.1, IC5.1 (6VIn), IC5.3 (EN), J2.3, J2.23
GND: C1.2, C2.2, C3.2, C4.2, C8.2, C9.2, IC1.1 (~OE), IC1.10 (GND), IC2.1 (~OE), IC2.10 (GND), IC3.1 (~OE), IC3.10 (GND), IC4.1 (~OE), IC4.10 (GND), IC5.2 (GND), J2.7, J2.14, J2.27, J2.34
Horizontal Blank _{CYCLE 1H}: IC1.17 (Q2), IC2.4 (D2)
Horizontal Blank _{CYCLE 1}: IC1.8 (D6), IC2.17 (Q2)
Horizontal Blank _{CYCLE 2H}: IC1.13 (Q6), IC2.8 (D6)
Horizontal Blank _{CYCLE 2}: IC2.13 (Q6), IC3.4 (D2)
Horizontal Blank _{CYCLE 3H}: IC3.17 (Q2), IC4.4 (D2), J2.38
Horizontal Blank _{CYCLE 3}: IC3.8 (D6), IC4.17 (Q2), J2.33
Horizontal Blank _{CYCLE 4H}: IC3.13 (Q6), IC4.8 (D6), J2.29
Horizontal Blank _{CYCLE 4}: IC4.13 (Q6), J2.24
Horizontal Blank _{HALF CYCLE}: IC1.4 (D2), J2.11
Horizontal Sync _{CYCLE 1H}: IC1.16 (Q3), IC2.5 (D3)
Horizontal Sync _{CYCLE 1}: IC1.9 (D7), IC2.16 (Q3)
Horizontal Sync _{CYCLE 2H}: IC1.12 (Q7), IC2.9 (D7)
Horizontal Sync _{CYCLE 2}: IC2.12 (Q7), IC3.5 (D3)
Horizontal Sync _{CYCLE 3H}: IC3.16 (Q3), IC4.5 (D3), J2.37
Horizontal Sync _{CYCLE 3}: IC3.9 (D7), IC4.16 (Q3), J2.32
Horizontal Sync _{CYCLE 4H}: IC3.12 (Q7), IC4.9 (D7), J2.28
Horizontal Sync _{CYCLE 4}: IC4.12 (Q7), J2.22
Horizontal Sync _{HALF CYCLE}: IC1.5 (D3), J2.12
Pixel CLK: IC1.11 (CP), IC3.11 (CP), J2.6
Vertical Blank _{CYCLE 1H}: IC1.19 (Q0), IC2.2 (D0)
Vertical Blank _{CYCLE 1}: IC1.6 (D4), IC2.19 (Q0)
Vertical Blank _{CYCLE 2H}: IC1.15 (Q4), IC2.6 (D4)
Vertical Blank _{CYCLE 2}: IC2.15 (Q4), IC3.2 (D0)
Vertical Blank _{CYCLE 3H}: IC3.19 (Q0), IC4.2 (D0), J2.40
Vertical Blank _{CYCLE 3}: IC3.6 (D4), IC4.19 (Q0), J2.36
Vertical Blank _{CYCLE 4H}: IC3.15 (Q4), IC4.6 (D4), J2.31
Vertical Blank _{CYCLE 4}: IC4.15 (Q4), J2.26
Vertical Blank _{HALF CYCLE}: IC1.2 (D0), J2.9
Vertical Sync _{CYCLE 1H}: IC1.18 (Q1), IC2.3 (D1)
Vertical Sync _{CYCLE 1}: IC1.7 (D5), IC2.18 (Q1)
Vertical Sync _{CYCLE 2H}: IC1.14 (Q5), IC2.7 (D5)
Vertical Sync _{CYCLE 2}: IC2.14 (Q5), IC3.3 (D1)
Vertical Sync _{CYCLE 3H}: IC3.18 (Q1), IC4.3 (D1), J2.39
Vertical Sync _{CYCLE 3}: IC3.7 (D5), IC4.18 (Q1), J2.35
Vertical Sync _{CYCLE 4H}: IC3.14 (Q5), IC4.7 (D5), J2.30
Vertical Sync _{CYCLE 4}: IC4.14 (Q5), J2.25
Vertical Sync _{HALF CYCLE}: IC1.3 (D1), J2.10
~Pixel CLK: IC2.11 (CP), IC4.11 (CP), J2.15
