andrewpaterson/658-Computer/Kicad/Computer/Video/Video Signals Output/Video Signals Output.kicad_sch

## KiCad design Kicad/Computer/Video/Video Signals Output/Video Signals Output.kicad_sch (2026-01-15)

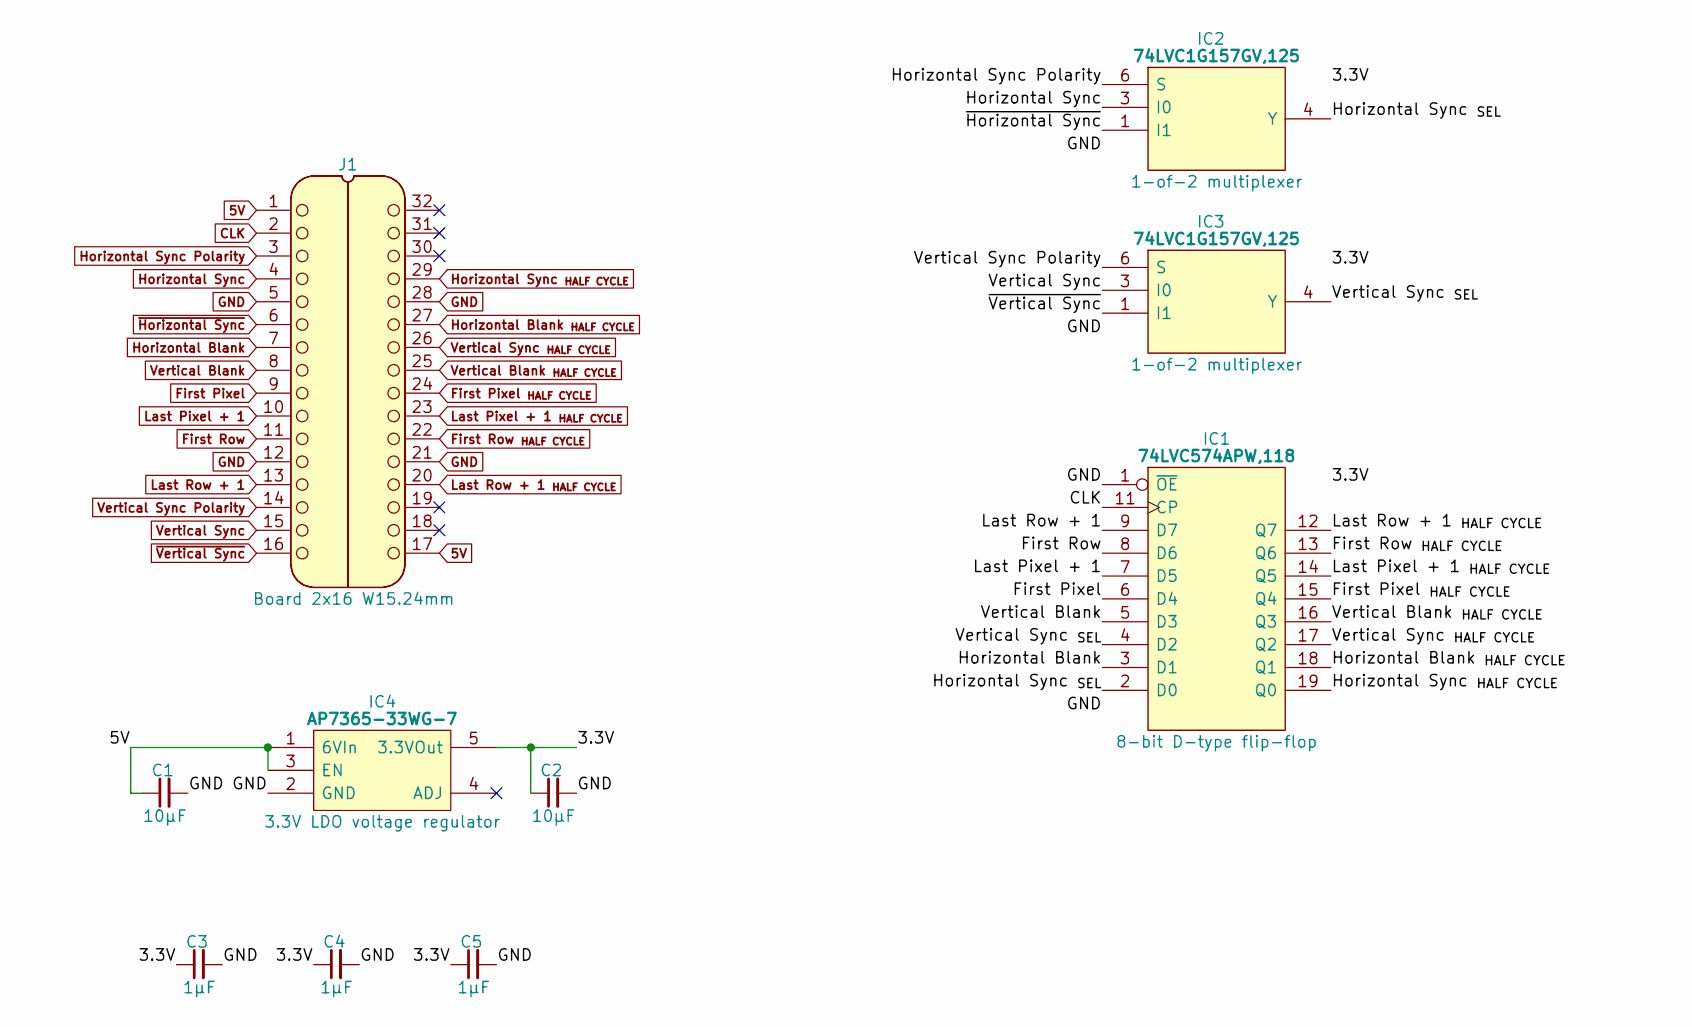
[picture p337: schematic Video Signals Output.kicad_sch]

Parts:
C1, C2: 10µF; C_0805
C3, C4, C5: 1μF; C_0805
IC1: 74LVC574APW,118; SOP65P640X110-20N; Manufacturer_Part_Number 74LVC574APW,118; Mouser Part Number 771-74LVC574APW-T
IC2, IC3: 74LVC1G157GV,125; 74LVC1G157GV125; Manufacturer_Part_Number 74LVC1G157GV,125; Mouser Part Number 771-74LVC1G157GV-G
IC4: AP7365-33WG-7; SOT95P285X130-5N; Manufacturer_Part_Number AP7365-33WG-7; Mouser Part Number 621-AP7365-33WG-7
J1: Board 2x16 W15.24mm; DIP-32_Board_W15.24mm

Connections:
3.3V: C2.1, C3.1, C4.1, C5.1, IC1.20 (3V), IC2.5 (3V), IC3.5 (3V), IC4.5 (3.3VOut)
5V: C1.1, IC4.1 (6VIn), IC4.3 (EN), J1.1, J1.17
CLK: IC1.11 (CP), J1.2
First Pixel: IC1.6 (D4), J1.9
First Pixel _{HALF CYCLE}: IC1.15 (Q4), J1.24
First Row: IC1.8 (D6), J1.11
First Row _{HALF CYCLE}: IC1.13 (Q6), J1.22
GND: C1.2, C2.2, C3.2, C4.2, C5.2, IC1.1 (~OE), IC1.10 (GND), IC2.2 (GND), IC3.2 (GND), IC4.2 (GND), J1.5, J1.12, J1.21, J1.28
Horizontal Blank: IC1.3 (D1), J1.7
Horizontal Blank _{HALF CYCLE}: IC1.18 (Q1), J1.27
Horizontal Sync: IC2.3 (I0), J1.4
Horizontal Sync Polarity: IC2.6 (S), J1.3
Horizontal Sync _{HALF CYCLE}: IC1.19 (Q0), J1.29
Horizontal Sync _{SEL}: IC1.2 (D0), IC2.4 (Y)
Last Pixel + 1: IC1.7 (D5), J1.10
Last Pixel + 1 _{HALF CYCLE}: IC1.14 (Q5), J1.23
Last Row + 1: IC1.9 (D7), J1.13
Last Row + 1 _{HALF CYCLE}: IC1.12 (Q7), J1.20
Vertical Blank: IC1.5 (D3), J1.8
Vertical Blank _{HALF CYCLE}: IC1.16 (Q3), J1.25
Vertical Sync: IC3.3 (I0), J1.15
Vertical Sync Polarity: IC3.6 (S), J1.14
Vertical Sync _{HALF CYCLE}: IC1.17 (Q2), J1.26
Vertical Sync _{SEL}: IC1.4 (D2), IC3.4 (Y)
~Horizontal Sync: IC2.1 (I1), J1.6
~Vertical Sync: IC3.1 (I1), J1.16
