andrewpaterson/658-Computer/(commit log)

2021-08-05 Initial commit. Kicad and Logisim projects.
    [65C816_Unit.kicad_pcb, 65C816_Unit.sch, Address Decode.circ]
2021-08-06 Added a third priority encoder.
    [Address Decode.circ]
2021-08-06 Cleaned up interrupt decoder.
    [Address Decode.circ]
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2021-08-07 Setting up the CPU board.
    [Address Decode.circ]
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2021-08-07 Trying to emulate interrupt calls
    [Address Decode.circ]
2021-08-07 Lots of cleanup in MPU emulation.
    [Address Decode.circ]
2021-08-07 Added VPB and some stop circuitry.
    [Address Decode.circ]
2021-08-07 Buffering between PRG and INT running.
    [Address Decode.circ]
2021-08-08 INT and PRG run separately correctly.
    [Address Decode.circ]
2021-08-08 Neatened up the 65C816 surrounds.
    [Address Decode.circ]
2021-08-08 Added an interrupt latch.
    [Address Decode.circ]
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2021-08-08 Simplified required ICs for interrupt vectoring.
    [Address Decode.circ]
2021-08-09 Simplified interrupt latching to one counter flip-flop.
    [Address Decode.circ]
2021-08-09 Memory and latch copy.
    [Address Decode.circ]
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2021-08-10 Added a bus transceiver to work around logisims lack of bi-drectional pins.
    [Address Decode.circ]
2021-08-21 Added an LCD bus reader accidentally.
    [Address Decode.circ, LCD Bus Reader.kicad_pcb, LCD Bus Reader.sch]
2021-08-21 Schematic for LCD Reader.
    [LCD Bus Reader.sch]
2021-08-24 Latch inputs into BUS reader.
    [LCD Bus Reader.kicad_pcb, LCD Bus Reader.sch]
2021-08-24 Added Microtips NMTC-16205 footprint.
    [LCD Bus Reader.kicad_pcb]
2021-08-24 Added filled copper layers.
    [LCD Bus Reader.kicad_pcb, LCD Bus Reader.sch]
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2021-08-27 Version 1 complete. Gerber generated.
    [LCD Bus Reader.kicad_pcb, LCD Bus Reader.sch]
2021-08-27 Added the beginnings of the 658 CPU.
    [658 CPU.circ, Address Decode.circ]
2021-08-27 Fixed missing tracers and re-generated Gerber files.
    [LCD Bus Reader.kicad_pcb, LCD Bus Reader.sch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]
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2021-08-29 Reverted Address Decode circuit.
    [Address Decode.circ]
2021-08-30 Pretty complete 658 CPU board.
    [658 CPU.circ]
2021-08-30 Moved and renamed KiCad projects.
    [65C816_Unit.kicad_pcb, 65C816_Unit.sch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]
2021-09-02 Added symbols and footprints for various latches and flip-flops.
    [65C816_Unit.kicad_pcb, 65C816_Unit.sch]
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2021-09-02 Added example clock dividers.
    [Clock Divider.circ]
2021-09-02 Better 128K bank selection.
    [658 CPU.circ]
2021-09-02 Getting device decoding really working
    [658 CPU.circ]
2021-09-03 Internal Device 0 decoding and writing.
    [658 CPU.circ]
2021-09-03 Simulated multiplexing of D and BA pins.
    [658 CPU.circ]
2021-09-04 Trying to get all shared pins on the same bus.
    [658 CPU.circ]
2021-09-04 Correctly latching Bank Address.
    [658 CPU.circ]
2021-09-04 Removed unnecessary BA pins.
    [658 CPU.circ]
2021-09-04 Removed Tiny OR Gate.
    [658 CPU.circ]
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2021-09-05 Fixed read latch not being wired correctly.
    [658 CPU.circ, Random Memory.circ]
2021-09-05 Cleaned up W65C816 emulation and tunneled its pins out.
    [658 CPU.circ]
2021-09-05 Fixed reversed address lines.
    [658 CPU.circ]
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2021-09-08 Switched from Logisim to Logisim Evolution.
    [658 CPU.circ, 658_CPU_Evolution.circ, demo.circ, main.obj]
2021-09-12 Why did I leave uncommitted changes?
    [658_CPU_Evolution.circ]
2021-09-12 Renaming Labels with underscores.
    [658_CPU_Evolution.circ]
2021-09-13 Still cleaning up tunnel names.
    [658_CPU_Evolution.circ]
2021-09-13 Replaced latches with bus transceivers.
    [658_CPU_Evolution.circ]
2021-09-14 Added Logi6502 converted to run in Logisim Evolution.
    [demo.circ]
2021-09-14 Fixed demo.circ
    [demo.circ]
2021-09-15 Converted most opcode switch cases to named opcodes.
    [demo.circ]
2021-09-15 Add all named opcodes into opcode switch.
    [demo.circ]
2021-09-18 Factoring out methods for each opcode.
    [demo.circ]
2021-09-19 Added a start address circuit.
    [functional_tests.circ]
2021-09-20 Added some break points trying to work out why the functional tests fail.
    [functional_tests.circ]
2021-09-20 Added a Continue pin.
    [functional_tests.circ]
2021-09-21 Added MPU information into Logi6502 expert circuit.
    [functional_tests.circ]
2021-09-21 Removed pointless circuit pieces.
    [functional_tests.circ]
2021-09-21 Moved some debug circuit bits around.
    [functional_tests.circ]
2021-09-21 I have no idea where the ghost interrupt was coming from but it's gone again.
    [functional_tests.circ]
2021-09-23 All opcodes ported over from C++ (but not working due to signed/unsigned issues).
    [OpCodeTable.java]
2021-09-23 Fixing signed/unsigned type issues.
    [Main.java, OpCodeTable.java]
2021-09-24 Load memory from file and cause STP to stop not reset.
    [Main.java]
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2021-09-24 Simple Test to ensure the Java 65816 emulator does *something* at least.
    [Test816.obj]
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2021-10-12 Fixed Cycles executing with Memory instead of Index widths.
    [OpCodeTable.java]
2021-10-13 Simplified Logi6502 class hierarchy.
    [demo.circ]
2021-10-13 Fixed setting InstanceState on Logisim65816Data each tick.
    [Test.circ]
2021-10-13 Trying to get the databus read in Logisim.
    [Test.circ, demo.circ, functional_tests.circ]
2021-10-14 Gah! I think the timing is all wrong. Not Logisim.
    [demo.circ]
2021-10-14 Changed Reset vector to have a more obvious address.
    [Test816.obj, demo.circ]
2021-10-16 Reodering a few imports.
    [demo.circ]
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2021-10-16 Separated the 65816 into separate pins for the bank and the data. Only tick it when there is valid data on the bus.
    [demo.circ]
2021-10-16 Kinda, sorta got the 65816 working in Logisim.
    [demo.circ]
2021-10-17 Updated the demo circuit to disable SRAM during the Bank half-cycle.
    [demo.circ]
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2021-10-17 Debugging what's actually going on in the wires.
    [demo.circ]
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2021-10-18 Terrible awful hack to determine if the propagation cycle has settled yet.
    [demo.circ]
2021-10-18 Added "E" to chip graphic.
    [demo.circ]
2021-10-19 Replaced fake 65c816 with a properly emulated one.
    [658_CPU_Evolution.circ]
2021-10-20 Broke everything.
    [Test816.obj]
2021-10-21 Reversed the instruction execution phase.
    [demo.circ]
2021-10-21 Fixed Logisim clock being used inverted.
    [demo.circ]
2021-10-21 Fixed up processor status registor restoration on RTI etc...
    [Test816.obj, demo.circ]
2021-10-22 Moved Logi6502 into the Logi65816 project.
    [demo.circ]
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2021-10-22 Repackaging simulation and logisim.
    [demo.circ]
2021-10-24 Propagation will try to undo previous propagations if the simulation had not settled.
    [652_CPU_2.circ, 658_CPU_Evolution.circ, demo.circ]
2021-10-24 Allow for blank ports.
    [demo.circ, demo2.circ]
2021-10-24 Added the LVC4245 logisim pins.
    [demo2.circ]
2021-10-25 Added a (non-functional) LVC573.
    [demo2.circ]
2021-10-26 Fixed LVC573 latching and prettied up Logisim IC painting.
    [demo2.circ]
2021-10-28 Prettied up component painting.
    [demo2.circ, demo3.circ]
2021-10-28 Added a (finally working) DS1813.
    [demo2.circ]
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2021-10-30 Renamed 658 CPU to 658 Computer
    [658_Computer.circ]
2021-10-30 Renamed WDC65816 to W65C816.
    [658_Computer.circ]
2021-10-30 Added a 16-bit latch.
    [Test.circ]
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2021-10-30 Refactored port descriptions to include the port side.
    [Test.circ]
2021-10-31 Draw bars above inverted pins.
    [Test.circ]
2021-10-31 Draw negation bubbles on inverting pins.
    [658_Computer.circ, Test.circ]
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2021-10-31 Added an LVC16424 transceiver and fixed the LVC4245.
    [Test.circ]
2021-11-01 Added LogiPins and LogiBus. Also an LVC138.
    [Test.circ]
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2021-11-01 Inverted LS148 Input pin.
    [Test.circ]
2021-11-01 Use new LVC ICs in 658 computer.
    [658_Computer.circ]
2021-11-03 Hack to correctly display the state of the CPU in Logisim.
    [658_Computer.circ, Memory_Latch.circ]
2021-11-03 Added an LVC161 counter.
    [Memory_Copier.circ, Test.circ]
2021-11-03 Building the worlds simplest graphics card.
    [Memory_Copier.circ]
2021-11-04 Started adding LVC163 and F521.
    [Memory_Copier.circ]
2021-11-05 Drag master reset to the next high clock on LVC163.
    [Test.circ]
2021-11-05 Use F521 for comparision rather than NAND gates.
    [Memory_Copier.circ]
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2021-11-07 Fixed 2 trace wide pins in LVC126.
    [Test.circ]
2021-11-07 Factored out common Counter behaviour.
    [Counter_Reset.circ]
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2021-11-07 Fixed up the memory copier.
    [Memory_Copier.circ]
2021-11-07 Latched the memory copier write value before writing.
    [Memory_Copier.circ]
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2021-11-08 Added the component description.
    [658_Computer.circ, Address Decode.circ, Counter_Reset.circ, Memory_Copier.circ, Memory_Latch.circ, Random Memory.circ, Test.circ, W65C816_Default.circ]
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2021-11-09 Fixed LVC541 setting A to an error state when it should have been Y.
    [658_Computer.circ]
2021-11-09 Added the KERNAL mode latch.
    [658_Computer.circ]
2021-11-09 Begun adding USER address decode.
    [658_Computer.circ]
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2021-11-10 Begun adding selector timing.
    [658_Computer.circ]
2021-11-11 Removed read parameter from 65C816. Begun adding timings.
    [658_Computer.circ]
2021-11-12 Fixed timing counter randomly increasing whilst the simulation settles.
    [658_Computer.circ]
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2021-11-12 Correctly ordered timing read / write.
    [658_Computer.circ]
2021-11-14 Commented each addressing mode operation.
    [658_Computer.circ, Test658.obj]
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2021-12-12 Added an LV165 parallel in shift register.
    [Test.circ]
2021-12-12 Updated test circuit with LV165.
    [Test.circ]
2021-12-12 Added an LVC595 serial in shift register.
    [Test.circ]
2021-12-12 Upgraded Logisim evolurion version.
    [Test.circ]
2021-12-23 Added various KiCad components.
    [658_Computer.circ, Clock.kicad_pcb, Clock.sch, NotNANDvsOR.circ]
2021-12-24 Added more KiCad symbols.
    [Clock.sch]
2021-12-24 Cleaning up KiCad libraries.
    [Clock.kicad_pcb, Clock.sch]
2021-12-24 Updated Logisim Clock to use LVC573 latches.
    [658_Computer.circ, Clock.sch]
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2021-12-27 Made major signals and voltage lines wider.
    [Clock.kicad_pcb, Clock.sch]
2021-12-30 Moved the Interrupt vectoring simulation into its own sub-circuit.
    [658_Computer.circ, Clock.kicad_pcb, Clock.sch]
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2021-12-30 Added a simple 65816 testing circuit.
    [Simple_65816.circ]
2021-12-30 Fixed F521 output.
    [Simple_65816.circ]
2021-12-30 Fixed up both hardware and software interrupt detection.
    [Simple_65816.circ]
2021-12-31 Cleaned up timing circuit more.
    [658_Computer.circ]
2021-12-31 Fixed main circuit to work with FST clock.
    [658_Computer.circ]
2021-12-31 Added a reset switch to the DS1813.
    [658_Computer.circ, Simple_65816.circ, Test.circ]
2022-01-01 Fixed a null pointer exception in the W65C816.
    [658_Computer.circ]
2022-01-01 Refactored Internal Memory glue logic into its own sub-circuit.
    [658_Computer.circ]
2022-01-01 Refactored Address Decode logic into its own sub-circuit.
    [658_Computer.circ]
2022-01-01 Added an interrupt detection sub-circuit.
    [658_Computer.circ]
2022-01-02 Made W65C816 timing much more user friendly.
    [658_Computer.circ]
2022-01-02 Set 65C816 sub-cycle time to be zero indexed.
    [658_Computer.circ]
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2022-01-02 Write old pin values until new are explicitly set.
    [658_Computer.circ]
2022-01-02 Finally fixed interrupt detection.
    [658_Computer.circ]
2022-01-03 Added a 'quick' timing circuit.
    [658_Computer.circ]
2022-01-03 Renamed CounterCircuit to UpCounterCircuit.
    [658_Computer.circ]
2022-01-03 'Fixed' data transmit to still transmit D at the start of PHI2.
    [658_Computer.circ]
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2022-01-03 Renamed Counters to Up Counters.
    [Test.circ]
2022-01-03 Added an interrupt counter device.
    [658_Computer.circ]
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2022-01-04 Removed Clock Divider and memory copier.
    [Clock Divider.circ, Memory_Copier.circ]
2022-01-04 Fixing broken logisim file.
    [658_Computer.bak.circ, 658_Computer.circ]
2022-01-04 Moved Kernal Mode into its own circuit.
    [658_Computer.circ]
2022-01-04 Moved Register Flags and Short Pulses into their own circuits.
    [658_Computer.circ]
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2022-01-05 Test Kernal and User mode programs.
    [Test658.obj, Test658Kernal.obj, Test658User.obj]
2022-01-05 Fixed main memory latching.
    [658_Computer.circ]
2022-01-05 Fixed clock stretching timing.
    [658_Computer.circ, Test658Kernal.obj]
2022-01-05 Moved special- an device memory to address 0x7700
    [658_Computer.circ, Test658Kernal.obj, Test816.obj]
2022-01-05 Leaving a note for myself.
    [658_Computer.circ]
2022-01-09 Cleaning up Address Decode and Internal Memory Glue.
    [658_Computer.circ, Test658User.obj]
2022-01-09 Stretch the clock once for ROM reads and twice for device reads.
    [658_Computer.circ]
2022-01-09 Reduced Selector from 10 to 8 bits.
    [658_Computer.circ]
2022-01-09 Refactored Clock Control into its own sub-circuit.
    [658_Computer.circ]
2022-01-09 Moved MPU Signals into a sub-circuit.
    [658_Computer.circ]
2022-01-09 Cleaning up and moving stuff around.
    [658_Computer.circ]
2022-01-10 Changed devices to the whole 7000 to 7FFF range. Channel implied by first 2 bits.
    [658_Computer.circ, Test658Kernal.obj]
2022-01-10 Fixed writes to main memory writing garbage because write was left on too long.
    [658_Computer.circ]
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2022-01-10 Separating out a simpler MPU board without a User mode that can be placed into a Motherboard.
    [658_Computer.circ]
2022-01-11 Began adding HCP65.0 tests. Starting with copying ROM into RAM and then turning ROM off.
    [658_Computer.circ, TestHCP650.obj]
2022-01-11 Added RES, NMI and IRQ outputs.
    [658_Computer.circ]
2022-01-11 Moving components onto the Motherboard.
    [658_Computer.circ]
2022-01-11 Designing the Device Bus.
    [658_Computer.circ]
2022-01-12 Pass RWB, RWBB and Device valid through to the device.
    [658_Computer.circ]
2022-01-12 Fixing Device Bus even more better.
    [658_Computer.circ]
2022-01-12 Gah, I need player knowledge.
    [658_Computer.circ]
2022-01-12 Disable Bus Devices after they've invalid.
    [658_Computer.circ]
2022-01-12 Removed redundant RWB signals.
    [658_Computer.circ]
2022-01-12 Added device outputs to the MPU Board.
    [658_Computer.circ]
2022-01-13 Began converting Device Bus into sub-circuits.
    [658_Computer.circ]
2022-01-13 Completed converting Device Bus into sub-circuits.
    [658_Computer.circ]
2022-01-13 Adding the Memory Gateway into the Microprocessor board.
    [658_Computer.circ]
2022-01-14 Fixed the reset pin not holding the 65816 in reset on PHI2 rising.
    [658_Computer.circ]
2022-01-14 Cleaning up the Memory Gateway and main memory map.
    [658_Computer.circ, Test658Kernal.obj]
2022-01-15 Added an interrupt device.
    [658_Computer.circ]
2022-01-15 Added an echo device.
    [658_Computer.circ]
2022-01-16 Cleaning up devices a bit.
    [658_Computer.circ]
2022-01-16 Added a memory transceiver.
    [658_Computer.circ]
2022-01-16 A few graphics for memory sub-circuits.
    [658_Computer.circ]
2022-01-17 Added the Graphics Device and part of the Graphics Rasteriser.
    [658_Computer.circ]
2022-01-18 Tried fixing HCT193 parallel load. It's a Logisim flip-flop problem.
    [658_Computer.circ]
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2022-01-19 Swapped LVC161s for VHC161s.
    [658_Computer.circ]
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2022-01-19 Added more Graphcis Blitter.
    [658_Computer.circ, Test.circ]
2022-01-20 Even more Graphics Blitter.
    [658_Computer.circ]
2022-01-20 Factoring the Graphics Blitter into sub-circuits.
    [658_Computer.circ]
2022-01-20 Moved some lines around.
    [658_Computer.circ]
2022-01-20 Fixed the Line State sub-circuit.
    [658_Computer.circ]
2022-01-20 Factored out the graphics pixel sub-circuit.
    [658_Computer.circ]
2022-01-21 Factored out a data multiplexer sub-circuit.
    [658_Computer.circ]
2022-01-21 Factored all Graphics Blitter ICs into sub-circuits.
    [658_Computer.circ]
2022-01-21 Fixed weird timing issues in Graphics Blitter and reduced clocks needed to only one.
    [658_Computer.circ]
2022-01-21 Changed graphics width to be 12 bits.
    [658_Computer.circ]
2022-01-21 Reworking the Memory Gateway.
    [658_Computer.circ]
2022-01-21 Fixed HC590 ripple carry.
    [658_Computer.circ]
2022-01-21 Ensure the main memory busses are always valid.
    [658_Computer.circ]
2022-01-22 Moved User Bank latch into Kernal Mode.
    [658_Computer.circ]
2022-01-22 Added a Instruction Counter sub-circuit.
    [658_Computer.circ, Clock.kicad_pcb, Test658Kernal.obj]
2022-01-22 Moved memory transceiver from the mother board into the MPU board.
    [658_Computer.circ]
2022-01-23 Added remaining bit width read and IRQ when done to the graphics blitter and device.
    [658_Computer.circ]
2022-01-24 Added the Chipifier for converting Logisim style RAMs into real world types.
    [658_Computer.circ]
2022-01-24 Cleaned up the Memory Lockout.
    [658_Computer.circ]
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2022-01-24 Removed clock rising field from counter simulators.
    [658_Computer.circ]
2022-01-25 Not rightly sure what's changed.
    [658_Computer.circ]
2022-01-26 Added a NULL device channel for unconnected MPUs.
    [658_Computer.circ]
2022-01-26 Connecting up more circuits on the motherboard.
    [658_Computer.circ, Test658Kernal.obj]
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2022-01-27 Added a video device.
    [658_Computer.circ]
2022-01-27 Added a video DAC.
    [658_Computer.circ]
2022-01-28 Working on video memory access.
    [658_Computer.circ]
2022-01-29 Video memory access based on framebuffer number.
    [658_Computer.circ]
2022-01-30 Added a video timing circuit.
    [658_Computer.circ]
2022-01-30 Cleaning up video timing circuit.
    [658_Computer.circ]
2022-01-31 Video horizontal and vertical timing signals.
    [658_Computer.circ]
2022-01-31 Added palette memory and lookup.
    [658_Computer.circ]
2022-02-01 Dunno why there are changes.
    [658_Computer.circ]
2022-02-01 Added KiCad foot prints and 3D models.
    [658_Computer.bak.circ, Clock.kicad_sch, Computer.csv, Computer.kicad_pcb, Computer.kicad_sch, Timing_Circuit.kicad_sch]
2022-02-02 Trying to get HTML going.
    [658_Computer.circ]
2022-02-03 Added Bus Enable and MPU Lock-in to Address Decode.
    [658_Computer.circ]
2022-02-03 Cleaned up MPU boards.
    [658_Computer.circ]
2022-02-03 Added video clock values into video device.
    [658_Computer.circ]
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2022-02-04 Populating the video board.
    [658_Computer.circ]
2022-02-05 Added PI3B3251 and QS3253.
    [658_Computer.circ, Test.circ]
2022-02-06 Completed clock generator .
    [658_Computer.circ]
2022-02-06 Adding a Parallel to SPI converter.
    [658_Computer.circ]
2022-02-06 Added a parallel to SPI converter.
    [658_Computer.circ]
2022-02-07 Placed Video board on Motherboard.
    [658_Computer.circ]
2022-02-07 Added both the 3rd and 4th MPUs and graphics blitters.
    [658_Computer.circ]
2022-02-08 Added a SNES Controller.
    [658_Computer.circ]
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2022-02-09 Latch controller signals after combinatorial logic.
    [658_Computer.circ]
2022-02-09 Fixed 16 bit to SPI converter timing.
    [658_Computer.circ]
2022-02-09 Added a random PS2 signal generator.
    [658_Computer.circ]
2022-02-10 Decode a pair of PS2 signals into a single FIFO.
    [658_Computer.circ]
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2022-02-10 Tried adding a FIFO to the PS2 decoder. It was complicated.
    [658_Computer.circ, Test.circ]
2022-02-11 Prettied up the IDT7201.
    [Test.circ]
2022-02-11 Swapped the 4 PS2 latches for a FIFO.
    [658_Computer.circ]
2022-02-13 Cleaned up SNES Controller and moved all components onto a testing board.
    [658_Computer.circ]
2022-02-13 Added the SNES Controller to the motherboard.
    [658_Computer.circ]
2022-02-14 Fixed SNES Data Out connection.
    [658_Computer.circ]
2022-02-14 You don't need the counter.
    [658_Computer.circ]
2022-02-15 Removed PS2 timer counter.
    [658_Computer.circ]
2022-02-15 Added a software reset line to the PS2 input device.
    [658_Computer.circ]
2022-02-15 Added a fake ADV7125.
    [658_Computer.circ]
2022-02-15 Added PS2 Device onto motherboard.
    [658_Computer.circ]
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2022-02-17 Added an SD card device.
    [658_Computer.circ]
2022-02-17 I might have been adding a CRC generator?
    [658_Computer.circ]
2022-02-20 Added SNES Device in KiCad.
    [658_Computer.circ, Computer.csv, SNES Controller Shift Register.kicad_sch, SNES Controller Timing.kicad_sch, SNES Device.kicad_pcb, SNES Device.kicad_sch, snes_input_board.kicad_sch]
2022-02-21 Fixed a broken connection in simulation.
    [658_Computer.circ, SNES Controller Shift Register.kicad_sch, SNES Controller Timing.kicad_sch, SNES Device.kicad_pcb]
2022-02-23 Split the SNES device into additional sheets.
    [658_Computer.circ, SNES Controller Counter.kicad_sch, SNES Controller Shift Register.kicad_sch, SNES Controller Timing.kicad_sch, SNES Controller Translation.kicad_sch, SNES Device.kicad_sch]
2022-02-24 Added the SNES Controller Timing PCB.
    [SNES Controller Counter.kicad_sch, SNES Controller Shift Register.kicad_sch, SNES Controller Timing.kicad_sch, SNES Controller Translation.kicad_sch, SNES Device.kicad_pcb, SNES Device.kicad_sch]
2022-02-24 Starting the first shift registers.
    [SNES Device.kicad_pcb]
2022-02-25 Added the SNES shift PCB.
    [SNES Device.kicad_pcb]
2022-02-25 Fixed some footprints and symbols.
    [SNES Controller Counter.kicad_sch, SNES Controller Shift Register.kicad_sch, SNES Controller Timing.kicad_sch, SNES Controller Translation.kicad_sch, SNES Device.kicad_pcb, SNES Device.kicad_sch]
2022-02-25 SNES Controller Daughterboad .
    [SNES Device.kicad_pcb]
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2022-02-26 Split SNES device into two major schematic sheets.
    [SNES Controller Board.kicad_sch, SNES Controller Counter.kicad_sch, SNES Controller Device.kicad_sch, SNES Controller Shift Register.kicad_sch, SNES Controller Timing.kicad_sch, SNES Controller Translation.kicad_sch, SNES Device.kicad_pcb, SNES Device.kicad_sch]
2022-02-28 Added a demo LSF0204 project.
    [658_Computer.circ, Device Selector.kicad_sch, LSF0204.kicad_pcb, LSF0204.kicad_sch, SNES Controller Board.kicad_sch, SNES Controller Counter.kicad_sch, SNES Controller Device.kicad_sch, SNES Controller Shift Register.kicad_sch]
2022-02-28 Splitting the SNES Device into even more boards.
    [Device Selector.kicad_sch, SNES Controller Board.kicad_sch, SNES Controller Counter.kicad_sch, SNES Controller Device.kicad_sch, SNES Controller Shift Register.kicad_sch, SNES Controller Timing.kicad_sch, SNES Device.kicad_pcb, SNES Device.kicad_sch]
2022-03-01 Connected the SNES Device interface thing.
    [658_Computer.circ, Device Selector.kicad_sch, SNES Controller Board.kicad_sch, SNES Controller Device.kicad_sch, SNES Device Selector.kicad_sch, SNES Device.kicad_pcb, SNES Device.kicad_sch]
2022-03-02 Split SNES device into multiple boards.
    [SNES Controller Device.kicad_sch, SNES Controller Shift Register.kicad_sch, SNES Device Selector.kicad_sch, SNES Device.kicad_pcb, SNES Device.kicad_sch]
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2022-03-03 Added the SNES ports board.
    [SNES Controller Board.kicad_sch, SNES Controller Shift Register.kicad_sch, SNES Device.kicad_sch, SNES Ports.kicad_sch]
2022-03-03 Fixed Silkscreen and added Gerber and Drill files.
    [SNES Device-B_Cu.gbr, SNES Device-B_Mask.gbr, SNES Device-B_Silkscreen.gbr, SNES Device-Edge_Cuts.gbr, SNES Device-F_Cu.gbr, SNES Device-F_Mask.gbr, SNES Device-F_Silkscreen.gbr, SNES Device-NPTH.drl]
2022-03-04 Completed board for sending to CircuitBoard.
    [SNES Device-B_Cu.gbr, SNES Device-B_Mask.gbr, SNES Device-B_Silkscreen.gbr, SNES Device-Edge_Cuts.gbr, SNES Device-F_Cu.gbr, SNES Device-F_Mask.gbr, SNES Device-F_Silkscreen.gbr, SNES Device-NPTH.drl]
2022-03-12 Fixed some minor circuit mistakes.
    [658_Computer.bak.circ, 658_Computer.circ]
2022-03-12 Fixed the SNES controller circuits.
    [658_Computer.circ]
2022-03-21 Use JDK 17. Because Logisim Evolution.
    [658_Computer.circ]
2022-03-26 Fixed SNES Timing reset.
    [Device Selector.kicad_sch, SNES Controller Board.kicad_sch, SNES Controller Counter.kicad_sch, SNES Controller Device.kicad_sch, SNES Controller Shift Register.kicad_sch, SNES Controller Timing.kicad_sch, SNES Controller Translation.kicad_sch, SNES Device Selector.kicad_sch]
2022-03-26 Fixed Logisim SNES controller clock.
    [658_Computer.circ]
2022-03-27 Swapped counter reset and /reset signals again.
    [SNES Controller Counter.kicad_sch]
2022-04-01 Not sure what I did, sire.
    [658_Computer.circ, SNES Controller Board.kicad_sch]
2022-05-17 Added Osram RGB LEDs.
    [LED_Display.circ]
2022-05-22 Added a LED display circuit.
    [LED_Display.circ]
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2022-06-09 Updated the Clock Selector circuit.
    [658_Computer.circ]
2022-06-09 Added a Logisim Evolution snapshot that can run the 65816 emulator.
    [658_Computer.circ]
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2022-06-12 Fixed clock resetting consistency.
    [658_Computer.circ]
2022-06-12 Swapped slow selector signal to use negative logic.
    [658_Computer.circ]
2022-06-12 Swapped a '257 for a cheaper '157.
    [658_Computer.circ]
2022-06-12 Renamed RESET to RESET_B.
    [658_Computer.circ]
2022-06-15 Added Propagation Times time the wiki.
    [Propagation Times.ods]
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2022-06-17 Comparison between various buffers, transceivers and translators.
    [Buffers, Transcievers and Translators.ods]
2022-06-17 Cleaned up Clock Signals.
    [658_Computer.circ]
2022-06-17 Fixed NMIB being accidentally inverted.
    [658_Computer.circ]
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2022-06-18 All other memory decode.
    [658_Computer.circ]
2022-06-18 Broke internal memory decode. Again.
    [658_Computer.circ]
2022-06-18 Fixed internal memory decode. Again.
    [658_Computer.circ]
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2022-06-18 Added a 74F30 datasheet.
    [658_Computer.circ]
2022-06-18 Changed all address logic gates to AND and NAND.
    [658_Computer.circ]
2022-06-19 Changed all clock control gates to AND and NAND.
    [658_Computer.circ]
2022-06-19 Lots of small cleanup.
    [658_Computer.circ]
2022-06-19 Better circuit resetting.
    [658_Computer.circ]
2022-06-19 Fixed MPU memory transceiver testing.
    [658_Computer.circ]
2022-06-19 Changed all kernal mode gates to AND and NAND.
    [658_Computer.circ]
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2022-06-19 Split op-code detection out of interrupt detection.
    [658_Computer.circ]
2022-06-19 Began adding a debug counter.
    [658_Computer.circ]
2022-06-20 Added a debug "count and compare" circuit.
    [658_Computer.circ]
2022-06-20 Merged SNES controller timing and counter backing into one circuit.
    [658_Computer.circ]
2022-06-22 Added KiCad keypad project.
    [Keypad.kicad_pcb, Keypad.kicad_sch]
2022-06-25 Added parts and data sheets.
    [Keypad.kicad_sch]
2022-06-29 Added a Bus Tester LED circuit.
    [658_Computer.circ, Bus Tester.kicad_pcb, Bus Tester.kicad_sch, Keypad.kicad_sch]
2022-06-30 Added left and right handed BUS LED testers.
    [Bus Tester-B_Cu.gbr, Bus Tester-B_Mask.gbr, Bus Tester-Edge_Cuts.gbr, Bus Tester-F_Cu.gbr, Bus Tester-F_Mask.gbr, Bus Tester-F_Silkscreen.gbr, Bus Tester-NPTH.drl, Bus Tester-PTH.drl]
2022-07-02 Added a left handed BUS 7-segment tester.
    [Bus Tester.kicad_pcb, Bus Tester.kicad_sch, Left_Handed_Bus 7_Segment.kicad_sch, Left_Handed_Bus.kicad_sch]
2022-07-03 Rerouted all BUS testers.
    [Bus Tester.kicad_pcb, Bus Tester.kicad_sch, Left_Handed_Bus 7_Segment.kicad_sch, Left_Handed_Bus.kicad_sch]
2022-07-03 Un-hid all Value Silkscreen text.
    [Bus Tester.kicad_pcb]
2022-07-03 Fixed power connector footprint and updated PCB.
    [Bus Tester-B_Cu.gbr, Bus Tester-B_Mask.gbr, Bus Tester-Edge_Cuts.gbr, Bus Tester-F_Cu.gbr, Bus Tester-F_Mask.gbr, Bus Tester-F_Silkscreen.gbr, Bus Tester-NPTH.drl, Bus Tester-PTH.drl]
2022-07-03 Deleted old computer Clock.
    [Clock.kicad_pcb, Clock.kicad_sch, Clock.sch]
2022-07-03 Added the Clock circuit and ICs .
    [658_Computer.circ, Clock.kicad_pcb, Clock.kicad_sch]
2022-07-05 Completed routing the Clock PCB.
    [Clock.kicad_pcb, Clock.kicad_sch]
2022-07-05 Completed silk screening the Clock PCB.
    [Clock.kicad_pcb]
2022-07-06 Added a power LED.
    [Bus Tester-B_Cu.gbr, Bus Tester-B_Mask.gbr, Bus Tester-Edge_Cuts.gbr, Bus Tester-F_Cu.gbr, Bus Tester-F_Mask.gbr, Bus Tester-F_Silkscreen.gbr, Bus Tester-NPTH.drl, Bus Tester-PTH.drl]
2022-07-06 Added a Selector State circuit.
    [658_Computer.circ, Selector State.kicad_pcb, Selector State.kicad_sch]
2022-07-07 Updated logic gates with pretty symbols.
    [Selector State.kicad_sch]
2022-07-08 Redoing Clock PCB from scratch.
    [Clock.kicad_pcb, Clock.kicad_sch]
2022-07-08 Laying out ancillary ICs.
    [Clock.kicad_pcb, Clock.kicad_sch]
2022-07-09 Laid out Clock but not ancillary PCB.
    [Clock.kicad_pcb, Clock.kicad_sch]
2022-07-10 Re-re-routed the Clock PCB.
    [Clock.kicad_pcb, Clock.kicad_sch]
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2022-07-10 Fixed drill hole sizes and generated fabrication files.
    [658_Computer.circ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]
2022-07-10 Added a right handed 7 segment LED bus tester.
    [Bus Tester-B_Cu.gbr, Bus Tester-B_Mask.gbr, Bus Tester-Edge_Cuts.gbr, Bus Tester-F_Cu.gbr, Bus Tester-F_Mask.gbr, Bus Tester-F_Silkscreen.gbr, Bus Tester-NPTH.drl, Bus Tester-PTH.drl]
2022-07-10 Cleaning up the Select LDO.
    [Selector State.kicad_sch]
2022-07-11 Removed 'Logisim appeasing' bus transceiver.
    [658_Computer.circ, Selector State.kicad_sch]
2022-07-12 Added some LSF0102 pics.
    [658_Computer.circ, Clock.kicad_pcb, Selector State.kicad_pcb, Selector State.kicad_sch]
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2022-07-15 Routed most Selector signals.
    [Selector State.kicad_pcb, Selector State.kicad_sch]
2022-07-16 Finished routing Selector Clock.
    [Clock.kicad_pcb, Clock.kicad_sch, Selector State.kicad_pcb, Selector State.kicad_sch]
2022-07-16 Added MPU and Signals board.
    [Blank Board.kicad_pcb, Blank Board.kicad_sch, MPU Signals.kicad_pcb, MPU Signals.kicad_sch]
2022-07-16 Re-wired seven segment pins to be more Bussy.
    [Left_Handed_Bus 7_Segment.kicad_sch]
2022-07-16 Re-routed LCD bus 7 segment tester and got output enables working.
    [Bus Tester.kicad_pcb, Bus Tester.kicad_sch, Left_Handed_Bus 7_Segment.kicad_sch, Left_Handed_Bus.kicad_sch]
2022-07-16 Cleaned up Bus Tester silkscreens.
    [Bus Tester.kicad_pcb, Bus Tester.kicad_sch, Left_Handed_Bus 7_Segment.kicad_sch, Left_Handed_Bus.kicad_sch]
2022-07-17 Appeased Kicads schematic parity tester.
    [Bus Tester-B_Cu.gbr, Bus Tester-B_Mask.gbr, Bus Tester-Edge_Cuts.gbr, Bus Tester-F_Cu.gbr, Bus Tester-F_Mask.gbr, Bus Tester-F_Silkscreen.gbr, Bus Tester-NPTH.drl, Bus Tester-PTH.drl]
2022-07-17 Include Clock Enable when generating Write Enable.
    [658_Computer.circ, MPU Signals.kicad_sch]
2022-07-18 Sized MPU and Signals PCB.
    [658_Computer.circ, MPU Signals.kicad_pcb, MPU Signals.kicad_sch]
2022-07-18 Added Seven segment LED displays for CPU busses.
    [Computer.kicad_sch, LED Display.kicad_sch, Left_Handed_Bus 7_Segment.kicad_sch, MPU Signals.kicad_pcb, MPU Signals.kicad_sch, Timing_Circuit.kicad_sch, snes_input_board.kicad_sch]
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2022-07-20 Added a correct W65C816S footprint.
    [MPU Signals.kicad_pcb, MPU Signals.kicad_sch]
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2022-07-23 Optimise address decoding when in MPU Lock.
    [658_Computer.circ, Clock.kicad_pcb, MPU Signals.kicad_pcb, MPU Signals.kicad_sch, Selector State.kicad_pcb]
2022-07-23 Move the Special Address Selector into its own circuit.
    [658_Computer.circ]
2022-07-23 More precise special memory decoding.
    [658_Computer.circ]
2022-07-23 Moved Microcontroller Device Gateway onto the Motherboard.
    [658_Computer.circ]
2022-07-23 Fixed Kernal Display.
    [658_Computer.circ]
2022-07-23 Added Lock-in detection and register.
    [658_Computer.circ]
2022-07-25 Added both board and MPU resets to the MPU board.
    [658_Computer.circ]
2022-07-25 Disable main memory access while MPU is resetting.
    [658_Computer.circ]
2022-07-25 Re-routed Selector State based on new simulation.
    [658_Computer.circ, MPU Signals.kicad_pcb, MPU Signals.kicad_sch, Selector State.kicad_pcb, Selector State.kicad_sch]
2022-07-26 Changed interrupt detection to be at the end of the interrupt invocation and and the start of the interrupt return.
    [658_Computer.circ]
2022-07-26 Include VPB in interrupt detection.
    [658_Computer.circ]
2022-07-26 Fixed 65C816 simulation not setting VPB when NMI, IRQ or ABORT are triggered.
    [658_Computer.circ]
2022-07-26 Cleaned up address decode circuit.
    [658_Computer.circ]
2022-07-26 Fixed up a bunch of clock issues.
    [Clock.kicad_pcb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]
2022-07-26 Hide Address decode behind a latch.
    [658_Computer.circ]
2022-07-27 Added signals for address decoding done latching.
    [658_Computer.circ]
2022-07-27 Push RTI stack into user program space.
    [658_Computer.circ, TestHCP650.obj]
2022-07-28 Hooked up interrupt detection correctly.
    [658_Computer.circ]
2022-07-28 When not in lock-in mode return zero from lock-in address.
    [658_Computer.circ]
2022-07-28 Updated Selector State to reflect simulation changes.
    [658_Computer.circ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]
2022-07-29 Swapped KiCad symbols for HCP symbols.
    [Bus Tester.kicad_pcb, Bus Tester.kicad_sch, Left_Handed_Bus 7_Segment.kicad_sch]
2022-07-30 Added a 65C816 stress tester using a Raspberry Pi Pico.
    [658_Test.circ, Bus Tester.kicad_pcb, Bus Tester.kicad_sch, Keypad.kicad_sch, LCD Bus Reader.kicad_sch, Left_Handed_Bus 7_Segment.kicad_sch, Left_Handed_Bus.kicad_sch, MPU Signals.kicad_pcb]
2022-07-31 Routed Address and Data testing lines.
    [Left_Handed_Bus 7_Segment.kicad_sch, Left_Handed_Bus.kicad_sch, Pico Debugger.kicad_pcb, Pico Debugger.kicad_sch]
2022-08-01 Added numeric LED displays to the 65C816 test board.
    [LED Display.kicad_sch, Pico Debugger.kicad_pcb, Pico Debugger.kicad_sch]
2022-08-01 Added pin headers to breakout W65C816S signals.
    [LED Display.kicad_sch, Pico Debugger.kicad_pcb, Pico Debugger.kicad_sch]
2022-08-02 Routed all Pico Debug board signal lines.
    [LED Display.kicad_sch, Pico Debugger.kicad_pcb, Pico Debugger.kicad_sch]
2022-08-02 Routed Pico Debugger power lines.
    [MPU Signals.kicad_pcb, Pico Debugger.kicad_pcb, Pico Debugger.kicad_sch]
2022-08-03 Fixed 300Hz Schmitt trigger.
    [LED Display.kicad_sch, Pico Debugger.kicad_pcb, Pico Debugger.kicad_sch]
2022-08-03 Deleted old 65c816 Unit.
    [65C816_Unit.kicad_pcb, 65C816_Unit.sch]
2022-08-03 Moved keypad out of Computer.
    [Keypad.kicad_pcb, Keypad.kicad_sch, SNES Device.kicad_sch, SNES Ports.kicad_sch]
2022-08-03 Changed Keypad ICs to VHC and added mounting holes.
    [Keypad.kicad_pcb, Keypad.kicad_sch, Pico Debugger.kicad_sch]
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2022-08-05 Cleaned up some Texas Instruments symbols.
    [Address Decode.kicad_pcb, Address Decode.kicad_sch]
2022-08-05 A bit of address decoding, some fixes and optimisation.
    [658_Computer.circ, Address Decode.kicad_sch]
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2022-08-06 Basic schematic for Address Decode complete.
    [Address Decode.kicad_sch]
2022-08-06 Removed Bank Latch from MPU signals.
    [MPU Signals.kicad_pcb, MPU Signals.kicad_sch]
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2022-08-07 Fixed MPU pin connector and removed LED enable switch.
    [658_Computer.circ, Address Decode.kicad_pcb, Address Decode.kicad_sch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]
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2022-08-07 Routing of Address Decode complete.
    [Address Decode.kicad_pcb, Address Decode.kicad_sch]
2022-08-08 Re-routed Selector State. Reduced gates in interrupt detection.
    [658_Computer.circ, Address Decode.kicad_pcb, Address Decode.kicad_sch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]
2022-08-09 Swapped two '541s for a '16244
    [658_Computer.circ]
2022-08-09 Removed Read_Enable_B and Write_Enable_B.
    [658_Computer.circ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]
2022-08-09 Must have done something...
    [658_Computer.circ]
2022-08-11 Better Seven HEX display names and descriptions.
    [Keypad.kicad_sch, Pico Debugger.kicad_pcb, Pico Debugger.kicad_sch]
2022-08-11 Moved Bus Tester out of Computer and directly into Kicad.
    [Bus Tester-B_Cu.gbr, Bus Tester-B_Mask.gbr, Bus Tester-Edge_Cuts.gbr, Bus Tester-F_Cu.gbr, Bus Tester-F_Mask.gbr, Bus Tester-F_Silkscreen.gbr, Bus Tester-NPTH.drl, Bus Tester-PTH.drl]
2022-08-11 Re-generated Bus Tester fabrication outputs.
    [Bus Tester-B_Cu.gbr, Bus Tester-B_Mask.gbr, Bus Tester-Edge_Cuts.gbr, Bus Tester-F_Cu.gbr, Bus Tester-F_Mask.gbr, Bus Tester-F_Silkscreen.gbr, Bus Tester-NPTH.drl, Bus Tester-PTH.drl]
2022-08-14 Rerouted part of the bus tester.
    [Bus Tester.kicad_pcb]
2022-08-14 Added more decoupling capacitors to the Pico Debugger.
    [Pico Debugger-B_Cu.gbr, Pico Debugger-B_Mask.gbr, Pico Debugger-B_Silkscreen.gbr, Pico Debugger-Edge_Cuts.gbr, Pico Debugger-F_Cu.gbr, Pico Debugger-F_Mask.gbr, Pico Debugger-F_Silkscreen.gbr, Pico Debugger-NPTH.drl]
2022-08-15 Cleaned up a lot of Pico Debugger tracks.
    [Pico Debugger-B_Cu.gbr, Pico Debugger-B_Mask.gbr, Pico Debugger-B_Silkscreen.gbr, Pico Debugger-Edge_Cuts.gbr, Pico Debugger-F_Cu.gbr, Pico Debugger-F_Mask.gbr, Pico Debugger-F_Silkscreen.gbr, Pico Debugger-NPTH.drl]
2022-08-15 Cleaned up a lot of Bus Tester tracks.
    [Bus Tester-B_Cu.gbr, Bus Tester-B_Mask.gbr, Bus Tester-B_Silkscreen.gbr, Bus Tester-Edge_Cuts.gbr, Bus Tester-F_Cu.gbr, Bus Tester-F_Mask.gbr, Bus Tester-F_Silkscreen.gbr, Bus Tester-NPTH.drl]
2022-08-15 Added keypad Gerber files.
    [Keypad-B_Cu.gbr, Keypad-B_Mask.gbr, Keypad-Edge_Cuts.gbr, Keypad-F_Cu.gbr, Keypad-F_Mask.gbr, Keypad-F_Silkscreen.gbr, Keypad-NPTH.drl, Keypad-PTH.drl]
2022-08-15 Correct fill zones and re-generated fabrication outputs.
    [Bus Tester-B_Cu.gbr, Bus Tester-B_Mask.gbr, Bus Tester-B_Silkscreen.gbr, Bus Tester-Edge_Cuts.gbr, Bus Tester-F_Cu.gbr, Bus Tester-F_Mask.gbr, Bus Tester-F_Silkscreen.gbr, Bus Tester-NPTH.drl]
2022-08-15 Added front Paste Gerber.
    [MPU Signals.kicad_pcb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]
2022-08-17 Added pull resistors to the SD card.
    [Pico Debugger-B_Cu.gbr, Pico Debugger-B_Mask.gbr, Pico Debugger-B_Silkscreen.gbr, Pico Debugger-Edge_Cuts.gbr, Pico Debugger-F_Cu.gbr, Pico Debugger-F_Mask.gbr, Pico Debugger-F_Paste.gbr, Pico Debugger-F_Silkscreen.gbr]
2022-08-19 Fixed SD card pull down resistors to be pull up.
    [Pico Debugger.kicad_pcb, Pico Debugger.kicad_sch]
2022-08-20 Trying to add a hardware SD command generator.
    [658_Computer.circ]
2022-08-20 Threw more complexity at the LVC74 to make it work. Maybe.
    [658_Computer.circ, Test.circ]
2022-08-20 Q out of LV165 is more consistent.
    [658_Computer.circ]
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2022-08-30 Added the SD SD Card Physical Layer Simplified Specification.
    [MPU Signals.kicad_pcb]
2022-08-31 Reversed Bus Tester diode.
    [Left_Handed_Bus.kicad_sch]
2022-09-03 Small clean ups in the Pico Debugger board.
    [Bus Tester.kicad_pcb, Keypad.kicad_pcb, Left_Handed_Bus 7_Segment.kicad_sch, Left_Handed_Bus.kicad_sch, Pico Debugger.kicad_sch]
2022-10-20 Added a Bresenham line stretching cricuit.
    [658_Computer.circ]
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2022-10-23 Adding a graphics blitter address circuit.
    [658_Computer.circ]
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2022-11-10 Tried (and failed) to make edit action thread safe.
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2022-11-10 Fixed double traces not being merged.
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2022-11-14 Hooking up and fixing IC pin transition event.
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2022-11-21 Merged voltage configurations into one. Broke input vs output events.
2022-11-21 Minor fixes to schematics.
    [658_Computer.circ, MPU Signals.kicad_sch, Selector State.kicad_pcb]
2022-11-22 Show short circuits.
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2022-12-07 Added a memory dump to java for 65816 converter.
    [Pico Debugger.kicad_sch, Test816.obj]
2022-12-08 Debugging Logicim sudden voltage changes.
    [Keypad.kicad_pcb, Keypad.kicad_sch]
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2022-12-09 Oscilloscope reading voltage shorts.
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2022-12-13 Added voltage configurations for most TTL families.
    [Propagation Times (541).csv, Propagation Times (541).ods]
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2022-12-14 'fixed' a couple of tests by appeasing the test case.
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2022-12-21 Fixed selection viewing and power deletion.
2022-12-21 Renamed BasePort to Port and fixed Power port connections.
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2023-01-02 Fixed moving traces not re-selecting properly.
2023-01-02 Fixed deleting traces creating new traces.
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2023-01-06 Converting Buffer into a multiport component.
    [MPU Signals.kicad_sch]
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2023-01-09 Passive components connections correctly connect to traces.
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2023-01-22 Fixing up Tunnel and making it a real wire.
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2023-01-25 Fixed delete trace deleting too many traces.
2023-01-25 Added a todo to Fix connecting different width traces together.
2023-01-25 Fixed removed trace views being finalised after a move.
2023-01-26 Fixed trace rotations.
2023-01-29 Added a timer schematic.
    [Address Decode.kicad_sch, Timer.kicad_pcb, Timer.kicad_sch, TimerSwitch.circ]
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2023-02-02 Fixed LabelView to be selectable. Fixed WireViews to return connection opposites.
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2023-02-05 Fixed deleting traces.
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2023-02-18 Fixed place components to discard the current edit.
2023-02-18 Fixed WirePull starting on the wrong grid location.
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2023-02-21 Fixed trace duplication making bad connections.
2023-02-22 Fixed TraceLoader always being reset on Paste.
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2023-02-23 Fixed discarding traces.
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2023-02-25 Better reset for passive circuits.
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2023-03-08 Working towards placing subcircuit pins.
    [MPU Signals.kicad_sch]
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2023-03-11 Fixed tunnel, label and splitter text rotation.
    [LED Display.kicad_sch, Pico Debugger 2.kicad_pcb, Pico Debugger 2.kicad_sch]
2023-03-12 Fixed duplicate power and logic ports.
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2023-03-14 Fixed deleted traces not reconnecting immediate connected components.
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2023-03-30 Fixed passives not being added or removed from the Circuit.
2023-04-07 Divide clock by three and glitch free clock synchronisation.
    [DivideBy3.circ, Video.circ]
2023-04-10 Second steps towards multiple simulations.
    [DivideBy3.circ]
2023-04-10 Place circuits is very, very broken but runs a little bit.
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2023-04-24 Added Kicad parts and Pico Sound schematic.
    [LED Display.kicad_sch, Pico Sound.kicad_pcb, Pico Sound.kicad_sch]
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2023-04-28 Completed Pico Sound schematic.
    [Pico Sound.kicad_pcb, Pico Sound.kicad_sch]
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2023-05-04 Some Pico sound PCB setup.
    [Pico Sound.kicad_pcb, Pico Sound.kicad_sch]
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2023-06-08 Added some more add actions.
    [Pico Sound.kicad_pcb, Pico Sound.kicad_sch]
2023-06-09 Routed Pico Sound traces.
    [Pico Sound.kicad_pcb, Pico Sound.kicad_sch]
2023-06-10 Finished routing the Pico Sound board.
    [Pico Sound.kicad_pcb, Pico Sound.kicad_sch]
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2023-06-11 Generated Pico Sound fabrication outputs.
    [Pico Debugger-B_Cu.gbr, Pico Debugger-B_Mask.gbr, Pico Debugger-B_Silkscreen.gbr, Pico Debugger-F_Cu.gbr, Pico Debugger-F_Mask.gbr, Pico Debugger-F_Paste.gbr, Pico Debugger-F_Silkscreen.gbr, Pico Sound-B_Cu.gbr]
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2023-06-21 Updated some Kicad footprints.
    [Pico Sound.kicad_pcb, Pico Sound.kicad_sch]
2023-06-22 Updated Kicad to version 7.
    [Pico Sound.kicad_pcb, Pico Sound.kicad_sch]
2023-06-23 Updated Kicad 3D models.
    [Pico Sound.kicad_pcb]
2023-06-24 Fixed accidental separate grounds.
    [Pico Sound.kicad_pcb, Pico Sound.kicad_sch]
2023-06-24 Added a Molex micro SD card socket.
    [Pico Sound.kicad_pcb, Pico Sound.kicad_sch]
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2023-07-06 A 1MB RAM and ROM memory map.
    [658_Computer.circ]
2023-07-08 Converted the Pico Debug to Kicad 7.
    [658_Computer.circ, LED Display.kicad_sch, Pico Debugger 2.kicad_sch, Pico Debugger.kicad_sch]
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2023-07-14 Fixed channel A and B load inversion.
    [Pico Sound.kicad_pcb, Pico Sound.kicad_sch]
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2023-07-18 Updated 24bit address selector to use a 74LVC1G97.
    [658_Computer.circ]
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2023-07-27 Updated MPU Signals to Kicad 7.
    [LED Display.kicad_sch, MPU Signals.kicad_sch]
2023-08-01 Fixed Diptronic switch pin out.
    [Pico Sound.kicad_pcb, Pico Sound.kicad_sch]
2023-08-01 Updated Keypad to Kicad 7.
    [Keypad.kicad_pcb, Keypad.kicad_sch]
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2023-08-06 Use a large final resistor on the sound output.
    [Pico Sound.kicad_pcb, Pico Sound.kicad_sch]
2023-08-09 Updated Blank Blank Board to Kicad 7.0.
    [Blank Board.kicad_pcb, Blank Board.kicad_sch]
2023-08-09 Added and fixed Kicad symbols and footprints.
2023-08-09 Added a 64 pin 65816 breakout board.
    [MPU Breakout.kicad_pcb, MPU Breakout.kicad_sch]
2023-08-09 Updated Logisim 658_Computer simulation.
    [658_Computer.circ]
2023-08-10 Re-routed the 65816 breakout board.
    [MPU Breakout.kicad_pcb, MPU Breakout.kicad_sch]
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2023-08-10 Finished routing the 65816 breakout board.
    [MPU Breakout.kicad_pcb, MPU Breakout.kicad_sch]
2023-08-10 Cleaned up the 65816 breakout board silkscreen.
    [MPU Breakout.kicad_pcb]
2023-08-11 Fixed a bunch of foot print silkscreenings.
    [MPU Breakout.kicad_pcb, MPU Breakout.kicad_sch]
2023-08-11 Simulating important parts of the breakout board.
    [658_Computer.circ]
2023-08-11 Rounded the breakout board copper zones.
    [MPU Breakout.kicad_pcb, MPU Breakout.kicad_sch]
2023-08-11 Shrunk the breakout board slightly.
    [MPU Breakout.kicad_pcb, MPU Breakout.kicad_sch]
2023-08-12 Better breakout board grounding.
    [MPU Breakout.kicad_pcb]
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2023-08-14 Use capcitor and resistor values rather than their description.
    [MPU Breakout.kicad_sch]
2023-08-15 Updated PCB with new 0805 footprint values.
    [MPU Breakout.kicad_pcb]
2023-08-15 Swapped most 1uF caps from 0805 to 0402.
    [MPU Breakout.kicad_pcb, MPU Breakout.kicad_sch]
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2023-08-20 Experimenting with the WDC C compiler.
    [main.obj]
2023-08-20 Change 0402 capacitors back to 0805.
    [MPU Breakout.kicad_pcb, MPU Breakout.kicad_sch]
2023-08-20 Added a version number to the breakout board.
    [MPU Breakout.kicad_pcb]
2023-08-29 Added a Native Mode latch.
    [MPU Breakout.kicad_pcb, MPU Breakout.kicad_sch]
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2023-09-03 Split MPU Breakout Board into subcircuits.
    [Clock Control Board.kicad_sch, MPU Breakout.kicad_pcb, MPU Breakout.kicad_sch, W65C816 Breakout Board.kicad_sch, temp-freerouting.dsn]
2023-09-03 New HCP65 address decode.
    [658_Computer.circ]
2023-09-04 Routed the Clock Controller Board.
    [Address Decode Board.kicad_sch, Clock Control Board.kicad_sch, MPU Breakout.kicad_pcb, MPU Breakout.kicad_sch]
2023-09-04 Added an Address Decode Board.
    [658_Computer.circ, Address Decode Board.kicad_sch, Clock Control Board.kicad_sch, MPU Breakout.kicad_pcb]
2023-09-05 Completed Address Decode Board signal routing.
    [Address Decode Board.kicad_sch, MPU Breakout.kicad_pcb]
2023-09-06 Added an Asynchronous Write latch.
    [658_Computer.circ, Address Decode Board.kicad_sch, Asyncronous Write.kicad_sch, Clock Control Board.kicad_sch, MPU Breakout.kicad_pcb, MPU Breakout.kicad_sch, Pico Sound.kicad_pcb, Pico Sound.kicad_sch]
2023-09-06 Completed Address Decode Board silkscreen.
    [Address Decode Board.kicad_sch, MPU Breakout.kicad_pcb]
2023-09-07 Fixed an bug on the clock hold board.
    [Address Decode Board.kicad_sch, Clock Control Board.kicad_sch, MPU Breakout.kicad_pcb]
2023-09-07 Added test signals to Clock Control Board.
    [Clock Control Board.kicad_sch, MPU Breakout.kicad_pcb]
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2023-09-09 Partially renamed Asyncronous Write to Asyncronous Write FIFO.
    [Asyncronous Write FIFO.kicad_sch]
2023-09-09 Fixing up the Row Counter.
    [Asyncronous Write FIFO.kicad_sch, Asyncronous Write PHI2 Hold.kicad_sch, Row Counter.kicad_sch, Video 400x600 single.kicad_pcb, Video 400x600 single.kicad_sch]
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2023-09-10 Routed some of the Video Row board.
    [Row Counter.kicad_sch, Small Signal Delay.kicad_pcb, Small Signal Delay.kicad_sch, Video 400x600 single.kicad_pcb]
2023-09-11 Routed Video Row Board Signals.
    [Row Counter.kicad_sch, Video 400x600 single.kicad_pcb]
2023-09-11 Added a few decoupling capacitors.
    [Row Counter.kicad_sch, Video 400x600 single.kicad_pcb]
2023-09-12 Completed Video Row Board routing.
    [Row Counter.kicad_sch, Video 400x600 single.kicad_pcb]
2023-09-12 Added more ground routes.
    [Row Counter.kicad_sch, Video 400x600 single.kicad_pcb]
2023-09-12 Tidied up Row Counter schematic.
    [Row Counter.kicad_sch, Video 400x600 single.kicad_pcb]
2023-09-14 Second start on a video row counter.
    [Asyncronous Write FIFO.kicad_sch, Asyncronous Write PHI2 Hold.kicad_sch, Row Counter.kicad_sch, Video 400x600 single.kicad_pcb, Video Timer.kicad_pcb, Video Timer.kicad_sch]
2023-09-16 Use a 1-of-8 select for pixel advance rather than a shift register.
    [Asyncronous Write FIFO.kicad_sch, Asyncronous Write PHI2 Hold.kicad_sch, Row Counter.kicad_sch, Video 400x600 single.kicad_pcb, Video 400x600 single.kicad_sch, Video Timer.kicad_pcb]
2023-09-16 Routed Signals on the Row Counter board.
    [Video Timer.kicad_pcb]
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2023-09-16 Started adding Address Position.
    [Address Position.kicad_sch, Row Counter.kicad_sch, Video Timer.kicad_pcb, Video Timer.kicad_sch]
2023-09-17 Address Position Counter mostly done.
    [Address Position.kicad_sch, Row Counter.kicad_sch, Video Timer.kicad_pcb]
2023-09-17 Gate video address out on pixel clock.
    [Address Position.kicad_sch, Row Counter.kicad_sch, Video Timer.kicad_pcb]
2023-09-17 Routed some Address Position traces.
    [Address Position.kicad_sch, Video Timer.kicad_pcb]
2023-09-19 Routed all Address Position signals.
    [Address Position.kicad_sch, Asyncronous Write FIFO.kicad_sch, Video 400x600 single.kicad_pcb, Video Timer.kicad_pcb]
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2023-09-25 Vertical Position schematic mostly done.
    [Address Position.kicad_sch, Row Counter.kicad_sch, Vertical Position.kicad_sch, Video Timer.kicad_pcb]
2023-09-25 Placing Horizontal position ICs.
    [Row Counter.kicad_sch, Vertical Position.kicad_sch]
2023-09-26 Shortened the Vertical Position board.
    [Address Position.kicad_sch, Row Counter.kicad_sch, Vertical Position.kicad_sch]
2023-09-27 Routed all Vertical Position signals.
    [Vertical Position.kicad_sch]
2023-09-27 Added some decoupling caps.
    [Vertical Position.kicad_sch]
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2023-09-29 Better decoupling caps on the W65C816 Breakout board.
    [MPU Breakout.kicad_pcb, W65C816 Breakout Board.kicad_sch]
2023-09-29 Better decoupling caps on the Address Decode board.
    [Clock Control Board.kicad_sch, MPU Breakout.kicad_pcb]
2023-09-29 Added debug pins to Vertical Position.
    [Vertical Position.kicad_sch]
2023-09-30 Added a Memory Board.
    [MPU Breakout.kicad_pcb, MPU Breakout.kicad_sch, Memory Board.kicad_sch]
2023-10-01 Added a dual W65C22 Breakout Board.
    [VIA Device.kicad_pcb, VIA Device.kicad_sch, W65C22 Breakout Board.kicad_sch]
2023-10-01 Realised MPU Clock Control needs thought.
    [Clock Control Board.kicad_sch, MPU Breakout.kicad_pcb, VIA Device.kicad_pcb, VIA Device.kicad_sch, W65C22 Breakout Board.kicad_sch]
2023-10-03 Added an LCD display to the VIA device.
    [Address Decode Board.kicad_sch, Clock Control Board.kicad_sch, LCD Display.kicad_sch, MPU Breakout.kicad_pcb, Memory Board.kicad_sch, VIA Device.kicad_pcb, VIA Device.kicad_sch, W65C22 Breakout Board.kicad_sch]
2023-10-04 Added a Sound Device.
    [658_Computer.circ, Pico Sound.kicad_pcb, Pico Sound.kicad_sch, Sound Address.kicad_sch, Sound Clock.kicad_sch, Sound DAC.kicad_sch, Sound.kicad_pcb, Sound.kicad_sch]
2023-10-05 Added Counter and Selector Component Boards.
    [Counter 16bit.kicad_pcb, Counter 16bit.kicad_sch, Memory 32KB with Output.kicad_pcb, Memory 32KB with Output.kicad_sch, Selector 12bit.kicad_pcb, Selector 12bit.kicad_sch, Sound Clock.kicad_sch, Sound.kicad_pcb]
2023-10-06 Trying to add a 24bit counter.
    [Counter 16bit with IO.kicad_pcb, Counter 16bit with IO.kicad_sch, Counter 16bit.kicad_pcb, Counter 24bit with IO.kicad_pcb, Counter 24bit with IO.kicad_sch, Sound Clock.kicad_sch]
2023-10-07 Finished routing all Counter 24bit with IO signals.
    [Counter 24bit with IO.kicad_pcb, Counter 24bit with IO.kicad_sch]
2023-10-07 Better grounding for Counter 24bit with IO signals.
    [Counter 24bit with IO.kicad_pcb, Counter 24bit with IO.kicad_sch]
2023-10-08 Finished routing all Counter 16bit with IO signals.
    [Counter 16bit with IO.kicad_pcb, Counter 16bit with IO.kicad_sch, MPU Breakout.kicad_pcb, Memory Board.kicad_sch]
2023-10-08 Better grounding for Counter 16bit with IO signals.
    [Counter 16bit with IO.kicad_pcb]
2023-10-08 Added a 16bit comparator.
    [Comparator 16bit.kicad_pcb, Comparator 16bit.kicad_sch, Counter 16bit with IO.kicad_sch, Counter 16bit.kicad_pcb, Counter 24bit with IO.kicad_pcb, Counter 24bit with IO.kicad_sch, Memory 32KB with Output.kicad_pcb, Selector 12bit.kicad_pcb]
2023-10-08 Added Flags, Enable and Interrupt.
    [Flags Enable Interrupt.kicad_pcb, Flags Enable Interrupt.kicad_sch]
2023-10-09 Adding version two of the sound card using component boards.
    [Comparator 16bit.kicad_sch, Flags Enable Interrupt.kicad_pcb, Flags Enable Interrupt.kicad_sch, Sound Address.kicad_sch, Sound Clock.kicad_sch, Sound DAC.kicad_sch, Sound V2.kicad_pcb, Sound V2.kicad_sch]
2023-10-10 Added some component boards and symbols and footprints.
    [Audio DAC.kicad_pcb, Audio DAC.kicad_sch, Audio DAC.step, Comparator 16bit.kicad_pcb, Comparator 16bit.kicad_sch, Counter 16bit with IO.kicad_pcb, Counter 16bit with IO.step, Counter 16bit.step]
2023-10-11 Moved the old Sound board into a Sound V1 project.
    [Sound Address.kicad_sch, Sound Clock.kicad_sch, Sound DAC.kicad_sch, Sound V1.kicad_pcb, Sound V1.kicad_sch]
2023-10-11 Moved the Sound Schematic into it's own directory.
    [Device Select.kicad_sch, Sound Address.kicad_sch, Sound Board.kicad_pcb, Sound Board.kicad_sch, Sound Clock.kicad_sch, Sound DAC.kicad_sch, Sound.kicad_pcb, Sound.kicad_sch]
2023-10-12 Moved old Kicad projects into an old directory.
    [Address Decode.kicad_pcb, Address Decode.kicad_sch, Async FIFO Write.kicad_pcb, Async FIFO Write.kicad_sch, Asyncronous Write FIFO.kicad_sch, Asyncronous Write PHI2 Hold.kicad_sch, Blank Board.kicad_pcb, Blank Board.kicad_sch]
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2023-10-14 Added a 1-of-12 pixel pattern selector.
    [Pixel Doubler.kicad_pcb, Pixel Doubler.kicad_sch, Pixel Doubler.step]
2023-10-16 Added a generic device address decode schematic.
    [Device Address Decode.kicad_pcb, Device Address Decode.kicad_sch, Device Address Decode.step, Sound Device Select.kicad_sch]
2023-10-16 Logisim simulation of device decode.
    [DeviceDecode.circ]
2023-10-18 Routed Device Decode Stage A.
    [658_Computer.circ, Big Board.kicad_pcb, Big Board.kicad_sch, Big Board.step, Device Address Decode.kicad_pcb, Device Decode stage A.kicad_pcb, Device Decode stage A.kicad_sch, Device Decode stage A.step]
2023-10-18 Added Device Decode stage B.
    [Device Decode stage A.kicad_pcb, Device Decode stage A.kicad_sch, Device Decode stage B.kicad_pcb, Device Decode stage B.kicad_sch, Device Decode stage B.step]
2023-10-19 Bit of device decode fix-up.
    [Device Decode stage A.kicad_pcb, Device Decode stage A.kicad_sch, Device Decode stage B.kicad_pcb, Device Decode stage B.kicad_sch, Sound Address Decode.kicad_sch, Sound Board.kicad_pcb, Sound Board.kicad_sch, Sound Device Select.kicad_pcb]
2023-10-19 Added a Clock Hold Select.
    [Clock Hold Select.kicad_pcb, Clock Hold Select.kicad_sch, Sound Address Decode.kicad_pcb, Sound Address Decode.kicad_sch, Sound Address Decode.step, Sound Board.kicad_pcb, Sound Board.kicad_sch, Sound Clock.kicad_sch]
2023-10-20 Updated the Signal Buffer to be a Data and Signal Buffer.
    [2PB1424,115.stp, Data and Signal Buffer.kicad_pcb, Data and Signal Buffer.kicad_sch, Data and Signal Buffer.step, Device Decode stage A.kicad_pcb, Device Decode stage A.kicad_sch, Flags Enable Interrupt.kicad_pcb, Flags Enable Interrupt.kicad_sch]
2023-10-20 Added a 24bit Address Buffer.
    [Address Buffer.kicad_pcb, Address Buffer.kicad_sch, Address Buffer.step, Sound Board.kicad_pcb, Sound Board.kicad_sch, freerouting.dsn, temp-freerouting.dsn]
2023-10-21 Added a Device Buffer.
    [Device Buffer.kicad_pcb, Device Buffer.kicad_sch, Device Buffer.step, Sound Board.kicad_pcb, Sound Board.kicad_sch, freerouting.dsn, temp-freerouting.dsn]
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2023-10-22 Fixed Counter 16bit with IO read address high.
    [Counter 16bit with IO.kicad_pcb, Counter 16bit with IO.kicad_sch, Counter 16bit with IO.step]
2023-10-22 Include ROM read and write clock holds.
    [Clock Hold Select.kicad_pcb, Clock Hold Select.kicad_sch, Clock Hold Select.step, Device Decode stage A.kicad_pcb, Device Decode stage A.kicad_sch, MPU Breakout.kicad_pcb, Memory 32KB with Output.kicad_pcb, Memory 32KB with Output.kicad_sch]
2023-10-22 Update MPU Breakout components.
    [Address Decode Board.kicad_sch, Clock Control Board.kicad_sch, LCD Display.kicad_sch, MPU Breakout.kicad_pcb, VIA Device.kicad_pcb, W65C816 Breakout Board.kicad_sch]
2023-10-23 Splitting Via Schematics into separate projects.
    [Clock Control Board.kicad_sch, Clock Hold Select.kicad_pcb, LCD Display.kicad_sch, VIA Breakout.kicad_pcb, VIA Breakout.kicad_sch, VIA Breakout.step, VIA Device.kicad_pcb, Via Clock Control.kicad_pcb]
2023-10-23 Splitting LCD Schematics into separate projects.
    [Clock Control Board.kicad_sch, LCD Display.kicad_pcb, LCD Display.kicad_sch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]
2023-10-23 Renaming VIA Clock Control.
    [Clock Control Board.kicad_sch, LCD Display.kicad_pcb, LCD Display.kicad_sch, VIA Clock Control 2.kicad_pcb, VIA Clock Control 2.kicad_sch, VIA Clock Control 2.step, W65C22 Breakout Board.kicad_sch]
2023-10-23 Added the VIA board.
    [VIA Board.kicad_pcb, VIA Board.kicad_sch]
2023-10-23 Added a VIA Board.
    [Sound Board.kicad_pcb, Sound Board.kicad_sch, VIA Board.kicad_pcb, VIA Board.kicad_sch, VIA Clock Control.kicad_pcb, VIA Clock Control.kicad_sch, VIA Clock Control.step]
2023-10-24 Auto-routed VIA and Sound Boards.
    [Sound Board.kicad_pcb, VIA Board.kicad_pcb]
2023-10-24 Resized VIA and Sound Boards.
    [Clock Control Board.kicad_sch, Device Decode Simple.kicad_pcb, Device Decode Simple.kicad_sch, Device Decode Simple.step, LCD Display.kicad_sch, Sound Board.kicad_pcb, VIA Board.kicad_pcb, VIA Board.kicad_sch]
2023-10-25 Auto-routed VIA and Sound Boards (again).
    [Sound Board.kicad_pcb, VIA Board.kicad_pcb]
2023-10-26 Moved misplaced labels around. I think. I don't remember.
    [MPU Breakout.kicad_pcb]
2023-10-26 Added version number to component boards.
    [Address Buffer.kicad_pcb, Audio DAC.kicad_pcb, Clock Hold Select.kicad_pcb, Counter 16bit with IO.kicad_pcb, Counter 16bit.kicad_pcb, Counter 24bit with IO.kicad_pcb, Data and Signal Buffer.kicad_pcb, Device Buffer.kicad_pcb]
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2023-10-27 Standardising DIP board layouts.
    [Address Buffer.kicad_pcb, Address Buffer.kicad_sch, Address Decode Board.kicad_sch, Audio DAC.kicad_pcb, Audio DAC.kicad_sch, Clock Control Board.kicad_sch, Clock Hold Select.kicad_pcb, Clock Hold Select.kicad_sch]
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2023-10-30 Added a Dual 8 bit comparator.
    [Dual Comparator 8bit.kicad_pcb, Dual Comparator 8bit.kicad_sch]
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2023-11-10 Routed (mostly) the Dual 8bit comparator.
    [Dual Comparator 8bit.kicad_pcb, Dual Comparator 8bit.kicad_sch]
2023-11-11 Finished routing the Dual 8bit comparator.
    [Dual Comparator 8bit.kicad_pcb]
2023-11-11 Added a 12bit horizontal or vertical counter.
    [Dual Comparator 8bit.kicad_pcb, Video Counter 12bit.kicad_pcb, Video Counter 12bit.kicad_sch]
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2023-11-12 Added an additional enable to the 24bit counter.
    [Counter 24bit with IO.kicad_pcb, Counter 24bit with IO.kicad_sch]
2023-11-12 Added the 24bit Graphics Address Selector.
    [Address Selector 24bit.kicad_pcb, Address Selector 24bit.kicad_sch, Address Selector 24bit.step]
2023-11-12 Minor cleanups in the Video Timer.
    [Address Position.kicad_sch, Row Counter.kicad_sch, Vertical Position.kicad_sch]
2023-11-14 Added pull-ups to the MPU MPU Breakout.
    [Address Decode Board.kicad_sch, Clock Control Board.kicad_sch, Device Decode stage A.kicad_pcb, Device Decode stage A.kicad_sch, MPU Breakout.kicad_pcb, W65C816 Breakout Board.kicad_sch]
2023-11-15 Added silkscreen to Address Selector.
    [Address Selector 24bit.kicad_pcb, Counter 24bit with IO.kicad_sch, Device Decode Simple.kicad_pcb]
2023-11-17 Fixed and labeled the Pixel Pixel Doubler (1-of-12 selector).
    [Pixel Doubler.kicad_pcb, Pixel Doubler.kicad_sch]
2023-11-18 Added PS2 timing and FIFO boards.
    [Counter 16bit with IO.kicad_pcb, Counter 16bit with IO.kicad_sch, PS2 FIFO.kicad_pcb, PS2 FIFO.kicad_sch, PS2 FIFO.step, PS2 Timing.kicad_pcb, PS2 Timing.kicad_sch, PS2 Timing.step]
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2023-11-19 Resized 15mm wide boards and fixed GND pins. Added GPIO 4bit and PS2 Board.
    [Address Buffer.kicad_pcb, Address Buffer.step, Audio DAC.kicad_pcb, Audio DAC.step, Big Board.kicad_sch, Clock Hold Select.kicad_pcb, Clock Hold Select.kicad_sch, Clock Hold Select.step]
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2023-11-20 Updated forgotten VIA Clock Control.
    [PS2 Board.kicad_pcb, VIA Clock Control.kicad_pcb, VIA Clock Control.kicad_sch]
2023-11-20 I can't remember what I did.
    [Device Decode stage A.kicad_pcb, PS2 Board.kicad_sch, Sound Board.kicad_pcb, Sound Board.kicad_sch, VIA Board.kicad_pcb, VIA Board.kicad_sch]
2023-11-21 Added State Reader and re-routed Device Decode stage B.
    [Device Decode Simple.kicad_pcb, Device Decode Simple.kicad_sch, Device Decode Simple.step, Device Decode stage A.kicad_sch, Device Decode stage B.kicad_pcb, Device Decode stage B.kicad_sch, Device Decode stage B.step, Flags Enable Interrupt.kicad_pcb]
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2023-11-24 Added a standard clock hold without selectors.
    [Clock Hold Standard.kicad_pcb, Clock Hold Standard.kicad_sch, Clock Hold Standard.step]
2023-11-24 Added a standard VIA clock.
    [VIA Board.kicad_sch, VIA Standard Clock.kicad_pcb, VIA Standard Clock.kicad_sch]
2023-11-24 Silkscreening for VIA VIA Standard Clock.
    [VIA Standard Clock.kicad_pcb, VIA Standard Clock.kicad_sch]
2023-11-26 Split MPU boards into their own projects.
    [Address Decode Board.kicad_sch, Clock Control Board.kicad_sch, HCP65 Address Decode.kicad_pcb, HCP65 Address Decode.kicad_sch, HCP65 Memory.kicad_pcb, HCP65 Memory.kicad_sch, MPU Breakout.kicad_pcb, MPU Breakout.kicad_sch]
2023-11-26 Auto-routed the Sound Board.
    [Sound Board.kicad_pcb, Sound Board.kicad_sch, freerouting.dsn, temp-freerouting.dsn]
2023-11-27 Added W65C816 breakout and clock hold boards.
    [Clock Control Board.kicad_sch, HCP65 Single MPU Board.kicad_pcb, HCP65 Single MPU Board.kicad_sch, W65C816 Breakout Board.kicad_sch, W65C816 Breakout.kicad_pcb, W65C816 Clock Hold.kicad_pcb, W65C816 Clock Hold.kicad_sch]
2023-11-27 Renamed HCP MPU boards.
    [Address Decode Board.kicad_sch, HCP65 Address Decode.kicad_pcb, HCP65 Address Decode.kicad_sch, HCP65 MPU Address Decode.kicad_pcb, HCP65 MPU Address Decode.kicad_sch, HCP65 MPU Memory.kicad_pcb, HCP65 MPU Memory.kicad_sch, HCP65 Memory.kicad_pcb]
2023-12-03 Added a Kernal mode board.
    [658_Computer.circ, Address Decode Board.kicad_sch, HCP65 Kernal Mode.kicad_pcb, HCP65 Kernal Mode.kicad_sch, HCP65 MPU Address Decode.kicad_pcb, HCP65 MPU Address Decode.kicad_sch, HCP65 Single MPU Board.kicad_pcb, HCP65 Single MPU Board.kicad_sch]
2023-12-04 Added device reset and interrupt boards.
    [HCP65 Device Interrupts.kicad_pcb, HCP65 Device Interrupts.kicad_sch, HCP65 Device Reset.kicad_pcb, HCP65 Device Reset.kicad_sch, HCP65 MPU Memory.kicad_sch, HCP65 Single MPU Board.kicad_pcb, HCP65 Single MPU Board.kicad_sch, Memory Board.kicad_sch]
2023-12-04 Completed device reset and interrupt boards routing.
    [HCP65 Device Interrupts.kicad_pcb, HCP65 Device Interrupts.kicad_sch, HCP65 Device Reset.kicad_pcb, HCP65 Device Reset.kicad_sch]
2023-12-04 Kernal Mode fixes.
    [HCP65 Single MPU Board.kicad_pcb, HCP65 Single MPU Board.kicad_sch]
2023-12-05 Added MPU NMI- Main Memory Address- and Main Memory Data boards.
    [Clock Control Board.kicad_sch, Counter 16bit.kicad_pcb, Counter 16bit.kicad_sch, HCP65 Device Reset.kicad_pcb, HCP65 Device Reset.kicad_sch, HCP65 MPU NMI.kicad_pcb, HCP65 MPU NMI.kicad_sch, HCP65 Main Memory Address.kicad_pcb]
2023-12-06 Added a RS232 UART board.
    [658_Computer.circ, Clock.kicad_pcb, G17C0900132EU.stp, MAX232ECDR.stp, RS232.kicad_pcb, RS232.kicad_sch, RS232.step, Selector State.kicad_pcb]
2023-12-06 Included /ADS line int UART.
    [RS232.kicad_pcb, RS232.kicad_sch]
2023-12-06 Started adding a Clock Clock Generator.
    [658_Computer.circ, Clock Generator.kicad_pcb, Clock Generator.kicad_sch, Clock Generator.step, Clock LTC6903.kicad_pcb, Clock LTC6903.kicad_sch, Clock LTC6903.step, Clock Oscillator.kicad_pcb]
2023-12-09 Split NMI state and timer into separate boards.
    [658_Computer.circ, Clock Generator.kicad_pcb, Clock Generator.kicad_sch, Clock LTC6903.kicad_pcb, Clock LTC6903.step, Clock Oscillator.kicad_pcb, Clock Oscillator.step, Clock Push Button.kicad_pcb]
2023-12-09 Added a Test MPU Board and reversed the Device Buffer.
    [Clock Generator.kicad_pcb, Clock Generator.kicad_sch, Device Buffer.kicad_pcb, Device Buffer.kicad_sch, Device Buffer.step, HCP65 Single MPU Board.kicad_sch, HCP65 Test MPU Board.kicad_pcb, HCP65 Test MPU Board.kicad_sch]
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2023-12-09 Cleaned up VIA Board.
    [HCP65 Test MPU Board.kicad_pcb, VIA Board.kicad_pcb]
2023-12-13 Split Kernal Mode into the kernal counter and instruction code.
    [658_Computer.circ, Address Decode Board.kicad_sch, Dual MPU Clock Generator.kicad_pcb, Dual MPU Clock Generator.kicad_sch, HCP65 Instruction Code.kicad_pcb, HCP65 Instruction Code.kicad_sch, HCP65 Kernal Mode.kicad_pcb, HCP65 Kernal Mode.kicad_sch]
2023-12-14 Re-routed Kernal Mode board.
    [HCP65 Instruction Code.kicad_pcb, HCP65 Instruction Code.kicad_sch, HCP65 Kernal Mode.kicad_pcb, HCP65 Kernal Mode.kicad_sch]
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2023-12-15 Generated Gerbers for W65C816 and minimal attendant boards.
    [Address Decode Board.kicad_sch, Clock Control Board.kicad_sch, Dual MPU Clock Generator.kicad_pcb, Dual MPU Clock Generator.kicad_sch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]
2023-12-15 Fattened 12V power lines.
    [HCP65 Test MPU Board.kicad_pcb, HCP65 Test MPU Board.kicad_sch]
2023-12-15 Generated Gerbers for MPU Test Board.
    [Dual MPU Clock Generator-B_Cu.gbr, Dual MPU Clock Generator-B_Mask.gbr, Dual MPU Clock Generator-B_Silkscreen.gbr, Dual MPU Clock Generator-Edge_Cuts.gbr, Dual MPU Clock Generator-F_Cu.gbr, Dual MPU Clock Generator-F_Mask.gbr, Dual MPU Clock Generator-F_Silkscreen.gbr, Dual MPU Clock Generator-NPTH.drl]
2023-12-15 Added an LCD Device Board.
    [HCP65 Test MPU Board-B_Cu.gbr, HCP65 Test MPU Board-B_Mask.gbr, HCP65 Test MPU Board-B_Silkscreen.gbr, HCP65 Test MPU Board-Edge_Cuts.gbr, HCP65 Test MPU Board-F_Cu.gbr, HCP65 Test MPU Board-F_Mask.gbr, HCP65 Test MPU Board-F_Silkscreen.gbr, HCP65 Test MPU Board-NPTH.drl]
2023-12-16 Fixed auto-routed boards and generated all Gerbers.
    [HCP65 Test MPU Board-B_Cu.gbr, HCP65 Test MPU Board-B_Mask.gbr, HCP65 Test MPU Board-B_Silkscreen.gbr, HCP65 Test MPU Board-Edge_Cuts.gbr, HCP65 Test MPU Board-F_Cu.gbr, HCP65 Test MPU Board-F_Mask.gbr, HCP65 Test MPU Board-F_Silkscreen.gbr, HCP65 Test MPU Board-NPTH.drl]
2023-12-16 Added a SNES Gamepad Clock.
    [658_Computer.circ, LCD Board.kicad_pcb, LCD Board.kicad_sch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]
2023-12-17 Tidied up LCD Display schematic and generated Gerbers.
    [LCD Display-B_Cu.gbr, LCD Display-B_Mask.gbr, LCD Display-B_Silkscreen.gbr, LCD Display-Edge_Cuts.gbr, LCD Display-F_Cu.gbr, LCD Display-F_Mask.gbr, LCD Display-F_Silkscreen.gbr, LCD Display-NPTH.drl]
2023-12-17 Added a SNES Controller Reader.
    [LCD Board.kicad_sch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]
2023-12-17 Corrected LCD Board orientation.
    [LCD Board.kicad_pcb, LCD Board.kicad_sch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]
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2023-12-17 Split PS2 Interrupt clearing into both part 1 and 2.
    [Device Decode stage A-B_Cu.gbr, Device Decode stage A-B_Mask.gbr, Device Decode stage A-B_Silkscreen.gbr, Device Decode stage A-Edge_Cuts.gbr, Device Decode stage A-F_Cu.gbr, Device Decode stage A-F_Mask.gbr, Device Decode stage A-F_Silkscreen.gbr, Device Decode stage A-NPTH.drl]
2023-12-18 Fixed up all sub-boards used by the HCP65 MPU Test Board and re-generated Gerbers.
    [Dual MPU Clock Generator-B_Cu.gbr, Dual MPU Clock Generator-B_Mask.gbr, Dual MPU Clock Generator-B_Silkscreen.gbr, Dual MPU Clock Generator-Edge_Cuts.gbr, Dual MPU Clock Generator-F_Cu.gbr, Dual MPU Clock Generator-F_Mask.gbr, Dual MPU Clock Generator-F_Silkscreen.gbr, Dual MPU Clock Generator-NPTH.drl]
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2023-12-18 Fixed a couple of typos in the fabrication spreadsheet.
    [Fabrication.ods]
2023-12-22 Did something to the clock control board.
    [Clock Control Board.kicad_sch]
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2023-12-28 Fixed device 1 and 16 being swapped.
    [HCP65 Test MPU Board.kicad_pcb]
2023-12-28 Removed a random unused simualted circuit.
    [658_Computer.circ]
2023-12-29 Converted old SNES device to Kicad 7. Don't know why.
    [Device Selector.kicad_sch, SNES Controller Board.kicad_sch, SNES Controller Counter.kicad_sch, SNES Controller Device.kicad_sch, SNES Controller Shift Register.kicad_sch, SNES Controller Timing.kicad_sch, SNES Controller Translation.kicad_sch, SNES Device Selector.kicad_sch]
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2023-12-29 Re-added the 16x 32KB device decode.
    [Address Decode Board.kicad_sch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]
2023-12-29 Added the 8x 32KB device decode.
    [Address Decode Board.kicad_sch, HCP65 MPU Address Decode.kicad_pcb]
2023-12-29 Silkscreened both Address Decode and Address Decode Wide Boards.
    [Address Decode Board.kicad_sch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]
2023-12-30 Symbols for both Address Decode and Address Decode Wide Boards.
    [HCP65 MPU Address Decode Wide.kicad_pcb, HCP65 Single MPU Board.kicad_sch, HCP65 Test MPU Board.kicad_pcb, HCP65 Test MPU Board.kicad_sch]
2023-12-30 Re-autorouted test mpu board.
    [HCP65 Test MPU Board.kicad_pcb]
2024-01-04 Added a 3 MPU clock generator.
    [DivideBy3Clock.circ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]
2024-01-04 Split Device Interrupts into Wide and normal variants.
    [HCP65 Device Interrupts Wide-B_Cu.gbr, HCP65 Device Interrupts Wide-B_Mask.gbr, HCP65 Device Interrupts Wide-B_Silkscreen.gbr, HCP65 Device Interrupts Wide-Edge_Cuts.gbr, HCP65 Device Interrupts Wide-F_Cu.gbr, HCP65 Device Interrupts Wide-F_Mask.gbr, HCP65 Device Interrupts Wide-F_Silkscreen.gbr, HCP65 Device Interrupts Wide-NPTH.drl]
2024-01-04 Finished routing Device Interrupts.
    [HCP65 Device Interrupts-B_Cu.gbr, HCP65 Device Interrupts-B_Mask.gbr, HCP65 Device Interrupts-B_Silkscreen.gbr, HCP65 Device Interrupts-Edge_Cuts.gbr, HCP65 Device Interrupts-F_Cu.gbr, HCP65 Device Interrupts-F_Mask.gbr, HCP65 Device Interrupts-F_Silkscreen.gbr, HCP65 Device Interrupts-NPTH.drl]
2024-01-05 Manually cleaning up the PCB test routing.
    [HCP65 Test MPU Board.kicad_pcb]
2024-01-07 Add Andre's memory map decoder to Logicim circuit.
    [658_Computer.circ]
2024-01-07 Saved Pico Debugger 2 with KiCad 7.
    [Pico Debugger 2.kicad_pcb, Pico Debugger 2.kicad_sch]
2024-01-10 Generated Gerbers for: Test MPU Board, Device Interrupts, Device Reset.
    [HCP65 Device Interrupts-B_Cu.gbr, HCP65 Device Interrupts-B_Mask.gbr, HCP65 Device Interrupts-B_Silkscreen.gbr, HCP65 Device Interrupts-Edge_Cuts.gbr, HCP65 Device Interrupts-F_Cu.gbr, HCP65 Device Interrupts-F_Mask.gbr, HCP65 Device Interrupts-F_Silkscreen.gbr, HCP65 Device Interrupts-NPTH.drl]
2024-01-10 Generated Gerbers for: Dual- Triple- and Quad Clock Generators.
    [Dual MPU Clock Generator-B_Cu.gbr, Dual MPU Clock Generator-B_Mask.gbr, Dual MPU Clock Generator-B_Silkscreen.gbr, Dual MPU Clock Generator-Edge_Cuts.gbr, Dual MPU Clock Generator-F_Cu.gbr, Dual MPU Clock Generator-F_Mask.gbr, Dual MPU Clock Generator-F_Silkscreen.gbr, Dual MPU Clock Generator-NPTH.drl]
2024-01-10 Generated Gerbers for: MPU Address Decode, MPU Memory and MPU Timer.
    [HCP65 MPU Address Decode-B_Cu.gbr, HCP65 MPU Address Decode-B_Mask.gbr, HCP65 MPU Address Decode-B_Silkscreen.gbr, HCP65 MPU Address Decode-Edge_Cuts.gbr, HCP65 MPU Address Decode-F_Cu.gbr, HCP65 MPU Address Decode-F_Mask.gbr, HCP65 MPU Address Decode-F_Silkscreen.gbr, HCP65 MPU Address Decode-NPTH.drl]
2024-01-10 Generated Gerbers for: W65C816- Breakout and Timer boards.
    [W65C816 Breakout-B_Cu.gbr, W65C816 Breakout-B_Mask.gbr, W65C816 Breakout-B_Silkscreen.gbr, W65C816 Breakout-Edge_Cuts.gbr, W65C816 Breakout-F_Cu.gbr, W65C816 Breakout-F_Mask.gbr, W65C816 Breakout-F_Silkscreen.gbr, W65C816 Breakout-NPTH.drl]
2024-01-10 Generated Gerbers for: Device Buffer, Device Decode Stage A and the LCD Display.
    [Device Buffer-B_Cu.gbr, Device Buffer-B_Mask.gbr, Device Buffer-B_Silkscreen.gbr, Device Buffer-Edge_Cuts.gbr, Device Buffer-F_Cu.gbr, Device Buffer-F_Mask.gbr, Device Buffer-F_Silkscreen.gbr, Device Buffer-NPTH.drl]
2024-01-10 Generated Gerbers for: LCD Board, SNES Controller Clock and SNES Controller Reader.
    [HCP65 Test MPU Board-B_Cu.gbr, HCP65 Test MPU Board-B_Mask.gbr, HCP65 Test MPU Board-B_Silkscreen.gbr, HCP65 Test MPU Board-Edge_Cuts.gbr, HCP65 Test MPU Board-F_Cu.gbr, HCP65 Test MPU Board-F_Mask.gbr, HCP65 Test MPU Board-F_Silkscreen.gbr, HCP65 Test MPU Board-NPTH.drl]
2024-01-10 Generated Gerbers for: Clock LTC6903, Clock Oscillator and Clock Push Button.
    [Clock LTC6903-B_Cu.gbr, Clock LTC6903-B_Mask.gbr, Clock LTC6903-B_Silkscreen.gbr, Clock LTC6903-Edge_Cuts.gbr, Clock LTC6903-F_Cu.gbr, Clock LTC6903-F_Mask.gbr, Clock LTC6903-F_Silkscreen.gbr, Clock LTC6903-NPTH.drl]
2024-01-20 Use thinner boards for Video components.
    [Address Selector 24bit.kicad_pcb, Address Selector 24bit.kicad_sch, GPIO 4bit.kicad_pcb, GPIO 4bit.kicad_sch, HCP65 Instruction Code.kicad_pcb, HCP65 Kernal Mode.kicad_pcb, HCP65 Kernal Mode.kicad_sch, HCP65 Main Memory Address.kicad_pcb]
2024-01-22 Added a Video Blank and Sync Board.
    [Blank and Sync-B_Cu.gbr, Blank and Sync-B_Mask.gbr, Blank and Sync-B_Silkscreen.gbr, Blank and Sync-Edge_Cuts.gbr, Blank and Sync-F_Cu.gbr, Blank and Sync-F_Mask.gbr, Blank and Sync-F_Silkscreen.gbr, Blank and Sync-NPTH.drl]
2024-01-22 Added terminal count output and latch enable to 16bit and 24bit counters.
    [Counter 16bit with IO.kicad_pcb, Counter 16bit with IO.kicad_sch, Counter 24bit with IO.kicad_pcb, Counter 24bit with IO.kicad_sch, Dual Comparator 8bit.kicad_pcb, Dual Comparator 8bit.kicad_sch, GPIO 4bit.kicad_pcb, Memory 32KB with Output.kicad_pcb]
2024-01-22 Renamed Graphics directory to Video.
    [Address Selector 24bit.kicad_pcb, Address Selector 24bit.kicad_sch, Address Selector 24bit.step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]
2024-01-24 Began adding the Video Board and attendant circuits.
    [Address Position.kicad_sch, Address Selector 24bit.kicad_pcb, Address Selector 24bit.step, Big Board.kicad_sch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]
2024-01-24 Adding Video Address Counter.
    [Video Address Counter.kicad_pcb, Video Address Counter.kicad_sch]
2024-01-26 Added Video Address Reader schematic and PCB.
    [Address Position.kicad_sch, Big Board.kicad_pcb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]
2024-01-27 No sure what I did.
    [HCP65 Test MPU Board.kicad_pcb, HCP65 Test MPU Board.kicad_sch]
2024-01-27 Use Protel gerber naming conventions rather.
    [Audio DAC-B_Cu.gbl, Audio DAC-B_Mask.gbs, Audio DAC-B_Silkscreen.gbo, Audio DAC-Edge_Cuts.gm1, Audio DAC-F_Cu.gtl, Audio DAC-F_Mask.gts, Audio DAC-F_Silkscreen.gto, Audio DAC-NPTH.drl]
2024-01-28 Added left and right signal testers.
    [Bus Tester.kicad_pcb, Bus Tester.kicad_sch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]
2024-01-28 Moved Bus Tester into Testers.
    [Bus Tester-B_Cu.gbr, Bus Tester-B_Mask.gbr, Bus Tester-B_Silkscreen.gbr, Bus Tester-Edge_Cuts.gbr, Bus Tester-F_Cu.gbr, Bus Tester-F_Mask.gbr, Bus Tester-F_Silkscreen.gbr, Bus Tester-NPTH.drl]
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2024-01-28 Deleted Timer. I don't know what it was.
    [Timer.kicad_pcb, Timer.kicad_sch]
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2024-01-30 Updated W65C816 Breakout to include Schmitt triggers and resistors on the clock and reset signals.
    [Clock Control Board.kicad_sch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]
2024-01-30 Updated PS2 Timining board to use positive signals.
    [PS2 Board.kicad_pcb, PS2 Board.kicad_sch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]
2024-01-30 Re-panelised the Sound Board.
    [combined.drl, combined.gbl, combined.gbo, combined.gbs, combined.gm1, combined.gts, combined2.drl, combined_blended_outline.GKO]
2024-01-30 Added a Wide Pico GPIO board.
    [Pico Wide GPIO.kicad_pcb, Pico Wide GPIO.kicad_sch]
2024-02-01 Added a 16bit Address Buffer.
    [Address Buffer 16bit-B_Cu.gbl, Address Buffer 16bit-B_Mask.gbs, Address Buffer 16bit-B_Silkscreen.gbo, Address Buffer 16bit-Edge_Cuts.gm1, Address Buffer 16bit-F_Cu.gtl, Address Buffer 16bit-F_Mask.gts, Address Buffer 16bit-F_Silkscreen.gto, Address Buffer 16bit-NPTH.drl]
2024-02-01 Renamed Address Buffer to Address Buffer 24bit.
    [Address Buffer 24bit-B_Cu.gbl, Address Buffer 24bit-B_Mask.gbs, Address Buffer 24bit-B_Silkscreen.gbo, Address Buffer 24bit-Edge_Cuts.gm1, Address Buffer 24bit-F_Cu.gtl, Address Buffer 24bit-F_Mask.gts, Address Buffer 24bit-F_Silkscreen.gto, Address Buffer 24bit-NPTH.drl]
2024-02-01 Cleaned up Data and Signal Buffer.
    [Data and Signal Buffer-B_Cu.gbl, Data and Signal Buffer-B_Mask.gbs, Data and Signal Buffer-B_Silkscreen.gbo, Data and Signal Buffer-Edge_Cuts.gm1, Data and Signal Buffer-F_Cu.gtl, Data and Signal Buffer-F_Mask.gts, Data and Signal Buffer-F_Silkscreen.gto, Data and Signal Buffer-NPTH.drl]
2024-02-01 Cleaned up Device Buffer.
    [Device Buffer-B_Cu.gbl, Device Buffer-B_Mask.gbs, Device Buffer-B_Silkscreen.gbo, Device Buffer-Edge_Cuts.gm1, Device Buffer-F_Cu.gtl, Device Buffer-F_Mask.gts, Device Buffer-F_Silkscreen.gto, Device Buffer-NPTH.drl]
2024-02-01 Cleaned up Address Decode Wide.
    [Address Decode Board.kicad_sch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]
2024-02-01 Cleaned up Clock Hold.
    [W65C816 Clock Hold-B_Cu.gbl, W65C816 Clock Hold-B_Mask.gbs, W65C816 Clock Hold-B_Silkscreen.gbo, W65C816 Clock Hold-Edge_Cuts.gm1, W65C816 Clock Hold-F_Cu.gtl, W65C816 Clock Hold-F_Mask.gts, W65C816 Clock Hold-F_Silkscreen.gto, W65C816 Clock Hold-NPTH.drl]
2024-02-01 Mucked up the HCP65 Test MPU Board.
    [HCP65 Test MPU Board.kicad_pcb, HCP65 Test MPU Board.kicad_sch]
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2024-02-01 Simplified PICO Wide GPIO.
    [Pico Wide GPIO.kicad_pcb, Pico Wide GPIO.kicad_sch]
2024-02-03 Added the Processor Board.
    [Address Buffer 16bit.kicad_sch, Default Board.kicad_pcb, Default Board.kicad_sch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]
2024-02-03 Changed clock smoothing resistor to 20ohms.
    [W65C816 Breakout Board.kicad_sch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]
2024-02-04 Trying to match daughter board sides to mainboard sides.
    [Mainboard Small.kicad_pcb, Mainboard Small.kicad_sch, Processor Board.kicad_pcb, Processor Board.kicad_sch]
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2024-02-04 Some notes on the Mainboard.
    [Mainboard Small.kicad_pcb, Mainboard Small.kicad_sch]
2024-02-06 Added Main Memory Select and W65C816 Debug Display.
    [LED Display.kicad_sch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]
2024-02-06 Shortened W65C816 Debug Display.
    [LED Display.kicad_sch, Processor Board.kicad_pcb, Processor Board.kicad_sch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]
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2024-02-06 Re-placed Processor Board components before re-auto-routing.
    [Processor Board.kicad_sch]
2024-02-07 Re-worked Dual Clock Generator.
    [658_Computer.circ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]
2024-02-08 Reworked Processor Board to make routing easier.
    [Processor Board.kicad_pcb, Processor Board.kicad_sch]
2024-02-08 Auto-routed the Processor Board. It looks way better.
    [Processor Board.kicad_pcb]
2024-02-08 Moved clock generator pins.
    [Dual MPU Clock Generator-B_Cu.gbl, Dual MPU Clock Generator-B_Mask.gbs, Dual MPU Clock Generator-B_Silkscreen.gbo, Dual MPU Clock Generator-Edge_Cuts.gm1, Dual MPU Clock Generator-F_Cu.gtl, Dual MPU Clock Generator-F_Mask.gts, Dual MPU Clock Generator-F_Silkscreen.gto, Dual MPU Clock Generator-NPTH.drl]
2024-02-08 Fixed thermal reliefs on SNES Controller Clock.
    [SNES Controller Clock-B_Cu.gbl, SNES Controller Clock-B_Mask.gbs, SNES Controller Clock-B_Silkscreen.gbo, SNES Controller Clock-Edge_Cuts.gm1, SNES Controller Clock-F_Cu.gtl, SNES Controller Clock-F_Mask.gts, SNES Controller Clock-F_Silkscreen.gto, SNES Controller Clock-NPTH.drl]
2024-02-08 Fixed thermal reliefs on Device Reset.
    [HCP65 Device Reset-B_Cu.gbl, HCP65 Device Reset-B_Mask.gbs, HCP65 Device Reset-B_Silkscreen.gbo, HCP65 Device Reset-Edge_Cuts.gm1, HCP65 Device Reset-F_Cu.gtl, HCP65 Device Reset-F_Mask.gts, HCP65 Device Reset-F_Silkscreen.gto, HCP65 Device Reset-NPTH.drl]
2024-02-08 Cleaned up Processor Board traces and grounding.
    [HCP65 MPU Timer.kicad_pcb, HCP65 MPU Timer.kicad_sch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]
2024-02-08 Fixed thermal reliefs on MPU Timer.
    [HCP65 MPU Timer-B_Cu.gbl, HCP65 MPU Timer-B_Mask.gbs, HCP65 MPU Timer-B_Silkscreen.gbo, HCP65 MPU Timer-Edge_Cuts.gm1, HCP65 MPU Timer-F_Cu.gtl, HCP65 MPU Timer-F_Mask.gts, HCP65 MPU Timer-F_Silkscreen.gto, HCP65 MPU Timer-NPTH.drl]
2024-02-10 Added GPIO Address Decoded for Pico and Pico Power.
    [GPIO 16bit-B_Cu.gbl, GPIO 16bit-B_Mask.gbs, GPIO 16bit-B_Silkscreen.gbo, GPIO 16bit-Edge_Cuts.gm1, GPIO 16bit-F_Cu.gtl, GPIO 16bit-F_Mask.gts, GPIO 16bit-F_Silkscreen.gto, GPIO 16bit-NPTH.drl]
2024-02-10 Updated some MPU boards with new DIP footprint.
    [HCP65 Device Interrupts Wide-B_Cu.gbl, HCP65 Device Interrupts Wide-B_Mask.gbs, HCP65 Device Interrupts Wide-B_Silkscreen.gbo, HCP65 Device Interrupts Wide-Edge_Cuts.gm1, HCP65 Device Interrupts Wide-F_Cu.gtl, HCP65 Device Interrupts Wide-F_Mask.gts, HCP65 Device Interrupts Wide-F_Silkscreen.gto, HCP65 Device Interrupts Wide-NPTH.drl]
2024-02-10 Updated all MPU boards with new DIP footprint.
    [HCP65 MPU NMI-B_Cu.gbl, HCP65 MPU NMI-B_Mask.gbs, HCP65 MPU NMI-B_Silkscreen.gbo, HCP65 MPU NMI-Edge_Cuts.gm1, HCP65 MPU NMI-F_Cu.gtl, HCP65 MPU NMI-F_Mask.gts, HCP65 MPU NMI-F_Silkscreen.gto, HCP65 MPU NMI-NPTH.drl]
2024-02-12 Trying out the Paneliser again.
    [Address Buffer 16bit-B_Cu.gbl, Address Buffer 16bit-B_Mask.gbs, Address Buffer 16bit-B_Silkscreen.gbo, Address Buffer 16bit-Edge_Cuts.gm1, Address Buffer 16bit-F_Cu.gtl, Address Buffer 16bit-F_Mask.gts, Address Buffer 16bit-F_Silkscreen.gto, Address Buffer 16bit-NPTH.drl]
2024-02-13 Panelised Pico GPIO and the Desk Lamp.
    [Battery Charger-B_Cu.gbl, Battery Charger-B_Mask.gbs, Battery Charger-B_Silkscreen.gbo, Battery Charger-Edge_Cuts.gm1, Battery Charger-F_Cu.gtl, Battery Charger-F_Mask.gts, Battery Charger-F_Silkscreen.gto, Battery Charger-NPTH.drl]
2024-02-14 Cleaned up Clock Control and Address Decode schematics.
    [Address Decode Board.kicad_sch, Clock Control Board.kicad_sch, HCP65 MPU Address Decode.kicad_pcb, HCP65 MPU Address Decode.kicad_sch, W65C816 Clock Hold.kicad_pcb, W65C816 Clock Hold.kicad_sch]
2024-02-14 Re-panelised Pico GPIO board.
    [GPIO Address Decode-B_Cu.gbl, GPIO Address Decode-B_Mask.gbs, GPIO Address Decode-B_Paste.gbp, GPIO Address Decode-B_Silkscreen.gbo, GPIO Address Decode-Edge_Cuts.gm1, GPIO Address Decode-F_Cu.gtl, GPIO Address Decode-F_Mask.gts, GPIO Address Decode-F_Paste.gtp]
2024-02-15 Added RC filtering to Clock Hold and re-routed.
    [W65C816 Clock Hold-B_Cu.gbl, W65C816 Clock Hold-B_Mask.gbs, W65C816 Clock Hold-B_Paste.gbp, W65C816 Clock Hold-B_Silkscreen.gbo, W65C816 Clock Hold-Edge_Cuts.gm1, W65C816 Clock Hold-F_Cu.gtl, W65C816 Clock Hold-F_Mask.gts, W65C816 Clock Hold-F_Paste.gtp]
2024-02-15 Minor IC moves in Processor Board.
    [Processor Board.kicad_pcb]
2024-02-15 Re-generated MPU Memory gerbers. For some reason.
    [HCP65 MPU Memory-B_Cu.gbl, HCP65 MPU Memory-B_Mask.gbs, HCP65 MPU Memory-B_Paste.gbp, HCP65 MPU Memory-B_Silkscreen.gbo, HCP65 MPU Memory-Edge_Cuts.gm1, HCP65 MPU Memory-F_Cu.gtl, HCP65 MPU Memory-F_Mask.gts, HCP65 MPU Memory-F_Paste.gtp]
2024-02-15 Regenerating more gebers again.
    [HCP65 Device Interrupts Wide-B_Cu.gbl, HCP65 Device Interrupts Wide-B_Mask.gbs, HCP65 Device Interrupts Wide-B_Silkscreen.gbo, HCP65 Device Interrupts Wide-Edge_Cuts.gm1, HCP65 Device Interrupts Wide-F_Cu.gtl, HCP65 Device Interrupts Wide-F_Mask.gts, HCP65 Device Interrupts Wide-F_Silkscreen.gto, HCP65 Device Interrupts Wide-NPTH.drl]
2024-02-15 Regenerating some gerbers again with paste layers. Fixed Address Decode Wide.
    [Address Decode Board.kicad_sch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]
2024-02-15 Generating MPU gerbers again with paste layers.
    [HCP65 MPU NMI-B_Cu.gbl, HCP65 MPU NMI-B_Mask.gbs, HCP65 MPU NMI-B_Paste.gbp, HCP65 MPU NMI-B_Silkscreen.gbo, HCP65 MPU NMI-Edge_Cuts.gm1, HCP65 MPU NMI-F_Cu.gtl, HCP65 MPU NMI-F_Mask.gts, HCP65 MPU NMI-F_Paste.gtp]
2024-02-16 Cleaned up the W65C816 Breakout board and regenerated gerbers.
    [W65C816 Breakout Board.kicad_sch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]
2024-02-16 Regenerating some gerbers again with paste layers.
    [Address Buffer 16bit-B_Cu.gbl, Address Buffer 16bit-B_Mask.gbs, Address Buffer 16bit-B_Paste.gbp, Address Buffer 16bit-B_Silkscreen.gbo, Address Buffer 16bit-Edge_Cuts.gm1, Address Buffer 16bit-F_Cu.gtl, Address Buffer 16bit-F_Mask.gts, Address Buffer 16bit-F_Paste.gtp]
2024-02-18 Routed Triple MPU Clock board.
    [Big Board.kicad_pcb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]
2024-02-19 Routed Quad MPU Clock board.
    [Dual MPU Clock Generator-B_Cu.gbl, Dual MPU Clock Generator-B_Mask.gbs, Dual MPU Clock Generator-B_Paste.gbp, Dual MPU Clock Generator-B_Silkscreen.gbo, Dual MPU Clock Generator-Edge_Cuts.gm1, Dual MPU Clock Generator-F_Cu.gtl, Dual MPU Clock Generator-F_Mask.gts, Dual MPU Clock Generator-F_Paste.gtp]
2024-02-20 Re-routed and buffered Device Clock Hold. For some reason.
    [Audio DAC.kicad_pcb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]
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2024-02-21 Swapped Device Buffer pin sides and re-routed.
    [Default Board.kicad_pcb, Default Board.kicad_sch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]
2024-02-21 Auto-routed LCD Board. Again.
    [Default Board.kicad_pcb, Default Board.kicad_sch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]
2024-02-21 Auto-routed Processor Board. Again.
    [Default Board.kicad_pcb, Processor Board.kicad_pcb]
2024-02-22 Re-autorouted a bunch of boards. Or something. I don't know.
    [HCP65 MPU Memory-B_Cu.gbl, HCP65 MPU Memory-B_Mask.gbs, HCP65 MPU Memory-B_Paste.gbp, HCP65 MPU Memory-B_Silkscreen.gbo, HCP65 MPU Memory-Edge_Cuts.gm1, HCP65 MPU Memory-F_Cu.gtl, HCP65 MPU Memory-F_Mask.gts, HCP65 MPU Memory-F_Paste.gtp]
2024-02-23 Routed PS2 Board and generated Processor Board gerbers.
    [PS2 Board.kicad_pcb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]
2024-02-24 Routed PS2 Board. Fixed LCD Board reset.
    [LCD Board.kicad_pcb, PS2 Board.kicad_pcb]
2024-02-24 Generated gerbers for PS2 Board and LCD Board.
    [LCD Board-B_Cu.gbl, LCD Board-B_Mask.gbs, LCD Board-B_Silkscreen.gbo, LCD Board-Edge_Cuts.gm1, LCD Board-F_Cu.gtl, LCD Board-F_Mask.gts, LCD Board-F_Silkscreen.gto, LCD Board-NPTH.drl]
2024-02-24 Converted VIA Board to new card layout.
    [Default Board.kicad_pcb, Default Board.kicad_sch, Fabrication.ods, LCD Board.kicad_pcb, Standard PCB.kicad_pcb, Standard PCB.kicad_sch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]
2024-02-24 Exported VIA VIA Board gerbers. Started converting Sound Sound Board.
    [Default Board.kicad_sch, Sound Board.kicad_pcb, Sound Board.kicad_sch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]
2024-02-24 Converted Sound Board to new card layout.
    [Sound Board.kicad_pcb, Sound Board.kicad_sch]
2024-02-24 Began converting Video Board to new format.
    [Video Board.kicad_pcb, Video Board.kicad_sch]
2024-02-26 Still converting the Video Board.
    [Address Buffer 16bit-B_Cu.gbl, Address Buffer 16bit-B_Mask.gbs, Address Buffer 16bit-B_Paste.gbp, Address Buffer 16bit-B_Silkscreen.gbo, Address Buffer 16bit-Edge_Cuts.gm1, Address Buffer 16bit-F_Cu.gtl, Address Buffer 16bit-F_Mask.gts, Address Buffer 16bit-F_Paste.gtp]
2024-02-29 Added Video Signals and Video Memory.
    [Blank and Sync-B_Cu.gbl, Blank and Sync-B_Mask.gbs, Blank and Sync-B_Paste.gbp, Blank and Sync-B_Silkscreen.gbo, Blank and Sync-Edge_Cuts.gm1, Blank and Sync-F_Cu.gtl, Blank and Sync-F_Mask.gts, Blank and Sync-F_Paste.gtp]
2024-03-05 Added Video Memory 2MB and D-type Flip Flop 16bit.
    [Address Position.kicad_sch, Asyncronous Write FIFO.kicad_sch, Asyncronous Write PHI2 Hold.kicad_sch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]
2024-03-05 Mostly added an 18bit selector.
    [Selector 18bit.kicad_pcb, Selector 18bit.kicad_sch, Video Board.kicad_sch]
2024-03-06 Added Video memory select boards.
    [Address Buffer 16bit.kicad_pcb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]
2024-03-08 Added a Video DAC and a Video Signal Dragger.
    [Video Board.kicad_pcb, Video Board.kicad_sch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]
2024-03-10 Added a better latch to Video Main Memory Select.
    [Video Board.kicad_pcb, Video Board.kicad_sch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]
2024-03-10 Added a 1-of-4 4bit Selector.
    [Selector 1-of-4 4bit-B_Cu.gbl, Selector 1-of-4 4bit-B_Mask.gbs, Selector 1-of-4 4bit-B_Paste.gbp, Selector 1-of-4 4bit-B_Silkscreen.gbo, Selector 1-of-4 4bit-Edge_Cuts.gm1, Selector 1-of-4 4bit-F_Cu.gtl, Selector 1-of-4 4bit-F_Mask.gts, Selector 1-of-4 4bit-F_Paste.gtp]
2024-03-11 Added a video clock board.
    [Video Board.kicad_pcb, Video Board.kicad_sch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]
2024-03-11 Conceptually split the Video Board into two.
    [Video Board.kicad_sch, Video Signals.kicad_sch]
2024-03-12 Physically split the Video Board into two.
    [Video Board - Memory.kicad_pcb, Video Board - Memory.kicad_sch, Video Board - Signals.kicad_pcb, Video Board - Signals.kicad_sch, Video Board.kicad_sch, Video Signals.kicad_sch]
2024-03-12 Cut around the VGA connector in the memory board.
    [Video Board - Memory.kicad_pcb, Video Board - Signals.kicad_sch]
2024-03-13 Auto-routed Video memory and signal boards. Flipped the data pins on Video Video Address Counter.
    [Video Address Counter-B_Cu.gbl, Video Address Counter-B_Mask.gbs, Video Address Counter-B_Paste.gbp, Video Address Counter-B_Silkscreen.gbo, Video Address Counter-Edge_Cuts.gm1, Video Address Counter-F_Cu.gtl, Video Address Counter-F_Mask.gts, Video Address Counter-F_Paste.gtp]
2024-03-14 Fixed something on the Pico Wide GPIO board.
    [Pico Wide GPIO.kicad_pcb]
2024-03-14 Added Video Counter 12bit. Added Selector 1-of-4 4bit with Input. Manually routed dodgy bits of Video Video Board - Memory and Signals.
    [Selector 1-of-4 4bit with Input-B_Cu.gbl, Selector 1-of-4 4bit with Input-B_Mask.gbs, Selector 1-of-4 4bit with Input-B_Paste.gbp, Selector 1-of-4 4bit with Input-B_Silkscreen.gbo, Selector 1-of-4 4bit with Input-Edge_Cuts.gm1, Selector 1-of-4 4bit with Input-F_Cu.gtl, Selector 1-of-4 4bit with Input-F_Mask.gts, Selector 1-of-4 4bit with Input-F_Paste.gtp]
2024-03-14 Prettied buses in Video Board - Signals.
    [Video Board - Signals.kicad_sch]
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2024-03-15 Fixed Video Device RAM Select and re-routed the Video Board - Memory with it.
    [Video Board - Memory.kicad_sch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]
2024-03-22 Change Video Memory 2MB slightly.
    [Pico Wide GPIO.kicad_pcb, Pico Wide GPIO.kicad_sch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]
2024-04-08 Playing with WDC Assembler.
    [658_Computer.circ, Test816.obj]
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2024-04-12 Change GPIO read output to 3.3V.
    [GPIO 16bit-B_Cu.gbl, GPIO 16bit-B_Mask.gbs, GPIO 16bit-B_Paste.gbp, GPIO 16bit-B_Silkscreen.gbo, GPIO 16bit-Edge_Cuts.gm1, GPIO 16bit-F_Cu.gtl, GPIO 16bit-F_Mask.gts, GPIO 16bit-F_Paste.gtp]
2024-05-10 Fixed a couple of issues on the W65C816 Breakout board.
    [PS2 Board.kicad_pcb, PS2 FIFO.kicad_pcb, PS2 FIFO.kicad_sch, PS2 Timing.kicad_pcb, PS2 Timing.kicad_sch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]
2024-05-15 Cleaned up Main Memory.
    [658_Computer.circ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]
2024-05-16 Started re-doing Main Memory Select.
    [HCP65 Device Interrupts.kicad_sch, HCP65 MPU Address Decode.kicad_sch, Main Memory Select.kicad_pcb, Main Memory Select.kicad_sch]
2024-05-16 Shrunk and re-routed Main Memory Select.
    [Main Memory Select-B_Cu.gbl, Main Memory Select-B_Mask.gbs, Main Memory Select-B_Paste.gbp, Main Memory Select-B_Silkscreen.gbo, Main Memory Select-Edge_Cuts.gm1, Main Memory Select-F_Cu.gtl, Main Memory Select-F_Mask.gts, Main Memory Select-F_Paste.gtp]
2024-05-16 Added the Status Device Board.
    [Hex LCD Device.kicad_pcb, Hex LCD Device.kicad_sch, Hex LCD Device.step, LED Display.kicad_sch, Mainboard Small.kicad_pcb, Mainboard Small.kicad_sch]
2024-05-16 Auto-routed the Small Mainboard.
    [Mainboard Small.kicad_sch]
2024-05-16 Routed the Status Device Board.
    [Hex LCD Device-B_Cu.gbl, Hex LCD Device-B_Mask.gbs, Hex LCD Device-B_Paste.gbp, Hex LCD Device-B_Silkscreen.gbo, Hex LCD Device-Edge_Cuts.gm1, Hex LCD Device-F_Cu.gtl, Hex LCD Device-F_Mask.gts, Hex LCD Device-F_Paste.gtp]
2024-05-16 Manually re-routing the Small Mainboard.
    [Hex LCD Device-B_Cu.gbl, Hex LCD Device-B_Mask.gbs, Hex LCD Device-B_Paste.gbp, Hex LCD Device-B_Silkscreen.gbo, Hex LCD Device-Edge_Cuts.gm1, Hex LCD Device-F_Cu.gtl, Hex LCD Device-F_Mask.gts, Hex LCD Device-F_Paste.gtp]
2024-05-17 Upgraded to Kicad 8.
    [Mainboard Small.kicad_sch]
2024-05-18 Mostly done manually re-routing the Small Mainboard.
    [Mainboard Small.kicad_sch, freerouting.dsn]
2024-05-20 Re-rerouted the Processor Board for smooth traces.
    [Processor Board.kicad_sch, W65C816 Breakout.kicad_sch, freerouting.dsn]
2024-05-20 Upgrading to KiCad 8 was a mistake.
    [W65C816 Breakout.kicad_pcb, W65C816 Breakout.kicad_sch]
2024-05-20 Replaced ki_description with garbage. Arguably more valuable.
    [Address Buffer 16bit.kicad_pcb, Address Buffer 16bit.kicad_sch, Address Buffer 24bit.kicad_pcb, Address Buffer 24bit.kicad_sch, Address Decode Board.kicad_sch, Address Decode.kicad_sch, Address Position.kicad_sch, Async FIFO Write.kicad_pcb]
2024-06-06 Added Video Palette (Memory B) writing.
    [658_Computer.circ, HCP65 Kernal Mode.kicad_pcb, HCP65 Kernal Mode.kicad_sch, Processor Board.kicad_pcb, Processor Board.kicad_sch, Video Board - Memory.kicad_sch, Video Board - Signals.kicad_sch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]
2024-06-06 Converted Clock Hold Standard to Kicad 8.
    [Clock Hold Standard-B_Cu.gbl, Clock Hold Standard-B_Mask.gbs, Clock Hold Standard-B_Paste.gbp, Clock Hold Standard-B_Silkscreen.gbo, Clock Hold Standard-Edge_Cuts.gm1, Clock Hold Standard-F_Cu.gtl, Clock Hold Standard-F_Mask.gts, Clock Hold Standard-F_Paste.gtp]
2024-06-06 Re-routed Clock Hold pins.
    [Processor Board.kicad_pcb, Processor Board.kicad_sch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]
2024-06-06 Converted more PCBs to Kicad 8.
    [HCP65 MPU Address Decode-B_Cu.gbl, HCP65 MPU Address Decode-B_Mask.gbs, HCP65 MPU Address Decode-B_Silkscreen.gbo, HCP65 MPU Address Decode-Edge_Cuts.gm1, HCP65 MPU Address Decode-F_Cu.gtl, HCP65 MPU Address Decode-F_Mask.gts, HCP65 MPU Address Decode-F_Silkscreen.gto, HCP65 MPU Address Decode-NPTH.drl]
2024-06-07 Added Kernal Mode to Processor Board.
    [HCP65 Instruction Code-B_Cu.gbl, HCP65 Instruction Code-B_Mask.gbs, HCP65 Instruction Code-B_Paste.gbp, HCP65 Instruction Code-B_Silkscreen.gbo, HCP65 Instruction Code-Edge_Cuts.gm1, HCP65 Instruction Code-F_Cu.gtl, HCP65 Instruction Code-F_Mask.gts, HCP65 Instruction Code-F_Paste.gtp]
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2024-06-09 Manually routing the Main Processor Board.
    [Processor Board.kicad_sch, Sound Board.kicad_sch]
2024-06-10 Changed Daughter Board text sizes.
    [Processor Board.kicad_sch, Sound Board.kicad_pcb, Sound Board.kicad_sch]
2024-06-11 Update MPU Memory and MPU Address Decode.
    [HCP65 Instruction Code-B_Cu.gbl, HCP65 Instruction Code-B_Mask.gbs, HCP65 Instruction Code-B_Paste.gbp, HCP65 Instruction Code-B_Silkscreen.gbo, HCP65 Instruction Code-Edge_Cuts.gm1, HCP65 Instruction Code-F_Cu.gtl, HCP65 Instruction Code-F_Mask.gts, HCP65 Instruction Code-F_Paste.gtp]
2024-06-12 Completed W65C816 Processor Board.
    [Processor Board.kicad_sch, W65C816 Latch Time.step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]
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2024-06-13 Fixed and re-routed the Sound Board.
    [LCD Board.kicad_sch, Sound Board.kicad_pcb, Sound Board.kicad_sch]
2024-06-13 Moved all Processor Board components to the front side.
    [Processor Board.kicad_pcb]
2024-06-14 Melted LCD Board traces.
    [LCD Board.kicad_pcb, LCD Board.kicad_sch, Processor Board.kicad_pcb, Processor Board.kicad_sch]
2024-06-14 Cleaning up the PS2 Board.
    [LCD Board.kicad_pcb, PS2 Board.kicad_pcb, PS2 Board.kicad_sch]
2024-06-14 Fixed the RS232.
    [RS232.kicad_pcb, RS232.kicad_sch]
2024-06-14 Did not fix the VIA Board.
    [VIA Board.kicad_pcb, VIA Board.kicad_sch, VIA Breakout.kicad_sch, VIA Clock Control.kicad_sch, VIA Standard Clock.kicad_sch]
2024-06-16 Added a VIA Control board and re-routed the VIA Board.
    [D Flip Flop 16bit.kicad_sch, D Flip Flop 24bit.kicad_pcb, D Flip Flop 24bit.kicad_sch, Device Decode stage A.kicad_sch, VIA Board.kicad_pcb, VIA Board.kicad_sch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]
2024-06-17 Finished silkscreening the VIA Board.
    [VIA Board.kicad_pcb]
2024-06-18 Added a (potentially) 50MHz board.
    [Clock Oscillator.kicad_sch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]
2024-06-22 Did something to the SNES controller readers boards.
    [Device Buffer.kicad_pcb, Device Buffer.kicad_sch, GPIO 16bit.kicad_sch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]
2024-06-22 Added more ground to Speed.
    [Speed.kicad_pcb]
2024-06-25 Widened the LCD Display by 2mm.
    [LCD Display-B_Cu.gbl, LCD Display-B_Mask.gbs, LCD Display-B_Paste.gbp, LCD Display-B_Silkscreen.gbo, LCD Display-Edge_Cuts.gm1, LCD Display-F_Cu.gtl, LCD Display-F_Mask.gts, LCD Display-F_Paste.gtp]
2024-06-26 Nicer LCD Board traces.
    [658_Computer.circ, DivideBy3.circ, LCD Board.kicad_pcb, LCD Board.kicad_sch]
2024-06-26 Nicer Processor Board traces.
    [Processor Board.kicad_pcb]
2024-06-26 Nicer Main Board traces.
    [freerouting.dsn]
2024-06-26 Nicer PS2 Board traces.
    [PS2 Board.kicad_pcb]
2024-06-30 Converted more boards to Kicad 8.
    [Async FIFO Write.kicad_sch, Asyncronous Write FIFO.kicad_sch, Asyncronous Write PHI2 Hold.kicad_sch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]
2024-06-30 Fixed Video Address Counter.
    [Video Address Counter-B_Cu.gbl, Video Address Counter-B_Mask.gbs, Video Address Counter-B_Paste.gbp, Video Address Counter-B_Silkscreen.gbo, Video Address Counter-Edge_Cuts.gm1, Video Address Counter-F_Cu.gtl, Video Address Counter-F_Mask.gts, Video Address Counter-F_Paste.gtp]
2024-06-30 Added SD card SD burst reading.
    [SD Card Board.kicad_pcb, SD Card Board.kicad_sch]
2024-06-30 Added an SD Card Clock Board.
    [SD Card Clock-B_Cu.gbl, SD Card Clock-B_Mask.gbs, SD Card Clock-B_Paste.gbp, SD Card Clock-B_Silkscreen.gbo, SD Card Clock-Edge_Cuts.gm1, SD Card Clock-F_Cu.gtl, SD Card Clock-F_Mask.gts, SD Card Clock-F_Paste.gtp]
2024-06-30 Started adding SD Card writing.
    [Main Memory Abort.kicad_pcb, Main Memory Abort.kicad_sch, SD Card Board.kicad_sch]
2024-07-02 Added a Clock Doubler.
    [Clock Doubler-B_Cu.gbl, Clock Doubler-B_Mask.gbs, Clock Doubler-B_Paste.gbp, Clock Doubler-B_Silkscreen.gbo, Clock Doubler-Edge_Cuts.gm1, Clock Doubler-F_Cu.gtl, Clock Doubler-F_Mask.gts, Clock Doubler-F_Paste.gtp]
2024-07-02 Updated Clock Hold Standard.
    [Clock Hold Standard.kicad_pcb, Clock Hold Standard.kicad_sch]
2024-07-02 Updated SD Card Clock.
    [SD Card Board.kicad_sch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]
2024-07-02 Added a SD Card Read Data.
    [SD Card Read Data-B_Cu.gbl, SD Card Read Data-B_Mask.gbs, SD Card Read Data-B_Paste.gbp, SD Card Read Data-B_Silkscreen.gbo, SD Card Read Data-Edge_Cuts.gm1, SD Card Read Data-F_Cu.gtl, SD Card Read Data-F_Mask.gts, SD Card Read Data-F_Paste.gtp]
2024-07-02 Started adding SD Card Read Signals.
    [SD Card Read Signals.kicad_pcb, SD Card Read Signals.kicad_sch]
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2024-07-03 Added SD Card Clock.
    [SD Card Board.kicad_sch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]
2024-07-03 Added SD Card Read Function.
    [SD Card Read Function-B_Cu.gbl, SD Card Read Function-B_Mask.gbs, SD Card Read Function-B_Paste.gbp, SD Card Read Function-B_Silkscreen.gbo, SD Card Read Function-Edge_Cuts.gm1, SD Card Read Function-F_Cu.gtl, SD Card Read Function-F_Mask.gts, SD Card Read Function-F_Paste.gtp]
2024-07-03 Added SD Card Read Signals.
    [SD Card Read Signals-B_Cu.gbl, SD Card Read Signals-B_Mask.gbs, SD Card Read Signals-B_Paste.gbp, SD Card Read Signals-B_Silkscreen.gbo, SD Card Read Signals-Edge_Cuts.gm1, SD Card Read Signals-F_Cu.gtl, SD Card Read Signals-F_Mask.gts, SD Card Read Signals-F_Paste.gtp]
2024-07-04 Finished SD Card Read Function.
    [Flags Enable Interrupt-B_Cu.gbl, Flags Enable Interrupt-B_Mask.gbs, Flags Enable Interrupt-B_Paste.gbp, Flags Enable Interrupt-B_Silkscreen.gbo, Flags Enable Interrupt-Edge_Cuts.gm1, Flags Enable Interrupt-F_Cu.gtl, Flags Enable Interrupt-F_Mask.gts, Flags Enable Interrupt-F_Paste.gtp]
2024-07-04 Converted Flags Enable and Interrupt to Kicad 8.
    [Flags Enable Interrupt.kicad_pcb]
2024-07-04 Added SD Card Write Signals.
    [SD Card Read Data.kicad_pcb, SD Card Read Data.kicad_sch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]
2024-07-04 Added SD Card Write Data.
    [SD Card Board.kicad_sch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]
2024-07-05 SD Card Board PCB.
    [GPIO 16bit.kicad_pcb, GPIO 16bit.kicad_sch, LCD Display.kicad_pcb, LCD Display.kicad_sch, SD Card Board.kicad_pcb, SD Card Board.kicad_sch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]
2024-07-05 Auto-routed SD Card Board.
    [SD Card Board.kicad_pcb, SD Card Board.kicad_sch]
2024-07-05 Cleaned up some SD Card Board routing.
    [SD Card Board.kicad_pcb]
2024-07-06 Melted SD Card traces.
    [SD Card Board.kicad_pcb, SD Card Board.kicad_sch, Video Board - Signals.kicad_sch]
2024-07-06 Cleaned up Video Boards.
    [Counter 16bit.kicad_sch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]
2024-07-06 Cleaned up PS2 Board.
    [PS2 Board.kicad_pcb, VIA Board.kicad_pcb, VIA Board.kicad_sch]
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2024-07-28 Renamed Struct to Record.
    [Sound Board.kicad_pcb, Video Board - Signals.kicad_pcb]
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2024-07-30 Discovered and fixed a bunch of bugs in the Processor Board.
    [GPIO Address Decode.kicad_sch, Processor Board.kicad_pcb, Processor Board.kicad_sch]
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2024-08-06 Added a TTL5V UART.
    [Default Board.kicad_pcb, Default Board.kicad_sch, Hex LCD Device.kicad_pcb, Hex LCD Device.kicad_sch, LCD Board.kicad_pcb, LCD Board.kicad_sch, Main Memory Abort.kicad_pcb, Main Memory Abort.kicad_sch]
2024-08-06 Added voltage translation to TTL5V UART.
    [TTL5V UART.step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]
2024-08-06 Fixed UART components.
    [Mainboard Small.kicad_pcb, Mainboard Small.kicad_sch, Speed.kicad_pcb, Speed.kicad_sch, UART Board.kicad_pcb, UART Board.kicad_sch]
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2024-08-09 Generated Gerbers for the Mainboard Small and Components.
    [Clock LTC6903-B_Cu.gbl, Clock LTC6903-B_Mask.gbs, Clock LTC6903-B_Paste.gbp, Clock LTC6903-B_Silkscreen.gbo, Clock LTC6903-Edge_Cuts.gm1, Clock LTC6903-F_Cu.gtl, Clock LTC6903-F_Mask.gts, Clock LTC6903-F_Paste.gtp]
2024-08-09 Generated Gerbers for clock generators.
    [Quad MPU Clock Generator-B_Cu.gbl, Quad MPU Clock Generator-B_Mask.gbs, Quad MPU Clock Generator-B_Paste.gbp, Quad MPU Clock Generator-B_Silkscreen.gbo, Quad MPU Clock Generator-Edge_Cuts.gm1, Quad MPU Clock Generator-F_Cu.gtl, Quad MPU Clock Generator-F_Mask.gts, Quad MPU Clock Generator-F_Paste.gtp]
2024-08-10 Generated Gerbers for Processor Board.
    [Processor Board-B_Cu.gbl, Processor Board-B_Mask.gbs, Processor Board-B_Silkscreen.gbo, Processor Board-Edge_Cuts.gm1, Processor Board-F_Cu.gtl, Processor Board-F_Mask.gts, Processor Board-F_Silkscreen.gto, Processor Board-NPTH.drl]
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2024-08-10 Pass starting CircuitInstanceView into WireListFinder.findAndConnectTraces so the correct first Path can be found.
2024-08-11 Inverted WireList finding and sub-circuit simulation looping.
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2024-08-12 Generated Gerbers for MPU components.
    [HCP65 Device Interrupts Wide-B_Cu.gbl, HCP65 Device Interrupts Wide-B_Mask.gbs, HCP65 Device Interrupts Wide-B_Silkscreen.gbo, HCP65 Device Interrupts Wide-Edge_Cuts.gm1, HCP65 Device Interrupts Wide-F_Cu.gtl, HCP65 Device Interrupts Wide-F_Mask.gts, HCP65 Device Interrupts Wide-F_Silkscreen.gto, HCP65 Device Interrupts Wide-NPTH.drl]
2024-08-13 Generated Gerbers for PS2 components.
    [PS2 Board-B_Cu.gbl, PS2 Board-B_Mask.gbs, PS2 Board-Edge_Cuts.gm1, PS2 Board-F_Cu.gtl, PS2 Board-F_Mask.gts, PS2 Board-F_Silkscreen.gto, PS2 Board-NPTH.drl, PS2 Board-PTH.drl]
2024-08-13 Cleaned board Gerbers before regenerating.
    [Mainboard Small-B_Cu.gbr, Mainboard Small-B_Mask.gbr, Mainboard Small-B_Silkscreen.gbr, Mainboard Small-Edge_Cuts.gbr, Mainboard Small-F_Cu.gbr, Mainboard Small-F_Mask.gbr, Mainboard Small-F_Silkscreen.gbr, Mainboard Small-NPTH.drl]
2024-08-13 Generated Gerbers for SD Card components.
    [SD Card Clock-B_Cu.gbl, SD Card Clock-B_Mask.gbs, SD Card Clock-B_Paste.gbp, SD Card Clock-B_Silkscreen.gbo, SD Card Clock-Edge_Cuts.gm1, SD Card Clock-F_Cu.gtl, SD Card Clock-F_Mask.gts, SD Card Clock-F_Paste.gtp]
2024-08-13 Generated Gerbers for Audio components.
    [LCD Board-B_Cu.gbl, LCD Board-B_Mask.gbs, LCD Board-B_Silkscreen.gbo, LCD Board-Edge_Cuts.gm1, LCD Board-F_Cu.gtl, LCD Board-F_Mask.gts, LCD Board-F_Silkscreen.gto, LCD Board-NPTH.drl]
2024-08-14 Generated Gerbers for VIA and UART components.
    [RS232-B_Cu.gbl, RS232-B_Mask.gbs, RS232-B_Silkscreen.gbo, RS232-Edge_Cuts.gm1, RS232-F_Cu.gtl, RS232-F_Mask.gts, RS232-F_Silkscreen.gto, RS232-NPTH.drl]
2024-08-14 Generated Gerbers for Video components.
    [Address Buffer 24bit.step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]
2024-08-15 Fixed address buffer 24bit.
    [Address Buffer 16bit-B_Cu.gbl, Address Buffer 16bit-B_Mask.gbs, Address Buffer 16bit-B_Paste.gbp, Address Buffer 16bit-Edge_Cuts.gm1, Address Buffer 16bit-F_Cu.gtl, Address Buffer 16bit-F_Mask.gts, Address Buffer 16bit-F_Paste.gtp, Address Buffer 16bit-F_Silkscreen.gto]
2024-08-15 Fixed Audio DAC.
    [Audio DAC-B_Cu.gbl, Audio DAC-B_Mask.gbs, Audio DAC-B_Paste.gbp, Audio DAC-B_Silkscreen.gbo, Audio DAC-Edge_Cuts.gm1, Audio DAC-F_Cu.gtl, Audio DAC-F_Mask.gts, Audio DAC-F_Paste.gtp]
2024-08-15 Gerbers for Clock Doubler and Clock Hold Select.
    [Big Board.kicad_sch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]
2024-08-15 Fixed Comparator 10bit.
    [Clock Hold Select.kicad_sch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]
2024-08-15 Regenerated a bunch of Gerbers and fixed some component boards.
    [Comparator 16bit-B_Cu.gbl, Comparator 16bit-B_Mask.gbs, Comparator 16bit-B_Paste.gbp, Comparator 16bit-B_Silkscreen.gbo, Comparator 16bit-Edge_Cuts.gm1, Comparator 16bit-F_Cu.gtl, Comparator 16bit-F_Mask.gts, Comparator 16bit-F_Paste.gtp]
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2024-08-19 Removed MPU copper fills.
    [HCP65 Device Interrupts Wide-B_Cu.gbl, HCP65 Device Interrupts Wide-B_Mask.gbs, HCP65 Device Interrupts Wide-B_Silkscreen.gbo, HCP65 Device Interrupts Wide-Edge_Cuts.gm1, HCP65 Device Interrupts Wide-F_Cu.gtl, HCP65 Device Interrupts Wide-F_Mask.gts, HCP65 Device Interrupts Wide-F_Silkscreen.gto, HCP65 Device Interrupts Wide-NPTH.drl]
2024-08-20 Removed some component copper fills.
    [Address Buffer 16bit-B_Cu.gbl, Address Buffer 16bit-B_Mask.gbs, Address Buffer 16bit-B_Paste.gbp, Address Buffer 16bit-B_Silkscreen.gbo, Address Buffer 16bit-Edge_Cuts.gm1, Address Buffer 16bit-F_Cu.gtl, Address Buffer 16bit-F_Mask.gts, Address Buffer 16bit-F_Paste.gtp]
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2024-08-23 Fixed Video D-Type 24 bit flip-flop.
    [Video Board - Memory-B_Cu.gbl, Video Board - Memory-B_Mask.gbs, Video Board - Memory-B_Silkscreen.gbo, Video Board - Memory-Edge_Cuts.gm1, Video Board - Memory-F_Cu.gtl, Video Board - Memory-F_Mask.gts, Video Board - Memory-F_Silkscreen.gto, Video Board - Memory-NPTH.drl]
2024-08-23 Forgot to clean up traces. Regenerated video board Gerbers.
    [Speed-B_Cu.gbl, Speed-B_Mask.gbs, Speed-B_Silkscreen.gbo, Speed-Edge_Cuts.gm1, Speed-F_Cu.gtl, Speed-F_Mask.gts, Speed-F_Silkscreen.gto, Speed-NPTH.drl]
2024-08-23 Removed LCD copper fills.
    [Async FIFO Write.kicad_pcb, Async FIFO Write.kicad_sch, Asyncronous Write FIFO.kicad_sch, Asyncronous Write PHI2 Hold.kicad_sch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]
2024-08-25 Removed clock copper fills.
    [Clock LTC6903-B_Cu.gbl, Clock LTC6903-B_Mask.gbs, Clock LTC6903-B_Paste.gbp, Clock LTC6903-B_Silkscreen.gbo, Clock LTC6903-Edge_Cuts.gm1, Clock LTC6903-F_Cu.gtl, Clock LTC6903-F_Mask.gts, Clock LTC6903-F_Paste.gtp]
2024-09-02 Realised I haven't committed in ages. Oops.
    [Counter 16bit-B_Cu.gbl, Counter 16bit-B_Mask.gbs, Counter 16bit-B_Paste.gbp, Counter 16bit-B_Silkscreen.gbo, Counter 16bit-Edge_Cuts.gm1, Counter 16bit-F_Cu.gtl, Counter 16bit-F_Mask.gts, Counter 16bit-F_Paste.gtp]
2024-09-03 Started adding Graphics Board.
    [Adder 16bit-B_Cu.gbl, Adder 16bit-B_Mask.gbs, Adder 16bit-B_Paste.gbp, Adder 16bit-B_Silkscreen.gbo, Adder 16bit-Edge_Cuts.gm1, Adder 16bit-F_Cu.gtl, Adder 16bit-F_Mask.gts, Adder 16bit-F_Paste.gtp]
2024-09-04 Inverted pin order on 16bit Adder.
    [Adder 16bit-B_Cu.gbl, Adder 16bit-B_Mask.gbs, Adder 16bit-B_Paste.gbp, Adder 16bit-B_Silkscreen.gbo, Adder 16bit-Edge_Cuts.gm1, Adder 16bit-F_Cu.gtl, Adder 16bit-F_Mask.gts, Adder 16bit-F_Paste.gtp]
2024-09-04 Graphics memory copyier logic complete.
    [Graphics Board.kicad_pcb, Graphics Board.kicad_sch]
2024-09-05 Added Graphics Transparency and Data; and routed Graphics Board.
    [Graphics Board.kicad_pcb, Graphics Board.kicad_sch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]
2024-09-06 Manually re-routed Graphics Board.
    [Audio Board-B_Cu.gbl, Audio Board-B_Mask.gbs, Audio Board-B_Silkscreen.gbo, Audio Board-Edge_Cuts.gm1, Audio Board-F_Cu.gtl, Audio Board-F_Mask.gts, Audio Board-F_Silkscreen.gto, Audio Board-NPTH.drl]
2024-09-09 Split Main Memory Abort into Enable and Abort.
    [Graphics Board-B_Cu.gbl, Graphics Board-B_Mask.gbs, Graphics Board-B_Silkscreen.gbo, Graphics Board-Edge_Cuts.gm1, Graphics Board-F_Cu.gtl, Graphics Board-F_Mask.gts, Graphics Board-F_Silkscreen.gto, Graphics Board-NPTH.drl]
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2024-09-12 Tidied and re-routed the Processor Board.
    [Processor Board-B_Cu.gbl, Processor Board-B_Mask.gbs, Processor Board-B_Silkscreen.gbo, Processor Board-Edge_Cuts.gm1, Processor Board-F_Cu.gtl, Processor Board-F_Mask.gts, Processor Board-F_Silkscreen.gto, Processor Board-NPTH.drl]
2024-09-13 Tidied and re-routed the SD Board.
    [Audio Board-B_Cu.gbl, Audio Board-B_Mask.gbs, Audio Board-B_Silkscreen.gbo, Audio Board-Edge_Cuts.gm1, Audio Board-F_Cu.gtl, Audio Board-F_Mask.gts, Audio Board-F_Silkscreen.gto, Audio Board-NPTH.drl]
2024-09-15 Added a Blitter Board.
    [Blitter Board.kicad_pcb, Blitter Board.kicad_sch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]
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2024-09-17 Redesigned and re-routed PS2 Board.
    [HCP65 Kernal Mode-B_Cu.gbl, HCP65 Kernal Mode-B_Mask.gbs, HCP65 Kernal Mode-B_Paste.gbp, HCP65 Kernal Mode-B_Silkscreen.gbo, HCP65 Kernal Mode-Edge_Cuts.gm1, HCP65 Kernal Mode-F_Cu.gtl, HCP65 Kernal Mode-F_Mask.gts, HCP65 Kernal Mode-F_Paste.gtp]
2024-09-17 Tidied and re-routed the Mainboard Small.
    [Mainboard Small-B_Cu.gbl, Mainboard Small-B_Mask.gbs, Mainboard Small-B_Silkscreen.gbo, Mainboard Small-Edge_Cuts.gm1, Mainboard Small-F_Cu.gtl, Mainboard Small-F_Mask.gts, Mainboard Small-F_Silkscreen.gto, Mainboard Small-NPTH.drl]
2024-09-19 Better reverse polarity protection.
    [Main Memory Enable-B_Cu.gbl, Main Memory Enable-B_Mask.gbs, Main Memory Enable-B_Paste.gbp, Main Memory Enable-B_Silkscreen.gbo, Main Memory Enable-Edge_Cuts.gm1, Main Memory Enable-F_Cu.gtl, Main Memory Enable-F_Mask.gts, Main Memory Enable-F_Paste.gtp]
2024-09-19 Renamed MPU to Processor and moved Processor Board into Processor.
    [Address Decode Board.kicad_sch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]
2024-09-19 Tidied and re-routed the Processor Board
    [Processor Board-B_Cu.gbl, Processor Board-B_Mask.gbs, Processor Board-B_Silkscreen.gbo, Processor Board-Edge_Cuts.gm1, Processor Board-F_Cu.gtl, Processor Board-F_Mask.gts, Processor Board-F_Silkscreen.gto, Processor Board-NPTH.drl]
2024-09-21 Tidied up device reset PCB. For some reason.
    [HCP65 Device Reset-B_Cu.gbl, HCP65 Device Reset-B_Mask.gbs, HCP65 Device Reset-B_Paste.gbp, HCP65 Device Reset-B_Silkscreen.gbo, HCP65 Device Reset-Edge_Cuts.gm1, HCP65 Device Reset-F_Cu.gtl, HCP65 Device Reset-F_Mask.gts, HCP65 Device Reset-F_Paste.gtp]
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2024-09-27 Tidied and re-routed the Video Boards
    [HCP65 MPU Address Decode-B_Cu.gbl, HCP65 MPU Address Decode-B_Mask.gbs, HCP65 MPU Address Decode-B_Paste.gbp, HCP65 MPU Address Decode-B_Silkscreen.gbo, HCP65 MPU Address Decode-Edge_Cuts.gm1, HCP65 MPU Address Decode-F_Cu.gtl, HCP65 MPU Address Decode-F_Mask.gts, HCP65 MPU Address Decode-F_Paste.gtp]
2024-09-30 Tidied and re-routed the PS2 Board
    [Blitter Board-B_Cu.gbl, Blitter Board-B_Mask.gbs, Blitter Board-B_Silkscreen.gbo, Blitter Board-Edge_Cuts.gm1, Blitter Board-F_Cu.gtl, Blitter Board-F_Mask.gts, Blitter Board-F_Silkscreen.gto, Blitter Board-NPTH.drl]
2024-10-02 Tidied up Clock Hold board.
    [HCP65 MPU Timer-B_Cu.gbl, HCP65 MPU Timer-B_Mask.gbs, HCP65 MPU Timer-B_Paste.gbp, HCP65 MPU Timer-B_Silkscreen.gbo, HCP65 MPU Timer-Edge_Cuts.gm1, HCP65 MPU Timer-F_Cu.gtl, HCP65 MPU Timer-F_Mask.gts, HCP65 MPU Timer-F_Paste.gtp]
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2024-10-05 Added MAX II datasheet.
    [W65C816 Debug Display.kicad_pcb, W65C816 Debug Display.kicad_sch]
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2024-10-22 Fixed trace touching connection generation.
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2024-10-28 Fixed deleting sub circuits that contain subcircuits. Probably.
2024-10-28 Tiedied up the W65C816 Breakout board a bit.
    [W65C816 Breakout-B_Cu.gbl, W65C816 Breakout-B_Mask.gbs, W65C816 Breakout-B_Paste.gbp, W65C816 Breakout-B_Silkscreen.gbo, W65C816 Breakout-Edge_Cuts.gm1, W65C816 Breakout-F_Cu.gtl, W65C816 Breakout-F_Mask.gts, W65C816 Breakout-F_Paste.gtp]
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2024-11-02 Fixed processor model paths.
    [Processor Board.kicad_pcb]
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2024-11-23 More Processor Board trace separation.
    [Processor Board-B_Cu.gbl, Processor Board-B_Mask.gbs, Processor Board-B_Silkscreen.gbo, Processor Board-Edge_Cuts.gm1, Processor Board-F_Cu.gtl, Processor Board-F_Mask.gts, Processor Board-F_Silkscreen.gto, Processor Board-NPTH.drl]
2024-11-23 Possibly finished routing the Processor Board.
    [Processor Board-B_Cu.gbl, Processor Board-B_Mask.gbs, Processor Board-B_Silkscreen.gbo, Processor Board-Edge_Cuts.gm1, Processor Board-F_Cu.gtl, Processor Board-F_Mask.gts, Processor Board-F_Silkscreen.gto, Processor Board-NPTH.drl]
2024-11-29 Added the Op-code debug display board.
    [Bus Tester.kicad_sch, DataEnable.circ, LED 14 Display.kicad_sch, LED Display.kicad_sch, Left_Handed_Bus 7_Segment.kicad_sch, Left_Handed_Bus.kicad_sch, Signal Tester Left.kicad_sch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]
2024-11-30 Changed debug board edges so to not clip ICs onthe processor board.
    [Processor Board-B_Cu.gbl, Processor Board-B_Mask.gbs, Processor Board-B_Silkscreen.gbo, Processor Board-Edge_Cuts.gm1, Processor Board-F_Cu.gtl, Processor Board-F_Mask.gts, Processor Board-F_Silkscreen.gto, Processor Board-NPTH.drl]
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2024-12-21 Fixed GPIO digital power switches.
    [Pico Wide GPIO Connect-B_Cu.gbl, Pico Wide GPIO Connect-B_Mask.gbs, Pico Wide GPIO Connect-B_Silkscreen.gbo, Pico Wide GPIO Connect-Edge_Cuts.gm1, Pico Wide GPIO Connect-F_Cu.gtl, Pico Wide GPIO Connect-F_Mask.gts, Pico Wide GPIO Connect-F_Silkscreen.gto, Pico Wide GPIO Connect-NPTH.drl]
2024-12-21 Did something with the opcode display.
    [W65C816 Opcode Display-B_Cu.gbl, W65C816 Opcode Display-B_Mask.gbs, W65C816 Opcode Display-B_Paste.gbp, W65C816 Opcode Display-B_Silkscreen.gbo, W65C816 Opcode Display-Edge_Cuts.gm1, W65C816 Opcode Display-F_Cu.gtl, W65C816 Opcode Display-F_Mask.gts, W65C816 Opcode Display-F_Paste.gtp]
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2024-12-21 Connected all Blitter board wires in the schematic.
    [Blitter Board.kicad_sch]
2025-01-02 Adding Daughter Board steps.
    [Audio Board.kicad_pcb, Mainboard Small.kicad_pcb, Mainboard Small.kicad_sch]
2025-01-02 Generated HCP65 Daughter board components.
    [Audio Board.kicad_pcb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]
2025-01-03 Use VRML instead of STEPs for Audio Board models.
    [Audio Board-B_Cu.gbl, Audio Board-B_Mask.gbs, Audio Board-B_Silkscreen.gbo, Audio Board-Edge_Cuts.gm1, Audio Board-F_Cu.gtl, Audio Board-F_Mask.gts, Audio Board-F_Silkscreen.gto, Audio Board-NPTH.drl]
2025-01-03 Use VRML instead of STEPs for Processor Board models.
    [Adder 16bit-B_Cu.gbl, Adder 16bit-B_Mask.gbs, Adder 16bit-B_Paste.gbp, Adder 16bit-B_Silkscreen.gbo, Adder 16bit-Edge_Cuts.gm1, Adder 16bit-F_Cu.gtl, Adder 16bit-F_Mask.gts, Adder 16bit-F_Paste.gtp]
2025-01-03 Use VRML instead of STEPs for Main Board models.
    [Counter 16bit-B_Cu.gbl, Counter 16bit-B_Mask.gbs, Counter 16bit-B_Paste.gbp, Counter 16bit-B_Silkscreen.gbo, Counter 16bit-Edge_Cuts.gm1, Counter 16bit-F_Cu.gtl, Counter 16bit-F_Mask.gts, Counter 16bit-F_Paste.gtp]
2025-01-04 Use VRML instead of STEPs for Graphics Board models.
    [Audio DAC.kicad_sch, Clock Transition.kicad_sch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]
2025-01-04 Use VRML instead of STEPs for SNES and LCD Board models.
    [Counter 16bit.kicad_sch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]
2025-01-05 Use VRML instead of STEPs for PS2 Board models.
    [Hex LCD Device.kicad_pcb, Hex LCD Device.kicad_sch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]
2025-01-05 Use VRML instead of STEPs for SD Card Board models.
    [Mainboard Small.kicad_pcb, Mainboard Small.kicad_sch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]
2025-01-05 Use VRML instead of STEPs for UART Board models.
    [RS232-B_Cu.gbl, RS232-B_Mask.gbs, RS232-B_Silkscreen.gbo, RS232-Edge_Cuts.gm1, RS232-F_Cu.gtl, RS232-F_Mask.gts, RS232-F_Silkscreen.gto, RS232-NPTH.drl]
2025-01-06 Use VRML instead of STEPs for VIA Board models.
    [Mainboard Small.kicad_pcb, Mainboard Small.kicad_sch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]
2025-01-06 Cleaning up Video boards.
    [Address Buffer 24bit.step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]
2025-01-06 Deleted Video Address Selector.
    [Video Address Selector-B_Cu.gbl, Video Address Selector-B_Mask.gbs, Video Address Selector-B_Paste.gbp, Video Address Selector-B_Silkscreen.gbo, Video Address Selector-Edge_Cuts.gm1, Video Address Selector-F_Cu.gtl, Video Address Selector-F_Mask.gts, Video Address Selector-F_Paste.gtp]
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2025-01-07 Added Video Counter and DAC.
    [Video Counter 12bit-B_Cu.gbl, Video Counter 12bit-B_Mask.gbs, Video Counter 12bit-B_Paste.gbp, Video Counter 12bit-B_Silkscreen.gbo, Video Counter 12bit-Edge_Cuts.gm1, Video Counter 12bit-F_Cu.gtl, Video Counter 12bit-F_Mask.gts, Video Counter 12bit-F_Paste.gtp]
2025-01-07 Started routing Device Status board.
    [Hex LCD Device.kicad_pcb, Hex LCD Device.kicad_sch]
2025-01-07 Finished routing Device Status board.
    [Hex LCD Device-B_Cu.gbl, Hex LCD Device-B_Mask.gbs, Hex LCD Device-B_Paste.gbp, Hex LCD Device-B_Silkscreen.gbo, Hex LCD Device-Edge_Cuts.gm1, Hex LCD Device-F_Cu.gtl, Hex LCD Device-F_Mask.gts, Hex LCD Device-F_Paste.gtp]
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2025-01-07 Use VRML instead of STEP for Video Board.
    [Comparator 10bit-B_Cu.gbl, Comparator 10bit-B_Mask.gbs, Comparator 10bit-B_Paste.gbp, Comparator 10bit-B_Silkscreen.gbo, Comparator 10bit-Edge_Cuts.gm1, Comparator 10bit-F_Cu.gtl, Comparator 10bit-F_Mask.gts, Comparator 10bit-F_Paste.gtp]
2025-01-08 Added Video board renders.
    [Mainboard Small.kicad_pcb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]
2025-01-08 Added a Real Time Clock device.
    [Clock Device.kicad_pcb, Clock Device.kicad_sch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]
2025-01-09 Added RTC device to Mainboard Small.
    [Clock Device-B_Cu.gbl, Clock Device-B_Mask.gbs, Clock Device-B_Paste.gbp, Clock Device-B_Silkscreen.gbo, Clock Device-Edge_Cuts.gm1, Clock Device-F_Cu.gtl, Clock Device-F_Mask.gts, Clock Device-F_Paste.gtp]
2025-01-09 Moved power button to the front of the Mainboard.
    [Mainboard Small-B_Cu.gbl, Mainboard Small-B_Mask.gbs, Mainboard Small-B_Silkscreen.gbo, Mainboard Small-Edge_Cuts.gm1, Mainboard Small-F_Cu.gtl, Mainboard Small-F_Mask.gts, Mainboard Small-F_Silkscreen.gto, Mainboard Small-NPTH.drl]
2025-01-09 Fixed Processor Board socket width.
    [Mainboard Small-B_Cu.gbl, Mainboard Small-B_Mask.gbs, Mainboard Small-B_Silkscreen.gbo, Mainboard Small-Edge_Cuts.gm1, Mainboard Small-F_Cu.gtl, Mainboard Small-F_Mask.gts, Mainboard Small-F_Silkscreen.gto, Mainboard Small-NPTH.drl]
2025-01-09 Added notes to Main Memory Channel.
    [Main Memory Channel.kicad_pcb, Main Memory Channel.kicad_sch, Main Memory Select.kicad_sch, Mainboard Small.kicad_sch]
2025-01-10 Renamed Trans Out to Data Output.
    [Processor Board.kicad_pcb, Processor Board.kicad_sch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]
2025-01-10 Rounded W65C816 Breakout traces.
    [W65C816 Breakout-B_Cu.gbl, W65C816 Breakout-B_Mask.gbs, W65C816 Breakout-B_Paste.gbp, W65C816 Breakout-B_Silkscreen.gbo, W65C816 Breakout-Edge_Cuts.gm1, W65C816 Breakout-F_Cu.gtl, W65C816 Breakout-F_Mask.gts, W65C816 Breakout-F_Paste.gtp]
2025-01-10 Deleted free routing config files.
    [freerouting.dsn, temp-freerouting.dsn]
2025-01-10 Rounded Clock Hold traces.
    [W65C816 Clock Hold-B_Cu.gbl, W65C816 Clock Hold-B_Mask.gbs, W65C816 Clock Hold-B_Paste.gbp, W65C816 Clock Hold-B_Silkscreen.gbo, W65C816 Clock Hold-Edge_Cuts.gm1, W65C816 Clock Hold-F_Cu.gtl, W65C816 Clock Hold-F_Mask.gts, W65C816 Clock Hold-F_Paste.gtp]
2025-01-11 Rounded Device Interrupt traces.
    [HCP65 Device Interrupts-B_Cu.gbl, HCP65 Device Interrupts-B_Mask.gbs, HCP65 Device Interrupts-B_Paste.gbp, HCP65 Device Interrupts-B_Silkscreen.gbo, HCP65 Device Interrupts-Edge_Cuts.gm1, HCP65 Device Interrupts-F_Cu.gtl, HCP65 Device Interrupts-F_Mask.gts, HCP65 Device Interrupts-F_Paste.gtp]
2025-01-11 Rounded Instruction Code traces.
    [Address Decode Board.kicad_sch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]
2025-01-12 Rounded Kernal Mode traces.
    [HCP65 Kernal Mode-B_Cu.gbl, HCP65 Kernal Mode-B_Mask.gbs, HCP65 Kernal Mode-B_Paste.gbp, HCP65 Kernal Mode-B_Silkscreen.gbo, HCP65 Kernal Mode-Edge_Cuts.gm1, HCP65 Kernal Mode-F_Cu.gtl, HCP65 Kernal Mode-F_Mask.gts, HCP65 Kernal Mode-F_Paste.gtp]
2025-01-12 Rounded Main Memory Address traces.
    [HCP65 Main Memory Address-B_Cu.gbl, HCP65 Main Memory Address-B_Mask.gbs, HCP65 Main Memory Address-B_Paste.gbp, HCP65 Main Memory Address-B_Silkscreen.gbo, HCP65 Main Memory Address-Edge_Cuts.gm1, HCP65 Main Memory Address-F_Cu.gtl, HCP65 Main Memory Address-F_Mask.gts, HCP65 Main Memory Address-F_Paste.gtp]
2025-01-12 Rounded MPU Memory traces.
    [HCP65 MPU Memory-B_Cu.gbl, HCP65 MPU Memory-B_Mask.gbs, HCP65 MPU Memory-B_Paste.gbp, HCP65 MPU Memory-B_Silkscreen.gbo, HCP65 MPU Memory-Edge_Cuts.gm1, HCP65 MPU Memory-F_Cu.gtl, HCP65 MPU Memory-F_Mask.gts, HCP65 MPU Memory-F_Paste.gtp]
2025-01-12 Rounded Selector 12bit traces.
    [Selector 12bit-B_Cu.gbl, Selector 12bit-B_Mask.gbs, Selector 12bit-B_Paste.gbp, Selector 12bit-B_Silkscreen.gbo, Selector 12bit-Edge_Cuts.gm1, Selector 12bit-F_Cu.gtl, Selector 12bit-F_Mask.gts, Selector 12bit-F_Paste.gtp]
2025-01-12 Rounded MPU NMI traces.
    [HCP65 MPU NMI-B_Cu.gbl, HCP65 MPU NMI-B_Mask.gbs, HCP65 MPU NMI-B_Paste.gbp, HCP65 MPU NMI-B_Silkscreen.gbo, HCP65 MPU NMI-Edge_Cuts.gm1, HCP65 MPU NMI-F_Cu.gtl, HCP65 MPU NMI-F_Mask.gts, HCP65 MPU NMI-F_Paste.gtp]
2025-01-12 Rounded MPU Timer traces.
    [HCP65 MPU Timer-B_Cu.gbl, HCP65 MPU Timer-B_Mask.gbs, HCP65 MPU Timer-B_Paste.gbp, HCP65 MPU Timer-B_Silkscreen.gbo, HCP65 MPU Timer-Edge_Cuts.gm1, HCP65 MPU Timer-F_Cu.gtl, HCP65 MPU Timer-F_Mask.gts, HCP65 MPU Timer-F_Paste.gtp]
2025-01-13 Rounded 16 bit address buffer traces.
    [Adder 16bit-B_Cu.gbl, Adder 16bit-B_Mask.gbs, Adder 16bit-B_Paste.gbp, Adder 16bit-B_Silkscreen.gbo, Adder 16bit-Edge_Cuts.gm1, Adder 16bit-F_Cu.gtl, Adder 16bit-F_Mask.gts, Adder 16bit-F_Paste.gtp]
2025-01-13 Rounded Device Buffer traces.
    [Data and Signal Buffer-B_Cu.gbl, Data and Signal Buffer-B_Mask.gbs, Data and Signal Buffer-B_Paste.gbp, Data and Signal Buffer-B_Silkscreen.gbo, Data and Signal Buffer-Edge_Cuts.gm1, Data and Signal Buffer-F_Cu.gtl, Data and Signal Buffer-F_Mask.gts, Data and Signal Buffer-F_Paste.gtp]
2025-01-13 Did something to the Debug Display.
    [W65C816 Debug Display-B_Cu.gbl, W65C816 Debug Display-B_Mask.gbs, W65C816 Debug Display-B_Paste.gbp, W65C816 Debug Display-B_Silkscreen.gbo, W65C816 Debug Display-Edge_Cuts.gm1, W65C816 Debug Display-F_Cu.gtl, W65C816 Debug Display-F_Mask.gts, W65C816 Debug Display-F_Paste.gtp]
2025-01-13 Re-routed some Processor Board traces.
    [Processor Board-B_Cu.gbl, Processor Board-B_Mask.gbs, Processor Board-B_Silkscreen.gbo, Processor Board-Edge_Cuts.gm1, Processor Board-F_Cu.gtl, Processor Board-F_Mask.gts, Processor Board-F_Silkscreen.gto, Processor Board-NPTH.drl]
2025-01-13 Deleted debug boards from Processor Board.
    [Processor Board.kicad_pcb]
2025-01-13 Re-added debug boards to Processor Board.
    [LED 14 Display.kicad_sch, LED Display.kicad_sch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]
2025-01-13 Fixed silk screen on the Processor Board.
    [Processor Board-B_Cu.gbl, Processor Board-B_Mask.gbs, Processor Board-B_Silkscreen.gbo, Processor Board-Edge_Cuts.gm1, Processor Board-F_Cu.gtl, Processor Board-F_Mask.gts, Processor Board-F_Silkscreen.gto, Processor Board-NPTH.drl]
2025-01-13 Rounded Main Memory Select traces.
    [Main Memory Select-B_Cu.gbl, Main Memory Select-B_Mask.gbs, Main Memory Select-B_Paste.gbp, Main Memory Select-B_Silkscreen.gbo, Main Memory Select-Edge_Cuts.gm1, Main Memory Select-F_Cu.gtl, Main Memory Select-F_Mask.gts, Main Memory Select-F_Paste.gtp]
2025-01-14 Rounded Clock Device traces.
    [Clock Device-B_Cu.gbl, Clock Device-B_Mask.gbs, Clock Device-B_Paste.gbp, Clock Device-B_Silkscreen.gbo, Clock Device-Edge_Cuts.gm1, Clock Device-F_Cu.gtl, Clock Device-F_Mask.gts, Clock Device-F_Paste.gtp]
2025-01-14 Rounded Dual MPU Clock traces.
    [Dual MPU Clock Generator-B_Cu.gbl, Dual MPU Clock Generator-B_Mask.gbs, Dual MPU Clock Generator-B_Paste.gbp, Dual MPU Clock Generator-B_Silkscreen.gbo, Dual MPU Clock Generator-Edge_Cuts.gm1, Dual MPU Clock Generator-F_Cu.gtl, Dual MPU Clock Generator-F_Mask.gts, Dual MPU Clock Generator-F_Paste.gtp]
2025-01-14 Rounded Main Memory Abort traces.
    [Main Memory Abort-B_Cu.gbl, Main Memory Abort-B_Mask.gbs, Main Memory Abort-B_Paste.gbp, Main Memory Abort-B_Silkscreen.gbo, Main Memory Abort-Edge_Cuts.gm1, Main Memory Abort-F_Cu.gtl, Main Memory Abort-F_Mask.gts, Main Memory Abort-F_Paste.gtp]
2025-01-14 Rounded Main Memory Channel traces.
    [Main Memory Channel-B_Cu.gbl, Main Memory Channel-B_Mask.gbs, Main Memory Channel-B_Paste.gbp, Main Memory Channel-B_Silkscreen.gbo, Main Memory Channel-Edge_Cuts.gm1, Main Memory Channel-F_Cu.gtl, Main Memory Channel-F_Mask.gts, Main Memory Channel-F_Paste.gtp]
2025-01-14 Rounded Main Memory Enable traces.
    [Main Memory Enable-B_Cu.gbl, Main Memory Enable-B_Mask.gbs, Main Memory Enable-B_Paste.gbp, Main Memory Enable-B_Silkscreen.gbo, Main Memory Enable-Edge_Cuts.gm1, Main Memory Enable-F_Cu.gtl, Main Memory Enable-F_Mask.gts, Main Memory Enable-F_Paste.gtp]
2025-01-14 Rounded Status Device traces.
    [Status Device-B_Cu.gbl, Status Device-B_Mask.gbs, Status Device-B_Paste.gbp, Status Device-B_Silkscreen.gbo, Status Device-Edge_Cuts.gm1, Status Device-F_Cu.gtl, Status Device-F_Mask.gts, Status Device-F_Paste.gtp]
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2025-01-14 Fixed Mainboard Small components silkscreens.
    [Clock Device-B_Cu.gbl, Clock Device-B_Mask.gbs, Clock Device-B_Paste.gbp, Clock Device-B_Silkscreen.gbo, Clock Device-Edge_Cuts.gm1, Clock Device-F_Cu.gtl, Clock Device-F_Mask.gts, Clock Device-F_Paste.gtp]
2025-01-14 Shuffled Processor Board components into logical blocks.
    [Processor Board.kicad_sch]
2025-01-15 Shuffling traces and silk screens.
    [Mainboard Small.kicad_sch, Processor Board.kicad_pcb, Processor Board.kicad_sch, Video Board - Memory.kicad_pcb]
2025-01-15 Reversed Video Board - Memory silkscreen.
    [Video Board - Memory-B_Cu.gbl, Video Board - Memory-B_Mask.gbs, Video Board - Memory-B_Silkscreen.gbo, Video Board - Memory-Edge_Cuts.gm1, Video Board - Memory-F_Cu.gtl, Video Board - Memory-F_Mask.gts, Video Board - Memory-F_Silkscreen.gto, Video Board - Memory-NPTH.drl]
2025-01-15 Rounded Video Memory 2MB traces.
    [Video Memory 2MB-B_Cu.gbl, Video Memory 2MB-B_Mask.gbs, Video Memory 2MB-B_Paste.gbp, Video Memory 2MB-B_Silkscreen.gbo, Video Memory 2MB-Edge_Cuts.gm1, Video Memory 2MB-F_Cu.gtl, Video Memory 2MB-F_Mask.gts, Video Memory 2MB-F_Paste.gtp]
2025-01-15 Rounded D Flip Flop 16bit traces.
    [D Flip Flop 16bit-B_Cu.gbl, D Flip Flop 16bit-B_Mask.gbs, D Flip Flop 16bit-B_Paste.gbp, D Flip Flop 16bit-B_Silkscreen.gbo, D Flip Flop 16bit-Edge_Cuts.gm1, D Flip Flop 16bit-F_Cu.gtl, D Flip Flop 16bit-F_Mask.gts, D Flip Flop 16bit-F_Paste.gtp]
2025-01-15 Rounded D Flip Flop 24bit traces.
    [D Flip Flop 24bit-B_Cu.gbl, D Flip Flop 24bit-B_Mask.gbs, D Flip Flop 24bit-B_Paste.gbp, D Flip Flop 24bit-B_Silkscreen.gbo, D Flip Flop 24bit-Edge_Cuts.gm1, D Flip Flop 24bit-F_Cu.gtl, D Flip Flop 24bit-F_Mask.gts, D Flip Flop 24bit-F_Paste.gtp]
2025-01-15 Rounded Video Data Select traces.
    [Video Data Select-B_Cu.gbl, Video Data Select-B_Mask.gbs, Video Data Select-B_Paste.gbp, Video Data Select-B_Silkscreen.gbo, Video Data Select-Edge_Cuts.gm1, Video Data Select-F_Cu.gtl, Video Data Select-F_Mask.gts, Video Data Select-F_Paste.gtp]
2025-01-16 Rounded Counter 24bit traces.
    [Counter 24bit with IO.kicad_pcb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]
2025-01-16 Rounded Blank and Sync traces.
    [Blank and Sync-B_Cu.gbl, Blank and Sync-B_Mask.gbs, Blank and Sync-B_Paste.gbp, Blank and Sync-B_Silkscreen.gbo, Blank and Sync-Edge_Cuts.gm1, Blank and Sync-F_Cu.gtl, Blank and Sync-F_Mask.gts, Blank and Sync-F_Paste.gtp]
2025-01-16 Rounded Video Pixel Advance traces.
    [Pixel Doubler-B_Cu.gbl, Pixel Doubler-B_Mask.gbs, Pixel Doubler-B_Paste.gbp, Pixel Doubler-B_Silkscreen.gbo, Pixel Doubler-Edge_Cuts.gm1, Pixel Doubler-F_Cu.gtl, Pixel Doubler-F_Mask.gts, Pixel Doubler-F_Paste.gtp]
2025-01-16 Renamed Blank and Sync to Video Blank and Sync.
    [Video Blank and Sync-B_Cu.gbl, Video Blank and Sync-B_Mask.gbs, Video Blank and Sync-B_Paste.gbp, Video Blank and Sync-B_Silkscreen.gbo, Video Blank and Sync-Edge_Cuts.gm1, Video Blank and Sync-F_Cu.gtl, Video Blank and Sync-F_Mask.gts, Video Blank and Sync-F_Paste.gtp]
2025-01-16 Rounded Video Address Reader traces.
    [Video Address Reader-B_Cu.gbl, Video Address Reader-B_Mask.gbs, Video Address Reader-B_Paste.gbp, Video Address Reader-B_Silkscreen.gbo, Video Address Reader-Edge_Cuts.gm1, Video Address Reader-F_Cu.gtl, Video Address Reader-F_Mask.gts, Video Address Reader-F_Paste.gtp]
2025-01-16 Rounded Video Clock traces.
    [Video Clock-B_Cu.gbl, Video Clock-B_Mask.gbs, Video Clock-B_Paste.gbp, Video Clock-B_Silkscreen.gbo, Video Clock-Edge_Cuts.gm1, Video Clock-F_Cu.gtl, Video Clock-F_Mask.gts, Video Clock-F_Paste.gtp]
2025-01-16 Rounded Video Counter 12bit traces.
    [Video Counter 12bit-B_Cu.gbl, Video Counter 12bit-B_Mask.gbs, Video Counter 12bit-B_Paste.gbp, Video Counter 12bit-B_Silkscreen.gbo, Video Counter 12bit-Edge_Cuts.gm1, Video Counter 12bit-F_Cu.gtl, Video Counter 12bit-F_Mask.gts, Video Counter 12bit-F_Paste.gtp]
2025-01-17 Rounded Device Decode A traces.
    [Device Decode stage A-B_Cu.gbl, Device Decode stage A-B_Mask.gbs, Device Decode stage A-B_Paste.gbp, Device Decode stage A-B_Silkscreen.gbo, Device Decode stage A-Edge_Cuts.gm1, Device Decode stage A-F_Cu.gtl, Device Decode stage A-F_Mask.gts, Device Decode stage A-F_Paste.gtp]
2025-01-17 Rounded Device Decode B traces.
    [Device Decode stage B-B_Cu.gbl, Device Decode stage B-B_Mask.gbs, Device Decode stage B-B_Silkscreen.gbo, Device Decode stage B-Edge_Cuts.gm1, Device Decode stage B-F_Cu.gtl, Device Decode stage B-F_Mask.gts, Device Decode stage B-F_Silkscreen.gto, Device Decode stage B-NPTH.drl]
2025-01-17 Rounded Flags Enable Interrupt traces.
    [Flags Enable Interrupt-B_Cu.gbl, Flags Enable Interrupt-B_Mask.gbs, Flags Enable Interrupt-B_Paste.gbp, Flags Enable Interrupt-B_Silkscreen.gbo, Flags Enable Interrupt-Edge_Cuts.gm1, Flags Enable Interrupt-F_Cu.gtl, Flags Enable Interrupt-F_Mask.gts, Flags Enable Interrupt-F_Paste.gtp]
2025-01-17 Rounded Selector 1 of 4 traces.
    [Selector 1-of-4 4bit with Input-B_Cu.gbl, Selector 1-of-4 4bit with Input-B_Mask.gbs, Selector 1-of-4 4bit with Input-B_Paste.gbp, Selector 1-of-4 4bit with Input-B_Silkscreen.gbo, Selector 1-of-4 4bit with Input-Edge_Cuts.gm1, Selector 1-of-4 4bit with Input-F_Cu.gtl, Selector 1-of-4 4bit with Input-F_Mask.gts, Selector 1-of-4 4bit with Input-F_Paste.gtp]
2025-01-17 Rounded Video DAC traces.
    [Device Decode stage A.kicad_pcb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]
2025-01-17 Rounded Comparator 10bit traces.
    [Comparator 10bit-B_Cu.gbl, Comparator 10bit-B_Mask.gbs, Comparator 10bit-B_Paste.gbp, Comparator 10bit-B_Silkscreen.gbo, Comparator 10bit-Edge_Cuts.gm1, Comparator 10bit-F_Cu.gtl, Comparator 10bit-F_Mask.gts, Comparator 10bit-F_Paste.gtp]
2025-01-17 Rounded Comparator 16bit traces.
    [Comparator 16bit-B_Cu.gbl, Comparator 16bit-B_Mask.gbs, Comparator 16bit-B_Paste.gbp, Comparator 16bit-B_Silkscreen.gbo, Comparator 16bit-Edge_Cuts.gm1, Comparator 16bit-F_Cu.gtl, Comparator 16bit-F_Mask.gts, Comparator 16bit-F_Paste.gtp]
2025-01-17 Rounded Dual Comparator 8bit traces.
    [Dual Comparator 8bit-B_Cu.gbl, Dual Comparator 8bit-B_Mask.gbs, Dual Comparator 8bit-B_Paste.gbp, Dual Comparator 8bit-B_Silkscreen.gbo, Dual Comparator 8bit-Edge_Cuts.gm1, Dual Comparator 8bit-F_Cu.gtl, Dual Comparator 8bit-F_Mask.gts, Dual Comparator 8bit-F_Paste.gtp]
2025-01-17 Rounded Video Signals Output traces.
    [Video Signals Output-B_Cu.gbl, Video Signals Output-B_Mask.gbs, Video Signals Output-B_Paste.gbp, Video Signals Output-B_Silkscreen.gbo, Video Signals Output-Edge_Cuts.gm1, Video Signals Output-F_Cu.gtl, Video Signals Output-F_Mask.gts, Video Signals Output-F_Paste.gtp]
2025-01-17 Rounded Video Device RAM Select traces.
    [Video Device RAM Select-B_Cu.gbl, Video Device RAM Select-B_Mask.gbs, Video Device RAM Select-B_Paste.gbp, Video Device RAM Select-B_Silkscreen.gbo, Video Device RAM Select-Edge_Cuts.gm1, Video Device RAM Select-F_Cu.gtl, Video Device RAM Select-F_Mask.gts, Video Device RAM Select-F_Paste.gtp]
2025-01-17 Rounded Video Signal Dragger traces.
    [Video Signal Dragger-B_Cu.gbl, Video Signal Dragger-B_Mask.gbs, Video Signal Dragger-B_Paste.gbp, Video Signal Dragger-B_Silkscreen.gbo, Video Signal Dragger-Edge_Cuts.gm1, Video Signal Dragger-F_Cu.gtl, Video Signal Dragger-F_Mask.gts, Video Signal Dragger-F_Paste.gtp]
2025-01-17 Rounded Clock Hold Standard traces.
    [Clock Hold Standard-B_Cu.gbl, Clock Hold Standard-B_Mask.gbs, Clock Hold Standard-B_Paste.gbp, Clock Hold Standard-B_Silkscreen.gbo, Clock Hold Standard-Edge_Cuts.gm1, Clock Hold Standard-F_Cu.gtl, Clock Hold Standard-F_Mask.gts, Clock Hold Standard-F_Paste.gtp]
2025-01-23 Swapped Main Memory Select select line order.
    [Main Memory Select-B_Cu.gbl, Main Memory Select-B_Mask.gbs, Main Memory Select-B_Paste.gbp, Main Memory Select-B_Silkscreen.gbo, Main Memory Select-Edge_Cuts.gm1, Main Memory Select-F_Cu.gtl, Main Memory Select-F_Mask.gts, Main Memory Select-F_Paste.gtp]
2025-01-23 Fixed internal W65C816 bank address lines.
    [Processor Board.kicad_pcb, Processor Board.kicad_sch]
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2025-01-24 Swapped W65C816 timing schematic pins.
    [Processor Board.kicad_sch]
2025-01-26 Rerouted SD Card Board traces.
    [SD Card Board-B_Cu.gbl, SD Card Board-B_Mask.gbs, SD Card Board-B_Silkscreen.gbo, SD Card Board-Edge_Cuts.gm1, SD Card Board-F_Cu.gtl, SD Card Board-F_Mask.gts, SD Card Board-F_Silkscreen.gto, SD Card Board-NPTH.drl]
2025-01-27 Rounded SD Card Read traces.
    [SD Card Read Function-B_Cu.gbl, SD Card Read Function-B_Mask.gbs, SD Card Read Function-B_Paste.gbp, SD Card Read Function-B_Silkscreen.gbo, SD Card Read Function-Edge_Cuts.gm1, SD Card Read Function-F_Cu.gtl, SD Card Read Function-F_Mask.gts, SD Card Read Function-F_Paste.gtp]
2025-01-27 Rounded GPIO 4bit traces.
    [GPIO 4bit-B_Cu.gbl, GPIO 4bit-B_Mask.gbs, GPIO 4bit-B_Paste.gbp, GPIO 4bit-B_Silkscreen.gbo, GPIO 4bit-Edge_Cuts.gm1, GPIO 4bit-F_Cu.gtl, GPIO 4bit-F_Mask.gts, GPIO 4bit-F_Paste.gtp]
2025-01-27 Rounded SD Card Clock traces.
    [SD Card Clock-B_Cu.gbl, SD Card Clock-B_Mask.gbs, SD Card Clock-B_Paste.gbp, SD Card Clock-B_Silkscreen.gbo, SD Card Clock-Edge_Cuts.gm1, SD Card Clock-F_Cu.gtl, SD Card Clock-F_Mask.gts, SD Card Clock-F_Paste.gtp]
2025-01-27 Rounded SD Card Board traces.
    [SD Card Board-B_Cu.gbl, SD Card Board-B_Mask.gbs, SD Card Board-B_Silkscreen.gbo, SD Card Board-Edge_Cuts.gm1, SD Card Board-F_Cu.gtl, SD Card Board-F_Mask.gts, SD Card Board-F_Silkscreen.gto, SD Card Board-NPTH.drl]
2025-01-27 Rounded SD Card Write traces.
    [SD Card Board-B_Cu.gbl, SD Card Board-B_Mask.gbs, SD Card Board-B_Silkscreen.gbo, SD Card Board-Edge_Cuts.gm1, SD Card Board-F_Cu.gtl, SD Card Board-F_Mask.gts, SD Card Board-F_Silkscreen.gto, SD Card Board-NPTH.drl]
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2025-01-28 Added tear drops to Flags Enable and Interrupt board.
    [Flags Enable Interrupt-B_Cu.gbl, Flags Enable Interrupt-B_Mask.gbs, Flags Enable Interrupt-B_Paste.gbp, Flags Enable Interrupt-B_Silkscreen.gbo, Flags Enable Interrupt-Edge_Cuts.gm1, Flags Enable Interrupt-F_Cu.gtl, Flags Enable Interrupt-F_Mask.gts, Flags Enable Interrupt-F_Paste.gtp]
2025-01-28 I think I added tear drops to the Device Decode boards. I dunno.
    [Device Decode stage A-B_Cu.gbl, Device Decode stage A-B_Mask.gbs, Device Decode stage A-B_Paste.gbp, Device Decode stage A-B_Silkscreen.gbo, Device Decode stage A-Edge_Cuts.gm1, Device Decode stage A-F_Cu.gtl, Device Decode stage A-F_Mask.gts, Device Decode stage A-F_Paste.gtp]
2025-01-29 Added tear drops to Device Interrupts board.
    [HCP65 Device Interrupts-B_Cu.gbl, HCP65 Device Interrupts-B_Mask.gbs, HCP65 Device Interrupts-B_Paste.gbp, HCP65 Device Interrupts-B_Silkscreen.gbo, HCP65 Device Interrupts-Edge_Cuts.gm1, HCP65 Device Interrupts-F_Cu.gtl, HCP65 Device Interrupts-F_Mask.gts, HCP65 Device Interrupts-F_Paste.gtp]
2025-01-29 Added tear drops to Instruction Code board.
    [HCP65 Device Reset-B_Cu.gbl, HCP65 Device Reset-B_Mask.gbs, HCP65 Device Reset-B_Paste.gbp, HCP65 Device Reset-B_Silkscreen.gbo, HCP65 Device Reset-Edge_Cuts.gm1, HCP65 Device Reset-F_Cu.gtl, HCP65 Device Reset-F_Mask.gts, HCP65 Device Reset-F_Paste.gtp]
2025-01-29 Re-added tear drops to all Processor boards.
    [HCP65 Kernal Mode-B_Cu.gbl, HCP65 Kernal Mode-B_Mask.gbs, HCP65 Kernal Mode-B_Paste.gbp, HCP65 Kernal Mode-B_Silkscreen.gbo, HCP65 Kernal Mode-Edge_Cuts.gm1, HCP65 Kernal Mode-F_Cu.gtl, HCP65 Kernal Mode-F_Mask.gts, HCP65 Kernal Mode-F_Paste.gtp]
2025-01-29 Re-added tear drops to all LCD boards.
    [Device Buffer-B_Cu.gbl, Device Buffer-B_Mask.gbs, Device Buffer-B_Paste.gbp, Device Buffer-B_Silkscreen.gbo, Device Buffer-Edge_Cuts.gm1, Device Buffer-F_Cu.gtl, Device Buffer-F_Mask.gts, Device Buffer-F_Paste.gtp]
2025-01-29 Re-added tear drops to all PS2 boards.
    [PS2 Board-B_Cu.gbl, PS2 Board-B_Mask.gbs, PS2 Board-B_Silkscreen.gbo, PS2 Board-Edge_Cuts.gm1, PS2 Board-F_Cu.gtl, PS2 Board-F_Mask.gts, PS2 Board-F_Silkscreen.gto, PS2 Board-NPTH.drl]
2025-01-30 Re-added tear drops to all Memory boards.
    [Memory 4MB-B_Cu.gbl, Memory 4MB-B_Mask.gbs, Memory 4MB-B_Paste.gbp, Memory 4MB-B_Silkscreen.gbo, Memory 4MB-Edge_Cuts.gm1, Memory 4MB-F_Cu.gtl, Memory 4MB-F_Mask.gts, Memory 4MB-F_Paste.gtp]
2025-01-30 Re-added tear drops to all Audio boards.
    [Audio Address Decode-B_Cu.gbl, Audio Address Decode-B_Mask.gbs, Audio Address Decode-B_Silkscreen.gbo, Audio Address Decode-Edge_Cuts.gm1, Audio Address Decode-F_Cu.gtl, Audio Address Decode-F_Mask.gts, Audio Address Decode-F_Silkscreen.gto, Audio Address Decode-NPTH.drl]
2025-01-30 Cleaned up Pico Wide Connect and added an HCP65 Tester.
    [HCP65 Tester.kicad_pcb, HCP65 Tester.kicad_sch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]
2025-01-30 Auto routed HCP65 Tester.
    [HCP65 Tester.kicad_pcb]
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2025-02-05 Generated Gerbers for a bunch of boards.
    [Adder 16bit.step, Address Buffer 16bit.step, Address Buffer 24bit.step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]
2025-02-06 Added power LEDs to Pico Wide GPIO.
    [Pico Wide GPIO Connect-B_Cu.gbl, Pico Wide GPIO Connect-B_Mask.gbs, Pico Wide GPIO Connect-B_Silkscreen.gbo, Pico Wide GPIO Connect-Edge_Cuts.gm1, Pico Wide GPIO Connect-F_Cu.gtl, Pico Wide GPIO Connect-F_Mask.gts, Pico Wide GPIO Connect-F_Silkscreen.gto, Pico Wide GPIO Connect-NPTH.drl]
2025-02-06 PCBs for EPM7160S Programmer and EPM570 Programmer.
    [EPM570 Programmer-B_Cu.gbl, EPM570 Programmer-B_Mask.gbs, EPM570 Programmer-B_Paste.gbp, EPM570 Programmer-B_Silkscreen.gbo, EPM570 Programmer-Edge_Cuts.gm1, EPM570 Programmer-F_Cu.gtl, EPM570 Programmer-F_Mask.gts, EPM570 Programmer-F_Paste.gtp]
2025-02-08 Fixed low side switch on W65C816 Debug Display.
    [W65C816 Debug Display-B_Cu.gbl, W65C816 Debug Display-B_Mask.gbs, W65C816 Debug Display-B_Paste.gbp, W65C816 Debug Display-B_Silkscreen.gbo, W65C816 Debug Display-Edge_Cuts.gm1, W65C816 Debug Display-F_Cu.gtl, W65C816 Debug Display-F_Mask.gts, W65C816 Debug Display-F_Paste.gtp]
2025-02-08 Fixed low side switch on W65C816 Opcode Display.
    [W65C816 Opcode Display-B_Cu.gbl, W65C816 Opcode Display-B_Mask.gbs, W65C816 Opcode Display-B_Paste.gbp, W65C816 Opcode Display-B_Silkscreen.gbo, W65C816 Opcode Display-Edge_Cuts.gm1, W65C816 Opcode Display-F_Cu.gtl, W65C816 Opcode Display-F_Mask.gts, W65C816 Opcode Display-F_Paste.gtp]
2025-02-08 Fixed low side switch on PICO Wide Connect.
    [Pico Wide GPIO Connect-B_Cu.gbl, Pico Wide GPIO Connect-B_Mask.gbs, Pico Wide GPIO Connect-B_Silkscreen.gbo, Pico Wide GPIO Connect-Edge_Cuts.gm1, Pico Wide GPIO Connect-F_Cu.gtl, Pico Wide GPIO Connect-F_Mask.gts, Pico Wide GPIO Connect-F_Silkscreen.gto, Pico Wide GPIO Connect-NPTH.drl]
2025-02-08 Added HCP65 Board and Component testers.
    [HCP65 Board Tester.kicad_pcb, HCP65 Board Tester.kicad_sch, HCP65 Component Tester.kicad_pcb, HCP65 Component Tester.kicad_sch, HCP65 Tester.kicad_sch]
2025-02-08 Routed HCP65 Board Tester.
    [HCP65 Board Tester-B_Cu.gbl, HCP65 Board Tester-B_Mask.gbs, HCP65 Board Tester-B_Silkscreen.gbo, HCP65 Board Tester-Edge_Cuts.gm1, HCP65 Board Tester-F_Cu.gtl, HCP65 Board Tester-F_Mask.gts, HCP65 Board Tester-F_Silkscreen.gto, HCP65 Board Tester-NPTH.drl]
2025-02-08 Routed HCP65 Component Tester.
    [HCP65 Component Tester-B_Cu.gbl, HCP65 Component Tester-B_Mask.gbs, HCP65 Component Tester-B_Silkscreen.gbo, HCP65 Component Tester-Edge_Cuts.gm1, HCP65 Component Tester-F_Cu.gtl, HCP65 Component Tester-F_Mask.gts, HCP65 Component Tester-F_Silkscreen.gto, HCP65 Component Tester-NPTH.drl]
2025-02-08 Added LED Digit Tester board.
    [LED Digit Tester-B_Cu.gbl, LED Digit Tester-B_Mask.gbs, LED Digit Tester-B_Paste.gbp, LED Digit Tester-B_Silkscreen.gbo, LED Digit Tester-Edge_Cuts.gm1, LED Digit Tester-F_Cu.gtl, LED Digit Tester-F_Mask.gts, LED Digit Tester-F_Paste.gtp]
2025-02-10 Added an EPM7032 Programmer and fixed the EPM570 Programmer.
    [Andrew Paterson - HCP65 V1 - Fabrication.ods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]
2025-02-10 Rounded some GPIO 16bit tracks. For some reason.
    [GPIO 16bit.kicad_pcb, GPIO 16bit.kicad_sch]
2025-02-10 Trying to document the 4bit GPIO board.
    [PS2 Board.kicad_sch]
2025-02-19 Dunno what this was either.
    [GPIO 4bit.kicad_sch, Indexed Instructions.ods]
2025-02-19 Shuffled a bunch of old and unmaintained Kicad projects into the 'old' directory.
    [Battery Charger-B_Cu.gbl, Battery Charger-B_Mask.gbs, Battery Charger-B_Silkscreen.gbo, Battery Charger-Edge_Cuts.gm1, Battery Charger-F_Cu.gtl, Battery Charger-F_Mask.gts, Battery Charger-F_Silkscreen.gto, Battery Charger-NPTH.drl]
2025-02-19 Updated speed board with new footprints.
    [Clock Transition-B_Cu.gbl, Clock Transition-B_Mask.gbs, Clock Transition-B_Paste.gbp, Clock Transition-B_Silkscreen.gbo, Clock Transition-Edge_Cuts.gm1, Clock Transition-F_Cu.gtl, Clock Transition-F_Mask.gts, Clock Transition-F_Paste.gtp]
2025-02-19 Melted Speedboard traces.
    [Speed-B_Cu.gbl, Speed-B_Mask.gbs, Speed-B_Silkscreen.gbo, Speed-Edge_Cuts.gm1, Speed-F_Cu.gtl, Speed-F_Mask.gts, Speed-F_Silkscreen.gto, Speed-NPTH.drl]
2025-02-20 Added an RC filter to the speedboard clock.
    [Speed-B_Cu.gbl, Speed-B_Mask.gbs, Speed-B_Silkscreen.gbo, Speed-Edge_Cuts.gm1, Speed-F_Cu.gtl, Speed-F_Mask.gts, Speed-F_Silkscreen.gto, Speed-NPTH.drl]
2025-02-21 Moved symbol libraries into a Symbols directory.
    [G17C0900132EU.stp, LD1117S33.stp, MAX232ECDR.stp, MCP73811T-420I_OT.stp]
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2025-02-21 Rounded clock generator traces.
    [Quad MPU Clock Generator-B_Cu.gbl, Quad MPU Clock Generator-B_Mask.gbs, Quad MPU Clock Generator-B_Paste.gbp, Quad MPU Clock Generator-B_Silkscreen.gbo, Quad MPU Clock Generator-Edge_Cuts.gm1, Quad MPU Clock Generator-F_Cu.gtl, Quad MPU Clock Generator-F_Mask.gts, Quad MPU Clock Generator-F_Paste.gtp]
2025-02-22 Aligned Video board drill holes with grid.
    [VIA Breakout.kicad_pcb, VIA Control.kicad_pcb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]
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2025-02-22 Cleaned up the Blitter Board.
    [Blitter Board-B_Cu.gbl, Blitter Board-B_Mask.gbs, Blitter Board-B_Silkscreen.gbo, Blitter Board-Edge_Cuts.gm1, Blitter Board-F_Cu.gtl, Blitter Board-F_Mask.gts, Blitter Board-F_Silkscreen.gto, Blitter Board-NPTH.drl]
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2025-03-02 Added EPM7032S Programmer and EPM570 Programmer and rounded Pico Power tracks.
    [EPM570 Programmer-B_Cu.gbl, EPM570 Programmer-B_Mask.gbs, EPM570 Programmer-B_Silkscreen.gbo, EPM570 Programmer-Edge_Cuts.gm1, EPM570 Programmer-F_Cu.gtl, EPM570 Programmer-F_Mask.gts, EPM570 Programmer-F_Silkscreen.gto, EPM570 Programmer-NPTH.drl]
2025-03-04 Cleaned up programmer schematics.
    [EPM570 Programmer.kicad_sch, EPM7160S Programmer.kicad_sch]
2025-03-06 Bit more cleanup on the 65C816 breakout board.
    [W65C816 Breakout-B_Cu.gbl, W65C816 Breakout-B_Mask.gbs, W65C816 Breakout-B_Paste.gbp, W65C816 Breakout-B_Silkscreen.gbo, W65C816 Breakout-Edge_Cuts.gm1, W65C816 Breakout-F_Cu.gtl, W65C816 Breakout-F_Mask.gts, W65C816 Breakout-F_Paste.gtp]
2025-03-07 Cleanup on the 65C816 clock hold board.
    [W65C816 Clock Hold-B_Cu.gbl, W65C816 Clock Hold-B_Mask.gbs, W65C816 Clock Hold-B_Paste.gbp, W65C816 Clock Hold-B_Silkscreen.gbo, W65C816 Clock Hold-Edge_Cuts.gm1, W65C816 Clock Hold-F_Cu.gtl, W65C816 Clock Hold-F_Mask.gts, W65C816 Clock Hold-F_Paste.gtp]
2025-03-08 Nicer W65C816 Breakout board solder mask.
    [W65C816 Breakout-B_Cu.gbl, W65C816 Breakout-B_Mask.gbs, W65C816 Breakout-B_Paste.gbp, W65C816 Breakout-B_Silkscreen.gbo, W65C816 Breakout-Edge_Cuts.gm1, W65C816 Breakout-F_Cu.gtl, W65C816 Breakout-F_Mask.gts, W65C816 Breakout-F_Paste.gtp]
2025-03-09 Cleanup on the Processor Board.
    [Processor Board-B_Cu.gbl, Processor Board-B_Mask.gbs, Processor Board-B_Silkscreen.gbo, Processor Board-Edge_Cuts.gm1, Processor Board-F_Cu.gtl, Processor Board-F_Mask.gts, Processor Board-F_Silkscreen.gto, Processor Board-NPTH.drl]
2025-03-09 More cleanup on the Processor Board.
    [Processor Board-B_Cu.gbl, Processor Board-B_Mask.gbs, Processor Board-B_Silkscreen.gbo, Processor Board-Edge_Cuts.gm1, Processor Board-F_Cu.gtl, Processor Board-F_Mask.gts, Processor Board-F_Silkscreen.gto, Processor Board-NPTH.drl]
2025-03-12 Include Valid Address in address decoding.
    [HCP65 MPU Address Decode-B_Cu.gbl, HCP65 MPU Address Decode-B_Mask.gbs, HCP65 MPU Address Decode-B_Paste.gbp, HCP65 MPU Address Decode-B_Silkscreen.gbo, HCP65 MPU Address Decode-Edge_Cuts.gm1, HCP65 MPU Address Decode-F_Cu.gtl, HCP65 MPU Address Decode-F_Mask.gts, HCP65 MPU Address Decode-F_Paste.gtp]
2025-03-12 Deleted Wide Interrupts and Wide Address Decode.
    [HCP65 Device Interrupts Wide-B_Cu.gbl, HCP65 Device Interrupts Wide-B_Mask.gbs, HCP65 Device Interrupts Wide-B_Silkscreen.gbo, HCP65 Device Interrupts Wide-Edge_Cuts.gm1, HCP65 Device Interrupts Wide-F_Cu.gtl, HCP65 Device Interrupts Wide-F_Mask.gts, HCP65 Device Interrupts Wide-F_Silkscreen.gto, HCP65 Device Interrupts Wide-NPTH.drl]
2025-03-13 Fixed RAM and ROM selects not swapping before native mode.
    [HCP65 Instruction Code-B_Cu.gbl, HCP65 Instruction Code-B_Mask.gbs, HCP65 Instruction Code-B_Paste.gbp, HCP65 Instruction Code-B_Silkscreen.gbo, HCP65 Instruction Code-Edge_Cuts.gm1, HCP65 Instruction Code-F_Cu.gtl, HCP65 Instruction Code-F_Mask.gts, HCP65 Instruction Code-F_Paste.gtp]
2025-03-14 Fixed EPM570 spelling.
    [EPM570 Programmer-B_Cu.gbl, EPM570 Programmer-B_Mask.gbs, EPM570 Programmer-B_Silkscreen.gbo, EPM570 Programmer-Edge_Cuts.gm1, EPM570 Programmer-F_Cu.gtl, EPM570 Programmer-F_Mask.gts, EPM570 Programmer-F_Silkscreen.gto, EPM570 Programmer-NPTH.drl]
2025-03-14 Added LCD tester boards.
    [LCD 14 Segment Tester.kicad_pcb, LCD 14 Segment Tester.kicad_sch, LCD Dual 7 Segment Tester.kicad_pcb, LCD Dual 7 Segment Tester.kicad_sch, LED 14 Display.kicad_sch, LED Display.kicad_sch]
2025-03-14 Auto-routed LCD Dual 7 Segment tester PCB.
    [LCD Dual 7 Segment Tester.kicad_pcb]
2025-03-14 Cleaned up LCD Dual 7 Segment Display.
    [LCD Dual 7 Segment Tester-B_Cu.gbl, LCD Dual 7 Segment Tester-B_Mask.gbs, LCD Dual 7 Segment Tester-B_Paste.gbp, LCD Dual 7 Segment Tester-B_Silkscreen.gbo, LCD Dual 7 Segment Tester-Edge_Cuts.gm1, LCD Dual 7 Segment Tester-F_Cu.gtl, LCD Dual 7 Segment Tester-F_Mask.gts, LCD Dual 7 Segment Tester-F_Paste.gtp]
2025-03-14 Added a TSSOP32 adapter.
    [LCD 14 Segment Tester.kicad_pcb, LCD 14 Segment Tester.kicad_sch, LCD Dual 7 Segment Tester.kicad_pcb, LED 14 Display.kicad_sch, LED Display.kicad_sch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]
2025-03-15 Laid out LCD 14 Segment tester PCB.
    [LCD 14 Segment Tester.kicad_pcb, LCD 14 Segment Tester.kicad_sch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]
2025-03-15 Auto-routed LCD 14 Segment tester PCB.
    [LCD 14 Segment Tester.kicad_pcb]
2025-03-15 Cleaned up LCD 14 Segment Display.
    [LCD 14 Segment Tester-B_Cu.gbl, LCD 14 Segment Tester-B_Mask.gbs, LCD 14 Segment Tester-B_Paste.gbp, LCD 14 Segment Tester-B_Silkscreen.gbo, LCD 14 Segment Tester-Edge_Cuts.gm1, LCD 14 Segment Tester-F_Cu.gtl, LCD 14 Segment Tester-F_Mask.gts, LCD 14 Segment Tester-F_Paste.gtp]
2025-03-15 Added DIP switches to test LCD boards.
    [LCD 14 Segment Tester-B_Cu.gbl, LCD 14 Segment Tester-B_Mask.gbs, LCD 14 Segment Tester-B_Paste.gbp, LCD 14 Segment Tester-B_Silkscreen.gbo, LCD 14 Segment Tester-Edge_Cuts.gm1, LCD 14 Segment Tester-F_Cu.gtl, LCD 14 Segment Tester-F_Mask.gts, LCD 14 Segment Tester-F_Paste.gtp]
2025-03-16 Updated DIP to TSSOP adapter model.
    [LCD Dual 7 Segment Tester.kicad_pcb]
2025-03-19 Added more debug points to the Processor Board.
    [Processor Board-B_Cu.gbl, Processor Board-B_Mask.gbs, Processor Board-B_Silkscreen.gbo, Processor Board-Edge_Cuts.gm1, Processor Board-F_Cu.gtl, Processor Board-F_Mask.gts, Processor Board-F_Silkscreen.gto, Processor Board-NPTH.drl]
2025-03-19 Bit more clean up on the Processor Board.
    [Processor Board-B_Cu.gbl, Processor Board-B_Mask.gbs, Processor Board-B_Silkscreen.gbo, Processor Board-Edge_Cuts.gm1, Processor Board-F_Cu.gtl, Processor Board-F_Mask.gts, Processor Board-F_Silkscreen.gto, Processor Board-NPTH.drl]
2025-03-20 Moved and labeled Mainboard Small pull resistors.
    [Mainboard Small.kicad_pcb]
2025-03-20 Nothing in particular. Just curious how generating the exact same Gerbers would differ.
    [Processor Board-B_Cu.gbl, Processor Board-B_Mask.gbs, Processor Board-B_Silkscreen.gbo, Processor Board-Edge_Cuts.gm1, Processor Board-F_Cu.gtl, Processor Board-F_Mask.gts, Processor Board-F_Silkscreen.gto, Processor Board-NPTH.drl]
2025-04-21 Bunch of stuff I forgot to commit. Basically re-doing the PICO programmer / analyser.
    [GPIO Address Decode.kicad_pcb, GPIO Address Decode.kicad_sch, Pico GPIO Address Decode.step, Pico Wide GPIO Connect.kicad_pcb, Pico Wide GPIO Connect.kicad_sch, Pico Wide GPIO.kicad_pcb, Pico Wide GPIO.kicad_sch, Pico.kicad_pcb]
2025-04-21 Updated PICO GPIO Address Decode.
    [GPIO Address Decode-B_Cu.gbl, GPIO Address Decode-B_Mask.gbs, GPIO Address Decode-B_Paste.gbp, GPIO Address Decode-B_Silkscreen.gbo, GPIO Address Decode-Edge_Cuts.gm1, GPIO Address Decode-F_Cu.gtl, GPIO Address Decode-F_Mask.gts, GPIO Address Decode-F_Paste.gtp]
2025-04-23 Power and Reset board.
    [Pico Debugger.kicad_pcb, Pico Wide GPIO.kicad_pcb, Pico Wide GPIO.kicad_sch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]
2025-04-24 Removed GPIO filtering and rounded traces.
    [GPIO 16bit-B_Cu.gbl, GPIO 16bit-B_Mask.gbs, GPIO 16bit-B_Paste.gbp, GPIO 16bit-B_Silkscreen.gbo, GPIO 16bit-Edge_Cuts.gm1, GPIO 16bit-F_Cu.gtl, GPIO 16bit-F_Mask.gts, GPIO 16bit-F_Paste.gtp]
2025-04-24 Routed a 32bit GPIO Board.
    [GPIO 32bit Board.kicad_pcb, GPIO 32bit Board.kicad_sch]
2025-04-24 Updated Processor Board LD1117.
    [Processor Board.kicad_sch]
2025-04-24 Routed a Signal Protection Board.
    [Signal Protection.kicad_pcb, Signal Protection.kicad_sch]
2025-04-26 Signal Protection and GPIO Power Switch.
    [GPIO 32bit Board.kicad_pcb, GPIO 32bit Board.kicad_sch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]
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2025-04-26 Autorouted GPIO Controller Board.
    [GPIO Controller Board.kicad_pcb]
2025-04-26 Autorouted GPIO 32bit Board.
    [GPIO 32bit Board.kicad_pcb]
2025-04-27 Cleaned up GPIO Controller Board.
    [GPIO Controller Board-B_Cu.gbl, GPIO Controller Board-B_Mask.gbs, GPIO Controller Board-B_Silkscreen.gbo, GPIO Controller Board-Edge_Cuts.gm1, GPIO Controller Board-F_Cu.gtl, GPIO Controller Board-F_Mask.gts, GPIO Controller Board-F_Silkscreen.gto, GPIO Controller Board-NPTH.drl]
2025-04-27 Cleaned up GPIO 32bit Board.
    [GPIO 32bit Board-B_Cu.gbl, GPIO 32bit Board-B_Mask.gbs, GPIO 32bit Board-B_Silkscreen.gbo, GPIO 32bit Board-Edge_Cuts.gm1, GPIO 32bit Board-F_Cu.gtl, GPIO 32bit Board-F_Mask.gts, GPIO 32bit Board-F_Silkscreen.gto, GPIO 32bit Board-NPTH.drl]
2025-04-27 Added GPIO Backplan Board.
    [GPIO Backplane Board.kicad_pcb, GPIO Backplane Board.kicad_sch]
2025-04-27 Autorouted the GPIO Backplane Board.
    [GPIO Backplane Board.kicad_pcb]
2025-04-27 Unrouted the GPIO Backplane Board.
    [GPIO Backplane Board.kicad_pcb, GPIO Backplane Board.kicad_sch]
2025-04-27 Reautorouted the GPIO Backplane Board.
    [GPIO Backplane Board.kicad_pcb]
2025-04-27 Cleaned up GPIO Backplane.
    [GPIO Backplane Board-B_Cu.gbl, GPIO Backplane Board-B_Mask.gbs, GPIO Backplane Board-B_Silkscreen.gbo, GPIO Backplane Board-Edge_Cuts.gm1, GPIO Backplane Board-F_Cu.gtl, GPIO Backplane Board-F_Mask.gts, GPIO Backplane Board-F_Silkscreen.gto, GPIO Backplane Board-NPTH.drl]
2025-04-27 Fixed Signal Protection order on 32bit board.
    [GPIO 16bit-B_Cu.gbl, GPIO 16bit-B_Mask.gbs, GPIO 16bit-B_Paste.gbp, GPIO 16bit-B_Silkscreen.gbo, GPIO 16bit-Edge_Cuts.gm1, GPIO 16bit-F_Cu.gtl, GPIO 16bit-F_Mask.gts, GPIO 16bit-F_Paste.gtp]
2025-04-28 Cleaned up a bunch of boards.
    [GPIO Backplane Board-B_Cu.gbl, GPIO Backplane Board-B_Mask.gbs, GPIO Backplane Board-B_Silkscreen.gbo, GPIO Backplane Board-Edge_Cuts.gm1, GPIO Backplane Board-F_Cu.gtl, GPIO Backplane Board-F_Mask.gts, GPIO Backplane Board-F_Silkscreen.gto, GPIO Backplane Board-NPTH.drl]
2025-04-28 Lots of random stuff.
    [GPIO 4bit-B_Cu.gbl, GPIO 4bit-B_Mask.gbs, GPIO 4bit-B_Paste.gbp, GPIO 4bit-B_Silkscreen.gbo, GPIO 4bit-Edge_Cuts.gm1, GPIO 4bit-F_Cu.gtl, GPIO 4bit-F_Mask.gts, GPIO 4bit-F_Paste.gtp]
2025-05-06 I think I mostly fixed the GPIO Power Switch.
    [Blitter Board-B_Cu.gbl, Blitter Board-B_Mask.gbs, Blitter Board-B_Silkscreen.gbo, Blitter Board-Edge_Cuts.gm1, Blitter Board-F_Cu.gtl, Blitter Board-F_Mask.gts, Blitter Board-F_Silkscreen.gto, Blitter Board-NPTH.drl]
2025-05-06 Cleaned up Clock Hold Standard.
    [Blitter Board.kicad_pcb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]
2025-05-06 Cleaned up a lot of silkscreens.
    [Audio Board.kicad_pcb, Audio Board.kicad_sch, Audio Clock.kicad_sch, PS2 Board.kicad_pcb, PS2 Board.kicad_sch, UART Board.kicad_pcb, UART Board.kicad_sch]
2025-05-15 Moved SD Card sockets.
    [SD Card Board-B_Cu.gbl, SD Card Board-B_Mask.gbs, SD Card Board-B_Silkscreen.gbo, SD Card Board-Edge_Cuts.gm1, SD Card Board-F_Cu.gtl, SD Card Board-F_Mask.gts, SD Card Board-F_Silkscreen.gto, SD Card Board-NPTH.drl]
2025-05-22 I don't remember what I did.
    [GPIO 32bit Board-B_Cu.gbl, GPIO 32bit Board-B_Mask.gbs, GPIO 32bit Board-B_Silkscreen.gbo, GPIO 32bit Board-Edge_Cuts.gm1, GPIO 32bit Board-F_Cu.gtl, GPIO 32bit Board-F_Mask.gts, GPIO 32bit Board-F_Silkscreen.gto, GPIO 32bit Board-NPTH.drl]
2025-05-24 Flipped pins in 4x RJ45 connector.
    [GPIO 32bit Board-B_Cu.gbl, GPIO 32bit Board-B_Mask.gbs, GPIO 32bit Board-B_Silkscreen.gbo, GPIO 32bit Board-Edge_Cuts.gm1, GPIO 32bit Board-F_Cu.gtl, GPIO 32bit Board-F_Mask.gts, GPIO 32bit Board-F_Silkscreen.gto, GPIO 32bit Board-NPTH.drl]
2025-05-26 Added filtering to the GPIO Address Decode board.
    [Blitter Board-B_Cu.gbl, Blitter Board-B_Mask.gbs, Blitter Board-B_Silkscreen.gbo, Blitter Board-Edge_Cuts.gm1, Blitter Board-F_Cu.gtl, Blitter Board-F_Mask.gts, Blitter Board-F_Silkscreen.gto, Blitter Board-NPTH.drl]
2025-06-05 Cleaned up the Video DAC slightly.
    [Video DAC-B_Cu.gbl, Video DAC-B_Mask.gbs, Video DAC-B_Paste.gbp, Video DAC-B_Silkscreen.gbo, Video DAC-Edge_Cuts.gm1, Video DAC-F_Cu.gtl, Video DAC-F_Mask.gts, Video DAC-F_Paste.gtp]
2025-06-08 Fixed some board exclusion messages.
    [Processor Board.kicad_sch]
2025-06-08 Converted GPIO Backplane board to Kicad 9.0
    [GPIO 32bit Board.kicad_pcb, GPIO 32bit Board.kicad_sch, GPIO Address Decode.kicad_pcb, GPIO Address Decode.kicad_sch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]
2025-06-08 Converted all GPIO boards to Kicad 9.0
    [GPIO 32bit Board.kicad_pcb, GPIO 32bit Board.kicad_sch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]
2025-06-08 Converted Programmers to Kicad 9.0
    [EPM570 Programmer.kicad_pcb, EPM570 Programmer.kicad_sch, EPM7032S Programmer.kicad_pcb, EPM7032S Programmer.kicad_sch, EPM7160S Programmer.kicad_pcb, EPM7160S Programmer.kicad_sch, Keypad.kicad_pcb, Keypad.kicad_sch]
2025-06-15 Added a simple W65C816 Coprocessor board.
    [HCP65 Coprocessor-B_Cu.gbl, HCP65 Coprocessor-B_Mask.gbs, HCP65 Coprocessor-B_Paste.gbp, HCP65 Coprocessor-B_Silkscreen.gbo, HCP65 Coprocessor-Edge_Cuts.gm1, HCP65 Coprocessor-F_Cu.gtl, HCP65 Coprocessor-F_Mask.gts, HCP65 Coprocessor-F_Paste.gtp]
2025-06-15 Converted Processor Board to Kicad 9.0
    [HCP65 MPU Memory.kicad_pcb, HCP65 MPU Memory.kicad_sch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]
2025-06-15 Added a Coprocessor Memory board.
    [HCP65 Coprocessor Memory-B_Cu.gbl, HCP65 Coprocessor Memory-B_Mask.gbs, HCP65 Coprocessor Memory-B_Paste.gbp, HCP65 Coprocessor Memory-B_Silkscreen.gbo, HCP65 Coprocessor Memory-Edge_Cuts.gm1, HCP65 Coprocessor Memory-F_Cu.gtl, HCP65 Coprocessor Memory-F_Mask.gts, HCP65 Coprocessor Memory-F_Paste.gtp]
2025-06-16 Renamed Coprocessor Memory board to Memory 1MB.
    [HCP65 Coprocessor Memory-B_Cu.gbl, HCP65 Coprocessor Memory-B_Mask.gbs, HCP65 Coprocessor Memory-B_Paste.gbp, HCP65 Coprocessor Memory-B_Silkscreen.gbo, HCP65 Coprocessor Memory-Edge_Cuts.gm1, HCP65 Coprocessor Memory-F_Cu.gtl, HCP65 Coprocessor Memory-F_Mask.gts, HCP65 Coprocessor Memory-F_Paste.gtp]
2025-06-16 Cleaned up Memory 4MB routing.
    [Memory 4MB-B_Cu.gbl, Memory 4MB-B_Mask.gbs, Memory 4MB-B_Paste.gbp, Memory 4MB-B_Silkscreen.gbo, Memory 4MB-Edge_Cuts.gm1, Memory 4MB-F_Cu.gtl, Memory 4MB-F_Mask.gts, Memory 4MB-F_Paste.gtp]
2025-06-16 Renamed Coprocessor board to W65C816 Minimal.
    [W65C816 Minimal-B_Cu.gbl, W65C816 Minimal-B_Mask.gbs, W65C816 Minimal-B_Paste.gbp, W65C816 Minimal-B_Silkscreen.gbo, W65C816 Minimal-Edge_Cuts.gm1, W65C816 Minimal-F_Cu.gtl, W65C816 Minimal-F_Mask.gts, W65C816 Minimal-F_Paste.gtp]
2025-06-16 Added W65C816 Minimal and Memory 1MB symbols and footrpints.
    [HCP65 Coprocessor-B_Cu.gbl, HCP65 Coprocessor-B_Mask.gbs, HCP65 Coprocessor-B_Paste.gbp, HCP65 Coprocessor-B_Silkscreen.gbo, HCP65 Coprocessor-Edge_Cuts.gm1, HCP65 Coprocessor-F_Cu.gtl, HCP65 Coprocessor-F_Mask.gts, HCP65 Coprocessor-F_Paste.gtp]
2025-06-16 Fixed 3D model directories.
    [SD Card Board-B_Cu.gbl, SD Card Board-B_Mask.gbs, SD Card Board-B_Silkscreen.gbo, SD Card Board-Edge_Cuts.gm1, SD Card Board-F_Cu.gtl, SD Card Board-F_Mask.gts, SD Card Board-F_Silkscreen.gto, SD Card Board-NPTH.drl]
2025-06-16 Added Coprocessor Board and shrunk W65C816 Latch.
    [Coprocessor Board.kicad_pcb, Coprocessor Board.kicad_sch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]
2025-06-17 Lots and lots of Coprocessor boards,
    [Coprocessor Board - Additional.kicad_pcb, Coprocessor Board - Additional.kicad_sch, Coprocessor Board - Main.kicad_pcb, Coprocessor Board - Main.kicad_sch, Coprocessor Board.kicad_pcb, Coprocessor Board.kicad_sch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]
2025-06-17 Assembly tests or something.
    [Test65816.obj, TestArithmetic.obj, main.obj]
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2025-06-18 Auto routed Coprocessor Board - Additional.
    [Coprocessor Board - Additional.kicad_pcb, Coprocessor Board - Additional.kicad_sch, freerouting.dsn]
2025-06-18 Manually routing Coprocessor Board - Additional.
    [Coprocessor Board - Additional.kicad_pcb]
2025-06-18 Auto routed Coprocessor Board - Main.
    [Coprocessor Board - Main.kicad_pcb, freerouting.dsn]
2025-06-18 Added coloured busses to Coprocessor Boards.
    [Coprocessor Board - Additional.kicad_sch, Coprocessor Board - Main.kicad_sch]
2025-06-18 Un-routed Coprocessor Board - Main.
    [Coprocessor Board - Main.kicad_pcb, Coprocessor Board - Main.kicad_sch]
2025-06-18 Un-routed Coprocessor Board - Additional.
    [Coprocessor Board - Additional.kicad_pcb]
2025-06-19 Split some Processor Board sub boards into multiple parts.
    [Coprocessor Board - Additional.kicad_pcb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]
2025-06-19 Nicenend up the Coprocessor Board - Main a bit.
    [Coprocessor Board - Main.kicad_pcb, Coprocessor Board - Main.kicad_sch]
2025-06-19 Manually routed the Coprocessor Board - Main.
    [Coprocessor Board - Main.kicad_pcb]
2025-06-20 Ray traced the Coprocessor Board - Main.
    [Coprocessor Board - Main.kicad_pcb]
2025-06-20 Generated Coprocessor Board - Main Gerbers.
    [Coprocessor Board - Main-B_Cu.gbl, Coprocessor Board - Main-B_Mask.gbs, Coprocessor Board - Main-B_Silkscreen.gbo, Coprocessor Board - Main-Edge_Cuts.gm1, Coprocessor Board - Main-F_Cu.gtl, Coprocessor Board - Main-F_Mask.gts, Coprocessor Board - Main-F_Silkscreen.gto, Coprocessor Board - Main-NPTH.drl]
2025-06-20 Converted Device Decode Stage A and B to Kicad 9.0
    [Coprocessor Board - Main.kicad_sch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]
2025-06-20 Manually routed the Coprocessor Board - Additional.
    [Coprocessor Board - Additional.kicad_pcb, Coprocessor Board - Main.kicad_sch, Coprocessor Memory Select.kicad_sch]
2025-06-21 Added Coprocessor Board interconnection silkscreens.
    [Coprocessor Board - Additional-B_Cu.gbl, Coprocessor Board - Additional-B_Mask.gbs, Coprocessor Board - Additional-B_Silkscreen.gbo, Coprocessor Board - Additional-Edge_Cuts.gm1, Coprocessor Board - Additional-F_Cu.gtl, Coprocessor Board - Additional-F_Mask.gts, Coprocessor Board - Additional-F_Silkscreen.gto, Coprocessor Board - Additional-NPTH.drl]
2025-06-25 Re-did Mainboard power supply.
    [Mainboard Small-B_Cu.gbl, Mainboard Small-B_Mask.gbs, Mainboard Small-B_Silkscreen.gbo, Mainboard Small-Edge_Cuts.gm1, Mainboard Small-F_Cu.gtl, Mainboard Small-F_Mask.gts, Mainboard Small-F_Silkscreen.gto, Mainboard Small-NPTH.drl]
2025-06-25 Converted Processor Board to Kicad 9.0 (again).
    [Processor Board.kicad_pcb, Processor Board.kicad_sch]
2025-06-25 Cleaned up the Processor Board PCB even more.
    [Processor Board-B_Cu.gbl, Processor Board-B_Mask.gbs, Processor Board-B_Silkscreen.gbo, Processor Board-Edge_Cuts.gm1, Processor Board-F_Cu.gtl, Processor Board-F_Mask.gts, Processor Board-F_Silkscreen.gto, Processor Board-NPTH.drl]
2025-06-25 Converted W65C816 Clock Hold to Kicad 9.0.
    [W65C816 Clock Hold-B_Cu.gbl, W65C816 Clock Hold-B_Mask.gbs, W65C816 Clock Hold-B_Paste.gbp, W65C816 Clock Hold-B_Silkscreen.gbo, W65C816 Clock Hold-Edge_Cuts.gm1, W65C816 Clock Hold-F_Cu.gtl, W65C816 Clock Hold-F_Mask.gts, W65C816 Clock Hold-F_Paste.gtp]
2025-06-25 Converted W65C816 Debug Display to Kicad 9.0.
    [LED Display.kicad_sch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]
2025-06-26 Converted W65C816 Opcode Display to Kicad 9.0.
    [LED 14 Display.kicad_sch, LED Display.kicad_sch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]
2025-06-26 Converted HCP65 Single MPU Board to Kicad 9.0.
    [HCP65 Single MPU Board.kicad_pcb, HCP65 Single MPU Board.kicad_sch]
2025-06-26 Converted HCP65 Processor Boards to Kicad 9.0.
    [HCP65 Device Interrupts-B_Cu.gbl, HCP65 Device Interrupts-B_Mask.gbs, HCP65 Device Interrupts-B_Paste.gbp, HCP65 Device Interrupts-B_Silkscreen.gbo, HCP65 Device Interrupts-Edge_Cuts.gm1, HCP65 Device Interrupts-F_Cu.gtl, HCP65 Device Interrupts-F_Mask.gts, HCP65 Device Interrupts-F_Paste.gtp]
2025-06-26 Converted HCP65 LCD Boards to Kicad 9.0.
    [LCD Board-B_Cu.gbl, LCD Board-B_Mask.gbs, LCD Board-B_Silkscreen.gbo, LCD Board-Edge_Cuts.gm1, LCD Board-F_Cu.gtl, LCD Board-F_Mask.gts, LCD Board-F_Silkscreen.gto, LCD Board-NPTH.drl]
2025-06-27 Renamed HCP65 Power to W65C816 Power.
    [GPIO Backplane Board-B_Cu.gbl, GPIO Backplane Board-B_Mask.gbs, GPIO Backplane Board-B_Silkscreen.gbo, GPIO Backplane Board-Edge_Cuts.gm1, GPIO Backplane Board-F_Cu.gtl, GPIO Backplane Board-F_Mask.gts, GPIO Backplane Board-F_Silkscreen.gto, GPIO Backplane Board-NPTH.drl]
2025-06-27 Added RAM 48K Select.
    [RAM 48K Select-B_Cu.gbl, RAM 48K Select-B_Mask.gbs, RAM 48K Select-B_Paste.gbp, RAM 48K Select-B_Silkscreen.gbo, RAM 48K Select-Edge_Cuts.gm1, RAM 48K Select-F_Cu.gtl, RAM 48K Select-F_Mask.gts, RAM 48K Select-F_Paste.gtp]
2025-06-27 Re-routed RAM 48K Select.
    [RAM 48K Select-B_Cu.gbl, RAM 48K Select-B_Mask.gbs, RAM 48K Select-B_Paste.gbp, RAM 48K Select-B_Silkscreen.gbo, RAM 48K Select-Edge_Cuts.gm1, RAM 48K Select-F_Cu.gtl, RAM 48K Select-F_Mask.gts, RAM 48K Select-F_Paste.gtp]
2025-06-27 Converted LCD testers to Kicad 9.0.
    [LCD 14 Segment Tester-B_Cu.gbl, LCD 14 Segment Tester-B_Mask.gbs, LCD 14 Segment Tester-B_Paste.gbp, LCD 14 Segment Tester-B_Silkscreen.gbo, LCD 14 Segment Tester-Edge_Cuts.gm1, LCD 14 Segment Tester-F_Cu.gtl, LCD 14 Segment Tester-F_Mask.gts, LCD 14 Segment Tester-F_Paste.gtp]
2025-06-27 Converted a whole lot of boards to Kicad 9.0
    [Address Buffer 16bit-B_Cu.gbl, Address Buffer 16bit-B_Mask.gbs, Address Buffer 16bit-B_Paste.gbp, Address Buffer 16bit-B_Silkscreen.gbo, Address Buffer 16bit-Edge_Cuts.gm1, Address Buffer 16bit-F_Cu.gtl, Address Buffer 16bit-F_Mask.gts, Address Buffer 16bit-F_Paste.gtp]
2025-06-27 Converted PS2 boards to Kicad 9.0.
    [Device Decode stage B-B_Cu.gbl, Device Decode stage B-B_Mask.gbs, Device Decode stage B-B_Paste.gbp, Device Decode stage B-B_Silkscreen.gbo, Device Decode stage B-Edge_Cuts.gm1, Device Decode stage B-F_Cu.gtl, Device Decode stage B-F_Mask.gts, Device Decode stage B-F_Paste.gtp]
2025-07-03 Converted Triple Clock Generator to Kicad 9.0.
    [Triple MPU Clock Generator-B_Cu.gbl, Triple MPU Clock Generator-B_Mask.gbs, Triple MPU Clock Generator-B_Paste.gbp, Triple MPU Clock Generator-B_Silkscreen.gbo, Triple MPU Clock Generator-Edge_Cuts.gm1, Triple MPU Clock Generator-F_Cu.gtl, Triple MPU Clock Generator-F_Mask.gts, Triple MPU Clock Generator-F_Paste.gtp]
2025-07-03 Converted Quad Clock Generator to Kicad 9.0.
    [Quad MPU Clock Generator-B_Cu.gbl, Quad MPU Clock Generator-B_Mask.gbs, Quad MPU Clock Generator-B_Paste.gbp, Quad MPU Clock Generator-B_Silkscreen.gbo, Quad MPU Clock Generator-Edge_Cuts.gm1, Quad MPU Clock Generator-F_Cu.gtl, Quad MPU Clock Generator-F_Mask.gts, Quad MPU Clock Generator-F_Paste.gtp]
2025-07-03 Converted Main Memory Select to Kicad 9.0.
    [Main Memory Select-B_Cu.gbl, Main Memory Select-B_Mask.gbs, Main Memory Select-B_Paste.gbp, Main Memory Select-B_Silkscreen.gbo, Main Memory Select-Edge_Cuts.gm1, Main Memory Select-F_Cu.gtl, Main Memory Select-F_Mask.gts, Main Memory Select-F_Paste.gtp]
2025-07-03 Converted Main Memory Enable to Kicad 9.0.
    [Main Memory Enable-B_Cu.gbl, Main Memory Enable-B_Mask.gbs, Main Memory Enable-B_Paste.gbp, Main Memory Enable-B_Silkscreen.gbo, Main Memory Enable-Edge_Cuts.gm1, Main Memory Enable-F_Cu.gtl, Main Memory Enable-F_Mask.gts, Main Memory Enable-F_Paste.gtp]
2025-07-03 Converted Main Memory Channel to Kicad 9.0.
    [Main Memory Channel-B_Cu.gbl, Main Memory Channel-B_Mask.gbs, Main Memory Channel-B_Paste.gbp, Main Memory Channel-B_Silkscreen.gbo, Main Memory Channel-Edge_Cuts.gm1, Main Memory Channel-F_Cu.gtl, Main Memory Channel-F_Mask.gts, Main Memory Channel-F_Paste.gtp]
2025-07-03 Converted Main Memory Abort to Kicad 9.0.
    [Main Memory Abort-B_Cu.gbl, Main Memory Abort-B_Mask.gbs, Main Memory Abort-B_Paste.gbp, Main Memory Abort-B_Silkscreen.gbo, Main Memory Abort-Edge_Cuts.gm1, Main Memory Abort-F_Cu.gtl, Main Memory Abort-F_Mask.gts, Main Memory Abort-F_Paste.gtp]
2025-07-06 Fixed quad RJ45 connector footprint and Signal Protection symbol.
    [Default Board.kicad_pcb, Default Board.kicad_sch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]
2025-07-14 Used 3W Zener diodes for signal protection.
    [GPIO 32bit Board.kicad_pcb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]
2025-07-18 Converted GPIO 16bit to Kicad 9.0.
    [GPIO 16bit.kicad_pcb, GPIO 16bit.kicad_sch, HCP65 Device Reset.kicad_sch]
2025-08-17 40 Pin component tester schematic.
    [Blitter Board.kicad_sch, Counter 16bit with IO.kicad_sch, HCP65 40 Pin Tester.kicad_pcb, HCP65 40 Pin Tester.kicad_sch, HCP65 Device Reset.kicad_pcb, HCP65 Device Reset.kicad_sch, HCP65 Single MPU Board.kicad_pcb, Selector 1-of-4 4bit with Input.kicad_sch]
2025-08-17 40 Pin component tester PCB.
    [HCP65 40 Pin Tester.kicad_pcb, HCP65 40 Pin Tester.kicad_sch]
2025-08-18 40 Pin component tester PCB redo.
    [HCP65 40 Pin Tester.kicad_pcb]
2025-08-18 Auto-routed 40 Pin component tester PCB.
    [HCP65 40 Pin Tester.kicad_pcb]
2025-08-18 56 Pin component tester schematic.
    [HCP65 56 Pin Tester.kicad_pcb, HCP65 56 Pin Tester.kicad_sch]
2025-08-19 Auto-routed 56 Pin component tester PCB.
    [HCP65 56 Pin Tester.kicad_pcb]
2025-08-19 36 Pin component tester schematic.
    [HCP65 32 Pin Tester.kicad_pcb, HCP65 32 Pin Tester.kicad_sch, HCP65 40 Pin Tester.kicad_pcb]
2025-08-19 Auto-routed 32 Pin component tester PCB.
    [HCP65 32 Pin Tester.kicad_pcb]
2025-08-19 Auto-routed 24 Pin component tester PCB.
    [HCP65 24 Pin Tester.kicad_pcb, HCP65 24 Pin Tester.kicad_sch]
2025-08-19 Manually routing the 40pin Tester.
    [HCP65 40 Pin Tester.kicad_pcb, HCP65 56 Pin Tester.kicad_pcb]
2025-08-20 64 Pin component tester schematic.
    [HCP65 64 Pin Tester.kicad_pcb, HCP65 64 Pin Tester.kicad_sch]
2025-08-20 Failed to Auto-route 64 Pin component tester PCB.
    [HCP65 64 Pin Tester.kicad_pcb]
2025-08-20 Manually routing the 56pin Tester.
    [HCP65 56 Pin Tester.kicad_pcb, HCP65 56 Pin Tester.kicad_sch]
2025-08-21 Un-routed the 64pin Tester.
    [HCP65 24 Pin Tester.kicad_pcb, HCP65 24 Pin Tester.kicad_sch, HCP65 64 Pin Tester.kicad_pcb, HCP65 64 Pin Tester.kicad_sch]
2025-08-21 Auto-routed the 64pin Tester.
    [HCP65 64 Pin Tester.kicad_pcb]
2025-08-21 Generated Gerbers for 24pin Tester.
    [HCP65 24 Pin Tester-B_Cu.gbl, HCP65 24 Pin Tester-B_Mask.gbs, HCP65 24 Pin Tester-B_Silkscreen.gbo, HCP65 24 Pin Tester-Edge_Cuts.gm1, HCP65 24 Pin Tester-F_Cu.gtl, HCP65 24 Pin Tester-F_Mask.gts, HCP65 24 Pin Tester-F_Silkscreen.gto, HCP65 24 Pin Tester-NPTH.drl]
2025-08-21 Generated Gerbers for 32pin Tester.
    [HCP65 32 Pin Tester-B_Cu.gbl, HCP65 32 Pin Tester-B_Mask.gbs, HCP65 32 Pin Tester-B_Silkscreen.gbo, HCP65 32 Pin Tester-Edge_Cuts.gm1, HCP65 32 Pin Tester-F_Cu.gtl, HCP65 32 Pin Tester-F_Mask.gts, HCP65 32 Pin Tester-F_Silkscreen.gto, HCP65 32 Pin Tester-NPTH.drl]
2025-08-21 Generated Gerbers for 40pin Tester.
    [HCP65 40 Pin Tester-B_Cu.gbl, HCP65 40 Pin Tester-B_Mask.gbs, HCP65 40 Pin Tester-B_Silkscreen.gbo, HCP65 40 Pin Tester-Edge_Cuts.gm1, HCP65 40 Pin Tester-F_Cu.gtl, HCP65 40 Pin Tester-F_Mask.gts, HCP65 40 Pin Tester-F_Silkscreen.gto, HCP65 40 Pin Tester-NPTH.drl]
2025-08-21 Generated Gerbers for 56pin Tester.
    [HCP65 24 Pin Tester-B_Cu.gbl, HCP65 24 Pin Tester-B_Mask.gbs, HCP65 24 Pin Tester-B_Silkscreen.gbo, HCP65 24 Pin Tester-Edge_Cuts.gm1, HCP65 24 Pin Tester-F_Cu.gtl, HCP65 24 Pin Tester-F_Mask.gts, HCP65 24 Pin Tester-F_Silkscreen.gto, HCP65 24 Pin Tester-NPTH.drl]
2025-08-22 Manually routing the 64pin Tester.
    [HCP65 64 Pin Tester-B_Cu.gbl, HCP65 64 Pin Tester-B_Mask.gbs, HCP65 64 Pin Tester-B_Silkscreen.gbo, HCP65 64 Pin Tester-Edge_Cuts.gm1, HCP65 64 Pin Tester-F_Cu.gtl, HCP65 64 Pin Tester-F_Mask.gts, HCP65 64 Pin Tester-F_Silkscreen.gto, HCP65 64 Pin Tester-NPTH.drl]
2025-08-22 Renamed HCP65 24 Pin Tester.
    [HCP65 24 Pin Tester-B_Cu.gbl, HCP65 24 Pin Tester-B_Mask.gbs, HCP65 24 Pin Tester-B_Silkscreen.gbo, HCP65 24 Pin Tester-Edge_Cuts.gm1, HCP65 24 Pin Tester-F_Cu.gtl, HCP65 24 Pin Tester-F_Mask.gts, HCP65 24 Pin Tester-F_Silkscreen.gto, HCP65 24 Pin Tester-NPTH.drl]
2025-08-22 Upgraded to Kicad 9.0.
    [Graphics Board.kicad_pcb, Graphics Board.kicad_sch]
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2025-08-22 Changed the Graphics Board adder from 16 to 24bits.
    [Graphics Board-B_Cu.gbl, Graphics Board-B_Mask.gbs, Graphics Board-B_Silkscreen.gbo, Graphics Board-Edge_Cuts.gm1, Graphics Board-F_Cu.gtl, Graphics Board-F_Mask.gts, Graphics Board-F_Silkscreen.gto, Graphics Board-NPTH.drl]
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2025-08-27 Added board alignment silk screen to 24- 32- and 40 pin tester boards.
    [HCP65 24 Pin Tester-B_Cu.gbl, HCP65 24 Pin Tester-B_Mask.gbs, HCP65 24 Pin Tester-B_Silkscreen.gbo, HCP65 24 Pin Tester-Edge_Cuts.gm1, HCP65 24 Pin Tester-F_Cu.gtl, HCP65 24 Pin Tester-F_Mask.gts, HCP65 24 Pin Tester-F_Silkscreen.gto, HCP65 24 Pin Tester-NPTH.drl]
2025-08-27 Added board alignment silk screen to 56- and 64 pin tester boards.
    [HCP65 56 Pin Tester-B_Cu.gbl, HCP65 56 Pin Tester-B_Mask.gbs, HCP65 56 Pin Tester-B_Silkscreen.gbo, HCP65 56 Pin Tester-Edge_Cuts.gm1, HCP65 56 Pin Tester-F_Cu.gtl, HCP65 56 Pin Tester-F_Mask.gts, HCP65 56 Pin Tester-F_Silkscreen.gto, HCP65 56 Pin Tester-NPTH.drl]
2025-09-04 Fixed MPU Address Decode.
    [DeviceDecode.circ, HCP65 MPU Address Decode.kicad_pcb, HCP65 MPU Address Decode.kicad_sch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]
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2025-09-12 Stop USB 5V from powering the whole device.
    [GPIO Controller Board-B_Cu.gbl, GPIO Controller Board-B_Mask.gbs, GPIO Controller Board-B_Silkscreen.gbo, GPIO Controller Board-Edge_Cuts.gm1, GPIO Controller Board-F_Cu.gtl, GPIO Controller Board-F_Mask.gts, GPIO Controller Board-F_Silkscreen.gto, GPIO Controller Board-NPTH.drl]
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2025-09-17 Drive failure.
    [Main Memory Small Abort-B_Cu.gbl, Main Memory Small Abort-B_Mask.gbs, Main Memory Small Abort-B_Paste.gbp, Main Memory Small Abort-B_Silkscreen.gbo, Main Memory Small Abort-Edge_Cuts.gm1, Main Memory Small Abort-F_Cu.gtl, Main Memory Small Abort-F_Mask.gts, Main Memory Small Abort-F_Paste.gtp]
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2025-09-19 Fixed RTC device silkscreen.
    [Clock Device-B_Cu.gbl, Clock Device-B_Mask.gbs, Clock Device-B_Paste.gbp, Clock Device-B_Silkscreen.gbo, Clock Device-Edge_Cuts.gm1, Clock Device-F_Cu.gtl, Clock Device-F_Mask.gts, Clock Device-F_Paste.gtp]
2025-09-19 Fixed Processor Board silkscreen.
    [Processor Full Device.kicad_pcb, Processor Full Device.kicad_sch]
2025-09-19 Fixed HCP65 footprint silkscreens.
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2025-09-19 Fixed Status device silkscreen.
    [Status Device-B_Cu.gbl, Status Device-B_Mask.gbs, Status Device-B_Paste.gbp, Status Device-B_Silkscreen.gbo, Status Device-Edge_Cuts.gm1, Status Device-F_Cu.gtl, Status Device-F_Mask.gts, Status Device-F_Paste.gtp]
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2025-09-19 Added Processor Reset Device.
    [Mainboard Full.kicad_sch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]
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2025-09-20 Renamed Main Memory Abort to Main Memory Full Abort.
    [Main Memory Abort-B_Cu.gbl, Main Memory Abort-B_Mask.gbs, Main Memory Abort-B_Paste.gbp, Main Memory Abort-B_Silkscreen.gbo, Main Memory Abort-Edge_Cuts.gm1, Main Memory Abort-F_Cu.gtl, Main Memory Abort-F_Mask.gts, Main Memory Abort-F_Paste.gtp]
2025-09-20 Renamed Main Memory Enable to Main Memory Small Enable.
    [Main Memory Enable-B_Cu.gbl, Main Memory Enable-B_Mask.gbs, Main Memory Enable-B_Paste.gbp, Main Memory Enable-B_Silkscreen.gbo, Main Memory Enable-Edge_Cuts.gm1, Main Memory Enable-F_Cu.gtl, Main Memory Enable-F_Mask.gts, Main Memory Enable-F_Paste.gtp]
2025-09-20 Added Processor Reset Device to Mainboard Small.
    [Mainboard Full.kicad_pcb, Mainboard Small.kicad_pcb, Mainboard Small.kicad_sch]
2025-09-20 Remove reset circuitry from Clock Generators.
    [Dual MPU Clock Generator.kicad_pcb, Dual MPU Clock Generator.kicad_sch, Quad MPU Clock Generator.kicad_pcb, Quad MPU Clock Generator.kicad_sch, Triple MPU Clock Generator.kicad_pcb, Triple MPU Clock Generator.kicad_sch]
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2025-09-20 Removed reset from Triple clock generator.
    [Triple MPU Clock Generator-B_Cu.gbl, Triple MPU Clock Generator-B_Mask.gbs, Triple MPU Clock Generator-B_Paste.gbp, Triple MPU Clock Generator-B_Silkscreen.gbo, Triple MPU Clock Generator-Edge_Cuts.gm1, Triple MPU Clock Generator-F_Cu.gtl, Triple MPU Clock Generator-F_Mask.gts, Triple MPU Clock Generator-F_Paste.gtp]
2025-09-20 Fixed main memory select pinout.
    [Main Memory Select-B_Cu.gbl, Main Memory Select-B_Mask.gbs, Main Memory Select-B_Paste.gbp, Main Memory Select-B_Silkscreen.gbo, Main Memory Select-Edge_Cuts.gm1, Main Memory Select-F_Cu.gtl, Main Memory Select-F_Mask.gts, Main Memory Select-F_Paste.gtp]
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2025-09-21 Added a panic button to the Mainboard Full.
    [Mainboard Full.kicad_pcb, Mainboard Full.kicad_sch, Video Board - Signals.kicad_sch]
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2025-09-21 Added a panic button to the Mainboard Small.
    [Mainboard Small.kicad_pcb, Mainboard Small.kicad_sch]
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2025-09-24 Buses and fixes on the Video Board - Memory.
    [Video Board - Memory.kicad_pcb, Video Board - Memory.kicad_sch]
2025-09-25 Added (some) buses to Video Board - Memory.
    [Device Decode stage A.kicad_sch, Video Board - Memory.kicad_pcb, Video Board - Memory.kicad_sch, Video Data Select.kicad_pcb, Video Data Select.kicad_sch, Video Row Latch.kicad_sch]
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2025-10-01 Added stabilisation pins to the Opcode Display board.
    [Processor Board.kicad_pcb, Processor Board.kicad_sch, W65C816 Debug Display.kicad_pcb, W65C816 Debug Display.kicad_sch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]
2025-10-01 Added more silkscreen to the Debug Display board.
    [W65C816 Debug Display-B_Cu.gbl, W65C816 Debug Display-B_Mask.gbs, W65C816 Debug Display-B_Paste.gbp, W65C816 Debug Display-B_Silkscreen.gbo, W65C816 Debug Display-Edge_Cuts.gm1, W65C816 Debug Display-F_Cu.gtl, W65C816 Debug Display-F_Mask.gts, W65C816 Debug Display-F_Paste.gtp]
2025-10-04 Swapped Mainboard Full device socket positions.
    [DivideBy3Clock.circ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]
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2025-10-08 Waiting for reverse references to generate.
    [Address Decode Board.kicad_sch, Address Decode.kicad_pcb, Address Decode.kicad_sch, Address Position.kicad_sch, Async FIFO Write.kicad_pcb, Async FIFO Write.kicad_sch, Asyncronous Write FIFO.kicad_sch, Asyncronous Write PHI2 Hold.kicad_sch]
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2025-10-11 Fixing up Graphics Main access.
    [Blitter Board.kicad_pcb, Blitter Board.kicad_sch, Graphics Board.kicad_pcb, Graphics Board.kicad_sch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]
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2025-10-24 Fixed a clearance violation.
    [HCP65 56 Pin Tester-B_Cu.gbl, HCP65 56 Pin Tester-B_Mask.gbs, HCP65 56 Pin Tester-B_Silkscreen.gbo, HCP65 56 Pin Tester-Edge_Cuts.gm1, HCP65 56 Pin Tester-F_Cu.gtl, HCP65 56 Pin Tester-F_Mask.gts, HCP65 56 Pin Tester-F_Silkscreen.gto, HCP65 56 Pin Tester-NPTH.drl]
2025-10-24 Fixed another clearance violation
    [Clearance Bug.kicad_pcb, Clearance Bug.kicad_sch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]
2025-10-26 Clearance Bug.
    [Clearance Bug.kicad_pcb]
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2025-11-14 Added a bunch of notes and routed the Kernal Mode flip-flop.
    [HCP65 Kernal Mode.kicad_pcb, HCP65 Kernal Mode.kicad_sch, HCP65 MPU Address Decode.kicad_pcb, HCP65 MPU Address Decode.kicad_sch, Processor Board.kicad_sch]
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2025-12-11 Minor fixes in the Video Board.
    [Blitter Board-B_Cu.gbl, Blitter Board-B_Mask.gbs, Blitter Board-B_Silkscreen.gbo, Blitter Board-Edge_Cuts.gm1, Blitter Board-F_Cu.gtl, Blitter Board-F_Mask.gts, Blitter Board-F_Silkscreen.gto, Blitter Board-NPTH.drl]
2026-01-05 Started fixing 24, 32 and 40 pin Tester Boards.
    [HCP65 24 Pin Tester.kicad_pcb, HCP65 24 Pin Tester.kicad_sch, HCP65 32 Pin Tester.kicad_pcb, HCP65 32 Pin Tester.kicad_sch, HCP65 40 Pin Tester.kicad_pcb, HCP65 40 Pin Tester.kicad_sch, HCP65 64 Pin Tester.kicad_pcb]
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2026-01-10 Fixed 56 and 64 pin Tester Boards.
    [HCP65 56 Pin Tester-B_Cu.gbl, HCP65 56 Pin Tester-B_Mask.gbs, HCP65 56 Pin Tester-B_Silkscreen.gbo, HCP65 56 Pin Tester-Edge_Cuts.gm1, HCP65 56 Pin Tester-F_Cu.gtl, HCP65 56 Pin Tester-F_Mask.gts, HCP65 56 Pin Tester-F_Silkscreen.gto, HCP65 56 Pin Tester-NPTH.drl]
2026-01-10 Fixed up GPIO Address Decode.
    [GPIO Address Decode-B_Cu.gbl, GPIO Address Decode-B_Mask.gbs, GPIO Address Decode-B_Paste.gbp, GPIO Address Decode-B_Silkscreen.gbo, GPIO Address Decode-Edge_Cuts.gm1, GPIO Address Decode-F_Cu.gtl, GPIO Address Decode-F_Mask.gts, GPIO Address Decode-F_Paste.gtp]
2026-01-11 Fixed 24pin Tester board.
    [HCP65 24 Pin Tester-B_Cu.gbl, HCP65 24 Pin Tester-B_Mask.gbs, HCP65 24 Pin Tester-B_Silkscreen.gbo, HCP65 24 Pin Tester-Edge_Cuts.gm1, HCP65 24 Pin Tester-F_Cu.gtl, HCP65 24 Pin Tester-F_Mask.gts, HCP65 24 Pin Tester-F_Silkscreen.gto, HCP65 24 Pin Tester-NPTH.drl]
2026-01-12 Fixed 32pin Tester Board.
    [HCP65 32 Pin Tester-B_Cu.gbl, HCP65 32 Pin Tester-B_Mask.gbs, HCP65 32 Pin Tester-B_Silkscreen.gbo, HCP65 32 Pin Tester-Edge_Cuts.gm1, HCP65 32 Pin Tester-F_Cu.gtl, HCP65 32 Pin Tester-F_Mask.gts, HCP65 32 Pin Tester-F_Silkscreen.gto, HCP65 32 Pin Tester-NPTH.drl]
2026-01-12 Fixed 40pin Tester Board.
    [HCP65 40 Pin Tester-B_Cu.gbl, HCP65 40 Pin Tester-B_Mask.gbs, HCP65 40 Pin Tester-B_Silkscreen.gbo, HCP65 40 Pin Tester-Edge_Cuts.gm1, HCP65 40 Pin Tester-F_Cu.gtl, HCP65 40 Pin Tester-F_Mask.gts, HCP65 40 Pin Tester-F_Silkscreen.gto, HCP65 40 Pin Tester-NPTH.drl]
2026-01-13 Audio and Coprocessor boards with proper board schematic symbol and global labels.
    [Audio Address Decode.kicad_pcb, Audio Address Decode.kicad_sch, Audio Clock.kicad_pcb, Audio Clock.kicad_sch, Coprocessor Clock.kicad_pcb, Coprocessor Clock.kicad_sch, Coprocessor Memory Select.kicad_pcb, Coprocessor Memory Select.kicad_sch]
2026-01-13 Graphics and LCD boards with proper board schematic symbol and global labels.
    [Graphics Signals.kicad_pcb, Graphics Transparency.kicad_pcb, Graphics Transparency.kicad_sch, LCD Display.kicad_pcb, LCD Display.kicad_sch]
2026-01-14 Main boards with proper board schematic symbol and global labels.
    [Clock Device.kicad_pcb, Clock Device.kicad_sch, Main Memory Channel.kicad_pcb, Main Memory Channel.kicad_sch, Main Memory Full Abort.kicad_pcb, Main Memory Full Abort.kicad_sch, Main Memory Full Enable.kicad_pcb, Main Memory Full Enable.kicad_sch]
2026-01-14 Processor boards with proper board schematic symbol and global labels.
    [HCP65 Device Interrupts.kicad_pcb, HCP65 Device Interrupts.kicad_sch, HCP65 Device Reset.kicad_pcb, HCP65 Device Reset.kicad_sch, HCP65 Instruction Code.kicad_pcb, HCP65 Instruction Code.kicad_sch, HCP65 Kernal Mode.kicad_pcb, HCP65 Kernal Mode.kicad_sch]
2026-01-14 PS2 and SD Card boards with proper board schematic symbol and global labels.
    [PS2 FIFO.kicad_pcb, PS2 FIFO.kicad_sch, PS2 Timing.kicad_pcb, PS2 Timing.kicad_sch, SD Card Clock.kicad_pcb, SD Card Clock.kicad_sch, SD Card Full Socket.kicad_pcb, SD Card Full Socket.kicad_sch]
2026-01-14 SNES Controller, UART and VIA boards with proper schematics and global labels.
    [RS232.kicad_pcb, RS232.kicad_sch, SNES Controller Clock.kicad_pcb, SNES Controller Clock.kicad_sch, SNES Controller Reader.kicad_pcb, SNES Controller Reader.kicad_sch, TTL5V.kicad_pcb, TTL5V.kicad_sch]
2026-01-15 Video boards with proper board schematic symbols and global labels.
    [Video Address Reader.kicad_pcb, Video Address Reader.kicad_sch, Video Blank and Sync.kicad_pcb, Video Blank and Sync.kicad_sch, Video Clock.kicad_pcb, Video Clock.kicad_sch, Video Counter 12bit.kicad_pcb, Video Counter 12bit.kicad_sch]
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2026-01-18 Added filterers to Address Decode and rerouted Processor Board for wider Address Decode.
    [HCP65 MPU Address Decode-B_Cu.gbl, HCP65 MPU Address Decode-B_Mask.gbs, HCP65 MPU Address Decode-B_Paste.gbp, HCP65 MPU Address Decode-B_Silkscreen.gbo, HCP65 MPU Address Decode-Edge_Cuts.gm1, HCP65 MPU Address Decode-F_Cu.gtl, HCP65 MPU Address Decode-F_Mask.gts, HCP65 MPU Address Decode-F_Paste.gtp]
2026-01-19 Cleaned up Processor Board routing and generated Gerbers.
    [Processor Board-B_Cu.gbl, Processor Board-B_Mask.gbs, Processor Board-B_Silkscreen.gbo, Processor Board-Edge_Cuts.gm1, Processor Board-F_Cu.gtl, Processor Board-F_Mask.gts, Processor Board-F_Silkscreen.gto, Processor Board-NPTH.drl]
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2026-01-25 Auto routed Video Main Address and Data buffers.
    [Video Board - Signals.kicad_pcb, Video Board - Signals.kicad_sch]
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2026-01-28 Added inputs and outputs to the Processor Board schematic.
    [Mainboard Small.kicad_pcb, Processor Board.kicad_pcb, Processor Board.kicad_sch]
2026-01-28 Fixed Kernal Board symbol and Processor Board. Whoops.
    [Coprocessor Board - Additional.kicad_sch, Coprocessor Board - Main.kicad_sch, Processor Board.kicad_pcb, Processor Board.kicad_sch]
2026-01-30 Added a board presence reader to the Processor Board.
    [Address Buffer 16bit-B_Cu.gbl, Address Buffer 16bit-B_Mask.gbs, Address Buffer 16bit-B_Paste.gbp, Address Buffer 16bit-B_Silkscreen.gbo, Address Buffer 16bit-Edge_Cuts.gm1, Address Buffer 16bit-F_Cu.gtl, Address Buffer 16bit-F_Mask.gts, Address Buffer 16bit-F_Paste.gtp]
2026-01-31 Routed board presence reader on the Processor Board.
    [HCP65 MPU Address Decode.kicad_sch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]
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2026-02-05 Fixed Clock Hold resetting the counter too early.
    [Processor Board.kicad_pcb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]
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2026-02-12 Whoops realised that Clock Hold does not work.
    [W65C816 Clock Hold.kicad_sch]
2026-02-13 Added a D-type flip flop integrated circuit.
    [W65C816 Clock Hold.kicad_sch]
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2026-02-16 Fixed port trace WireTraceConverter.
2026-02-19 Added a watchdog timer clock to the main board.
    [HCP65 MPU Timer.kicad_sch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]
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2026-02-19 Split Clock Hold into two Hold Count and Clock Hold.
    [HCP65 Hold Count.kicad_pcb, HCP65 Hold Count.kicad_sch, W65C816 Clock Hold.kicad_pcb, W65C816 Clock Hold.kicad_sch]
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2026-02-25 Added a Clock Hold V1 to V2 converter board.
    [Clock Hold V1 to V2-B_Cu.gbl, Clock Hold V1 to V2-B_Mask.gbs, Clock Hold V1 to V2-B_Paste.gbp, Clock Hold V1 to V2-B_Silkscreen.gbo, Clock Hold V1 to V2-Edge_Cuts.gm1, Clock Hold V1 to V2-F_Cu.gtl, Clock Hold V1 to V2-F_Mask.gts, Clock Hold V1 to V2-F_Paste.gtp]
2026-02-25 Added an Address Decode V2 to V3 converter board.
    [Address Decode V2 to V3-B_Cu.gbl, Address Decode V2 to V3-B_Mask.gbs, Address Decode V2 to V3-B_Paste.gbp, Address Decode V2 to V3-B_Silkscreen.gbo, Address Decode V2 to V3-Edge_Cuts.gm1, Address Decode V2 to V3-F_Cu.gtl, Address Decode V2 to V3-F_Mask.gts, Address Decode V2 to V3-F_Paste.gtp]
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2026-03-04 Updated the empty board schematics 2x06 and 2x12 for nicer board symbols.
    [Board 2x06 W15.24.kicad_pcb, Board 2x06 W15.24.kicad_sch, Board 2x06 W22.86.kicad_pcb, Board 2x06 W22.86.kicad_sch, Board 2x12 W15.24.kicad_pcb, Board 2x12 W15.24.kicad_sch, Board 2x12 W22.86.kicad_pcb, Board 2x12 W22.86.kicad_sch]
2026-03-04 Added a UART signals board that removes that SMD components from the UART board.
    [RS232.kicad_sch, TTL5V.kicad_sch, UART Board.kicad_pcb, UART Board.kicad_sch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]
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2026-03-04 Deleted all boards by accident. Started setting up blank boards.
    [Board 2x06 W15.24.kicad_pcb, Board 2x06 W15.24.kicad_sch, Board 2x06 W22.86.kicad_pcb, Board 2x06 W22.86.kicad_sch, Board 2x12 W15.24.kicad_pcb, Board 2x12 W15.24.kicad_sch, Board 2x12 W22.86.kicad_pcb, Board 2x12 W22.86.kicad_sch]
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2026-03-04 Added silkscreen and power components to some blank boards.
    [Board 2x06 W15.24.kicad_pcb, Board 2x06 W15.24.kicad_sch, Board 2x06 W22.86.kicad_pcb, Board 2x12 W15.24.kicad_pcb, Board 2x12 W15.24.kicad_sch, Board 2x12 W22.86.kicad_pcb, Board 2x12 W22.86.kicad_sch]
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2026-03-04 Fixed up UART signals and board.
    [UART Board-B_Cu.gbl, UART Board-B_Mask.gbs, UART Board-B_Silkscreen.gbo, UART Board-Edge_Cuts.gm1, UART Board-F_Cu.gtl, UART Board-F_Mask.gts, UART Board-F_Silkscreen.gto, UART Board-NPTH.drl]
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2026-04-28 Auto stash before rebase of "master" onto "origin/master"
    Cleaned up Address Decode slightly.
    [HCP65 MPU Address Decode-B_Cu.gbl, HCP65 MPU Address Decode-B_Mask.gbs, HCP65 MPU Address Decode-B_Paste.gbp, HCP65 MPU Address Decode-B_Silkscreen.gbo, HCP65 MPU Address Decode-Edge_Cuts.gm1, HCP65 MPU Address Decode-F_Cu.gtl, HCP65 MPU Address Decode-F_Mask.gts, HCP65 MPU Address Decode-F_Paste.gtp]
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2026-07-19 Fixed GPIO Bus board to filter the correct side of the data bus.
    [GPIO Address Decode.kicad_sch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]
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2026-09-22 Moved Subcopy into Shift instruction opcode and moved Shift instruction next to the Branch opcodes.
    [65C64 Instruction Architecture.ods]
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2026-10-04 Auto stash before rebase of "master" onto "origin/master"
    Converted multi-instruction plus branch instructions to use internal branches instead.
    [65C64 Instruction Architecture.ods]
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2026-10-21 Potentially found the bad sub-circuit connection issue.
2026-10-21 Added a circuit reset.
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2026-10-31 Fixed Audio Clock schematic.
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
